koalium/centidocs/Q.C/برون سپاری 4110006.docx

پروژه: 4110006 آیتم: محصول: دمپر

ردیف | شرح مواد / محصول خروجی | ابعاد | تعداد | وزن | توضیحات
1 | ورق CK45 | 12*250*250 mm | 1 | 6 Kg
2
3

ردیف | شرح سفارش | مشخصات | شماره نقشه یا سند مرجع | مواد/محصول مرجع | تعداد | وزن
1 | تعیین Grade و کوانتومتری | | 4110006-1200*1200-01 | CK-45 | 1 | 6 Kg
2
3

صادر کننده: همایون شولی | کنترل کیفیت: حسین مهاجری | مدیریت:

29/01/1402 تاریخ : سفارش کار (بیرون سپاری) شرکت صنعتی سانتیگراد شماره سفارش : 00 شماره ویرایش:
