koalium/centidocs/mohajeri/گزارش بازرسی درپوش بیرینگ بلاک.docx

شرح کالا : | پوسته بیرینگ بلاک | شماره نقشه : | N- | شماره سفارش : | -
شماره کالا : | 000218100002 | شماره ITP : | I- | تامین کننده : | کارگاه رضایی
تعداد کل سفارش : | 6 | تعداد دریافتی : | 6 | تاریخ بازرسی : | 21/10/1401

بازرسی مواد :
ناحیه بازرسی | | | مواد در نقشه | | مواد محصول | | | شرح بازرسی (مغایرت) | | | | تعداد | تائید | مردود
درپوش بیرینگ بلاک 7218 | | | S.T 52 | | S.T 52 | | | | | | | | ☒ | ☐

بازرسی ابعاد :
ناحیه بازرسی | | | اندازه نقشه | | اندازه محصول | | | شرح بازرسی (مغایرت) | | | | تعداد | تائید | مردود
قطر 1 | | | 100mm | | 100mm | | | | | | | | ☒ | ☐
قطر 2 | | | 144mm | | 144mm | | | | | | | | ☒ | ☐
قطر 3 | | | 228mm | | 228mm | | | | | | | | ☒ | ☐
قطر 4 | | | 90mm | | 90mm | | | | | | | | ☒ | ☐
قطر 5 | | | 160mm | | 160mm | | | | | | | | ☒ | ☐
ضخامت 1 | | | 43.5mm | | 43.5mm | | | | | | | | ☒ | ☐
ضخامت 2 | | | 38mm | | 38mm | | | | | | | | ☒ | ☐
ضخامت 3 | | | 12mm | | 12mm | | | | | | | | ☒ | ☐
ترخیص قطعه جهت آزمون : | | | | | | | | | | | | | ☒ | ☐

آزمون :
تجهیزات آزمون | | | | محل آزمون | | | | | شرایط آزمون

کنترل کیفیت آماری : هر محموله ورودی به خانواده های 1000 عددی تقسیم بندی و بازرسی شود.
مرحله | تعداد نمونه | | حد پذیرش خطا | | | حد تجدید | | | | تعداد خطا در آزمایش | | | تایید | مردود
1 | | | | | | | | | | | | | ☐ | ☐
2 | | | | | | | | | | | | | ☐ | ☐

نتیجه نهایی :
پذیرش | | پذیرش ارفاقی | | | | | دوباره کاری | | | | مردود
☒ | | ☐ | | | | | ☐ | | | | ☐

توضیحات :

قطعات ریخته گری شده فاقد تخلخل و زدگی می باشد.

بازرس : همایون شولی 21/10/1401 | واحد کنترل کیفیت : مهندس حسین مهاجری | واحد مدیریت :

شرکت صنعتی سانتیگراد گزارش بازرسی و آزمون شماره سند : R-000218100002 تاریخ : 21/10/1401 ویرایش : 00
