koalium/centidocs/jokar/1/Flexible Joint/برون سپاری دوخت.docx

پروژه: 10028 آیتم: AC-2 محصول: Flexible Joint

ردیف | شرح مواد / محصول خروجی | ابعاد | تعداد | وزن | توضیحات
| پارچه برزنت | - | 4 | -

ردیف | شرح سفارش | مشخصات | شماره نقشه یا سند مرجع | مواد/محصول مرجع | تعداد | وزن
| دوخت پارچه | - | - | ردیف 1 | 4

صادر کننده: | کنترل کیفیت: | مدیریت:

98/03/25 تاریخ : سفارش کار (بیرون سپاری) شرکت صنعتی سانتیگراد 10028-ST-01 شماره سفارش : 00 شماره ویرایش:
