koalium/centidocs/mohajeri/90004/WPS-PQR-WQT/pqr/VD-3607-33-97-4912UD-ME-WPS-0411-PQR.docx

ESFAHAN OIL REFINING COMPANY

DIESEL HYDROTREATMENT PROJECT (DHT)

DOCUMENT TITLE

PQR for Damper TV-970078

DOCUMENT NUMBER

VD-3607/33-97-4912UD-ME-WPS-0411
PURCHASER'S COMMENT/APPROVAL STATUS | | | | Purchaser: NARGAN
| 1. AP: Approved (Released for Manufacturing)
| 2. AN: Approved as Noted for Fabrication (Fabrication may Proceed) | | | Requisition No.: 3607/33-97-4912UD-ME-DS-4029
| 3. NF: Approved as Noted for Re-Issue (Fabrication not Proceed)
| 4. RE: Rejected | | | Item No. (Tag No.): TV-970078
| 5. NR: Not Returned
Date: XX.XX.XX Signature: | | | | Vendor Doc. No.: Cii97-90004-VD-WPS-01

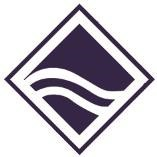
[picture p10: figure]

| | | | | | Centigrade IND.INC
A0 | 13.Jan.2019 | ISSUED FOR APPROVAL | H.Mohajeri | E.Beygi | D.Dehghani
Rev | DATE | DESCRIPTION | PREP'D | CHK'D | APP'D

TABULATION OF REVISED PAGES

Page | Rev-0 | Rev-1 | Rev-2 | Rev-3 | Rev-4 | | Page | Rev-0 | Rev-1 | Rev-2 | Rev-3 | Rev-4
1 | x | | | | | | 36
2 | x | | | | | | 37
3 | x | | | | | | 38
4 | x | | | | | | 39
5 | x | | | | | | 40
6 | x | | | | | | 41
7 | x | | | | | | 42
8 | x | | | | | | 43
9 | | | | | | | 44
10 | | | | | | | 45
11 | | | | | | | 46
12 | | | | | | | 47
13 | | | | | | | 48
14 | | | | | | | 49
15 | | | | | | | 50
16 | | | | | | | 51
17 | | | | | | | 52
18 | | | | | | | 53
19 | | | | | | | 54
20 | | | | | | | 55
21 | | | | | | | 56
22 | | | | | | | 57
23 | | | | | | | 58
24 | | | | | | | 59
25 | | | | | | | 60
26 | | | | | | | 61
27 | | | | | | | 62
28 | | | | | | | 63
29 | | | | | | | 64
30 | | | | | | | 65
31 | | | | | | | 66
32 | | | | | | | 67
33 | | | | | | | 68
34 | | | | | | | 69
35 | | | | | | | 70

Company Name: CENTIGRADE IND. INC.

Procedure Qualification Record No.: 01 Date: 05/01/2019

WPS No.: WPS-01

Welding Process(es): SMAW

Types (Manual, Automatic, Semi-Automatic): MANUAL

JOINTS

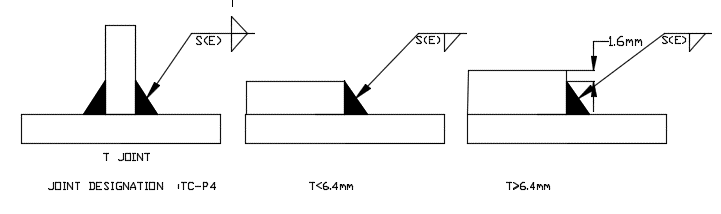
[picture p11: figure]

BASE METALS Material Spec.: Stainless Steel 304L Thickness of Test Coupon: 6 mm | POSTWELD HEAT TREATMENT Temperature: NA Time: NA
| GAS Gas(es) (Mixture) Flow Rate Shielding: NA Backing: NA
FILLER METALS SFA Specification: A5.4 AWS Classification: E310 Size of Filler Metal: 3.25 mm Weld Metal Thickness: 6mm
| ELECTRICAL CHARACTERISTICS Current: AC OR DC+ Polarity: DCEN Amps.: 90-120 Volts: 10-16
POSITION Position of Fillet: ALL Weld Progression (Uphill, Downhill): Flat
| TECHNIQUE Travel Speed: 18-20 (cm/min) String or Weave Bead STRINGER OR WEAVE Oscillation: NA Multipass or Single Pass (Per Side): Single Pass
PREHEAT Preheat Temperature 30°C Interpass Temperature NA

Test Result

Visual test Results: ok

FRACTURE Test

specimen no. | result | remark
1 | ok | See attached file

MACROtch TEST

specimen no. | result | remark
1 | ok | See attached file

DIESEL HYDROTREATMENT PROJECT (DHT) DOCUMENT TITLE: PQR for Damper TV-970078 Contract No.: 1032/GC-GN/CON-EP09-00 POI: FA DOCUMENT NUMBER: VD-3607/33-97-4912UD-ME-WPS-0411 Rev. No.: A0

DIESEL HYDROTREATMENT PROJECT (DHT) DOCUMENT TITLE: PQR for Damper TV-970078 Contract No.: 1032/GC-GN/CON-EP09-00 POI: FA DOCUMENT NUMBER: 3607/33-97-4912UD-ME-WPS-0411 Rev. No.: A0
