koalium/centidocs/jokar/مدیریت محترم عامل.docx

مدیریت محترم عامل

جناب آقای مهندس گرامی

با توجه به جلسه تشکیل شده مورخ 28/4/1402 وحضور حضرتعالی و آقایان علی جوکار و علیرضا صفری از واحد نقشه کشی موارد ذیل جهت اقدام خدمتان ارسال میگردد:

1-آموزش نرم افزار لیتیو جهت محاسبه طول گسترده و استفاده از این نرم افزار در واحد مهندسی و نقشه کشی

2- تغیرات در مدلهای مونتاژی(ازبیت) توسط شخصی که مدل اولیه را ایجاد کرده به دلیل تسلط بر استراتژی طراحی اولیه

3- استفاده از نرم افزار اتودسک اینونتور در طراحی محصولات و پروژه های شرکت به دلیل امکانات بسیار بالای آن

با تشکر
