koalium/centidocs/Manouchehri/آبکاری 17182.docx

پروژه: 17182 آیتم: AC-10101 محصول: Fan Ring & Plenum

ردیف | شرح مواد / محصول خروجی | ابعاد | تعداد | وزن | توضیحات
1 | 3M1,3M2 | - | 96 | 2626
2 | 3L.3R | - | 40 | 2141
3 | 2L.2R | - | 128 | 2758
4 | 1L.1R | - | 128 | 7044
5 | 1M | - | 64 | 3524
6 | FR 1 | - | 25 | 2875
7 | FR 2 | - | 25 | 3437

ردیف | شرح سفارش | مشخصات | شماره نقشه یا سند مرجع | مواد/محصول مرجع | تعداد | وزن
1 | آبکاری گالوانیزه گرم | - | - | ردیف 1 تا 7 | 506 | 24405

صادر کننده: علیرضا جوکار | کنترل کیفیت: حسین مهاجری | مدیریت:

1400/03/16 تاریخ : سفارش کار (بیرون سپاری) شرکت صنعتی سانتیگراد 17182-CO-01 شماره سفارش : 00 شماره ویرایش:
