koalium/centidocs/Manouchehri/فرش ساوین.docx

به نام خدا

مدیریت محترم عامل – جناب مهندس گرامی

با درود

احتراما به استحضار می رساند پیرو نامه مورخه 27/02/1403 شرکت محترم ساوین در رابطه با ایراد در عملکرد برخی از محصولات شرکت سانتیگراد ، بر همین اساس اقدامات صورت گرفته به شرح ذیل به خدمتتان ایفاد می گردد.

1-در رابطه با فیلتر دیسک و عبور الیاف از آن ، تسمه هوابند جدید تامین شد و متعاقبا ارسال می گردد.

2-در رابطه با ایراد فن فایبر، مقرر گردید فن جایگزین ارسال گردد .

3-در رابطه با کامپکتور پلی استر نظریه کارشناس شرکت فوق مورد تایید نمی باشد ، و دلیل جریان موتوراسکرو کامپکتور به خاطر عبور نکردن الیاف پنبه از قسمت نمدی دیسک و همچنین چرخش پنبه به همراه دیسک که این امر موجب اخذ بیشتر جریان موتور می گردد. و در ضمن در طراحی کامپکتور از تسمه های برنزی استفاده گردیده است که در صورت درگیری اسکرو کامپکتور با تسمه برنزی به دلیل عدم رسانایی الکتریکی تولید جرقه صورت نگیرد و در نتیجه برخورد درگیری اسکرو کامپکتور با تسمه های برنزی کاملا از نظر فنی درست می باشد ، چون زمانی که تحت فشار بار قرار می گیرد طبیعی است که به تسمه های برنزی برخورد نماید .

ولیکن طبق هماهنگی با مدیریت محترم فروش یک عدد کامپکتور جایگزین کامپکتور فوق می گردد.

4-در رابطه با فن حلزونی ، طبق گزارش کرشناس فنی شرکت سانتیگراد الکتروموتور فن حلزونی باز شده و بر روی روتور آن جای ضربه های چکش مشاهده گردیده است و در ضمن لرزش فن مربوط به خرابی بلبرینگ بوده که طبق هماهنگی یک عدد فن با الکترو موتور جدید چایگزین گردید.

با سپاس

منوچهری – واحد کنترل کیفیت

01/03/1403
