koalium/centidocs/SAFARI/02.03.09/برون سپاری ستون 61041.docx

پروژه: 9245041 آیتم: - محصول: Column

ردیف | شرح مواد / محصول خروجی | ابعاد | تعداد | وزن | توضیحات
1 | تسمه آهن | 5x451x4670 | 212 | 17525
2 | ورق استیل | 5x588x4670 | 106 | 11424

ردیف | شرح سفارش | مشخصات | شماره نقشه یا سند مرجع | مواد/محصول مرجع | تعداد | وزن
1 | خم کاری | - | As Per DWG No.: 9245041-Bending-01 | ردیف 1,2 | 318 | 28949

صادر کننده: علیرضا جوکار | کنترل کیفیت: حسین مهاجری | مدیریت:

02.03.09 تاریخ : سفارش کار (بیرون سپاری) شرکت صنعتی سانتیگراد 9245041-CO-02 شماره سفارش : 00 شماره ویرایش:
