koalium/centidocs/SAFARI/Title Block - Ruby Stone/Title Block (Ruby Stone) -Word-94-4-14.docx

DOCUMENT TITLE

IN-HOUSE REVISIONS | | | | | | | DOCUMENT REVISIONS
B | | | | | | | B
A | | | | | | | A
0 | First Issue | | | | | | 0 | First Issue
REV. | DESCRIPTION | DESG | DRAWN. | CHK | APP. | DATE | REV. | DESCRIPTION | DESG | DRAWN | CHKD | APP. | Date

Page No. | DOCUMENT REVISIONS | | | | | | | | Remarks | Page No. | IN-HOUSE REVISIONS | | | | | | | | Remarks
| 0 | A | B | C | D | E | F | G | | | 0 | A | B | C | D | E | F | G
1 | | | | | | | | | | 1
2 | | | | | | | | | | 2
3 | | | | | | | | | | 3
4 | | | | | | | | | | 4
5 | | | | | | | | | | 5
6 | | | | | | | | | | 6
7 | | | | | | | | | | 7
8 | | | | | | | | | | 8
9 | | | | | | | | | | 9
10 | | | | | | | | | | 10
11 | | | | | | | | | | 11
12 | | | | | | | | | | 12
13 | | | | | | | | | | 13
14 | | | | | | | | | | 14
15 | | | | | | | | | | 15
16 | | | | | | | | | | 16
17 | | | | | | | | | | 17
18 | | | | | | | | | | 18
19 | | | | | | | | | | 19
20 | | | | | | | | | | 20
21 | | | | | | | | | | 21
22 | | | | | | | | | | 22
23 | | | | | | | | | | 23
24 | | | | | | | | | | 24
25 | | | | | | | | | | 25
26 | | | | | | | | | | 26
27 | | | | | | | | | | 27
28 | | | | | | | | | | 28
29 | | | | | | | | | | 29
30 | | | | | | | | | | 30

CONTENT

MAPNA GROUP (Public Stock) SUB-CONTRACTOR'S LOGO SUB-CONTRACTOR'S Doc. No Doc. No. : MD2/I3- Rev: File No. : Design Stage: MAPNA'S DWG No. : Contract No. : Page 3 of 3 THIS DOCUMENT IS A PROPERTY OF MAPNA GROUP AND MUST NOT BE COPIED NOR TRANSFERREDTO A THIRD PARTY WITHOUT PRIOR AUTHORIZATIIN

RUMAILA 3000 MW COMBINED CYCLE POWER PLANT MAPNA GROUP
