koalium/centidocs/mohajeri/NCR/8003-TML03-27.docx

اعلامیه مغایرت NCR

شماره : COM/8003/27

تاریخ : 97/12/11

مترو تهران خط 3

شرکت صنعتی سانتیگراد

مرحله بازرسی : | [ ] مواد | [ ] ساخت و تکمیل | | نصب[x] | پروژه : | ایرواشر | | محل بازرسی : | | | نظریه نهایی :
نظریه بازرس : | [ ] مردود | [ ] مرجوع | | [ ] دوباره کاری | محصول : | حوضچه | | [ ] انبار [x] ایستگاه [ ] سایت [ ] پیمانکار | | | [ ] | مردود
سند مرجع : [ ] | MR: | | | | زیر محصول: | چراغ روشنایی | | توزیع نسخ : | | | [ ] | اسقاط
سند مرجع : [ ] | نقشه : | | | | قطعه : | | | [x] کیفیت [x] طراحی [x] تولید | | | [ ] | مرجوع
سند مرجع : [ ] | رویه : | | | | فرایند : | نصب | | [x] انبار [x] تدارکات [x] فروش | | | [ ] | دوباره کاری
استاندارد : | | | | | تأمین کننده: : | سانتیگراد | | [ ] اقدام اصلاحی شماره | | | [ ] | پذیرش ارفاقی
شرح مغایرت | | | نظریه واحد اجرایی | | | | نظریه طراحی و مهندسی | | | تعیین تکلیف
اصلاح نوردهی ضعیف چراغ های روشنایی و استفاده از چراغ های ضد آب.
امضاء و تاریخ | | | امضاء و تاریخ | | | | امضاء و تاریخ | | | امضاء و تاریخ
