koalium/centidocs/mohajeri/NCR/8003-TML03-28.docx

اعلامیه مغایرت NCR

شماره : COM/8003/28

تاریخ : 97/12/11

مترو تهران خط 3

شرکت صنعتی سانتیگراد

مرحله بازرسی : | [ ] مواد | [ ] ساخت و تکمیل | | نصب[x] | پروژه : | ایرواشر | | محل بازرسی : | | | نظریه نهایی :
نظریه بازرس : | [ ] مردود | [ ] مرجوع | | [ ] دوباره کاری | محصول : | دریچه بازدید | | [ ] انبار [x] ایستگاه [ ] سایت [ ] پیمانکار | | | [ ] | مردود
سند مرجع : [ ] | MR: | | | | زیر محصول: | پیچ | | توزیع نسخ : | | | [ ] | اسقاط
سند مرجع : [ ] | نقشه : | | | | قطعه : | | | [x] کیفیت [x] طراحی [x] تولید | | | [ ] | مرجوع
سند مرجع : [ ] | رویه : | | | | فرایند : | نصب | | [x] انبار [x] تدارکات [x] فروش | | | [ ] | دوباره کاری
استاندارد : | | | | | تأمین کننده: : | شرکت سانتیگراد | | [ ] اقدام اصلاحی شماره | | | [ ] | پذیرش ارفاقی
شرح مغایرت | | | نظریه واحد اجرایی | | | | نظریه طراحی و مهندسی | | | تعیین تکلیف
پیچ هایی که بر روی لاستیک هوابند استفاده میشوند دچار زنگ زدگی شده اند.
امضاء و تاریخ | | | امضاء و تاریخ | | | | امضاء و تاریخ | | | امضاء و تاریخ
