koalium/centidocs/mohajeri/NCR/اعلامیه مغایرت NCR-COM-8003-14.docx

اعلامیه مغایرت NCR

شماره : COM/8003/14

تاریخ : 97/10/17

مترو تهران خط 3 – ایستگاه راه آهن

شرکت صنعتی سانتیگراد

| مرحله بازرسی : | [ ] مواد | [ ] ساخت و تکمیل | | نصب[x] | پروژه : | فیلتر استاتیک آب | | محل بازرسی : | | نظریه نهایی :
| نظریه بازرس : | [ ] مردود | [ ] مرجوع | | [ ] دوباره کاری | محصول : | فیلتر استاتیک آب | | [ ] انبار [ ] ایستگاه [x] سایت [ ] پیمانکار | | [ ] | مردود
| سند مرجع : [ ] | MR: | | | | زیر محصول: | | | توزیع نسخ : | | [ ] | اسقاط
| سند مرجع : [ ] | نقشه : | | | | قطعه : | | | [x] کیفیت [x] طراحی [x] تولید | | [ ] | مرجوع
| سند مرجع : [x] | رویه : | | | | فرایند : | نصب | | [x] انبار [x] تدارکات [x] فروش | | [ ] | دوباره کاری
| استاندارد : | | | | | تأمین کننده: : | سانتیگراد | | [ ] اقدام اصلاحی شماره | | [ ] | پذیرش ارفاقی
شرح مغایرت | | | | نظریه واحد اجرایی | | | | نظریه طراحی و مهندسی | | تعیین تکلیف
سایز دهانه فیلتر استاتیک در سایت با فیلتر استاتیک ساخته شده در شرکت مغایرت دارد. سایز فیلتر ساخته شده 900 میلیمتر می باشد در صورتی که سایز دهانه فیلتر در سایت 1 تا 5 سانتیمتر کوچکتر می باشد. موضع VE3 : سایز دهانه سه موضع به این سایز ها باید تغییر کند: 875-890-890-850-875-855 موضع VE4: سایز دهانه سه موضع به این سایز ها باید تغییر کند: 875-880-885-870-870-895 موضع VE5: سایز دهانه سه موضع به این سایز ها باید تغییر کند: 860-880-880-860-870-850
امضاء و تاریخ | | | | امضاء و تاریخ | | | | امضاء و تاریخ | | امضاء و تاریخ
