koalium/centidocs/mohajeri/NCR/اعلامیه مغایرت NCR-COM-8003-15.docx

اعلامیه مغایرت NCR

شماره : COM/8003/15

تاریخ : 97/10/17

مترو تهران خط 3 – ایستگاه راه آهن

شرکت صنعتی سانتیگراد

| مرحله بازرسی : | [ ] مواد | [ ] ساخت و تکمیل | | نصب[x] | پروژه : | قاب المیناتور | | محل بازرسی : | | نظریه نهایی :
| نظریه بازرس : | [ ] مردود | [ ] مرجوع | | [ ] دوباره کاری | محصول : | قاب المیناتور | | [ ] انبار [ ] ایستگاه [x] سایت [ ] پیمانکار | | [ ] | مردود
| سند مرجع : [ ] | MR: | | | | زیر محصول: | | | توزیع نسخ : | | [ ] | اسقاط
| سند مرجع : [ ] | نقشه : | | | | قطعه : | | | [x] کیفیت [x] طراحی [x] تولید | | [ ] | مرجوع
| سند مرجع : [x] | رویه : | | | | فرایند : | نصب | | [x] انبار [x] تدارکات [x] فروش | | [ ] | دوباره کاری
| استاندارد : | | | | | تأمین کننده: : | سانتیگراد | | [ ] اقدام اصلاحی شماره | | [ ] | پذیرش ارفاقی
شرح مغایرت | | | | نظریه واحد اجرایی | | | | نظریه طراحی و مهندسی | | تعیین تکلیف
فاصله سکوهای مربوط به قاب المیناتور با قاب المیناتور ساخته شده مغایرت دارد. موضع VE3: نیاز به تغییر دادن قاب در شرکت می باشد.(فاصله سکو های المیناتور از سمت حوضچه و از سمت راست به چپ به ترتیب 240-680-690-700-600-700-700-700 میلیمتر می باشد.) موضع: VE4: نیاز به تغییر دادن قاب در شرکت می باشد.(فاصله سکو های المیناتور از سمت حوضچه و از سمت راست به چپ به ترتیب 520-700-690-700-595-645-685-680 میلیمتر می باشد.) موضع VE5: مشکلی ندارد.
امضاء و تاریخ | | | | امضاء و تاریخ | | | | امضاء و تاریخ | | امضاء و تاریخ
