koalium/centidocs/mohajeri/NCR/اعلامیه مغایرت NCR-COM-8003-16.docx

اعلامیه مغایرت NCR

شماره : COM/8003/16

تاریخ : 97/10/17

مترو تهران خط 3 – ایستگاه راه آهن

شرکت صنعتی سانتیگراد

| مرحله بازرسی : | [ ] مواد | [ ] ساخت و تکمیل | | نصب[x] | پروژه : | ساختمان ایستگاه | | محل بازرسی : | | نظریه نهایی :
| نظریه بازرس : | [ ] مردود | [ ] مرجوع | | [ ] دوباره کاری | محصول : | حوضچه | | [ ] انبار [ ] ایستگاه [x] سایت [ ] پیمانکار | | [ ] | مردود
| سند مرجع : [ ] | MR: | | | | زیر محصول: | کف پوش | | توزیع نسخ : | | [ ] | اسقاط
| سند مرجع : [ ] | نقشه : | | | | قطعه : | | | [x] کیفیت [x] طراحی [x] تولید | | [ ] | مرجوع
| سند مرجع : [x] | رویه : | | | | فرایند : | نصب | | [x] انبار [x] تدارکات [x] فروش | | [ ] | دوباره کاری
| استاندارد : | | | | | تأمین کننده: : | کارفرما | | [ ] اقدام اصلاحی شماره | | [ ] | پذیرش ارفاقی
شرح مغایرت | | | | نظریه واحد اجرایی | | | | نظریه طراحی و مهندسی | | تعیین تکلیف
حوضچه مربوط به موضع VE4 در قسمت پایین بر روی کف پوش عایق کاری شده است ( هماهنگی با کارفرما صورت گیرد جهت اطمینان از نصب قطعات. آیا پس از عایق کاری بر روی کف پوش، مجدد نیاز به اجرای کف پوش می باشد؟ )
امضاء و تاریخ | | | | امضاء و تاریخ | | | | امضاء و تاریخ | | امضاء و تاریخ
