koalium/centidocs/mohajeri/NCR/اعلامیه مغایرت NCR-COM-8003-18.docx

اعلامیه مغایرت NCR

شماره : COM/8003/18

تاریخ : 97/10/17

مترو تهران خط 3 – ایستگاه راه آهن

شرکت صنعتی سانتیگراد

مرحله بازرسی : | [ ] مواد | [ ] ساخت و تکمیل | | نصب[x] | پروژه : | کلکتور | | محل بازرسی : | | | نظریه نهایی :
نظریه بازرس : | [ ] مردود | [ ] مرجوع | | [ ] دوباره کاری | محصول : | کلکتور | | [ ] انبار [ ] ایستگاه [x] سایت [ ] پیمانکار | | | [ ] | مردود
سند مرجع : [ ] | MR: | | | | زیر محصول: | | | توزیع نسخ : | | | [ ] | اسقاط
سند مرجع : [ ] | نقشه : | | | | قطعه : | | | [x] کیفیت [x] طراحی [x] تولید | | | [ ] | مرجوع
سند مرجع : [x] | رویه : | | | | فرایند : | نصب | | [x] انبار [x] تدارکات [x] فروش | | | [ ] | دوباره کاری
استاندارد : | | | | | تأمین کننده: : | سانتیگراد | | [ ] اقدام اصلاحی شماره | | | [ ] | پذیرش ارفاقی
شرح مغایرت | | | نظریه واحد اجرایی | | | | نظریه طراحی و مهندسی | | | تعیین تکلیف
طول کلکتور های ساخته شده جهت نصب بر روی سکوها، 1520 میلیمتر می باشد در صورتی که بعلت اینکه سکوها با تعداد 4 عدد ساخته شده اند امکان نصب کلکتور ها وجود ندارد . نیاز است یا طراحی سکو عوض شود یا کلکتور ها تعویض شوند.
امضاء و تاریخ | | | امضاء و تاریخ | | | | امضاء و تاریخ | | | امضاء و تاریخ
