koalium/centidocs/mohajeri/NCR/اعلامیه مغایرت NCR-COM-8003-19.docx

اعلامیه مغایرت NCR

شماره : COM/8003/19

تاریخ : 97/10/17

مترو تهران خط 3 – ایستگاه فاطمی

شرکت صنعتی سانتیگراد

مرحله بازرسی : | [ ] مواد | [ ] ساخت و تکمیل | | نصب[x] | پروژه : | فیلتر استاتیک آب | | محل بازرسی : | | | نظریه نهایی :
نظریه بازرس : | [ ] مردود | [ ] مرجوع | | [ ] دوباره کاری | محصول : | فیلتر استاتیک آب | | [ ] انبار [ ] ایستگاه [x] سایت [ ] پیمانکار | | | [ ] | مردود
سند مرجع : [ ] | MR: | | | | زیر محصول: | | | توزیع نسخ : | | | [ ] | اسقاط
سند مرجع : [ ] | نقشه : | | | | قطعه : | | | [x] کیفیت [x] طراحی [x] تولید | | | [ ] | مرجوع
سند مرجع : [x] | رویه : | | | | فرایند : | نصب | | [x] انبار [x] تدارکات [x] فروش | | | [ ] | دوباره کاری
استاندارد : | | | | | تأمین کننده: : | سانتیگراد | | [ ] اقدام اصلاحی شماره | | | [ ] | پذیرش ارفاقی
شرح مغایرت | | | نظریه واحد اجرایی | | | | نظریه طراحی و مهندسی | | | تعیین تکلیف
سایز دهانه فیلتر استاتیک در سایت با فیلتر استاتیک ساخته شده در شرکت مغایرت دارد. سایز فیلتر ساخته شده 900 میلیمتر می باشد در صورتی که سایز دهانه فیلتر در سایت 1 تا 7 سانتیمتر کوچکتر می باشد. موضع VE3 : سایز دهانه سه موضع به این سایز ها باید تغییر کند: 870-890-890-880-870-900 موضع VE4: سایز دهانه سه موضع به این سایز ها باید تغییر کند: 910-880-885-900-880-900 موضع VE5: سایز دهانه سه موضع به این سایز ها باید تغییر کند: 830-890-850-870-875-865
امضاء و تاریخ | | | امضاء و تاریخ | | | | امضاء و تاریخ | | | امضاء و تاریخ
