koalium/centidocs/mohajeri/NCR/اعلامیه مغایرت NCR-COM-8003-20.docx

اعلامیه مغایرت NCR

شماره : COM/8003/20

تاریخ : 97/10/17

مترو تهران خط 3 – ایستگاه فاطمی

شرکت صنعتی سانتیگراد

مرحله بازرسی : | [ ] مواد | [ ] ساخت و تکمیل | | نصب[x] | پروژه : | ساپورت صفحه نردبان | | محل بازرسی : | | | نظریه نهایی :
نظریه بازرس : | [ ] مردود | [ ] مرجوع | | [ ] دوباره کاری | محصول : | | | [ ] انبار [ ] ایستگاه [x] سایت [ ] پیمانکار | | | [ ] | مردود
سند مرجع : [ ] | MR: | | | | زیر محصول: | | | توزیع نسخ : | | | [ ] | اسقاط
سند مرجع : [ ] | نقشه : | | | | قطعه : | | | [x] کیفیت [x] طراحی [x] تولید | | | [ ] | مرجوع
سند مرجع : [x] | رویه : | | | | فرایند : | نصب | | [x] انبار [x] تدارکات [x] فروش | | | [ ] | دوباره کاری
استاندارد : | | | | | تأمین کننده: : | کارفرما | | [ ] اقدام اصلاحی شماره | | | [ ] | پذیرش ارفاقی
شرح مغایرت | | | نظریه واحد اجرایی | | | | نظریه طراحی و مهندسی | | | تعیین تکلیف
در موضع VE3 ساپورت مربوط به صفحه نردبان در جلوی شبکه ایربافل قرار گرفته است در صورتی که می بایست در پشت شبکه ایربافل قرار گیرد.
امضاء و تاریخ | | | امضاء و تاریخ | | | | امضاء و تاریخ | | | امضاء و تاریخ
