koalium/centidocs/mohajeri/NCR/اعلامیه مغایرت NCR-COM-8003-29.docx

اعلامیه مغایرت NCR

مترو تهران خط 3

شماره : COM/8003/29

تاریخ : 98/03/01

شرکت صنعتی سانتیگراد

| مرحله بازرسی : | [ ] مواد | [ ] ساخت و تکمیل | | نصب[x] | پروژه : | ایرواشر | | محل بازرسی : | | نظریه نهایی :
| نظریه بازرس : | [ ] مردود | [ ] مرجوع | | [ ] دوباره کاری | محصول : | الیمیناتور | | [ ] انبار [x] ایستگاه [ ] سایت [ ] پیمانکار | | [ ] | مردود
| سند مرجع : [ ] | MR: | | | | زیر محصول: | لوله تخلیه | | توزیع نسخ : | | [ ] | اسقاط
| سند مرجع : [ ] | نقشه : | | | | قطعه : | | | [x] کیفیت [x] طراحی [x] تولید | | [ ] | مرجوع
| سند مرجع : [ ] | رویه : | | | | فرایند : | نصب | | [x] انبار [x] تدارکات [x] فروش | | [ ] | دوباره کاری
| استاندارد : | | | | | تأمین کننده: : | سانتیگراد | | [ ] اقدام اصلاحی شماره | | [ ] | پذیرش ارفاقی
شرح مغایرت | | | | نظریه واحد اجرایی | | | | نظریه طراحی و مهندسی | | تعیین تکلیف
اضافه کردن یک عدد لوله تخلیه در ناودانی الیمیناتور در ایستگاه های زیر: - ایستگاه آزادگان- هواساز VE3 و VE4 - ایستگاه نعمت آباد-هواساز VE3 و VE5 - ایستگاه عبدل آباد-هواساز VE4 - ایستگاه جوادیه-هواساز VE3 - ایستگاه زمزم-هواساز VE3 - ایستگاه شریعتی-هواسازهای VE3 و VE4 و VE5
امضاء و تاریخ | | | | امضاء و تاریخ | | | | امضاء و تاریخ | | امضاء و تاریخ
