koalium/centidocs/mohajeri/NCR/اعلامیه مغایرت NCR-COM-8003-30.docx

اعلامیه مغایرت NCR

مترو تهران خط 3

شماره : COM/8003/30

تاریخ : 98/03/01

شرکت صنعتی سانتیگراد

| مرحله بازرسی : | [ ] مواد | [ ] ساخت و تکمیل | | نصب[x] | پروژه : | ایرواشر | | محل بازرسی : | | نظریه نهایی :
| نظریه بازرس : | [ ] مردود | [ ] مرجوع | | [ ] دوباره کاری | محصول : | الیمیناتور | | [ ] انبار [x] ایستگاه [ ] سایت [ ] پیمانکار | | [ ] | مردود
| سند مرجع : [ ] | MR: | | | | زیر محصول: | ناودانی الیمیناتور | | توزیع نسخ : | | [ ] | اسقاط
| سند مرجع : [ ] | نقشه : | | | | قطعه : | | | [x] کیفیت [x] طراحی [x] تولید | | [ ] | مرجوع
| سند مرجع : [ ] | رویه : | | | | فرایند : | نصب | | [x] انبار [x] تدارکات [x] فروش | | [ ] | دوباره کاری
| استاندارد : | | | | | تأمین کننده: : | سانتیگراد | | [ ] اقدام اصلاحی شماره | | [ ] | پذیرش ارفاقی
شرح مغایرت | | | | نظریه واحد اجرایی | | | | نظریه طراحی و مهندسی | | تعیین تکلیف
- ایستگاه زین الدین نصب دو عدد ناودانی جهت آبریزش آب الیمیناتور ها در مواضع VE3 و VE4 و VE5 - ایستگاه جوادیه اضافه نمودن ناودانی الیمیناتور در مواضع VE4 و VE5 - ایستگاه عبدل اباد فیکس نمودن لوله ناودانی الیمیناتور در موضع VE4
امضاء و تاریخ | | | | امضاء و تاریخ | | | | امضاء و تاریخ | | امضاء و تاریخ
