koalium/centidocs/mohajeri/NCR/اعلامیه مغایرت NCR-COM-8003-31.docx

اعلامیه مغایرت NCR

مترو تهران خط 3

شماره : COM/8003/31

تاریخ : 98/03/01

شرکت صنعتی سانتیگراد

| مرحله بازرسی : | [ ] مواد | [ ] ساخت و تکمیل | | نصب[x] | پروژه : | ایرواشر | | محل بازرسی : | | نظریه نهایی :
| نظریه بازرس : | [ ] مردود | [ ] مرجوع | | [ ] دوباره کاری | محصول : | دریچه بازدید | | [ ] انبار [x] ایستگاه [ ] سایت [ ] پیمانکار | | [ ] | مردود
| سند مرجع : [ ] | MR: | | | | زیر محصول: | لاستیک هوابند | | توزیع نسخ : | | [ ] | اسقاط
| سند مرجع : [ ] | نقشه : | | | | قطعه : | | | [x] کیفیت [x] طراحی [x] تولید | | [ ] | مرجوع
| سند مرجع : [ ] | رویه : | | | | فرایند : | نصب | | [x] انبار [x] تدارکات [x] فروش | | [ ] | دوباره کاری
| استاندارد : | | | | | تأمین کننده: : | سانتیگراد | | [ ] اقدام اصلاحی شماره | | [ ] | پذیرش ارفاقی
شرح مغایرت | | | | نظریه واحد اجرایی | | | | نظریه طراحی و مهندسی | | تعیین تکلیف
تعویض لاستیک هوابند قاب در بازدید حوضچه ایرواشر در ایستگاه های زیر : - ایستگاه آزادگان-هواساز VE3 - ایستگاه نعمت آباد-هواسازهای VE3 و VE5 - ایستگاه زمزم-هواساز VE5 ............................................................................................ آب بند نمودن دور دریچه بازدید حوضچه ایرواشر در ایستگاه زمزم-هواسازهای VE5 و VE3
امضاء و تاریخ | | | | امضاء و تاریخ | | | | امضاء و تاریخ | | امضاء و تاریخ
