koalium/centidocs/mohajeri/NCR/اعلامیه مغایرت NCR-COM-8003-32.docx

اعلامیه مغایرت NCR

مترو تهران خط 3

شماره : COM/8003/32

تاریخ : 98/03/01

شرکت صنعتی سانتیگراد

| مرحله بازرسی : | [ ] مواد | [ ] ساخت و تکمیل | | نصب[x] | پروژه : | ایرواشر | | محل بازرسی : | | نظریه نهایی :
| نظریه بازرس : | [ ] مردود | [ ] مرجوع | | [ ] دوباره کاری | محصول : | دریچه بازدید | | [ ] انبار [x] ایستگاه [ ] سایت [ ] پیمانکار | | [ ] | مردود
| سند مرجع : [ ] | MR: | | | | زیر محصول: | دستگیره | | توزیع نسخ : | | [ ] | اسقاط
| سند مرجع : [ ] | نقشه : | | | | قطعه : | | | [x] کیفیت [x] طراحی [x] تولید | | [ ] | مرجوع
| سند مرجع : [ ] | رویه : | | | | فرایند : | نصب | | [x] انبار [x] تدارکات [x] فروش | | [ ] | دوباره کاری
| استاندارد : | | | | | تأمین کننده: : | سانتیگراد | | [ ] اقدام اصلاحی شماره | | [ ] | پذیرش ارفاقی
شرح مغایرت | | | | نظریه واحد اجرایی | | | | نظریه طراحی و مهندسی | | تعیین تکلیف
در ایستگاه های زیر دستگیره در بازدید حوضچه ایرواشر دچار زنگ زدگی شده است: - ایستگاه عبدل آباد-هواسازهای VE4 و VE5 - ایستگاه شریعتی-هواساز VE3و VE4 و VE5 - ایستگاه جوادیه-هواساز VE4 ............................................................................................ زنگ زدگی در بازدید ایرواشر در ایستگاه زمزم هواساز VE5 و VE3
امضاء و تاریخ | | | | امضاء و تاریخ | | | | امضاء و تاریخ | | امضاء و تاریخ
