koalium/centidocs/mohajeri/NCR/اعلامیه مغایرت NCR-COM-8003-33.docx

اعلامیه مغایرت NCR

مترو تهران خط 3 – ایستگاه عبدل آباد

شماره : COM/8003/33

تاریخ : 98/03/01

شرکت صنعتی سانتیگراد

| مرحله بازرسی : | [ ] مواد | [ ] ساخت و تکمیل | | نصب[x] | پروژه : | ایرواشر | | محل بازرسی : | | نظریه نهایی :
| نظریه بازرس : | [ ] مردود | [ ] مرجوع | | [ ] دوباره کاری | محصول : | الیمیناتور | | [ ] انبار [x] ایستگاه [ ] سایت [ ] پیمانکار | | [ ] | مردود
| سند مرجع : [ ] | MR: | | | | زیر محصول: | الیمیناتور | | توزیع نسخ : | | [ ] | اسقاط
| سند مرجع : [ ] | نقشه : | | | | قطعه : | | | [x] کیفیت [x] طراحی [x] تولید | | [ ] | مرجوع
| سند مرجع : [ ] | رویه : | | | | فرایند : | نصب | | [x] انبار [x] تدارکات [x] فروش | | [ ] | دوباره کاری
| استاندارد : | | | | | تأمین کننده: : | سانتیگراد | | [ ] اقدام اصلاحی شماره | | [ ] | پذیرش ارفاقی
شرح مغایرت | | | | نظریه واحد اجرایی | | | | نظریه طراحی و مهندسی | | تعیین تکلیف
در هواساز VE5 ارتفاع الیمیناتور نصب شده بیشتر از تعداد مورد نیاز می باشد(ست زیرین باکت، پن درگیر است) علاوه بر این الیمیناتور نشتی دارد. در هواساز VE4 الیمیناتورهای لاین وسط(بالای ناودانی) دچار تغییرات ظاهری شده اند.
امضاء و تاریخ | | | | امضاء و تاریخ | | | | امضاء و تاریخ | | امضاء و تاریخ
