koalium/centidocs/Q.C/Mashi/NCR/PRC 17182-01 بیرینگ بلاک.docx

| شرکت صنعتی سانتیگراد | اعلامیه مغایرت NCR | شماره : | PRC/17182/01
| | | تاریخ : | 1400/09/14

مرحله بازرسی : | | مواد | | ✓ | ساخت و تکمیل | | نصب | پروژه : | 17182 | | محل بازرسی : | | | | | | | | | | | | نظریه نهایی :
نظریه بازرس : | | مردود | | | مرجوع | | دوباره کاری | محصول : | بیرینگ بلاک | | | انبار | | | ایستگاه | | | | سایت | | پیمانکار | | | مردود
سند مرجع : | MR: | | | | | | | زیر محصول: | پوسته | | توزیع نسخ : | | | | | | | | | | | | | اسقاط
سند مرجع : | نقشه : | | | | | | | قطعه : | | | ✓ | کیفیت | | | | | | طراحی | | ✓ | تولید | | | مرجوع
سند مرجع : | رویه : | | | | | | | فرایند : | | | ✓ | انبار | | | | ✓ | | تدارکات | | | فروش | | | دوباره کاری
استاندارد : | | | | | | | | تأمین کننده: | | | اقدام اصلاحی : | | | | | | | | | | | | | پذیرش ارفاقی

شرح مغایرت | نظریه واحد اجرایی | نظریه طراحی و مهندسی | تعیین تکلیف
از تعداد 10 عدد پوسته بیرینگ بلاک مورد تیاز برای پروژه فوق، پنج عدد از آنها پس از خشن تراشی دارای مک و حفره بودند.
امضاء و تاریخ مهاجری 1400/09/14 | امضاء و تاریخ | امضاء و تاریخ | امضاء و تاریخ
