koalium/centidocs/Q.C/Mashi/NCR/PRD 81003-03 در تهویه.docx

| شرکت صنعتی سانتیگراد | اعلامیه مغایرت NCR | شماره : | PRD/81003/03
| | | تاریخ : | 1400/09/14

مرحله بازرسی : | | مواد | | ✓ | ساخت و تکمیل | | نصب | پروژه : | 81003 | | محل بازرسی : | | | | | | | | | | | | نظریه نهایی :
نظریه بازرس : | | مردود | | | مرجوع | | دوباره کاری | محصول : | در تهویه | | ✓ | انبار | | | ایستگاه | | | | سایت | | پیمانکار | | | مردود
سند مرجع : | MR: | | | | | | | زیر محصول: | در | | توزیع نسخ : | | | | | | | | | | | | | اسقاط
سند مرجع : | نقشه : | | | | | | | قطعه : | | | ✓ | کیفیت | | | | ✓ | | طراحی | | ✓ | تولید | | | مرجوع
سند مرجع : | رویه : | | | | | | | فرایند : | | | ✓ | انبار | | | | | | تدارکات | | | فروش | | | دوباره کاری
استاندارد : | | | | | | | | تأمین کننده: | | | اقدام اصلاحی : | | | | | | | | | | | | | پذیرش ارفاقی

شرح مغایرت | نظریه واحد اجرایی | نظریه طراحی و مهندسی | تعیین تکلیف
دو عدد در تهویه پروژه 81003 پس از ساخت و در حین تمیزکاری دچار لکه گردیده است (پلنگی شده است).
امضاء و تاریخ مهاجری 1400/09/14 | امضاء و تاریخ | امضاء و تاریخ | امضاء و تاریخ
