koalium/centidocs/mohajeri/90004/WPS-PQR-WQT/VD-3607-33-97-4912UD-ME-WPS-0411-A1.docx

ESFAHAN OIL REFINING COMPANY

DIESEL HYDROTREATMENT PROJECT (DHT)

DOCUMENT TITLE

WPS for Damper TV-970078

DOCUMENT NUMBER

VD-3607/33-97-4912UD-ME-WPS-0411
PURCHASER'S COMMENT/APPROVAL STATUS | | | | Purchaser: NARGAN
| 1. AP: Approved (Released for Manufacturing)
| 2. AN: Approved as Noted for Fabrication (Fabrication may Proceed) | | | Requisition No.: 3607/33-97-4912UD-ME-DS-4029
| 3. NF: Approved as Noted for Re-Issue (Fabrication not Proceed)
| 4. RE: Rejected | | | Item No. (Tag No.): TV-970078
| 5. NR: Not Returned
Date: XX.XX.XX Signature: | | | | Vendor Doc. No.: Cii97-90004-VD-WPS-01


| | | | | | Centigrade IND.INC
A1 | 12.sep.2018 | ISSUED FOR APPROVAL | E.Beygi | D.Dehghani | D.Dehghani
A0 | 30.DEC.2018 | ISSUED FOR APPROVAL | E.Beygi | D.Dehghani | D.Dehghani
Rev | DATE | DESCRIPTION | PREP'D | CHK'D | APP'D

TABULATION OF REVISED PAGES

Page | Rev-0 | Rev-1 | Rev-2 | Rev-3 | Rev-4 | | Page | Rev-0 | Rev-1 | Rev-2 | Rev-3 | Rev-4
1 | x | x | | | | | 36
2 | x | x | | | | | 37
3 | x | x | | | | | 38
4 | x | x | | | | | 39
5 | | | | | | | 40
6 | | | | | | | 41
7 | | | | | | | 42
8 | | | | | | | 43
9 | | | | | | | 44
10 | | | | | | | 45
11 | | | | | | | 46
12 | | | | | | | 47
13 | | | | | | | 48
14 | | | | | | | 49
15 | | | | | | | 50
16 | | | | | | | 51
17 | | | | | | | 52
18 | | | | | | | 53
19 | | | | | | | 54
20 | | | | | | | 55
21 | | | | | | | 56
22 | | | | | | | 57
23 | | | | | | | 58
24 | | | | | | | 59
25 | | | | | | | 60
26 | | | | | | | 61
27 | | | | | | | 62
28 | | | | | | | 63
29 | | | | | | | 64
30 | | | | | | | 65
31 | | | | | | | 66
32 | | | | | | | 67
33 | | | | | | | 68
34 | | | | | | | 69
35 | | | | | | | 70

DIESEL HYDROTREATMENT PROJECT (DHT) DOCUMENT TITLE: WPS for Damper TV-970078 Contract No.: 1032/GC-GN/CON-EP09-00 POI: FA DOCUMENT NUMBER: VD-3607/33-97-4912UD-ME-WPS-0411 Rev. No.: A1

DIESEL HYDROTREATMENT PROJECT (DHT) DOCUMENT TITLE: WPS for Damper TV-970078 Contract No.: 1032/GC-GN/CON-EP09-00 POI: FA DOCUMENT NUMBER: 3607/33-97-4912UD-ME-WPS-0411 Rev. No.: A1
