koalium/centidocs/mohajeri/Backup-Mahajeri-1402-07-11/AAC/17177/Packing List/P.L 17177-001.docx

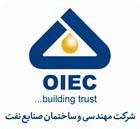
[picture p12: figure]

| NGL 3100 Project | (Vendor’s Logo)
| Packing List

Packing List

Shipper/Exporter | | No. & date of invoice: 2020/09/27
| | Remarks :
For account & risk of Messer’s
Notify party
Port of loading | Final destination
Carrier | Sailing on or about
Marks and numbers of PKGS 2 | Description of Goods Louver&Actuating Box | Quantity | Net weight 925 | Gross weight 930 | Measurement

OIEC

L/C NO. -----------------

NGL 3100 Project

DEHLORAN CHESMEH KHOSH

LOADING PORT………..….….….….…:

DISCHARGING PORT……….…..….…:

FINAL DESTINATION…………..….…:

P/O NO…………………………….…...:

DESCRIPTION OF CARGO…….…….:

PACKAGE NO…………………….…...:

GROSS WEIGHT………......……….....:

DIMENSION………………….….……:

M MADE IN…………………………...:

BRUSSEL’S CUSTOMS TARIFF NO....:

BENEFICIARY NAME……………......:

NGL 3100 Project – Dehloran Cheshmeh Khosh

Signed by:

(VENDOR’S COMPANY NAME MENTIONED IN PURCHASE ORDER)

| NGL 3100 Project | (Vendor’s Logo)
| Packing List

## PACKING LIST (Detailed Item List) Page No. 2 of 2

No. of PKGS | Description of Goods | Quantity | Net- weight (KGs) | Gross- weight (KGs) | Size (Cm × Cm ×Cm) | Vendor Name
1 | LOUVER | 2 | 895 | 895 | 432*217*40
| ACTUATING BOX | 1
| LIFTING | 8
2 | BOLT M16*50 | 8
| BOLT M16*40 | 8 | 30 | 35 | 50*30*20
| NUT M16 | 8
| SPRING WASHER A16 | 16
| FLAT WASHER 16*30 | 16

This document is the property of OIEC. It is confidential and all rights reserved. Neither the whole nor part of this document may be disclosed to any third party, reproduced, stored in any retrieval system or transmitted in any form or by any means without the prior written consent of OIEC. Contr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
