koalium/centidocs/elec/plc/سایر/New folder/Screenshot_۲۰۲۴۰۹۲۸-۰۷۱۵۰۶_Snapp.jpg

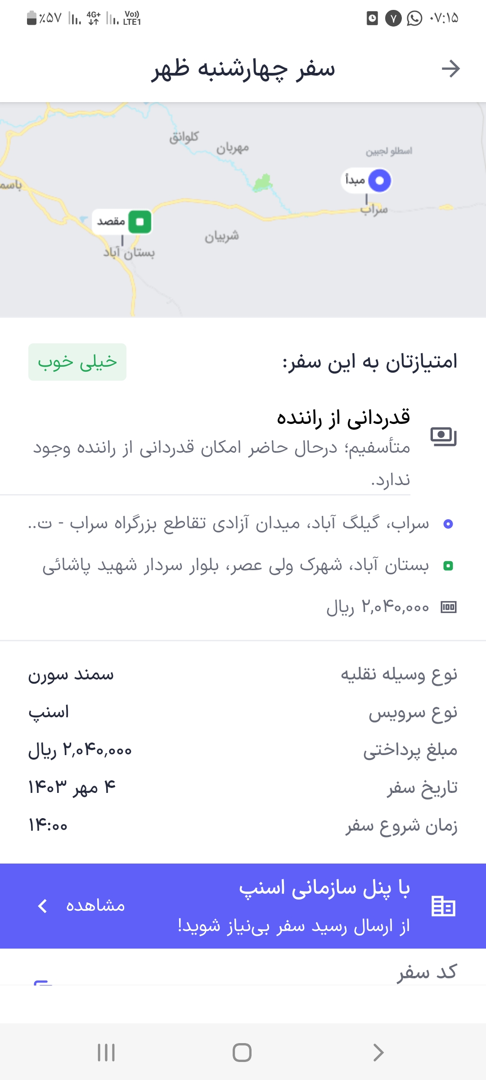
elec/plc/سایر/New folder/Screenshot_۲۰۲۴۰۹۲۸-۰۷۱۵۰۶_Snapp.jpg
