koalium/centidocs/elec/plc/سایر/New folder/Screenshot_۲۰۲۴۰۹۲۸-۰۷۱۵۳۹_Snapp.jpg

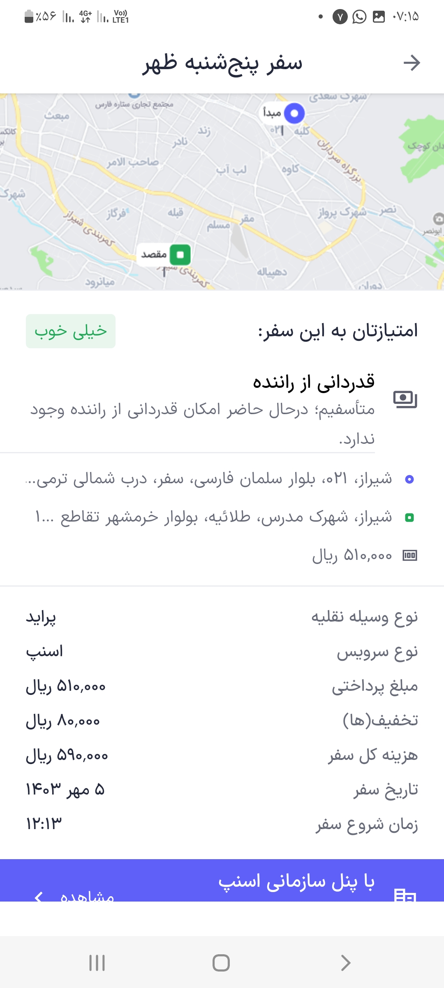
elec/plc/سایر/New folder/Screenshot_۲۰۲۴۰۹۲۸-۰۷۱۵۳۹_Snapp.jpg
