koalium/centidocs/elec/plc/سایر/New folder/Screenshot_۲۰۲۴۰۹۲۸-۰۷۱۶۰۵_Snapp.jpg

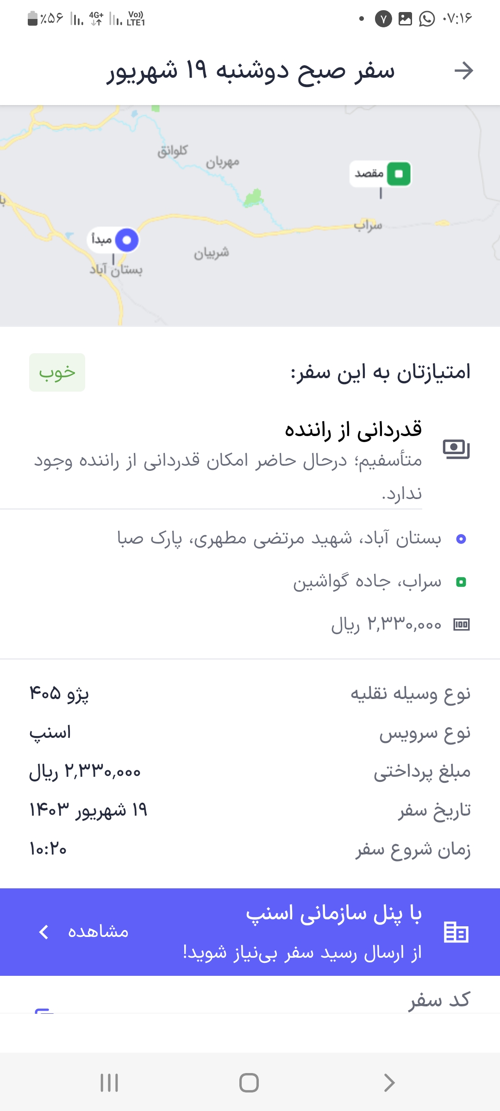
elec/plc/سایر/New folder/Screenshot_۲۰۲۴۰۹۲۸-۰۷۱۶۰۵_Snapp.jpg
