koalium/centidocs/elec/plc/سایر/New folder/Screenshot_۲۰۲۴۰۹۲۸-۰۷۱۶۲۴_Snapp.jpg

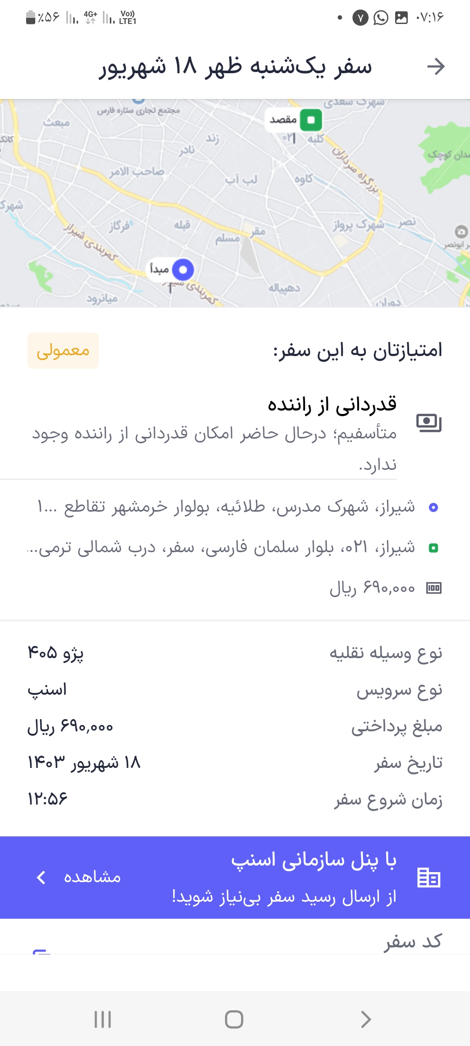
elec/plc/سایر/New folder/Screenshot_۲۰۲۴۰۹۲۸-۰۷۱۶۲۴_Snapp.jpg
