koalium/centidocs/jokar/0/لوگو خلیج فارس 2.png

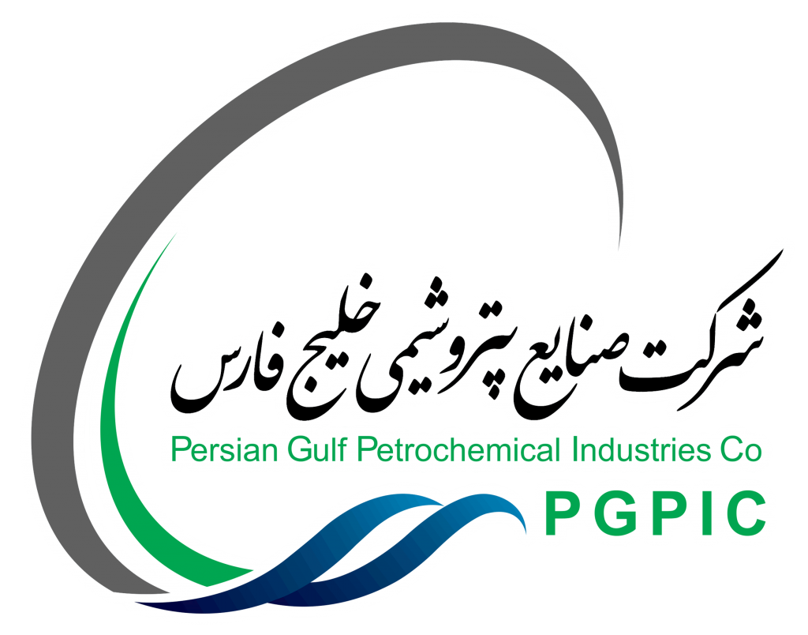
jokar/0/لوگو خلیج فارس 2.png
