koalium/centidocs/jokar/0/لوگو پیدک 2.jpg

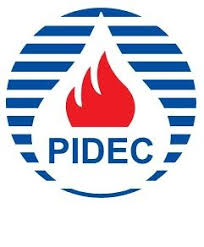
jokar/0/لوگو پیدک 2.jpg
