koalium/centidocs/jokar/0/لوگو پیدک.png

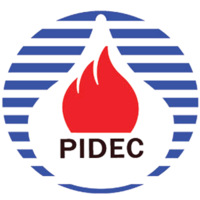
jokar/0/لوگو پیدک.png
