koalium/centidocs/jokar/Capture.PNG

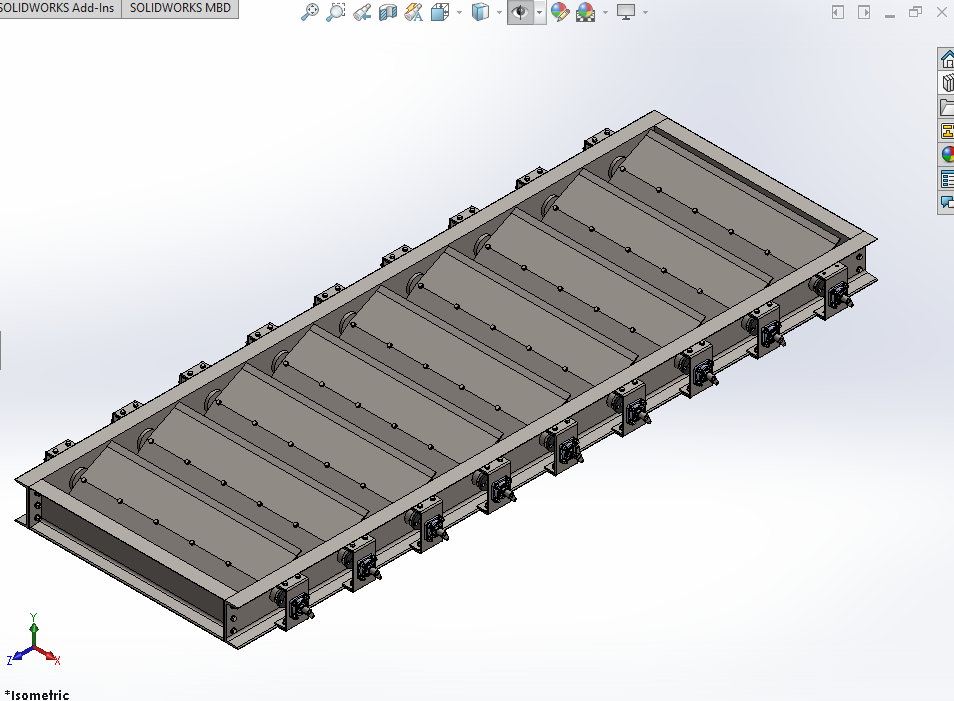
jokar/Capture.PNG
