koalium/centidocs/jokar/Untitled.jpg

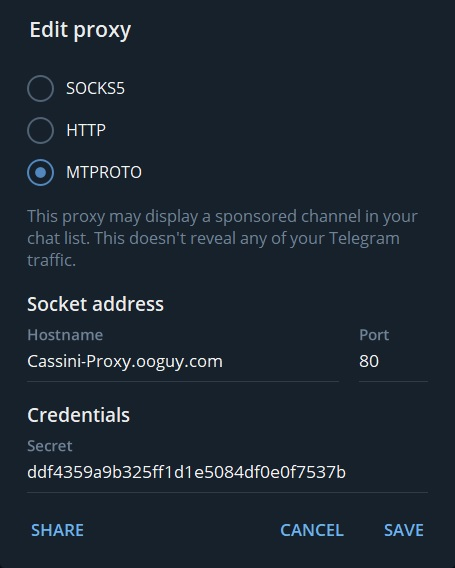
jokar/Untitled.jpg
