koalium/centidocs/jokar/بست کیسه داست کلکتور/۲۰۲۱۰۱۱۹_۱۴۰۸۰۵.jpg

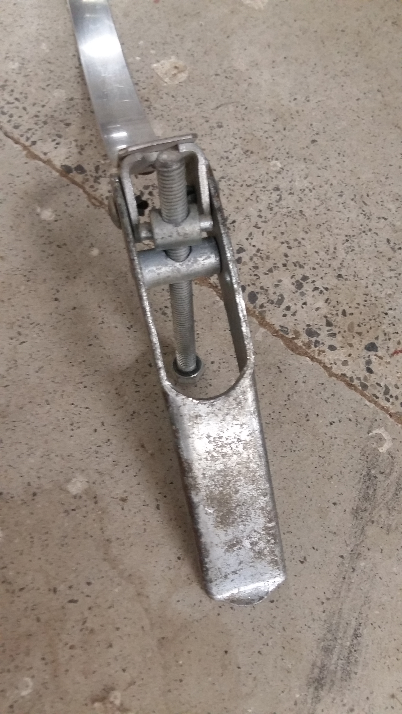
jokar/بست کیسه داست کلکتور/۲۰۲۱۰۱۱۹_۱۴۰۸۰۵.jpg
