koalium/centidocs/jokar/بست کیسه داست کلکتور/۲۰۲۱۰۱۱۹_۱۴۰۸۱۳.jpg

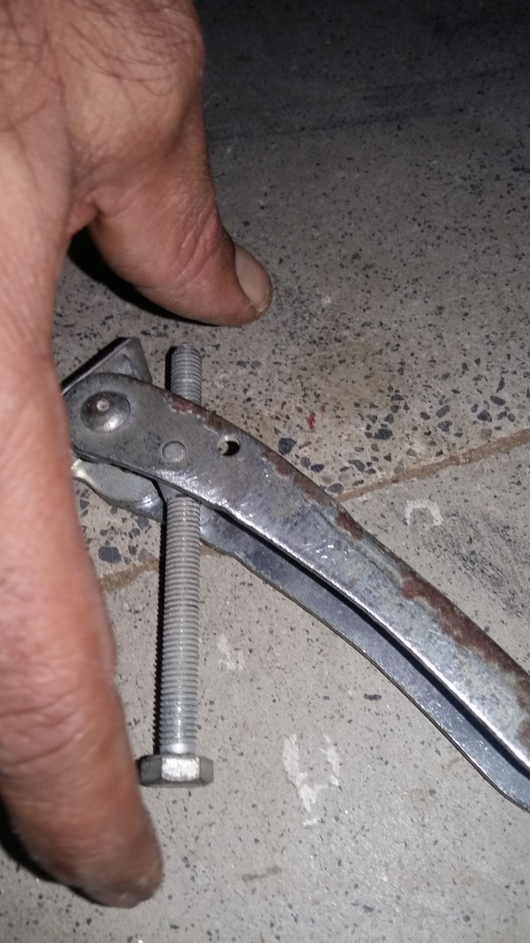
jokar/بست کیسه داست کلکتور/۲۰۲۱۰۱۱۹_۱۴۰۸۱۳.jpg
