koalium/centidocs/jokar/بست کیسه داست کلکتور/۲۰۲۱۰۱۱۹_۱۴۰۸۲۰.jpg

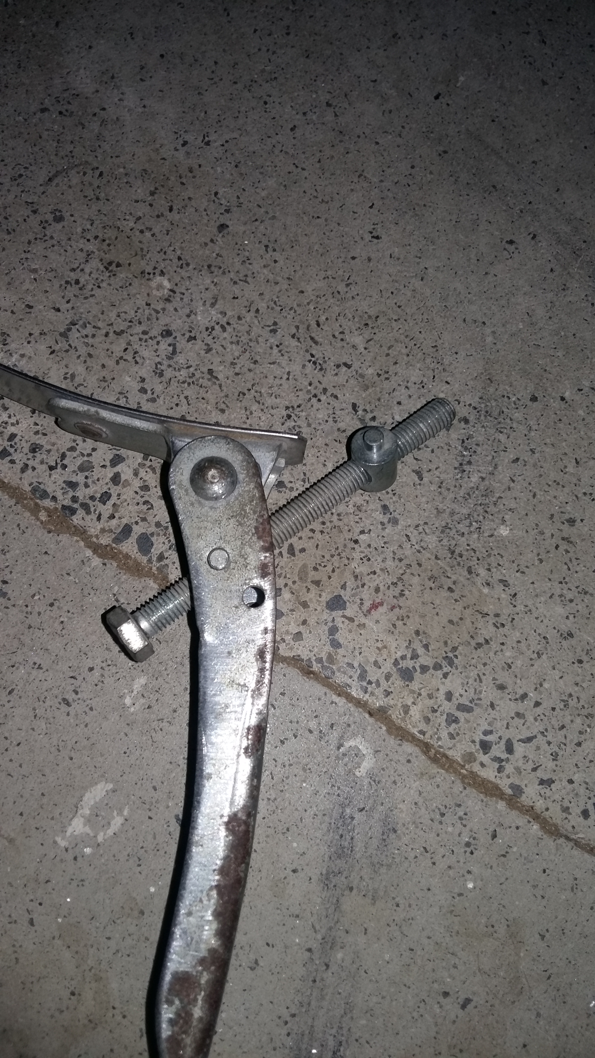
jokar/بست کیسه داست کلکتور/۲۰۲۱۰۱۱۹_۱۴۰۸۲۰.jpg
