koalium/centidocs/jokar/بست کیسه داست کلکتور/۲۰۲۱۰۱۱۹_۱۴۰۸۳۳.jpg

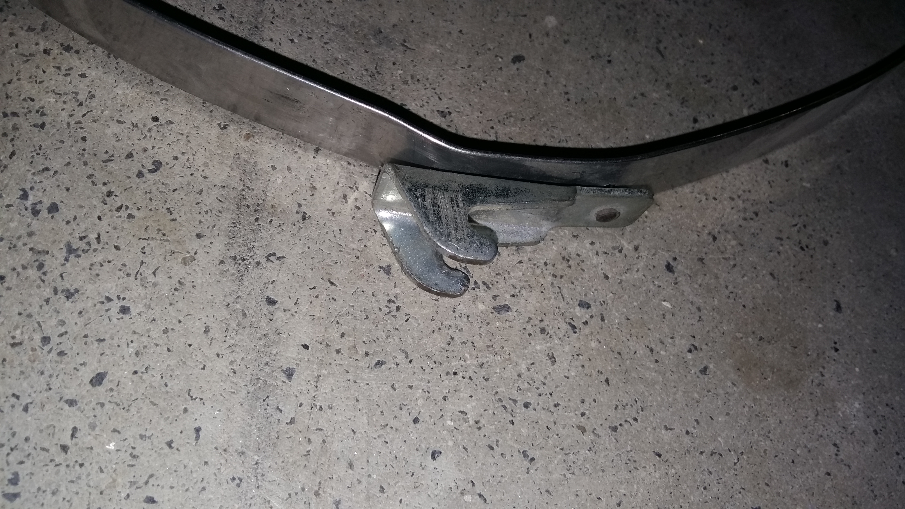
jokar/بست کیسه داست کلکتور/۲۰۲۱۰۱۱۹_۱۴۰۸۳۳.jpg
