koalium/centidocs/jokar/بست کیسه داست کلکتور/۲۰۲۱۰۱۱۹_۱۴۰۸۴۳.jpg

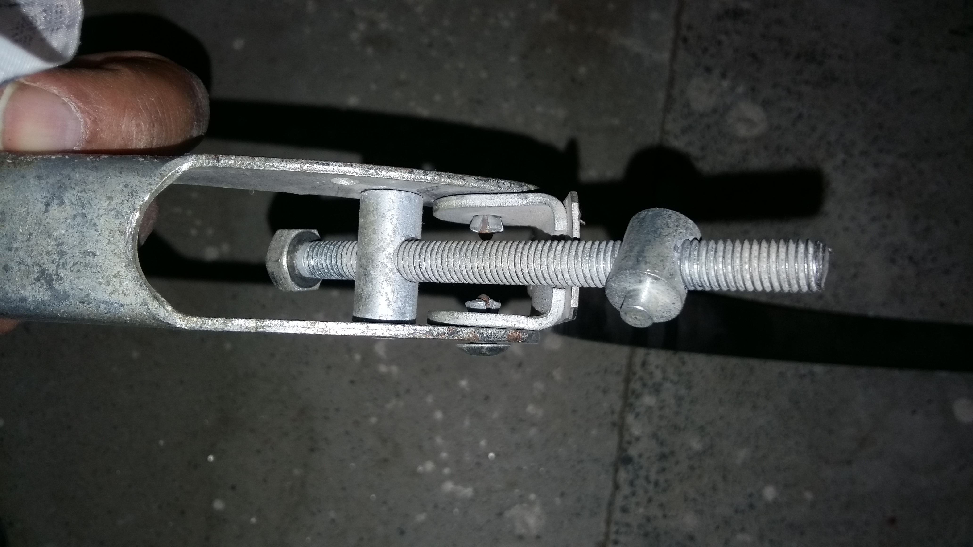
jokar/بست کیسه داست کلکتور/۲۰۲۱۰۱۱۹_۱۴۰۸۴۳.jpg
