koalium/centidocs/jokar/مسلم بهروز 2.jpg

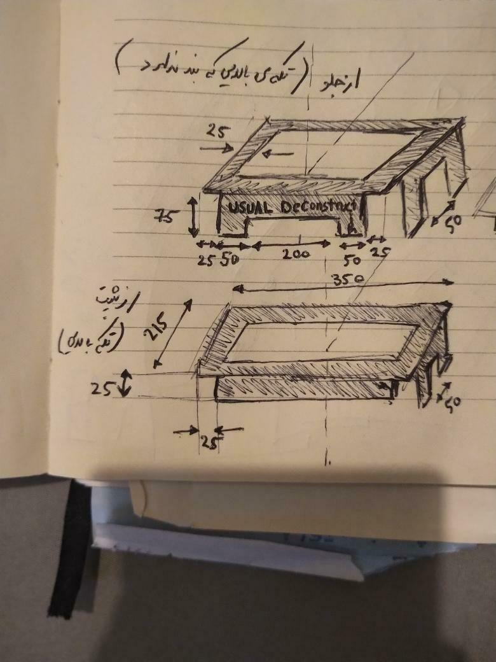
jokar/مسلم بهروز 2.jpg
