koalium/centidocs/jokar/مسلم بهروز.jpg

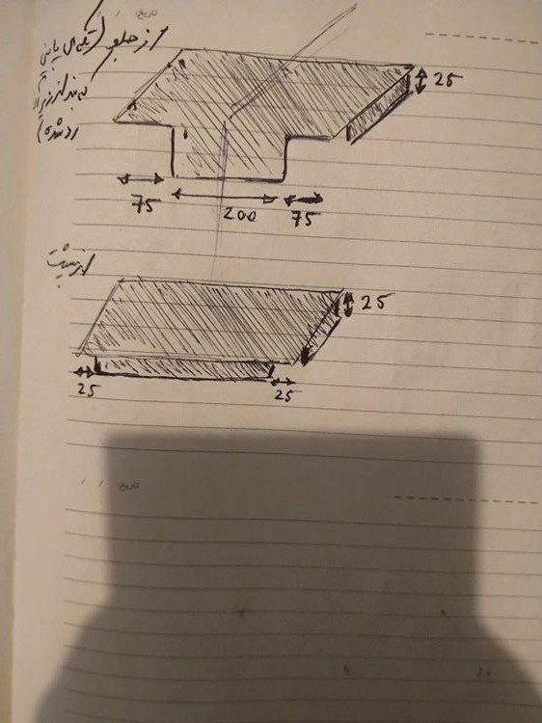
jokar/مسلم بهروز.jpg
