koalium/centidocs/mohajeri/0/Screenshot_20230905-201939_Snapp.jpg

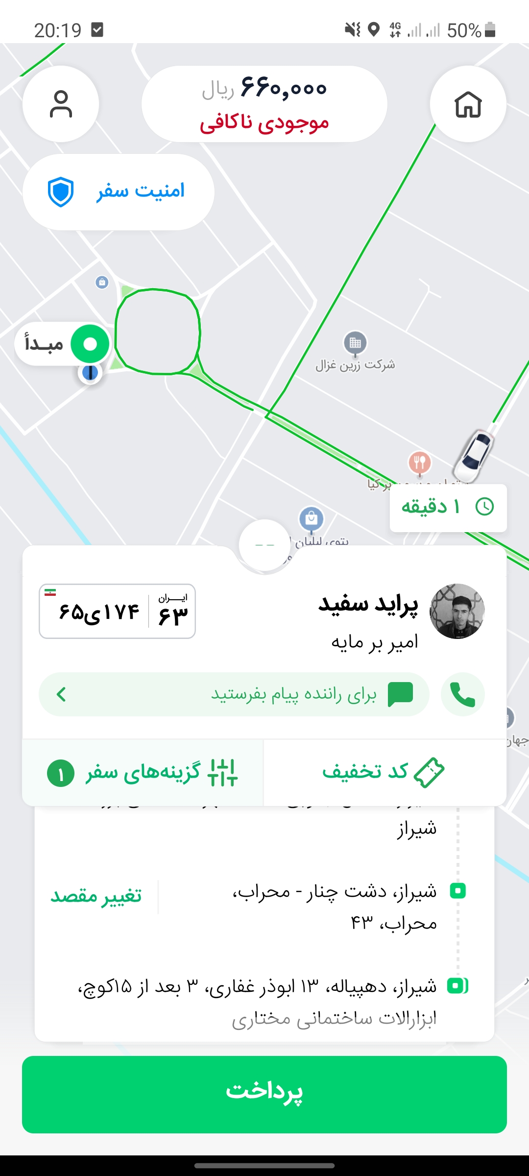
mohajeri/0/Screenshot_20230905-201939_Snapp.jpg
