koalium/centidocs/mohajeri/aban/IMG_20221023_155554.jpg

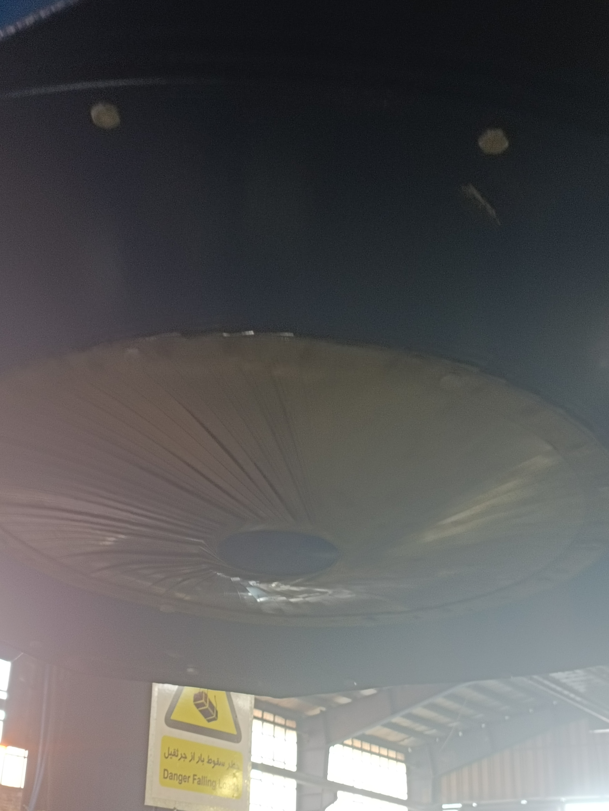
mohajeri/aban/IMG_20221023_155554.jpg
