koalium/centidocs/mohajeri/aban/IMG_20221023_155556.jpg

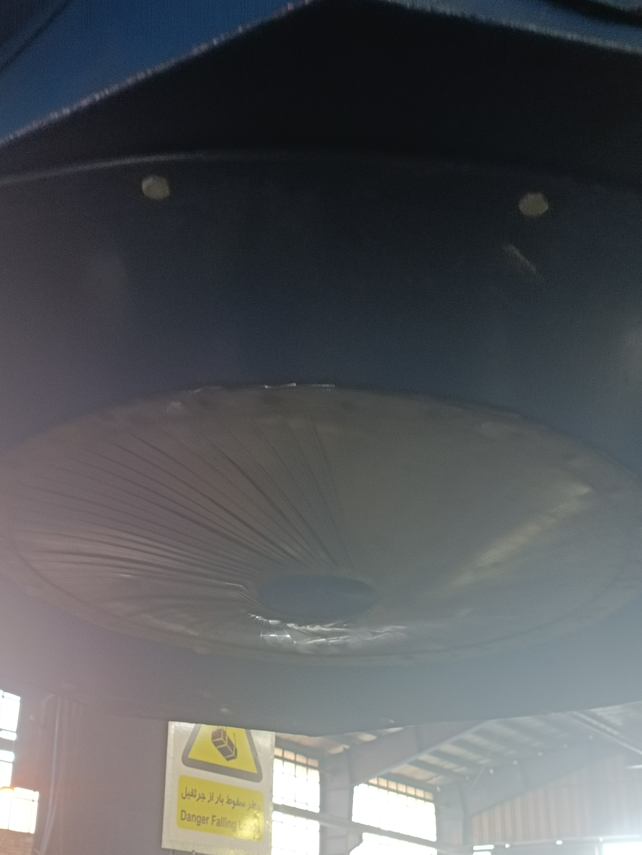
mohajeri/aban/IMG_20221023_155556.jpg
