koalium/centidocs/mohajeri/aban/IMG_20221024_134044.jpg

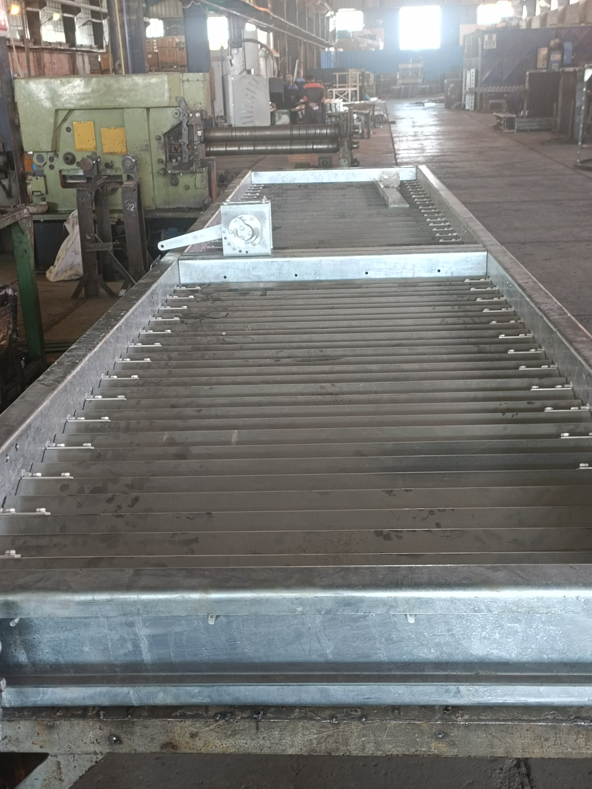
mohajeri/aban/IMG_20221024_134044.jpg
