koalium/centidocs/mohajeri/aban/IMG_20221024_134050.jpg

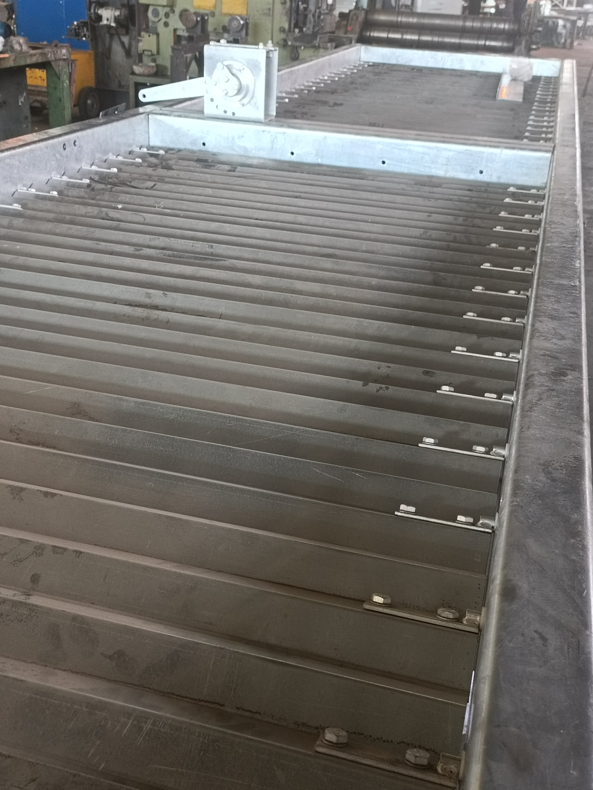
mohajeri/aban/IMG_20221024_134050.jpg
