koalium/centidocs/mohajeri/aban/IMG_20221024_134220.jpg

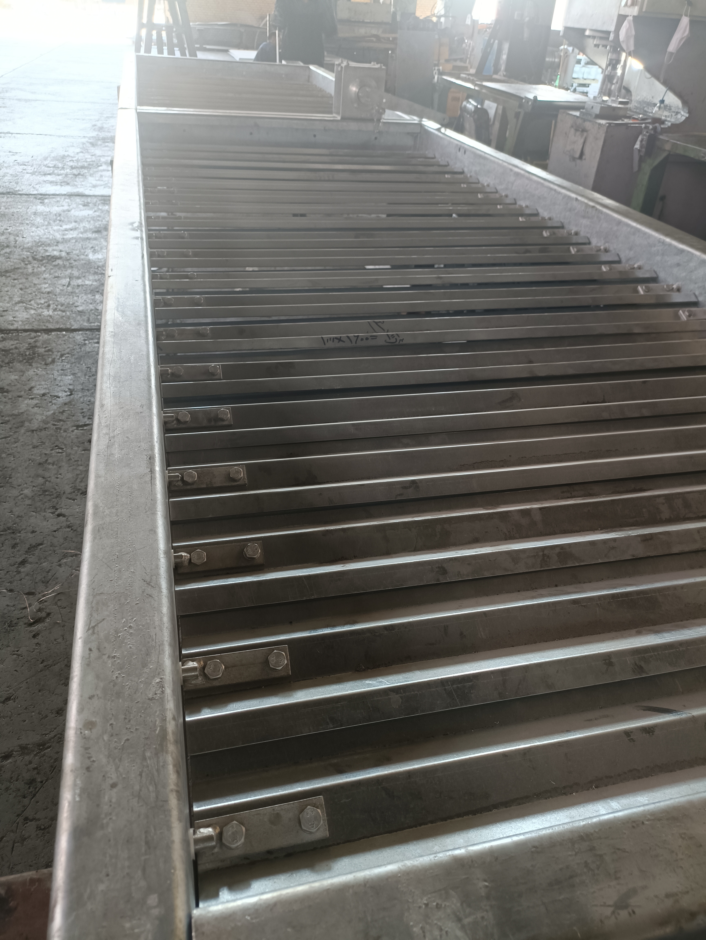
mohajeri/aban/IMG_20221024_134220.jpg
