koalium/centidocs/mohajeri/aban/IMG_20221024_134302.jpg

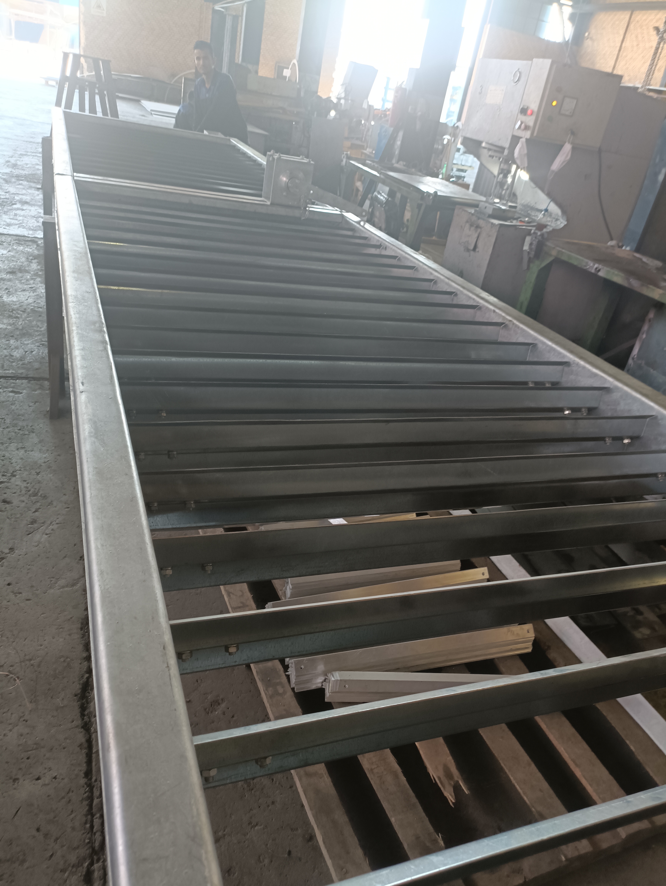
mohajeri/aban/IMG_20221024_134302.jpg
