koalium/centidocs/mohajeri/aban/IMG_20221024_134313.jpg

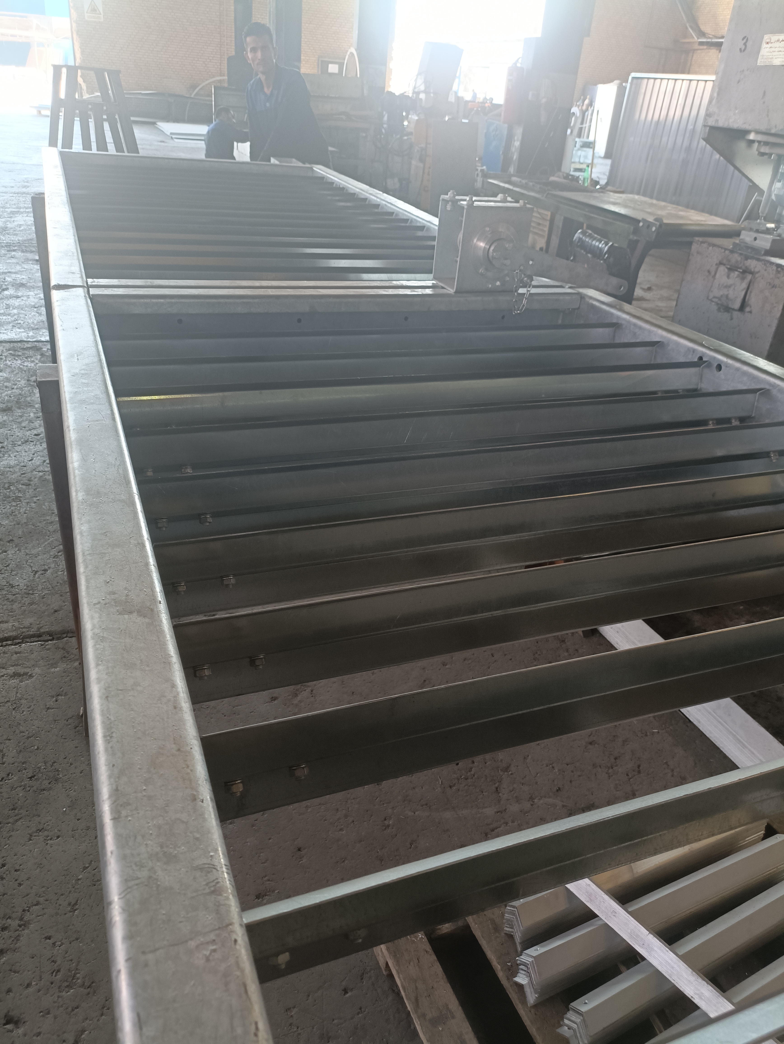
mohajeri/aban/IMG_20221024_134313.jpg
