koalium/centidocs/mohajeri/aban/IMG_20221024_134403.jpg

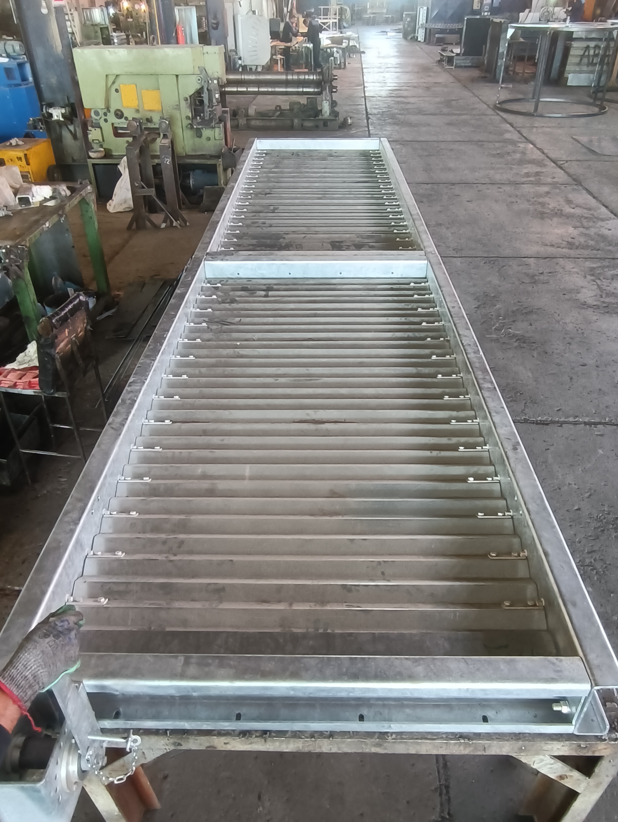
mohajeri/aban/IMG_20221024_134403.jpg
