koalium/centidocs/mohajeri/aban/IMG_20221024_134409.jpg

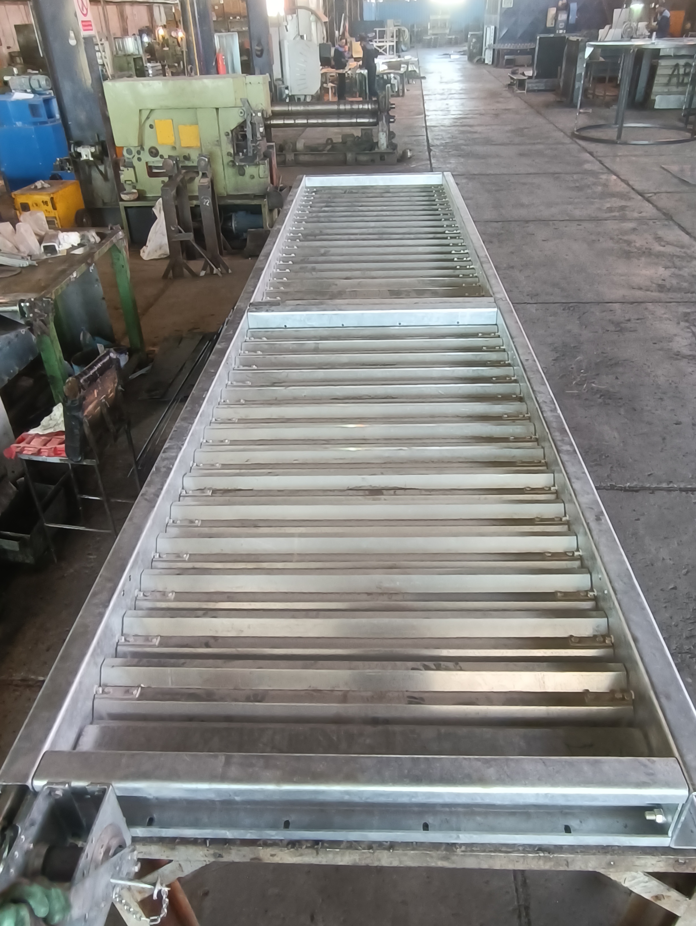
mohajeri/aban/IMG_20221024_134409.jpg
