koalium/centidocs/mohajeri/aban/IMG_20221024_134419.jpg

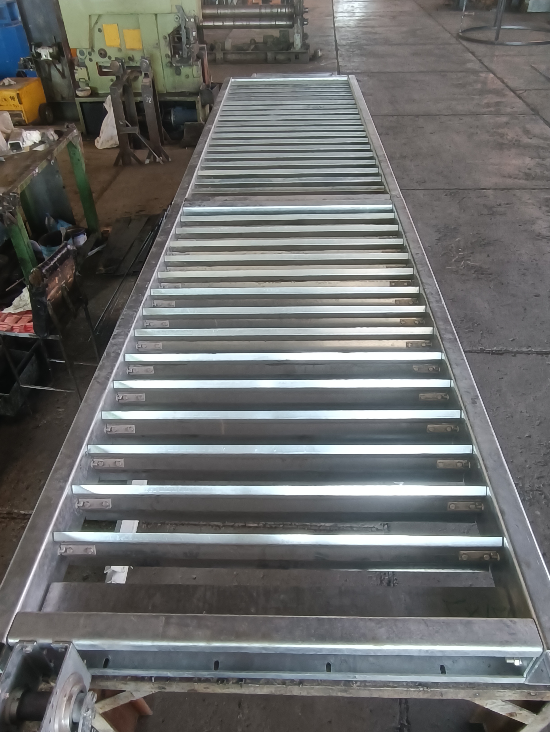
mohajeri/aban/IMG_20221024_134419.jpg
