koalium/centidocs/mohajeri/aban/IMG_20221024_134503.jpg

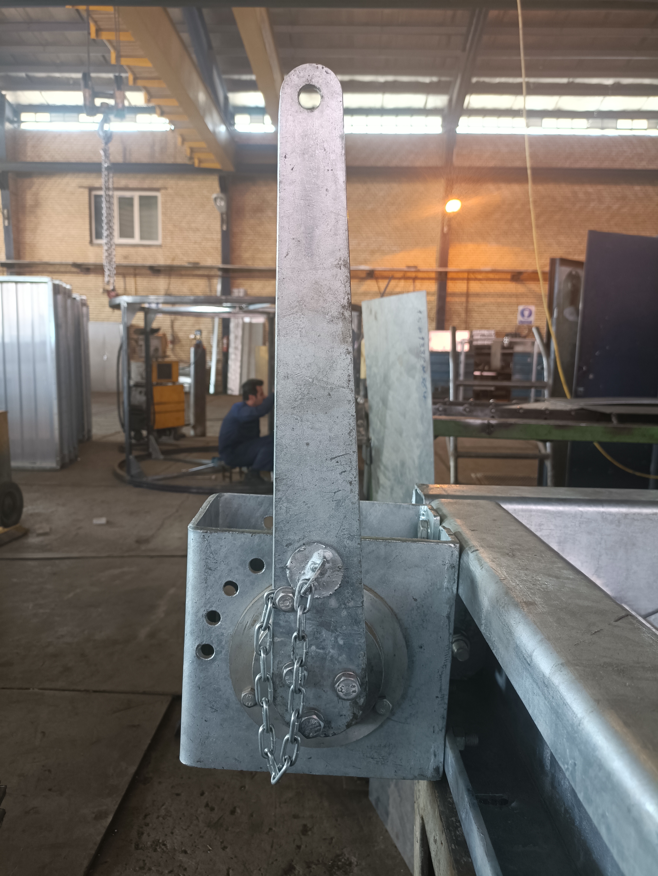
mohajeri/aban/IMG_20221024_134503.jpg
