koalium/centidocs/mohajeri/aban/IMG_20221024_134603.jpg

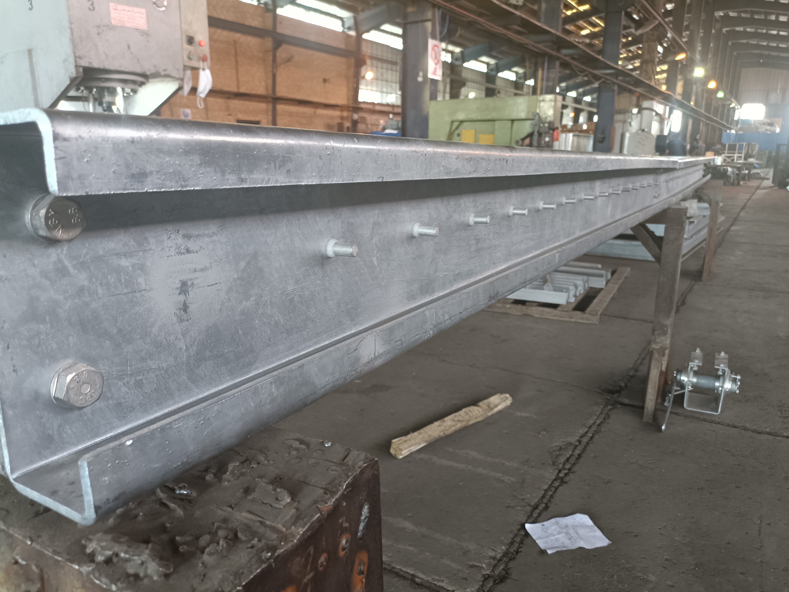
mohajeri/aban/IMG_20221024_134603.jpg
