koalium/centidocs/mohajeri/aban/IMG_20221024_134617.jpg

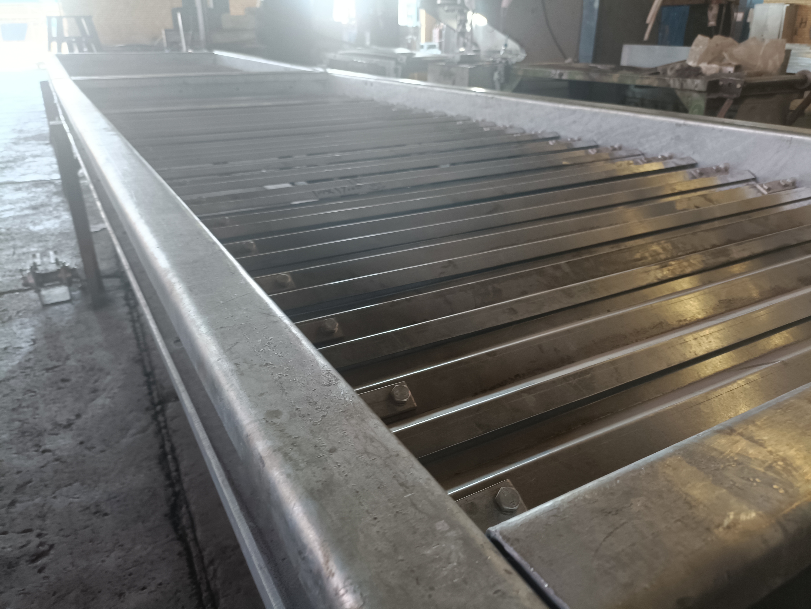
mohajeri/aban/IMG_20221024_134617.jpg
