koalium/centidocs/mohajeri/aban/IMG_20221024_134659.jpg

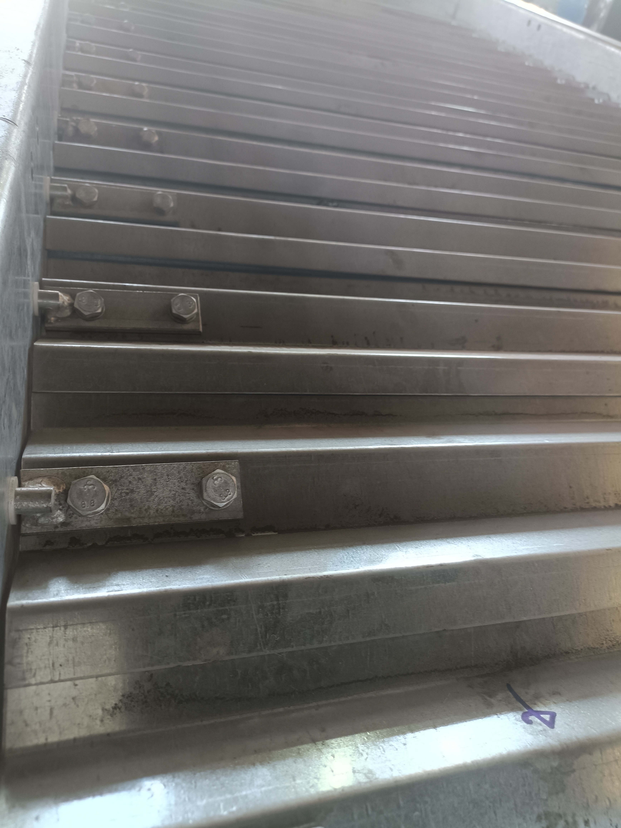
mohajeri/aban/IMG_20221024_134659.jpg
