koalium/centidocs/mohajeri/aban/IMG_20221024_134705.jpg

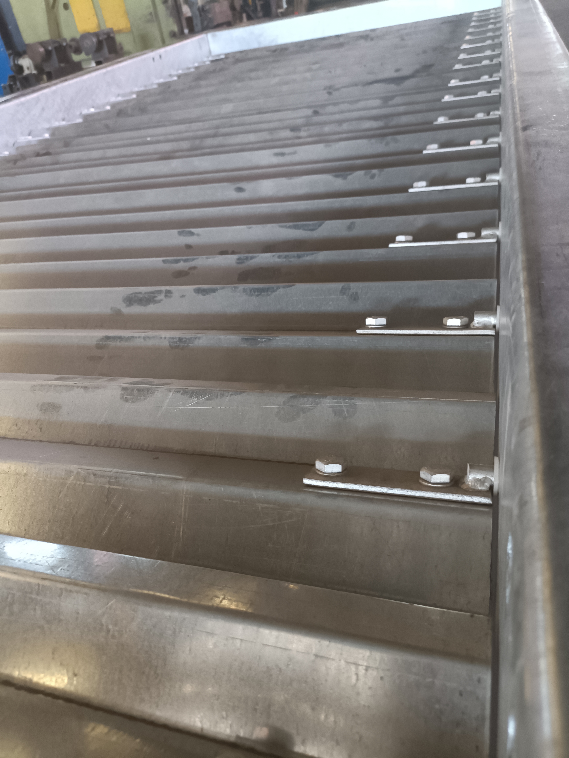
mohajeri/aban/IMG_20221024_134705.jpg
