koalium/centidocs/mohajeri/aban/IMG_20221025_094950.jpg

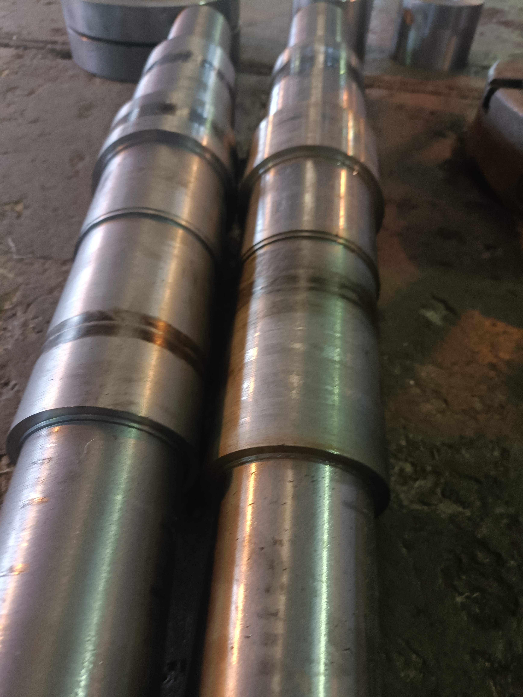
mohajeri/aban/IMG_20221025_094950.jpg
