koalium/centidocs/mohajeri/Backup-Mahajeri-1402-07-11/AAC/17182/17182/IMG_20230104_103411.jpg

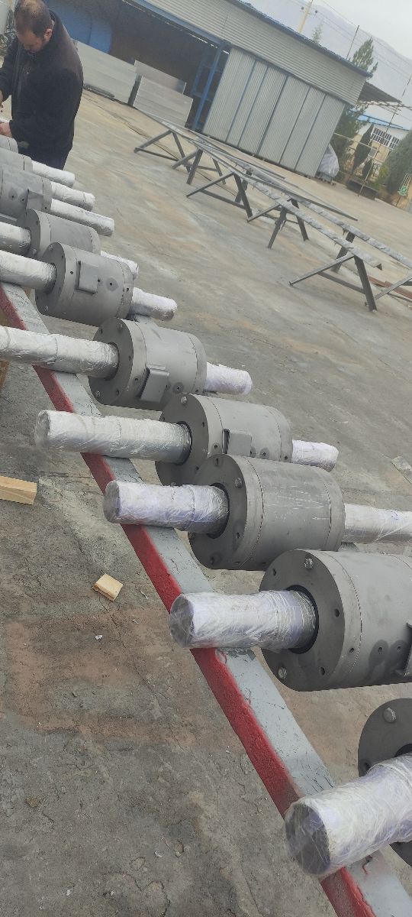
mohajeri/Backup-Mahajeri-1402-07-11/AAC/17182/17182/IMG_20230104_103411.jpg
