koalium/centidocs/mohajeri/Backup-Mahajeri-1402-07-11/AAC/17182/17182/New folder/IMG_20230107_085210.jpg

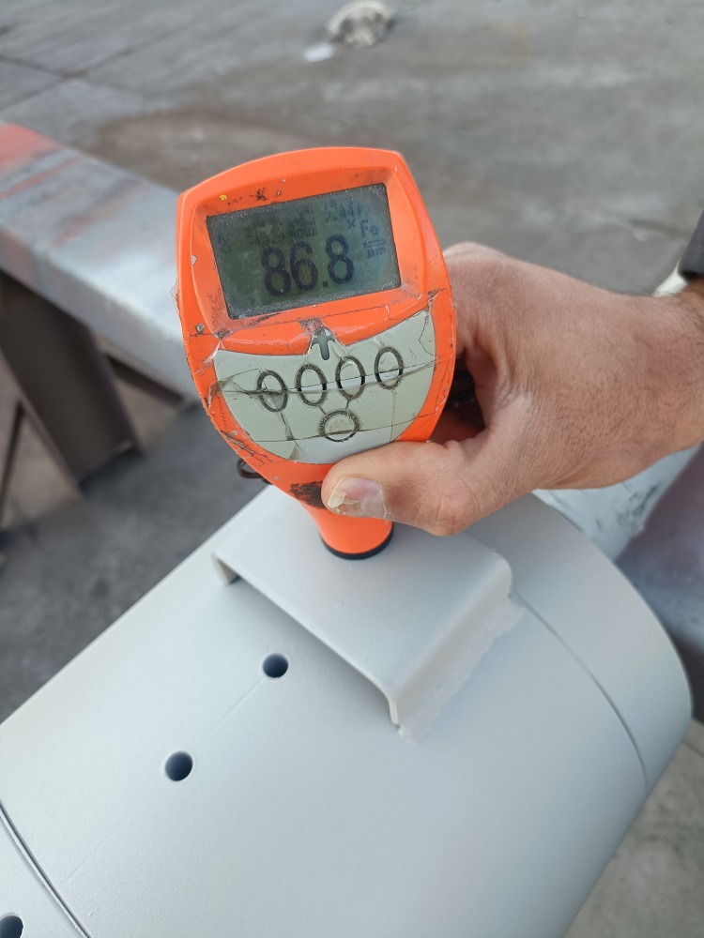
mohajeri/Backup-Mahajeri-1402-07-11/AAC/17182/17182/New folder/IMG_20230107_085210.jpg
