koalium/centidocs/mohajeri/Backup-Mahajeri-1402-07-11/AAC/17182/IMG_20230104_092424.jpg

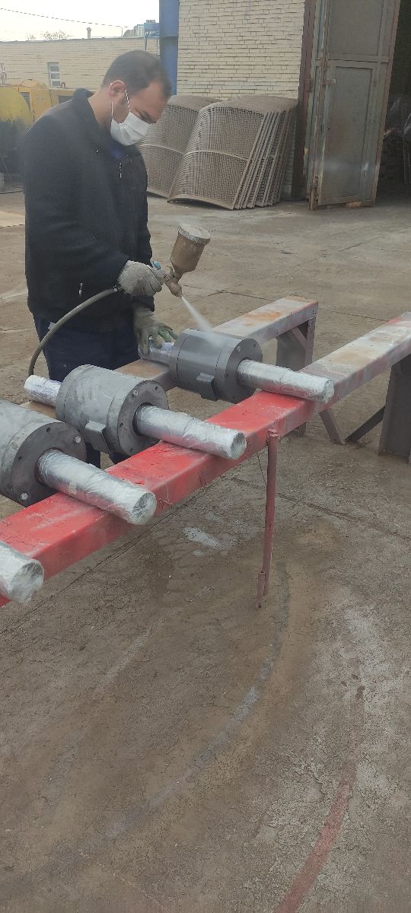
mohajeri/Backup-Mahajeri-1402-07-11/AAC/17182/IMG_20230104_092424.jpg
