koalium/centidocs/mohajeri/Backup-Mahajeri-1402-07-11/AAC/17182/IMG_20230109_092008.jpg

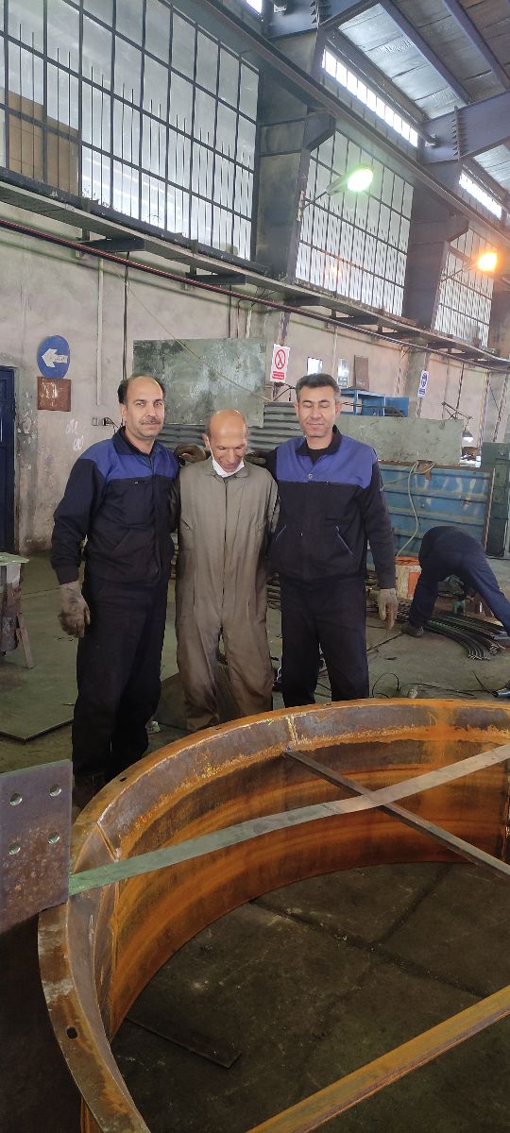
mohajeri/Backup-Mahajeri-1402-07-11/AAC/17182/IMG_20230109_092008.jpg
