koalium/centidocs/mohajeri/Backup-Mahajeri-1402-07-11/AAC/17182/WhatsApp Image 2021-05-15 at 07.24.08.jpeg

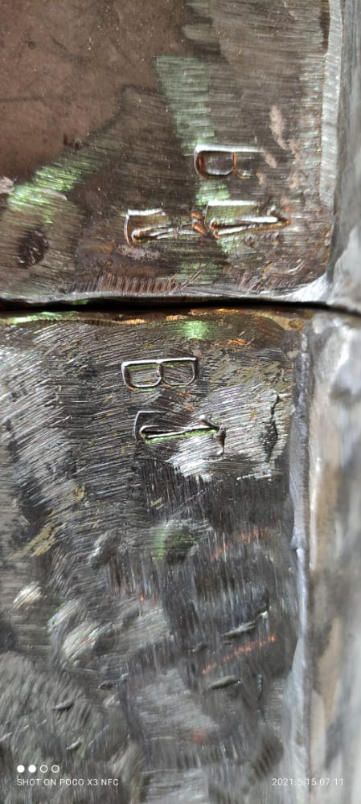
mohajeri/Backup-Mahajeri-1402-07-11/AAC/17182/WhatsApp Image 2021-05-15 at 07.24.08.jpeg
