koalium/centidocs/mohajeri/Backup-Mahajeri-1402-07-11/AAC/17187/230 ST52 (1).jpg

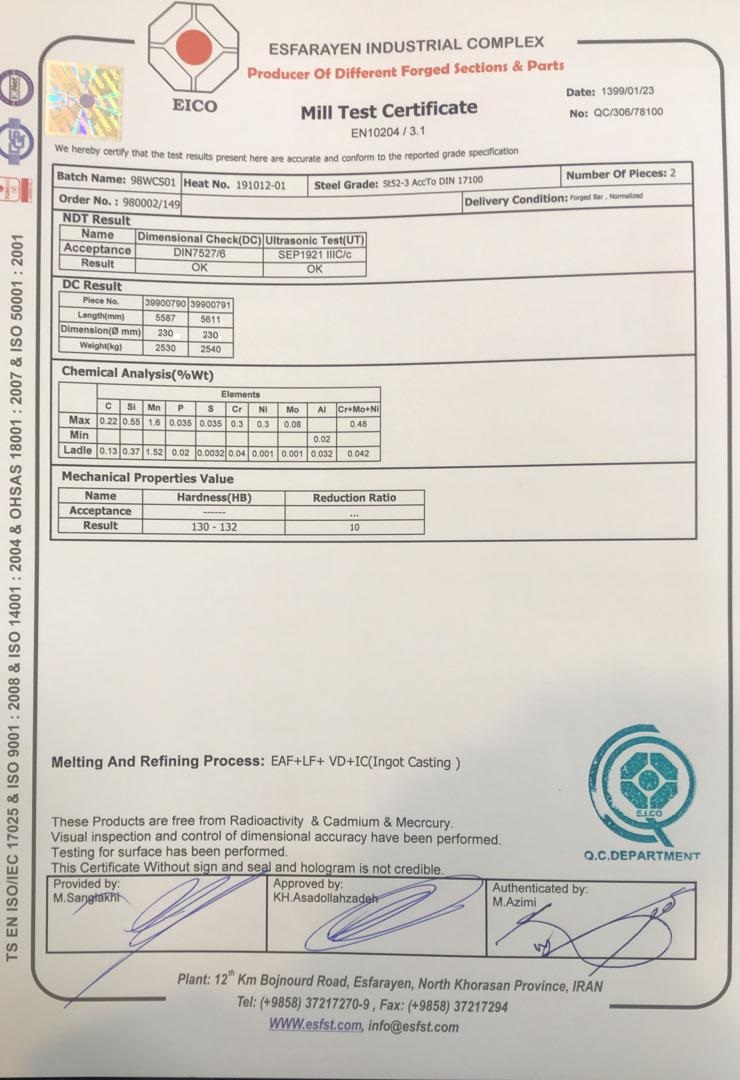
mohajeri/Backup-Mahajeri-1402-07-11/AAC/17187/230 ST52 (1).jpg
