koalium/centidocs/mohajeri/Backup-Mahajeri-1402-07-11/AAC/17187/WhatsApp Image 2021-07-06 at 14.13.20 (2).jpeg

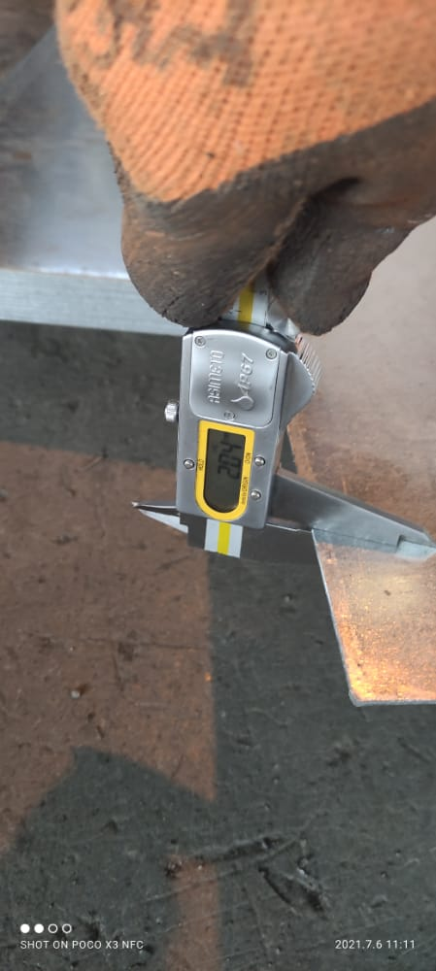
mohajeri/Backup-Mahajeri-1402-07-11/AAC/17187/WhatsApp Image 2021-07-06 at 14.13.20 (2).jpeg
