koalium/centidocs/mohajeri/Backup-Mahajeri-1402-07-11/AAC/17189/94a4668e-b55f-4ccf-bd32-b52b2475beb5.jpg

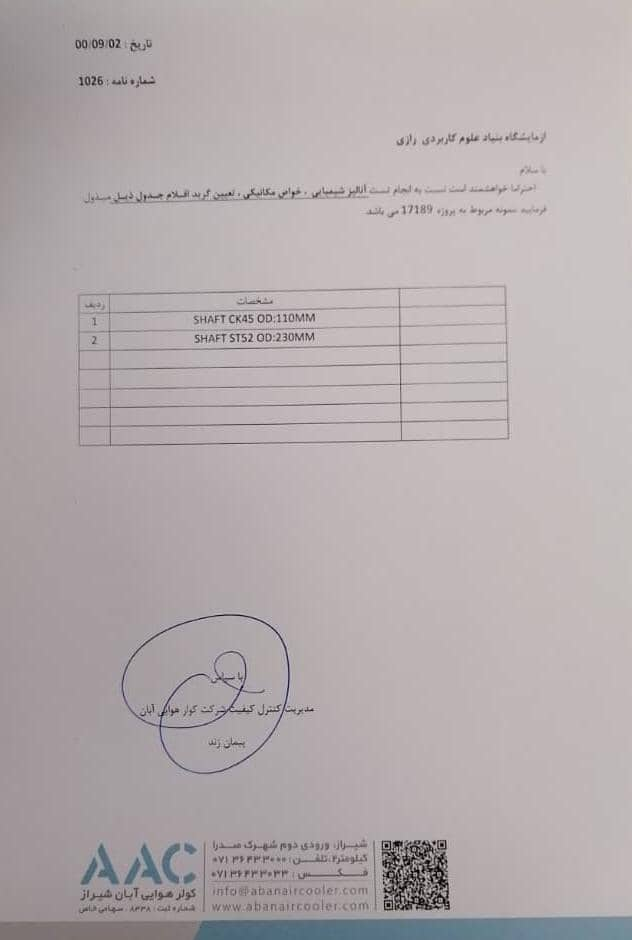
mohajeri/Backup-Mahajeri-1402-07-11/AAC/17189/94a4668e-b55f-4ccf-bd32-b52b2475beb5.jpg
