koalium/centidocs/mohajeri/Backup-Mahajeri-1402-07-11/b1402-07-11/FileSize-and-info1(AAC).jpg

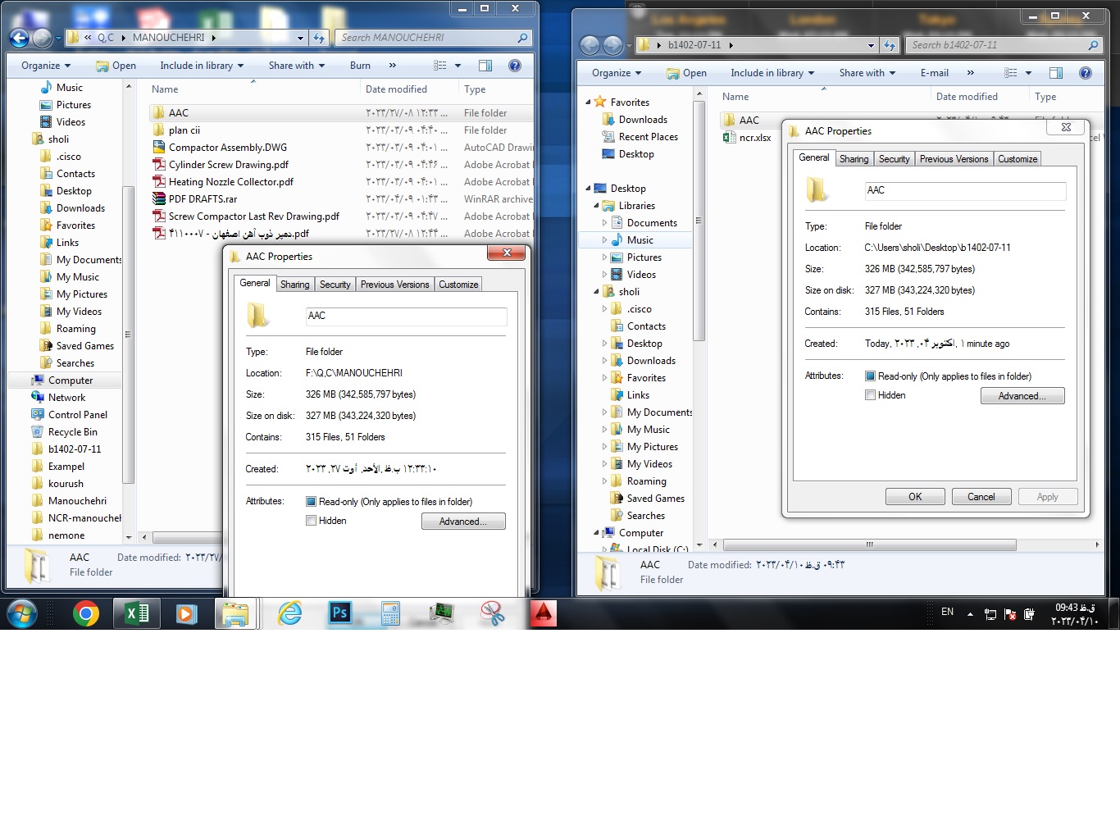
mohajeri/Backup-Mahajeri-1402-07-11/b1402-07-11/FileSize-and-info1(AAC).jpg
