koalium/centidocs/mohajeri/Backup-Mahajeri-1402-07-11/Filesize-And-info1(AAC).jpg

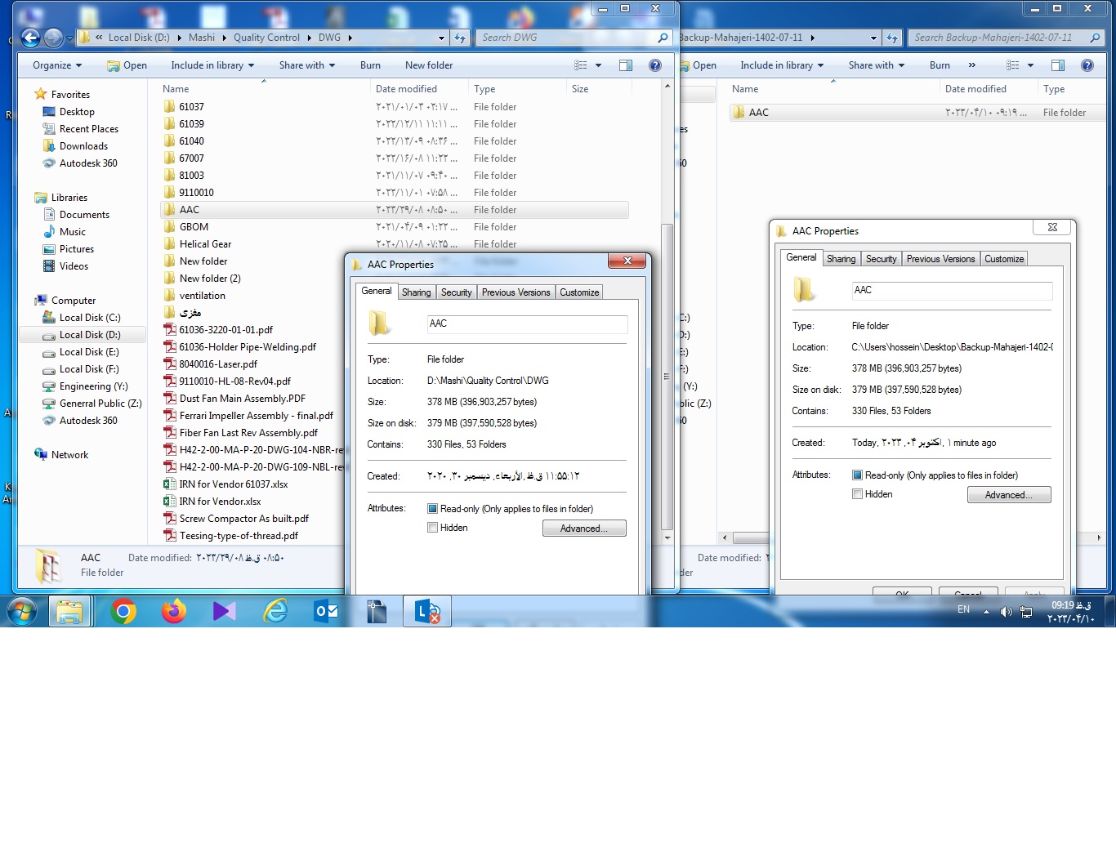
mohajeri/Backup-Mahajeri-1402-07-11/Filesize-And-info1(AAC).jpg
