koalium/centidocs/mohajeri/Backup-Mahajeri-1402-07-11/Filesize-And-info2(HVAC).jpg

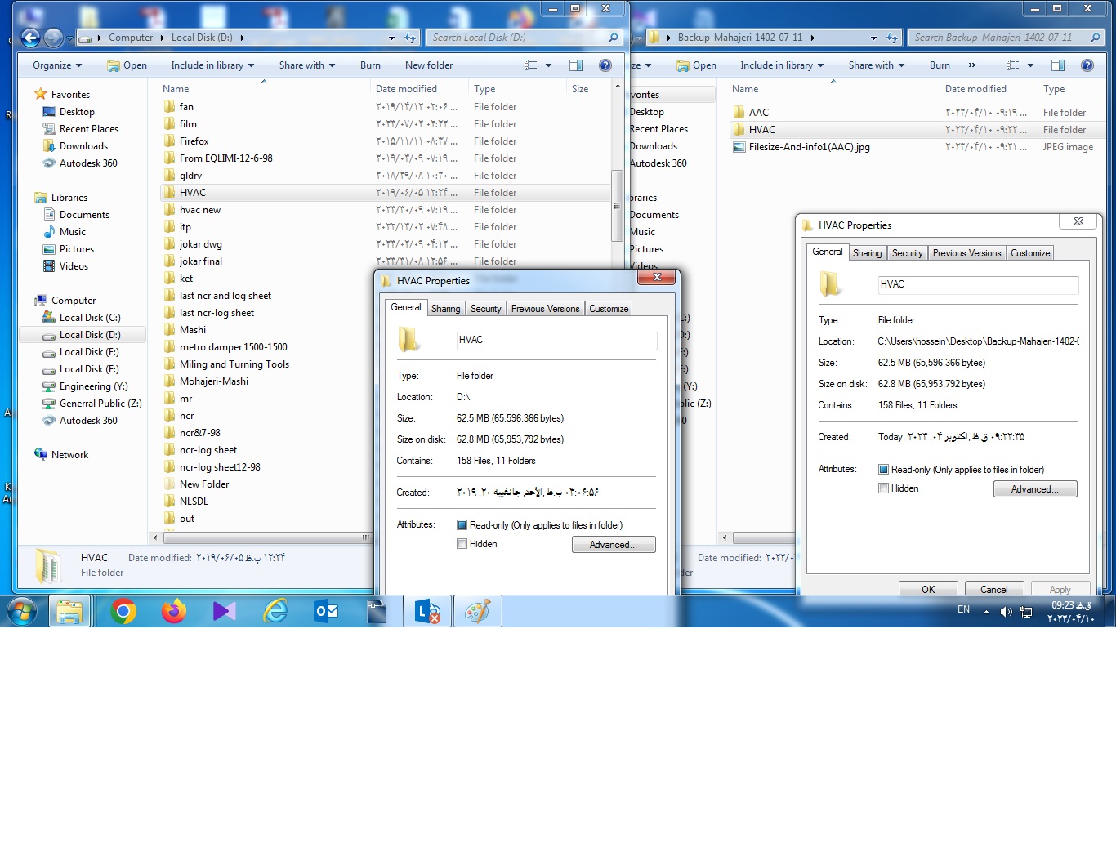
mohajeri/Backup-Mahajeri-1402-07-11/Filesize-And-info2(HVAC).jpg
