koalium/centidocs/mohajeri/Backup-Mahajeri-1402-07-11/Filesize-And-info3(hvac new).jpg

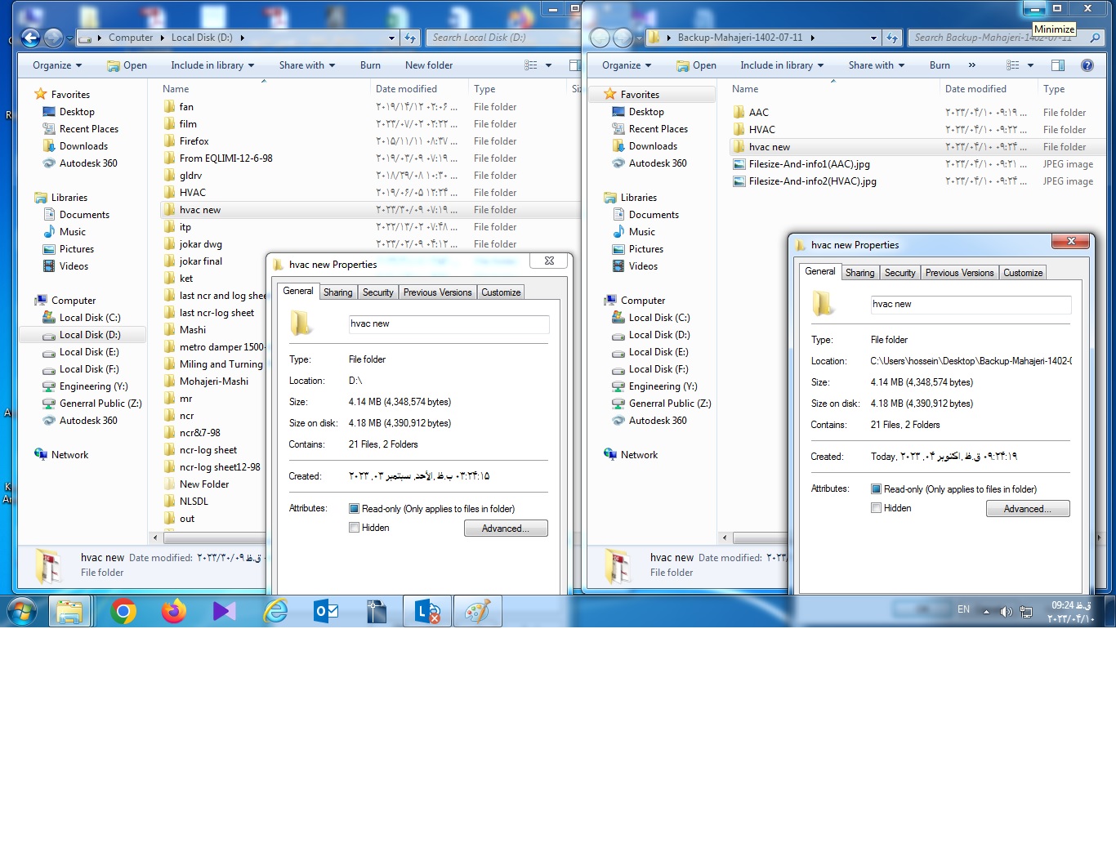
mohajeri/Backup-Mahajeri-1402-07-11/Filesize-And-info3(hvac new).jpg
