koalium/centidocs/mohajeri/drive shaft/DSC01038.JPG

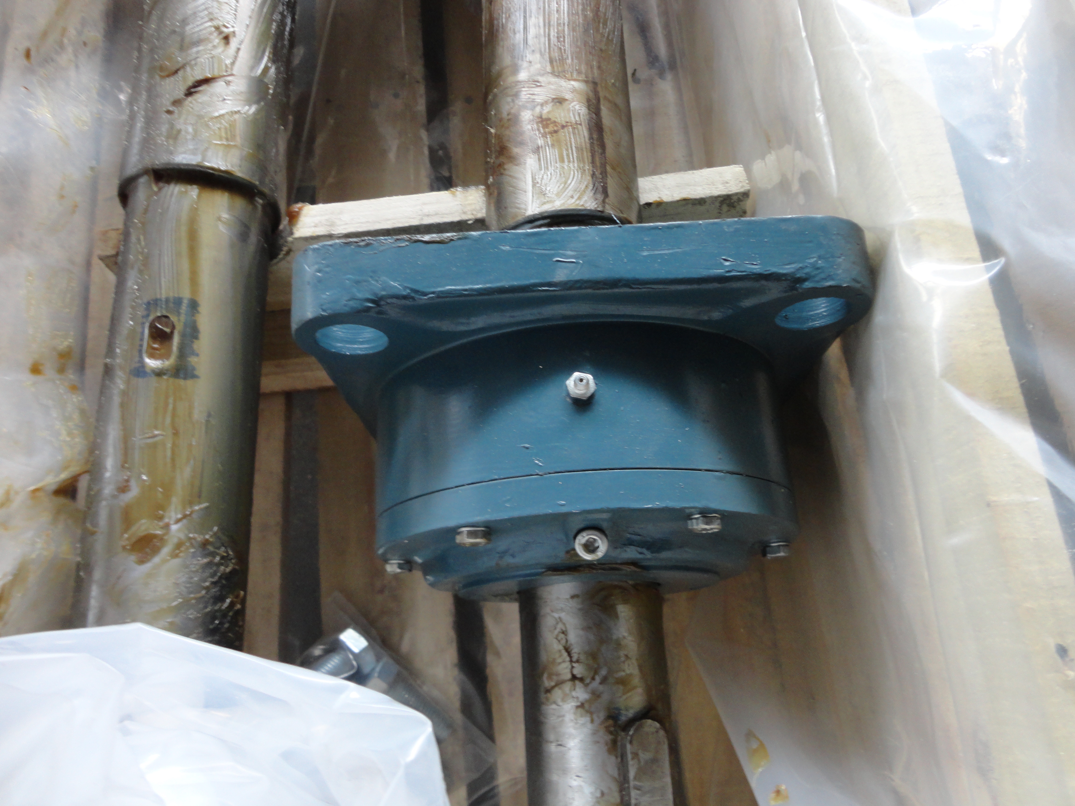
mohajeri/drive shaft/DSC01038.JPG
