koalium/centidocs/mohajeri/لوگو.JPG

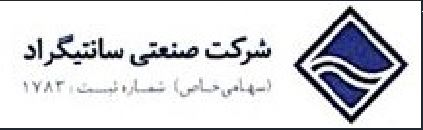
mohajeri/لوگو.JPG
