koalium/centidocs/Q.C/IMG-20230425-WA0030.jpg

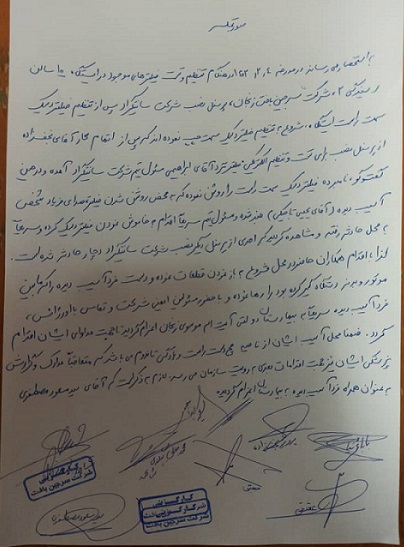
Q.C/IMG-20230425-WA0030.jpg
