koalium/centidocs/Q.C/IMG-20230425-WA0031.jpg

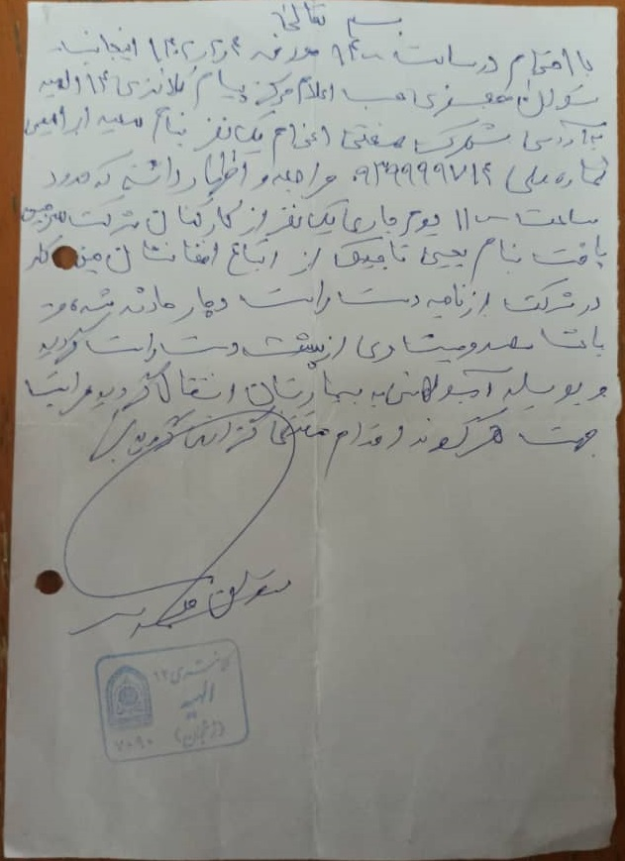
Q.C/IMG-20230425-WA0031.jpg
