koalium/centidocs/Q.C/Mashi/17152/CCI02152021.jpg

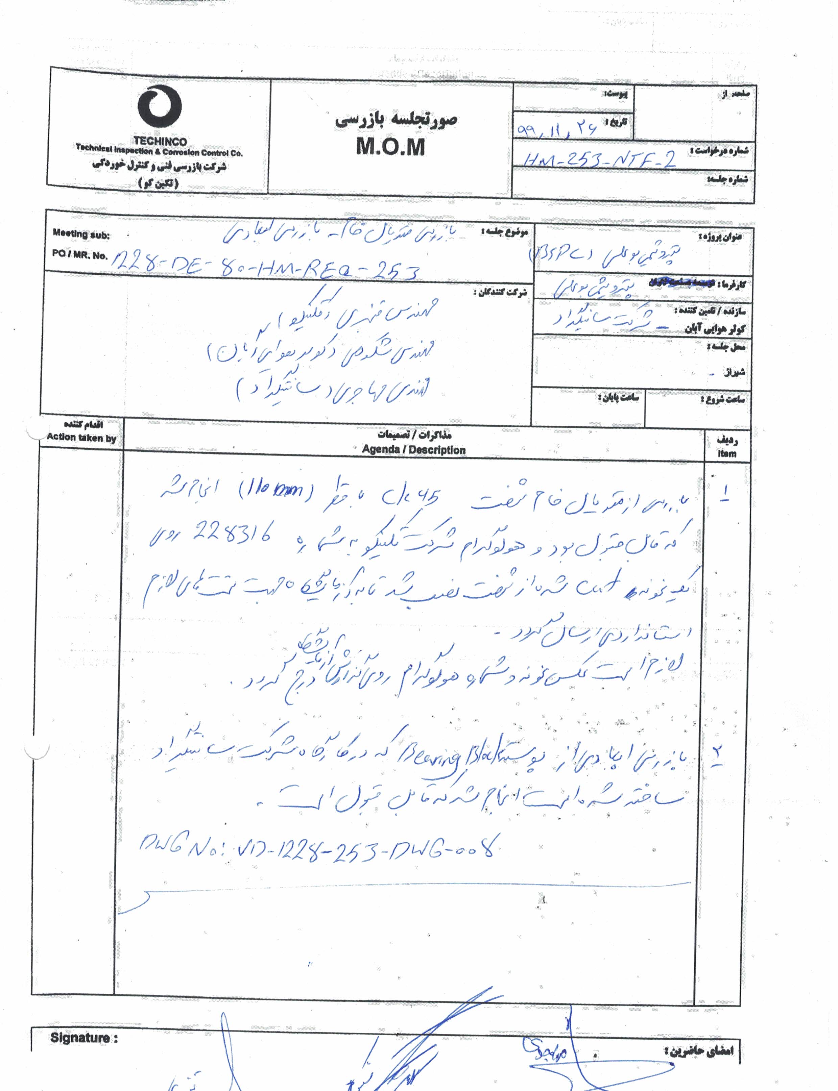
Q.C/Mashi/17152/CCI02152021.jpg
