koalium/centidocs/Q.C/Mashi/CCI11082020_0008.jpg

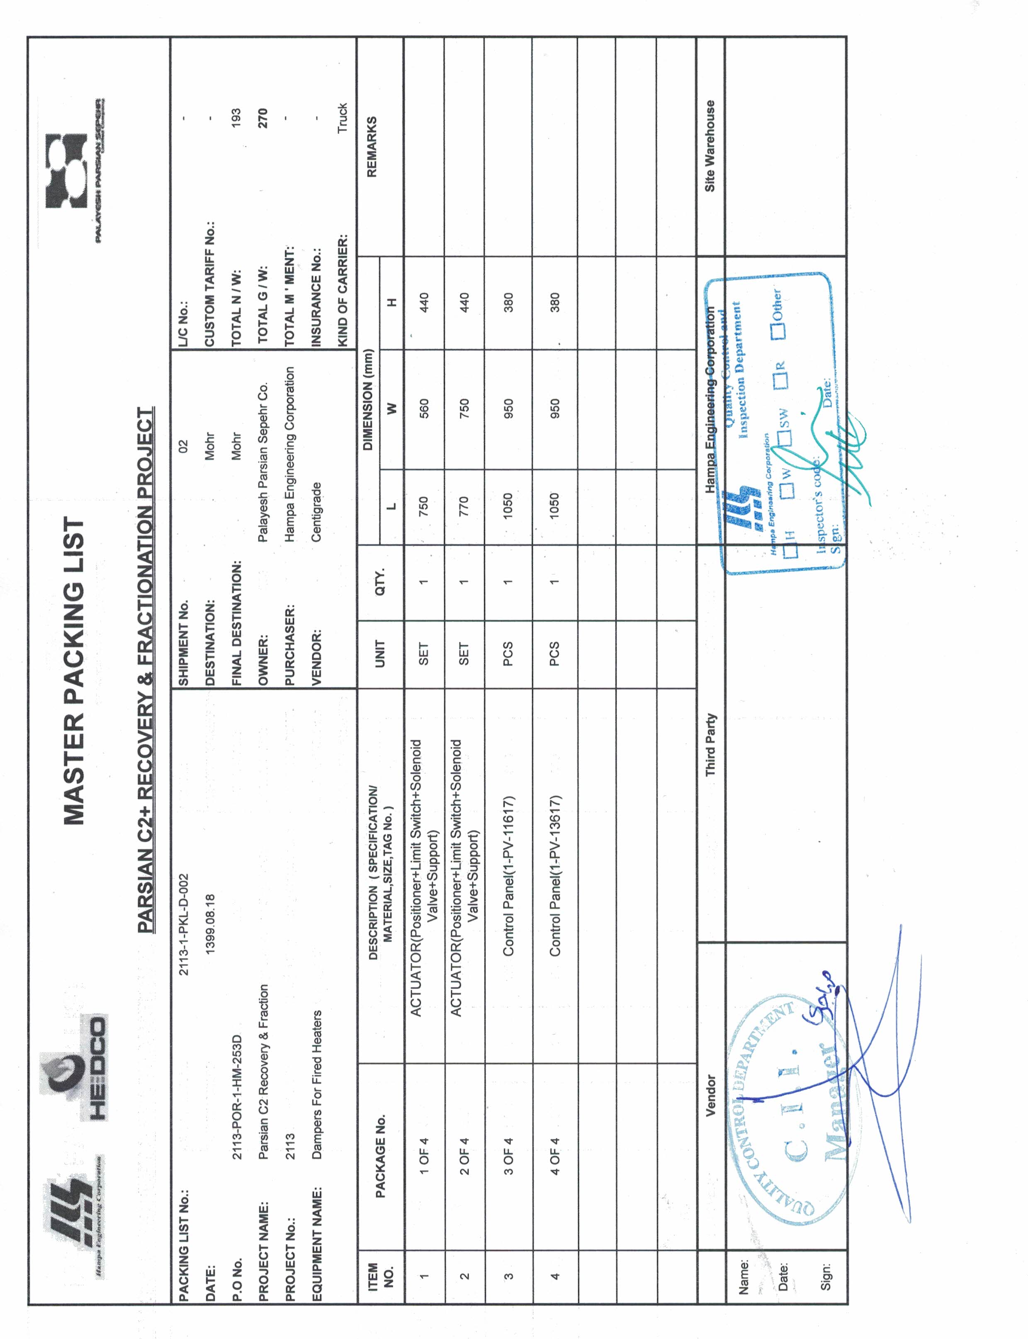
Q.C/Mashi/CCI11082020_0008.jpg
