koalium/centidocs/Q.C/Mashi/LS/CCI12272020.jpg

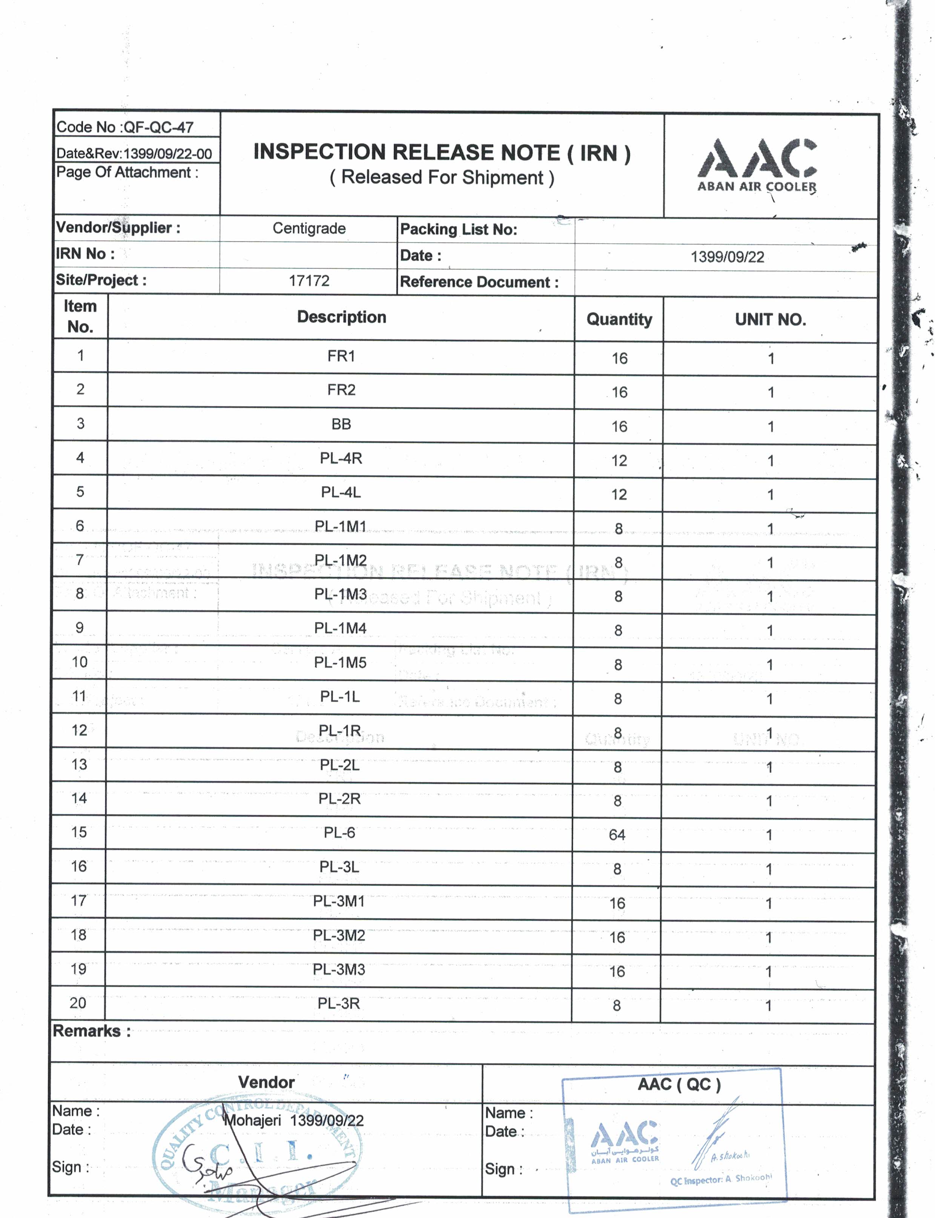
Q.C/Mashi/LS/CCI12272020.jpg
