koalium/centidocs/Q.C/Mashi/LS/CCI12272020_0001.jpg

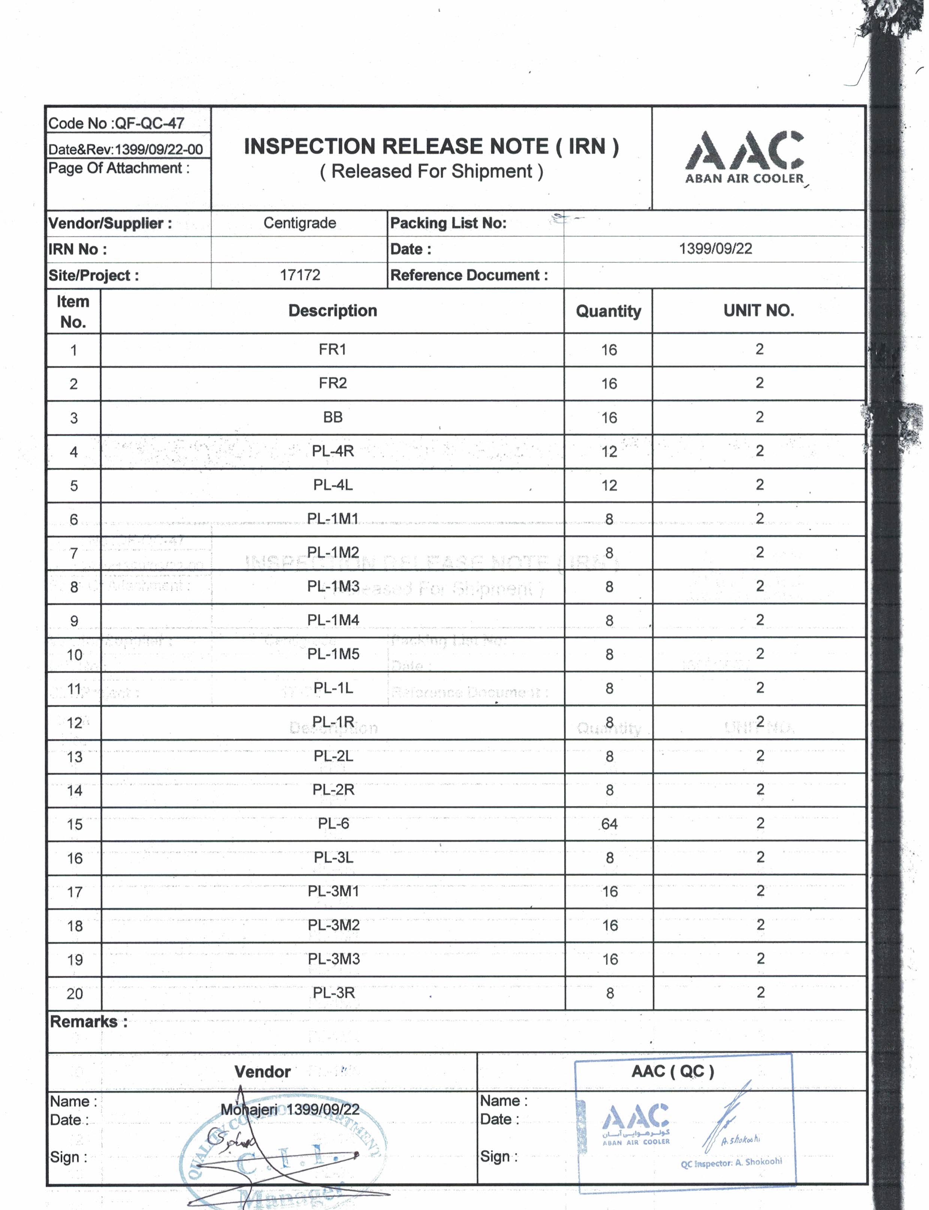
Q.C/Mashi/LS/CCI12272020_0001.jpg
