koalium/centidocs/Q.C/Mashi/m/CCI11082020.jpg

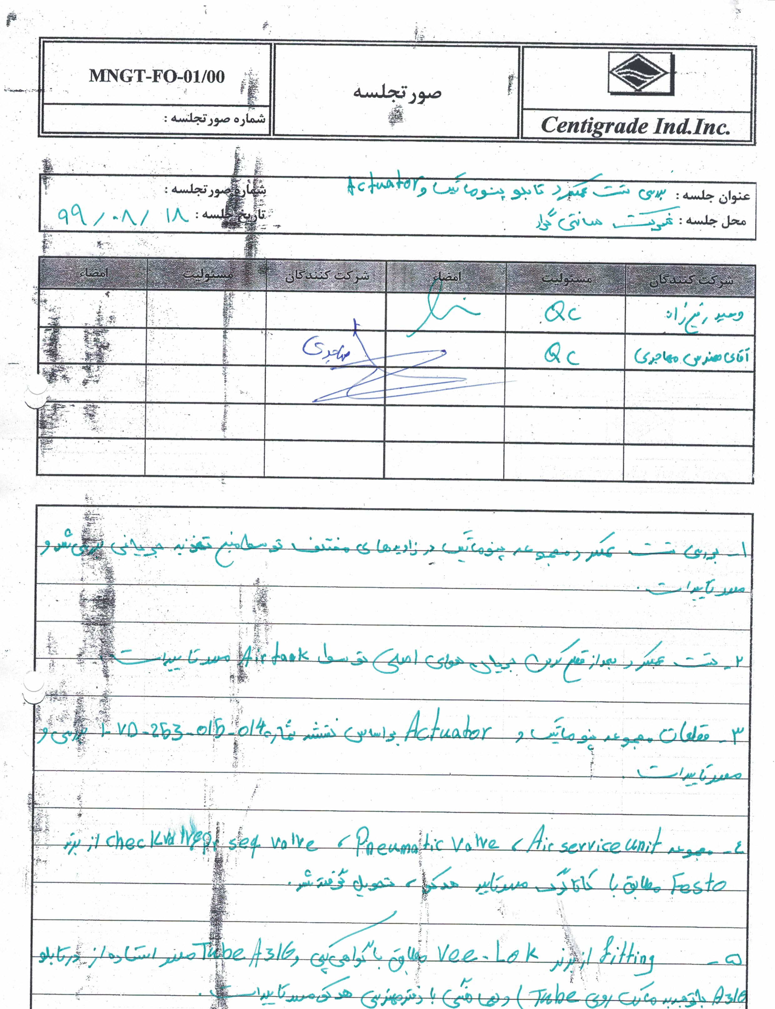
Q.C/Mashi/m/CCI11082020.jpg
