koalium/centidocs/Q.C/Mashi/m/CCI11082020_0001.jpg

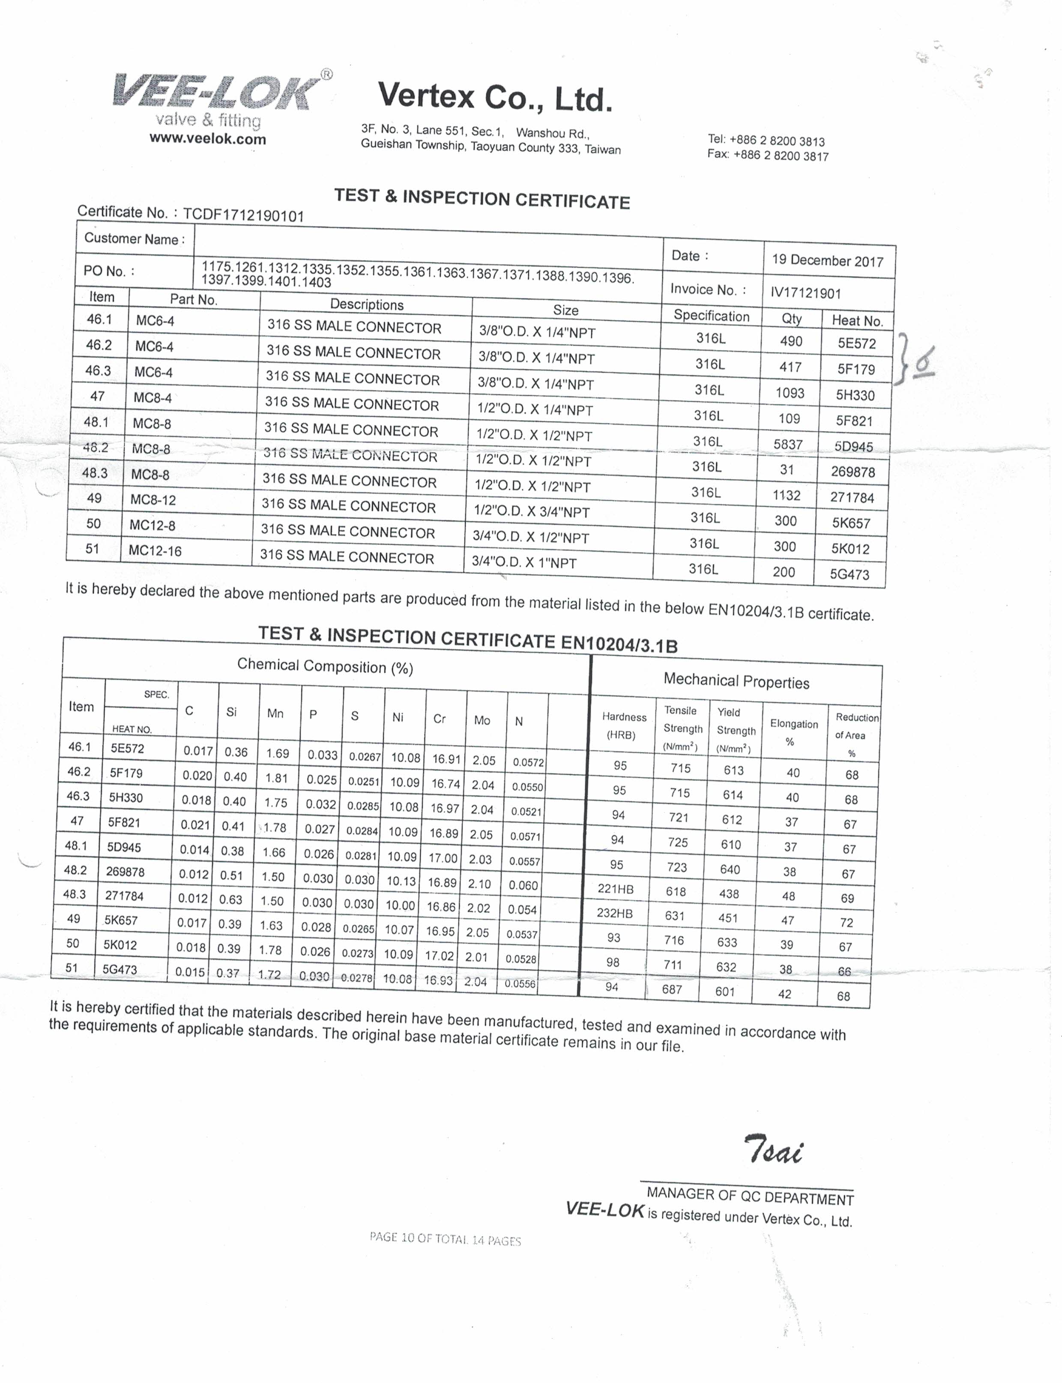
Q.C/Mashi/m/CCI11082020_0001.jpg
