koalium/centidocs/Q.C/Mashi/m/CCI11082020_0002.jpg

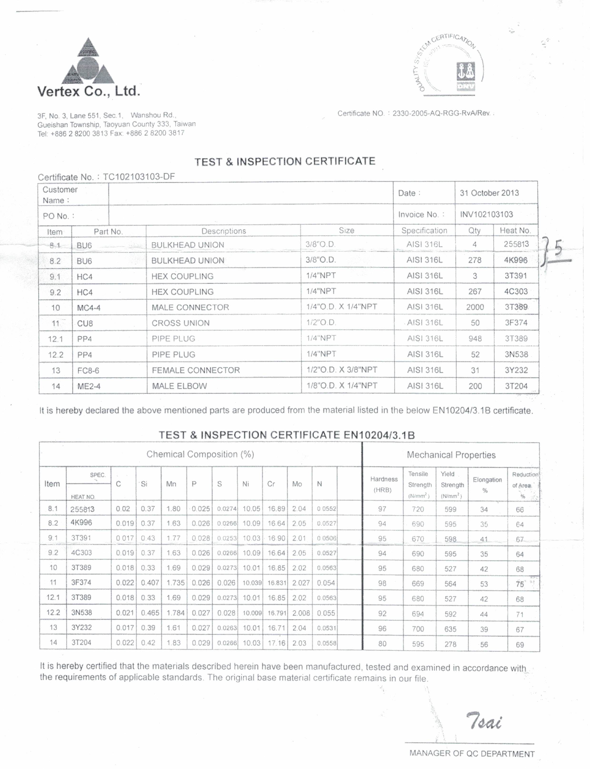
Q.C/Mashi/m/CCI11082020_0002.jpg
