koalium/centidocs/Q.C/Mashi/m/CCI11082020_0003.jpg

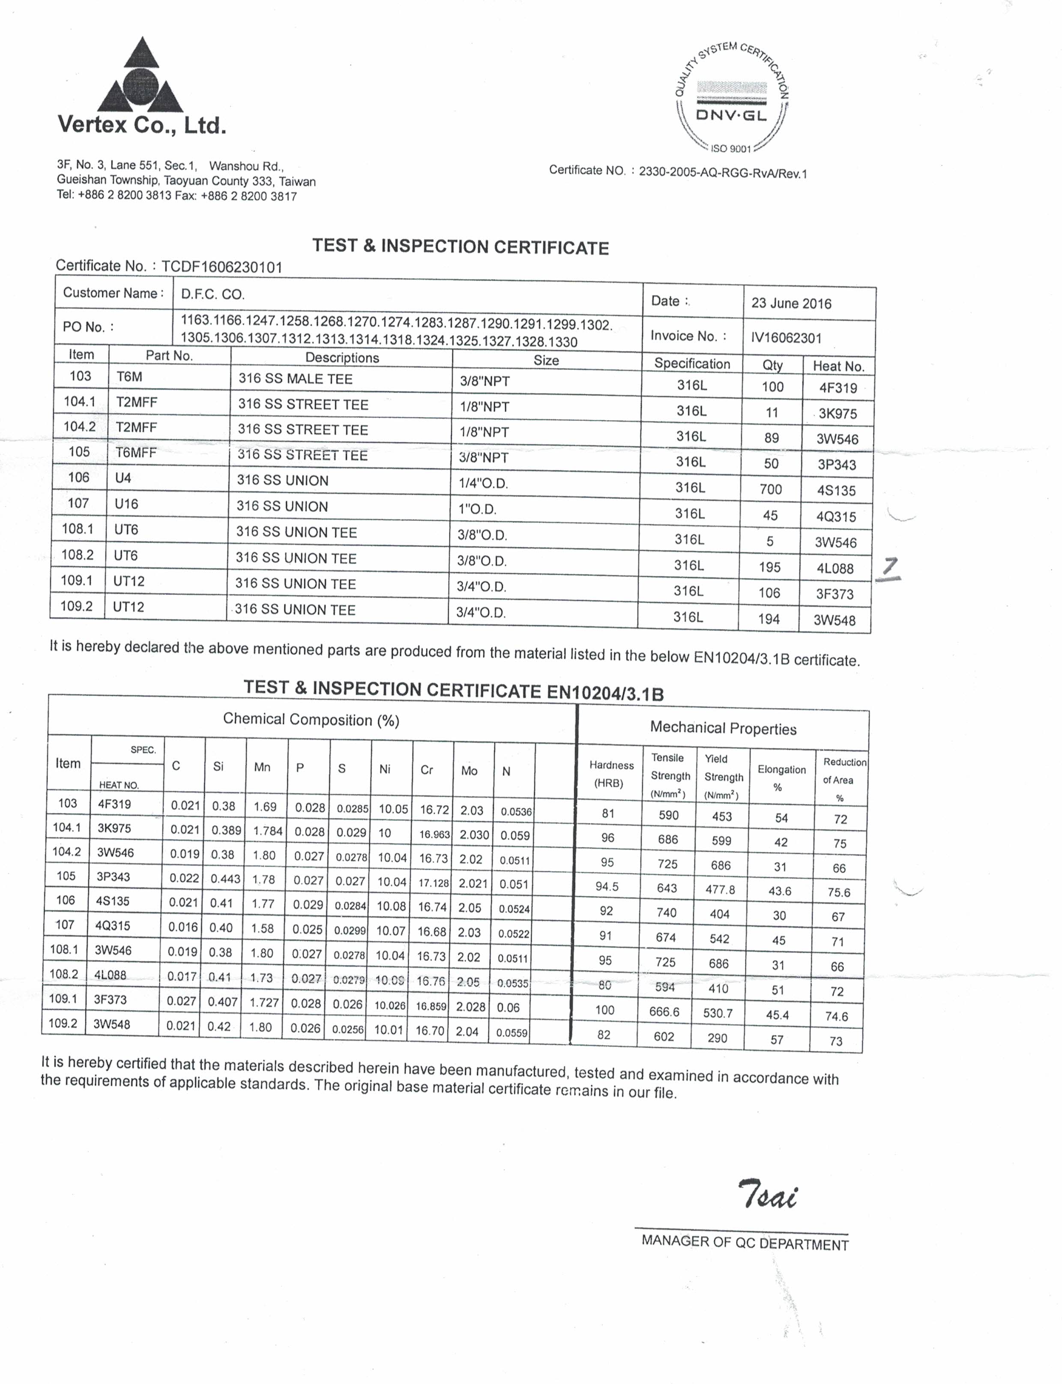
Q.C/Mashi/m/CCI11082020_0003.jpg
