koalium/centidocs/Q.C/Mashi/m/CCI11082020_0004.jpg

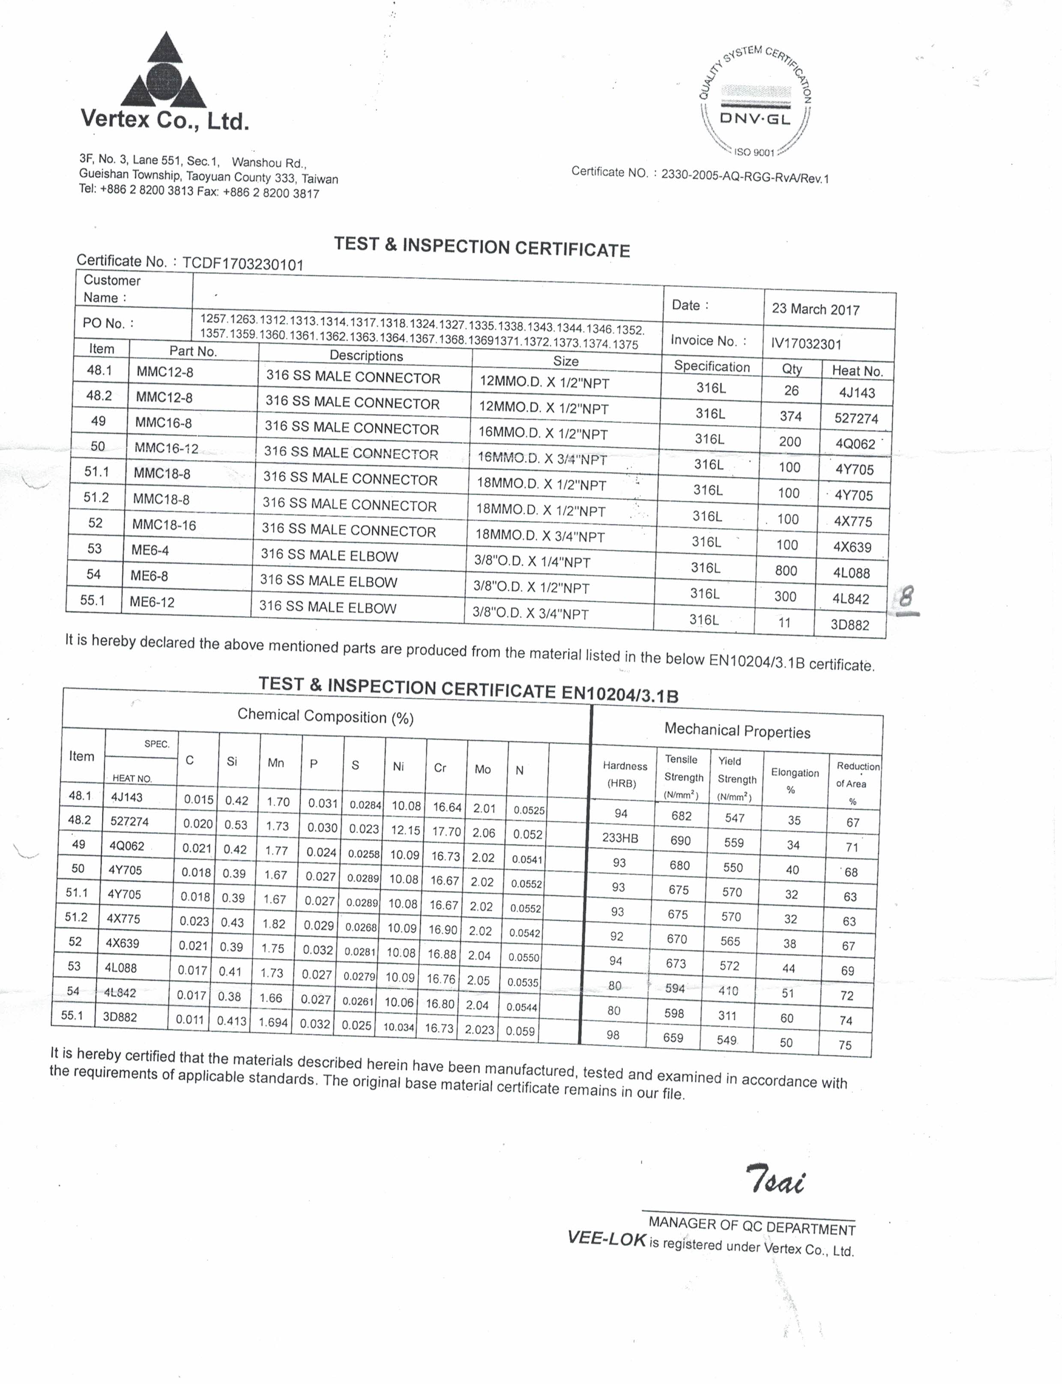
Q.C/Mashi/m/CCI11082020_0004.jpg
