koalium/centidocs/Q.C/Mashi/m/CCI11082020_0005.jpg

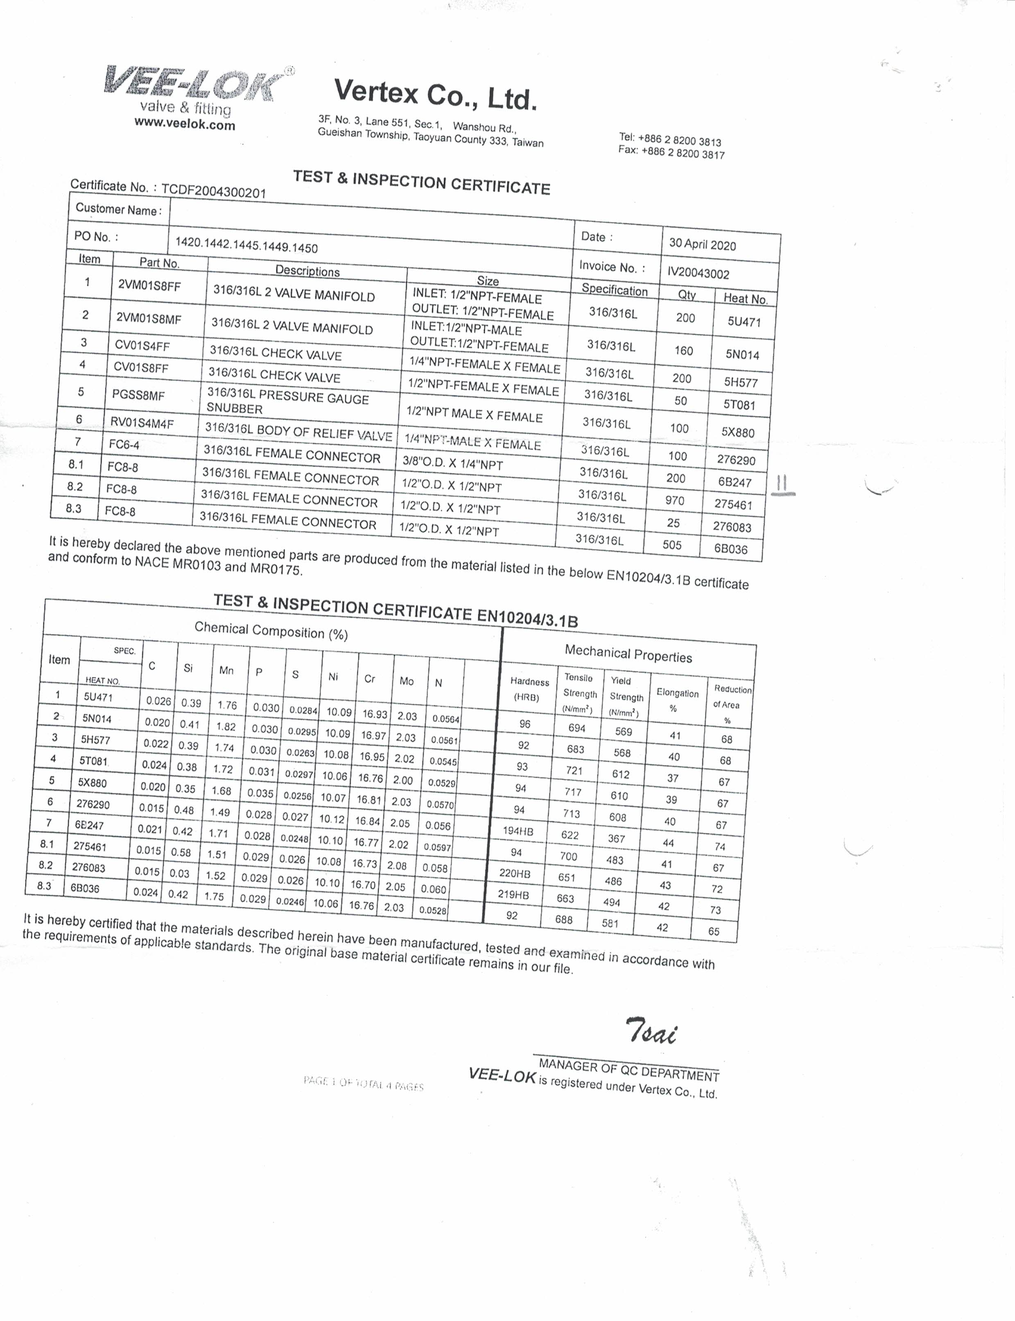
Q.C/Mashi/m/CCI11082020_0005.jpg
