koalium/centidocs/Q.C/Mashi/m/CCI11082020_0006.jpg

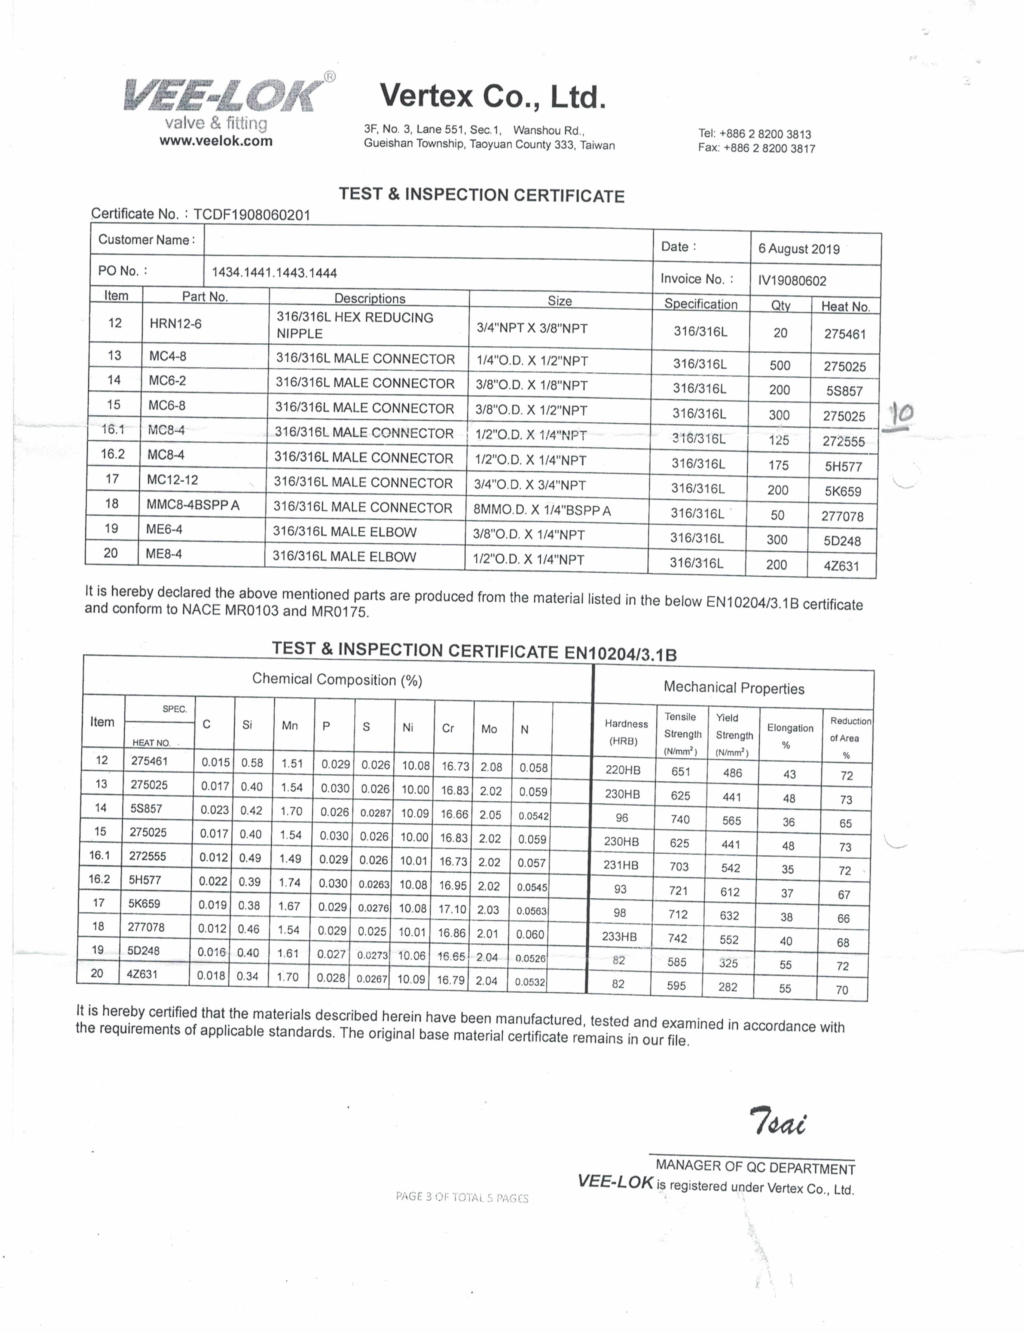
Q.C/Mashi/m/CCI11082020_0006.jpg
