koalium/centidocs/Q.C/Mashi/m/CCI11082020_0007.jpg

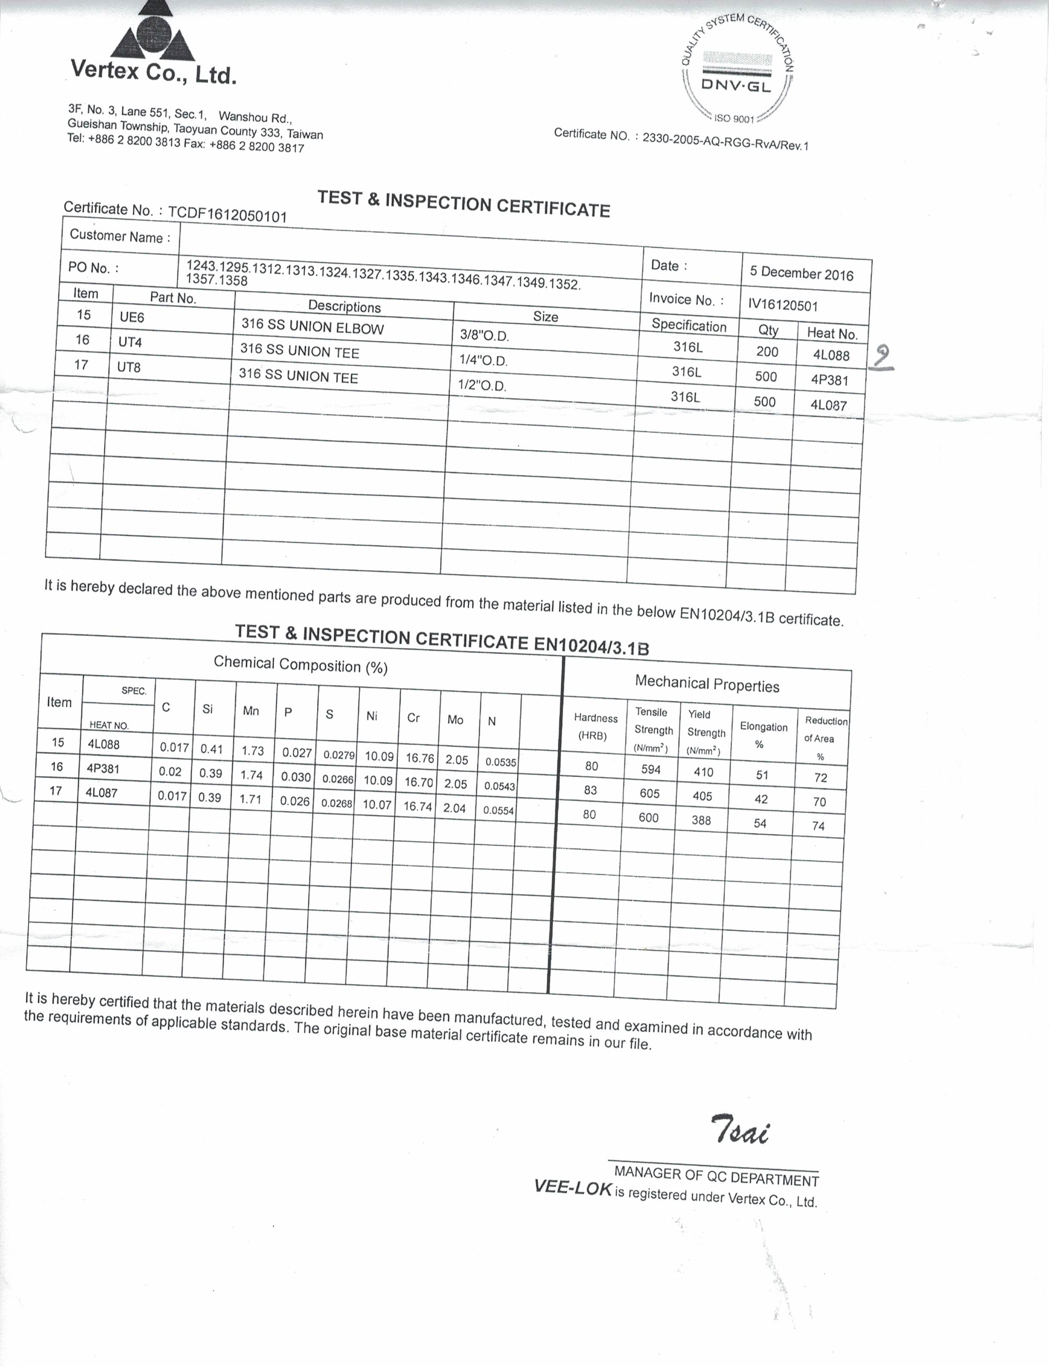
Q.C/Mashi/m/CCI11082020_0007.jpg
