koalium/centidocs/Q.C/فرم_گزارش_حادثه_به_اداره_کار_وبیمه.jpg

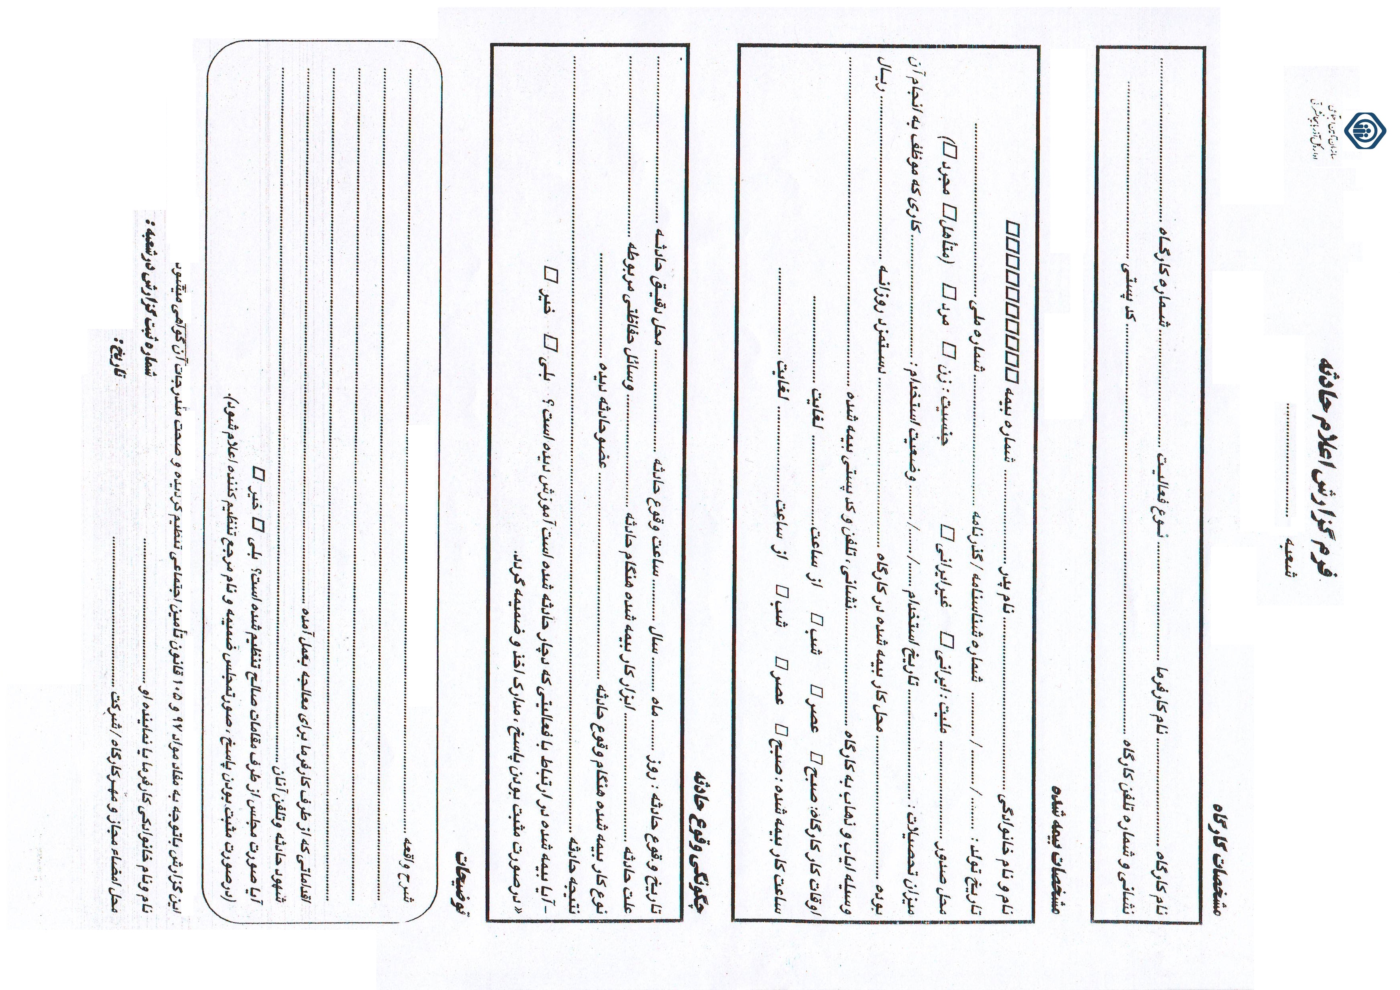
Q.C/فرم_گزارش_حادثه_به_اداره_کار_وبیمه.jpg
