koalium/centidocs/Rezaei/0/IMG_20200301_163507.jpg

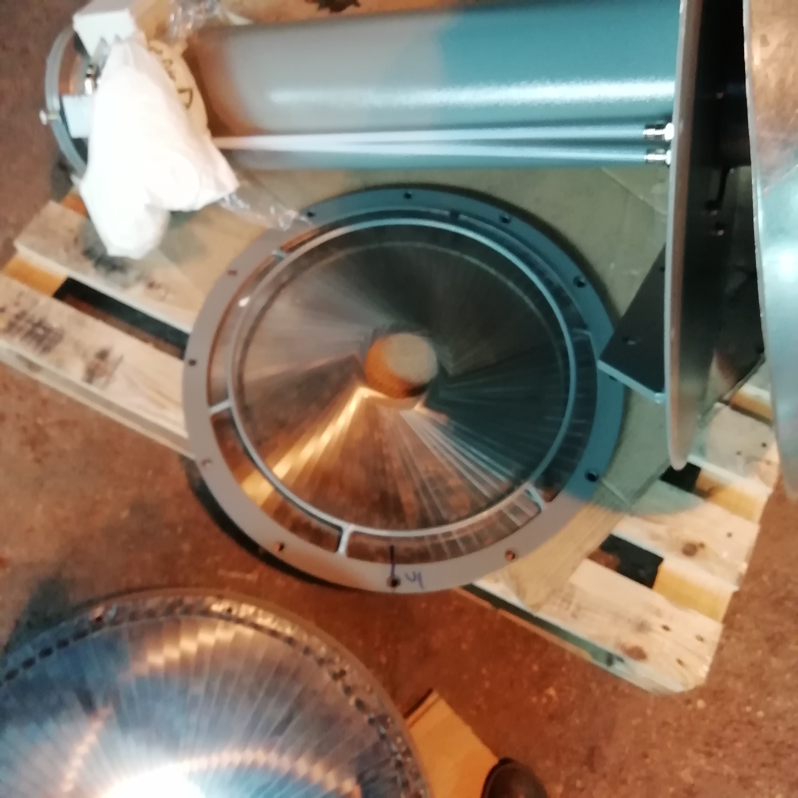
Rezaei/0/IMG_20200301_163507.jpg
