koalium/centidocs/Rezaei/0/IMG_20200301_163510.jpg

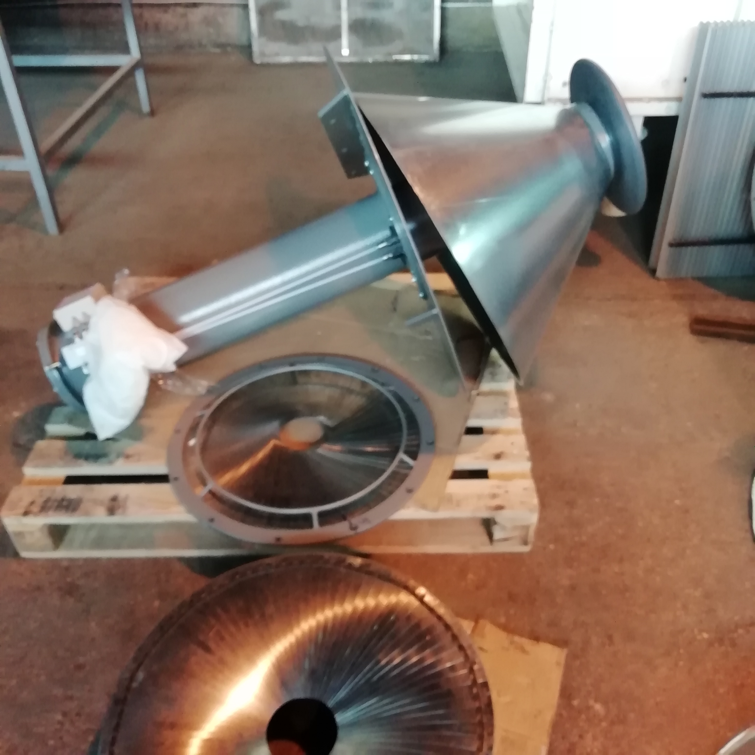
Rezaei/0/IMG_20200301_163510.jpg
