koalium/centidocs/Rezaei/0/IMG_20200302_103154.jpg

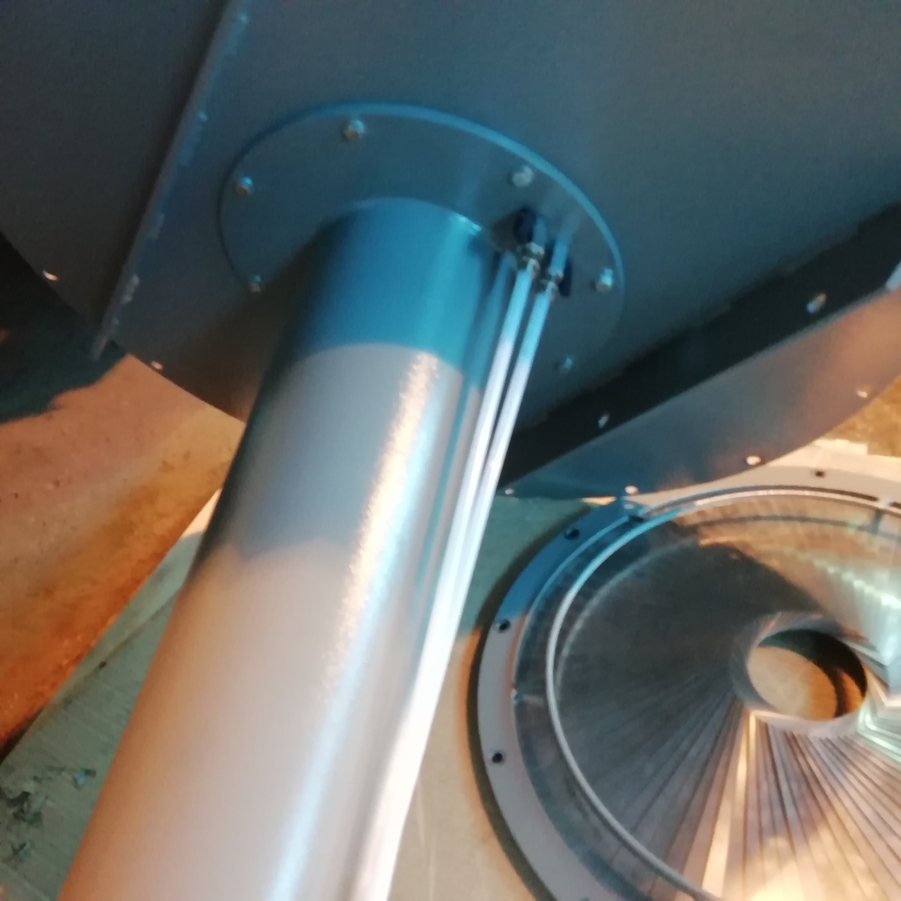
Rezaei/0/IMG_20200302_103154.jpg
