koalium/centidocs/Q.C/Mashi/Copy of Louver BOM.xlsx

No. | Part | Desc. | Size | Material | Qty.
1A | Louver Frame | Pl | 6x392x6160 | St 37 | 2
1B | Louver Frame | Pl | 6x392x6160 | St 37 | 2
1C | Louver Frame | Pl | 6x392x5554 | St 37 | 2
1D | Louver Frame | Pl | 6x392x5554 | St 37 | 2
1E | Louver Frame | Pl | 6x392x1645 | St 37 | 4
1F | Louver Frame | Pl | 6x392x1645 | St 37 | 2
1G | Louver Frame | Pl | 6x392x1645 | St 37 | 2
2 | Lifting | Pl | 15x120x170 | St 37 | 16
3 | Blade | Pl | 2x200x1639 | HDG | 134
4a | Free Lever Shaft | Rb | Ø12x50 | St 37 | 134
4B | Free Lever Plate | FL | 5x30x102 | St 37 | 134
5 | Arm | Pl | 6x85x25 | St 37 | 134
6 | Pin | Rb | Ø14x27 | St 37 | 134 | قطعه پیش ساخته
7F | Angle | Ag | L50x5x50x5670 | St 37 | 2
7S | Angle | Ag | L50x5x50x5947 | St 37 | 2
8 | Handle | Pl | 6x70x455 | St 37 | 2
9 | Pin | Rb | Ø20x34 | St 37 | 2
10 | Transmiter | Pl | 8x60x102 | St 37 | 2
11 | Shaft | Rb | Ø60xL230 | St 37 | 2 | 2Polish
12 | Plate | Pl | 6x68x188 | St 37 | 16
13 | Cap | - | قطعه پیش ساخته | Al | 4
14 | Bush | Rb | Ø90xL38 | Teflon | 4
15 | Holder | Rb | قطعه پیش ساخته | Al | 4
16 | Actuator Box | Pl | 6x200x538 | St 37 | 2
17 | Plate | Pl | 6x200x50 | St 37 | 4
18a | Lever Threaded Bar | میل پیچ | M12xL70 | St 37 | 134
18b | Lever Plate | Fl | 5x30x102 | St 37 | 134
19 | Rod | Rb | Ø8xL105 | St 37 | 2
20 | Plate | Pl | 6x50x120 | St 37 | 2
21 | Chain |  |  | St 37 | 2
22 | Air seal | Pl | 3x146x1649 | HDG | 2
23 | Bush | Rb | قطعه پیش ساخته | Teflon | 268
