koalium/centidocs/jokar/Savin 1/BOM & MTO/Savin-AC 1-BOM&MTO-Rev00.xlsx

Sheet: Pumping
Bill of Material (B.O.M.) |  |  |  |  |  |  |  |  |  |  | Centigrade Ind. Inc.
Order NO.: - |  |  | Product: Pumping |  |  | Sub. Product : |  |  | Station: AC-1
Sheet : 1 of 1 |  |  | Doc No.:Savin-AC1-BOM-11 |  |  | Client :ساوین تاب |  |  | Rev.:00
محصول |  | زیر محصول |  |  |  |  |  |  |  | قطعه
کد محصول | تعداد در سفارش | کد زیر محصول | شرح | تعداد در محصول | تعداد در سفارش | کد مجموعه | شرح | تعداد در زیر محصول | تعداد در سفارش | شمارنده | شرح | مشخصات | تعداد در زیر محصول | تعداد در محصول | تعداد در سفارش
- | 1 | - | سیستم آبرسانی | 1 | 1 |  | سیستم آبرسانی | 1 | 1 | 1 | الکترو موتور | 37Kw-1500rpm | 1 | 1 | 1
 |  |  |  |  |  |  |  |  |  | 2 | پمپ | EN 150-315 | 1 | 1 | 1
 |  |  |  |  |  |  |  |  |  | 3 | شاسی | مطابق الکترو پمپ | 1 | 1 | 1
 |  |  |  |  |  |  |  |  |  | 4 | کوپلینگ | مطابق الکترو پمپ | 1 | 1 | 1
 |  |  |  |  |  |  |  |  |  | 5 | P&ID | مطابق الکترو پمپ | 1 | 1 | 1

Sheet: Pumping MTO
 |  |  |  |  |  | Specification (mm)
Pos. | Part Name | Qty (Pcs) | Material | Description | Thk. / Diameter | W | L | Qty | Gross Qty. | Unit | Net Weight (Kg) | Scrap | Remarks
1 | الکترو موتور | 1 | - | الکترو موتور | 37 Kw, 1500 rpm, 3ph, 380 V, IP 54 |  |  | 1 | 1 | Pcs | - | -
2 | پمپ | 1 | - | پمپ گریز از مرکز | EN 150-315 |  |  | 1 | 1 | Pcs
3 | کوپلینگ | 1 | - | DC: 140 | - | - | - | 1 | 1 | Pcs | - | -
4 | شاسی | 1 | آهن معمولی | UPN
5
6
7
8
9
10
11
12
13
14
15
16
17
18
19
20
21
22
23
24
25
26
27
28
29

Sheet: Inspection Door
Bill of Material (B.O.M.) |  |  |  |  |  |  |  |  |  |  | Centigrade Ind. Inc.
Order NO.: |  |  | Product: Inspection Door |  |  | Sub. Product : |  |  | Station: AC-1
Sheet : 1 of 1 |  |  | Doc No.:Savin-AC1-BOM-10 |  |  | Client :ساوین تاب |  |  | Rev.:00
محصول |  | زیر محصول |  |  |  |  |  |  |  | قطعه
کد محصول | تعداد در سفارش | کد زیر محصول | شرح | تعداد در محصول | تعداد در سفارش | کد مجموعه | شرح | تعداد در زیر محصول | تعداد در سفارش | شمارنده | شرح | مشخصات | تعداد در زیر محصول | تعداد در محصول | تعداد در سفارش
- | 2 | - | دریچه بازدید | 1 | 1 |  | دریچه بازدید | 1 | 1 | 1 | صفحه بزرگ درب | 1.2x831x831 | 1 | 1 | 1
 |  |  |  |  |  |  |  |  |  | 2 | صفحه کوچک درب | 1.2x791x791 | 1 | 1 | 1
 |  |  |  |  |  |  |  |  |  | 3 | ناودانی تقویتی 1 | 1.5x136x708 | 1 | 1 | 1
 |  |  |  |  |  |  |  |  |  | 4 | صفحه لولا 1 | 5x50x140 | 2 | 2 | 2
 |  |  |  |  |  |  |  |  |  | 5 | صفحه لولا 2 | 5x50x90 | 2 | 2 | 2
 |  |  |  |  |  |  |  |  |  | 6 | بوش دستگیره | 3/4"x51 | 1 | 1 | 1
 |  |  |  |  |  |  |  |  |  | 7 | دستگیره 1 | قطعه نیم ساخته | 1 | 1 | 1
 |  |  |  |  |  |  |  |  |  | 8 | دستگیره 2 | قطعه نیم ساخته | 1 | 1 | 1
 |  |  |  |  |  |  |  |  |  | 9 | قوطی عرضی قاب | 2.9x40x40x800 | 2 | 2 | 2
 |  |  |  |  |  |  |  |  |  | 10 | قوطی طولی قاب | 2.9x40x40x2100 | 2 | 2 | 2
 |  |  |  |  |  |  |  |  |  | 11 | لولا نری | Ø12x110 | 2 | 2 | 2
 |  |  |  |  |  |  |  |  |  | 12 | لولا مادگی | 16x22x60 | 2 | 2 | 2
 |  |  |  |  |  |  |  |  |  | 13 | پیچ شش گوش | M8x70 | 6 | 6 | 6
 |  |  |  |  |  |  |  |  |  | 14 | مهره شش گوش | M8 | 6 | 6 | 6
 |  |  |  |  |  |  |  |  |  | 15 | پیچ سر آلن | M6x40 | 1 | 1 | 1
 |  |  |  |  |  |  |  |  |  | 16 | لاستیک اسفنجی | L=3500 | 1 | 1 | 1

Sheet: I.D. MTO
 |  |  |  |  |  | Specification (mm)
Pos. | Part Name | Qty (Pcs) | Material | Description | Thk. / Diameter | W | L | Qty | Gross Qty. | Unit | Net Weight (Kg) | Scrap | Remarks
1
2
3
4
5
6
7
8
9
10
11
12
13
14
15
16
17
18
19
20
21
22
23
24
25
26
27
28
29

Sheet: Ventilation Door
Bill of Material (B.O.M.) |  |  |  |  |  |  |  |  |  |  | Centigrade Ind. Inc.
Order NO.: |  |  | Product: Ventilation Door |  |  | Sub. Product : |  |  | Station: AC-1
Sheet : 1 of 2 |  |  | Doc No.:Savin-AC1-BOM-09 |  |  | Client :ساوین تاب |  |  | Rev.:00
محصول |  | زیر محصول |  |  |  |  |  |  |  | قطعه
کد محصول | تعداد در سفارش | کد زیر محصول | شرح | تعداد در محصول | تعداد در سفارش | کد مجموعه | شرح | تعداد در زیر محصول | تعداد در سفارش | شمارنده | شرح | مشخصات | تعداد در زیر محصول | تعداد در محصول | تعداد در سفارش
- | 7 | - | درب تهویه | 1 | 7 |  | درب تهویه | 1 | 7 | 1 | صفحه بزرگ درب | 1.2x831x2131 | 1 | 1 | 7
 |  |  |  |  |  |  |  |  |  | 2 | صفحه کوچک درب | 1.2x791x2091 | 1 | 1 | 7
 |  |  |  |  |  |  |  |  |  | 3 | ناودانی تقویتی 1 | 1.5x136x708 | 1 | 1 | 7
 |  |  |  |  |  |  |  |  |  | 4 | ناودانی تقویتی 2 | 1.5x136x708 | 2 | 2 | 14
 |  |  |  |  |  |  |  |  |  | 5 | صفحه لولا 1 | 5x50x140 | 3 | 3 | 21
 |  |  |  |  |  |  |  |  |  | 6 | صفحه لولا 2 | 5x50x90 | 3 | 3 | 21
 |  |  |  |  |  |  |  |  |  | 7 | بوش دستگیره | 1"x51 | 1 | 1 | 7
 |  |  |  |  |  |  |  |  |  | 8 | دستگیره 1 | قطعه نیم ساخته | 1 | 1 | 7
 |  |  |  |  |  |  |  |  |  | 9 | دستگیره 2 | قطعه نیم ساخته | 1 | 1 | 7
 |  |  |  |  |  |  |  |  |  | 10 | قوطی عرضی قاب | 40x40x800 | 2 | 2 | 14
 |  |  |  |  |  |  |  |  |  | 11 | قوطی طولی قاب | 40x40x2100 | 2 | 2 | 14
 |  |  |  |  |  |  |  |  |  | 12 | سیخک | 3x68x80 | 4 | 4 | 28
 |  |  |  |  |  |  |  |  |  | 13 | لولا نری | Ø12x110 | 3 | 3 | 21
 |  |  |  |  |  |  |  |  |  | 14 | لولا مادگی | 16x22x60 | 3 | 3 | 21
 |  |  |  |  |  |  |  |  |  | 15 | پیچ شش گوش | M8x70 | 9 | 9 | 63
 |  |  |  |  |  |  |  |  |  | 16 | مهره شش گوش | M8 | 9 | 9 | 63
 |  |  |  |  |  |  |  |  |  | 17 | پیچ سر آلن | M6x40 | 1 | 1 | 7
Bill of Material (B.O.M.) |  |  |  |  |  |  |  |  |  |  | Centigrade Ind. Inc.
Order NO.: 10076 |  |  | Product: Ventilation Door |  |  | Sub. Product : |  |  | Station: AC-7
Sheet : 2 of 2 |  |  | Doc No.:10076-BOM-09 |  |  | Client :ساوین تاب |  |  | Rev.:00
محصول |  | زیر محصول |  |  |  |  |  |  |  | قطعه
کد محصول | تعداد در سفارش | کد زیر محصول | شرح | تعداد در محصول | تعداد در سفارش | کد مجموعه | شرح | تعداد در زیر محصول | تعداد در سفارش | شمارنده | شرح | مشخصات | تعداد در زیر محصول | تعداد در محصول | تعداد در سفارش
- | 7 | - | درب تهویه | 1 | 7 |  |  |  |  | 1 | طلق بازدید | 3x500x200 | 2 | 2 | 14
 |  |  |  |  |  |  |  |  |  | 2 | لاستیک درز گیر طلق | L=1050 | 2 | 2 | 14
 |  |  |  |  |  |  |  |  |  | 3 | مغزی درزگیر طلق | L=1050 | 2 | 2 | 14
 |  |  |  |  |  |  |  |  |  | 4 | لاستیک اسفنجی | L=5600 | 1 | 1 | 7

Sheet: V.D. MTO
 |  |  |  |  |  | Specification (mm)
Pos. | Part Name | Qty (Pcs) | Material | Description | Thk. / Diameter | W | L | Qty | Gross Qty. | Unit | Net Weight (Kg) | Scrap | Remarks
1
2
3
4
5
6
7
8
9
10
11
12
13
14
15
16
17
18
19
20
21
22
23
24
25
26
27
28
29

Sheet: EX & FE & RE Damper
Bill of Material (B.O.M.) |  |  |  |  |  |  |  |  |  |  | Centigrade Ind. Inc.
Order NO.: |  |  | Product: Damper |  |  | Sub. Product : |  |  | Station: AC-1
Sheet : 1 of 2 |  |  | Doc No.:Savin-AC1-BOM-07 |  |  | Client :ساوین تاب |  |  | Rev.:00
محصول |  | زیر محصول |  |  |  |  |  |  |  | قطعه
کد محصول | تعداد در سفارش | کد زیر محصول | شرح | تعداد در محصول | تعداد در سفارش | کد مجموعه | شرح | تعداد در زیر محصول | تعداد در سفارش | شمارنده | شرح | مشخصات | تعداد در زیر محصول | تعداد در محصول | تعداد در سفارش
- | 6 | - | دمپر | 1 | 4 |  | دمپر | 1 | 6 | 1 | قاب عرضی | 1.5x370x2200 | 2 | 2 | 12
 |  |  |  |  |  |  |  |  |  | 2 | قاب طولی | 1.5x370x2800 | 2 | 2 | 12
 |  |  |  |  |  |  |  |  |  | 3 | ستون میانی | 1.5x260x2800 | 1 | 1 | 6
 |  |  |  |  |  |  |  |  |  | 4 | ایرسیل | 1.5x98x1100 | 2 | 2 | 12
 |  |  |  |  |  |  |  |  |  | 5 | بازو | 2x36x2700 | 2 | 2 | 12
 |  |  |  |  |  |  |  |  |  | 6 | نبشی اتصال قاب | 1.5x40x220 | 4 | 4 | 24
 |  |  |  |  |  |  |  |  |  | 7 | نبشی اتصال ستون میانی | 2x3x67 | 4 | 4 | 24
 |  |  |  |  |  |  |  |  |  | 8 | تیغه دمپر | 1100 | 36 | 36 | 216
 |  |  |  |  |  |  |  |  |  | 9 | بادامک | -- | 18 | 18 | 108
 |  |  |  |  |  |  |  |  |  | 10 | واسطه چهار گوش | -- | 36 | 36 | 216
 |  |  |  |  |  |  |  |  |  | 11 | فشنگی | -- | 54 | 54 | 324
 |  |  |  |  |  |  |  |  |  | 12 | نوار دمپر | 2800 | 4 | 4 | 24
 |  |  |  |  |  |  |  |  |  | 13 | گوشک | -- | 8 | 8 | 48
 |  |  |  |  |  |  |  |  |  | 14 | پیچ آلن مخروطی | M10x15 | 18 | 18 | 108
 |  |  |  |  |  |  |  |  |  | 15 | واشر تخت | A12 OD30 | 18 | 18 | 108
 |  |  |  |  |  |  |  |  |  | 16 | مهره چهار گوش | M10 | 18 | 18 | 108
 |  |  |  |  |  |  |  |  |  | 17 | بوش تفلون | -- | 54 | 54 | 324
 |  |  |  |  |  |  |  |  |  | 18 | اشپیل | 2.6x30 | 18 | 18 | 108
 |  |  |  |  |  |  |  |  |  | 19 | پیچ شش گوش | M10x15 | 40 | 40 | 240
 |  |  |  |  |  |  |  |  |  | 20 | مهره شش گوش | M10 | 40 | 40 | 240
 |  |  |  |  |  |  |  |  |  | 21 | نبشی اتصال به دیوار | 40x40x50 | 4 | 4 | 24
 |  |  |  |  |  |  |  |  |  | 22 | دمپر موتور | 32 N.m. | 6 | 6 | 36
Bill of Material (B.O.M.) |  |  |  |  |  |  |  |  |  |  | Centigrade Ind. Inc.
Order NO.: 10076 |  |  | Product: Damper |  |  | Sub. Product : |  |  | Station: AC-7
Sheet : 2 of 2 |  |  | Doc No.:10076-BOM-07 |  |  | Client :ساوین تاب |  |  | Rev.:01
محصول |  | زیر محصول |  |  |  |  |  |  |  | قطعه
کد محصول | تعداد در سفارش | کد زیر محصول | شرح | تعداد در محصول | تعداد در سفارش | کد مجموعه | شرح | تعداد در زیر محصول | تعداد در سفارش | شمارنده | شرح | مشخصات | تعداد در زیر محصول | تعداد در محصول | تعداد در سفارش
-- | 4 | -- | دمپر | 1 | 4 |  | توری دمپر | 1 | 4 | 22 | نبشی عرض قاب | 3x80x2200 | 2 | 2 | 8
 |  |  |  |  |  |  |  |  |  | 23 | نبشی طولی قاب | 3x80x2800 | 3 | 3 | 12
 |  |  |  |  |  |  |  |  |  | 24 | تسمه عرضی | 2x40x2200 | 2 | 2 | 8
 |  |  |  |  |  |  |  |  |  | 25 | تسمه طولی | 2x40x2800 | 3 | 3 | 12
 |  |  |  |  |  |  |  |  |  | 26 | توری | 2800x2200 | 1 | 1 | 4

Sheet: Damper MTO
 |  |  |  |  |  | Specification (mm)
Pos. | Part Name | Qty (Pcs) | Material | Description | Thk. / Dia | W | L | Qty | Gross Qty. | Unit | Net Weight (Kg) | Scrap | Remarks
1 | قاب عرضی و ایرسیل | 20 | H.D.G | ورق | 1.5 | 1250 | 2200 | 4 | 129.525 | kg
2 | قاب طولی و ایرسیل | 16 | H.D.G | ورق | 1.5 | 1250 | 2800 | 4 | 164.85 | kg
3 | ستون میانی و نبشی اتصال قاب | 30 | H.D.G | ورق | 1.5 | 1000 | 2800 | 2 | 65.94 | kg
4 | بازو و نبشی اتصال ستون میانی | 36 | H.D.G | ورق | 2 | 1000 | 2700 | 1 | 42.39 | kg
5 | تیغه دمپر | 216 | Al | قطعه پیش ساخته | - | - | 1100 | 216 | 286 | kg
6 | بادامک | 108 | Polyamide | قطعه پیش ساخته | - | - | - | 108 | 108 | Pcs
7 | بوش | 324 | ABS | قطعه پیش ساخته | - | - | - | 324 | 324 | Pcs
8 | واسطه چهارگوش | 216 | Polyamide | قطعه پیش ساخته | - | - | - | 216 | 216 | Pcs
9 | فشنگی | 324 | Polystyrene | قطعه پیش ساخته | - | - | - | 324 | 324 | Pcs
10 | نوار دمپر | 24 | P.E | مواد خام | - | - | 2800 | 24 | 11 | kg
11 | گوشک | 48 | H.D.G | قطعه پیش ساخته | - | - | - | 48 | 48 | Pcs
12 | پیچ آلن مخروطی | 108 | گالوانیزه سرد | پیچ آلن مخروطی | M | 10 | 15 | 108 | 108 | Pcs
13 | واشر تخت | 108 | گالوانیزه سرد | واشر تخت | A | 12 | OD:30 | 108 | 108 | Pcs
14 | مهره چهار گوش | 108 | گالوانیزه سرد | مهره چهار گوش | M | 10 | 20*20 | 108 | 108 | Pcs
15 | اشپیل | 108 | گالوانیزه سرد | اشپیل | 2.6 | - | 30 | 108 | 108 | Pcs
16 | پیچ شش گوش | 240 | گالوانیزه سرد | پیچ شش گوش | M | 10 | 15 | 240 | 240 | Pcs
17 | مهره شش گوش | 240 | گالوانیزه سرد | مهره شش گوش | M | 10 | - | 240 | 240 | Pcs
18 | نبشی اتصال به دیوار | 24 | آهن معمولی | نبشی | 4 | 40*40 | 1500 | 1 | 3.63 | kg
19 | دمپر موتور | 6 | - | دمپر موتور | 32 N.m |  | - | 6 | 6 | Pcs

Sheet: Coil
Bill of Material (B.O.M.) |  |  |  |  |  |  |  |  |  |  | Centigrade Ind. Inc.
Order NO.: |  |  | Product: Air Washer |  |  | Sub. Product : Coil |  |  | Station: AC-1
Sheet : 1 of 1 |  |  | Doc No.:Savin-AC1-BOM-05 |  |  | Client :ساوین تاب |  |  | Rev.:00
محصول |  | زیر محصول |  |  |  |  |  |  |  | قطعه
کد محصول | تعداد در سفارش | کد زیر محصول | شرح | تعداد در محصول | تعداد در سفارش | کد مجموعه | شرح | تعداد در زیر محصول | تعداد در سفارش | شمارنده | شرح | مشخصات | تعداد در زیر محصول | تعداد در محصول | تعداد در سفارش
- | 4 | - |  |  |  |  | کویل | 1 | 4 | 1 | نبشی قاب عرضی | 4x95x2352 | 4 | 4 | 16
 |  |  |  |  |  |  |  |  |  | 2 | ناودانی قاب طولی | 4x305x1408 | 2 | 2 | 8
 |  |  |  |  |  |  |  |  |  | 3 | تیوب شیت | 6x'155x2352 | 2 | 2 | 8
 |  |  |  |  |  |  |  |  |  | 4 | تیوب | 1/2" x 1450 | 124 | 124 | 496
 |  |  |  |  |  |  |  |  |  | 5 | کلکتور | 4x150x2332 | 2 | 2 | 8
 |  |  |  |  |  |  |  |  |  | 6 | درپوش کلکتور | 4x70x142 | 4 | 4 | 16
 |  |  |  |  |  |  |  |  |  | 8 | فلنج گلویی جوشی | 1" | 2 | 2 | 8
 |  |  |  |  |  |  |  |  |  | 9 | لوله کلکتور | 1" L=100 | 2 | 2 | 8
 |  |  |  |  |  |  |  |  |  | 10 | زانو کلکتور | 1" | 2 | 2 | 8
 |  |  |  |  |  |  |  |  |  | 11 | صفحه بادگیر | 2x45x500 | 2 | 2 | 8
 |  |  |  |  |  |  |  |  |  | 12 | تسمه بادگیر | 2x150x506 | 1 | 1 | 4
 |  |  |  |  |  |  |  |  |  | 13 | نبشی اتصال | 50x50x80 | 4 | 4 | 16

Sheet: Coil MTO
 |  |  |  |  |  | Specification (mm)
Pos. | Part Name | Qty (Pcs) | Material | Description | Thk. / Diameter | W | L | Qty | Gross Qty. | Unit | Net Weight (Kg) | Scrap | Remarks
1 | قاب عرضی و کلکتور | 24 | St 37 | Plate | 4 | 1250 | 2360 | 3 | 277.89 | kg
2 | قاب طولی | 8 | St 37 | Plate | 4 | 1000 | 1408 | 2 | 88.4224 | kg
3 | تیوب شیت | 8 | St 37 | Plate | 6 | 1500 | 2360 | 1 | 166.734 | kg
4 | بادگیر | 12 | HDG | Plate | 2 | 1000 | 550 | 1 | 8.635 | kg
5 | تیوب | 496 |  | لوله گازی درزدار | 1/2 " | Sch 10 | 6000 | 124 | 744 | kg
6 | فلنج | 8 |  | فلنج گلویی جوشی | 1" | PN 16 | - | 8 | 8 | Pcs
7 | زانو | 8 |  | زانو جوشی | 1" | PN 16 | 90 ° | 8 | 8 | Pcs
8 | لوله | 8 |  | لوله بدون درز | 1" | Sch 10 | 800 | 1 |  | kg
9 | نبشی اتصال | 16 | آهن معمولی | نبشی | 5 | 50*50 | 1360 | 1 | 5.1 | kg

Sheet: Static Water Filter
Bill of Material (B.O.M.) |  |  |  |  |  |  |  |  |  |  | Centigrade Ind. Inc.
Order NO.: |  |  | Product: Air Washer |  |  | Sub. Product : Static Water Filter |  |  | Station: AC-1
Sheet : 1 of 1 |  |  | Doc No.:Savin-AC1-BOM-04 |  |  | Client :ساوین تاب |  |  | Rev.:00
محصول |  | زیر محصول |  |  |  |  |  |  |  | قطعه
کد محصول | تعداد در سفارش | کد زیر محصول | شرح | تعداد در محصول | تعداد در سفارش | کد مجموعه | شرح | تعداد در زیر محصول | تعداد در سفارش | شمارنده | شرح | مشخصات | تعداد در زیر محصول | تعداد در محصول | تعداد در سفارش
- | 1 | - | فیلتر استاتیک | 1 | 1 |  | ریل فیلتر | 2 | 2 | 1 | صفحه ریل | 2x170x600 | 2 | 2 | 2
 |  |  |  |  |  |  |  |  |  | 2 | نبشی ریل | 1.5x27x600 | 8 | 8 | 8
 |  |  |  |  |  |  | قاب فیلتر | 2 | 2 | 3 | نبشی عرضی داخل | 1.5x'40x900 | 4 | 4 | 4
 |  |  |  |  |  |  |  |  |  | 4 | نبشی طولی داخل | 1.5x40x600 | 4 | 4 | 4
 |  |  |  |  |  |  |  |  |  | 5 | نبشی عرضی بیرون | 2x'43x900 | 4 | 4 | 4
 |  |  |  |  |  |  |  |  |  | 6 | نبشی طولی بیرون | 2x'43x600 | 4 | 4 | 4
 |  |  |  |  |  |  |  |  |  | 7 | توری | 600x600 | 2 | 2 | 2
 |  |  |  |  |  |  |  |  |  | 8 | دستگیره | Ø 8x230 | 2 | 2 | 2
 |  |  |  |  |  |  | اتصالات | 1 | 2 | 9 | پیچ دوسو | M5x50 | 6 | 6 | 6
 |  |  |  |  |  |  |  |  |  | 10 | رولپلاگ | 5x50 | 6 | 6 | 6

Sheet: SWF MTO
 |  |  |  |  |  | Specification (mm)
Pos. | Part Name | Qty (Pcs) | Material | Description | Thk. / Diameter | W | L | Qty | Gross Qty. | Unit | Net Weight (Kg) | Scrap | Remarks
1
2
3
4
5
6
7
8
9
10
11
12
13
14
15
16
17
18
19
20
21
22
23
24
25
26
27
28
29

Sheet: Nozzle Bank
Bill of Material (B.O.M.) |  |  |  |  |  |  |  |  |  |  | Centigrade Ind. Inc.
Order NO.: |  |  | Product: Air Washer |  |  | Sub. Product : Nozzle Bank |  |  | Station: AC-1
Sheet : 1 of 1 |  |  | Doc No.:Savin-AC1-BOM-03 |  |  | Client :ساوین تاب |  |  | Rev.:00
محصول |  | زیر محصول |  |  |  |  |  |  |  | قطعه
کد محصول | تعداد در سفارش | کد زیر محصول | شرح | تعداد در محصول | تعداد در سفارش | کد مجموعه | شرح | تعداد در زیر محصول | تعداد در سفارش | شمارنده | شرح | مشخصات | تعداد در زیر محصول | تعداد در محصول | تعداد در سفارش
- | 1 | - | نازل بانک | 1 | 1 |  | کلکتور | 4 | 4 | 1 | لوله کلکتور | Ø90x2432 | 4 | 4 | 4
 |  |  |  |  |  |  |  |  |  | 2 | درپوش کلکتور | -- | 8 | 8 | 8
 |  |  |  |  |  |  |  |  |  | 3 | فلنج جوشی کلکتور | -- | 4 | 4 | 4
 |  |  |  |  |  |  |  |  |  | 4 | فلنج فلزی | -- | 4 | 4 | 4
 |  |  |  |  |  |  |  |  |  | 5 | فنجانی کلکتور | -- | 32 | 32 | 32
 |  |  |  |  |  |  |  |  |  | 6 | درپوش فنجانی | -- | 32 | 32 | 32
 |  |  |  |  |  |  |  |  |  | 7 | بوش تفلون رایزر | -- | 32 | 32 | 32
 |  |  |  |  |  |  |  |  |  | 8 | اورینگ فنجانی | -- | 32 | 32 | 32
 |  |  |  |  |  |  | رایزر | 36 | 36 | 9 | لوله رایزر | Ø40x5000 | 32 | 32 | 32
 |  |  |  |  |  |  |  |  |  | 10 | درپوش رایزر | -- | 32 | 32 | 32
 |  |  |  |  |  |  |  |  |  | 11 | بدنه افشانک | -- | 2048 | 2048 | 2048
 |  |  |  |  |  |  |  |  |  | 12 | سری افشانک | -- | 2048 | 2048 | 2048
 |  |  |  |  |  |  |  |  |  | 13 | واشر آب بند | -- | 2048 | 2048 | 2048
 |  |  |  |  |  |  |  |  |  | 14 | بست استیل | -- | 2112 | 2112 | 2112
 |  |  |  |  |  |  |  |  |  | 15 | ناودانی افشانک | 1.5x88x5600 | 4 | 4 | 4
 |  |  |  |  |  |  |  |  |  | 16 | بست شکلاتی | -- | 64 | 64 | 64
 |  |  |  |  |  |  |  |  |  | 17 | نبشی رایزر | 5x50x500 | 4 | 4 | 4
 |  |  |  |  |  |  | اتصالات | 1 | 1 | 18 | پیچ شش گوش | M6x30 | 72 | 72 | 72
 |  |  |  |  |  |  |  |  |  | 19 | مهره شش گوش | M6 | 72 | 72 | 72

Sheet: Nozzle Bank MTO
 |  |  |  |  |  | Specification (mm)
Pos. | Part Name | Qty (Pcs) | Material | Description | Thk. / Diameter | W | L | Qty | Gross Qty. | Unit | Net Weight (Kg) | Scrap | Remarks
1
2
3
4
5
6
7
8
9
10
11
12
13
14
15
16
17
18
19
20
21
22
23
24
25
26
27
28
29

Sheet: Air Baffle
Bill of Material (B.O.M.) |  |  |  |  |  |  |  |  |  |  | Centigrade Ind. Inc.
Order NO.: |  |  | Product: Air Washer |  |  | Sub. Product : Air Baffle |  |  | Station: AC-1
Sheet : 1 of 1 |  |  | Doc No.:Savin-AC1-BOM-02 |  |  | Client :ساوین تاب |  |  | Rev.:00
محصول |  | زیر محصول |  |  |  |  |  |  |  | قطعه
کد محصول | تعداد در سفارش | کد زیر محصول | شرح | تعداد در محصول | تعداد در سفارش | کد مجموعه | شرح | تعداد در زیر محصول | تعداد در سفارش | شمارنده | شرح | مشخصات | تعداد در زیر محصول | تعداد در محصول | تعداد در سفارش
- | 1 | - | ایربافل | 1 | 1 |  |  |  |  | 1 | ناودانی عرضی | 1.5x88x5400 | 4 | 4 | 4
 |  |  |  |  |  |  |  |  |  | 2 | ناودانی طولی | 1.5x84x5100 | 12 | 12 | 12
 |  |  |  |  |  |  | اتصالات 1 | 1 | 1 | 3 | پیچ دوسو | M5x50 | 30 | 30 | 30
 |  |  |  |  |  |  |  |  |  | 4 | رولپلاک | 5x50 | 30 | 30 | 30
 |  |  |  |  |  |  |  |  |  | 5 | شبکه ایربافل | 300x600 | 155 | 155 | 155
 |  |  |  |  |  |  |  |  |  | 6 | چفت | -- | 266 | 266 | 266
 |  |  |  |  |  |  |  |  |  | 7 | بست | -- | 266 | 266 | 266
 |  |  |  |  |  |  | اتصالات 2 | 1 | 1 | 8 | پیچ شش گوش | M6x40 | 266 | 266 | 266
 |  |  |  |  |  |  |  |  |  | 9 | مهره | M6 | 266 | 266 | 266
 |  |  |  |  |  |  | دریچه بازدید | 1 | 1 | 10 | ناودانی عرضی داخل | 1.5x40x900 | 2 | 2 | 2
 |  |  |  |  |  |  |  |  |  | 11 | ناودانی طولی داخل | 1.5x40x600 | 2 | 2 | 2
 |  |  |  |  |  |  |  |  |  | 12 | ناودانی عرضی بیرون | 1.5x40x900 | 2 | 2 | 2
 |  |  |  |  |  |  |  |  |  | 13 | ناودانی طولی بیرون | 1.5x40x600 | 2 | 2 | 2

Sheet: Airbaffle MTO
 |  |  |  |  |  | Specification (mm)
Pos. | Part Name | Qty (Pcs) | Material | Description | Thk. / Diameter | W | L | Qty | Gross Qty. | Unit | Net Weight (Kg) | Scrap | Remarks
1
2
3
4
5
6
7
8
9
10
11
12
13
14
15
16
17
18
19
20
21
22
23
24
25
26
27
28
29

Sheet: Eliminator
Bill of Material (B.O.M.) |  |  |  |  |  |  |  |  |  |  | Centigrade Ind. Inc.
Order NO.: |  |  | Product: Air Washer |  |  | Sub. Product : Eliminator |  |  | Station: AC-1
Sheet : 1 of 2 |  |  | Doc No.:Savin-AC1-BOM-01 |  |  | Client :ساوین تاب |  |  | Rev.:00
محصول |  | زیر محصول |  |  |  |  |  |  |  | قطعه
کد محصول | تعداد در سفارش | کد زیر محصول | شرح | تعداد در محصول | تعداد در سفارش | کد مجموعه | شرح | تعداد در زیر محصول | تعداد در سفارش | شمارنده | شرح | مشخصات | تعداد در زیر محصول | تعداد در محصول | تعداد در سفارش
- | 1 | - | الیمیناتور | 1 | 1 |  | پایه الیمیناتور | 1 | 1 | 1 | نبشی عرضی پایین 1 | 1.5x97x1592 | 6 | 6 | 6
 |  |  |  |  |  |  |  |  |  | 2 | نبشی عرضی پایین 2 | 1.5x97x1824 | 12 | 12 | 12
 |  |  |  |  |  |  |  |  |  | 3 | پایه | 1.5x250x275 | 7 | 7 | 7
 |  |  |  |  |  |  |  |  |  | 4 | پیچ شش گوش | M8x25 | 24 | 24 | 24
 |  |  |  |  |  |  |  |  |  | 5 | مهره شش گوش | M8 | 24 | 24 | 24
 |  |  |  |  |  |  | نردبان | 4 | 4 | 6 | نبشی نردبانی | 1.5x97x2597 | 8 | 8 | 8
 |  |  |  |  |  |  |  |  |  | 7 | رابط نردبانی | 1.5x77x270 | 24 | 24 | 24
 |  |  |  |  |  |  |  |  |  | 8 | نبشی عرضی بالا 1 | 1.5x137x1592 | 2 | 2 | 2
 |  |  |  |  |  |  |  |  |  | 9 | نبشی عرضی بالا 2 | 1.5x137x1824 | 4 | 4 | 4
 |  |  |  |  |  |  |  |  |  | 10 | درزگیر | 1.5x97x2523 | 8 | 8 | 8
 |  |  |  |  |  |  |  |  |  | 11 | ستون میانی | 1.5x240x2523 | 8 | 8 | 8
 |  |  |  |  |  |  |  |  |  | 12 | سینی 1 | 1.5x995x1592 | 1 | 1 | 1
 |  |  |  |  |  |  | سینی | 1 | 1 | 13 | سینی 2 | 1.5x995x1824 | 2 | 2 | 2
 |  |  |  |  |  |  |  |  |  | 14 | رابط سینی | 1.5x988x160 | 2 | 2 | 2
 |  |  |  |  |  |  |  |  |  | 15 | پیچ شش گوش | M6x10 | 35 | 35 | 35
 |  |  |  |  |  |  |  |  |  | 16 | مهره شش گوش | M6 | 35 | 35 | 35
 |  |  |  |  |  |  |  |  |  | 17 | فلنج تخلیه | -- | 2 | 2 | 2
 |  |  |  |  |  |  |  |  |  | 18 | نبشی اتصال نبشی عرضی پایین به ستون | 2.5x75x60 | 4 | 4 | 4
 |  |  |  |  |  |  |  |  |  | 19 | نبش اتصال ستون به سینی | 2.5x75x80 | 8 | 8 | 8
 |  |  |  |  |  |  |  |  |  | 20 | ناودانی اتصال سقفی | 2x80x295 | 2 | 2 | 2
Bill of Material (B.O.M.) |  |  |  |  |  |  |  |  |  |  | Centigrade Ind. Inc.
Order NO.: |  |  | Product: Air Washer |  |  | Sub. Product : Eliminator |  |  | Station: AC-1
Sheet : 2 of 2 |  |  | Doc No.Savin-AC1-BOM-01 |  |  | Client :ساوین تاب |  |  | Rev.:00
محصول |  | زیر محصول |  |  |  |  |  |  |  | قطعه
کد محصول | تعداد در سفارش | کد زیر محصول | شرح | تعداد در محصول | تعداد در سفارش | کد مجموعه | شرح | تعداد در زیر محصول | تعداد در سفارش | شمارنده | شرح | مشخصات | تعداد در زیر محصول | تعداد در محصول | تعداد در سفارش
- | 1 | - | الیمیناتور | 1 | 1 |  | اتصالات | 1 | 1 | 21 | پیچ شش گوش | M8x25 | 64 | 64 | 64
 |  |  |  |  |  |  |  |  |  | 22 | مهره شش گوش | M8 | 64 | 64 | 64
 |  |  |  |  |  |  |  |  |  | 23 | پیچ شش گوش | M6x15 | 20 | 20 | 20
 |  |  |  |  |  |  |  |  |  | 24 | پیچ شش گوش | M6x10 | 35 | 35 | 35
 |  |  |  |  |  |  |  |  |  | 25 | مهره شش گوش | M6 | 55 | 55 | 55
 |  |  |  |  |  |  |  |  |  | 26 | پیچ دو سو | M5x50 | 30 | 30 | 30
 |  |  |  |  |  |  |  |  |  | 27 | رولپلاگ | 5x50 | 30 | 30 | 30
 |  |  |  |  |  |  |  |  |  | 28 | تیغه الیمیناتور | 2496 | 484 | 484 | 484
 |  |  |  |  |  |  |  |  |  | 29 | مهره برنجی | -- | 544 | 544 | 544
 |  |  |  |  |  |  |  |  |  | 30 | مهره شش گوش | M5 | 544 | 544 | 544
 |  |  |  |  |  |  |  |  |  | 31 | میله الیمیناتور | 304 | 544 | 544 | 544
 |  |  |  |  |  |  |  |  |  | 32 | فاصله میانی | -- | 7191 | 7191 | 7191
 |  |  |  |  |  |  |  |  |  | 33 | فاصله آخر | -- | 588 | 588 | 588

Sheet: Eliminator MTO
 |  |  |  |  |  | Specification (mm)
Pos. | Part Name | Qty (Pcs) | Material | Description | Thk. / Diameter | W | L | Qty | Gross Qty. | Unit | Net Weight (Kg) | Scrap | Remarks
1
2
3
4
5
6
7
8
9
10
11
12
13
14
15
16
17
18
19
20
21
22
23
24
25
26
27
28
29

Sheet: Instrument
Bill of Material (B.O.M.) |  |  |  |  |  |  |  |  |  |  | Centigrade Ind. Inc.
Order NO.: |  |  | Product: Air Washer |  |  | Sub. Product : Eliminator |  |  | Station: AC-1
Sheet : 1 of 2 |  |  | Doc No.:Savin-AC1-BOM-01 |  |  | Client :ساوین تاب |  |  | Rev.:00
محصول |  | زیر محصول |  |  |  |  |  |  |  | قطعه
کد محصول | تعداد در سفارش | کد زیر محصول | شرح | تعداد در محصول | تعداد در سفارش | کد مجموعه | شرح | تعداد در زیر محصول | تعداد در سفارش | شمارنده | شرح | مشخصات | تعداد در زیر محصول | تعداد در محصول | تعداد در سفارش
 |  |  |  |  |  |  |  |  |  | 1 | Micro Switch | فشنگی | 4
 |  |  |  |  |  |  |  |  |  | 2 | Temperature Sensor | دما 10- الی 100 درجه | 1
 |  |  |  |  |  |  |  |  |  | 3 | Humidity Sensor | 4-20 mA 24 VDC, دقت 1 درصد | 1
 |  |  |  |  |  |  |  |  |  | 4 | Steam Valve | 2way Steam Valve 2" Valve Linkage- | 1

Sheet: Instrument MTO
 |  |  |  |  |  | Specification (mm)
Pos. | Part Name | Qty (Pcs) | Material | Description | Thk. / Diameter | W | L | Qty | Gross Qty. | Unit | Net Weight (Kg) | Scrap | Remarks
1 | Micro Switch | 4 | - | فشنگی |  |  |  | 4 | 4 | Pcs
2 | Temperature Sensor | 1 | - | دما 10- الی 100 درجه |  |  |  | 1 | 1 | Pcs
3 | Humidity Sensor | 1 | - | 4-20 mA 24 VDC, دقت 1 درصد |  |  |  | 1 | 1 | Pcs
4 | Steam Valve | 1 | - | 2way Steam Valve 2" Valve Linkage- |  |  |  | 1 | 1 | Pcs
5
6
7
8
9
10
11
12
13
14
15
16
17
18
19
20
21
22
23
24
25
26
27
28
29
