koalium/centidocs/jokar/Savin 1/BOM & MTO/Savin-AC1-MTO 02(Pumping-Damper-SWF-Instruments)-Rev 00.xlsx

Sheet: Pumping MTO
 |  |  |  |  |  | Specification (mm)
Pos. | Part Name | Qty (Pcs) | Material | Description | Thk. / Diameter | W | L | Qty | Gross Qty. | Unit | Net Weight (Kg) | Scrap | Remarks
1 | الکترو موتور | 1 | - | الکترو موتور | 37Kw | 1450 rpm | 3Ph | 1 | 1 | Pcs | - | - | پایه دار
2 | پمپ | 1 | - | پمپ گریز از مرکز | EN150-315 | - | - | 1 | 1 | Pcs
3 | کوپلینگ | 1 | - | کوپلینگ | 140 | - | - | 1 | 1 | Pcs | - | -
4 | شاسی | 1 | آهن معمولی | UPN | 160 | - | 6000 | 1 | 113 | Kg | - | -

Sheet: Damper MTO
 |  |  |  |  |  | Specification (mm)
Pos. | Part Name | Qty (Pcs) | Material | Description | Thk. / Dia | W | L | Qty | Gross Qty. | Unit | Net Weight (Kg) | Scrap | Remarks
1 | قاب عرضی و ایرسیل | 20 | H.D.G | ورق | 1.5 | 1250 | 2200 | 4 | 129.525 | kg | 115 | 12.63043478%
2 | قاب طولی و ایرسیل | 16 | H.D.G | ورق | 1.5 | 1250 | 2800 | 4 | 164.85 | kg | 147 | 12.14285714%
3 | ستون میانی و نبشی اتصال قاب | 30 | H.D.G | ورق | 1.5 | 1000 | 2800 | 2 | 65.94 | kg | 51 | 29.29411765%
4 | بازو و نبشی اتصال ستون میانی | 36 | H.D.G | ورق | 2 | 1000 | 2700 | 1 | 42.39 | kg | 38 | 11.55263158%
5 | تیغه دمپر | 216 | Aluminium | قطعه پیش ساخته | - | - | 1100 | 216 | 286 | kg | - | -
6 | بادامک | 108 | Polyamide | قطعه پیش ساخته | - | - | - | 108 | 108 | Pcs | - | -
7 | بوش | 324 | ABS | قطعه پیش ساخته | - | - | - | 324 | 324 | Pcs | - | -
8 | واسطه چهارگوش | 216 | Polyamide | قطعه پیش ساخته | - | - | - | 216 | 216 | Pcs | - | -
9 | فشنگی | 216 | Polystyrene | قطعه پیش ساخته | - | - | - | 216 | 216 | Pcs | - | -
10 | نوار دمپر | 24 | P.E | مواد خام | - | - | 2800 | 24 | 11 | kg | - | -
11 | گوشک | 48 | H.D.G | قطعه پیش ساخته | - | - | - | 48 | 48 | Pcs | - | -
12 | پیچ آلن مخروطی | 108 | گالوانیزه سرد | پیچ آلن مخروطی | M | 10 | 15 | 108 | 108 | Pcs | - | -
13 | واشر تخت | 108 | گالوانیزه سرد | واشر تخت | A | 12 | OD:30 | 108 | 108 | Pcs | - | -
14 | مهره چهار گوش | 108 | گالوانیزه سرد | مهره چهار گوش | M | 10 | 20*20 | 108 | 108 | Pcs | - | -
15 | اشپیل | 108 | گالوانیزه سرد | اشپیل | 2.6 | - | 30 | 108 | 108 | Pcs | - | -
16 | پیچ شش گوش | 192 | گالوانیزه سرد | پیچ شش گوش | M | 10 | 15 | 192 | 192 | Pcs | - | -
17 | مهره شش گوش | 192 | گالوانیزه سرد | مهره شش گوش | M | 10 | - | 192 | 192 | Pcs | - | -
18 | نبشی اتصال به دیوار | 24 | آهن معمولی | نبشی | 4 | 40*40 | 1500 | 1 | 3.63 | kg | - | -
19 | دمپر موتور | 6 | - | دمپر موتور | 32 N.m |  | - | 6 | 6 | Pcs | - | -

Sheet: SWF MTO
 |  |  |  |  |  | Specification (mm)
Pos. | Part Name | Qty (Pcs) | Material | Description | Thk. / Diameter | W | L | Qty | Gross Qty. | Unit | Net Weight (Kg) | Scrap | Remarks
1 | پد ریل و قاب بیرونی | 20 | استیل نگیر | Plate | 2 | 1000 | 2000 | 1 | 31.4 | Kg | 14 | 124.2857143%
2 | ریل و قاب داخلی | 16 | استیل نگیر | Plate | 1.5 | 1000 | 2000 | 1 | 23.55 | Kg | 11 | 114.0909091%
3 | دستگیره | 4 | استیل نگیر | Round Bar | Ø8 | - | 1000 | 1 | 0.5 | Kg | 0.5 | 0%
4 | توری | 4 | استیل نگیر | توری بافته شده | 2.3x2.3 Ø0.5 | 1000 | 2500 | 1 | 2.5 | متر | 2.5 | 0%

Sheet: Instrument MTO
 |  |  |  |  |  | Specification (mm)
Pos. | Part Name | Qty (Pcs) | Material | Description | Thk. / Diameter | W | L | Qty | Gross Qty. | Unit | Net Weight (Kg) | Scrap | Remarks
1 | Micro Switch | 4 | - | فشنگی | - | - | - | 4 | 4 | Pcs
2 | Temperature Sensor | 1 | - | دما 10- الی 100 درجه | - | - | - | 1 | 1 | Pcs
3 | Humidity Sensor | 1 | - | 4-20 mA 24 VDC, دقت 1 درصد | - | - | - | 1 | 1 | Pcs
4 | Steam Valve | 1 | - | 2way Steam Valve 2" Valve Linkage- | - | - | - | 1 | 1 | Pcs
