koalium/centidocs/jokar/Savin 1/BOM & MTO/Savin-AC1-MTO 03 (Hatch-Fan Case)-Rev 00.xlsx

Sheet: Hatch
 |  |  |  |  |  | Specification (mm)
Pos. | Part Name | Qty (Pcs) | Material | Description | Thk. / Diameter | W | L | Qty | Gross Qty. | Unit | Net Weight (Kg) | Scrap | Remarks
1 | قاب چهارچوب | 4 | آهن معمولی | پروفیل چهارچوبی | - | - | L=6000 | 1 | - | Kg | - | -
2 | قاب در | 4 | آهن معمولی | پروفیل دری | - | - | L=6000 | 1 | - | Kg | - | -
3 | پد در | 1 | St-37 | Plate | 1.5 | 1000 | 700 | 1 | 8.2425 | Kg | 5 | 64.85%
4 | لولا | 2 | آهن معمولی | قطعه پیش ساخته | Ø10 | - | - | 2 | - | Pcs | - | -
5 | دستگیره | 1 | آهن معمولی | کشابه میله ای | Ø8 | - | - | 1 | - | Pcs | - | -

Sheet: Fan Case MTO
 |  |  |  |  |  | Specification (mm)
Pos. | Part Name | Qty (Pcs) | Material | Description | Thk. / Diameter | W | L | Qty | Gross Qty. | Unit | Net Weight (Kg) | Scrap | Remarks
1 | مخروطی | 20 | St-37 | Plate | 2.5 | 1250 | 4100 | 1 | 100.578125 | Kg | 82 | 22.65625%
2 | رینگ و سیخک | 4 | St-37 | Plate | 3 | 1000 | 5050 | 2 | 237.855 | Kg | 198 | 20.12878788%
3 | فلنج | 16 | St-37 | Plate | 4 | 1250 | 1400 | 1 | 54.95 | Kg | 32 | 71.71875%
4 | قطعات اتصال | 16 | St-37 | Plate | 8 | 1500 | 320 | 1 | 30.144 | Kg | 26 | 15.93846154%
5 | پایه و صفحه | 12 | St-37 | Plate | 10 | 1500 | 3600 | 1 | 423.9 | Kg | 361 | 17.42382271%
6 | پیچ | 108 | گالوانیزه سرد | پیچ شش گوش | M | 16 | 40 | 108 | 108 | Pcs | - | -
7 | مهره | 108 | گالوانیزه سرد | مهره شش گوش | M | 16 | - | 108 | 108 | Pcs | - | -
8 | رنگ | 1 | - | آلکیدی نقره ای | - | - | - | - | 6 | Kg | - | -
9 | تینر | 1 | - | - | - | - | - | - | 6 | Lit | - | -
