koalium/centidocs/jokar/Savin 1/BOM & MTO/Savin-AC1-MTO 04 (ARF-VC)-Rev 00.xlsx

Sheet: Rotary
 |  |  |  |  |  | Specification (mm)
Pos. | Part Name | Qty (Pcs) | Material | Description | Thk. / Dia | W | L | Qty | Gross Qty. | Unit | Net Weight (Kg) | Scrap | Remarks
1 | ورق پانچی | 60 | روغنی | Plate | 1.5 | 1000 | 1620 | 60 | 1144.53 | Kg
2 | ناودانی بدنه | 60 | St37 | Plate | 4 | 1250 | 5850 | 2 | 459.225 | Kg
3 | نبشی بدنه | 60 | St37 | Plate | 4 | 1250 | 3200 | 2 | 251.2 | Kg
4 | ناودانی بازو، نگهدارنده پولی فلزی | 30 | St37 | Plate | 4 | 1250 | 3600 | 1 | 141.3 | Kg
5 | صفحه مثلثی، نگهدارنده میل پیچ، اتصال پولی به میل پیچ، نگهدارنده پولی، صفحه تقویتی پایه ثابت | 52 | St37 | Plate | 8 | 1500 | 2800 | 1 | 263.76 | Kg | - | -
6 | صفحه شفت، صفحه زیر پایه ثابت و متحرک | 20 | St37 | Plate | 10 | 1500 | 1800 | 1 | 211.95 | Kg | - | -
7 | صفحه زیر یاتاقان | 2 | St37 | Plate | 20 | 1500 | 350 | 1 | 82.425 | Kg
8 | ناودانی پایه ثابت، صغحه اتصال قوطی تقویتی، درپوش قوطی تقویتی، ورق اتصال سر نبشی | 4 | St37 | Plate | 4 | 1000 | 1600 | 1 | 50.24 | Kg
9 | صفحه زیر الکترو موتور، ساپورت نگهدارنده صفحه موتور | 4 | St37 | Plate | 3 | 1000 | 550 | 1 | 12.9525 | Kg
10 | سینی | 8 | H.D.G | Plate | 2 | 1000 | 2000 | 4 | 125.6 | Kg
11 | ناودانی تقویتی، صفحه زیر نوار خاردار، تسمه کلیدی | 90 | H.D.G | Plate | 2 | 1000 | 2000 | 6 | 188.4 | Kg
12 | سینی انتهایی | 1 | H.D.G | Plate | 1.5 | 1250 | 2500 | 4 | 147.1875 | Kg
13 | شفت سمت ثابت و متحرک | 4 | Ck 45 | R.B. | 65 | - | 1200 | 1 | 31 | Kg | - | -
14 | شفت الکتروگیربکس | 2 | آهن معمولی | R.B. | 35 | - | 350 | 1 | 2.64 | Kg
15 | پولی فلزی تسمه سبز | 2 | St37 | UPN 40 |  |  | 6000 | 2 | 59 | Kg
16 | نبشی تقویتی میانی، نبشی قاب جلو روتاری، نبشی هرزگرد | 20 | آهن معمولی | Angle | 4 | 40*40 | 6000 | 8 | 90 | Kg
17 | قوطی طولی | 8 | St37 | R.P. | 3 | 70*70 | 6000 | 2 | 76 | Kg
18 | لوله تقویتی ناودانی بازو | 80 | St37 | Pipe | 22 | - | 6000 | 1 | 6 | Kg |  |  | لوله گازی
19 | تسمه نوار خاردار | 30 | H.D.G | قطعه پیش ساخته |  |  | 1700 | 30 | 30 | Pcs
20 | تسمه نوار عرضی | 12 | H.D.G | تسمه بسته بندی | 1.5 | 30 | 8270 | 12 | 35.05653 | Kg
21 | یست تسمه عرضی | 12 | H.D.G | قطعه پیش ساخته | - | - | - | 12 | 12 | Pcs
22 | فیلتر اسفنجی | 30 | PPI 45 | Filter | - | - | - | 30 | 30 | Pcs
23 | پولی | 2 | P.T.F.E | R.B. | 65 | - | 200 | 1 | 1.46 | Kg
24 | لاستیک هوابند | 2 | Rubber | - | 3 | 150 | 8270 | 2 | 2 | Pcs
25 | یاتاقان بلبیرینگ پایه دار 60 | 4 | - | UCP 212 | - | - | - | 4 | 4 | Pcs
26 | پولی چدنی | 2 | Cast Iron | - | - | - | - | 2 | 2 | Pcs
27 | تسمه سبز روتاری | 2 | Rubber | - | - | - | - | 2 | 2 | Pcs
28 | الکترو گیربکس روتاری هوا | 2 | - | الکترو گیربکس | 0.37 kw | 1400rpm | AC | 2 | 2 | Pcs
29 | میل پیچ متری | 2 | آهن معمولی | Screw | 14 | - | 310 | 2 | 2 | Pcs
30 | بیرینگ پولی سفت کن | 4 | - | Bearing | 6201z | - | - | 4 | 4 | Pcs
31 | پیچ پولی | 2 | گالوانیزه سرد | Bolt | M | 12 | 100 | 2 | 2 | Pcs
32 | مهره پولی | 4 | گالوانیزه سرد | Nut | M | 12 | - | 4 | 4 | Pcs
33 | واشر تخت پولی | 4 | گالوانیزه سرد | Washer | A | 12*40 | - | 4 | 4 | Pcs
34 | پیچ اتصال قوطی تقویتی | 4 | گالوانیزه سرد | Bolt | M | 14 | 90 | 4 | 4 | Pcs
35 | پیچ صفحه شفت | 80 | گالوانیزه سرد | Bolt | M | 14 | 140 | 80 | 80 | Pcs
36 | مهره اتصال قوطی تقویتی، مهره صفحه شفت، مهره سر میل پیچ | 88 | گالوانیزه سرد | Nut | M | 14 | - | 88 | 88 | Pcs
37 | واشر تخت قوطی تقویتی | 8 | گالوانیزه سرد | Washer | A | 14 | - | 8 | 8 | Pcs
38 | واشر فنری قوطی تقویتی، واشر فنری صفحه شفت | 84 | گالوانیزه سرد | S.Washer | A | 14 | - | 84 | 84 | Pcs
39 | پیچ تسمه نوار عرضی | 12 | گالوانیزه سرد | Bolt | M | 6 | 10 | 12 | 12 | Pcs
40 | مهره تسمه نوار عرضی | 12 | گالوانیزه سرد | Nut | M | 6 | - | 12 | 12 | Pcs
41 | پیچ اتصال صفحه مثلثی 2، پیچ صفحه میانی، پیچ نبشی تقویت میانی | 160 | گالوانیزه سرد | Bolt | M | 10 | 30 | 160 | 160 | Pcs
42 | پیچ اتصال تکه ها | 180 | گالوانیزه سرد | Bolt | M | 10 | 20 | 180 | 180 | Pcs
43 | مهره نبشی تقویت میانی، مهره اتصال تکه ها، مهره اتصال صفحه مثلثی 2 | 280 | گالوانیزه سرد | Nut | M | 10 | - | 280 | 280 | Pcs
44 | واشر اتصال تکه ها | 180 | گالوانیزه سرد | Washer | A | 10 |  | 180 | 180 | Pcs
45 | پیچ اتصال کپه ها، اتصال سینی به ناودانی بازو، اتصال صفحه الکترو گیربکس، سر الکترو گیربکس، اتصال سینی، اتصال نبشی | 488 | گالوانیزه سرد | Bolt | M | 8 | 20 | 488 | 488 | Pcs
46 | پیچ اتصال صفحه مثلثی 1، پیچ اتصال الکتروگیر بکس | 88 | گالوانیزه سرد | Bolt | M | 8 | 30 | 88 | 88 | Pcs
47 | مهره اتصال سینی، اتصال نبشی، اتصال صفحه الکتروگیربکس، اتصال الکتروگیربکس، اتصال سینی به ناودانی بازو، اتصال صفحه مثلثی 1، اتصال کپه ها | 574 | گالوانیزه سرد | Nut | M | 8 | - | 574 | 574 | Pcs
48 | واشر فنری اتصال کپه ها، سر الکترو گیربکس، صفحه الکترو گیربکس | 260 | گالوانیزه سرد | S. Washer | A | 8 |  | 260 | 260 | Pcs
49 | واشر استپ سر الکترو گیربکس | 4 | گالوانیزه سرد | Washer | A | 8*40 | - | 4 | 4 | Pcs
50 | واشر تخت صفحه الکترو گیربکس | 8 | گالوانیزه سرد | Washer | A | 8 | - | 8 | 8 | Pcs
51 | پیچ | 8 | گالوانیزه سرد | Slotted Countersunk Screw | M | 8 | 60 | 8 | 8 | Pcs
52 | پیچ ورشو نوار خاردار | 210 | گالوانیزه سرد | Bolt | M | 1/4" | 30 | 210 | 210 | Pcs
53 | پیچ یاتاقان | 8 | گالوانیزه سرد | Bolt | M | 18 | 70 | 8 | 8 | Pcs
54 | مهره | 8 | گالوانیزه سرد | Nut | M | 18 | - | 8 | 8 | Pcs
55 | واشر تخت | 4 | گالوانیزه سرد | Washer | A | 18 | - | 8 | 8 | Pcs
56 | واشر فنری | 4 | گالوانیزه سرد | S.Washer | A | 18 | - | 8 | 8 | Pcs
57 | پیچ رولپلاگ | 12 | گالوانیزه سرد | Bolt | M | 8 | 80 | 12 | 12 | Pcs
58 | رولپلاگ | 8 | - | Rawplug |  | 10 | 80 | 8 | 8 | Pcs
59 | اشپیل مهره میل پیچ | 2 | گالوانیزه سرد | اشپیل | 3 | - | 30 | 2 | 2 | Pcs
60 | خار شفت الکتروگیربکس | 4 | - | - | 6 | 6 | 100 | 4 | 4 | Pcs
61 | رولپلاگ | 12 | - | Rawplug | - | 10 | 80 | 12 | 12 | Pcs
62 | پیچ ورشو اتصال نبشی تقویتی به سینی | 92 | گالوانیزه سرد | Bolt |  | 1/4" | 10 | 92 | 92 | Pcs
63 | مهره چهارگوش اتصال نبشی به سینی | 92 | گالوانیزه سرد | Nut |  | 1/4" |  | 92 | 92 | Pcs

Sheet: Vacuum Cleaner
 |  |  |  |  |  | Specification (mm)
Pos. | Part Name | Qty (Pcs) | Material | Description | Thk. / Diameter | W | L | Qty | Gross Qty. | Unit | Net Weight (Kg) | Scrap | Remarks
1 | ریل حرکت واگن | 6 | ترانس | میلگرد | 12 | - | 6000 | 4 | 21.3 | kg | 18.2 | 17.07093187
2 | شفت گیربکس جاروب | 2 | دوپالیشه | میلگرد | 35 | - | 1250 | 1 | 9.4 | kg | 6.1 | 54.76152344
3 | بوش سر پره فن | 4 | آلومینیوم | میلگرد | 60 | - | 600 | 1 | 4.6 | kg | 3.2 | 44.6875
4 | نبشی تقویتی / قاب بدنه جاروب | 6 | آهن معمولی | نبشی | 3 | 30x30 | 6000 | 4 | 33.9 | kg | 31.5 | 7.657142857
5 | صفحه زیر پایه | 2 | St-37 | ورق | 5 | 1500 | 500 | 1 | 29.4 | kg | 20.1 | 46.45522388
6 | درب جاروب | 2 | H.D.G | ورق | 1.5 | 1000 | 2000 | 3 | 70.8 | kg | 65.0 | 16.2962963
7 | قطعات داست کالکتور | 2 | H.D.G | ورق | 2 | 1000 | 1800 | 4 | 113.0 | kg | 93.0 | 21.5483871
8 | صفحه بدنه جاروب وفن حلزونی | 6 | H.D.G | ورق | 2 | 1000 | 2000 | 8 | 439.6 | kg | 380.0 | 15.68421053
9 | لوله ی پایه نگهدارنده | 2 | آهن معمولی | لوله | 1" | Sch 10 | 6000 | 2 | 30.0 | kg | 26.5 | 13.20754717
10 | قیفی فن حلزونی | 4 | آلومینیوم | قطعه پیش ساخته | - | - | - | 4 | 4 | Pcs
11 | پره فن چپ گرد | 2 | آلومینیوم | قطعه نیم ساخته | - | - | - | 2 | 2 | Pcs
12 | پره فن راست گرد | 2 | آلومینیوم | قطعه نیم ساخته | - | - | - | 2 | 2 | Pcs
13 | چرخدنده خورشیدی ثابت / متحرک | 6 | آهن معمولی | چرخدنده | Ø80 | - | - | 6 | 6 | Pcs
14 | زنجیر40 | 2 | - | زنجیر | Size40 | - | 3000 | 2 | 2 | Pcs
15 | بست لوله خرطومی | 12 | H.D.G | بست | Ø110 |  |  | 12 | 12 | Pcs
16 | بست کیسه داست کالکتور | 12 | H.D.G | بست | - | - | - | 12 | 12 | Pcs
17 | موتور فن حلزونی | 4 | - | الکترو موتور | 2.2kw | 3000rpm | AC | 4 | 4 | Pcs
18 | الکتروگیربکس جاروب | 2 | - | الکتروگیربکس جاروب | 0.09kw | 1400rpm | AC | 2 | 2 | Pcs
19 | کیسه یک سر باز | 4 | پارچه پلی استر | قطعه پیش ساخته | Ø350 |  |  | 4 | 4 | Pcs
20 | کیسه دو سر باز | 4 | پارچه پلی استر | قطعه پیش ساخته | Ø350 |  |  | 4 | 4 | Pcs
21 | چرخ واگن/خورشیدی | 28 | - | Deep Groove Ball Bearing | 6000 zz |  |  | 28 | 28 | Pcs
22 | بدنه نازل مکش | 1 | P.V.C | لوله | 110 | - | 6000 | 1 | 6 | m
23 | لوله خرطومی | 6 | P.V.C | قطعه پیش ساخته | Ø110 | - | 3000 | 6 | 6 | Pcs
24 | اتصالات | 48 | گالوانیزه سرد | Bolt | 0.25 | - | 10 | 48 | 48 | Pcs
25 | اتصالات | 48 | گالوانیزه سرد | Nut | 0.25 |  |  | 48 | 48 | Pcs
26 | اتصالات | 264 | گالوانیزه سرد | Bolt | M | 8 | 20 | 264 | 264 | Pcs
27 | اتصالات | 264 | گالوانیزه سرد | Nut | M | 8 |  | 264 | 264 | Pcs
28 | اتصالات | 36 | گالوانیزه سرد | Washer | A | 8 | 20 | 36 | 36 | Pcs
29 | اتصالات | 72 | گالوانیزه سرد | Washer | A | 8 | 30 | 72 | 72 | Pcs
30 | پیچ رولپلاگ | 96 | گالوانیزه سرد | Bolt | M | 8 | 80 | 96 | 96 | Pcs
31 | رولپلاگ | 96 | - | Rawplug |  | 8 | 80 | 96 | 96 | Pcs
