koalium/centidocs/Rezaei/90005/90005-damper valve/BOM from solid-rev01.xlsx

PART LIST FOR "ONE UNIT"
Item NO. | Part name | Description | Material | Weight | QTY. | T.Weight
1 | Damper ring |  | A516-Gr 70 | 165.5 | 1 | 165.5
2 | Frame flange |  | A516-Gr 70 | 71.1 | 2 | 142.2
3 | Airseal-H |  | AISI 304 | 10.8 | 2 | 21.6
4 | Airseal-V |  | AISI 304 | 4.2 | 2 | 8.4
5 | Frame Stiffener |  | A516-Gr 70 |  | 34 | 0
6 | Frame Stiffener-2 |  | A516-Gr 70 |  | 2 | 0
7 | Frame-pipe |  | AISI 304 | 10.7 | 1 | 10.7
8 | Refractory cement |  | Refractory cement | 130.5 | 1 | 130.5
9 | Bearing-flange1 |  | ASTM A36 Steel | 3 | 4 | 12
10 | Bearing-seat-plate |  | ASTM A36 Steel | 5.6 | 4 | 22.4
8 | Bearing(ucf210) |  |  |  | 4 | 0
12 | Bearing base plate Bolting (M14 x 50) |  | Dacromet |  | 16 | 0
13 | Bearing S.P. bolting (M16 x40) |  | Dacromet |  | 16 | 0
14 | Gland-flange F |  | ASTM A36 Steel | 3.85 | 4 | 15.4
15 | Gland-flange-M |  | Cast Carbon Steel | 2.05 | 4 | 8.2
16 | gland-packing |  | A-Glass Fiber | 0.4 | 4 | 1.6
17 | Gland Pcking Bolting (M12x60) |  | Dacromet |  | 8 | 0
18 | Mirrorbearing-flange1 |  | ASTM A36 Steel | 3 | 4 | 12
19 | Blade-up plate |  | AISI 304 | 22.3 | 2 | 44.6
20 | Blade-bottum plate |  | AISI 304 | 26.6 | 2 | 53.2
21 | Blade-pipe |  | AISI 304 | 11.4 | 2 | 22.8
22 | Blade-reinforce1 |  | AISI 304 | 1.2 | 8 | 9.6
23 | Blade-reinforce2 |  | AISI 304 | 1.5 | 8 | 12
24 | Blade pipe bolting (M20 x 90) |  | AISI 304 |  | 8 | 0
25 | Blade shaft-1 |  | AISI 304 | 11.8 | 2 | 23.6
26 | Blade shaft-2 |  | AISI 304 | 12.6 | 1 | 12.6
27 | Rotating Arm-R |  | ASTM A36 Steel | 1.24 | 1 | 1.24
28 | Shaft-arm Bolt(S. head cap-M10 x 16) |  | Dacromet |  | 2 | 0
29 | Driven shaft key |  | ASTM A36 Steel | 0.05 | 2 | 0.1
30 | Blade Seal-bottum plate |  | AISI 304 | 0.7 | 4 | 2.8
31 | Blade Seal plate |  | AISI 304 | 0.4 | 2 | 0.8
32 | Blade Seal-bottum plate-2 |  | AISI 304 | 0.6 | 4 | 2.4
33 | Blade Seal plate-2 |  | AISI 304 | 0.3 | 2 | 0.6
34 | Blade Seal-bottum plate-3 |  | AISI 304 | 0.1 | 8 | 0.8
51 | Blade Seal plate-3 |  | AISI 304 | 0 | 4 | 0
36 | Blade seal plate bolting (M6 x25) |  | AISI 304 |  | 60 | 0
37 | Blade shaft-3 |  | AISI 304 | 15.4 | 1 | 15.4
38 | Rotating arm-L |  | ASTM A36 Steel | 1.24 | 1 | 1.24
39 | Driver Shaft key |  | ASTM A36 Steel | 0.08 | 1 | 0.08
40 | Linear Actuator |  |  |  | 1 | 0
41 | Swivel flange |  |  |  | 1 | 0
42 | Rod Clevis |  |  |  | 1 | 0
43 | Arm-actuator |  | ASTM A36 Steel | 3.35 | 1 | 3.35
35 | Actuator-support |  | ASTM A36 Steel | 25.4 | 1 | 25.4
45 | Base flange |  | AISI 304 | 1.7 | 1 | 1.7
46 | Base flange-arm |  | AISI 304 | 0.6 | 2 | 1.2
47 | Adjustable rod |  | ASTM A106 | 0.64 | 1 | 0.64
48 | Fix nut-LH |  | ASTM A36 |  | 1 | 0
49 | Fix nut-RH |  | ASTM A36 |  | 1 | 0
50 | Adjusting nut-RH |  | Dacromet |  | 1 | 0
51 | Adjusting nut-LH |  | Dacromet |  | 1 | 0
52 | Fork lever LH |  | ASTM A36 | 0.9 | 1 | 0.9
53 | Fork lever RH |  | ASTM A36 | 0.9 | 1 | 0.9
54 | Fork lever Bolting-S (M16 x 70) |  | Dacromet |  | 2 | 0
