koalium/centidocs/Rezaei/90005/90005-damper valve/BOM from solid.xlsx

PART LIST FOR "ONE UNIT"
Item NO. | Part name | Description | Material | Weight | QTY. | T.Weight
1 | Damper ring |  | AISI 304 | 79.8 | 1 | 79.8
2 | Frame flange |  | AISI 304 | 49.5 | 2 | 99
3 | Airseal-H |  | AISI 304 | 10.9 | 2 | 21.8
4 | Airseal-V |  | AISI 304 | 4.2 | 2 | 8.4
5 | Refractory cement |  | Refractory cement | 130.5 | 1 | 130.5
6 | Bearing-flange1 |  | AISI 304 | 3.3 | 4 | 13.2
7 | Bearing-seat-plate |  | AISI 304 | 5.7 | 4 | 22.8
8 | Bearing(ucf210) |  |  |  | 4 | 0
9 | Gland-flange F |  | ASTM A36 Steel | 4.23 | 4 | 16.92
10 | Gland-flange-M |  | Cast Carbon Steel | 2.05 | 4 | 8.2
11 | gland-packing |  | A-Glass Fiber | 0.4 | 4 | 1.6
12 | Gland Pcking Bolting (M12x60) |  | Dacromet |  | 8 | 0
13 | Mirrorbearing-flange1 |  | AISI 304 | 3.3 | 4 | 13.2
14 | Bearing base plate Bolting (M14 x 50) |  | AISI 304 |  | 16 | 0
15 | Bearing S.P. bolting (M16 x40) |  | AISI 304 |  | 16 | 0
16 | Frame-pipe |  | AISI 304 | 10.9 | 1 | 10.9
17 | Blade-up plate |  | AISI 304 | 22.3 | 2 | 44.6
18 | Blade-bottum plate |  | AISI 304 | 26.6 | 2 | 53.2
19 | Blade-pipe |  | AISI 304 | 11.4 | 2 | 22.8
20 | Blade-reinforce1 |  | AISI 304 | 1.2 | 8 | 9.6
21 | Blade-reinforce2 |  | AISI 304 | 1.5 | 8 | 12
22 | Blade pipe bolting (M20 x 90) |  | AISI 304 |  | 8 | 0
23 | Blade shaft-1 |  | AISI 304 | 11.8 | 2 | 23.6
24 | Blade shaft-2 |  | AISI 304 | 12.6 | 1 | 12.6
25 | Rotating Arm-R |  | ASTM A36 Steel | 1.24 | 1 | 1.24
26 | Shaft-arm Bolt(S. head cap-M10 x 16) |  | Dacromet |  | 2 | 0
27 | Driven shaft key |  | ASTM A36 Steel | 0.05 | 2 | 0.1
28 | Blade shaft-3 |  | AISI 304 | 15.4 | 1 | 15.4
29 | Rotating arm-L |  | ASTM A36 Steel | 1.24 | 1 | 1.24
30 | Driver Shaft key |  | ASTM A36 Steel | 0.08 | 1 | 0.08
31 | Linear Actuator |  |  |  | 1 | 0
32 | Swivel flange |  |  |  | 1 | 0
33 | Rod Clevis |  |  |  | 1 | 0
34 | Arm-actuator |  | ASTM A36 Steel | 3.35 | 1 | 3.35
35 | Actuator-support |  | AISI 304 | 25.9 | 1 | 25.9
36 | Base flange |  | AISI 304 | 1.7 | 1 | 1.7
37 | Base flange-arm |  | AISI 304 | 0.6 | 2 | 1.2
38 | Adjustable rod |  | ASTM A106 | 0.64 | 1 | 0.64
39 | Fix nut-LH |  | ASTM A36 |  | 1 | 0
40 | Fix nut-RH |  | ASTM A36 |  | 1 | 0
41 | Adjusting nut-RH |  | Dacromet |  | 1 | 0
42 | Adjusting nut-LH |  | Dacromet |  | 1 | 0
43 | Fork lever LH |  | ASTM A36 | 0.9 | 1 | 0.9
44 | Fork lever RH |  | ASTM A36 | 0.9 | 1 | 0.9
45 | Fork lever Bolting-S (M16 x 70) |  | Dacromet |  | 2 | 0
46 | Blade Seal-bottum plate |  | AISI 304 | 0.7 | 4 | 2.8
47 | Blade Seal plate |  | AISI 304 | 0.4 | 2 | 0.8
48 | Blade Seal-bottum plate-2 |  | AISI 304 | 0.6 | 4 | 2.4
49 | Blade Seal plate-2 |  | AISI 304 | 0.3 | 2 | 0.6
50 | Blade Seal-bottum plate-3 |  | AISI 304 | 0.1 | 8 | 0.8
51 | Blade Seal plate-3 |  | AISI 304 | 0 | 4 | 0
52 | Blade seal plate bolting (M6 x25) |  | AISI 304 |  | 60 | 0
