koalium/centidocs/Q.C/Mashi/00.07.01/9210 BB7218 BOM-MTO.xlsx

SP Pos | زیر محصول Sub Product | تعداد زیر محصول در محصول SPQ | Asm Pos | مجموعه Sub. Asmbl | تعداد مجموعه در زیر محصول ASQ | Pos | Part Code | Part | Material | Standard | Mat Spec | کد انبار مواد MATWHC | تعداد قطعه در مجموعهPQAS | تعداد قطعه در زیر محصول PQSP | تعداد قطعه در محصول PQP | مقدار ناخالص مواد در یک قطعه MATQU | واحد شمارش مواد MATU | مقدار ناخاص مواد در یک واحد محصول MATQT
01 | Housing | 1 | 00 | 0 | 1 | 01 | 010001 | Housing | Cast Steel | St-52 | 7218x175mm | 219000001 | 1 | 1 | 1 | 39.6 | Kg | 39.6
01 | Housing | 1 | 00 | 0 | 1 | 02 | 010002 | Upper Cap | Cast Iron | GG-25 | 18 | 218100002 | 1 | 1 | 1 | 12.6 | Kg | 12.6
01 | Housing | 1 | 00 | 0 | 1 | 03 | 010003 | Lower Cap | Cast Iron | GG-25 | 18 | 218100002 | 1 | 1 | 1 | 12.6 | Kg | 12.6
01 | Housing | 1 | 00 | 0 | 1 | 04 | 010004 | Name Plate | Plate | SS 304 | 3x80x50 | 180300100 | 1 | 1 | 1 | 0.08 | Kg | 0.08
01 | Housing | 1 | 00 | 0 | 1 | 05 | 010005 | Cap 'Bolt | Hex Bolt Dacromet | 8.8 | M10x80 | 11011080 | 8 | 8 | 8 | 1 | Pcs | 8
01 | Housing | 1 | 00 | 0 | 1 | 06 | 010006 | Cap Bolt | Hex Bolt Dacromet | 8.8 | M10x70 | 11011070 | 4 | 4 | 4 | 1 | Pcs | 4
01 | Housing | 1 | 00 | 0 | 1 | 07 | 010007 | Cap 'Nut | Hex Nut Dacromet | 8 | M10 | 12010010 | 12 | 12 | 12 | 1 | Pcs | 12
01 | Housing | 1 | 00 | 0 | 1 | 08 | 010008 | Cap Washer | Spring Dacromet | F | A10 | 12111010 | 12 | 12 | 12 | 1 | Pcs | 12
01 | Housing | 1 | 00 | 0 | 1 | 09 | 010009 | Sealing | Packing | Rubber | 10x90x110 | 220690110 | 1 | 1 | 1 | 1 | Pcs | 1
01 | Housing | 1 | 00 | 0 | 1 | 10 | 010010 | Sealing | Packing | Rubber | 10x85x100 | 220685100 | 1 | 1 | 1 | 1 | Pcs | 1
01 | Housing | 1 | 00 | 0 | 1 | 11 | 010011 | Grease | Alvania | - | G2 | 68500011 | 1 | 1 | 1 | 0.85 | Kg | 0.85
01 | Housing | 1 | 00 | 0 | 1 | 12 | 010012 | Backing Ring | Plate | St-37 | 20x170x170 | 132000150 | 2 | 2 | 2 | 5.15 | Kg | 10.3
01 | Housing | 1 | 00 | 0 | 1 | 13 | 010013 | Sealing | Victory | - | 0.5xØ228 | 200900225 | 2 | 2 | 2 | 1 | Pcs | 2
01 | Housing | 1 | 00 | 0 | 1 | 14 | 010014 | Sealing | Linear | Bronze | 0.1xØ100 | 200900090 | 1 | 1 | 1 | 1 | Pcs | 1
01 | Housing | 1 | 00 | 0 | 1 | 15 | 010015 | Name Plate | Engraving | Out Sourcing | - | 200900003 | 1 | 1 | 1 | 1 | Pcs | 1
02 | Shaft | 1 | 00 | 0 | 1 | 01 | 020001 | Shaft | Round Bar | Ck-45 | Ø110x635 | 257100110 | 1 | 1 | 1 | 47.3 | Kg | 47.3
02 | Shaft | 1 | 00 | 0 | 1 | 02 | 020002 | Bolt | Hex Bolt Dacromet | 8.8 | M20x40 | 11012040 | 2 | 2 | 2 | 1 | Pcs | 2
02 | Shaft | 1 | 00 | 0 | 1 | 03 | 020003 | Washer | Spring Dacromet | F | A20 | 12111020 | 2 | 2 | 2 | 1 | Pcs | 2
02 | Shaft | 1 | 00 | 0 | 1 | 04 | 020004 | Stop Washer | Plate | St-37 | 4x90x90 | 130400100 | 1 | 1 | 1 | 0.31 | Kg | 0.31
02 | Shaft | 1 | 00 | 0 | 1 | 05 | 020005 | Key | Parallel Key | St-52 | 12x20x120 | 980030110 | 2 | 2 | 2 | 1 | Pcs | 2
03 | Rotary | 1 | 00 | 0 | 1 | 01 | 030001 | Bearing | Bearing | - | NU 7218 | 200400218 | 1 | 1 | 1 | 1 | Pcs | 1
03 | Rotary | 1 | 00 | 0 | 1 | 02 | 030002 | Bearing | Bearing | BEDBP | 7218 | 200107218 | 2 | 2 | 2 | 1 | Pcs | 2
03 | Rotary | 1 | 00 | 0 | 1 | 03 | 030003 | Lock Washer | Lock Washer | SS 304 | MB-18 | 200300018 | 1 | 1 | 1 | 1 | Pcs | 1
03 | Rotary | 1 | 00 | 0 | 1 | 04 | 030004 | Ring | Retaining Ring | External | 86x2.5 | 133100085 | 1 | 1 | 1 | 1 | Pcs | 1
03 | Rotary | 1 | 00 | 0 | 1 | 05 | 030005 | Lock Nut | Plate | St-37 | 20x140x140 | 132000150 | 1 | 1 | 1 | 3.92 | Kg | 3.92
04 | Packing | 1 | 00 | 0 | 1 | 01 | 040001 | Packing | Lumber | Wood | 25x100x4000 | 320104000 | 1 | 1 | 1 | 1 | Pcs | 1
04 | Packing | 1 | 00 | 0 | 1 | 02 | 040002 | Packing | Slab | Wood | 60x60x2000 | 330104000 | 1 | 1 | 1 | 1 | Pcs | 1
05 | Paint | 1 | 00 | 0 | 1 | 01 | 050001 | Primer | Zinc Rich Epoxy | - | - | 683900001 | 1 | 1 | 1 | 1 | Kg | 1
05 | Paint | 1 | 00 | 0 | 1 | 02 | 050002 | Intermediate | Epoxy Polyamide | - | - | 683900043 | 1 | 1 | 1 | 0.75 | Kg | 0.75
05 | Paint | 1 | 00 | 0 | 1 | 03 | 050003 | Finish | Polyurethane | - | - | 683900020 | 1 | 1 | 1 | 0.5 | Kg | 0.5
05 | Paint | 1 | 00 | 0 | 1 | 04 | 050004 | Thinner | Epoxy | - | - | 683900008 | 1 | 1 | 1 | 1.5 | Liter | 1.5
05 | Paint | 1 | 00 | 0 | 1 | 05 | 050005 | Thinner | Polyurethane | - | - | 683900005 | 1 | 1 | 1 | 1 | Liter | 1
