koalium/centidocs/Q.C/Shooli/Pricing/CiiFog Format BOM-MTO.xlsx

Pos. | Station | Width | Height | Depth | Air V m/sec | Flow m3/h | CiiFog | Qty./ Station
1 | VE1 |  |  |  |  | 60 | 8040 | 1
2 | SE1 |  |  |  |  | 70 | 8040 | 1
3 | VE2 |  |  |  |  | 65 | 8040 | 1
4 | SE2 |  |  |  |  | 73 | 8040 | 1
5 | VE3 |  |  |  |  | 60 | 8040 | 1
6 | SE3 |  |  |  |  | 70 | 8040 | 1
7 | VE4 |  |  |  |  | 65 | 8040 | 1
8 | SE4 |  |  |  |  | 73 | 8040 | 1
9 | VE5 |  |  |  |  | 60 | 8040 | 1
10 | SE5 |  |  |  |  | 70 | 8040 | 1
11 | VE6 |  |  |  |  | 65 | 8040 | 1
12 | SE6 |  |  |  |  | 73 | 8040 | 1
13 | VE7 |  |  |  |  | 60 | 8040 | 1
14 | SE7 |  |  |  |  | 70 | 8040 | 1
15 | VE8 |  |  |  |  | 65 | 8040 | 1
16 | SE8 |  |  |  |  | 73 | 8040 | 1
17 | VE9 |  |  |  |  | 73 | 8040 | 1
18 | SE9 |  |  |  |  | 73 | 8040 | 1
19 | VE10 |  |  |  |  | 65 | 8040 | 1
20 | SE10 |  |  |  |  | 73 | 8040 | 1
 |  |  |  |  |  |  |  | 20
 | Summary
 | Type | Flow m3/h | Qty.
 | 8040 | 60 | 4
 | 8040 | 65 | 5
 | 8040 | 70 | 4
 | 8040 | 73 | 7
 | Total |  | 20
 | CiiFOG | Type | 60
 | Product | Product Per Order | Sub Product | S.product/ Product | S.product/ Order | S.product/ Code | Remarks
 | 8040 | 4 | Manifold | 2 | 8 | 804001 | SS 304
 | 8040 | 4 | Nozzle Bank | 4 | 16 | 804002 | 4 lit/min
 | 8040 | 4 | Pump Unit | 1 | 4 | 804003 | 70 bar
 | 8040 | 4 | Air Baffle | 1 | 4 | 804004 | Turbo SS
 | 8040 | 4 | Eliminator | 1 | 4 | 804005 | Stainless
 | 8040 | 4 | Ladder | 1 | 4 | 804006 | Aluminum
 | 8040 | 4 | Door | 2 | 8 | 804007 | Stainless
 | 8040 | 4 | Control Unit | 1 | 4 | 804008 | 63A
 | CiiFOG | Type | 65
 | Product | Product Per Order | Sub Product | S.product/ Product | S.product/ Order | S.product/ Code | Remarks
 | 8040 | 5 | Manifold | 2 | 10 | 804001 | SS 304
 | 8040 | 5 | Nozzle Bank | 4 | 20 | 804002 | 4 lit/min
 | 8040 | 5 | Pump Unit | 1 | 5 | 804003 | 80 bar
 | 8040 | 5 | Air Baffle | 1 | 5 | 804004 | Baffle SS
 | 8040 | 5 | Eliminator | 1 | 5 | 804005 | ABS
 | 8040 | 5 | Ladder | 1 | 5 | 804006 | Aluminum
 | 8040 | 5 | Door | 2 | 10 | 804007 | HDG
 | 8040 | 5 | Control Unit | 1 | 5 | 804008 | 63A
 | CiiFOG | Type | 70
 | Product | Product Per Order | Sub Product | S.product/ Product | S.product/ Order | S.product/ Code | Remarks
 | 8040 | 4 | Manifold | 3 | 12 | 804001 | SS 304
 | 8040 | 4 | Nozzle Bank | 6 | 24 | 804002 | 6 lit/min
 | 8040 | 4 | Pump Unit | 2 | 8 | 804003 | 80 bar
 | 8040 | 4 | Air Baffle | 1 | 4 | 804004 | Turbulator
 | 8040 | 4 | Eliminator | 1 | 4 | 804005 | Stainless
 | 8040 | 4 | Ladder | 1 | 4 | 804006 | Aluminum
 | 8040 | 4 | Door | 2 | 8 | 804007 | Stainless
 | 8040 | 4 | Control Unit | 1 | 4 | 804008 | 63A
 | CiiFOG | Type | 73
 | Product | Product Per Order | Sub Product | S.product/ Product | S.product/ Order | S.product/ Code | Remarks
 | 8040 | 7 | Manifold | 3 | 21 | 804001 | SS 304
 | 8040 | 7 | Nozzle Bank | 6 | 42 | 804002 | 6 lit/min
 | 8040 | 7 | Pump Unit | 1 | 7 | 804003 | 80 bar
 | 8040 | 7 | Air Baffle | 1 | 7 | 804004 | Turbulator
 | 8040 | 7 | Eliminator | 1 | 7 | 804005 | Stainless
 | 8040 | 7 | Ladder | 1 | 7 | 804006 | Aluminum
 | 8040 | 7 | Door | 2 | 14 | 804007 | Stainless
 | 8040 | 7 | Control Unit | 1 | 7 | 804008 | 63A
