koalium/centidocs/Q.C/Shooli/Pricing/Scope of Order Template.xlsx

Pos. | Station | Width | Height | Depth | Air V m/sec | Flow m3/h | CiiFog | Qty./ Station
1 |  | 4400 | 4200 | 5000 | 2.71 | 180000 | 8040 | 12
2 |  | 4400 | 4200 | 5500 | 4.87 | 324000 | 8040 | 6
Summary
Type | Flow m3/h | Qty.
8040 | 50 | 12
8040 | 90 | 6
Total |  | 18
CiiFOG | Type | 50
Product | Product Per Order | Sub Product | S.product/ Product | S.product/ Order | S.product/ Code | Remarks
8040 | 12 | Manifold | 2 | 24 | 804001 | SS 316
8040 | 12 | Nozzle Bank | 2 | 24 | 804002 | 0.105 lit/min
8040 | 12 | Pump Unit | 2 | 24 | 804003 | 70 bar
8040 | 12 | Air Baffle | 1 | 12 | 804004 | BaffleABS
8040 | 12 | Eliminator | 1 | 12 | 804005 | ABS
8040 | 12 | Ladder | 1 | 12 | 804006 | Aluminum
8040 | 12 | Door | 1 | 12 | 804007 | SS 316
8040 | 12 | Control Unit | 1 | 12 | 804008 | 32A
CiiFOG | Type | 90
Product | Product Per Order | Sub Product | S.product/ Product | S.product/ Order | S.product/ Code | Remarks
8040 | 6 | Manifold | 2 | 12 | 804001 | SS 316
8040 | 6 | Nozzle Bank | 2 | 12 | 804002 | 0.105 lit/min
8040 | 6 | Pump Unit | 2 | 12 | 804003 | 70 bar
8040 | 6 | Air Baffle | 1 | 6 | 804004 | BaffleABS
8040 | 6 | Eliminator | 1 | 6 | 804005 | ABS
8040 | 6 | Ladder | 1 | 6 | 804006 | Aluminum
8040 | 6 | Door | 1 | 6 | 804007 | SS 316
8040 | 6 | Control Unit | 1 | 6 | 804008 | 32A
