koalium/centidocs/Rezaei/17153/Doc/BOM/BOM-400-102-202.xlsx

Bill of Material (B.O.M.) |  |  |  |  |  |  |  | Centigrade Ind. Inc.
Order NO.17153-400-102-202 |  | Product : Fan Ring & Plenum |  |  | Client : Aban Air Cooler
Contract NO.: |  | Contract Date : |  |  | Delivery Date :
محصول |  | زیر محصول |  |  |  | قطعه
کد محصول | تعداد در سفارش | کد زیر محصول | شرح | تعداد در محصول | تعداد در سفارش | پیش کد محصول | شمارنده | شرح | تعداد در زیر محصول | تعداد در محصول | تعداد در سفارش
--- | --- | --- | Plenum | 1 | 4 | --- | 1 | 1L | 2 | 2 | 8
--- | --- | --- | --- | --- | --- | --- | 2 | 1R | 2 | 2 | 8
--- | --- | --- | --- | --- | --- | --- | 3 | 2L | 2 | 2 | 8
--- | --- | --- | --- | --- | --- | --- | 4 | 2R | 2 | 2 | 8
--- | --- | --- | --- | --- | --- | --- | 5 | 3L | 2 | 2 | 8
--- | --- | --- | --- | --- | --- | --- | 6 | 3R | 2 | 2 | 8
--- | --- | --- | --- | --- | --- | --- | 7 | 3M | 2 | 2 | 8
--- | --- | --- | Fan Ring | 1 | 4 | --- | 1 | Ring Sector | 4 | 4 | 16
--- | --- | --- | --- | --- | --- | --- | 2 | Cone | 8 | 8 | 32
--- | --- | --- | --- | --- | --- | --- | 3 | Side Flange | 8 | 8 | 32
--- | --- | --- | --- | --- | --- | --- | 4 | Support Motor | 4 | 4 | 16
--- | --- | --- | --- | --- | --- | --- | 5 | Upper Flange | 8 | 8 | 32
