koalium/centidocs/jokar/Savin BOM For Edit/10122-AC1-BOM.xlsx

Sheet: Building
محصول |  |  |  | زیرمحصول |  |  | مجموعه |  |  |  |  | قطعه |  |  |  |  |  | فرآیند
کد محصول | تعداد در سفارش | کد زیر محصول | شرح | تعداد در محصول | تعداد در سفارش | کد مجموعه | شرح | تعداد در زیر محصول | تعداد در سفارش | شمارنده | شرح | مشخصات | تعداد در زیر محصول | تعداد در محصول | تعداد در سفارش | مقدار خالص | واحد | نفر ساعت
 | 1 |  | سرریز | 1 | 1 |  |  |  |  | 1 | لوله | - | 1 | 1 | 1
 |  |  |  |  |  |  |  |  |  | 2 | سری | - | 1 | 1 | 1
 |  |  |  |  |  |  |  |  |  | 3 | لاستیک سرریز | - | 1 | 1 | 1
 |  |  |  |  |  |  |  |  |  | 4 | پیچ شش گوش |  | 2 | 2 | 2
 |  |  |  |  |  |  |  |  |  | 5 | مهره |  | 6 | 6 | 6

Sheet: Instrument
محصول |  |  |  | زیرمحصول |  |  | مجموعه |  |  |  |  | قطعه |  |  |  |  |  | فرآیند
کد محصول | تعداد در سفارش | کد زیر محصول | شرح | تعداد در محصول | تعداد در سفارش | کد مجموعه | شرح | تعداد در زیر محصول | تعداد در سفارش | شمارنده | شرح | مشخصات | تعداد در زیر محصول | تعداد در محصول | تعداد در سفارش | مقدار خالص | واحد | نفر ساعت
 |  |  | ابزار دقیق |  |  |  |  |  |  | 1 | شیر بخار برقی | 2way- 2" Valve Linkage- | 1 | 1 | 1 | 1 | Pcs
 |  |  |  |  |  |  |  |  |  | 2 | سنسور دما | - | 2 | 2 | 2 | 2 | Pcs
 |  |  |  |  |  |  |  |  |  | 3 | سنسور رطوبت | - | 2 | 2 | 2 | 2 | Pcs
 |  |  |  |  |  |  |  |  |  | 4 | میکرو سوییچ | فشنگی | 4 | 4 | 4 | 4 | Pcs

Sheet: Pumping
محصول |  |  |  | زیرمحصول |  |  | مجموعه |  |  |  |  | قطعه |  |  |  |  |  | فرآیند
کد محصول | تعداد در سفارش | کد زیر محصول | شرح | تعداد در محصول | تعداد در سفارش | کد مجموعه | شرح | تعداد در زیر محصول | تعداد در سفارش | شمارنده | شرح | مشخصات | تعداد در زیر محصول | تعداد در محصول | تعداد در سفارش | مقدار خالص | واحد | نفر ساعت
 |  |  | سیستم آبرسانی |  |  |  | الکترو پمپ | 1 | 1 | 1 | الکترو موتور 3 فاز | 37Kw-1500rpm | 1 | 1 | 1 | 1 | Pcs
 |  |  |  |  |  |  |  |  |  | 2 | پمپ | EN 150-315 | 1 | 1 | 1 | 1 | Pcs
 |  |  |  |  |  |  |  |  |  | 3 | شاسی | مطابق الکترو پمپ | 1 | 1 | 1 | 1 | Pcs
 |  |  |  |  |  |  |  |  |  | 4 | کوپلینگ | 140 | 1 | 1 | 1 | 1 | Pcs

Sheet: Damper
محصول |  |  |  | زیرمحصول |  |  | مجموعه |  |  |  |  | قطعه |  |  |  |  |  | فرآیند
کد محصول | تعداد در سفارش | کد زیر محصول | شرح | تعداد در محصول | تعداد در سفارش | کد مجموعه | شرح | تعداد در زیر محصول | تعداد در سفارش | شمارنده | شرح | مشخصات | تعداد در زیر محصول | تعداد در محصول | تعداد در سفارش | مقدار خالص | واحد | نفر ساعت
 |  |  |  |  |  |  | Damper (Exhaust, Fresh, Return) | 1 | 9 | 1 | قاب عرضی | 1.5x370x1520 | 2 | 2 |  |  | Kg
 |  |  |  |  |  |  |  |  |  | 2 | قاب طولی | 1.5x370x1832 | 2 | 2 |  |  | Kg
 |  |  |  |  |  |  |  |  |  | 3 | بازو | 2x70x1750 | 2 | 2 |  |  | Kg
 |  |  |  |  |  |  |  |  |  | 4 | نبشی اتصال قاب | 1.5x40x220 | 4 | 4 |  |  | Kg
 |  |  |  |  |  |  |  |  |  | 5 | تیغه دمپر | 1520 | 12 | 12 |  |  | Kg
 |  |  |  |  |  |  |  |  |  | 6 | بادامک | -- | 12 | 12 |  |  | Pcs
 |  |  |  |  |  |  |  |  |  | 7 | واسطه چهار گوش | -- | 12 | 12 |  |  | Pcs
 |  |  |  |  |  |  |  |  |  | 8 | فشنگی | -- | 12 | 12 |  |  | Pcs
 |  |  |  |  |  |  |  |  |  | 9 | نوار دمپر | 1832 | 2 | 2 |  |  | Kg
 |  |  |  |  |  |  |  |  |  | 10 | گوشک | -- | 8 | 8 |  |  | Pcs
 |  |  |  |  |  |  |  |  |  | 11 | پیچ آلن مخروطی | M10x15 | 12 | 12 |  |  | Pcs
 |  |  |  |  |  |  |  |  |  | 13 | واشر تخت | A12 OD30 | 12 | 12 |  |  | Pcs
 |  |  |  |  |  |  |  |  |  | 14 | مهره چهار گوش | M10 | 12 | 12 |  |  | Kg
 |  |  |  |  |  |  |  |  |  | 15 | بوش تفلون | -- | 24 | 24 |  |  | Pcs
 |  |  |  |  |  |  |  |  |  | 16 | اشپیل | 2.6x30 | 12 | 12 |  |  | Pcs
 |  |  |  |  |  |  |  |  |  | 17 | پیچ شش گوش | M10x15 | 32 | 32 |  |  | Pcs
 |  |  |  |  |  |  |  |  |  | 18 | مهره شش گوش | M10 | 32 | 32 |  |  | Pcs
 |  |  |  |  |  |  |  |  |  | 19 | نبشی اتصال به دیوار | 40x40x50 | 4 | 4 |  |  | Kg
 |  |  |  |  |  |  |  |  |  | 20 | دمپر موتور | 32 N.m. | 1 | 1 |  |  | Pcs
محصول |  |  |  | زیرمحصول |  |  | مجموعه |  |  |  |  | قطعه |  |  |  |  |  | فرآیند
کد محصول | تعداد در سفارش | کد زیر محصول | شرح | تعداد در محصول | تعداد در سفارش | کد مجموعه | شرح | تعداد در زیر محصول | تعداد در سفارش | شمارنده | شرح | مشخصات | تعداد در زیر محصول | تعداد در محصول | تعداد در سفارش | مقدار خالص | واحد | نفر ساعت
 |  |  |  |  |  |  | Damper (Exhaust, Fresh, Return) | 1 | 9 | 1 | قاب عرضی | 1.5x370x1520 | 2 | 2 |  |  | Kg
 |  |  |  |  |  |  |  |  |  | 2 | قاب طولی | 1.5x370x1832 | 2 | 2 |  |  | Kg
 |  |  |  |  |  |  |  |  |  | 3 | بازو | 2x70x1750 | 2 | 2 |  |  | Kg
 |  |  |  |  |  |  |  |  |  | 4 | نبشی اتصال قاب | 1.5x40x220 | 4 | 4 |  |  | Kg
 |  |  |  |  |  |  |  |  |  | 5 | تیغه دمپر | 1520 | 12 | 12 |  |  | Kg
 |  |  |  |  |  |  |  |  |  | 6 | بادامک | -- | 12 | 12 |  |  | Pcs
 |  |  |  |  |  |  |  |  |  | 7 | واسطه چهار گوش | -- | 12 | 12 |  |  | Pcs
 |  |  |  |  |  |  |  |  |  | 8 | فشنگی | -- | 12 | 12 |  |  | Pcs
 |  |  |  |  |  |  |  |  |  | 9 | نوار دمپر | 1832 | 2 | 2 |  |  | Kg
 |  |  |  |  |  |  |  |  |  | 10 | گوشک | -- | 8 | 8 |  |  | Pcs
 |  |  |  |  |  |  |  |  |  | 11 | پیچ آلن مخروطی | M10x15 | 12 | 12 |  |  | Pcs
 |  |  |  |  |  |  |  |  |  | 13 | واشر تخت | A12 OD30 | 12 | 12 |  |  | Pcs
 |  |  |  |  |  |  |  |  |  | 14 | مهره چهار گوش | M10 | 12 | 12 |  |  | Kg
 |  |  |  |  |  |  |  |  |  | 15 | بوش تفلون | -- | 24 | 24 |  |  | Pcs
 |  |  |  |  |  |  |  |  |  | 16 | اشپیل | 2.6x30 | 12 | 12 |  |  | Pcs
 |  |  |  |  |  |  |  |  |  | 17 | پیچ شش گوش | M10x15 | 32 | 32 |  |  | Pcs
 |  |  |  |  |  |  |  |  |  | 18 | مهره شش گوش | M10 | 32 | 32 |  |  | Pcs
 |  |  |  |  |  |  |  |  |  | 19 | نبشی اتصال به دیوار | 40x40x50 | 4 | 4 |  |  | Kg
محصول |  |  |  | زیرمحصول |  |  | مجموعه |  |  |  |  | قطعه |  |  |  |  |  | فرآیند
کد محصول | تعداد در سفارش | کد زیر محصول | شرح | تعداد در محصول | تعداد در سفارش | کد مجموعه | شرح | تعداد در زیر محصول | تعداد در سفارش | شمارنده | شرح | مشخصات | تعداد در زیر محصول | تعداد در محصول | تعداد در سفارش | مقدار خالص | واحد | نفر ساعت
 |  |  | دمپر |  |  |  | Damper (Filter Plant 1) | 1 | 2 | 1 | قاب عرضی | 1.5x370x1520 | 2 | 2
 |  |  |  |  |  |  |  |  |  | 2 | قاب طولی | 1.5x370x1832 | 2 | 2
 |  |  |  |  |  |  |  |  |  | 3 | بازو | 2x70x1750 | 2 | 2
 |  |  |  |  |  |  |  |  |  | 4 | نبشی اتصال قاب | 1.5x40x220 | 4 | 4
 |  |  |  |  |  |  |  |  |  | 5 | تیغه دمپر | 1520 | 12 | 12
 |  |  |  |  |  |  |  |  |  | 6 | بادامک | -- | 12 | 12
 |  |  |  |  |  |  |  |  |  | 7 | واسطه چهار گوش | -- | 12 | 12
 |  |  |  |  |  |  |  |  |  | 8 | فشنگی | -- | 12 | 12
 |  |  |  |  |  |  |  |  |  | 9 | نوار دمپر | 1832 | 2 | 2
 |  |  |  |  |  |  |  |  |  | 10 | گوشک | -- | 8 | 8
 |  |  |  |  |  |  |  |  |  | 11 | پیچ آلن مخروطی | M10x15 | 12 | 12
 |  |  |  |  |  |  |  |  |  | 13 | واشر تخت | A12 OD30 | 12 | 12
 |  |  |  |  |  |  |  |  |  | 14 | مهره چهار گوش | M10 | 12 | 12
 |  |  |  |  |  |  |  |  |  | 15 | بوش تفلون | -- | 24 | 24
 |  |  |  |  |  |  |  |  |  | 16 | اشپیل | 2.6x30 | 12 | 12
 |  |  |  |  |  |  |  |  |  | 17 | پیچ شش گوش | M10x15 | 32 | 32
 |  |  |  |  |  |  |  |  |  | 18 | مهره شش گوش | M10 | 32 | 32
 |  |  |  |  |  |  |  |  |  | 19 | نبشی اتصال به دیوار | 40x40x50 | 4 | 4
محصول |  |  |  | زیرمحصول |  |  | مجموعه |  |  |  |  | قطعه |  |  |  |  |  | فرآیند
کد محصول | تعداد در سفارش | کد زیر محصول | شرح | تعداد در محصول | تعداد در سفارش | کد مجموعه | شرح | تعداد در زیر محصول | تعداد در سفارش | شمارنده | شرح | مشخصات | تعداد در زیر محصول | تعداد در محصول | تعداد در سفارش | مقدار خالص | واحد | نفر ساعت
 | 1 |  | دمپر |  |  |  | Damper (Filter Plant 2) | 1 | 1 | 1 | قاب عرضی | 1.5x370x1520 | 2 | 2
 |  |  |  |  |  |  |  |  |  | 2 | قاب طولی | 1.5x370x1832 | 2 | 2
 |  |  |  |  |  |  |  |  |  | 3 | بازو | 2x70x1750 | 2 | 2
 |  |  |  |  |  |  |  |  |  | 4 | نبشی اتصال قاب | 1.5x40x220 | 4 | 4
 |  |  |  |  |  |  |  |  |  | 5 | تیغه دمپر | 1520 | 12 | 12
 |  |  |  |  |  |  |  |  |  | 6 | بادامک | -- | 12 | 12
 |  |  |  |  |  |  |  |  |  | 7 | واسطه چهار گوش | -- | 12 | 12
 |  |  |  |  |  |  |  |  |  | 8 | فشنگی | -- | 12 | 12
 |  |  |  |  |  |  |  |  |  | 9 | نوار دمپر | 1832 | 2 | 2
 |  |  |  |  |  |  |  |  |  | 10 | گوشک | -- | 8 | 8
 |  |  |  |  |  |  |  |  |  | 11 | پیچ آلن مخروطی | M10x15 | 12 | 12
 |  |  |  |  |  |  |  |  |  | 13 | واشر تخت | A12 OD30 | 12 | 12
 |  |  |  |  |  |  |  |  |  | 14 | مهره چهار گوش | M10 | 12 | 12
 |  |  |  |  |  |  |  |  |  | 15 | بوش تفلون | -- | 24 | 24
 |  |  |  |  |  |  |  |  |  | 16 | اشپیل | 2.6x30 | 12 | 12
 |  |  |  |  |  |  |  |  |  | 17 | پیچ شش گوش | M10x15 | 32 | 32
 |  |  |  |  |  |  |  |  |  | 18 | مهره شش گوش | M10 | 32 | 32
 |  |  |  |  |  |  |  |  |  | 19 | نبشی اتصال به دیوار | 40x40x50 | 4 | 4
محصول |  |  |  | زیرمحصول |  |  | مجموعه |  |  |  |  | قطعه |  |  |  |  |  | فرآیند
کد محصول | تعداد در سفارش | کد زیر محصول | شرح | تعداد در محصول | تعداد در سفارش | کد مجموعه | شرح | تعداد در زیر محصول | تعداد در سفارش | شمارنده | شرح | مشخصات | تعداد در زیر محصول | تعداد در محصول | تعداد در سفارش | مقدار خالص | واحد | نفر ساعت
 |  |  |  |  |  |  | توری دمپر | 1 | 6 | 1 | نبشی عرض قاب | 3x80x1520 | 2 | 2 | 12 |  | Kg
 |  |  |  |  |  |  |  |  |  | 2 | نبشی طولی قاب | 3x80x3952 | 3 | 3 | 18 |  | Kg
 |  |  |  |  |  |  |  |  |  | 3 | تسمه عرضی | 2x40x1520 | 2 | 2 | 12 |  | Kg
 |  |  |  |  |  |  |  |  |  | 4 | تسمه طولی | 2x40x3952 | 3 | 3 | 18 |  | Kg
 |  |  |  |  |  |  |  |  |  | 5 | توری | 2800x2200 | 1 | 1 | 6 |  | Pcs

Sheet: Static Water Filter
محصول |  |  |  | زیرمحصول |  |  | مجموعه |  |  |  |  | قطعه |  |  |  |  |  | فرآیند
کد محصول | تعداد در سفارش | کد زیر محصول | شرح | تعداد در محصول | تعداد در سفارش | کد مجموعه | شرح | تعداد در زیر محصول | تعداد در سفارش | شمارنده | شرح | مشخصات | تعداد در زیر محصول | تعداد در محصول | تعداد در سفارش | مقدار خالص | واحد | نفر ساعت
 |  |  | فیلتر استاتیک آب |  |  |  | ریل فیلتر | 2 | 2 | 1 | صفحه ریل | 2x170x600 |  |  |  |  | Kg
 |  |  |  |  |  |  |  |  |  | 2 | نبشی ریل | 1.5x27x600 |  |  |  |  | Kg
 |  |  |  |  |  |  | قاب فیلتر | 2 | 2 | 3 | نبشی عرضی داخل | 1.5x'40x700 |  |  |  |  | Kg
 |  |  |  |  |  |  |  |  |  | 4 | نبشی طولی داخل | 1.5x40x600 |  |  |  |  | Kg
 |  |  |  |  |  |  |  |  |  | 5 | نبشی عرضی بیرون | 2x'43x700 |  |  |  |  | Kg
 |  |  |  |  |  |  |  |  |  | 6 | تسمه تقویتی بیرون |  |  |  |  |  | Kg
 |  |  |  |  |  |  |  |  |  | 7 | تسمه تقویتی داخل |  |  |  |  |  | Kg
 |  |  |  |  |  |  |  |  |  | 8 | نبشی طولی بیرون | 2x'43x600 |  |  |  |  | Kg
 |  |  |  |  |  |  |  |  |  | 9 | توری | 600x600 |  |  |  |  | Pcs
 |  |  |  |  |  |  |  |  |  | 10 | دستگیره | Ø8x230 |  |  |  |  | Pcs
 |  |  |  |  |  |  | اتصالات | 1 | 1 | 11 | پیچ دوسو | M5x50 |  |  |  |  | Pcs
 |  |  |  |  |  |  |  |  |  | 12 | رولپلاگ | 6x40 |  |  |  |  | Pcs

Sheet: Inspection Door
محصول |  |  |  | زیرمحصول |  |  | مجموعه |  |  |  |  | قطعه |  |  |  |  |  | فرآیند
کد محصول | تعداد در سفارش | کد زیر محصول | شرح | تعداد در محصول | تعداد در سفارش | کد مجموعه | شرح | تعداد در زیر محصول | تعداد در سفارش | شمارنده | شرح | مشخصات | تعداد در زیر محصول | تعداد در محصول | تعداد در سفارش | مقدار خالص | واحد | نفر ساعت
 |  |  | دریچه بازدید |  |  |  | دریچه بازدید | 1 | 1 | 1 | صفحه بزرگ درب | 1.2x831x831 | 1 | 1 | 1 |  | Kg
 |  |  |  |  |  |  |  |  |  | 2 | صفحه کوچک درب | 1.2x791x791 | 1 | 1 | 1 |  | Kg
 |  |  |  |  |  |  |  |  |  | 3 | ناودانی تقویتی 1 | 1.5x136x708 | 1 | 1 | 1 |  | Kg
 |  |  |  |  |  |  |  |  |  | 4 | قاب عرضی | 2.9x40x40x800 | 2 | 2 | 2 |  | Kg
 |  |  |  |  |  |  |  |  |  | 5 | قاب طولی | 2.9x40x40x2100 | 2 | 2 | 2 |  | Kg
 |  |  |  |  |  |  |  |  |  | 6 | دستگیره 1 | قطعه نیم ساخته | 1 | 1 | 1
 |  |  |  |  |  |  |  |  |  | 7 | دستگیره 2 | قطعه نیم ساخته | 1 | 1 | 1 |  | Pcs
 |  |  |  |  |  |  |  |  |  | 8 | بوش دستگیره | 3/4"x51 | 1 | 1 | 1 |  | Kg
 |  |  |  |  |  |  |  |  |  | 9 | لولا نری | Ø12x110 | 2 | 2 | 2 |  | Kg
 |  |  |  |  |  |  |  |  |  | 10 | لولا مادگی | 16x22x60 | 2 | 2 | 2 |  | Kg
 |  |  |  |  |  |  |  |  |  | 11 | صفحه لولا 1 | 5x50x140 | 2 | 2 | 2 |  | Kg
 |  |  |  |  |  |  |  |  |  | 12 | صفحه لولا 2 | 5x50x90 | 2 | 2 | 2 |  | Kg
 |  |  |  |  |  |  |  |  |  | 13 | پیچ شش گوش | M8x70 |  |  |  |  | Pcs
 |  |  |  |  |  |  |  |  |  | 14 | مهره شش گوش | M8 |  |  |  |  | Pcs
 |  |  |  |  |  |  |  |  |  | 15 | واشر فنری | A8 |  |  |  |  | Pcs
 |  |  |  |  |  |  |  |  |  | 16 | واشر تخت | A8 |  |  |  |  | Pcs
 |  |  |  |  |  |  |  |  |  | 17 | پیچ سر آلن | M6x40 |  |  |  |  | Pcs
 |  |  |  |  |  |  |  |  |  | 18 | فوم | 45x800x800 | 1 | 1 | 1 |  | Pcs
 |  |  |  |  |  |  |  |  |  | 19 | لاستیک اسفنجی | L=3500 | 1 | 1 | 1 |  | Pcs
 |  |  |  |  |  |  |  |  |  | 20 | طلق دریچه بازدید
 |  |  |  |  |  |  |  |  |  | 21 | ریل طلق

Sheet: Ventilation Door
محصول |  |  |  | زیرمحصول |  |  | مجموعه |  |  |  |  | قطعه |  |  |  |  |  | فرآیند
کد محصول | تعداد در سفارش | کد زیر محصول | شرح | تعداد در محصول | تعداد در سفارش | کد مجموعه | شرح | تعداد در زیر محصول | تعداد در سفارش | شمارنده | شرح | مشخصات | تعداد در زیر محصول | تعداد در محصول | تعداد در سفارش | مقدار خالص | واحد | نفر ساعت
 |  |  | در تهویه |  |  |  | در تهویه | 1 | 8 | 1 | صفحه بزرگ درب | 1.2x831x2131 | 1 | 1 | 8 |  | Kg
 |  |  |  |  |  |  |  |  |  | 2 | صفحه کوچک درب | 1.2x791x2091 | 1 | 1 | 8 |  | Kg
 |  |  |  |  |  |  |  |  |  |  | ناودانی تقویتی 1 | 1.5x136x708 | 1 | 1 | 8 |  | Kg
 |  |  |  |  |  |  |  |  |  | 3 | ناودانی تقویتی 2 | 1.5x136x708 | 2 | 2 | 16 |  | Kg
 |  |  |  |  |  |  |  |  |  | 4 | قوطی عرضی قاب | 40x40x800 | 2 | 2 | 16 |  | Kg
 |  |  |  |  |  |  |  |  |  | 5 | قوطی طولی قاب | 40x40x2100 | 2 | 2 | 16 |  | Kg
 |  |  |  |  |  |  |  |  |  |  | دستگیره 1 | قطعه نیم ساخته | 1 | 1 | 8 |  | Pcs
 |  |  |  |  |  |  |  |  |  | 6 | دستگیره 2 | قطعه نیم ساخته | 1 | 1 | 8 |  | Pcs
 |  |  |  |  |  |  |  |  |  | 7 | بوش دستگیره | 3/4" L=55 | 1 | 1 | 8 |  | Kg
 |  |  |  |  |  |  |  |  |  | 8 | لولا نری | Ø12x110 | 3 | 3 | 24 |  | Kg
 |  |  |  |  |  |  |  |  |  | 9 | لولا مادگی | 16x22x60 | 3 | 3 | 24 |  | Kg
 |  |  |  |  |  |  |  |  |  | 10 | صفحه لولا 1 | 5x50x140 | 3 | 3 | 24 |  | Kg
 |  |  |  |  |  |  |  |  |  | 11 | صفحه لولا 2 | 5x50x90 | 3 | 3 | 24 |  | Kg
 |  |  |  |  |  |  |  |  |  | 12 | پیچ شش گوش | M8x70 | 9 | 9 | 72 |  | Pcs
 |  |  |  |  |  |  |  |  |  | 13 | مهره شش گوش | M8 | 9 | 9 | 72 |  | Pcs
 |  |  |  |  |  |  |  |  |  | 14 | واشر فنری | A8 | 9 | 9 | 72 |  | Pcs
 |  |  |  |  |  |  |  |  |  | 15 | واشر تخت | A8 | 18 | 18 | 144 |  | Pcs
 |  |  |  |  |  |  |  |  |  | 16 | پیچ سر آلن | M6x40 | 1 | 1 | 8 |  | Pcs
 |  |  |  |  |  |  |  |  |  | 17 | سیخک | 2.9x40x40x150 | 4 | 4 | 28 |  | Pcs
محصول |  |  |  | زیرمحصول |  |  | مجموعه |  |  |  |  | قطعه |  |  |  |  |  | فرآیند
کد محصول | تعداد در سفارش | کد زیر محصول | شرح | تعداد در محصول | تعداد در سفارش | کد مجموعه | شرح | تعداد در زیر محصول | تعداد در سفارش | شمارنده | شرح | مشخصات | تعداد در زیر محصول | تعداد در محصول | تعداد در سفارش | مقدار خالص | واحد | نفر ساعت
 |  |  |  |  |  |  |  |  |  | 18 | فوم | 40x800x2100 | 1 | 1 | 8 |  | Pcs
 |  |  |  |  |  |  |  |  |  | 19 | طلق بازدید | 3x500x200 | 2 | 2 | 16 |  | Pcs
 |  |  |  |  |  |  |  |  |  | 20 | لاستیک درز گیر طلق | L=1050 | 2 | 2 | 16 |  | Pcs
 |  |  |  |  |  |  |  |  |  | 21 | مغزی درزگیر طلق | L=1050 | 2 | 2 | 16 |  | Pcs
 |  |  |  |  |  |  |  |  |  | 22 | لاستیک اسفنجی | 5x30x6000 | 1 | 1 | 8 |  | Pcs

Sheet: Coil
محصول |  |  |  | زیرمحصول |  |  | مجموعه |  |  |  |  | قطعه |  |  |  |  |  | فرآیند
کد محصول | تعداد در سفارش | کد زیر محصول | شرح | تعداد در محصول | تعداد در سفارش | کد مجموعه | شرح | تعداد در زیر محصول | تعداد در سفارش | شمارنده | شرح | مشخصات | تعداد در زیر محصول | تعداد در محصول | تعداد در سفارش | مقدار خالص | واحد | نفر ساعت
 |  |  | کویل |  |  |  | کویل حرارتی | 1 | 4 | 1 | نبشی قاب عرضی | 4x95x1672 | 4 | 4 | 24 |  | Kg
 |  |  |  |  |  |  |  |  |  | 2 | ناودانی قاب طولی | 4x305x1900 | 2 | 2 | 12 |  | Kg
 |  |  |  |  |  |  |  |  |  | 3 | تیوب شیت | 6x'155x1672 | 2 | 2 | 12 |  | Kg
 |  |  |  |  |  |  |  |  |  | 4 | تیوب | 1/2" x 1450 | 87 | 87 | 522 |  | Kg
 |  |  |  |  |  |  |  |  |  | 5 | کلکتور | 4x150x1672 | 2 | 2 | 12 |  | Kg
 |  |  |  |  |  |  |  |  |  | 6 | درپوش کلکتور | 4x70x142 | 4 | 4 | 24 |  | Kg
 |  |  |  |  |  |  |  |  |  | 7 | فلنج گلویی جوشی | 1" | 2 | 2 | 12 |  | Pcs
 |  |  |  |  |  |  |  |  |  | 8 | لوله کلکتور | 1" L=100 | 2 | 2 | 12 |  | Kg
 |  |  |  |  |  |  |  |  |  | 9 | زانو کلکتور | 1" | 2 | 2 | 12 |  | Pcs
 |  |  |  |  |  |  |  |  |  | 10 | صفحه بادگیر | 2x45x500 | 2 | 2 | 12 |  | Kg
 |  |  |  |  |  |  |  |  |  | 11 | تسمه بادگیر | 2x150x506 | 1 | 1 | 6 |  | Kg
 |  |  |  |  |  |  |  |  |  | 12 | نبشی اتصال | 50x50x80 | 8 | 8 | 32 |  | Kg

Sheet: Nozzle Bank
محصول |  |  |  | زیرمحصول |  |  | مجموعه |  |  |  |  | قطعه |  |  |  |  |  | فرآیند
کد محصول | تعداد در سفارش | کد زیر محصول | شرح | تعداد در محصول | تعداد در سفارش | کد مجموعه | شرح | تعداد در زیر محصول | تعداد در سفارش | شمارنده | شرح | مشخصات | تعداد در زیر محصول | تعداد در محصول | تعداد در سفارش | مقدار خالص | واحد | نفر ساعت
 |  |  | نازل بانک |  |  |  | کلکتور | 4 | 4 | 1 | لوله کلکتور | Ø90x2736 | 4 | 4 | 4 |  | Pcs | -
 |  |  |  |  |  |  |  |  |  | 2 | درپوش کلکتور | - | 8 | 8 | 8 |  | Pcs | -
 |  |  |  |  |  |  |  |  |  | 3 | فلنج جوشی کلکتور | - | 4 | 4 | 4 |  | Pcs | -
 |  |  |  |  |  |  |  |  |  | 4 | فلنج فلزی | - | 4 | 4 | 4 |  | Kg | -
 |  |  |  |  |  |  |  |  |  | 5 | فنجانی کلکتور | - | 36 | 36 | 36 |  | Pcs | -
 |  |  |  |  |  |  |  |  |  | 6 | درپوش فنجانی | - | 36 | 36 | 36 |  | Pcs | -
 |  |  |  |  |  |  |  |  |  | 7 | بوش رایزر | - | 36 | 36 | 36 |  | Pcs | -
 |  |  |  |  |  |  |  |  |  | 8 | اورینگ فنجانی | - | 36 | 36 | 36 |  | Pcs | -
 |  |  |  |  |  |  | رایزر | 36 | 36 | 9 | لوله رایزر | Ø40x4846 | 36 | 36 | 36 |  | Pcs | -
 |  |  |  |  |  |  |  |  |  | 10 | درپوش رایزر | - | 36 | 36 | 36 |  | Pcs | -
 |  |  |  |  |  |  |  |  |  | 11 | بدنه افشانک | - |  |  |  |  | Pcs | -
 |  |  |  |  |  |  |  |  |  | 12 | سری افشانک | - |  |  |  |  | Pcs | -
 |  |  |  |  |  |  |  |  |  | 13 | واشر آب بند | - |  |  |  |  | Pcs | -
 |  |  |  |  |  |  |  |  |  | 14 | بست استیل | - |  |  |  |  | Pcs | -
 |  |  |  |  |  |  |  |  |  | 15 | ناودانی افشانک | - |  |  |  |  | Kg | -
 |  |  |  |  |  |  |  |  |  | 16 | بست شکلاتی | - |  |  |  |  | Pcs | -
 |  |  |  |  |  |  |  |  |  | 17 | نبشی رایزر | 5x50x500 |  |  |  |  | Kg | -
 |  |  |  |  |  |  |  |  |  | 18 | پیچ شش گوش | M6x30 |  |  |  |  | Pcs | -
 |  |  |  |  |  |  |  |  |  | 19 | مهره شش گوش | M6 |  |  |  |  | Pcs | -

Sheet: Air baffle
محصول |  |  |  | زیرمحصول |  |  | مجموعه |  |  |  |  | قطعه |  |  |  |  |  | فرآیند
کد محصول | تعداد در سفارش | کد زیر محصول | شرح | تعداد در محصول | تعداد در سفارش | کد مجموعه | شرح | تعداد در زیر محصول | تعداد در سفارش | شمارنده | شرح | مشخصات | تعداد در زیر محصول | تعداد در محصول | تعداد در سفارش | مقدار خالص | واحد | نفر ساعت
 |  |  | ایربافل |  |  |  |  |  |  | 1 | ناودانی عرضی | 1.5x88x5950 | 2 | 2 | 2 |  | Kg | -
 |  |  |  |  |  |  |  |  |  | 2 | ناودانی طولی | 1.5x84x5045 | 14 | 14 | 14 |  | Kg | -
 |  |  |  |  |  |  |  |  |  | 3 | پیچ دوسو | M5x50 | 30 | 30 | 30 |  | Pcs | -
 |  |  |  |  |  |  |  |  |  | 4 | رولپلاک | 6x40 | 30 | 30 | 30 |  | Pcs | -
 |  |  |  |  |  |  |  |  |  | 5 | شبکه ایربافل | 300x600 | 170 | 170 | 170 |  | Pcs | -
 |  |  |  |  |  |  |  |  |  | 6 | چفت | -- | 170 | 170 | 170 |  | Pcs | -
 |  |  |  |  |  |  |  |  |  | 7 | بست | -- | 170 | 170 | 170 |  | Pcs | -
 |  |  |  |  |  |  |  |  |  | 8 | پیچ شش گوش | M6x40 | 170 | 170 | 170 |  | Pcs | -
 |  |  |  |  |  |  |  |  |  | 9 | مهره | M6 | 170 | 170 | 170 |  | Pcs | -
 |  |  |  |  |  |  |  |  |  | 10 | ناودانی عرضی داخل | 1.5x40x900 | 2 | 2 | 2 |  | Kg | -
 |  |  |  |  |  |  |  |  |  | 11 | ناودانی طولی داخل | 1.5x40x600 | 2 | 2 | 2 |  | Kg | -
 |  |  |  |  |  |  |  |  |  | 12 | ناودانی عرضی بیرون | 1.5x40x900 | 2 | 2 | 2 |  | Kg | -
 |  |  |  |  |  |  |  |  |  | 13 | ناودانی طولی بیرون | 1.5x40x600 | 2 | 2 | 2 |  | Kg | -

Sheet: Eliminator
محصول |  |  |  | زیرمحصول |  |  | مجموعه |  |  |  |  | قطعه |  |  |  |  |  | فرآیند
کد محصول | تعداد در سفارش | کد زیر محصول | شرح | تعداد در محصول | تعداد در سفارش | کد مجموعه | شرح | تعداد در زیر محصول | تعداد در سفارش | شمارنده | شرح | مشخصات | تعداد در زیر محصول | تعداد در محصول | تعداد در سفارش | مقدار خالص | واحد | نفر ساعت
 |  |  | Eliminator |  |  |  | پایه الیمیناتور | 1 | 1 | 1 | نبشی عرضی پایین 1 | 1.5x97x1534 | 6 | 6 | 6 |  | Kg | -
 |  |  |  |  |  |  |  |  |  | 2 | نبشی عرضی پایین 2 | 1.5x97x2128 | 12 | 12 | 12 |  | Kg | -
 |  |  |  |  |  |  |  |  |  | 3 | پایه | 1.5x250x275 | 7 | 7 | 7 |  | Kg | -
 |  |  |  |  |  |  |  |  |  | 4 | پیچ شش گوش | M8x25 | 24 | 24 | 24 |  | Pcs | -
 |  |  |  |  |  |  |  |  |  | 5 | مهره شش گوش | M8 | 24 | 24 | 24 |  | Pcs | -
 |  |  |  |  |  |  | نردبانی | 4 | 4 | 6 | نبشی نردبانی | 1.5x97x2647 | 8 | 8 | 8 |  | Kg | -
 |  |  |  |  |  |  |  |  |  | 7 | رابط نردبانی | 1.5x77x270 | 30 | 30 | 30 |  | Kg | -
 |  |  |  |  |  |  |  |  |  | 8 | نبشی عرضی بالا 1 | 1.5x137x1534 | 2 | 2 | 2 |  | Kg | -
 |  |  |  |  |  |  |  |  |  | 9 | نبشی عرضی بالا 2 | 1.5x137x2128 | 4 | 4 | 4 |  | Kg | -
 |  |  |  |  |  |  |  |  |  | 10 | درزگیر | 1.5x97x2573 | 8 | 8 | 8 |  | Kg | -
 |  |  |  |  |  |  |  |  |  | 11 | ستون میانی | 1.5x240x2573 | 8 | 8 | 8 |  | Kg | -
 |  |  |  |  |  |  |  |  |  | 12 | سینی 1 | 1.5x995x1534 | 1 | 1 | 1 |  | Kg | -
 |  |  |  |  |  |  | سینی | 1 | 1 | 13 | سینی 2 | 1.5x995x2128 | 2 | 2 | 2 |  | Kg | -
 |  |  |  |  |  |  |  |  |  | 14 | رابط سینی | 1.5x988x160 | 2 | 2 | 2 |  | Kg | -
 |  |  |  |  |  |  |  |  |  | 15 | پیچ شش گوش | M6x10 | 35 | 35 | 35 |  | Pcs | -
 |  |  |  |  |  |  |  |  |  | 16 | مهره شش گوش | M6 | 35 | 35 | 35 |  | Pcs | -
 |  |  |  |  |  |  |  |  |  | 17 | فلنج تخلیه | -- | 2 | 2 | 2 |  | Pcs | -
محصول |  |  |  | زیرمحصول |  |  | مجموعه |  |  |  |  | قطعه |  |  |  |  |  | فرآیند
کد محصول | تعداد در سفارش | کد زیر محصول | شرح | تعداد در محصول | تعداد در سفارش | کد مجموعه | شرح | تعداد در زیر محصول | تعداد در سفارش | شمارنده | شرح | مشخصات | تعداد در زیر محصول | تعداد در محصول | تعداد در سفارش | مقدار خالص | واحد | نفر ساعت
 |  |  | Eliminator |  |  |  |  |  |  | 1 | نبشی اتصال نبشی عرضی پایین به ستون | 2.5x75x60 | 4 | 4 | 4 |  | Kg | -
 |  |  |  |  |  |  |  |  |  | 2 | نبش اتصال ستون به سینی | 2.5x75x80 | 8 | 8 | 8 |  | Kg | -
 |  |  |  |  |  |  |  |  |  | 3 | ناودانی اتصال سقفی | 2x80x295 | 2 | 2 | 2 |  | Kg | -
 |  |  |  |  |  |  | اتصالات | 1 | 1 | 4 | پیچ شش گوش | M8x25 | 64 | 64 | 64 |  | Pcs | -
 |  |  |  |  |  |  |  |  |  | 5 | مهره شش گوش | M8 | 64 | 64 | 64 |  | Pcs | -
 |  |  |  |  |  |  |  |  |  | 6 | پیچ شش گوش | M6x15 | 20 | 20 | 20 |  | Pcs | -
 |  |  |  |  |  |  |  |  |  | 7 | پیچ شش گوش | M6x10 | 35 | 35 | 35 |  | Pcs | -
 |  |  |  |  |  |  |  |  |  | 8 | مهره شش گوش | M6 | 55 | 55 | 55 |  | Pcs | -
 |  |  |  |  |  |  |  |  |  | 9 | پیچ دو سو | M5x50 | 30 | 30 | 30 |  | Pcs | -
 |  |  |  |  |  |  |  |  |  | 10 | رولپلاگ | 5x50 | 30 | 30 | 30 |  | Pcs | -
 |  |  |  |  |  |  |  |  |  | 11 | تیغه الیمیناتور | 2546 | 540 | 540 | 540 |  | Pcs | -
 |  |  |  |  |  |  |  |  |  | 12 | مهره برنجی | -- | 608 | 608 | 608 |  | Pcs | -
 |  |  |  |  |  |  |  |  |  | 13 | مهره شش گوش | M5 | 608 | 608 | 608 |  | Pcs | -
 |  |  |  |  |  |  |  |  |  | 14 | میله الیمیناتور | 304 | 608 | 608 | 608 |  | Pcs | -
 |  |  |  |  |  |  |  |  |  | 15 | فاصله میانی | -- | 8096 | 8096 | 8096 |  | Pcs | -
 |  |  |  |  |  |  |  |  |  | 16 | فاصله آخر | -- | 640 | 640 | 640 |  | Pcs | -

Sheet: Fan Case 1400
محصول |  |  |  | زیرمحصول |  |  | مجموعه |  |  |  |  | قطعه |  |  |  |  |  | فرآیند
کد محصول | تعداد در سفارش | کد زیر محصول | شرح | تعداد در محصول | تعداد در سفارش | کد مجموعه | شرح | تعداد در زیر محصول | تعداد در سفارش | شمارنده | شرح | مشخصات | تعداد در زیر محصول | تعداد در محصول | تعداد در سفارش | مقدار خالص | واحد | نفر ساعت
 |  |  | فن محوری |  |  |  | Fan Case 1400 (رفت) | 1 | 3 | 1 | رینگ | 3x365x4415 | 1 | 1 | 3 |  | KG
 |  |  |  |  |  |  |  |  |  | 2 | مخروطی | 2.5x1250x275 | 4 | 4 | 12 |  | KG
 |  |  |  |  |  |  |  |  |  | 3 | فلنج | 4x1250x350 | 4 | 4 | 12 |  | KG
 |  |  |  |  |  |  |  |  |  | 4 | سیخک | 3x150x150 | 2 | 2 | 6 |  | KG
 |  |  |  |  |  |  |  |  |  | 5 | قطعه اتصال پایه | 8x150x150 | 4 | 4 | 12 |  | KG
 |  |  |  |  |  |  |  |  |  | 6 | پایه | 8x500x716 | 2 | 2 | 6 |  | KG
 |  |  |  |  |  |  |  |  |  | 7 | صفحه | 8x500x640 | 1 | 1 | 3 |  | KG
 |  |  |  |  |  |  |  |  |  | 8 | پیچ | M16x40 | 27 | 27 | 81 |  | PCS
 |  |  |  |  |  |  |  |  |  | 9 | مهره | M16 | 27 | 27 | 81 |  | PCS
 |  |  |  |  |  |  |  |  |  | 10 | الکترو موتور | 22Kw-1000rpm | 1 | 1 | 3 |  | PCS
 |  |  |  |  |  |  |  |  |  | 11 | پیچ الکتروموتور |  |  |  |  |  | PCS
محصول |  |  |  | زیرمحصول |  |  | مجموعه |  |  |  |  | قطعه |  |  |  |  |  | فرآیند
کد محصول | تعداد در سفارش | کد زیر محصول | شرح | تعداد در محصول | تعداد در سفارش | کد مجموعه | شرح | تعداد در زیر محصول | تعداد در سفارش | شمارنده | شرح | مشخصات | تعداد در زیر محصول | تعداد در محصول | تعداد در سفارش | مقدار خالص | واحد | نفر ساعت
 |  |  | فن محوری |  |  |  | Fan Case 1400 (برگشت) | 1 | 3 | 1 | رینگ | 3x365x4415 | 1 | 1 | 3 |  | KG
 |  |  |  |  |  |  |  |  |  | 2 | مخروطی | 2.5x1250x275 | 4 | 4 | 12 |  | KG
 |  |  |  |  |  |  |  |  |  | 3 | فلنج | 4x1250x350 | 4 | 4 | 12 |  | KG
 |  |  |  |  |  |  |  |  |  | 4 | سیخک | 3x150x150 | 2 | 2 | 6 |  | KG
 |  |  |  |  |  |  |  |  |  | 5 | قطعه اتصال پایه | 8x150x150 | 4 | 4 | 12 |  | KG
 |  |  |  |  |  |  |  |  |  | 6 | پایه | 8x500x716 | 2 | 2 | 6 |  | KG
 |  |  |  |  |  |  |  |  |  | 7 | صفحه | 8x500x640 | 1 | 1 | 3 |  | KG
 |  |  |  |  |  |  |  |  |  | 8 | پیچ | M16x40 | 27 | 27 | 81 |  | PCS
 |  |  |  |  |  |  |  |  |  | 9 | مهره | M16 | 27 | 27 | 81 |  | PCS
 |  |  |  |  |  |  |  |  |  | 10 | الکترو موتور | 30Kw-1000rpm | 1 | 1 | 3 |  | PCS
 |  |  |  |  |  |  |  |  |  | 11 | پیچ الکتروموتور |  |  |  |  |  | PCS
