koalium/centidocs/jokar/Savin 1/BOM & MTO/Savin-AC1-MTO 01(VD-Coil-Airwasher)-Rev 00.xlsx

Sheet: V.D.& I.D. MTO
 |  |  |  |  |  | Specification (mm)
Pos. | Part Name | Qty (Pcs) | Material | Description | Thk. / Diameter | W | L | Qty | Gross Qty. | Unit | Net Weight (Kg) | Scrap | Remarks
1 | پد بزرگ و کوچک | 16 | H.D.G | Plate | 1.2 | 1000 | 2200 | 8 | 165.792 | Kg | 127 | 30.54488189%
2 | ناودانی تقویت | 22 | H.D.G | Plate | 1.5 | 1000 | 1500 | 1 | 17.6625 | Kg | 17 | 3.897058824%
3 | تسمه لولا | 46 | St-37 | Plate | 5 | 1000 | 300 | 1 | 11.775 | Kg | 10 | 17.75%
4 | لولا | 23 | St-37 | Sq.Bar | 20 | 15 | 3000 | 1 | 7.065 | Kg | 3 | 135.5%
5 | لولا | 23 | آهن معمولی | Round Bar | Ø15 | - | 3000 | 1 | 4 | Kg | 3 | 33.33333333%
6 | دستگیره درب تهویه | 8 | Aluminium | قطعه نیم ساخته | - | - | - | 8 | 8 | Pcs | - | -
7 | طلق | 16 | - | طلق شییه ای | 3 | 1250 | 1830 | 1 | 1 | Pcs | - | -
8 | لاستیک درزگیر | 14 | لاستیک | قطعه پیش ساخته | - | - | 15m | 1 | 15 | متر | 15 | 0%
9 | مغزی درزگیر | 14 | لاستیک | قطعه پیش ساخته | - | - | 15m | 1 | 15 | متر | 15 | 0%
10 | فوم | 8 | فوم | قطعه پیش ساخته | 40 | 1000 | 2000 | 8 | 8 | Pcs | - | -
11 | پلی فوم | 8 | پلی فوم | قطعه پیش ساخته | 10 | 1000 | 2000 | 1 | 1 | Pcs | - | -
12 | بوش دستگیره | 8 | A-53 | لوله درزدار | 3/4" | SCH40 | 1000 | 1 | 1.7 | Kg | 0.8 | 112.5%
13 | پیچ | 69 | گالوانیزه سرد | پیچ شش گوش | M | 8 | 70 | 69 | 69 | Pcs | - | -
14 | مهره | 69 | گالوانیزه سرد | مهره شش گوش | M | 8 | - | 69 | 69 | Pcs | - | -
15 | پیچ | 8 | گالوانیزه سرد | پیچ سر آلن | M | 6 | 70 | 8 | 8 | Pcs | - | -
16 | چهارچوب | 7 | آهن معمولی | قوطی | 2.9 | 40*40 | 6000 | 8 | 160 | Kg | - | -
17 | فرآیند آبکاری | 1 | گالوانیزه گرم | - | - | - | - | 140 | 150 | Kg | - | -

Sheet: Coil MTO
 |  |  |  |  |  | Specification (mm)
Pos. | Part Name | Qty (Pcs) | Material | Description | Thk. / Diameter | W | L | Qty | Gross Qty. | Unit | Net Weight (Kg) | Scrap | Remarks
1 | قاب طولی و عرضی | 24 | St-37 | Plate | 4 | 1500 | 5250 | 1 | 247.275 | Kg | 221 | 11.88914027%
2 | کلکتور و بادگیر | 8 | St-37 | Plate | 4 | 1250 | 2400 | 1 | 94.2 | Kg | 80 | 17.75%
3 | تیوب شیت | 8 | St-37 | Plate | 6 | 1250 | 2400 | 1 | 141.3 | Kg | 133 | 6.240601504%
4 | تیوب | 500 | A-53 | Pipe | 1/2" | SCH10 | 6000 | 125 | 750 | Kg | 702 | 6.837606838%
5 | فلنج | 8 | آهن معمولی | فلنج گلویی جوشی | 1" | - | - | 8 | 8 | Pcs | - | -
6 | لوله ورودی و خروجی | 8 | A-53 | لوله بدون درز | 1" | SCH10 | 1000 | 1 | 2 | Kg | 1.6 | 25%
7 | زانو | 8 | آهن معمولی | زانو جوشی | 1" | - | - | 8 | 8 | Pcs | - | -

Sheet: Nozzle Bank MTO
 |  |  |  |  |  | Specification (mm)
Pos. | Part Name | Qty (Pcs) | Material | Description | Thk. / Diameter | W | L | Qty | Gross Qty. | Unit | Net Weight (Kg) | Scrap | Remarks
1 | لوله کلکتور | 4 | P.E. | لوله | 3" | Thk=8 | 2432 | 4 | 4 | Pcs | - | -
2 | لوله رایزر | 32 | P.V.C | لوله | 1 1/4" | Thk=3 | 5000 | 32 | 32 | Pcs | - | -
3 | درپوش کلکتور | 8 | P.E. | قطعه پیش ساخته | Ø110 | - | - | 8 | 8 | Pcs | - | -
4 | درپوش رایزر | 32 | P.P. | قطعه پیش ساخته | - | - | - | 32 | 32 | Pcs | - | -
5 | فنجانی کلکتور | 32 | P.E. | قطعه پیش ساخته | Ø110 | - | - | 32 | 32 | Pcs | - | -
6 | درپوش فنجانی | 32 | P.E. | قطعه پیش ساخته | - | - | - | 32 | 32 | Pcs | - | -
7 | فلنج جوشی کلکتور | 4 | P.E. | قطعه پیش ساخته | Ø110 | - | - | 4 | 4 | Pcs | - | -
8 | فلنج فلزی کلکتور | 4 | St-37 | Plate | 10 | 1500 | 250 | 1 | 29.4375 | Kg | 12 | 145.3125%
9 | بدنه افشانک | 2048 | پلی کربنات | قطعه پیش ساخته | - | - | - | 2048 | 2048 | Pcs | - | -
10 | سری افشانک | 2048 | P.P/S.S | قطعه پیش ساخته | - | - | - | 2048 | 2048 | Pcs | - | -
11 | بست استیل | 2144 | استیل نگیر | قطعه پیش ساخته | - | - | - | 2144 | 2144 | Pcs | - | -
12 | واشر افشانک | 2048 | لاستیک | قطعه پیش ساخته | - | - | - | 2048 | 2048 | Pcs | - | -
13 | نبشی نگهدارنده | 6 | آهن معمولی | نبشی | 5 | 50 | 6000 | 1 | 23 | Kg | 11 | 109.0909091%
14 | بوش رایزر | 32 | P.E. | میلگرد | 55 | - | 2000 | 1 | 4.7 | Kg | - | -
15 | اورینگ فنجانی | 32 | لاستیک | قطعه پیش ساخته | - | - | - | 32 | 32 | Pcs | - | -
16 | بست شکلاتی | 96 | پلاستیک | قطعه پیش ساخته | - | - | - | 96 | 96 | Pcs | - | -
17 | پیچ | 96 | گالوانیزه سرد | پیچ شش گوش | M | 6 | 30 | 96 | 96 | Pcs | - | -
18 | مهره | 96 | گالوانیزه سرد | مهره شش گوش | M | 6 | - | 96 | 96 | Pcs | - | -

Sheet: Eliminator & Air Bafffle MTO
 |  |  |  |  |  | Specification (mm)
Pos. | Part Name | Qty (Pcs) | Material | Description | Thk. / Diameter | W | L | Qty | Gross Qty. | Unit | Net Weight (Kg) | Scrap | Remarks
1 | قطعات قاب الیمیناتور و ایربافل ناودانی نگهدارنده رایزر | 91 | H.D.G | Plate | 1.5 | 1000 | 2000 | 10 | 235.5 | Kg | 217 | 8.525345622%
2 | قطعات قاب الیمیناتور و ایربافل | 23 | H.D.G | Plate | 1.5 | 1000 | 2600 | 4 | 122.46 | Kg | 115 | 6.486956522%
3 | چفت | 226 | پلی استایرن | قطعه پیش ساخته | - | - | - | 266 | 266 | Pcs | - | -
4 | بست | 226 | پلی استایرن | قطعه پیش ساخته | - | - | - | 266 | 266 | Pcs | - | -
5 | شبکه ایربافل | 155 | A.B.S | قطعه پیش ساخته | - | - | - | 155 | 155 | Pcs | - | -
6 | فاصله آخر | 588 | پلی استایرن | قطعه پیش ساخته | - | - | - | 588 | 588 | Pcs | - | -
7 | فاصله میانی | 7197 | پلی استایرن | قطعه پیش ساخته | - | - | - | 7197 | 7197 | Pcs | - | -
8 | مهره برنجی | 544 | Brass | قطعه پیش ساخته | - | - | - | 544 | 544 | Pcs | - | -
9 | میله الیمیناتور | 544 | مسوار | قطعه پیش ساخته | - | - | - | 544 | 544 | Pcs | - | -
10 | تیغه الیمیناتور | 484 | A.B.S | مواد خام | - | - | 2496 | 484 | 525 | Kg | - | -
11 | پیچ | 60 | گالوانیزه سرد | پیچ دوسو | M | 5 | 50 | 60 | 60 | Pcs | - | -
12 | رولپلاگ | 60 | - | رولپلاگ | - | 6 | 40 | 60 | 60 | Pcs | - | -
13 | پیچ | 88 | گالوانیزه سرد | پیچ شش گوش | M | 8 | 25 | 88 | 88 | Pcs | - | -
14 | مهره | 88 | گالوانیزه سرد | مهره شش گوش | M | 8 | - | 88 | 88 | Pcs | - | -
15 | پیچ | 20 | گالوانیزه سرد | پیچ شش گوش | M | 6 | 15 | 20 | 20 | Pcs | - | -
16 | پیچ | 50 | گالوانیزه سرد | پیچ شش گوش | M | 6 | 10 | 50 | 50 | Pcs | - | -
17 | مهره | 336 | گالوانیزه سرد | مهره شش گوش | M | 6 | - | 336 | 336 | Pcs | - | -
18 | پیچ | 266 | گالوانیزه سرد | پیچ شش گوش | M | 6 | 40 | 266 | 266 | Pcs | - | -
19 | فلنج تخلیه | 2 | A-53 | لوله درزدار | 3" | - | 350 | 1 | 6 | Kg | 6 | 0%
