koalium/centidocs/Rezaei/10130/BOM & MTO/10130-BOM & MTO.xlsx

Sheet: Air Baffle-BOM
محصول |  |  |  | زیرمحصول |  |  | مجموعه |  |  |  |  | قطعه |  |  |  |  |  | فرآیند
کد محصول | تعداد در سفارش | کد زیر محصول | شرح | تعداد در محصول | تعداد در سفارش | کد مجموعه | شرح | تعداد در زیر محصول | تعداد در سفارش | شمارنده | شرح | مشخصات | تعداد در زیر محصول | تعداد در محصول | تعداد در سفارش | مقدار خالص | واحد | نفر ساعت
 |  |  | Air Baffle |  |  |  |  |  |  | 1 | شبکه ایربافل | 300x600 | 175 | 175 | 175 | 175 | Pcs
 |  |  |  |  |  |  |  |  |  | 2 | چفت | - | 190 | 190 | 190 | 190 | Pcs
 |  |  |  |  |  |  |  |  |  | 3 | بست | - | 190 | 190 | 190 | 190 | Pcs
 |  |  |  |  |  |  |  |  |  | 4 | پیچ شش گوش | M6x40 | 190 | 190 | 190 | 190 | Pcs
 |  |  |  |  |  |  |  |  |  | 5 | مهره شش گوش | M6 | 190 | 190 | 190 | 190 | Pcs

Sheet: Air Baffle-MTO
 |  |  |  |  |  | Specification (mm)
Pos. | Part Name | Qty (Pcs) | Material | Description | Thk. / Diameter | W | L | Qty | Gross Qty. | Unit | Net Weight (Kg) | Scrap | Remarks
1 | شبکه ایربافل | 175 | A.B.S | قطعه پیش ساخته | - | - | - | 175 | 175 | Pcs | - | - | -
2 | چفت | 190 | پلی استایرن | قطعه پیش ساخته | - | - | - | 190 | 190 | Pcs | - | - | -
3 | بست | 190 | پلی استایرن | قطعه پیش ساخته | - | - | - | 190 | 190 | Pcs | - | - | -
4 | پیچ | 190 | گالوانیزه سرد | پیچ شش گوش | M | 6 | 40 | 190 | 190 | Pcs | - | - | -
5 | مهره | 190 | گالوانیزه سرد | مهره شش گوش | M | 6 | - | 190 | 190 | Pcs | - | - | -

Sheet: Damper-BOM
محصول |  |  |  | زیرمحصول |  |  | مجموعه |  |  |  |  | قطعه |  |  |  |  |  | فرآیند
کد محصول | تعداد در سفارش | کد زیر محصول | شرح | تعداد در محصول | تعداد در سفارش | کد مجموعه | شرح | تعداد در زیر محصول | تعداد در سفارش | شمارنده | شرح | مشخصات | تعداد در زیر محصول | تعداد در محصول | تعداد در سفارش | مقدار خالص | واحد | نفر ساعت
 |  |  | Damper |  |  |  |  |  |  | 1 | قاب عرضی | 1.5x370x1500 | 2 | 2 | 24 | 157 | Kg
 |  |  |  |  |  |  |  |  |  | 2 | قاب طولی | 1.5x370x1680 | 2 | 2 | 24 | 176 | Kg
 |  |  |  |  |  |  |  |  |  | 3 | تیغه دمپر | L=1500 | 11 | 11 | 132 | 132 | Pcs
 |  |  |  |  |  |  |  |  |  | 4 | گوشک | - | 8 | 8 | 96 | 96 | Pcs
 |  |  |  |  |  |  |  |  |  | 5 | بادامک | - | 11 | 11 | 132 | 132 | Pcs
 |  |  |  |  |  |  |  |  |  | 6 | واشر تخت | A12 | 11 | 11 | 132 | 132 | Pcs
 |  |  |  |  |  |  |  |  |  | 7 | بوش | - | 22 | 22 | 264 | 264 | Pcs
 |  |  |  |  |  |  |  |  |  | 8 | واسطه 4 گوش | - | 11 | 11 | 132 | 132 | Pcs
 |  |  |  |  |  |  |  |  |  | 9 | فشنگی | - | 11 | 11 | 132 | 132 | Pcs
 |  |  |  |  |  |  |  |  |  | 10 | اشپیل | 2.6x30 | 11 | 11 | 132 | 132 | Pcs
 |  |  |  |  |  |  |  |  |  | 11 | بازو بزرگ | 2x70x1550 | 1 | 1 | 12 | 20 | Kg
 |  |  |  |  |  |  |  |  |  | 12 | بازو کوچک | 2x70x1550 | 1 | 1 | 12 | 20 | Kg
 |  |  |  |  |  |  |  |  |  | 13 | راد | 2x70x230 | 1 | 1 | 12 | 3 | Kg
 |  |  |  |  |  |  |  |  |  | 14 | نوار دمپر | L=1680 | 2 | 2 | 24 | 7 | Kg
 |  |  |  |  |  |  |  |  |  | 15 | پیچ آلن مخروطی | M10x25 | 11 | 11 | 132 | 132 | Pcs
 |  |  |  |  |  |  |  |  |  | 16 | مهره 4 گوش | M10 | 11 | 11 | 132 | 132 | Pcs
 |  |  |  |  |  |  |  |  |  | 17 | پیچ شش گوش | M10x15 | 32 | 32 | 384 | 384 | Pcs
 |  |  |  |  |  |  |  |  |  | 18 | مهره شش گوش | M10 | 32 | 32 | 384 | 384 | Pcs
 |  |  |  |  |  |  |  |  |  | 19 | نبشی اتصال قاب | 1.5x80x270 | 4 | 4 | 48 | 12 | Kg
محصول |  |  |  | زیرمحصول |  |  | مجموعه |  |  |  |  | قطعه |  |  |  |  |  | فرآیند
کد محصول | تعداد در سفارش | کد زیر محصول | شرح | تعداد در محصول | تعداد در سفارش | کد مجموعه | شرح | تعداد در زیر محصول | تعداد در سفارش | شمارنده | شرح | مشخصات | تعداد در زیر محصول | تعداد در محصول | تعداد در سفارش | مقدار خالص | واحد | نفر ساعت
 |  |  | Damper |  |  |  |  |  |  | 20 | قاب عرضی | 1.5x370x1500 | 2 | 2 | 24 | 157 | Kg
 |  |  |  |  |  |  |  |  |  | 21 | قاب طولی | 1.5x370x1730 | 2 | 2 | 24 | 181 | Kg
 |  |  |  |  |  |  |  |  |  | 22 | تیغه دمپر | L=1500 | 11 | 11 | 132 | 132 | Pcs
 |  |  |  |  |  |  |  |  |  | 23 | گوشک | - | 8 | 8 | 96 | 96 | Pcs
 |  |  |  |  |  |  |  |  |  | 24 | بادامک | - | 11 | 11 | 132 | 132 | Pcs
 |  |  |  |  |  |  |  |  |  | 25 | واشر تخت | A12 | 11 | 11 | 132 | 132 | Pcs
 |  |  |  |  |  |  |  |  |  | 26 | بوش | - | 22 | 22 | 264 | 264 | Pcs
 |  |  |  |  |  |  |  |  |  | 27 | واسطه 4 گوش | - | 11 | 11 | 132 | 132 | Pcs
 |  |  |  |  |  |  |  |  |  | 28 | فشنگی | - | 11 | 11 | 132 | 132 | Pcs
 |  |  |  |  |  |  |  |  |  | 29 | اشپیل | 2.6x30 | 11 | 11 | 132 | 132 | Pcs
 |  |  |  |  |  |  |  |  |  | 30 | بازو بزرگ | 2x70x1650 | 1 | 1 | 12 | 23 | Kg
 |  |  |  |  |  |  |  |  |  | 31 | بازو کوچک | 2x70x1650 | 1 | 1 | 12 | 23 | Kg
 |  |  |  |  |  |  |  |  |  | 32 | راد | 2x70x230 | 1 | 1 | 12 | 3 | Kg
 |  |  |  |  |  |  |  |  |  | 33 | نوار دمپر | L=1730 | 2 | 2 | 24 | 8 | Kg
 |  |  |  |  |  |  |  |  |  | 34 | پیچ آلن مخروطی | M10x25 | 11 | 11 | 132 | 132 | Pcs
 |  |  |  |  |  |  |  |  |  | 35 | مهره 4 گوش | M10 | 11 | 11 | 132 | 132 | Pcs
 |  |  |  |  |  |  |  |  |  | 36 | پیچ شش گوش | M10x15 | 32 | 32 | 384 | 384 | Pcs
 |  |  |  |  |  |  |  |  |  | 37 | مهره شش گوش | M10 | 32 | 32 | 384 | 384 | Pcs
 |  |  |  |  |  |  |  |  |  | 38 | نبشی اتصال قاب | 1.5x80x270 | 4 | 4 | 48 | 12 | Kg

Sheet: Damper-MTO
 |  |  |  |  |  | Specification (mm)
Pos. | Part Name | Qty (Pcs) | Material | Description | Thk. / Diameter | W | L | Qty | Gross Qty. | Unit | Net Weight (Kg) | Scrap | Remarks
1 | قاب عرضی | 48 | H.D.G | Plate | 1.5 | 1250 | 1520 | 16 | 357.96 | Kg | 314 | 14% | -
2 | قاب طولی | 24 | H.D.G | Plate | 1.5 | 1250 | 1700 | 8 | 200.175 | Kg | 176 | 13.73579545% | -
3 | قاب طولی | 24 | H.D.G | Plate | 1.5 | 1250 | 1750 | 8 | 206.0625 | Kg | 181 | 13.84668508% | -
4 | بازو بزرگ و کوچک | 96 | H.D.G | Plate | 2 | 1250 | 1700 | 2 | 66.725 | Kg | 63 | 5.912698413% | -
5 | بادامک | 264 | پلی آمید | قطعه پیش ساخته | - | - | - | 264 | 264 | Pcs | - | - | -
6 | واسطه 4 گوش | 264 | پلی استایرن | قطعه پیش ساخته | - | - | - | 264 | 264 | Pcs | - | - | -
6 | فشنگی | 264 | پلی آمید | قطعه پیش ساخته | - | - | - | 264 | 264 | Pcs | - | - | -
6 | بوش | 528 | A.B.S | قطعه پیش ساخته | - | - | - | 528 | 528 | Pcs | - | - | -
6 | گوشک | 192 | H.D.G | قطعه پیش ساخته | - | - | - | 192 | 192 | Pcs | - | - | -
6 | تیغه دمپر | 264 | Aluminium | قطعه پیش ساخته | - | - | 1500 | 264 | 264 | Pcs | - | - | -
6 | اشپیل | 264 | گالوانیزه سرد | اشپیل | 2.6 | 30 | - | 57 | 57 | Pcs | - | - | -
6 | نوار دمپر | 48 | P.E. | مواد خام | - | - | - | 48 | 14 | Kg | 14 | 0% | -
6 | پیچ | 264 | گالوانیزه سرد | پیچ آلن مخروطی | M | 10 | 25 | 264 | 264 | Pcs | - | - | -
6 | مهره | 264 | گالوانیزه سرد | مهره 4 گوش | M | 10 | - | 264 | 264 | Pcs | - | - | -
6 | پیچ | 768 | گالوانیزه سرد | پیچ شش گوش | M | 10 | 15 | 768 | 768 | Pcs | - | - | -
6 | مهره | 768 | گالوانیزه سرد | مهره شش گوش | M | 10 | - | 768 | 768 | Pcs | - | - | -
6 | واشر | 264 | گالوانیزه سرد | واشر تخت | A | 12 | - | 264 | 264 | Pcs | - | - | -
 | اشپیل

Sheet: Fan Case-BOM
محصول |  |  |  | زیرمحصول |  |  | مجموعه |  |  |  |  | قطعه |  |  |  |  |  | فرآیند
کد محصول | تعداد در سفارش | کد زیر محصول | شرح | تعداد در محصول | تعداد در سفارش | کد مجموعه | شرح | تعداد در زیر محصول | تعداد در سفارش | شمارنده | شرح | مشخصات | تعداد در زیر محصول | تعداد در محصول | تعداد در سفارش | مقدار خالص | واحد | نفر ساعت
 |  |  | Fan Case 1600-37-1000 |  |  |  |  |  |  | 1 | رینگ | 3x415x5045 | 1 | 1 | 4 | 197 | Kg | -
 |  |  |  |  |  |  |  |  |  | 2 | فلنج | 4x285x1206 | 4 | 4 | 16 | 33 | Kg | -
 |  |  |  |  |  |  |  |  |  | 3 | مخروطی | 2.5x1250x308 | 5 | 5 | 20 | 81 | Kg | -
 |  |  |  |  |  |  |  |  |  | 4 | پایه | 10x500x915 | 2 | 2 | 8 | 192 | Kg | -
 |  |  |  |  |  |  |  |  |  | 5 | صفحه | 10x830x500 | 1 | 1 | 4 | 130 | Kg | -
 |  |  |  |  |  |  |  |  |  | 6 | سیخک | 3x150x150 | 2 | 2 | 8 | 4 | Kg | -
 |  |  |  |  |  |  |  |  |  | 7 | ورق اتصال پایه | 10x150x150 | 4 | 4 | 16 | 23 | Kg | -
 |  |  |  |  |  |  |  |  |  | 8 | پیچ | M16x40 | 27 | 27 | 108 | 108 | Pcs | -
 |  |  |  |  |  |  |  |  |  | 9 | مهره کاسه نمددار | M16 | 27 | 27 | 108 | 108 | Pcs | -
محصول |  |  |  | زیرمحصول |  |  | مجموعه |  |  |  |  | قطعه |  |  |  |  |  | فرآیند
کد محصول | تعداد در سفارش | کد زیر محصول | شرح | تعداد در محصول | تعداد در سفارش | کد مجموعه | شرح | تعداد در زیر محصول | تعداد در سفارش | شمارنده | شرح | مشخصات | تعداد در زیر محصول | تعداد در محصول | تعداد در سفارش | مقدار خالص | واحد | نفر ساعت
 |  |  | Fan Case 1600-30-1000 |  |  |  |  |  |  | 1 | رینگ | 3x415x5045 | 1 | 1 | 4 | 197 | Kg
 |  |  |  |  |  |  |  |  |  | 2 | فلنج | 4x285x1206 | 4 | 4 | 16 | 33 | Kg
 |  |  |  |  |  |  |  |  |  | 3 | مخروطی | 2.5x1250x308 | 5 | 5 | 20 | 81 | Kg
 |  |  |  |  |  |  |  |  |  | 4 | پایه | 10x500x940 | 2 | 2 | 8 | 201 | Kg
 |  |  |  |  |  |  |  |  |  | 5 | صفحه | 10x830x500 | 1 | 1 | 4 | 130 | Kg
 |  |  |  |  |  |  |  |  |  | 6 | سیخک | 3x150x150 | 2 | 2 | 8 | 4 | Kg
 |  |  |  |  |  |  |  |  |  | 7 | ورق اتصال پایه | 10x150x150 | 4 | 4 | 16 | 23 | Kg
 |  |  |  |  |  |  |  |  |  | 8 | پیچ | M16x40 | 27 | 27 | 108 | 108 | Pcs
 |  |  |  |  |  |  |  |  |  | 9 | مهره کاسه نمددار | M16 | 27 | 27 | 108 | 108 | Pcs

Sheet: Fan Case-MTO
 |  |  |  |  |  | Specification (mm)
Pos. | Part Name | Qty (Pcs) | Material | Description | Thk. / Diameter | W | L | Qty | Gross Qty. | Unit | Net Weight (Kg) | Scrap | Remarks
1 | مخروطی | 40 | St-37 | Plate | 2.5 | 1250 | 4020 | 2 | 197.23125 | Kg | 162 | 21.74768519% | -
2 | رینگ و سیخک | 24 | St-37 | Plate | 3 | 1250 | 5050 | 3 | 445.978125 | Kg | 402 | 10.93983209% | -
3 | فلنج | 32 | St-37 | Plate | 4 | 1250 | 2750 | 1 | 107.9375 | Kg | 66 | 63.54166667% | -
4 | پایه | 16 | St-37 | Plate | 10 | 1500 | 4150 | 1 | 488.6625 | Kg | 390 | 25.29807692% | -
5 | صفحه و قطعه اتصال | 40 | St-37 | Plate | 10 | 1500 | 3050 | 1 | 359.1375 | Kg | 316 | 13.65110759%
6 | پیچ | 216 | گالوانیزه سرد | پیچ شش گوش | M | 16 | 40 | 216 | 216 | Pcs | - | - | -
7 | مهره | 216 | گالوانیزه سرد | مهره کاسه نمددار | M | 16 | - | 216 | 216 | Pcs | - | - | -

Sheet: Over Flow-BOM
محصول |  |  |  | زیرمحصول |  |  | مجموعه |  |  |  |  | قطعه |  |  |  |  |  | فرآیند
کد محصول | تعداد در سفارش | کد زیر محصول | شرح | تعداد در محصول | تعداد در سفارش | کد مجموعه | شرح | تعداد در زیر محصول | تعداد در سفارش | شمارنده | شرح | مشخصات | تعداد در زیر محصول | تعداد در محصول | تعداد در سفارش | مقدار خالص | واحد | نفر ساعت
 |  |  | Over Flow |  |  |  |  |  |  | 1 | لوله سرریز | Ø110x850 | 2 | 2 | 2 | 2 | Pcs
 |  |  |  |  |  |  |  |  |  | 2 | قیفی سرریز | - | 2 | 2 | 2 | 2 | Pcs
 |  |  |  |  |  |  |  |  |  | 3 | لاستیک سرریز | - | 2 | 2 | 2 | 2 | Pcs
 |  |  |  |  |  |  |  |  |  | 4 | پیچ شش گوش | M12x140 | 2 | 2 | 2 | 2 | Pcs
 |  |  |  |  |  |  |  |  |  | 5 | مهره شش گوش | M12 | 2 | 2 | 2 | 2 | Pcs

Sheet: OverFlow-MTO
 |  |  |  |  |  | Specification (mm)
Pos. | Part Name | Qty (Pcs) | Material | Description | Thk. / Diameter | W | L | Qty | Gross Qty. | Unit | Net Weight (Kg) | Scrap | Remarks
1 | لوله سرریز | 2 | P.V.C | لوله | Ø110 | Thk=5 | 1700 | 1 | 1 | Pcs | - | - | -
2 | قیفی سرریز | 2 | Aluminium | قطعه پیش ساخته | - | - | - | 2 | 2 | Pcs | - | - | -
3 | لاستیک سرریز | 2 | لاستیک | قطعه پیش ساخته | - | - | - | 2 | 2 | Pcs | - | - | -
4 | پیچ | 2 | گالوانیزه سرد | پیچ شش گوش | M | 12 | 140 | 2 | 2 | Pcs | - | - | -
5 | مهره | 2 | گالوانیزه سرد | مهره شش گوش | M | 12 |  | 2 | 2 | Pcs | - | - | -

Sheet: Nozzle Bank-BOM
محصول |  |  |  | زیرمحصول |  |  | مجموعه |  |  |  |  | قطعه |  |  |  |  |  | فرآیند
کد محصول | تعداد در سفارش | کد زیر محصول | شرح | تعداد در محصول | تعداد در سفارش | کد مجموعه | شرح | تعداد در زیر محصول | تعداد در سفارش | شمارنده | شرح | مشخصات | تعداد در زیر محصول | تعداد در محصول | تعداد در سفارش | مقدار خالص | واحد | نفر ساعت
 |  |  | Nozzle Bank |  |  |  | رایزر | 48 | 48 | 1 | لوله رایز | Ø40x3500 | 48 | 48 | 48 | 48 | Pcs
 |  |  |  |  |  |  |  |  |  | 2 | درپوش رایزر | - | 48 | 48 | 48 | 48 | Pcs
 |  |  |  |  |  |  |  |  |  | 3 | بدنه افشانک | - | 2230 | 2230 | 2230 | 2230 | Pcs
 |  |  |  |  |  |  |  |  |  | 4 | سری افشانک | - | 2230 | 2230 | 2230 | 2230 | Pcs
 |  |  |  |  |  |  |  |  |  | 5 | واشر افشانک | - | 2230 | 2230 | 2230 | 2230 | Pcs
 |  |  |  |  |  |  |  |  |  | 6 | بست استیل | - | 2230 | 2230 | 2230 | 2230 | Pcs

Sheet: Nozzle Bank-MTO
 |  |  |  |  |  | Specification (mm)
Pos. | Part Name | Qty (Pcs) | Material | Description | Thk. / Diameter | W | L | Qty | Gross Qty. | Unit | Net Weight (Kg) | Scrap | Remarks
1 | لوله رایزر | 48 | P.V.C | لوله | Ø40 | Thk=3 | 3500 | 48 | 48 | Pcs | - | - | -
2 | درپوش رایزر | 48 | P.V.C | قطعه پیش ساخته | - | - | - | 48 | 48 | Pcs | - | - | -
3 | بدنه افشانک | 2230 | پلی کربنات | قطعه پیش ساخته | - | - | - | 2230 | 2230 | Pcs | - | - | -
4 | سری افشانک | 2230 | پلی پروپلین | قطعه پیش ساخته | - | - | - | 2230 | 2230 | Pcs | - | - | -
5 | واشر افشانک | 2230 | لاستیک | قطعه پیش ساخته | - | - | - | 2230 | 2230 | Pcs | - | - | -
6 | بست استیل | 2230 | استیل نگیر | قطعه پیش ساخته | - | - | - | 2230 | 2230 | Pcs | - | - | -

Sheet: Eliminator-BOM
محصول |  |  |  | زیرمحصول |  |  | مجموعه |  |  |  |  | قطعه |  |  |  |  |  | فرآیند
کد محصول | تعداد در سفارش | کد زیر محصول | شرح | تعداد در محصول | تعداد در سفارش | کد مجموعه | شرح | تعداد در زیر محصول | تعداد در سفارش | شمارنده | شرح | مشخصات | تعداد در زیر محصول | تعداد در محصول | تعداد در سفارش | مقدار خالص | واحد | نفر ساعت
 |  |  | Eliminator |  |  |  |  |  |  | 1 | تیغه الیمیناتور | L=4000 | 350 | 350 | 350 | 610 | Kg
 |  |  |  |  |  |  |  |  |  | 2 | میله الیمیناتور | - | 650 | 650 | 650 | 650 | Pcs
 |  |  |  |  |  |  |  |  |  | 3 | مهره برنجی | - | 650 | 650 | 650 | 650 | Pcs
 |  |  |  |  |  |  |  |  |  | 4 | فاصله آخر | - | 754 | 754 | 754 | 754 | Pcs
 |  |  |  |  |  |  |  |  |  | 5 | فاصله میانی | - | 8528 | 8528 | 8528 | 8528 | Pcs
 |  |  |  |  |  |  |  |  |  | 6 | مهره شش گوش | M5 | 650 | 650 | 650 | 650 | Pcs

Sheet: Elimintor-MTO
 |  |  |  |  |  | Specification (mm)
Pos. | Part Name | Qty (Pcs) | Material | Description | Thk. / Diameter | W | L | Qty | Gross Qty. | Unit | Net Weight (Kg) | Scrap | Remarks
1 | تیغه الیمیناتور | 355 | A.B.S | مواد خام | - | - | 4000 | 355 | 610 | Kg | 610 | 0% | -
2 | میله الیمیناتور | 650 | مسوار | قطعه پیش ساخته | - | - | - | 650 | 650 | Pcs | - | - | -
3 | مهره | 650 | گالوانیزه سرد | مهره شش گوش | M | 5 | - | 650 | 650 | Pcs | - | - | -
4 | مهره برنجی | 650 | Brass | قطعه پیش ساخته | - | - | - | 650 | 650 | Pcs | - | - | -
5 | فاصله آخر | 754 | پلی استایرن | قطعه پیش ساخته | - | - | - | 754 | 754 | Pcs | - | - | -
6 | فاصله میانی | 8528 | پلی استایرن | قطعه پیش ساخته | - | - | - | 8528 | 8528 | Pcs | - | - | -
