koalium/centidocs/Rezaei/10141/BOM & MTO/10141-BOM & MTO.xlsx

Sheet: Damper-MTO
 |  |  |  |  |  | Specification (mm)
Pos. | Part Name | Qty (Pcs) | Material | Description | Thk. / Diameter | W | L | Qty | Gross Qty. | Unit | Net Weight (Kg) | Scrap | Remarks
1 | پروفیل قاب عرضی و طولی | 24 | H.D.G | Plate | 1.5 | 1250 | 3020 | 4 | 177.8025 | Kg | 40 | 344.50625% | -
2 | بازو بزرگ و کوچک | 12 | H.D.G | Plate | 2 | 1000 | 1500 | 1 | 23.55 | Kg | 19 | 23.94736842% | -
3 | بادامک | 57 | پلی آمید | قطعه پیش ساخته | - | - | - | 57 | 57 | Pcs | - | - | -
4 | واسطه 4 گوش | 57 | پلی استایرن | قطعه پیش ساخته | - | - | - | 57 | 57 | Pcs | - | - | -
5 | فشنگی | 57 | پلی آمید | قطعه پیش ساخته | - | - | - | 57 | 57 | Pcs | - | - | -
6 | بوش | 114 | A.B.S | قطعه پیش ساخته | - | - | - | 114 | 114 | Pcs | - | - | -
7 | گوشک | 48 | H.D.G | قطعه پیش ساخته | - | - | - | 48 | 48 | Pcs | - | - | -
8 | تیغه دمپر | 57 | Aluminium | قطعه پیش ساخته | - | - | 1500 | 57 | 57 | Pcs | - | - | -
9 | اشپیل | 57 | گالوانیزه سرد | اشپیل | 2.6 | 30 | - | 57 | 57 | Pcs | - | - | -
10 | نوار دمپر | 12 | P.E. | مواد خام | - | - | - | 12 | 3 | Kg | 3 | 0% | -
11 | پیچ | 57 | گالوانیزه سرد | پیچ آلن مخروطی | M | 10 | 25 | 57 | 57 | Pcs | - | - | -
12 | مهره | 57 | گالوانیزه سرد | مهره 4 گوش | M | 10 | - | 57 | 57 | Pcs | - | - | -
13 | پیچ | 192 | گالوانیزه سرد | پیچ شش گوش | M | 10 | 15 | 192 | 192 | Pcs | - | - | -
14 | مهره | 192 | گالوانیزه سرد | مهره شش گوش | M | 10 | - | 192 | 192 | Pcs | - | - | -
15 | واشر | 57 | گالوانیزه سرد | واشر تخت | A | 12 | - | 57 | 57 | Pcs | - | - | -
 | اشپیل

Sheet: Damper-BOM
محصول |  |  |  | زیرمحصول |  |  | مجموعه |  |  |  |  | قطعه |  |  |  |  |  | فرآیند
کد محصول | تعداد در سفارش | کد زیر محصول | شرح | تعداد در محصول | تعداد در سفارش | کد مجموعه | شرح | تعداد در زیر محصول | تعداد در سفارش | شمارنده | شرح | مشخصات | تعداد در زیر محصول | تعداد در محصول | تعداد در سفارش | مقدار خالص | واحد | نفر ساعت
 |  |  | Damper |  |  |  |  | 1 | 3 | 1 | قاب عرضی | 1.5x370x1500 | 2 | 2 | 6 | 39 | Kg
 |  |  |  |  |  |  |  |  |  | 2 | قاب طولی | 1.5x370x1528 | 2 | 2 | 6 | 40 | Kg
 |  |  |  |  |  |  |  |  |  | 3 | تیغه الیمیناتور | L=1500 | 10 | 10 | 30 | 30 | Pcs
 |  |  |  |  |  |  |  |  |  | 4 | گوشک | - | 8 | 8 | 24 | 24 | Pcs
 |  |  |  |  |  |  |  |  |  | 5 | بادامک | - | 10 | 10 | 30 | 30 | Pcs
 |  |  |  |  |  |  |  |  |  | 6 | واشر تخت | A12 | 10 | 10 | 30 | 30 | Pcs
 |  |  |  |  |  |  |  |  |  | 7 | بوش | - | 20 | 20 | 60 | 30 | Pcs
 |  |  |  |  |  |  |  |  |  | 8 | واسطه 4 گوش | - | 10 | 10 | 30 | 30 | Pcs
 |  |  |  |  |  |  |  |  |  | 9 | فشنگی | - | 10 | 10 | 30 | 30 | Pcs
 |  |  |  |  |  |  |  |  |  | 10 | اشپیل | 2.6x30 | 10 | 10 | 30 | 30 | Pcs
 |  |  |  |  |  |  |  |  |  | 11 | بازو بزرگ | 2x70x1450 | 1 | 1 | 3 | 4.5 | Kg
 |  |  |  |  |  |  |  |  |  | 12 | بازو کوچک | 2x70x1450 | 1 | 1 | 3 | 4.5 | Kg
 |  |  |  |  |  |  |  |  |  | 13 | راد | 2x70x230 | 1 | 1 | 3 | 2 | Kg
 |  |  |  |  |  |  |  |  |  | 14 | نوار دمپر | L=1528 | 2 | 2 | 6 | 2 | Kg
 |  |  |  |  |  |  |  |  |  | 15 | پیچ آلن مخروطی | M10x25 | 10 | 10 | 30 | 30 | Pcs
 |  |  |  |  |  |  |  |  |  | 16 | مهره 4 گوش | M10 | 10 | 10 | 30 | 30 | Pcs
 |  |  |  |  |  |  |  |  |  | 17 | پیچ شش گوش | M10x15 | 32 | 32 | 96 | 96 | Pcs
 |  |  |  |  |  |  |  |  |  | 18 | مهره شش گوش | M10 | 32 | 32 | 96 | 96 | Pcs
 |  |  |  |  |  |  |  |  |  | 19 | نبشی اتصال قاب | 1.5x80x270 | 4 | 4 | 12 | 1.5 | Kg
محصول |  |  |  | زیرمحصول |  |  | مجموعه |  |  |  |  | قطعه |  |  |  |  |  | فرآیند
کد محصول | تعداد در سفارش | کد زیر محصول | شرح | تعداد در محصول | تعداد در سفارش | کد مجموعه | شرح | تعداد در زیر محصول | تعداد در سفارش | شمارنده | شرح | مشخصات | تعداد در زیر محصول | تعداد در محصول | تعداد در سفارش | مقدار خالص | واحد | نفر ساعت
 |  |  | Damper |  |  |  |  |  |  | 1 | قاب عرضی | 1.5x370x1500 | 2 | 2 | 6 | 39 | Kg
 |  |  |  |  |  |  |  |  |  | 2 | قاب طولی | 1.5x370x1372 | 2 | 2 | 6 | 35 | Kg
 |  |  |  |  |  |  |  |  |  | 3 | تیغه الیمیناتور | L=1500 | 9 | 9 | 27 | 27 | Pcs
 |  |  |  |  |  |  |  |  |  | 4 | گوشک | - | 8 | 8 | 24 | 24 | Pcs
 |  |  |  |  |  |  |  |  |  | 5 | بادامک | - | 9 | 9 | 27 | 27 | Pcs
 |  |  |  |  |  |  |  |  |  | 6 | واشر تخت | A12 | 9 | 9 | 27 | 27 | Pcs
 |  |  |  |  |  |  |  |  |  | 7 | بوش | - | 18 | 18 | 54 | 54 | Pcs
 |  |  |  |  |  |  |  |  |  | 8 | واسطه 4 گوش | - | 9 | 9 | 27 | 27 | Pcs
 |  |  |  |  |  |  |  |  |  | 9 | فشنگی | - | 9 | 9 | 27 | 27 | Pcs
 |  |  |  |  |  |  |  |  |  | 10 | اشپیل | 2.6x30 | 9 | 9 | 27 | 27 | Pcs
 |  |  |  |  |  |  |  |  |  | 11 | بازو بزرگ | 2x70x1450 | 1 | 1 | 3 | 4.5 | Kg
 |  |  |  |  |  |  |  |  |  | 12 | بازو کوچک | 2x70x1450 | 1 | 1 | 3 | 4.5 | Kg
 |  |  |  |  |  |  |  |  |  | 13 | راد | 2x70x230 | 1 | 1 | 3 | 1.5 | Kg
 |  |  |  |  |  |  |  |  |  | 14 | نوار دمپر | L=1376 | 2 | 2 | 6 | 2 | Kg
 |  |  |  |  |  |  |  |  |  | 15 | پیچ آلن مخروطی | M10x25 | 9 | 9 | 27 | 27 | Pcs
 |  |  |  |  |  |  |  |  |  | 16 | مهره 4 گوش | M10 | 9 | 9 | 27 | 27 | Pcs
 |  |  |  |  |  |  |  |  |  | 17 | پیچ شش گوش | M10x15 | 32 | 32 | 96 | 96 | Pcs
 |  |  |  |  |  |  |  |  |  | 18 | مهره شش گوش | M10 | 32 | 32 | 96 | 96 | Pcs
 |  |  |  |  |  |  |  |  |  | 19 | نبشی اتصال قاب | 1.5x80x270 | 4 | 4 | 12 | 1.5 | Kg

Sheet: Fan Case-BOM
محصول |  |  |  | زیرمحصول |  |  | مجموعه |  |  |  |  | قطعه |  |  |  |  |  | فرآیند
کد محصول | تعداد در سفارش | کد زیر محصول | شرح | تعداد در محصول | تعداد در سفارش | کد مجموعه | شرح | تعداد در زیر محصول | تعداد در سفارش | شمارنده | شرح | مشخصات | تعداد در زیر محصول | تعداد در محصول | تعداد در سفارش | مقدار خالص | واحد | نفر ساعت
 |  |  | Fan Case |  |  |  |  |  |  | 1 | رینگ | 3x365x4415 | 1 | 1 | 2 | 76 | Kg
 |  |  |  |  |  |  |  |  |  | 2 | فلنج | 4x255x1060 | 4 | 4 | 8 | 14 | Kg
 |  |  |  |  |  |  |  |  |  | 3 | مخروطی | 2.5x1250x331 | 4 | 4 | 8 | 31 | Kg
 |  |  |  |  |  |  |  |  |  | 4 | پایه | 8x440x795 | 2 | 2 | 4 | 62 | Kg
 |  |  |  |  |  |  |  |  |  | 5 | صفحه | 8x710x440 | 1 | 1 | 2 | 44 | Kg
 |  |  |  |  |  |  |  |  |  | 6 | سیخک | 3x150x150 | 2 | 2 | 4 | 2 | Kg
 |  |  |  |  |  |  |  |  |  | 7 | ورق اتصال پایه | 8x150x150 | 4 | 4 | 8 | 11 | Kg
 |  |  |  |  |  |  |  |  |  | 8 | پیچ | M16x40 | 27 | 27 | 54 | 54 | Pcs
 |  |  |  |  |  |  |  |  |  | 9 | مهره کاسه نمددار | M16 | 27 | 27 | 54 | 54 | Pcs

Sheet: Fan Case-MTO
 |  |  |  |  |  | Specification (mm)
Pos. | Part Name | Qty (Pcs) | Material | Description | Thk. / Diameter | W | L | Qty | Gross Qty. | Unit | Net Weight (Kg) | Scrap | Remarks
1 | مخروطی | 8 | St-37 | Plate | 2.5 | 1250 | 1820 | 1 | 44.646875 | Kg | 31 | 44.02217742% | -
2 | رینگ و سیخک | 6 | St-37 | Plate | 3 | 1000 | 4420 | 1 | 104.091 | Kg | 78 | 33.45% | -
3 | فلنج | 8 | St-37 | Plate | 4 | 1250 | 800 | 1 | 31.4 | Kg | 14 | 124.2857143% | -
4 | پایه و صفحه | 14 | St-37 | Plate | 8 | 1500 | 1500 | 1 | 141.3 | Kg | 117 | 20.76923077% | -
5 | پیچ | 54 | گالوانیزه سرد | پیچ شش گوش | M | 16 | 40 | 54 | 54 | Pcs | - | - | -
6 | مهره | 54 | گالوانیزه سرد | مهره کاسه نمددار | M | 16 | - | 54 | 54 | Pcs | - | - | -

Sheet: Over Flow-BOM
محصول |  |  |  | زیرمحصول |  |  | مجموعه |  |  |  |  | قطعه |  |  |  |  |  | فرآیند
کد محصول | تعداد در سفارش | کد زیر محصول | شرح | تعداد در محصول | تعداد در سفارش | کد مجموعه | شرح | تعداد در زیر محصول | تعداد در سفارش | شمارنده | شرح | مشخصات | تعداد در زیر محصول | تعداد در محصول | تعداد در سفارش | مقدار خالص | واحد | نفر ساعت
 |  |  | Over Flow |  |  |  |  |  |  | 1 | لوله سرریز | Ø110x850 | 1 | 1 | 1 | 1 | Pcs
 |  |  |  |  |  |  |  |  |  | 2 | قیفی سرریز | - | 1 | 1 | 1 | 1 | Pcs
 |  |  |  |  |  |  |  |  |  | 3 | لاستیک سرریز | - | 1 | 1 | 1 | 1 | Pcs
 |  |  |  |  |  |  |  |  |  | 4 | پیچ شش گوش | M12x140 | 1 | 1 | 1 | 1 | Pcs
 |  |  |  |  |  |  |  |  |  | 5 | مهره شش گوش | M12 | 1 | 1 | 1 | 1 | Pcs

Sheet: OverFlow-MTO
 |  |  |  |  |  | Specification (mm)
Pos. | Part Name | Qty (Pcs) | Material | Description | Thk. / Diameter | W | L | Qty | Gross Qty. | Unit | Net Weight (Kg) | Scrap | Remarks
1 | لوله سرریز | 1 | P.V.C | لوله | Ø110 | Thk=5 | 850 | 1 | 1 | Pcs | - | - | -
2 | قیفی سرریز | 1 | Aluminium | قطعه پیش ساخته | - | - | - | 1 | 1 | Pcs | - | - | -
3 | لاستیک سرریز | 1 | لاستیک | قطعه پیش ساخته | - | - | - | 1 | 1 | Pcs | - | - | -
4 | پیچ | 1 | گالوانیزه سرد | پیچ شش گوش | M | 12 | 140 | 1 | 1 | Pcs | - | - | -
5 | مهره | 1 | گالوانیزه سرد | مهره شش گوش | M | 12 |  | 1 | 1 | Pcs | - | - | -

Sheet: Nozzle Bank-BOM
محصول |  |  |  | زیرمحصول |  |  | مجموعه |  |  |  |  | قطعه |  |  |  |  |  | فرآیند
کد محصول | تعداد در سفارش | کد زیر محصول | شرح | تعداد در محصول | تعداد در سفارش | کد مجموعه | شرح | تعداد در زیر محصول | تعداد در سفارش | شمارنده | شرح | مشخصات | تعداد در زیر محصول | تعداد در محصول | تعداد در سفارش | مقدار خالص | واحد | نفر ساعت
 |  |  | Nozzle Bank |  |  |  |  |  |  | 1 | لوله رایز | Ø40x3000 | 20 | 20 | 20 | 20 | Pcs
 |  |  |  |  |  |  |  |  |  | 2 | درپوش رایزر | - | 20 | 20 | 20 | 20 | Pcs
 |  |  |  |  |  |  |  |  |  | 3 | بدنه افشانک | - | 790 | 790 | 790 | 790 | Pcs
 |  |  |  |  |  |  |  |  |  | 4 | سری افشانک | - | 790 | 790 | 790 | 790 | Pcs
 |  |  |  |  |  |  |  |  |  | 5 | واشر افشانک | - | 790 | 790 | 790 | 790 | Pcs
 |  |  |  |  |  |  |  |  |  | 6 | بست استیل | - | 790 | 790 | 790 | 790 | Pcs

Sheet: Nozzle Bank-MTO
 |  |  |  |  |  | Specification (mm)
Pos. | Part Name | Qty (Pcs) | Material | Description | Thk. / Diameter | W | L | Qty | Gross Qty. | Unit | Net Weight (Kg) | Scrap | Remarks
1 | لوله رایزر | 20 | P.V.C | لوله | Ø40 | Thk=3 | 3000 | 20 | 20 | Pcs | - | - | -
2 | درپوش رایزر | 20 | P.V.C | قطعه پیش ساخته | - | - | - | 20 | 20 | Pcs | - | - | -
3 | بدنه افشانک | 790 | پلی کربنات | قطعه پیش ساخته | - | - | - | 790 | 790 | Pcs | - | - | -
4 | سری افشانک | 790 | پلی پروپلین | قطعه پیش ساخته | - | - | - | 790 | 790 | Pcs | - | - | -
5 | واشر افشانک | 790 | لاستیک | قطعه پیش ساخته | - | - | - | 790 | 790 | Pcs | - | - | -
6 | بست استیل | 790 | استیل نگیر | قطعه پیش ساخته | - | - | - | 790 | 790 | Pcs | - | - | -

Sheet: Eliminator-BOM
محصول |  |  |  | زیرمحصول |  |  | مجموعه |  |  |  |  | قطعه |  |  |  |  |  | فرآیند
کد محصول | تعداد در سفارش | کد زیر محصول | شرح | تعداد در محصول | تعداد در سفارش | کد مجموعه | شرح | تعداد در زیر محصول | تعداد در سفارش | شمارنده | شرح | مشخصات | تعداد در زیر محصول | تعداد در محصول | تعداد در سفارش | مقدار خالص | واحد | نفر ساعت
 |  |  | Eliminator |  |  |  |  |  |  | 1 | تیغه الیمیناتور | L=3000 | 140 | 140 | 140 | 182 | Kg
 |  |  |  |  |  |  |  |  |  | 2 | میله الیمیناتور | - | 200 | 200 | 200 | 200 | Pcs
 |  |  |  |  |  |  |  |  |  | 3 | مهره برنجی | - | 200 | 200 | 200 | 200 | Pcs
 |  |  |  |  |  |  |  |  |  | 4 | فاصله آخر | - | 200 | 200 | 200 | 200 | Pcs
 |  |  |  |  |  |  |  |  |  | 5 | فاصله میانی | - | 2600 | 2600 | 2600 | 2600 | Pcs
 |  |  |  |  |  |  |  |  |  | 6 | مهره شش گوش | M5 | 200 | 200 | 200 | 200 | Pcs

Sheet: Elimintor-MTO
 |  |  |  |  |  | Specification (mm)
Pos. | Part Name | Qty (Pcs) | Material | Description | Thk. / Diameter | W | L | Qty | Gross Qty. | Unit | Net Weight (Kg) | Scrap | Remarks
1 | تیغه الیمیناتور | 140 | A.B.S | مواد خام | - | - | 3000 | 140 | 182 | Kg | 182 | 0% | -
2 | میله الیمیناتور | 200 | مسوار | قطعه پیش ساخته | - | - | - | 200 | 200 | Pcs | - | - | -
3 | مهره | 200 | گالوانیزه سرد | مهره شش گوش | M | 5 | - | 200 | 200 | Pcs | - | - | -
4 | مهره برنجی | 200 | Brass | قطعه پیش ساخته | - | - | - | 200 | 200 | Pcs | - | - | -
5 | فاصله آخر | 200 | پلی استایرن | قطعه پیش ساخته | - | - | - | 200 | 200 | Pcs | - | - | -
6 | فاصله میانی | 2600 | پلی استایرن | قطعه پیش ساخته | - | - | - | 2600 | 2600 | Pcs | - | - | -
