koalium/centidocs/elec/plc/Wiring diagram/10409&146010-Simabaft/AC-3&4-Control Part list.xlsx

SIMA BAFT AC-3
NO. | QTY | PART NAME | DESCRIPTION | ORDER NO | UNIT
1 | 1 | PLC | PLC Siemens S7-1200 CPU Compact 1215C AC/DC/RLY | 6ES7 215-1BG40-0XB0 | PCS
2 | 1 | PLC MODULE | DI/DO Module Siemens S7-1200 SM 1223 DI8/DQ8x relay | 6ES7 223-1PH32-0XB0 | PCS
3 | 1 | PLC MODULE | DI Module Siemens S7-1200 SM 1221 DI16x 24VDC | 6ES7 221-1BH32-0XB0 | PCS
4 | 1 | PLC MODULE | DO Module Siemens S7-1200 SM 1221 DQ8xDC | 6ES7 222-1BF32-0XB0 | PCS
5 | 1 | PLC MODULE | AI Module Siemens S7-1200 SM 1231 AI4 | 6ES7 231-4HD32-0XB0 | PCS
6 | 1 | PLC MODULE | AO Module Siemens S7-1200 SM 1232 AQ4 | 6ES7 232-4HD32-0XB0 | PCS
7 | 1 | HMI | HMI Siemens 24VDC/Ethernet/7" | 6AV2 123-2GB03-0AX0 | PCS
SIMA BAFT AC-4
NO. | QTY | PART NAME | DESCRIPTION | ORDER NO | UNIT
1 | 1 | PLC | PLC Siemens S7-1200 CPU Compact 1215C AC/DC/RLY | 6ES7 215-1BG40-0XB0 | PCS
2 | 2 | PLC MODULE | DI/DO Module Siemens S7-1200 SM 1223 DI8/DQ8x relay | 6ES7 223-1PH32-0XB0 | PCS
3 | 1 | PLC MODULE | DI Module Siemens S7-1200 SM 1221 DI8x 24VDC | 6ES7 221-1BF32-0XB0 | PCS
4 | 1 | PLC MODULE | AI Module Siemens S7-1200 SM 1231 AI4 | 6ES7 231-4HF32-0XB0 | PCS
5 | 1 | PLC MODULE | AO Module Siemens S7-1200 SM 1232 AQ4 | 6ES7 232-4HD32-0XB0 | PCS
6 | 1 | HMI | HMI Siemens 24VDC/Ethernet/7" | 6AV2 123-2GB03-0AX0 | PCS
