koalium/centidocs/Rezaei/17153/Doc/BOM/BOM-400-108-208.xlsx

Bill of Material (B.O.M.) |  |  |  |  |  |  |  | Centigrade Ind. Inc.
Order NO.17153-400-108-208 |  | Product : Fan Ring & Plenum |  |  | Client : Aban Air Cooler
Contract NO.: |  | Contract Date : |  |  | Delivery Date :
محصول |  | زیر محصول |  |  |  | قطعه
کد محصول | تعداد در سفارش | کد زیر محصول | شرح | تعداد در محصول | تعداد در سفارش | پیش کد محصول | شمارنده | شرح | تعداد در زیر محصول | تعداد در محصول | تعداد در سفارش
--- | --- | --- | Plenum | 1 | 2 | --- | 1 | 1L | 2 | 2 | 4
--- | --- | --- | --- | --- | --- | --- | 2 | 1R | 2 | 2 | 4
--- | --- | --- | --- | --- | --- | --- | 3 | 1M | 2 | 2 | 4
--- | --- | --- | --- | --- | --- | --- | 4 | 3L | 2 | 2 | 4
--- | --- | --- | --- | --- | --- | --- | 5 | 3R | 2 | 2 | 4
--- | --- | --- | --- | --- | --- | --- | 6 | 3M | 2 | 2 | 4
--- | --- | --- | --- | --- | --- | --- | 7 | 2L | 2 | 2 | 4
--- | --- | --- | --- | --- | --- | --- | 8 | 2R | 2 | 2 | 4
--- | --- | --- | --- | --- | --- | --- | 9 | 2M1 | 2 | 2 | 4
--- | --- | --- | --- | --- | --- | --- | 10 | 2M2 | 2 | 2 | 4
--- | --- | --- | --- | --- | --- | --- | 11 | 2M3 | 2 | 2 | 4
--- | --- | --- | --- | --- | --- | --- | 12 | 4M | 4 | 4 | 8
--- | --- | --- | --- | --- | --- | --- | 13 | 4L1 | 2 | 2 | 4
--- | --- | --- | --- | --- | --- | --- | 14 | 4L2 | 2 | 2 | 4
--- | --- | --- | --- | --- | --- | --- | 15 | 4R1 | 2 | 2 | 4
--- | --- | --- | --- | --- | --- | --- | 16 | 4R2 | 2 | 2 | 4
--- | --- | --- | Fan Ring | 2 | 4 | --- | 1 | Ring Sector | 4 | 8 | 16
--- | --- | --- | --- | --- | --- | --- | 2 | Side Flange | 8 | 16 | 32
