koalium/centidocs/Q.C/Shooli/2-HVAC BOM (pcs)/Archieve/Airwasher 4500x3500 BOM & MTO.xlsx

Sheet: Eliminator
محصول |  |  |  | زیرمحصول |  |  | مجموعه |  |  |  |  | قطعه |  |  |  |  |  | فرآیند
کد محصول | تعداد در سفارش | کد زیر محصول | شرح | تعداد در محصول | تعداد در سفارش | کد مجموعه | شرح | تعداد در زیر محصول | تعداد در سفارش | شمارنده | شرح | مشخصات | تعداد در زیر محصول | تعداد در محصول | تعداد در سفارش | مقدار خالص | واحد | نفر ساعت
 |  |  |  |  |  |  |  |  |  | 1 | نبشی عرضی پایین 1 | 1.5x97x2292 | 6 | 6 | 6 | 15.71 | Kg
 |  |  |  |  |  |  |  |  |  | 2 | نبشی عرضی پایین 2 | 1.5x97x2128 | 6 | 6 | 6 | 14.58 | Kg
 |  |  |  |  |  |  |  |  |  | 3 | پایه | 1.5x250x275 | 5 | 5 | 5 | 4.05 | Kg
 |  |  |  |  |  |  |  |  |  | 4 | پیچ شش گوش | M8x25 | 24 | 24 | 24 | 24 | Pcs
 |  |  |  |  |  |  |  |  |  | 5 | مهره شش گوش | M8 | 24 | 24 | 24 | 24 | Pcs
 |  |  |  |  |  |  |  |  |  | 6 | نبشی نردبانی | 1.5x97x1797 | 8 | 8 | 8 | 16.42 | Kg
 |  |  |  |  |  |  |  |  |  | 7 | رابط نردبانی | 1.5x77x270 | 16 | 16 | 16 | 3.92 | Kg
 |  |  |  |  |  |  |  |  |  | 8 | نبشی عرضی بالا 1 | 1.5x137x2292 | 2 | 2 | 2 | 7.39 | Kg
 |  |  |  |  |  |  |  |  |  | 9 | نبشی عرضی بالا 2 | 1.5x137x2128 | 2 | 2 | 2 | 6.87 | Kg
 |  |  |  |  |  |  |  |  |  | 10 | درزگیر | 1.5x97x1723 | 8 | 8 | 8 | 15.74 | Kg
 |  |  |  |  |  |  |  |  |  | 11 | ستون میانی | 1.5x240x1723 | 4 | 4 | 4 | 19.48 | Kg
 |  |  |  |  |  |  |  |  |  | 12 | سینی 1 | 1.5x995x2292 | 1 | 1 | 1 | 26.85 | Kg
 |  |  |  |  |  |  |  |  |  | 13 | سینی 2 | 1.5x995x2128 | 1 | 1 | 1 | 24.93 | Kg
 |  |  |  |  |  |  |  |  |  | 14 | رابط سینی | 1.5x988x160 | 1 | 1 | 1 | 1.86 | Kg
 |  |  |  |  |  |  |  |  |  | 15 | پیچ شش گوش | M6x10 | 35 | 35 | 35 | 35 | Pcs
 |  |  |  |  |  |  |  |  |  | 16 | مهره شش گوش | M6 | 35 | 35 | 35 | 35 | Pcs
 |  |  |  |  |  |  |  |  |  | 17 | فلنج تخلیه | 3" | 1 | 1 | 1 | 1 | Pcs
محصول |  |  |  | زیرمحصول |  |  | مجموعه |  |  |  |  | قطعه |  |  |  |  |  | فرآیند
کد محصول | تعداد در سفارش | کد زیر محصول | شرح | تعداد در محصول | تعداد در سفارش | کد مجموعه | شرح | تعداد در زیر محصول | تعداد در سفارش | شمارنده | شرح | مشخصات | تعداد در زیر محصول | تعداد در محصول | تعداد در سفارش | مقدار خالص | واحد | نفر ساعت
 |  |  |  |  |  |  |  |  |  | 18 | نبشی اتصال نبشی عرضی پایین به ستون | 2.5x75x60 | 2 | 2 | 2 | 0.18 | Kg
 |  |  |  |  |  |  |  |  |  | 19 | نبشی اتصال ستون به سینی | 2.5x75x80 | 4 | 4 | 4 | 0.47 | Kg
 |  |  |  |  |  |  |  |  |  | 20 | ناودانی اتصال سقفی | 2x80x295 | 1 | 1 | 1 | 0.37 | Kg
 |  |  |  |  |  |  |  |  |  | 21 | پیچ شش گوش | M8x25 | 64 | 64 | 64 | 64 | Pcs
 |  |  |  |  |  |  |  |  |  | 22 | مهره شش گوش | M8 | 64 | 64 | 64 | 64 | Pcs
 |  |  |  |  |  |  |  |  |  | 23 | پیچ شش گوش | M6x15 | 20 | 20 | 20 | 20 | Pcs
 |  |  |  |  |  |  |  |  |  | 24 | پیچ شش گوش | M6x10 | 35 | 35 | 35 | 35 | Pcs
 |  |  |  |  |  |  |  |  |  | 25 | مهره شش گوش | M6 | 55 | 55 | 55 | 55 | Pcs
 |  |  |  |  |  |  |  |  |  | 26 | پیچ دو سو | M5x50 | 30 | 30 | 30 | 30 | Pcs
 |  |  |  |  |  |  |  |  |  | 27 | رولپلاگ | 6x40 | 30 | 30 | 30 | 30 | Pcs
 |  |  |  |  |  |  |  |  |  | 28 | تیغه الیمیناتور | L=1696 | 408 | 408 | 408 | 301 | Kg
 |  |  |  |  |  |  |  |  |  | 29 | مهره برنجی | - | 348 | 348 | 348 | 348 | Pcs
 |  |  |  |  |  |  |  |  |  | 30 | مهره شش گوش | M5 | 348 | 348 | 348 | 348 | Pcs
 |  |  |  |  |  |  |  |  |  | 31 | میله الیمیناتور | L=304 | 348 | 348 | 348 | 348 | Pcs
 |  |  |  |  |  |  |  |  |  | 32 | فاصله میانی | - | 4547 | 4547 | 4547 | 4547 | Pcs
 |  |  |  |  |  |  |  |  |  | 33 | فاصله آخر | - | 348 | 348 | 348 | 348 | Pcs

Sheet: Air Baffle
محصول |  |  |  | زیرمحصول |  |  | مجموعه |  |  |  |  | قطعه |  |  |  |  |  | فرآیند
کد محصول | تعداد در سفارش | کد زیر محصول | شرح | تعداد در محصول | تعداد در سفارش | کد مجموعه | شرح | تعداد در زیر محصول | تعداد در سفارش | شمارنده | شرح | مشخصات | تعداد در زیر محصول | تعداد در محصول | تعداد در سفارش | مقدار خالص | واحد | نفر ساعت
 |  |  |  |  |  |  |  |  |  | 1 | ناودانی عرضی | 1.5x88x4495 | 2
 |  |  |  |  |  |  |  |  |  | 2 | ناودانی طولی | 1.5x84x3495 | 10
 |  |  |  |  |  |  |  |  |  | 3 | پیچ دوسو | M5x50 | 30
 |  |  |  |  |  |  |  |  |  | 4 | رولپلاک | 5x50
 |  |  |  |  |  |  |  |  |  | 5 | شبکه ایربافل | 300x600
 |  |  |  |  |  |  |  |  |  | 6 | چفت | --
 |  |  |  |  |  |  |  |  |  | 7 | بست | --
 |  |  |  |  |  |  |  |  |  | 8 | پیچ شش گوش | M6x40
 |  |  |  |  |  |  |  |  |  | 9 | مهره | M6
 |  |  |  |  |  |  |  |  |  | 10 | ناودانی عرضی داخل | 1.5x88x900
 |  |  |  |  |  |  |  |  |  | 11 | ناودانی طولی داخل | 1.5x88x600
 |  |  |  |  |  |  |  |  |  | 12 | ناودانی عرضی بیرون | 1.5x88x900
 |  |  |  |  |  |  |  |  |  | 13 | ناودانی طولی بیرون | 1.5x88x600

Sheet: Nozzle Bank
محصول |  |  |  | زیرمحصول |  |  | مجموعه |  |  |  |  | قطعه |  |  |  |  |  | فرآیند
کد محصول | تعداد در سفارش | کد زیر محصول | شرح | تعداد در محصول | تعداد در سفارش | کد مجموعه | شرح | تعداد در زیر محصول | تعداد در سفارش | شمارنده | شرح | مشخصات | تعداد در زیر محصول | تعداد در محصول | تعداد در سفارش | مقدار خالص | واحد | نفر ساعت
 |  |  |  |  |  |  |  |  |  | 1 | لوله کلکتور | Ø90x3952
 |  |  |  |  |  |  |  |  |  | 2 | درپوش کلکتور | -
 |  |  |  |  |  |  |  |  |  | 3 | فلنج جوشی کلکتور | -
 |  |  |  |  |  |  |  |  |  | 4 | فلنج فلزی | 8x210x210
 |  |  |  |  |  |  |  |  |  | 5 | فنجانی جوشی کلکتور | -
 |  |  |  |  |  |  |  |  |  | 6 | درپوش فنجانی | -
 |  |  |  |  |  |  |  |  |  | 7 | بوش تفلون رایزر
 |  |  |  |  |  |  |  |  |  | 8 | اورینگ فنجانی
 |  |  |  |  |  |  |  |  |  | 9 | لوله رایزر | Ø40x4900
 |  |  |  |  |  |  |  |  |  | 10 | درپوش رایزر | -
 |  |  |  |  |  |  |  |  |  | 11 | بدنه افشانک | -
 |  |  |  |  |  |  |  |  |  | 12 | سری افشانک | -
 |  |  |  |  |  |  |  |  |  | 13 | واشر آب بند | -
 |  |  |  |  |  |  |  |  |  | 14 | بست استیل | -
 |  |  |  |  |  |  |  |  |  | 15 | ناودانی افشانک | 1.5x88x4000
 |  |  |  |  |  |  |  |  |  | 16 | بست شکلاتی | -
 |  |  |  |  |  |  |  |  |  | 17 | نبشی رایزر | 5x50x500
 |  |  |  |  |  |  |  |  |  | 18 | پیچ شش گوش | M6x30
 |  |  |  |  |  |  |  |  |  | 19 | مهره شش گوش | M6

Sheet: M.T.O.
 |  |  |  |  |  | Specification (mm)
Pos. | Part Name | Qty (Pcs) | Material | Description | Thk. / Diameter | W | L | Qty | Gross Qty. | Unit | Net Weight (Kg) | Scrap | Remarks
1
2
3
4
5
6
7
