koalium/centidocs/Q.C/Shooli/2-HVAC BOM (pcs)/Archieve/Coil 1520x2432 BOM & MTO.xlsx

Sheet: B.O.M.
محصول |  |  |  | زیرمحصول |  |  | مجموعه |  |  |  |  | قطعه |  |  |  |  |  | فرآیند
کد محصول | تعداد در سفارش | کد زیر محصول | شرح | تعداد در محصول | تعداد در سفارش | کد مجموعه | شرح | تعداد در زیر محصول | تعداد در سفارش | شمارنده | شرح | مشخصات | تعداد در زیر محصول | تعداد در محصول | تعداد در سفارش | مقدار خالص | واحد | نفر ساعت
 | 1 |  |  |  |  |  | کویل سه ردیفه W 1520 H 2432 |  | 1 | 1 | نبشی قاب عرضی | 4x95x1672 | 4 | 4 | 4 | 19.95 | Kg
 |  |  |  |  |  |  |  |  |  | 2 | ناودانی قاب طولی | 4x355x2440 | 2 | 2 | 2 | 54.4 | Kg
 |  |  |  |  |  |  |  |  |  | 3 | تیوب شیت | 6x205x1672 | 2 | 2 | 2 | 27 | Kg
 |  |  |  |  |  |  |  |  |  | 4 | کلکتور | 4x205x1652 | 2 | 2 | 2 | 21.27 | Kg
 |  |  |  |  |  |  |  |  |  | 5 | درپوش کلکتور | 4x70x142 | 4 | 4 | 4 | 1.25 | Kg
 |  |  |  |  |  |  |  |  |  | 6 | تیوب | 1/2" L=2482 | 129 | 129 | 129 | 378 | Kg
 |  |  |  |  |  |  |  |  |  | 7 | زانو جوشی | 1 1/4" | 2 | 2 | 2 | 2 | Pcs
 |  |  |  |  |  |  |  |  |  | 8 | فلنج گلویی جوشی | 1 1/4" | 2 | 2 | 2 | 2 | Pcs
 |  |  |  |  |  |  |  |  |  | 9 | لوله کلکتور | 1 1/4" L=100 | 2 | 2 | 2 | 0.54 | Kg
 |  |  |  |  |  |  |  |  |  | 10 | نبشی اتصال به دیوار | 50x50x80 | 8 | 8 | 8 | 2.4 | Kg

Sheet: M.T.O.
 |  |  |  |  |  | Specification (mm)
Pos. | Part Name | Qty (Pcs) | Material | Description | Thk. / Diameter | W | L | Qty | Gross Qty. | Unit | Net Weight (Kg) | Scrap | Remarks
1
2
3
4
5
6
7
