koalium/centidocs/Q.C/Shooli/2-HVAC BOM (pcs)/Archieve/Damper 1824x2432 BOM & MTO.xlsx

Sheet: B.O.M.
محصول |  |  |  | زیرمحصول |  |  | مجموعه |  |  |  |  | قطعه |  |  |  |  |  | فرآیند
کد محصول | تعداد در سفارش | کد زیر محصول | شرح | تعداد در محصول | تعداد در سفارش | کد مجموعه | شرح | تعداد در زیر محصول | تعداد در سفارش | شمارنده | شرح | مشخصات | تعداد در زیر محصول | تعداد در محصول | تعداد در سفارش | مقدار خالص | واحد | نفر ساعت
 | 1 |  |  |  |  |  | دمپر 2432*1824 | 1 | 1 | 1 | قاب عرضی | 1.5x370x1824 | 2 | 2 | 2 | 15.9 | Kg
 |  |  |  |  |  |  |  |  |  | 2 | قاب طولی | 1.5x370x2432 | 2 | 2 | 2 | 21.2 | Kg
 |  |  |  |  |  |  |  |  |  | 3 | ستون میانی | 1.5x260x2432 | 1 | 1 | 1 | 7.45 | Kg
 |  |  |  |  |  |  |  |  |  | 4 | تیغه دمپر | L=912 | 32 | 32 | 32 | 35 | Kg
 |  |  |  |  |  |  |  |  |  | 5 | بادامک | - | 16 | 16 | 16 | 16 | Pcs
 |  |  |  |  |  |  |  |  |  | 6 | واسطه چهار گوش | - | 32 | 16 | 16 | 16 | Pcs
 |  |  |  |  |  |  |  |  |  | 7 | فشنگی | - | 32 | 16 | 16 | 16 | Pcs
 |  |  |  |  |  |  |  |  |  | 8 | بوش تفلون | - | 48 | 32 | 32 | 32 | Pcs
 |  |  |  |  |  |  |  |  |  | 9 | واشر تخت | A12 | 16 | 16 | 16 | 16 | Pcs
 |  |  |  |  |  |  |  |  |  | 10 | اشپیل | 2.6x30 | 16 | 16 | 16 | 16 | Pcs
 |  |  |  |  |  |  |  |  |  | 11 | پیچ آلن مخروطی | M10x15 | 16 | 16 | 16 | 16 | Pcs
 |  |  |  |  |  |  |  |  |  | 12 | مهره چهار گوش | M10 | 16 | 16 | 16 | 16 | Pcs
 |  |  |  |  |  |  |  |  |  | 13 | گوشک | - | 8 | 8 | 8 | 8 | Pcs
 |  |  |  |  |  |  |  |  |  | 14 | نوار دمپر | L=2432 | 4 | 4 | 4 | 1.6 | Kg
 |  |  |  |  |  |  |  |  |  | 15 | بازو | 2x97x2332 | 2 | 2 | 2 | 7.1 | Kg
 |  |  |  |  |  |  |  |  |  | 17 | لینک | 3x30x490 | 1 | 1 | 1 | 0.35 | Kg
 |  |  |  |  |  |  |  |  |  | 18 | پیچ شش گوش | M10x15 | 40 | 40 | 40 | 40 | Pcs
 |  |  |  |  |  |  |  |  |  | 19 | مهره شش گوش | M10 | 40 | 40 | 40 | 40 | Pcs
 |  |  |  |  |  |  |  |  |  | 20 | نبشی اتصال ستون میانی | 2x30x67 | 4 | 4 | 4 | 0.13 | Pcs
 |  |  |  |  |  |  |  |  |  | 21 | نبشی اتصال قاب | 1.5x40x220 | 4 | 4 | 4 | 0.41 | Pcs
 |  |  |  |  |  |  |  |  |  | 22 | نبشی اتصال به دیوار | 40x40x50 | 4 | 4 | 4 | 0.48 | Pcs

Sheet: M.T.O.
 |  |  |  |  |  | Specification (mm)
Pos. | Part Name | Qty (Pcs) | Material | Description | Thk. / Diameter | W | L | Qty | Gross Qty. | Unit | Net Weight (Kg) | Scrap | Remarks
1
2
3
4
5
6
7
