koalium/centidocs/Q.C/Shooli/2-HVAC BOM (pcs)/Archieve/Damper 1824x2736 BOM & MTO.xlsx

Sheet: B.O.M.
محصول |  |  |  | زیرمحصول |  |  | مجموعه |  |  |  |  | قطعه |  |  |  |  |  | فرآیند
کد محصول | تعداد در سفارش | کد زیر محصول | شرح | تعداد در محصول | تعداد در سفارش | کد مجموعه | شرح | تعداد در زیر محصول | تعداد در سفارش | شمارنده | شرح | مشخصات | تعداد در زیر محصول | تعداد در محصول | تعداد در سفارش | مقدار خالص | واحد | نفر ساعت
 | 1 |  |  |  |  |  | دمپر 2736*1824 | 1 | 1 | 1 | قاب عرضی | 1.5x370x1824 | 2 | 2 | 2 | 15.9 | Kg
 |  |  |  |  |  |  |  |  |  | 2 | قاب طولی | 1.5x370x2736 | 2 | 2 | 2 | 23.84 | Kg
 |  |  |  |  |  |  |  |  |  | 3 | ستون میانی | 1.5x260x2736 | 1 | 1 | 1 | 8.38 | Kg
 |  |  |  |  |  |  |  |  |  | 4 | تیغه دمپر | L=912 | 36 | 36 | 36 | 39.4 | Kg
 |  |  |  |  |  |  |  |  |  | 5 | بادامک | - | 18 | 18 | 18 | 18 | Pcs
 |  |  |  |  |  |  |  |  |  | 6 | واسطه چهار گوش | - | 36 | 36 | 36 | 36 | Pcs
 |  |  |  |  |  |  |  |  |  | 7 | فشنگی | - | 36 | 36 | 36 | 36 | Pcs
 |  |  |  |  |  |  |  |  |  | 8 | بوش تفلون | - | 54 | 54 | 54 | 54 | Pcs
 |  |  |  |  |  |  |  |  |  | 9 | واشر تخت | A12 | 18 | 18 | 18 | 18 | Pcs
 |  |  |  |  |  |  |  |  |  | 10 | اشپیل | 2.6x30 | 18 | 18 | 18 | 18 | Pcs
 |  |  |  |  |  |  |  |  |  | 11 | پیچ آلن مخروطی | M10x15 | 18 | 18 | 18 | 18 | Pcs
 |  |  |  |  |  |  |  |  |  | 12 | مهره چهار گوش | M10 | 18 | 18 | 18 | 18 | Pcs
 |  |  |  |  |  |  |  |  |  | 13 | نوار دمپر | L=2736 | 4 | 4 | 4 | 1.75 | Kg
 |  |  |  |  |  |  |  |  |  | 14 | گوشک | - | 8 | 8 | 8 | 8 | Pcs
 |  |  |  |  |  |  |  |  |  | 15 | بازو | 2x97x2636 | 2 | 2 | 2 | 8.03 | Kg
 |  |  |  |  |  |  |  |  |  | 17 | لینک | 3x30x490 | 1 | 1 | 1 | 0.35 | Kg
 |  |  |  |  |  |  |  |  |  | 18 | پیچ شش گوش | M10x15 | 40 | 40 | 40 | 40 | Pcs
 |  |  |  |  |  |  |  |  |  | 19 | مهره شش گوش | M10 | 40 | 40 | 40 | 40 | Pcs
 |  |  |  |  |  |  |  |  |  | 20 | نبشی اتصال ستون میانی | 2x30x67 | 4 | 4 | 4 | 0.13 | Pcs
 |  |  |  |  |  |  |  |  |  | 21 | نبشی اتصال قاب | 1.5x40x220 | 4 | 4 | 4 | 0.41 | Pcs
 |  |  |  |  |  |  |  |  |  | 22 | نبشی اتصال به دیوار | 40x40x50 | 4 | 4 | 4 | 0.48 | Pcs

Sheet: M.T.O.
 |  |  |  |  |  | Specification (mm)
Pos. | Part Name | Qty (Pcs) | Material | Description | Thk. / Diameter | W | L | Qty | Gross Qty. | Unit | Net Weight (Kg) | Scrap | Remarks
1
2
3
4
5
6
7
