koalium/centidocs/jokar/0/New folder/14000101/Round Bar Chain/Rounbar Chain Assembly.SLDASM

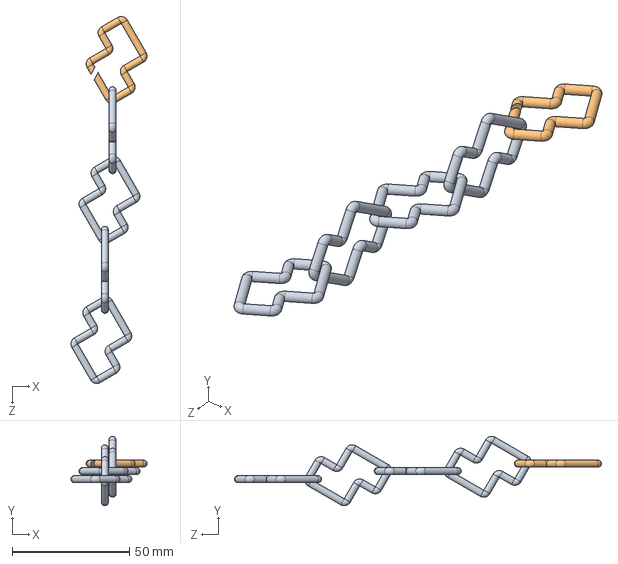
[picture p130: CAD file, 2025-05-18]
jokar/0/New folder/14000101/Round Bar Chain/Rounbar Chain Assembly.SLDASM
32.5 x 29.6 x 156.3 mm
R.B Chain x 4
R.B Chain Cutted
