koalium/centidocs/jokar/0/New folder/14000101/Twist Lock/Twist Lock Assembly.SLDASM

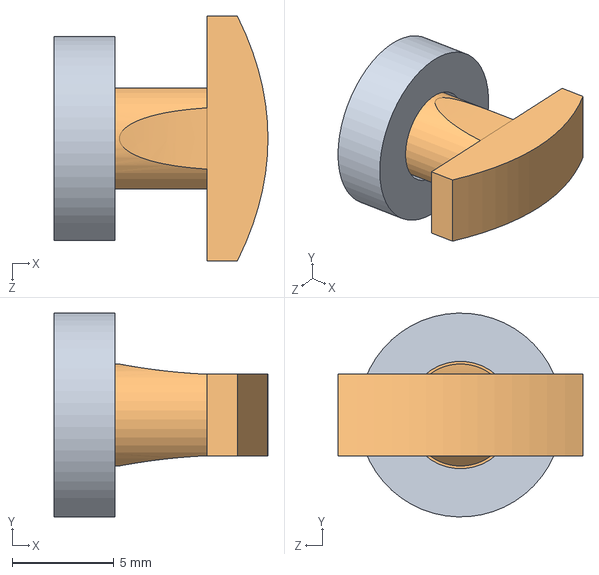
[picture p131: CAD file, 2025-05-18]
jokar/0/New folder/14000101/Twist Lock/Twist Lock Assembly.SLDASM
10.5 x 10.00 x 12.0 mm
Base
Handle
