koalium/centidocs/jokar/Air Filter Rotary 2500/DustCollector/Ass Dustcollector 2.SLDASM

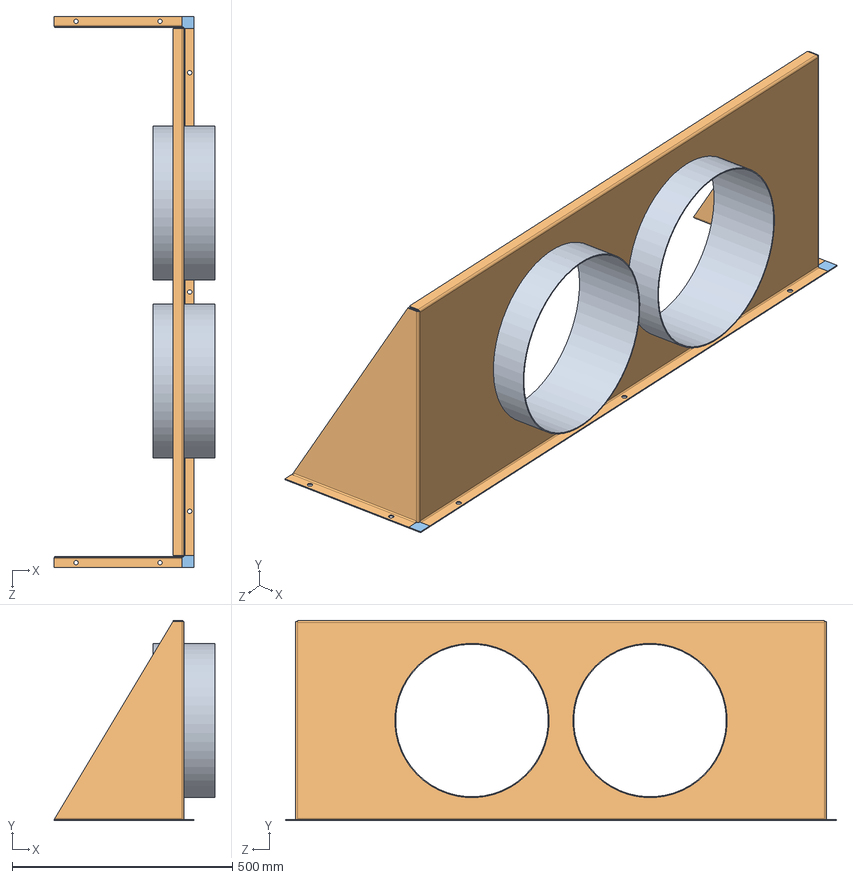
[picture p132: CAD file, 2025-05-18]
jokar/Air Filter Rotary 2500/DustCollector/Ass Dustcollector 2.SLDASM
365.0 x 454.0 x 1250.0 mm
استوانه قاب کیسه جارو x 2
صفحه قاب کیسه جاروب1
نبشی مربعی صفحه قاب x 2
