koalium/centidocs/jokar/Air Filter Rotary 2500/درام/plate punch/ass/ass punch card.SLDASM

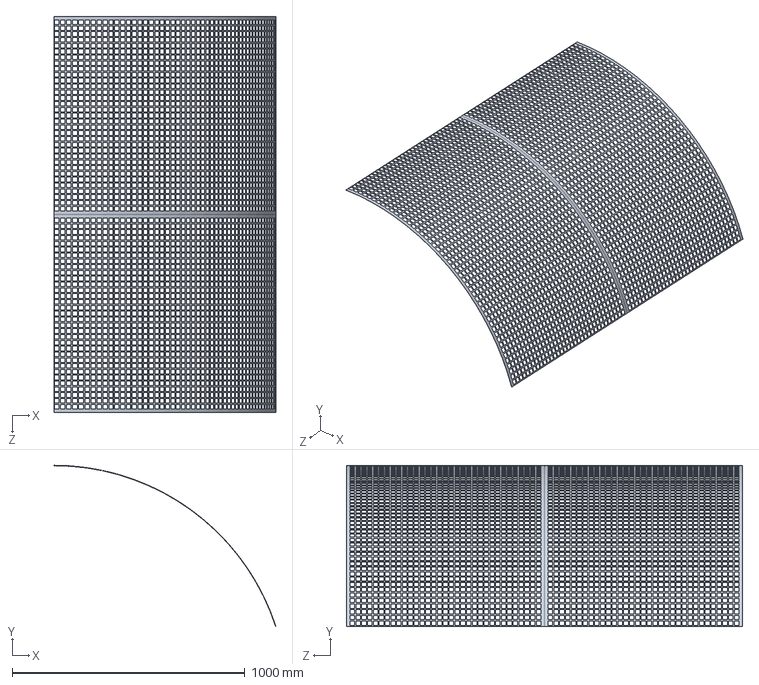
[picture p134: CAD file, 2025-05-18]
jokar/Air Filter Rotary 2500/درام/plate punch/ass/ass punch card.SLDASM
952.5 x 692.5 x 1700.0 mm
punch card x 2
