koalium/centidocs/jokar/Air Filter Rotary 2500/درام/Upn/ass/Assem upn up.SLDASM

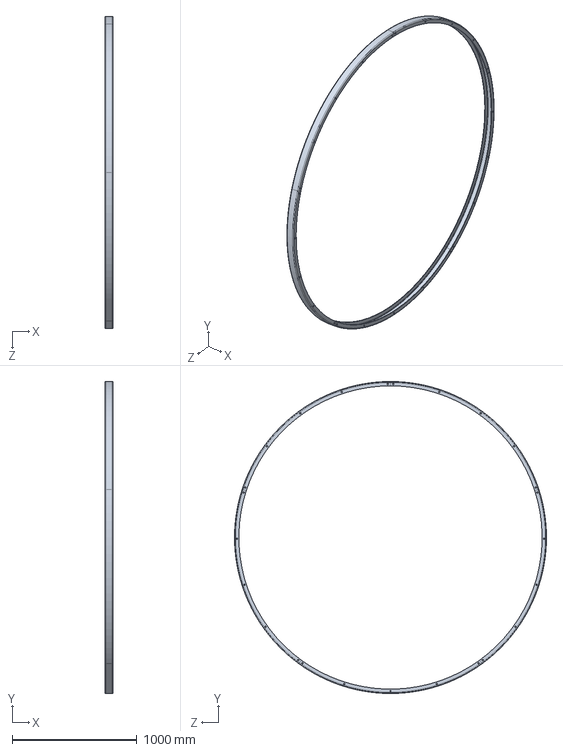
[picture p135: CAD file, 2025-05-18]
jokar/Air Filter Rotary 2500/درام/Upn/ass/Assem upn up.SLDASM
67.0 x 2500.0 x 2500.0 mm
Upn 72 drg 2 x 5
