koalium/centidocs/jokar/Air Filter Rotary 2500/درام/Upn/upn tasme.SLDPRT

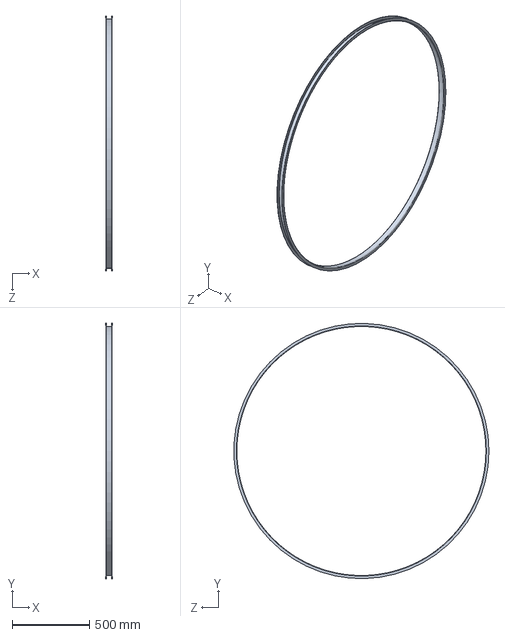
[picture p136: CAD file, 2025-05-18]
jokar/Air Filter Rotary 2500/درام/Upn/upn tasme.SLDPRT
40.0 x 1649.3 x 1648.6 mm
