koalium/centidocs/jokar/Air Filter Rotary 2500/فن حلزونی/Plasma1.dxf

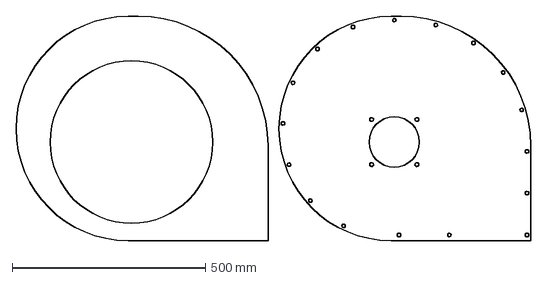
[picture p137: CAD file, 2025-05-18]
jokar/Air Filter Rotary 2500/فن حلزونی/Plasma1.dxf
1330.4 x 580.1 mm
