koalium/centidocs/jokar/Air Filter Rotary 2500/پایه ثابت/پایه ثابت.SLDASM

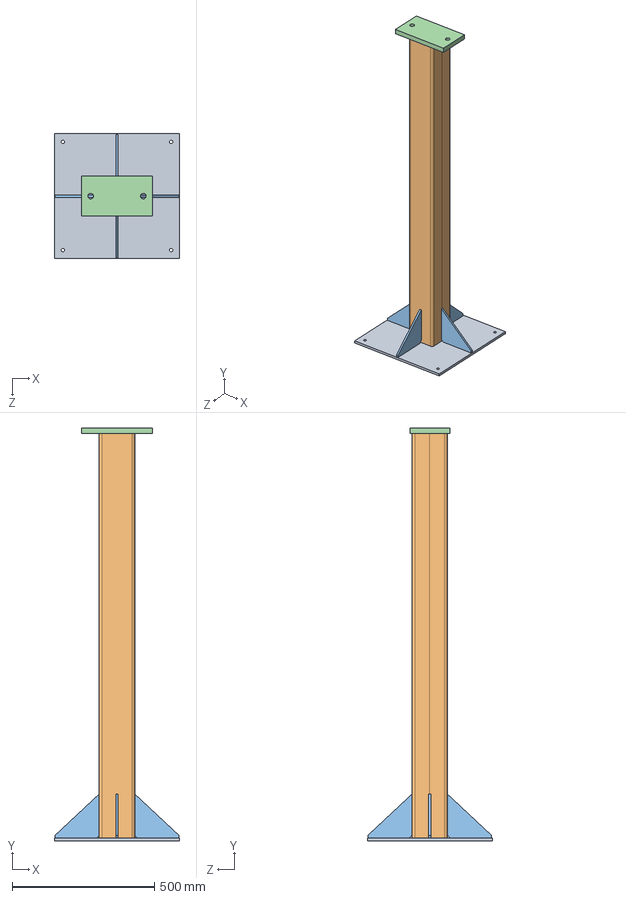
[picture p138: CAD file, 2025-05-18]
jokar/Air Filter Rotary 2500/پایه ثابت/پایه ثابت.SLDASM
440.0 x 1450.0 x 440.0 mm
صفحه زیر پایه
ناودانی پایه x 2
تقویتی پایه x 4
صفحه زیر یاتاقان
