koalium/centidocs/Q.C/Mashi/17164/E-211/SideFlange/Plasma.dxf

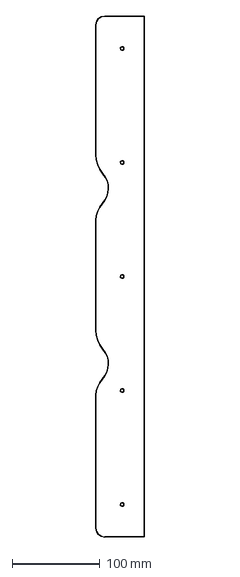
[picture p139: CAD file, 2025-05-18]
Q.C/Mashi/17164/E-211/SideFlange/Plasma.dxf
55.0 x 594.0 mm
