koalium/centidocs/Q.C/Mashi/Model/20M Left/4670 Right/Column 4670 Right Assembly.SLDASM

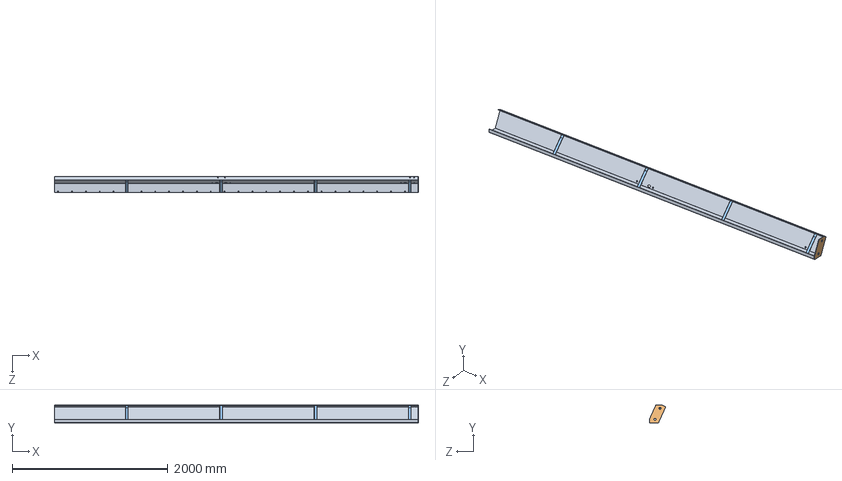
[picture p140: CAD file, 2025-05-18]
Q.C/Mashi/Model/20M Left/4670 Right/Column 4670 Right Assembly.SLDASM
4670.0 x 225.5 x 209.3 mm
Column 4670 Right
Bottom Plate I
Stiffening Angle Right x 4
