koalium/centidocs/Q.C/Mashi/Model/20M Left/5340/Column 5340.SLDASM

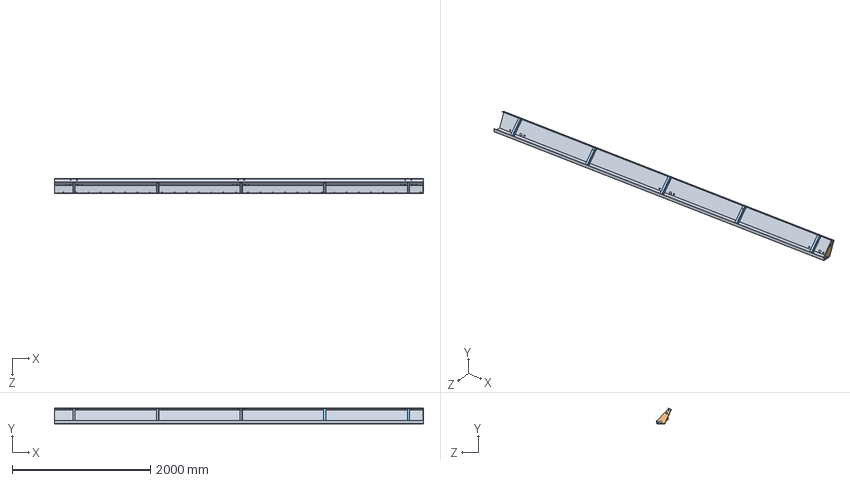
[picture p141: CAD file, 2025-05-18]
Q.C/Mashi/Model/20M Left/5340/Column 5340.SLDASM
5340.0 x 225.5 x 210.1 mm
Column 5340
Flange Plate I
Stiffeniing Angle For Thk 4 x 5
Block
