koalium/centidocs/Q.C/Mashi/Model/20M Left/Column 20 M Left Main Assembly.SLDASM

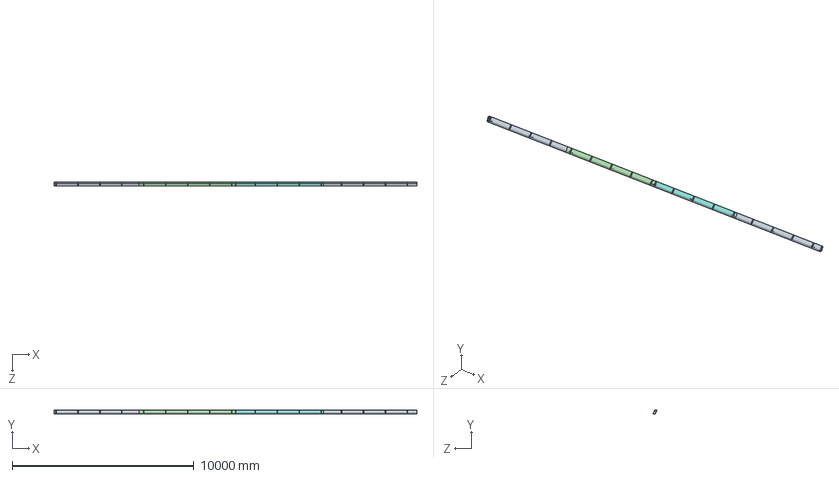
[picture p142: CAD file, 2025-05-18]
Q.C/Mashi/Model/20M Left/Column 20 M Left Main Assembly.SLDASM
20000.0 x 225.5 x 215.1 mm
Column 4670
Bottom Plate I
Stiffening Angle x 4
Column 5340
Flange Plate I x 2
Stiffeniing Angle For Thk 4 x 13
Block x 3
Column 4840
Column 5150
Cover Plate
Stiffening Plate
