koalium/centidocs/Q.C/Mashi/Model/20M Middle/4840/Column 4840 Assembly.SLDASM

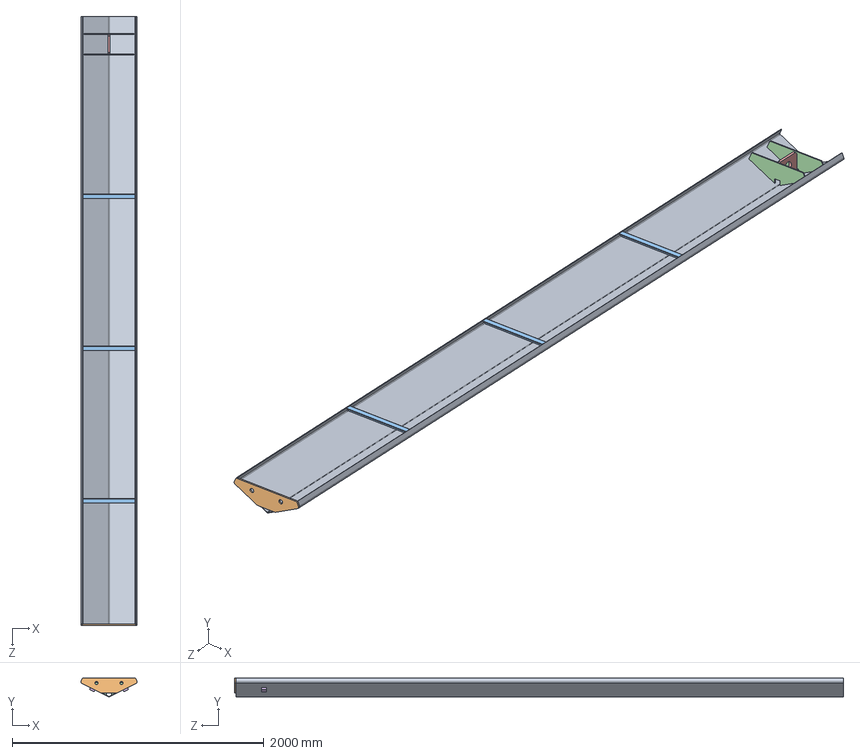
[picture p143: CAD file, 2025-05-18]
Q.C/Mashi/Model/20M Middle/4840/Column 4840 Assembly.SLDASM
448.3 x 149.9 x 4840.0 mm
Column 4840
Flange Plate 2
Stiffening Angle Thk=4 x 3
Stiffening Plate Thk=4 x 2
Lift Eye
Block x 2
