koalium/centidocs/Q.C/Mashi/Model/20M Middle/5340/Column 5340 Assembly.SLDASM

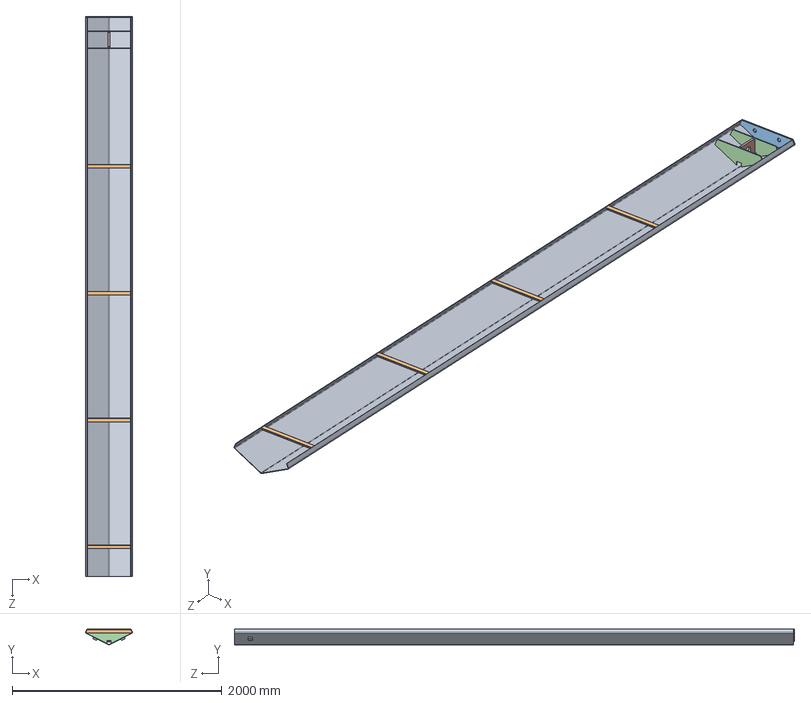
[picture p144: CAD file, 2025-05-18]
Q.C/Mashi/Model/20M Middle/5340/Column 5340 Assembly.SLDASM
448.3 x 149.9 x 5340.0 mm
Column 5340
Stiffening Angle Thk=4 x 4
Flange Plate 2
Stiffening Plate Thk=4 x 2
Lift Eye
Block x 2
