koalium/centidocs/Q.C/Mashi/Model/20M Middle/Column 20M Middle Main Assembly.SLDASM

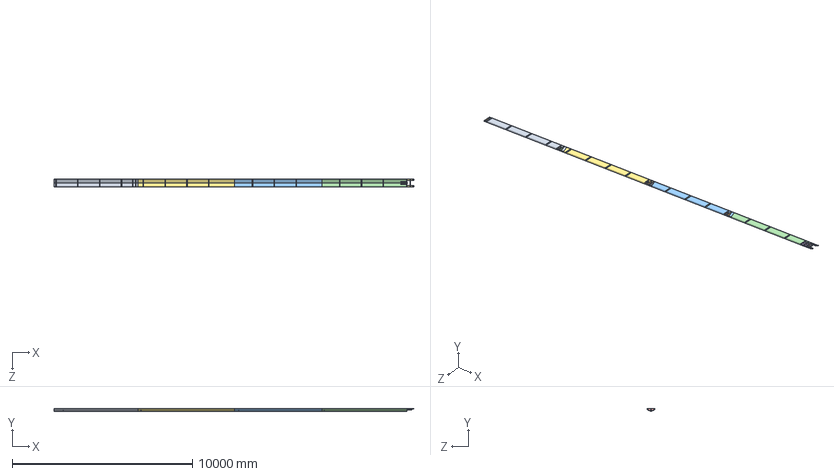
[picture p145: CAD file, 2025-05-18]
Q.C/Mashi/Model/20M Middle/Column 20M Middle Main Assembly.SLDASM
19960.0 x 152.8 x 448.3 mm
Column 4670
Bottom Plate
Stiffening Angle x 4
Stiffening Plate x 2
Lift Eye x 3
Block x 8
Column 5340
Stiffening Angle Thk=4 x 10
Flange Plate 2 x 2
Stiffening Plate Thk=4 x 4
Column 4840
Column 5110
Cover Plate x 3
Rib I x 4
Support Flat x 2
Base Plate
Rib II x 2
Tube For Pin Holding
