koalium/centidocs/Rezaei/17153/Doc/Plasma/E-400-108-208/Side Flange/Plasma.dxf

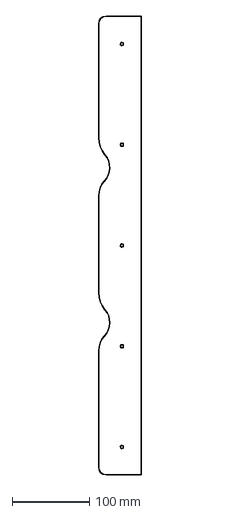
[picture p146: CAD file, 2025-05-18]
Rezaei/17153/Doc/Plasma/E-400-108-208/Side Flange/Plasma.dxf
55.0 x 592.0 mm
