koalium/centidocs/Rezaei/17153/Doc/Plasma/E-460/1l1 . 1l2/Plasma.dxf

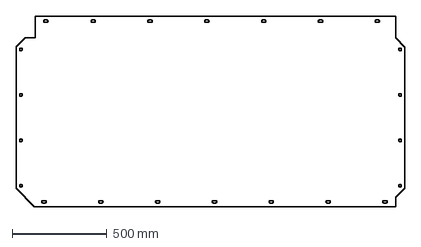
[picture p147: CAD file, 2025-05-18]
Rezaei/17153/Doc/Plasma/E-460/1l1 . 1l2/Plasma.dxf
2052.0 x 1004.0 mm
