koalium/centidocs/Rezaei/17153/Doc/Plasma/E-460/1M1 1M2/Plasma.dxf

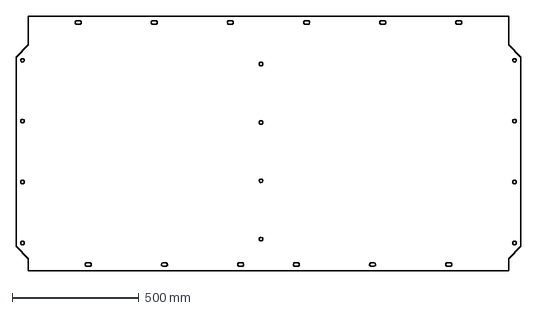
[picture p148: CAD file, 2025-05-18]
Rezaei/17153/Doc/Plasma/E-460/1M1 1M2/Plasma.dxf
1990.0 x 1004.0 mm
