koalium/centidocs/Rezaei/Disk filter/Assem-door.SLDASM

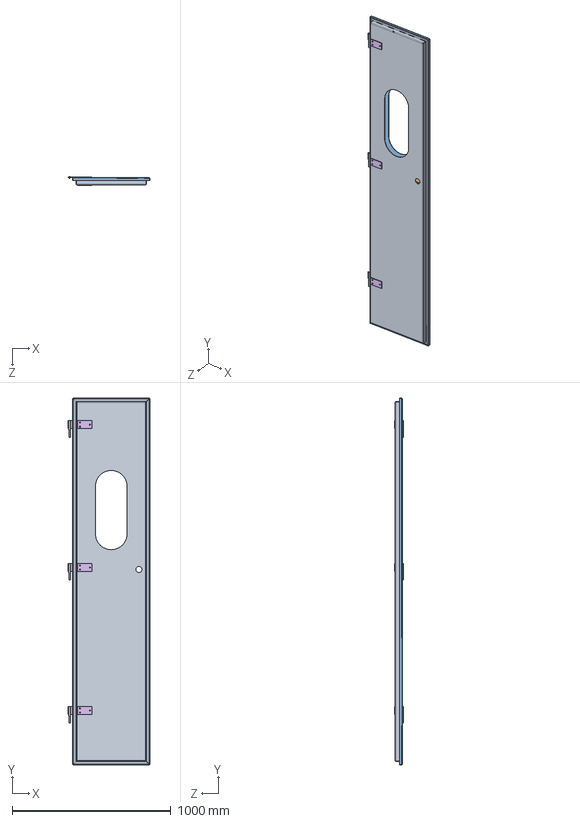
[picture p149: CAD file, 2025-05-18]
Rezaei/Disk filter/Assem-door.SLDASM
516.5 x 2312.0 x 57.0 mm
Door-plate1
door-reinforce x 3
door plate2
hinge-female2 x 3
hinge-male x 3
hinge-plate x 3
