koalium/centidocs/Rezaei/مدل نهايي چرخدنده متحرک/مدل نهایی چرخدنده متحرک.SLDASM

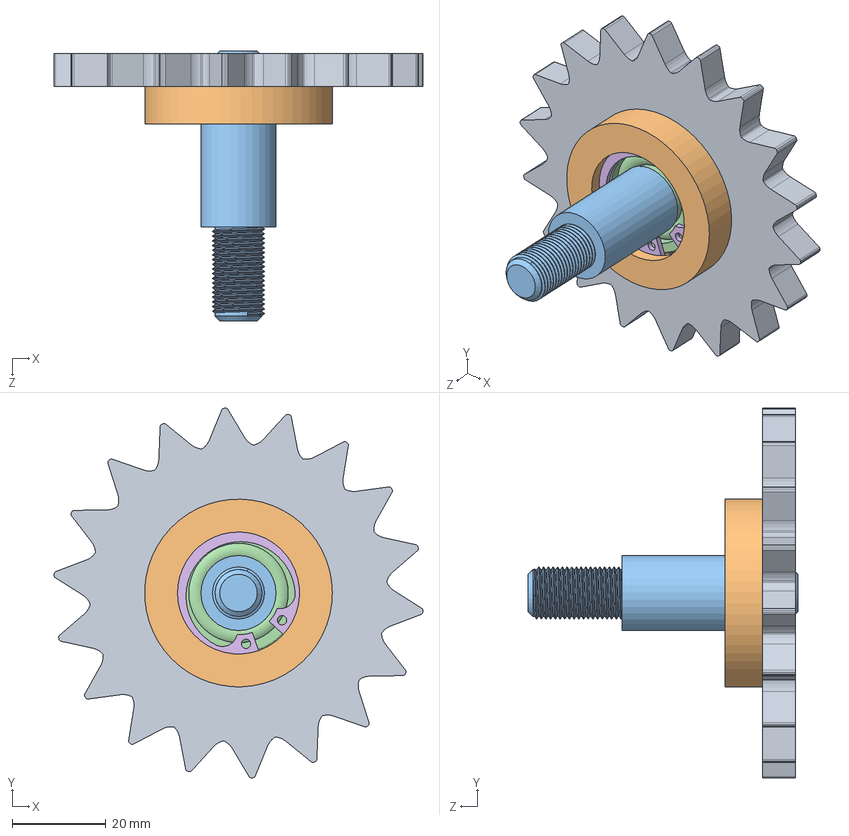
[picture p150: CAD file, 2025-05-18]
Rezaei/مدل نهايي چرخدنده متحرک/مدل نهایی چرخدنده متحرک.SLDASM
78.6 x 78.8 x 57.5 mm
چرخدنده
واشر
شفت
radial ball bearing_68_skf
circlip for shafts normal_din
circlip for bores normal_din
