koalium/centidocs/SAFARI/2300x1000/Assem Gear/Gear Assem.SLDASM

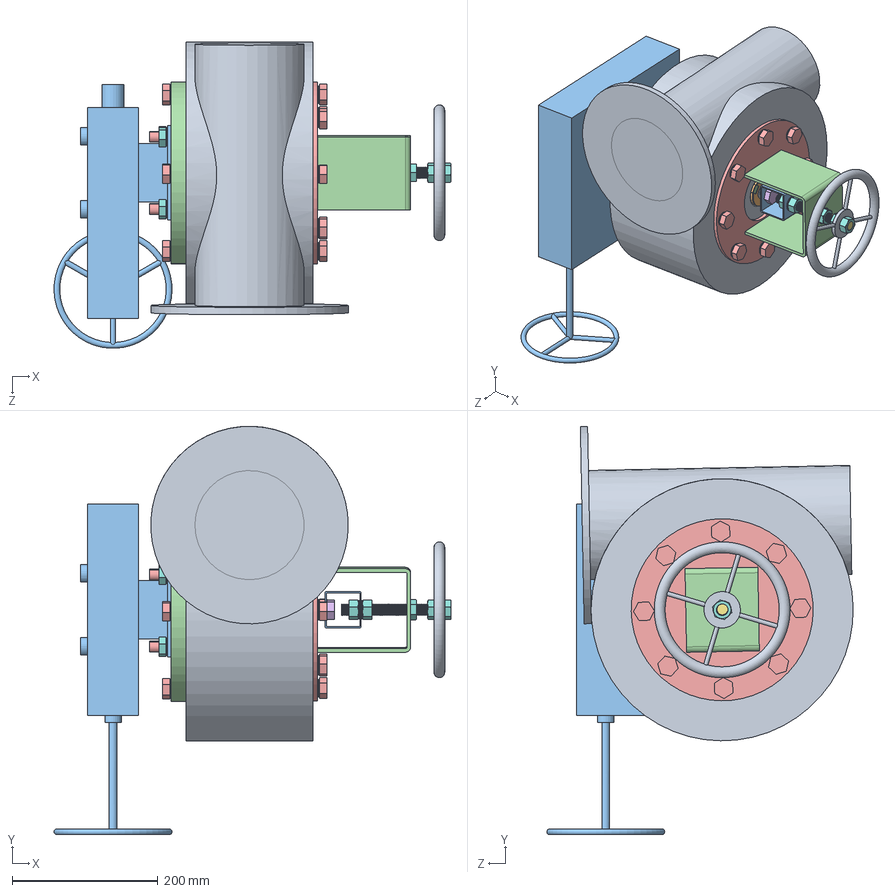
[picture p151: CAD file, 2025-05-18]
SAFARI/2300x1000/Assem Gear/Gear Assem.SLDASM
545.4 x 561.1 x 420.9 mm
Shakerin MVF86-150P-2600 N.m
G.B-handwheel shaft
Handwheel part
Coonection plate
Bolt M14x40 x 16
Spring washer M10 x 4
Washer M10 x 4
Nut M14 x 4
Spring washer M14 x 13
Washer M14 x 12
Inner box
Outer box
lock connection plate
Bolt M14x60
Threaded rod M16
Nut M16 x 5
steer wheel
Spring washer M16 x 2
Washer M16 x 2
Stud holder M14
