koalium/centidocs/jokar/0/New folder/14000101/Assem1.SLDASM

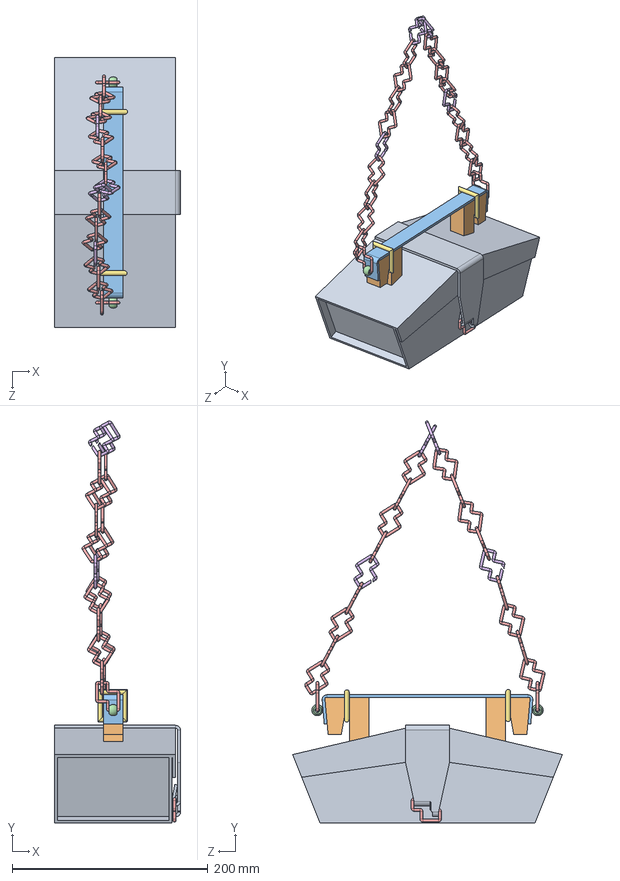
[picture p152: CAD file, 2025-05-18]
jokar/0/New folder/14000101/Assem1.SLDASM
129.0 x 411.2 x 276.0 mm
Bag
Support x 2
Strap
EyeBolt x 2
R.B Chain x 19
R.B Chain Cutted x 4
Ring x 2
