koalium/centidocs/jokar/Air Filter Rotary 2500/درام/L Angle/Ass angle.SLDASM

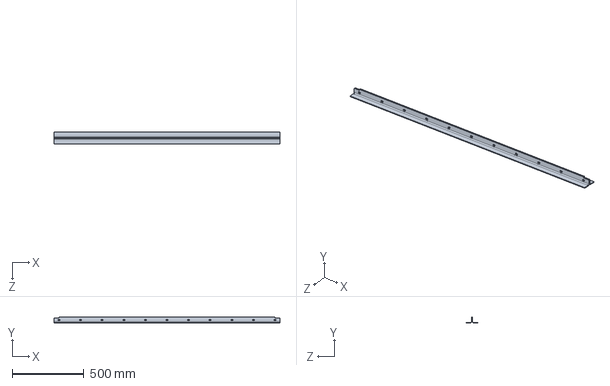
[picture p153: CAD file, 2025-05-18]
jokar/Air Filter Rotary 2500/درام/L Angle/Ass angle.SLDASM
1570.0 x 40.0 x 80.0 mm
L Angle 40x40 x 2
