koalium/centidocs/jokar/Air Filter Rotary 2500/درام/middle.SLDASM

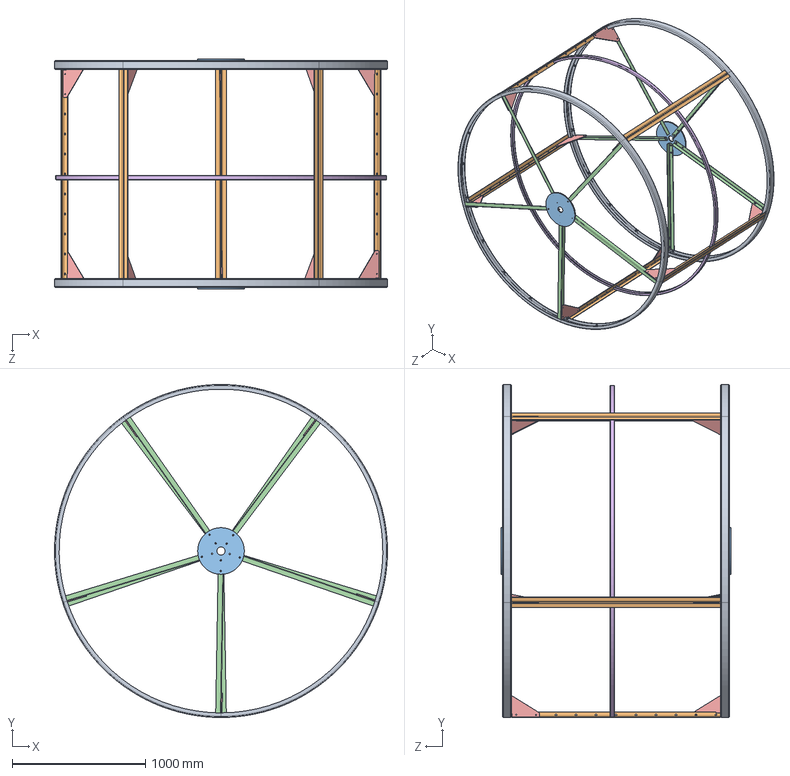
[picture p154: CAD file, 2025-05-18]
jokar/Air Filter Rotary 2500/درام/middle.SLDASM
2500.0 x 2500.0 x 1724.0 mm
Upn 72 drg 2 x 10
L Angle 40x40 x 10
plate main x 2
nabshi taghviati 40x40x1165 x 10
plate lchky x 10
upn 2mm glv x 5
