koalium/centidocs/jokar/Air Filter Rotary 2500/درام/Upn/ass/ass upn tasme.SLDASM

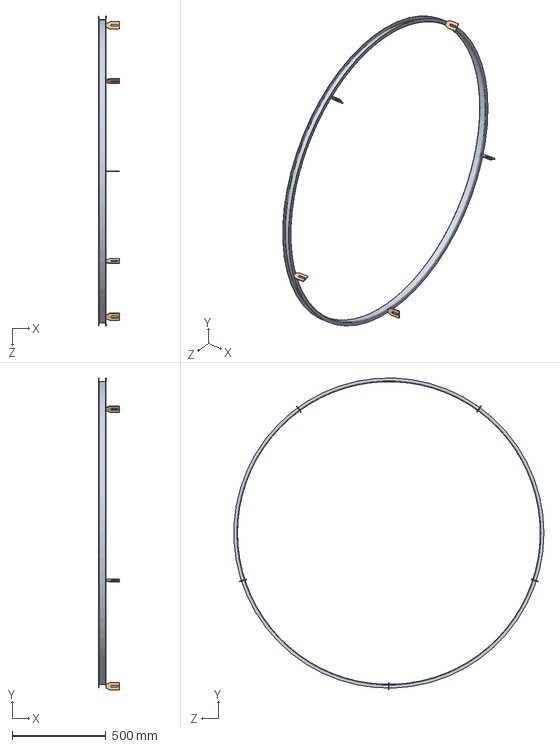
[picture p155: CAD file, 2025-05-18]
jokar/Air Filter Rotary 2500/درام/Upn/ass/ass upn tasme.SLDASM
110.0 x 1659.6 x 1648.6 mm
upn tasme
plate upn tasme x 5
