koalium/centidocs/jokar/Air Filter Rotary 2500/درام/Upn/upn main.SLDPRT

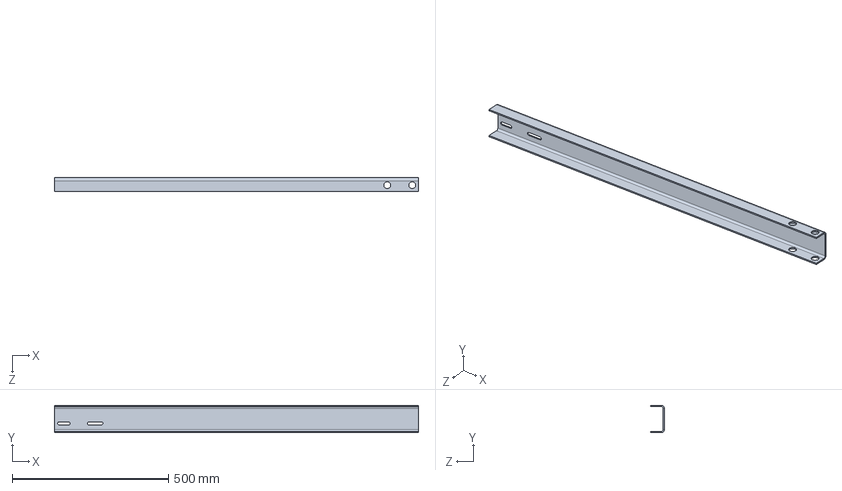
[picture p156: CAD file, 2025-05-18]
jokar/Air Filter Rotary 2500/درام/Upn/upn main.SLDPRT
1165.0 x 88.0 x 44.0 mm
