koalium/centidocs/Q.C/Mashi/00.04.08/total testing model/Assem solenoid valve.SLDASM

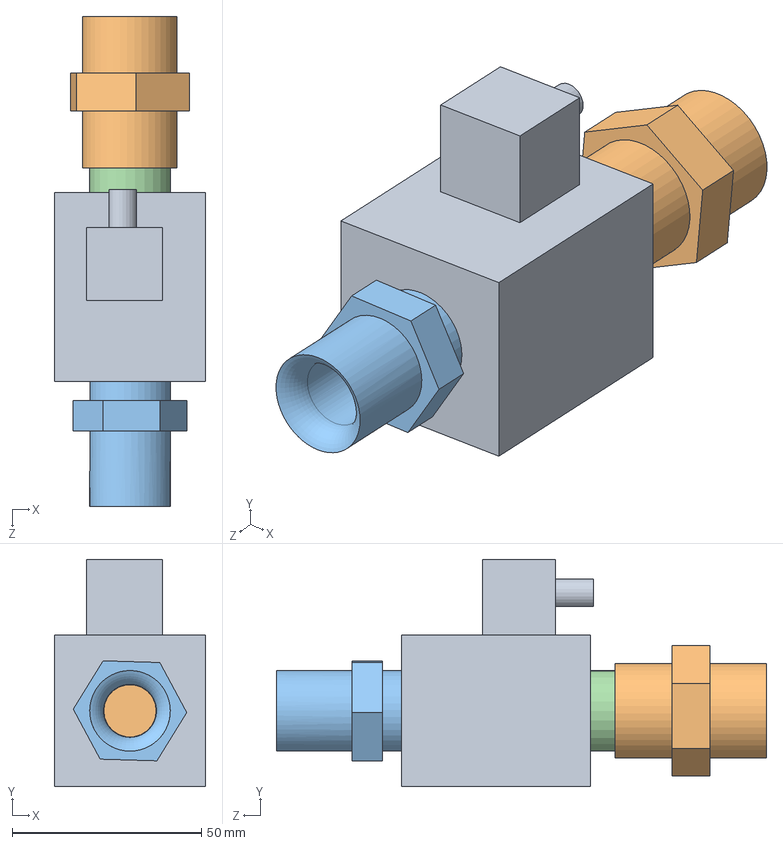
[picture p157: CAD file, 2025-05-18]
Q.C/Mashi/00.04.08/total testing model/Assem solenoid valve.SLDASM
40.0 x 60.0 x 129.5 mm
solenoid valve0.5
universal-joint-0.5-sch.40
Hex nipple-0.5-conical
weld nipple-0.5
