koalium/centidocs/Q.C/Mashi/17164/E-211/Ladder/Plasma.dxf

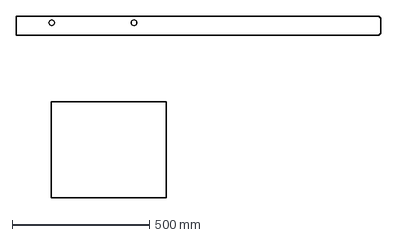
[picture p158: CAD file, 2025-05-18]
Q.C/Mashi/17164/E-211/Ladder/Plasma.dxf
1330.0 x 662.2 mm
