koalium/centidocs/jokar/0/HVAC/3000/Frame 3000/Frame 3000.SLDASM

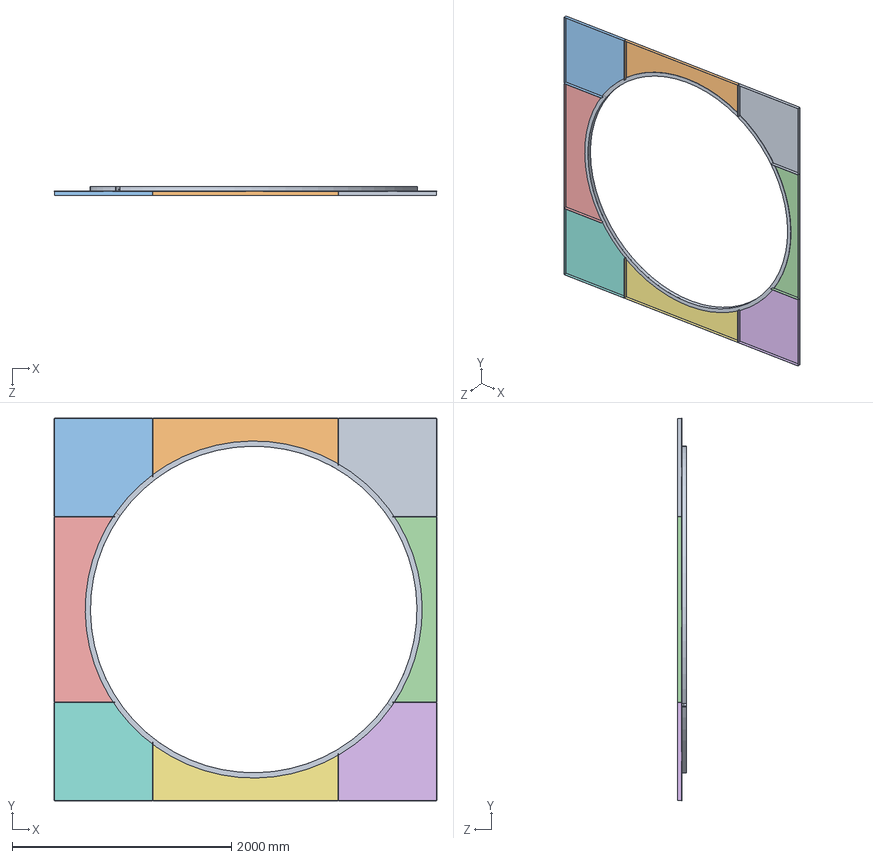
[picture p159: CAD file, 2025-05-18]
jokar/0/HVAC/3000/Frame 3000/Frame 3000.SLDASM
3496.0 x 3496.0 x 81.3 mm
Angle40-3000 x 2
