koalium/centidocs/jokar/1/Damper 6400/Blade Assembly 3.SLDASM

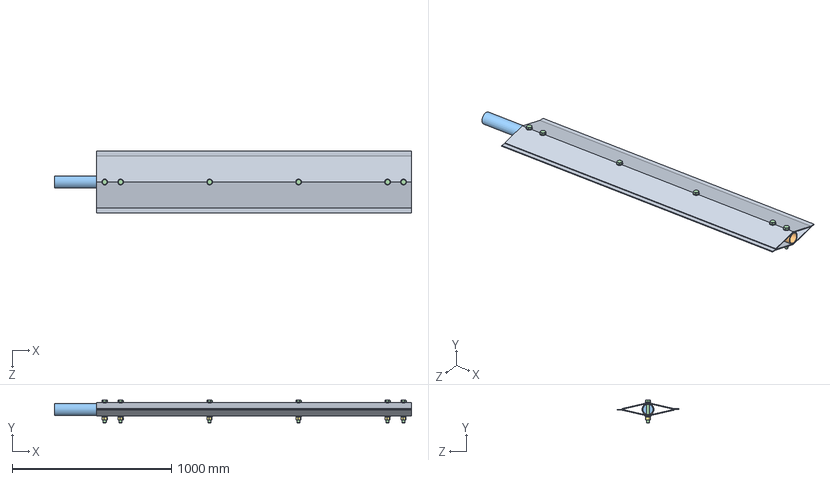
[picture p160: CAD file, 2025-05-18]
jokar/1/Damper 6400/Blade Assembly 3.SLDASM
2240.0 x 142.5 x 386.0 mm
Blade x 2
Blade Pipe
End Shaft
ssasa x 6
plain washer grade c_din x 12
wqeqweqw x 6
ppppo x 6
