koalium/centidocs/jokar/Air Filter Rotary 2500/درام/plate/plate main.SLDPRT

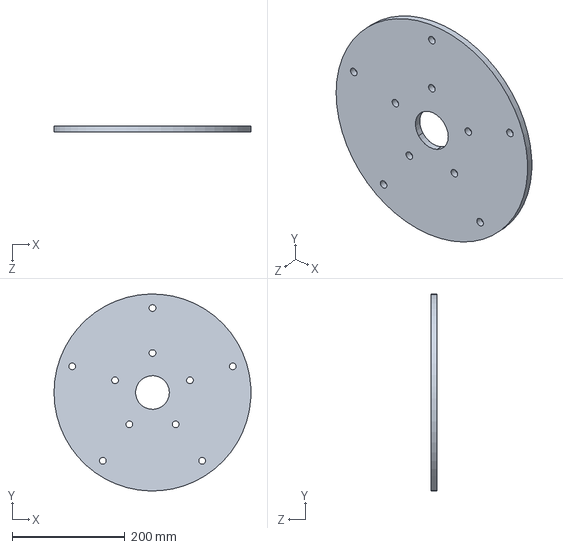
[picture p161: CAD file, 2025-05-18]
jokar/Air Filter Rotary 2500/درام/plate/plate main.SLDPRT
350.0 x 349.8 x 10.0 mm
