koalium/centidocs/jokar/Air Filter Rotary 2500/درام/Total Box.SLDASM

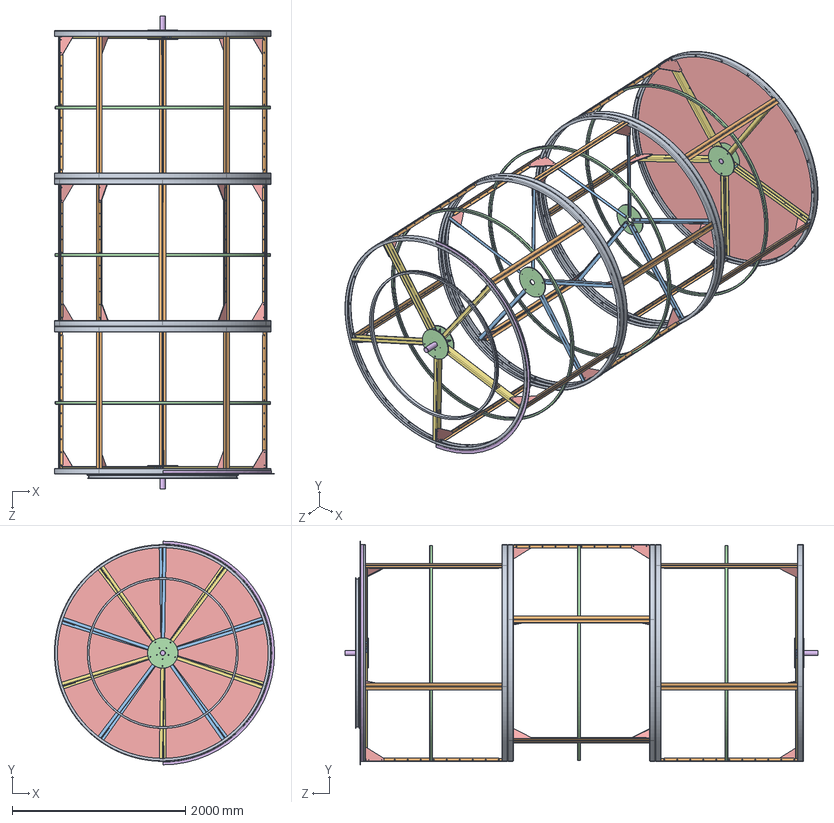
[picture p162: CAD file, 2025-05-18]
jokar/Air Filter Rotary 2500/درام/Total Box.SLDASM
2540.0 x 2580.0 x 5456.0 mm
Upn 72 drg 2 x 30
L Angle 40x40 x 30
تقویتی صفحه x 10
plate main x 6
plate lchky x 20
shafte 60 x 2
upn main 2 x 10
Pipe(OD=22) x 20
Upn360
نبشی اتصال x 5
nabshi taghviati 40x40x1165 x 10
upn 2mm glv x 15
Plate upper box glv x 5
nabshi sini
