koalium/centidocs/jokar/Air Filter Rotary 2500/پایه متحرک/مجموعه پولی تسمه سبز.SLDASM

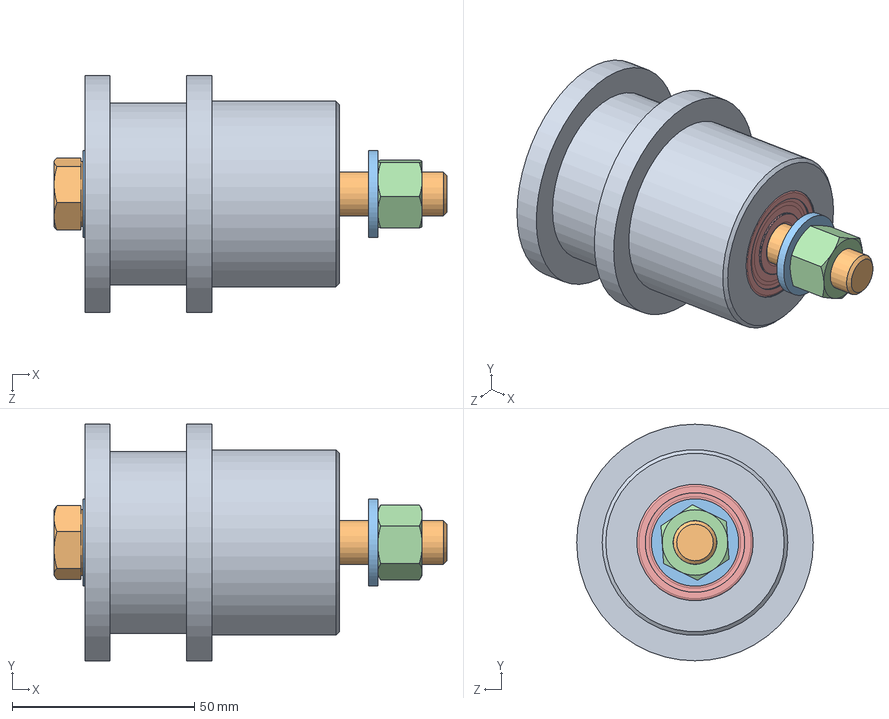
[picture p163: CAD file, 2025-05-18]
jokar/Air Filter Rotary 2500/پایه متحرک/مجموعه پولی تسمه سبز.SLDASM
108.0 x 65.0 x 65.0 mm
پولی تسمه سبز
hex screw gradec_din
plain washer grade c_din x 2
hex nut gradec_din
6201-Z x 2
