koalium/centidocs/jokar/ZH/9920007-Silencer-FINAL model 23 DECEMBER 2023 DRAWINGS/Assem-Body.SLDASM

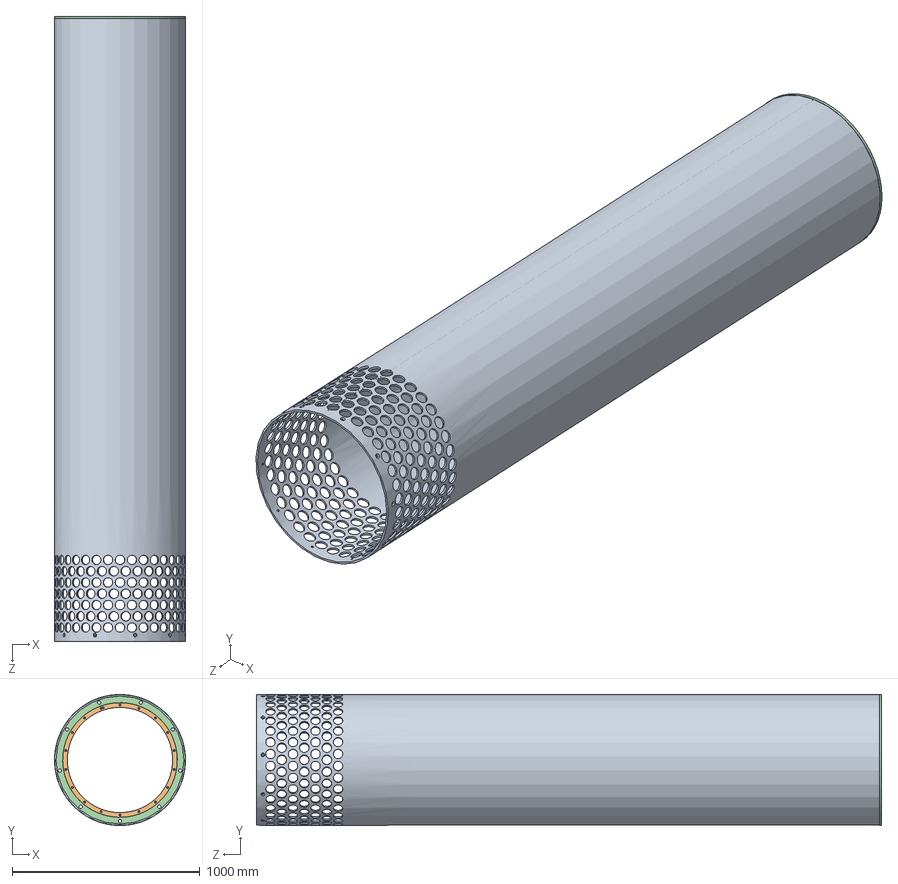
[picture p164: CAD file, 2025-05-18]
jokar/ZH/9920007-Silencer-FINAL model 23 DECEMBER 2023 DRAWINGS/Assem-Body.SLDASM
697.0 x 697.0 x 3327.0 mm
Body-Tube
Body- flange-2
hex bolt gradeab_din x 20
Body- flange-1
