koalium/centidocs/jokar/جعفر/9920007-Silencer-FINAL model 4 NOV 2023 - WITH DRAWINGS/Assem-Nozzle-Absorber1.SLDASM

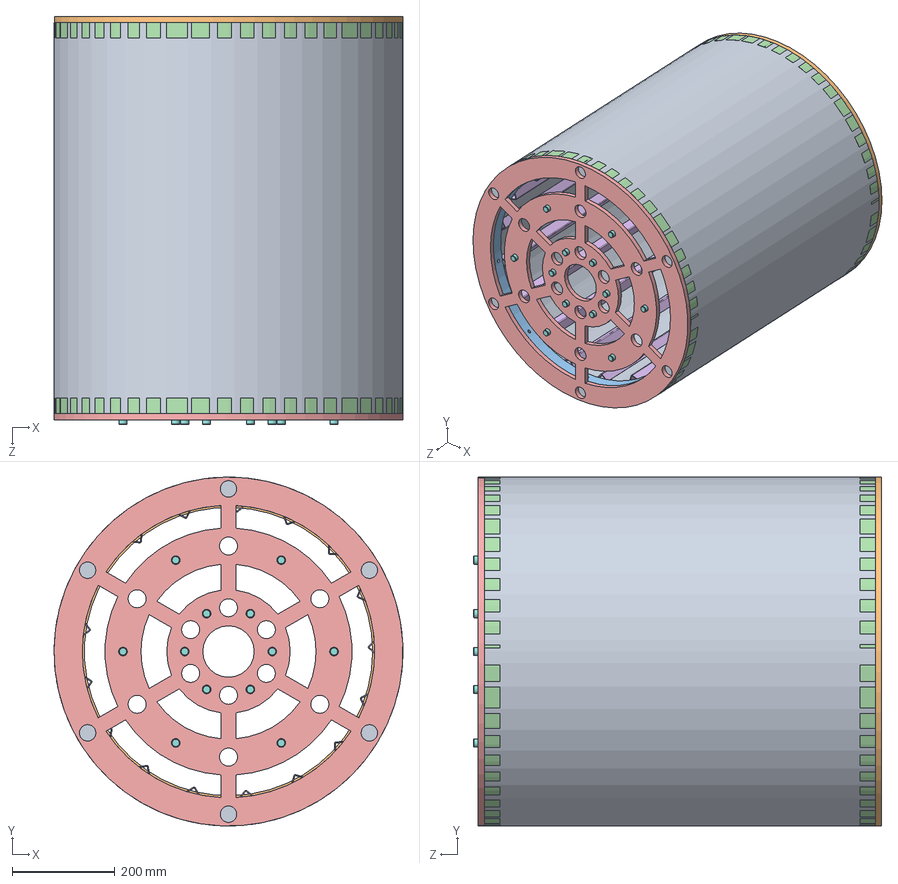
[picture p165: CAD file, 2025-05-18]
jokar/جعفر/9920007-Silencer-FINAL model 4 NOV 2023 - WITH DRAWINGS/Assem-Nozzle-Absorber1.SLDASM
678.0 x 677.9 x 793.5 mm
Nozzle-Perf. Plate 1-1
Nozzle-Perf. Flange 1-1
Nozzle-Perf. flange 1-2 x 2
Nozzle-Perf. flange 2-3-2 x 2
Middle-Perf. Flange 1-3
Nozzle-Perf. Sheet 1-1 x 17
flat washer narrow_am x 12
formed hex screw_am x 12
Acoustic absorber 1-2
