koalium/centidocs/Q.C/Mashi/Model/20M Left/5150 Right/Column 5150 Assembly Right.SLDASM

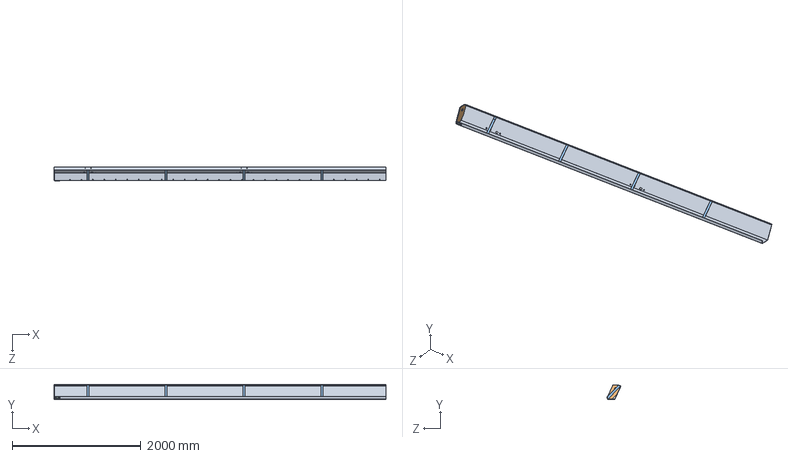
[picture p167: CAD file, 2025-05-18]
Q.C/Mashi/Model/20M Left/5150 Right/Column 5150 Assembly Right.SLDASM
5150.0 x 225.5 x 215.1 mm
Column 5150 Right
Cover Plate
Stiffeniing Angle For Thk 4 Right x 4
Stiffening Plate
