koalium/centidocs/Rezaei/8112007/Drawing/Blade Assembly 665.SLDASM

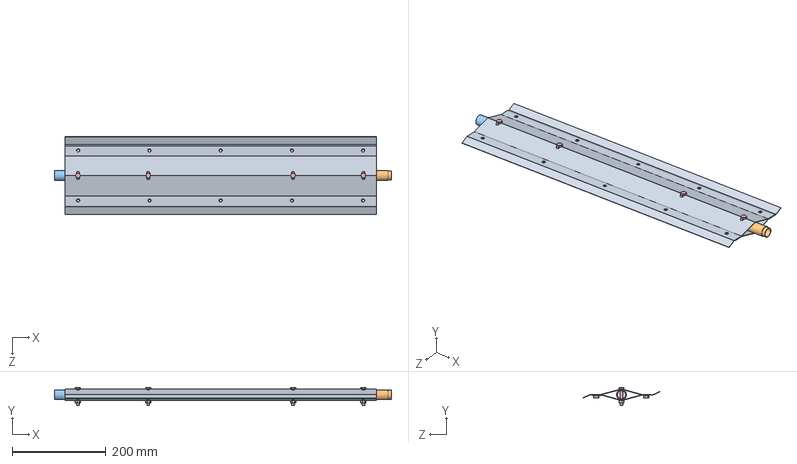
[picture p168: CAD file, 2025-05-18]
Rezaei/8112007/Drawing/Blade Assembly 665.SLDASM
719.0 x 39.0 x 165.9 mm
Blade 665 x 2
Axis Pipe
Axis Pipe End
hex nut gradec_din x 14
hhhhh x 4
