koalium/centidocs/Rezaei/Disk filter/New Tray/Tray Assembly.SLDASM

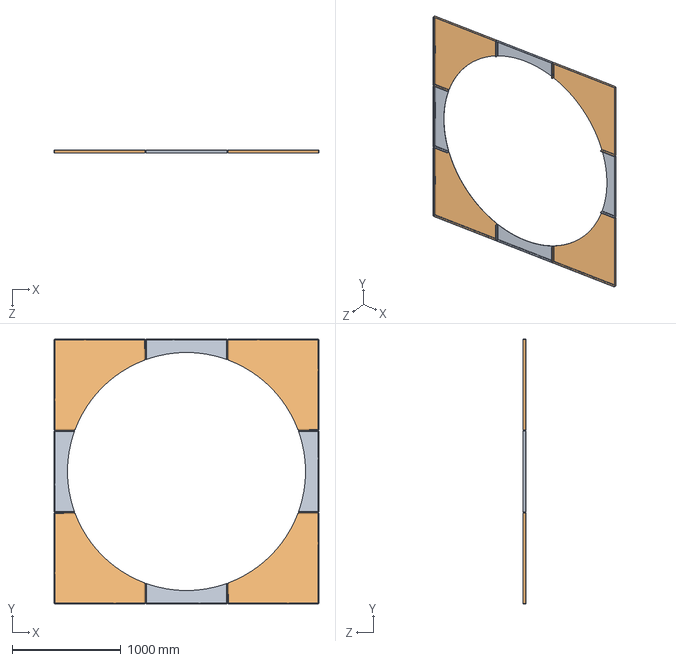
[picture p169: CAD file, 2025-05-18]
Rezaei/Disk filter/New Tray/Tray Assembly.SLDASM
2432.0 x 2432.0 x 30.0 mm
1M x 4
1L 1R x 4
