koalium/centidocs/jokar/0/HVAC/3000/Driven Stand 3000/Driven Stand3000.SLDASM

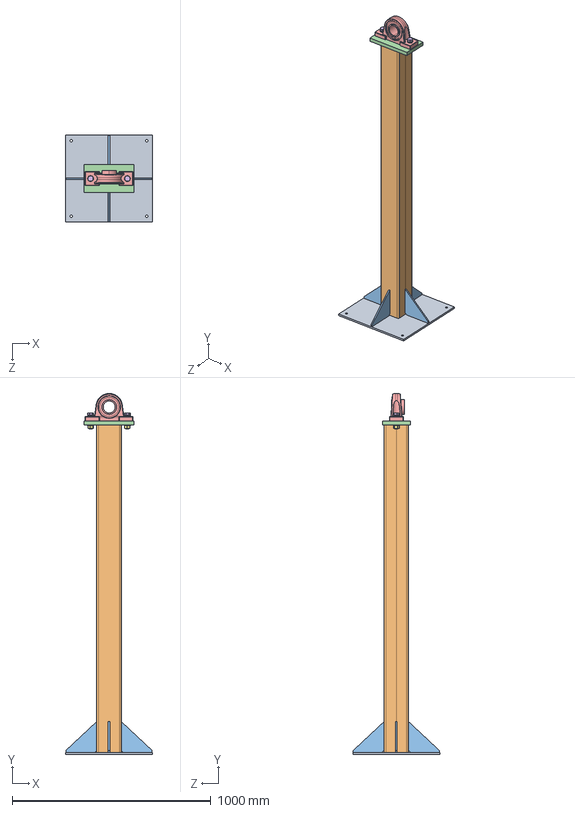
[picture p170: CAD file, 2025-05-18]
jokar/0/HVAC/3000/Driven Stand 3000/Driven Stand3000.SLDASM
440.0 x 1815.7 x 440.0 mm
Stand Base Plate
Stand Post x 2
Stand Post Stiffener x 4
Stand Bearing Plate
Stand Bearing
Stand Bearing Bolt x 2
Stand Bearing Nut x 2
Stand Bearing Flat Washer x 2
Stand Bearing Spring Washer x 2
