koalium/centidocs/jokar/1/Damper 3540/Damper 3540 Main Assembly.SLDASM

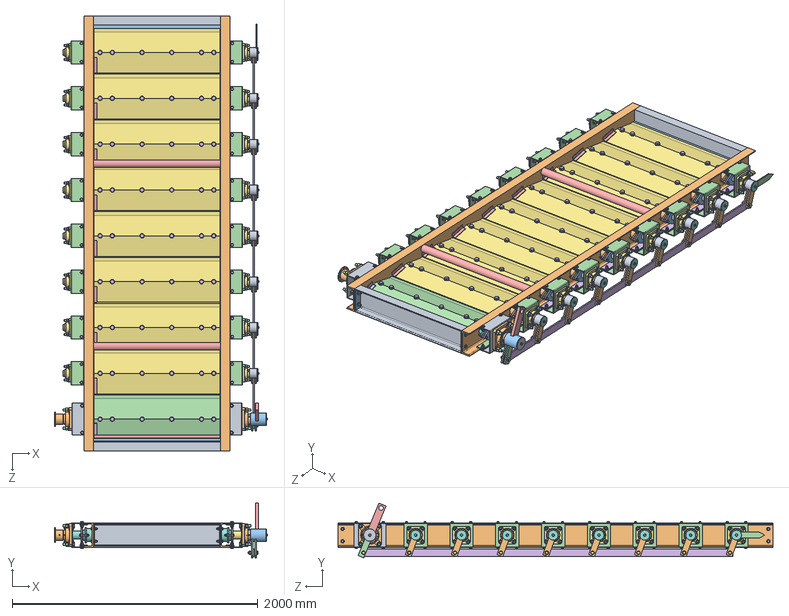
[picture p171: CAD file, 2025-05-18]
jokar/1/Damper 3540/Damper 3540 Main Assembly.SLDASM
1735.7 x 445.8 x 3540.0 mm
Vertical UPN x 2
Horizontal UPN x 2
Connecting Plate x 4
plain washer grade c_din x 502
curved spring lock washer_din x 260
s x 170
hex nut gradec_din x 249
Gland Female Big x 2
Gland Male Big x 2
Gland Female x 16
Gland Male x 16
Support Bearibf x 16
Clamp 2 x 32
Support Clamp x 32
ucf210 x 16
hex bolt gradec_din x 72
Support Bearing 2 x 2
ucf213 x 2
Clamp 3 x 4
Support Clamp 2 x 4
Stop Angle 2 x 16
Stop Angle 4 x 2
Blade x 16
Blade Pipe x 8
Link Side Shaft x 8
Shaft x 8
parallel_din x 8
Blade 2
Blade 1
Blade Pipe 2
Link Side Shaft First
Shaft 2
Link Bush x 8
Link Flat Bar x 16
Link Bush First
Link Flat Bar First x 2
Main Link Flat Baar
Rod
hex bolt gradeb_din x 18
Stop Washer x 8
Stop Washer First
Coupling Flange
Stop Angle 1 x 2
Flasher
Stiffener Pipe x 2
