koalium/centidocs/jokar/1/Damper 6400/Blade Assembly 2.SLDASM

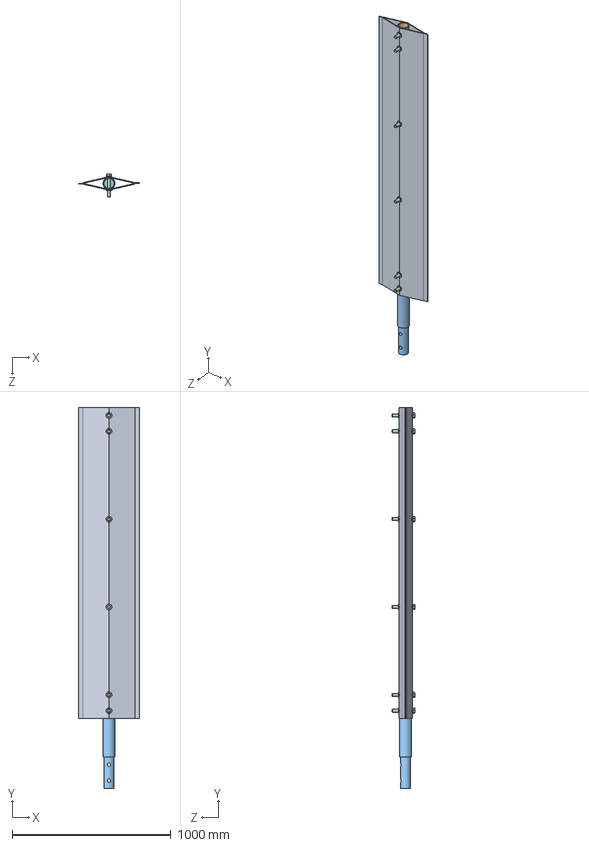
[picture p172: CAD file, 2025-05-18]
jokar/1/Damper 6400/Blade Assembly 2.SLDASM
386.0 x 2400.0 x 142.5 mm
Blade 2 x 2
Blade Pipe 2
Middle Shaft
ss x 6
plain washer grade c_din x 12
