koalium/centidocs/jokar/Air Filter Rotary 2500/درام/End.SLDASM

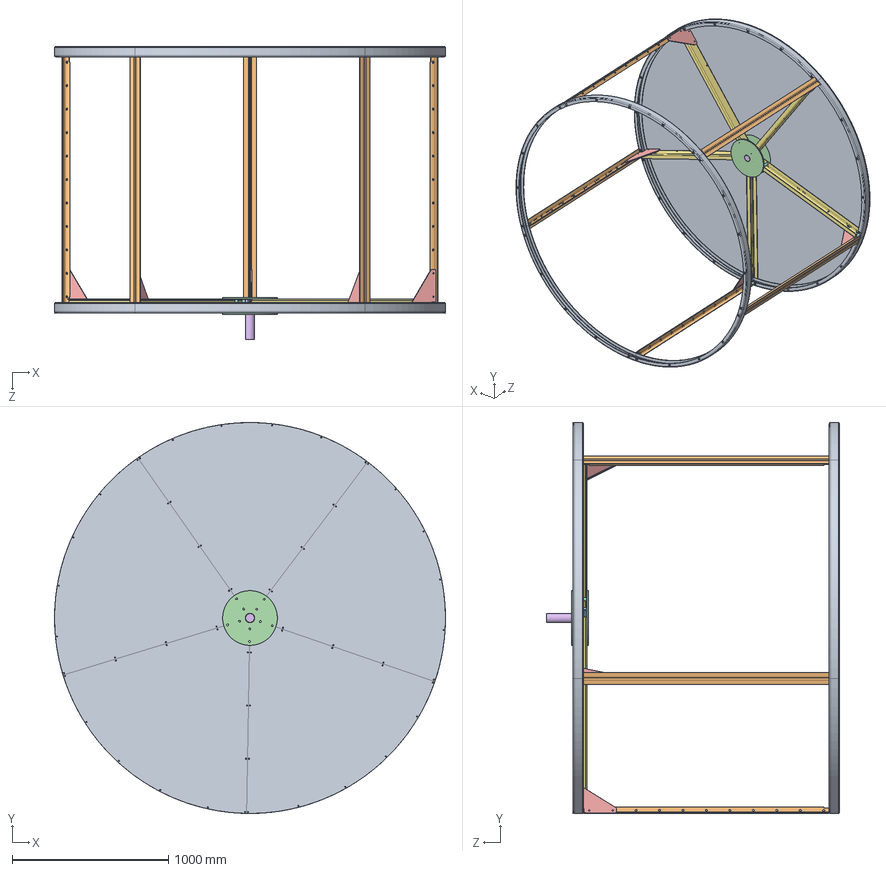
[picture p173: CAD file, 2025-05-18]
jokar/Air Filter Rotary 2500/درام/End.SLDASM
2500.0 x 2500.0 x 1876.0 mm
Upn 72 drg 2 x 10
L Angle 40x40 x 10
تقویتی صفحه x 5
plate main x 2
plate lchky x 5
shafte 60
upn main 2 x 5
Pipe(OD=22) x 10
Plate upper box glv x 5
