koalium/centidocs/jokar/Air Filter Rotary 2500/درام/plate/plate upn tasme.SLDPRT

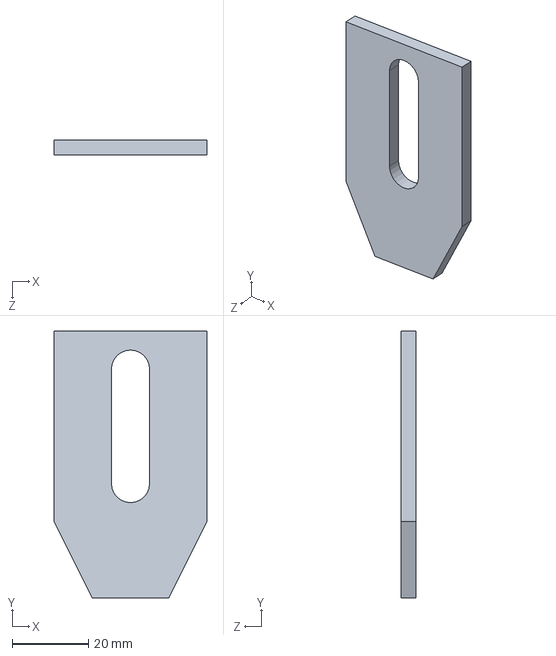
[picture p174: CAD file, 2025-05-18]
jokar/Air Filter Rotary 2500/درام/plate/plate upn tasme.SLDPRT
40.0 x 70.0 x 4.00 mm
