koalium/centidocs/jokar/Air Filter Rotary 2500/درام/Upn/upn main 2.SLDPRT

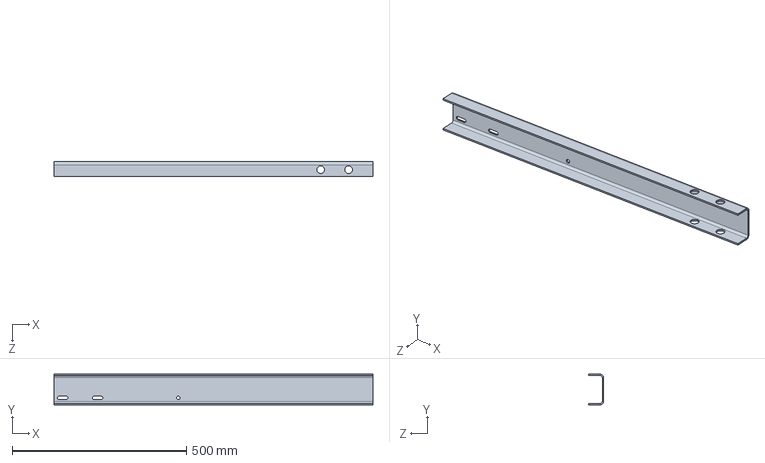
[picture p175: CAD file, 2025-05-18]
jokar/Air Filter Rotary 2500/درام/Upn/upn main 2.SLDPRT
915.0 x 88.0 x 44.0 mm
