koalium/centidocs/Manouchehri/شیپوری و فن محوری/Bell Ring/1600/Shepoury.SLDASM

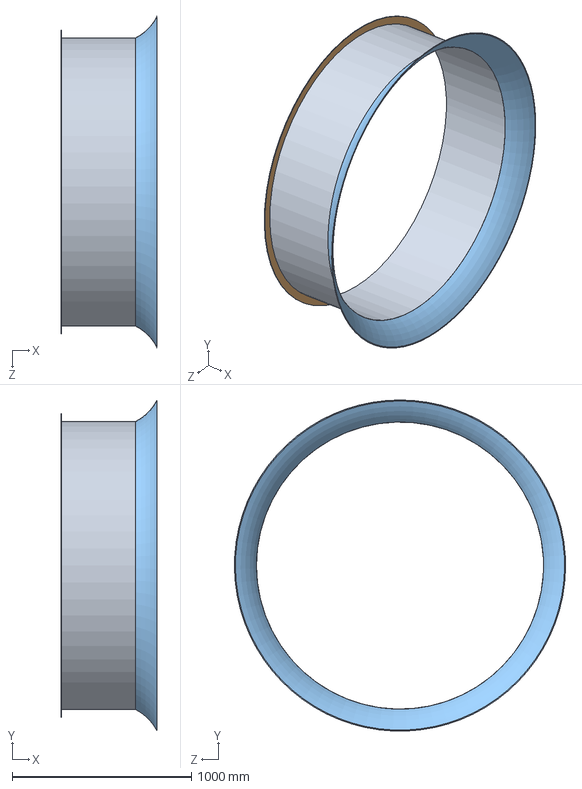
[picture p176: CAD file, 2025-05-18]
Manouchehri/شیپوری و فن محوری/Bell Ring/1600/Shepoury.SLDASM
535.0 x 1845.2 x 1845.6 mm
Flange
