koalium/centidocs/mohajeri/8125006-Amirkabir/Damper 1000x550/Blade Assembly left.SLDASM

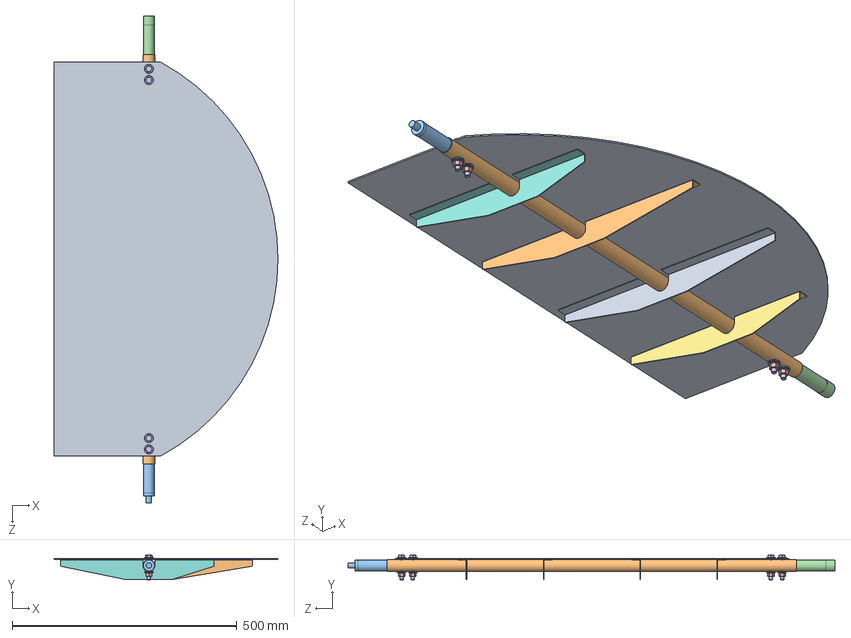
[picture p177: CAD file, 2025-05-18]
mohajeri/8125006-Amirkabir/Damper 1000x550/Blade Assembly left.SLDASM
498.0 x 55.3 x 1082.3 mm
Blade 1016
Axial Pipe
plain washer grade c_din x 8
curved spring lock washer_din x 4
hex nut gradec_din x 4
hex bolt gradeb_din x 4
Stiffener 1 R 1016
Stiffener 1 L 1016
Stiffener 2 L 1016
Stiffener 2 R 1016
Shaft 1 (1016)
Shaft 3 (1016)
