koalium/centidocs/Q.C/Mashi/00.04.08/total testing model/Main column-L.SLDPRT

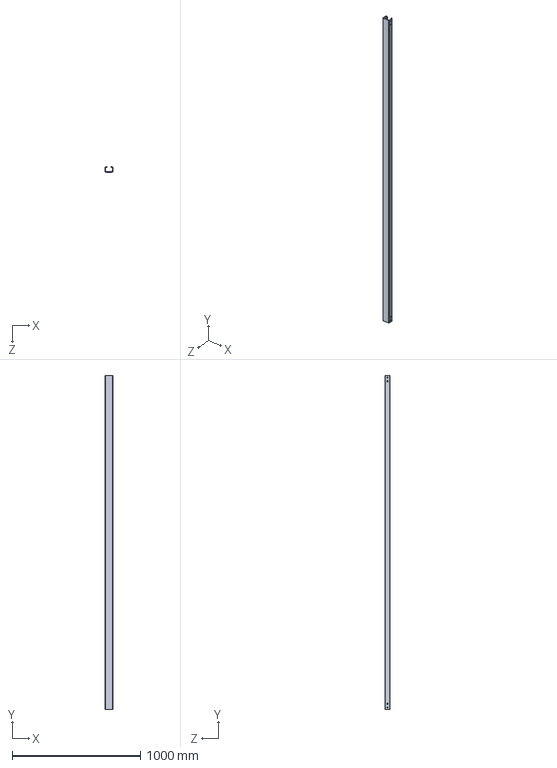
[picture p178: CAD file, 2025-05-18]
Q.C/Mashi/00.04.08/total testing model/Main column-L.SLDPRT
60.0 x 2600.0 x 40.0 mm
