koalium/centidocs/Q.C/Mashi/Model/20M Left/4840 Right/Column 4840 Assembly Right.SLDASM

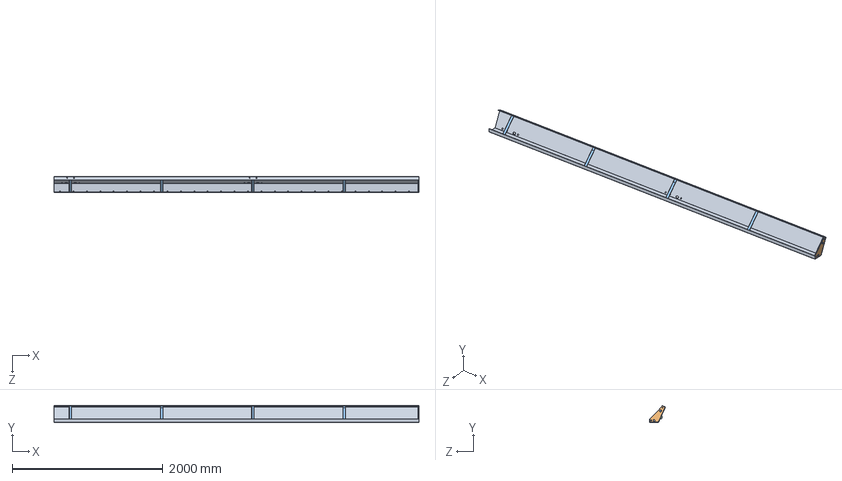
[picture p179: CAD file, 2025-05-18]
Q.C/Mashi/Model/20M Left/4840 Right/Column 4840 Assembly Right.SLDASM
4840.0 x 225.5 x 210.1 mm
Column 4840 Right
Flange Plate I
Stiffeniing Angle For Thk 4 Right x 4
Block
