koalium/centidocs/Q.C/Mashi/Parts/Link Assembly.SLDASM

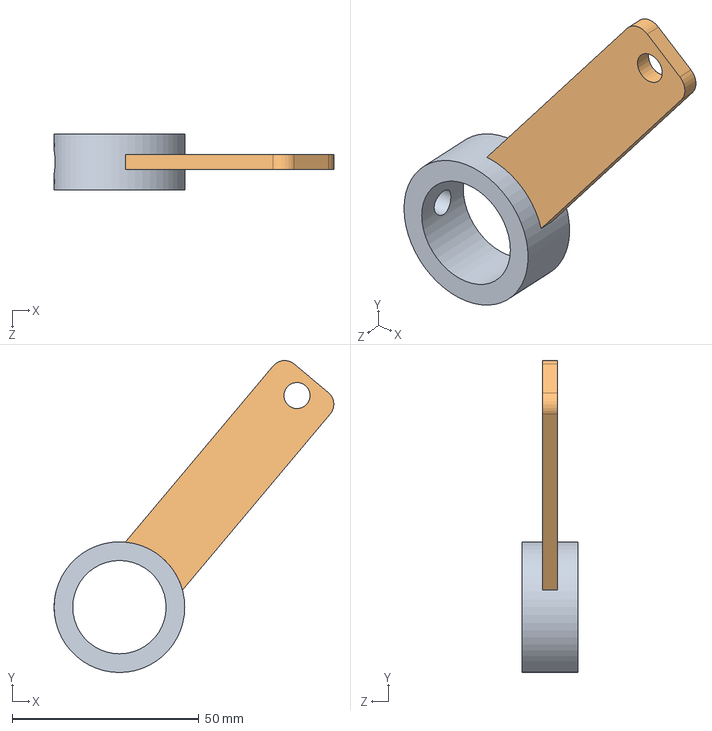
[picture p180: CAD file, 2025-05-18]
Q.C/Mashi/Parts/Link Assembly.SLDASM
74.9 x 83.6 x 15.0 mm
Bush 3
Flat Bar 2
