koalium/centidocs/SAFARI/1900x1300 Final Rec/Assem flange.SLDASM

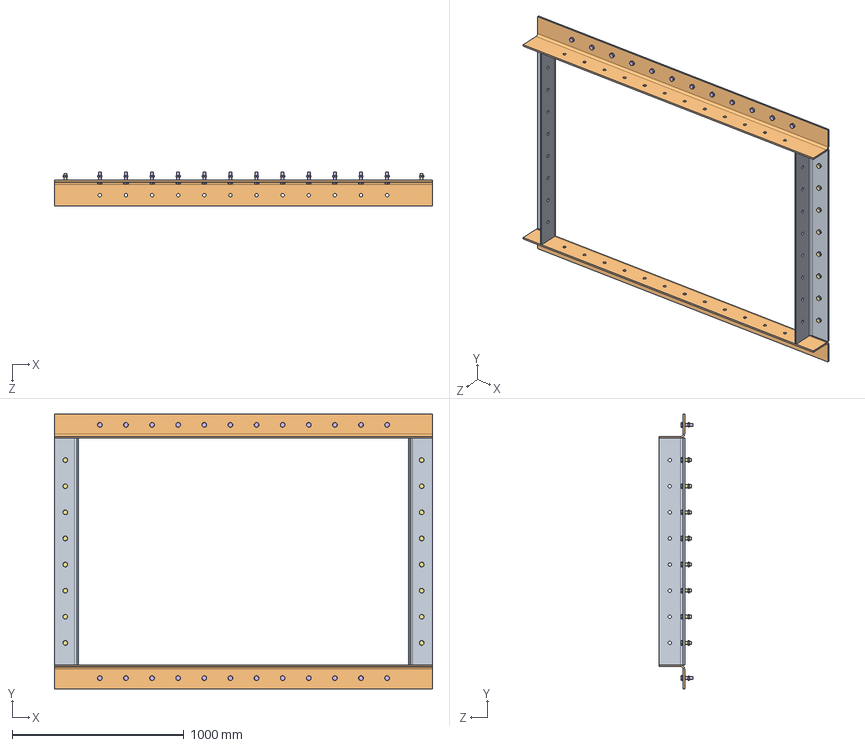
[picture p181: CAD file, 2025-05-18]
SAFARI/1900x1300 Final Rec/Assem flange.SLDASM
2200.0 x 1600.0 x 198.0 mm
Flange-V x 2
Flange-H x 2
Nut M18 x 40
Spring washer M18 x 40
Washer M18 x 80
Bolt M18x60-2 x 24
Bolt M18x50 x 16
