koalium/centidocs/SAFARI/Damper 1200x1200/Assem-regulator1.SLDASM

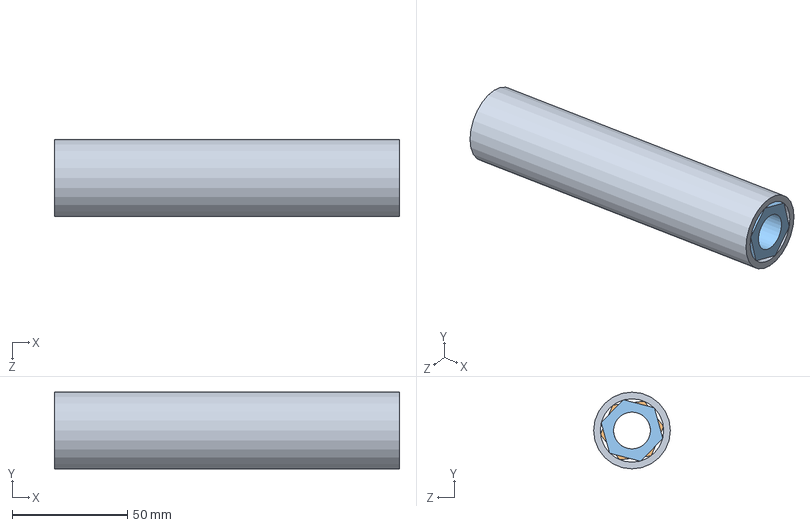
[picture p182: CAD file, 2025-05-18]
SAFARI/Damper 1200x1200/Assem-regulator1.SLDASM
150.0 x 33.4 x 33.4 mm
lever-regulator
Nut M16-right-hand
Nut M16-Left-hand
