koalium/centidocs/jokar/جعفر/9920007-Silencer-FINAL model 4 NOV 2023 - WITH DRAWINGS/Assem-Nozzle.SLDASM

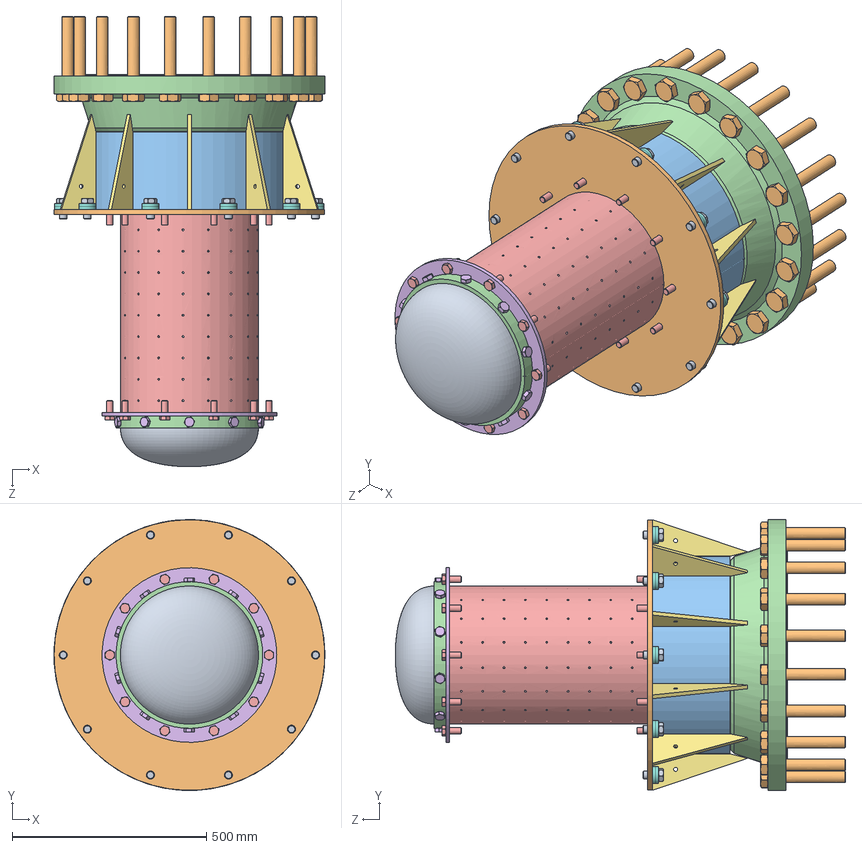
[picture p183: CAD file, 2025-05-18]
jokar/جعفر/9920007-Silencer-FINAL model 4 NOV 2023 - WITH DRAWINGS/Assem-Nozzle.SLDASM
698.0 x 698.2 x 1160.0 mm
Nozzle-End Cap
Nozzle-Middle- flange
Gasket
Flange
Nozzle-Tube
Nozzle-end- flange
Nozzle-Rib x 10
plain washer 7349 heavy_din x 20
hex bolt gradeab_din_l25 x 10
high strength hex head bolt_din x 20
Nozzle-Spacer
Nozzle-Cap-Ring
hex bolt gradeab_din40 x 20
hex bolt gradeab_din2 x 10
