koalium/centidocs/mohajeri/damper isfahan/4110006-1900x1300-Rev08/Assem-gland flange.SLDASM

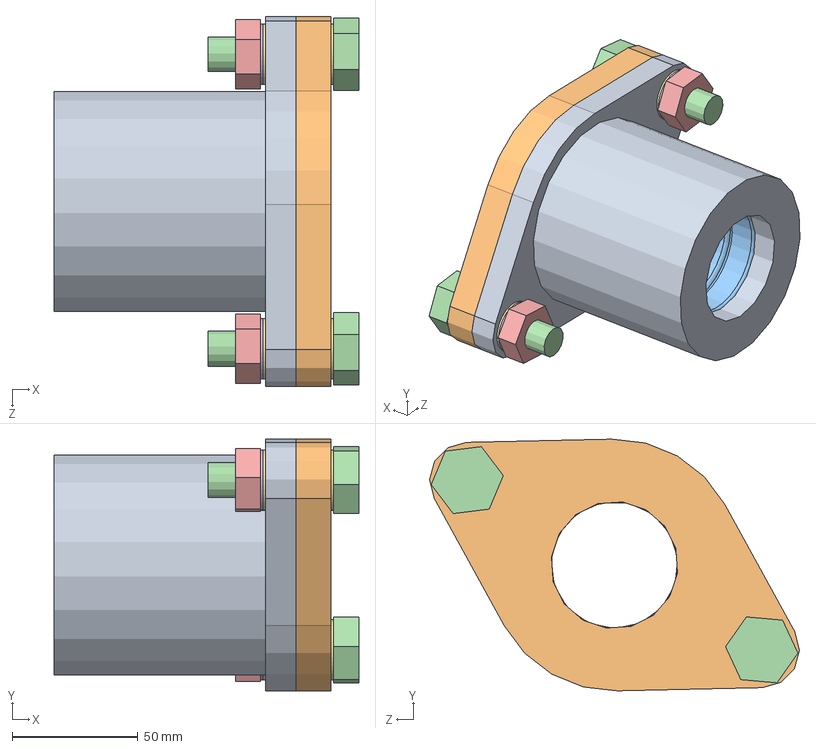
[picture p184: CAD file, 2025-05-18]
mohajeri/damper isfahan/4110006-1900x1300-Rev08/Assem-gland flange.SLDASM
121.0 x 100.0 x 147.0 mm
gland1-flang1
gland1-flang2
gland-packing1
Bolt M14x50 x 2
Nut M14 x 2
Spring washer A14 x 2
Plane washer A14 x 4
