koalium/centidocs/Q.C/Mashi/Model/20M Middle/4670/Column 4670 Assembly.SLDASM

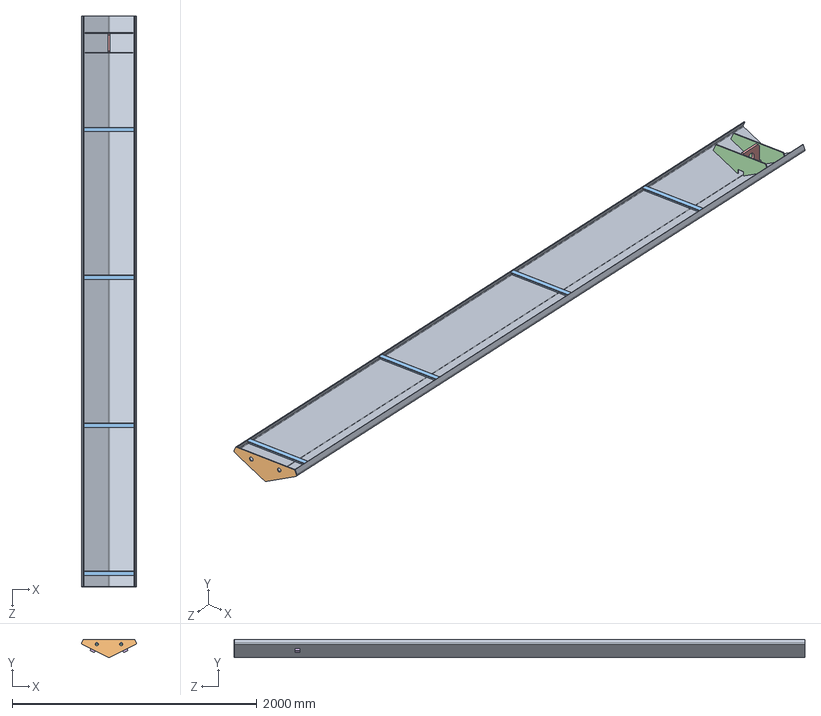
[picture p185: CAD file, 2025-05-18]
Q.C/Mashi/Model/20M Middle/4670/Column 4670 Assembly.SLDASM
448.3 x 149.9 x 4670.0 mm
Column 4670
Bottom Plate
Stiffening Angle x 4
Stiffening Plate x 2
Lift Eye
Block x 2
