koalium/centidocs/Q.C/Mashi/Model/20M Middle/5110/Column 5110 Assembly.SLDASM

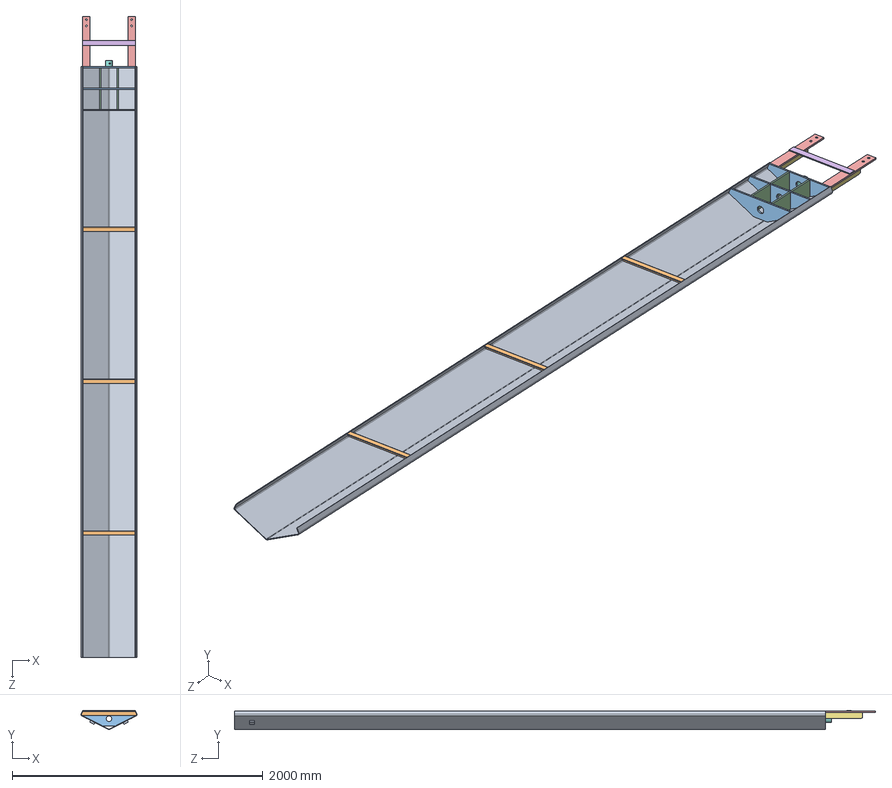
[picture p186: CAD file, 2025-05-18]
Q.C/Mashi/Model/20M Middle/5110/Column 5110 Assembly.SLDASM
448.3 x 152.8 x 5110.0 mm
Column 5110
Stiffening Angle Thk=4 x 3
Cover Plate x 3
Rib I x 4
Support Flat x 2
Base Plate
Rib II x 2
Tube For Pin Holding
Block x 2
