koalium/centidocs/jokar/0/HVAC/3000/Driver Stand 3000/پایه متحرک.SLDASM

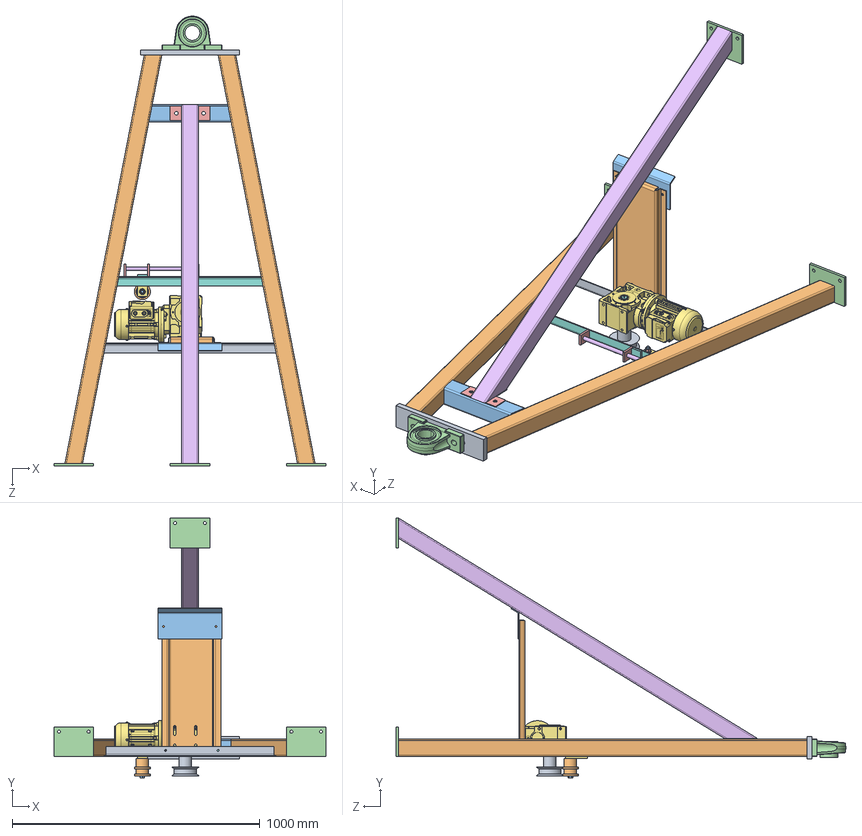
[picture p187: CAD file, 2025-05-18]
jokar/0/HVAC/3000/Driver Stand 3000/پایه متحرک.SLDASM
1098.5 x 1049.0 x 1816.3 mm
صفحه زیر یاتاقان
قوطی طولی سمت الکترو موتور x 2
قوطی عرضی سمت الکتروموتور
ورق زیر پایه x 3
تسمه زیر پایه میانی
قوطی پایه سمت الکترو موتور
صفحه زیر درپوش ناودانی
نبشی میانی پایه فیلتر
نبشی پایه پایینی
صفحه زیر الکترو موتور
صفحه نگهدارنده زیر صفحه الکترو موتور
AST_Bearings_UCP212
تسمه نگهدارنده پیچ پایه x 3
پیچ تنظیم پولی
ورق زیر نبشی
تسمه اتصال پایه
پولی چدنی
پولی تسمه سبز
hex screw gradec_din
plain washer grade c_din x 2
hex nut gradec_din
6201-Z x 2
Standard motor
شفت موتور روتاری
