koalium/centidocs/jokar/1/Damper 6400/Stop Angle Main.SLDPRT

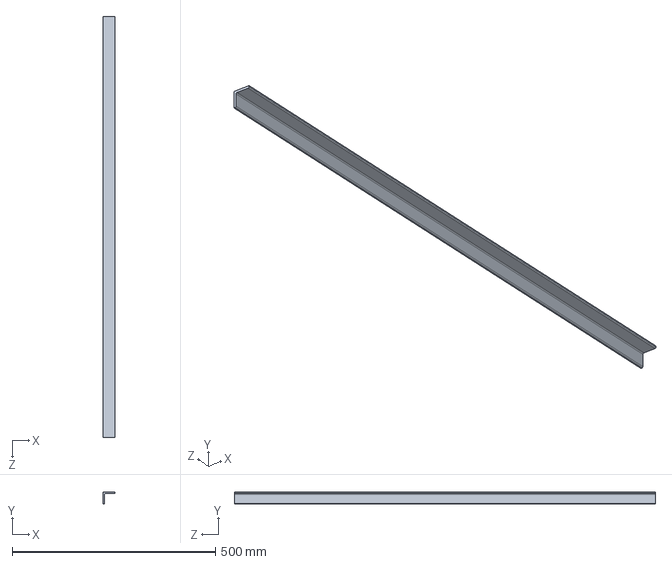
[picture p188: CAD file, 2025-05-18]
jokar/1/Damper 6400/Stop Angle Main.SLDPRT
30.0 x 30.0 x 1036.0 mm
