koalium/centidocs/jokar/2/Damper 6400/Link Assemly.SLDASM

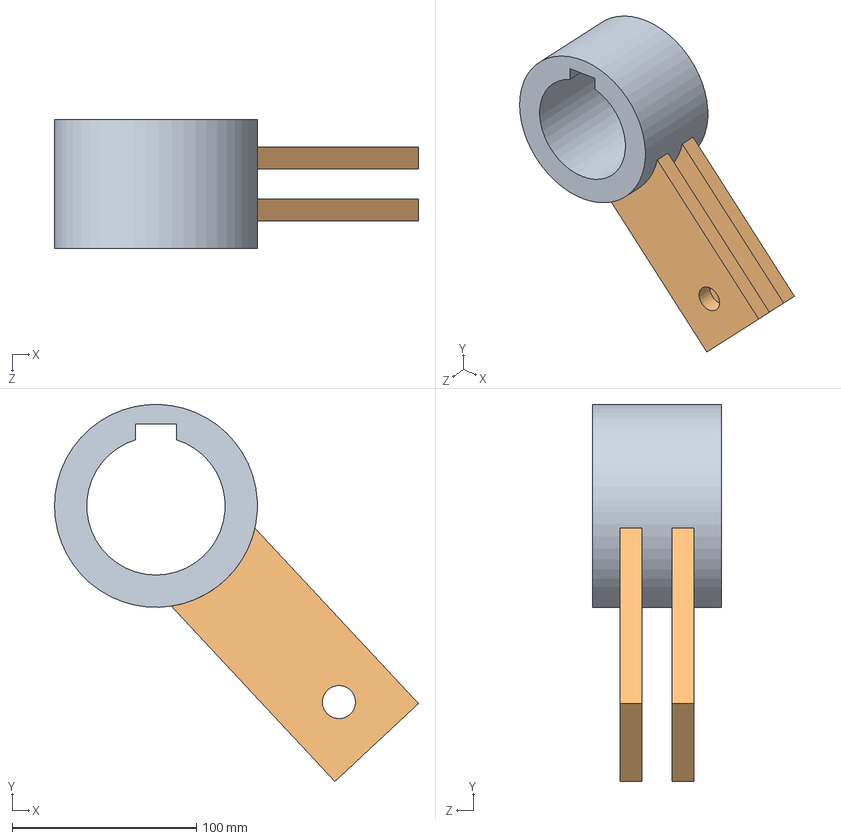
[picture p189: CAD file, 2025-05-18]
jokar/2/Damper 6400/Link Assemly.SLDASM
197.3 x 204.4 x 70.0 mm
Link
Link Flat Bar x 2
