koalium/centidocs/Rezaei/11/Disk filter/Assem-Door frame1.SLDASM

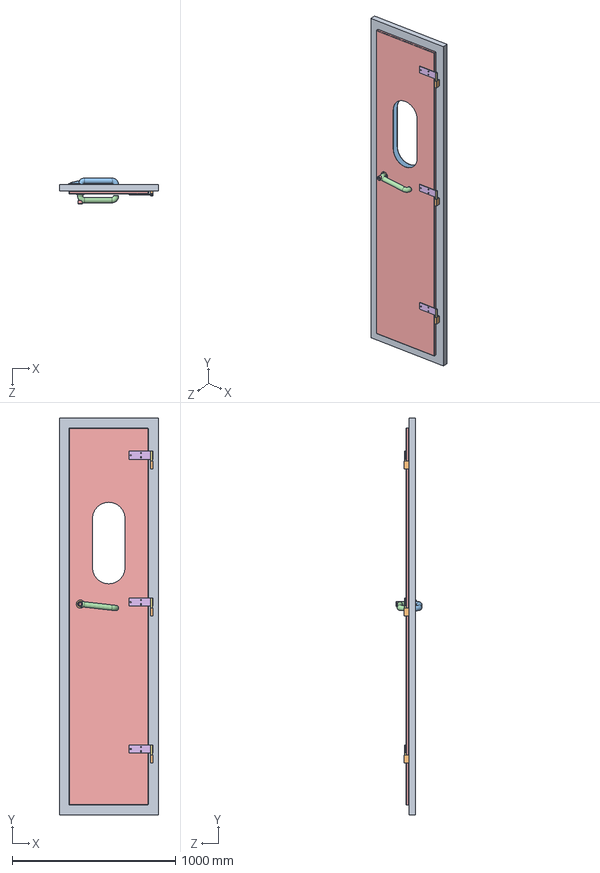
[picture p191: CAD file, 2025-05-18]
Rezaei/11/Disk filter/Assem-Door frame1.SLDASM
608.0 x 2432.0 x 158.5 mm
Door-frame
hinge-female x 3
Door-plate1
door-reinforce x 3
door plate2
hinge-female2 x 3
hinge-male x 3
hinge-plate x 3
pipe
Bush x 2
Handle 2
Handle 1
socket head cap screw 4762_din
