koalium/centidocs/mohajeri/8125006-Amirkabir/Damper 750/Main Assembly.SLDASM

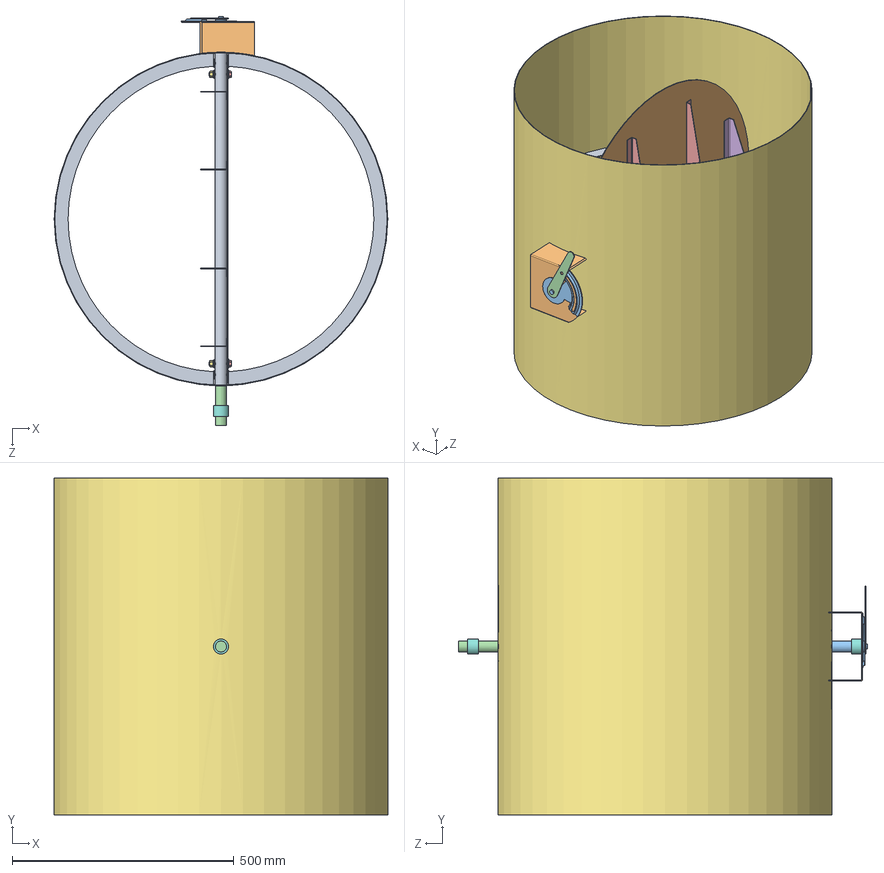
[picture p192: CAD file, 2025-05-18]
mohajeri/8125006-Amirkabir/Damper 750/Main Assembly.SLDASM
753.0 x 760.0 x 923.0 mm
Pipe
Blade760
Shaft 1
Shaft 2
Stiffener580 R x 2
Stiffener330 L x 2
Bush2 x 2
Air seal x 2
Adjustment Plate 1016
Handle 1
Handle 2
hex bolt gradeb_din x 4
plain washer 6902 type abc_din x 8
hex nut gradec_din x 4
spring lock washer 2_din x 4
