koalium/centidocs/mohajeri/damper isfahan/4110006-2300x1000-Rev00/Lever1-Righthand.SLDASM

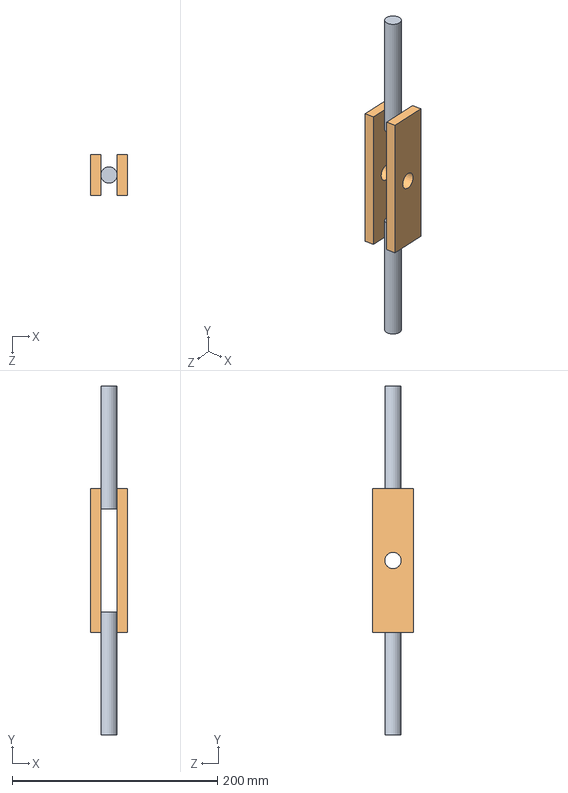
[picture p193: CAD file, 2025-05-18]
mohajeri/damper isfahan/4110006-2300x1000-Rev00/Lever1-Righthand.SLDASM
36.0 x 340.0 x 40.0 mm
Lever Rod1-righthanded-t1 x 2
Lever plate1-righthanded x 2
