koalium/centidocs/Rezaei/17153/Model/Type 1/FR ASSEm.SLDASM

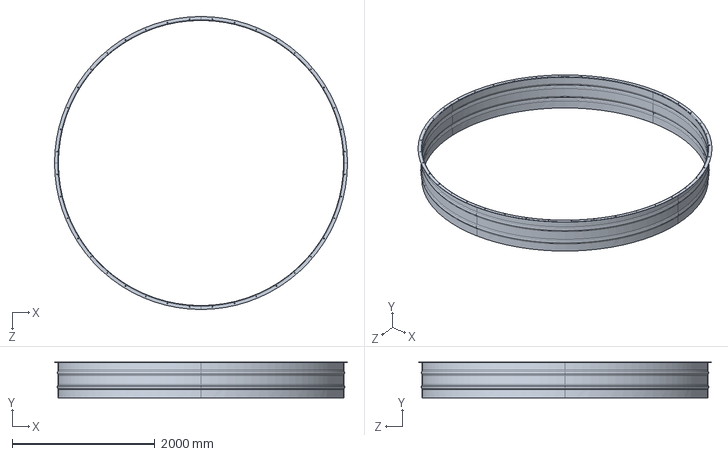
[picture p194: CAD file, 2025-05-18]
Rezaei/17153/Model/Type 1/FR ASSEm.SLDASM
4100.0 x 500.0 x 4100.0 mm
FR x 4
