koalium/centidocs/SAFARI/2300x1000/01/Assem connection box.SLDASM

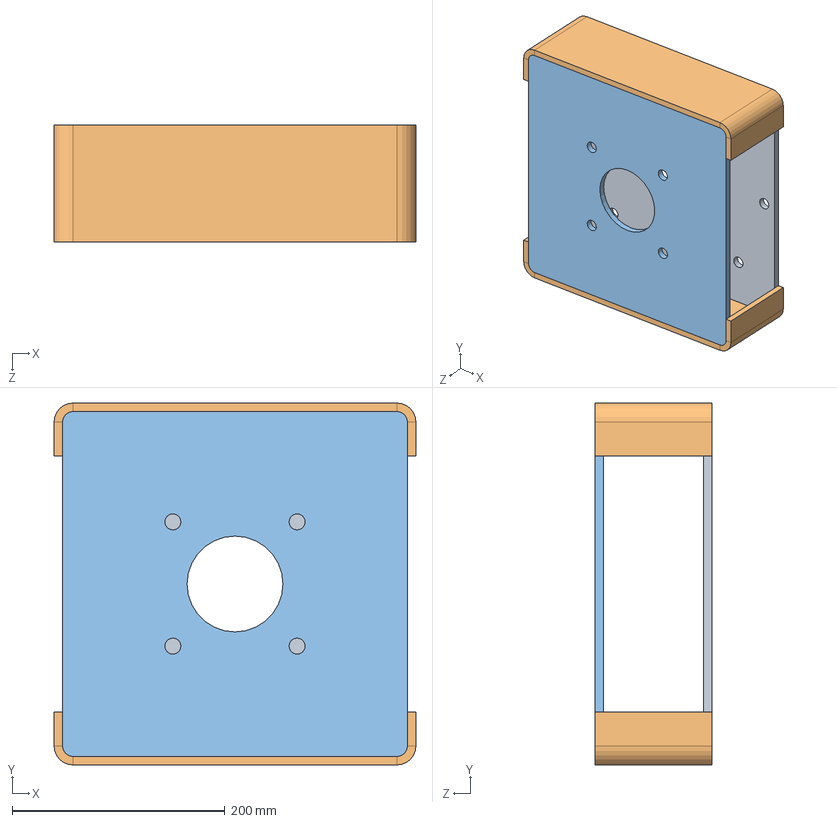
[picture p195: CAD file, 2025-05-18]
SAFARI/2300x1000/01/Assem connection box.SLDASM
340.0 x 340.0 x 110.0 mm
Connection-1
Connection-2 x 2
Connection-3
