koalium/centidocs/jokar/1/Damper 3540/Link First.SLDASM

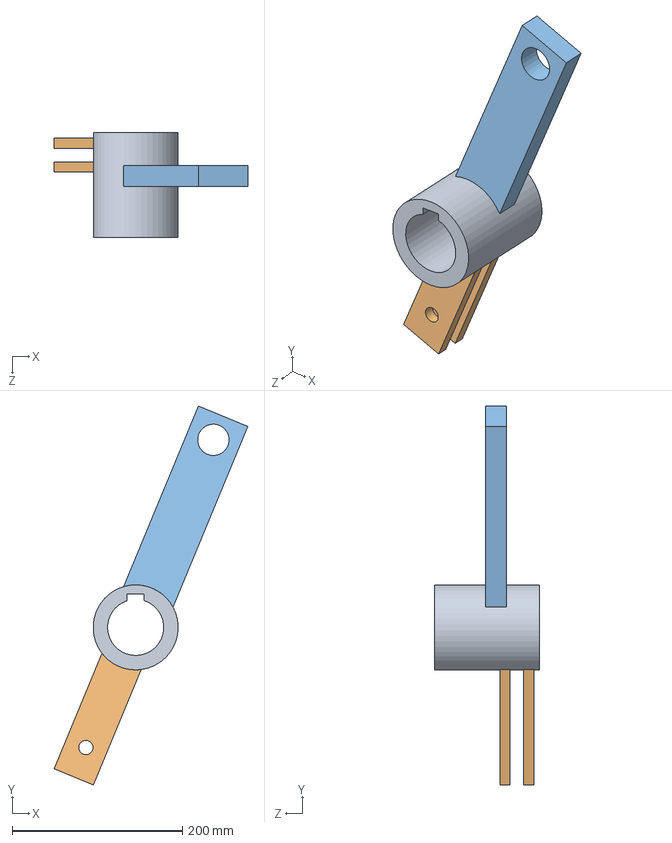
[picture p196: CAD file, 2025-05-18]
jokar/1/Damper 3540/Link First.SLDASM
227.9 x 445.8 x 123.8 mm
Link Bush First
Link Flat Bar First x 2
Main Link Flat Baar
