koalium/centidocs/jokar/Damper 3540/Damper Frame Assembly.SLDASM

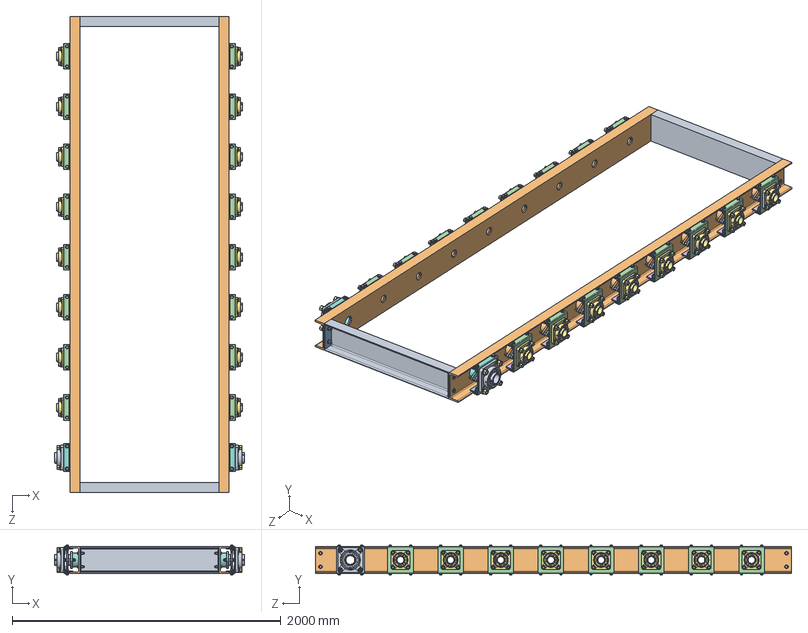
[picture p197: CAD file, 2025-05-18]
jokar/Damper 3540/Damper Frame Assembly.SLDASM
1415.4 x 220.0 x 3540.0 mm
Vertical UPN x 2
Horizontal UPN x 2
Connecting Plate x 4
plain washer grade c_din x 376
curved spring lock washer_din x 188
hex bolt gradeb_din x 117
hex nut gradec_din x 186
Gland Female Big x 2
Gland Male Big x 2
Gland Female x 16
Gland Male x 16
Support Bearibf x 16
Clamp 2 x 32
Support Clamp x 32
ucf210 x 16
Support Bearing 2 x 2
ucf213 x 2
Clamp 3 x 4
Support Clamp 2 x 4
