koalium/centidocs/Manouchehri/شیپوری و فن محوری/04(Cone (Sheypour))/Bell Ring 1600-30-1000/1600-30-1000.SLDASM

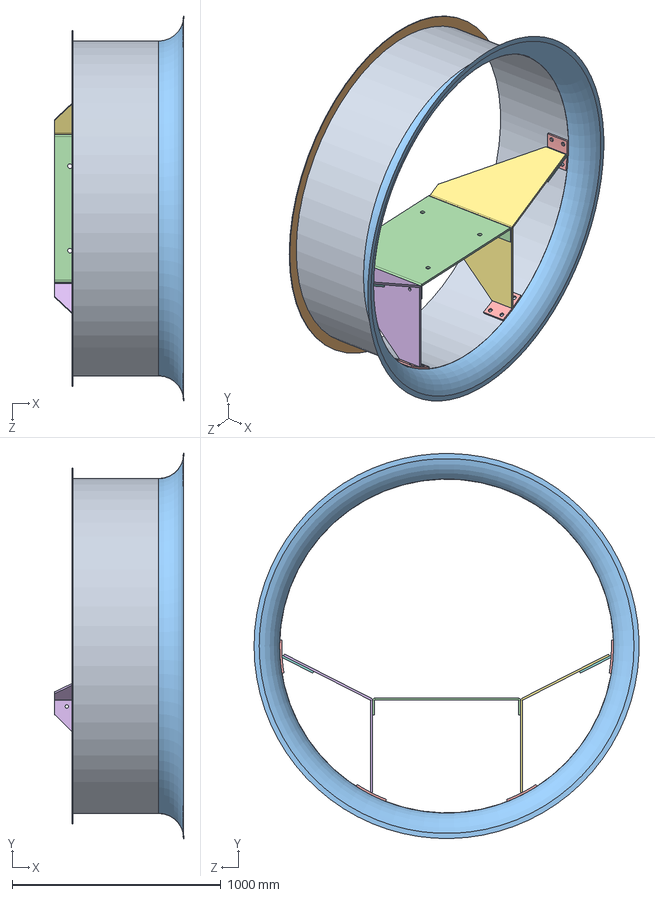
[picture p198: CAD file, 2025-05-18]
Manouchehri/شیپوری و فن محوری/04(Cone (Sheypour))/Bell Ring 1600-30-1000/1600-30-1000.SLDASM
620.0 x 1845.6 x 1845.2 mm
Casing
Flange
Base Plate
Clamp 1 x 4
Saddle
Saddle 3
Clamp 2 x 2
