koalium/centidocs/mohajeri/8125006-Amirkabir/Damper 750/Impeller.SLDASM

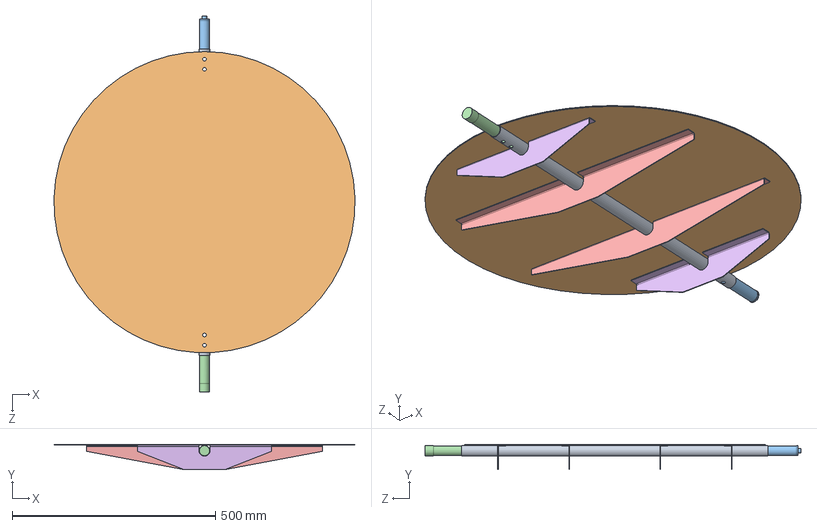
[picture p199: CAD file, 2025-05-18]
mohajeri/8125006-Amirkabir/Damper 750/Impeller.SLDASM
739.7 x 62.0 x 923.0 mm
Pipe
Blade760
Shaft 1
Shaft 2
Stiffener580 R x 2
Stiffener330 L x 2
