koalium/centidocs/mohajeri/8125006-Amirkabir/Damper 850x450/Blade 865 Right Assem.SLDASM

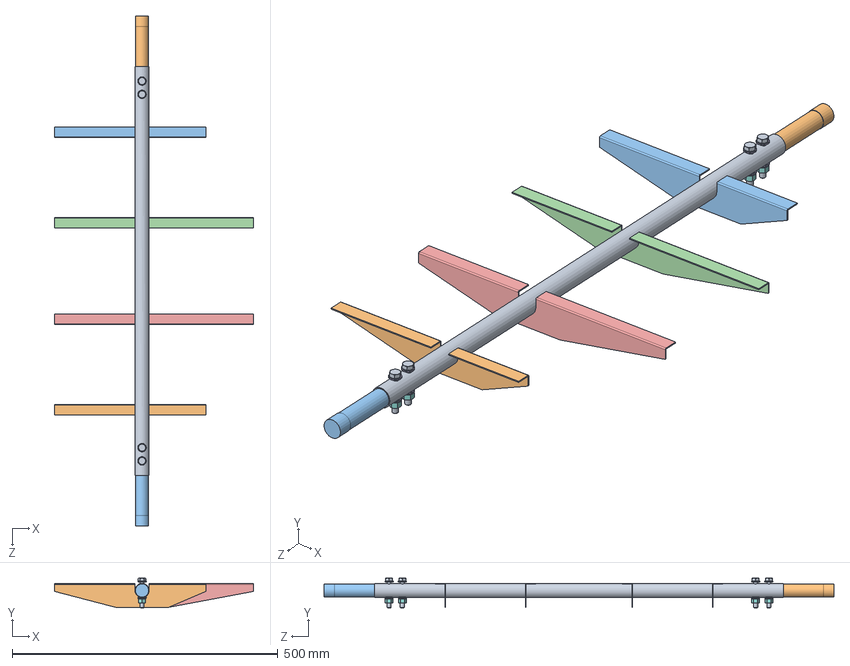
[picture p200: CAD file, 2025-05-18]
mohajeri/8125006-Amirkabir/Damper 850x450/Blade 865 Right Assem.SLDASM
375.0 x 55.7 x 960.0 mm
Axial Pipe 865
Stiffener 2 R 865
Stiffener 2 L 865
Stiffener 1 R 865
Stiffener 1 L 865
plain washer grade c_din x 8
curved spring lock washer_din x 4
hex nut gradec_din x 4
hex bolt gradec_din x 4
Shaft 2 (865)
Shaft 3 (865)
