koalium/centidocs/mohajeri/damper isfahan/4110006-2300x1000-Rev00/Assem total-t1.SLDASM

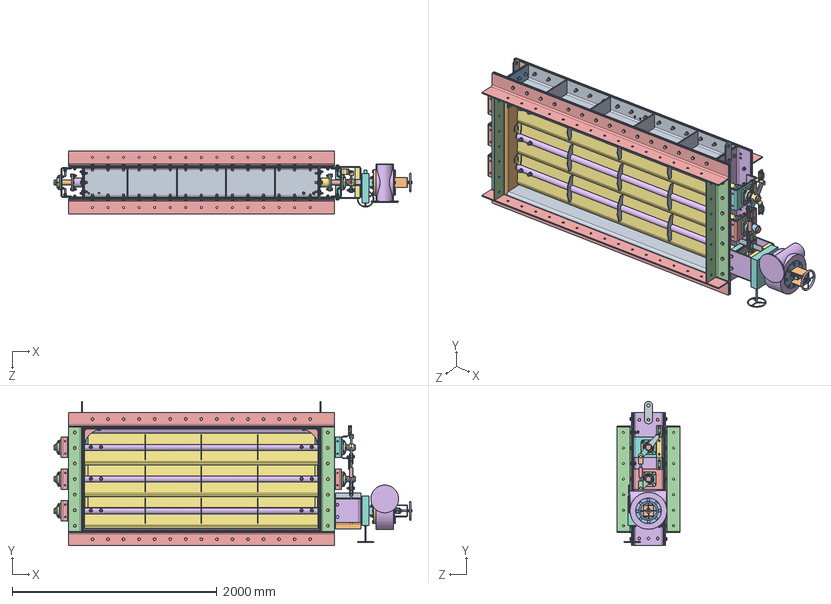
[picture p201: CAD file, 2025-05-18]
mohajeri/damper isfahan/4110006-2300x1000-Rev00/Assem total-t1.SLDASM
3499.0 x 1410.0 x 616.0 mm
Frame H x 2
Frame V
Connection plate x 4
gland1-flang1 x 3
gland1-flang2 x 3
gland-packing1 x 3
Bolt M14x50 x 53
Nut M14 x 57
Spring washer M14 x 57
Washer M14 x 120
Bearing support x 5
Frame seal x 2
Frame L-seal-1 x 8
Frame L-seal-2 x 4
Frame H stiffener x 8
Bolt M18x50 x 40
Nut M18 x 103
Spring washer M18 x 102
Washer M18 x 205
MirrorFrame V
Mirrorgland1-flang1 x 3
Mirrorgland1-flang2 x 3
Mirrorgland-packing1 x 3
MirrorBolt M14x50 x 6
MirrorNut M14 x 6
MirrorSpring washer M14 x 6
MirrorWasher M14 x 12
Bearing support-2 x 13
Micro switch base
Bearing support-3
Bolt M8x30 x 2
Nut M8 x 2
Spring washer M8 x 2
Washer M8 x 4
Nut M16-2 x 12
Spring washer M16 x 12
Washer M16 x 32
Bolt M16x40 x 16
Lifitng lug x 2
Bolt M18x60-2 x 62
Stiffener Pl-1-t1 x 4
Stiffener Pl-2-t1 x 4
Stiffener Pl-3-t1 x 8
Handwheel base-t1
Handwheel stiffener1 x 2
Handwheel stiffener2 x 2
Handwheel base support-t1
MirrorHandwheel base support-t1
ME-8111 x 2
Flange-V x 4
Flange-H x 4
Blade pipe-t1 x 3
Blade plate-t1 x 6
Blade shaft-3-t1
Blade stiffener-t1 x 21
Blade shaft-2-t1 x 3
bolt M20x100 x 12
spring Washer M20 x 12
Washer M20 x 24
Nut m20 x 12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
