koalium/centidocs/Q.C/Mashi/لرزه گير/Assem2.SLDASM

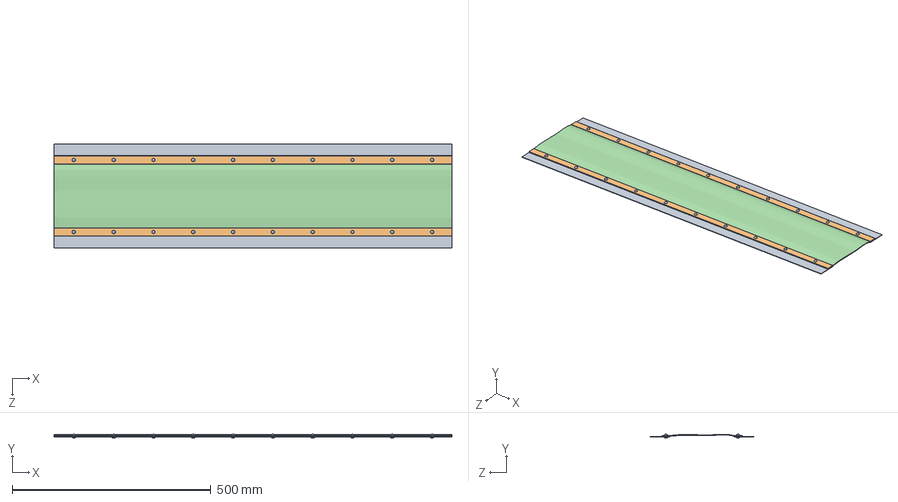
[picture p202: CAD file, 2025-05-18]
Q.C/Mashi/لرزه گير/Assem2.SLDASM
1000.0 x 9.50 x 261.0 mm
Base Plate 1 x 2
Strap x 2
rivet 02_din x 20
Ls1
