koalium/centidocs/SAFARI/2300x1000/Assem total.SLDASM

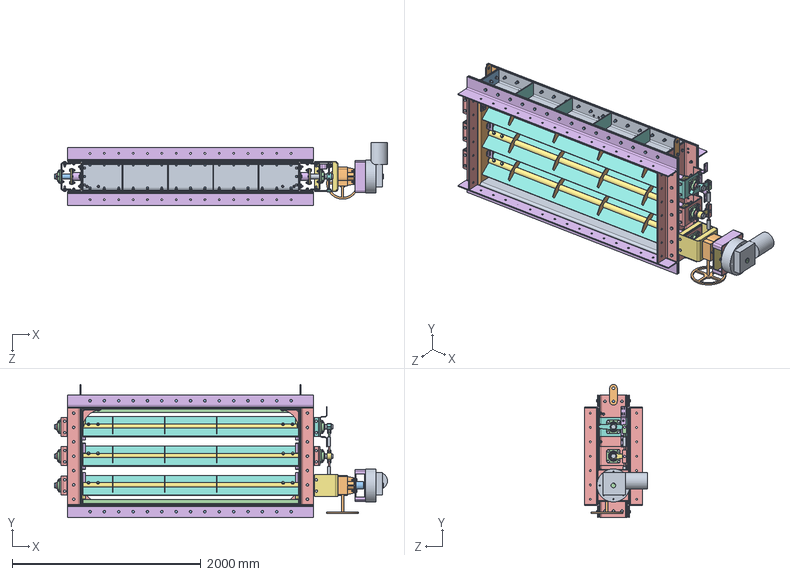
[picture p203: CAD file, 2025-05-18]
SAFARI/2300x1000/Assem total.SLDASM
3524.3 x 1409.9 x 669.5 mm
Frame H x 2
Frame V
Connection plate x 4
gland1-flang1 x 3
gland1-flang2 x 3
gland-packing1 x 3
Bolt M14x50 x 58
Nut M14 x 61
Spring washer M14 x 61
Washer M14 x 128
Bearing support x 5
Frame L-seal-1 x 8
Frame L-seal-2 x 4
Frame H stiffener x 8
Bolt M18x50 x 40
Nut M18 x 103
Spring washer M18 x 102
Washer M18 x 205
MirrorFrame V
Mirrorgland1-flang1 x 3
Mirrorgland1-flang2 x 3
Mirrorgland-packing1 x 3
MirrorBolt M14x50 x 6
MirrorNut M14 x 6
MirrorSpring washer M14 x 6
MirrorWasher M14 x 12
Bearing support-2 x 13
Micro switch base
Handwheel base
Bearing support-3
Bolt M8x30 x 2
Nut M8 x 2
Spring washer M8 x 2
Washer M8 x 4
corner-frame x 4
Bolt M16x40 x 20
Nut M16-2 x 16
Spring washer M16 x 20
Washer M16 x 36
Lifitng lug x 2
Bolt M18x60-2 x 62
Flange-V x 4
Flange-H x 4
Blade pipe x 3
Blade plate x 6
Blade shaft x 2
Blade stiffener x 21
Blade shaft-2 x 3
bolt M20x100 x 12
spring Washer M20 x 12
Washer M20 x 24
Nut m20 x 12
Blade shaft-3
lever-regulator x 2
Nut M16-right-hand x 2
Nut M16-Left-hand x 2
lever1-left handed x 2
lever1-right handed
Bolt M14x60 x 3
arm2-blade11 x 2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
