koalium/centidocs/SAFARI/Damper 1200x1200/Assem driver.SLDASM

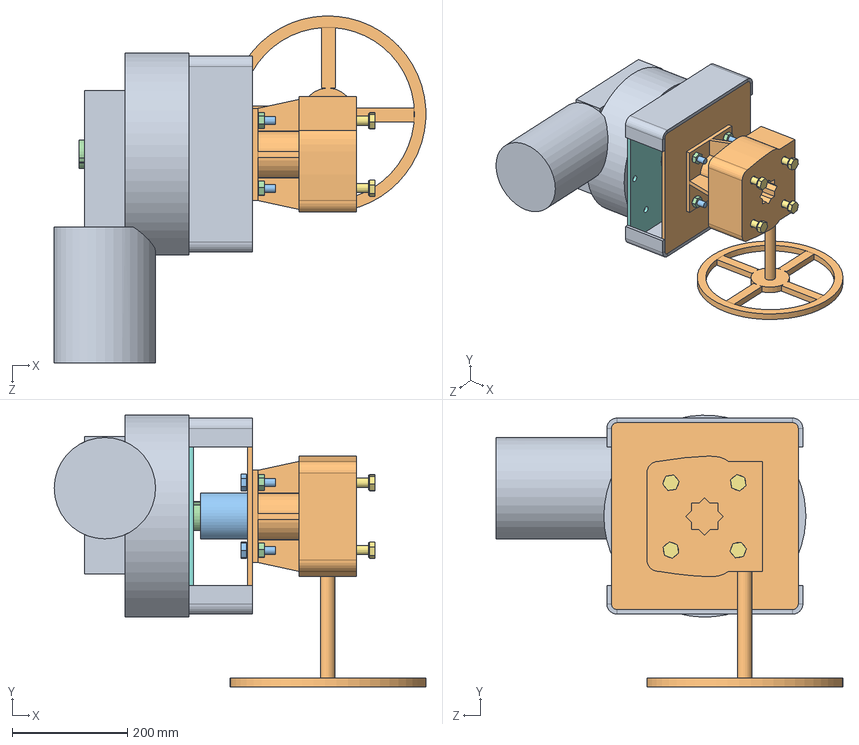
[picture p204: CAD file, 2025-05-18]
SAFARI/Damper 1200x1200/Assem driver.SLDASM
644.0 x 470.8 x 601.4 mm
Shakerin 150FC-2600 N.m
Pneumatic clutch handwheel
Coupling
G.B-handwheel shaft
Spring washer M16 x 4
Washer M16 x 4
Bolt M16x40 x 4
Connection-1
Connection-2 x 2
Connection-3
Bolt M14x50 x 4
Nut M14 x 4
Spring washer M14 x 4
Washer M14 x 8
