koalium/centidocs/jokar/0/HVAC/3000/Drum 3000/Drum3000-5100.SLDASM

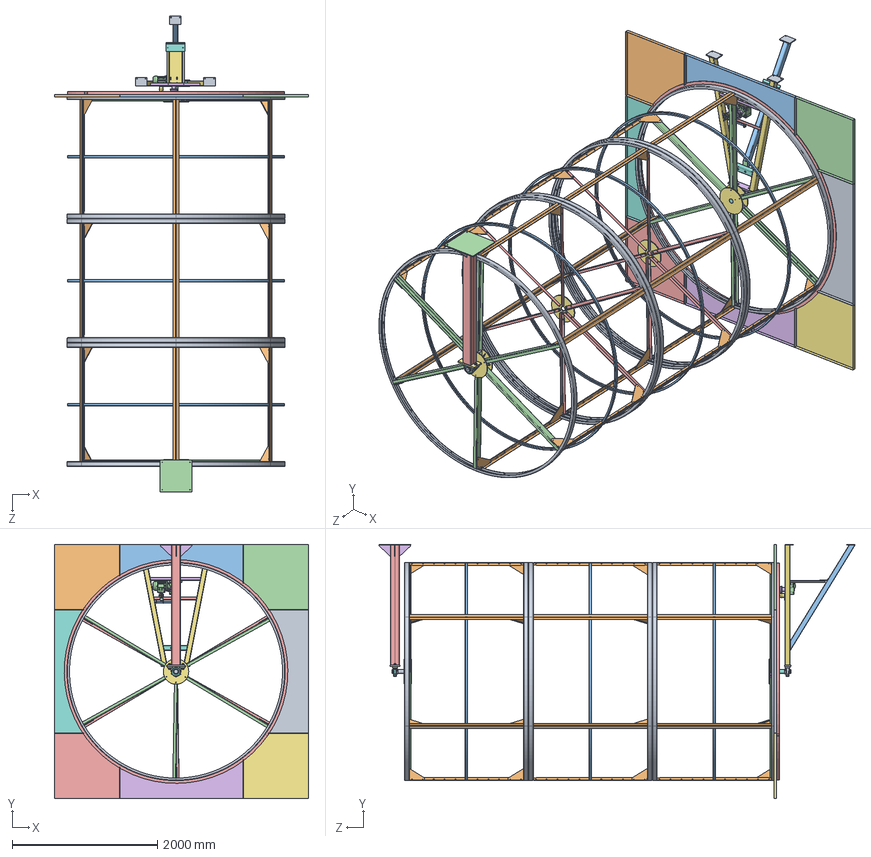
[picture p205: CAD file, 2025-05-18]
jokar/0/HVAC/3000/Drum 3000/Drum3000-5100.SLDASM
3496.0 x 3496.4 x 6547.2 mm
Upn 72 drg 2 x 36
L Angle 40x40 x 36
upn 2mm glv x 18
upn main 2 x 12
nabshi taghviati 40x40x1165 x 12
Pipe(OD=22) x 24
plate main x 6
shafte 60-300
shafte 60
plate lchky x 24
تقویتی صفحه x 12
Stand Base Plate
Stand Post x 2
Stand Post Stiffener x 4
Stand Bearing Plate
Stand Bearing
Stand Bearing Bolt x 2
Stand Bearing Nut x 2
Stand Bearing Flat Washer x 2
Stand Bearing Spring Washer x 2
Angle40-3000 x 2
صفحه زیر یاتاقان
قوطی طولی سمت الکترو موتور x 2
قوطی عرضی سمت الکتروموتور
ورق زیر پایه x 3
تسمه زیر پایه میانی
قوطی پایه سمت الکترو موتور
صفحه زیر درپوش ناودانی
نبشی میانی پایه فیلتر
نبشی پایه پایینی
صفحه زیر الکترو موتور
صفحه نگهدارنده زیر صفحه الکترو موتور
AST_Bearings_UCP212
تسمه نگهدارنده پیچ پایه x 3
پیچ تنظیم پولی
ورق زیر نبشی
تسمه اتصال پایه
پولی چدنی
پولی تسمه سبز
hex screw gradec_din
plain washer grade c_din x 2
hex nut gradec_din
6201-Z x 2
Standard motor
شفت موتور روتاری
