koalium/centidocs/jokar/1/Damper 3540/Main Link Flat Baar.SLDPRT

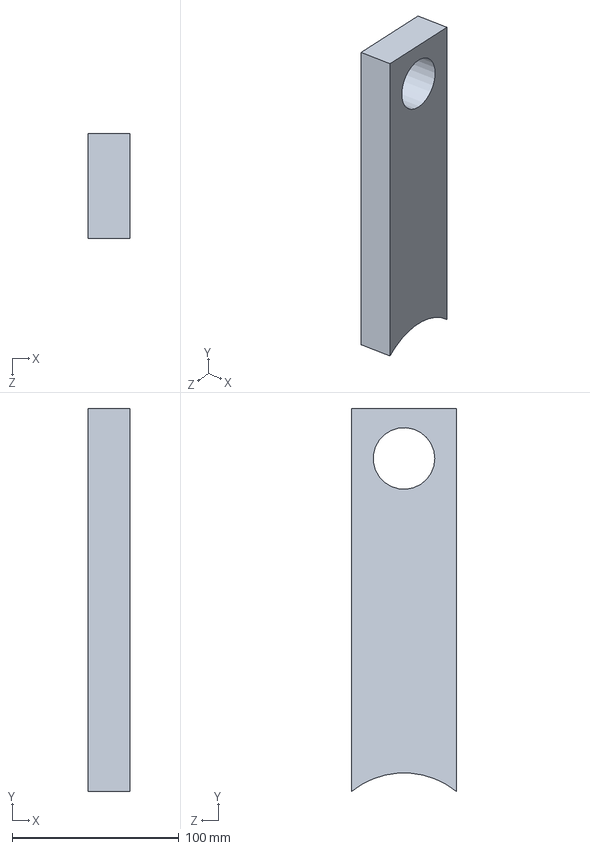
[picture p206: CAD file, 2025-05-18]
jokar/1/Damper 3540/Main Link Flat Baar.SLDPRT
25.0 x 230.0 x 63.0 mm
