koalium/centidocs/jokar/2/Damper 6400/Blade Assembly.SLDASM

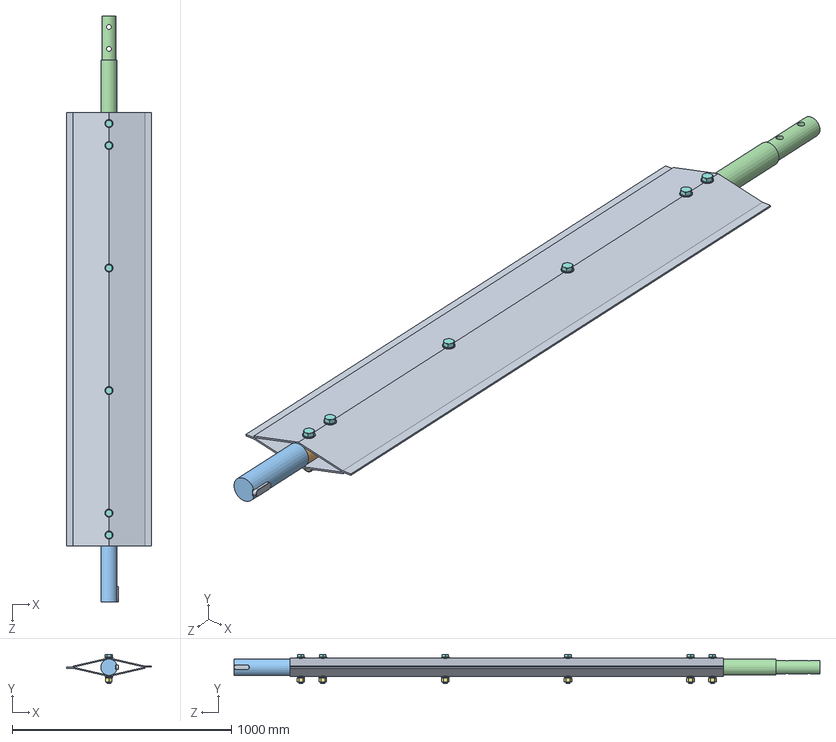
[picture p207: CAD file, 2025-05-18]
jokar/2/Damper 6400/Blade Assembly.SLDASM
386.0 x 132.5 x 2670.0 mm
Blade x 2
Blade Pipe
Link Side Shaft
Middle Shaft
plain washer grade c_din x 12
curved spring lock washer_din x 6
hex nut gradec_din x 6
hex bolt gradeb_din x 6
