koalium/centidocs/jokar/Air Filter Rotary 2500/سینی روتاری/Assem1.SLDASM

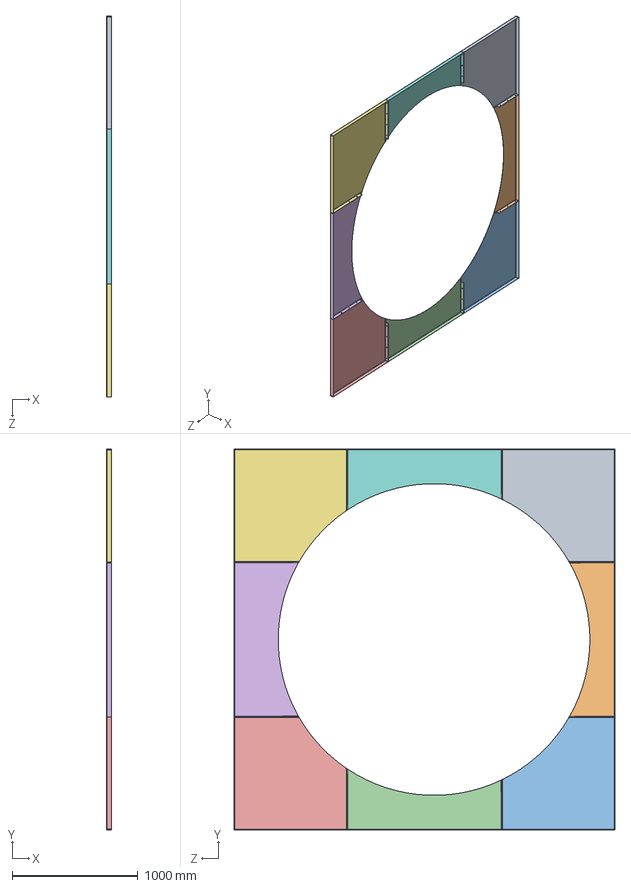
[picture p208: CAD file, 2025-05-18]
jokar/Air Filter Rotary 2500/سینی روتاری/Assem1.SLDASM
40.0 x 3032.0 x 3032.0 mm
NO1
NO2
NO3
NO4
NO5
NO6
NO7
NO8
