koalium/centidocs/Q.C/Mashi/00.04.08/total testing model/Assem-Pipes-right-1.SLDASM

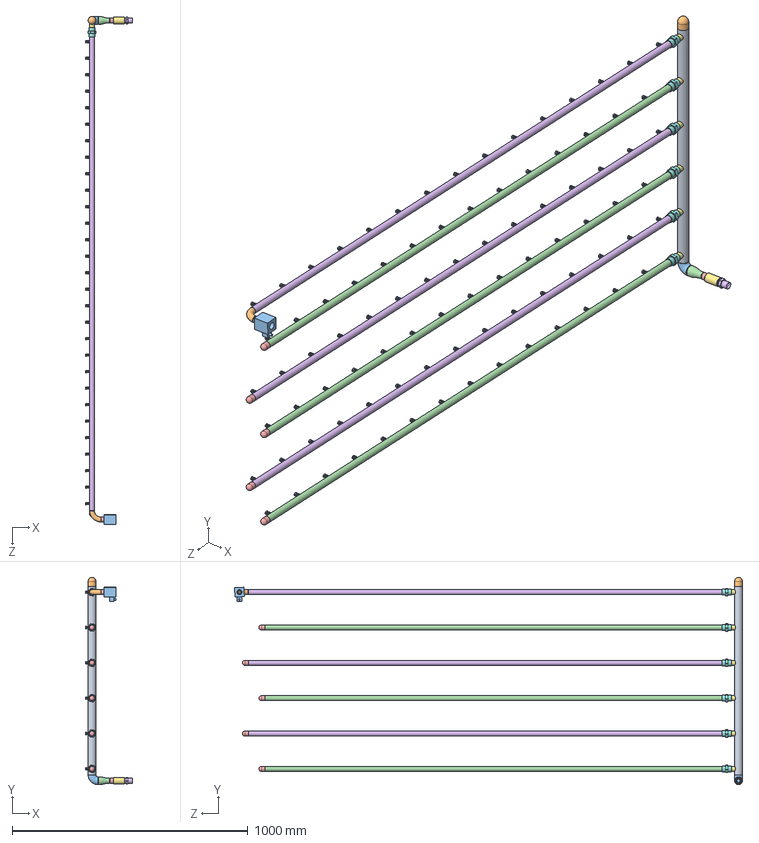
[picture p209: CAD file, 2025-05-18]
Q.C/Mashi/00.04.08/total testing model/Assem-Pipes-right-1.SLDASM
199.1 x 880.1 x 2155.8 mm
Collector Pipe-1-sch40
Collector end cap
90deg Sr inch elbow
reducer-0.5
weld nipple-0.5 x 2
Riser Pipe-right-1 x 3
Nipple-0.5-sch40 x 6
universal-joint-0.5-sch.40 x 6
Nozzle-0.3-lechler-2MN x 87
90deg lr metric elbow-0.5
solenoid valve0.5
Riser Pipe-right-2 x 3
end cap 0.5 x 5
Hex nipple-0.5-conical
threaded coupling-0.5
