koalium/centidocs/Q.C/Mashi/Beygi-03/Assem motor support.SLDASM

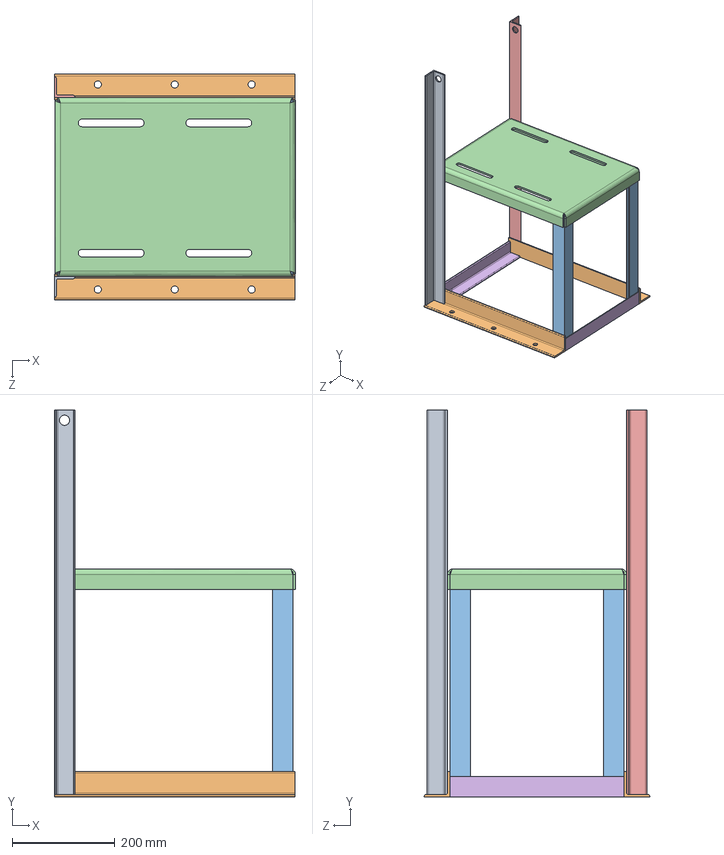
[picture p210: CAD file, 2025-05-18]
Q.C/Mashi/Beygi-03/Assem motor support.SLDASM
471.0 x 755.0 x 440.0 mm
V-support
H-support x 2
V-support2 x 2
motor support
V-support-12
V-support3 x 2
