koalium/centidocs/Rezaei/11/Disk filter/Assem-panels-sec1.SLDASM

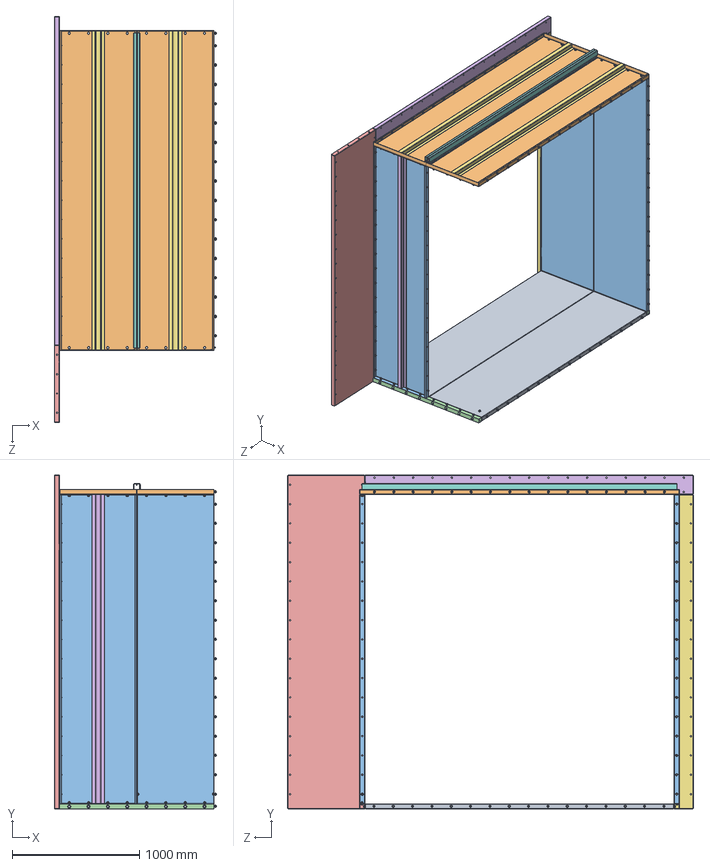
[picture p211: CAD file, 2025-05-18]
Rezaei/11/Disk filter/Assem-panels-sec1.SLDASM
1274.0 x 2624.0 x 3192.0 mm
panel-bottom1 x 2
panel-top1 x 2
panel-side1 x 3
panel-Bottom-reinforce x 6
panel-side1-reinforce x 3
panel-top1-reinforce x 2
panel-top1-stif x 2
Bolt1 M10x20 x 194
Nut1 M10 x 194
Bolt2
washer-2
panel-side1 - flanges
panel-seal1
panel-seal2
