koalium/centidocs/Rezaei/17153/Model/Type 1/Assem1.SLDASM

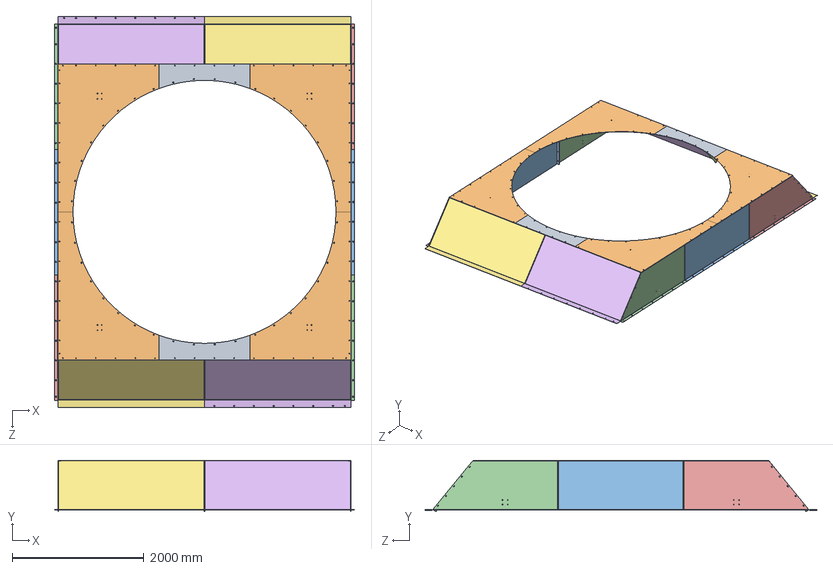
[picture p212: CAD file, 2025-05-18]
Rezaei/17153/Model/Type 1/Assem1.SLDASM
4560.0 x 781.5 x 5933.5 mm
3M x 2
3L.3R x 4
1M x 2
1L.1R x 2
2L.2R 2 x 2
2L.2R x 2
2L.2R 3 x 2
