koalium/centidocs/Rezaei/Disk filter/New Ring/Driver Disk Assembly.SLDASM

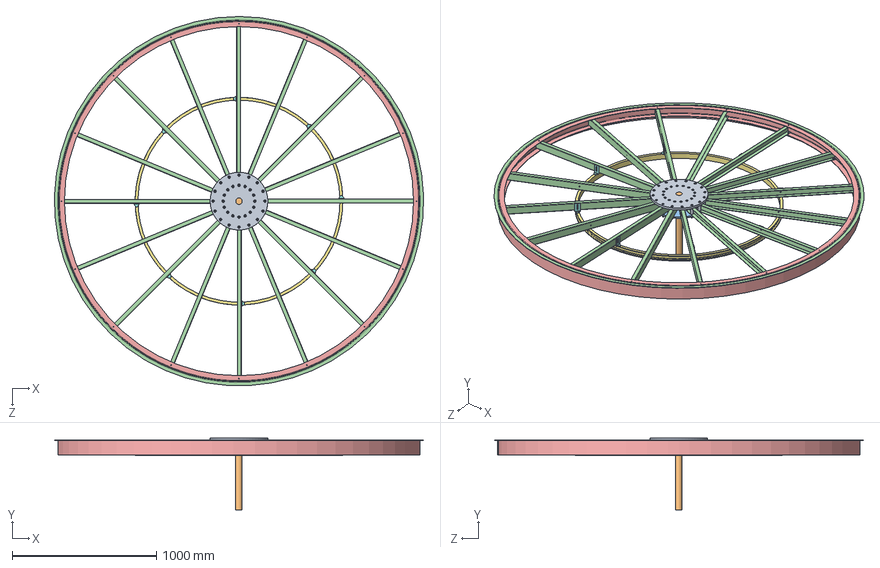
[picture p213: CAD file, 2025-05-18]
Rezaei/Disk filter/New Ring/Driver Disk Assembly.SLDASM
2558.9 x 498.0 x 2557.8 mm
Center Disk Thk=16
Axis Shaft
Center Disk Thk=10
UPN Arm x 16
UPN Ring
Spacer x 4
UPN Pulley
Pulley Clamp x 8
Spacer Bush x 32
socket head cap screw fine_din x 32
hex flange nut_din x 32
Stopper Angle
Sealing Rubber
