koalium/centidocs/jokar/0/HVAC/3000/Vacuum Cleaner 5100-3000/6000-2Z.SLDASM

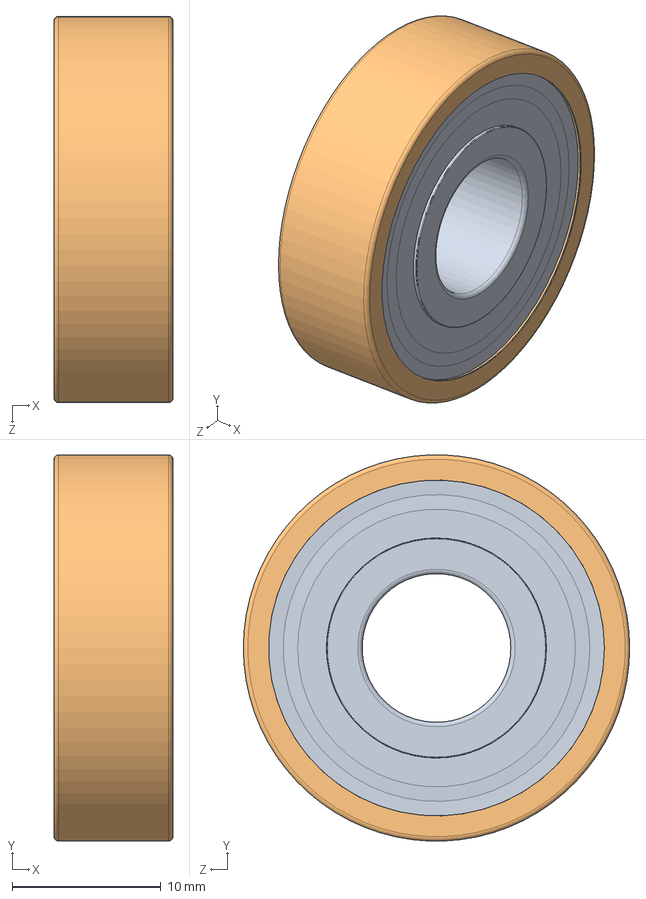
[picture p215: CAD file, 2025-05-18]
jokar/0/HVAC/3000/Vacuum Cleaner 5100-3000/6000-2Z.SLDASM
8.00 x 26.0 x 26.0 mm
_6000-2Z_PART1
_6000-2Z_PART2
_6000-2Z_PART3 x 7
