koalium/centidocs/jokar/1/Damper 6400/Stop Angle Main 1.SLDPRT

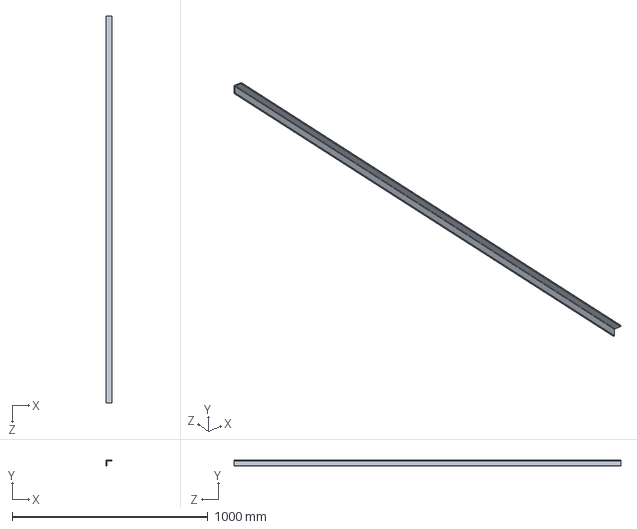
[picture p216: CAD file, 2025-05-18]
jokar/1/Damper 6400/Stop Angle Main 1.SLDPRT
30.0 x 30.0 x 1975.0 mm
