koalium/centidocs/jokar/2/Damper 6400/Blade 2 Assembly.SLDASM

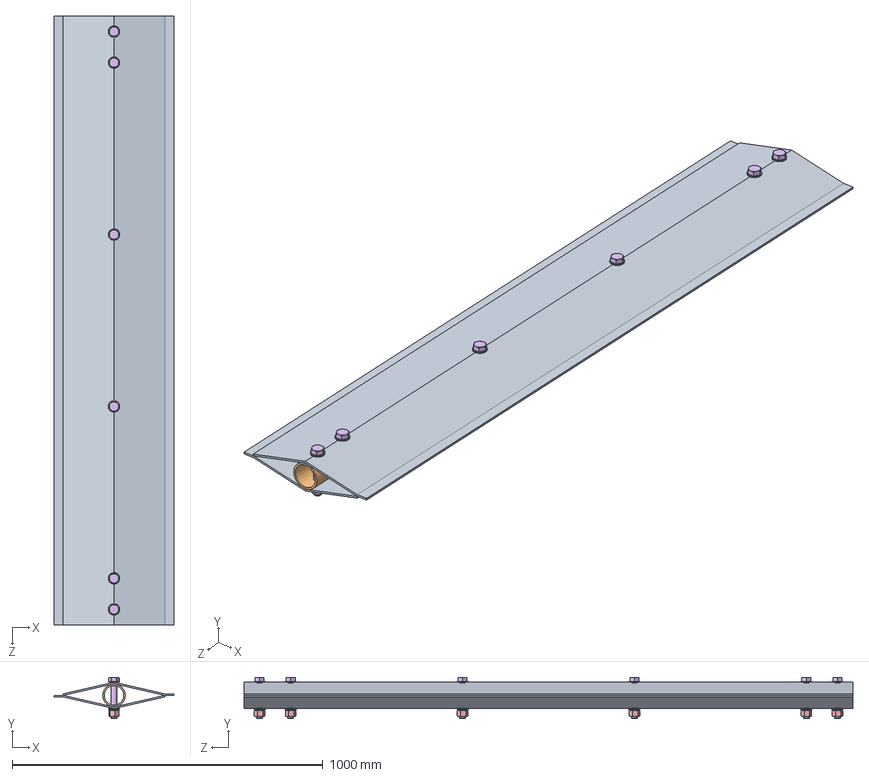
[picture p217: CAD file, 2025-05-18]
jokar/2/Damper 6400/Blade 2 Assembly.SLDASM
386.0 x 132.5 x 1960.0 mm
Blade 2 x 2
Blade Pipe 2
plain washer grade c_din x 12
curved spring lock washer_din x 6
hex nut gradec_din x 6
hex bolt gradeb_din x 6
