koalium/centidocs/Q.C/Mashi/00.04.08/total testing model/Assem-Pipes-right-2.SLDASM

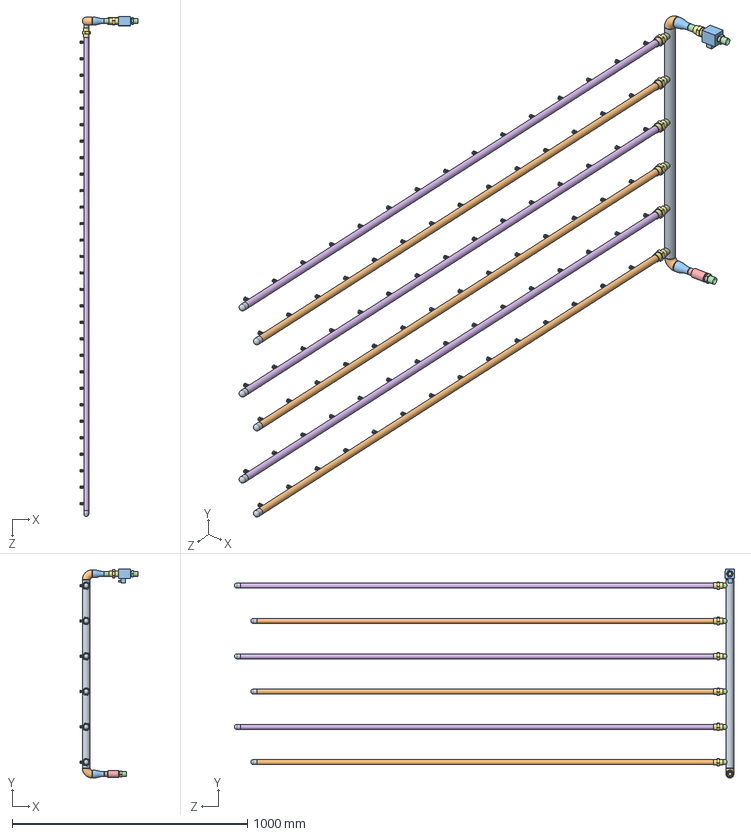
[picture p218: CAD file, 2025-05-18]
Q.C/Mashi/00.04.08/total testing model/Assem-Pipes-right-2.SLDASM
248.4 x 887.8 x 2125.7 mm
Collector Pipe-1-sch40
90deg Sr inch elbow x 2
reducer-0.5 x 2
Nipple-0.5-sch40 x 7
weld nipple-0.5 x 2
Riser Pipe-right-1 x 3
universal-joint-0.5-sch.40 x 7
Nozzle-0.3-lechler-2MN x 87
end cap 0.5 x 6
Riser Pipe-right-2 x 3
solenoid valve0.5
Hex nipple-0.5-conical x 2
threaded coupling-0.5
