koalium/centidocs/Q.C/Mashi/Beygi-03/Assem total.SLDASM

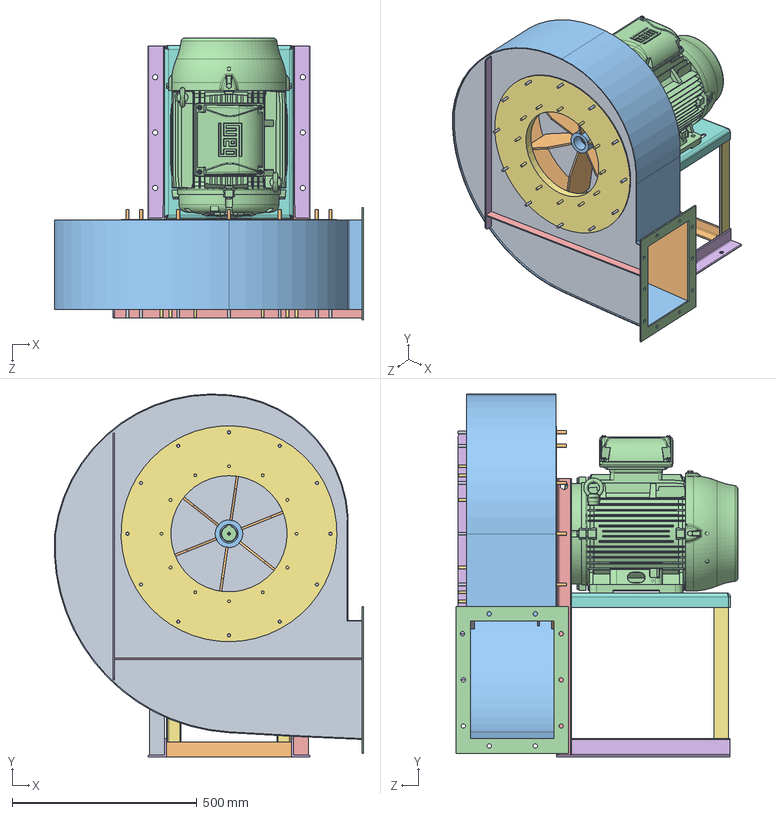
[picture p219: CAD file, 2025-05-18]
Q.C/Mashi/Beygi-03/Assem total.SLDASM
838.4 x 983.7 x 764.3 mm
casing-2
casing-2-2
casing-2-1
Discharge flange
Body stiff-1
Body stiff-2
front case
Back case
blade disk
blade x 6
mid bush
11kW-3000rpm
V-support
H-support x 2
V-support2 x 2
motor support
V-support-12
V-support3 x 2
shaft seal
