koalium/centidocs/mohajeri/8125006-Amirkabir/Damper 750/Body.SLDASM

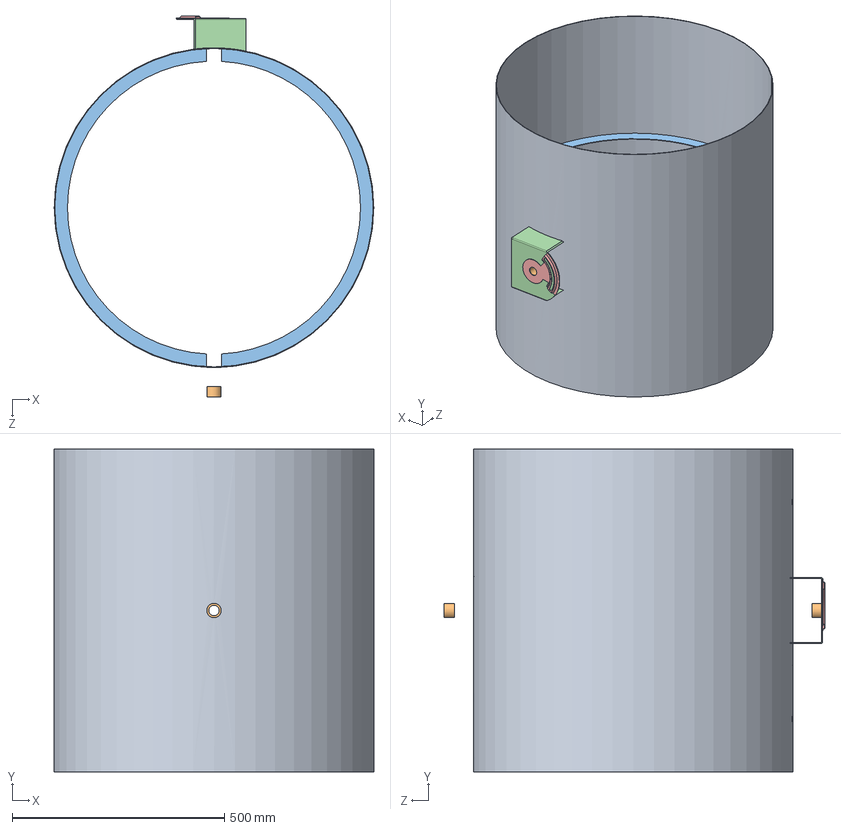
[picture p220: CAD file, 2025-05-18]
mohajeri/8125006-Amirkabir/Damper 750/Body.SLDASM
753.0 x 760.0 x 897.4 mm
Bush2 x 2
Air seal x 2
Adjustment Plate 1016
Handle 1
