koalium/centidocs/mohajeri/8125006-Amirkabir/Damper 850x450/Casing 865 Assem.SLDASM

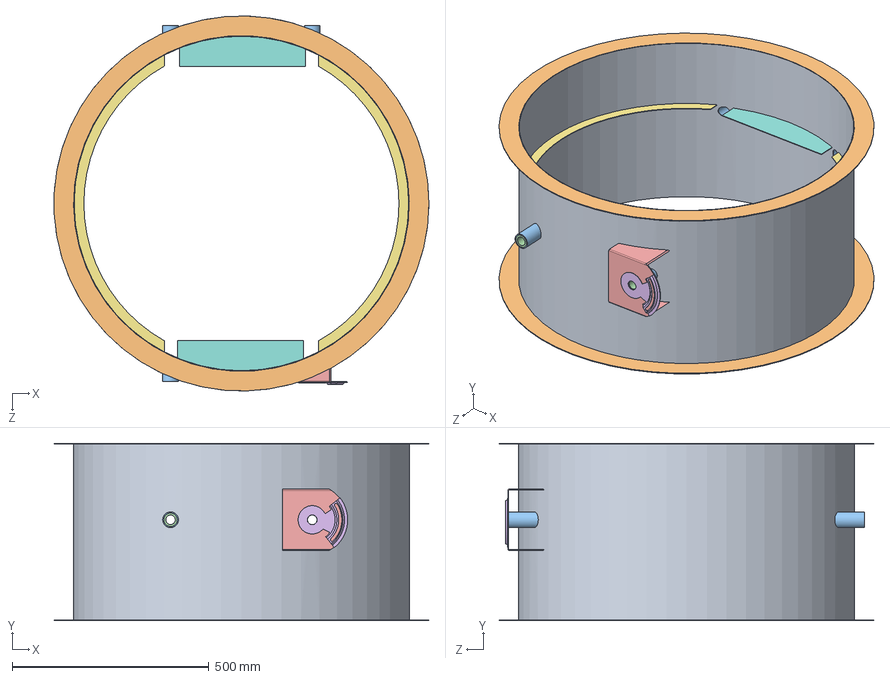
[picture p221: CAD file, 2025-05-18]
mohajeri/8125006-Amirkabir/Damper 850x450/Casing 865 Assem.SLDASM
952.6 x 450.0 x 952.8 mm
Casing 865
Flange x 2
Bush 865 x 4
Bronze Bush x 4
Adjustment Plate 865
Handle 1
Air Seal 1 x 2
Air Seal 2 x 2
