koalium/centidocs/Q.C/Mashi/Beygi-03/Assem blade.SLDASM

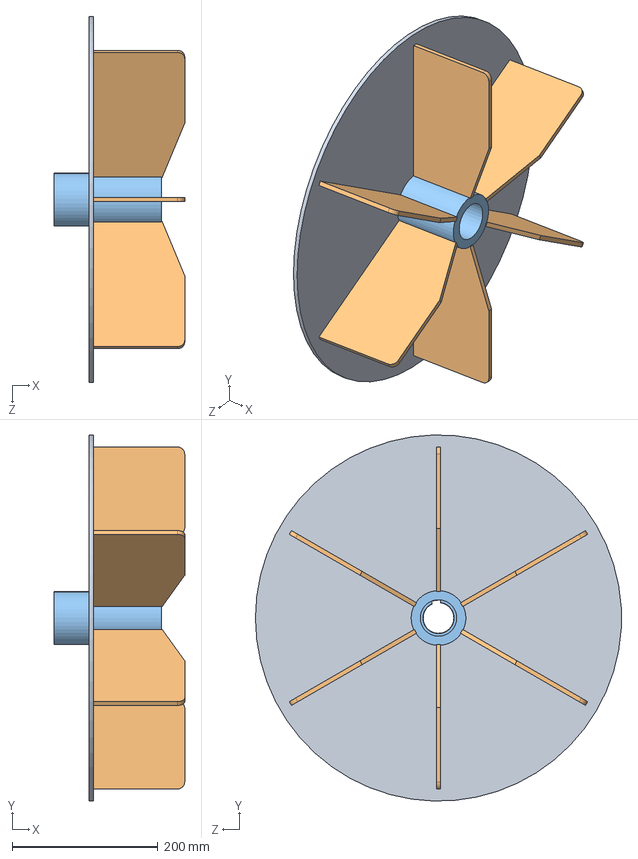
[picture p222: CAD file, 2025-05-18]
Q.C/Mashi/Beygi-03/Assem blade.SLDASM
179.0 x 501.8 x 502.0 mm
blade disk
blade x 6
mid bush
