koalium/centidocs/Rezaei/11/Disk filter/Assem-rec-bar.SLDASM

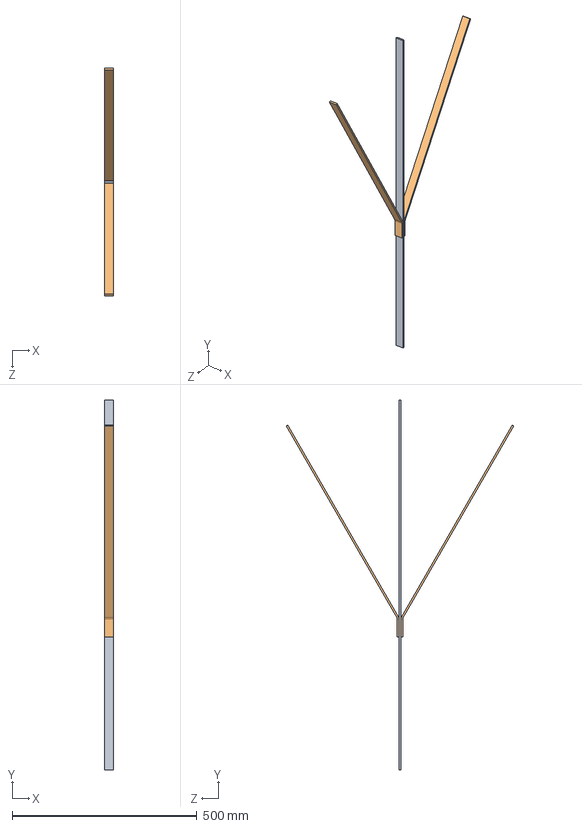
[picture p223: CAD file, 2025-05-18]
Rezaei/11/Disk filter/Assem-rec-bar.SLDASM
25.0 x 1000.0 x 615.0 mm
rect-bar-mesh1
rect-bar-mesh2 x 2
