koalium/centidocs/SAFARI/2300x1000/Assem blade-2.SLDASM

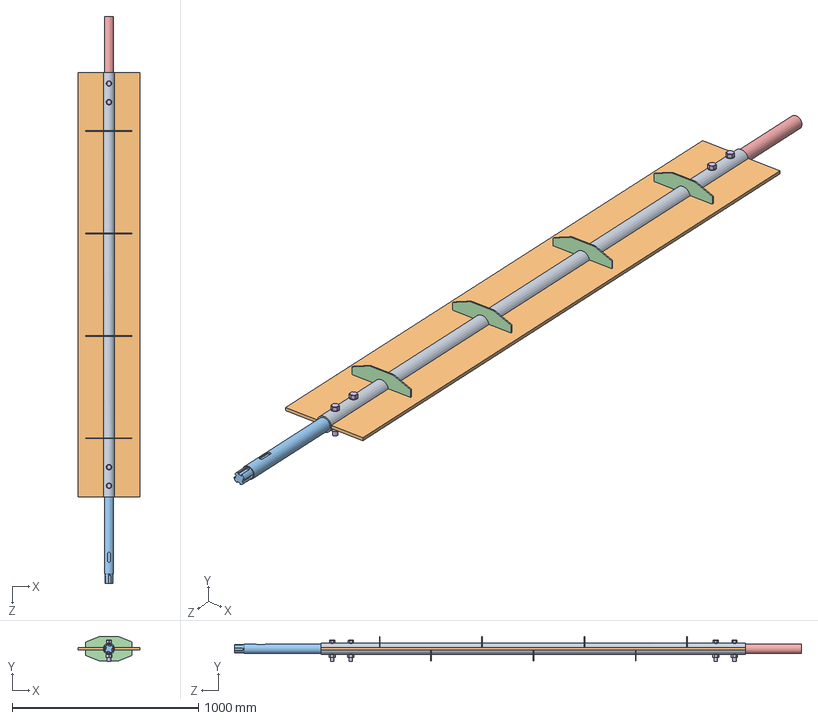
[picture p224: CAD file, 2025-05-18]
SAFARI/2300x1000/Assem blade-2.SLDASM
330.3 x 134.9 x 3045.0 mm
Blade pipe
Blade plate x 2
Blade shaft-3
Blade stiffener x 7
Blade shaft-2
bolt M20x100 x 4
spring Washer M20 x 4
Washer M20 x 8
Nut m20 x 4
