koalium/centidocs/jokar/0/HVAC/3000/Vacuum Cleaner 5100-3000/Angle mix.SLDASM

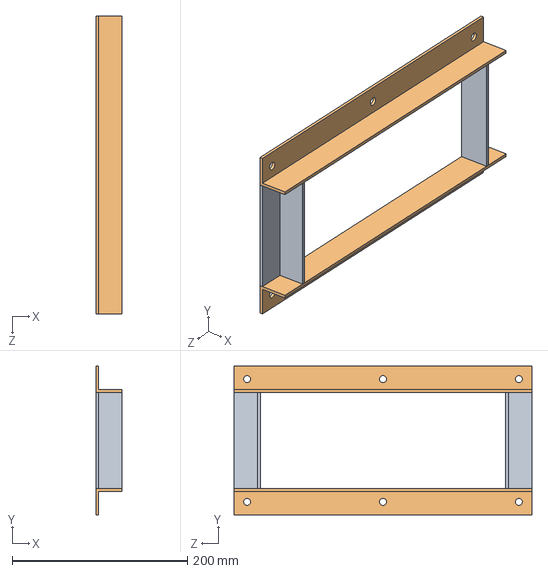
[picture p225: CAD file, 2025-05-18]
jokar/0/HVAC/3000/Vacuum Cleaner 5100-3000/Angle mix.SLDASM
30.0 x 170.0 x 340.0 mm
Angle30x30-2 x 2
Angle30x30 x 2
