koalium/centidocs/mohajeri/damper isfahan/4110006-2300x1000-Rev00/Assem driver-t1.SLDASM

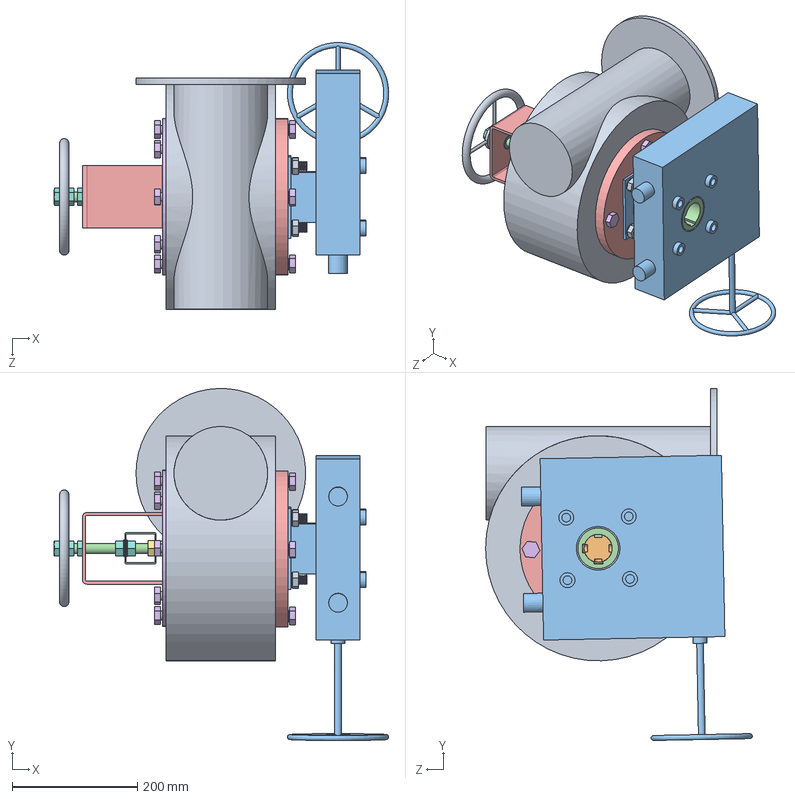
[picture p226: CAD file, 2025-05-18]
mohajeri/damper isfahan/4110006-2300x1000-Rev00/Assem driver-t1.SLDASM
535.1 x 563.0 x 426.7 mm
Shakerin MVF86-150P-2600 N.m-t1
G.B-handwheel shaft-t1
Handwheel part-t1
Coupling2-t1
Coonection plate-t1
Bolt M14x40-t1 x 16
Spring washer M10-t1 x 4
Washer M10-t1 x 4
Nut M14-t1 x 5
Spring washer M14-t1 x 7
Washer M14-t1 x 4
Inner box-t1
Outer box-t1
lock connection plate-t1
Bolt M14x60-t1
Nut M16-t1 x 5
steer wheel-t1
Spring washer M16-t1 x 2
Washer M16-t1 x 2
Threaded rod M16-t1
