koalium/centidocs/Q.C/Mashi/Aluminum Damper/Shaft.SLDASM

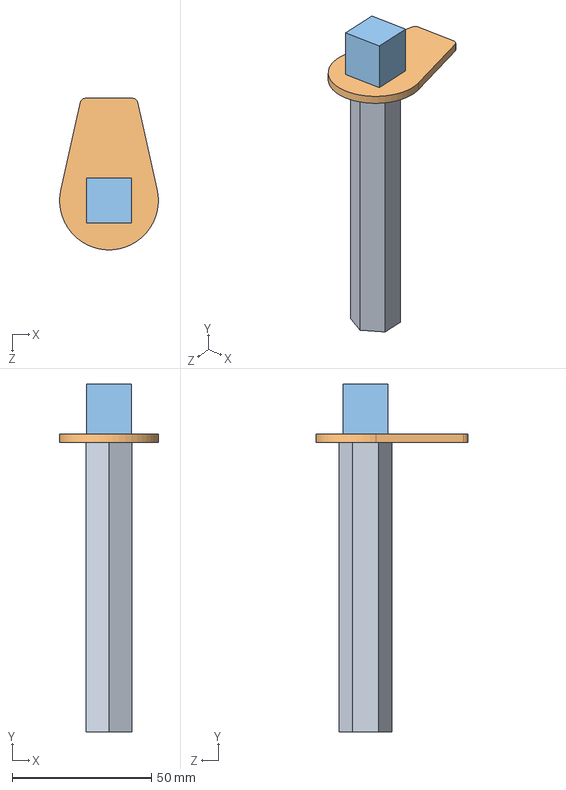
[picture p227: CAD file, 2025-05-18]
Q.C/Mashi/Aluminum Damper/Shaft.SLDASM
35.5 x 125.0 x 54.5 mm
Shaft 6g
Shaft Cam
Shaft 4g
