koalium/centidocs/Rezaei/0/Fiber Fan/Main Assembly.SLDASM

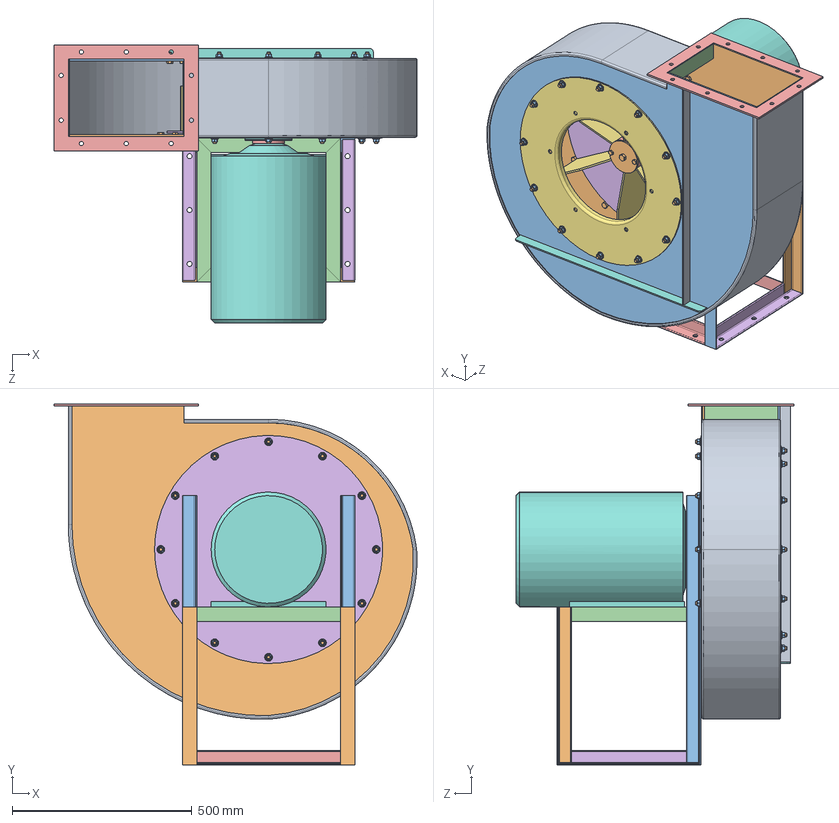
[picture p228: CAD file, 2025-05-18]
Rezaei/0/Fiber Fan/Main Assembly.SLDASM
1010.8 x 1005.0 x 775.0 mm
Sweeped Frame
صفحه پشت
صفحه ورودی فن
دربند فریم
فلنج خروجی هوا
صفحه انتهایی
فلنج ورودی غبار
تسمه تقویت 1
تسمه تقویت2
نبشی تقویت 5 x 2
نبشی تقویت 1 x 2
نبشی ساپورت 4 x 4
نبشی فلنج کف 2 x 2
نبشی فلنج کف 1 x 2
نبشی سوراخکاری x 2
Sealing Disk
Sealing Cap
p[[op[op x 27
hex flange nut_din x 24
socket countersunk head screw_din x 3
توپی
صفحه ایمپلر
ایمپلر x 6
موتور
parallel_din
Stop Washer
