koalium/centidocs/Rezaei/8112007/Drawing/Damper Main Assembly.SLDASM

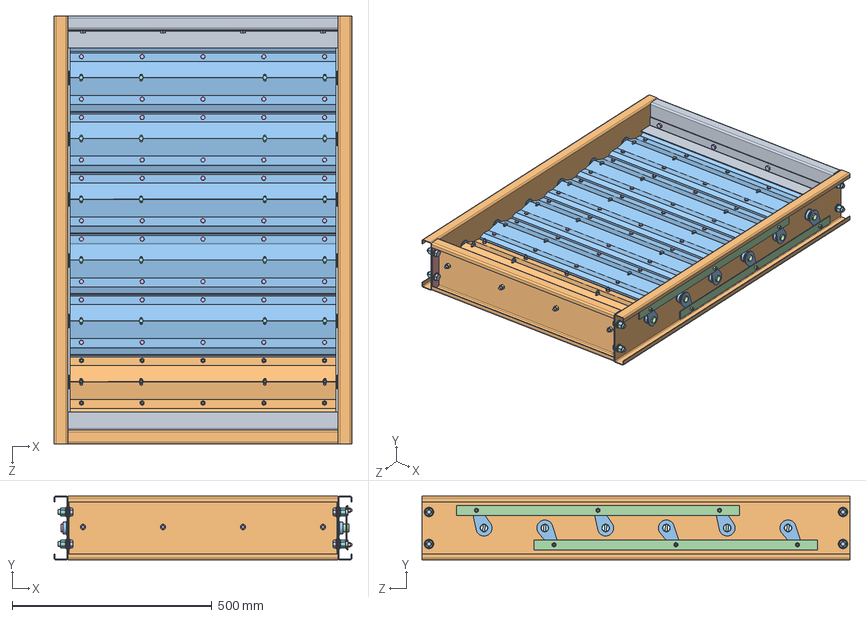
[picture p229: CAD file, 2025-05-18]
Rezaei/8112007/Drawing/Damper Main Assembly.SLDASM
745.0 x 160.0 x 1070.0 mm
Horizontal
Vertical Frame x 2
Bush Damper x 12
circlip for shafts normal_din x 12
End Plate x 4
plain washer grade c_din x 16
curved spring lock washer_din x 8
ff x 8
x x 8
Horizontal Left
Blade 665 x 11
Axis Pipe x 6
Axis Pipe End x 6
sssssss x 68
hex nut gradec_din x 98
hhhhh x 24
Air Seal h x 2
Blade 665 Left
Badamak x 6
Rod x 2
M6x15 x 6
