koalium/centidocs/jokar/0/HVAC/3000/Drum 3000/upn main 2.SLDPRT

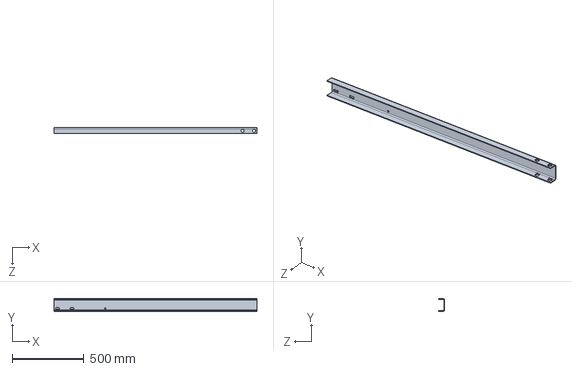
[picture p230: CAD file, 2025-05-18]
jokar/0/HVAC/3000/Drum 3000/upn main 2.SLDPRT
1415.0 x 88.0 x 44.0 mm
