koalium/centidocs/mohajeri/damper isfahan/4110006-1900x1300-Rev08/arm2-blade2.SLDASM

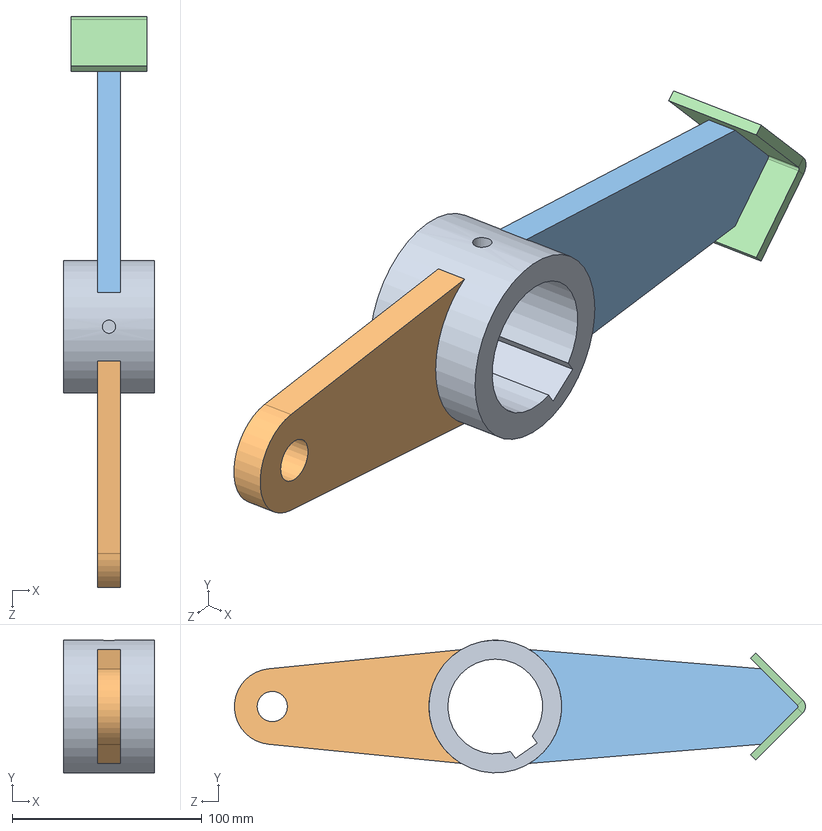
[picture p231: CAD file, 2025-05-18]
mohajeri/damper isfahan/4110006-1900x1300-Rev08/arm2-blade2.SLDASM
48.0 x 70.0 x 301.1 mm
arm2-blade-2
Stiffener1
Stiffener2
Plate
