koalium/centidocs/mohajeri/damper isfahan/4110006-2300x1000-Rev00/Assem total Handwheel-t1.SLDASM

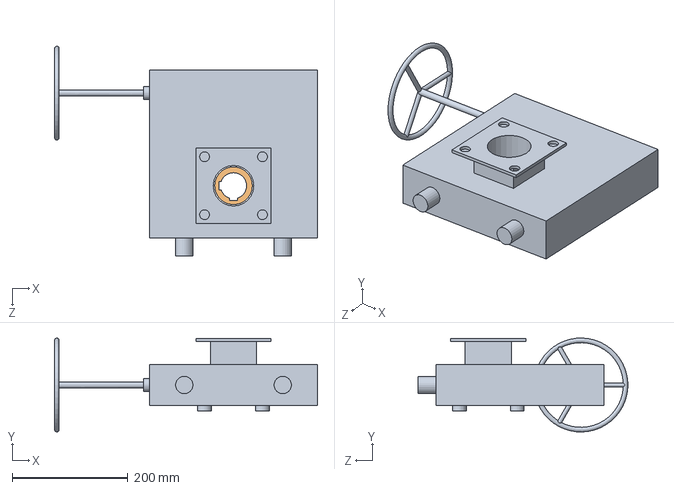
[picture p232: CAD file, 2025-05-18]
mohajeri/damper isfahan/4110006-2300x1000-Rev00/Assem total Handwheel-t1.SLDASM
454.0 x 162.1 x 361.9 mm
Handwheel part-t1
Coupling2-t1
