koalium/centidocs/Q.C/Mashi/00.04.08/total testing model/Assem-Pipes-right-3.SLDASM

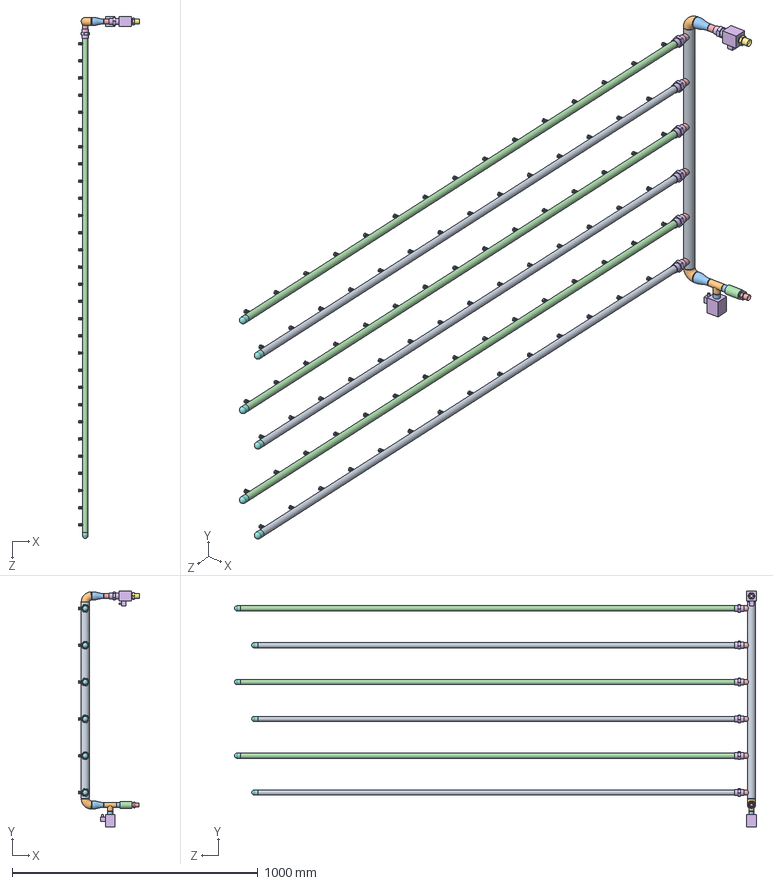
[picture p233: CAD file, 2025-05-18]
Q.C/Mashi/00.04.08/total testing model/Assem-Pipes-right-3.SLDASM
248.4 x 961.0 x 2125.7 mm
Collector Pipe-1-sch40
90deg Sr inch elbow x 2
reducer-0.5 x 2
Riser Pipe-right-1 x 3
Nipple-0.5-sch40 x 7
universal-joint-0.5-sch.40 x 7
Nozzle-0.3-lechler-2MN x 87
end cap 0.5 x 6
Riser Pipe-right-2 x 3
Straight tee-0.5
weld nipple-0.5 x 3
threaded reducer-0.5-0.375
Hex nipple-0.375-conical
solenoid valve0.5 x 2
Hex nipple-0.5-conical
