koalium/centidocs/Q.C/Mashi/Aluminum Damper/Damper Cam.SLDASM

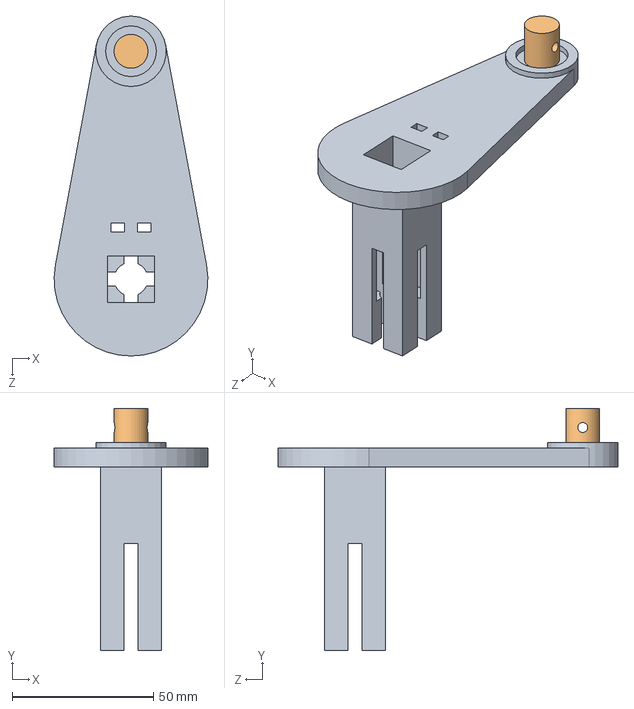
[picture p234: CAD file, 2025-05-18]
Q.C/Mashi/Aluminum Damper/Damper Cam.SLDASM
54.5 x 85.8 x 120.5 mm
Cam
Cam pin
