koalium/centidocs/SAFARI/2300x1000/01/Assem driver.SLDASM

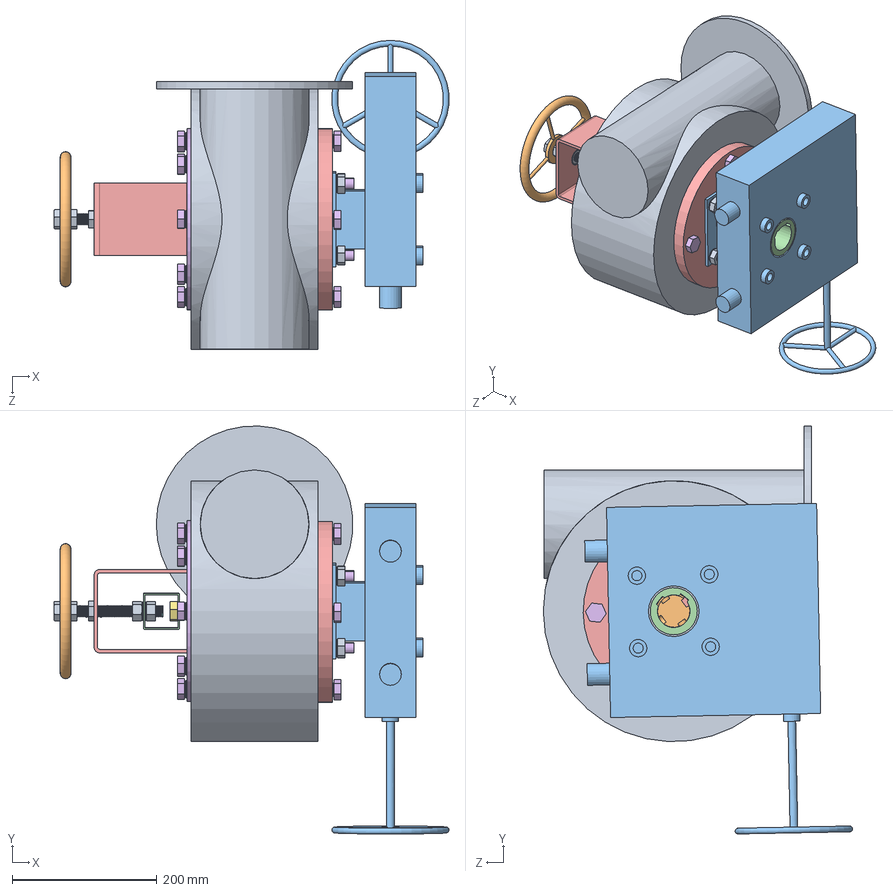
[picture p235: CAD file, 2025-05-18]
SAFARI/2300x1000/01/Assem driver.SLDASM
545.1 x 563.0 x 426.9 mm
Shakerin MVF86-150P-2600 N.m
G.B-handwheel shaft
Handwheel part
Coupling-2
Coonection plate
Bolt M14x40 x 16
Spring washer M10 x 4
Washer M10 x 4
Nut M14 x 4
Spring washer M14 x 13
Washer M14 x 12
Inner box
Outer box
lock connection plate
Bolt M14x60
Threaded rod M16
Nut M16 x 5
steer wheel
Spring washer M16 x 2
Washer M16 x 2
Stud holder M14
