koalium/centidocs/jokar/Damper 3540/Assem1.SLDASM

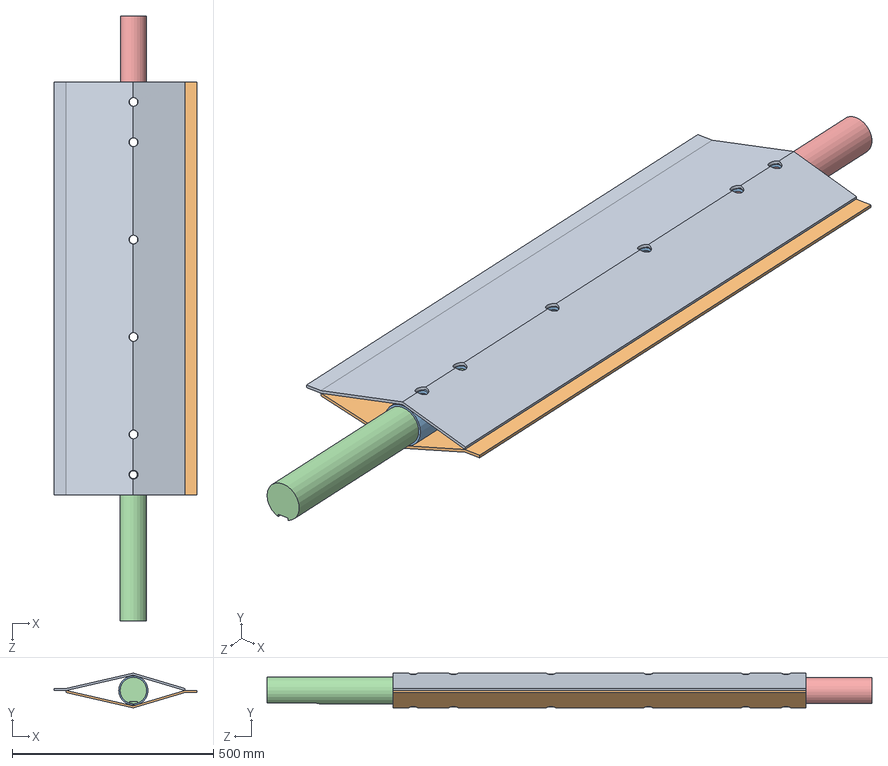
[picture p236: CAD file, 2025-05-18]
jokar/Damper 3540/Assem1.SLDASM
354.5 x 86.5 x 1503.0 mm
Blade 2
Blade 1
Blade Pipe 2
Link Side Shaft First
Shaft 2
