koalium/centidocs/mohajeri/8125006-Amirkabir/Damper 1000x550/Casing Assembly.SLDASM

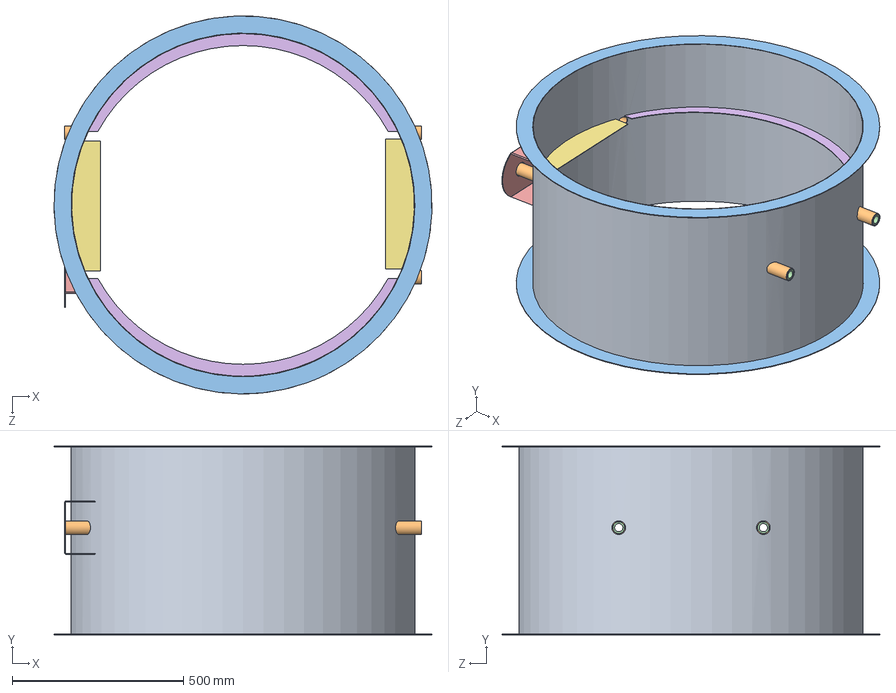
[picture p237: CAD file, 2025-05-18]
mohajeri/8125006-Amirkabir/Damper 1000x550/Casing Assembly.SLDASM
1102.9 x 550.0 x 1102.5 mm
Casing
Bush 1016 x 4
Casing Flange x 2
Bronze Bush x 4
Adjustment Plate 1016
Air Seal 1 x 2
Air Seal 2 x 2
