koalium/centidocs/SAFARI/Damper 1200x1200/Assem blade.SLDASM

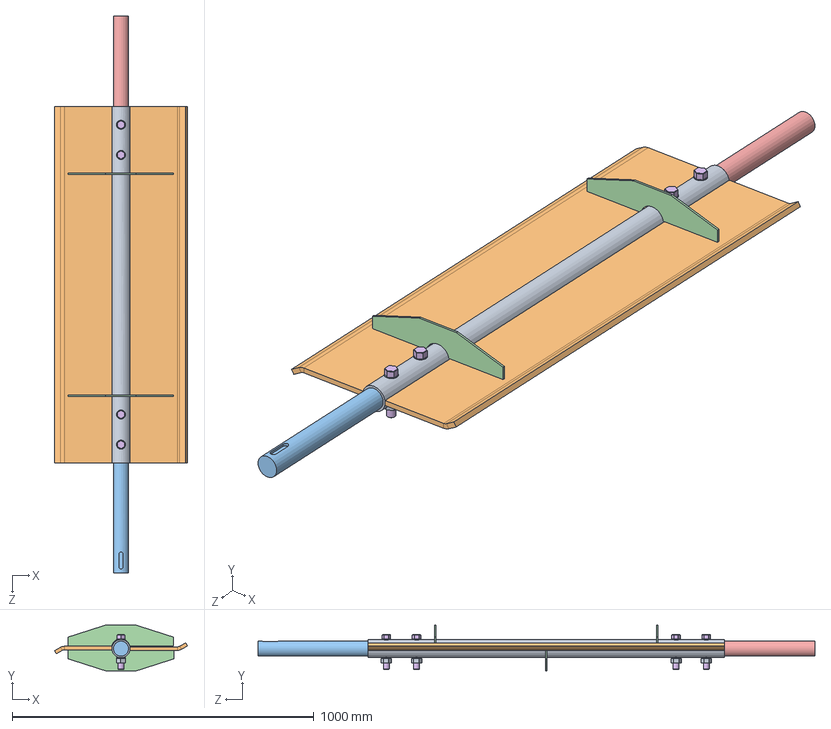
[picture p239: CAD file, 2025-05-18]
SAFARI/Damper 1200x1200/Assem blade.SLDASM
440.7 x 152.0 x 1845.0 mm
Blade pipe
Blade plate x 2
Blade shaft
Blade stiffener x 3
Blade shaft-2
bolt M20x100 x 4
spring Washer M20 x 4
Washer M20 x 8
Nut m20 x 4
