koalium/centidocs/Rezaei/11/Disk filter/Assem-housing.SLDASM

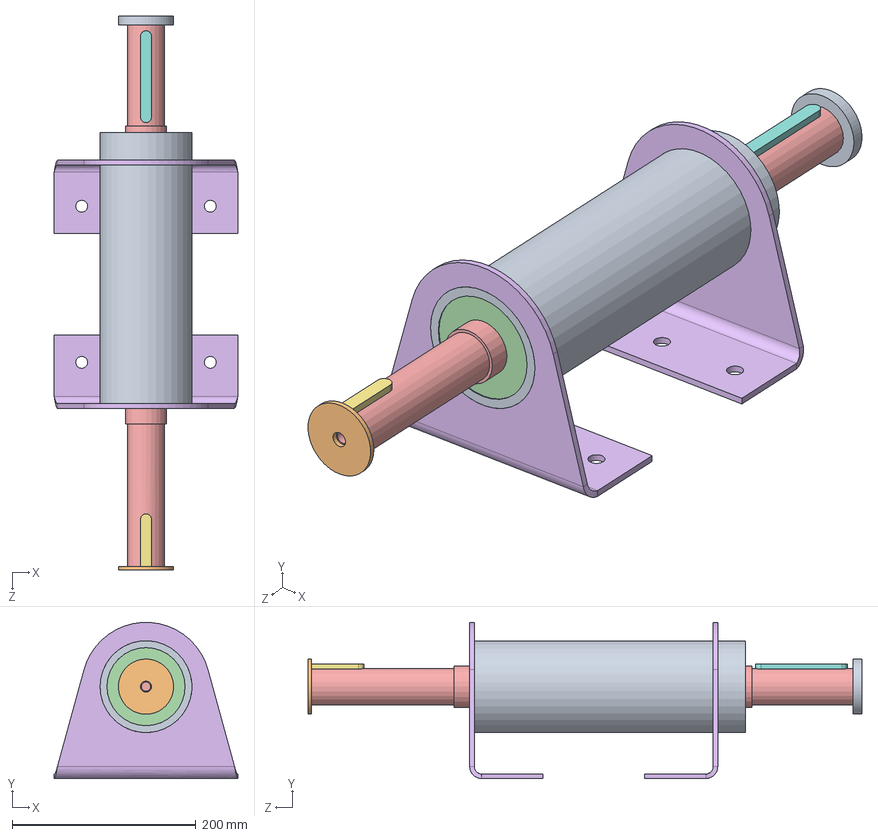
[picture p240: CAD file, 2025-05-18]
Rezaei/11/Disk filter/Assem-housing.SLDASM
200.0 x 169.8 x 603.0 mm
disk-housing
bearing_6209_2rs x 2
circlip 85 x 2
oil seal x 2
shaft-disk filter
housing-mount x 2
Key
Key-2
Washer stop
Washer stop-2
