koalium/centidocs/Rezaei/90005/90005-damper valve/Assem-frame-bearing.SLDASM

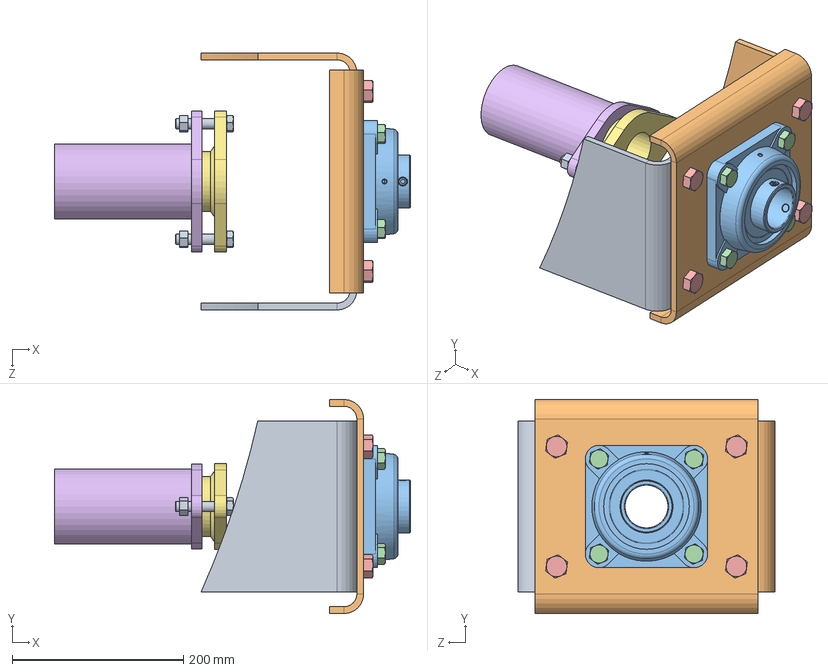
[picture p241: CAD file, 2025-05-18]
Rezaei/90005/90005-damper valve/Assem-frame-bearing.SLDASM
415.6 x 250.0 x 300.0 mm
Bearing-flange1
Bearing-seat-plate
Bearing(ucf210)
Bearing base plate Bolting (M14 x 50) x 4
Bearing S.P. bolting (M16 x40) x 4
Gland-flange F
Gland-flange-M
gland-packing
Gland Pcking Bolting (M12x60) x 2
Mirrorbearing-flange1
