koalium/centidocs/SAFARI/2300x1000/UCF210.SLDASM

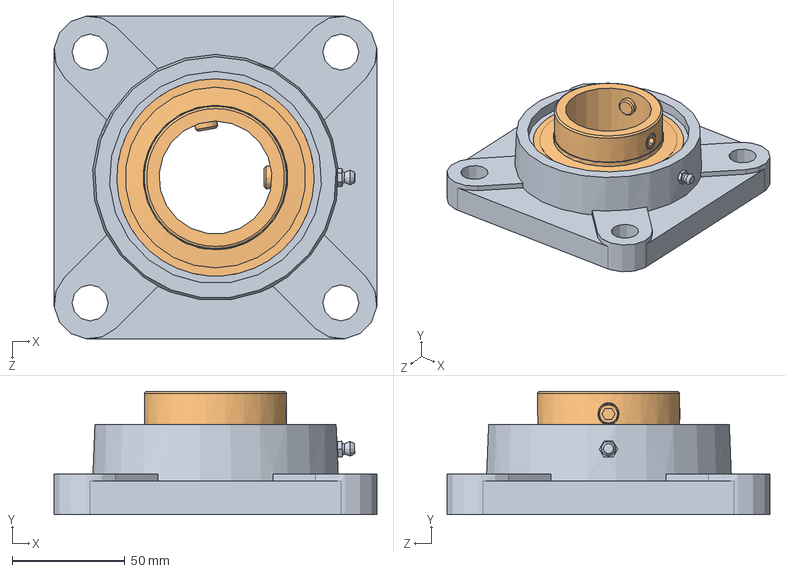
[picture p242: CAD file, 2025-05-18]
SAFARI/2300x1000/UCF210.SLDASM
143.0 x 54.6 x 143.0 mm
