koalium/centidocs/Q.C/Mashi/00.04.08/rev01/Assem filter frame.SLDASM

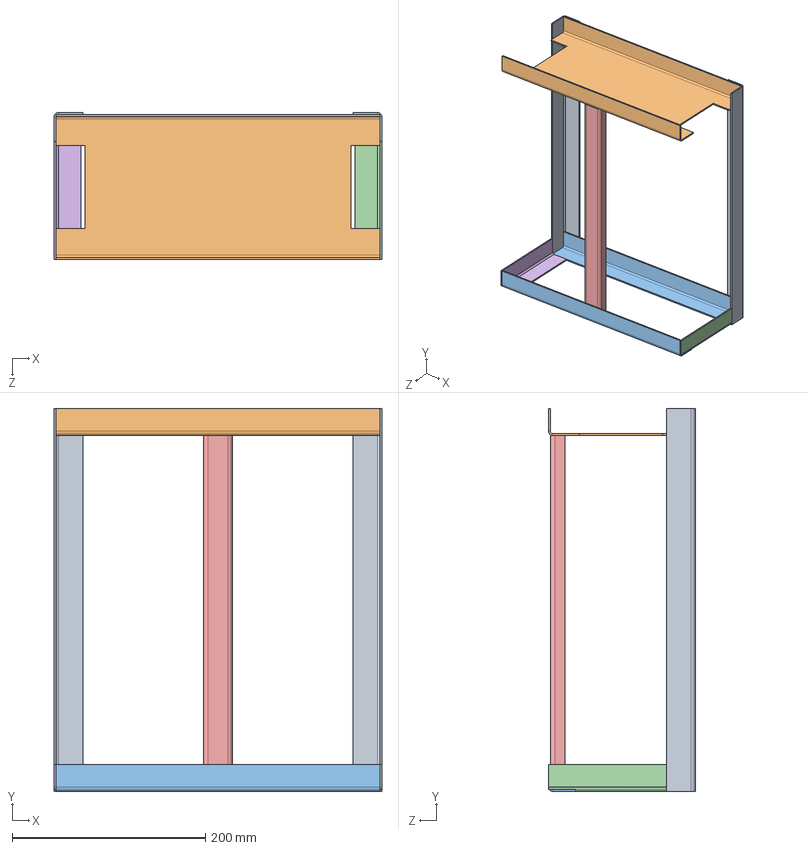
[picture p243: CAD file, 2025-05-18]
Q.C/Mashi/00.04.08/rev01/Assem filter frame.SLDASM
339.0 x 396.0 x 152.0 mm
filter frame-V x 2
filter frame-H Plate
filter frame-H-B x 2
filter frame-stiffner
filter frame-U
filter frame-stiffner-2
