koalium/centidocs/Q.C/Mashi/Aluminum Damper/Damper.SLDASM

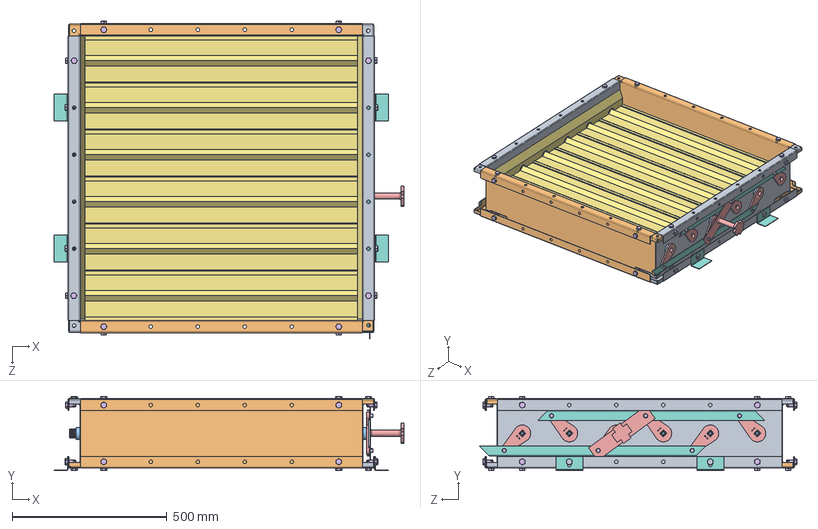
[picture p244: CAD file, 2025-05-18]
Q.C/Mashi/Aluminum Damper/Damper.SLDASM
1131.8 x 240.5 x 1026.8 mm
Frame x 2
Frame2 x 2
Bush x 12
واسط x 6
Cam x 6
Cam pin x 6
Blade x 6
Linkage x 2
گوشک x 4
گوشک - Copy x 4
Bolt x 6
square nut thin grade b_din x 6
Link
hex screw gradeab_din x 32
نوار x 2
نبشی اتصال x 4
hex screw gradec_din x 4
