koalium/centidocs/Rezaei/11/Disk filter/Assem-suction chanel.SLDASM

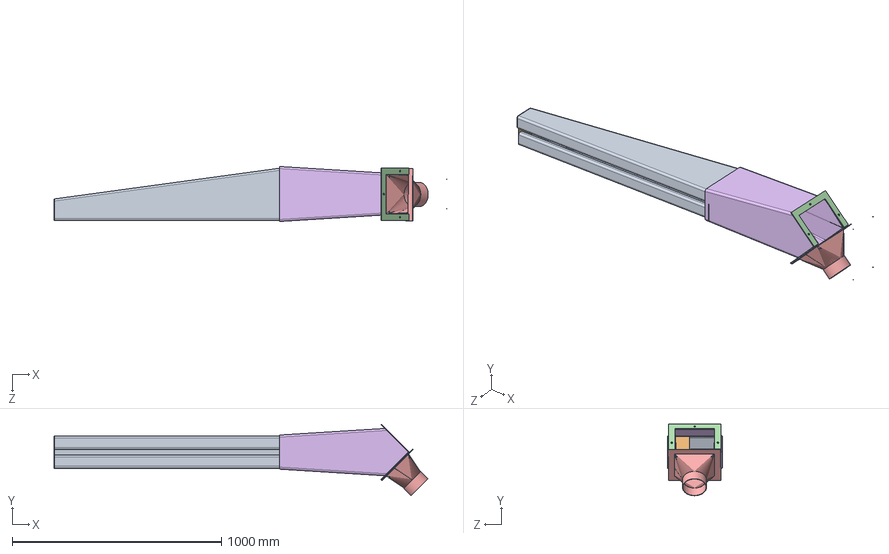
[picture p245: CAD file, 2025-05-18]
Rezaei/11/Disk filter/Assem-suction chanel.SLDASM
1876.5 x 341.7 x 263.0 mm
vent1
Vent end plate
Vent seal plate
Vent flange x 2
Vent flange-up-2
vent2-2
