koalium/centidocs/Rezaei/8112007/Drawing/Blade Assembly.SLDASM

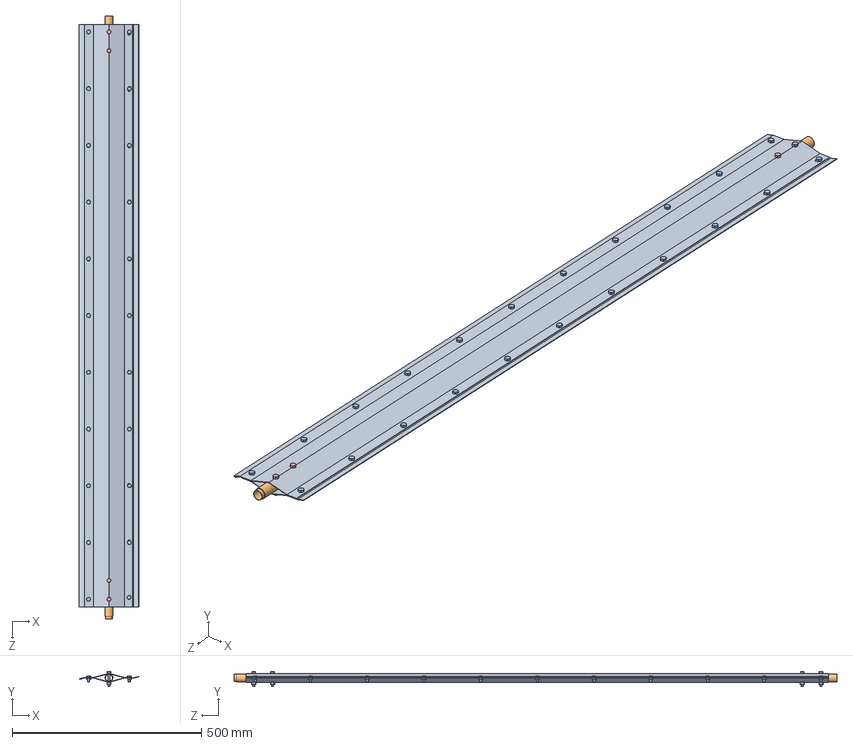
[picture p246: CAD file, 2025-05-18]
Rezaei/8112007/Drawing/Blade Assembly.SLDASM
157.6 x 39.4 x 1594.0 mm
Blade x 2
Pipe
hex screw gradeab_din x 22
hex thin nut gradeb_din x 22
hex screw gradec_dins x 4
hex nut gradec_din x 4
P Silicone
