koalium/centidocs/Rezaei/Disk filter/assem-rotary ring.SLDASM

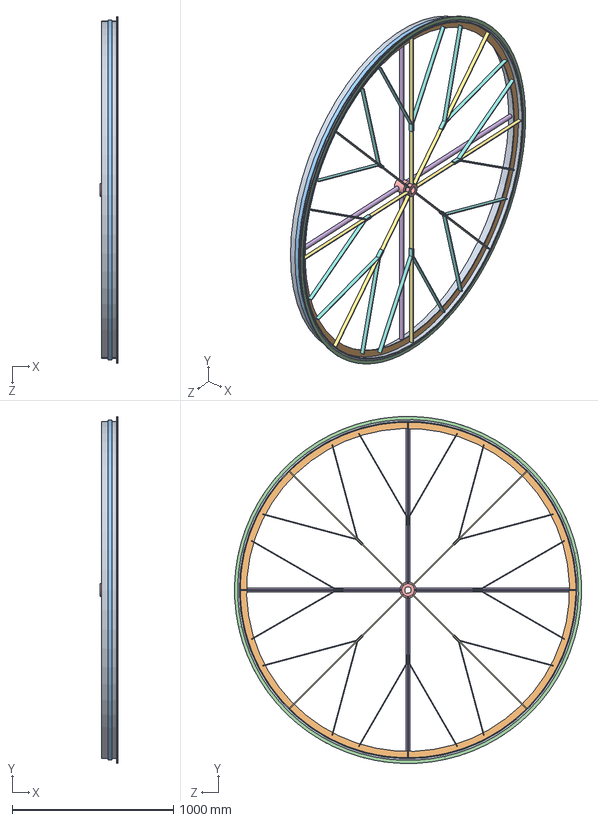
[picture p247: CAD file, 2025-05-18]
Rezaei/Disk filter/assem-rotary ring.SLDASM
110.0 x 2153.3 x 2153.4 mm
rotary ring
rotary rib
rotary ring-seal
rotary ring-filter clamp x 4
disk bushing
pipe 3-4 disk x 4
rect-bar-mesh1 x 8
rect-bar-mesh2 x 16
filter flange
