koalium/centidocs/jokar/Air Filter Rotary 2500/DustCollector/Ass Box.SLDASM

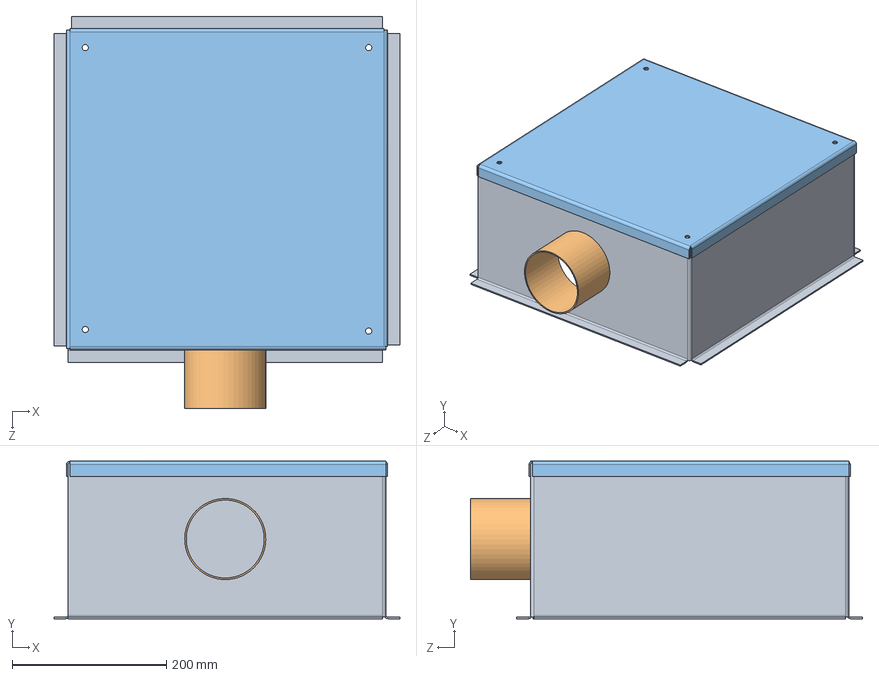
[picture p248: CAD file, 2025-05-18]
jokar/Air Filter Rotary 2500/DustCollector/Ass Box.SLDASM
448.0 x 204.0 x 508.0 mm
قاب محیطی کیسه جارو
استوانه جمع آورنده ضایعات
صفحه قاب زیر کیسه جارو
