koalium/centidocs/jokar/ZH/9920007-Silencer-FINAL model 23 DECEMBER 2023 DRAWINGS/Assem-Front-Supports.SLDASM

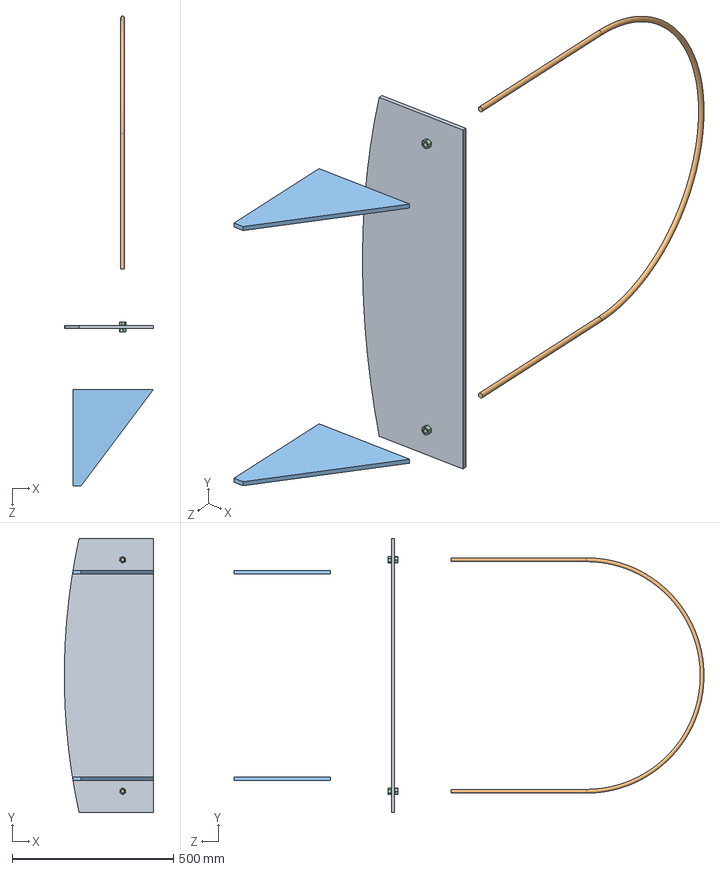
[picture p249: CAD file, 2025-05-18]
jokar/ZH/9920007-Silencer-FINAL model 23 DECEMBER 2023 DRAWINGS/Assem-Front-Supports.SLDASM
276.7 x 850.0 x 1457.4 mm
Silencer support plate
U-bolt
Silencer rib plate x 2
hex nut style 1 gradeab_din x 4
