koalium/centidocs/mohajeri/8125006-Amirkabir/Damper 1000x550/Main Assembly.SLDASM

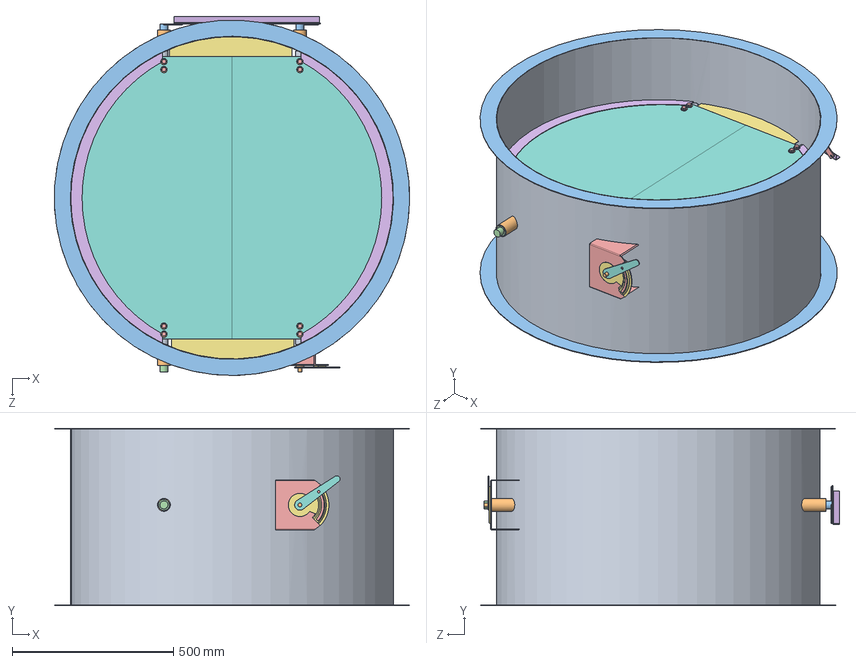
[picture p250: CAD file, 2025-05-18]
mohajeri/8125006-Amirkabir/Damper 1000x550/Main Assembly.SLDASM
1102.5 x 550.0 x 1114.1 mm
Casing
Bush 1016 x 4
Casing Flange x 2
Bronze Bush x 4
Adjustment Plate 1016
Air Seal 1 x 2
Air Seal 2 x 2
Blade 1016 x 2
Axial Pipe x 2
plain washer grade c_din x 16
curved spring lock washer_din x 8
hex nut gradec_din x 8
hex bolt gradeb_din x 8
Stiffener 1 R 1016 x 2
Stiffener 1 L 1016 x 2
Stiffener 2 L 1016 x 2
Stiffener 2 R 1016 x 2
Shaft 1 (1016)
Shaft 3 (1016) x 2
Shaft 2 (1016)
Flat Bar 1016 x 2
Rod 1016
Handle 1
Handle 2
