koalium/centidocs/Q.C/Mashi/00.04.08/total testing model/Assem E. B. Tray.SLDASM

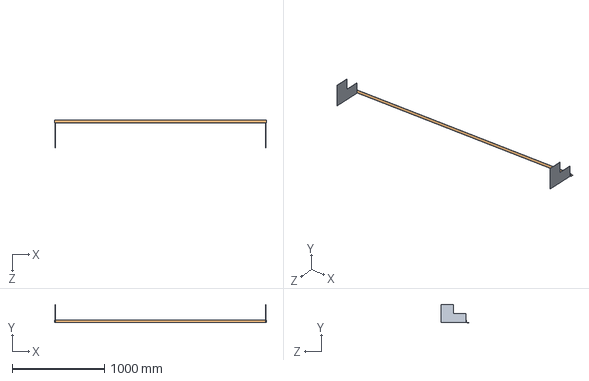
[picture p251: CAD file, 2025-05-18]
Q.C/Mashi/00.04.08/total testing model/Assem E. B. Tray.SLDASM
2300.0 x 200.0 x 303.0 mm
Eliminator-tray-plate x 2
Eliminator-tray-Seal
