koalium/centidocs/Rezaei/90005/90005-damper valve/Actuator-total.SLDASM

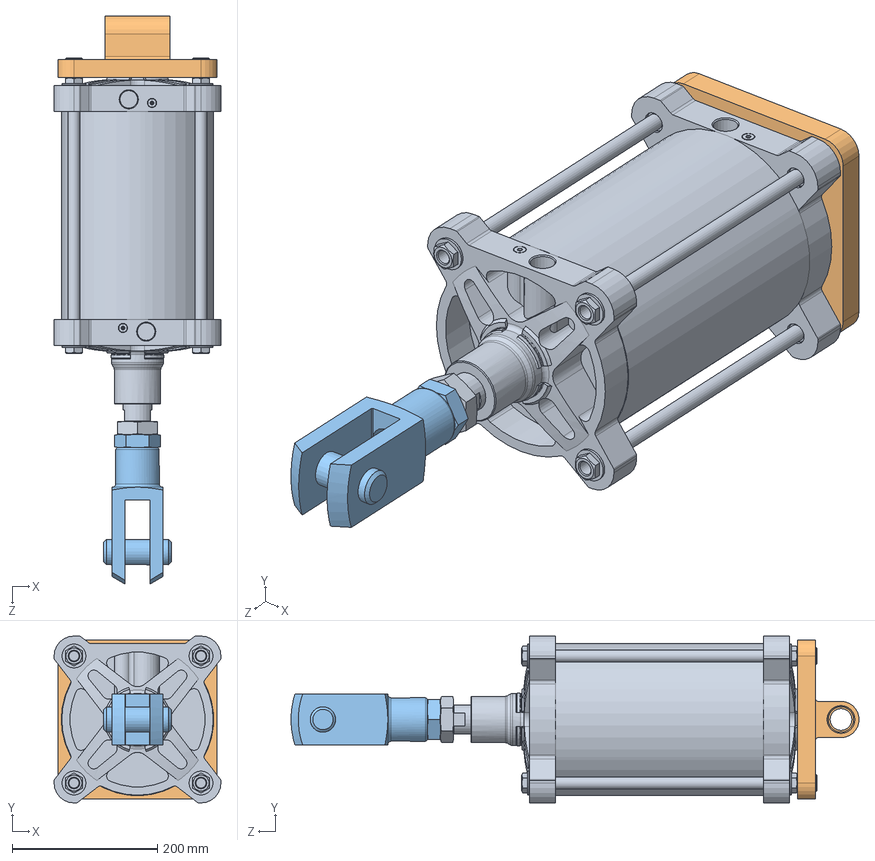
[picture p252: CAD file, 2025-05-18]
Rezaei/90005/90005-damper valve/Actuator-total.SLDASM
230.0 x 230.0 x 782.5 mm
Linear Actuator
Swivel flange
Rod Clevis
