koalium/centidocs/jokar/1/Damper 3540/Damper Frame Assembly.SLDASM

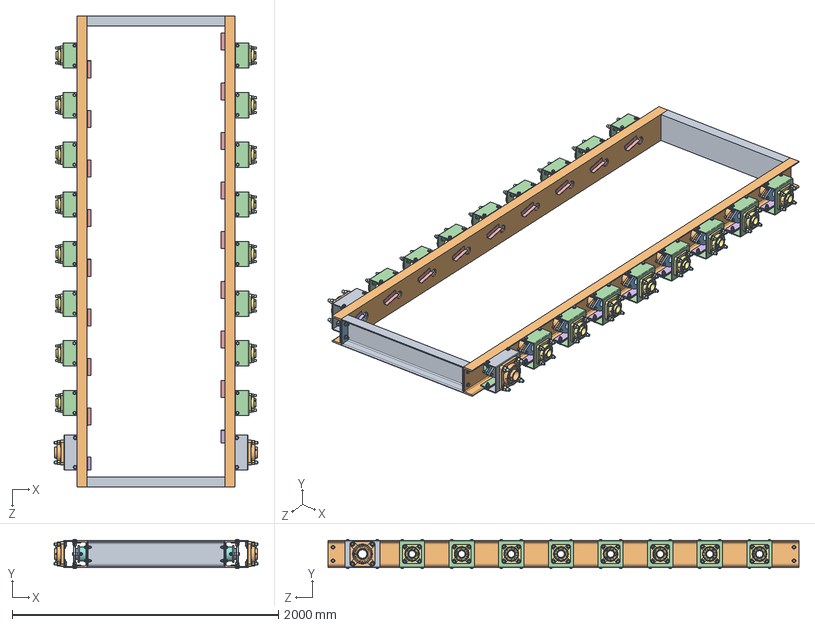
[picture p253: CAD file, 2025-05-18]
jokar/1/Damper 3540/Damper Frame Assembly.SLDASM
1530.0 x 220.0 x 3540.0 mm
Vertical UPN x 2
Horizontal UPN x 2
Connecting Plate x 4
plain washer grade c_din x 376
curved spring lock washer_din x 188
s x 116
hex nut gradec_din x 186
Gland Female Big x 2
Gland Male Big x 2
Gland Female x 16
Gland Male x 16
Support Bearibf x 16
Clamp 2 x 32
Support Clamp x 32
ucf210 x 16
hex bolt gradec_din x 72
Support Bearing 2 x 2
ucf213 x 2
Clamp 3 x 4
Support Clamp 2 x 4
Stop Angle 2 x 16
Stop Angle 4 x 2
