koalium/centidocs/jokar/1/Damper 6400/Blade Assembly 1.SLDASM

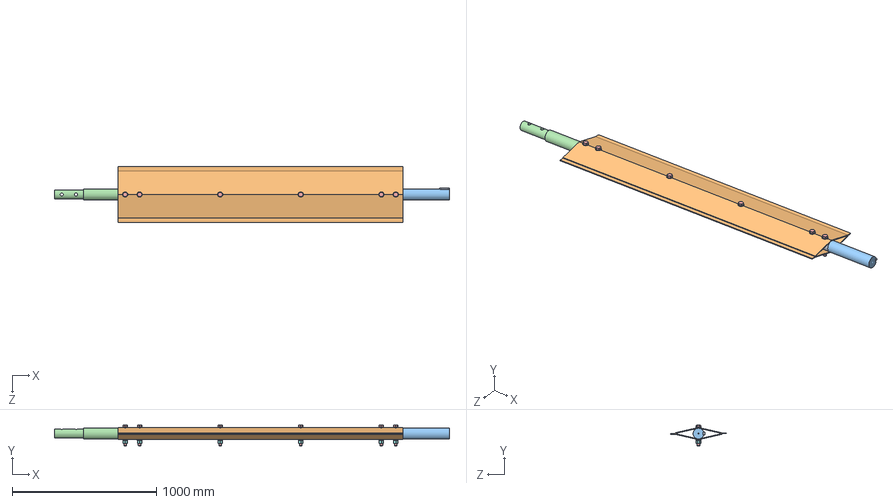
[picture p254: CAD file, 2025-05-18]
jokar/1/Damper 6400/Blade Assembly 1.SLDASM
2737.5 x 142.5 x 386.0 mm
Blade Pipe
Blade x 2
Link Side Shaft
Middle Shaft
ss x 6
plain washer grade c_din x 12
wqeqweqw x 6
ppppo x 6
parallel_din
