koalium/centidocs/Q.C/Mashi/00.04.08/rev01/Assem Pump unit- Right shaft-2.SLDASM

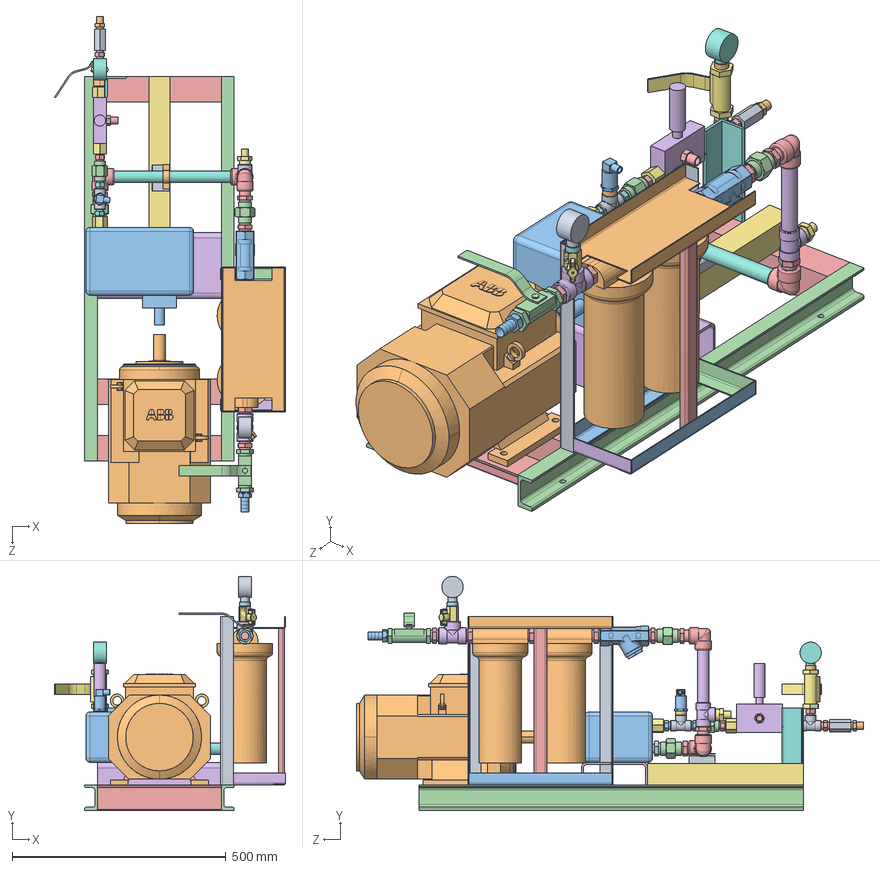
[picture p255: CAD file, 2025-05-18]
Q.C/Mashi/00.04.08/rev01/Assem Pump unit- Right shaft-2.SLDASM
540.6 x 548.2 x 1186.3 mm
filter frame-V x 2
filter frame-H Plate
filter frame-H-B x 2
filter frame-stiffner
filter frame-U
filter frame-stiffner-2
Adapter- 0.375 G- NPT x 3
Hex nipple-0.375-2 x 2
threaded tee-0.75 inch x 2
Reducer-Male Female-0.25-0.375 x 2
Pressure Transmiter
threaded union-0.375
Hex nipple-0.375 inch x 5
Pressure relief valve-0.375
ball-valve-0.375 inch
Pressure Gauge-0.375
Non Return valve-0.375
Hex nipple-0.375-conical
Hose nipple-0.75 inch
ball-valve-0.75
Hex nipple-0.75 inch x 8
Threaded tee-0.75-inch x 2
valve_93411-1_2-0.75
Reducer-Male Female-0.25-0.75
Pressure Gauge-0.25-10 Bar
filter-0.75 inch x 2
chek valve-0.75 inch
threaded union-0.75 inch x 2
threaded elbow-0.75 x 3
pipe 0.75 inch-03
Hex nipple-reducer-0.375-0.75 inch
pipe 0.75 inch-01-right
Nipple- Reducer-0.5-0.75 inch
4 kw-1500rpm
Pump-TAM
U-60 x 2
L 6x60-2 x 3
L Support
L 5x50-1
L 5x50-3
U Holder
pipe holder x 2
