koalium/centidocs/Rezaei/11/Disk filter/Assem handle.SLDASM

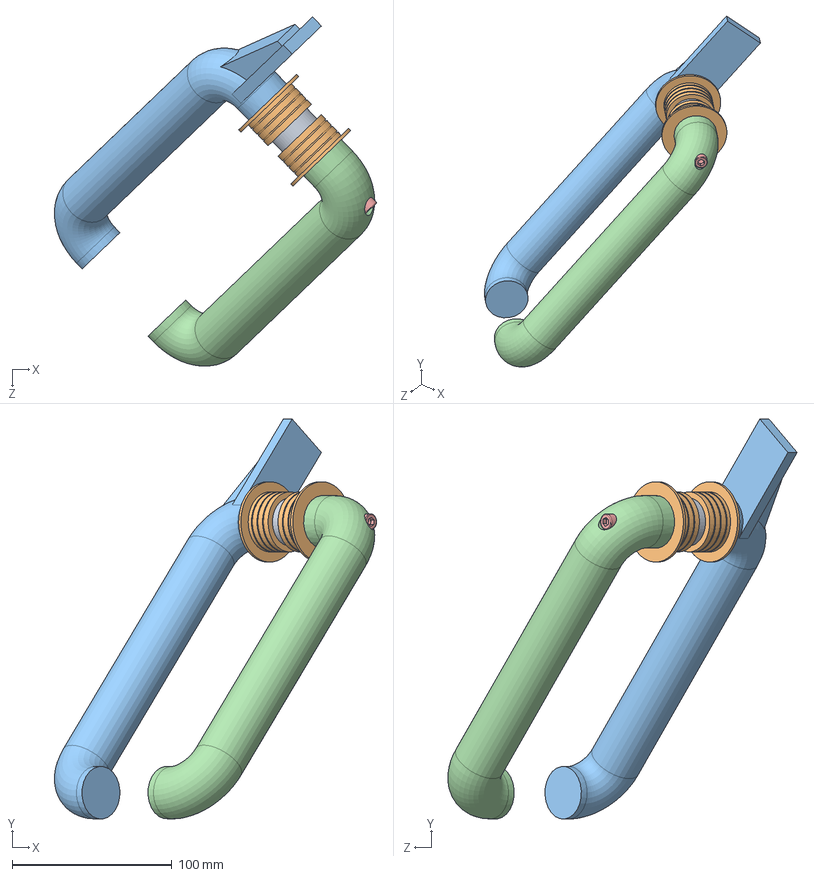
[picture p256: CAD file, 2025-05-18]
Rezaei/11/Disk filter/Assem handle.SLDASM
201.9 x 250.7 x 218.9 mm
pipe
Bush x 2
Handle 2
Handle 1
socket head cap screw 4762_din
