koalium/centidocs/mohajeri/damper isfahan/4110006-1900x1300-Rev08/Lever1-Left handed.SLDASM

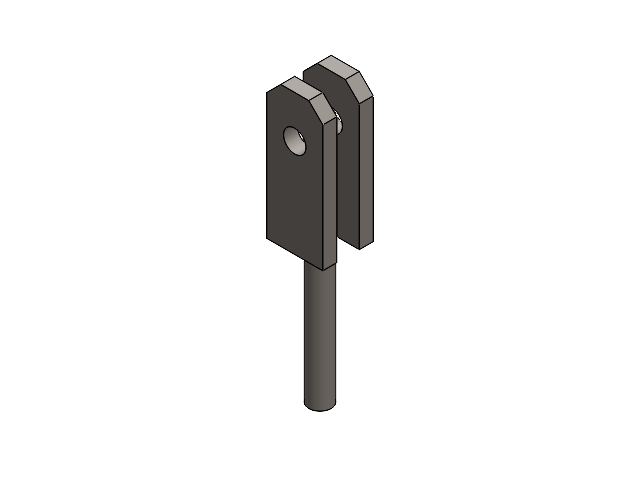
[picture p257: CAD file, 2025-05-18]
mohajeri/damper isfahan/4110006-1900x1300-Rev08/Lever1-Left handed.SLDASM
Lever rod-1
Lever-Plate1 x 2
