koalium/centidocs/(list of files, cad)

Other CAD files:
mohajeri/Backup-Mahajeri-1402-07-11/hvac new/Compactor Assembly.DWG
Q.C/Mashi/Laser-Plasma/Laser-Plasma.dwg
Q.C/Mashi/Model/20M Left/5340 Right/Column 5340 Assembly.SLDASM
Q.C/Mashi/Model/20M Left/Column 20 M Right Main Assembly.SLDASM
jokar/0/HVAC/3000/Drum 3000/Head.SLDASM
Q.C/Mashi/Model/20M Left/5150/Column 5150 Assembly.SLDASM
jokar/1/Flexible Joint/Flexible 10028/Flex Total.dwg
Q.C/Mashi/Model/20M Left/4670/Column 4670 Assembly.SLDASM
Q.C/Mashi/Model/20M Left/4840/Column 4840 Asssembly.SLDASM
jokar/0/HVAC/3000/Drum 3000/middle.SLDASM
jokar/جعفر/9920007-Silencer-FINAL model 4 NOV 2023 - WITH DRAWINGS/Assem-Body.SLDASM
SAFARI/1900x1300 Final Rec/Assem-gland flange.SLDASM
jokar/0/HVAC/3000/Drum 3000/End.SLDASM
jokar/2/Damper 6400/Blade 4 Assembly.SLDASM
jokar/0/HVAC/3000/Drum 3000/plate main.SLDPRT
SAFARI/1900x1300 Final Rec/Assem connection box.SLDASM
jokar/0/HVAC/3000/Driver Stand 3000/مجموعه پولی تسمه سبز.SLDASM
jokar/1/Damper 6400/Link Assemly.SLDASM
SAFARI/2300x1000/01/Gear Assem.SLDASM
SAFARI/2300x1000/Assem-regulator1.SLDASM
mohajeri/damper isfahan/4110006-1900x1300-Rev08/MirrorAssem-gland flange.SLDASM
Manouchehri/030010000 Eliminator/030010000-Eliminator Assembly.dwg
Manouchehri/030010000 Eliminator/030010100 Base/030010101-Base Frame 01.dwg
Manouchehri/030010000 Eliminator/030010100 Base/030010102-Base Frame 02.dwg
Manouchehri/030010000 Eliminator/030010100 Base/030010103-Base profile.dwg
Manouchehri/030010000 Eliminator/030010100 Base/N-030030301.dwg
Manouchehri/030010000 Eliminator/030010200 Frame/030010401-Upper H Frame 01.dwg
Manouchehri/030010000 Eliminator/030010200 Frame/030010402-Upper H Frame 02.dwg
Manouchehri/030010000 Eliminator/030010200 Frame/030010403-Air Seal.dwg
Manouchehri/030010000 Eliminator/030010200 Frame/030010404-Column.dwg
Manouchehri/030010000 Eliminator/030010200 Frame/030010405-Base Column Connector.dwg
Manouchehri/030010000 Eliminator/030010200 Frame/030010406-Gutter Column Connector.dwg
Manouchehri/030010000 Eliminator/030010200 Frame/030010407-Hanger.dwg
Manouchehri/030010000 Eliminator/030010300 Gutter/030010301-Gutter 01.dwg
Manouchehri/030010000 Eliminator/030010300 Gutter/030010302-Gutter 02.dwg
Manouchehri/030010000 Eliminator/030010300 Gutter/030010303-Gutter Linkage.dwg
Manouchehri/030010000 Eliminator/030010300 Gutter/030010306-Gutter Drain Flange.dwg
Manouchehri/030010000 Eliminator/030010300 Gutter/030010309-Gutter Cap.dwg
Manouchehri/030010000 Eliminator/030010400 E Boundle/951200018-E boundle Spacer .dwg
Manouchehri/030010000 Eliminator/030010400 E Boundle/951200018-E boundle Spacer.dwg
Manouchehri/030010000 Eliminator/030010400 E Boundle/951200019-E Boundle Lock Nut.dwg
Manouchehri/030010000 Eliminator/030010400 E Boundle/951200020-E Boundle End Spacer.dwg
Manouchehri/030010000 Eliminator/030010400 E Boundle/951200304-E Boundle Tie Rod.dwg
Manouchehri/030010000 Eliminator/030010400 E Boundle/N-030010501.dwg
Manouchehri/030010000 Eliminator/030010500 V Frame/030010201-V Frame.dwg
Manouchehri/030010000 Eliminator/030010500 V Frame/030010202-V Frame Connector .dwg
Manouchehri/CII Legend.dwg
Manouchehri/Eynak.dwg
Manouchehri/Flange 4inch CL150/Drawing1.dxf
Manouchehri/Name Plate.dwg
Manouchehri/hood - Balooch/Hood.dxf
Manouchehri/دمپر/N-9501000B2.dwg
Manouchehri/دمپر/N-9501000B4.dwg
Manouchehri/شیپوری و فن محوری/04(Cone (Sheypour))/01(Support & Saddle)/01(Size).dwg
Manouchehri/شیپوری و فن محوری/04(Cone (Sheypour))/01(Support & Saddle)/پایه و صفحه.dwg
Manouchehri/شیپوری و فن محوری/04(Cone (Sheypour))/Bell Ring 1600-30-1000/1600-30-1000.SLDDRW
Manouchehri/شیپوری و فن محوری/04(Cone (Sheypour))/Bell Ring 1600-30-1000/1600-37-1000.DWG
Manouchehri/شیپوری و فن محوری/04(Cone (Sheypour))/Bell Ring 1600-30-1000/Base Plate.SLDPRT
Manouchehri/شیپوری و فن محوری/04(Cone (Sheypour))/Bell Ring 1600-30-1000/Casing.SLDPRT
Manouchehri/شیپوری و فن محوری/04(Cone (Sheypour))/Bell Ring 1600-30-1000/Clamp 1.SLDPRT
Manouchehri/شیپوری و فن محوری/04(Cone (Sheypour))/Bell Ring 1600-30-1000/Clamp 2.SLDPRT
Manouchehri/شیپوری و فن محوری/04(Cone (Sheypour))/Bell Ring 1600-30-1000/Cone.SLDPRT
Manouchehri/شیپوری و فن محوری/04(Cone (Sheypour))/Bell Ring 1600-30-1000/Flange.SLDPRT
Manouchehri/شیپوری و فن محوری/04(Cone (Sheypour))/Bell Ring 1600-30-1000/Saddle 2.SLDPRT
Manouchehri/شیپوری و فن محوری/04(Cone (Sheypour))/Bell Ring 1600-30-1000/Saddle 3.SLDPRT
Manouchehri/شیپوری و فن محوری/04(Cone (Sheypour))/Bell Ring 1600-30-1000/Saddle.SLDPRT
Manouchehri/شیپوری و فن محوری/04(Cone (Sheypour))/Bell Ring 1600-37-1000/1600-37-1000.DWG
Manouchehri/شیپوری و فن محوری/04(Cone (Sheypour))/Bell Ring 1600-37-1000/1600-37-1000.SLDDRW
Manouchehri/شیپوری و فن محوری/04(Cone (Sheypour))/Bell Ring 1600-37-1000/Saddle.SLDPRT
Manouchehri/شیپوری و فن محوری/04(Cone (Sheypour))/Bell Ring 1600-37-1000/Saddle2.SLDPRT
Manouchehri/شیپوری و فن محوری/04(Cone (Sheypour))/Shep.dwg
Manouchehri/شیپوری و فن محوری/04(Cone (Sheypour))/توپي فن/توپی.DWG
Manouchehri/شیپوری و فن محوری/04(Cone (Sheypour))/توپي فن/توپی.SLDDRW
Manouchehri/شیپوری و فن محوری/04(Cone (Sheypour))/توپي فن/توپی.SLDPRT
Manouchehri/شیپوری و فن محوری/1400.DWG
Manouchehri/شیپوری و فن محوری/1600-45-1000 Motogen 2013.dwg
Manouchehri/شیپوری و فن محوری/1600-45-1000 Motogen.dwg
Manouchehri/شیپوری و فن محوری/Bell Ring/1600/Body.SLDPRT
Manouchehri/شیپوری و فن محوری/Bell Ring/1600/Cone.SLDPRT
Manouchehri/شیپوری و فن محوری/Bell Ring/1600/Flange.SLDPRT
Manouchehri/شیپوری و فن محوری/Bell Ring/Plasma/1400/Cone/Drawing1.dxf
Manouchehri/شیپوری و فن محوری/Bell Ring/Plasma/1400/Flange/Drawing1.dxf
Manouchehri/شیپوری و فن محوری/Bell Ring/Plasma/1400/Flange/Plasma.dxf
Manouchehri/شیپوری و فن محوری/Safhe 1400 Long.dwg
Manouchehri/شیپوری و فن محوری/Shep.dwg
Manouchehri/شیپوری و فن محوری/شیپوری (2).dwg
Manouchehri/شیپوری و فن محوری/شیپوری2013.dwg
Manouchehri/شیپوری و فن محوری/پایه و صفحه شیپوری .dwg
Manouchehri/فیلتر استاتیک آب.dxf
Q.C/Manouchehri/پلان/CII Site Plan (Rev 01).dwg
Q.C/Mashi/00.04.08/1600x1600.dwg
Q.C/Mashi/00.04.08/rev01/4 kw-1500rpm.SLDPRT
Q.C/Mashi/00.04.08/rev01/Adapter- 0.375 G- NPT.SLDPRT
Q.C/Mashi/00.04.08/rev01/Assem Pump unit- Right shaft-2.SLDDRW
Q.C/Mashi/00.04.08/rev01/Assem filter piping-1.SLDASM
Q.C/Mashi/00.04.08/rev01/Assem total chassis.SLDASM
Q.C/Mashi/00.04.08/rev01/Assem total chassis.SLDDRW
Q.C/Mashi/00.04.08/rev01/Assem total pump.SLDASM
Q.C/Mashi/00.04.08/rev01/Hex nipple-0.375 inch.SLDPRT
Q.C/Mashi/00.04.08/rev01/Hex nipple-0.375-2.SLDPRT
Q.C/Mashi/00.04.08/rev01/Hex nipple-0.375-conical.SLDPRT
Q.C/Mashi/00.04.08/rev01/Hex nipple-0.75 inch.SLDPRT
Q.C/Mashi/00.04.08/rev01/Hex nipple-reducer-0.375-0.75 inch.SLDPRT
Q.C/Mashi/00.04.08/rev01/Hose nipple-0.75 inch.SLDPRT
Q.C/Mashi/00.04.08/rev01/L 5x50-1.SLDPRT
Q.C/Mashi/00.04.08/rev01/L 5x50-3.SLDPRT
Q.C/Mashi/00.04.08/rev01/L 6x60-2.SLDPRT
Q.C/Mashi/00.04.08/rev01/L Support.SLDPRT
Q.C/Mashi/00.04.08/rev01/Nipple- Reducer-0.5-0.75 inch.SLDPRT
Q.C/Mashi/00.04.08/rev01/Non Return valve-0.375.SLDPRT
Q.C/Mashi/00.04.08/rev01/Pressure Gauge-0.25-10 Bar.SLDPRT
Q.C/Mashi/00.04.08/rev01/Pressure Gauge-0.375.SLDPRT
Q.C/Mashi/00.04.08/rev01/Pressure Transmiter.SLDPRT
Q.C/Mashi/00.04.08/rev01/Pressure relief valve-0.375.SLDPRT
Q.C/Mashi/00.04.08/rev01/Pump-TAM.SLDPRT
Q.C/Mashi/00.04.08/rev01/Reducer-Male Female-0.25-0.375.SLDPRT
Q.C/Mashi/00.04.08/rev01/Reducer-Male Female-0.25-0.75.SLDPRT
Q.C/Mashi/00.04.08/rev01/Threaded tee-0.75-inch.SLDPRT
Q.C/Mashi/00.04.08/rev01/U Holder.SLDPRT
Q.C/Mashi/00.04.08/rev01/U-60.SLDPRT
Q.C/Mashi/00.04.08/rev01/assem pump-motor Right.SLDASM
Q.C/Mashi/00.04.08/rev01/ball-valve-0.375 inch.SLDPRT
Q.C/Mashi/00.04.08/rev01/ball-valve-0.75.SLDPRT
Q.C/Mashi/00.04.08/rev01/chek valve-0.75 inch.SLDPRT
Q.C/Mashi/00.04.08/rev01/filter frame-H Plate.SLDPRT
Q.C/Mashi/00.04.08/rev01/filter frame-H-B.SLDPRT
Q.C/Mashi/00.04.08/rev01/filter frame-U.SLDPRT
Q.C/Mashi/00.04.08/rev01/filter frame-V.SLDPRT
Q.C/Mashi/00.04.08/rev01/filter frame-stiffner-2.SLDPRT
Q.C/Mashi/00.04.08/rev01/filter frame-stiffner.SLDPRT
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
