koalium/centidocs/jokar/11/MANUALE C200-C200MAXI - ENG.PDF

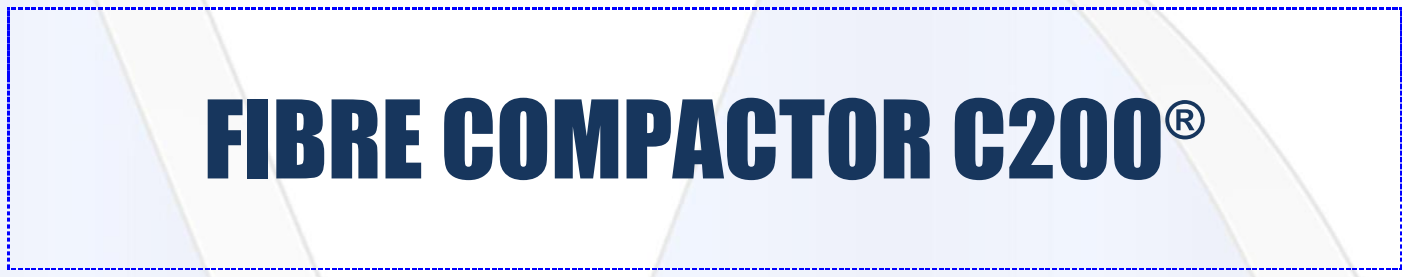
[picture p258: figure]
FIBRE COMPACTOR C200®
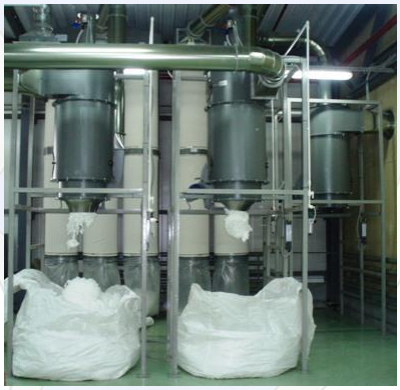
[picture p259: figure]
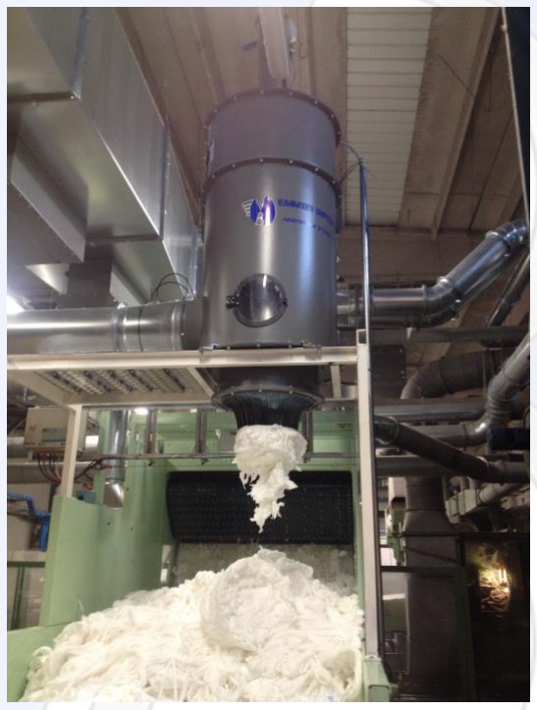
[picture p260: figure]

EMMEBI IMPIANTI s.r.l.. Via Achille Grandi, 18 - 20060 Liscate ( MI ) - ITALY Tel . +39.02.95.74.09.03 (3 lines) www.emmebi-impianti.it – contact@emmebi-impianti.it

The Fibre compactor C200®
is a machine made with functional , simple concepts and only pneumatic.

The fibre, after having been separated by the air, is exhausted by means of a simple vertical pressure applied by a pneumatic piston.
This passage is very important because with this action is avoided any damages and curling of the fibre allowing its reuse , or stocking , or directly on the press .

The Fibre compactor is supplied with an electronic control panel that allows the adjusting of the off-on working time.

## TECHNICAL DATA

| C200 | C200 MAXI
Treated Air | 4.000 m3/h | 5.500 m3/h
Max compressed air consumption at 4 bar | 3 Nmc/h | 3 Nmc/h
Max quantity discharged fibre | 80 kg/h | 150 kg/h
Average density of the pressed fibre | 30 kg/mc | 30 kg/mc
Power tension for Electronic panel | 24 V (standard) | 24 V (standard)
Joint for compressed air | For air pipe 8/10 mm | For air pipe 8/10 mm

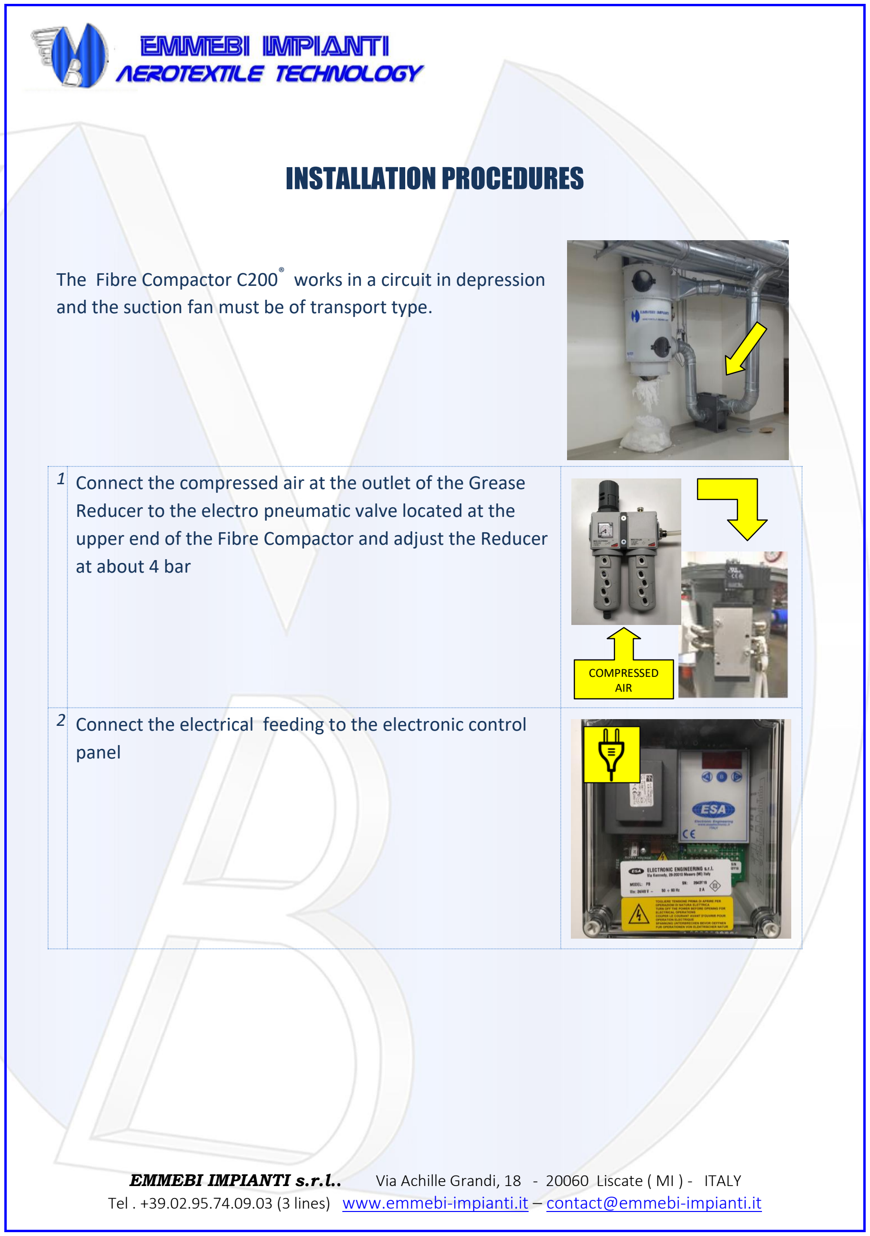
[picture p261: figure]
INSTALLATION PROCEDURES; The Fibre Compactor C200®; works in a circuit in depression

and the suction fan must be of transport type.

1 | Connect the compressed air at the outlet of the Grease Reducer to the electro pneumatic valve located at the upper end of the Fibre Compactor and adjust the Reducer at about 4 bar | COMPRESSED AIR
2 | Connect the electrical feeding to the electronic control panel

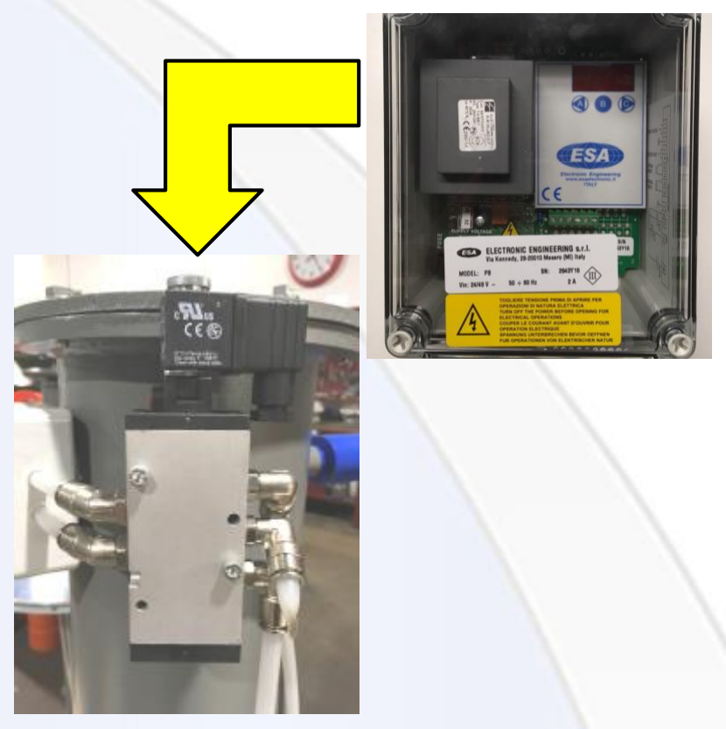
[picture p262: figure]

3 | Feed from the electronic panel the electro pneumatic valve
4 | Adjust the on-off working time in accordance with the type and quantity of discharged fibre

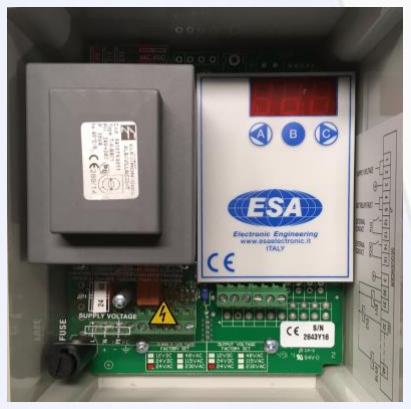
[picture p263: figure]

Note: The adjustments at item 4 should be done by our engineer.

## MAINTENANCE PROCEDURES

1 | Check periodically the lubricant oil level. Use only oil types as recommended in the hereunder table MAKER TYPES MOBIL : D.T.E. Light , D.T.E. Medium , D.T.E. Heavy , D.T.E. extra heavy SHELL : Tellus 27 , Tellus 29 , Tellus 33 , Tellus 41 ESSO : Teresso 43 , Teresso 47 , Teresso 52 , Teresso 56 AGIP : OSO 35 , OSO 45 , OSO 55 , OSO 85 FIAT : RAX 27 , RAX 40 , RAX 50 , RAX 65 | CHECK !
2 | Check periodically the correct functioning of the pneumatic piston in both the two working phases | CHECK !
3 | Check the conditions of the lamellar disks | CHECK !

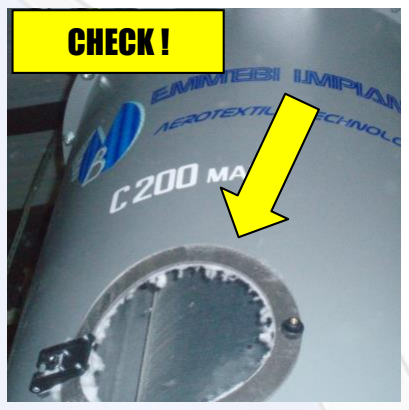
[picture p264: figure]
CHECK !

4 Check periodically and remove, if it is the case, the material surplus deposited outside the perforated cylinder

## MAINTENANCE LIST

Spare part | Frequence of intervention
Weekly | Monthly | Every 3 months | months Every 6 | Every Year | Every 2 years

Lamellar disk

Lubrificant Oil

Blue PVC filter | Clean with compressed air
Perforated cylinder | | Clean with compressed air

Pneumatic piston

Check the status of the component

Change the component (adviced)

Change the component (max time)

Grease

We advice to keep one piece or set in your storehouse

## SAFETY PROCEDURES FOR CLEANING THE C200

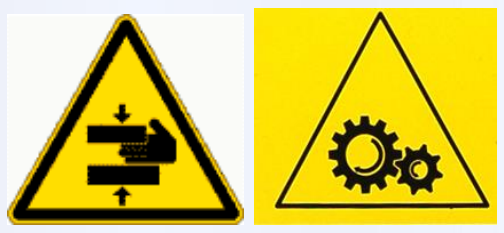
[picture p265: figure]

- CLOSE THE COMPRESSED AIR, WAIT THAT DESCENT OF THE PISTON AND THAN CLEAN THE MACHINE
- C200 IS WORKING IN DEPRESSION SO, IF NECESSARY, TURN OFF THE SUCTION FAN AND CLOSE THE REGULATION DAMPERS
- FOR THE REMOUVAL OF VERY COMPRESSED MATERIAL, REMOUVE TEH BOTTOM PART OF THE C200
- AT THE END OF MAINTENANCE , RESET THE PROPER
FUNCTIONING

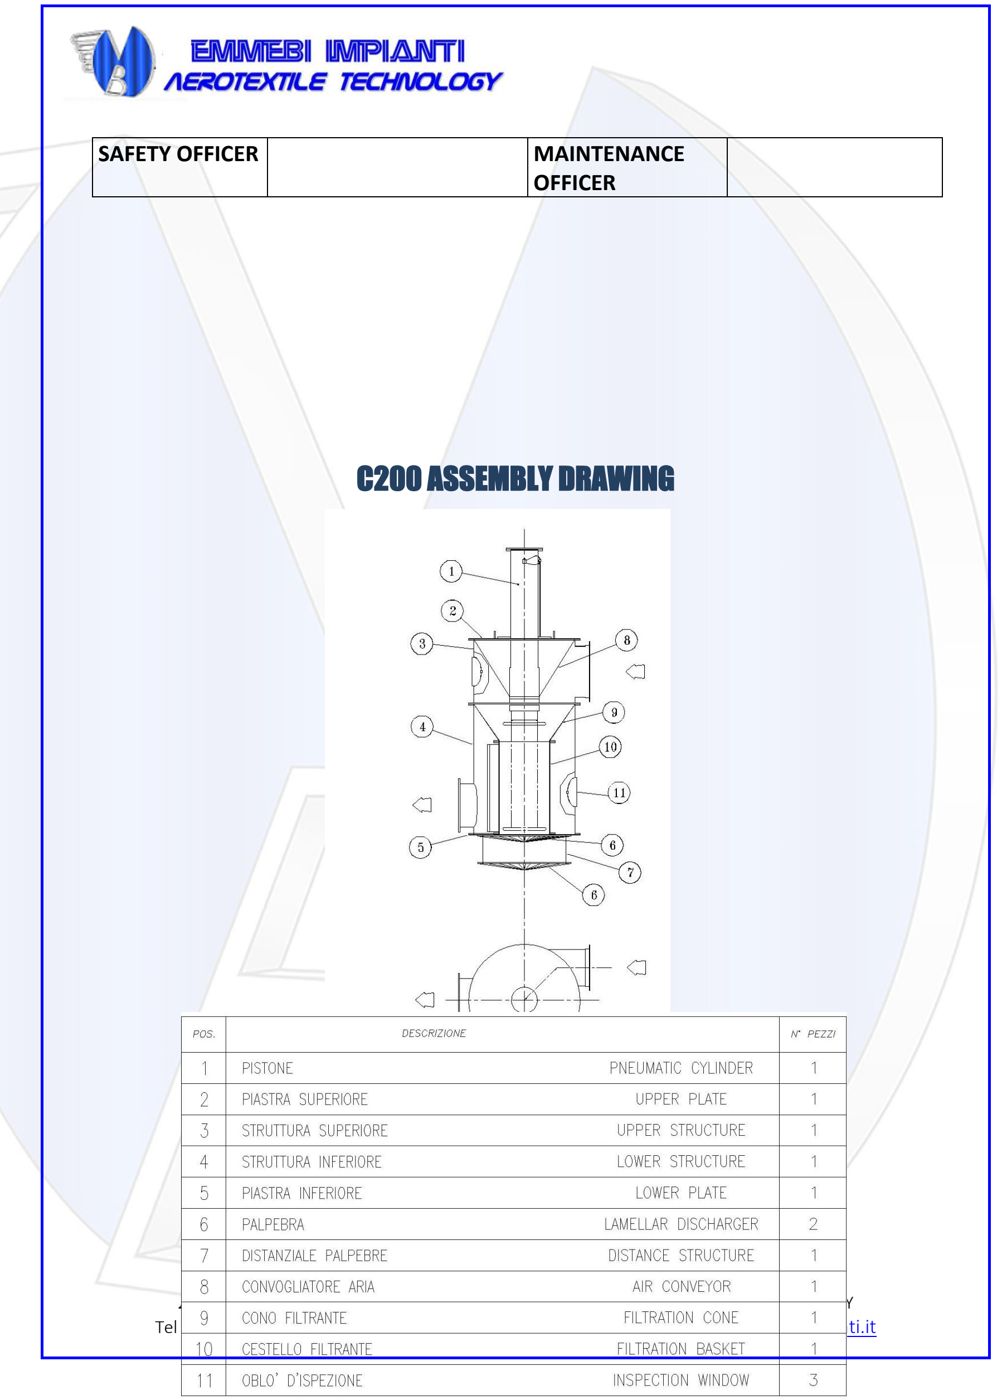
[picture p266: page 8]

## C200 ASSEMBLY DRAWING

SAFETY OFFICER | MAINTENANCE OFFICER

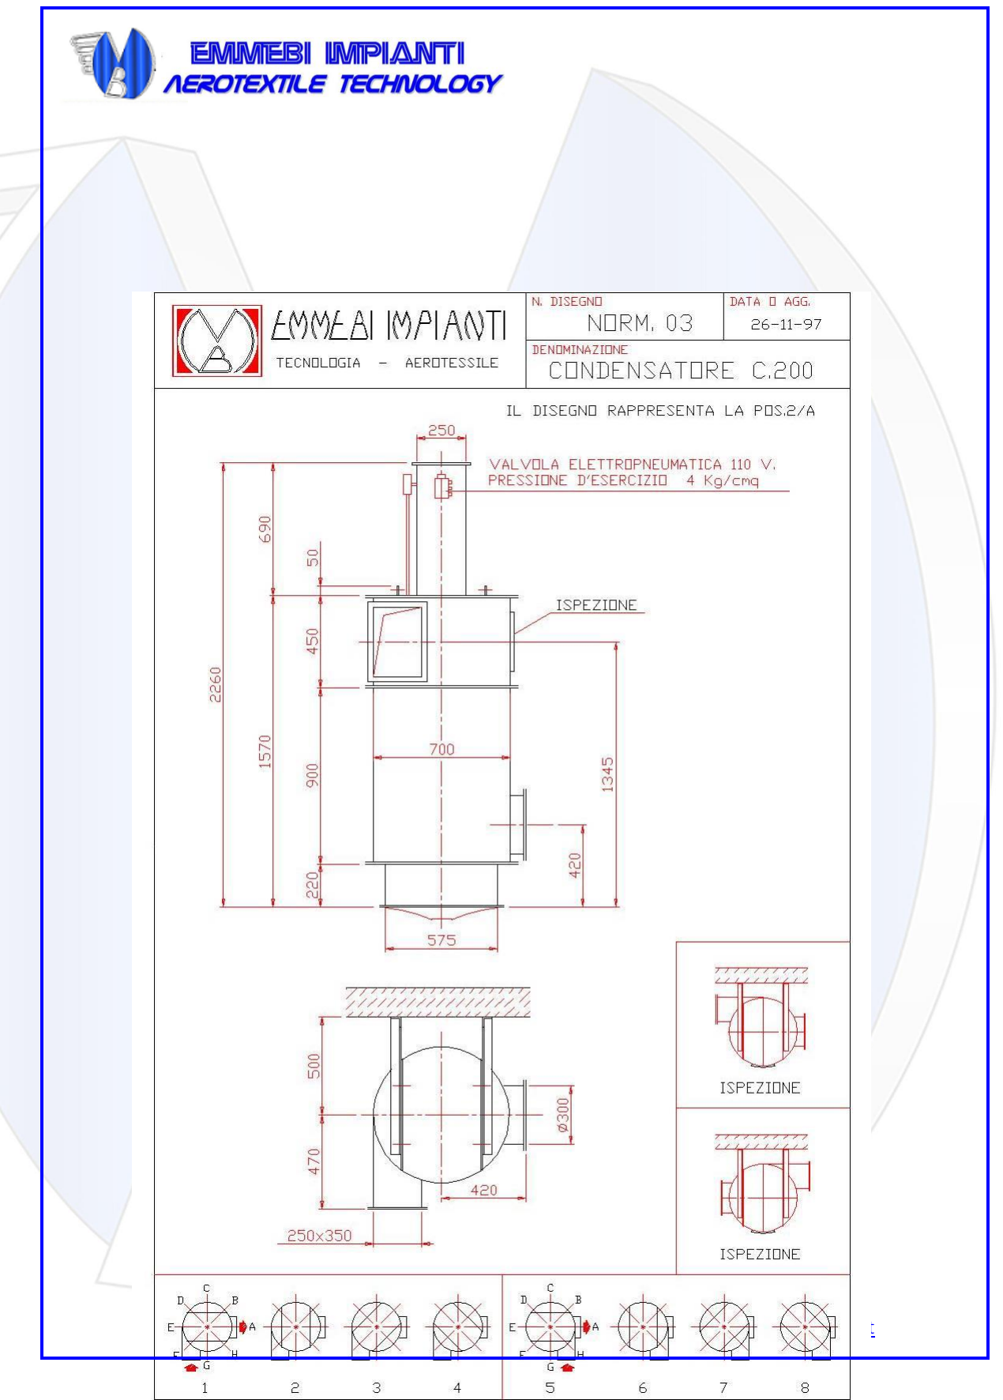
[picture p267: page 9]

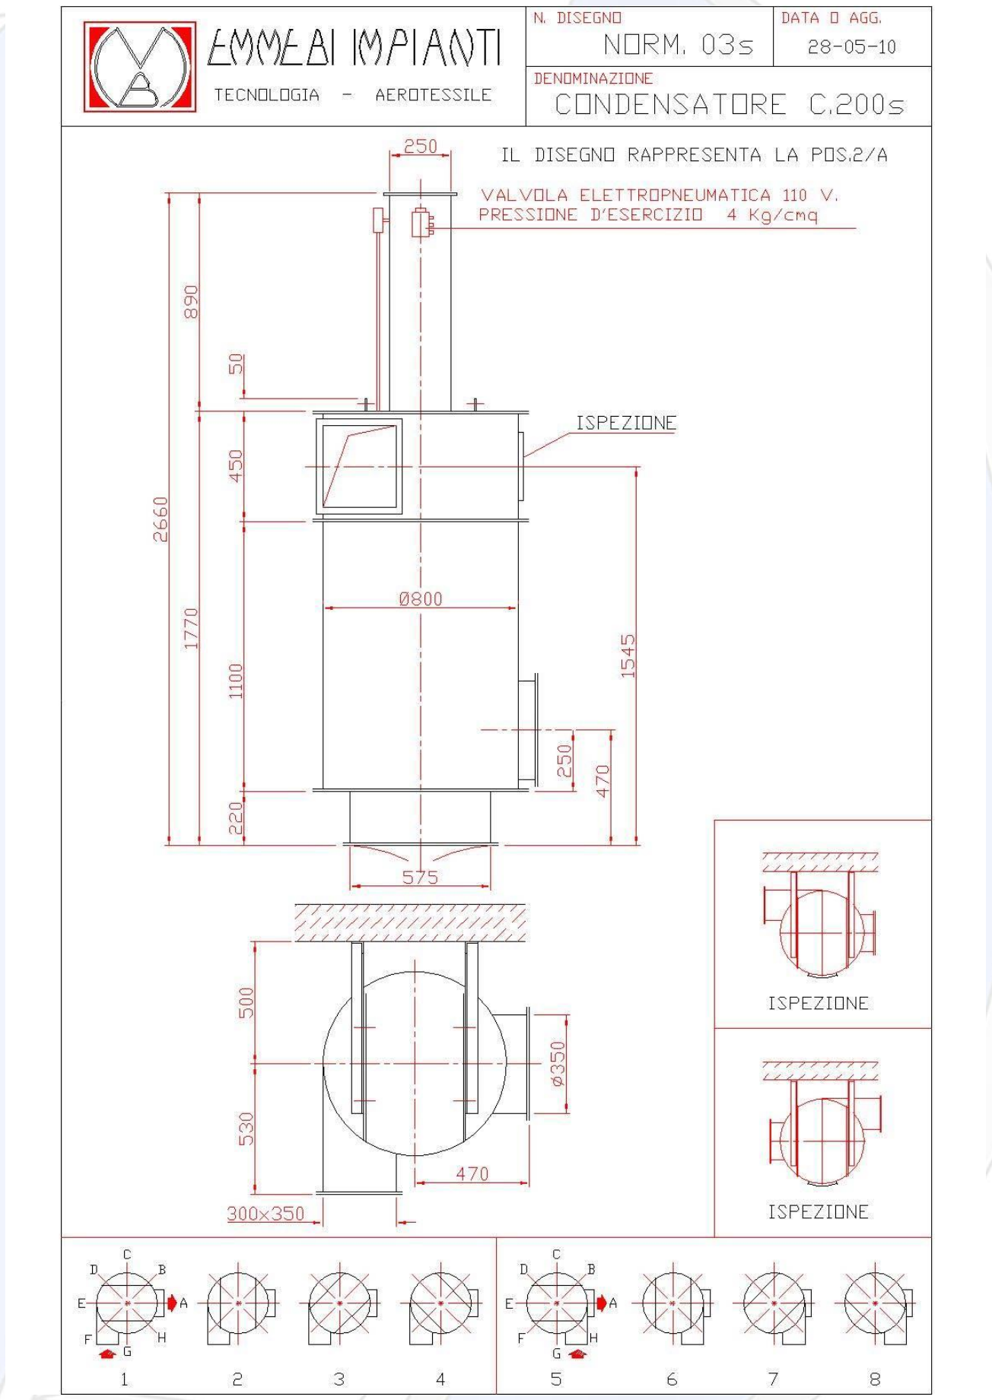
[picture p268: figure]

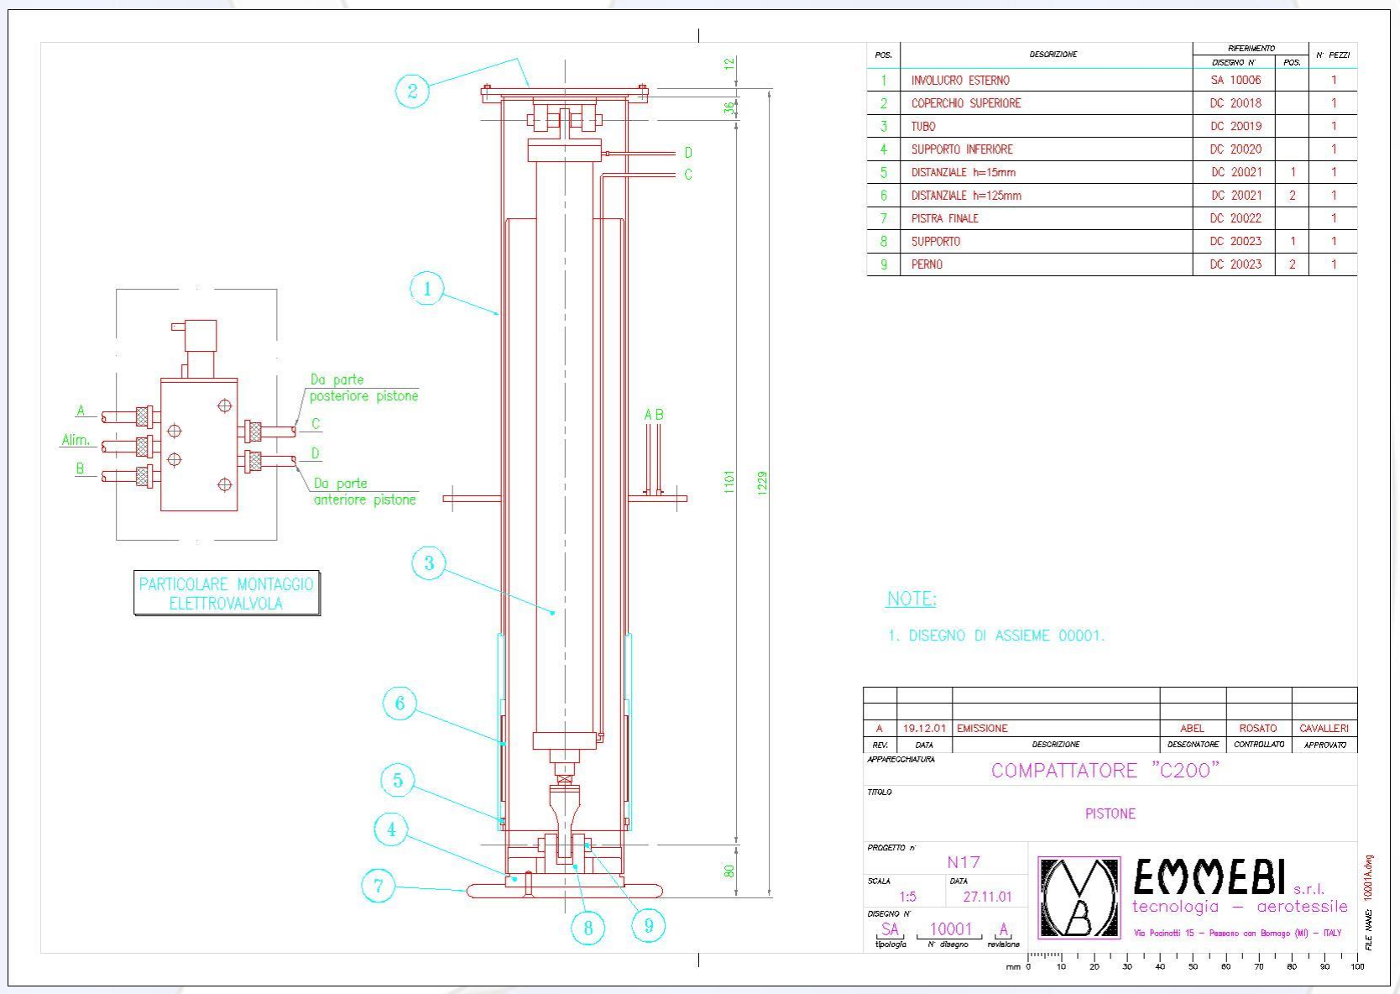
[picture p269: figure]

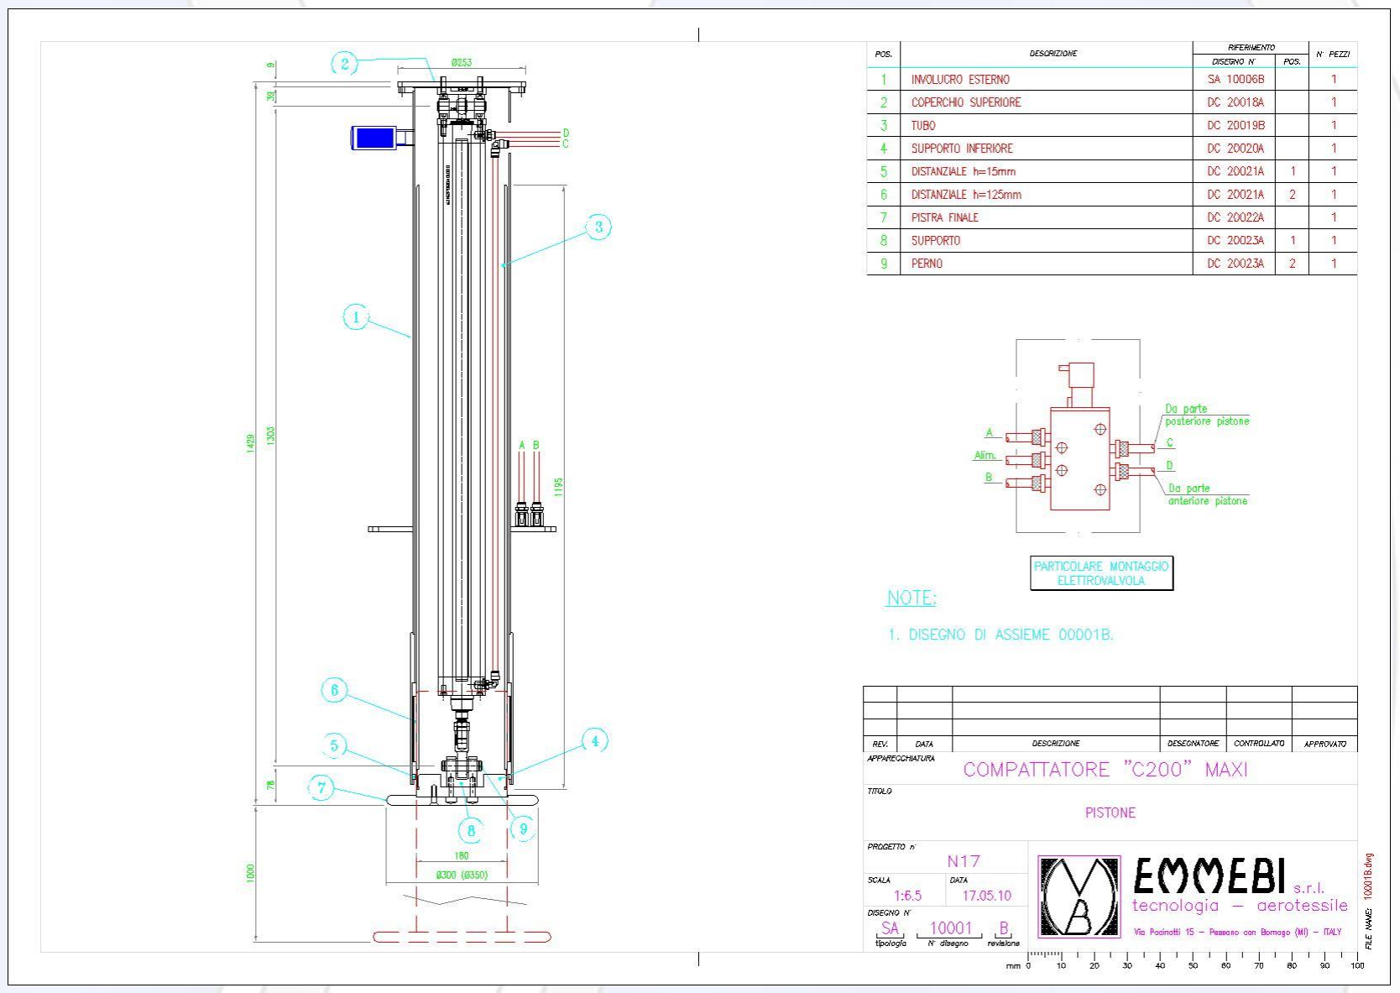
[picture p270: figure]

## SPARE PARTS LIST

pos | ITEM | C200 | C200 MAXI
1 | Pneumatic Cylinder | n.1 l. 1229mm | n.1 l. 1429mm

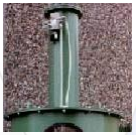
[picture p271: figure]

2 | Lamellar Discharger | n.2 Ø 645mm | n.2 Ø 645mm

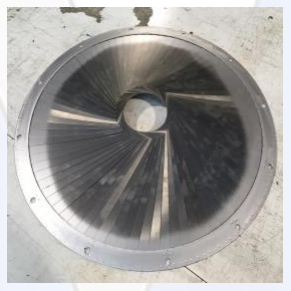
[picture p272: figure]

3 | Inspection window | n.3 Ø 300mm est | n.3 Ø 300mm est

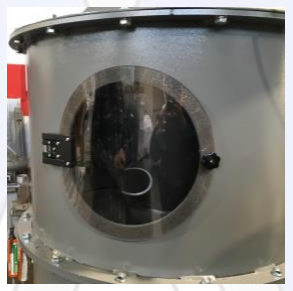
[picture p273: figure]

4 | Filtration Cone | n.1 Ø 730mm est ; Ø 370mm est l.260mm | n.1 Ø 830mm est ; Ø 475mm est l.260mm

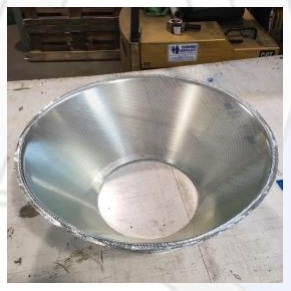
[picture p274: figure]
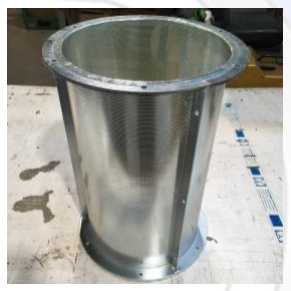
[picture p275: figure]

5 | Filtration Basket | n.1 Ø 370mm – l. 637mm | n.1 Ø 475mm – l. 839mm
