koalium/centidocs/Rezaei/99.02.01/Fan-KC-502-Assembly.PDF

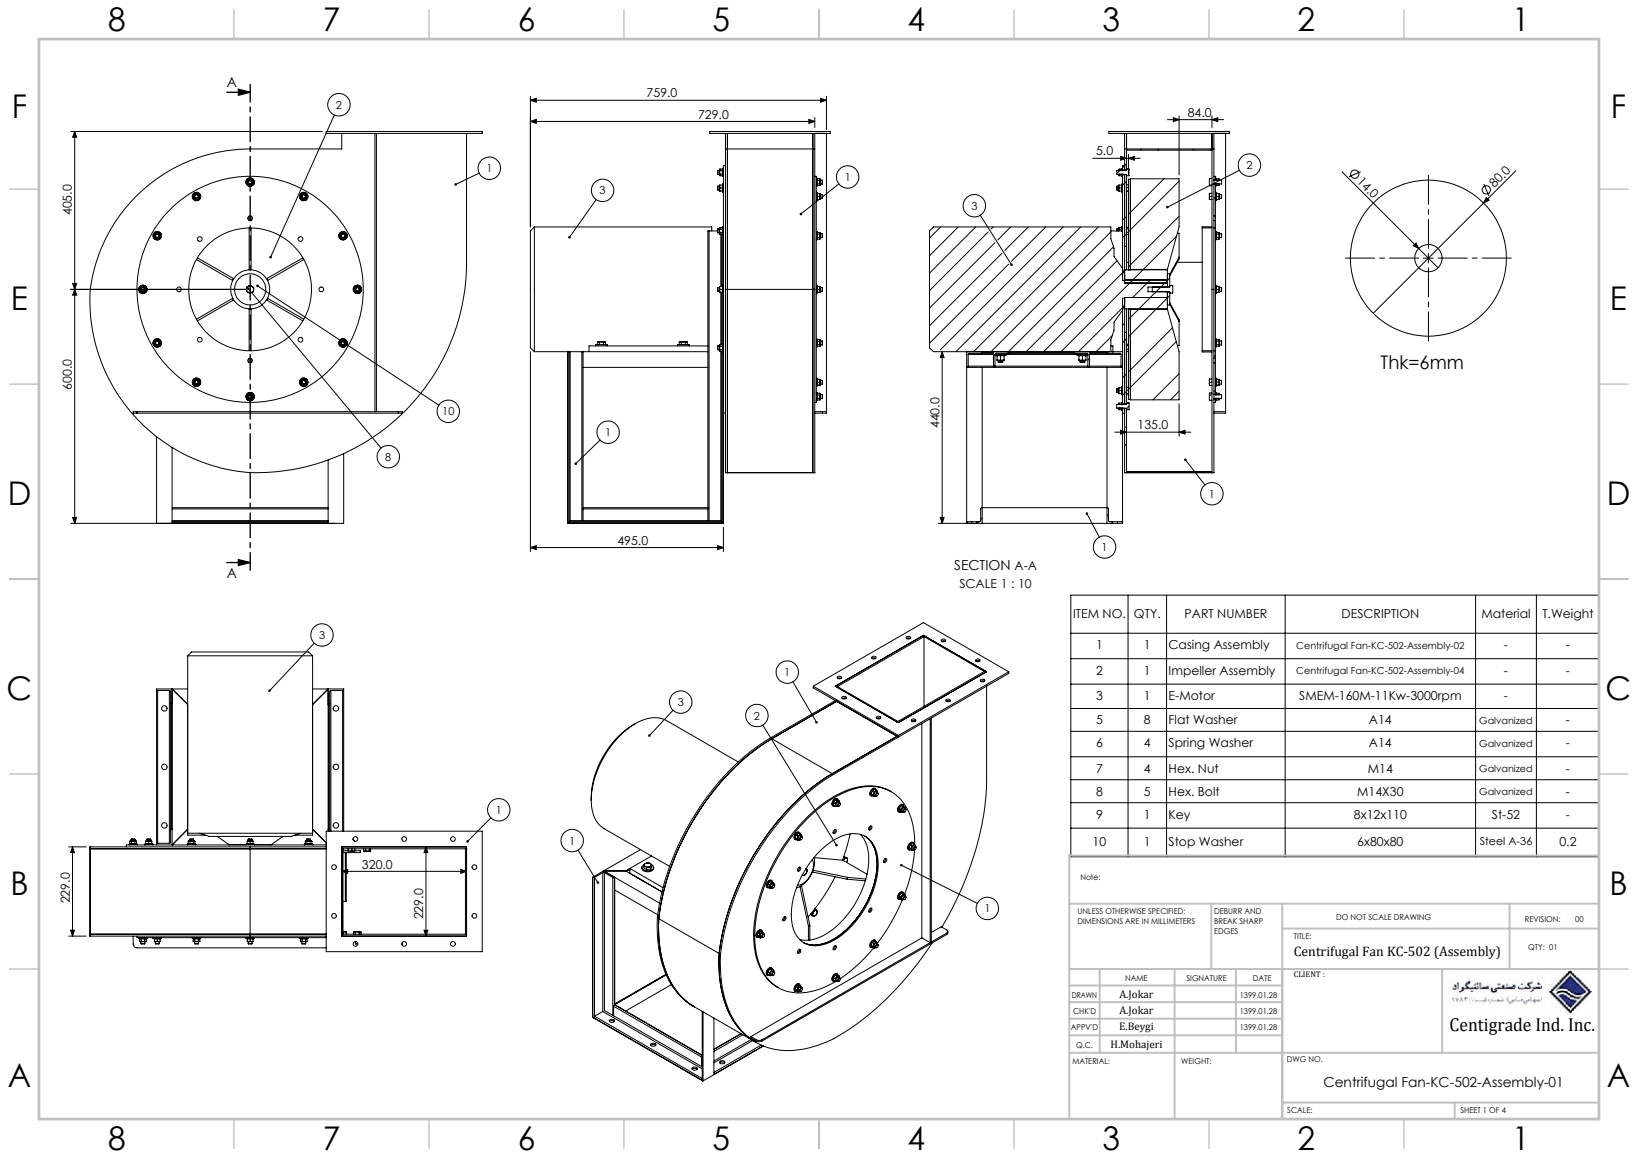
[picture p276: page 1]
SECTION A-A SCALE 1 : 10; ITEM NO.; QTY.; PART NUMBER; DESCRIPTION; Material; T.Weight 1; Casing Assembly; Centrifugal Fan-KC-502-Assembly-02; Impeller Assembly; Centrifugal Fan-KC-502-Assembly-04; E-Motor; SMEM-160M-11Kw-3000rpm; Flat Washer; Galvanized; Spring Washer; Hex. Nut; Hex. Bolt; Key; Stop Washer; Steel A-36; DEBURR AND BREAK SHARP; DO NOT SCALE DRAWING; REVISION:; Centrifugal Fan KC-502 (Assembly); QTY: 01; CLIENT :

Centigrade Ind. Inc.

UNLESS OTHERWISE SPECIFIED:
DIMENSIONS ARE IN MILLIMETERS

DRAWN | A.Jokar | 1399.01.28
CHK'D | E.Beygi | 1399.01.28

APPV'D | | 1399.01.28

MATERIAL: | WEIGHT: | DWG NO. Centrifugal Fan-KC-502-Assembly-01

SCALE: | SHEET 1 OF 4

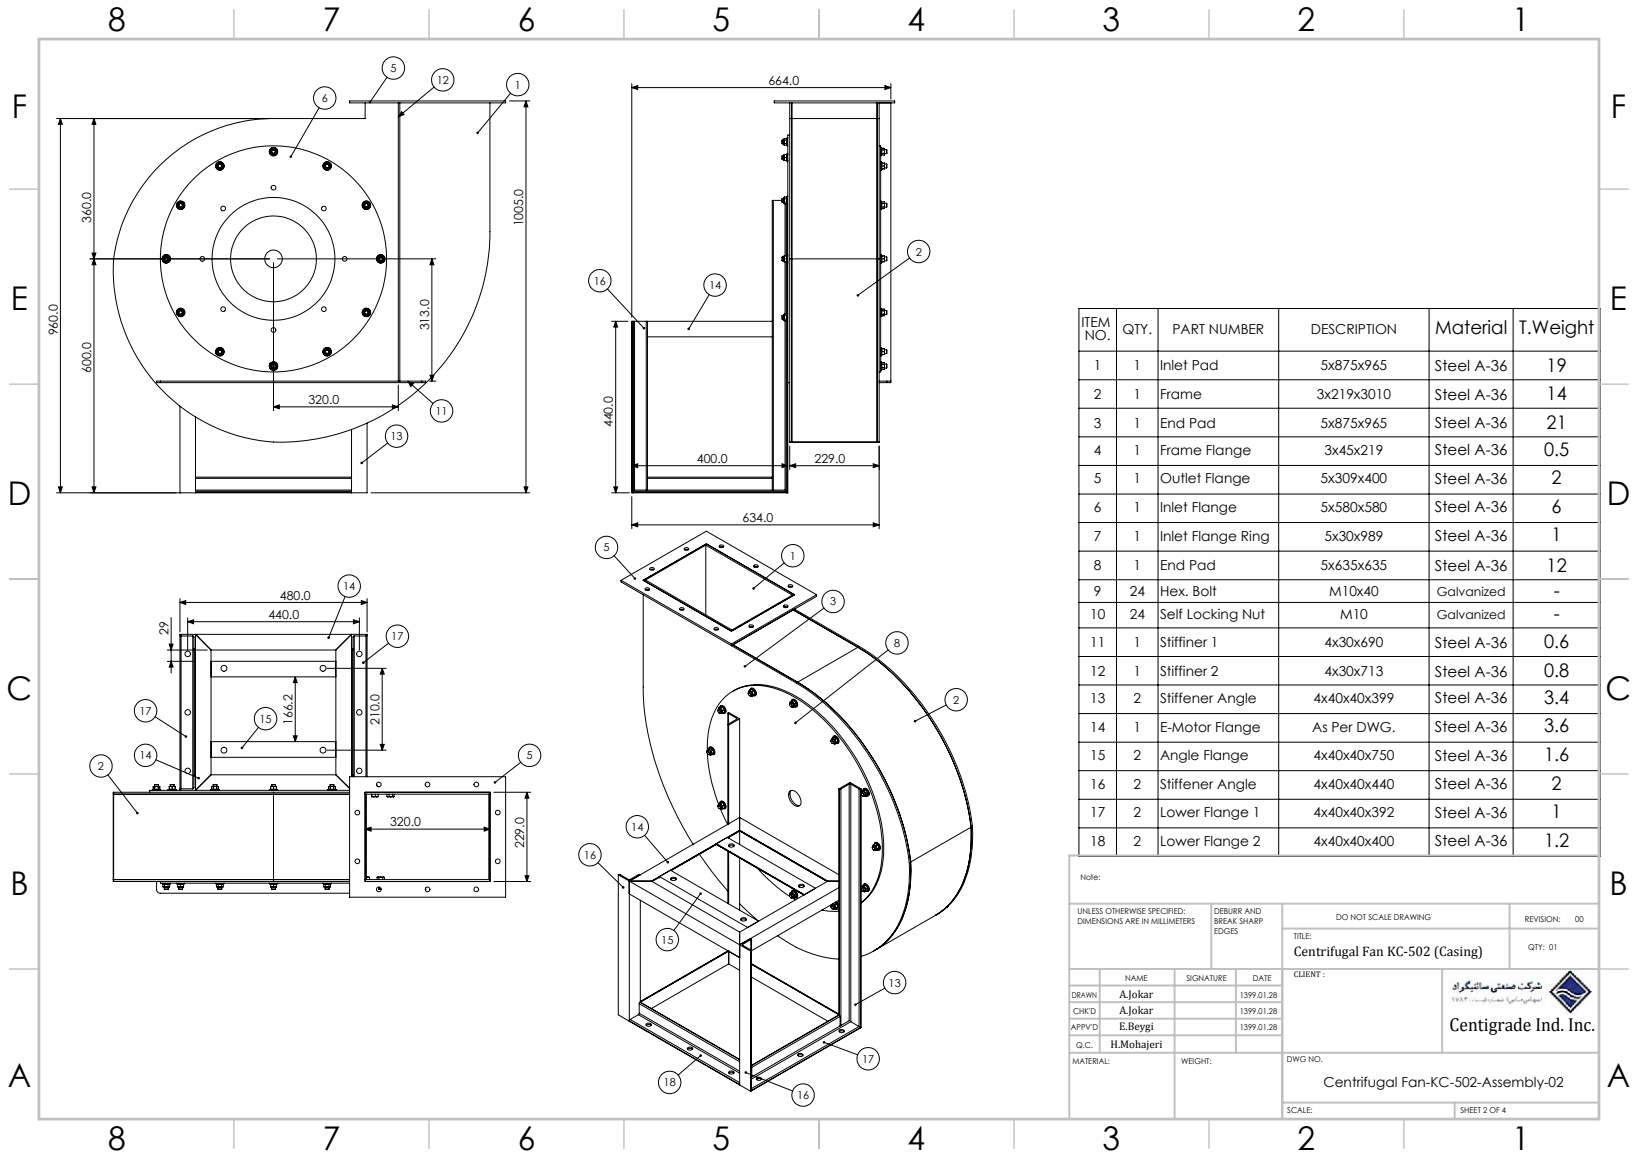
[picture p277: page 2]
QTY.; PART NUMBER; DESCRIPTION; Material; T.Weight 1; Inlet Pad; Steel A-36; Frame; End Pad; Frame Flange; Outlet Flange; Inlet Flange; Inlet Flange Ring; Hex. Bolt; Galvanized; Self Locking Nut; DEBURR AND BREAK SHARP; DO NOT SCALE DRAWING; REVISION:; QTY: 01

11 | 1 | Stiffiner 1 | 4x30x690 | Steel A-36 | 0.6
12 | 1 | Stiffiner 2 | 4x30x713 | Steel A-36 | 0.8
13 | 2 | Stiffener Angle | 4x40x40x399 | Steel A-36 | 3.4
14 | 1 | E-Motor Flange | As Per DWG. | Steel A-36 | 3.6
15 | 2 | Angle Flange | 4x40x40x750 | Steel A-36 | 1.6
16 | 2 | Stiffener Angle | 4x40x40x440 | Steel A-36 | 2
17 | 2 | Lower Flange 1 | 4x40x40x392 | Steel A-36 | 1
18 | 2 | Lower Flange 2 | 4x40x40x400 | Steel A-36 | 1.2

Centigrade Ind. Inc.

Note:
Centrifugal Fan KC-502 (Casing)
TITLE:
CLIENT :
A.Jokar

UNLESS OTHERWISE SPECIFIED:
DIMENSIONS ARE IN MILLIMETERS

DRAWN | A.Jokar | 1399.01.28
CHK'D | E.Beygi | 1399.01.28

APPV'D | | 1399.01.28

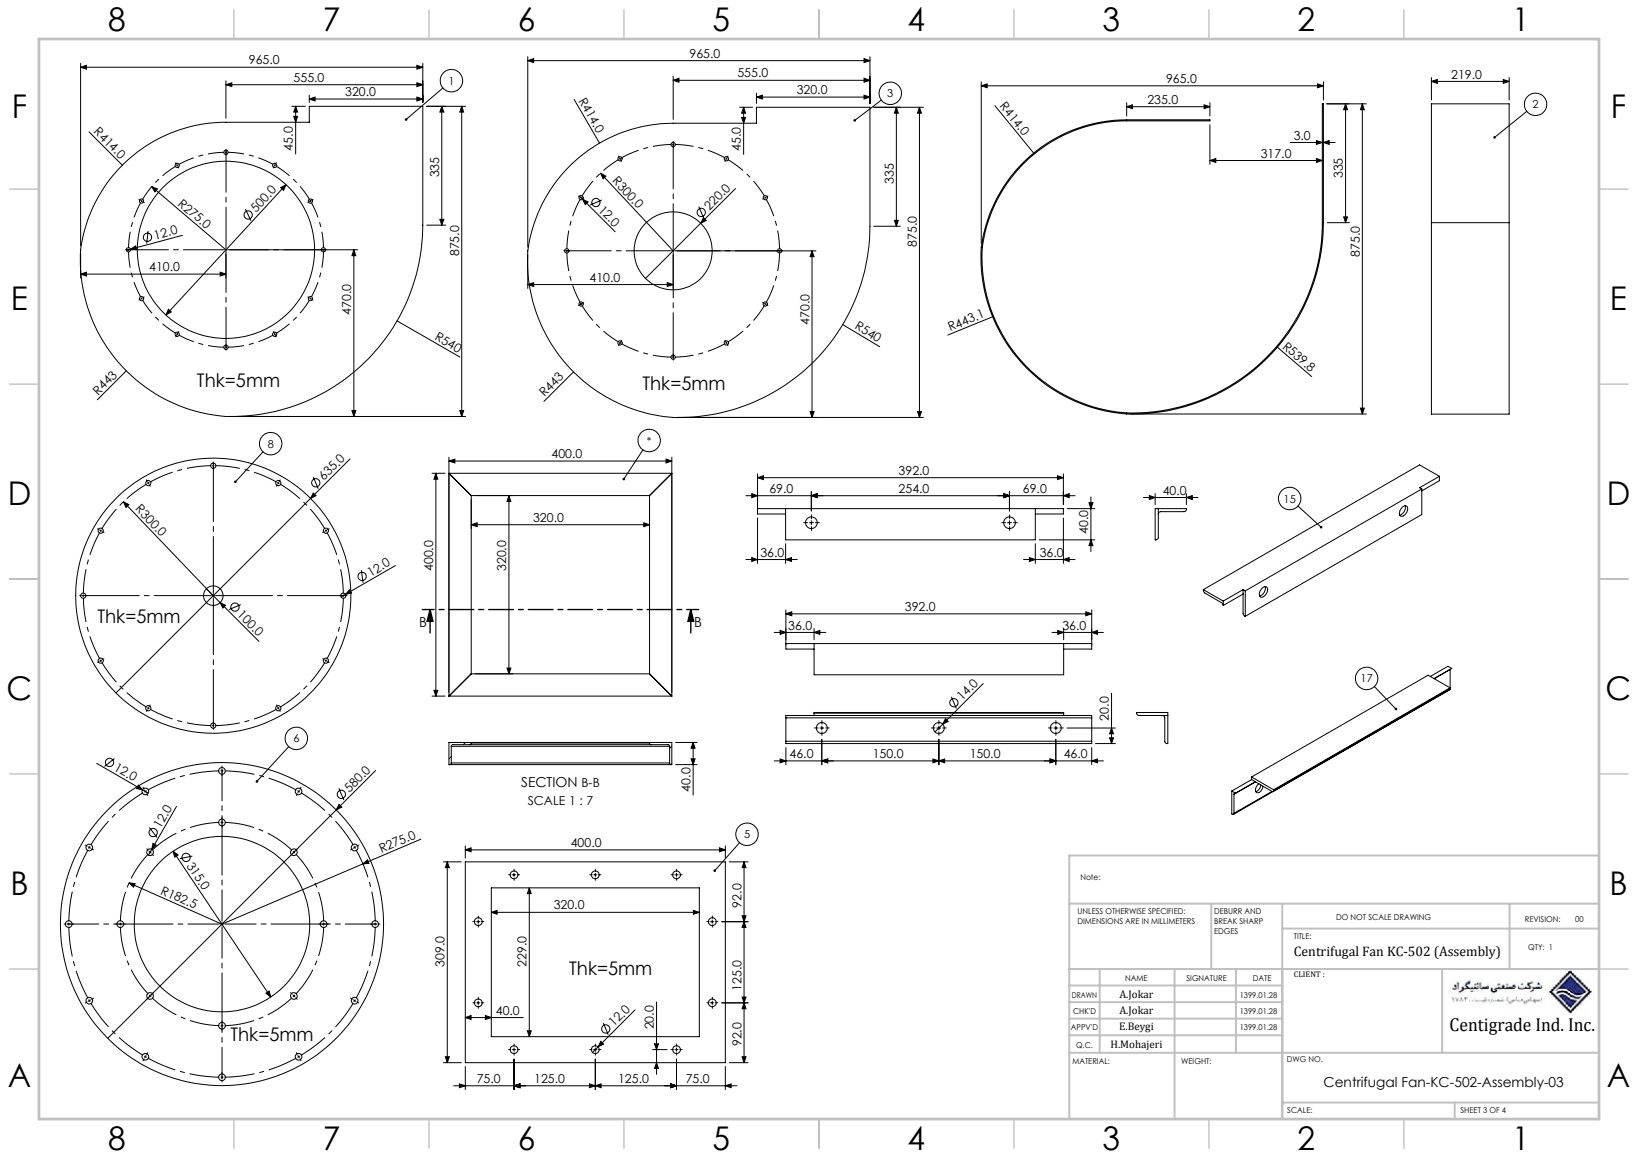
[picture p278: page 3]
SECTION B-B SCALE 1 : 7; DO NOT SCALE DRAWING; REVISION:; QTY: 1

Note:
Centrifugal Fan KC-502 (Assembly)
TITLE:
CLIENT :
A.Jokar

UNLESS OTHERWISE SPECIFIED:
DIMENSIONS ARE IN MILLIMETERS

DEBURR AND
BREAK SHARP
EDGES
Centigrade Ind. Inc.

DRAWN | A.Jokar | 1399.01.28
CHK'D | E.Beygi | 1399.01.28

APPV'D | | 1399.01.28

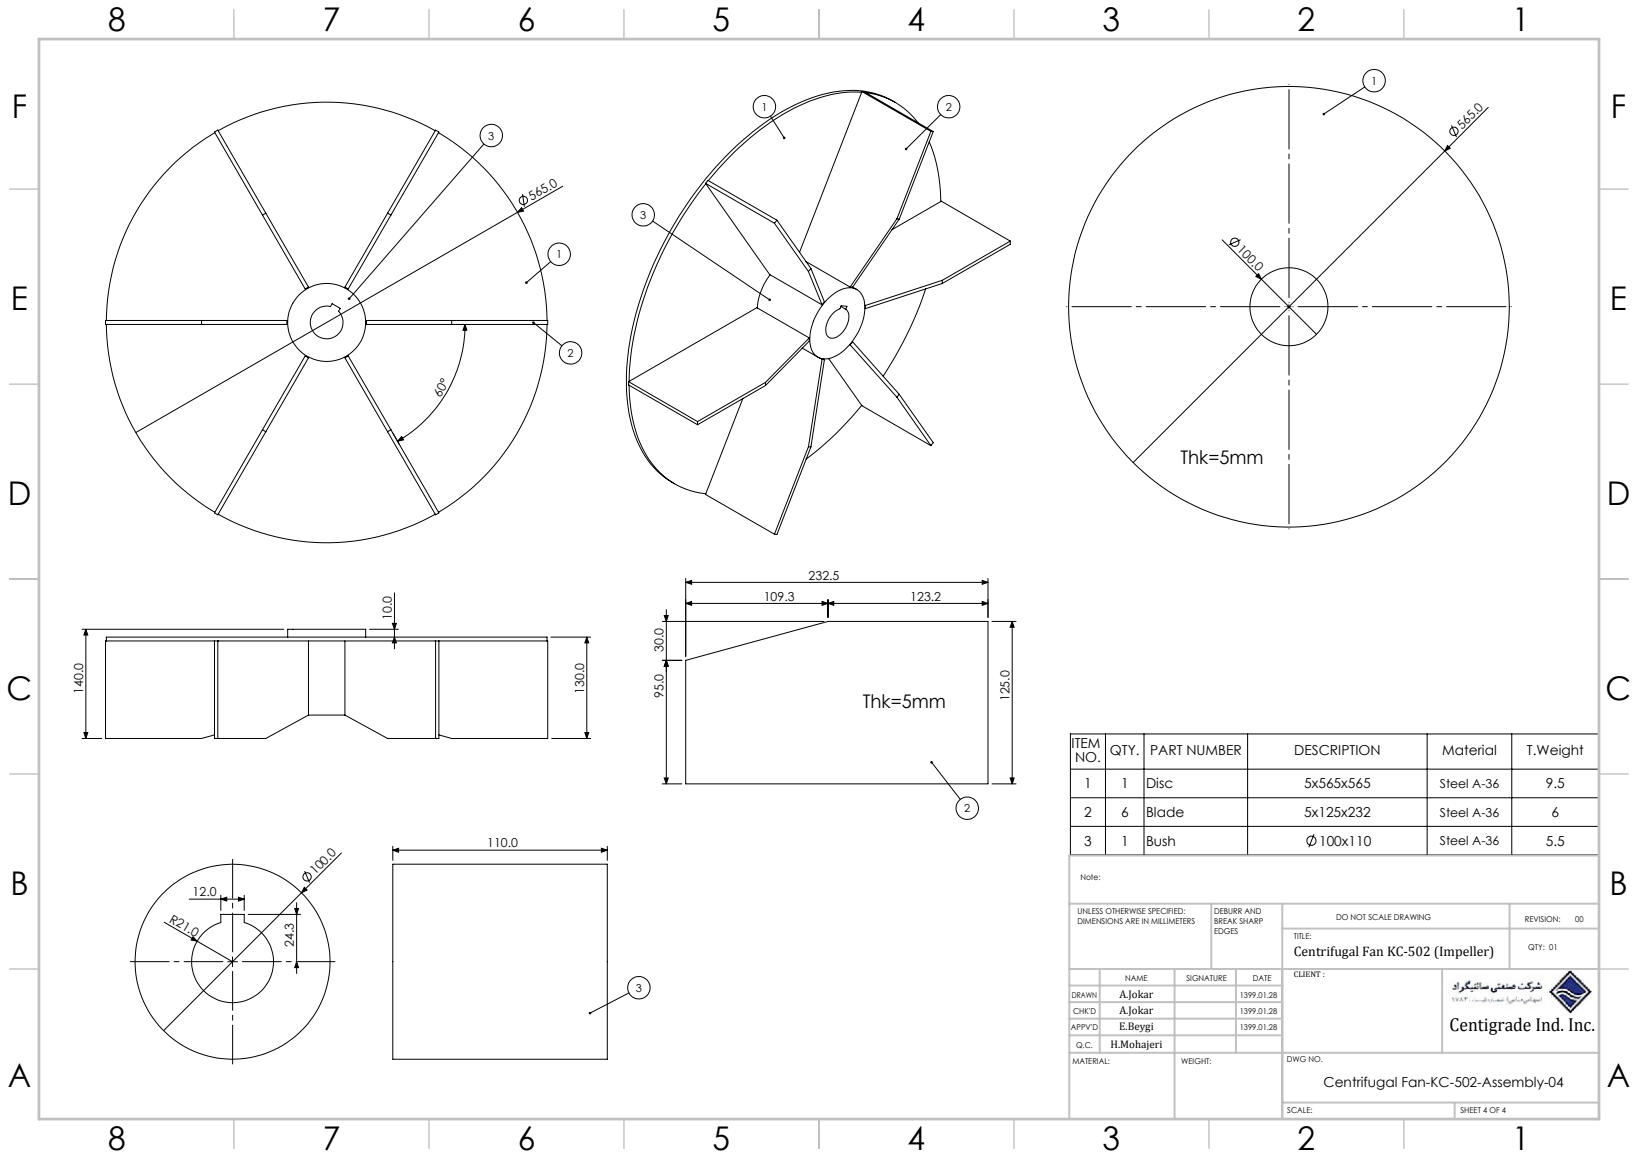
[picture p279: page 4]
DO NOT SCALE DRAWING; REVISION:; QTY: 01

ITEM NO. | QTY. | PART NUMBER | DESCRIPTION | Material | T.Weight

1 | 1 | Disc | 5x565x565 | Steel A-36 | 9.5
2 | 6 | Blade | 5x125x232 | Steel A-36 | 6
3 | 1 | Bush | 100x110 | Steel A-36 | 5.5

Note:
Centrifugal Fan KC-502 (Impeller)
TITLE:
CLIENT :
A.Jokar

UNLESS OTHERWISE SPECIFIED:
DIMENSIONS ARE IN MILLIMETERS

DEBURR AND
BREAK SHARP
EDGES
Centigrade Ind. Inc.

DRAWN | A.Jokar | 1399.01.28
CHK'D | E.Beygi | 1399.01.28

APPV'D | | 1399.01.28
