koalium/centidocs/jokar/Damper 850 pdf/Blade Assembly left.pdf

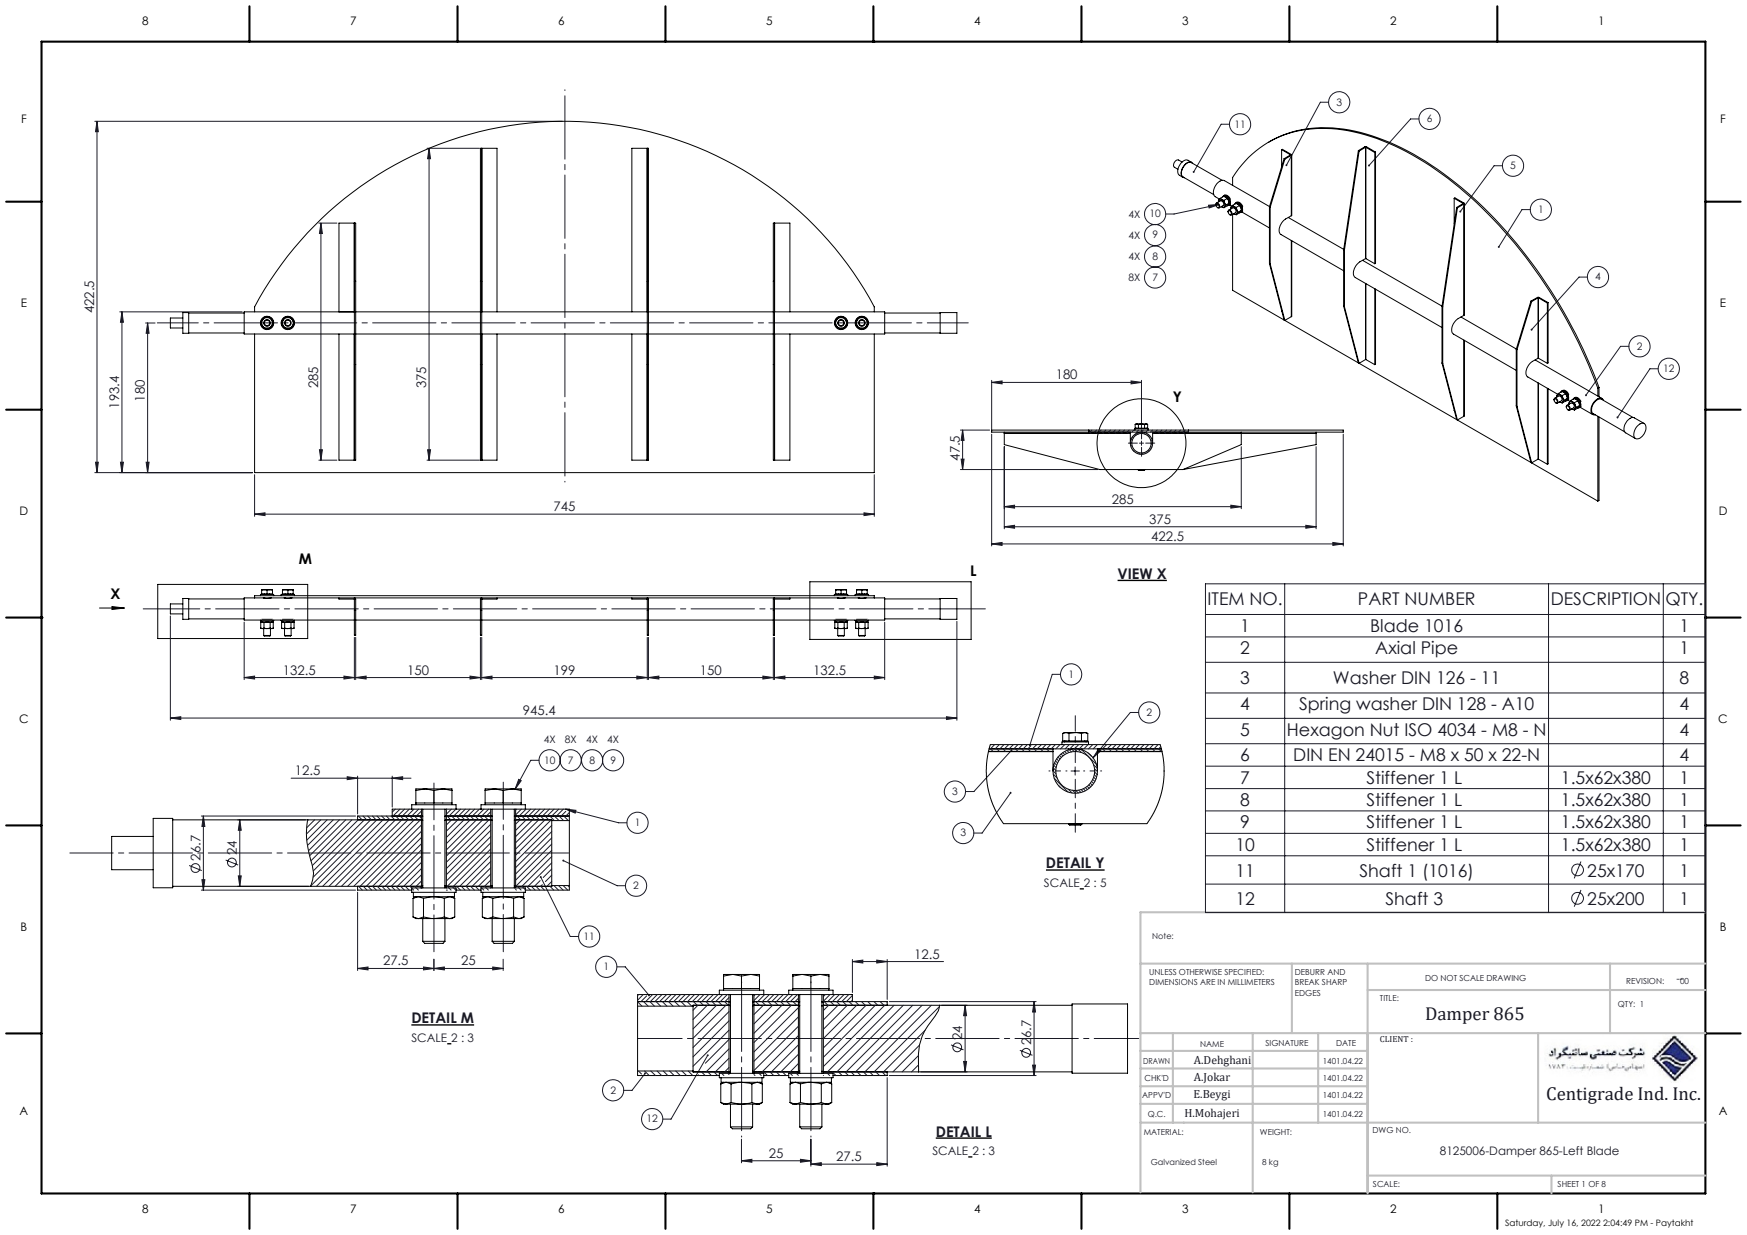
[picture p280: page 1]
DETAIL L SCALE 2 : 3; DETAIL M SCALE 2 : 3; DETAIL Y SCALE 2 : 5; Hexagon Nut ISO 4034 - M8 - N; DO NOT SCALE DRAWING; REVISION:; Damper 865; QTY: 1; CLIENT :

VIEW X

ITEM NO. | PART NUMBER | DESCRIPTION QTY.
1 | Blade 1016 | | 1
2 | Axial Pipe | | 1
3 | Washer DIN 126 - 11 | | 8
4 | Spring washer DIN 128 - A10 | | 4

6 | DIN EN 24015 - M8 x 50 x 22-N | | 4
7 | Stiffener 1 L | 1.5x62x380 | 1
8 | Stiffener 1 L | 1.5x62x380 | 1
9 | Stiffener 1 L | 1.5x62x380 | 1
10 | Stiffener 1 L | 1.5x62x380 | 1
11 | Shaft 1 (1016) | 25x170 | 1
12 | Shaft 3 | 25x200 | 1

UNLESS OTHERWISE SPECIFIED:
DIMENSIONS ARE IN MILLIMETERS

DEBURR AND
BREAK SHARP
EDGES
Centigrade Ind. Inc.

DRAWN | A.Jokar | | 1401.04.22
CHK'D | E.Beygi | | 1401.04.22

APPV'D | | | 1401.04.22

MATERIAL: Galvanized Steel | WEIGHT: 8 kg | DWG NO. 8125006-Damper 865-Left Blade

SCALE: | SHEET 1 OF 8

Saturday, July 16, 2022 2:04:49 PM - Paytakht

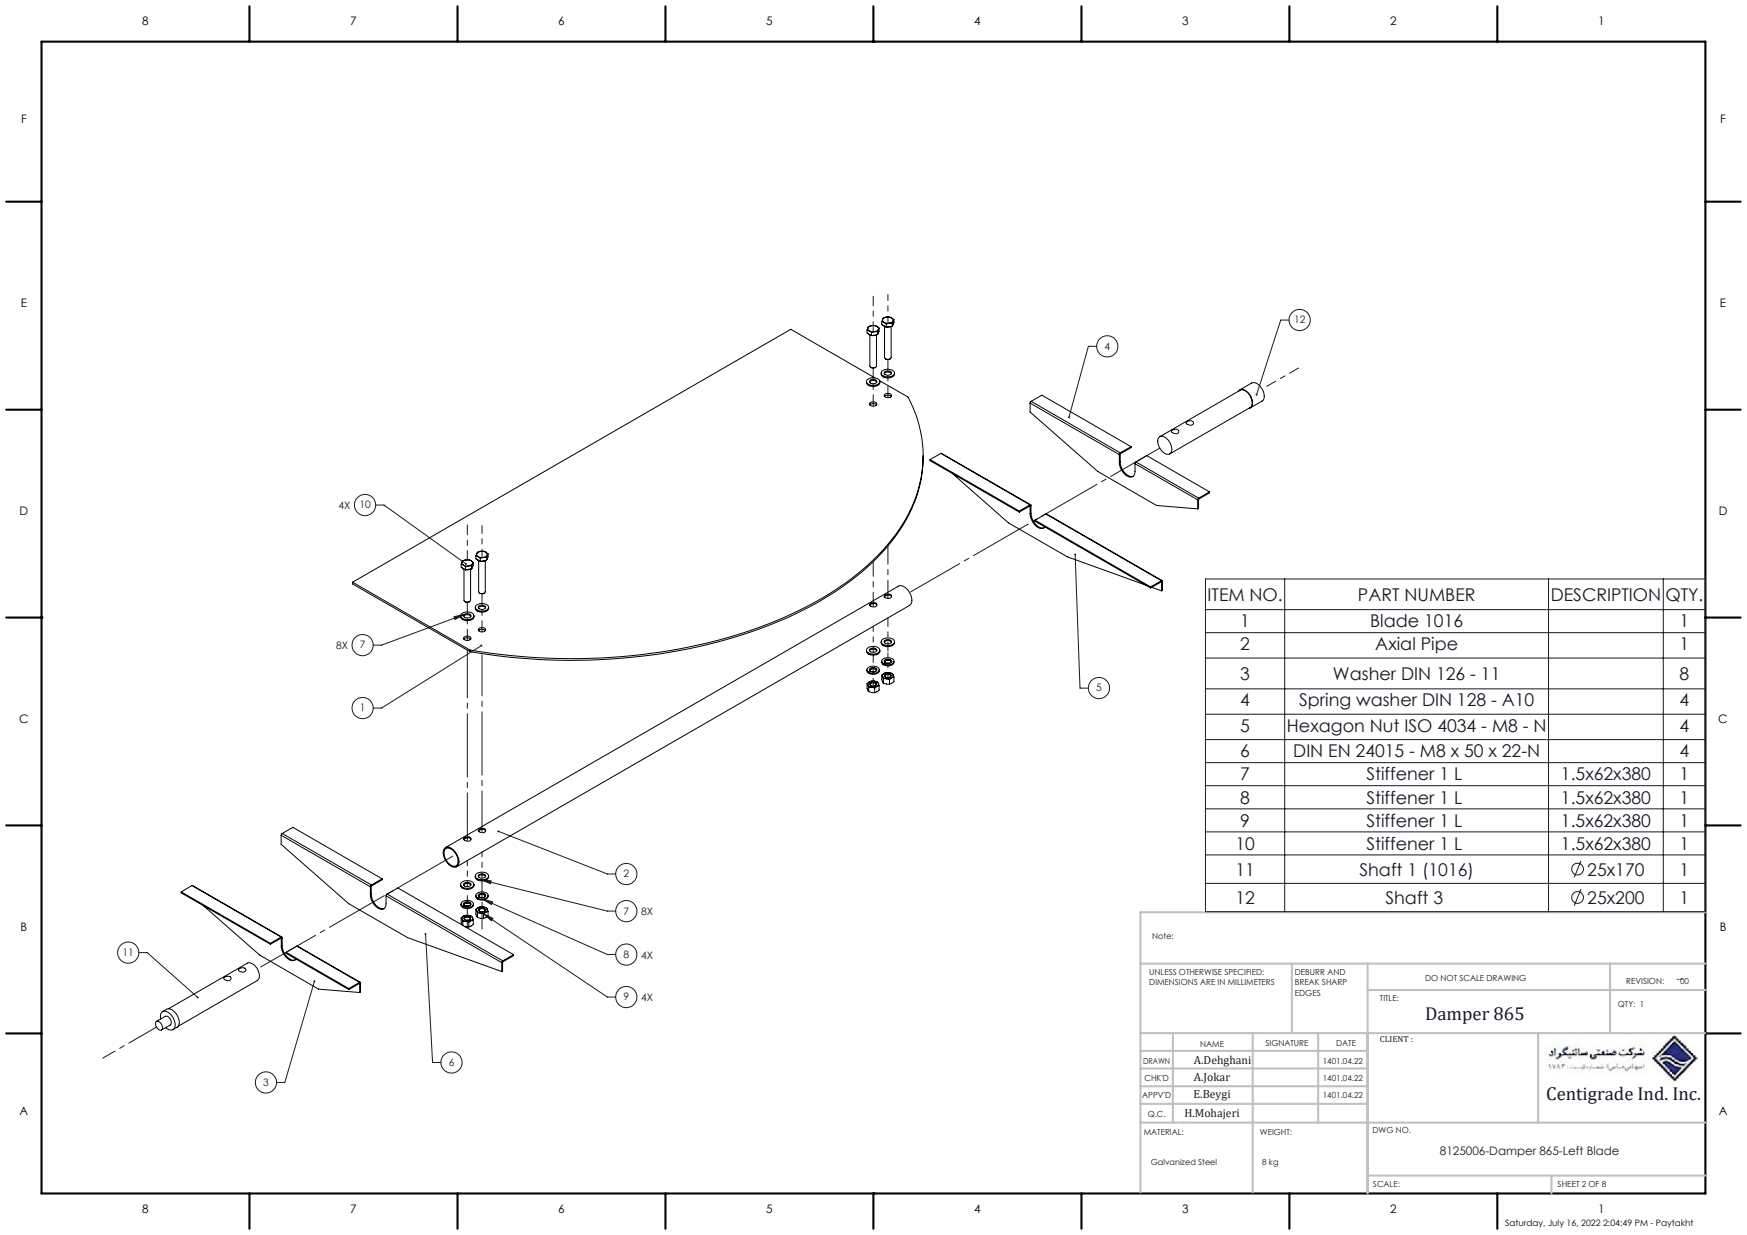
[picture p281: page 2]
DO NOT SCALE DRAWING; REVISION:; Damper 865; QTY: 1; CLIENT :; Galvanized Steel

ITEM NO. | PART NUMBER | DESCRIPTION QTY.
1 | Blade 1016 | | 1
2 | Axial Pipe | | 1
3 | Washer DIN 126 - 11 | | 8
4 | Spring washer DIN 128 - A10 | | 4
5 | Hexagon Nut ISO 4034 - M8 - N | | 4
6 | DIN EN 24015 - M8 x 50 x 22-N | | 4
7 | Stiffener 1 L | 1.5x62x380 | 1
8 | Stiffener 1 L | 1.5x62x380 | 1
9 | Stiffener 1 L | 1.5x62x380 | 1
10 | Stiffener 1 L | 1.5x62x380 | 1
11 | Shaft 1 (1016) | 25x170 | 1
12 | Shaft 3 | 25x200 | 1

UNLESS OTHERWISE SPECIFIED:
DIMENSIONS ARE IN MILLIMETERS

DEBURR AND
BREAK SHARP
EDGES
Centigrade Ind. Inc.

DRAWN | A.Jokar | 1401.04.22
CHK'D | E.Beygi | 1401.04.22

APPV'D | | 1401.04.22

8125006-Damper 865-Left Blade

Saturday, July 16, 2022 2:04:49 PM - Paytakht

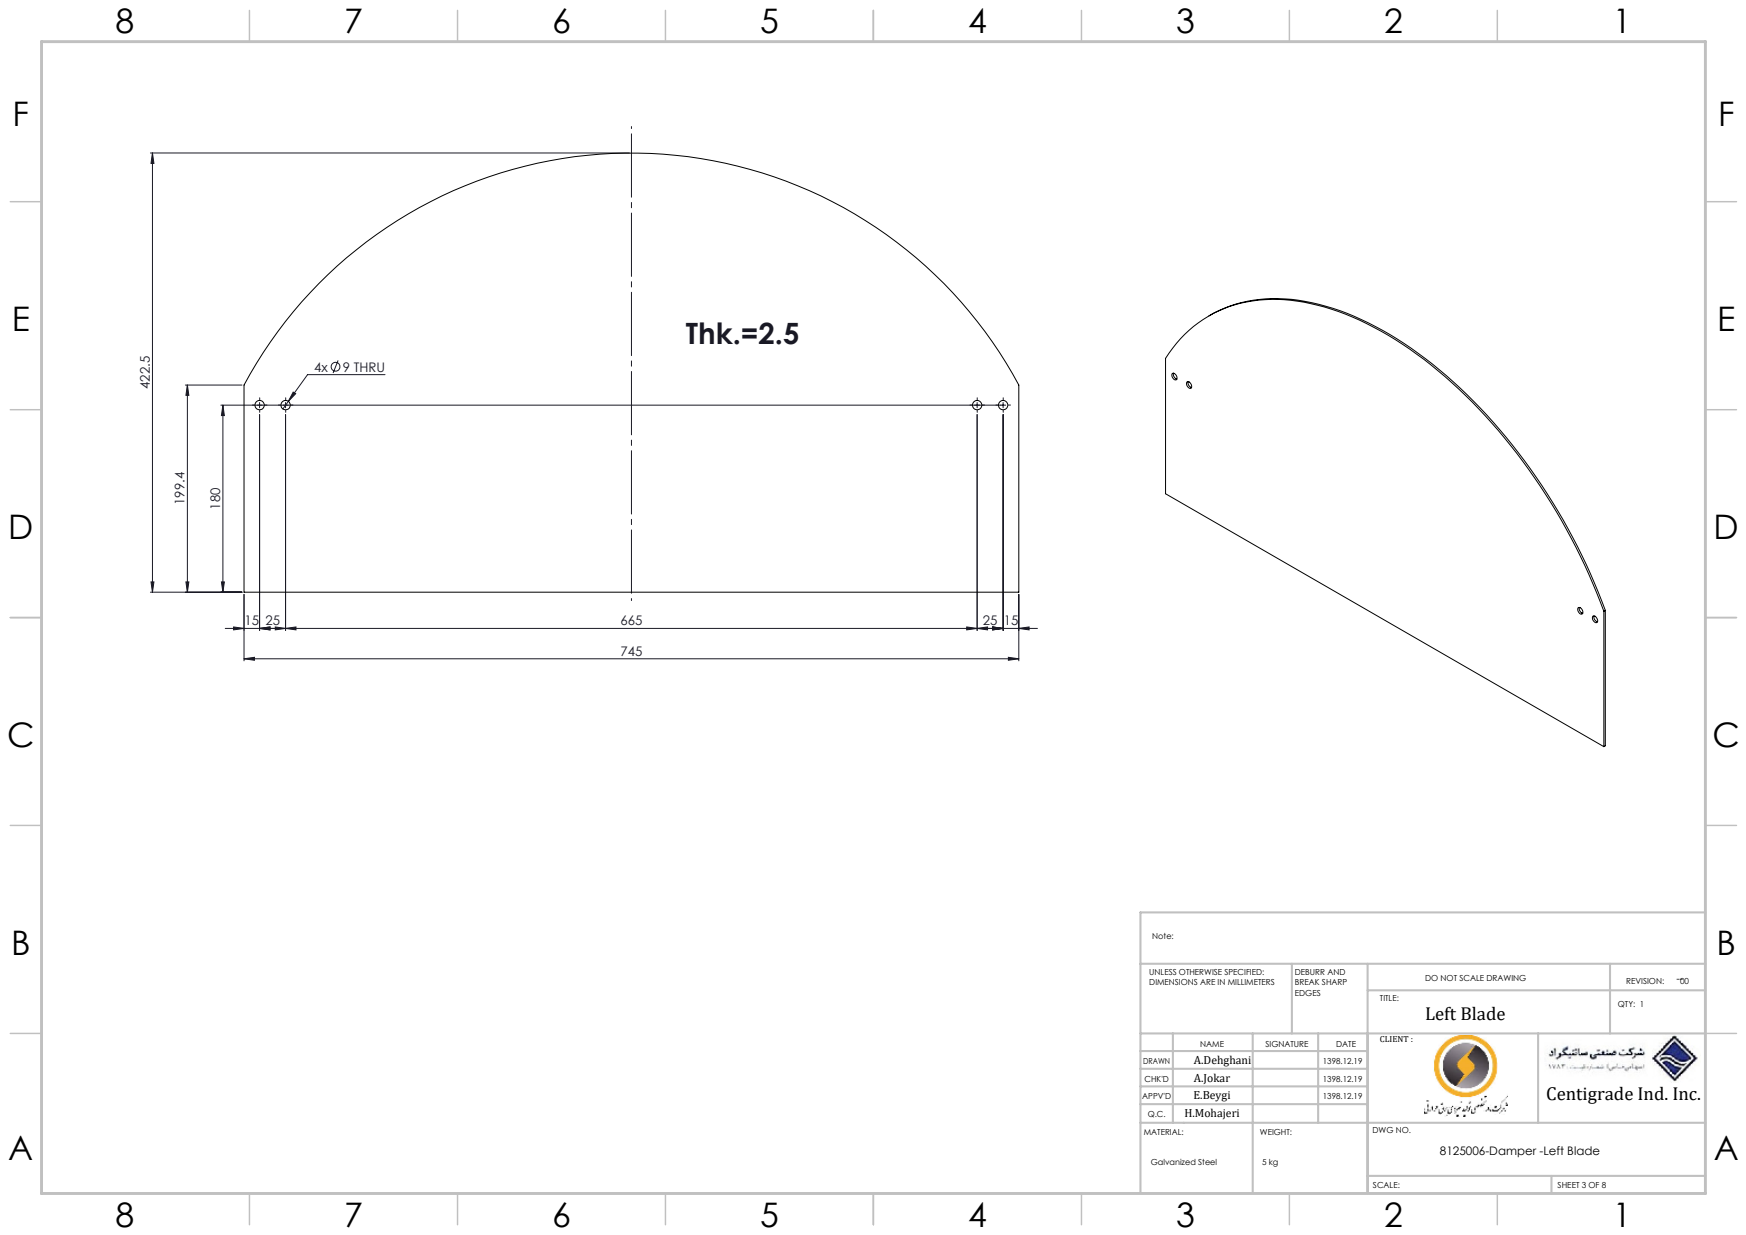
[picture p282: page 3]
4x 9 THRU; DO NOT SCALE DRAWING; REVISION:; Left Blade; QTY: 1; CLIENT :; Galvanized Steel

UNLESS OTHERWISE SPECIFIED:
DIMENSIONS ARE IN MILLIMETERS

DEBURR AND
BREAK SHARP
EDGES
Centigrade Ind. Inc.

DRAWN | A.Jokar | 1398.12.19
CHK'D | E.Beygi | 1398.12.19

APPV'D | | 1398.12.19

8125006-Damper -Left Blade

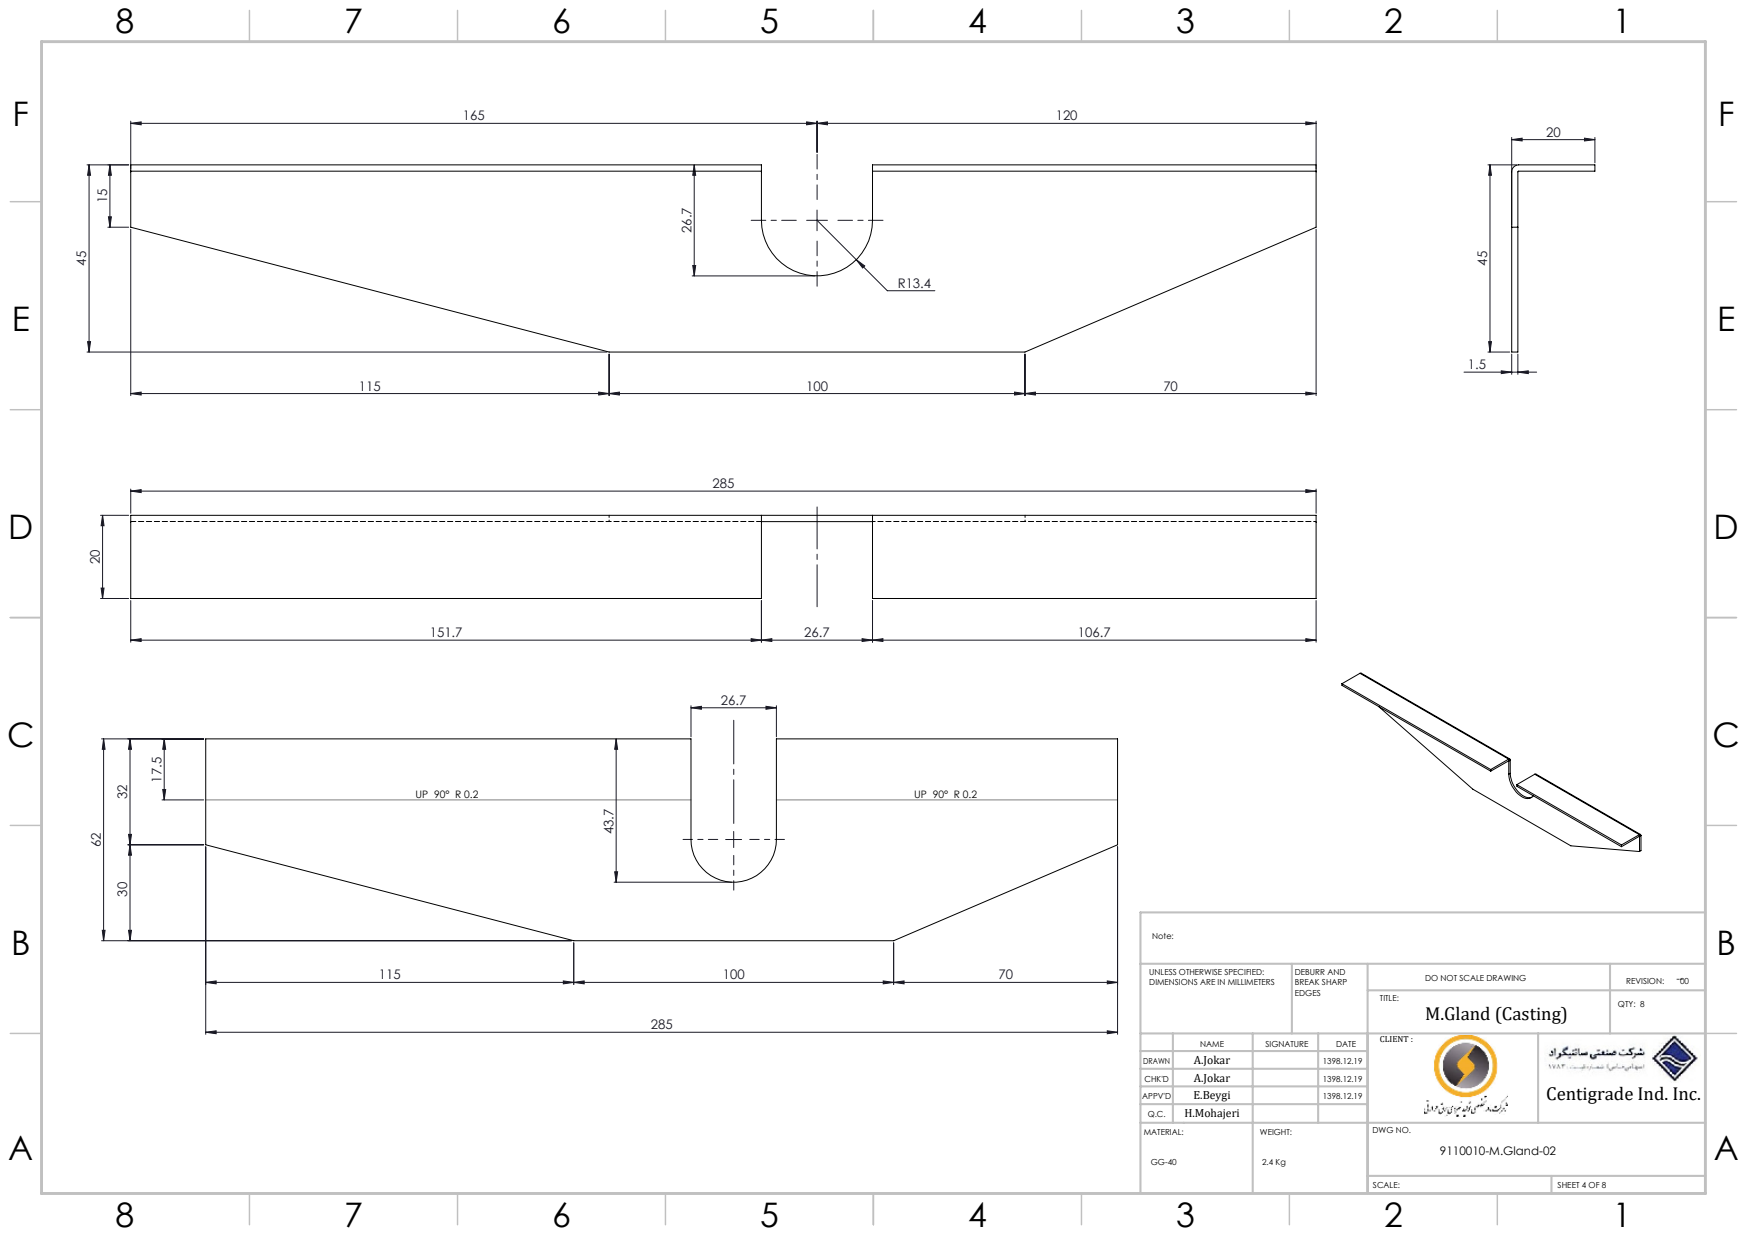
[picture p283: page 4]
DO NOT SCALE DRAWING; REVISION:; M.Gland (Casting); QTY: 8; CLIENT :

UNLESS OTHERWISE SPECIFIED:
DIMENSIONS ARE IN MILLIMETERS

DEBURR AND
BREAK SHARP
EDGES
Centigrade Ind. Inc.

DRAWN | A.Jokar | 1398.12.19
CHK'D | E.Beygi | 1398.12.19

APPV'D | | 1398.12.19

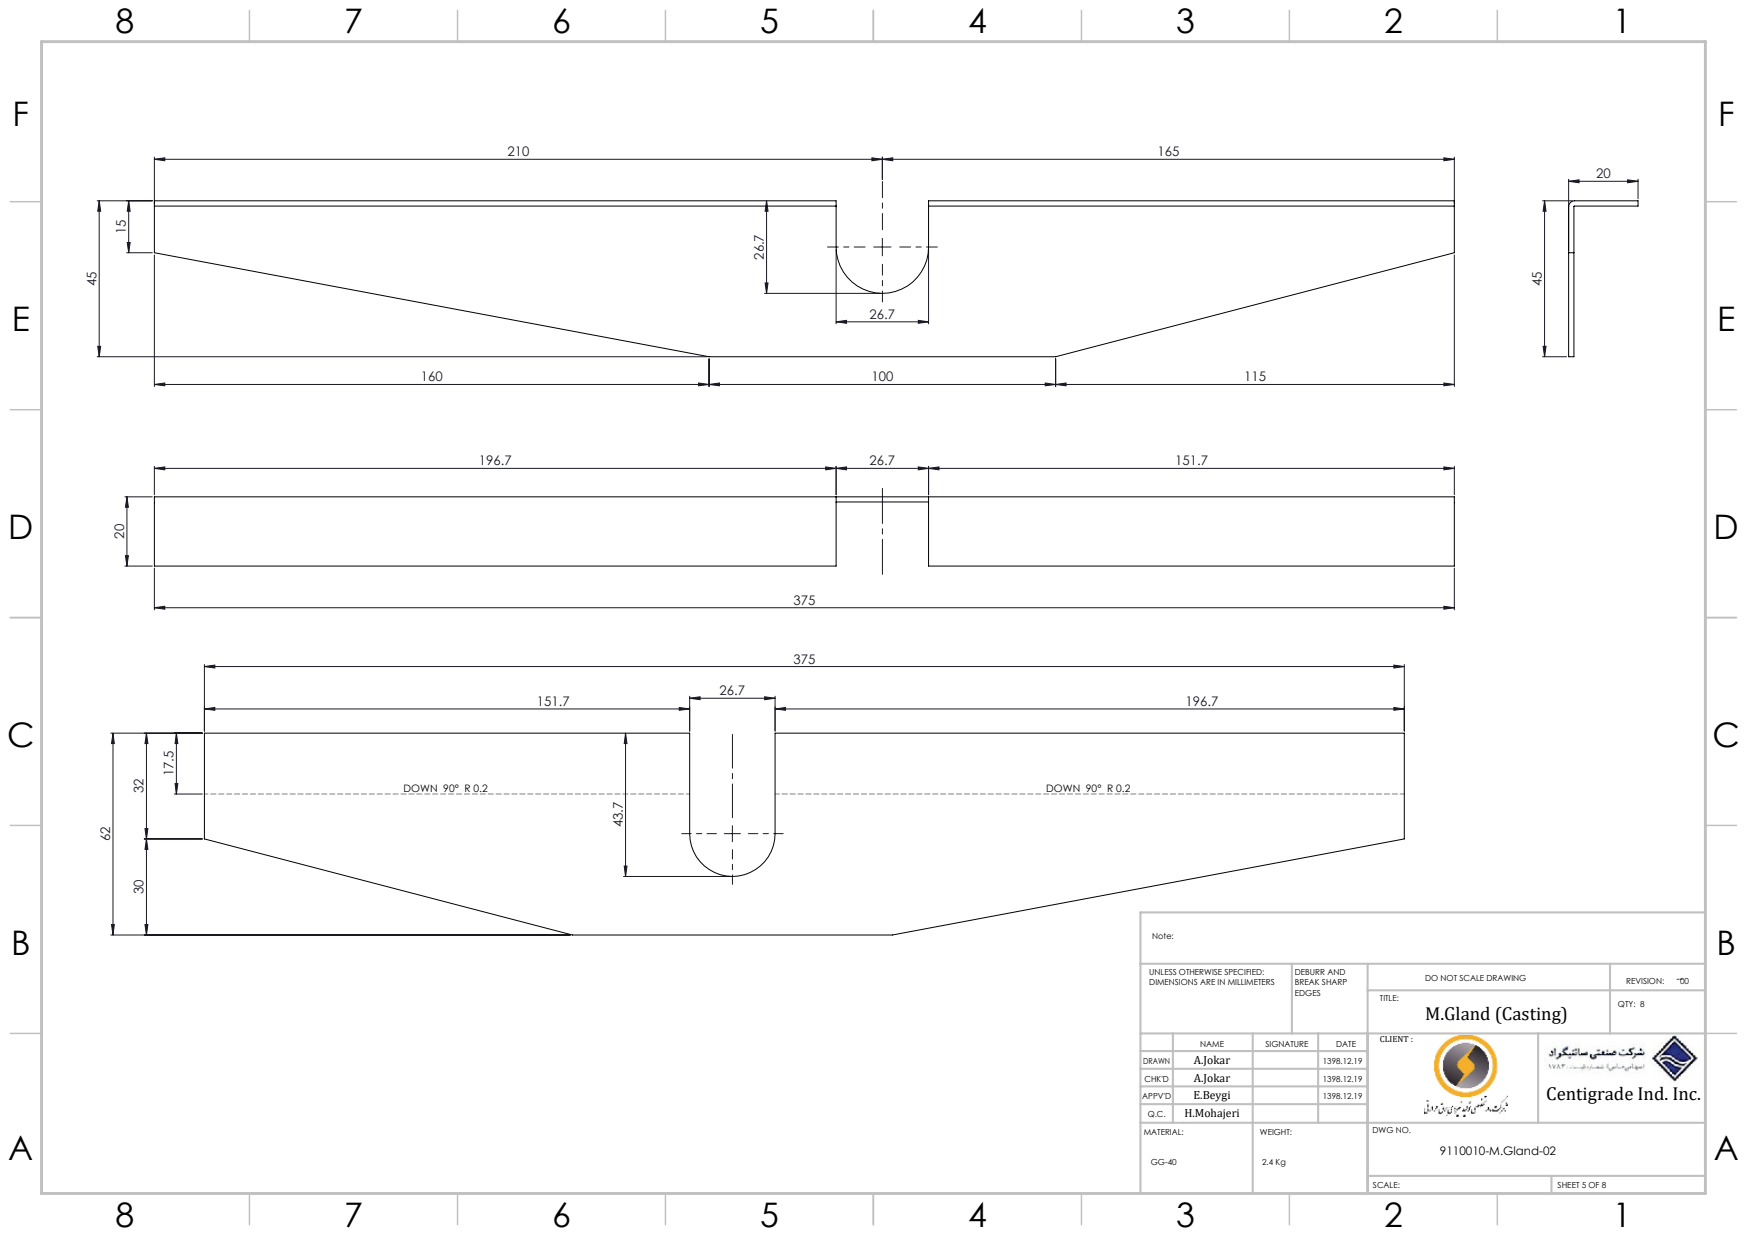
[picture p284: page 5]
DOWN 90° R 0.2; DO NOT SCALE DRAWING; REVISION:; M.Gland (Casting); QTY: 8; CLIENT :

UNLESS OTHERWISE SPECIFIED:
DIMENSIONS ARE IN MILLIMETERS

DEBURR AND
BREAK SHARP
EDGES
Centigrade Ind. Inc.

DRAWN | A.Jokar | 1398.12.19
CHK'D | E.Beygi | 1398.12.19

APPV'D | | 1398.12.19

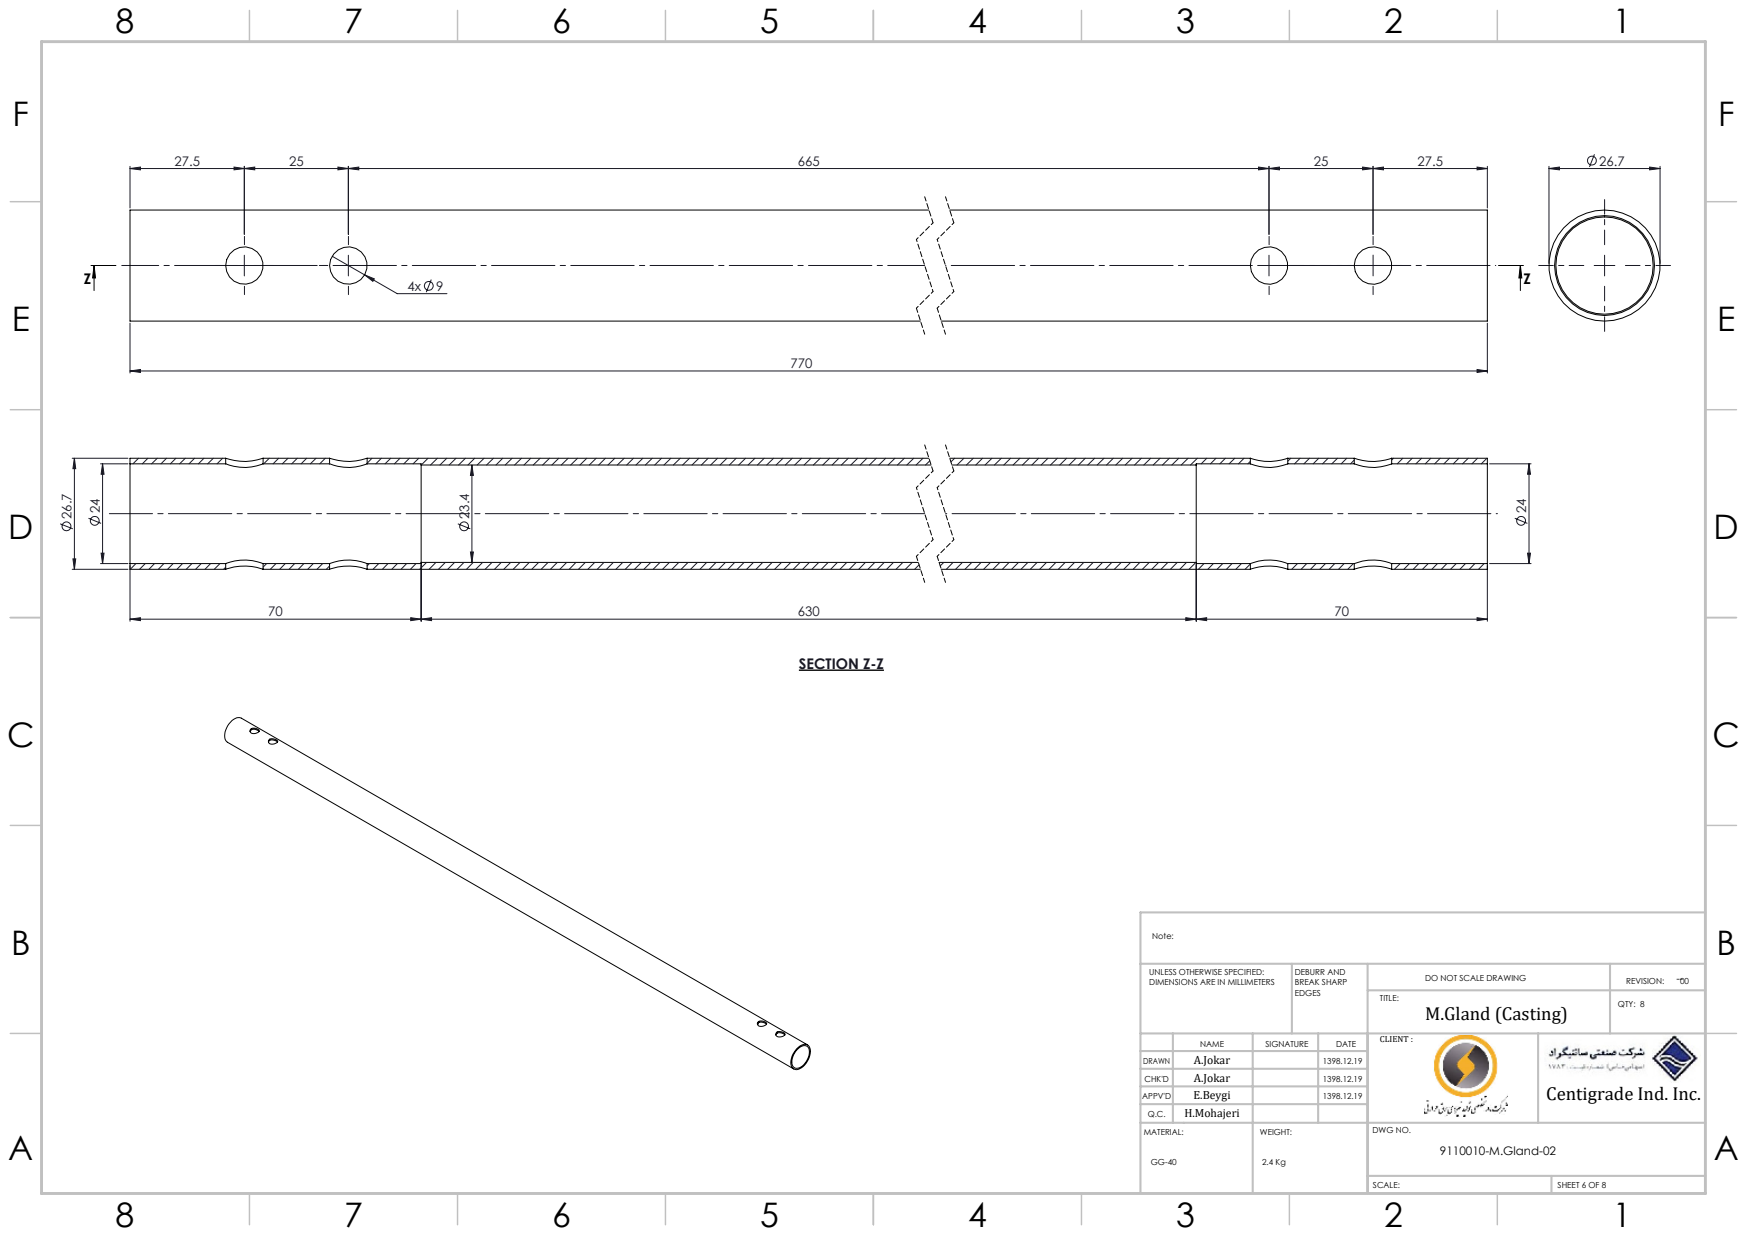
[picture p285: page 6]
SECTION Z-Z; DO NOT SCALE DRAWING; REVISION:; M.Gland (Casting); QTY: 8; CLIENT :

UNLESS OTHERWISE SPECIFIED:
DIMENSIONS ARE IN MILLIMETERS

DEBURR AND
BREAK SHARP
EDGES
Centigrade Ind. Inc.

DRAWN | A.Jokar | 1398.12.19
CHK'D | E.Beygi | 1398.12.19

APPV'D | | 1398.12.19

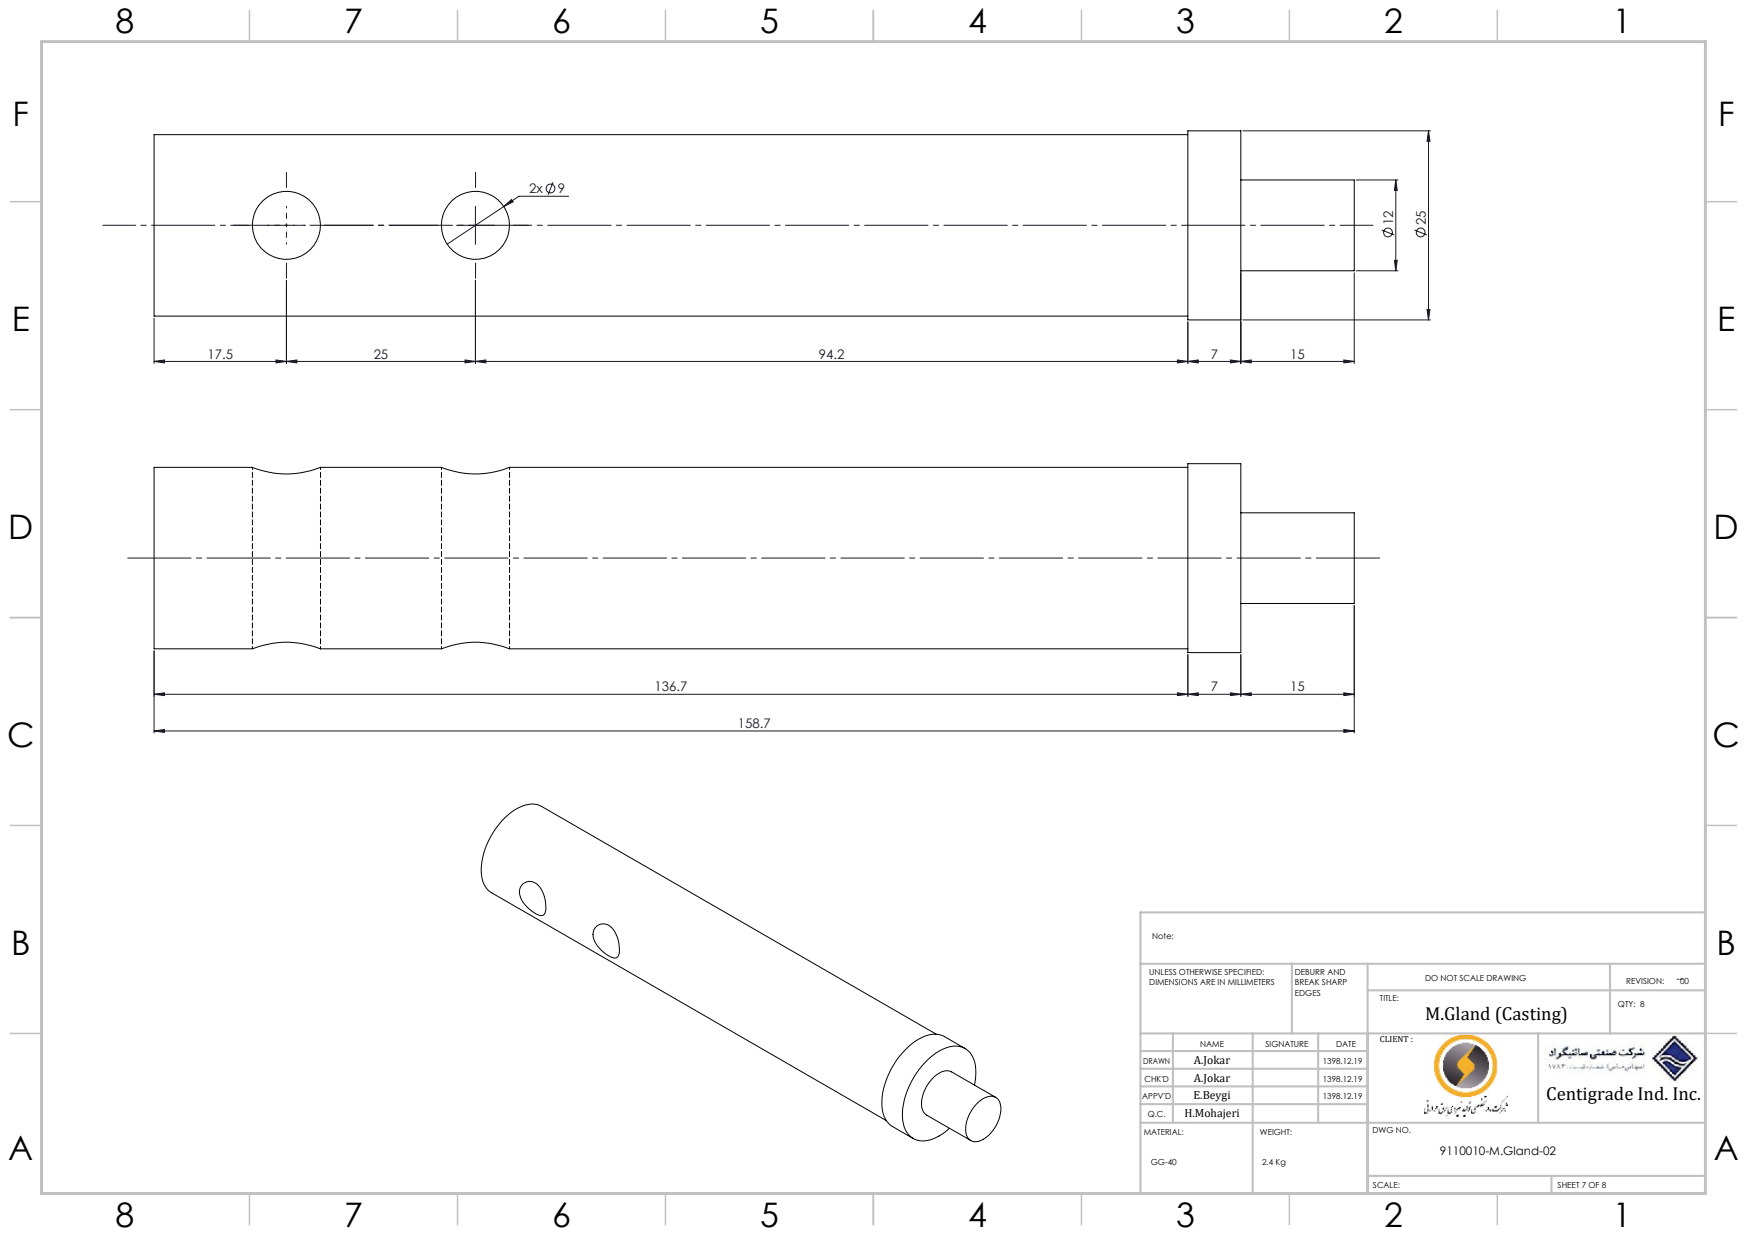
[picture p286: page 7]
DO NOT SCALE DRAWING; REVISION:; M.Gland (Casting); QTY: 8; CLIENT :

UNLESS OTHERWISE SPECIFIED:
DIMENSIONS ARE IN MILLIMETERS

DEBURR AND
BREAK SHARP
EDGES
Centigrade Ind. Inc.

DRAWN | A.Jokar | 1398.12.19
CHK'D | E.Beygi | 1398.12.19

APPV'D | | 1398.12.19

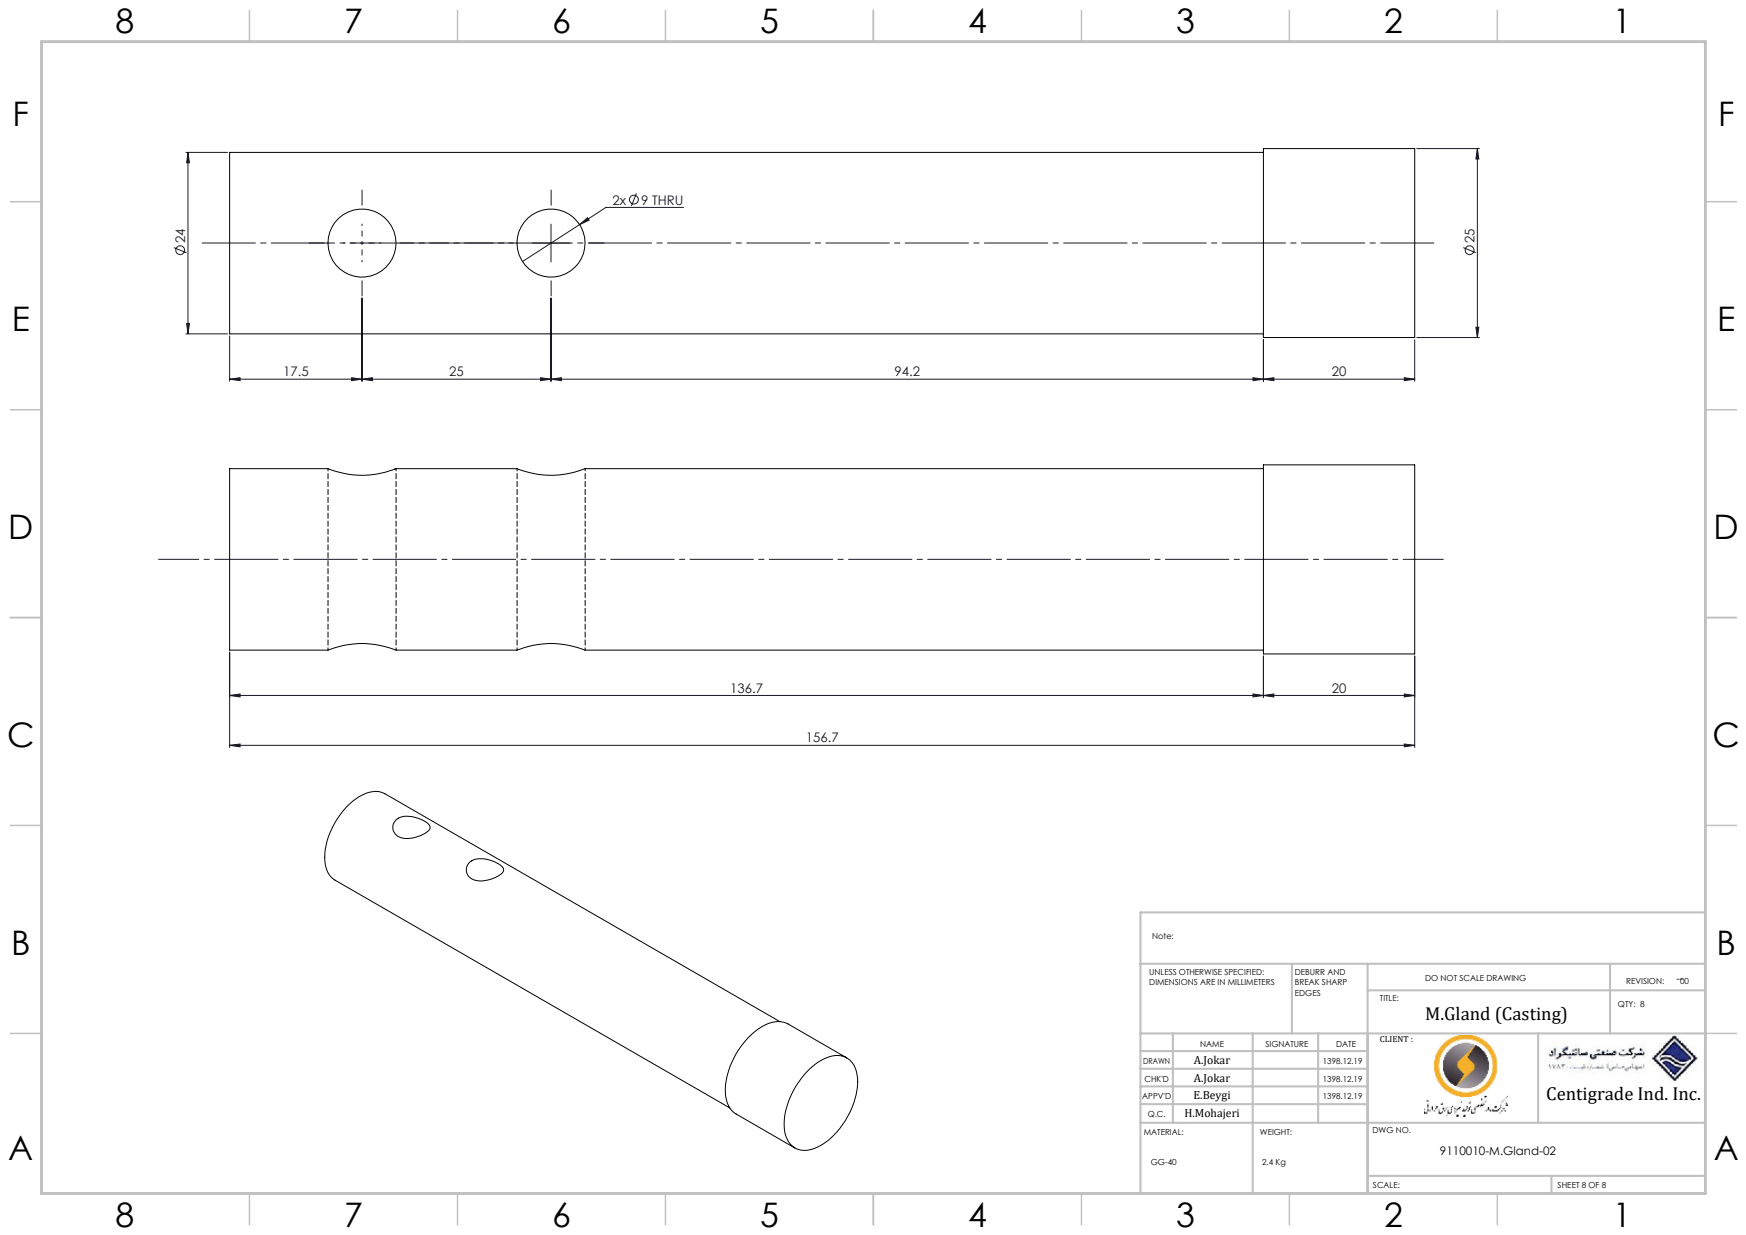
[picture p287: page 8]
2x 9 THRU; DO NOT SCALE DRAWING; REVISION:; M.Gland (Casting); QTY: 8; CLIENT :

UNLESS OTHERWISE SPECIFIED:
DIMENSIONS ARE IN MILLIMETERS

DEBURR AND
BREAK SHARP
EDGES
Centigrade Ind. Inc.

DRAWN | A.Jokar | 1398.12.19
CHK'D | E.Beygi | 1398.12.19

APPV'D | | 1398.12.19
