koalium/centidocs/elec/plc/Wiring diagram/Deralok Wiring Diagram-Rev06.pdf

1

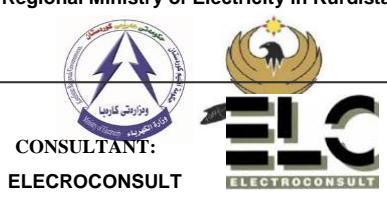
[picture p288: figure]
ELECROCONSULT; CONSULTANT:

# ELECTRICAL AND WIRING DIAGRAM

# Cii97-81003-DIA-15

Centigrade Ind.Inc.

# DERALOK Hydropower Plant Construction Project (Pkg2)

# EMPLOYER:

# Regional Ministry of Electricity in Kurdistan

# CONTRACTOR: FARAB & Boland Payeh J.V

| DLK-D-FAB-10913-MEC-C-R06 | REV.:06
Contract No.: IQ-P15 (Pkg2) | H42-2-00-MA-P-20-DWG-113 | Page 1 of 3

FAB Rev. | Employer Rev.
06 | 03/12/2022 | For Approval | S.Ebrahimi | E.Beygi | D.Dehghani
05 | 09/20/2021 | For Approval | S.Ebrahimi | E.Beygi | D.Dehghani
04 | 05/09/2021 | For Approval | S.Ebrahimi | E.Beygi | D.Dehghani
03 | 04/13/2021 | For Approval | S.Ebrahimi | E.Beygi | D.Dehghani
02 | 01/24/2021 | For Approval | S.Ebrahimi | E.Beygi | D.Dehghani
01 | 01/10/2021 | For Approval | S.Ebrahimi | E.Beygi | D.Dehghani
00 | 11/07/2020 | For Approval | S.Ebrahimi | E.Beygi | D.Dehghani
REV. | DATE | DESCRIPTION | DISIGN | CHKD | APP'D | REV. | DATE | DESCRIPTION | DISIGN | CHKD | APP'D

# ELECTRICAL AND WIRING DIAGRAM

2

# ELECTRICAL AND WIRING DIAGRAM

# Cii97-81003-DIA-15

Centigrade Ind.Inc.

# DERALOK Hydropower Plant Construction Project (Pkg2)

# EMPLOYER:

# Regional Ministry of Electricity in Kurdistan

# CONTRACTOR: FARAB & Boland Payeh J.V

| DLK-D-FAB-10913-MEC-C-R06 | REV.:06
Contract No.: IQ-P15 (Pkg2) | H42-2-00-MA-P-20-DWG-113 | Page 2 of 3
Page | REV -0 | REV -1 | REV -2 | REV -3 | REV -4 | REV -5 | REV -6 | Page | REV - | REV - | REV - | REV - | REV - | REV -
1 | X | X | X | X | X | X | | 1
2 | X | X | X | X | X | X | | 2
3 | X | X | X | X | X | X | | 3
4 | X | X | X | X | X | X | X | 4
5 | X | X | X | X | X | X | X | 5
6 | X | X | X | X | X | X | | 6
7 | X | X | X | X | X | X | | 7
8 | X | X | X | X | X | X | X | 8
9 | X | X | X | X | X | X | | 9
10 | X | X | X | X | X | X | | 10
11 | X | X | X | X | X | X | X | 11
12 | X | X | X | X | X | X | | 12
13 | | | | | | | | 13
14 | | | | | | | | 14
15 | | | | | | | | 15
16 | | | | | | | | 16
17 | | | | | | | | 17
18 | | | | | | | | 18
19 | | | | | | | | 19
20 | | | | | | | | 20
21 | | | | | | | | 21
22 | | | | | | | | 22
23 | | | | | | | | 23
24 | | | | | | | | 24
25 | | | | | | | | 25
26 | | | | | | | | 26
27 | | | | | | | | 27
28 | | | | | | | | 28
29 | | | | | | | | 29
30 | | | | | | | | 30
31 | | | | | | | | 31
32 | | | | | | | | 32
33 | | | | | | | | 33
34 | | | | | | | | 34
35 | | | | | | | | 35

# Contents

3

CONTRACTOR: FARAB & Boland Payeh J.V | DERALOK Hydropower Plant Construction Project (Pkg2) | EMPLOYER: Regional Ministry of Electricity in Kurdistan

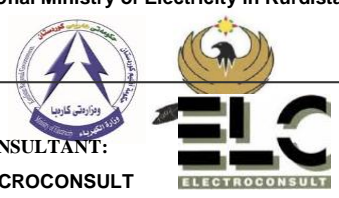
[picture p289: figure]

Centigrade Ind.Inc. | ELECTRICAL AND WIRING DIAGRAM | CONSULTANT: ELECROCONSULT
Cii97-81003-DIA-15 | DLK-D-FAB-10913-MEC-C-R06 | REV.:06
Contract No.: IQ-P15 (Pkg2) | H42-2-00-MA-P-20-DWG-113 | Page 3 of 3

# 1 Symbol Table | 4

# 2 Part List | 5

# 3 Power Circuit Diagram | 6

# 4 Cabinet Drawing & Control diagram | 7

# 5 PLC diagram Digital I/O | 8

# 6 PLC diagram Modul’s Analog I/O | 9

# 7 VFD wiring control | 10

# 8 PLC Output Relay | 11

# 9 HMI Power & modbus wiring | 12

MB

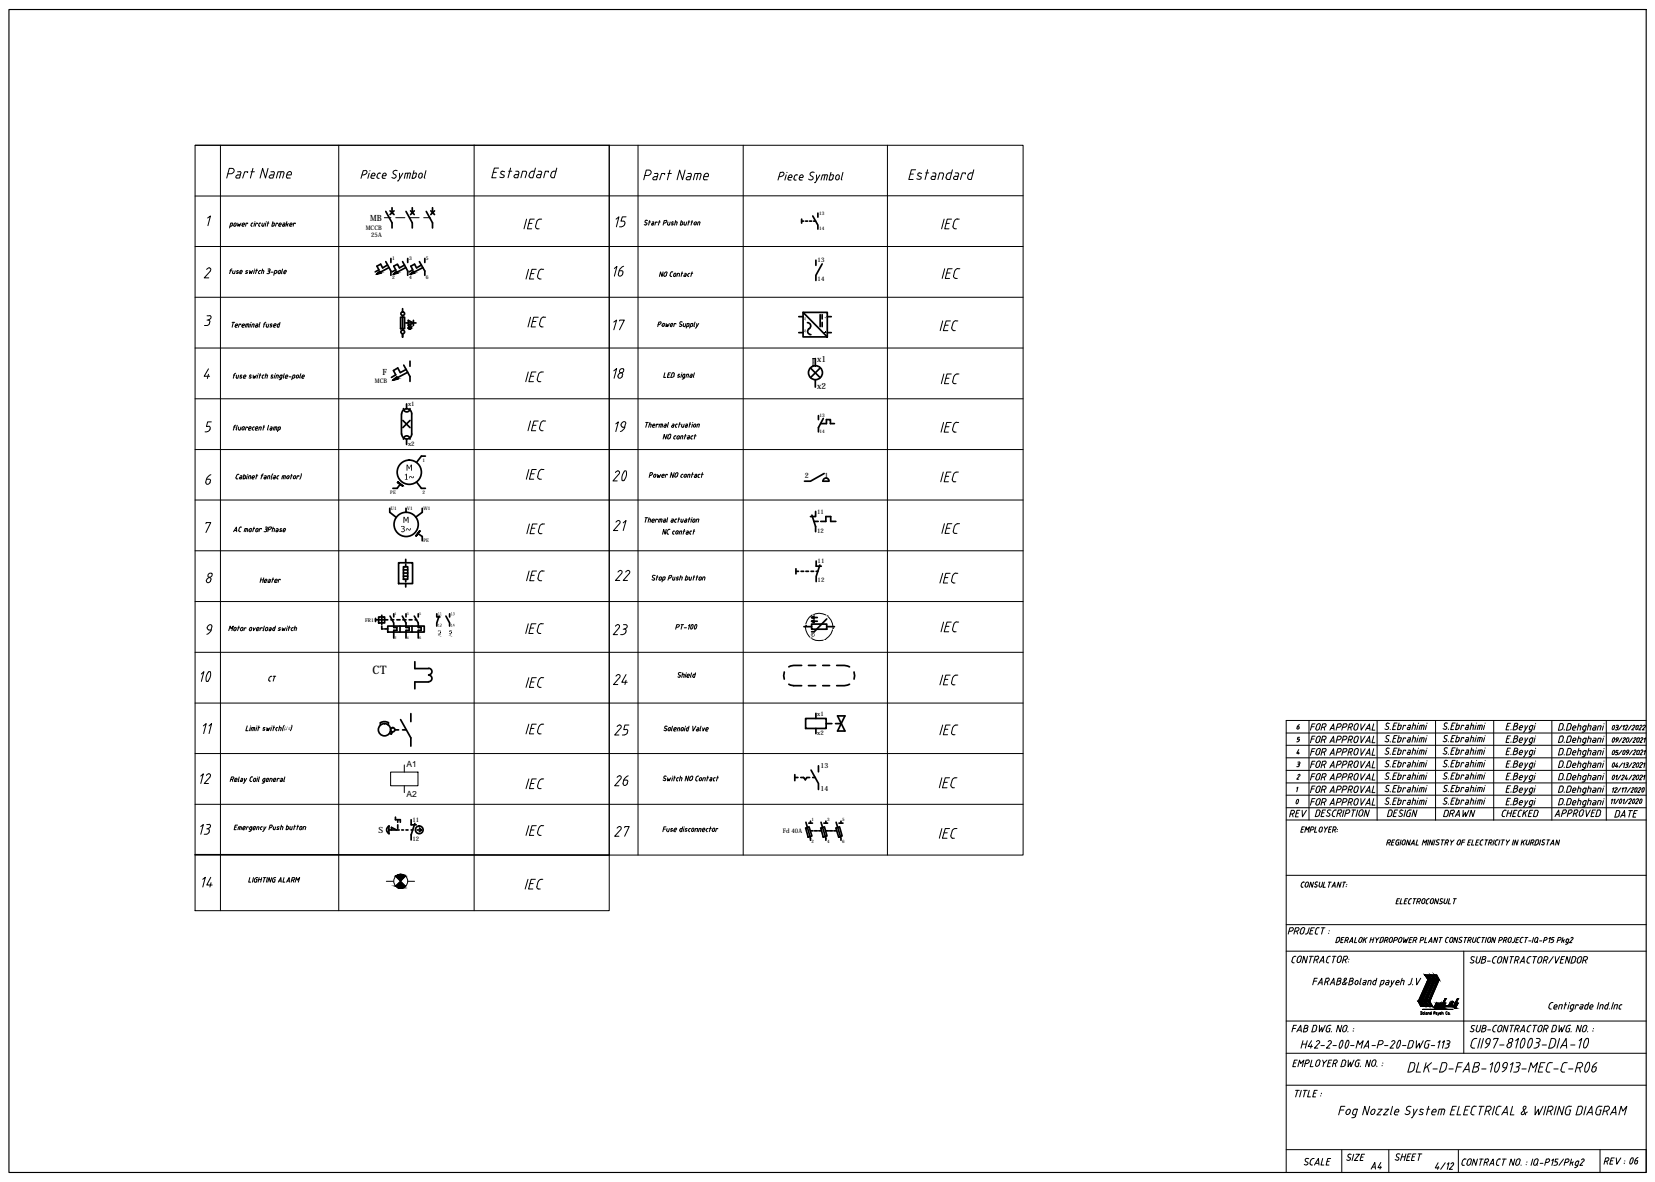
[picture p290: page 4]
56 F MCB; MCCB 25A

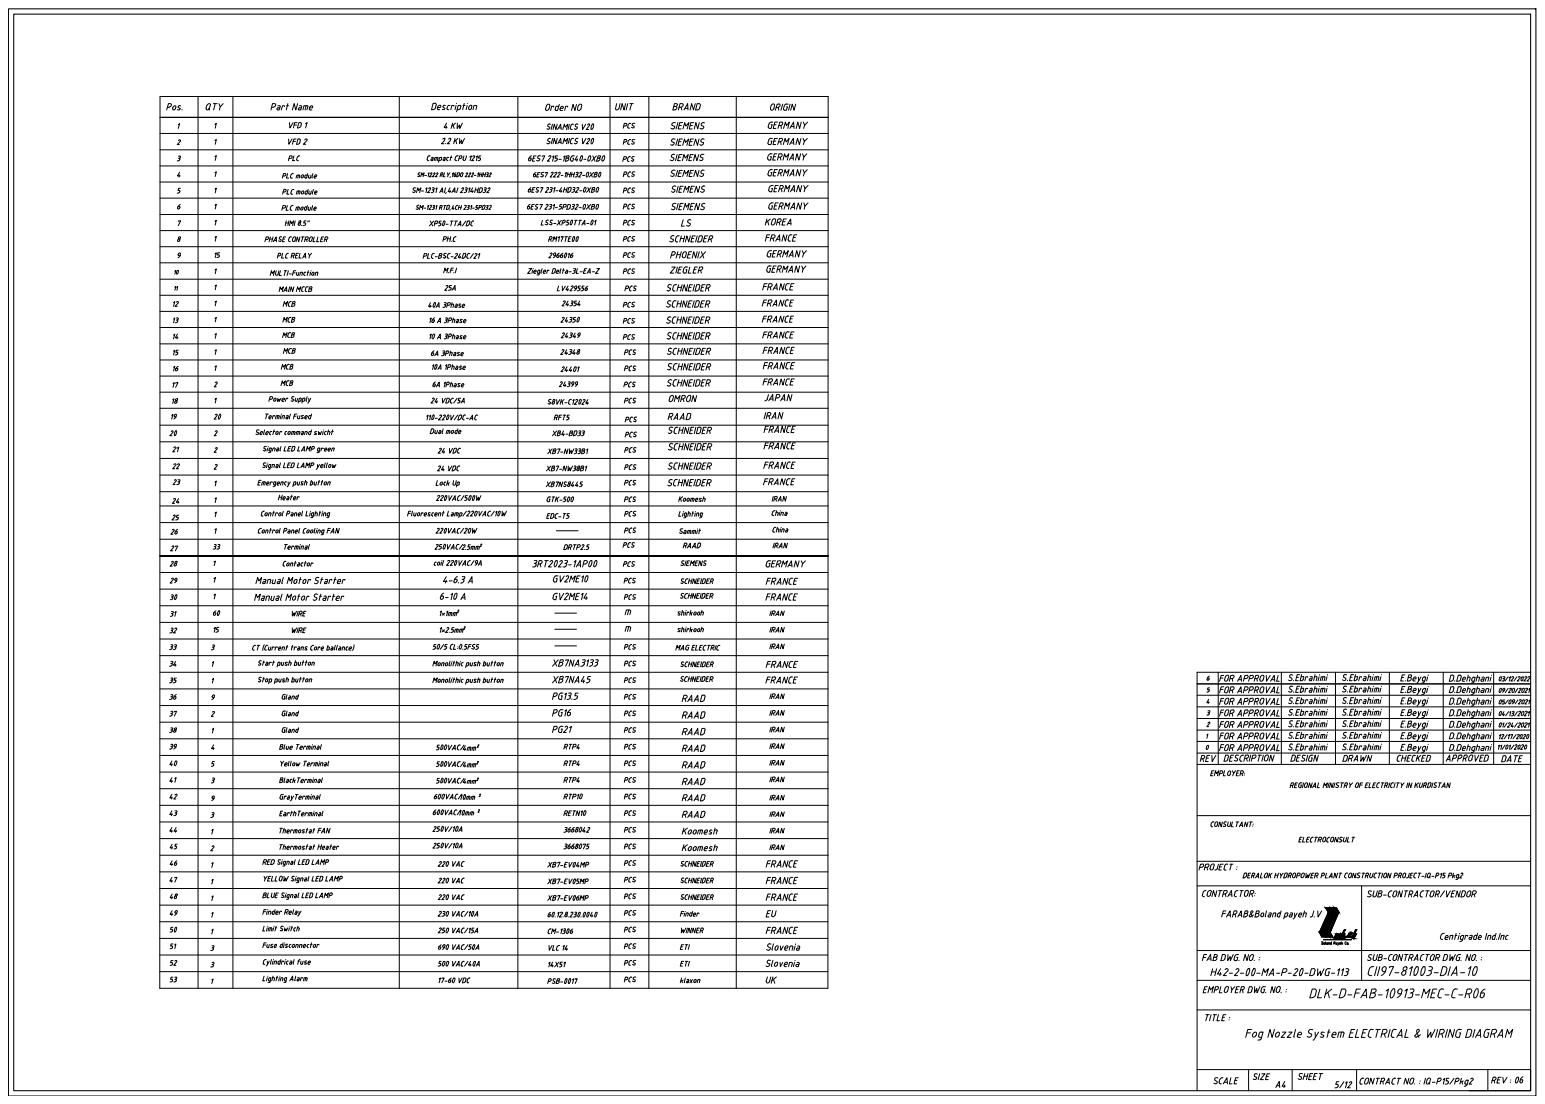
[picture p291: page 5]

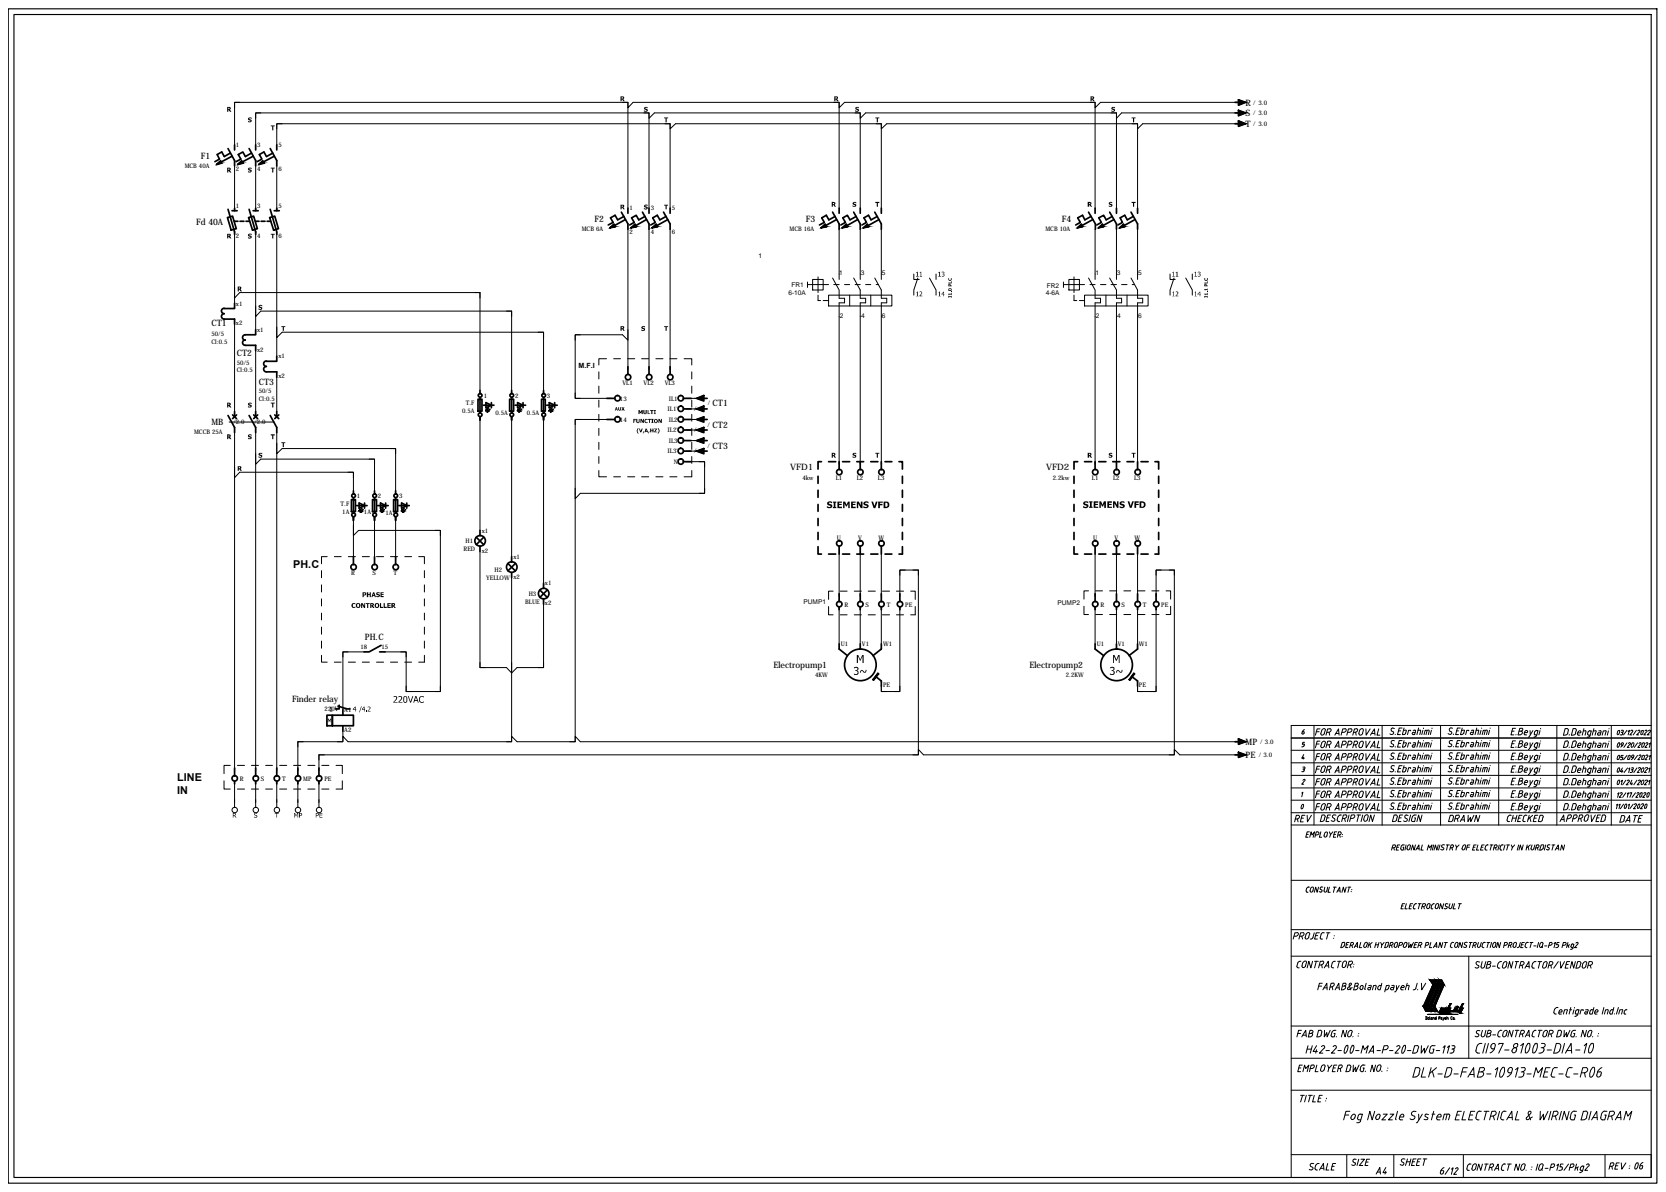
[picture p292: page 6]
x2 H3 BLUE; x2 H2 YELLOW; x2 H1 RED; VFD1; PE Electropump1; PE Electropump2; VFD2; 56 F1 MCB 40A; 56 F2 MCB 6A; MCCB 25A; Finder relay; F3 MCB 16A; F4 MCB 10A N 12; LINE IN; PUMP1; PUMP2

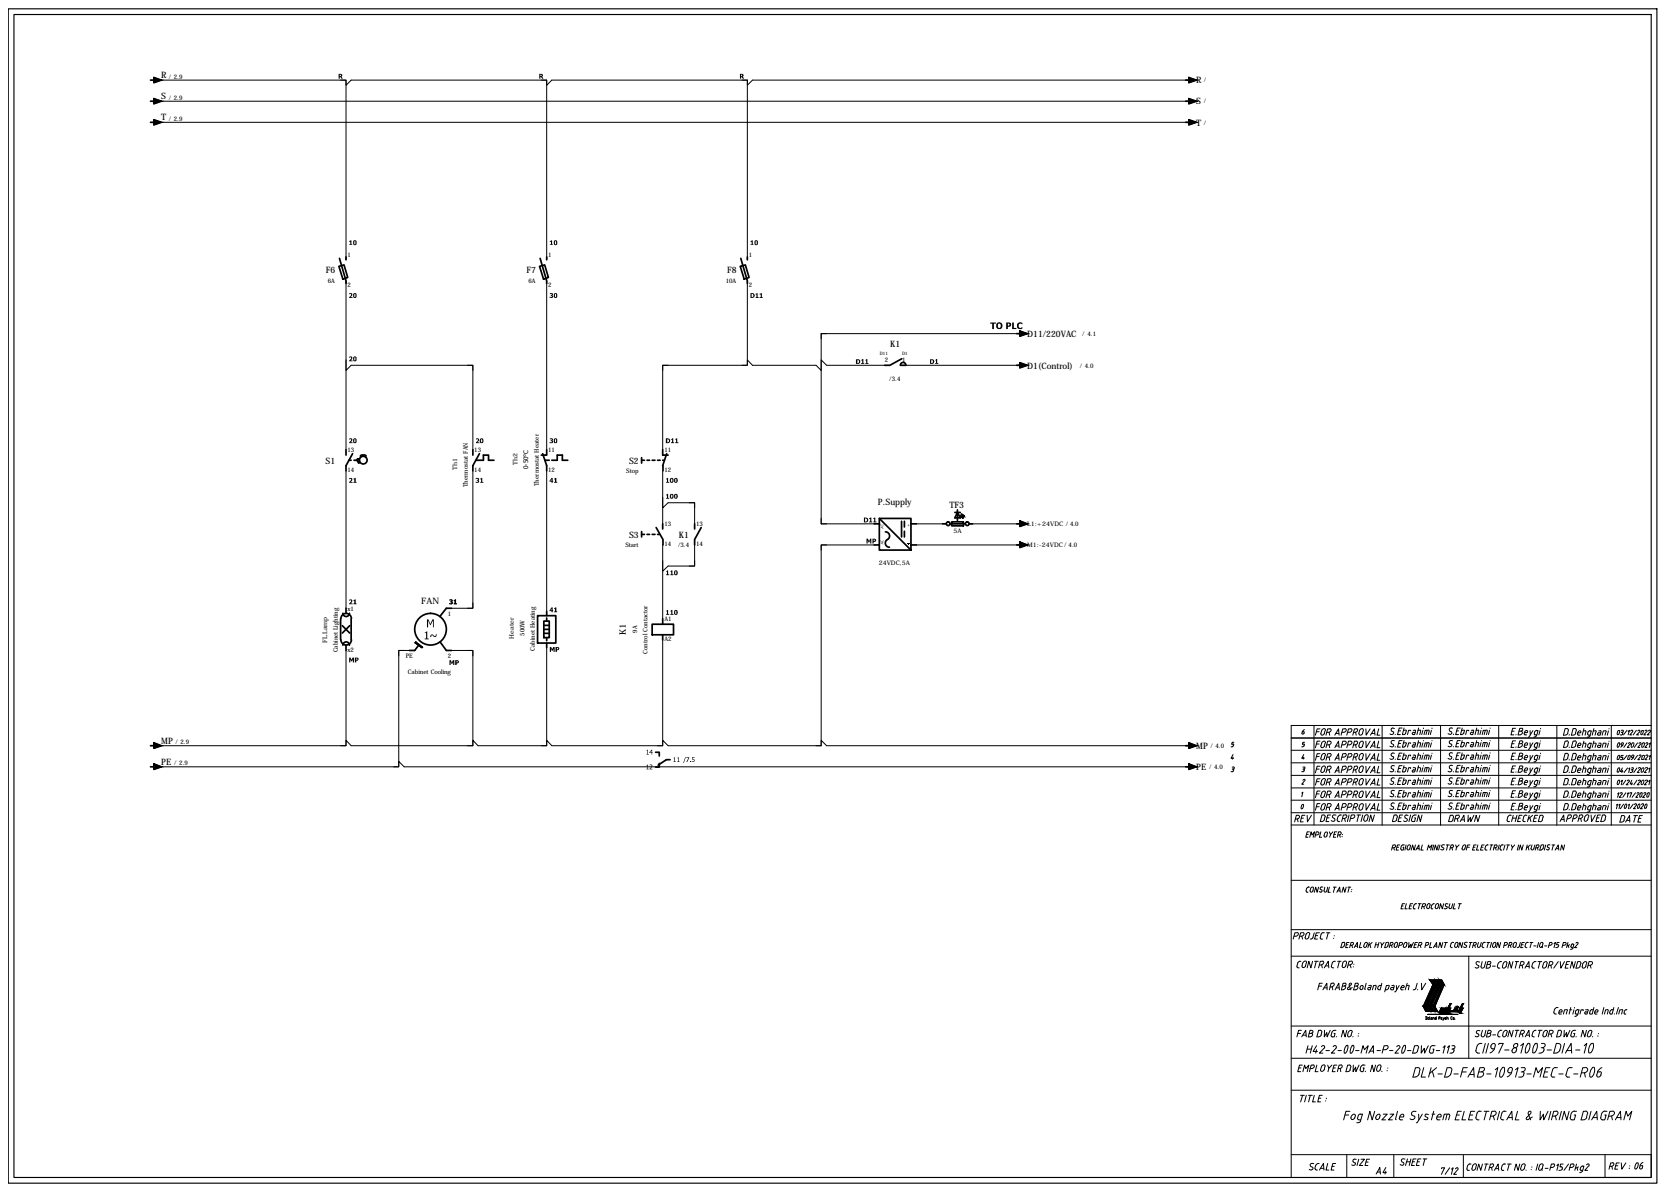
[picture p293: page 7]
FL.Lamp; Cabinet Lighting; 14 Thermostat FAN 1; FAN; Cabinet Cooling; 12 Th2 °& Thermostat Heater Heater; 500W Cabinet Heating; Stop; Start; A1A2 K19A Control Contactor; 24VDC,5A; P.Supply; M1:-24VDC / 4.0; L1:+24VDC / 4.0; D1(Control) / 4.0; D11/220VAC / 4.1

1 X12

3 X12

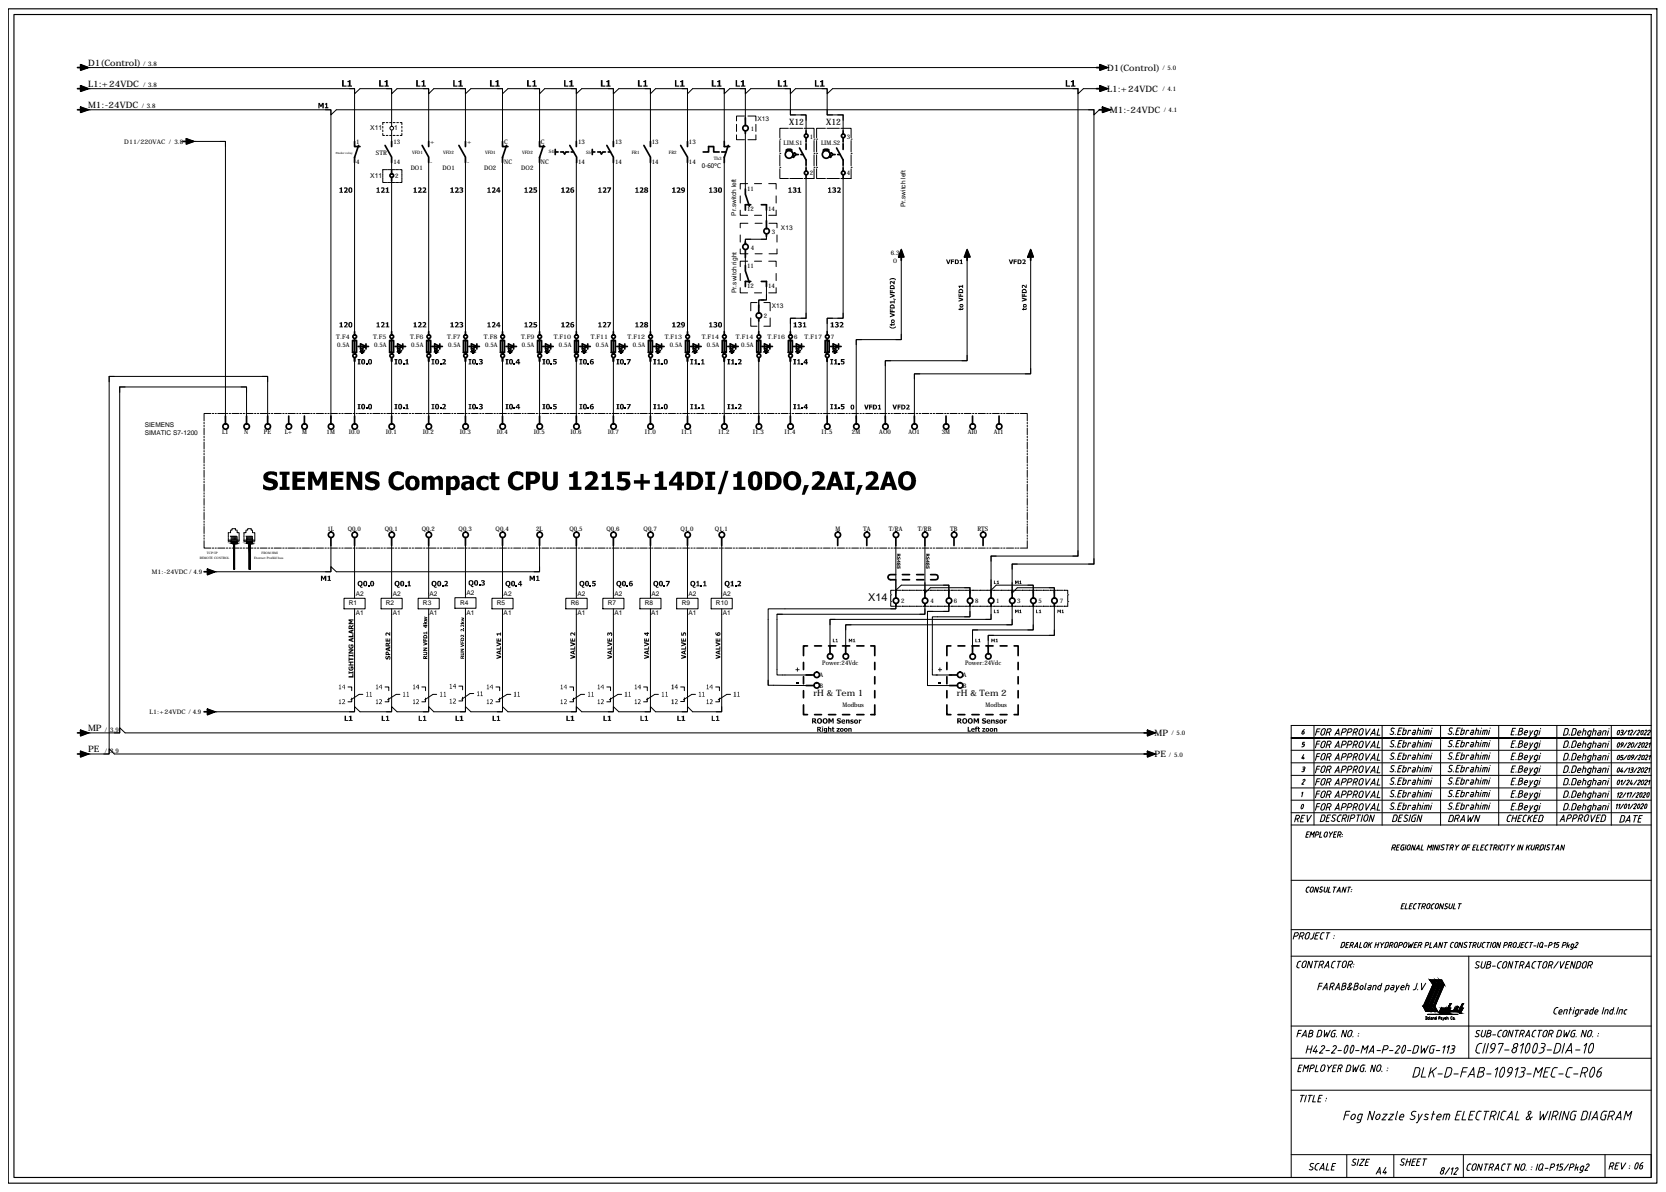
[picture p294: page 8]
14 STR; - VFD1 DO1; - VFD2 DO1; CNC; VFD1 DO2; VFD2 DO2; LIM.S1; LIM.S2; RTS; Finder relay; rH & Tem 1; Modbus; Power:24Vdc; D1(Control) / 3.8 L1:+24VDC / 3.8 M1:-24VDC / 3.8; D1(Control) / 5.0 L1:+24VDC / 4.1 M1:-24VDC / 4.1; D11/220VAC / 3.8; M1:-24VDC / 4.9; L1:+24VDC / 4.9; rH & Tem 2; SIEMENS; SIMATIC S7-1200; Pr.switch left Pr.switch left Pr.switch right

FROM HMI Eternet Profild bus TCP/IP REMOTE CONTROL

AI.2+ | AI.2- | AI.3+ | AI.3- speed Air | Transmitter
X15 | X15

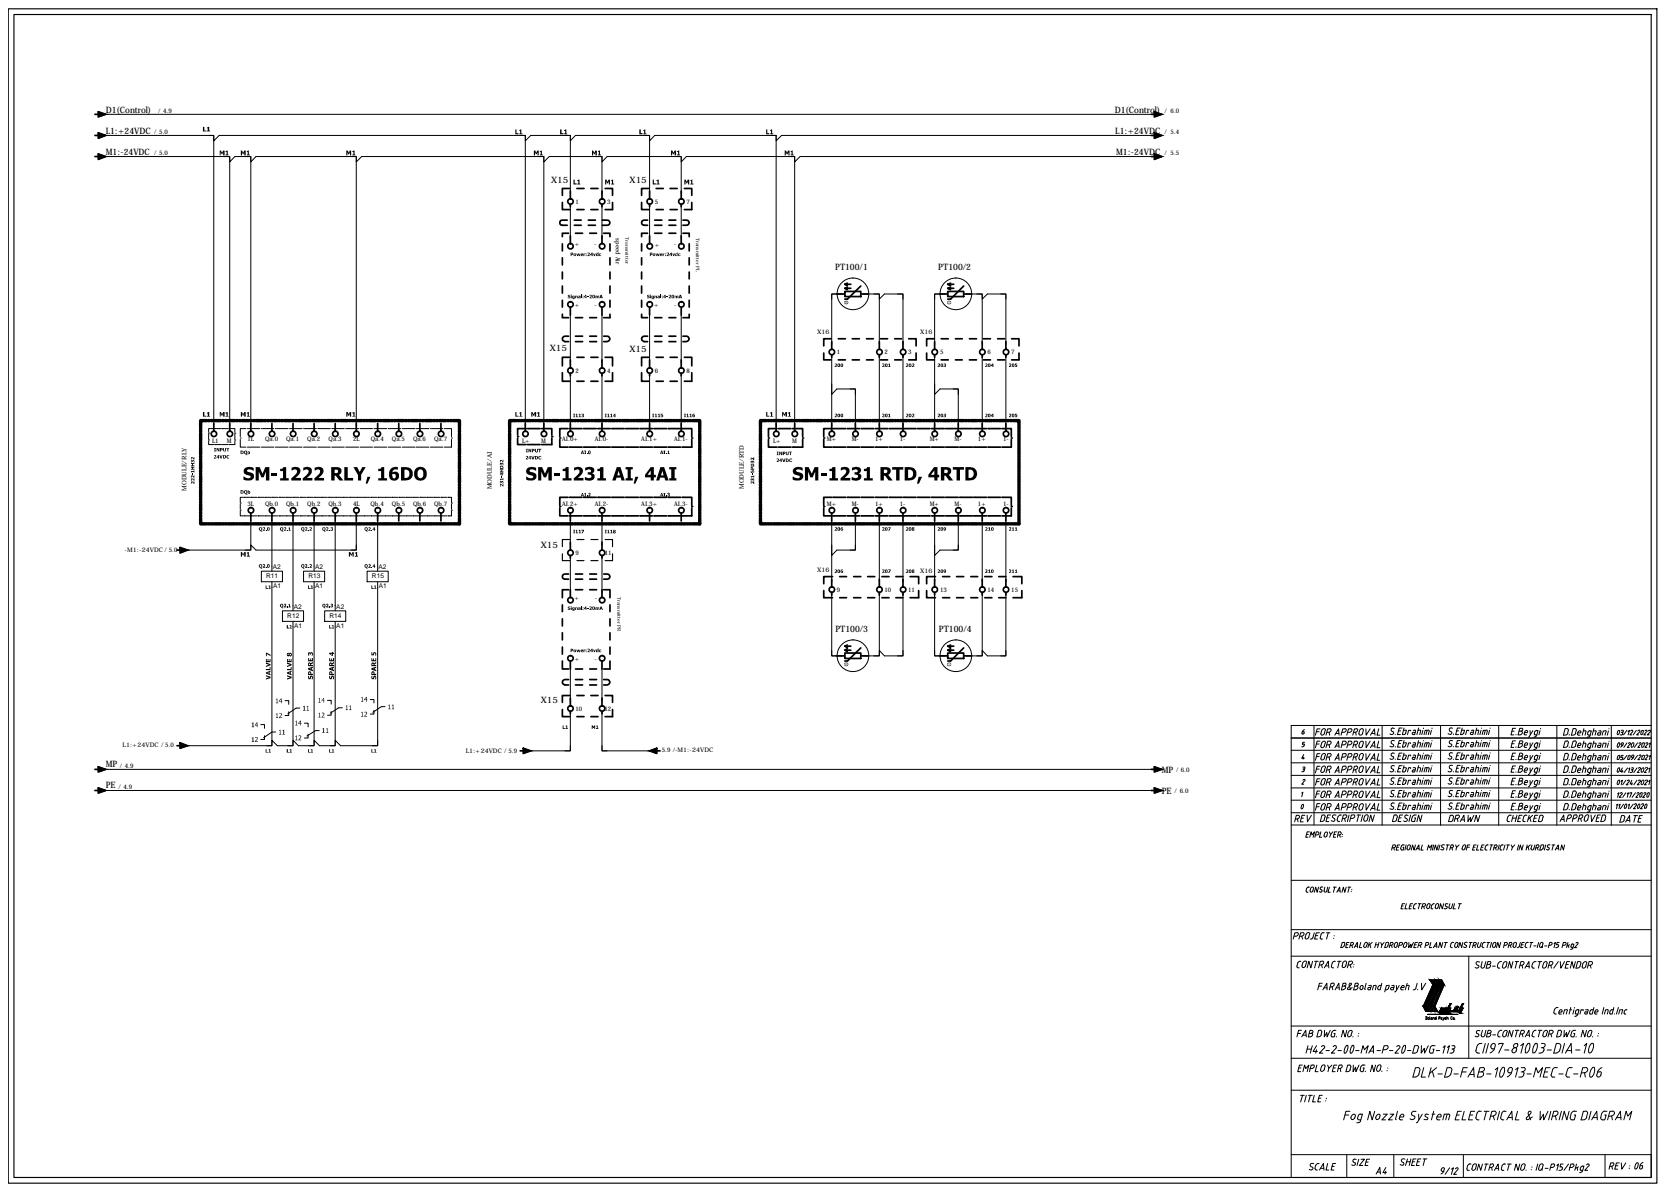
[picture p295: page 9]
MODULE/RLY; MODULE/AI; Transmitter PL; X15 Transmitter PR; MODULE/RTD; D1(Control) / 4.9; D1(Control) / 6.0 L1:+24VDC / 5.0; L1:+24VDC / 5.4 M1:-24VDC / 5.0; M1:-24VDC / 5.5; -M1:-24VDC / 5.0; L1:+24VDC / 5.0; L1:+24VDC / 5.9; 5.9 /-M1:-24VDC

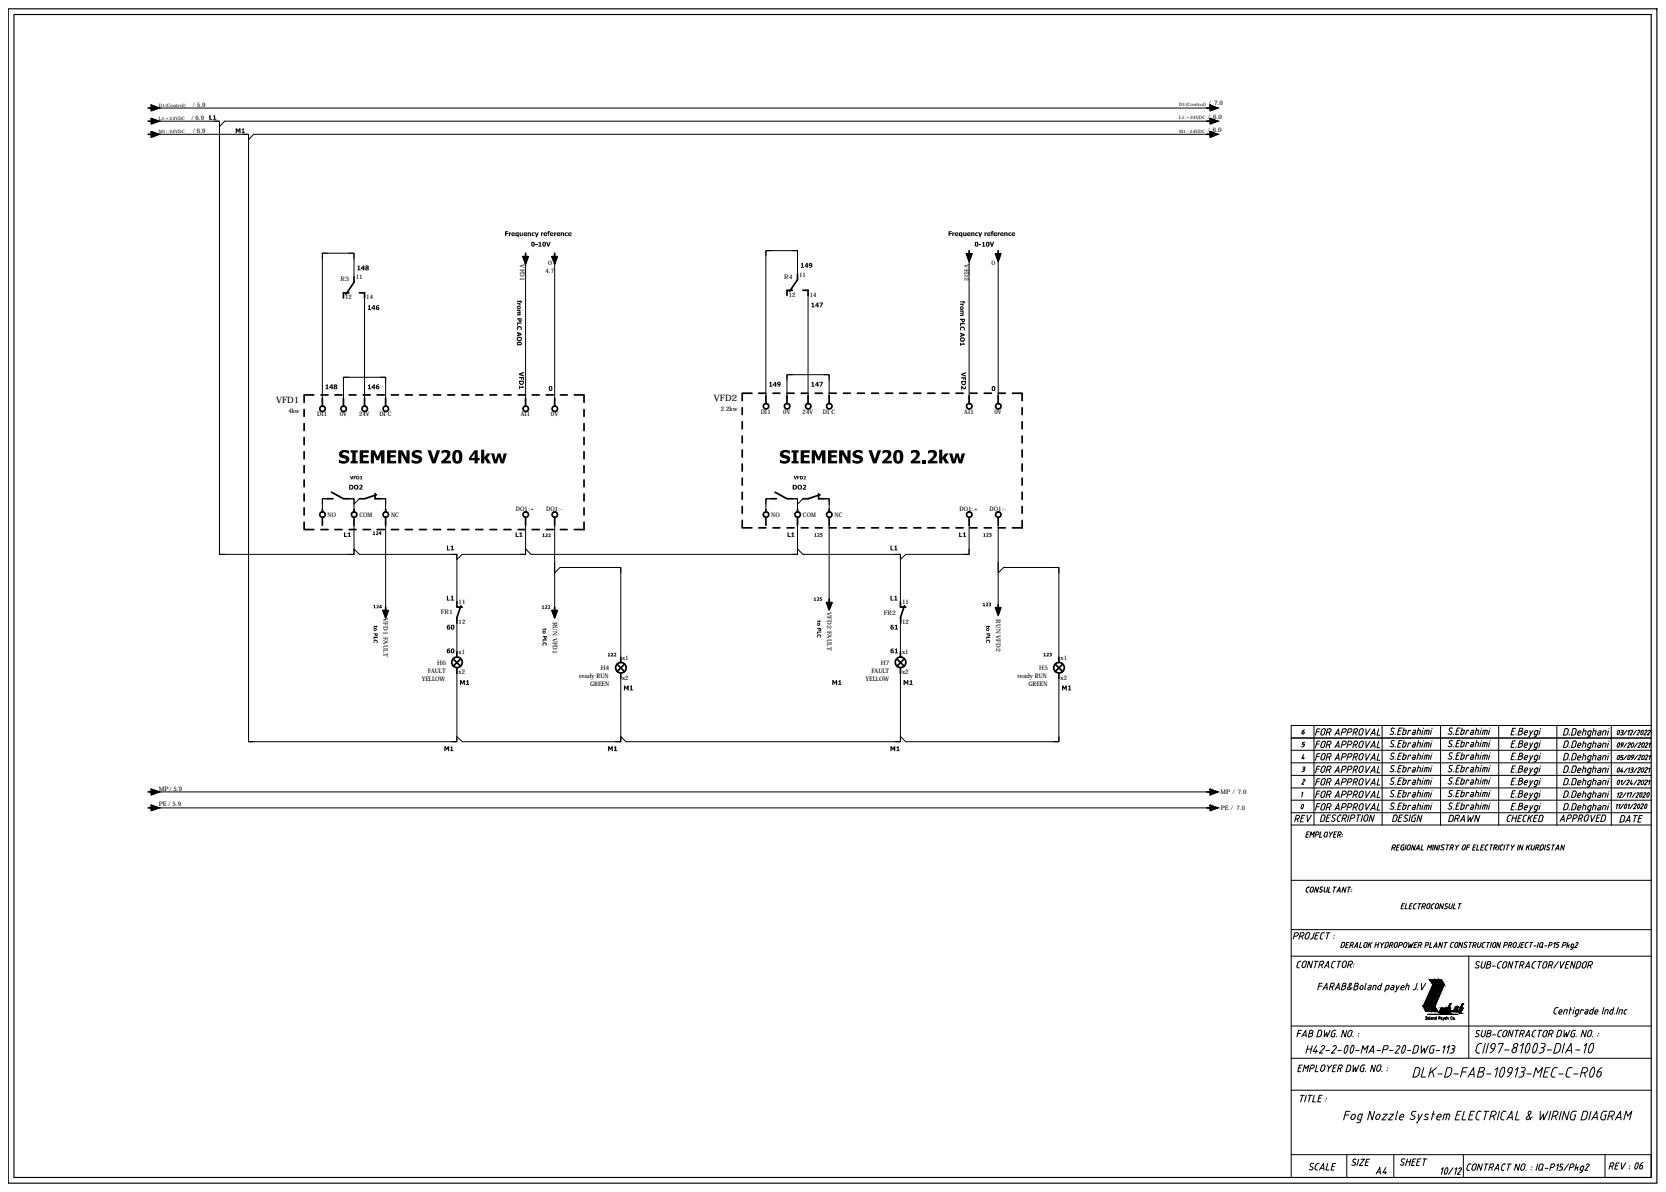
[picture p296: page 10]
VFD2; COM; x2 H4 ready RUN GREEN; x2 H5 ready RUN GREEN; x2 H6 FAULT YELLOW; x2 H7 FAULT YELLOW; D1(Control); L1:+24VDC; / 6.9 M1:-24VDC; D1(Control) / 7.0; L1:+24VDC / 6.0 M1:-24VDC / 6.0 VFD1 FAULT; MP / 7.0 PE / 7.0 VFD2 FAULT RUN VFD1; RUN VFD2; 4.7 VFD1; VFD1

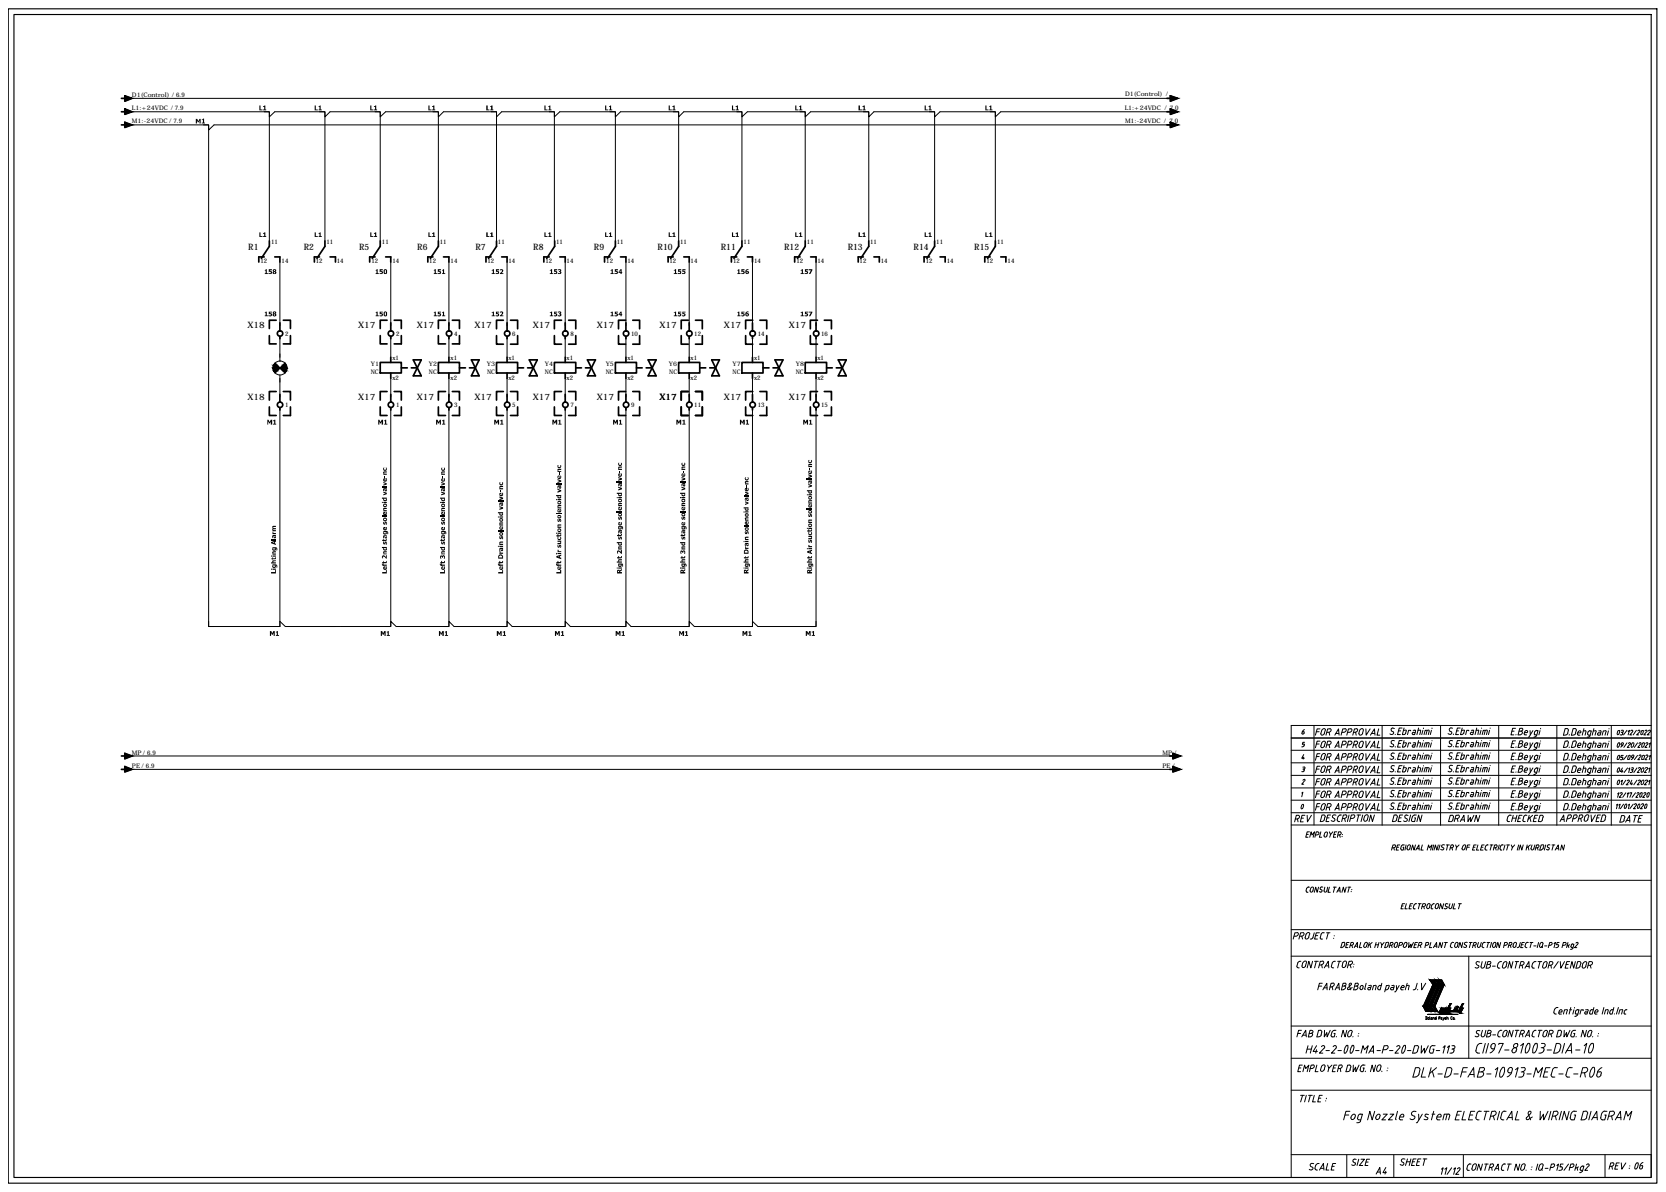
[picture p297: page 11]

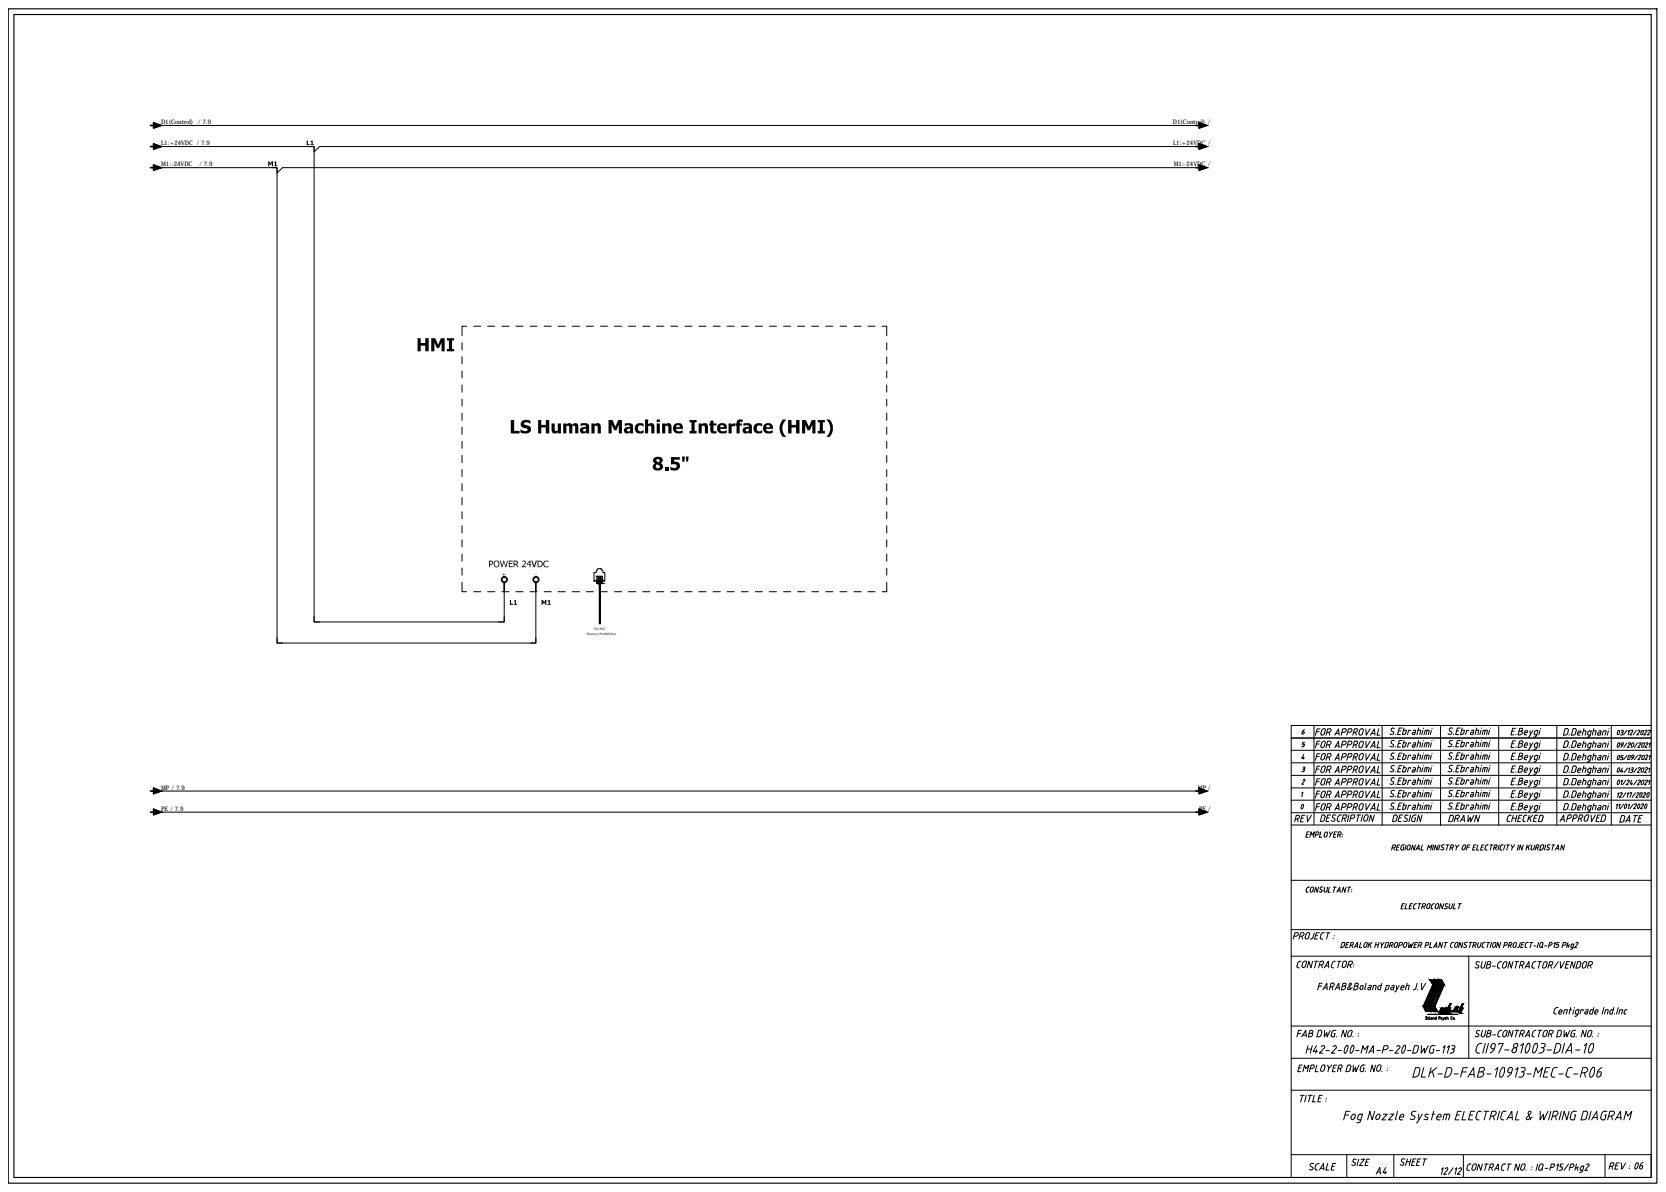
[picture p298: page 12]
D1(Control) / 7.9; L1:+24VDC / 7.9 M1:-24VDC / 7.9; D1(Control) /; L1:+24VDC / M1:-24VDC /

TO PLC
Eternet Profild bus
