koalium/centidocs/elec/plc/Wiring diagram/IO_LIST_ABAN-01-10-19.pdf

# (ABAN)

# IO LIST SYSTEM CONFIG PARAMETER SETTING

INPUT | SLOT
TEMP_OUT | I1=AI3 | 1 | 1
| I2=AI4 | 2
AC_CONTROL | I3 | 3
FDBK_DRV_SUP | I4 | 4
FDBK_DRV_RET | I5 | 5
| I6 | 6
TEMP_IN | I7=AI1 | 7
HUMID_IN | I8=AI2 | 8
FAULT_DRV_SUP | I9 | 9 | 2
FAULT_DRV_RET | I10 | 10
OUTPUT | SLOT
DRAIN_VALVE | Q1 | 1 | 1
FILLING_VALVE | Q2 | 2
DRV_SUP_RUN | Q3 | 3
DRV_RET_RUN | Q4 | 4
CIR_PUMP | Q5 | 5 | 2
WATER_HEATER_POWER | Q6 | 6
POWER_DAMPER | Q7 | 7
| Q8 | 8

SLOT 1 | SLOT 2 | SLOT 3 | SLOT 4
LOGO! 24 RCE 8 DI/4 DO | Digital module DM8 230R 4 DI/4 DO Relay | Analog output AM2 AQ EXPAN 2AQ 0-10V | Analog output AM2 AQ EXPAN 2AQ 0-10V
| | CH 0 :DRIVE SUP | CH 0 :DAMPER
| | CH 1 :DRIVE RET
