koalium/centidocs/elec/plc/Wiring diagram/IO_LIST_BEYHAGH-02-04-26.pdf

# (BEYHAGH NAKH)

# IO LIST SYSTEM CONFIG PARAMETER SETTING

INPUT | SLOT
AC_CONTROL | %I0.0 | 0 | 1
FDBK_SUPPLY_1 | %I0.1 | 1
FDBK_SUPPLY_2 | %I0.2 | 2
FDBK_RETURN_1 | %I0.3 | 3
FDBK_RETURN_2 | %I0.4 | 4
FDBK_PUMP_RUN | %I0.5 | 5
FDBK_DUST_FAN_1 | %I0.6 | 6
FDBK_DUST_FAN_2 | %I0.7 | 7
FDBK_DUST_FAN_3 | %I1.0 | 8
FDBK_DUST_FAN_4 | %I1.1 | 9
FDBK_ROTARY_1 | %I1.2 | 10
FDBK_ROTARY_2 | %I1.3 | 11
FDBK_JAROOB_1 | %I1.4 | 12
FDBK_JAROOB_2 | %I1.5 | 13
FDBK_POWER_DAMPER | %I2.0 | 14 | 2
FAULT_DRIVE | %I2.1 | 15
FAULT_FAN_SUPPLY_1 | %I2.2 | 16
FAULT_FAN_SUPPLY_2 | %I2.3 | 17
FAULT_FAN_RETURN_1 | %I2.4 | 18
FAULT_FAN_RETURN_2 | %I2.5 | 19
FAULT_DRV_MPCB | %I2.6 | 20
FAULT_DUST_FAN_1 | %I2.7 | 21
FAULT_DUST_FAN_2 | %I3.0 | 22 | 3
FAULT_DUST_FAN_3 | %I3.1 | 23
FAULT_DUST_FAN_4 | %I3.2 | 24
FAULT_ROTARY_1 | %I3.3 | 25
FAULT_ROTARY_2 | %I3.4 | 26
FAULT_JAROOB_1 | %I3.5 | 27
FAULT_JAROOB_2 | %I3.6 | 28
TERMOSTAT_ALARM | %I3.7 | 29
FIRE_ALARM | %I4.0 | 30
DOOR1 | %I4.1 | 31
DOOR2 | %I4.2 | 32
| %I4.3 | 33
| %I4.4 | 34
| %I4.5 | 35
| %I4.6 | 36
| %I4.7 | 37
OUTPUT | | | SLOT
FAN_SUPPLY_1_k1 | %Q0.0 | 0 | 1
FAN_SUPPLY_1_kB1 | %Q0.1 | 1
FAN_SUPPLY_2_K2 | %Q0.2 | 2
FAN_SUPPLY_2_kB2 | %Q0.3 | 3
FAN_RETURN_1_K3 | %Q0.4 | 4
FAN_RETURN_1_Kb3 | %Q0.5 | 5
FAN_RETURN_2_K4 | %Q0.6 | 6
FAN_RETURN_2_kB4 | %Q0.7 | 7
DRIVE_RUN | %Q1.0 | 8
PUMP_RUN | %Q1.1 | 9
DUST_FAN_1 | %Q2.0 | 10 | 3
DUST_FAN_2 | %Q2.1 | 11
DUST_FAN_3 | %Q2.2 | 12
DUST_FAN_4 | %Q2.3 | 13
ROTARY1 | %Q2.4 | 14
ROTARY2 | %Q2.5 | 15
JAROOB1 | %Q2.6 | 16
JAROOB2 | %Q2.7 | 17
DAMPER_POWER | %Q3.0 | 18
STEAM_VALVE_POWER | %Q3.1 | 19
| %Q3.2 | 20
| %Q3.3 | 21
| %Q3.4 | 22
| %Q3.5 | 23
| %Q3.6 | 24
| %Q3.7 | 25

SLOT 1 | SLOT 2 | SLOT 3 | SLOT 4
CPU 1214C AC/DC/Rly | SM 1221 DI8 x 24VDC | SM 1223 DI16/DQ16 x relay | SM 1232 AQ2

## CH 0 :STEAM VALVE CH 1 :FRESH DAMPER
