koalium/centidocs/elec/plc/Wiring diagram/IO_LIST_MAHBAD_AC6-02-09-27.pdf

# (MAHBAD MILAN AC6)

# IO LIST SYSTEM CONFIG

INPUT | SLOT
AC_CONTROL | | 0
FDBK_SUPPLY_1 | | 1
FDBK_SUPPLY_2 | | 2
FDBK_RETURN_1 | | 3
FDBK_PUMP_RUN | | 4
FDBK_DUST_FAN_1 | | 5
FDBK_DUST_FAN_2 | | 6
FDBK_ROTARY_1 | | 7
FDBK_JAROOB_1 | | 8
FDBK_POWER_DAMPER | | 9
FAULT_DRIVE | | 10
FAULT_FAN_SUPPLY_1 | | 11
FAULT_FAN_SUPPLY_2 | | 12
FAULT_FAN_RETURN_1 | | 13
FAULT_DRV_MPCB | | 14
TERMOSTAT_ALARM | | 15
FIRE_ALARM | | 16
DOOR1 | | 17
DOOR2 | | 18
| | 19
| | 20
| | 21
OUTPUT | | | SLOT
FAN_SUPPLY_1_k1 | | 0
FAN_SUPPLY_1_Kb1 | | 1
FAN_SUPPLY_2_K2 | | 2
FAN_SUPPLY_2_Kb2 | | 3
FAN_RETURN_1_K3 | | 4
FAN_RETURN_1_Kb3 | | 5
DRIVE_RUN | | 6
PUMP_RUN | | 7
DUST_FAN_1 | | 8
DUST_FAN_2 | | 9
ROTARY_1 | | 10
JAROOB_1 | | 11
DAMPER_POWER | | 12
| | 13
| | 14
| | 15
| | 16
| | 17

13

12

SLOT 1 | SLOT 2 | SLOT 3 | SLOT 4 | SLOT 5
CPU 1214C AC/DC/Rly | SM 1221 DI8 x 24VDC | SM 1222 DQ8 x 24VDC | SM 1231 AI8 | SM 1232 AQ4
| | | CH 0 :TEMP_IN1 | CH 0 :DRIVE_FRQ
| | | CH 1 :HUMID_IN1 | CH 1 :FRESH_DAMP
| | | CH 2 :TEMP_IN2 | CH 2 :AIRWASH_DAMP1
| | | CH 3 :HUMID_IN2 | CH 3 :AIRWASH_DAMP2
| | | CH 4 :TEMP_OUT
CH 5 :HUMID_OUT
CH 6 :
CH 7 :
