koalium/centidocs/elec/plc/Wiring diagram/IO_LIST_MAHESTAN-02-10-12.pdf

# (ARIYA MAHESTAN)

# IO LIST SYSTEM CONFIG PARAMETER SETTING

INPUT | SLOT
AC_CONTROL | %I0.0 | 0 | 1
FDBK_SUPPLY_1 | %I0.1 | 1
FDBK_SUPPLY_2 | %I0.2 | 2
FDBK_RETURN_1 | %I0.3 | 3
FDBK_RETURN_2 | %I0.4 | 4
FDBK_PUMP_RUN | %I0.5 | 5
FDBK_DAMPER_POWER | %I0.6 | 6
FAULT_DRIVE | %I0.7 | 7
FAULT_FAN_SUPPLY_1 | %I1.0 | 8
FAULT_FAN_SUPPLY_2 | %I1.1 | 9
FAULT_FAN_RETURN_1 | %I1.2 | 10
FAULT_FAN_RETURN_2 | %I1.3 | 11
FAULT_DRV_MPCB | %I1.4 | 12
TERMOSTAT_ALARM | %I1.5 | 13
FIRE_ALARM | %I2.0 | 14 | 2
DOOR1 | %I2.1 | 15
DOOR2 | %I2.2 | 16
| %I2.3 | 17
| %I2.4 | 18
| %I2.5 | 19
| %I2.6 | 20
| %I2.7 | 21
| %I3.0 | 22
| %I3.1 | 23
| %I3.2 | 24
| %I3.3 | 25
| %I3.4 | 26
| %I3.5 | 27
| %I3.6 | 28
| %I3.7 | 29
OUTPUT | | | SLOT
FAN_SUPPLY_1_k1 | %Q0.0 | 0 | 1
FAN_SUPPLY_1_kB1 | %Q0.1 | 1
FAN_SUPPLY_2_K2 | %Q0.2 | 2
FAN_SUPPLY_2_kB2 | %Q0.3 | 3
FAN_RETURN_1_K3 | %Q0.4 | 4
FAN_RETURN_1_kB3 | %Q0.5 | 5
FAN_RETURN_2_K4 | %Q0.6 | 6
FAN_RETURN_2_kB4 | %Q0.7 | 7
DRIVE_RUN | %Q1.0 | 8
PUMP_RUN | %Q1.1 | 9
DAMPER_POWER | %Q2.0 | 10 | 2
STEAM_VALVE_POWER | %Q2.1 | 11
| %Q2.2 | 12
| %Q2.3 | 13
| %Q2.4 | 14
| %Q2.5 | 15
| %Q2.6 | 16
| %Q2.7 | 17
| %Q3.0 | 18
| %Q3.1 | 19
| %Q3.2 | 20
| %Q3.3 | 21
| %Q3.4 | 22
| %Q3.5 | 23
| %Q3.6 | 24
| %Q3.7 | 25

SLOT 1 | SLOT 2 | SLOT 3 | SLOT 4
CPU 1214C AC/DC/Rly | SM 1223 DI16/DQ16 x relay | SM 1231 AI4 | SM 1232 AQ4
| | CH 0 :TEMP IN | CH 0 :DRIVE FREQ
| | CH 1 :HUMID IN | CH 1 :FRESH DAMPER
| | CH 2 :TEMP OUT | CH 2 :STEAM VALVE
| | CH 3 :HUMID OUT | CH 3 :

DRV-06 | Command source | 1
DRV-07 | Frequency reference source | 2
DRV-03 | Acceleration time | 15 S
DRV-04 | Deceleration time | 2 S
ADV-07 | Start Mode | 1
ADV-08 | Stop Mode | 1
ADV-12 | DC braking time at startup | 3S
OUT-32 | RELAY 2 | 14

### LS H100 PARAMETER
