koalium/centidocs/elec/plc/Wiring diagram/10193-Serjin/AC-10.pdf

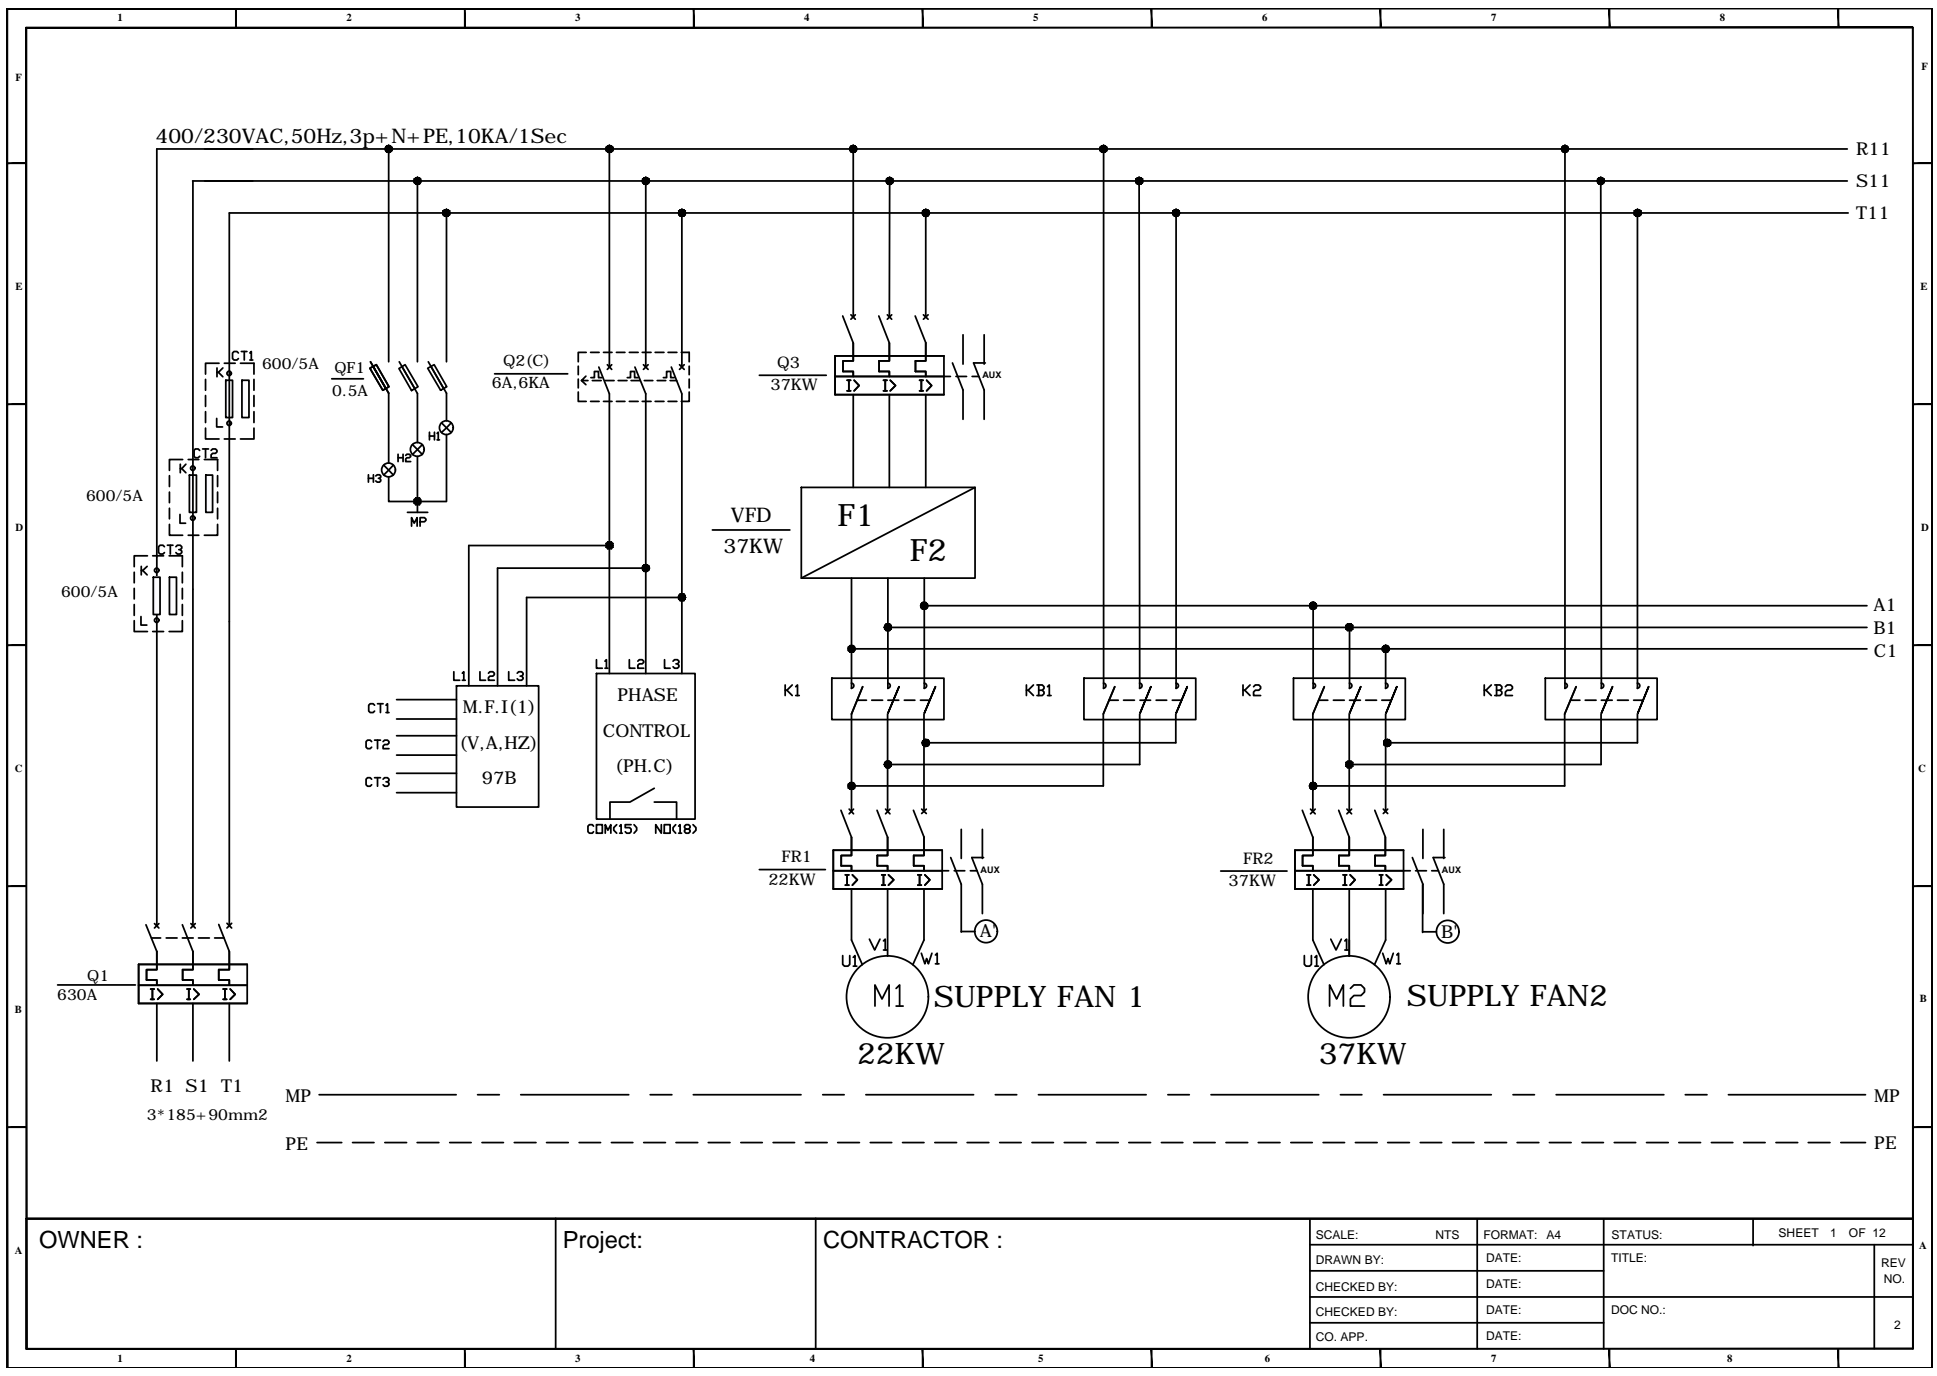
[picture p299: page 1]
FEACBD CAB; 8 OWNER :; CONTRACTOR :; REV SHEET; OF 12 TITLE: SCALE: CHECKED BY: DRAWN BY: CO. APP. CHECKED BY:; FORMAT:; STATUS:; NO. DOC NO.: NTS; 2 DATE: DATE: DATE: DATE: Project: Q1; PEMP 400/230VAC,50Hz,3p+N+PE,10KA/1Sec 3*185+90mm2; PHASE CONTROL (PH.C); AUX Q3 37KW F1 F2 VFD 37KW; A1B1C1 37KW AUX FR1 22KW; AUX FR2 37KW SUPPLY FAN 1; SUPPLY FAN2 A'

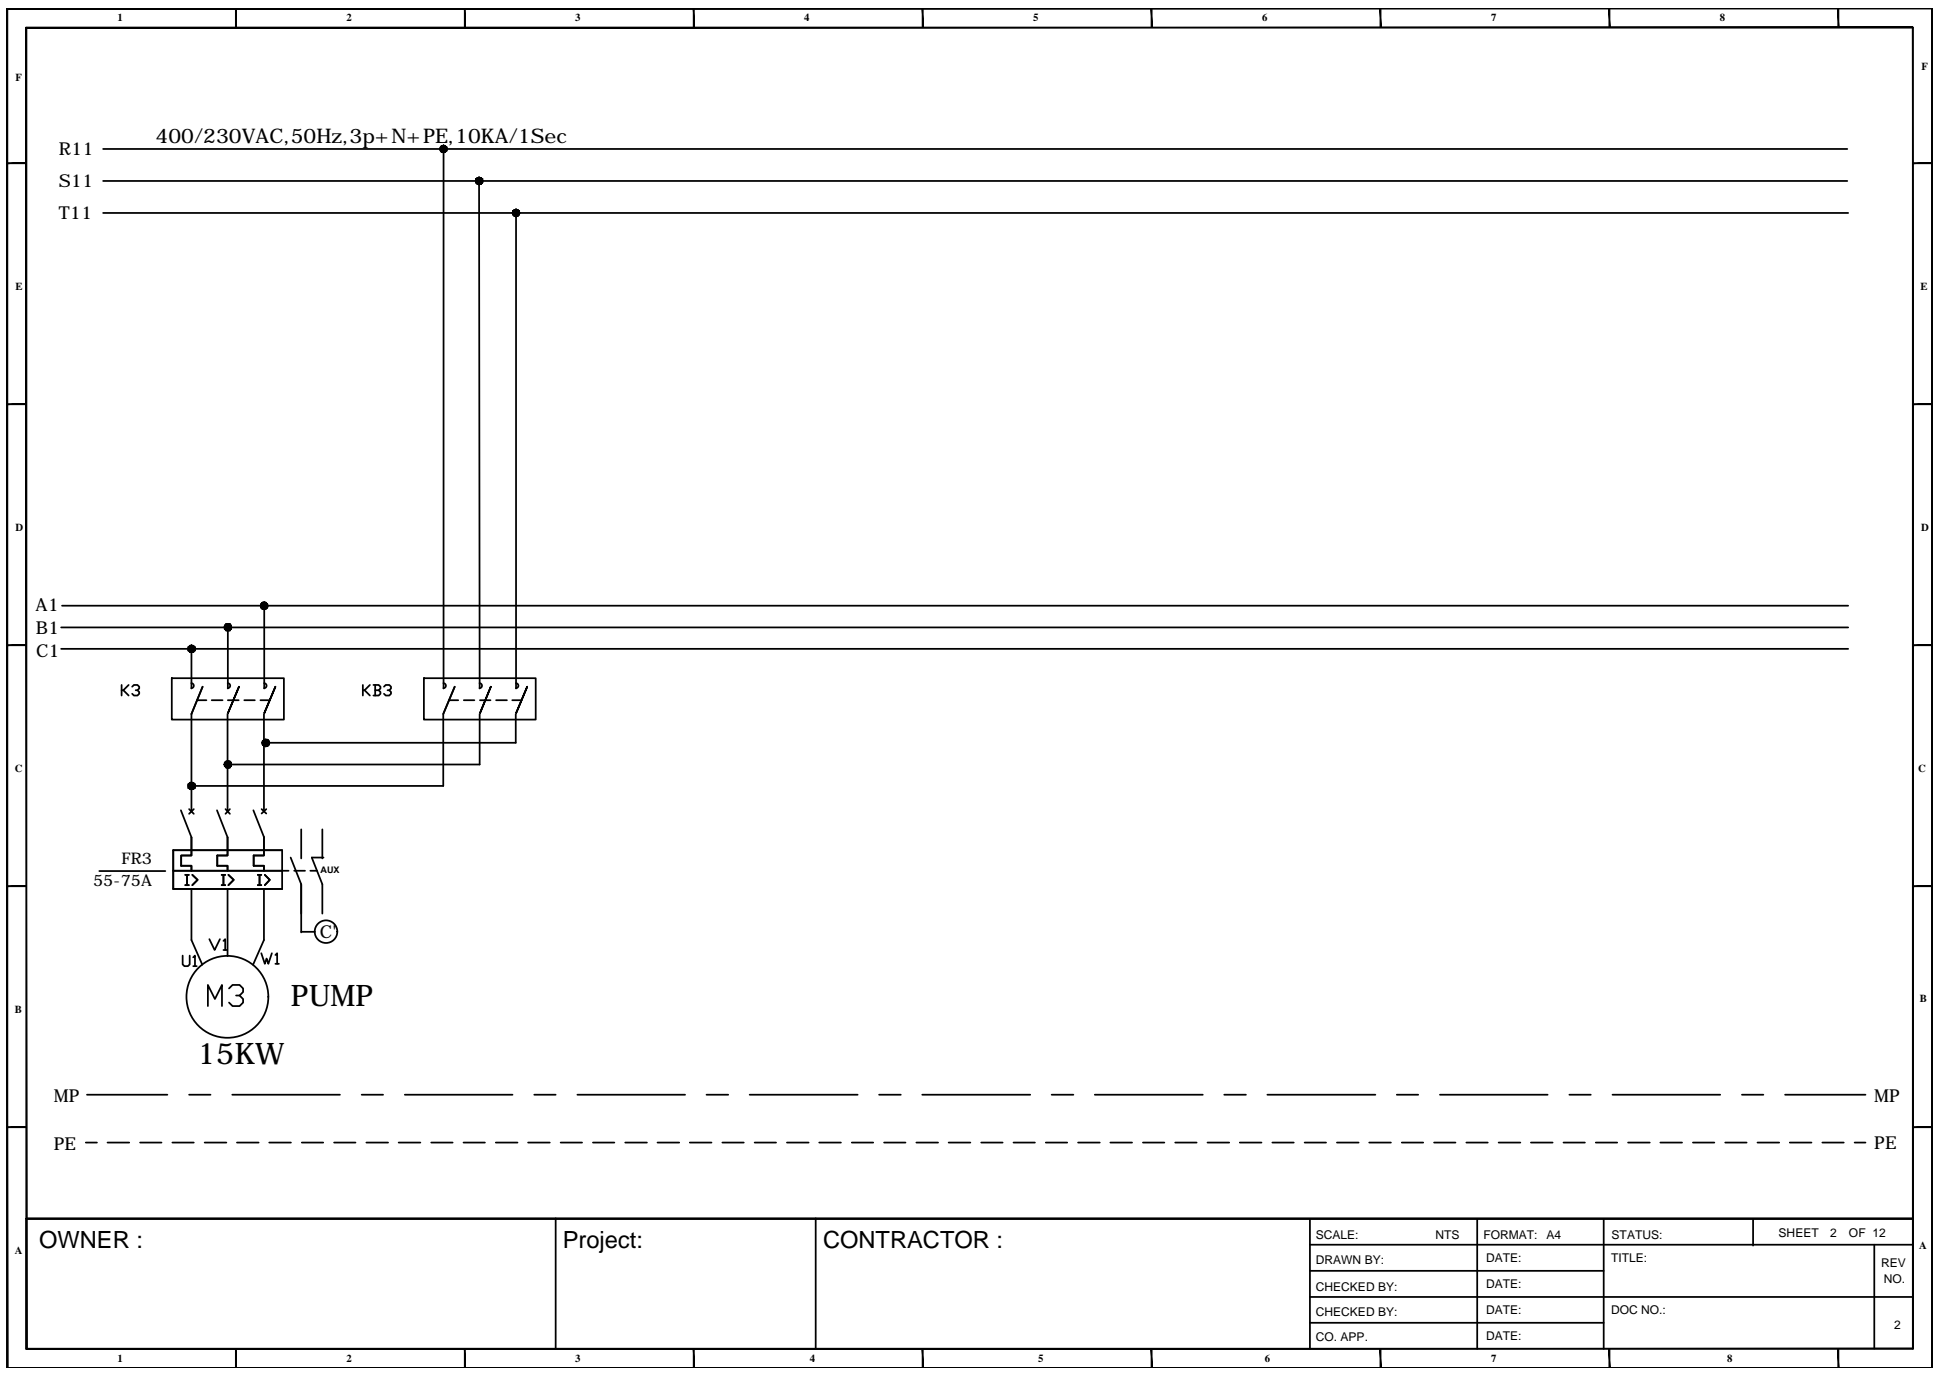
[picture p300: page 2]
FEACBD CAB; 8 OWNER :; CONTRACTOR :; REV SHEET; OF 12 TITLE: SCALE: CHECKED BY: DRAWN BY: CO. APP. CHECKED BY:; FORMAT:; STATUS:; NO. DOC NO.: NTS; 2 DATE: DATE: DATE: DATE: Project: MP PE; PEMP 400/230VAC,50Hz,3p+N+PE,10KA/1Sec 15KW AUX R11 S11 T11 A1B1C1; PUMP C'

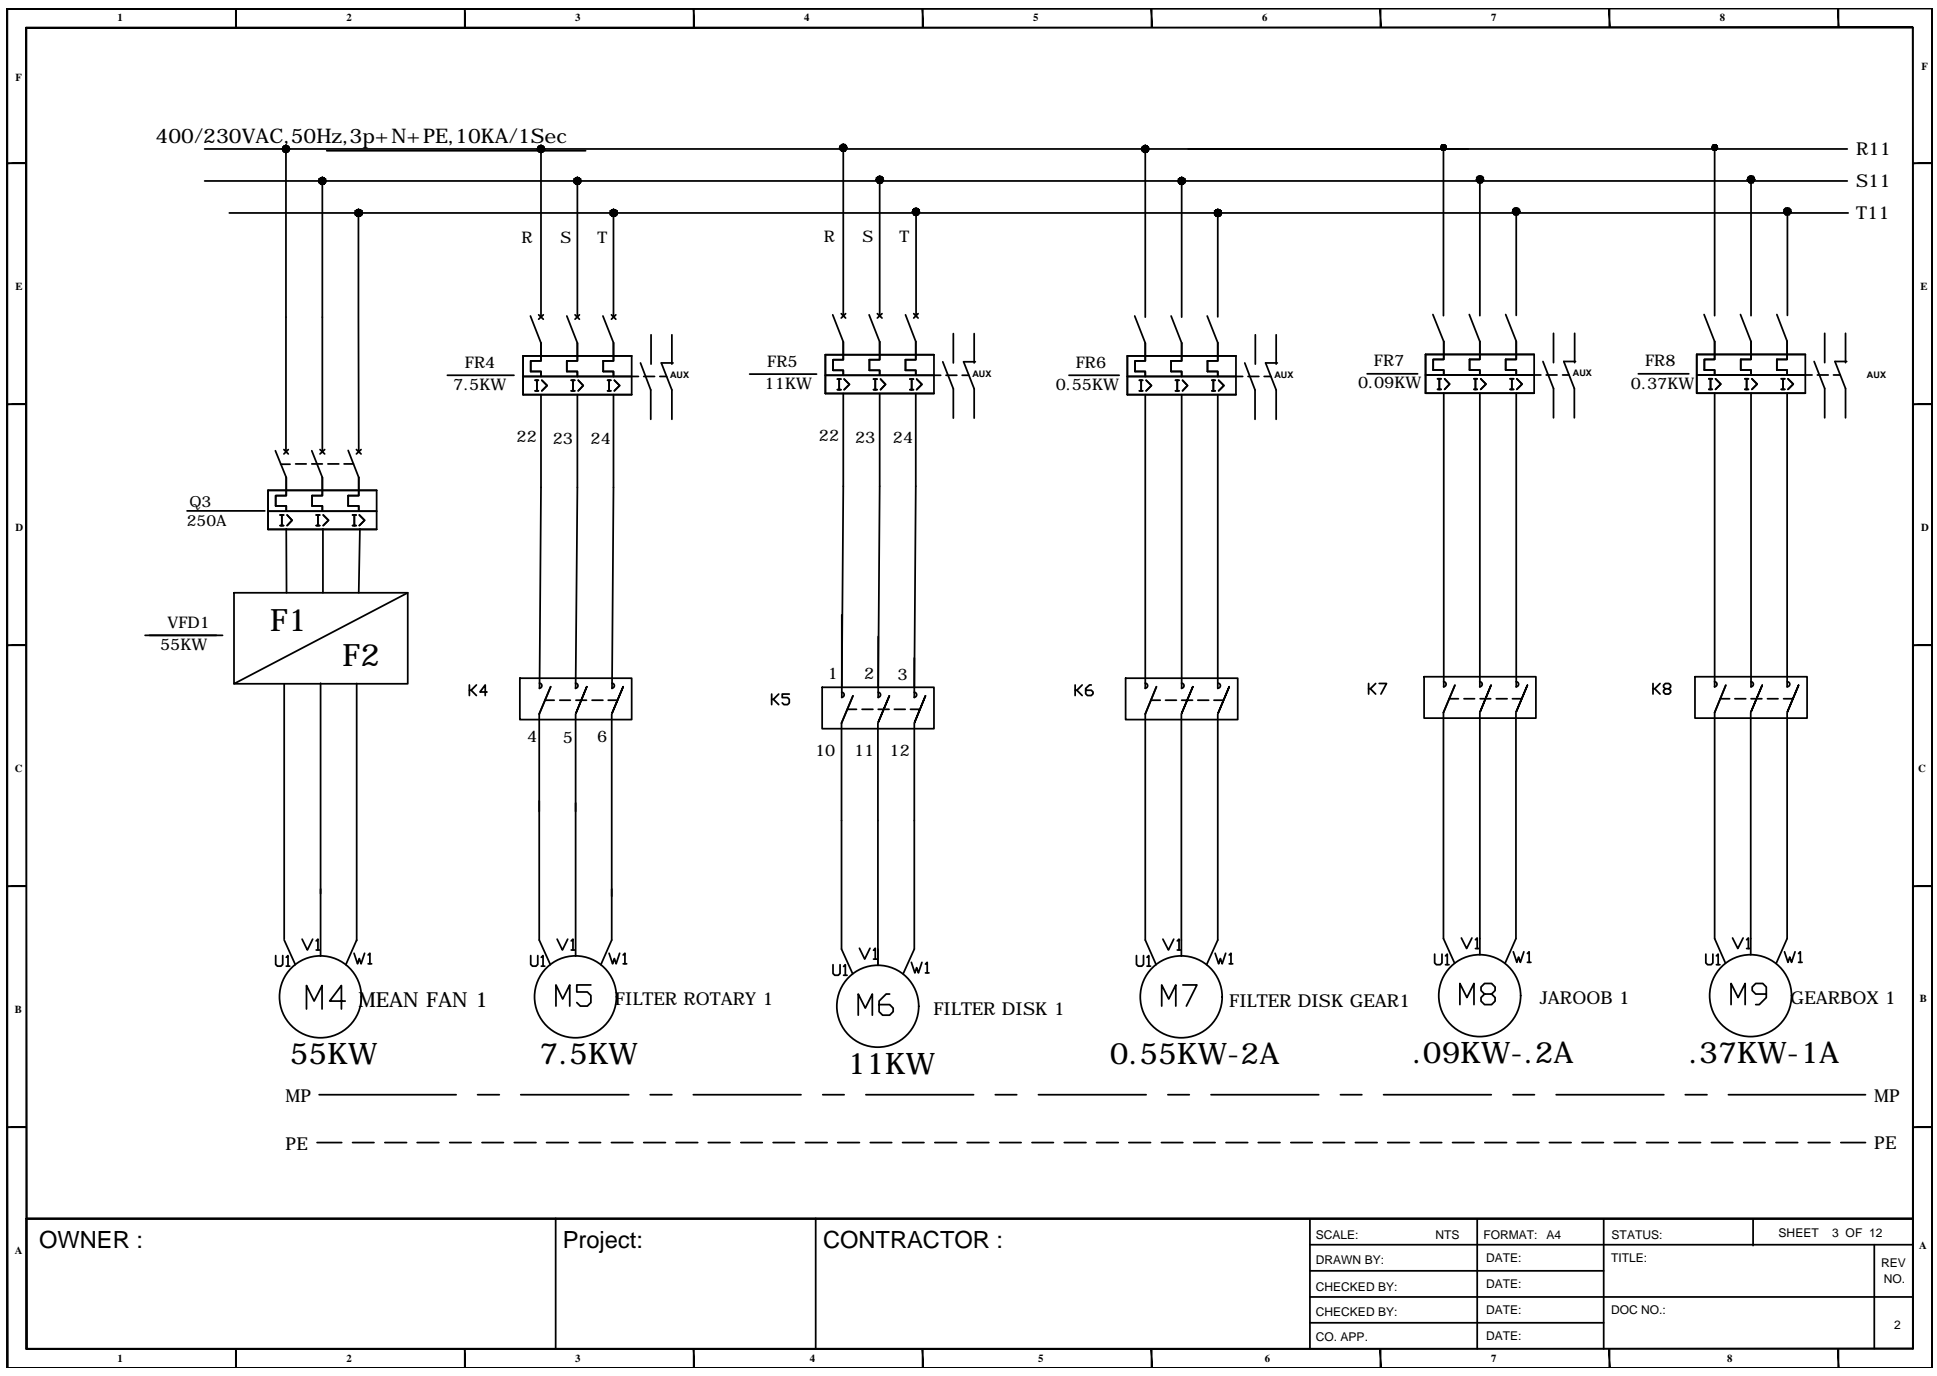
[picture p301: page 3]
FEACBD CAB; 8 OWNER :; CONTRACTOR :; REV SHEET 3 OF 12 TITLE: SCALE: CHECKED BY: DRAWN BY: CO. APP. CHECKED BY:; FORMAT:; STATUS:; NO. DOC NO.: NTS; 2 DATE: DATE: DATE: DATE: Project:; PEMP 400/230VAC,50Hz,3p+N+PE,10KA/1Sec F1 F2 55KWMEAN FAN 1 VFD1 55KWQ3 250A; AUX FR8 0.37KW.37KW-1A GEARBOX 1 AUX FR7 0.09KW.09KW-.2AJAROOB 1 AUX FR6 0.55KW0.55KW-2A AUX FR4 7.5KW; T FILTER ROTARY 1; FILTER DISK 1; FILTER DISK GEAR1 AUX FR5 11KW 22

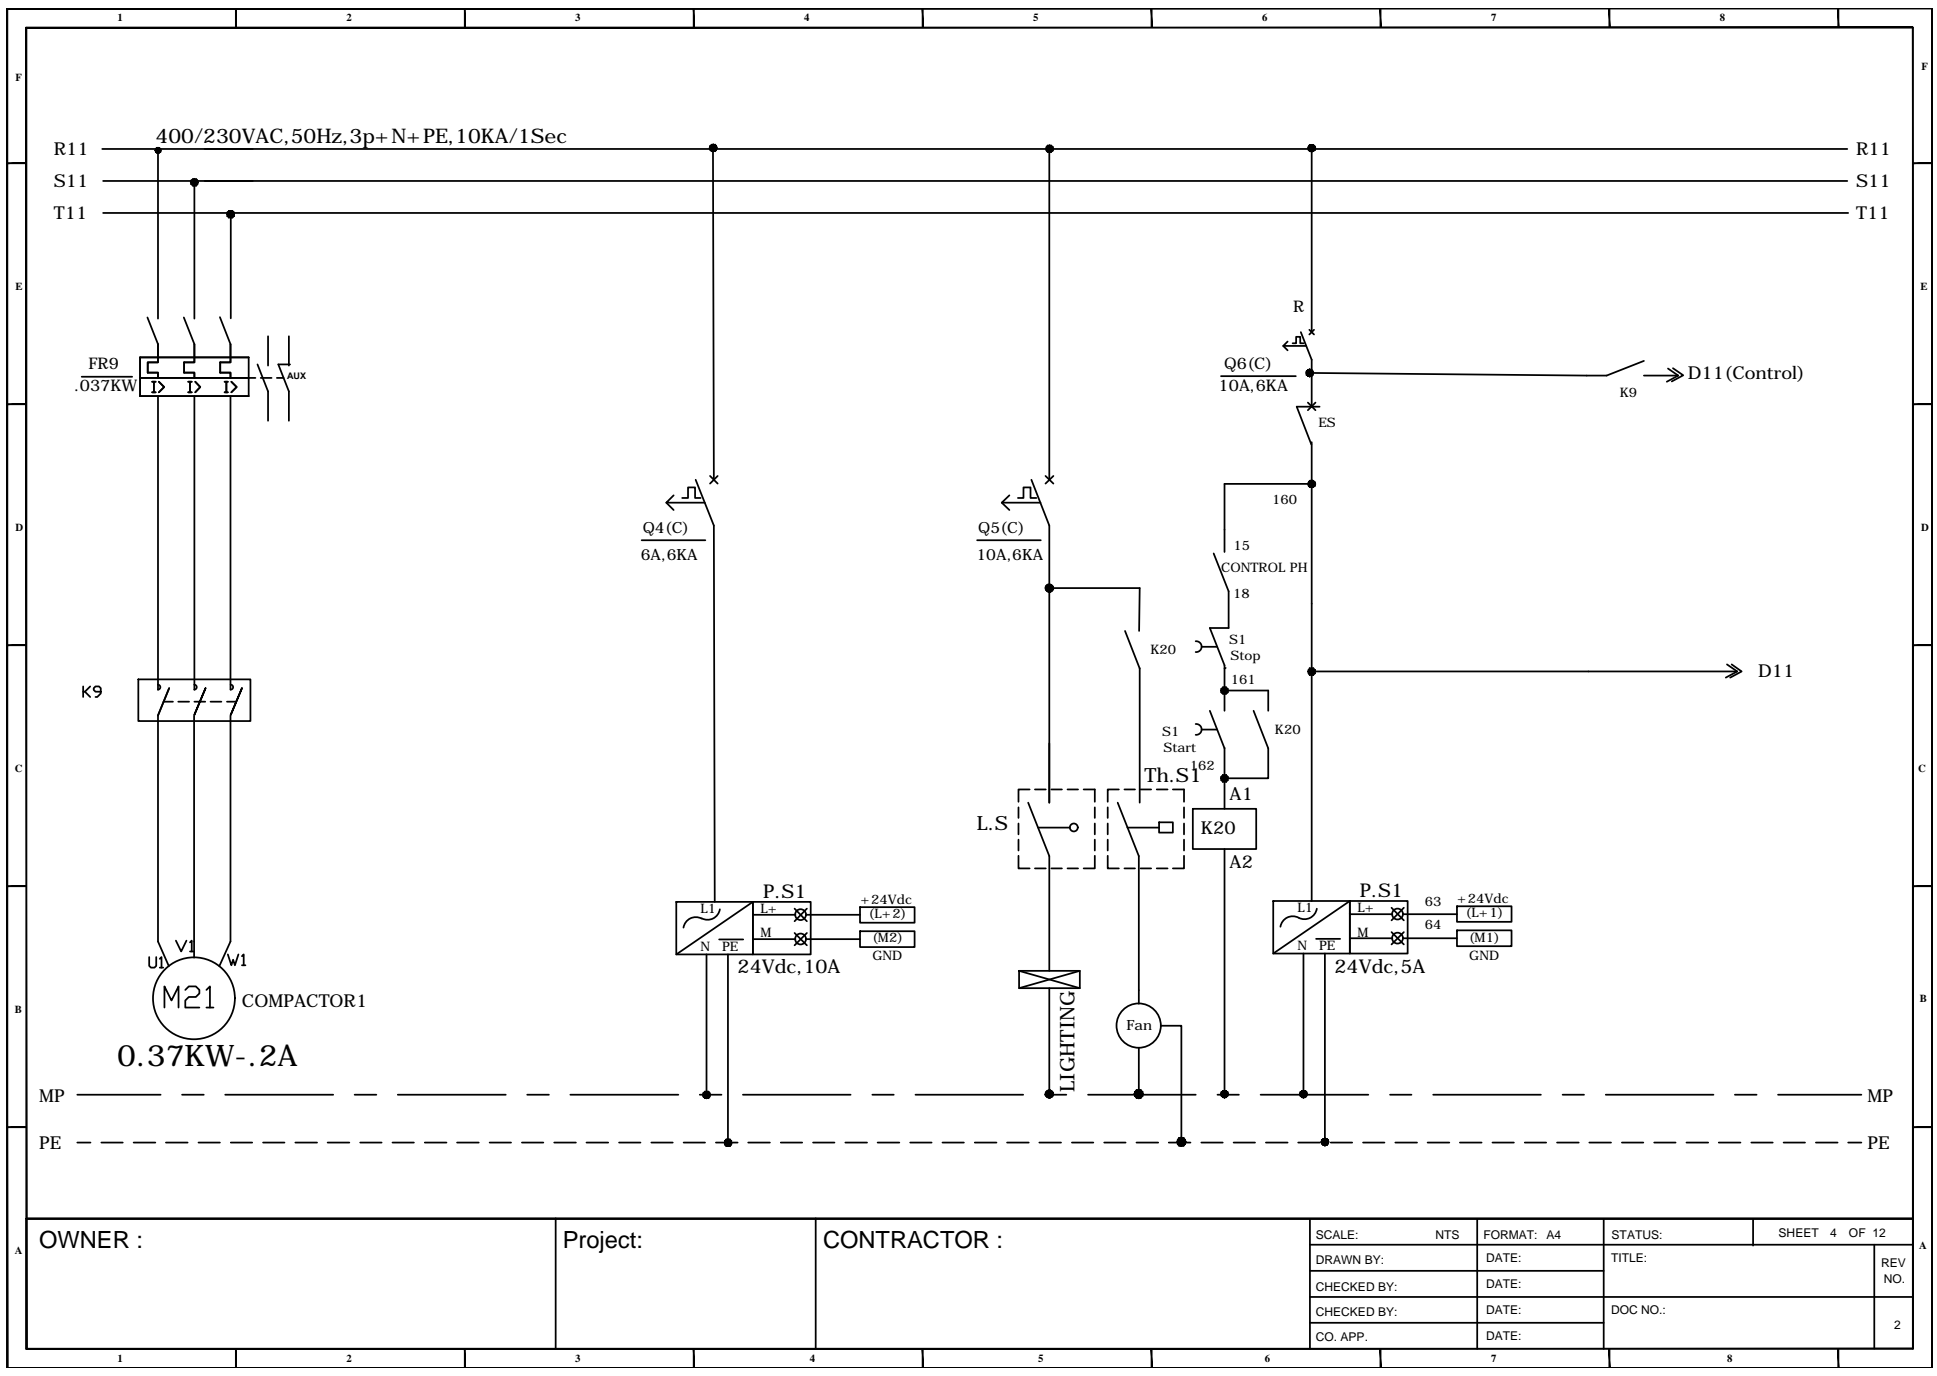
[picture p302: page 4]
FEACBD CAB; 8 OWNER :; CONTRACTOR :; REV SHEET; OF 12 TITLE: SCALE: CHECKED BY: DRAWN BY: CO. APP. CHECKED BY:; FORMAT:; STATUS:; NO. DOC NO.: NTS; 2 DATE: DATE: DATE: DATE: Project:; R11 S11 T11PEMP 400/230VAC,50Hz,3p+N+PE,10KA/1Sec R11 S11 T11 PEMP; P.S1 L+M 24Vdc,5A L1N PE Q6(C) 10A,6KA; +24Vdc GND (L+1) (M1); D11 Stop S1A1 K20A2 Start S1; D11(Control) Q5(C) 10A,6KA L.S

LIGHTING FanTh.S1 R 6364 160 161 162 P.S1 L+M 24Vdc,10A L1N PE +24Vdc GND (L+2) (M2) Q4(C) 6A,6KA ES 1518 CONTROL PH K20 AUX FR9 .037KW0.37KW-.2A COMPACTOR1

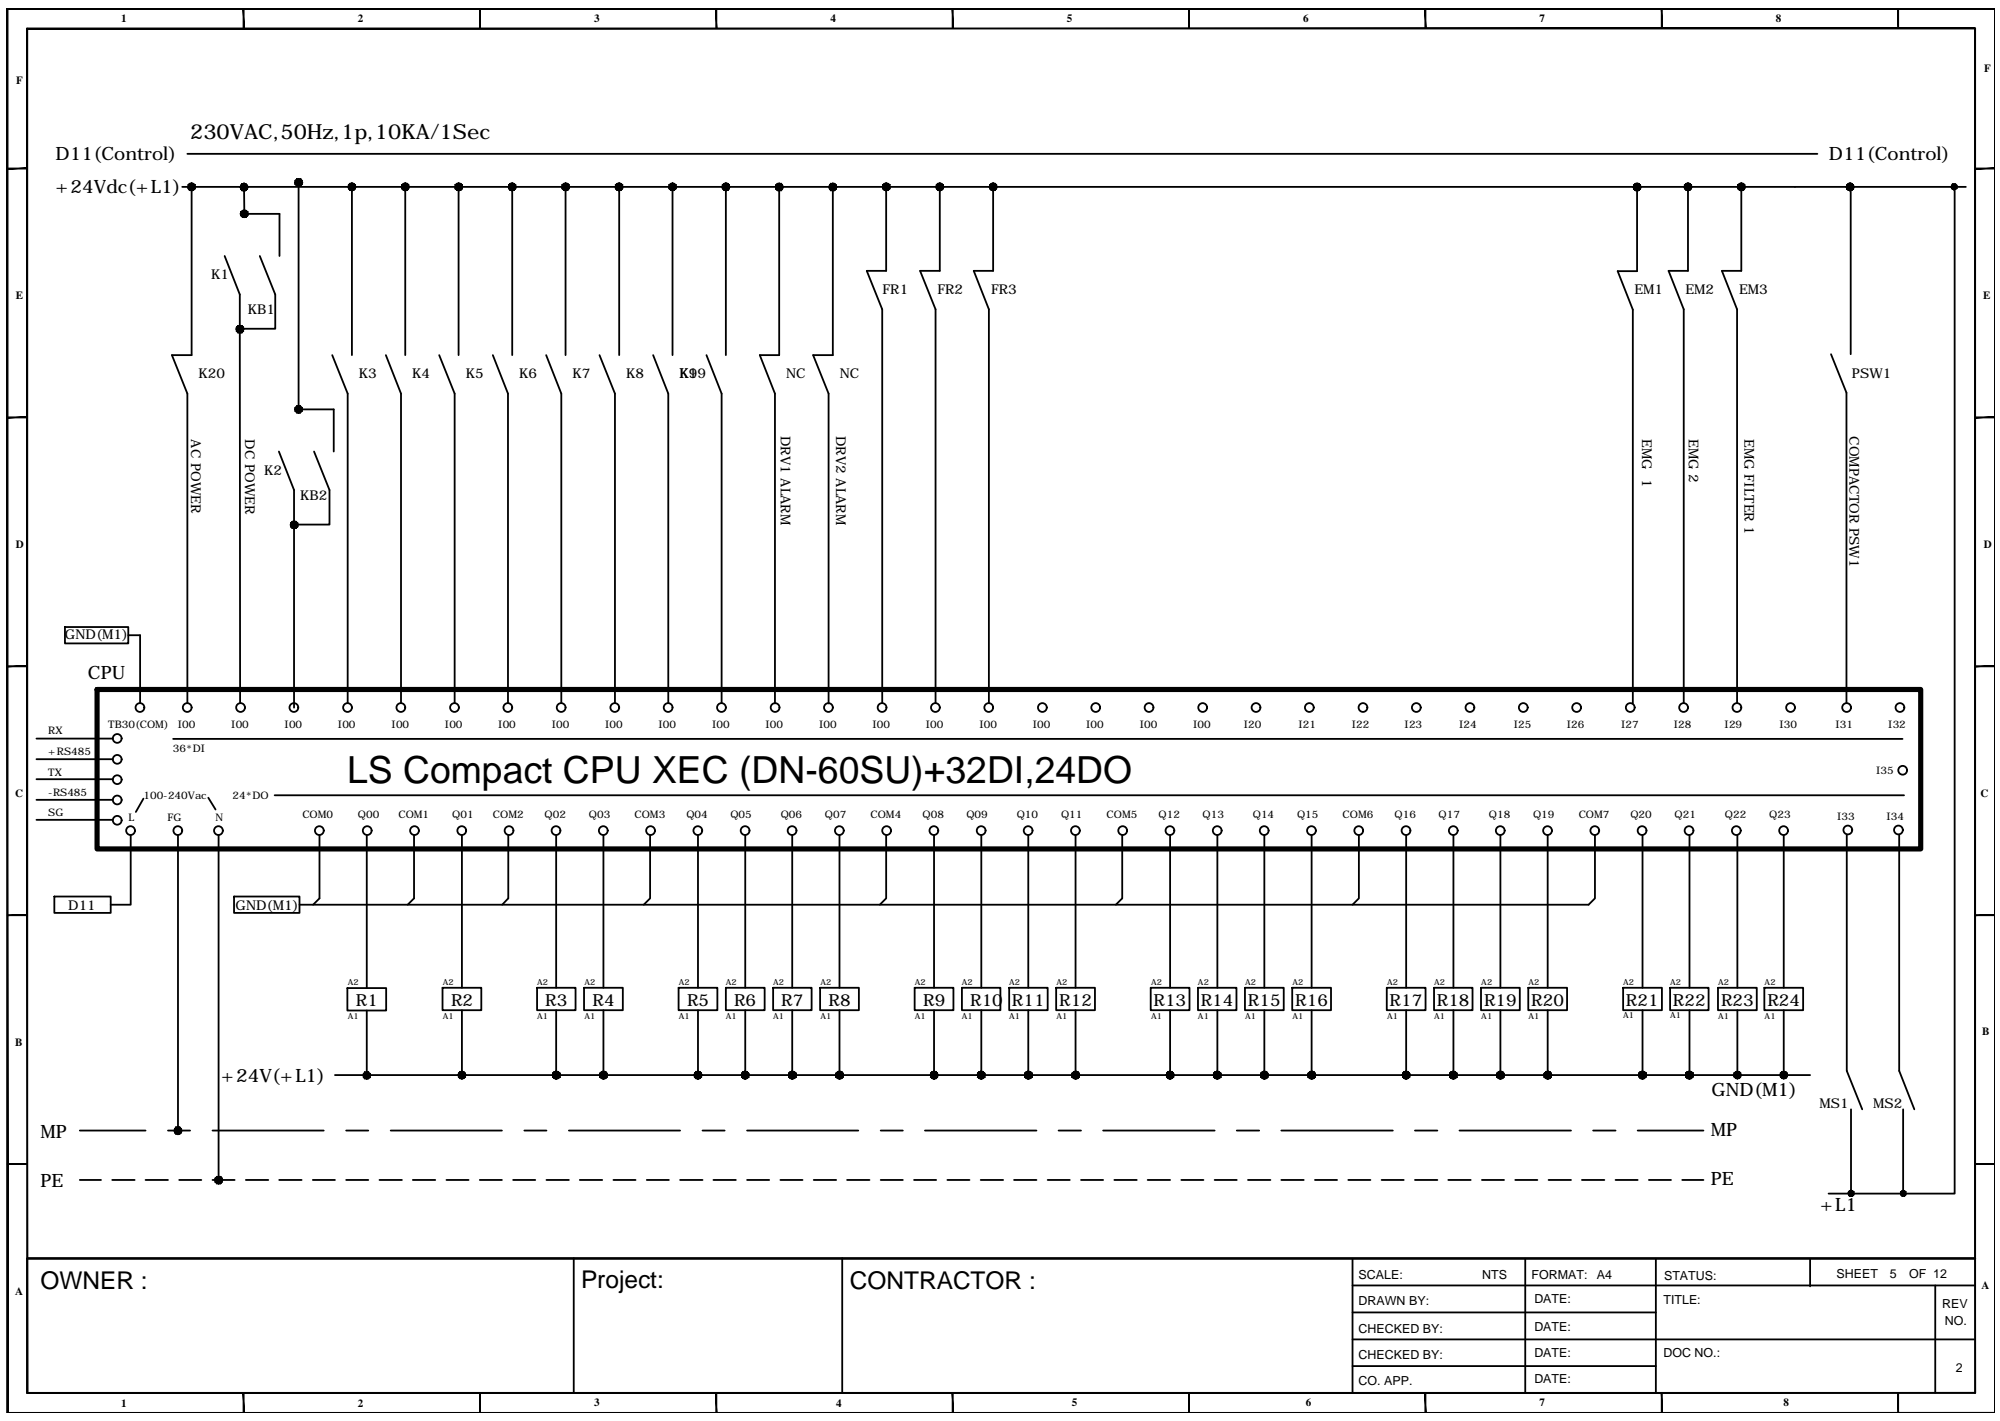
[picture p303: page 5]

DC POWER KB1 I00 I00 I00 I00 I00 I00 I00 I00 I00 I00 I00 I00 I00 I00 I00 I00 I00 I00 I00 I00 K2 KB2 K3 K4 K5 K6 K7 K8 K919 NC NC

TB30(COM) 36*DI CPU D11 GND(M1)

LS Compact CPU XEC (DN-60SU)+32DI,24DO

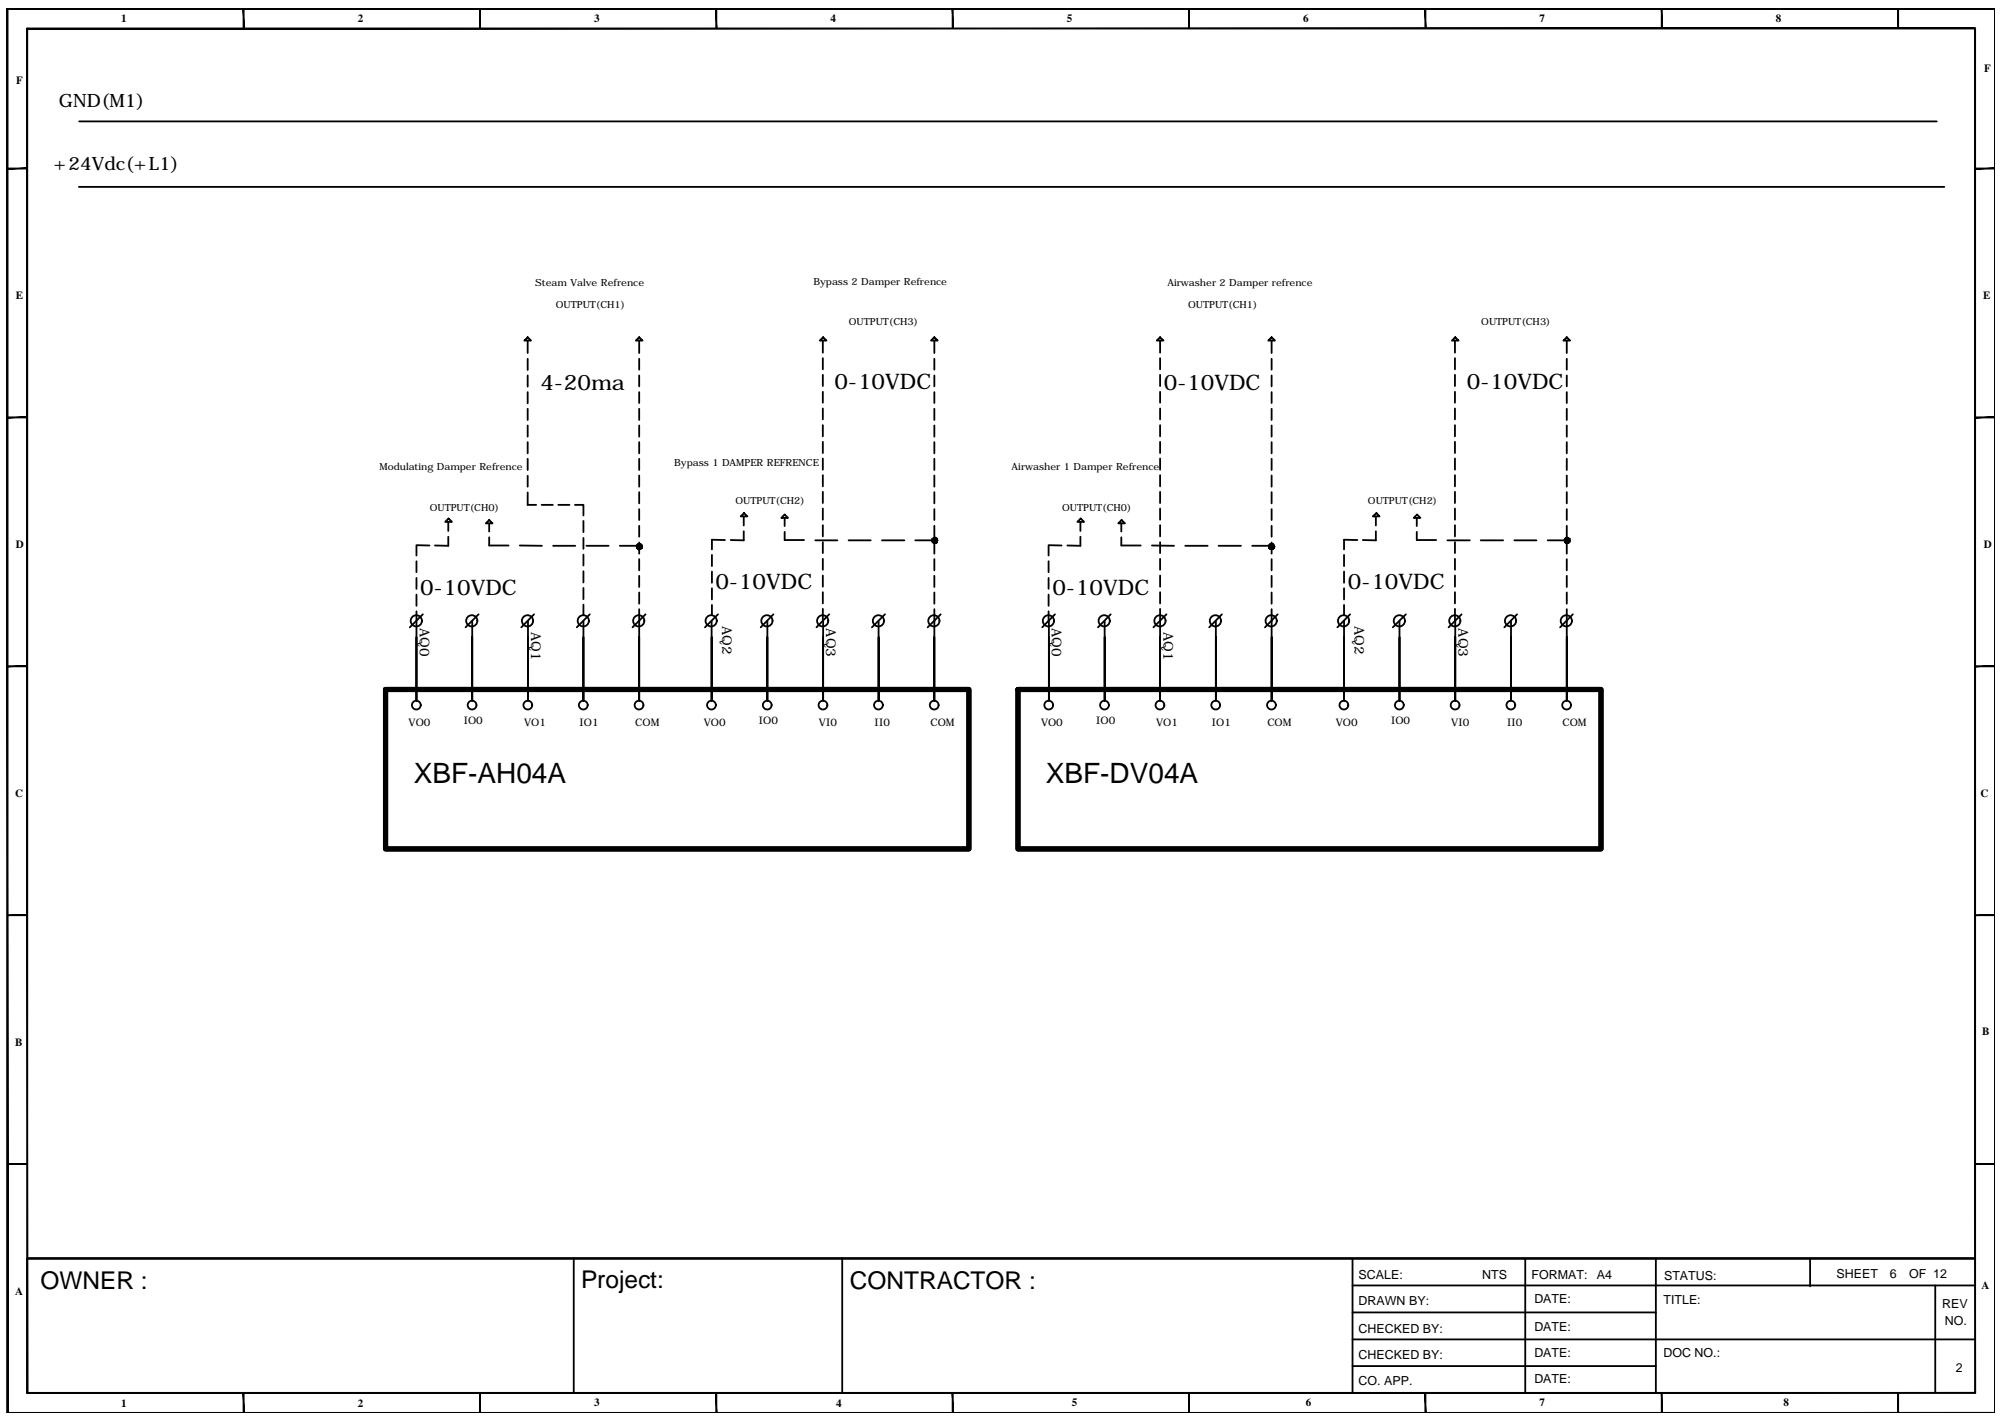
[picture p304: page 6]
FEACBD CAB; 8 OWNER :; CONTRACTOR :; REV SHEET; OF 12 TITLE: SCALE: CHECKED BY: DRAWN BY: CO. APP. CHECKED BY:; FORMAT:; STATUS:; NO. DOC NO.: NTS; 2 DATE: DATE: DATE: DATE: Project: +24Vdc(+L1) GND(M1); XBF-AH04A VO0; COM OUTPUT(CH0) 0-10VDC Modulating Damper Refrence; OUTPUT(CH1) 4-20ma Steam Valve Refrence; COM OUTPUT(CH3) 0-10VDC Bypass 1 DAMPER REFRENCE OUTPUT(CH2) 0-10VDC; Bypass 2 Damper Refrence; XBF-DV04A VO0; COM OUTPUT(CH0) 0-10VDC Airwasher 1 Damper Refrence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

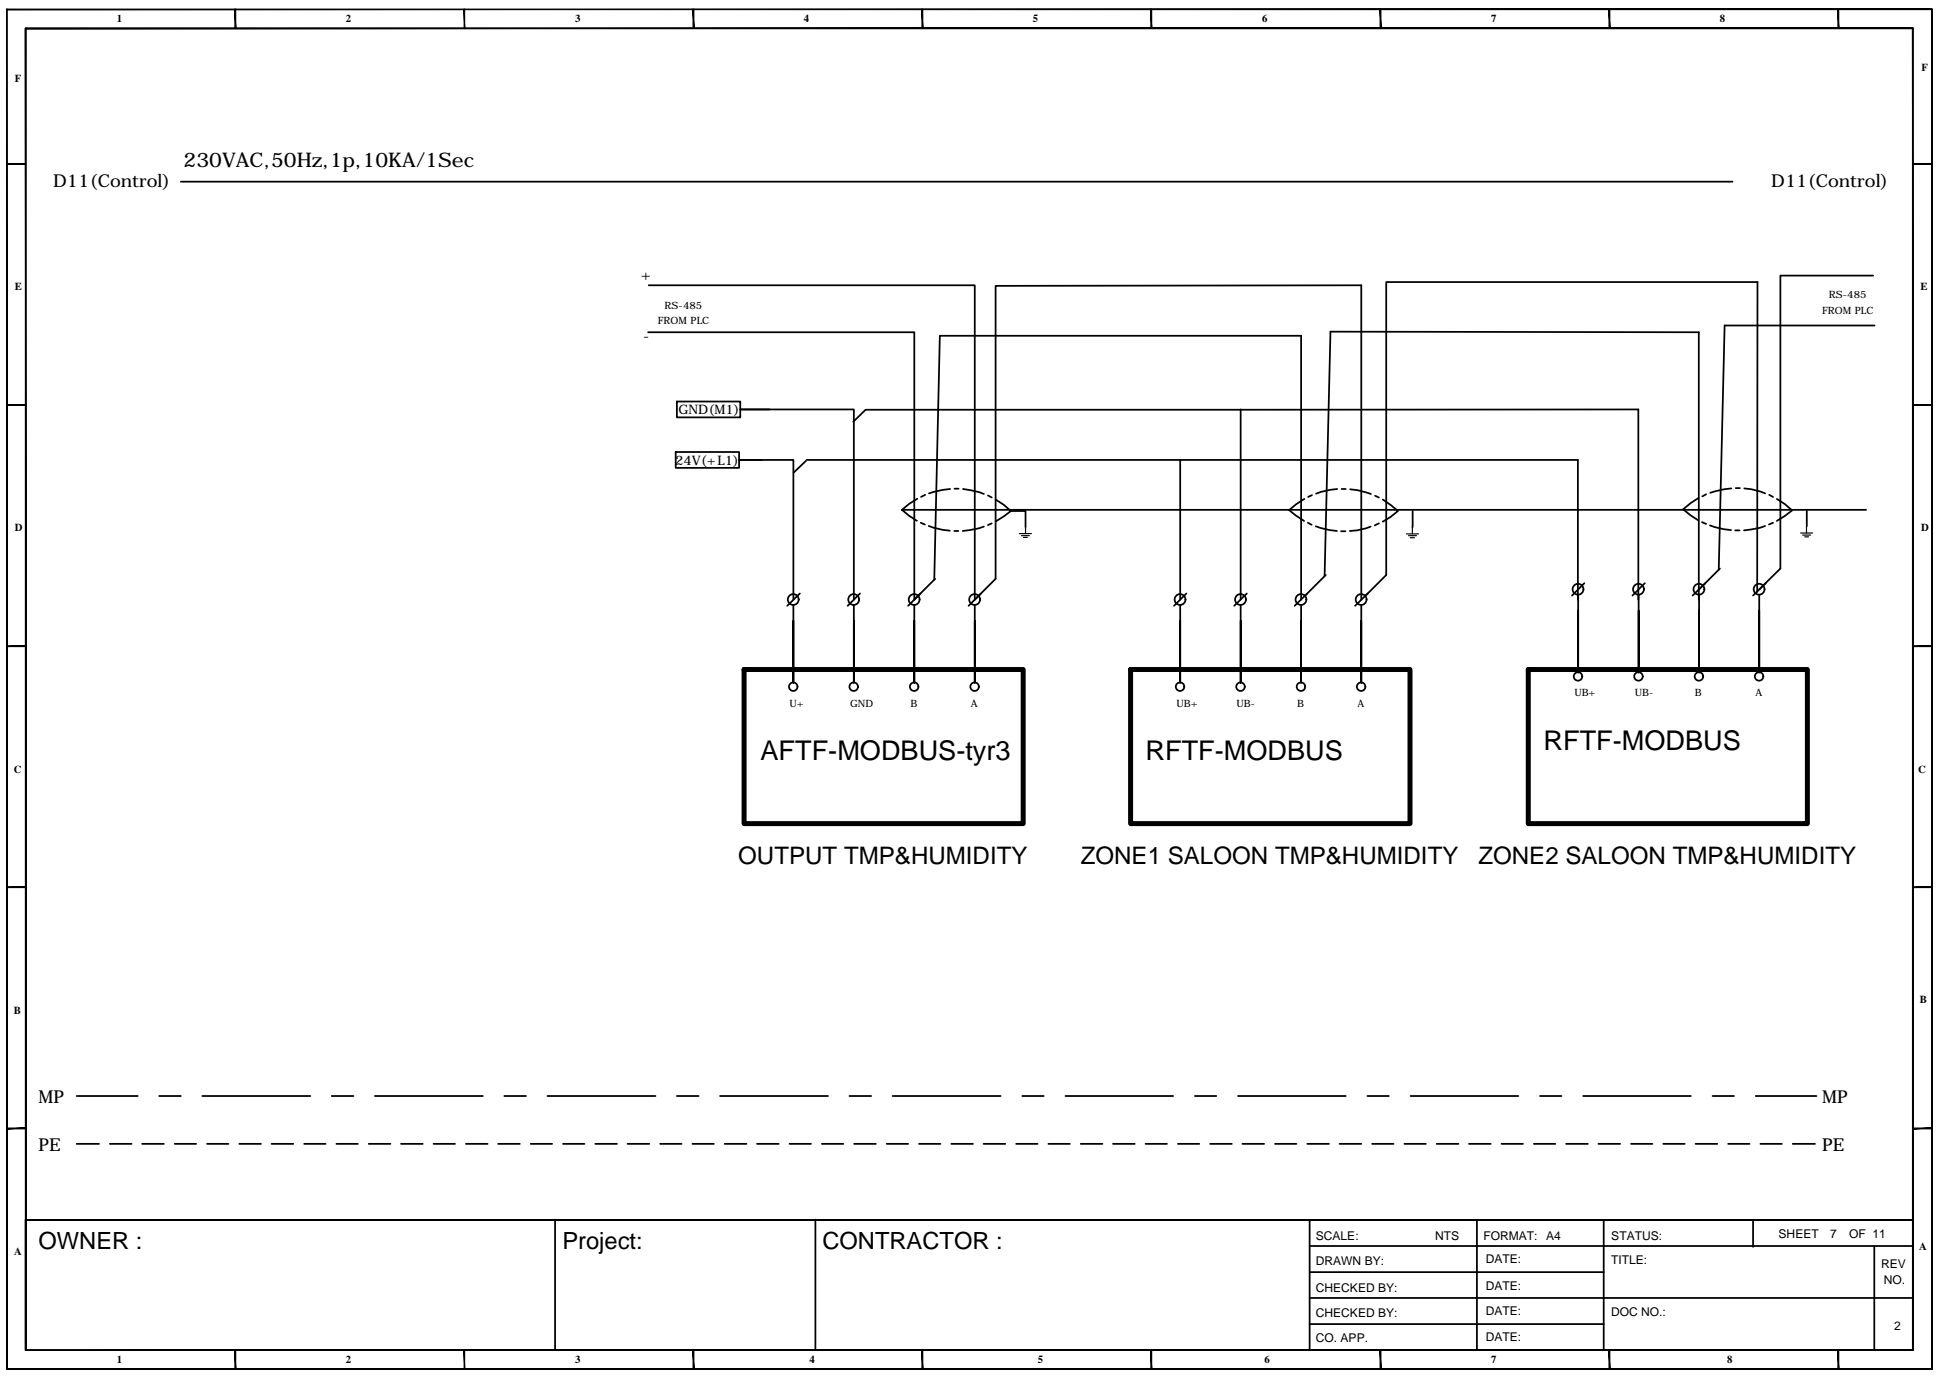
[picture p305: page 7]
FEACBD CAB; 8 OWNER :; CONTRACTOR :; REV SHEET; OF 11 TITLE: SCALE: CHECKED BY: DRAWN BY: CO. APP. CHECKED BY:; FORMAT:; STATUS:; NO. DOC NO.: NTS; 2 DATE: DATE: DATE: DATE: Project:; PEMP 230VAC,50Hz,1p,10KA/1Sec D11(Control) PEMP; D11(Control) GND(M1); AFTF-MODBUS-tyr3 24V(+L1); GND; A RS-485 FROM PLC +-; OUTPUT TMP&HUMIDITY; RFTF-MODBUS UB+; A ZONE1 SALOON TMP&HUMIDITY; A ZONE2 SALOON TMP&HUMIDITYRS-485 FROM PLC

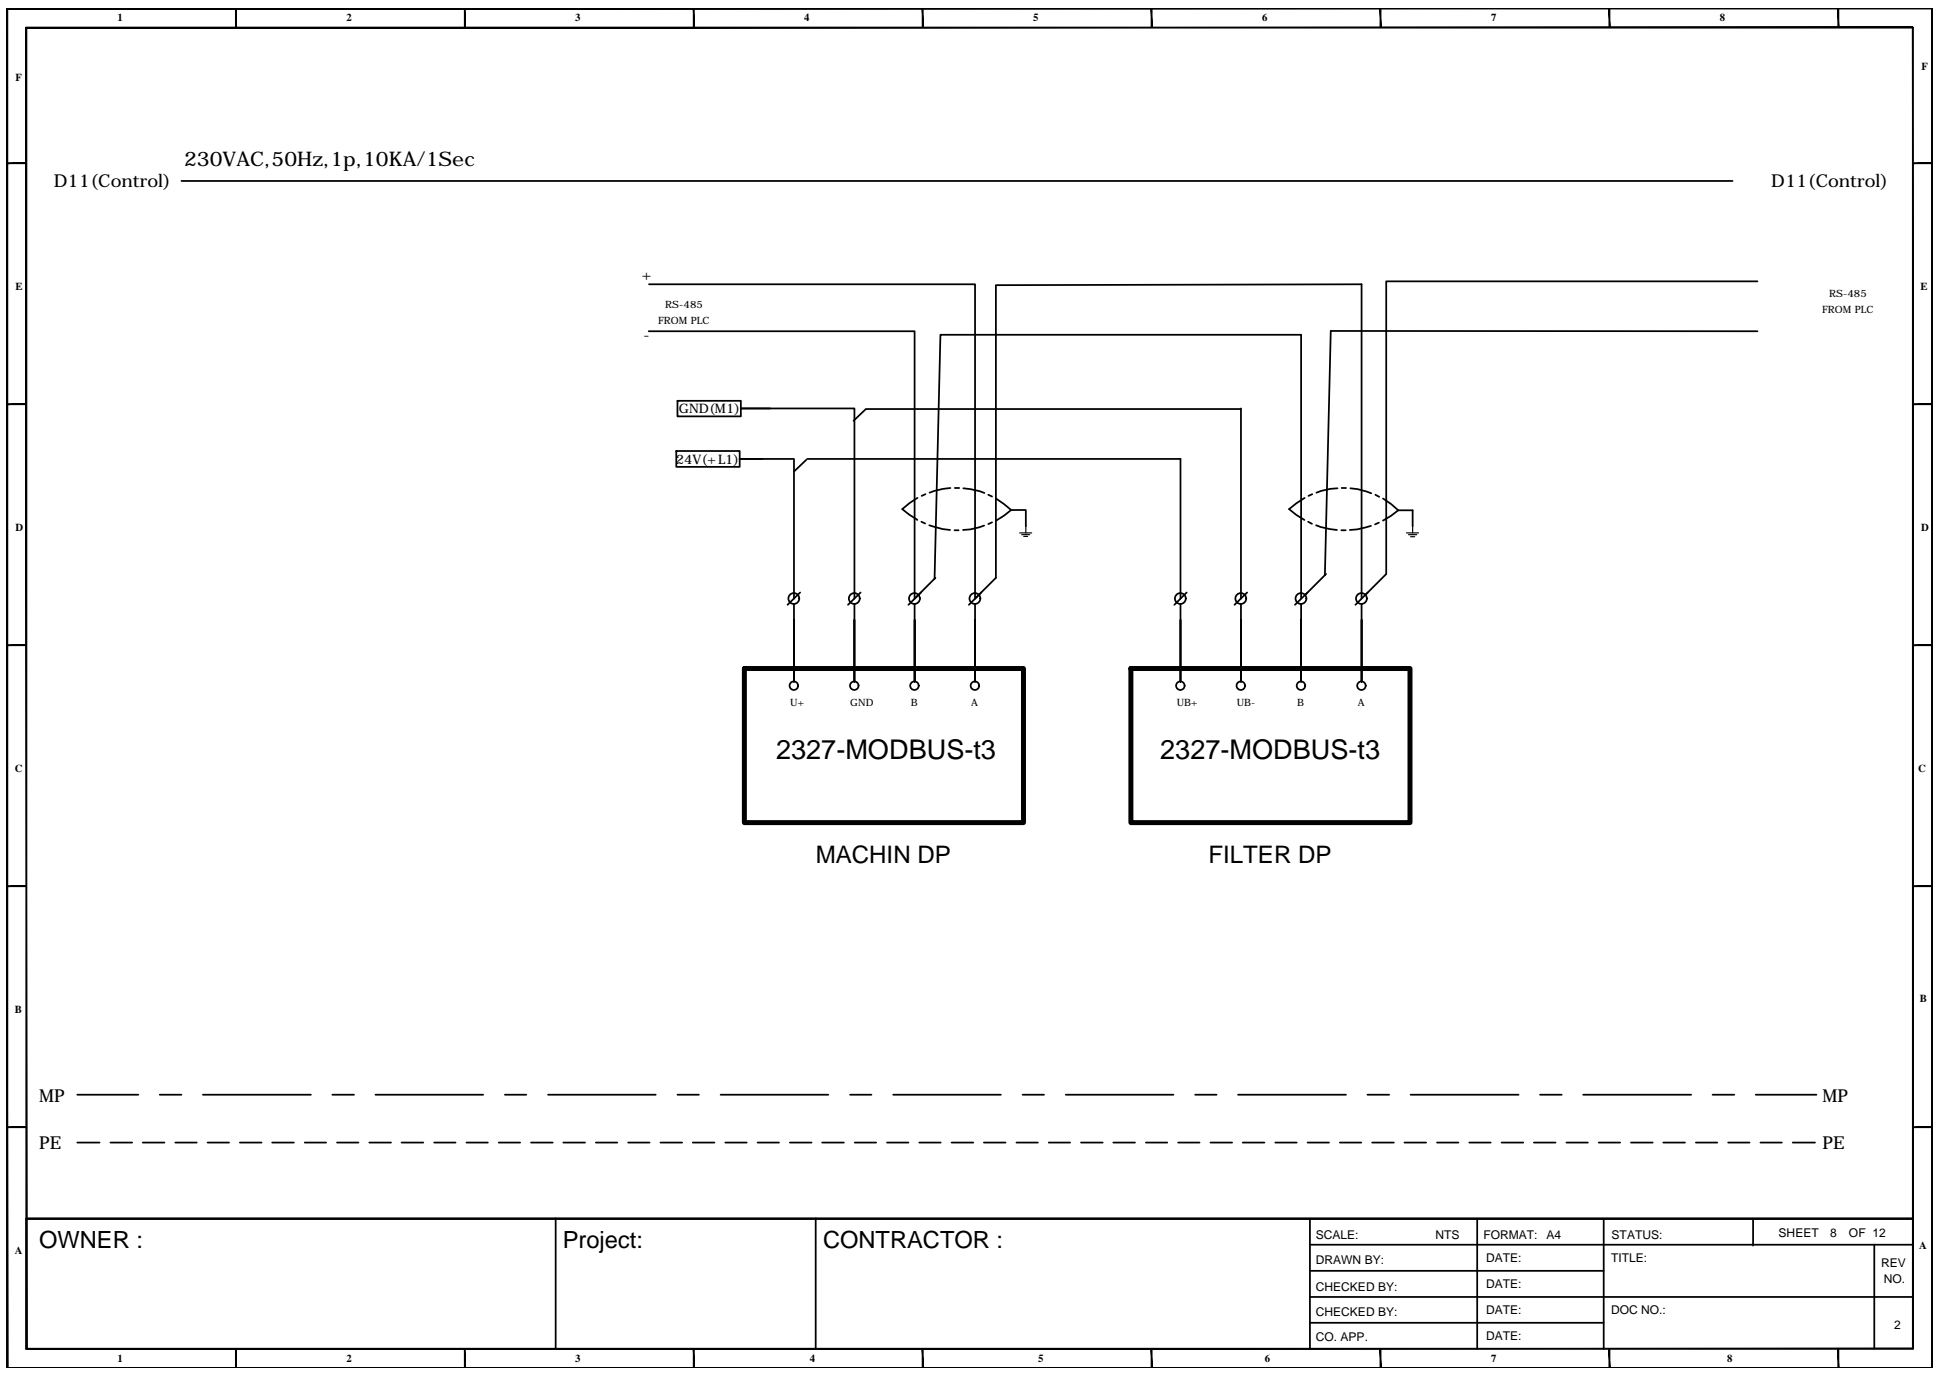
[picture p306: page 8]
FEACBD CAB; 8 OWNER :; CONTRACTOR :; REV SHEET; OF 12 TITLE: SCALE: CHECKED BY: DRAWN BY: CO. APP. CHECKED BY:; FORMAT:; STATUS:; NO. DOC NO.: NTS; 2 DATE: DATE: DATE: DATE: Project:; PEMP 230VAC,50Hz,1p,10KA/1Sec D11(Control) PEMP; D11(Control) GND(M1); 2327-MODBUS-t3 24V(+L1); GND; A RS-485 FROM PLC +-; MACHIN DP; 2327-MODBUS-t3 UB+; A FILTER DP; RS-485 FROM PLC

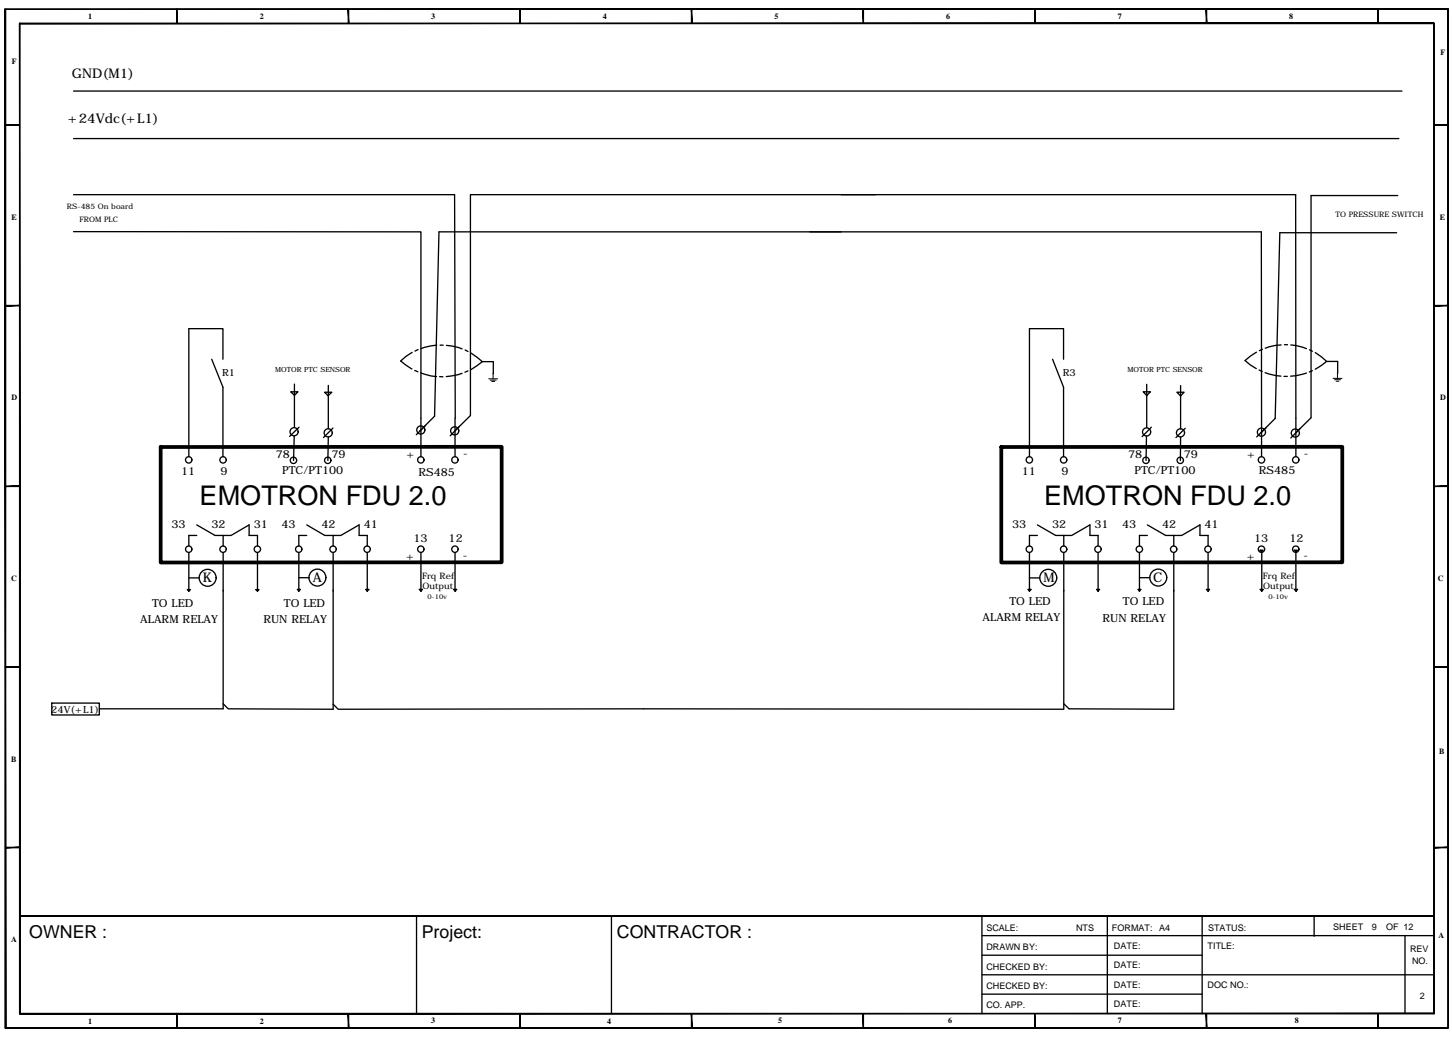
[picture p307: page 9]
FEACBD CAB; 8 OWNER :; CONTRACTOR :; REV SHEET; OF 12 TITLE: SCALE: CHECKED BY: DRAWN BY: CO. APP. CHECKED BY:; FORMAT:; STATUS:; NO. DOC NO.: NTS; 2 DATE: DATE: DATE: DATE: Project: +24Vdc(+L1) GND(M1) 24V(+L1); EMOTRON FDU 2.0 11; - TO LED; TO LED ALARM RELAY; - FROM PLC; TO PRESSURE SWITCH RS485 RUN RELAY; TO LED; RUN RELAY K; Frq Ref; C Output 0-10v; Frq Ref Output 0-10v RS-485 On board; 79 PTC/PT100 MOTOR PTC SENSOR 78; 79 PTC/PT100 MOTOR PTC SENSOR

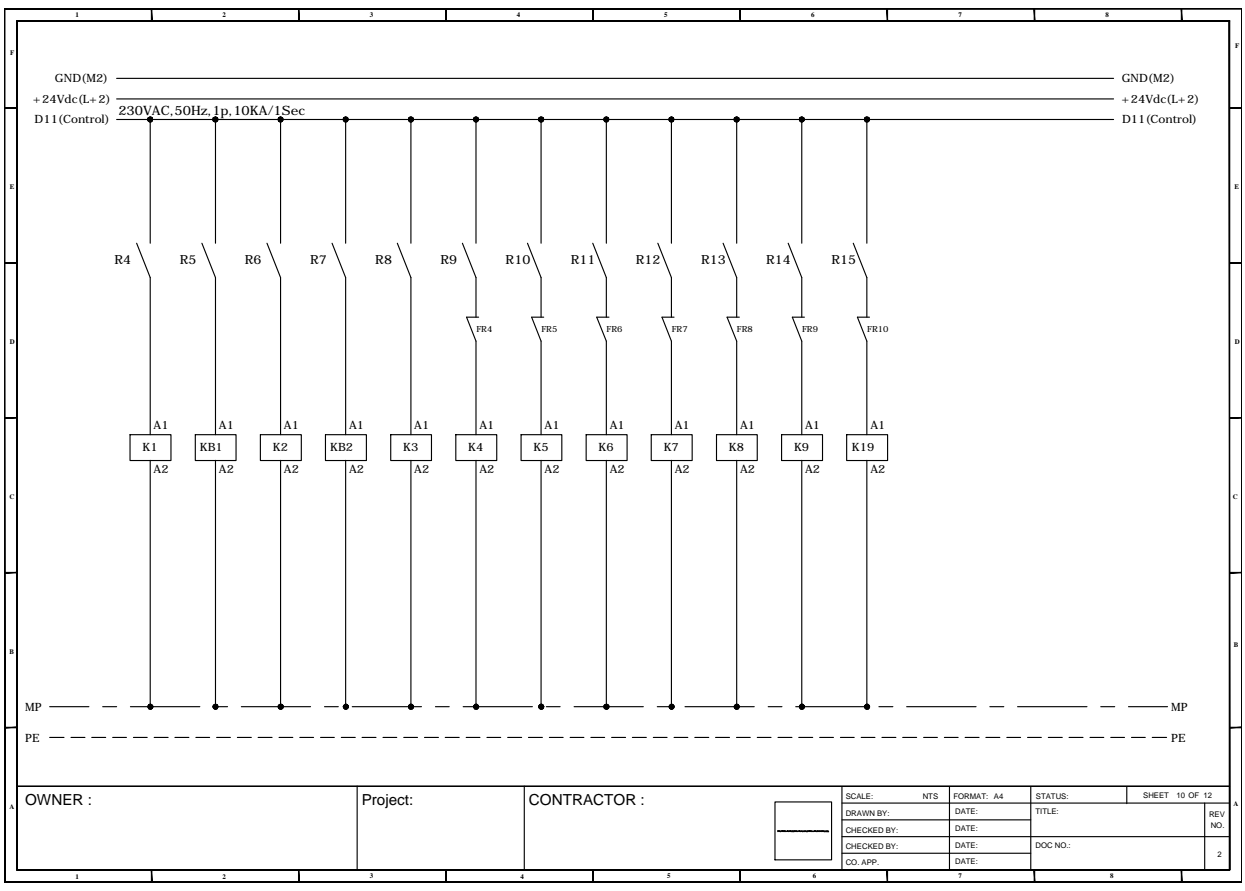
[picture p308: page 10]

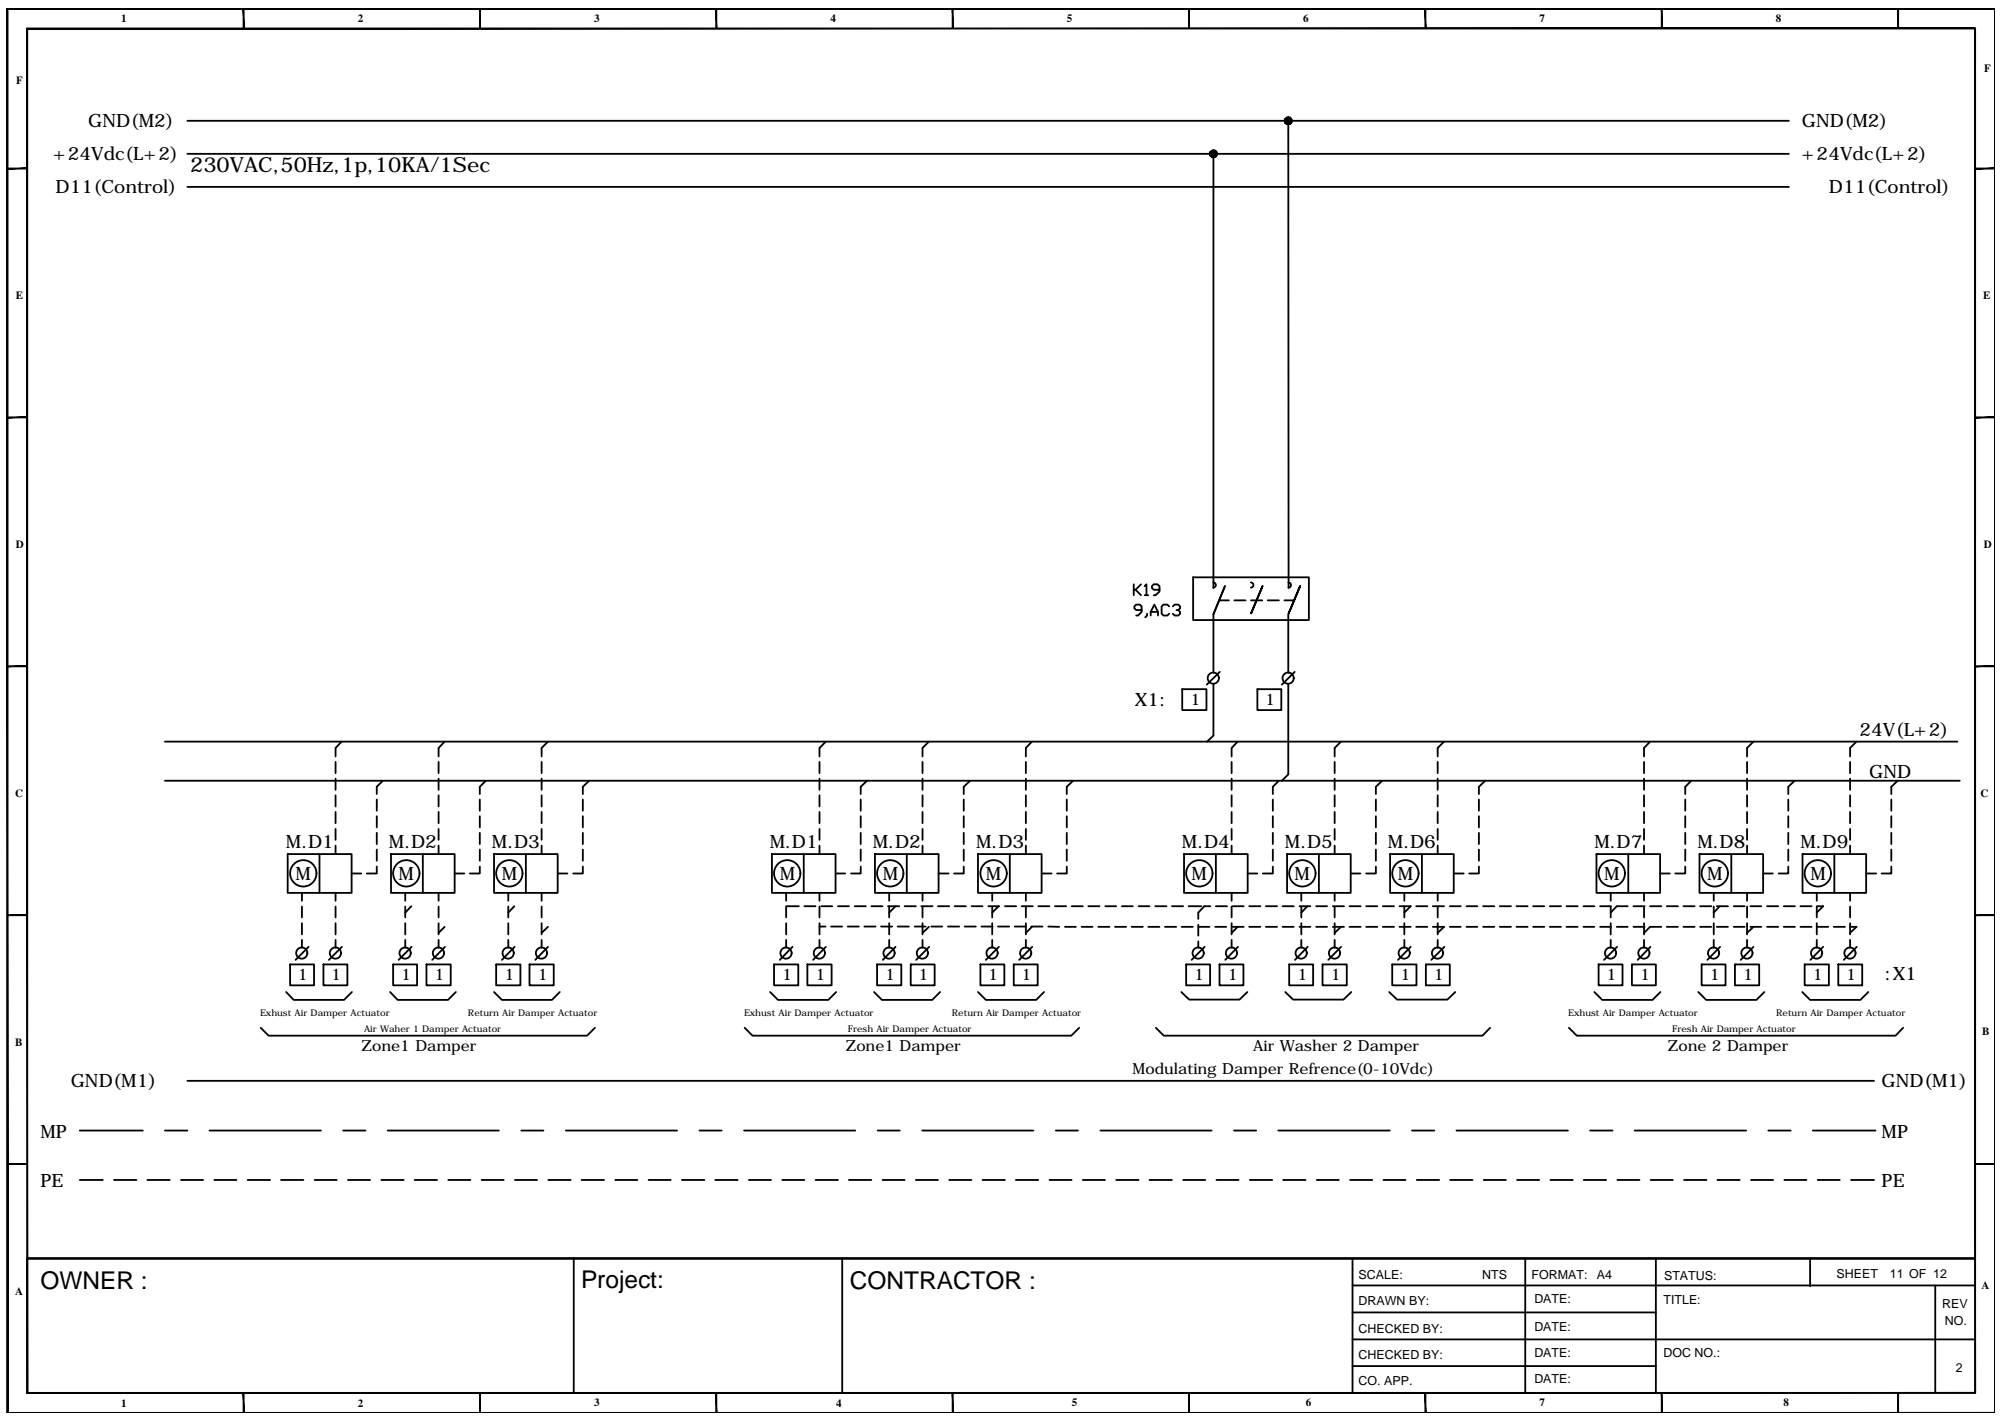
[picture p309: page 11]
FEACBD CAB; 8 OWNER :; CONTRACTOR :; REV SHEET; OF 12 TITLE: SCALE: CHECKED BY: DRAWN BY: CO. APP. CHECKED BY:; FORMAT:; STATUS:; NO. DOC NO.: NTS; 2 DATE: DATE: DATE: DATE: Project:; PEMP 230VAC,50Hz,1p,10KA/1Sec D11(Control) PEMP; GND(M1) D11(Control) GND(M1) +24Vdc(L+2) GND(M2); +24Vdc(L+2) GND(M2) X1:; 24V(L+2) GND MM.D1; Modulating Damper Refrence(0-10Vdc) 1; :X1 Zone 2 Damper Exhust Air Damper Actuator Fresh Air Damper Actuator Return Air Damper Actuator Zone1 Damper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

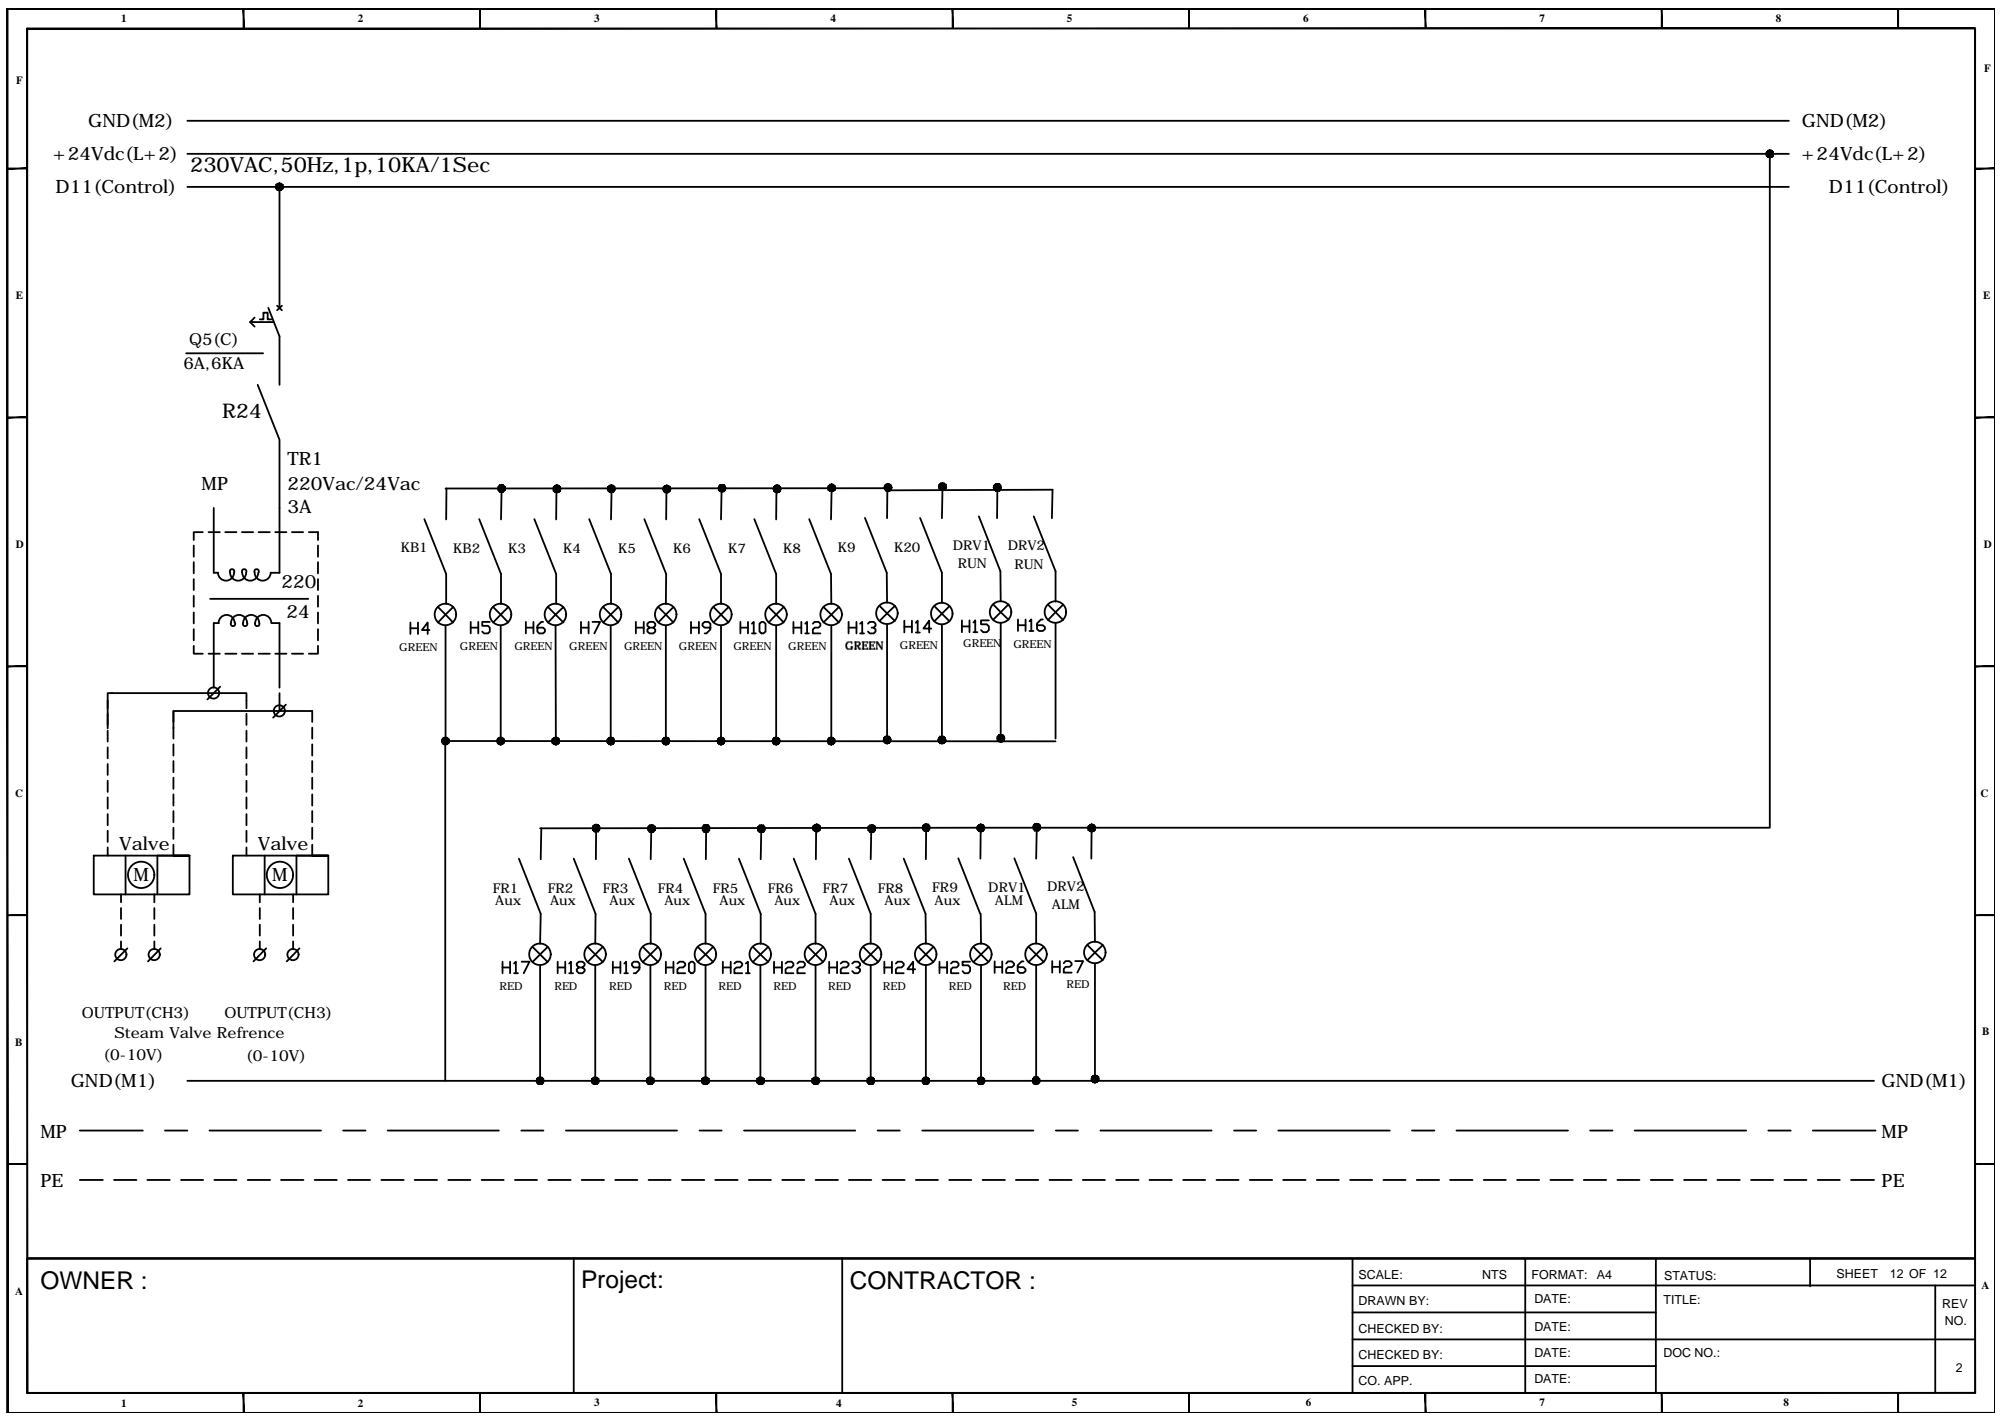
[picture p310: page 12]
FEACBD CAB; 8 OWNER :; CONTRACTOR :; REV SHEET; OF 12 TITLE: SCALE: CHECKED BY: DRAWN BY: CO. APP. CHECKED BY:; FORMAT:; STATUS:; NO. DOC NO.: NTS; 2 DATE: DATE: DATE: DATE: Project:; PEMP 230VAC,50Hz,1p,10KA/1Sec D11(Control) PEMP; GND(M1) D11(Control) GND(M1); 220Vac/24Vac 3A 220 24 MValve OUTPUT(CH3) Steam Valve Refrence (0-10V) TR1 +24Vdc(L+2) GND(M2); +24Vdc(L+2) GND(M2) R24; RED; RED FR9 Aux; DRV1 ALM FR1 Aux; FR2 Aux; FR3Aux; FR4Aux; FR5Aux; FR6Aux; FR7Aux; FR8Aux; DRV2 ALMRED GREEN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
