koalium/centidocs/elec/plc/Wiring diagram/10193-Serjin/AC-12&13.pdf

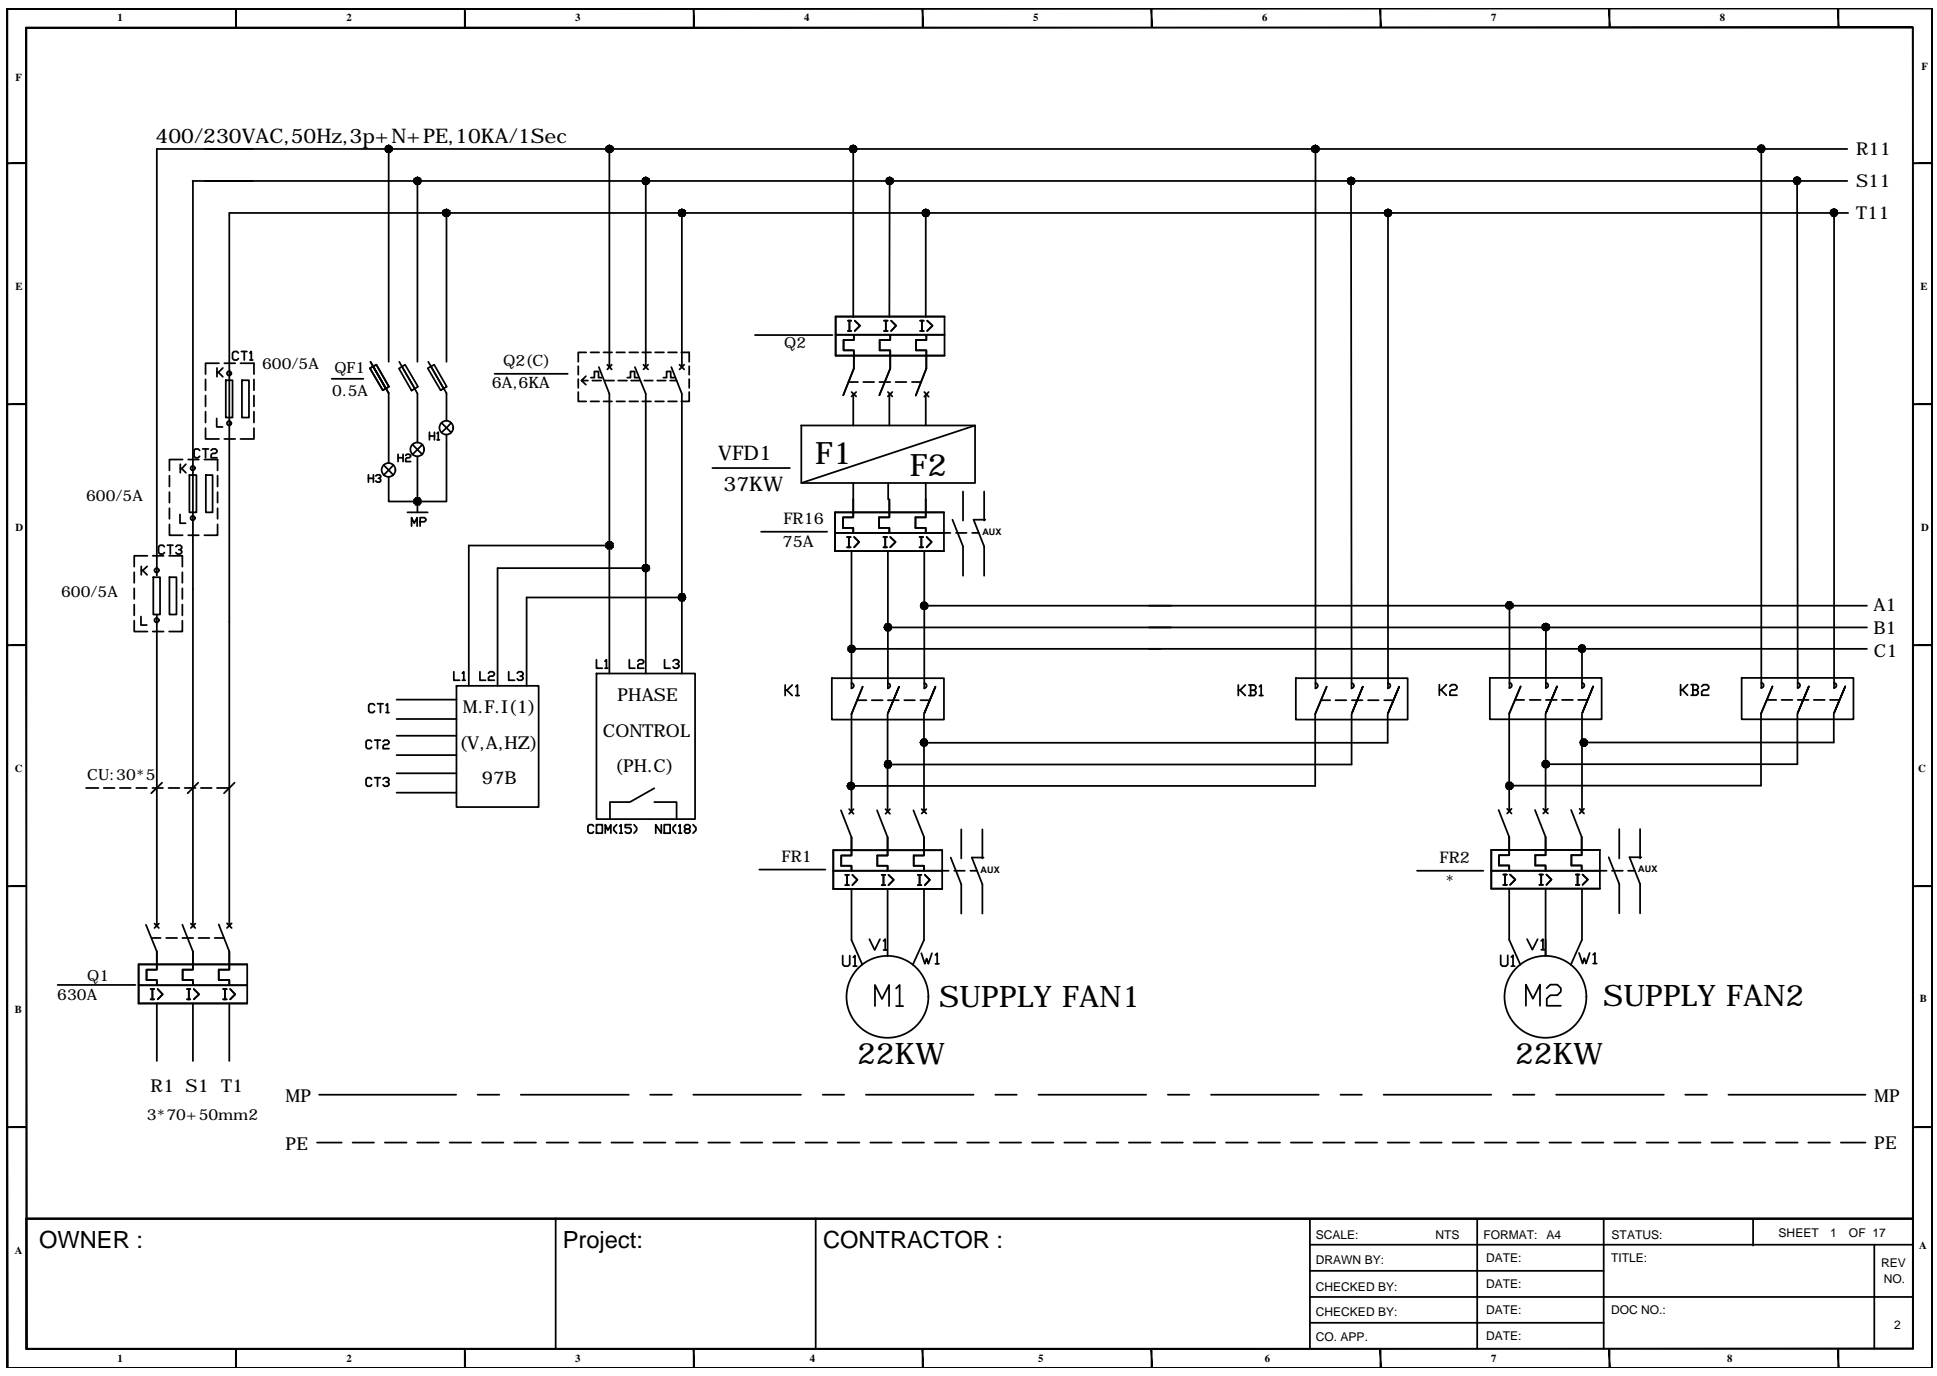
[picture p318: page 1]
FEACBD CAB; 8 OWNER :; CONTRACTOR :; REV SHEET; OF 17 TITLE: SCALE: CHECKED BY: DRAWN BY: CO. APP. CHECKED BY:; FORMAT:; STATUS:; NO. DOC NO.: NTS; 2 DATE: DATE: DATE: DATE: Project: Q1; PEMP CU:30*5400/230VAC,50Hz,3p+N+PE,10KA/1Sec 3*70+50mm2; PHASE CONTROL (PH.C) Q2(C) 6A,6KA; A1B1C1 22KW AUX FR2 *; SUPPLY FAN2 Q2 F1; F2 VFD1 37KW; 22KW AUX FR1; SUPPLY FAN1 AUX FR16 75A

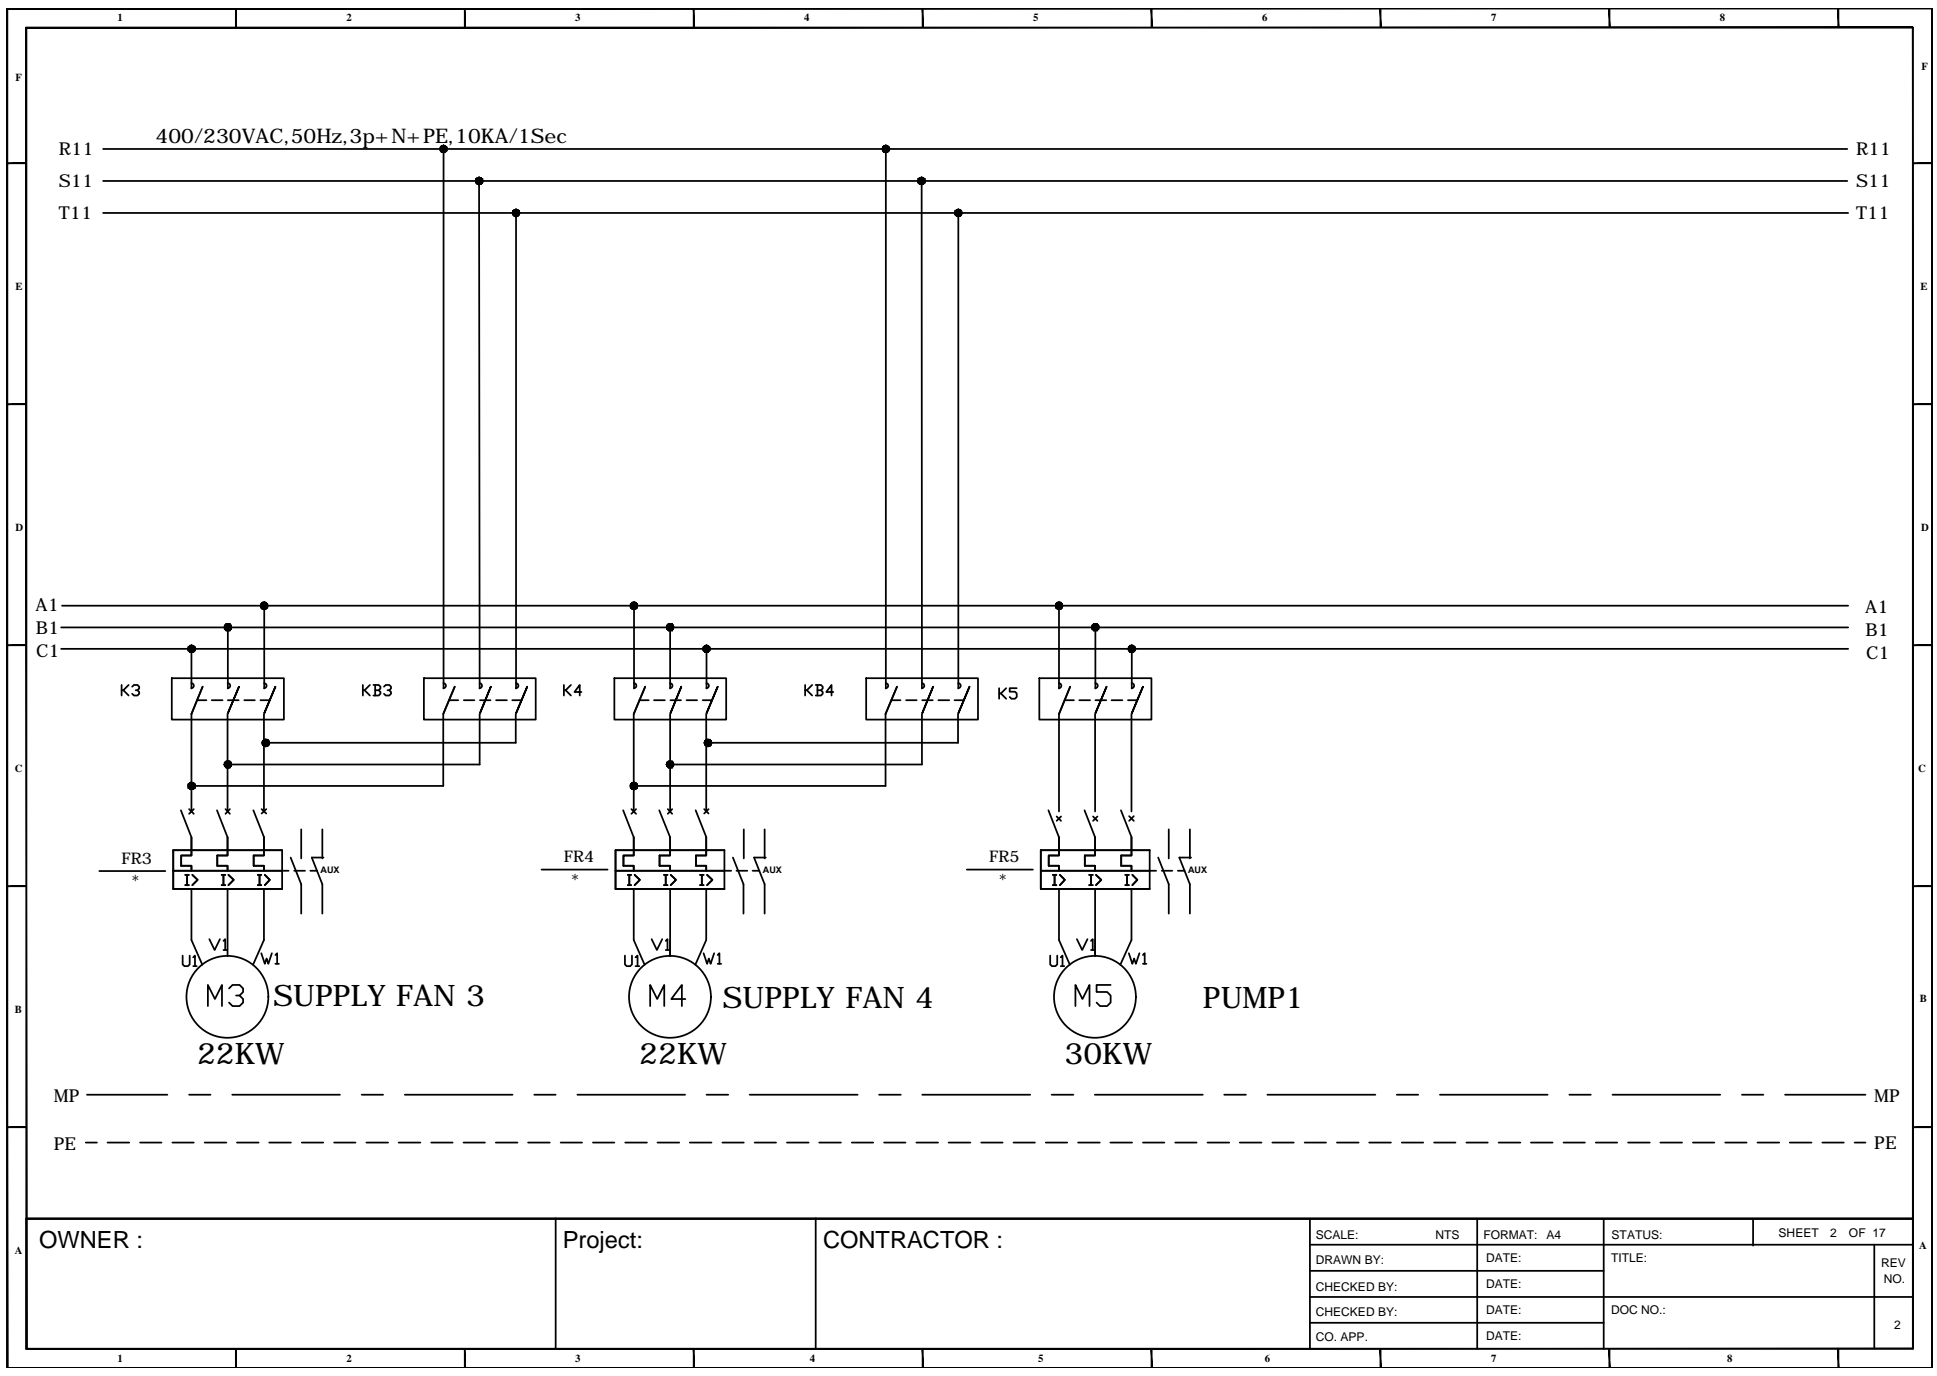
[picture p319: page 2]
FEACBD CAB; 8 OWNER :; CONTRACTOR :; REV SHEET; OF 17 TITLE: SCALE: CHECKED BY: DRAWN BY: CO. APP. CHECKED BY:; FORMAT:; STATUS:; NO. DOC NO.: NTS; 2 DATE: DATE: DATE: DATE: Project:; PEMP 400/230VAC,50Hz,3p+N+PE,10KA/1Sec 22KW; 22KW AUX; AUX R11 S11 T11 A1B1C1; FR4 * SUPPLY FAN 3; SUPPLY FAN 4; A1B1C1 30KW AUX FR5*; PUMP1

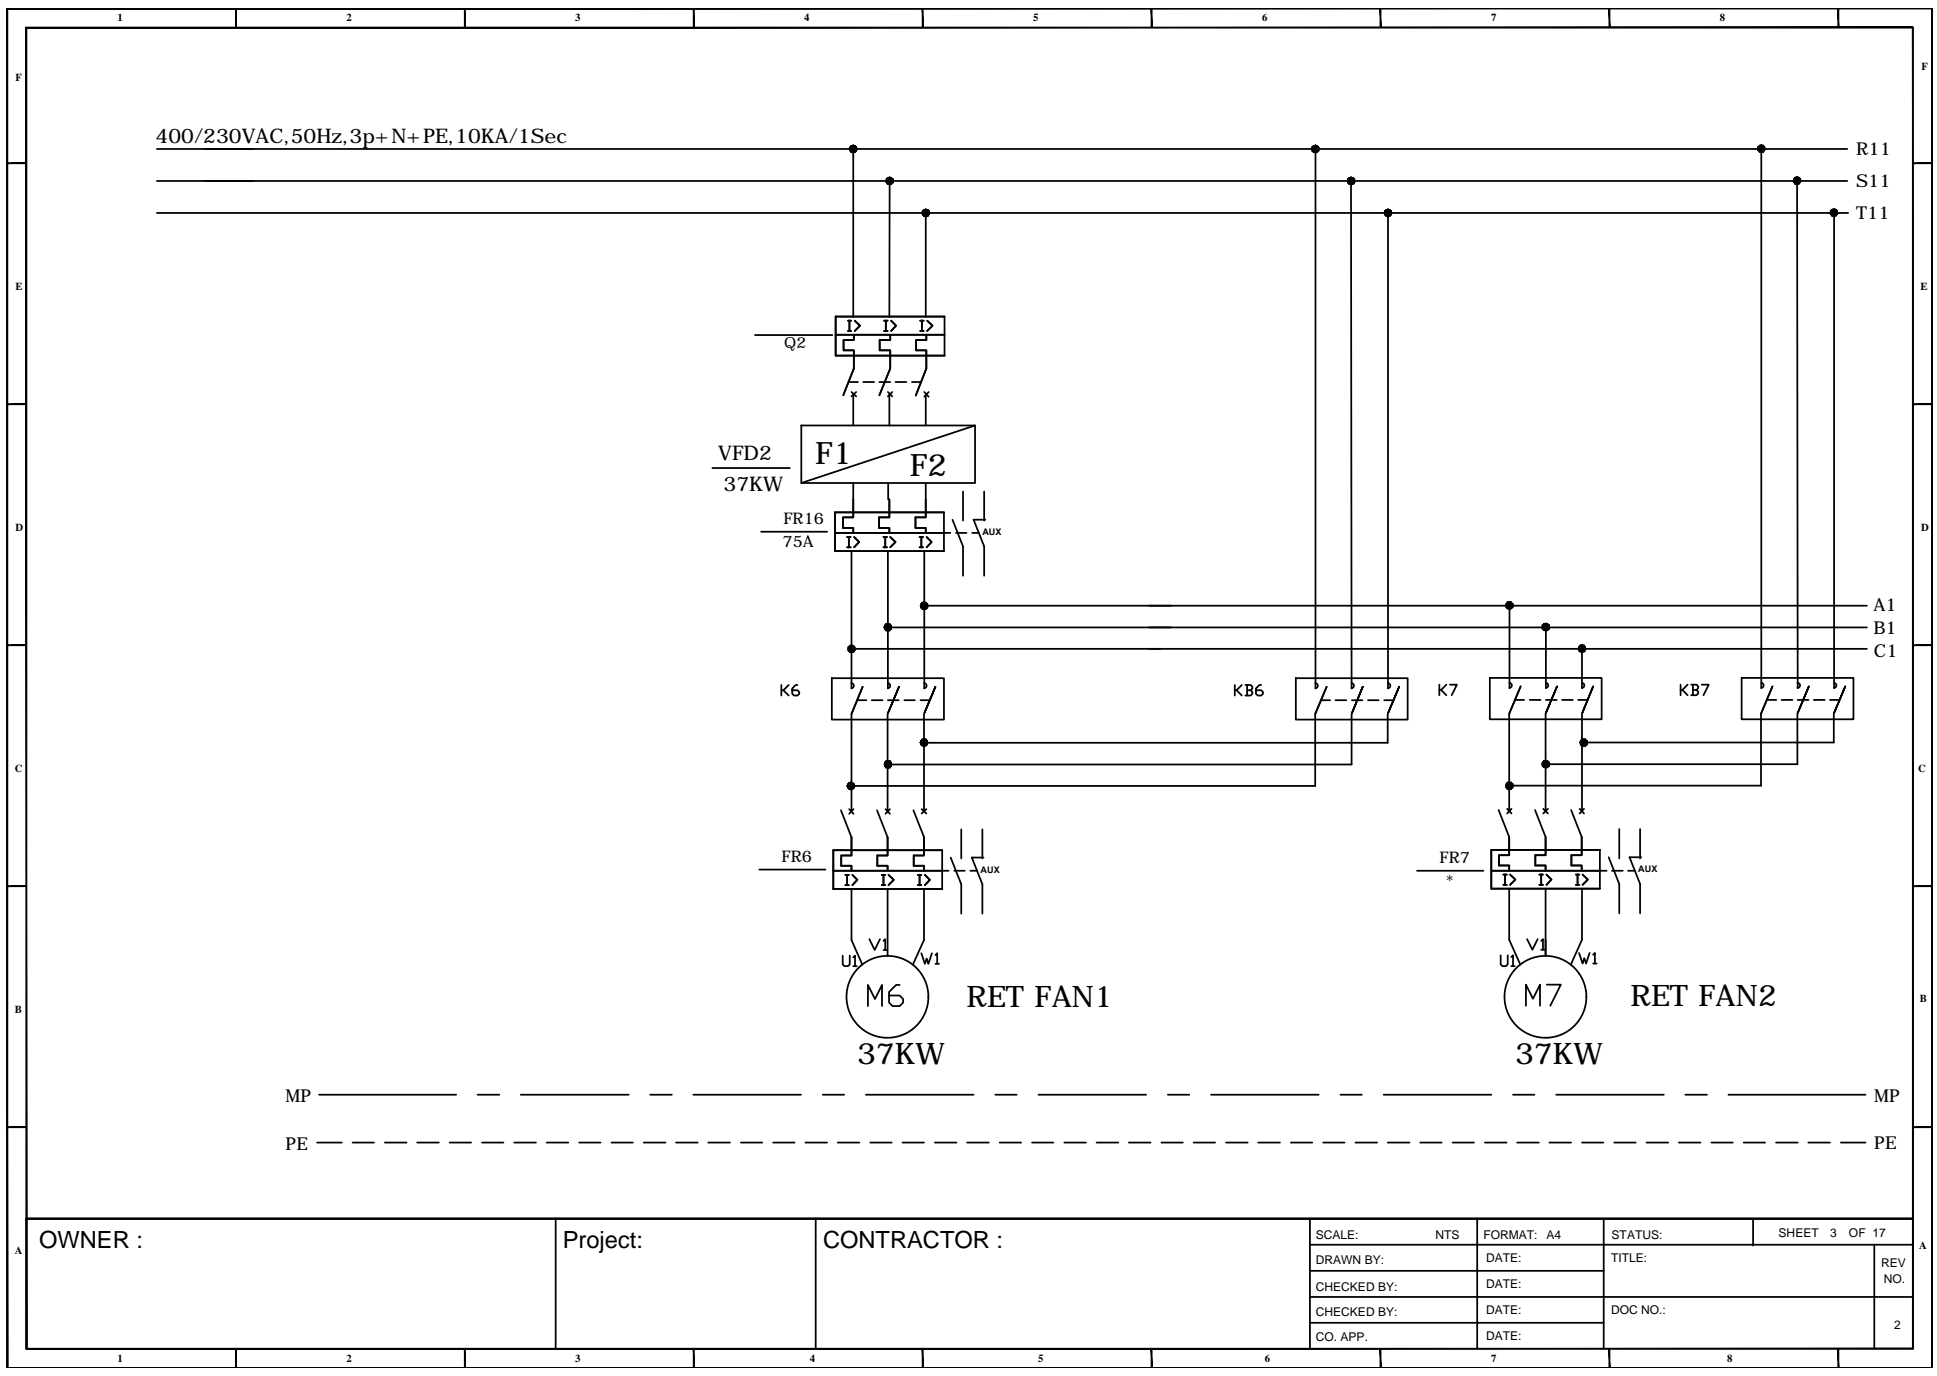
[picture p320: page 3]
FEACBD CAB; 8 OWNER :; CONTRACTOR :; REV SHEET; OF 17 TITLE: SCALE: CHECKED BY: DRAWN BY: CO. APP. CHECKED BY:; FORMAT:; STATUS:; NO. DOC NO.: NTS; 2 DATE: DATE: DATE: DATE: Project:; PEMP 400/230VAC,50Hz,3p+N+PE,10KA/1Sec; A1B1C1 37KW AUX FR7 *; RET FAN2 Q2 F1; F2 VFD2 37KW; 37KW AUX FR6; RET FAN1 AUX FR16 75A

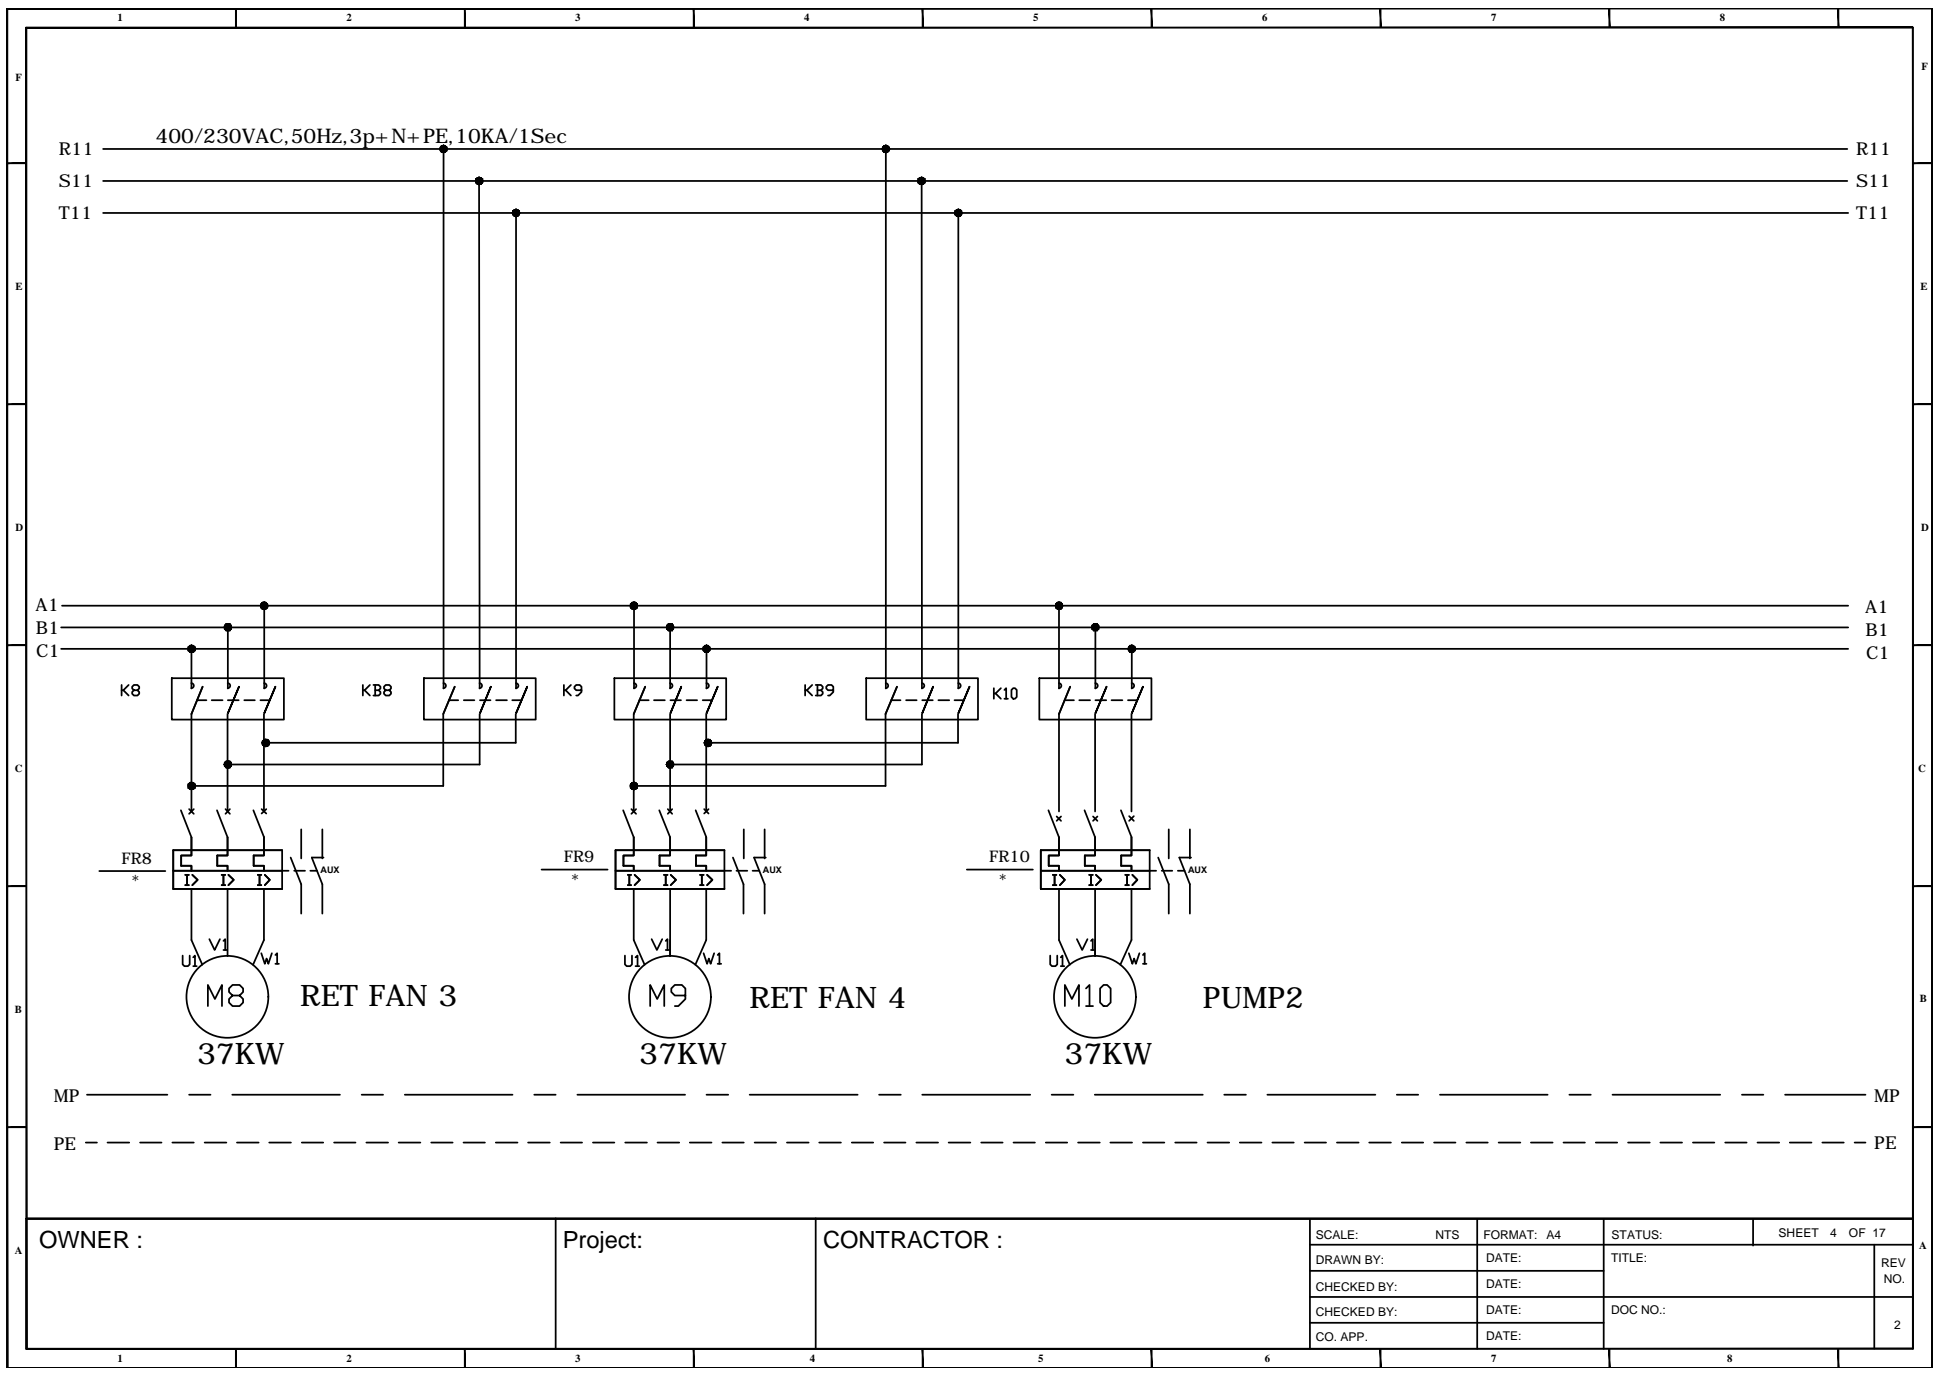
[picture p321: page 4]
FEACBD CAB; 8 OWNER :; CONTRACTOR :; REV SHEET; OF 17 TITLE: SCALE: CHECKED BY: DRAWN BY: CO. APP. CHECKED BY:; FORMAT:; STATUS:; NO. DOC NO.: NTS; 2 DATE: DATE: DATE: DATE: Project:; PEMP 400/230VAC,50Hz,3p+N+PE,10KA/1Sec 37KW; 37KW AUX; AUX R11 S11 T11 A1B1C1; FR9 * RET FAN 3; RET FAN 4; A1B1C1 37KW AUX FR10 *; PUMP2

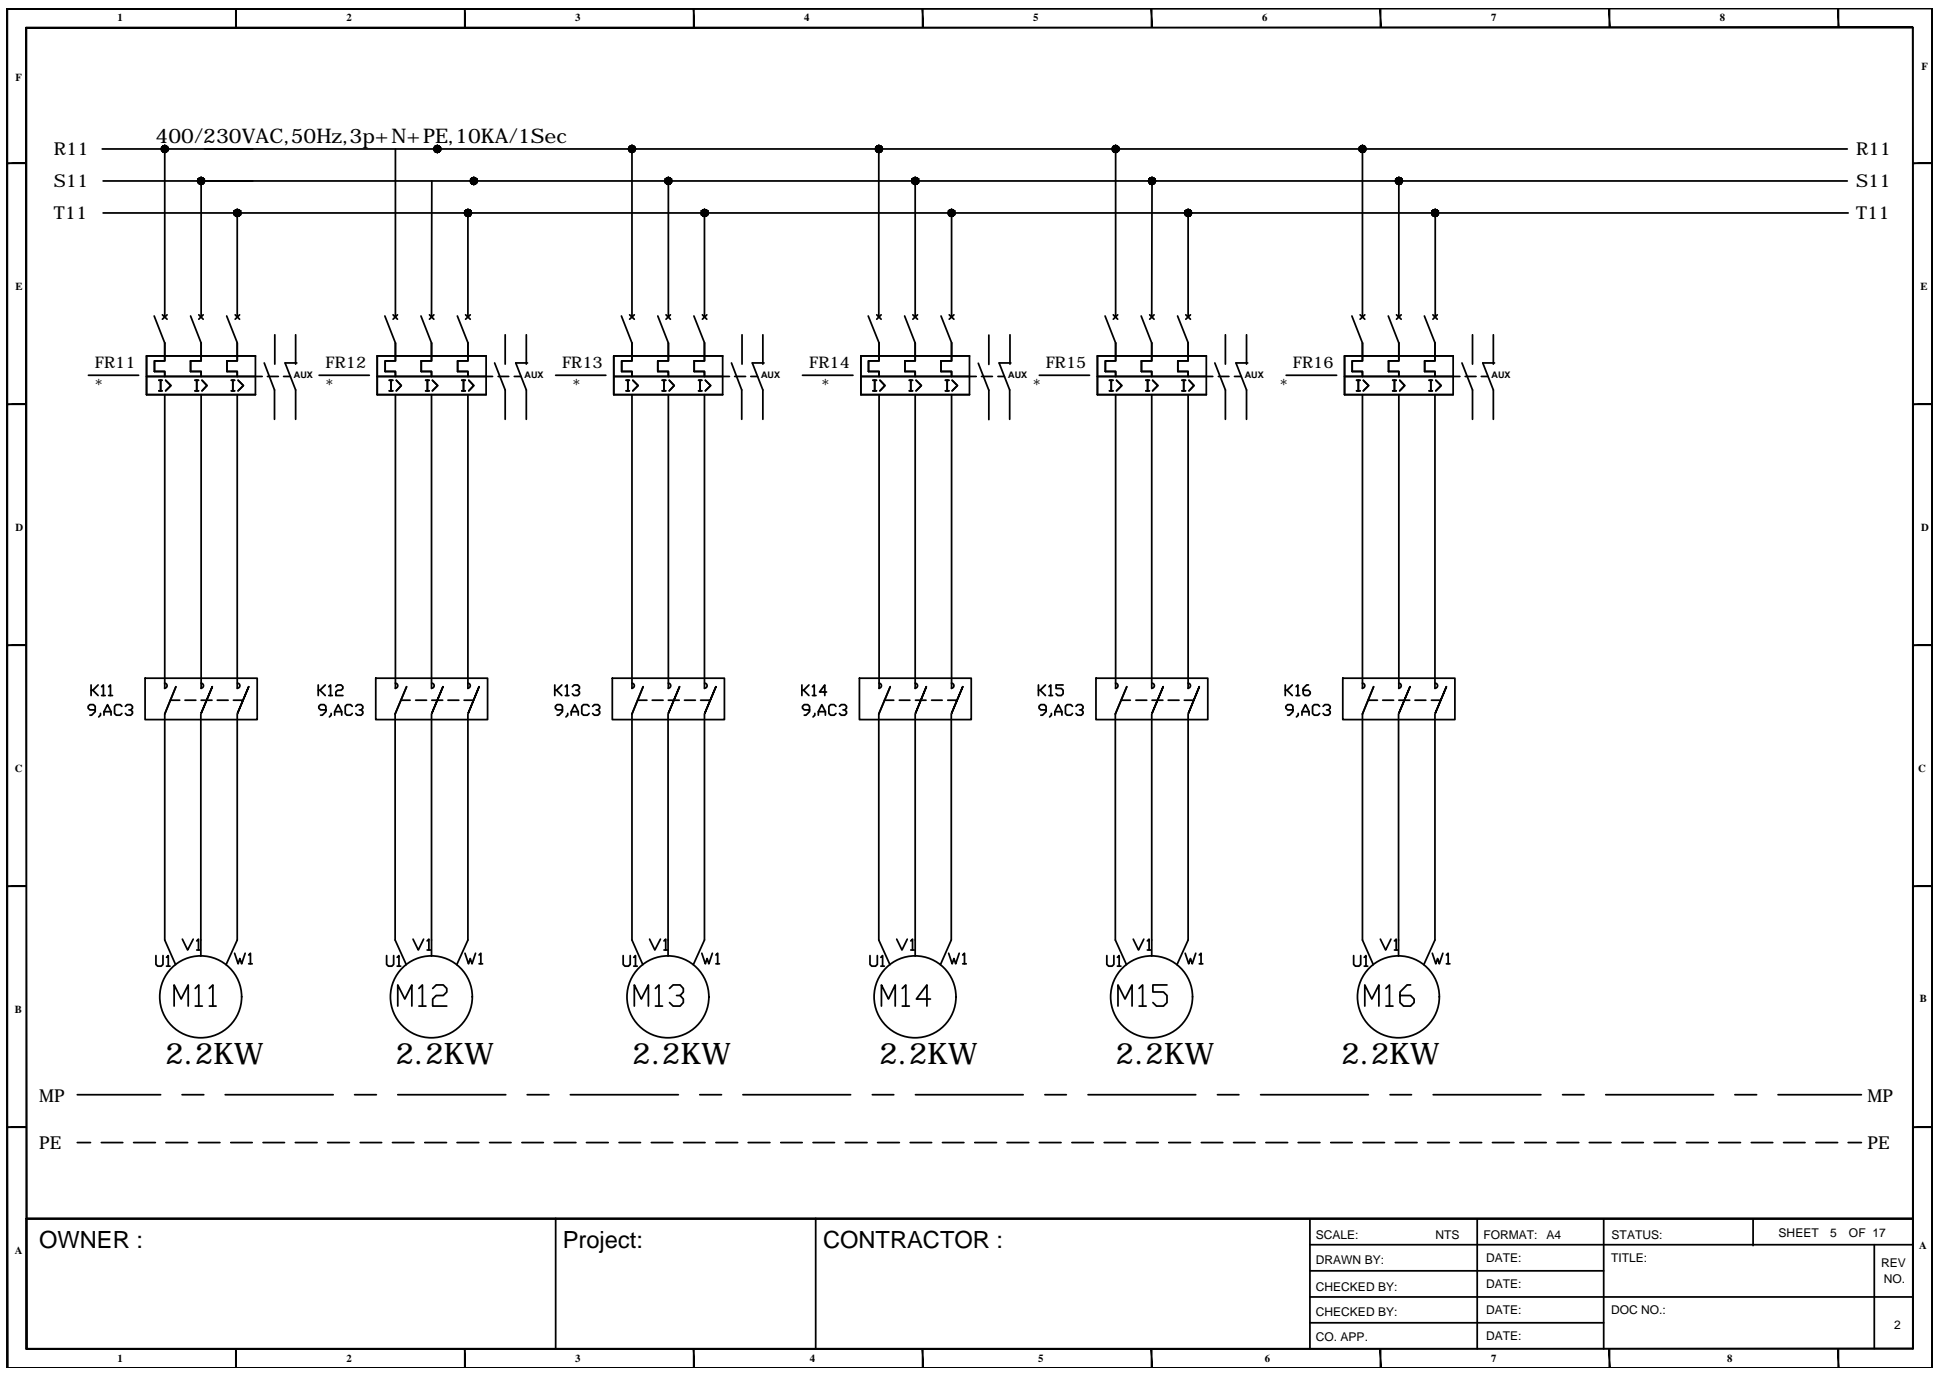
[picture p322: page 5]
FEACBD CAB; 8 OWNER :; CONTRACTOR :; REV SHEET; OF 17 TITLE: SCALE: CHECKED BY: DRAWN BY: CO. APP. CHECKED BY:; FORMAT:; STATUS:; NO. DOC NO.: NTS; 2 DATE: DATE: DATE: DATE: Project:; R11 S11 T11PEMP 400/230VAC,50Hz,3p+N+PE,10KA/1Sec R11 S11 T11; AUX FR11 *; 2.2KW PEMP; AUX FR12 *; AUX FR13; AUX FR14 *; AUX FR15 *; AUX FR16 2.2KW

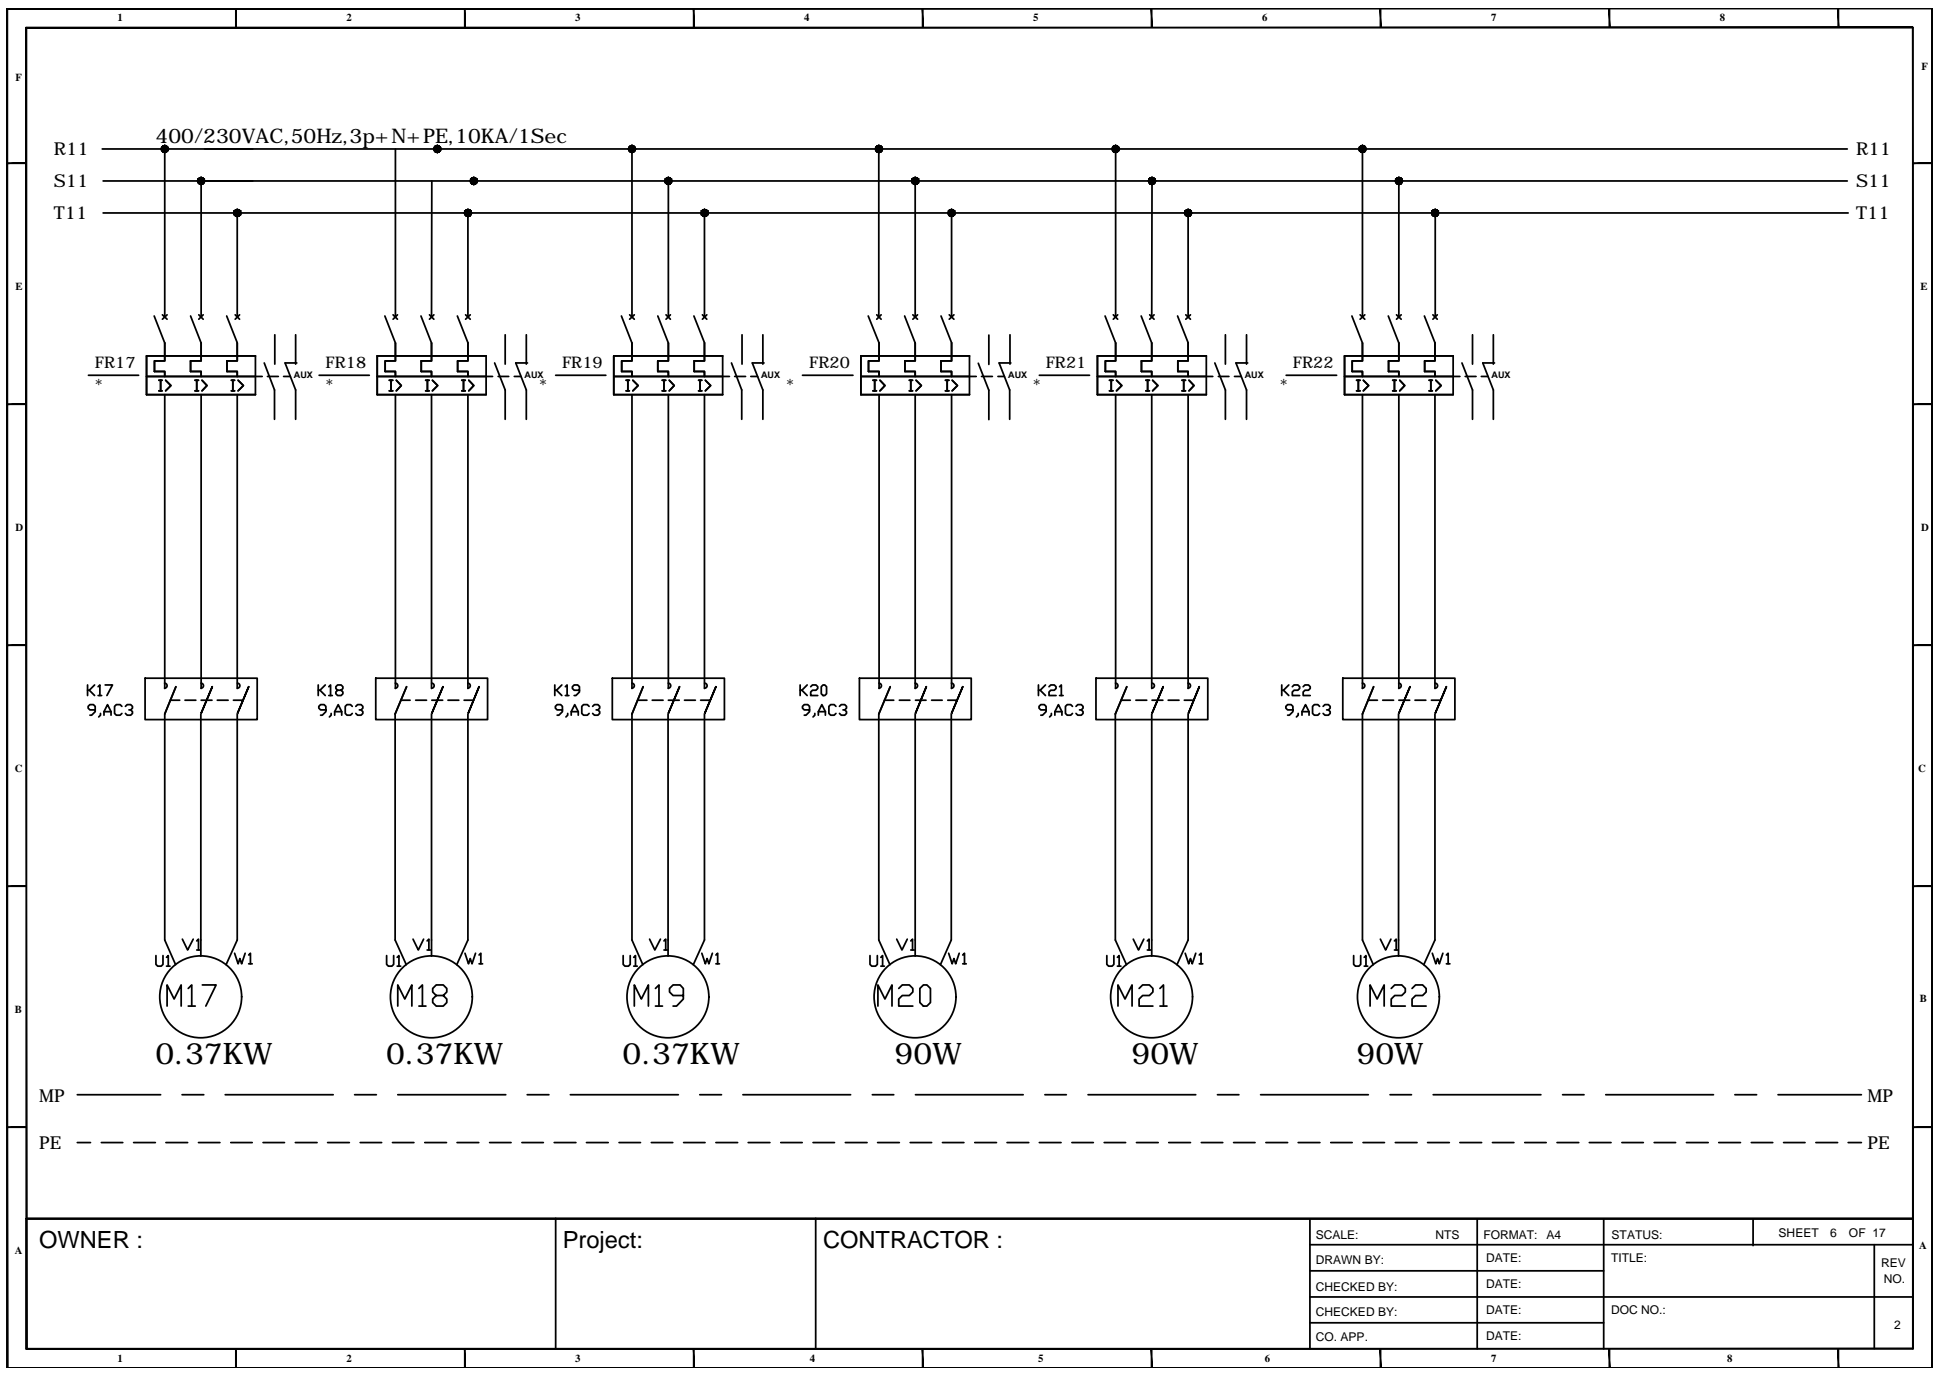
[picture p323: page 6]
FEACBD CAB; 8 OWNER :; CONTRACTOR :; REV SHEET; OF 17 TITLE: SCALE: CHECKED BY: DRAWN BY: CO. APP. CHECKED BY:; FORMAT:; STATUS:; NO. DOC NO.: NTS; 2 DATE: DATE: DATE: DATE: Project:; R11 S11 T11PEMP 400/230VAC,50Hz,3p+N+PE,10KA/1Sec R11 S11 T11; AUX FR17 *; 0.37KW PEMP; AUX FR18 *; AUX FR19; AUX FR20 *; AUX FR21 *; AUX FR22 90W

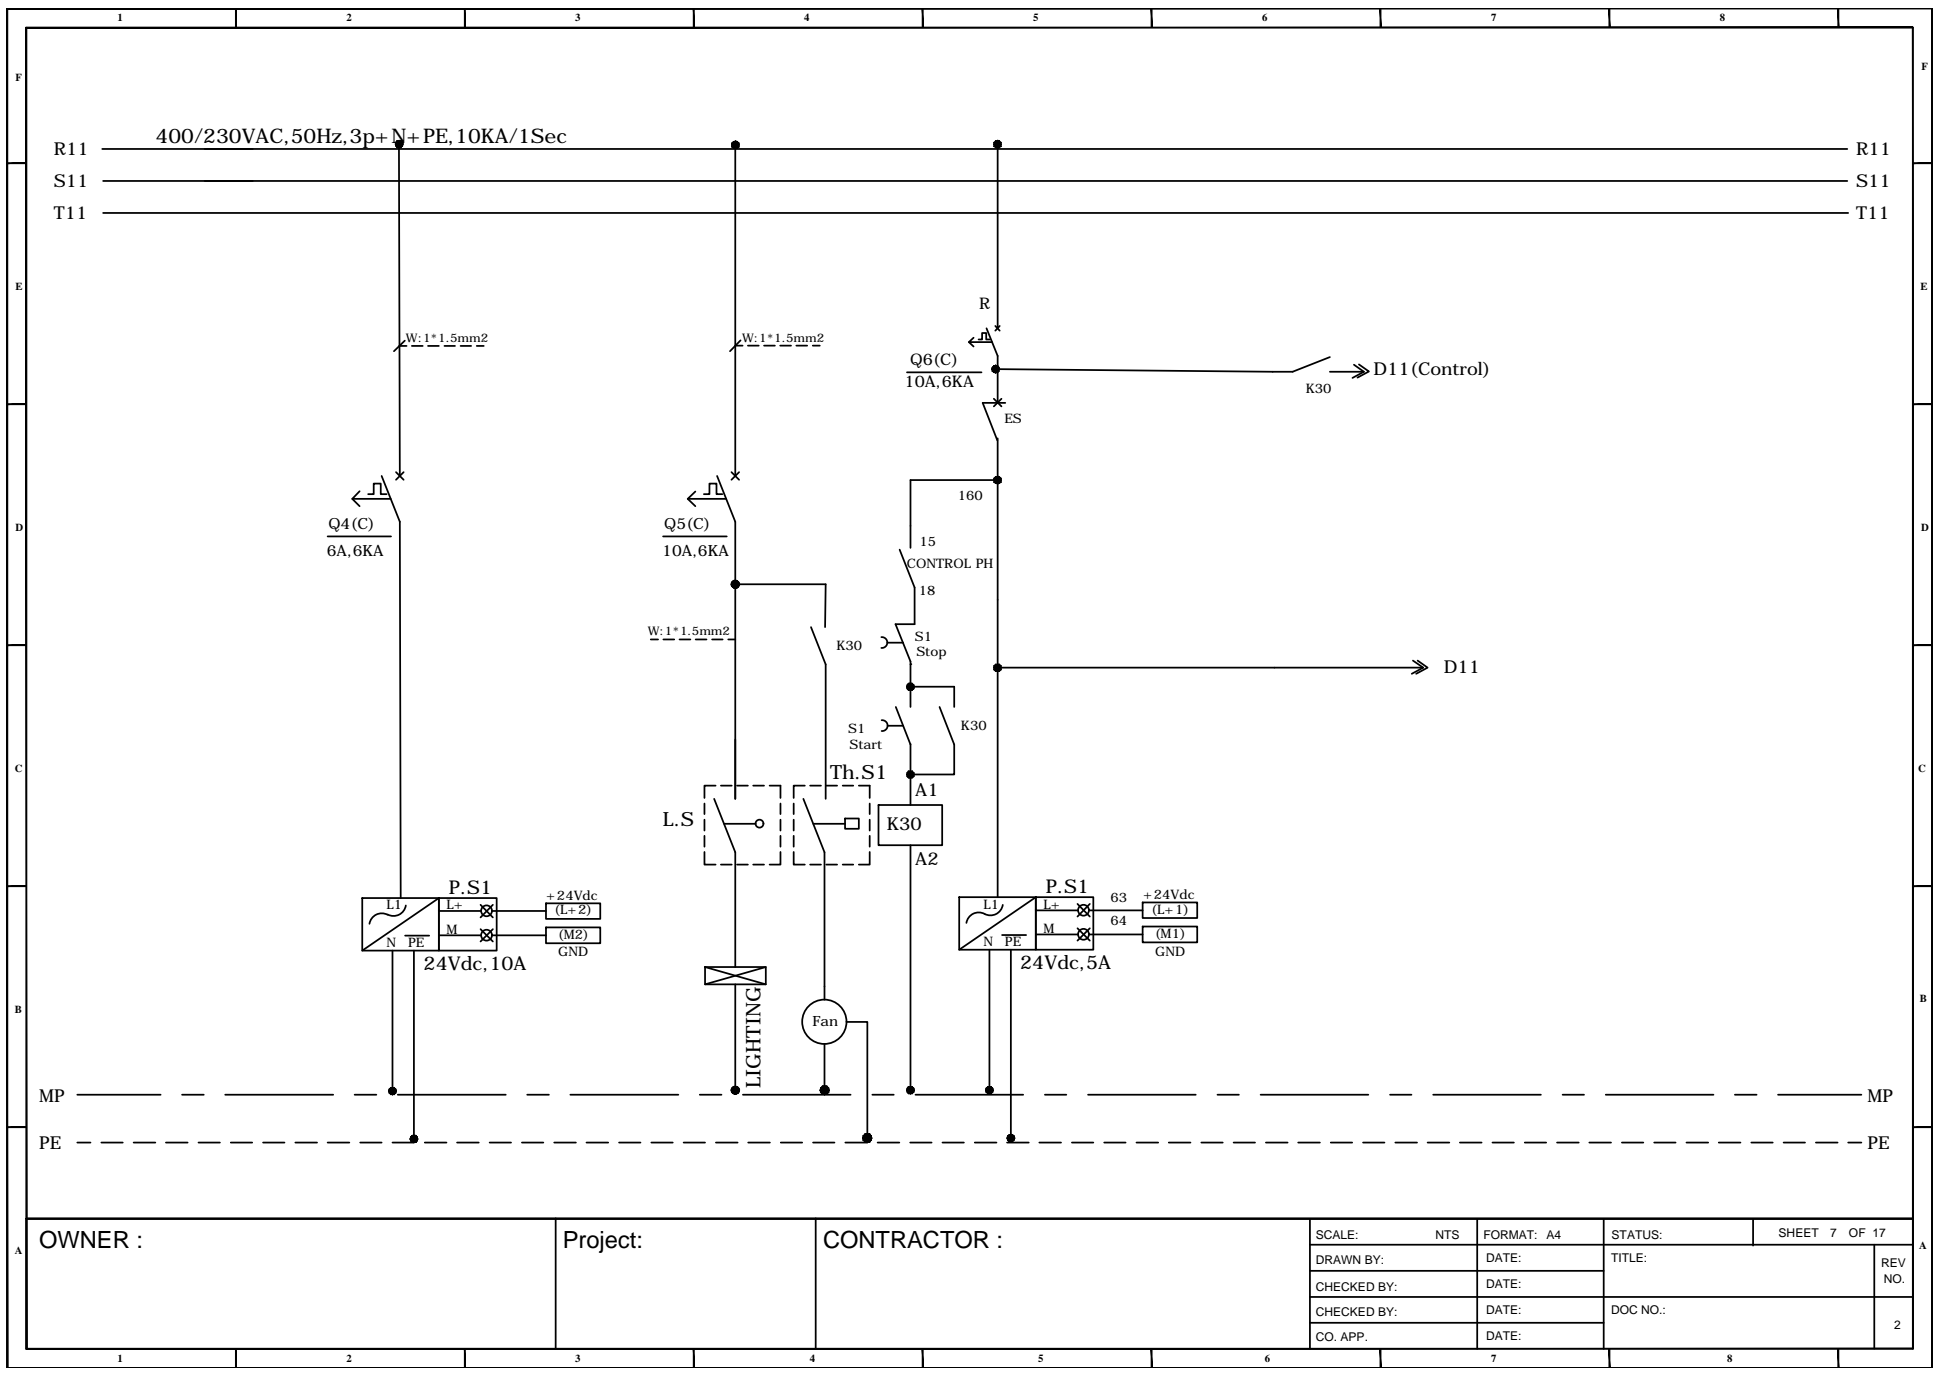
[picture p324: page 7]
FEACBD CAB; 8 OWNER :; CONTRACTOR :; REV SHEET; OF 17 TITLE: SCALE: CHECKED BY: DRAWN BY: CO. APP. CHECKED BY:; FORMAT:; STATUS:; NO. DOC NO.: NTS; 2 DATE: DATE: DATE: DATE: Project:; R11 S11 T11PEMP 400/230VAC,50Hz,3p+N+PE,10KA/1Sec R11 S11 T11 PEMP; P.S1 L+M 24Vdc,5A L1N PE Q6(C) 10A,6KA; +24Vdc GND (L+1) (M1); D11 Stop S1A1 K30A2 Start S1; D11(Control) W:1*1.5mm2

LIGHTING FanTh.S1 R 6364 160 P.S1 L+M 24Vdc,10A L1N PE +24Vdc GND (L+2) (M2) Q4(C) 6A,6KA W:1*1.5mm2 ES 1518 CONTROL PH K30

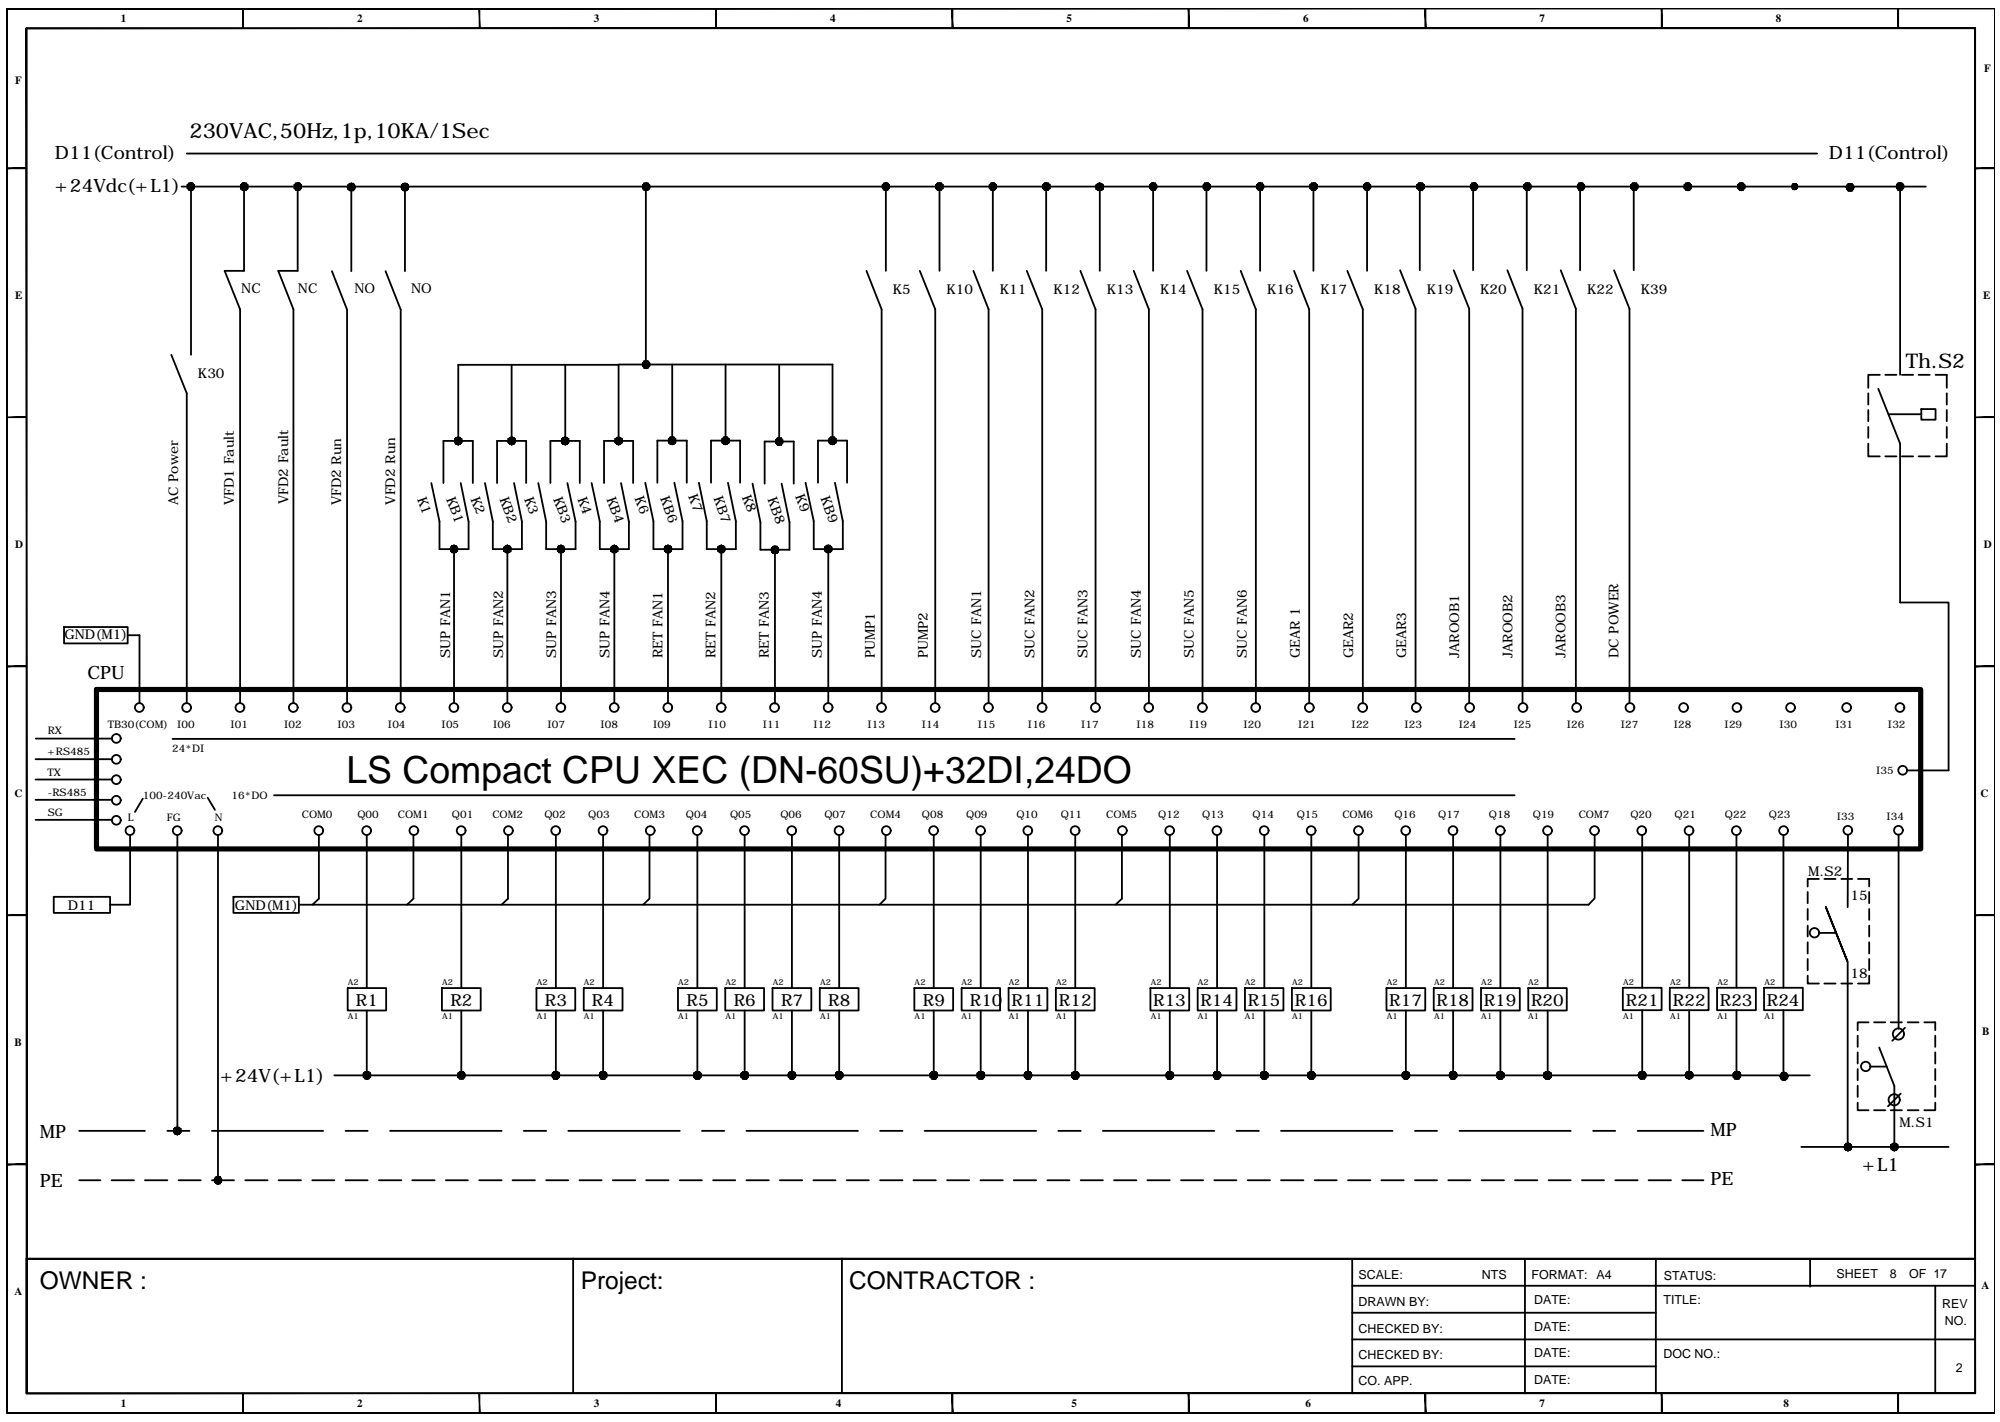
[picture p325: page 8]

JAROOB3 DC POWER NC NC NO NO

VFD2 Fault A2A1R13 A2A1R14 RX+RS485 TX-RS485 SG 16*DO COM1 COM2 COM3 Q04 Q05 Q06 Q07 COM4 Q08 Q09 Q10 Q11 COM5 Q12 Q13 Q14 Q15 I24 I25 I26 I27 I28 I29 I30 I31 I32 COM6 Q16 Q17 Q18 Q19 COM7 Q20 Q21 Q22 Q23 I33 I34 I35
TB30(COM) I00 24*DI CPU D11 GND(M1)

SUP FAN1 SUP FAN2 SUP FAN3 SUP FAN4 RET FAN1 RET FAN2 RET FAN3 SUP FAN4

PUMP2 SUC FAN1 SUC FAN2 SUC FAN3 SUC FAN4 SUC FAN5 SUC FAN6 GEAR 1 GEAR2 GEAR3

LS Compact CPU XEC (DN-60SU)+32DI,24DO

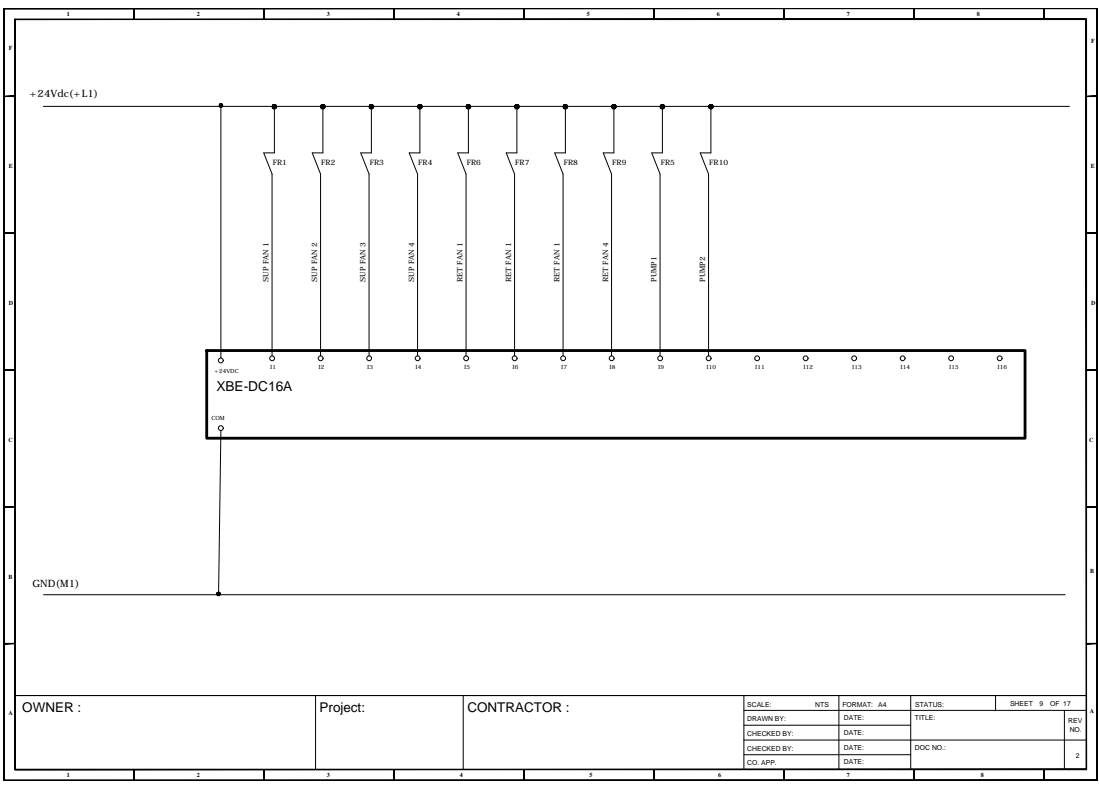
[picture p326: page 9]
FEACBD CAB; 8 OWNER :; CONTRACTOR :; REV SHEET; OF 17 TITLE: SCALE: CHECKED BY: DRAWN BY: CO. APP. CHECKED BY:; FORMAT:; STATUS:; NO. DOC NO.: NTS; 2 DATE: DATE: DATE: DATE: Project: +24Vdc(+L1) GND(M1); +24VDC COM XBE-DC16A I1; SUP FAN 1 FR1; SUP FAN 2 FR2; SUP FAN 3 FR3; SUP FAN 4 FR4; RET FAN 1 FR6; RET FAN 1 FR7; RET FAN 1 FR8; RET FAN 4 FR9; PUMP1 FR5; PUMP2 FR10

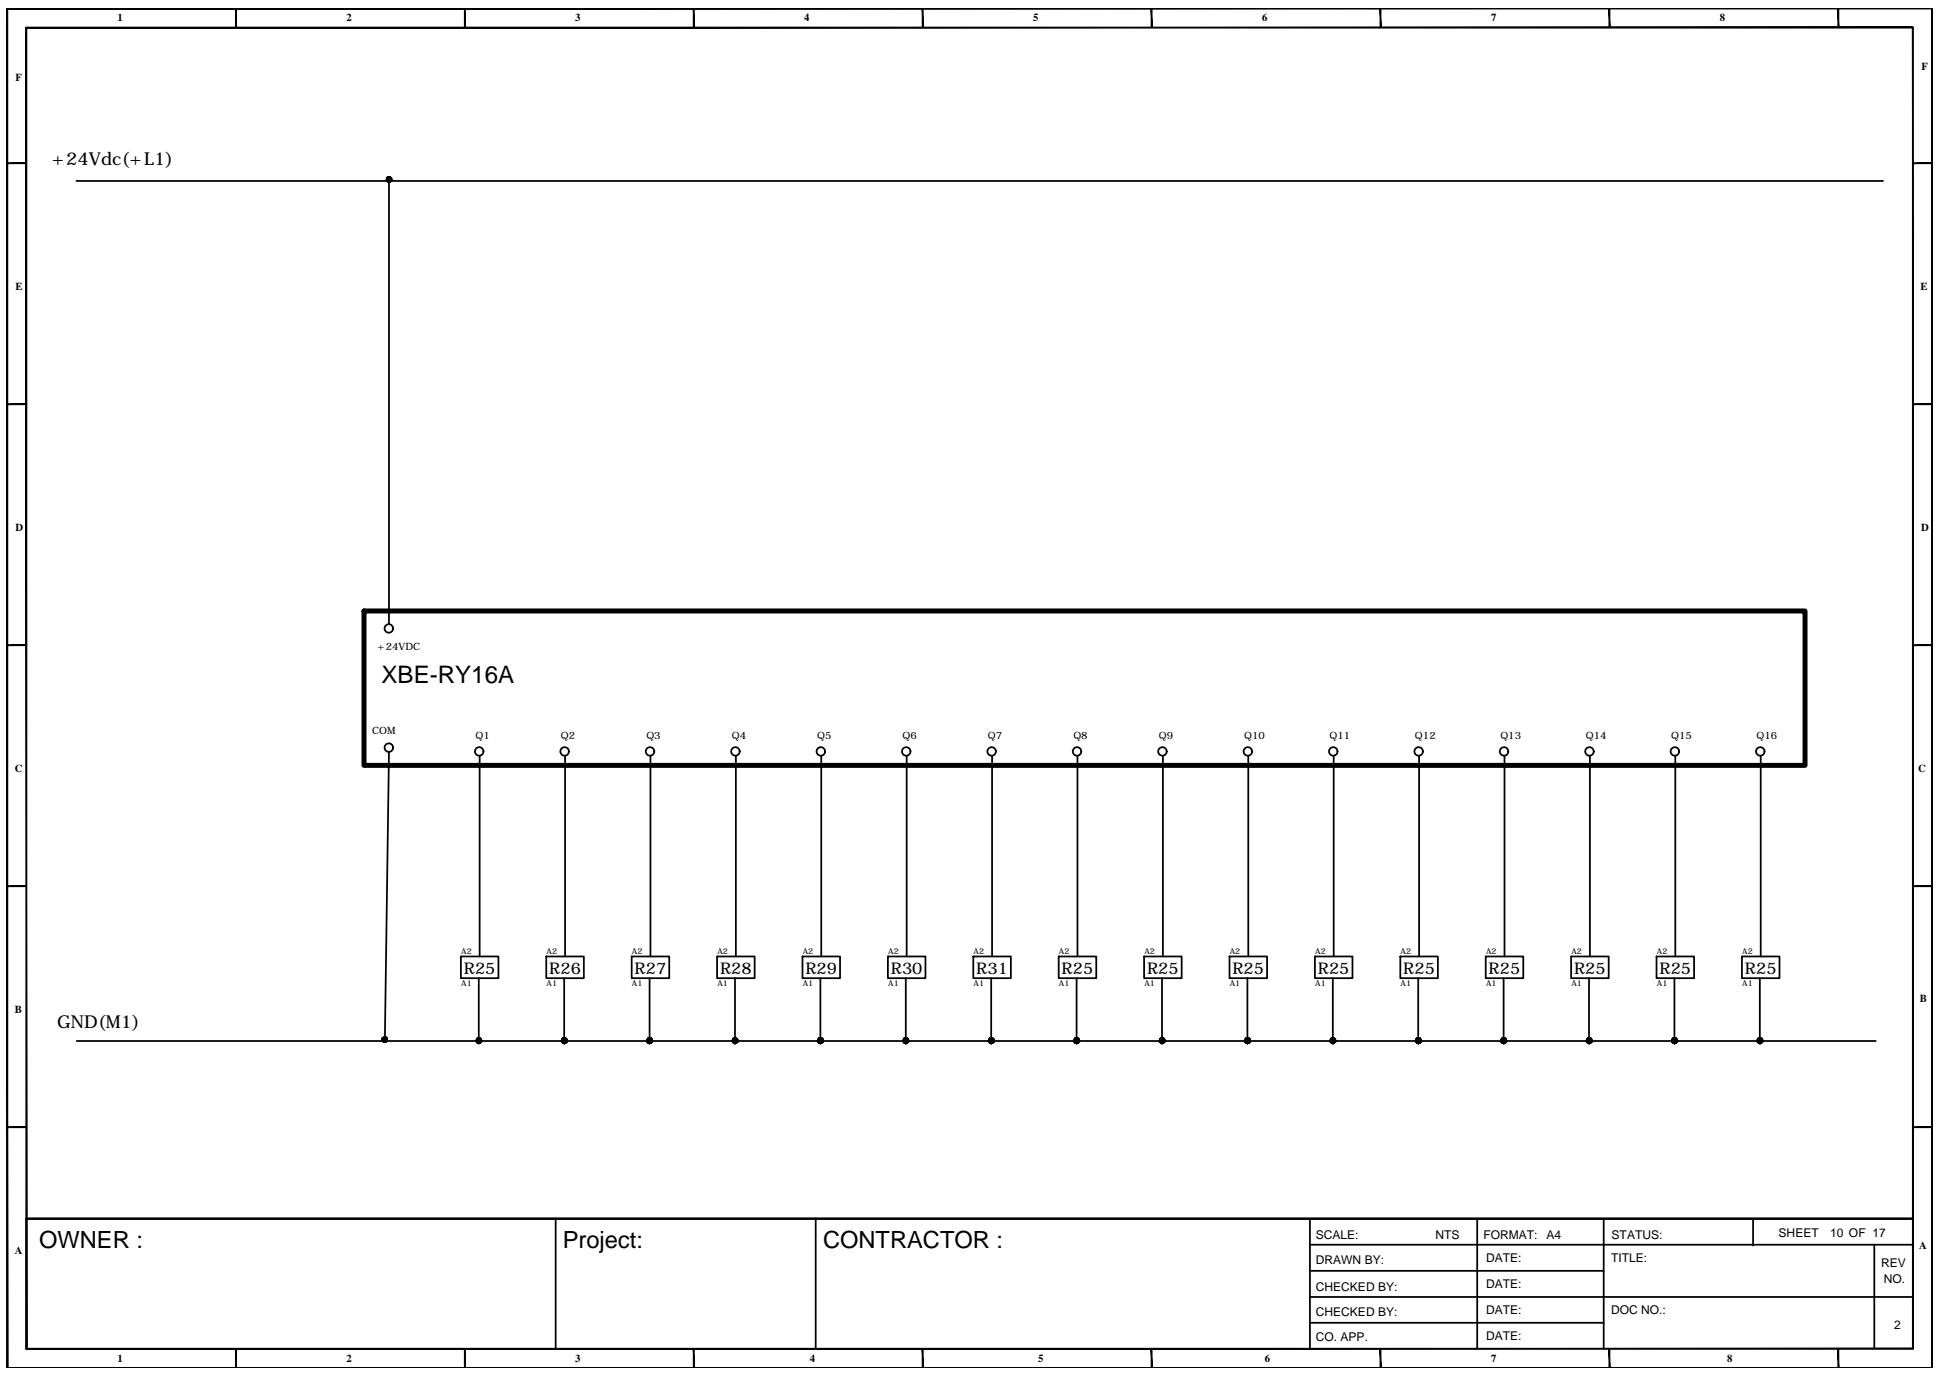
[picture p327: page 10]

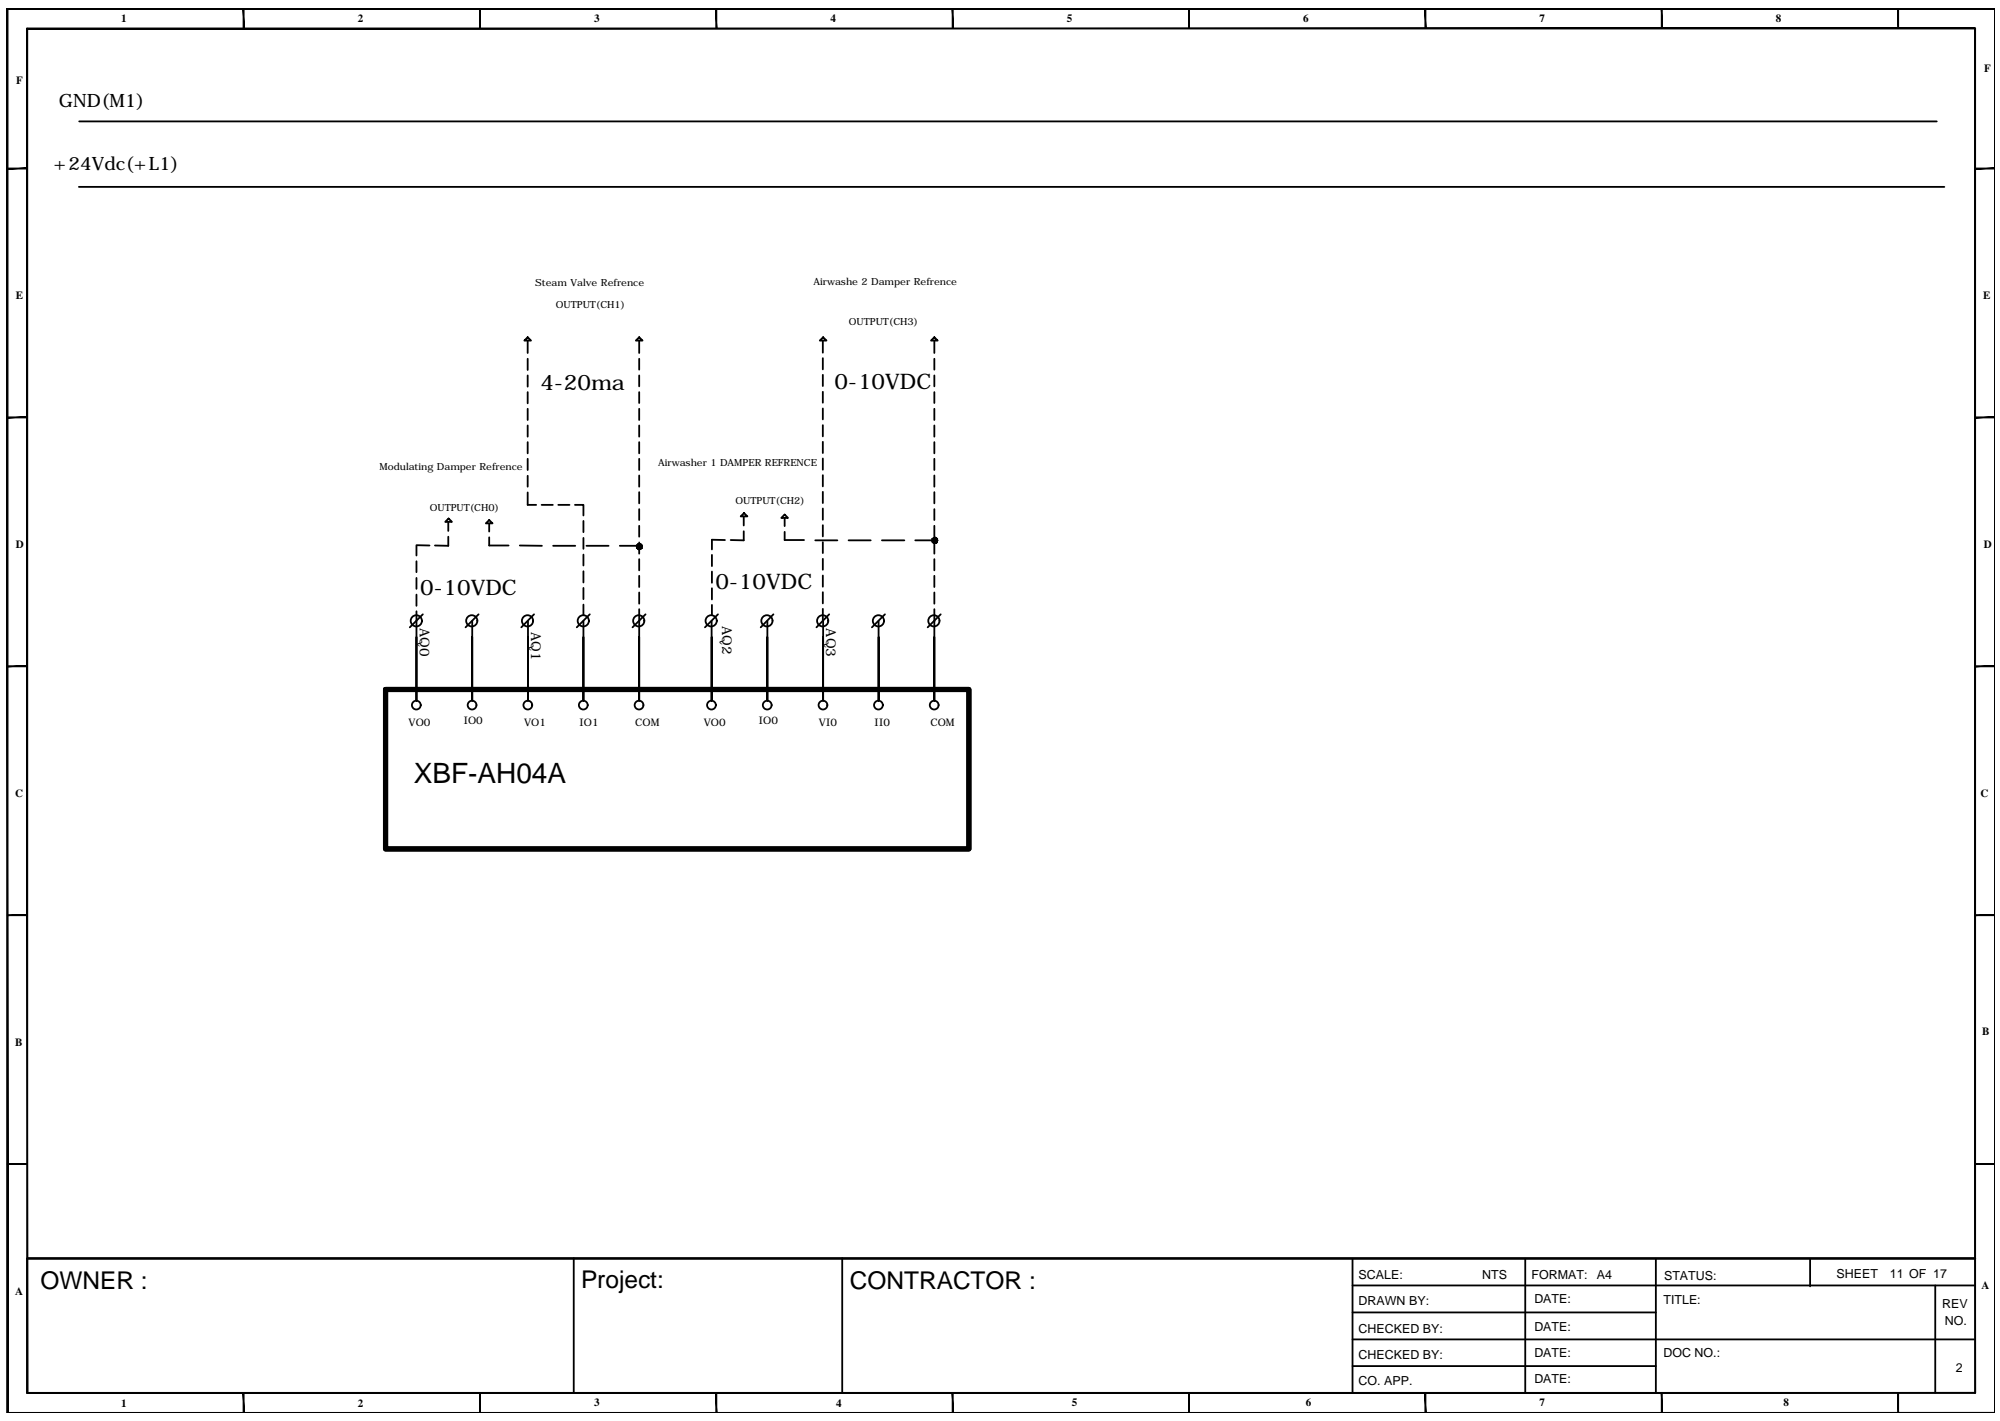
[picture p328: page 11]
FEACBD CAB; 8 OWNER :; CONTRACTOR :; REV SHEET; OF 17 TITLE: SCALE: CHECKED BY: DRAWN BY: CO. APP. CHECKED BY:; FORMAT:; STATUS:; NO. DOC NO.: NTS; 2 DATE: DATE: DATE: DATE: Project: +24Vdc(+L1) GND(M1); XBF-AH04A VO0; COM OUTPUT(CH0) 0-10VDC Modulating Damper Refrence; OUTPUT(CH1) 4-20ma Steam Valve Refrence; COM OUTPUT(CH3) 0-10VDC Airwasher 1 DAMPER REFRENCE OUTPUT(CH2) 0-10VDC

Airwashe 2 Damper Refrence

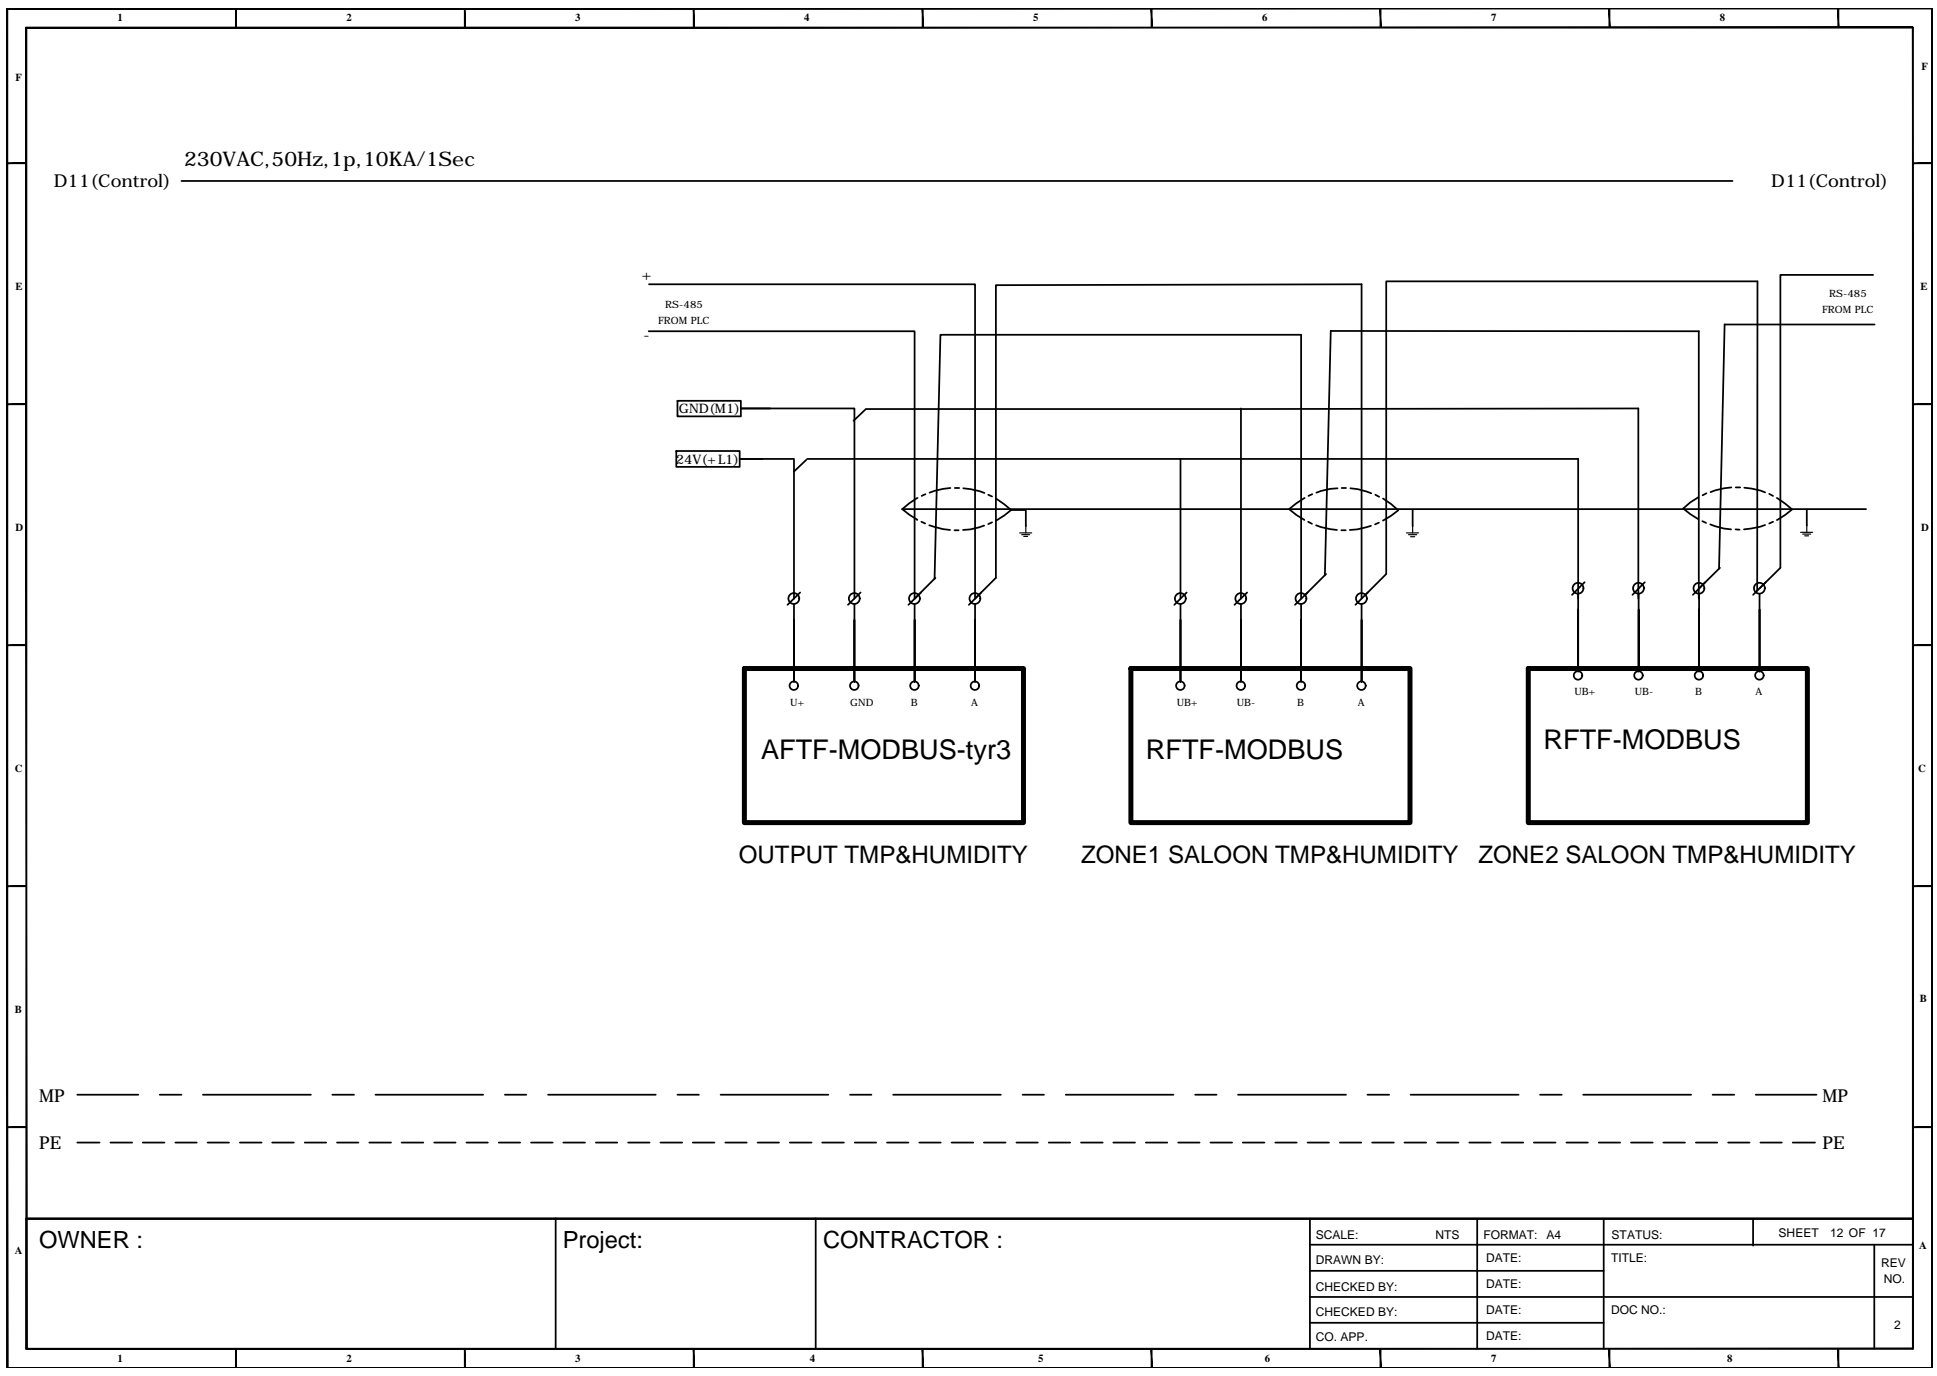
[picture p329: page 12]
FEACBD CAB; 8 OWNER :; CONTRACTOR :; REV SHEET; OF 17 TITLE: SCALE: CHECKED BY: DRAWN BY: CO. APP. CHECKED BY:; FORMAT:; STATUS:; NO. DOC NO.: NTS; 2 DATE: DATE: DATE: DATE: Project:; PEMP 230VAC,50Hz,1p,10KA/1Sec D11(Control) PEMP; D11(Control) GND(M1); AFTF-MODBUS-tyr3 24V(+L1); GND; A RS-485 FROM PLC +-; OUTPUT TMP&HUMIDITY; RFTF-MODBUS UB+; A ZONE1 SALOON TMP&HUMIDITY; A ZONE2 SALOON TMP&HUMIDITYRS-485 FROM PLC

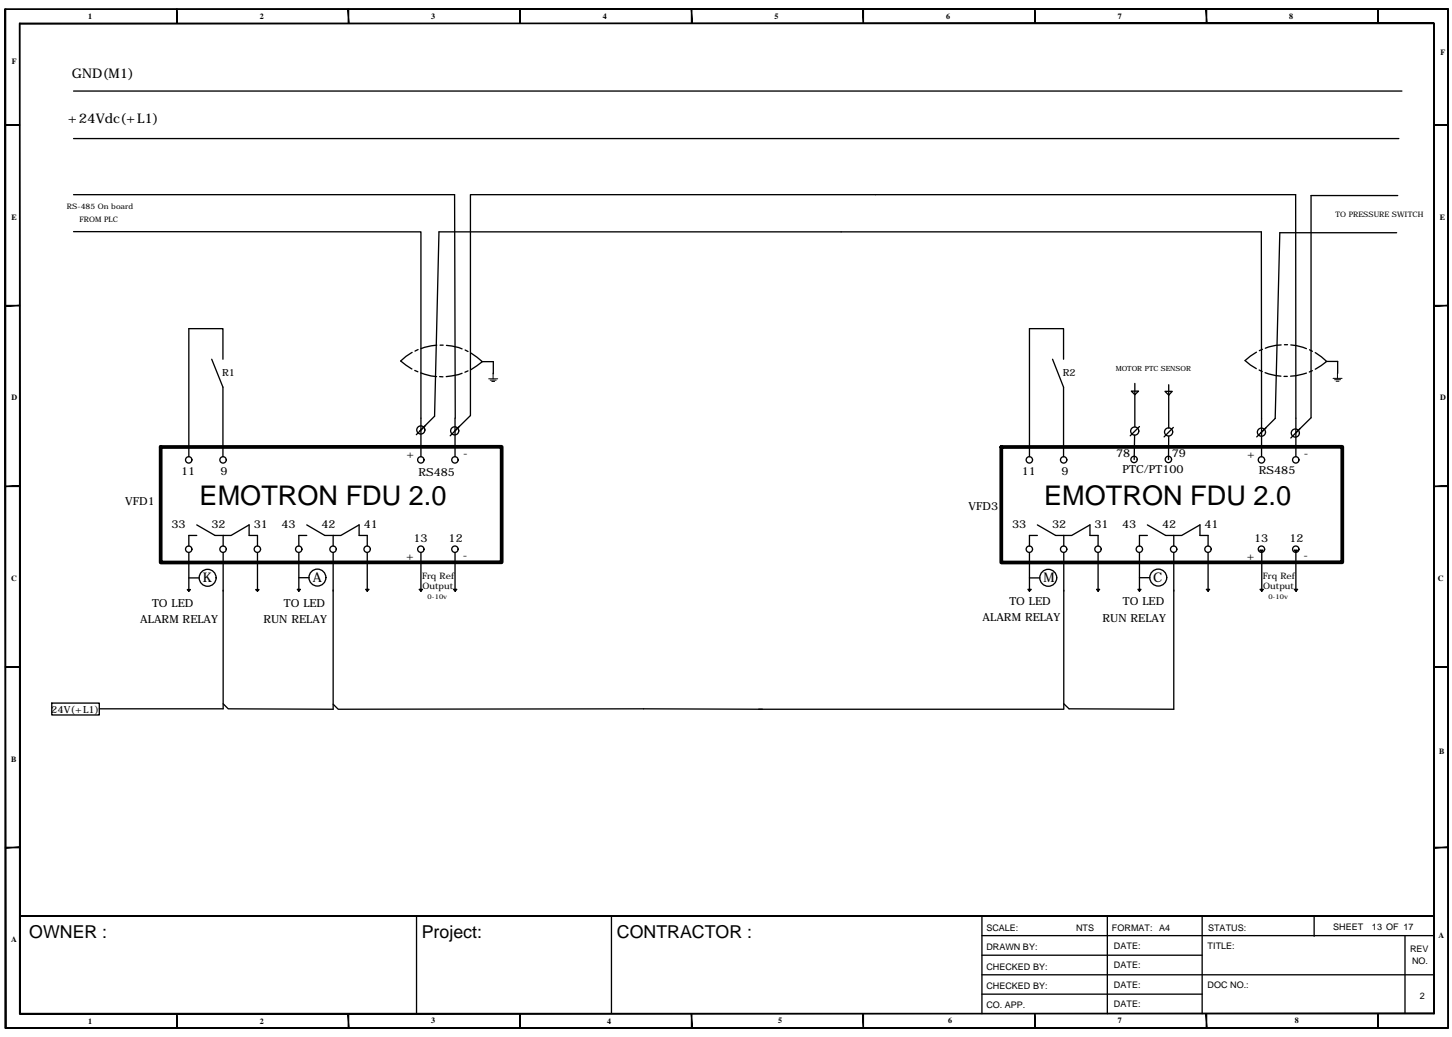
[picture p330: page 13]
FEACBD CAB; 8 OWNER :; CONTRACTOR :; REV SHEET; OF 17 TITLE: SCALE: CHECKED BY: DRAWN BY: CO. APP. CHECKED BY:; FORMAT:; STATUS:; NO. DOC NO.: NTS; 2 DATE: DATE: DATE: DATE: Project: +24Vdc(+L1) GND(M1) 24V(+L1); EMOTRON FDU 2.0 11; - TO LED; TO LED ALARM RELAY; - FROM PLC; TO PRESSURE SWITCH RS485 RUN RELAY; TO LED; RUN RELAY K; Frq Ref; C Output 0-10v; Frq Ref Output 0-10v RS-485 On boardVFD1; VFD3; 79 PTC/PT100 MOTOR PTC SENSOR

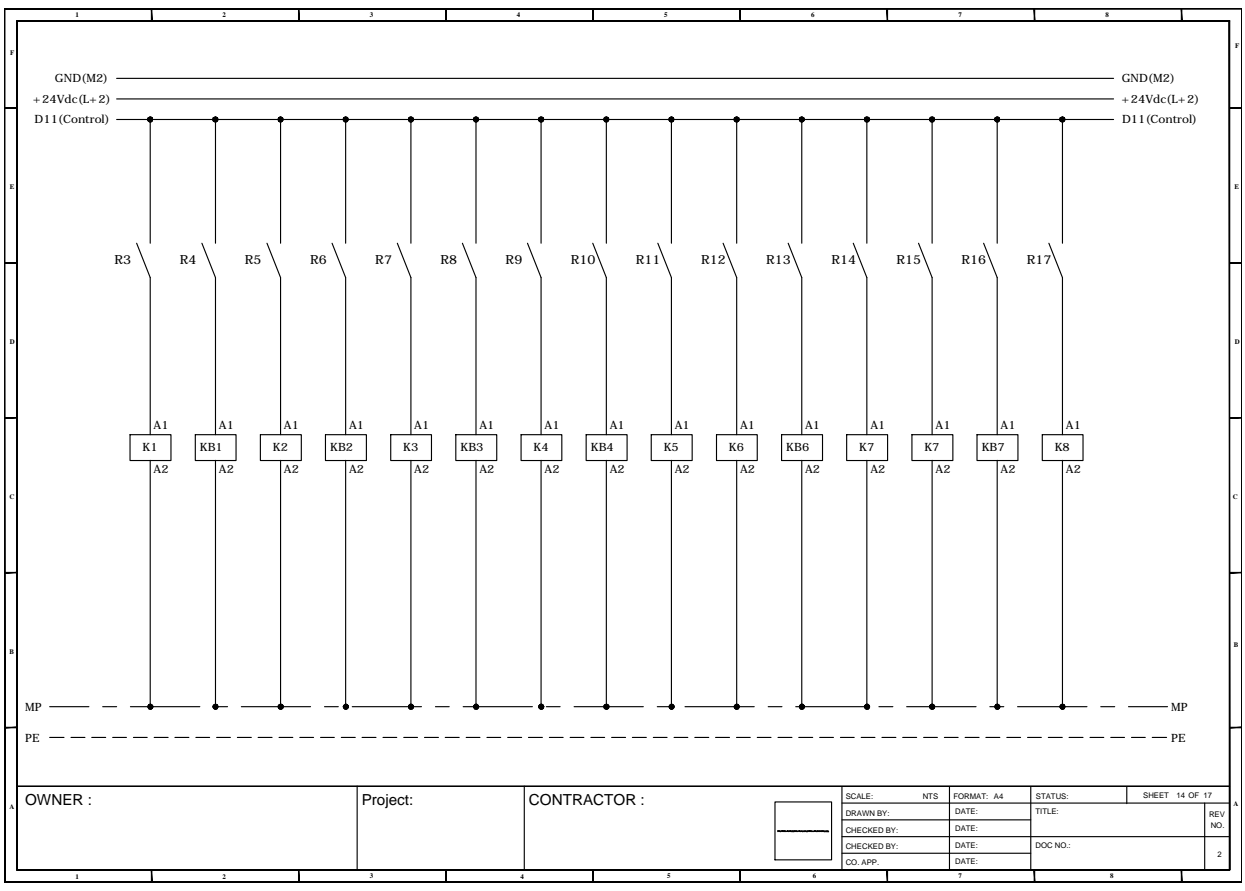
[picture p331: page 14]

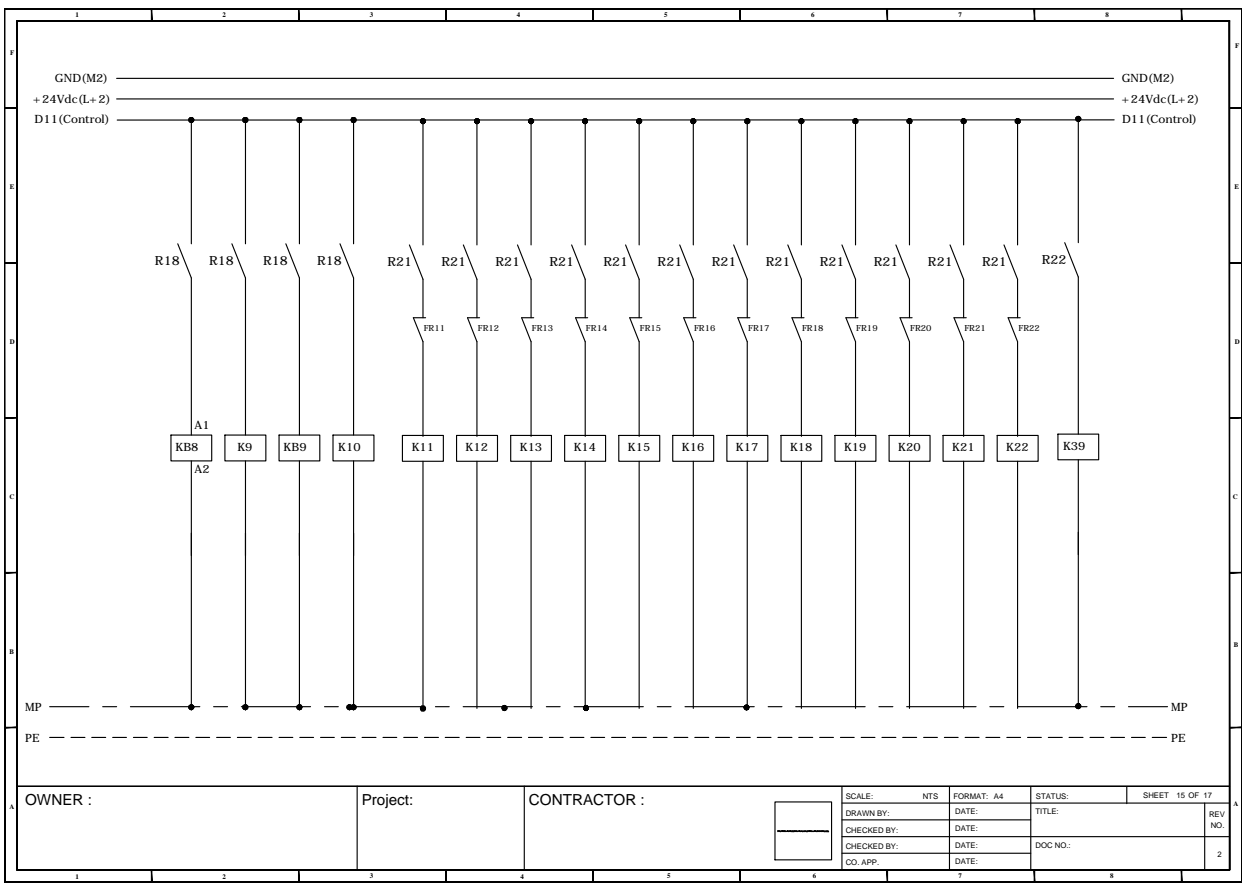
[picture p332: page 15]
FEACBD CAB; 8 OWNER :; CONTRACTOR :; REV SHEET; OF 17 TITLE: SCALE: CHECKED BY: DRAWN BY: CO. APP. CHECKED BY:; FORMAT:; STATUS:; NO. DOC NO.: NTS; 2 DATE: DATE: DATE: DATE: Project:; PEMP D11(Control) PEMP; D11(Control) +24Vdc(L+2) GND(M2); +24Vdc(L+2) GND(M2) A1A2

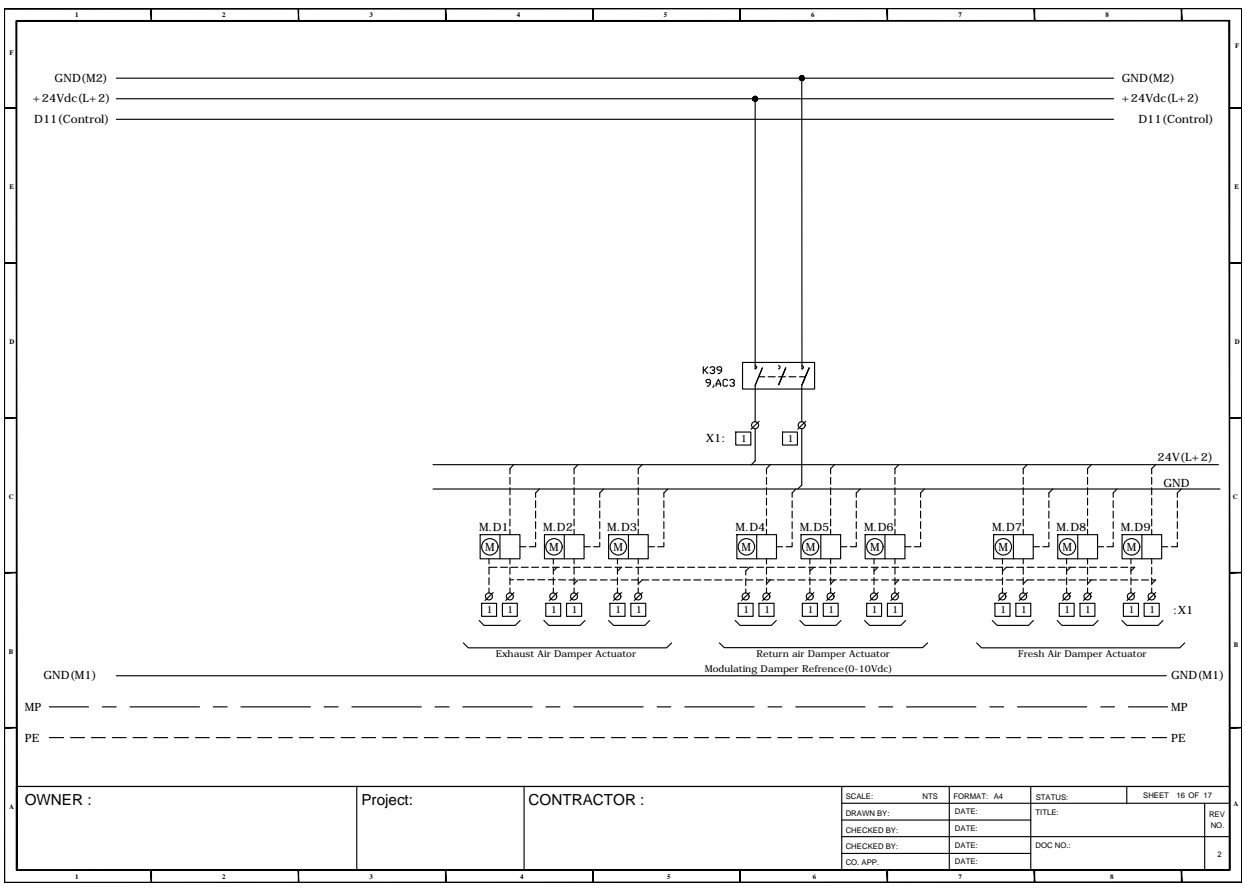
[picture p333: page 16]
FEACBD CAB; 8 OWNER :; CONTRACTOR :; REV SHEET; OF 17 TITLE: SCALE: CHECKED BY: DRAWN BY: CO. APP. CHECKED BY:; FORMAT:; STATUS:; NO. DOC NO.: NTS; 2 DATE: DATE: DATE: DATE: Project:; PEMP D11(Control) PEMP; GND(M1) D11(Control) GND(M1) +24Vdc(L+2) GND(M2); +24Vdc(L+2) GND(M2) X1:; 24V(L+2) GND MM.D1; Modulating Damper Refrence(0-10Vdc) 1; :X1 Exhaust Air Damper Actuator; Return air Damper Actuator; Fresh Air Damper Actuator

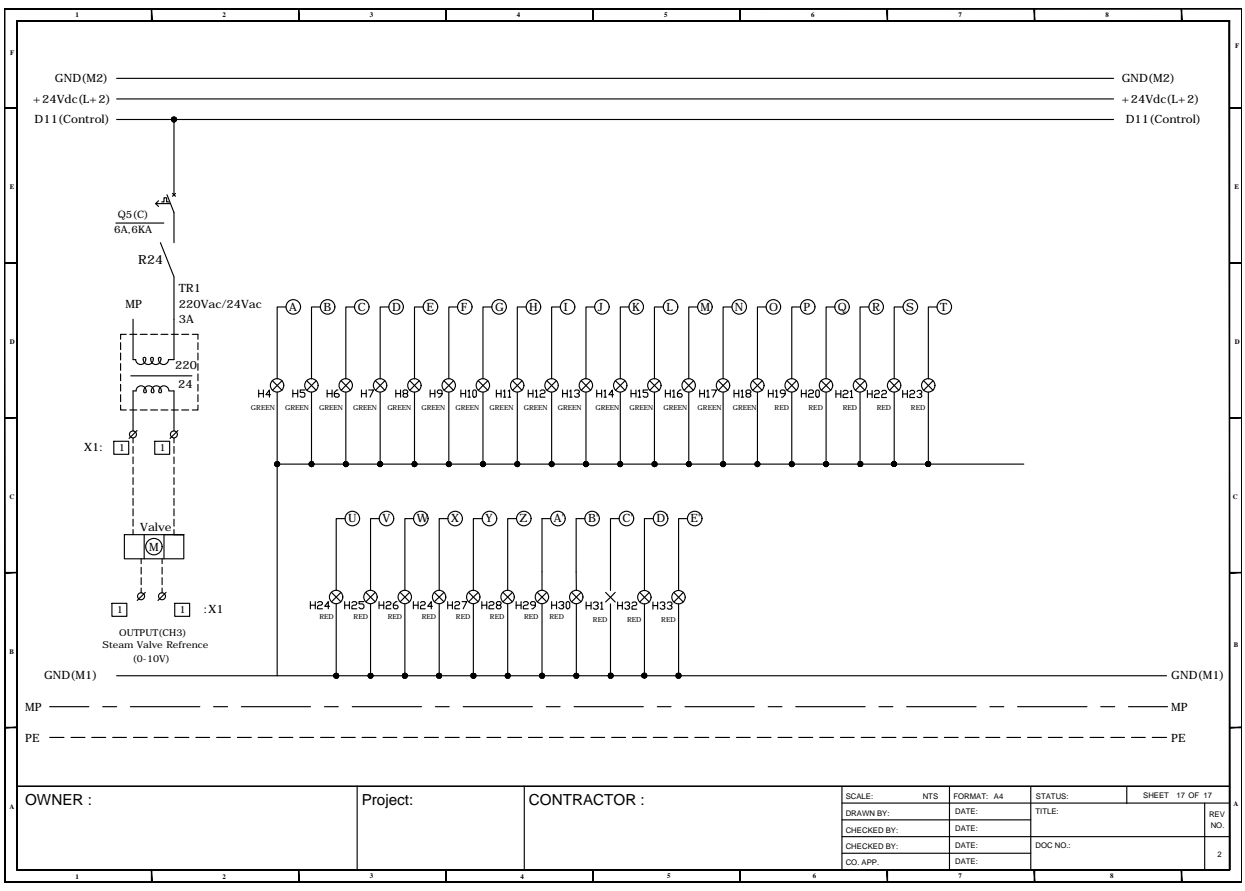
[picture p334: page 17]
FEACBD CAB; 8 OWNER :; CONTRACTOR :; REV SHEET; OF 17 TITLE: SCALE: CHECKED BY: DRAWN BY: CO. APP. CHECKED BY:; FORMAT:; STATUS:; NO. DOC NO.: NTS; 2 DATE: DATE: DATE: DATE: Project:; PEMP D11(Control) PEMP; GND(M1) D11(Control) GND(M1); 220Vac/24Vac 3A 220 24 X1:; 1 MValve 1; 1 OUTPUT(CH3) Steam Valve Refrence:X1 (0-10V); B' +24Vdc(L+2) GND(M2); +24Vdc(L+2) GND(M2) A; T GREEN; GREEN; RED; RED RED; E' RED
