koalium/centidocs/elec/plc/Wiring diagram/10193-Serjin/AC-14.pdf

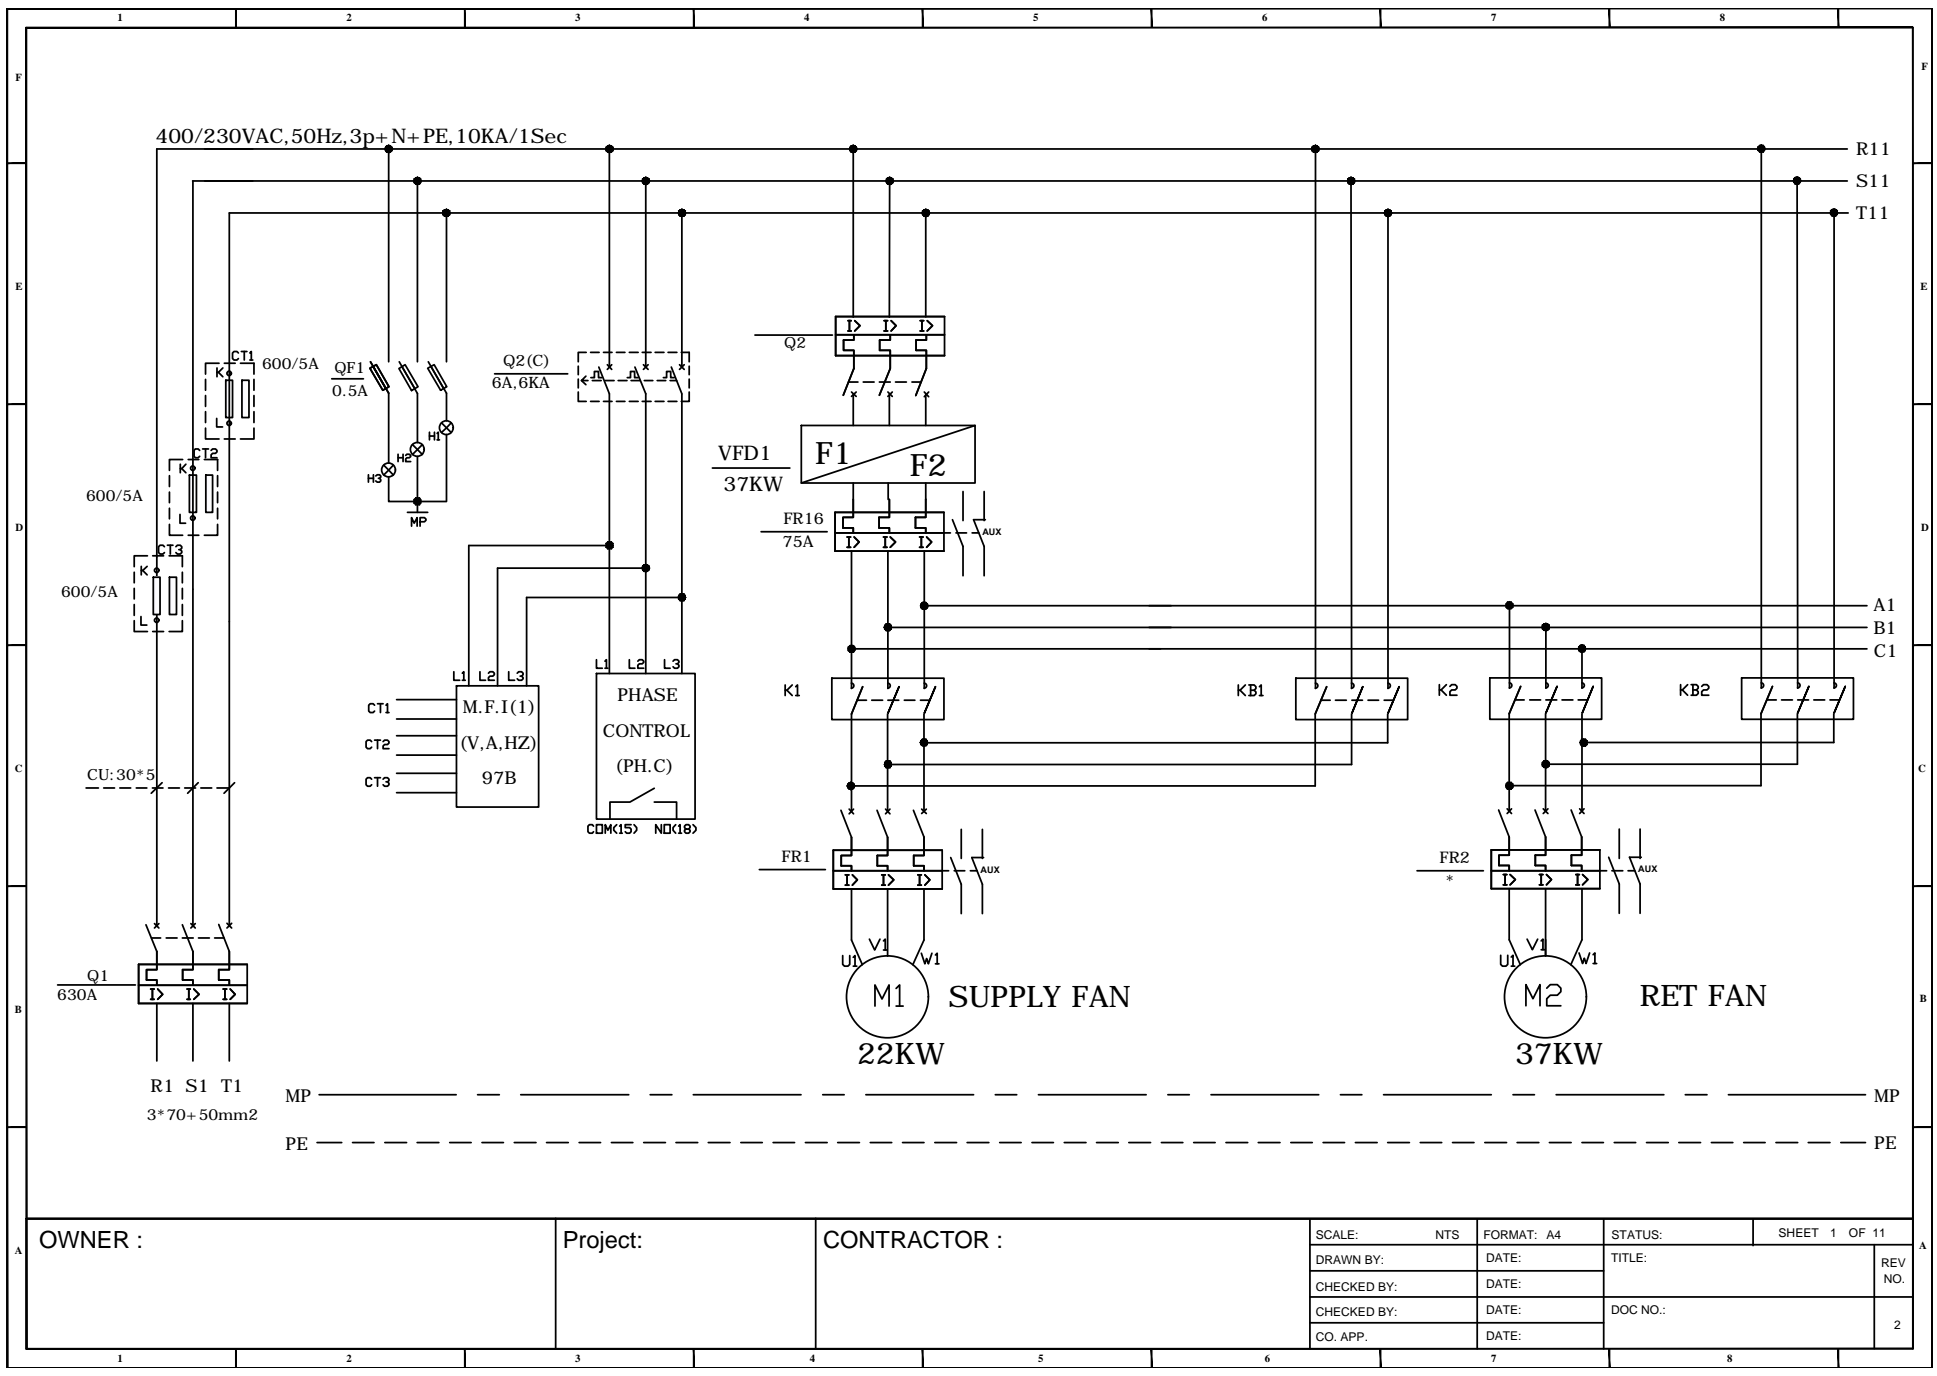
[picture p335: page 1]
FEACBD CAB; 8 OWNER :; CONTRACTOR :; REV SHEET; OF 11 TITLE: SCALE: CHECKED BY: DRAWN BY: CO. APP. CHECKED BY:; FORMAT:; STATUS:; NO. DOC NO.: NTS; 2 DATE: DATE: DATE: DATE: Project: Q1; PEMP CU:30*5400/230VAC,50Hz,3p+N+PE,10KA/1Sec 3*70+50mm2; PHASE CONTROL (PH.C) Q2(C) 6A,6KA; A1B1C1 37KW AUX FR2 *; RET FAN Q2 F1; F2 VFD1 37KW; 22KW AUX FR1; SUPPLY FAN AUX FR16 75A

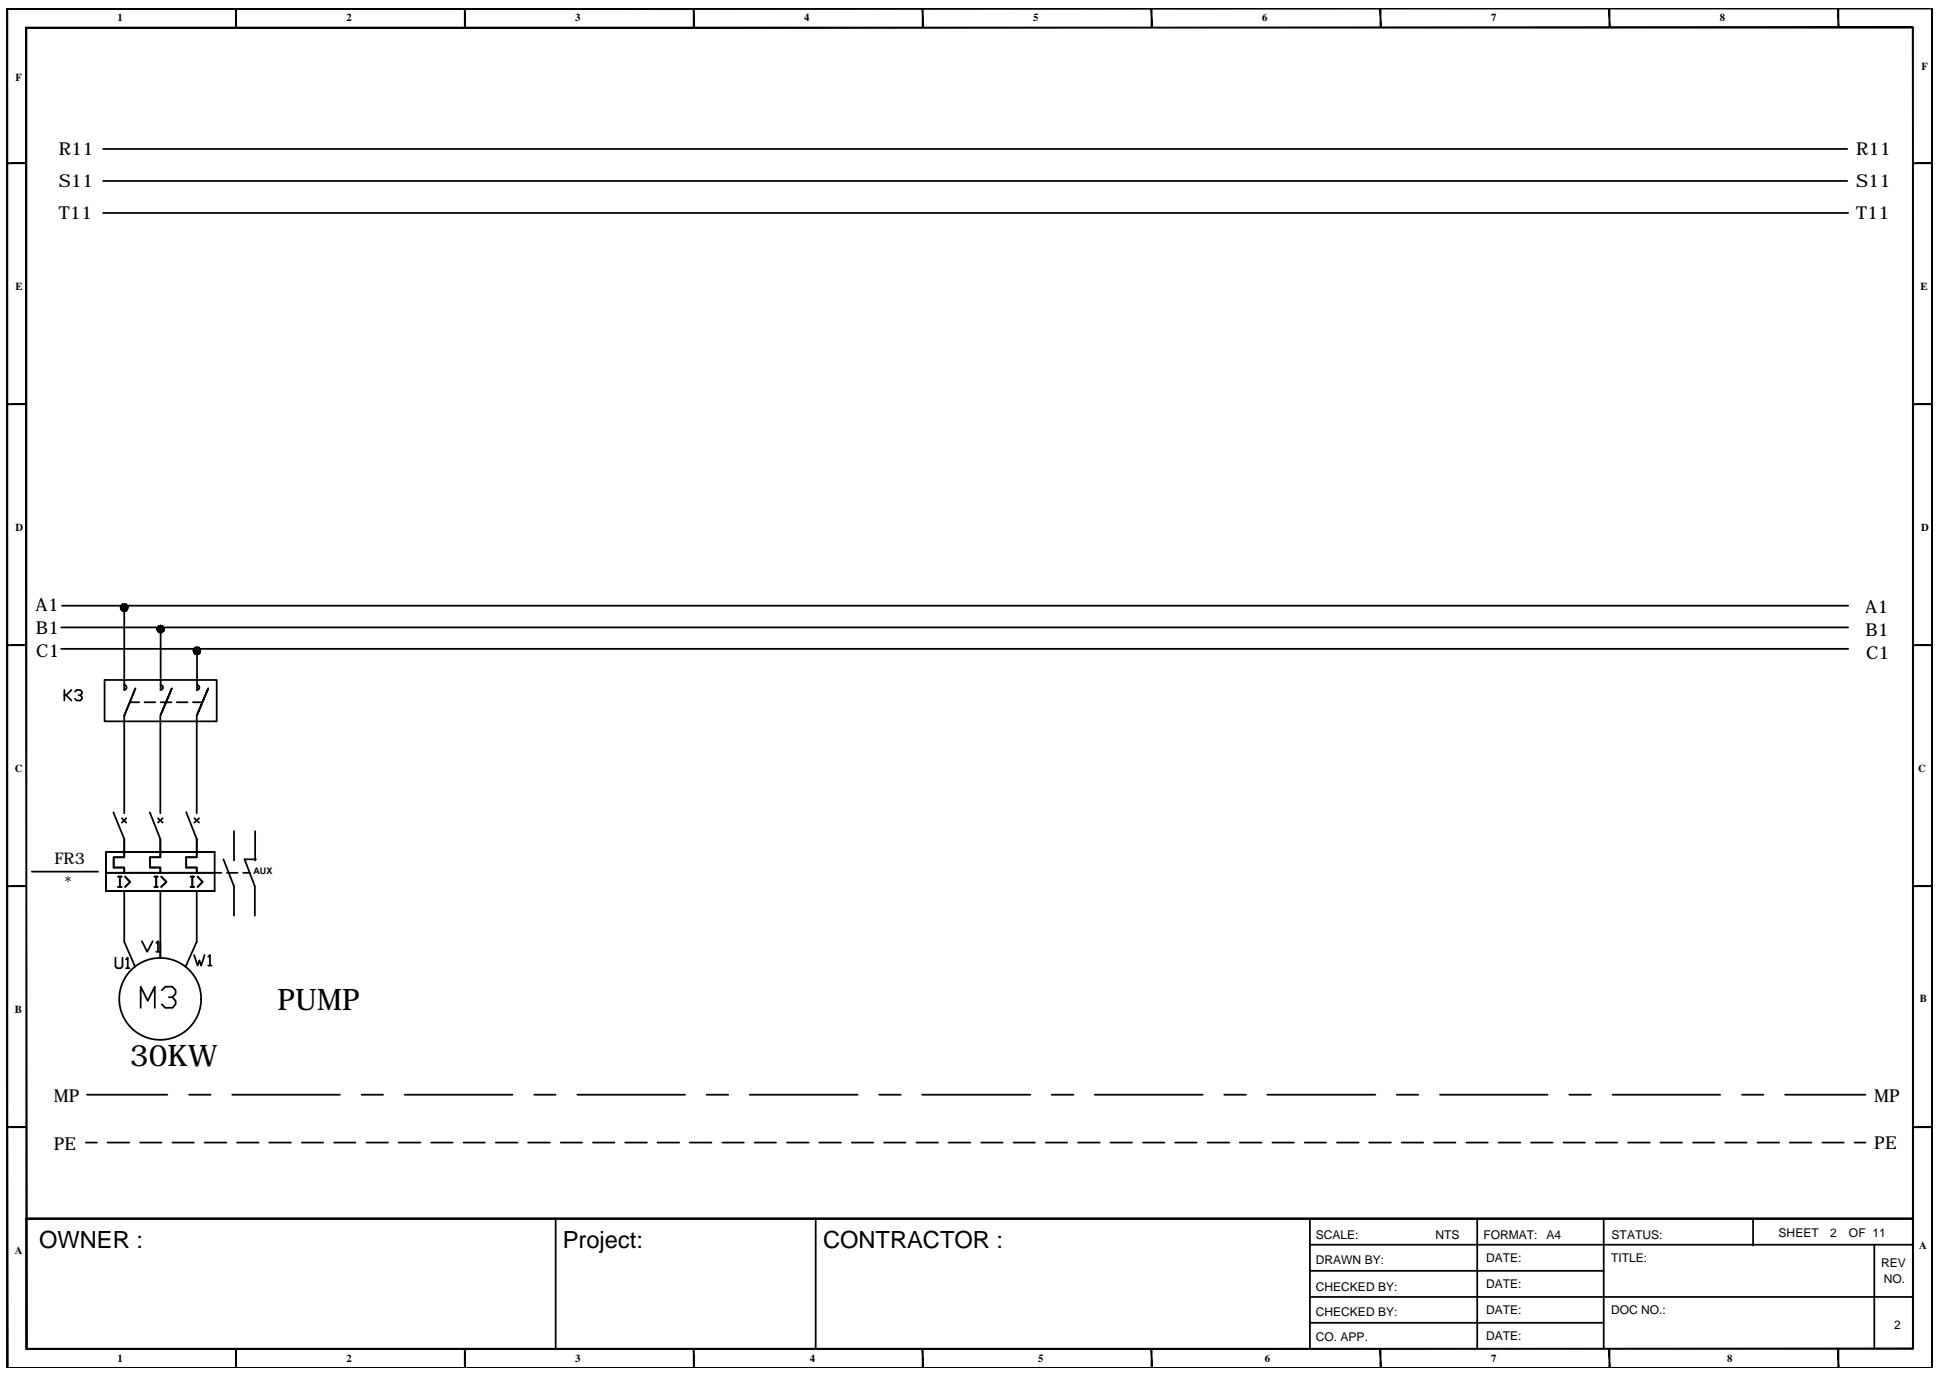
[picture p336: page 2]
FEACBD CAB; 8 OWNER :; CONTRACTOR :; REV SHEET; OF 11 TITLE: SCALE: CHECKED BY: DRAWN BY: CO. APP. CHECKED BY:; FORMAT:; STATUS:; NO. DOC NO.: NTS; 2 DATE: DATE: DATE: DATE: Project:; PEMP R11 S11 T11 A1B1C1; A1B1C1 30KW AUX FR3*; PUMP

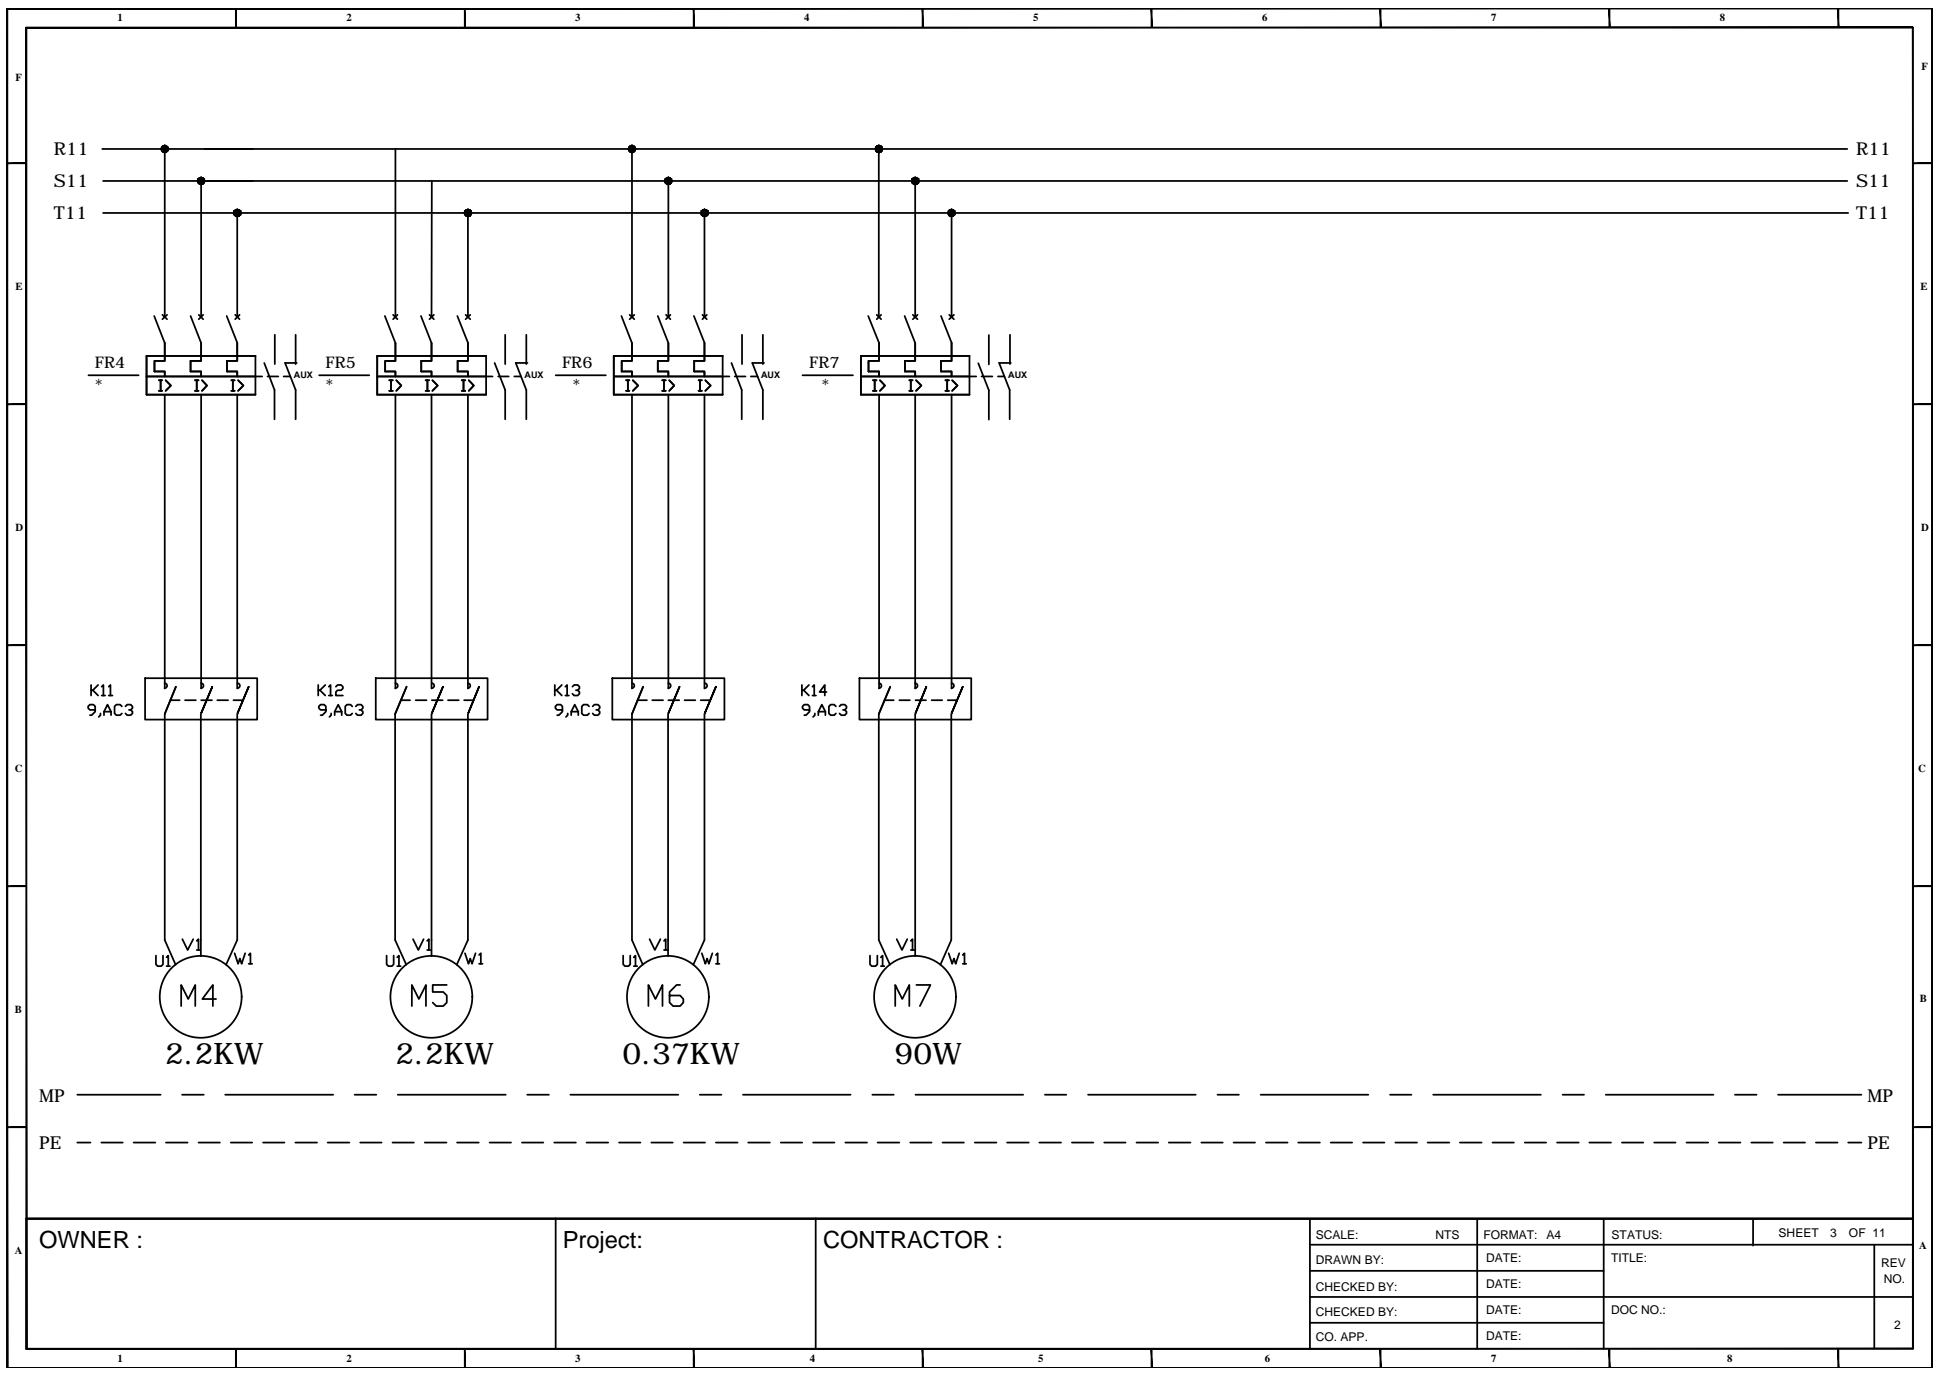
[picture p337: page 3]
FEACBD CAB; 8 OWNER :; CONTRACTOR :; REV SHEET; OF 11 TITLE: SCALE: CHECKED BY: DRAWN BY: CO. APP. CHECKED BY:; FORMAT:; STATUS:; NO. DOC NO.: NTS; 2 DATE: DATE: DATE: DATE: Project:; R11 S11 T11PEMP R11 S11 T11; AUX FR4 *; 2.2KW PEMP; AUX FR5 *; AUX FR6; AUX FR7*

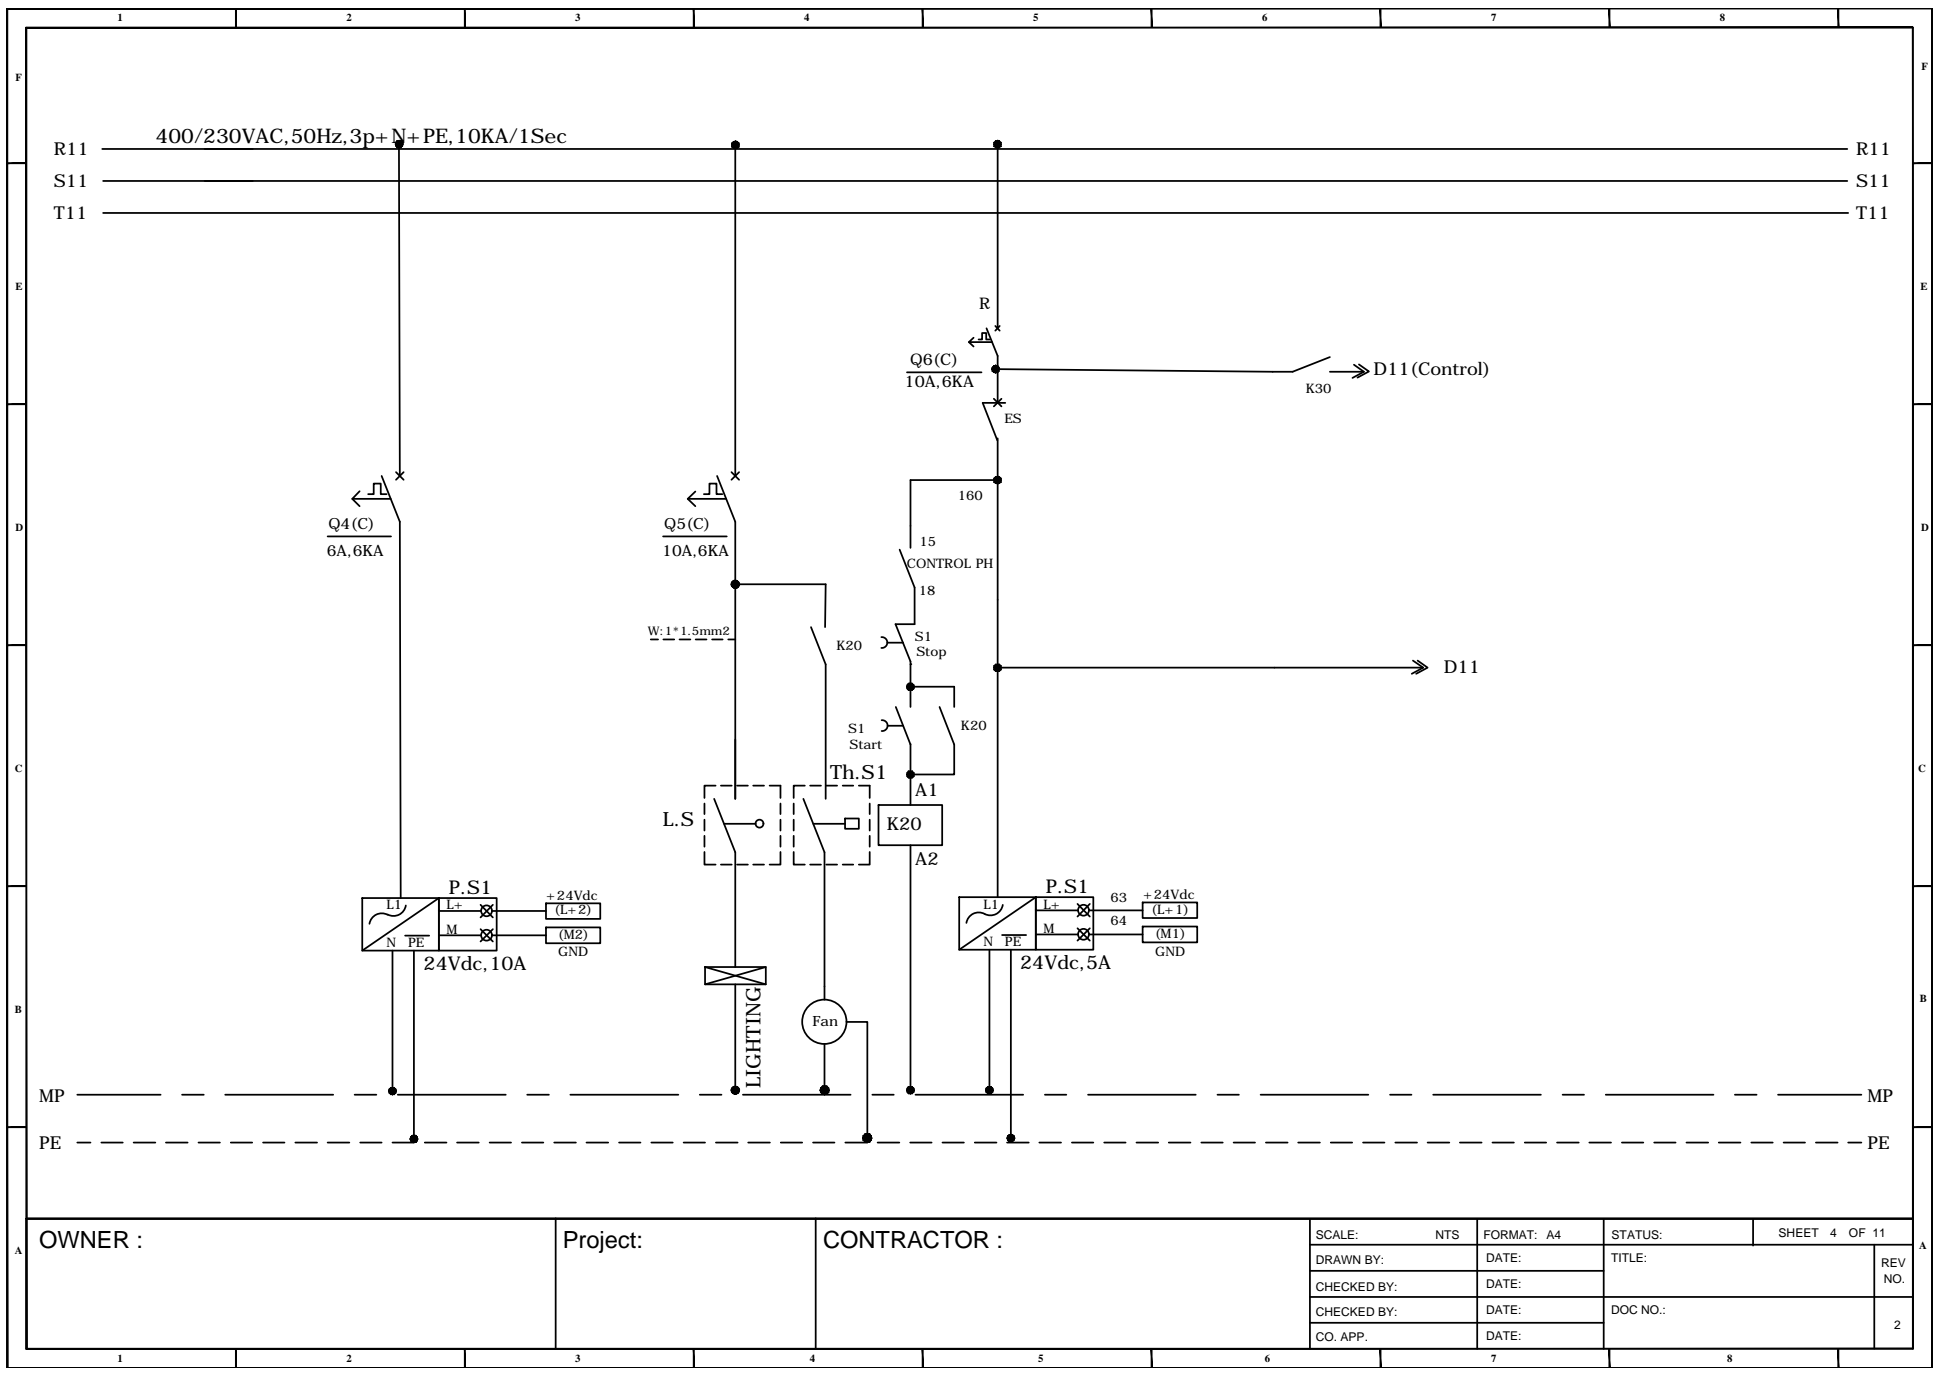
[picture p338: page 4]
FEACBD CAB; 8 OWNER :; CONTRACTOR :; REV SHEET; OF 11 TITLE: SCALE: CHECKED BY: DRAWN BY: CO. APP. CHECKED BY:; FORMAT:; STATUS:; NO. DOC NO.: NTS; 2 DATE: DATE: DATE: DATE: Project:; R11 S11 T11PEMP 400/230VAC,50Hz,3p+N+PE,10KA/1Sec R11 S11 T11 PEMP; P.S1 L+M 24Vdc,5A L1N PE Q6(C) 10A,6KA; +24Vdc GND (L+1) (M1); D11 Stop S1A1 K20A2 Start S1; D11(Control) W:1*1.5mm2 Q5(C) 10A,6KA L.S

LIGHTING FanTh.S1 R 6364 160 P.S1 L+M 24Vdc,10A L1N PE +24Vdc GND (L+2) (M2) Q4(C) 6A,6KA ES 1518 CONTROL PH K20

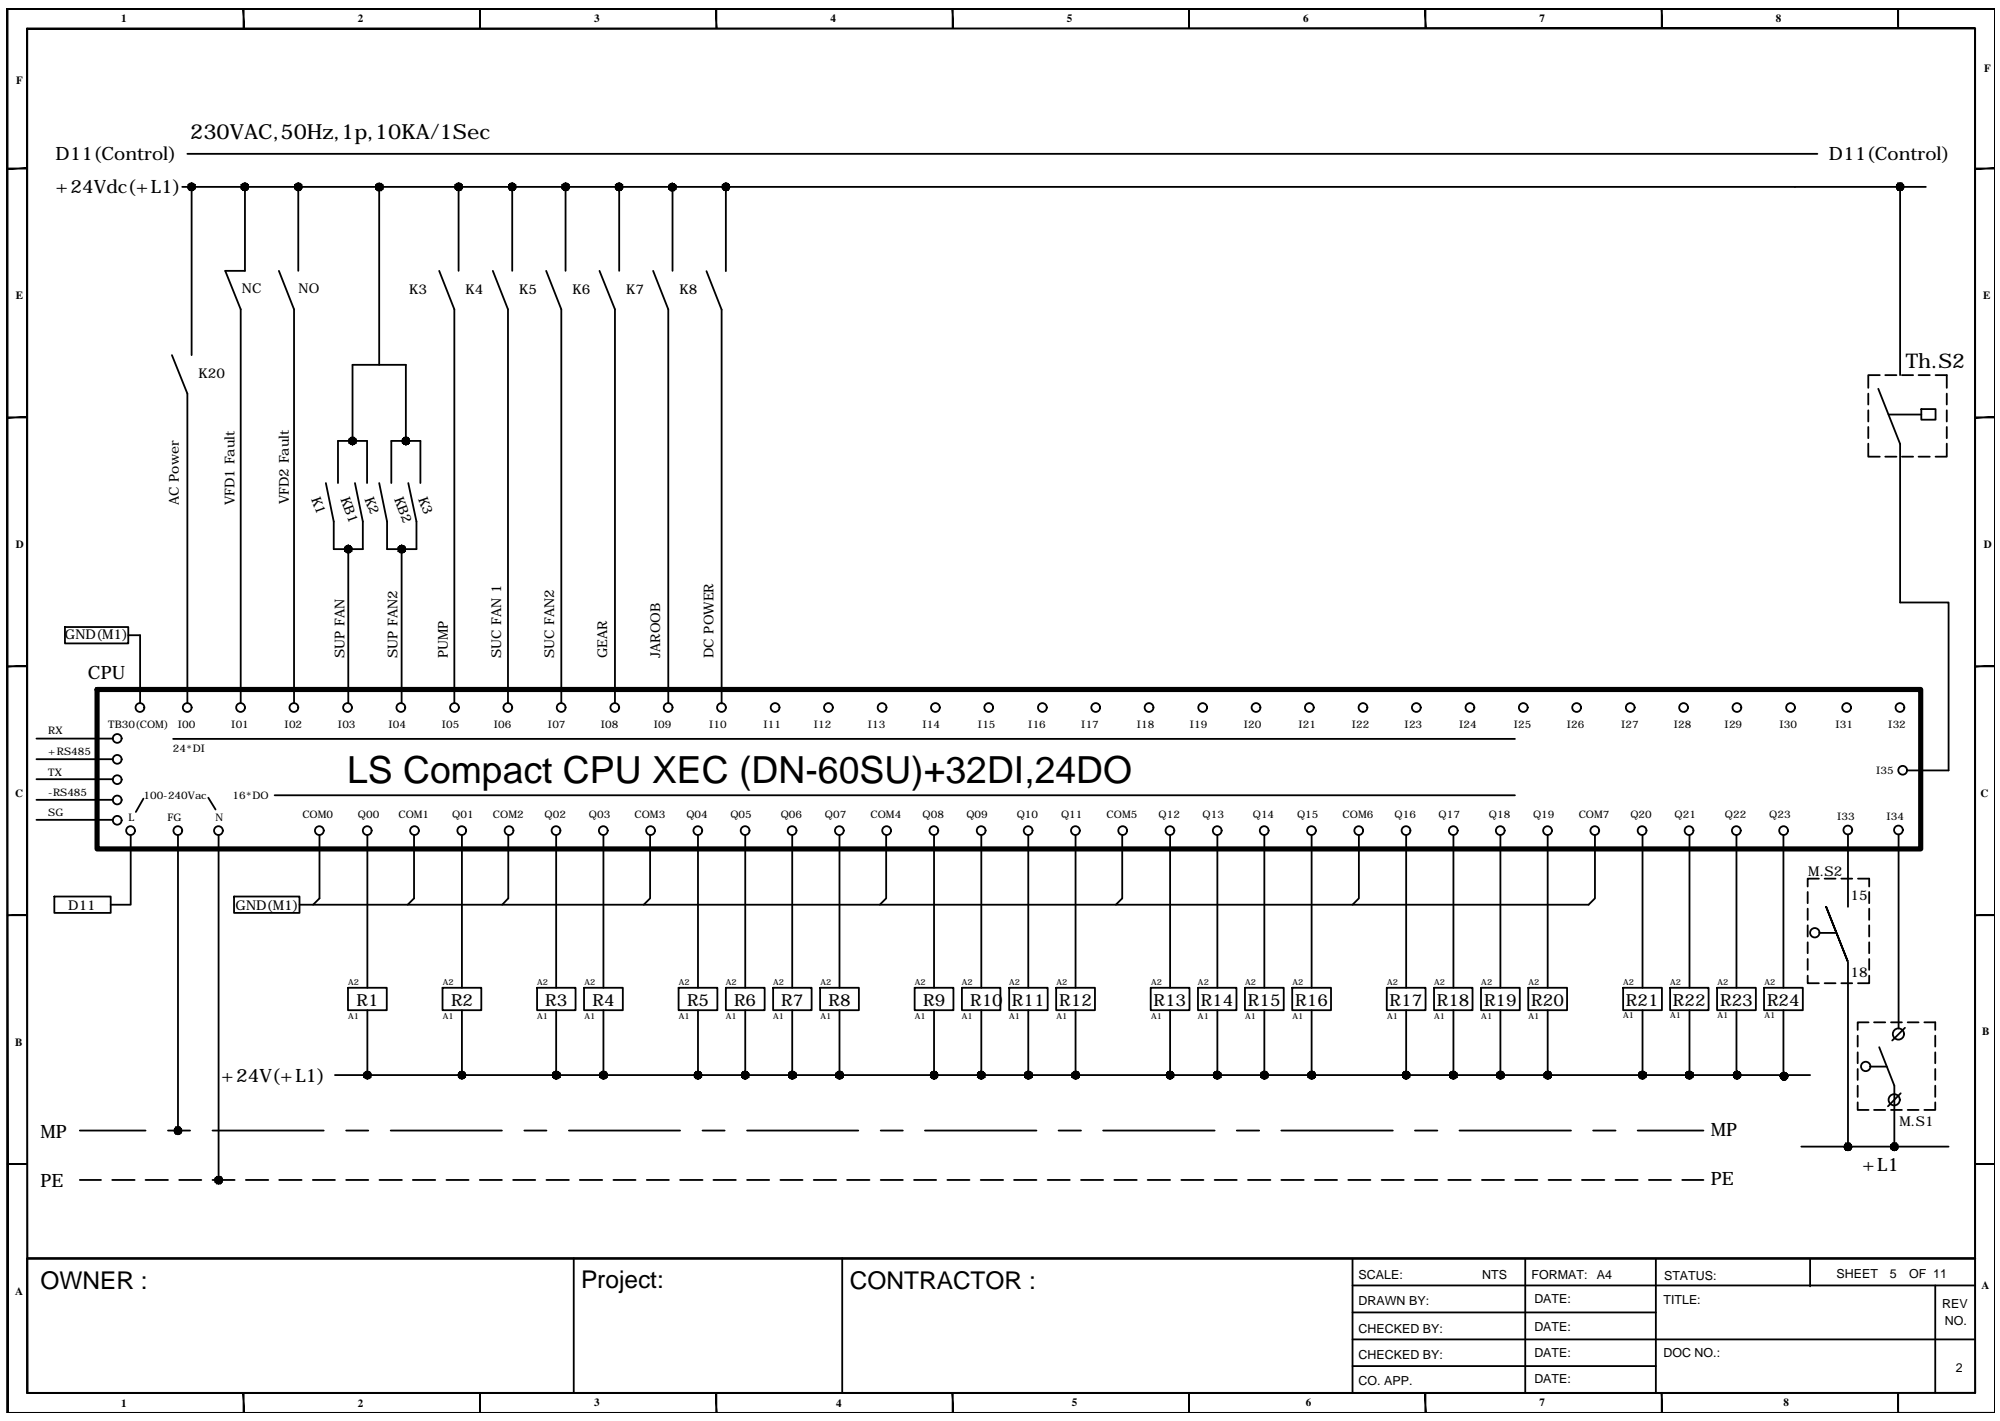
[picture p339: page 5]

JAROOB DC POWER NC NO K3

VFD2 Fault A2A1R13 A2A1R14 RX+RS485 TX-RS485 SG 16*DO COM1 COM2 COM3 Q04 Q05 Q06 Q07 COM4 Q08 Q09 Q10 Q11 COM5 Q12 Q13 Q14 Q15 I24 I25 I26 I27 I28 I29 I30 I31 I32 COM6 Q16 Q17 Q18 Q19 COM7 Q20 Q21 Q22 Q23 I33 I34 I35
TB30(COM) I00 24*DI CPU D11 GND(M1)

PUMP SUC FAN 1 SUC FAN2 GEAR

LS Compact CPU XEC (DN-60SU)+32DI,24DO

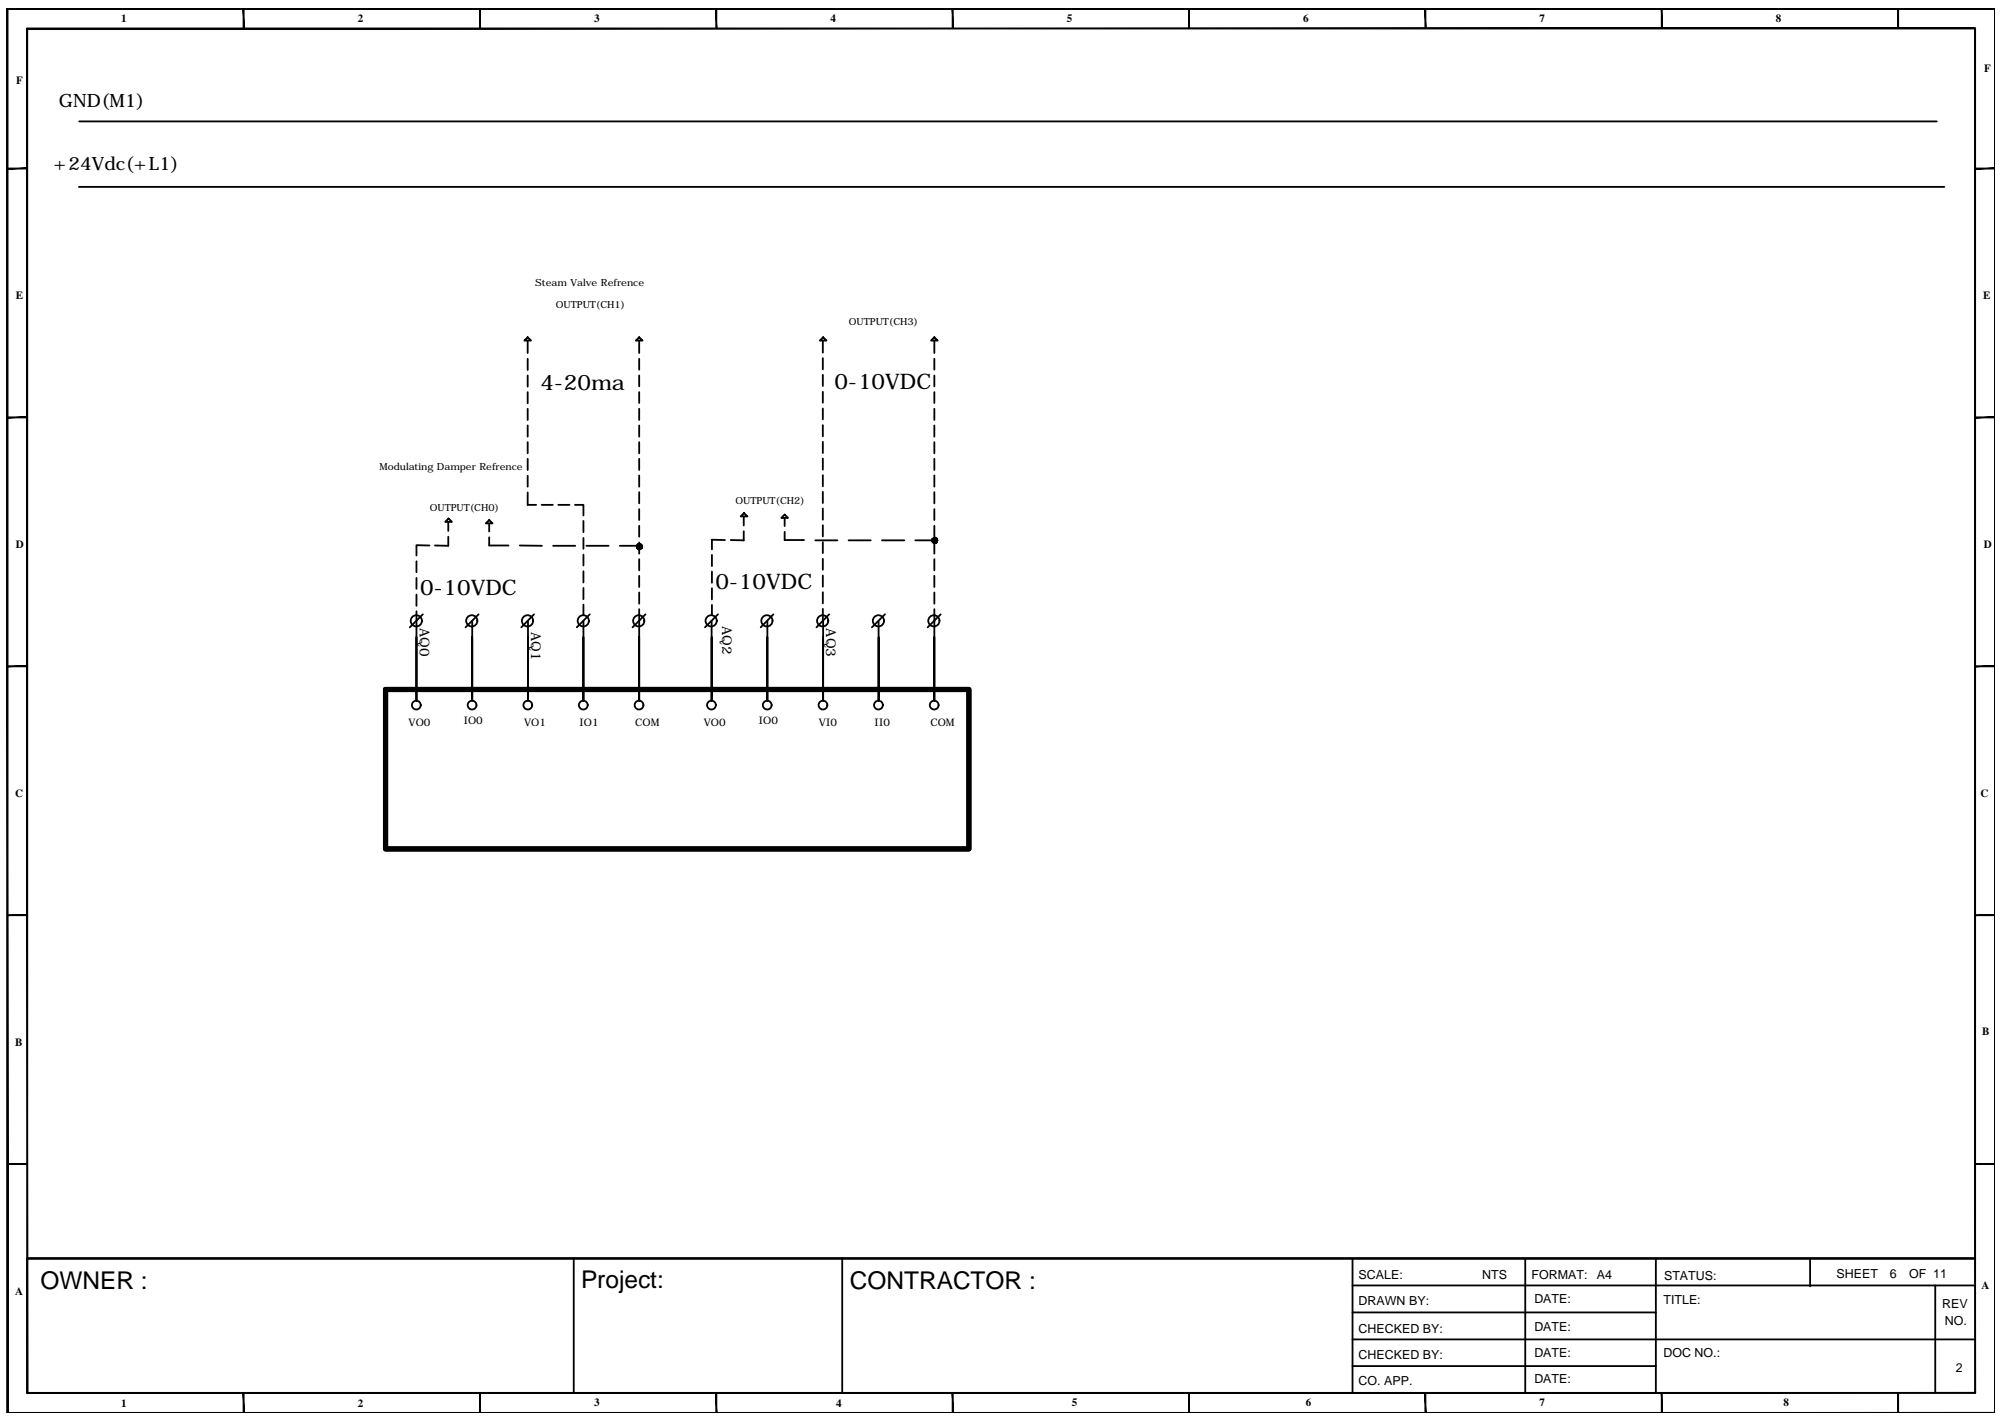
[picture p340: page 6]
FEACBD CAB; 8 OWNER :; CONTRACTOR :; REV SHEET; OF 11 TITLE: SCALE: CHECKED BY: DRAWN BY: CO. APP. CHECKED BY:; FORMAT:; STATUS:; NO. DOC NO.: NTS; 2 DATE: DATE: DATE: DATE: Project: +24Vdc(+L1) GND(M1); COM OUTPUT(CH0) 0-10VDC Modulating Damper Refrence; OUTPUT(CH1) 4-20ma Steam Valve Refrence; COM OUTPUT(CH3) 0-10VDC OUTPUT(CH2) 0-10VDC

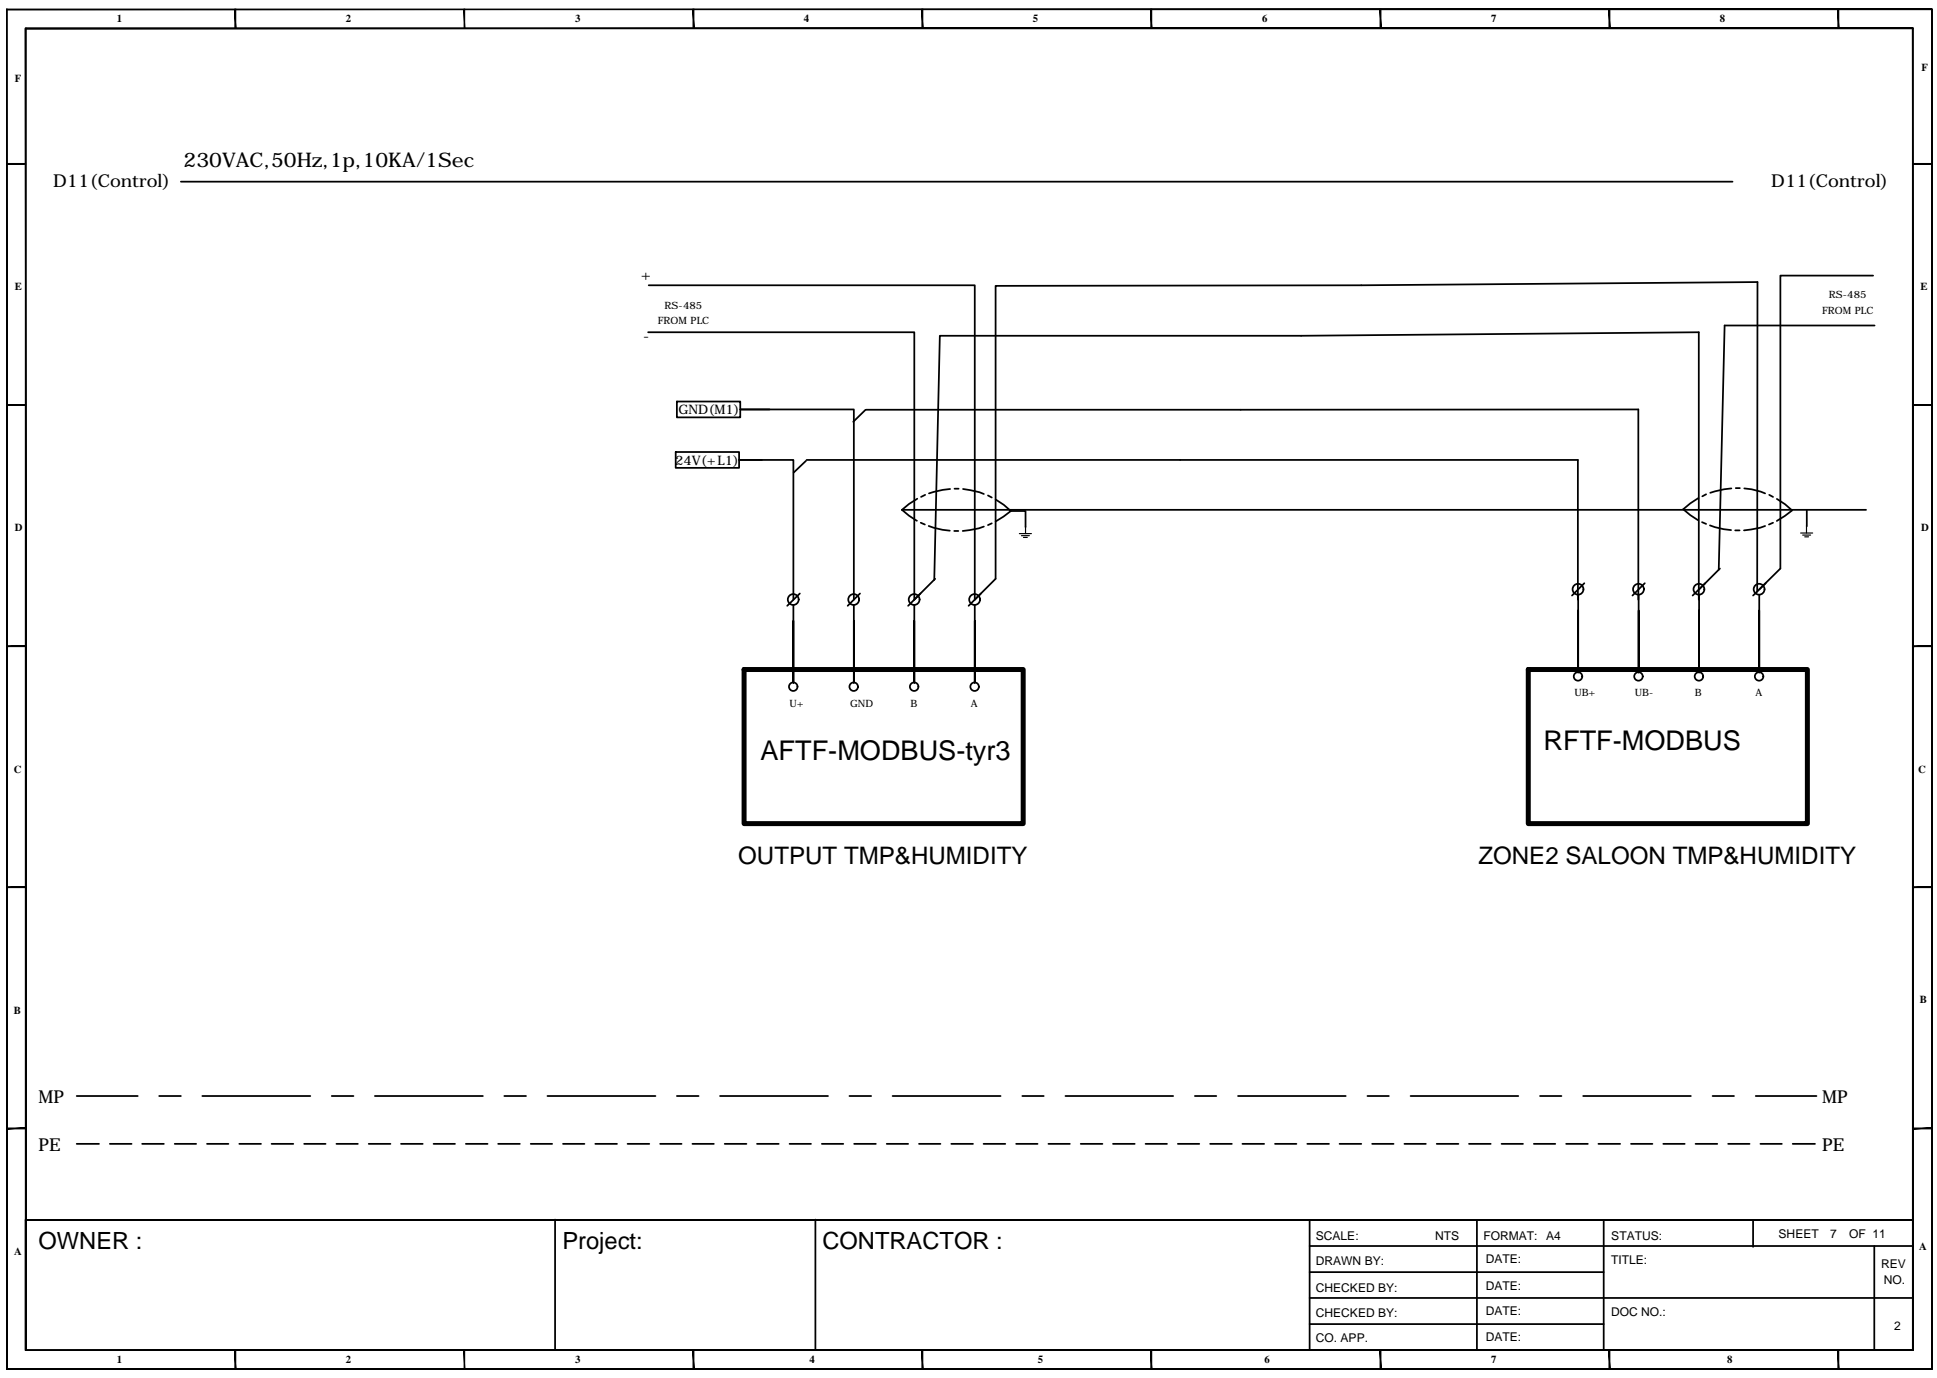
[picture p341: page 7]
FEACBD CAB; 8 OWNER :; CONTRACTOR :; REV SHEET; OF 11 TITLE: SCALE: CHECKED BY: DRAWN BY: CO. APP. CHECKED BY:; FORMAT:; STATUS:; NO. DOC NO.: NTS; 2 DATE: DATE: DATE: DATE: Project:; PEMP 230VAC,50Hz,1p,10KA/1Sec D11(Control) PEMP; D11(Control) GND(M1); AFTF-MODBUS-tyr3 24V(+L1); GND; A RS-485 FROM PLC +-; OUTPUT TMP&HUMIDITY; RFTF-MODBUS UB+; A ZONE2 SALOON TMP&HUMIDITYRS-485 FROM PLC

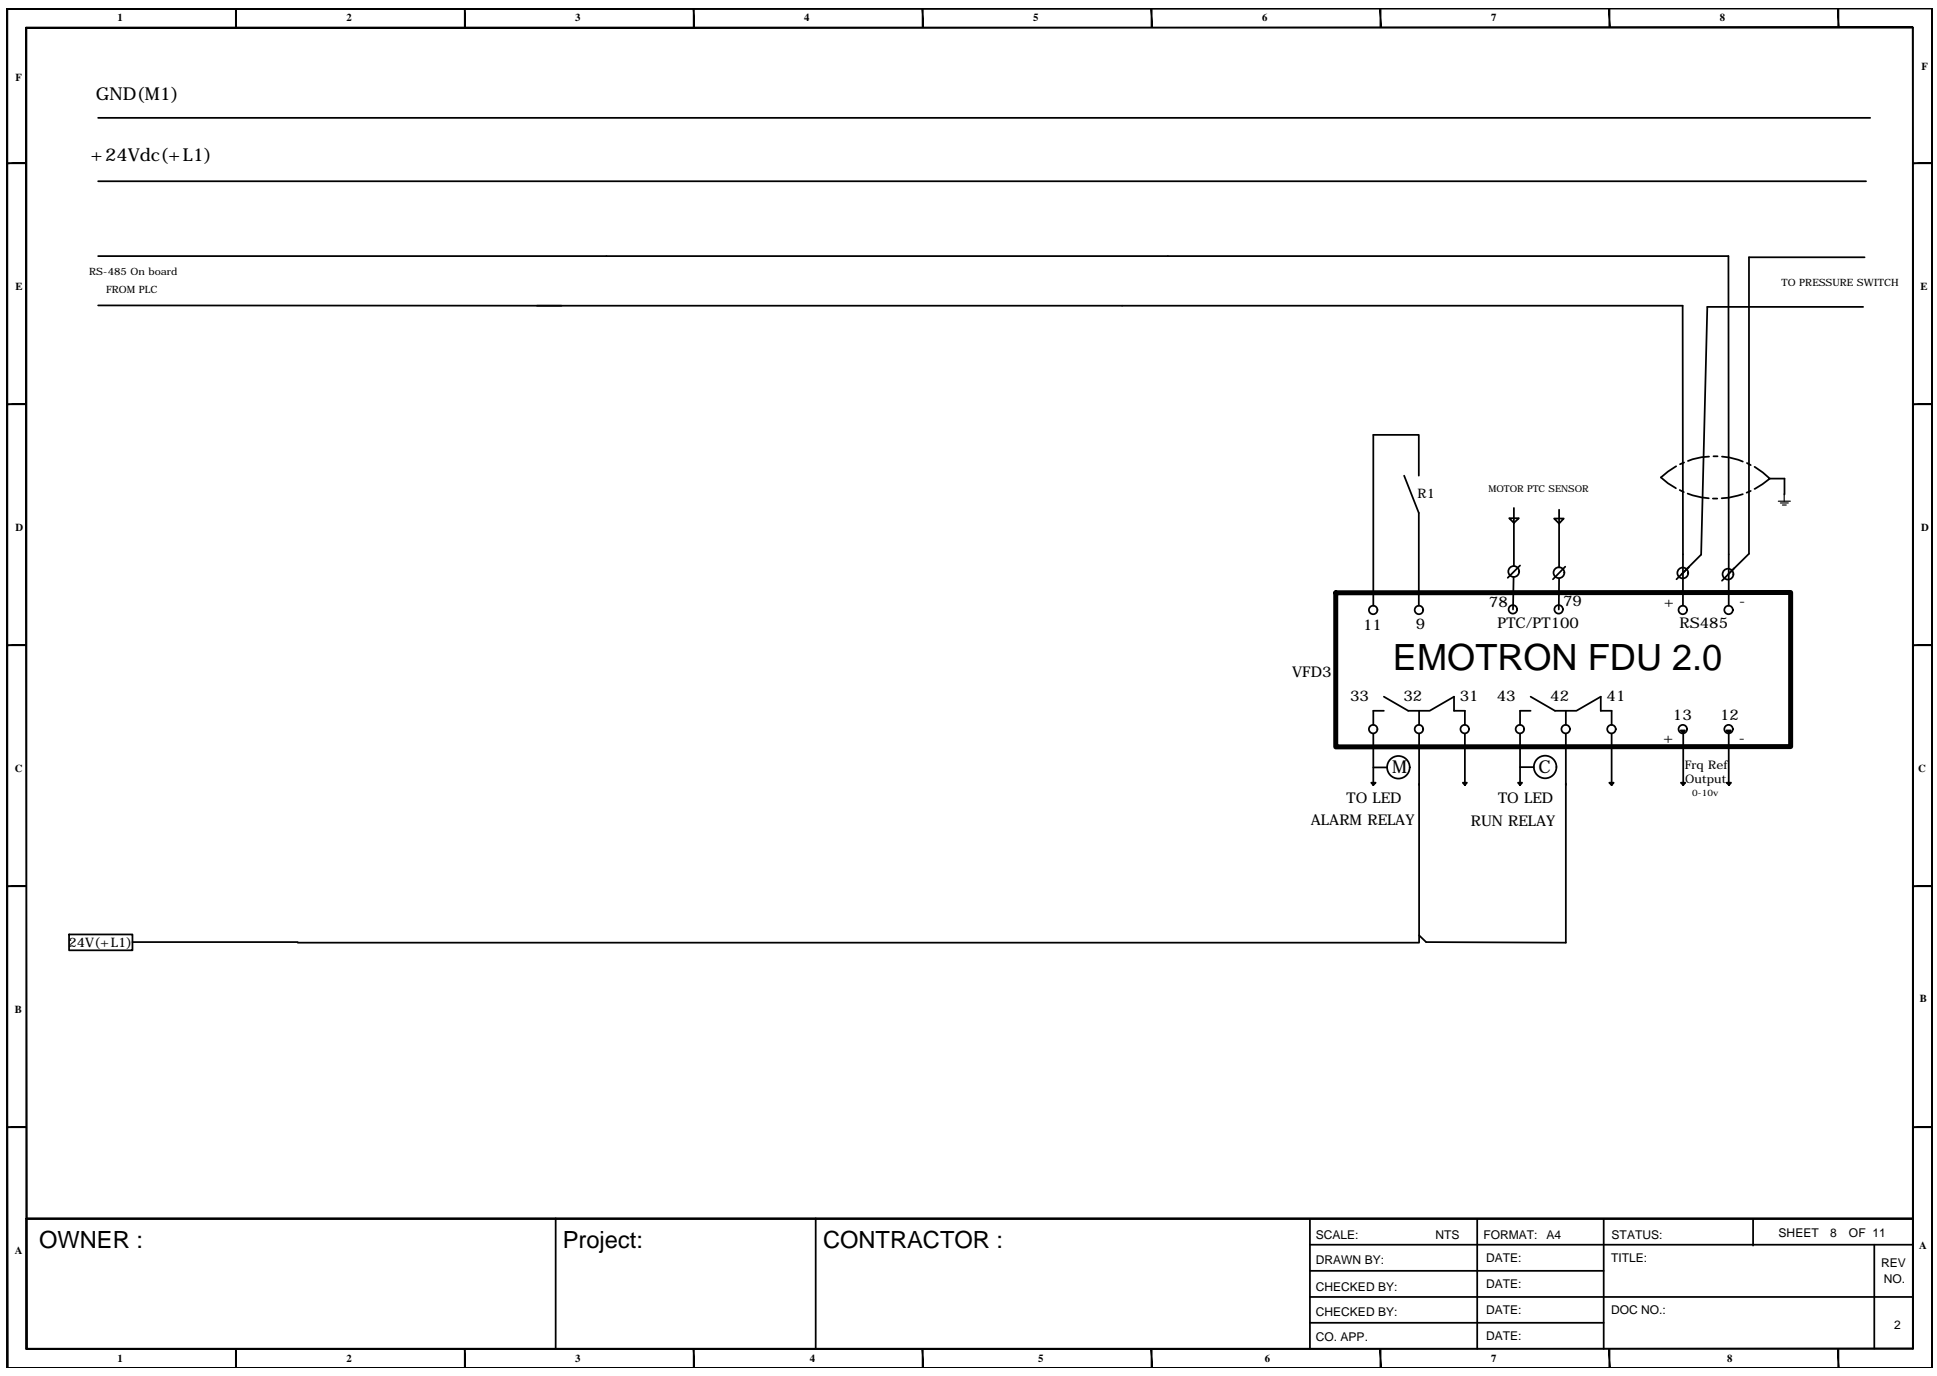
[picture p342: page 8]
FEACBD CAB; 8 OWNER :; CONTRACTOR :; REV SHEET; OF 11 TITLE: SCALE: CHECKED BY: DRAWN BY: CO. APP. CHECKED BY:; FORMAT:; STATUS:; NO. DOC NO.: NTS; 2 DATE: DATE: DATE: DATE: Project: +24Vdc(+L1) GND(M1) 24V(+L1); EMOTRON FDU 2.0 11; - FROM PLC; TO PRESSURE SWITCH RS485 TO LED; TO LED ALARM RELAY; RUN RELAY M; Frq Ref Output 0-10v RS-485 On board; VFD3; 79 PTC/PT100 MOTOR PTC SENSOR

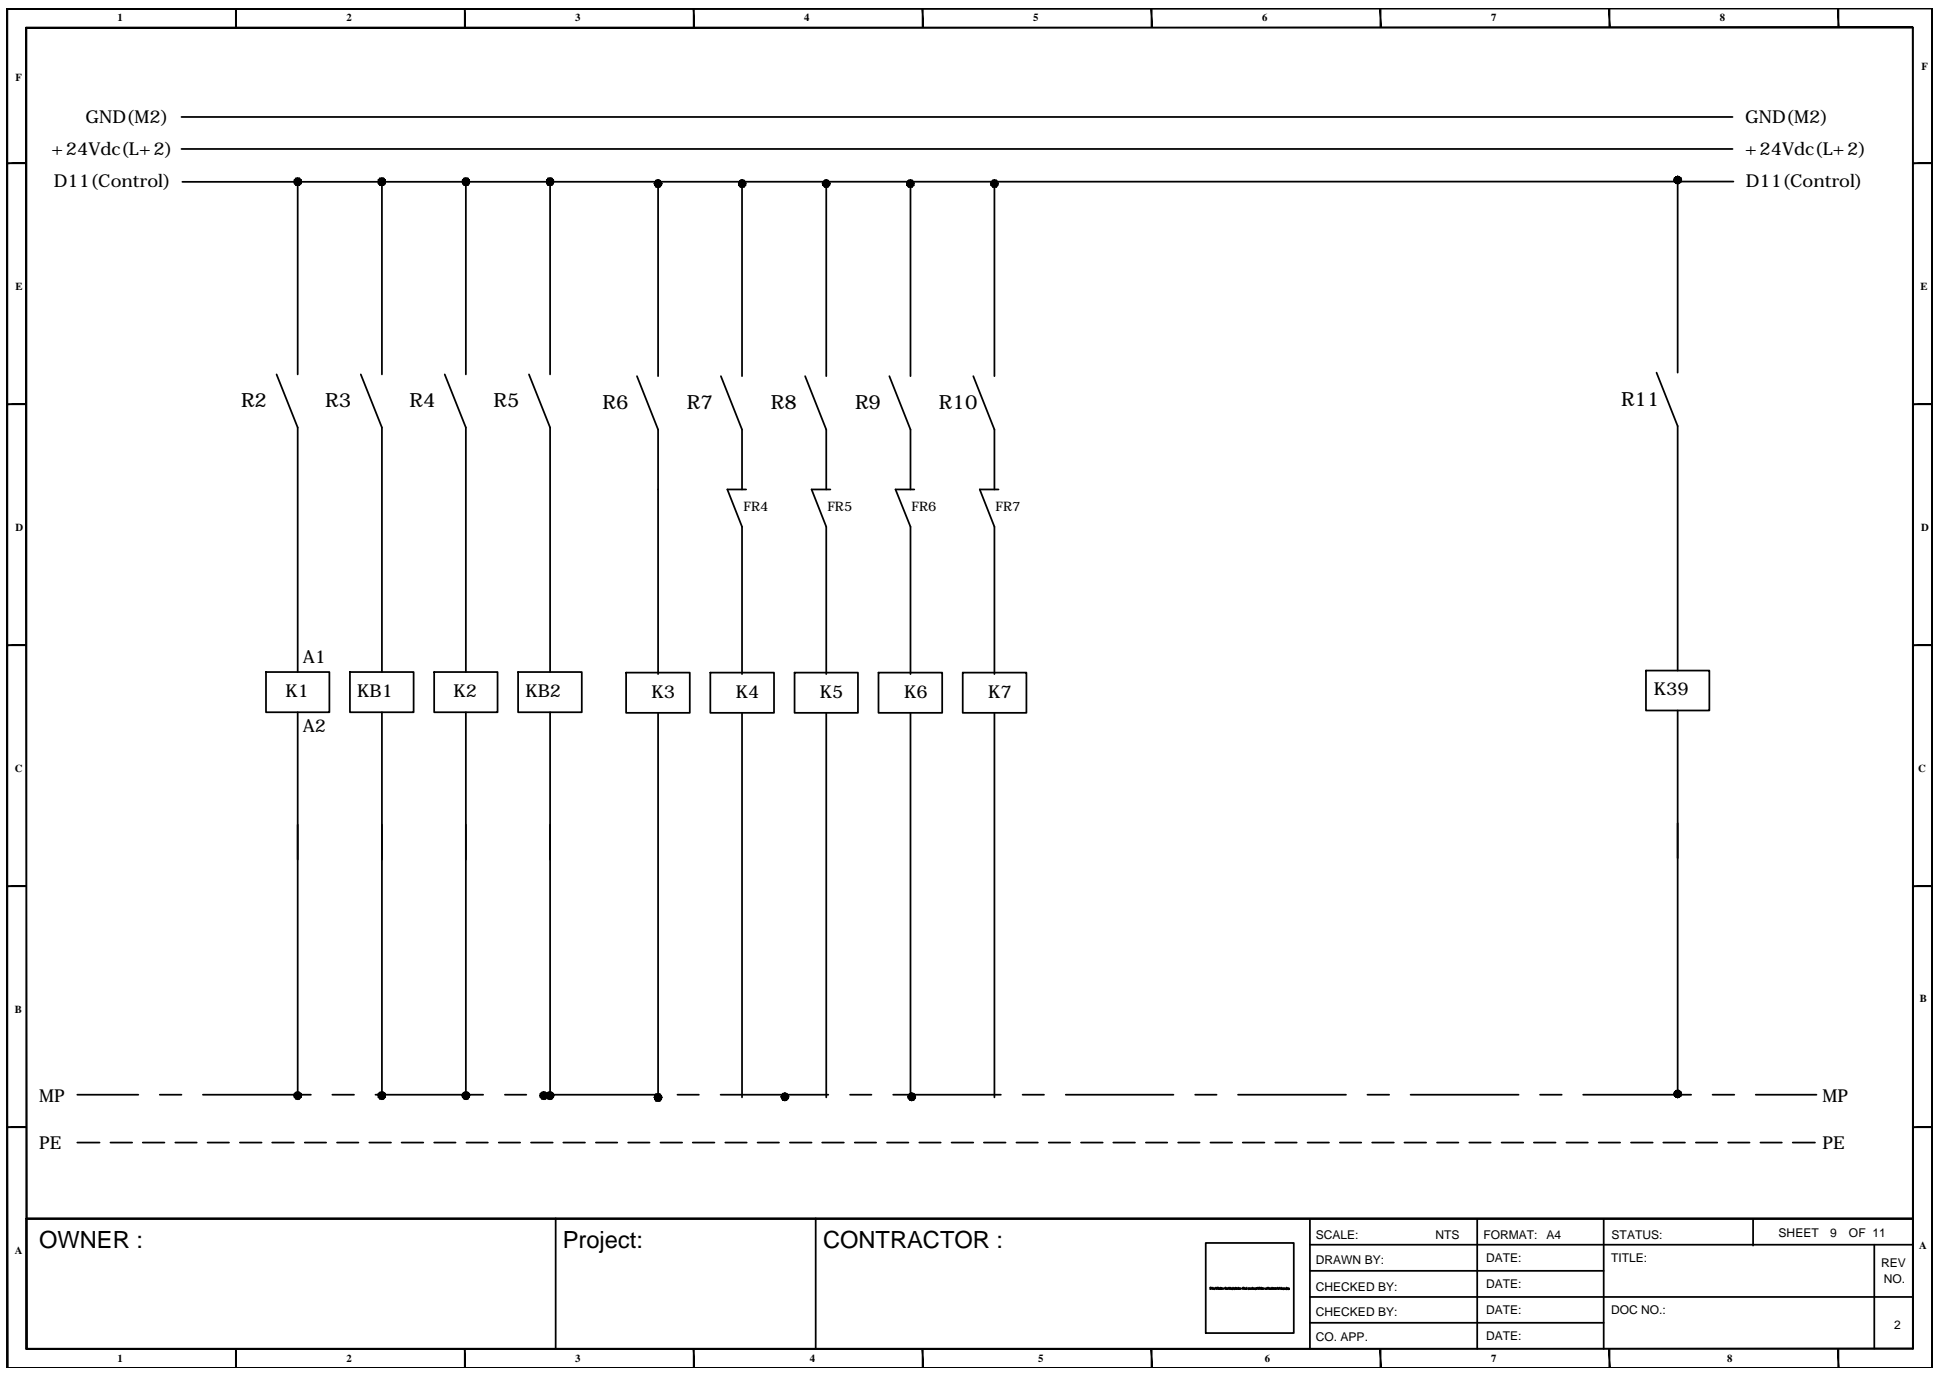
[picture p343: page 9]
FEACBD CAB; 8 OWNER :; CONTRACTOR :; REV SHEET; OF 11 TITLE: SCALE: CHECKED BY: DRAWN BY: CO. APP. CHECKED BY:; FORMAT:; STATUS:; NO. DOC NO.: NTS; 2 DATE: DATE: DATE: DATE: Project:; PEMP D11(Control) PEMP; D11(Control) +24Vdc(L+2) GND(M2); +24Vdc(L+2) GND(M2) A1A2

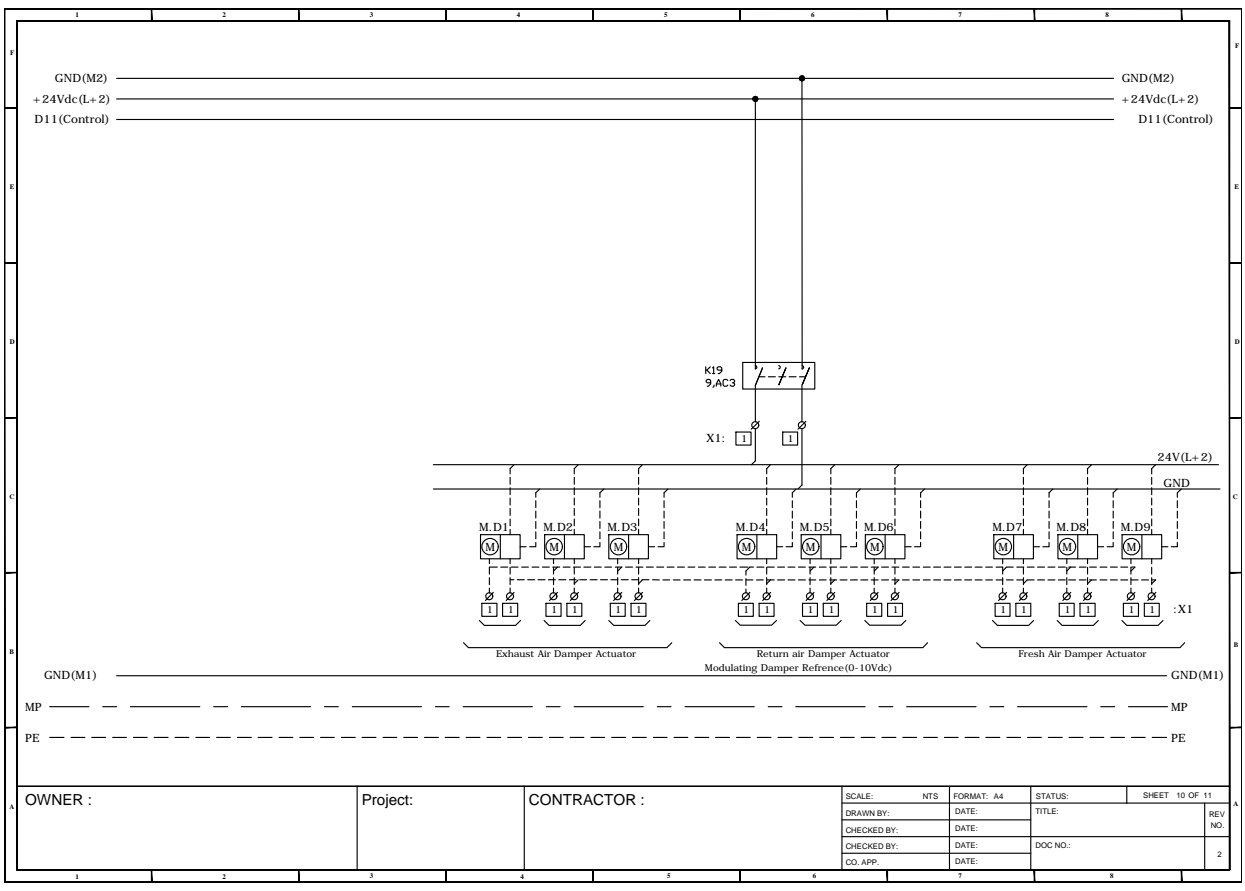
[picture p344: page 10]
FEACBD CAB; 8 OWNER :; CONTRACTOR :; REV SHEET; OF 11 TITLE: SCALE: CHECKED BY: DRAWN BY: CO. APP. CHECKED BY:; FORMAT:; STATUS:; NO. DOC NO.: NTS; 2 DATE: DATE: DATE: DATE: Project:; PEMP D11(Control) PEMP; GND(M1) D11(Control) GND(M1) +24Vdc(L+2) GND(M2); +24Vdc(L+2) GND(M2) X1:; 24V(L+2) GND MM.D1; Modulating Damper Refrence(0-10Vdc) 1; :X1 Exhaust Air Damper Actuator; Return air Damper Actuator; Fresh Air Damper Actuator

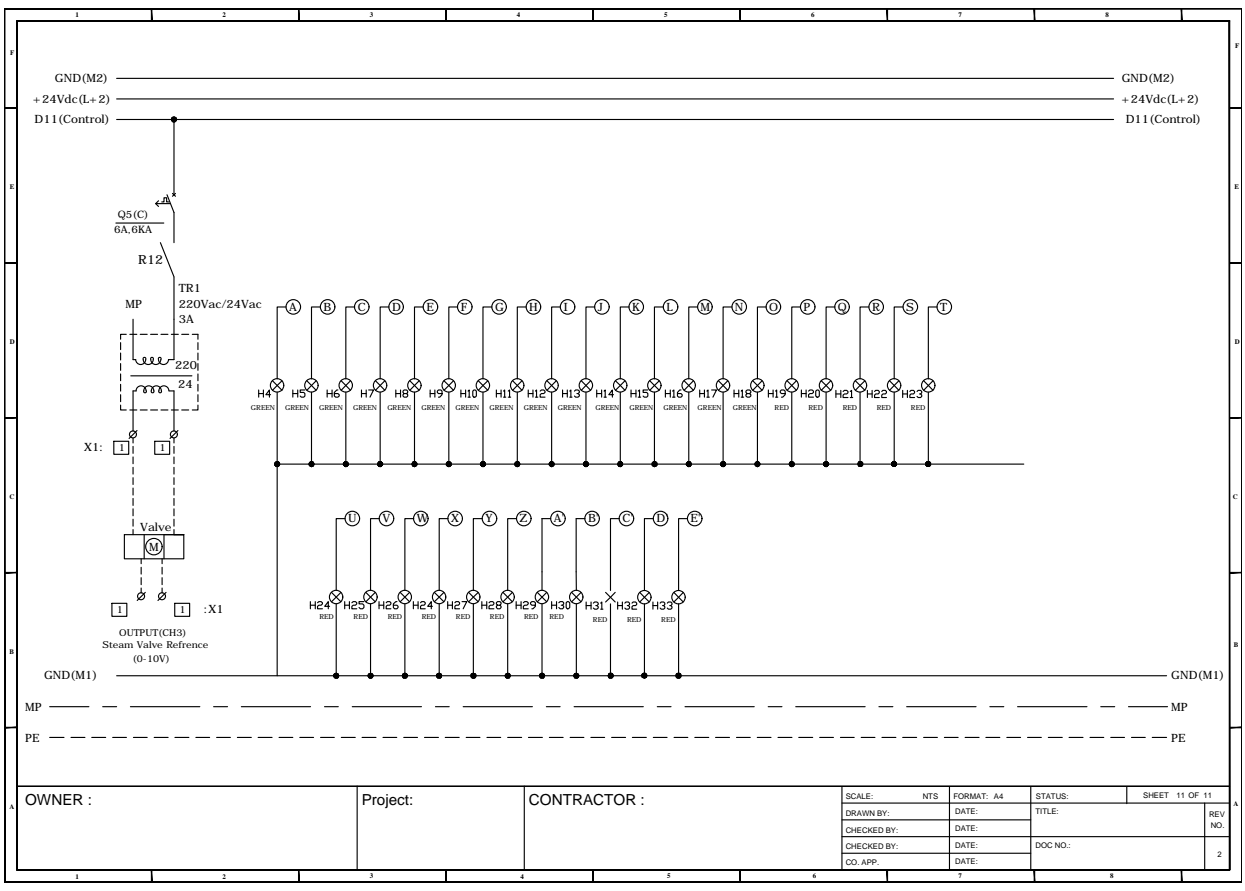
[picture p345: page 11]
FEACBD CAB; 8 OWNER :; CONTRACTOR :; REV SHEET; OF 11 TITLE: SCALE: CHECKED BY: DRAWN BY: CO. APP. CHECKED BY:; FORMAT:; STATUS:; NO. DOC NO.: NTS; 2 DATE: DATE: DATE: DATE: Project:; PEMP D11(Control) PEMP; GND(M1) D11(Control) GND(M1); 220Vac/24Vac 3A 220 24 X1:; 1 MValve 1; 1 OUTPUT(CH3) Steam Valve Refrence:X1 (0-10V); B' +24Vdc(L+2) GND(M2); +24Vdc(L+2) GND(M2) A; T GREEN; GREEN; RED; RED RED; E' RED
