koalium/centidocs/elec/plc/Wiring diagram/10221-Nikris/IO_LIST_NIKRIS_1-02-08-27.pdf

# (NIKRIS AC1-5)

# IO LIST SYSTEM CONFIG

INPUT | SLOT
AC_CONTROL | %I0.0 | 0 | 1
FDBK_SUPPLY_1 | %I0.1 | 1
FDBK_SUPPLY_2 | %I0.2 | 2
FDBK_SUPPLY_3 | %I0.3 | 3
FDBK_RETURN_1 | %I0.4 | 4
FDBK_RETURN_2 | %I0.5 | 5
FDBK_RETURN_3 | %I0.6 | 6
FDBK_PUMP_RUN | %I0.7 | 7
FDBK_DUST_FAN_1 | %I1.0 | 8
FDBK_DUST_FAN_2 | %I1.1 | 9
FDBK_DUST_FAN_3 | %I1.2 | 10
FDBK_DUST_FAN_4 | %I1.3 | 11
FDBK_ROTARY_1 | %I1.4 | 12
FDBK_JAROOB_1 | %I1.5 | 13
FDBK_ROTARY_2 | %I2.0 | 14 | 2
FDBK_JAROOB_2 | %I2.1 | 15
FDBK_POWER_DAMPER | %I2.2 | 16
FAULT_DRIVE | %I2.3 | 17
FAULT_FAN_SUPPLY_1 | %I2.4 | 18
FAULT_FAN_SUPPLY_2 | %I2.5 | 19
FAULT_FAN_SUPPLY_3 | %I2.6 | 20
FAULT_FAN_RETURN_1 | %I2.7 | 21
FAULT_FAN_RETURN_2 | %I3.0 | 22
FAULT_FAN_RETURN_3 | %I3.1 | 23
FAULT_DUST_FAN_1 | %I3.2 | 24
FAULT_DUST_FAN_2 | %I3.3 | 25
FAULT_DUST_FAN_3 | %I3.4 | 26
FAULT_DUST_FAN_4 | %I3.5 | 27
FAULT_ROTARY_1 | %I3.6 | 28
FAULT_JAROOB_1 | %I3.7 | 29
FAULT_ROTARY_2 | %I4.0 | 30 | 3
FAULT_JAROOB_2 | %I4.1 | 31
TERMOSTAT_ALARM | %I4.2 | 32
FIRE_ALARM | %I4.3 | 33
DOOR1 | %I4.4 | 34
DOOR2 | %I4.5 | 35
| %I4.6 | 36
| %I4.7 | 37
OUTPUT | | | SLOT
FAN_SUPPLY_1_k1 | %Q0.0 | 0 | 1
FAN_SUPPLY_1_kB1 | %Q0.1 | 1
FAN_SUPPLY_2_k2 | %Q0.2 | 2
FAN_SUPPLY_2_kB2 | %Q0.3 | 3
FAN_SUPPLY_3_K3 | %Q0.4 | 4
FAN_SUPPLY_3_KB3 | %Q0.5 | 5
FAN_RETURN_1_K4 | %Q0.6 | 6
FAN_RETURN_1_KB4 | %Q0.7 | 7
FAN_RETURN_2_K5 | %Q1.0 | 8
FAN_RETURN_2_KB5 | %Q1.1 | 9
FAN_RETURN_3_K6 | %Q2.0 | 10 | 2
FAN_RETURN_3_KB6 | %Q2.1 | 11
DRIVE_RUN | %Q2.2 | 12
PUMP_RUN | %Q2.3 | 13
DUST_FAN_1 | %Q2.4 | 14
DUST_FAN_2 | %Q2.5 | 15
DUST_FAN_3 | %Q2.6 | 16
DUST_FAN_4 | %Q2.7 | 17
ROTARY1 | %Q3.0 | 18
JAROOB1 | %Q3.1 | 19
ROTARY2 | %Q3.2 | 20
JAROOB2 | %Q3.3 | 21
POWER_DAMPER | %Q3.4 | 22
STEAM_VALVE_POWER | %Q3.5 | 23
| %Q3.6 | 24
| %Q3.7 | 25
| | 26 | 3
| | 27
| | 28
| | 29
| | 30
| | 31
| | 32
| | 33

SLOT 1 | SLOT 2 | SLOT 3 | SLOT 4 | SLOT 5
CPU 1215C AC/DC/Rly | SM 1223 DI16/DQ16 x relay | SM 1223 DI8/DQ8 x relay | SM 1231 AI4 | SM 1232 AQ4
| | | CH 0 :TEMP IN | CH 0 :DRIVE FREQ
| | | CH 1 :HUMID IN | CH 1 :FRESH DAMPER
| | | CH 2 :TEMP OUT | CH 2 :STEAM VALVE
| | | CH 3 :HUMID OUT | CH 3 :
