koalium/centidocs/jokar/Screw compactor Final/Screw compactor Size as built/PerformanceLog.txt

Number of Contacts: 2
Number of contact data: 1478
