koalium/centidocs/jokar/Damper 850 pdf/Damper 850 Main Assembly.pdf

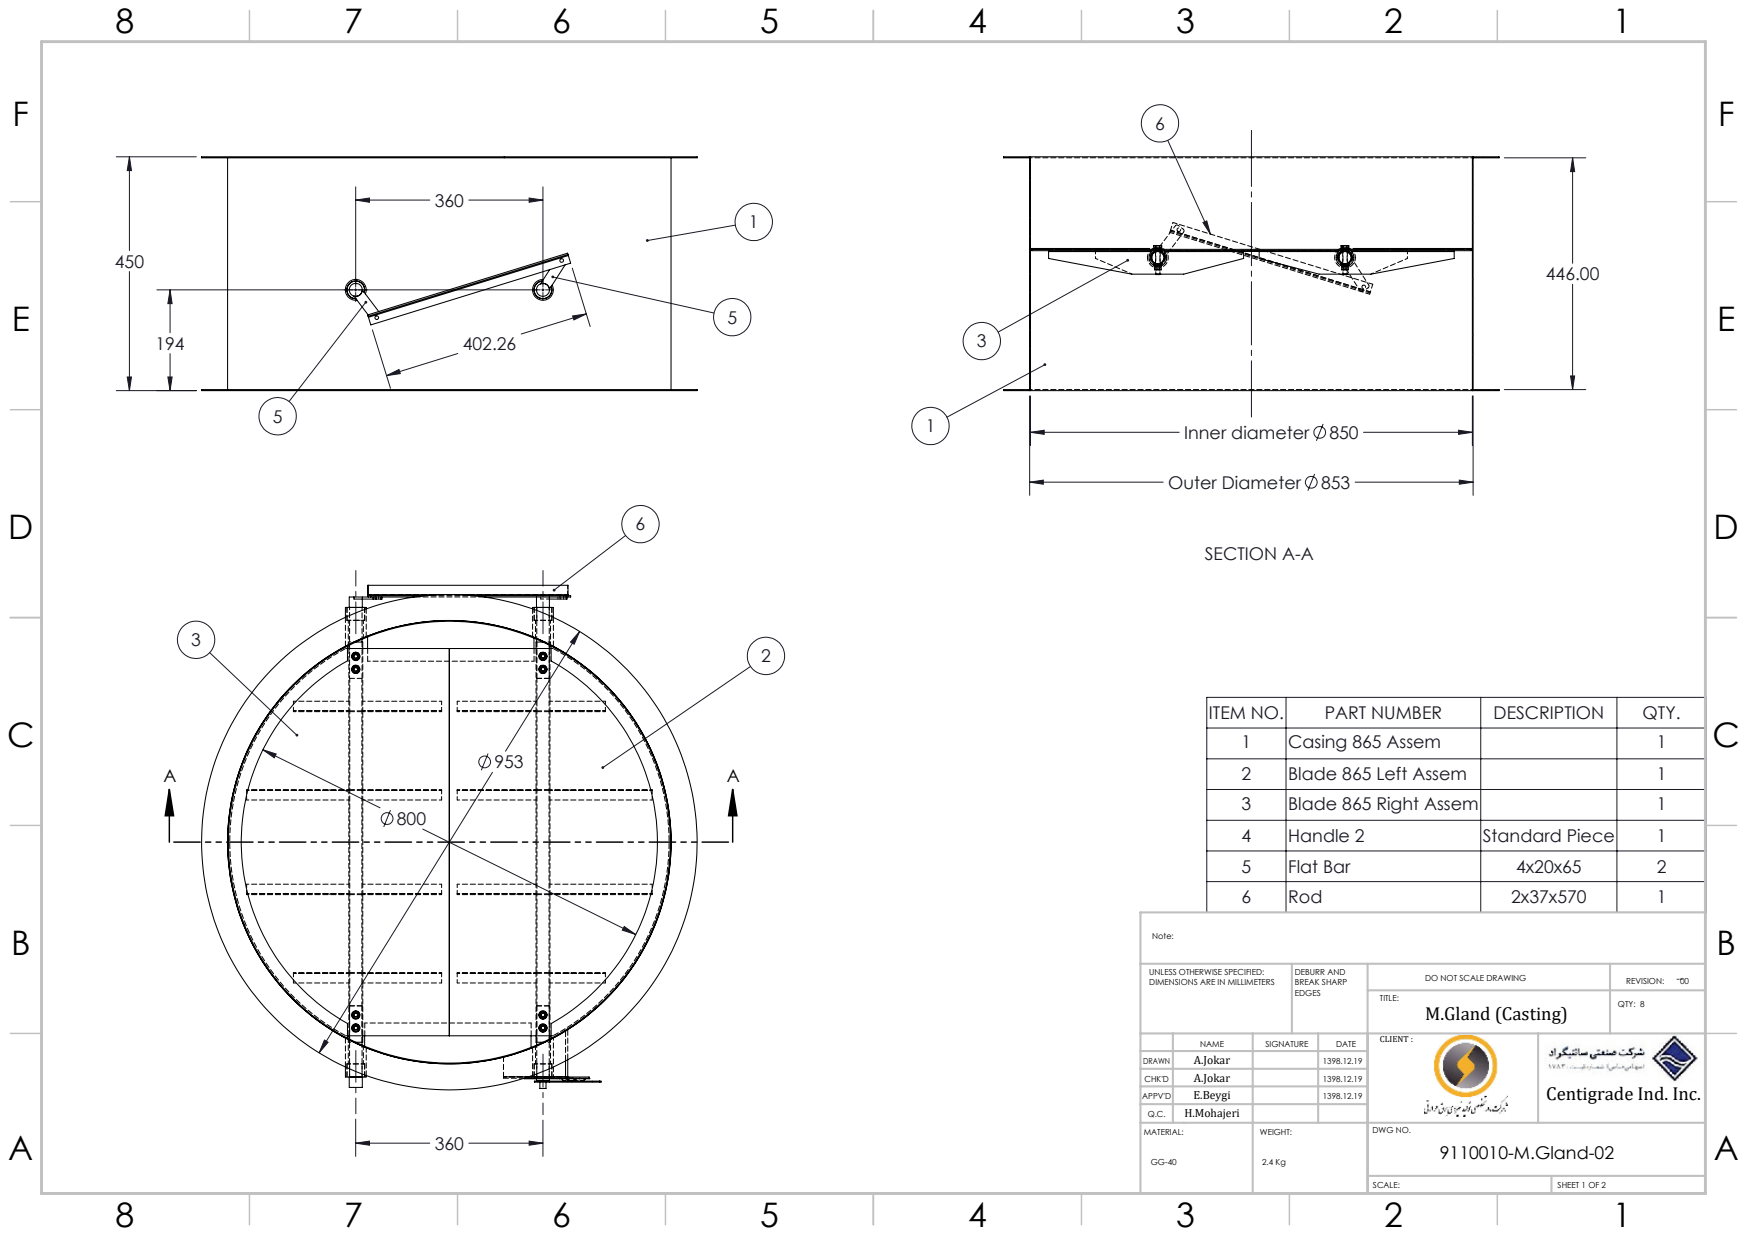
[picture p346: page 1]
Inner diameter 850; Outer Diameter 853; SECTION A-A; DO NOT SCALE DRAWING; REVISION:; M.Gland (Casting); QTY: 8; CLIENT :

ITEM NO. | PART NUMBER | DESCRIPTION | QTY.
1 | Casing 865 Assem | | 1
2 | Blade 865 Left Assem | | 1
3 | Blade 865 Right Assem | | 1
4 | Handle 2 | Standard Piece | 1
5 | Flat Bar | 4x20x65 | 2
6 | Rod | 2x37x570 | 1

UNLESS OTHERWISE SPECIFIED:
DIMENSIONS ARE IN MILLIMETERS

DEBURR AND
BREAK SHARP
EDGES
Centigrade Ind. Inc.

DRAWN | A.Jokar | 1398.12.19
CHK'D | E.Beygi | 1398.12.19

APPV'D | | 1398.12.19

MATERIAL: GG-40 | WEIGHT: 2.4 Kg | DWG NO. 9110010-M.Gland-02

SCALE: | SHEET 1 OF 2

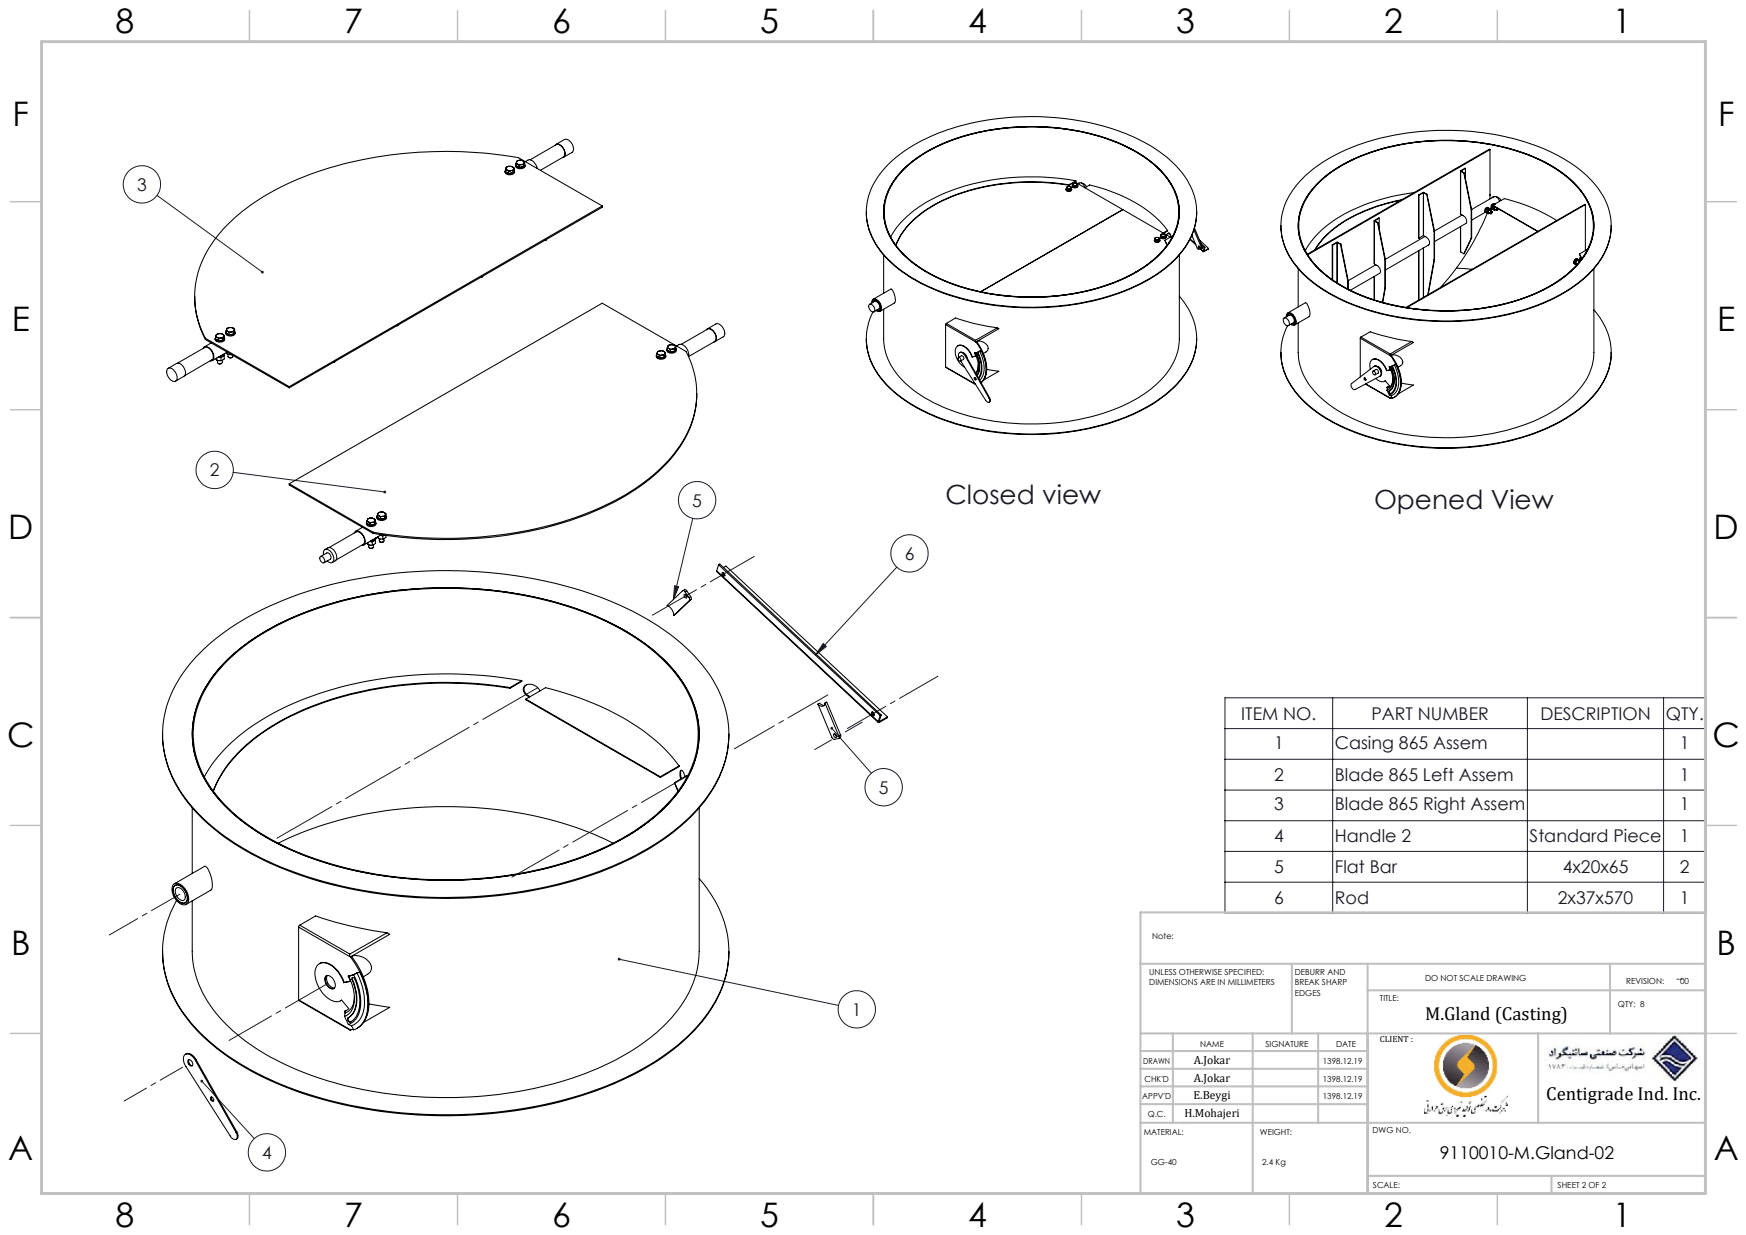
[picture p347: page 2]
Closed view; Opened View; DO NOT SCALE DRAWING; REVISION:; M.Gland (Casting); QTY: 8; CLIENT :

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

UNLESS OTHERWISE SPECIFIED:
DIMENSIONS ARE IN MILLIMETERS

DEBURR AND
BREAK SHARP
EDGES
Centigrade Ind. Inc.

DRAWN | A.Jokar | 1398.12.19
CHK'D | E.Beygi | 1398.12.19

APPV'D | | 1398.12.19

MATERIAL: GG-40 | WEIGHT: 2.4 Kg | DWG NO. 9110010-M.Gland-02

SCALE: | SHEET 2 OF 2
