koalium/centidocs/jokar/Louva Door BOM/General/Door 03.PDF

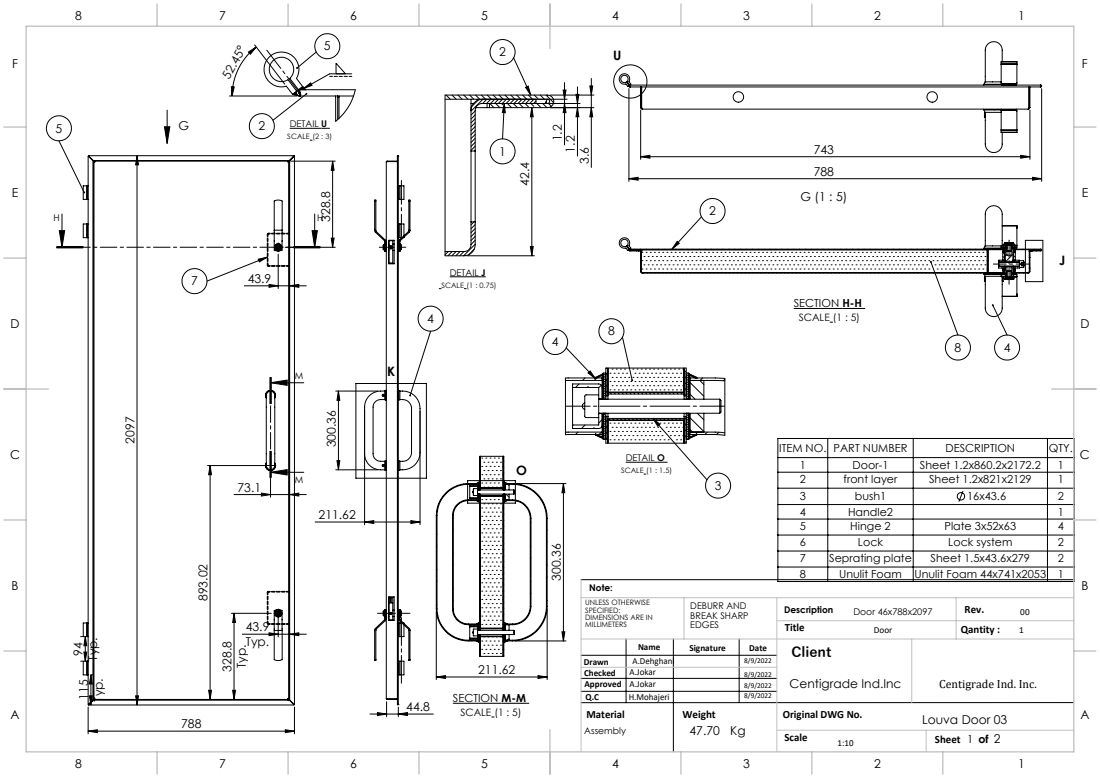
[picture p348: page 1]
SECTION H-H SCALE (1 : 5); DETAIL J SCALE (1 : 0.75); SECTION M-M SCALE (1 : 5); DETAIL O SCALE (1 : 1.5); DETAIL U SCALE (2 : 3); front layer; Sheet 1.2x821x2129

ITEM NO. | PART NUMBER | DESCRIPTION | QTY.
1 | Door-1 | Sheet 1.2x860.2x2172.2 | 1

3 | bush1 | 16x43.6 | 2
4 | Handle2 | | 1
5 | Hinge 2 | Plate 3x52x63 | 4
6 | Lock | Lock system | 2
7 | Seprating plate | Sheet 1.5x43.6x279 | 2
8 | Unulit Foam | Unulit Foam 44x741x2053 | 1

UNLESS OTHERWISE SPECIFIED: DIMENSIONS ARE IN MILLIMETERS | BREAK SHARP EDGES | Description DEBURR AND Door 46x788x2097 | Rev. 00
Name | Signature | Date | Client
Drawn | A.Dehghani | | 8/9/2022 | Centigrade Ind.Inc | Centigrade Ind. Inc.
Checked | A.Jokar | | 8/9/2022
Approved | A.Jokar | | 8/9/2022
Q.C | H.Mohajeri | | 8/9/2022
Material Assembly | | Weight 47.70 Kg | | Original DWG No. Louva Door 03
Scale 1:10 | 1 of 2 Sheet

Title Door | Qantity : 1

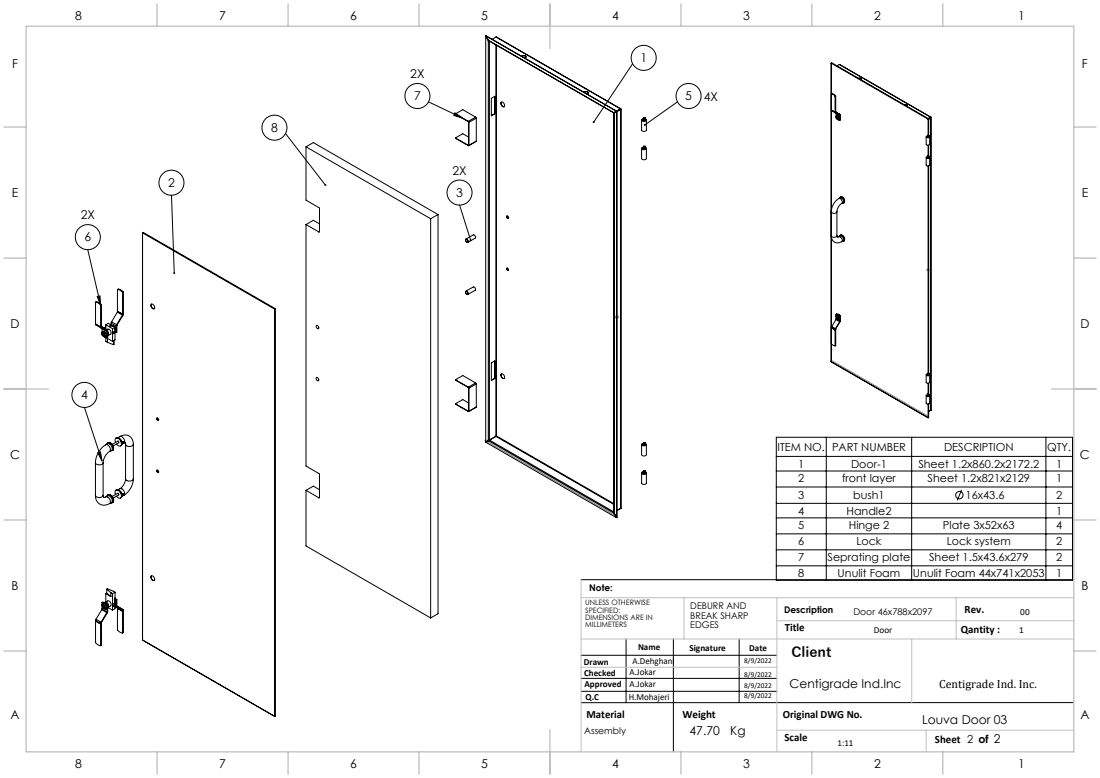
[picture p349: page 2]

ITEM NO. | PART NUMBER | DESCRIPTION | QTY.
1 | Door-1 | Sheet 1.2x860.2x2172.2 | 1
2 | front layer | Sheet 1.2x821x2129 | 1
3 | bush1 | 16x43.6 | 2
4 | Handle2 | | 1
5 | Hinge 2 | Plate 3x52x63 | 4
6 | Lock | Lock system | 2
7 | Seprating plate | Sheet 1.5x43.6x279 | 2
8 | Unulit Foam | Unulit Foam 44x741x2053 | 1

UNLESS OTHERWISE SPECIFIED: DIMENSIONS ARE IN MILLIMETERS | BREAK SHARP EDGES | Description DEBURR AND Door 46x788x2097 | Rev. 00
Name | Signature | Date | Client
Drawn | A.Dehghani | | 8/9/2022 | Centigrade Ind.Inc | Centigrade Ind. Inc.
Checked | A.Jokar | | 8/9/2022
Approved | A.Jokar | | 8/9/2022
Q.C | H.Mohajeri | | 8/9/2022
Material Assembly | | Weight 47.70 Kg | | Original DWG No. Louva Door 03
Scale 1:11 | 2 of 2 Sheet

Title Door | Qantity : 1
