koalium/centidocs/jokar/Louva Door BOM/General/Final Door Assem 01.PDF

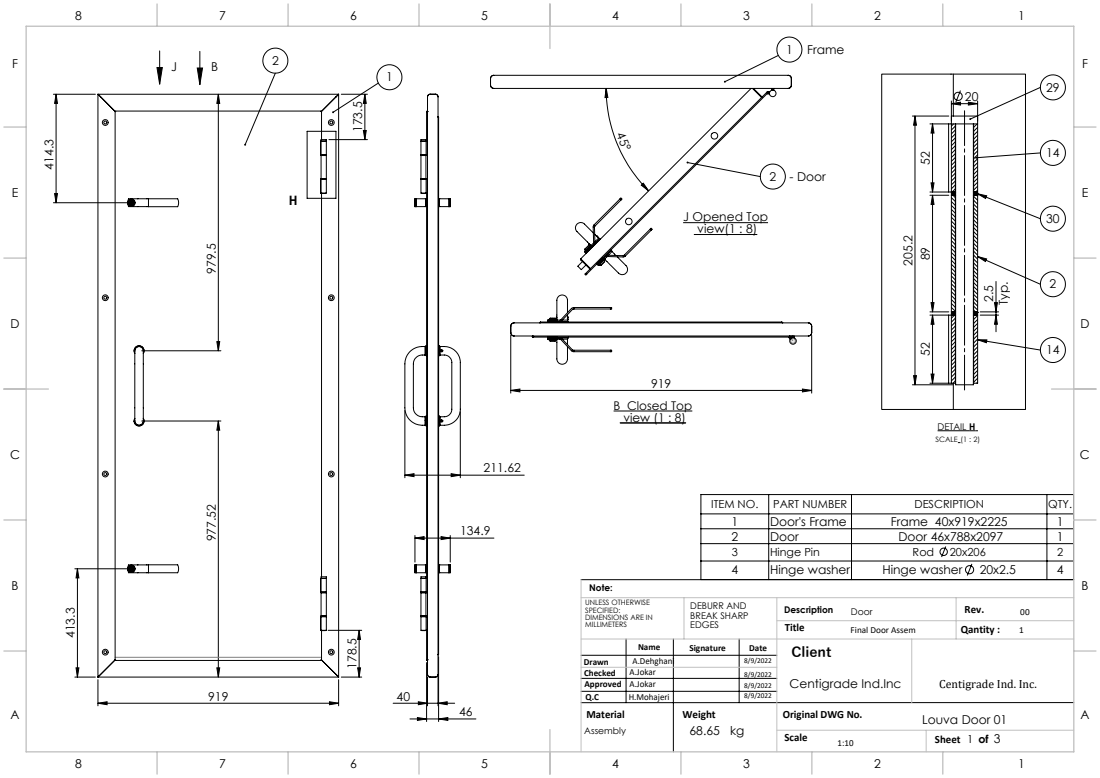
[picture p350: page 1]
SCALE (1 : 2); B Closed Top; view (1 : 8) 45°; J Opened Top view(1 : 8); 1 Frame; 2 - Door; ITEM NO.; PART NUMBER; DESCRIPTION; QTY. 1; Door's Frame; Frame 40x919x2225; Door; Door 46x788x2097; Hinge Pin; Rod 20x206; Hinge washer; Hinge washer 20x2.5

UNLESS OTHERWISE SPECIFIED: DIMENSIONS ARE IN MILLIMETERS | BREAK SHARP EDGES | Description DEBURR AND Door | Rev. 00
Name | Signature | Date | Client
Drawn | A.Dehghani | | 8/9/2022 | Centigrade Ind.Inc | Centigrade Ind. Inc.
Checked | A.Jokar | | 8/9/2022
Approved | A.Jokar | | 8/9/2022
Q.C | H.Mohajeri | | 8/9/2022
Material Assembly | | Weight 68.65 kg | | Original DWG No. Louva Door 01

Title Final Door Assem | Qantity : 1

Scale 1:10 | 1 of Sheet

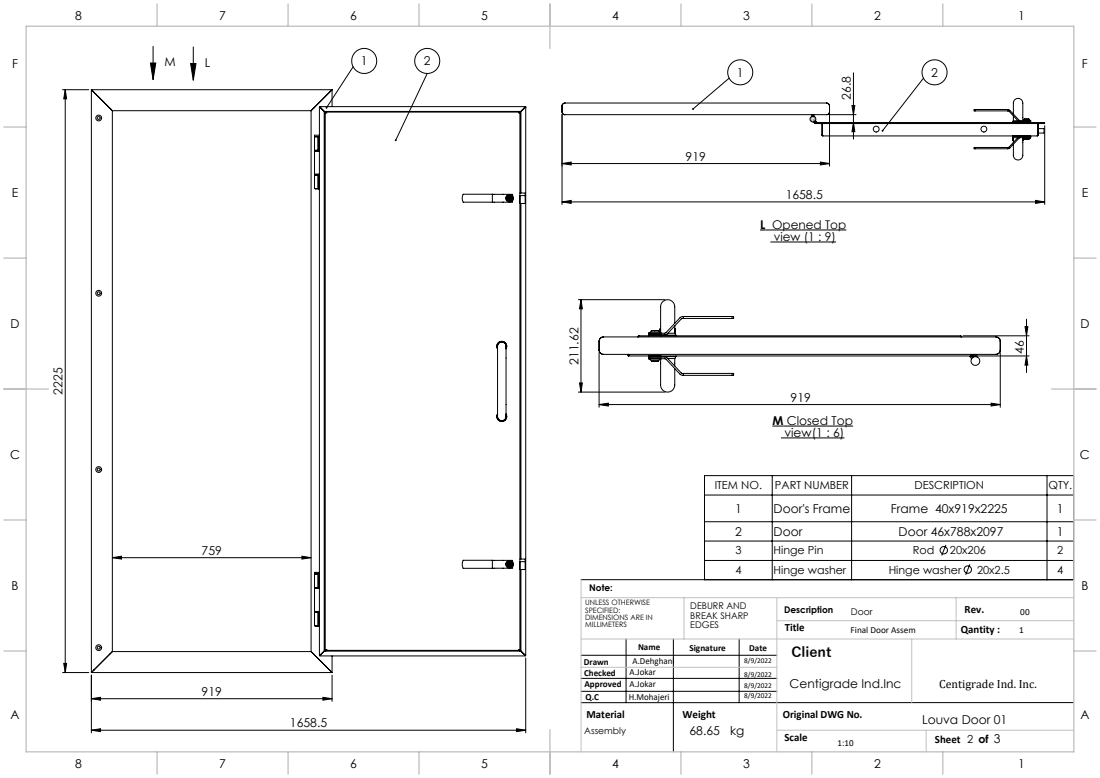
[picture p351: page 2]
L Opened Top view (1 : 9); M Closed Top view(1 : 6)

ITEM NO. | PART NUMBER | DESCRIPTION | QTY.
1 | Door's Frame | Frame 40x919x2225 | 1
2 | Door | Door 46x788x2097 | 1
3 | Hinge Pin | Rod 20x206 | 2
4 | Hinge washer | Hinge washer 20x2.5 | 4
Drawn | A.Dehghani | | 8/9/2022 | Centigrade Ind.Inc | Centigrade Ind. Inc.
Checked | A.Jokar | | 8/9/2022
Approved | A.Jokar | | 8/9/2022
Q.C | H.Mohajeri | | 8/9/2022
Material Assembly | | Weight 68.65 kg | | Original DWG No. Louva Door 01
Scale 1:10 | 2 of 3 Sheet

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

Title Final Door Assem | Qantity : 1

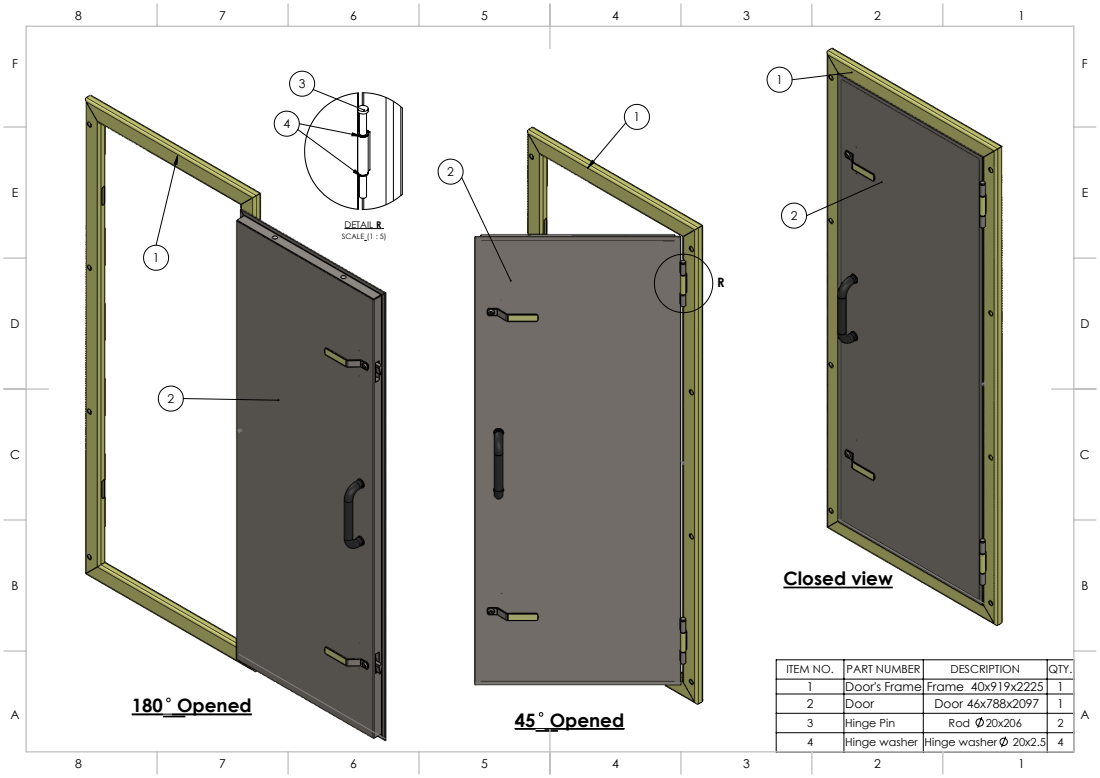
[picture p352: page 3]
Closed view; 180 Opened; 45 Opened; DETAIL R SCALE (1 : 5); Hinge Pin; Rod 20x206; Hinge washer; Hinge washer 20x2.5

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
