koalium/centidocs/jokar/Louva Door BOM/General/Frame 02-P01.PDF

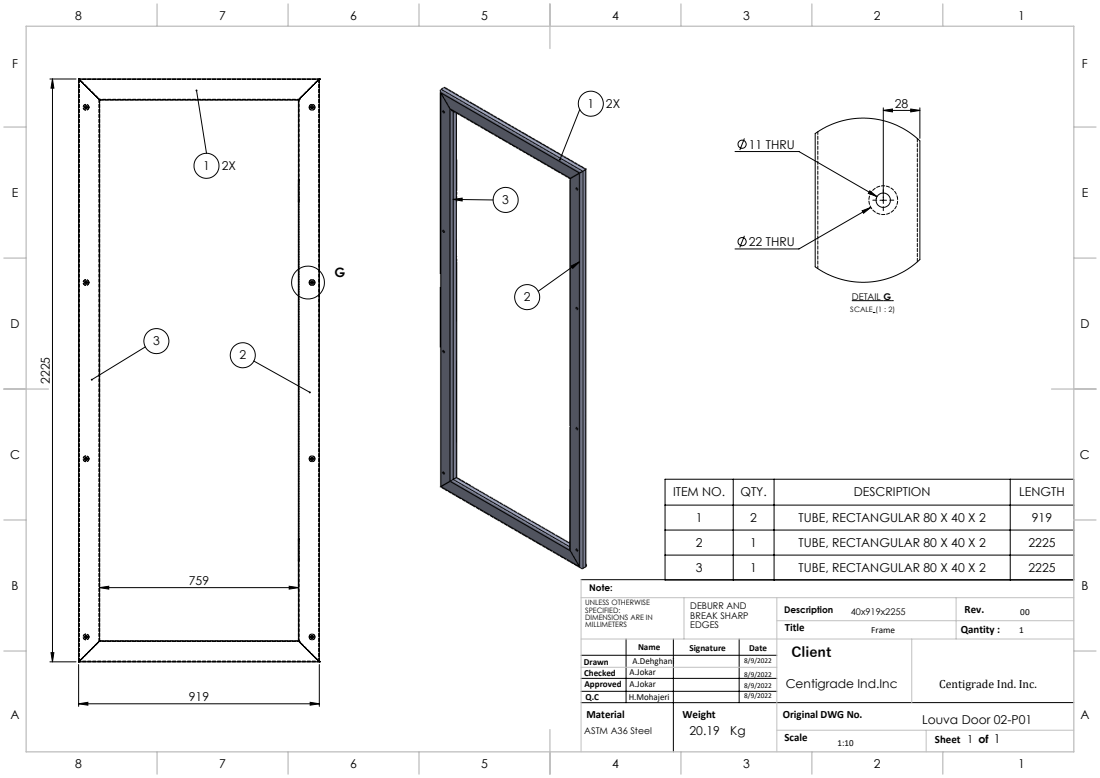
[picture p353: page 1]
22 THRU; 11 THRU; DETAIL G SCALE (1 : 2)

ITEM NO. | QTY. | DESCRIPTION | LENGTH
1 | 2 | TUBE, RECTANGULAR 80 X 40 X 2 | 919
2 | 1 | TUBE, RECTANGULAR 80 X 40 X 2 | 2225
3 | 1 | TUBE, RECTANGULAR 80 X 40 X 2 | 2225
Drawn | A.Dehghani | | 8/9/2022 | Centigrade Ind.Inc | Centigrade Ind. Inc.
Checked | A.Jokar | | 8/9/2022
Approved | A.Jokar | | 8/9/2022
Q.C | H.Mohajeri | | 8/9/2022
Material ASTM A36 Steel | | Weight 20.19 Kg | | Original DWG No. Louva Door 02-P01
Scale 1:10 | 1 of 1 Sheet

UNLESS OTHERWISE SPECIFIED: DIMENSIONS ARE IN MILLIMETERS | BREAK SHARP EDGES | Description DEBURR AND 40x919x2255 | Rev. 00
Name | Signature | Date | Client

Title Frame | Qantity : 1
