koalium/centidocs/jokar/Louva Door BOM/General/Frame Assem 02.PDF

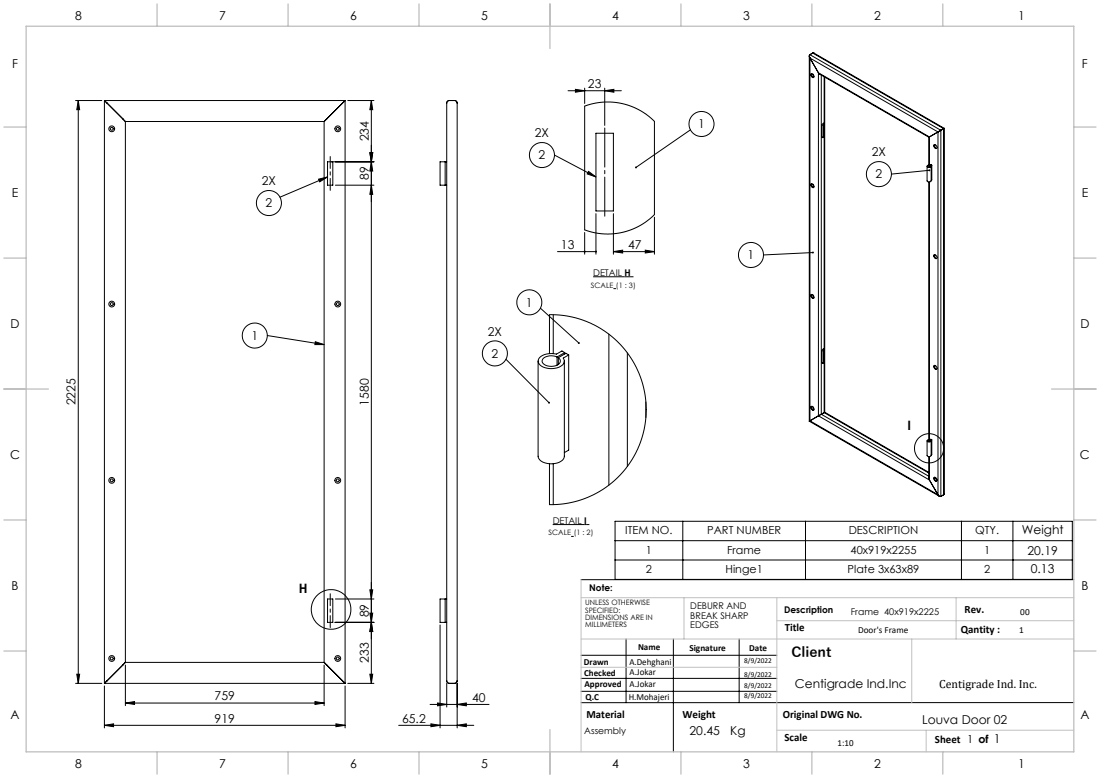
[picture p354: page 1]
DETAIL H SCALE (1 : 3); DETAIL I SCALE (1 : 2); Original DWG No.; Assembly; Louva Door 02

ITEM NO. | PART NUMBER | DESCRIPTION | QTY. | Weight
1 | Frame | 40x919x2255 | 1 | 20.19
2 | Hinge1 | Plate 3x63x89 | 2 | 0.13
Drawn | A.Dehghani | | 8/9/2022 | Centigrade Ind.Inc | Centigrade Ind. Inc.
Checked | A.Jokar | | 8/9/2022
Approved | A.Jokar | | 8/9/2022
Q.C | H.Mohajeri | | 8/9/2022

UNLESS OTHERWISE SPECIFIED: DIMENSIONS ARE IN MILLIMETERS | BREAK SHARP EDGES | Description DEBURR AND Frame 40x919x2225 | Rev. 00
Name | Signature | Date | Client

Title Door's Frame | Qantity : 1
