koalium/centidocs/jokar/Louva Door BOM/General/Frame Assem.pdf

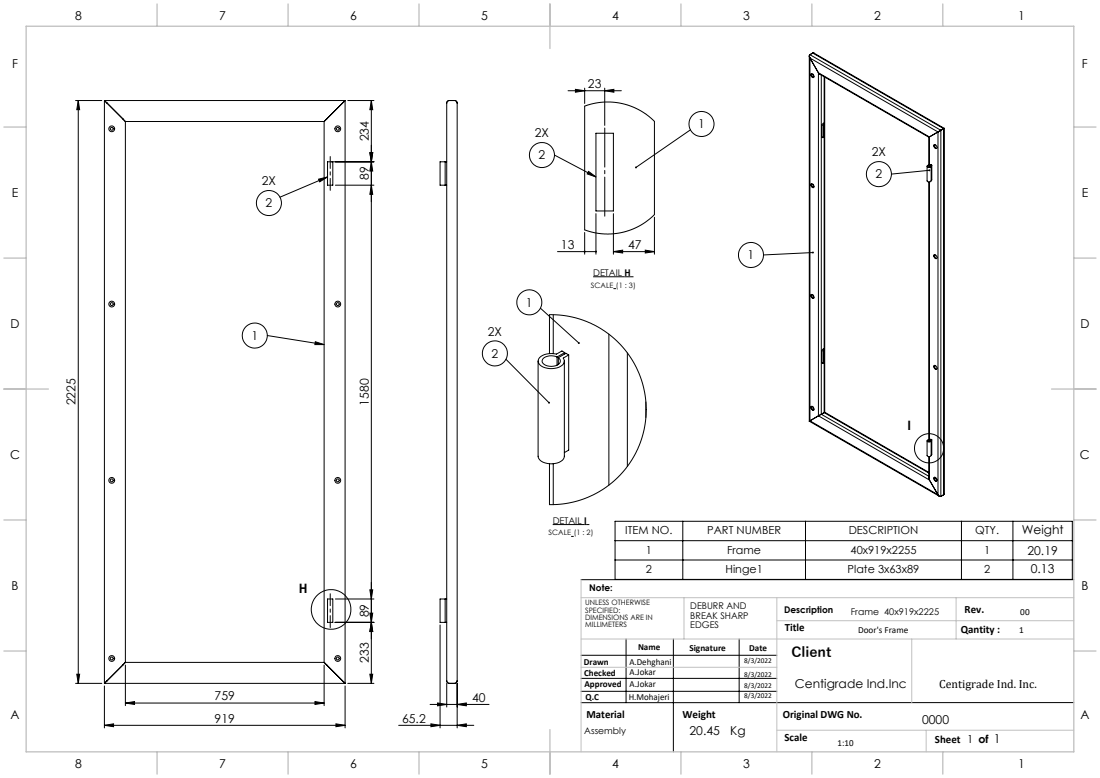
[picture p355: page 1]
DETAIL H SCALE (1 : 3); DETAIL I SCALE (1 : 2); Original DWG No.; Assembly

ITEM NO. | PART NUMBER | DESCRIPTION | QTY. | Weight
1 | Frame | 40x919x2255 | 1 | 20.19
2 | Hinge1 | Plate 3x63x89 | 2 | 0.13
Drawn | A.Dehghani | | 8/3/2022 | Centigrade Ind.Inc | Centigrade Ind. Inc.
Checked | A.Jokar | | 8/3/2022
Approved | A.Jokar | | 8/3/2022
Q.C | H.Mohajeri | | 8/3/2022

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

Title Door's Frame | Qantity : 1
