koalium/centidocs/jokar/Louva Door BOM/General/front layer 03-P02.PDF

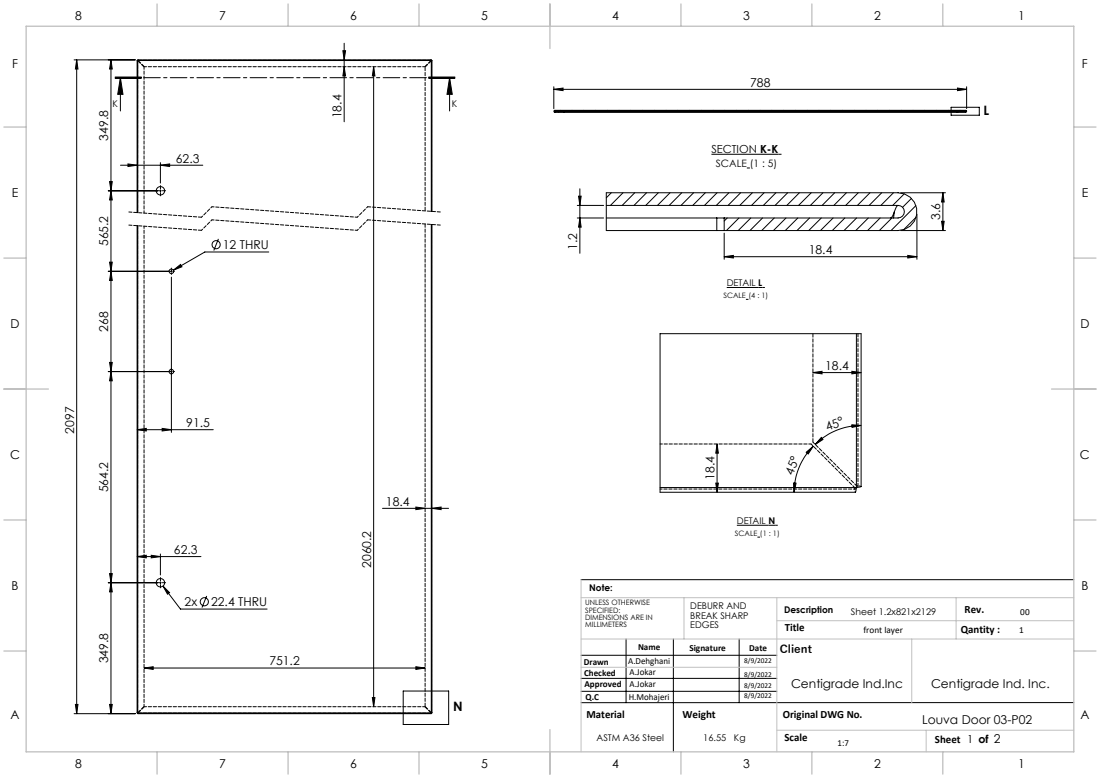
[picture p356: page 1]
12 THRU; 2x 22.4 THRU; SECTION K-K SCALE (1 : 5); SCALE (4 : 1); SCALE (1 : 1)

UNLESS OTHERWISE SPECIFIED: DIMENSIONS ARE IN MILLIMETERS | BREAK SHARP EDGES | Description DEBURR AND Sheet 1.2x821x2129 | Rev. 00

Title front layer | Qantity : 1

Name | Signature | Date | Client

Drawn | A.Dehghani | | 8/9/2022 | Centigrade Ind.Inc | Centigrade Ind. Inc.
Checked | A.Jokar | | 8/9/2022
Approved | A.Jokar | | 8/9/2022
Q.C | H.Mohajeri | | 8/9/2022
Material ASTM A36 Steel | | Weight 16.55 Kg | | Original DWG No. Louva Door 03-P02

Scale 1:7 | 1 of 2 Sheet

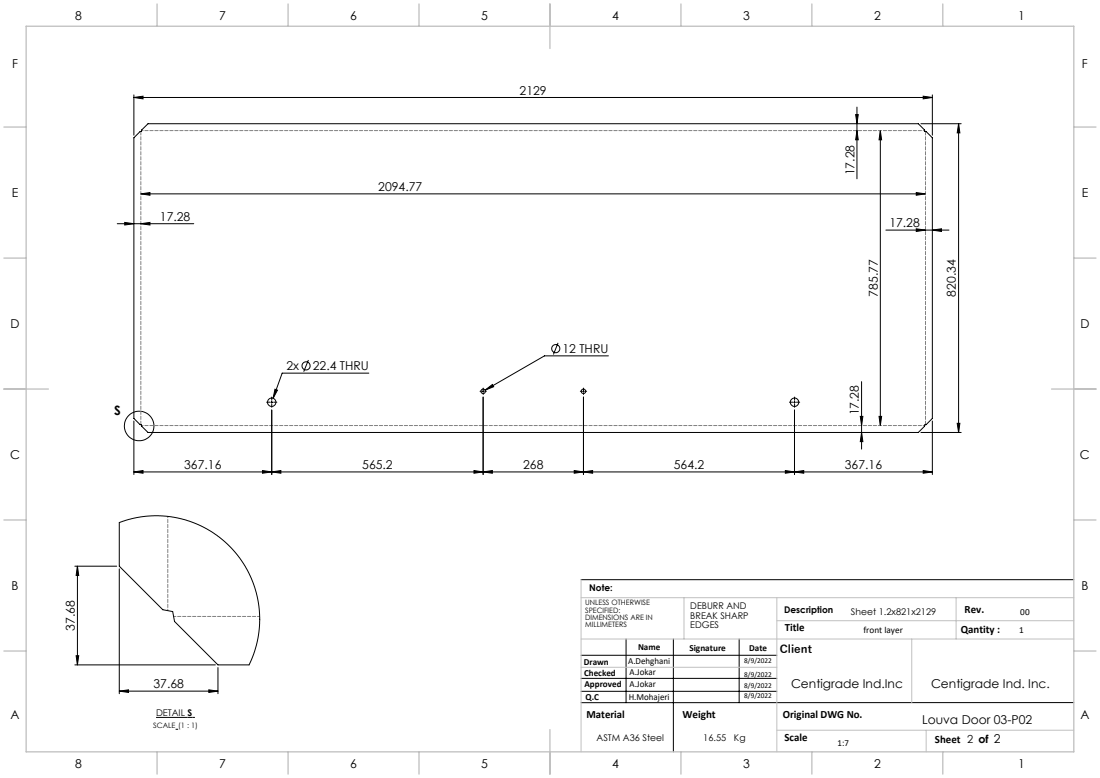
[picture p357: page 2]
DETAIL S SCALE (1 : 1)

367.16 565.2 268 564.2 367.16 17.28 17.28 17.28 12 THRU 2x 22.4 THRU | 17.28

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

Title front layer | Qantity : 1

Name | Signature | Date | Client

Drawn | A.Dehghani | | 8/9/2022 | Centigrade Ind.Inc | Centigrade Ind. Inc.
Checked | A.Jokar | | 8/9/2022
Approved | A.Jokar | | 8/9/2022
Q.C | H.Mohajeri | | 8/9/2022
Material ASTM A36 Steel | | Weight 16.55 Kg | | Original DWG No. Louva Door 03-P02
Scale 1:7 | 2 of 2 Sheet
