koalium/centidocs/jokar/Louva Door BOM/General/Hinge 02-P02.PDF

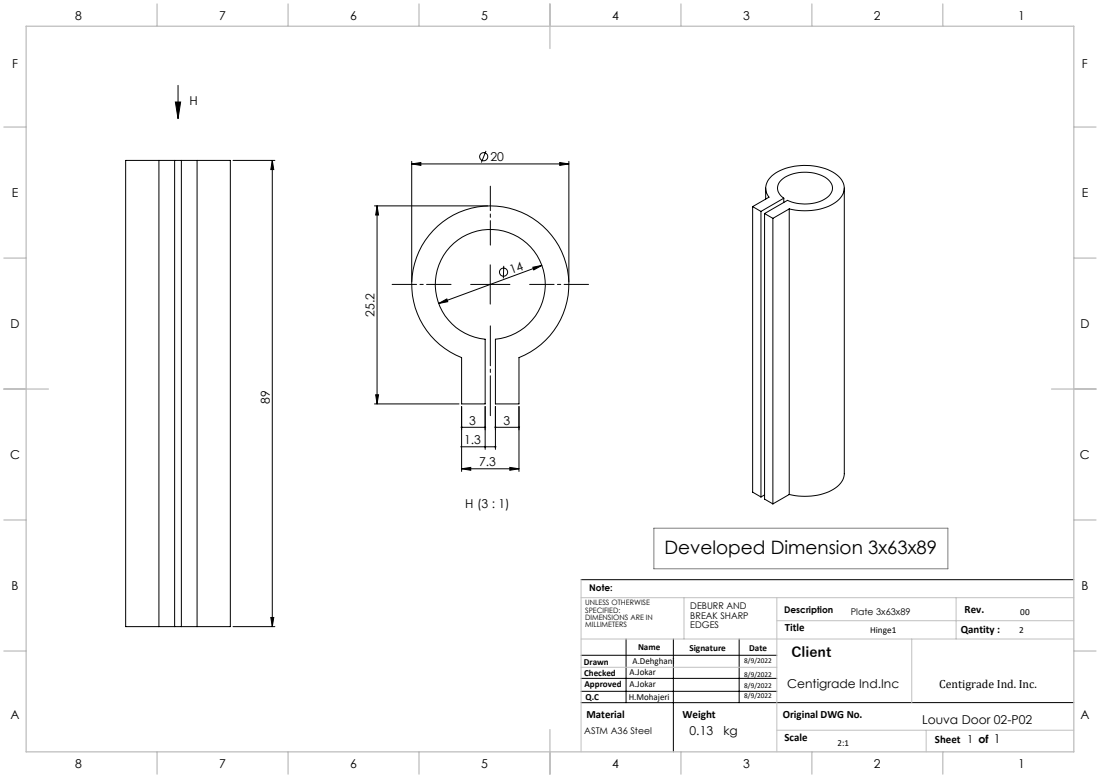
[picture p360: page 1]
Developed Dimension 3x63x89

UNLESS OTHERWISE SPECIFIED: DIMENSIONS ARE IN MILLIMETERS | BREAK SHARP EDGES | Description DEBURR AND Plate 3x63x89 | Rev. 00
Name | Signature | Date | Client
Drawn | A.Dehghani | | 8/9/2022 | Centigrade Ind.Inc | Centigrade Ind. Inc.
Checked | A.Jokar | | 8/9/2022
Approved | A.Jokar | | 8/9/2022
Q.C | H.Mohajeri | | 8/9/2022
Material ASTM A36 Steel | | Weight 0.13 kg | | Original DWG No. Louva Door 02-P02
Scale 2:1 | 1 of 1 Sheet

Title Hinge1 | Qantity : 2
