koalium/centidocs/jokar/Louva Door BOM/General/Hinge 2-03-P03.pdf

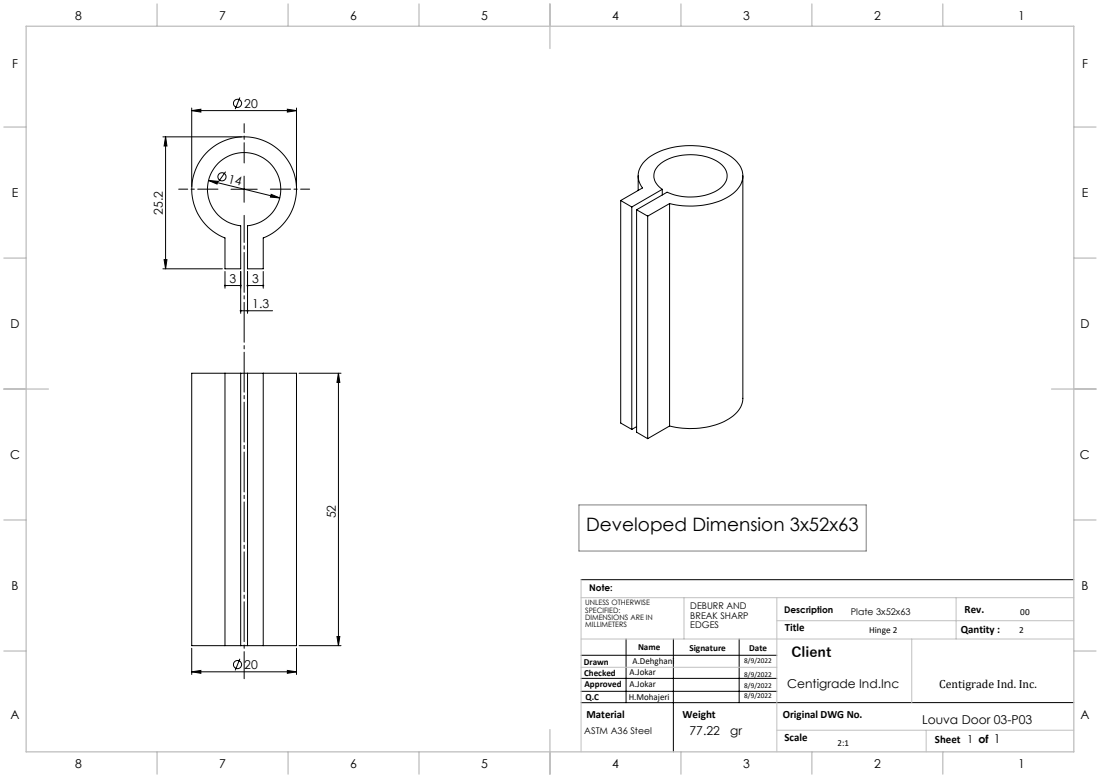
[picture p361: page 1]
Developed Dimension 3x52x63

UNLESS OTHERWISE SPECIFIED: DIMENSIONS ARE IN MILLIMETERS | BREAK SHARP EDGES | Description DEBURR AND Plate 3x52x63 | Rev. 00
Name | Signature | Date | Client
Drawn | A.Dehghani | | 8/9/2022 | Centigrade Ind.Inc | Centigrade Ind. Inc.
Checked | A.Jokar | | 8/9/2022
Approved | A.Jokar | | 8/9/2022
Q.C | H.Mohajeri | | 8/9/2022
Material ASTM A36 Steel | | Weight 77.22 gr | | Original DWG No. Louva Door 03-P03
Scale 2:1 | 1 of 1 Sheet

Title Hinge 2 | Qantity : 2
