koalium/centidocs/jokar/Louva Door BOM/General/Hinge Pin 04.PDF

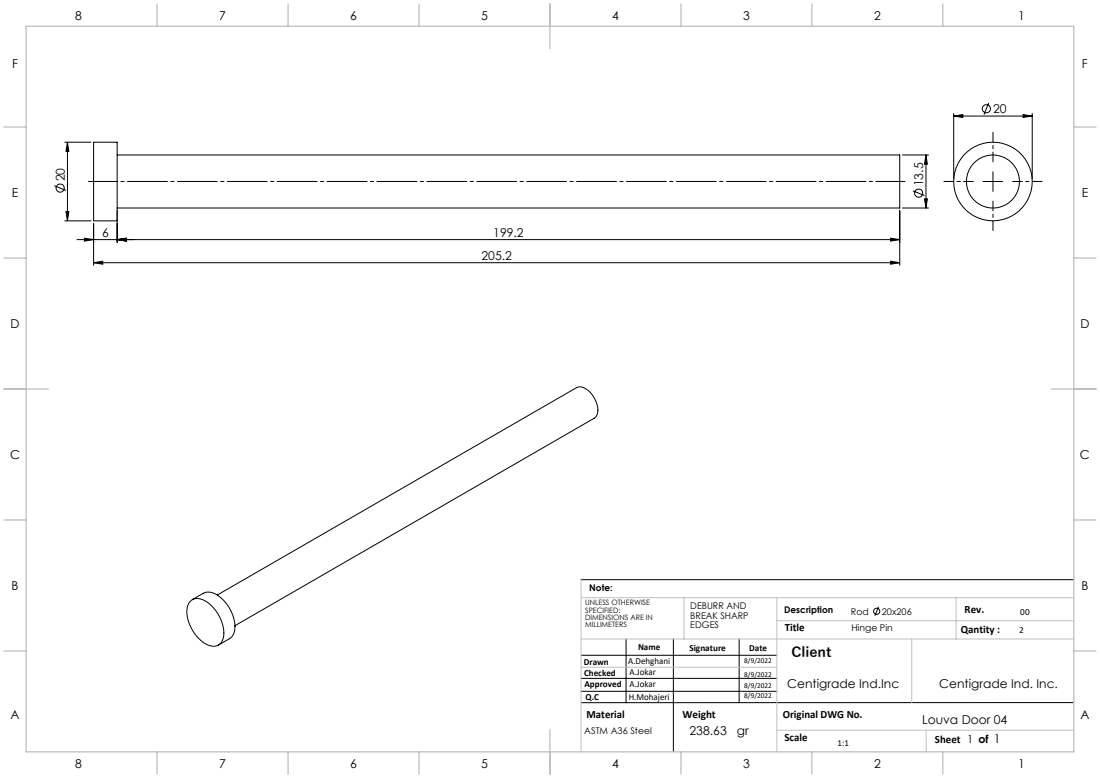
[picture p362: page 1]

UNLESS OTHERWISE SPECIFIED: DIMENSIONS ARE IN MILLIMETERS | BREAK SHARP EDGES | Description DEBURR AND Rod 20x206 | Rev. 00
Name | Signature | Date | Client

Title Hinge Pin | Qantity : 2

Drawn | A.Dehghani | | 8/9/2022 | Centigrade Ind.Inc | Centigrade Ind. Inc.
Checked | A.Jokar | | 8/9/2022
Approved | A.Jokar | | 8/9/2022
Q.C | H.Mohajeri | | 8/9/2022
Material ASTM A36 Steel | | Weight 238.63 gr | | Original DWG No. Louva Door 04
Scale 1:1 | 1 of 1 Sheet
