koalium/centidocs/jokar/Louva Door BOM/General/Hinge washer 05.pdf

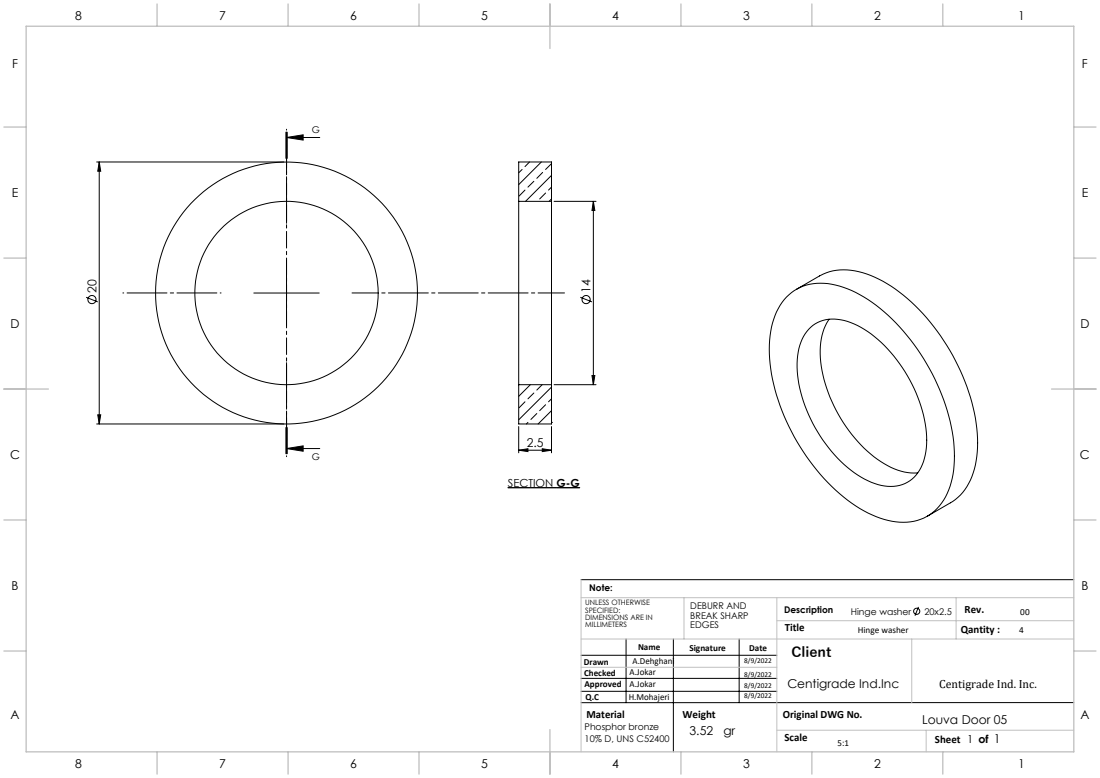
[picture p363: page 1]
SECTION G-G

UNLESS OTHERWISE SPECIFIED: DIMENSIONS ARE IN MILLIMETERS | BREAK SHARP EDGES | Description DEBURR AND Hinge washer 20x2.5 | Rev. 00
Name | Signature | Date | Client
Drawn | A.Dehghani | | 8/9/2022 | Centigrade Ind.Inc | Centigrade Ind. Inc.
Checked | A.Jokar | | 8/9/2022
Approved | A.Jokar | | 8/9/2022
Q.C | H.Mohajeri | | 8/9/2022
Material Phosphor bronze 10% D, UNS C52400 | | Weight 3.52 gr | | Original DWG No. Louva Door 05
Scale 5:1 | 1 of 1 Sheet

Title Hinge washer | Qantity : 4
