koalium/centidocs/jokar/Louva Door BOM/General/Horizontal Rectangular tube 02-P01.pdf

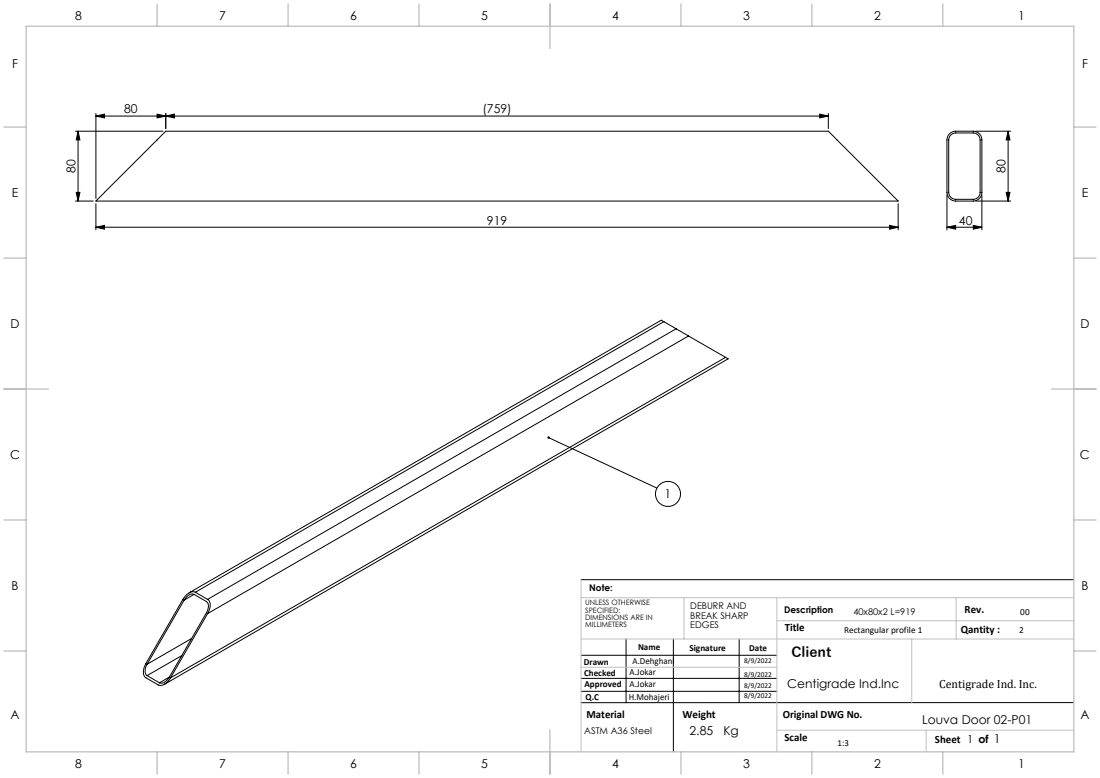
[picture p364: page 1]

UNLESS OTHERWISE SPECIFIED: DIMENSIONS ARE IN MILLIMETERS | BREAK SHARP EDGES | Description DEBURR AND 40x80x2 L=919 | Rev. 00
Name | Signature | Date | Client
Drawn | A.Dehghani | | 8/9/2022 | Centigrade Ind.Inc | Centigrade Ind. Inc.
Checked | A.Jokar | | 8/9/2022
Approved | A.Jokar | | 8/9/2022
Q.C | H.Mohajeri | | 8/9/2022
Material ASTM A36 Steel | | Weight 2.85 Kg | | Original DWG No. Louva Door 02-P01
Scale 1:3 | 1 of 1 Sheet

Title Rectangular profile 1 | Qantity : 2
