koalium/centidocs/jokar/Louva Door BOM/General/Seprating plate 03-P07.pdf

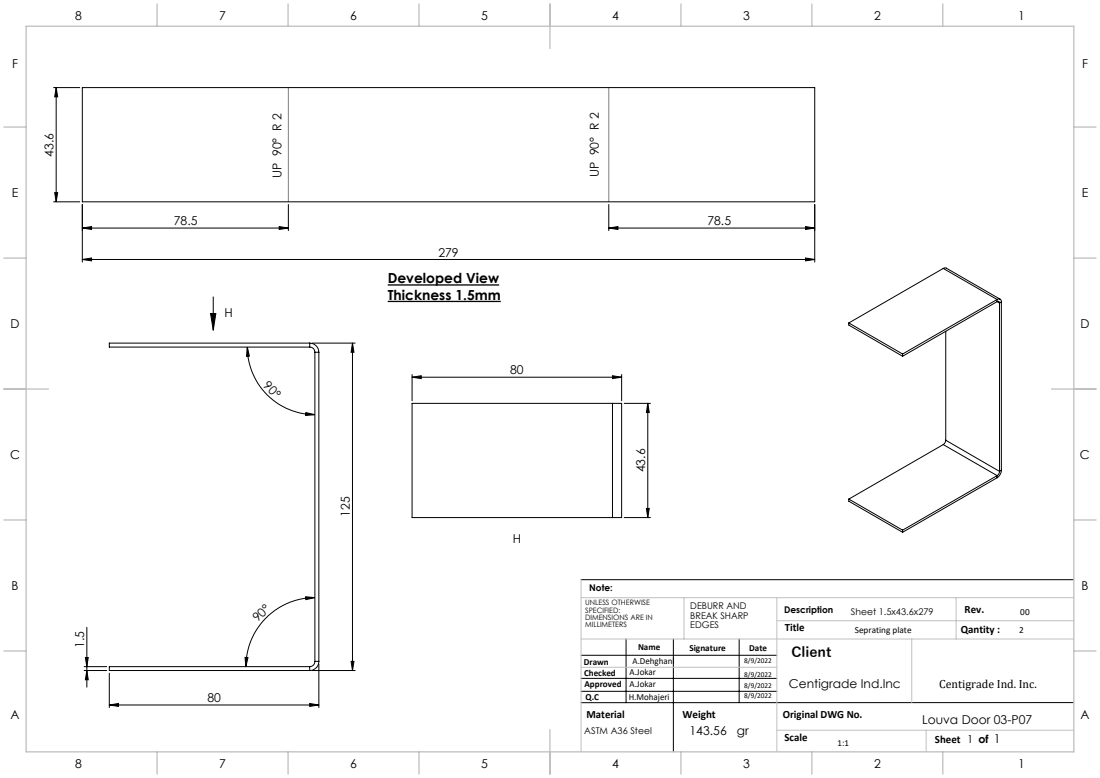
[picture p365: page 1]
Developed View Thickness 1.5mm

UNLESS OTHERWISE SPECIFIED: DIMENSIONS ARE IN MILLIMETERS | BREAK SHARP EDGES | Description DEBURR AND Sheet 1.5x43.6x279 | Rev. 00
Name | Signature | Date | Client
Drawn | A.Dehghani | | 8/9/2022 | Centigrade Ind.Inc | Centigrade Ind. Inc.
Checked | A.Jokar | | 8/9/2022
Approved | A.Jokar | | 8/9/2022
Q.C | H.Mohajeri | | 8/9/2022
Material ASTM A36 Steel | | Weight 143.56 gr | | Original DWG No. Louva Door 03-P07
Scale 1:1 | 1 of 1 Sheet

Title Seprating plate | Qantity : 2
