koalium/centidocs/jokar/Louva Door BOM/General/Single Door.pdf

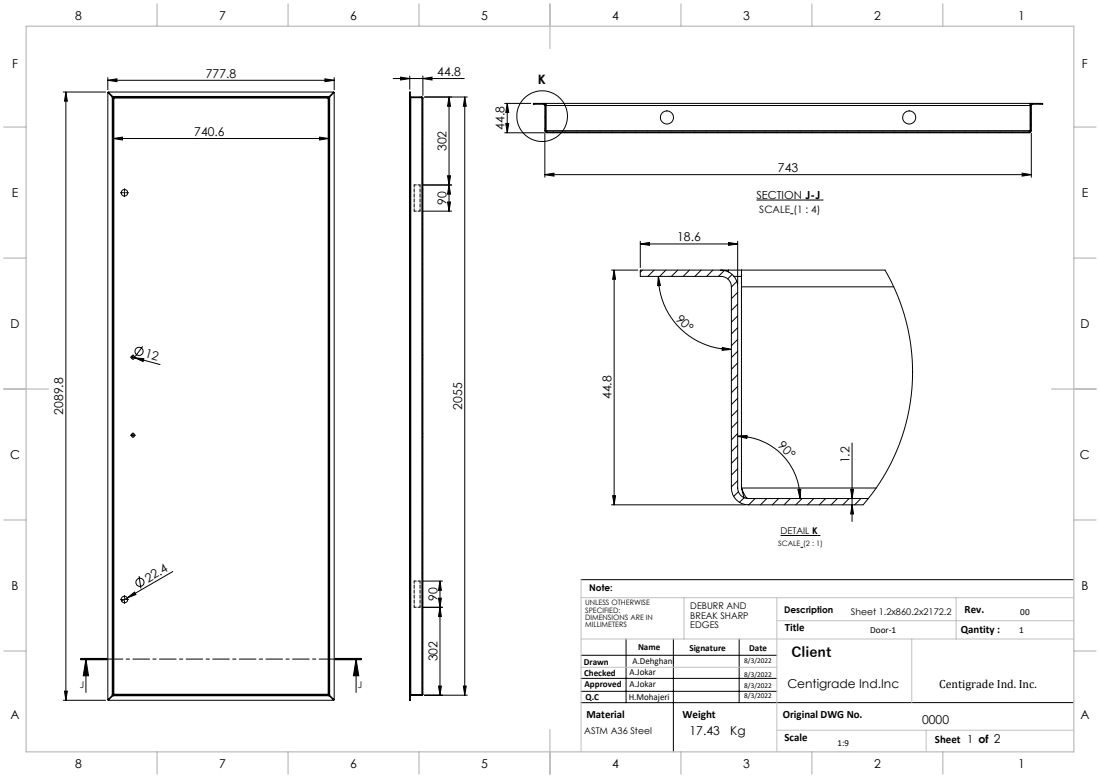
[picture p368: page 1]
SECTION J-J SCALE (1 : 4); DETAIL K SCALE (2 : 1)

UNLESS OTHERWISE SPECIFIED: DIMENSIONS ARE IN MILLIMETERS | BREAK SHARP EDGES | Description DEBURR AND Sheet 1.2x860.2x2172.2 | Rev. 00
Name | Signature | Date | Client
Drawn | A.Dehghani | | 8/3/2022 | Centigrade Ind.Inc | Centigrade Ind. Inc.
Checked | A.Jokar | | 8/3/2022
Approved | A.Jokar | | 8/3/2022
Q.C | H.Mohajeri | | 8/3/2022
Material ASTM A36 Steel | | Weight 17.43 Kg | | Original DWG No. 0000
Scale 1:9 | 1 of 2 Sheet

Title Door-1 | Qantity : 1

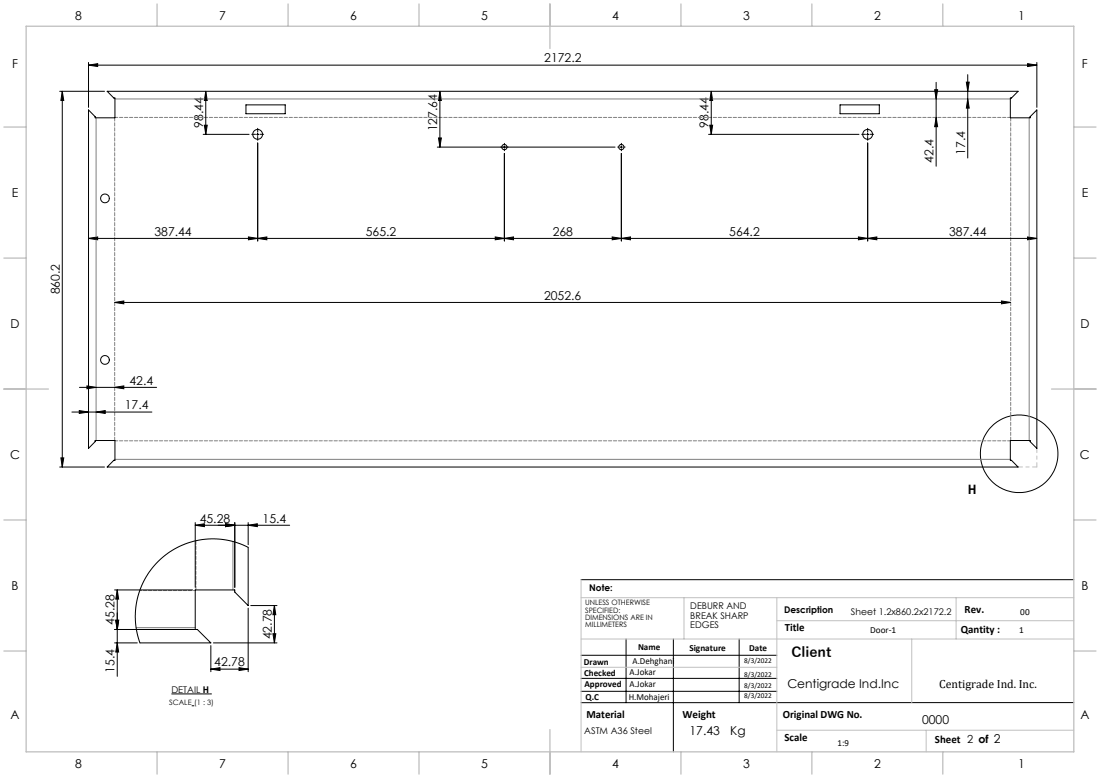
[picture p369: page 2]
DETAIL H SCALE (1 : 3)

UNLESS OTHERWISE SPECIFIED: DIMENSIONS ARE IN MILLIMETERS | BREAK SHARP EDGES | Description DEBURR AND Sheet 1.2x860.2x2172.2 | Rev. 00
Name | Signature | Date | Client
Drawn | A.Dehghani | | 8/3/2022 | Centigrade Ind.Inc | Centigrade Ind. Inc.
Checked | A.Jokar | | 8/3/2022
Approved | A.Jokar | | 8/3/2022
Q.C | H.Mohajeri | | 8/3/2022
Material ASTM A36 Steel | | Weight 17.43 Kg | | Original DWG No. 0000
Scale 1:9 | 2 of 2 Sheet

Title Door-1 | Qantity : 1
