koalium/centidocs/jokar/Louva Door BOM/General/Unulit Foam 03-P08.pdf

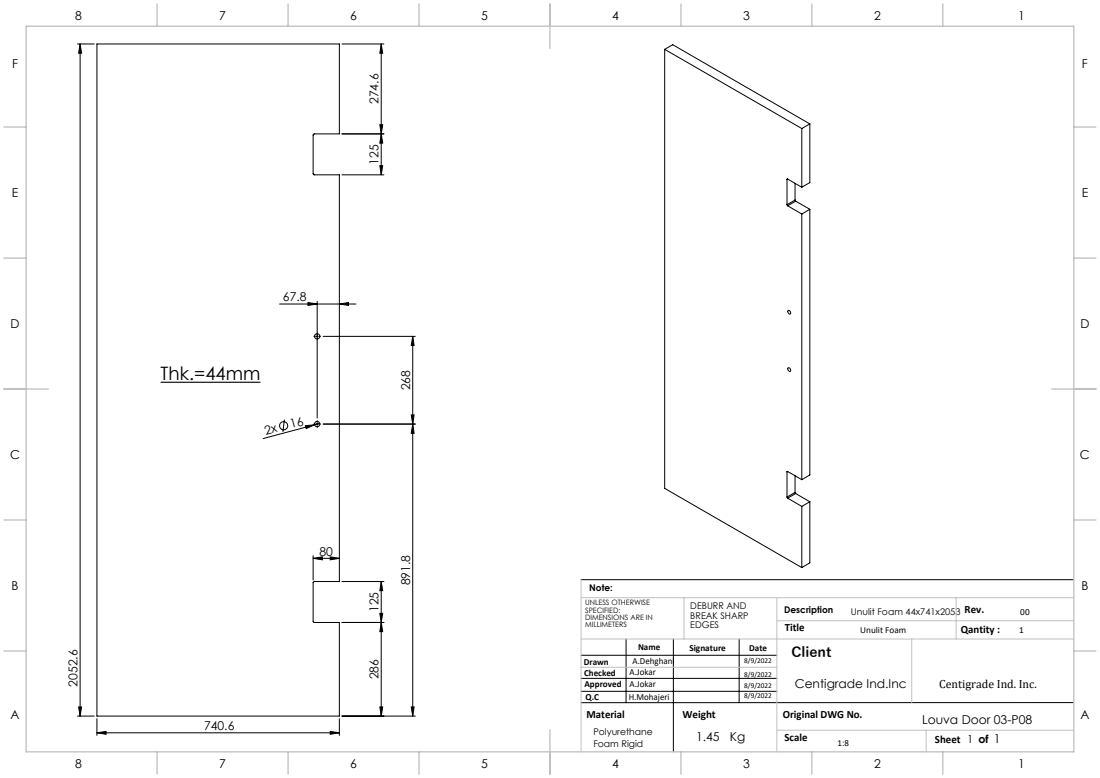
[picture p370: page 1]

UNLESS OTHERWISE SPECIFIED: DIMENSIONS ARE IN MILLIMETERS | BREAK SHARP EDGES | Description DEBURR AND Unulit Foam 44x741x2053 | Rev. 00
Name | Signature | Date | Client
Drawn | A.Dehghani | | 8/9/2022 | Centigrade Ind.Inc | Centigrade Ind. Inc.
Checked | A.Jokar | | 8/9/2022
Approved | A.Jokar | | 8/9/2022
Q.C | H.Mohajeri | | 8/9/2022
Material Polyurethane Foam Rigid | | Weight 1.45 Kg | | Original DWG No. Louva Door 03-P08
Scale 1:8 | 1 of 1 Sheet

Title Unulit Foam | Qantity : 1
