koalium/centidocs/jokar/Louva Door BOM/General/Vertical Rectangular Tube 02-P03.PDF

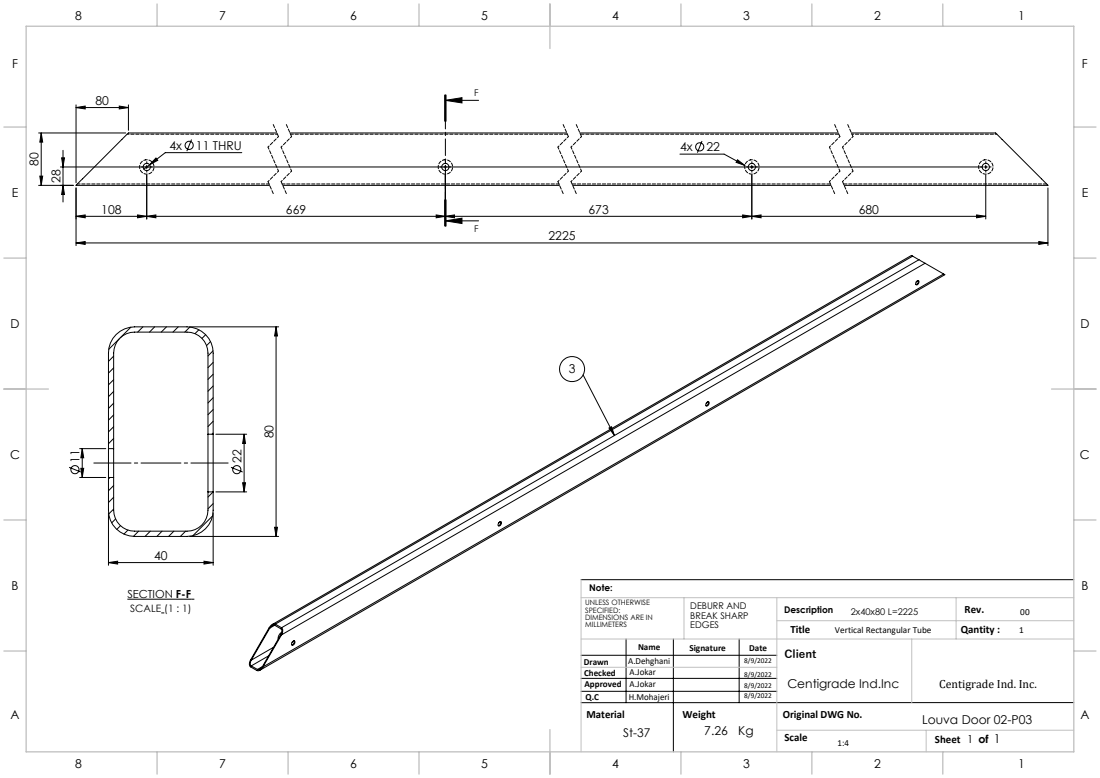
[picture p371: page 1]
4x 11 THRU; SECTION F-F SCALE (1 : 1)

UNLESS OTHERWISE SPECIFIED: DIMENSIONS ARE IN MILLIMETERS | BREAK SHARP EDGES | Description DEBURR AND 2x40x80 L=2225 | Rev. 00
Drawn | A.Dehghani | | 8/9/2022 | Centigrade Ind.Inc | Centigrade Ind. Inc.
Checked | A.Jokar | | 8/9/2022
Approved | A.Jokar | | 8/9/2022
Q.C | H.Mohajeri | | 8/9/2022
Material St-37 | | Weight 7.26 Kg | | Original DWG No. Louva Door 02-P03
Scale 1:4 | 1 of 1 Sheet

Title Vertical Rectangular Tube | Qantity : 1

Name | Signature | Date | Client
