koalium/centidocs/jokar/Louva Door BOM/General/Vertical Tube(with slot) 02-P02.PDF

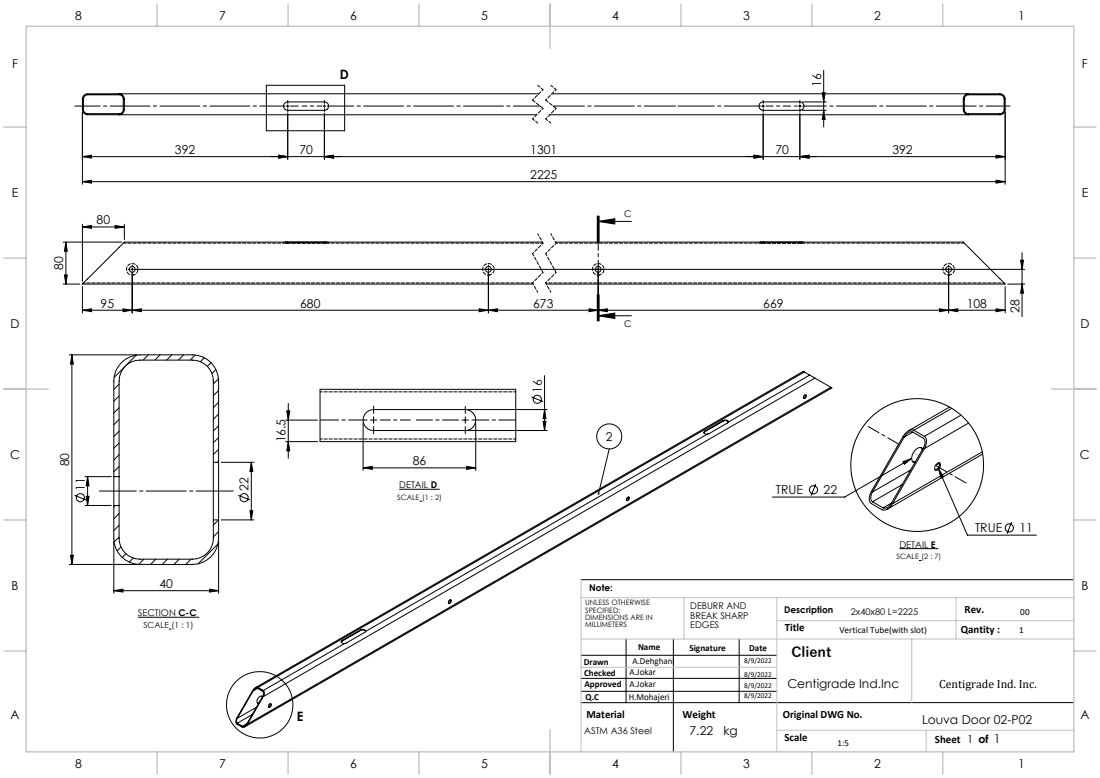
[picture p372: page 1]
SECTION C-C SCALE (1 : 1); DETAIL D SCALE (1 : 2); TRUE 11; DETAIL E SCALE (2 : 7)

UNLESS OTHERWISE SPECIFIED: DIMENSIONS ARE IN MILLIMETERS | BREAK SHARP EDGES | Description DEBURR AND 2x40x80 L=2225 | Rev. 00
Name | Signature | Date | Client
Drawn | A.Dehghani | | 8/9/2022 | Centigrade Ind.Inc | Centigrade Ind. Inc.
Checked | A.Jokar | | 8/9/2022
Approved | A.Jokar | | 8/9/2022
Q.C | H.Mohajeri | | 8/9/2022
Material ASTM A36 Steel | | Weight 7.22 kg | | Original DWG No. Louva Door 02-P02
Scale 1:5 | 1 of 1 Sheet

Title Vertical Tube(with slot) | Qantity : 1
