koalium/centidocs/jokar/Louva Door BOM/Handle/Bush Spacer 03-05-P04.pdf

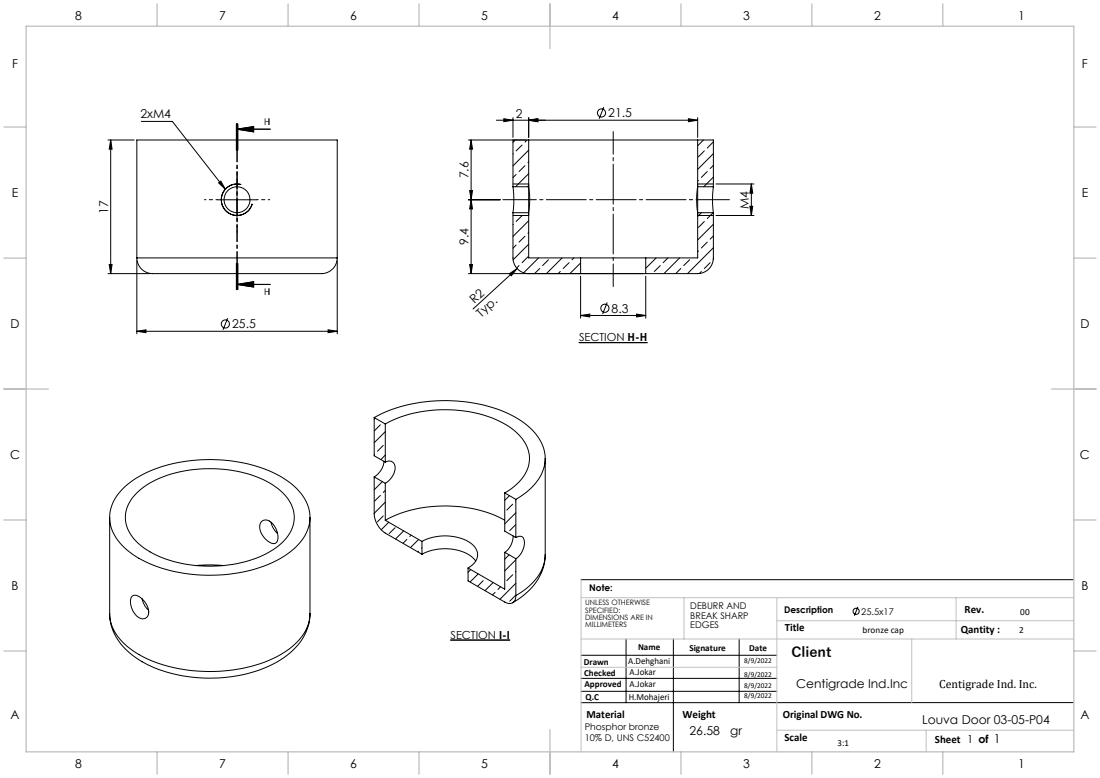
[picture p373: page 1]
SECTION H-H; SECTION I-I

UNLESS OTHERWISE SPECIFIED: DIMENSIONS ARE IN MILLIMETERS | BREAK SHARP EDGES | Description DEBURR AND 25.5x17 | Rev. 00
Name | Signature | Date | Client
Drawn | A.Dehghani | | 8/9/2022 | Centigrade Ind.Inc | Centigrade Ind. Inc.
Checked | A.Jokar | | 8/9/2022
Approved | A.Jokar | | 8/9/2022
Q.C | H.Mohajeri | | 8/9/2022
Material Phosphor bronze 10% D, UNS C52400 | | Weight 26.58 gr | | Original DWG No. Louva Door 03-05-P04
Scale 3:1 | 1 of 1 Sheet

Title bronze cap | Qantity : 2
