koalium/centidocs/jokar/Louva Door BOM/Handle/bush1-03-P04.pdf

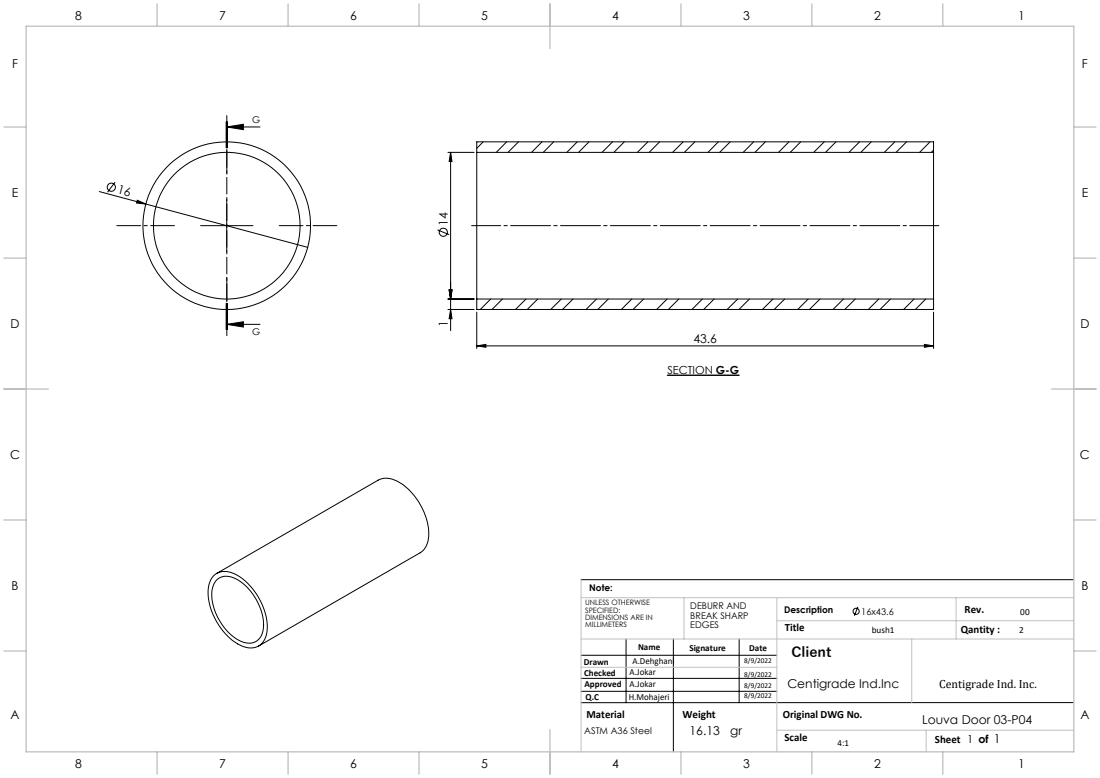
[picture p374: page 1]
SECTION G-G

UNLESS OTHERWISE SPECIFIED: DIMENSIONS ARE IN MILLIMETERS | BREAK SHARP EDGES | Description DEBURR AND 16x43.6 | Rev. 00
Name | Signature | Date | Client
Drawn | A.Dehghani | | 8/9/2022 | Centigrade Ind.Inc | Centigrade Ind. Inc.
Checked | A.Jokar | | 8/9/2022
Approved | A.Jokar | | 8/9/2022
Q.C | H.Mohajeri | | 8/9/2022
Material ASTM A36 Steel | | Weight 16.13 gr | | Original DWG No. Louva Door 03-P04
Scale 4:1 | 1 of 1 Sheet

Title bush1 | Qantity : 2
