koalium/centidocs/jokar/Louva Door BOM/Handle/Handle 03-P05-P01.PDF

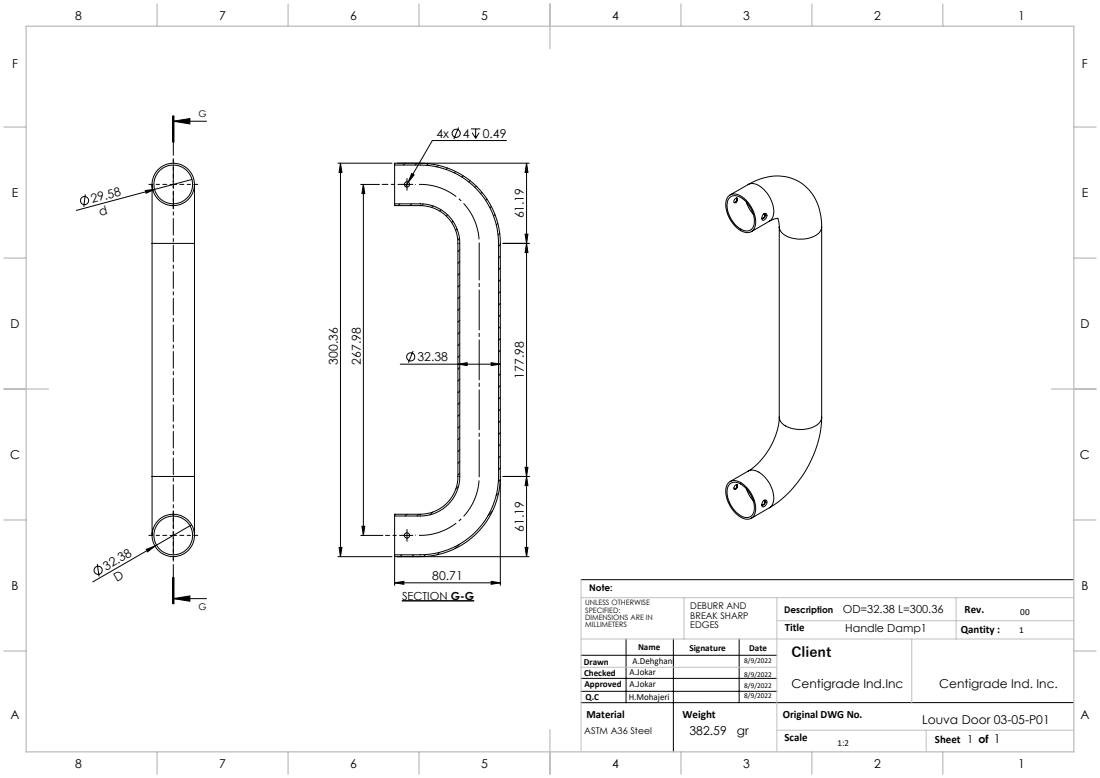
[picture p375: page 1]
SECTION G-G

Note:
UNLESS OTHERWISE
SPECIFIED:
DIMENSIONS ARE IN
MILLIMETERS

Description DEBURR AND
BREAK SHARP
EDGES

Title Handle Damp1 | Qantity : 1

Name | Signature | Date | Client

Drawn | A.Dehghani | | 8/9/2022 | Centigrade Ind.Inc | Centigrade Ind. Inc.
Checked | A.Jokar | | 8/9/2022
Approved | A.Jokar | | 8/9/2022
Q.C | H.Mohajeri | | 8/9/2022
Material ASTM A36 Steel | | Weight 382.59 gr | | Original DWG No. Louva Door 03-05-P01
Scale 1:2 | 1 of 1 Sheet
