koalium/centidocs/jokar/Louva Door BOM/Handle/Handle 03-P05-P05.pdf

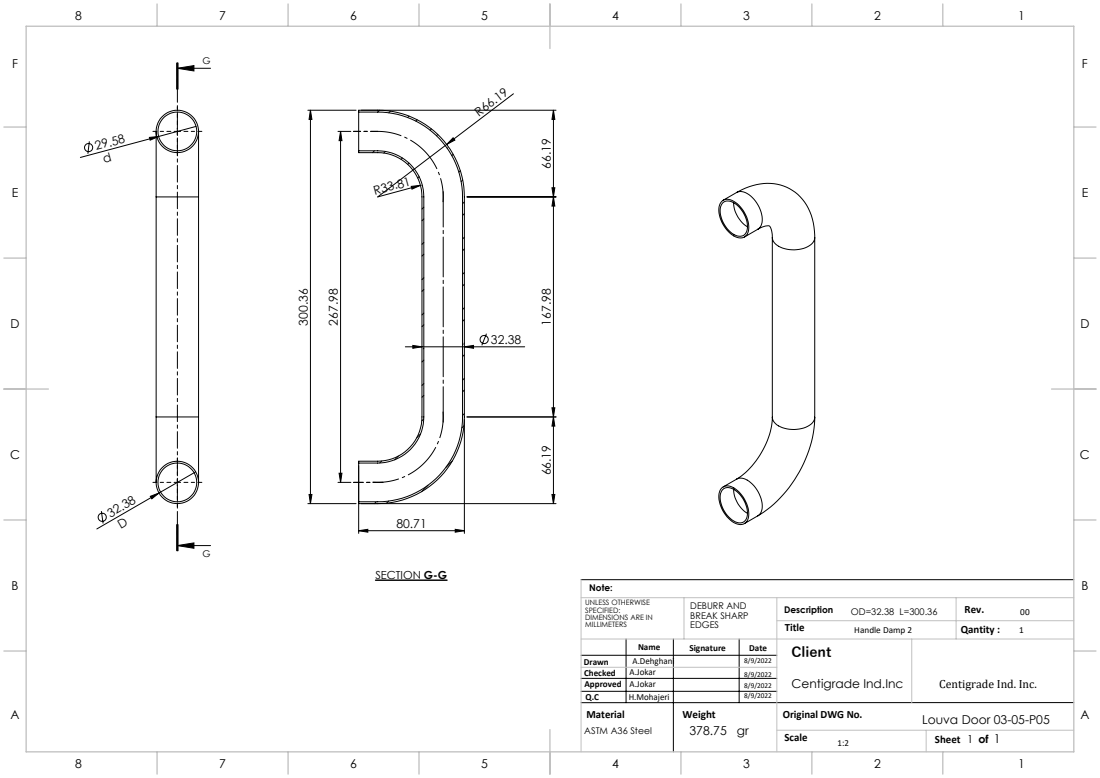
[picture p376: page 1]
SECTION G-G

UNLESS OTHERWISE SPECIFIED: DIMENSIONS ARE IN MILLIMETERS | BREAK SHARP EDGES | Description DEBURR AND OD=32.38 L=300.36 | Rev. 00
Name | Signature | Date | Client
Drawn | A.Dehghani | | 8/9/2022 | Centigrade Ind.Inc | Centigrade Ind. Inc.
Checked | A.Jokar | | 8/9/2022
Approved | A.Jokar | | 8/9/2022
Q.C | H.Mohajeri | | 8/9/2022
Material ASTM A36 Steel | | Weight 378.75 gr | | Original DWG No. Louva Door 03-05-P05
Scale 1:2 | 1 of 1 Sheet

Title Handle Damp 2 | Qantity : 1
