koalium/centidocs/jokar/Louva Door BOM/Handle/Handle cap 03-05-P02.pdf

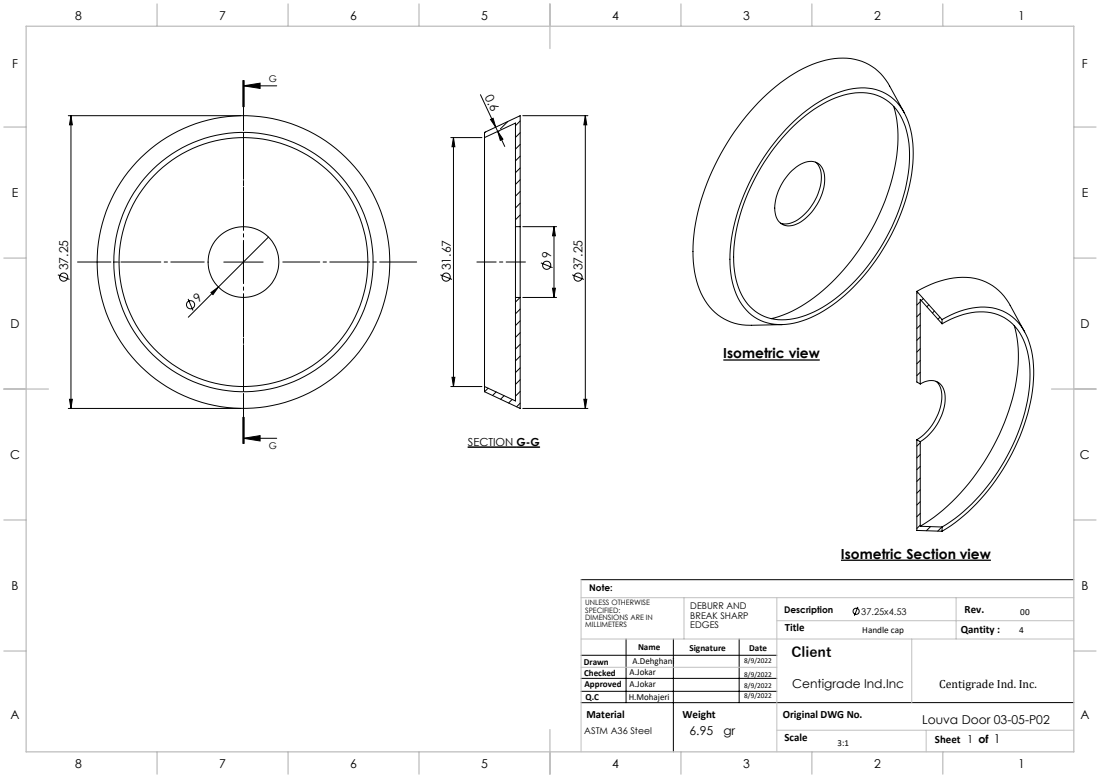
[picture p377: page 1]
SECTION G-G; Isometric view

Isometric Section view

UNLESS OTHERWISE SPECIFIED: DIMENSIONS ARE IN MILLIMETERS | BREAK SHARP EDGES | Description DEBURR AND 37.25x4.53 | Rev. 00
Name | Signature | Date | Client
Drawn | A.Dehghani | | 8/9/2022 | Centigrade Ind.Inc | Centigrade Ind. Inc.
Checked | A.Jokar | | 8/9/2022
Approved | A.Jokar | | 8/9/2022
Q.C | H.Mohajeri | | 8/9/2022
Material ASTM A36 Steel | | Weight 6.95 gr | | Original DWG No. Louva Door 03-05-P02
Scale 3:1 | 1 of 1 Sheet

Title Handle cap | Qantity : 4
