koalium/centidocs/jokar/Louva Door BOM/Handle/Handle2-03-P05.PDF

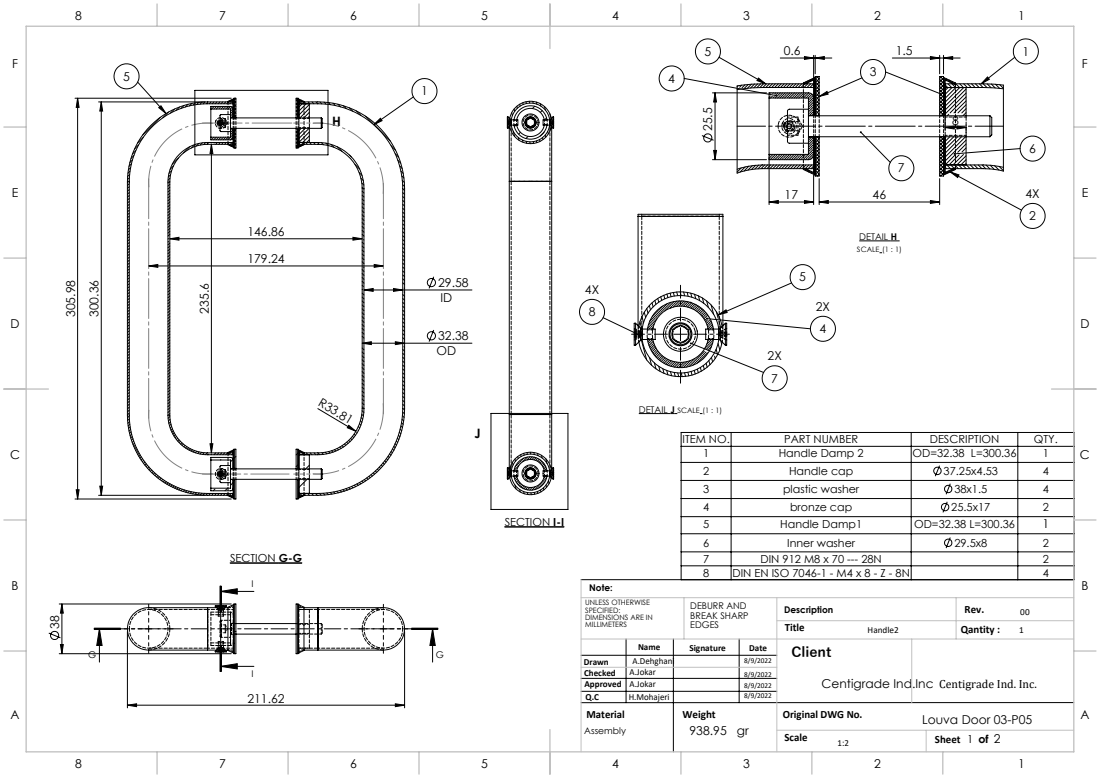
[picture p378: page 1]
SECTION G-G; DETAIL H SCALE (1 : 1); SECTION I-I; DETAIL J SCALE (1 : 1)

ITEM NO. | PART NUMBER | DESCRIPTION | QTY.
1 | Handle Damp 2 | OD=32.38 L=300.36 | 1
2 | Handle cap | 37.25x4.53 | 4
3 | plastic washer | 38x1.5 | 4
4 | bronze cap | 25.5x17 | 2
5 | Handle Damp1 | OD=32.38 L=300.36 | 1
6 | Inner washer | 29.5x8 | 2
7 | DIN 912 M8 x 70 --- 28N | | 2
8 | DIN EN ISO 7046-1 - M4 x 8 - Z - 8N | | 4
Drawn | A.Dehghani | | 8/9/2022 | Centigrade Ind.Inc | Centigrade Ind. Inc.

UNLESS OTHERWISE SPECIFIED: DIMENSIONS ARE IN MILLIMETERS | BREAK SHARP EDGES | Description DEBURR AND | Rev. 00
Name | Signature | Date | Client

Title Handle2 | Qantity : 1

Approved | A.Jokar | | 8/9/2022
Q.C | H.Mohajeri | | 8/9/2022
Material Assembly | Weight 938.95 gr | Original DWG No. Louva Door 03-P05
Scale 1:2 | 1 of 2 Sheet

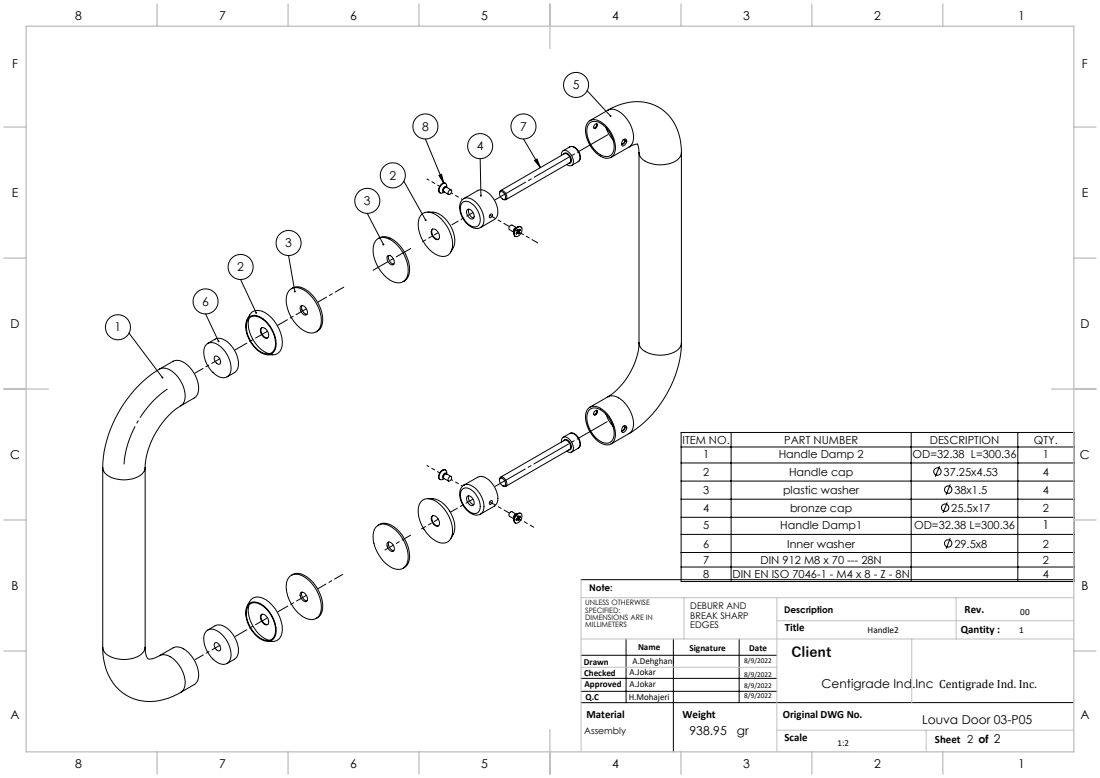
[picture p379: page 2]

ITEM NO. | PART NUMBER | DESCRIPTION | QTY.
1 | Handle Damp 2 | OD=32.38 L=300.36 | 1
2 | Handle cap | 37.25x4.53 | 4
3 | plastic washer | 38x1.5 | 4
4 | bronze cap | 25.5x17 | 2
5 | Handle Damp1 | OD=32.38 L=300.36 | 1
6 | Inner washer | 29.5x8 | 2
7 | DIN 912 M8 x 70 --- 28N | | 2
8 | DIN EN ISO 7046-1 - M4 x 8 - Z - 8N | | 4
Drawn | A.Dehghani | | 8/9/2022 | Centigrade Ind.Inc | Centigrade Ind. Inc.
Checked | A.Jokar | | 8/9/2022
Approved | A.Jokar | | 8/9/2022
Q.C | H.Mohajeri | | 8/9/2022
Material Assembly | | Weight 938.95 gr | | Original DWG No. Louva Door 03-P05
Scale 1:2 | 2 of 2 Sheet

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

Title Handle2 | Qantity : 1
