koalium/centidocs/jokar/Louva Door BOM/Handle/Inner washer 03-05-P06.pdf

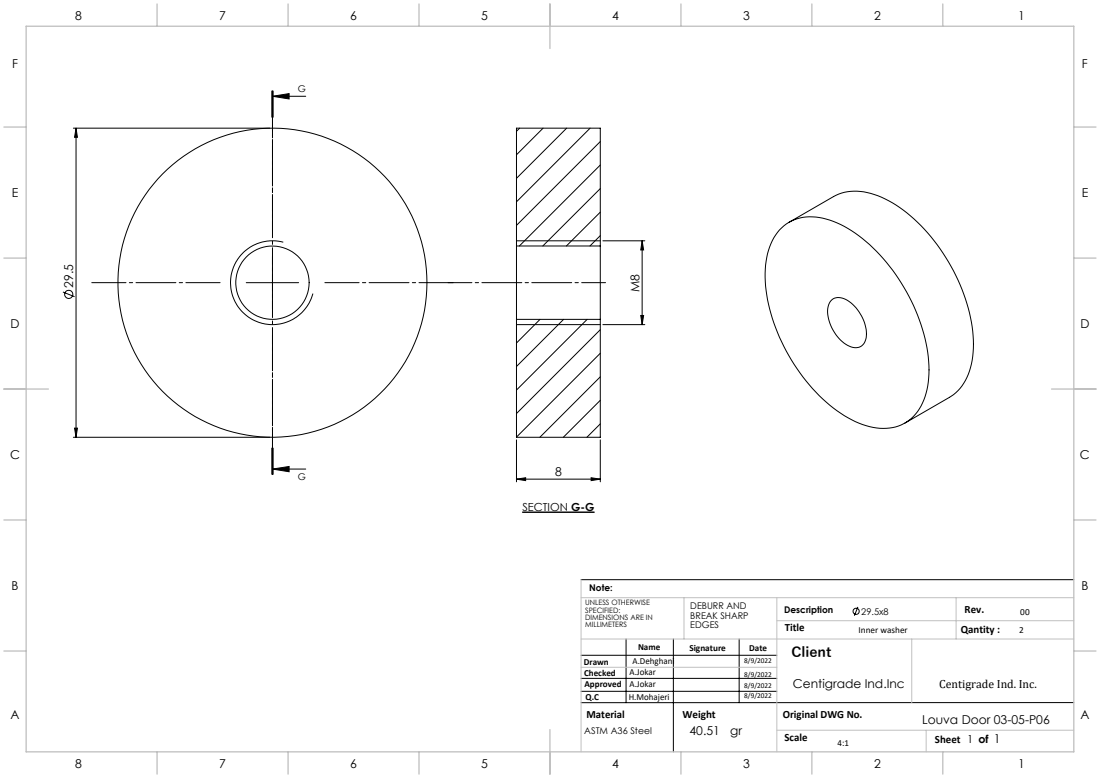
[picture p380: page 1]
SECTION G-G

UNLESS OTHERWISE SPECIFIED: DIMENSIONS ARE IN MILLIMETERS | BREAK SHARP EDGES | Description DEBURR AND 29.5x8 | Rev. 00
Name | Signature | Date | Client
Drawn | A.Dehghani | | 8/9/2022 | Centigrade Ind.Inc | Centigrade Ind. Inc.
Checked | A.Jokar | | 8/9/2022
Approved | A.Jokar | | 8/9/2022
Q.C | H.Mohajeri | | 8/9/2022
Material ASTM A36 Steel | | Weight 40.51 gr | | Original DWG No. Louva Door 03-05-P06
Scale 4:1 | 1 of 1 Sheet

Title Inner washer | Qantity : 2
