koalium/centidocs/jokar/Louva Door BOM/Handle/plastic washer 03-05-P03.pdf

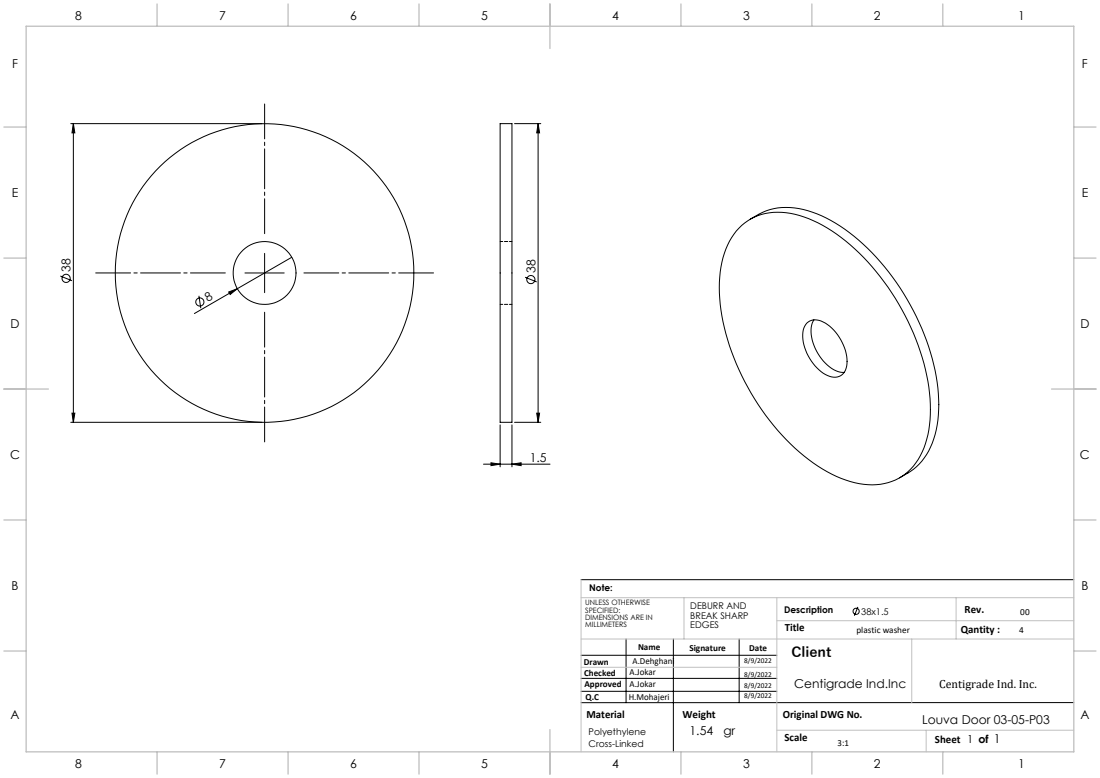
[picture p381: page 1]

UNLESS OTHERWISE SPECIFIED: DIMENSIONS ARE IN MILLIMETERS | BREAK SHARP EDGES | Description DEBURR AND 38x1.5 | Rev. 00
Name | Signature | Date | Client
Drawn | A.Dehghani | | 8/9/2022 | Centigrade Ind.Inc | Centigrade Ind. Inc.
Checked | A.Jokar | | 8/9/2022
Approved | A.Jokar | | 8/9/2022
Q.C | H.Mohajeri | | 8/9/2022
Material Polyethylene Cross-Linked | | Weight 1.54 gr | | Original DWG No. Louva Door 03-05-P03

Title plastic washer | Qantity : 4

Scale 3:1 | 1 of 1 Sheet
