koalium/centidocs/jokar/Louva Door BOM/Lock/Conical bush 03-06-P07.pdf

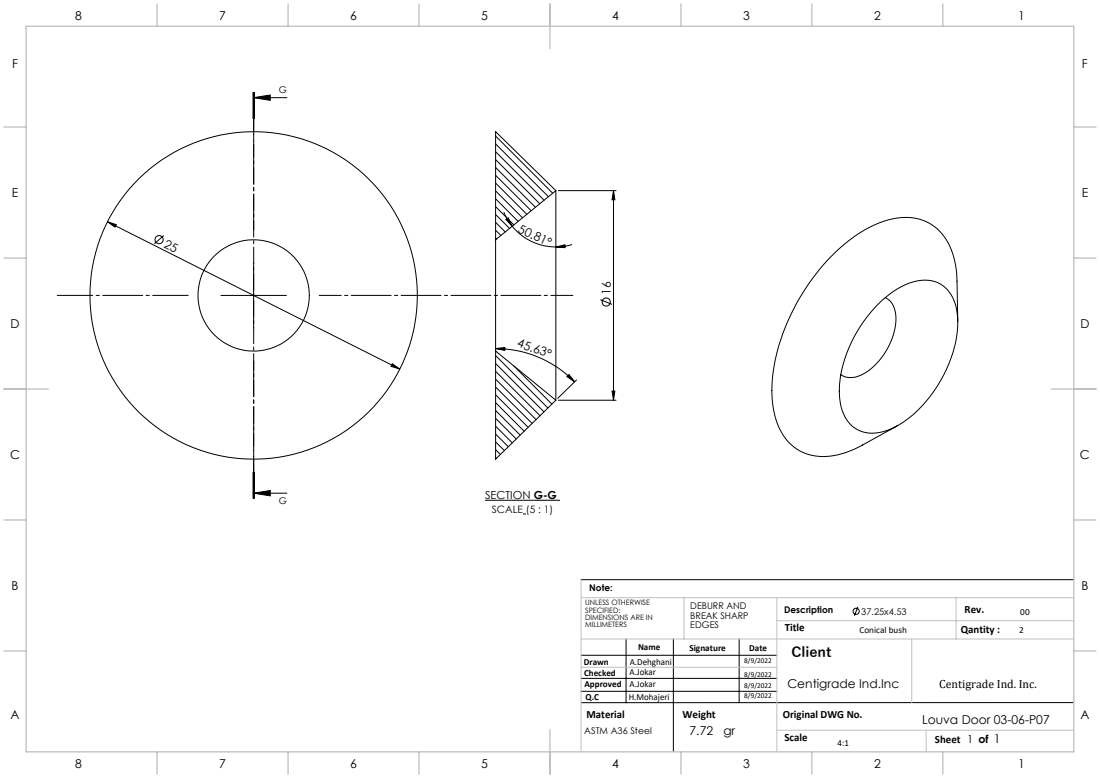
[picture p382: page 1]
SECTION G-G SCALE (5 : 1)

UNLESS OTHERWISE SPECIFIED: DIMENSIONS ARE IN MILLIMETERS | BREAK SHARP EDGES | Description DEBURR AND 37.25x4.53 | Rev. 00
Name | Signature | Date | Client
Drawn | A.Dehghani | | 8/9/2022 | Centigrade Ind.Inc | Centigrade Ind. Inc.
Checked | A.Jokar | | 8/9/2022
Approved | A.Jokar | | 8/9/2022
Q.C | H.Mohajeri | | 8/9/2022
Material ASTM A36 Steel | | Weight 7.72 gr | | Original DWG No. Louva Door 03-06-P07
Scale 4:1 | 1 of 1 Sheet

Title Conical bush | Qantity : 2
