koalium/centidocs/jokar/Louva Door BOM/Lock/Handle cover 03-06-P08.pdf

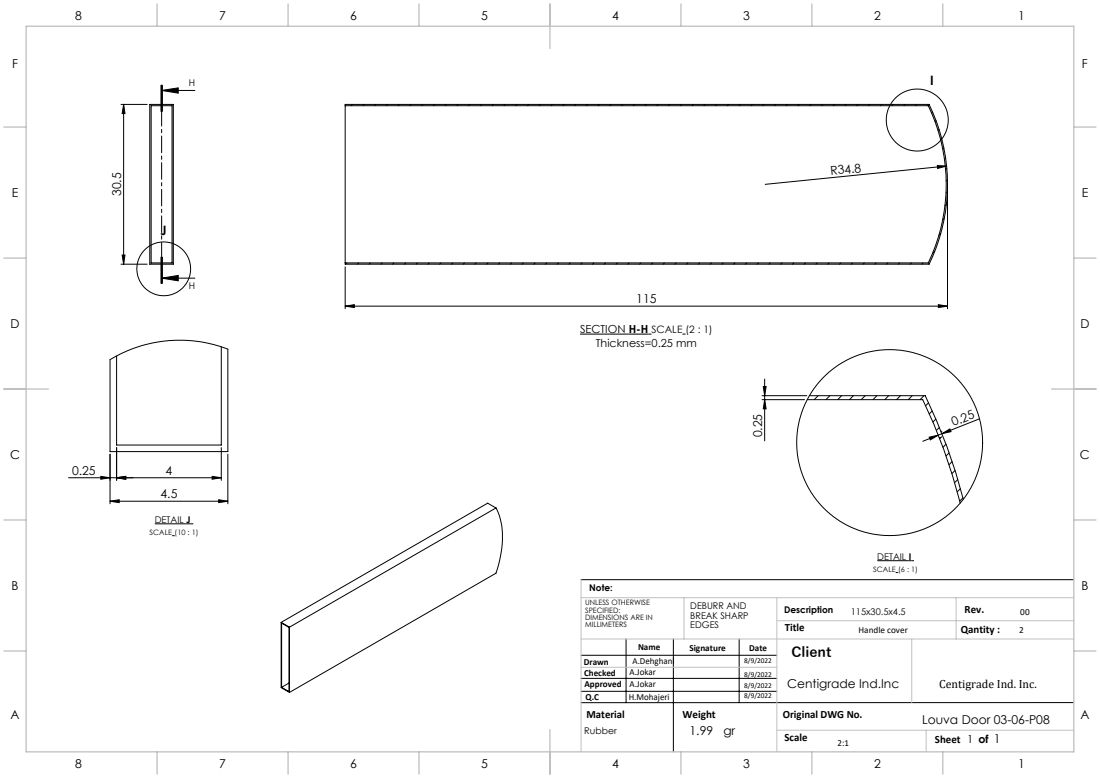
[picture p383: page 1]
SECTION H-H SCALE (2 : 1) Thickness=0.25 mm; DETAIL I SCALE (6 : 1); DETAIL J SCALE (10 : 1)

UNLESS OTHERWISE SPECIFIED: DIMENSIONS ARE IN MILLIMETERS | BREAK SHARP EDGES | Description DEBURR AND 115x30.5x4.5 | Rev. 00
Name | Signature | Date | Client
Drawn | A.Dehghani | | 8/9/2022 | Centigrade Ind.Inc | Centigrade Ind. Inc.
Checked | A.Jokar | | 8/9/2022
Approved | A.Jokar | | 8/9/2022
Q.C | H.Mohajeri | | 8/9/2022
Material Rubber | | Weight 1.99 gr | | Original DWG No. Louva Door 03-06-P08
Scale 2:1 | 1 of 1 Sheet

Title Handle cover | Qantity : 2
