koalium/centidocs/jokar/Louva Door BOM/Lock/Little short bush 03-06-P02.pdf

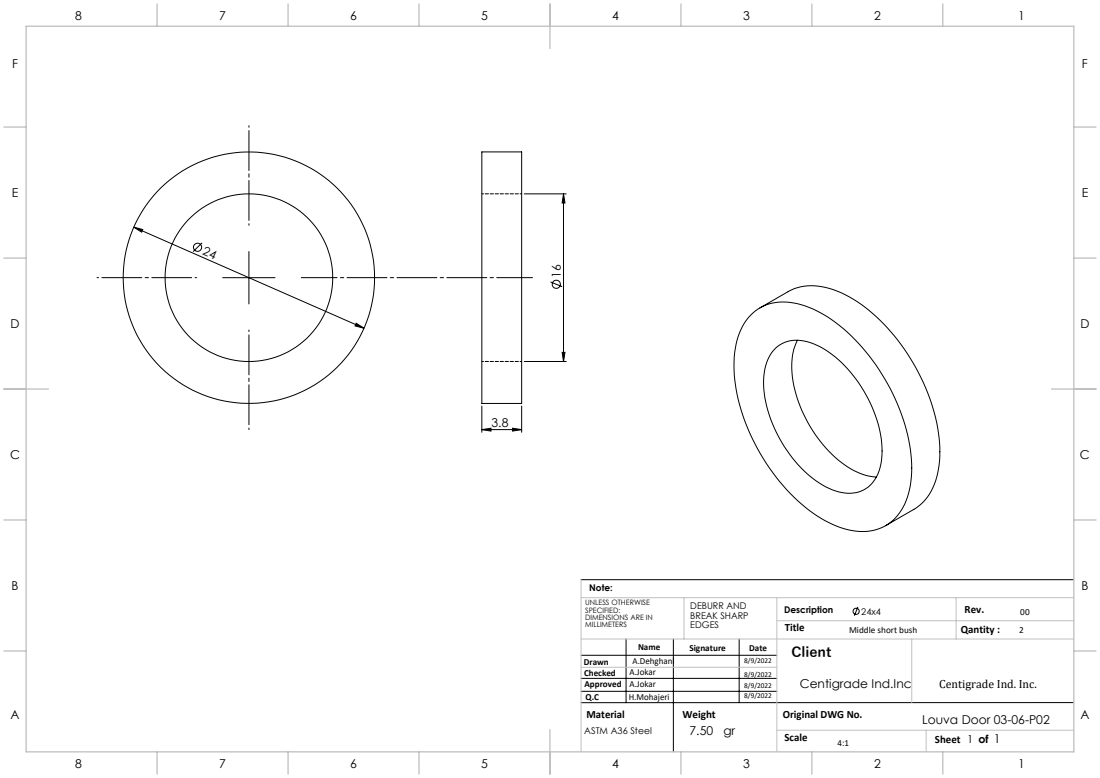
[picture p385: page 1]

UNLESS OTHERWISE SPECIFIED: DIMENSIONS ARE IN MILLIMETERS | BREAK SHARP EDGES | Description DEBURR AND 24x4 | Rev. 00
Name | Signature | Date | Client
Drawn | A.Dehghani | | 8/9/2022 | Centigrade Ind.Inc | Centigrade Ind. Inc.
Checked | A.Jokar | | 8/9/2022
Approved | A.Jokar | | 8/9/2022
Q.C | H.Mohajeri | | 8/9/2022
Material ASTM A36 Steel | | Weight 7.50 gr | | Original DWG No. Louva Door 03-06-P02
Scale 4:1 | 1 of 1 Sheet

Title Middle short bush | Qantity : 2
