koalium/centidocs/jokar/Louva Door BOM/Lock/Lock mechanism 03-P05.PDF

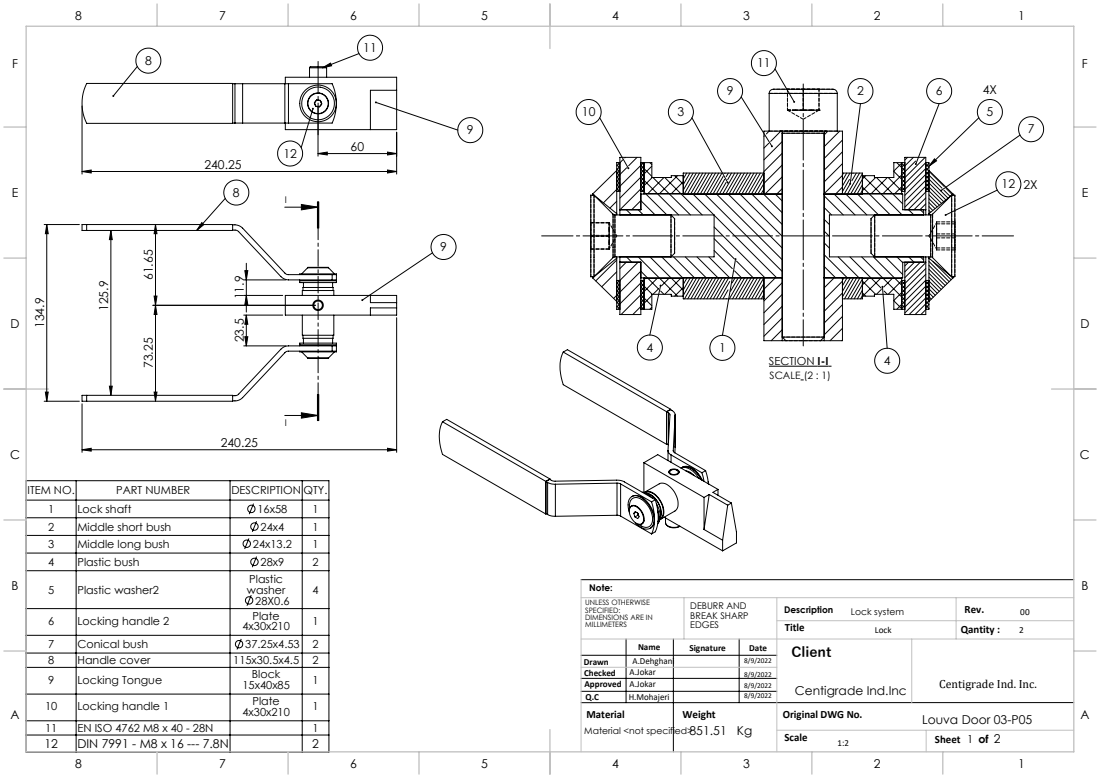
[picture p386: page 1]
SECTION I-I SCALE (2 : 1); Handle cover; Locking Tongue; Block

ITEM NO. | PART NUMBER | DESCRIPTION QTY.
1 | Lock shaft | 16x58 | 1
2 | Middle short bush | 24x4 | 1
3 | Middle long bush | 24x13.2 | 1
4 | Plastic bush | 28x9 | 2
5 | Plastic washer2 | Plastic washer 28X0.6 | 4

UNLESS OTHERWISE SPECIFIED: DIMENSIONS ARE IN MILLIMETERS | BREAK SHARP EDGES | Description DEBURR AND Lock system | Rev. 00
Name | Signature | Date | Client

6 | Locking handle 2 | Plate 4x30x210 | 1
7 | Conical bush | 37.25x4.53 | 2

Title Lock | Qantity : 2

Centigrade Ind. Inc.

Approved | A.Jokar | | 8/9/2022
Q.C | H.Mohajeri | | 8/9/2022
Material Material <not specified>851.51 Kg | Weight | Original DWG No. Louva Door 03-P05
Scale 1:2 | 1 of 2 Sheet

Centigrade Ind.Inc

10 | Locking handle 1 | Plate 4x30x210 | 1
11 | EN ISO 4762 M8 x 40 - 28N | | 1
12 | DIN 7991 - M8 x 16 --- 7.8N | | 2

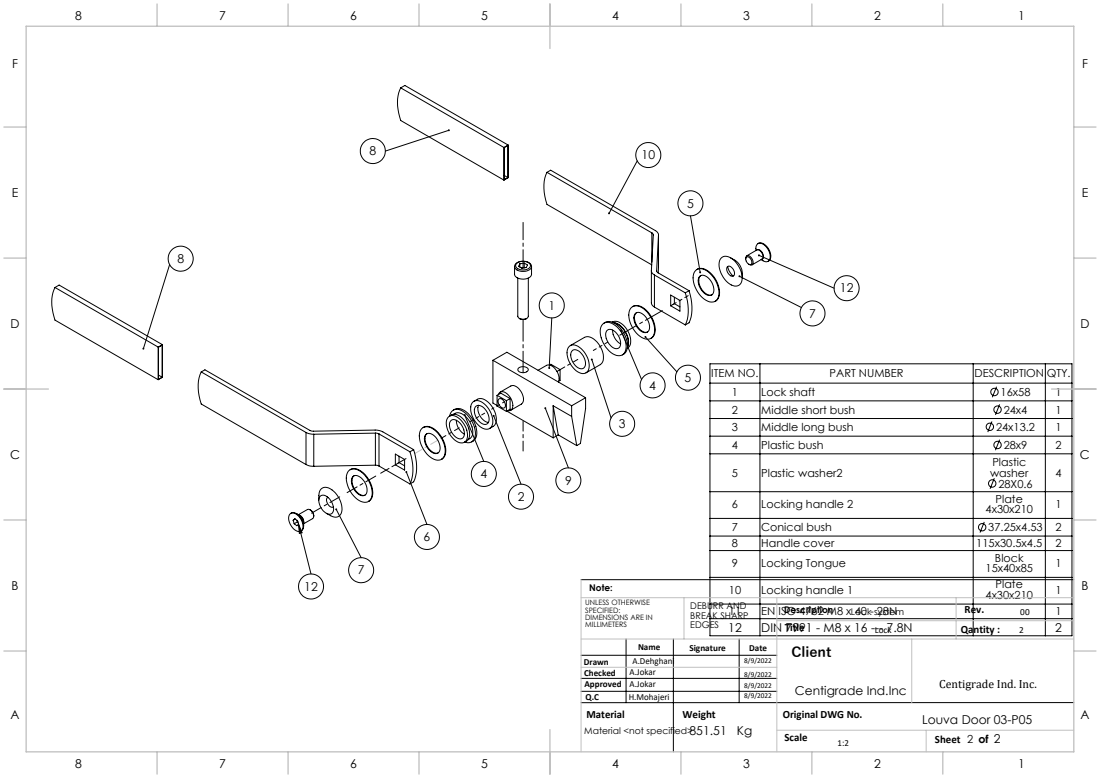
[picture p387: page 2]
EN ISO 4762 M8 x 40 - 28N; DIN 7991 - M8 x 16 --- 7.8N; BREAK SHARP; Qantity :; Lock system

ITEM NO. | Plastic bush Lock shaft Middle short bush Plastic washer2 Middle long bush PART NUMBER | DESCRIPTION QTY. 1 24x13.2 16x58 24x4 28x9 | 1 4 1 2 1 3 2 5

Plastic washer 28X0.6 | 4

6 | Locking handle 2 | Plate 4x30x210 | 1
7 | Conical bush | 37.25x4.53 | 2
8 | Handle cover | 115x30.5x4.5 | 2
9 | Locking Tongue | Block 15x40x85 | 1
Drawn | A.Dehghani | | 8/9/2022 | Centigrade Ind.Inc | Centigrade Ind. Inc.
Checked | A.Jokar | | 8/9/2022
Approved | A.Jokar | | 8/9/2022
Q.C | H.Mohajeri | | 8/9/2022
Material Material <not specified>851.51 Kg | | Weight | | Original DWG No. Louva Door 03-P05

Note: | 10 | Locking handle 1 | Plate 4x30x210 | 1

UNLESS OTHERWISE SPECIFIED: DIMENSIONS ARE IN MILLIMETERS
Name | Signature | Date | Client

Description DEBURR AND

Scale 1:2 | 2 of 2 Sheet
