koalium/centidocs/jokar/Louva Door BOM/Lock/Lock Shaft 03-06-P01.pdf

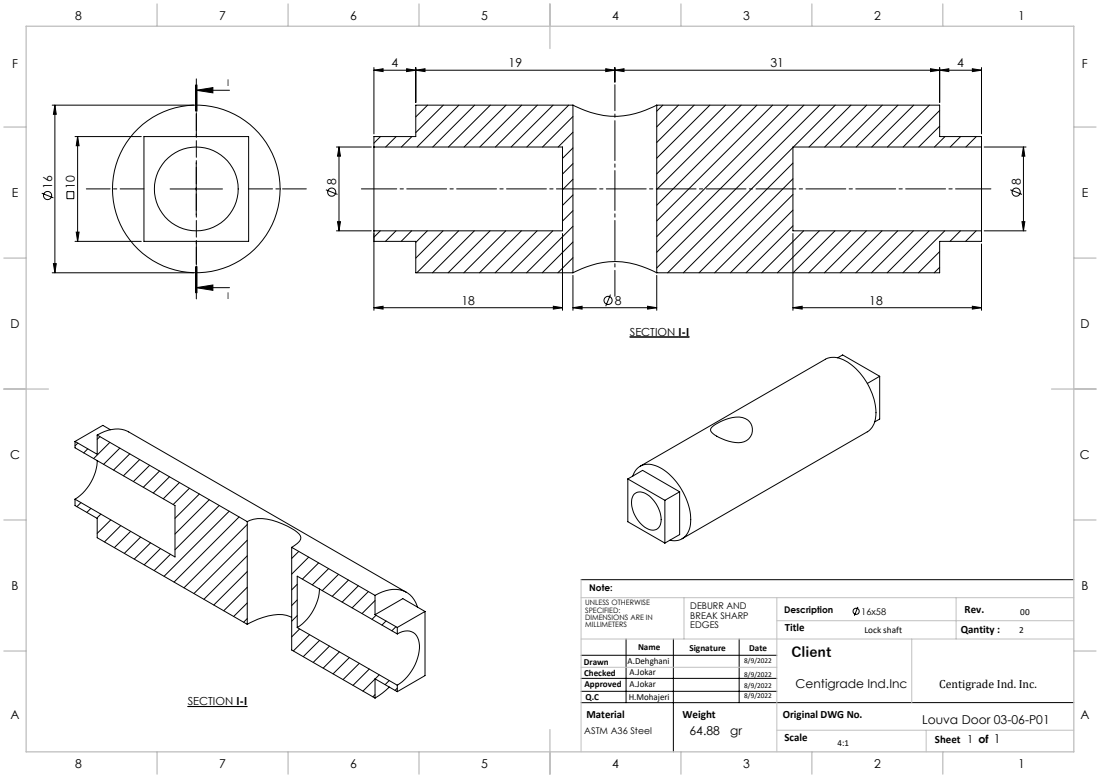
[picture p390: page 1]
SECTION I-I; Original DWG No.; ASTM A36 Steel; Louva Door 03-06-P01

Note:
UNLESS OTHERWISE SPECIFIED: DIMENSIONS ARE IN MILLIMETERS | | BREAK SHARP EDGES | Description DEBURR AND 16x58 | Rev. 00
Name | | Signature | Date | Client
Drawn | A.Dehghani | | | 8/9/2022 | Centigrade Ind.Inc | Centigrade Ind. Inc.
Checked | A.Jokar | | | 8/9/2022
Approved | A.Jokar | | | 8/9/2022
Q.C | H.Mohajeri | | | 8/9/2022

Title Lock shaft | Qantity : 2
