koalium/centidocs/jokar/Louva Door BOM/Lock/Lock tongue 03-06-P09.pdf

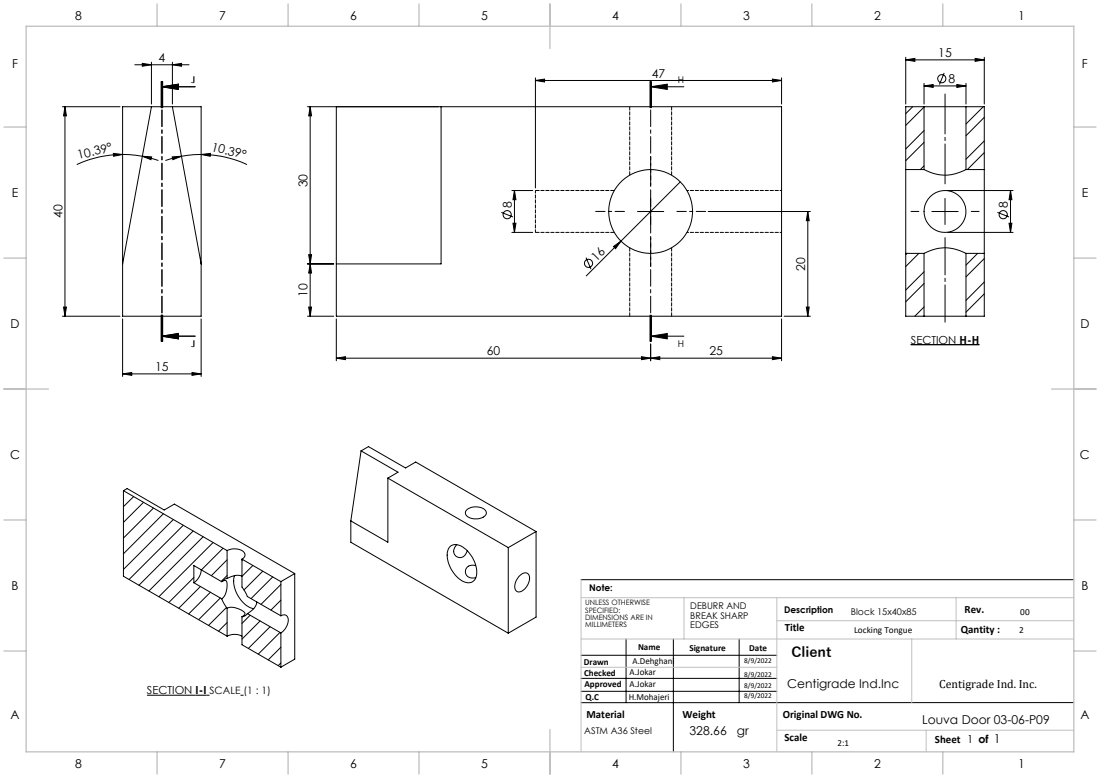
[picture p391: page 1]
SECTION H-H; SECTION I-I SCALE (1 : 1)

UNLESS OTHERWISE SPECIFIED: DIMENSIONS ARE IN MILLIMETERS | BREAK SHARP EDGES | Description DEBURR AND Block 15x40x85 | Rev. 00
Name | Signature | Date | Client
Drawn | A.Dehghani | | 8/9/2022 | Centigrade Ind.Inc | Centigrade Ind. Inc.
Checked | A.Jokar | | 8/9/2022
Approved | A.Jokar | | 8/9/2022
Q.C | H.Mohajeri | | 8/9/2022
Material ASTM A36 Steel | | Weight 328.66 gr | | Original DWG No. Louva Door 03-06-P09
Scale 2:1 | 1 of 1 Sheet

Title Locking Tongue | Qantity : 2
