koalium/centidocs/jokar/Louva Door BOM/Lock/Lockinh Handle 03-06-P06.PDF

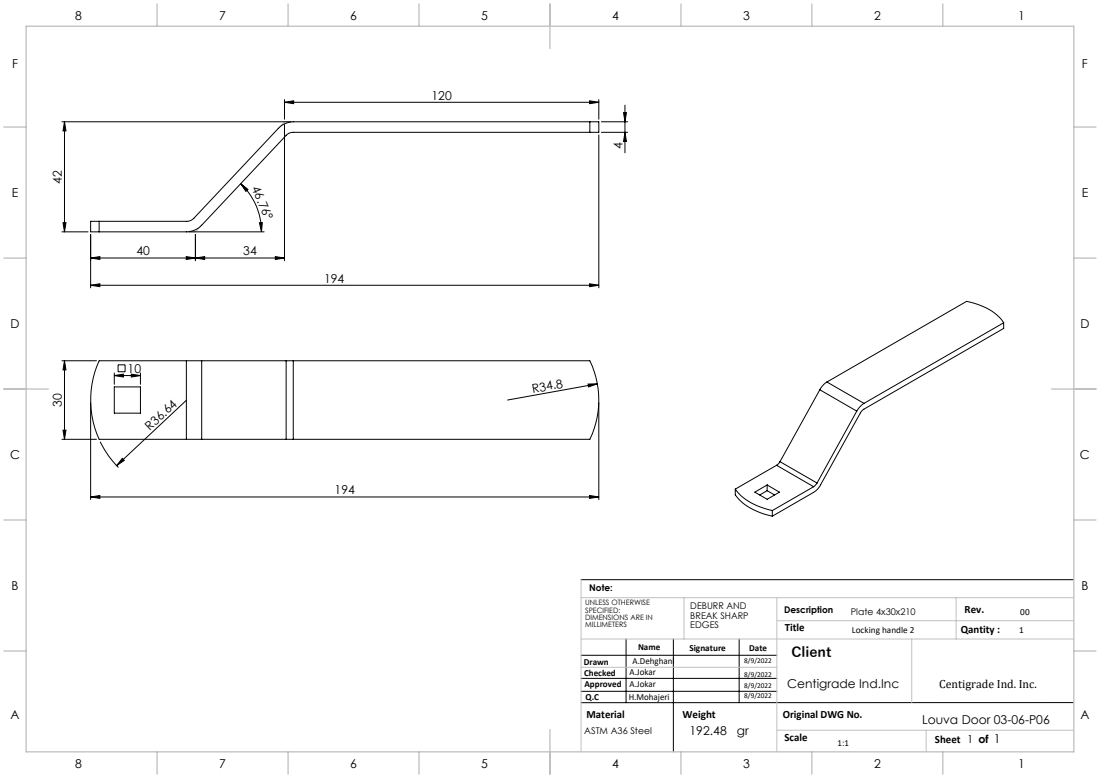
[picture p392: page 1]

UNLESS OTHERWISE SPECIFIED: DIMENSIONS ARE IN MILLIMETERS | BREAK SHARP EDGES | Description DEBURR AND Plate 4x30x210 | Rev. 00
Name | Signature | Date | Client
Drawn | A.Dehghani | | 8/9/2022 | Centigrade Ind.Inc | Centigrade Ind. Inc.
Checked | A.Jokar | | 8/9/2022
Approved | A.Jokar | | 8/9/2022
Q.C | H.Mohajeri | | 8/9/2022
Material ASTM A36 Steel | | Weight 192.48 gr | | Original DWG No. Louva Door 03-06-P06
Scale 1:1 | 1 of 1 Sheet

Title Locking handle 2 | Qantity : 1
