koalium/centidocs/jokar/Louva Door BOM/Lock/Plain washer 03-06-P05.pdf

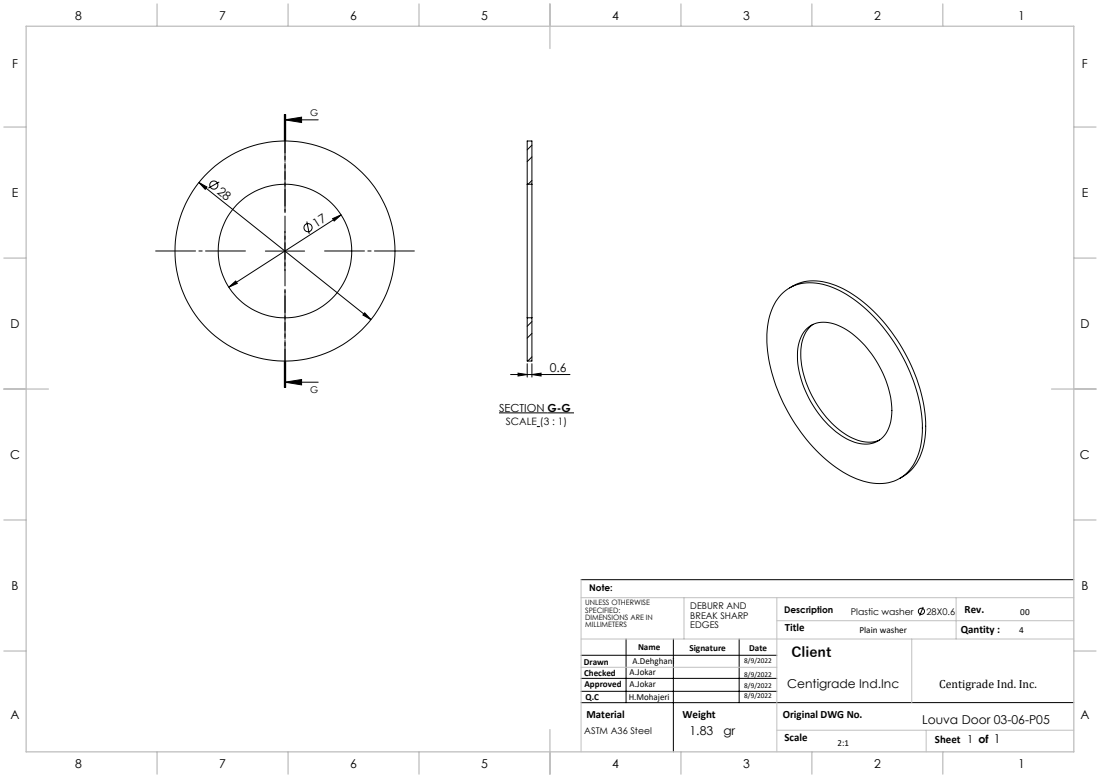
[picture p393: page 1]
SECTION G-G SCALE (3 : 1)

UNLESS OTHERWISE SPECIFIED: DIMENSIONS ARE IN MILLIMETERS | BREAK SHARP EDGES | Description DEBURR AND Plastic washer 28X0.6 | Rev. 00
Name | Signature | Date | Client
Drawn | A.Dehghani | | 8/9/2022 | Centigrade Ind.Inc | Centigrade Ind. Inc.
Checked | A.Jokar | | 8/9/2022
Approved | A.Jokar | | 8/9/2022
Q.C | H.Mohajeri | | 8/9/2022
Material ASTM A36 Steel | | Weight 1.83 gr | | Original DWG No. Louva Door 03-06-P05
Scale 2:1 | 1 of 1 Sheet

Title Plain washer | Qantity : 4
