koalium/centidocs/jokar/Louva Door BOM/Lock/Plastic bush 03-06-P04.pdf

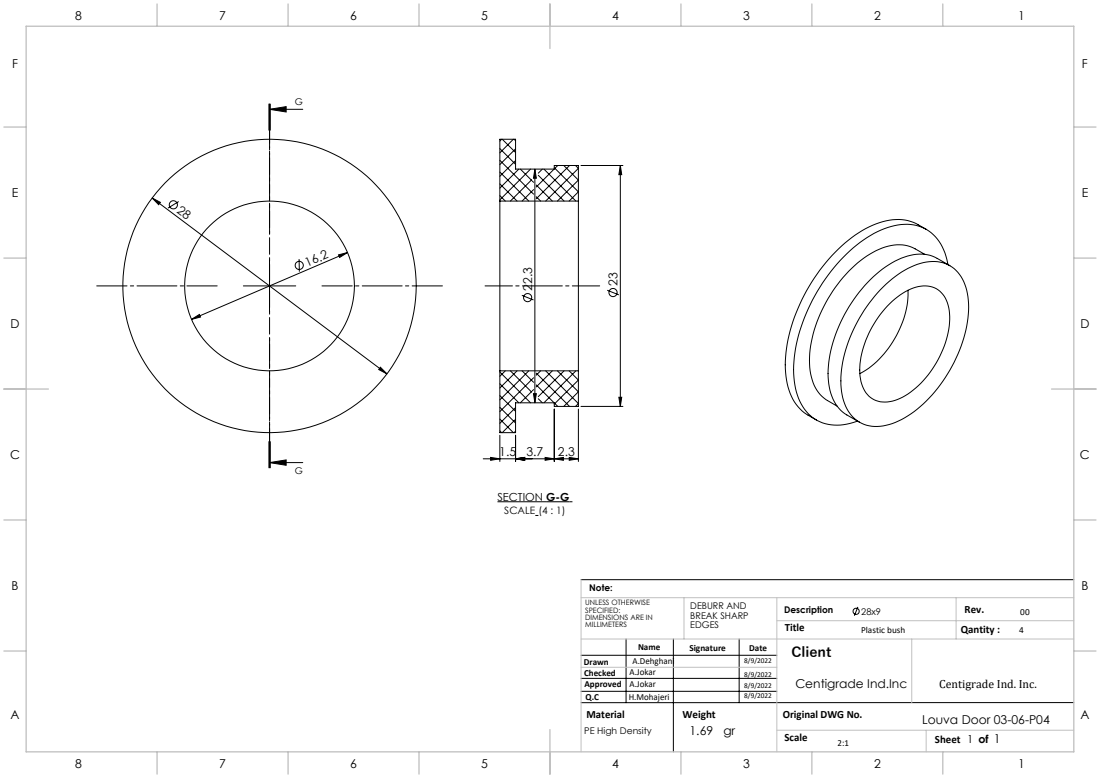
[picture p394: page 1]
SECTION G-G SCALE (4 : 1)

UNLESS OTHERWISE SPECIFIED: DIMENSIONS ARE IN MILLIMETERS | BREAK SHARP EDGES | Description DEBURR AND 28x9 | Rev. 00
Name | Signature | Date | Client
Drawn | A.Dehghani | | 8/9/2022 | Centigrade Ind.Inc | Centigrade Ind. Inc.
Checked | A.Jokar | | 8/9/2022
Approved | A.Jokar | | 8/9/2022
Q.C | H.Mohajeri | | 8/9/2022
Material PE High Density | | Weight 1.69 gr | | Original DWG No. Louva Door 03-06-P04
Scale 2:1 | 1 of 1 Sheet

Title Plastic bush | Qantity : 4
