koalium/centidocs/jokar/Screw compactor Final/Screw compactor Size as built/Shaft holder assembly.pdf

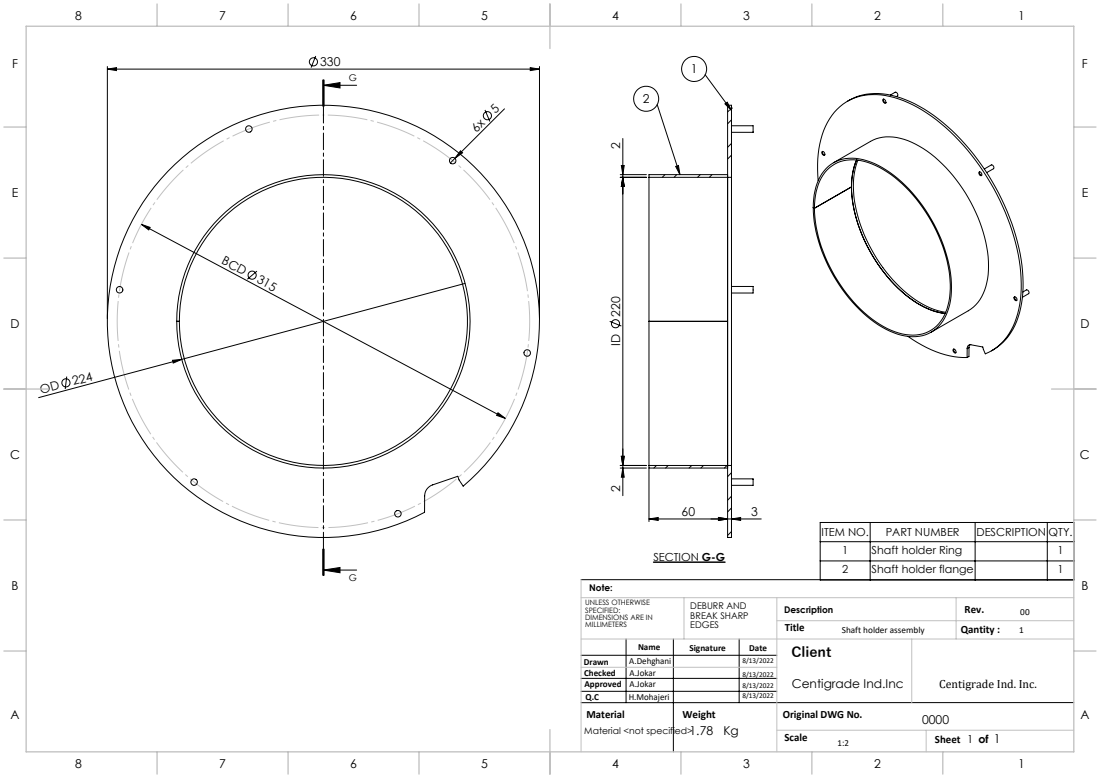
[picture p395: page 1]
BCD 315; SECTION G-G

ITEM NO. | PART NUMBER | DESCRIPTION QTY.
1 | Shaft holder Ring | | 1
2 | Shaft holder flange | | 1

UNLESS OTHERWISE SPECIFIED: DIMENSIONS ARE IN MILLIMETERS | BREAK SHARP EDGES | Description DEBURR AND | Rev. 00
Name | Signature | Date | Client
Drawn | A.Dehghani | | 8/13/2022 | Centigrade Ind.Inc | Centigrade Ind. Inc.
Checked | A.Jokar | | 8/13/2022
Approved | A.Jokar | | 8/13/2022
Q.C | H.Mohajeri | | 8/13/2022
Material Material <not specified>1.78 Kg | | Weight | | Original DWG No. 0000
Scale 1:2 | 1 of 1 Sheet

Title Shaft holder assembly | Qantity : 1
