koalium/centidocs/mohajeri/8125006-Amirkabir/Damper 750/Main Assembly.PDF

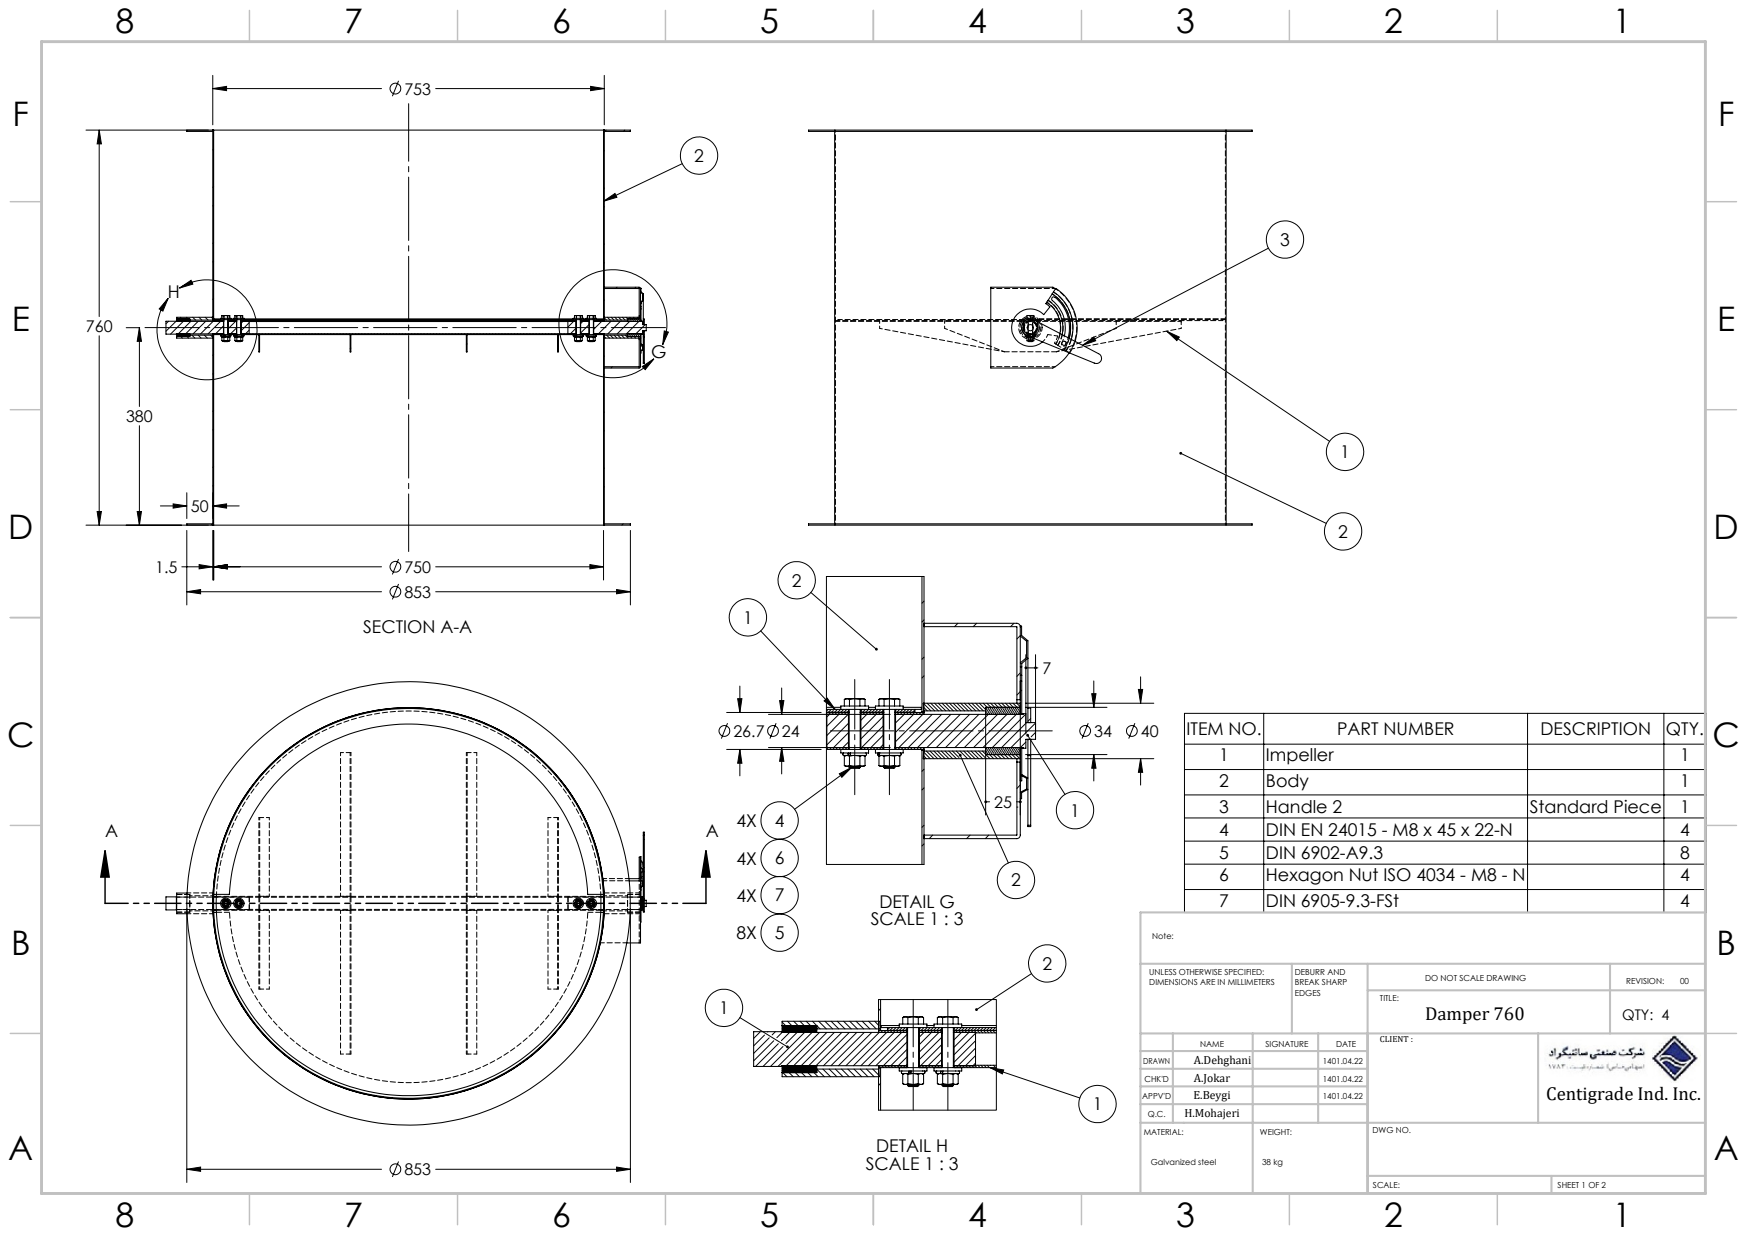
[picture p396: page 1]
SECTION A-A; DETAIL G SCALE 1 : 3; DETAIL H SCALE 1 : 3; DO NOT SCALE DRAWING; REVISION:; Damper 760; QTY: 4; CLIENT :

ITEM NO. | PART NUMBER | DESCRIPTION | QTY.
1 | Impeller | | 1
2 | Body | | 1
3 | Handle 2 | Standard Piece | 1
4 | DIN EN 24015 - M8 x 45 x 22-N | | 4
5 | DIN 6902-A9.3 | | 8
6 | Hexagon Nut ISO 4034 - M8 - N | | 4
7 | DIN 6905-9.3-FSt | | 4

UNLESS OTHERWISE SPECIFIED:
DIMENSIONS ARE IN MILLIMETERS

DEBURR AND
BREAK SHARP
EDGES
Centigrade Ind. Inc.

DRAWN | A.Jokar | 1401.04.22
CHK'D | E.Beygi | 1401.04.22

APPV'D | | 1401.04.22

MATERIAL: Galvanized steel | WEIGHT: 38 kg | DWG NO.

SCALE: | SHEET 1 OF 2

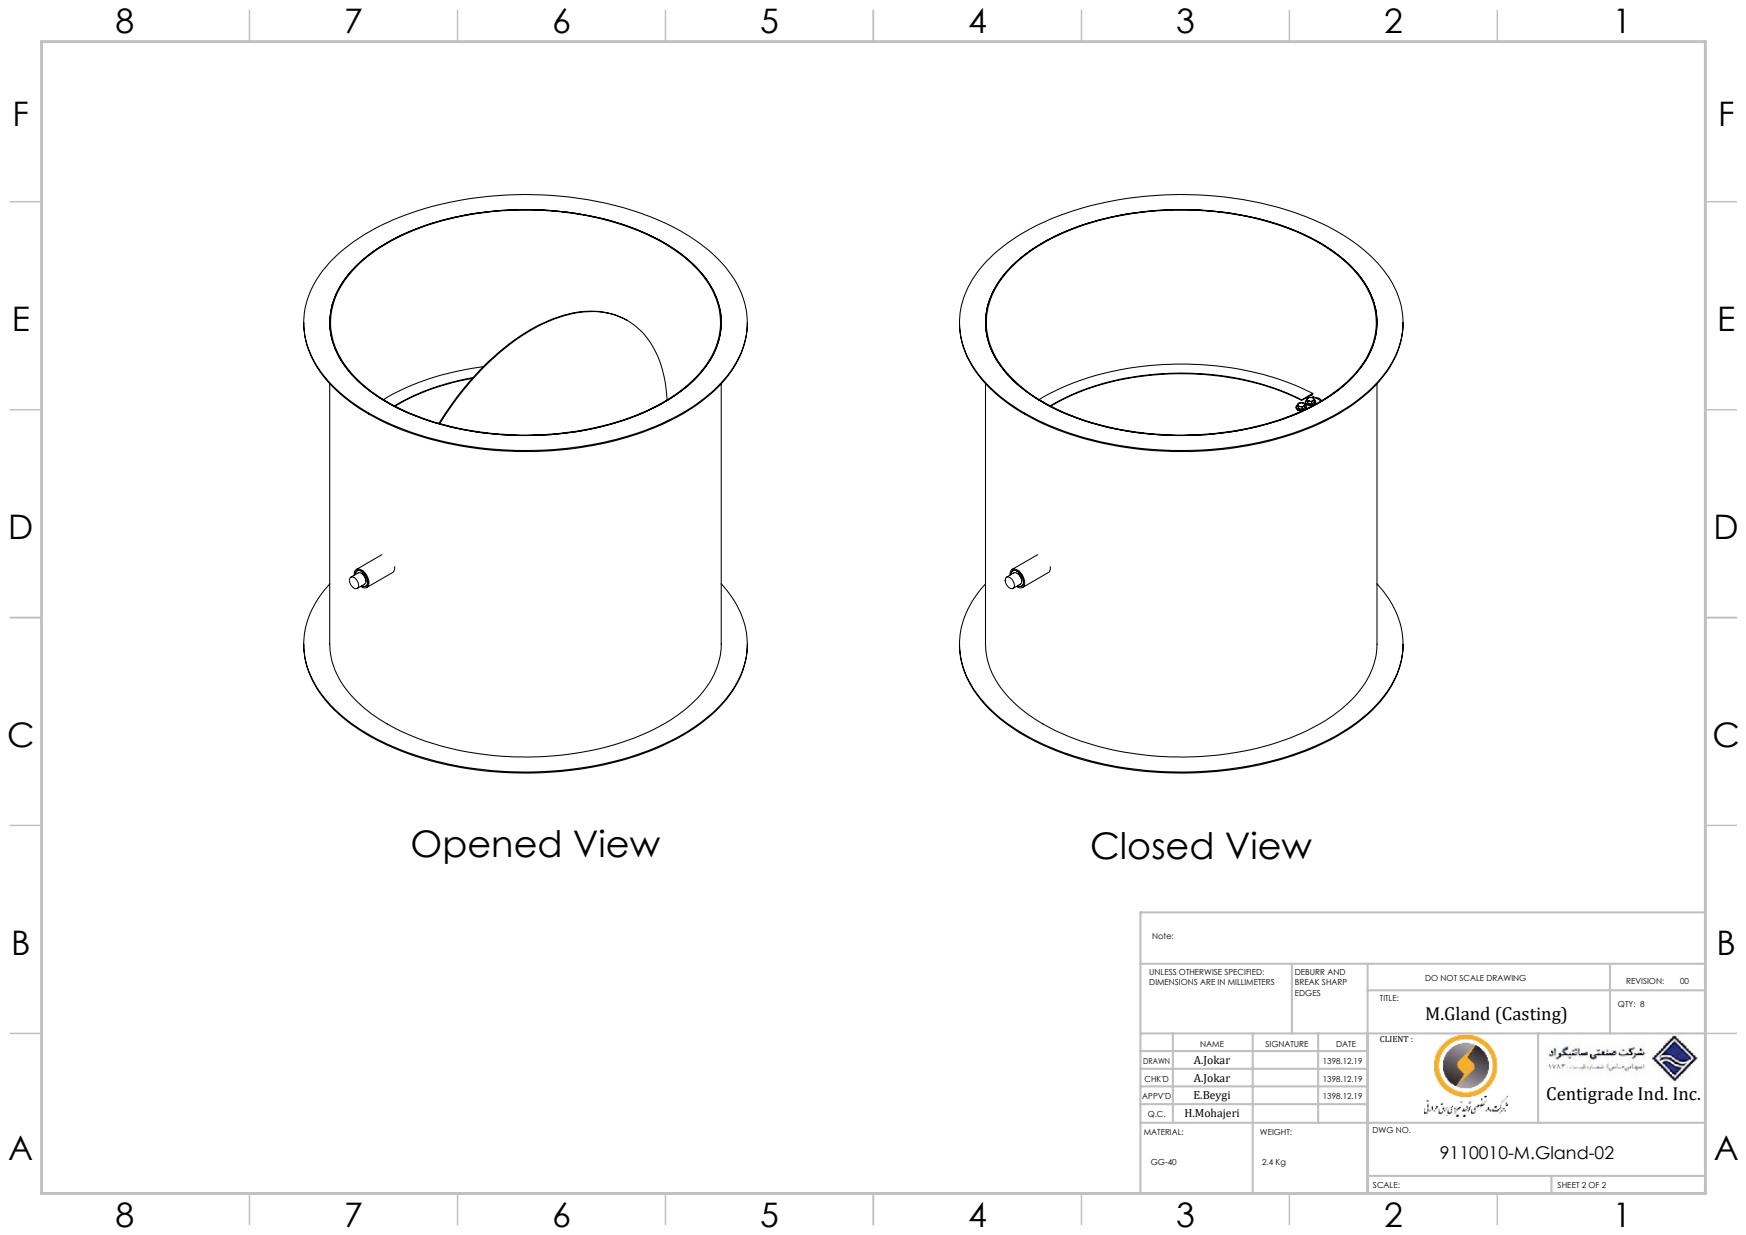
[picture p397: page 2]
Opened View; Closed View; DO NOT SCALE DRAWING; REVISION:; M.Gland (Casting); QTY: 8; CLIENT :

UNLESS OTHERWISE SPECIFIED:
DIMENSIONS ARE IN MILLIMETERS

DEBURR AND
BREAK SHARP
EDGES
Centigrade Ind. Inc.

DRAWN | A.Jokar | 1398.12.19
CHK'D | E.Beygi | 1398.12.19

APPV'D | | 1398.12.19

MATERIAL: GG-40 | WEIGHT: 2.4 Kg | DWG NO. 9110010-M.Gland-02

SCALE: | SHEET 2 OF 2
