koalium/centidocs/elec/plc/Wiring diagram/10385&146008/SAVIN Carpet AC-1&2.pdf

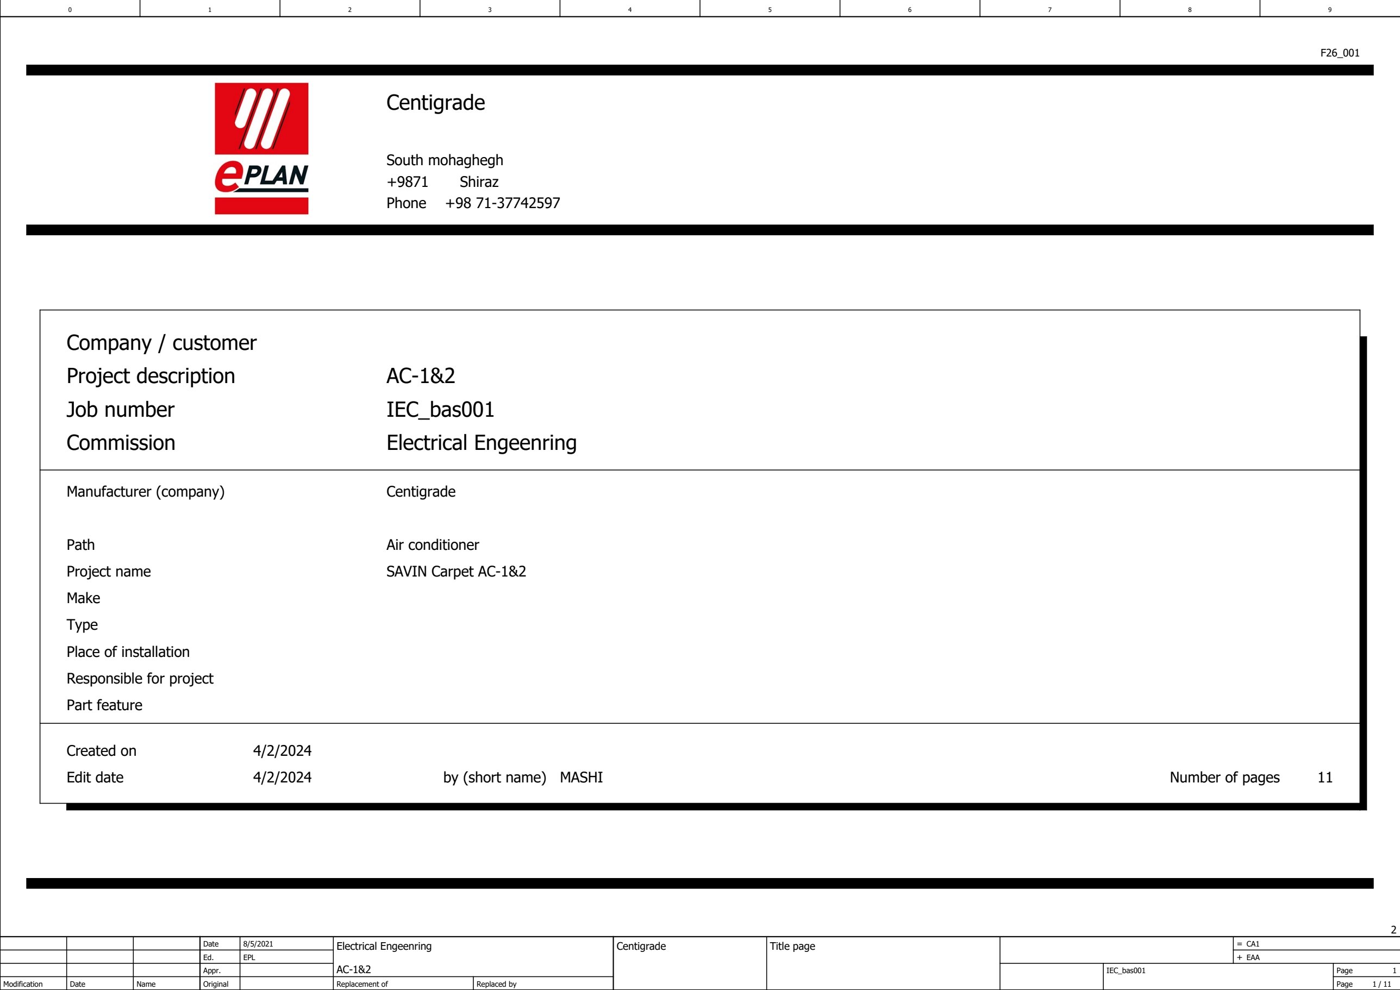
[picture p398: figure]
Page; Original; IEC_bas001; Electrical Engeenring; EPL; Date; Replaced by; EAA; Title page; Modification; Appr.; Replacement of; Centigrade; Name; Project description; Number of pages; Commission; Edit date; Created on; Job number; Air conditioner; Make; MASHI; Part feature; South mohaghegh; Path; Manufacturer (company); Project name; SAVIN Carpet AC-1&2; Responsible for project; Phone; Type; Company / customer; Place of installation; by (short name); Shiraz

F1

## MCCB

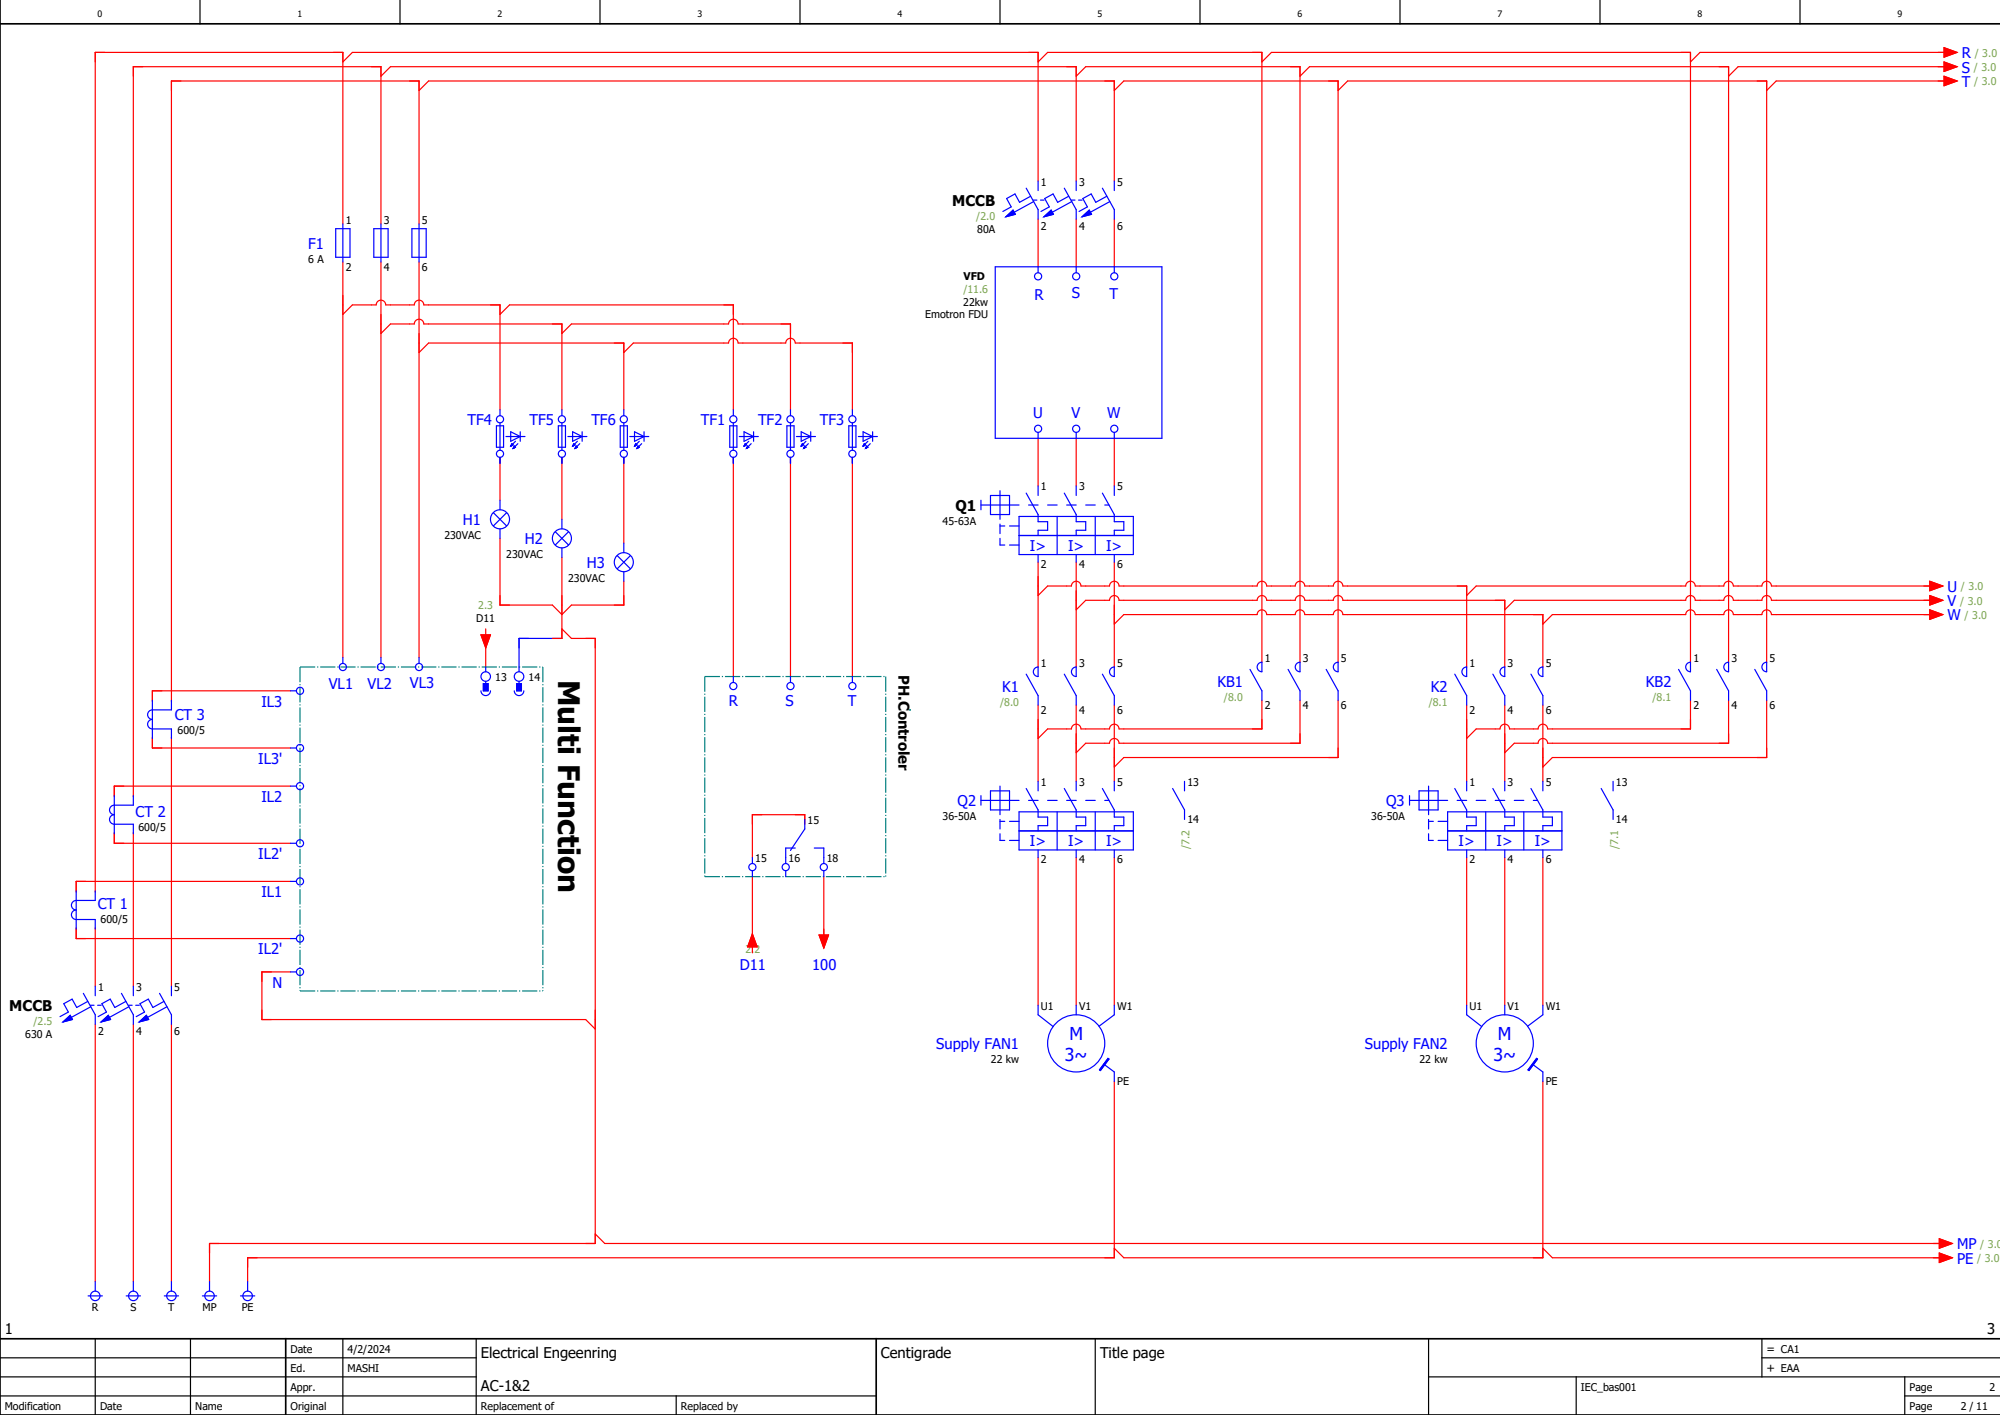
[picture p399: page 2]
MASHI; Centigrade; MCCB; Multi Function; PH.Controler; 230VAC; VFD /11.6 22kw Emotron FDU; Supply FAN1; Supply FAN2

S /

R /

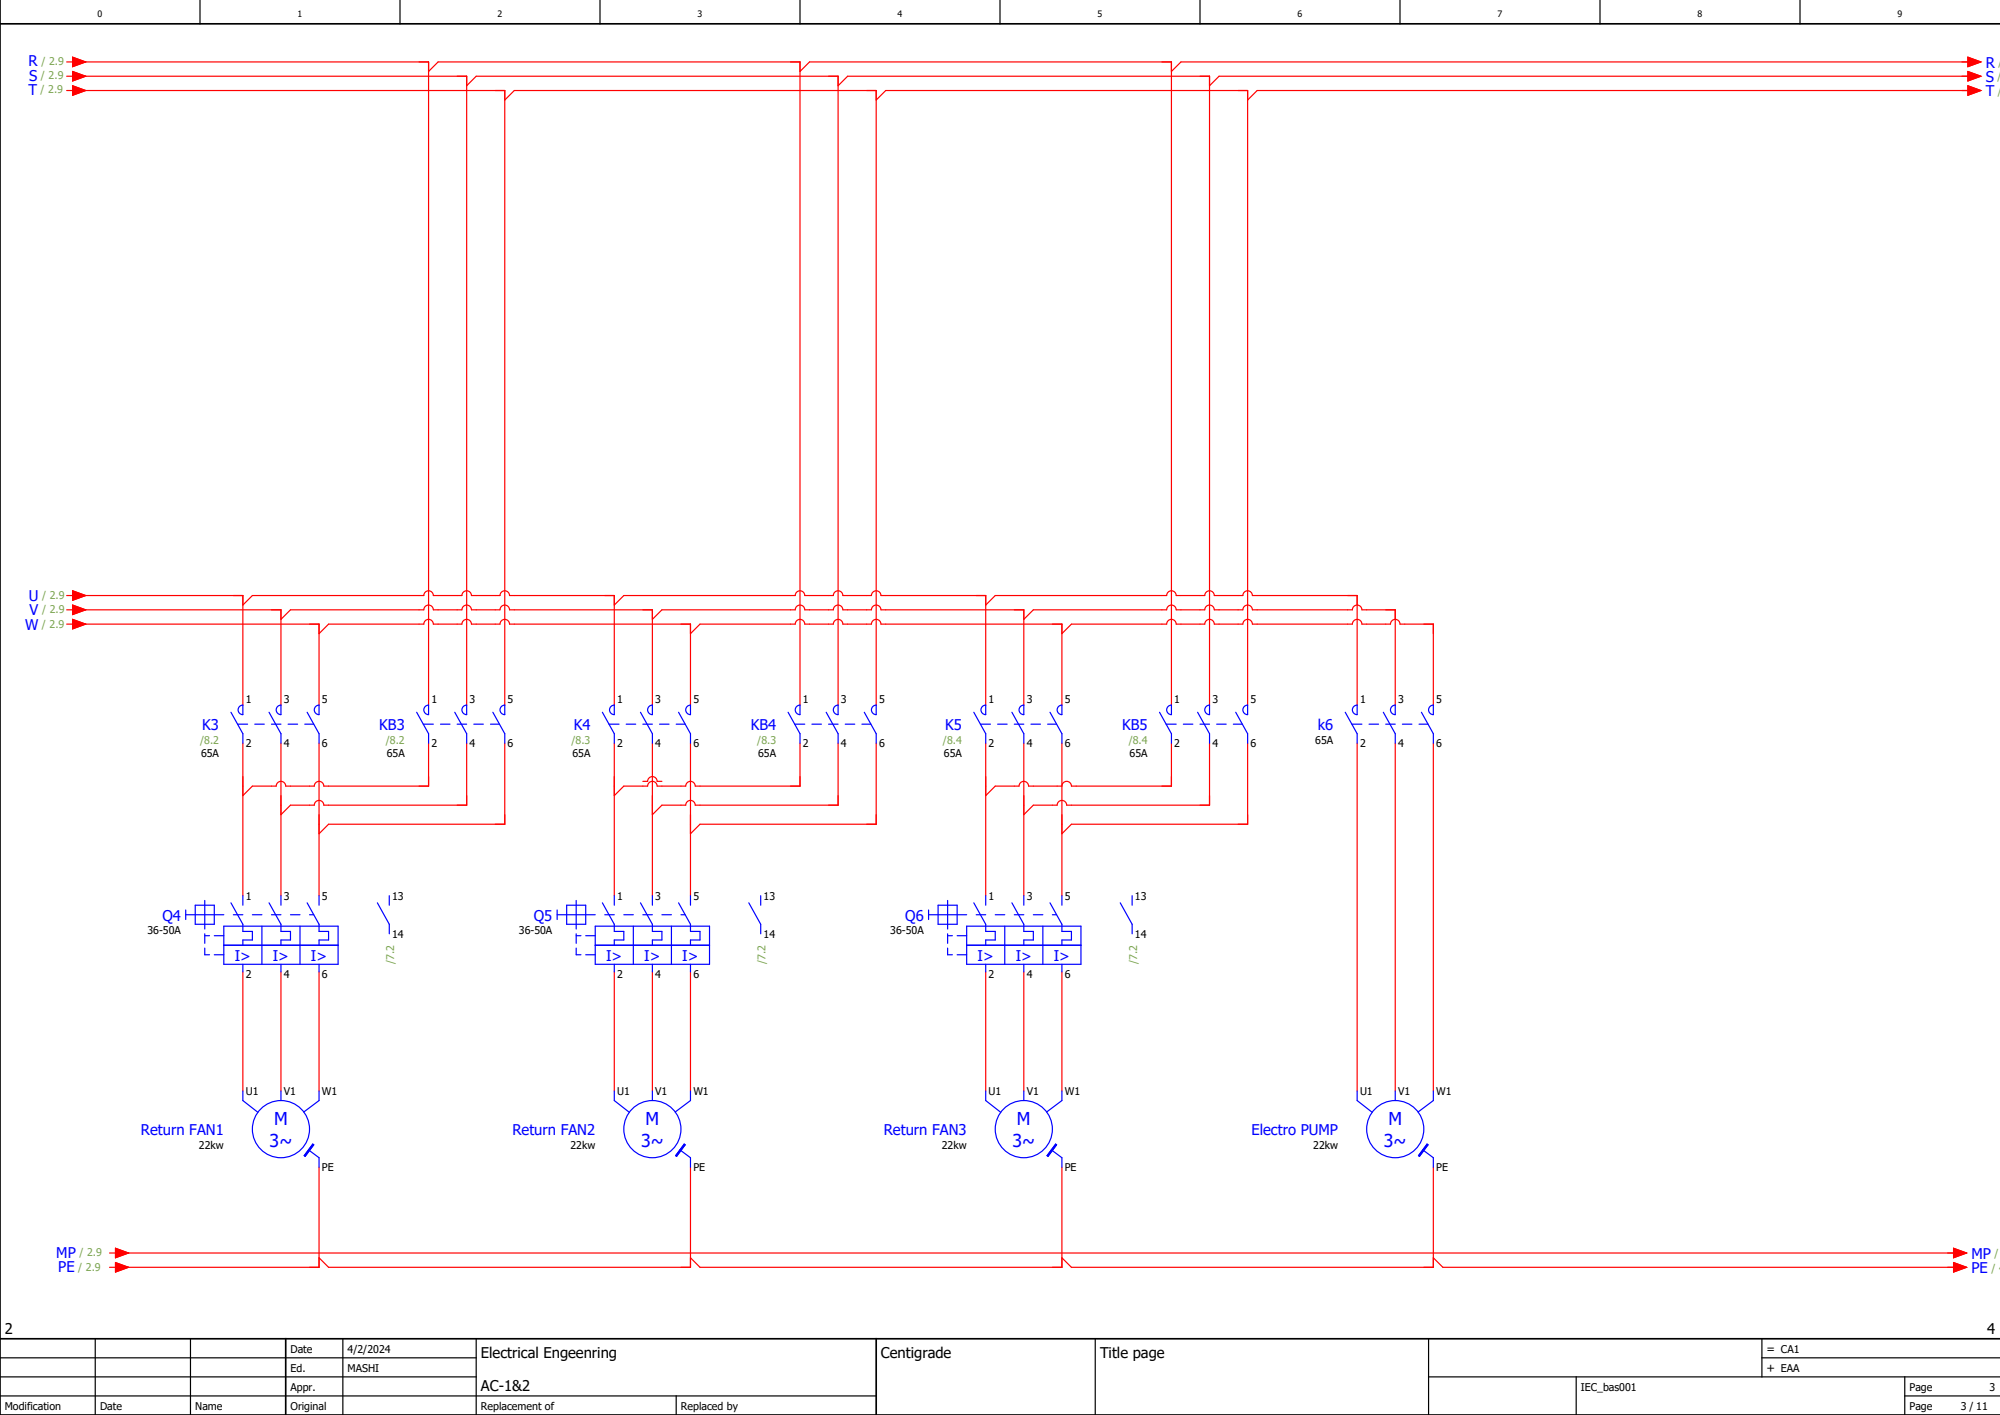
[picture p400: page 3]
Return FAN1; Return FAN2; Return FAN3; Electro PUMP

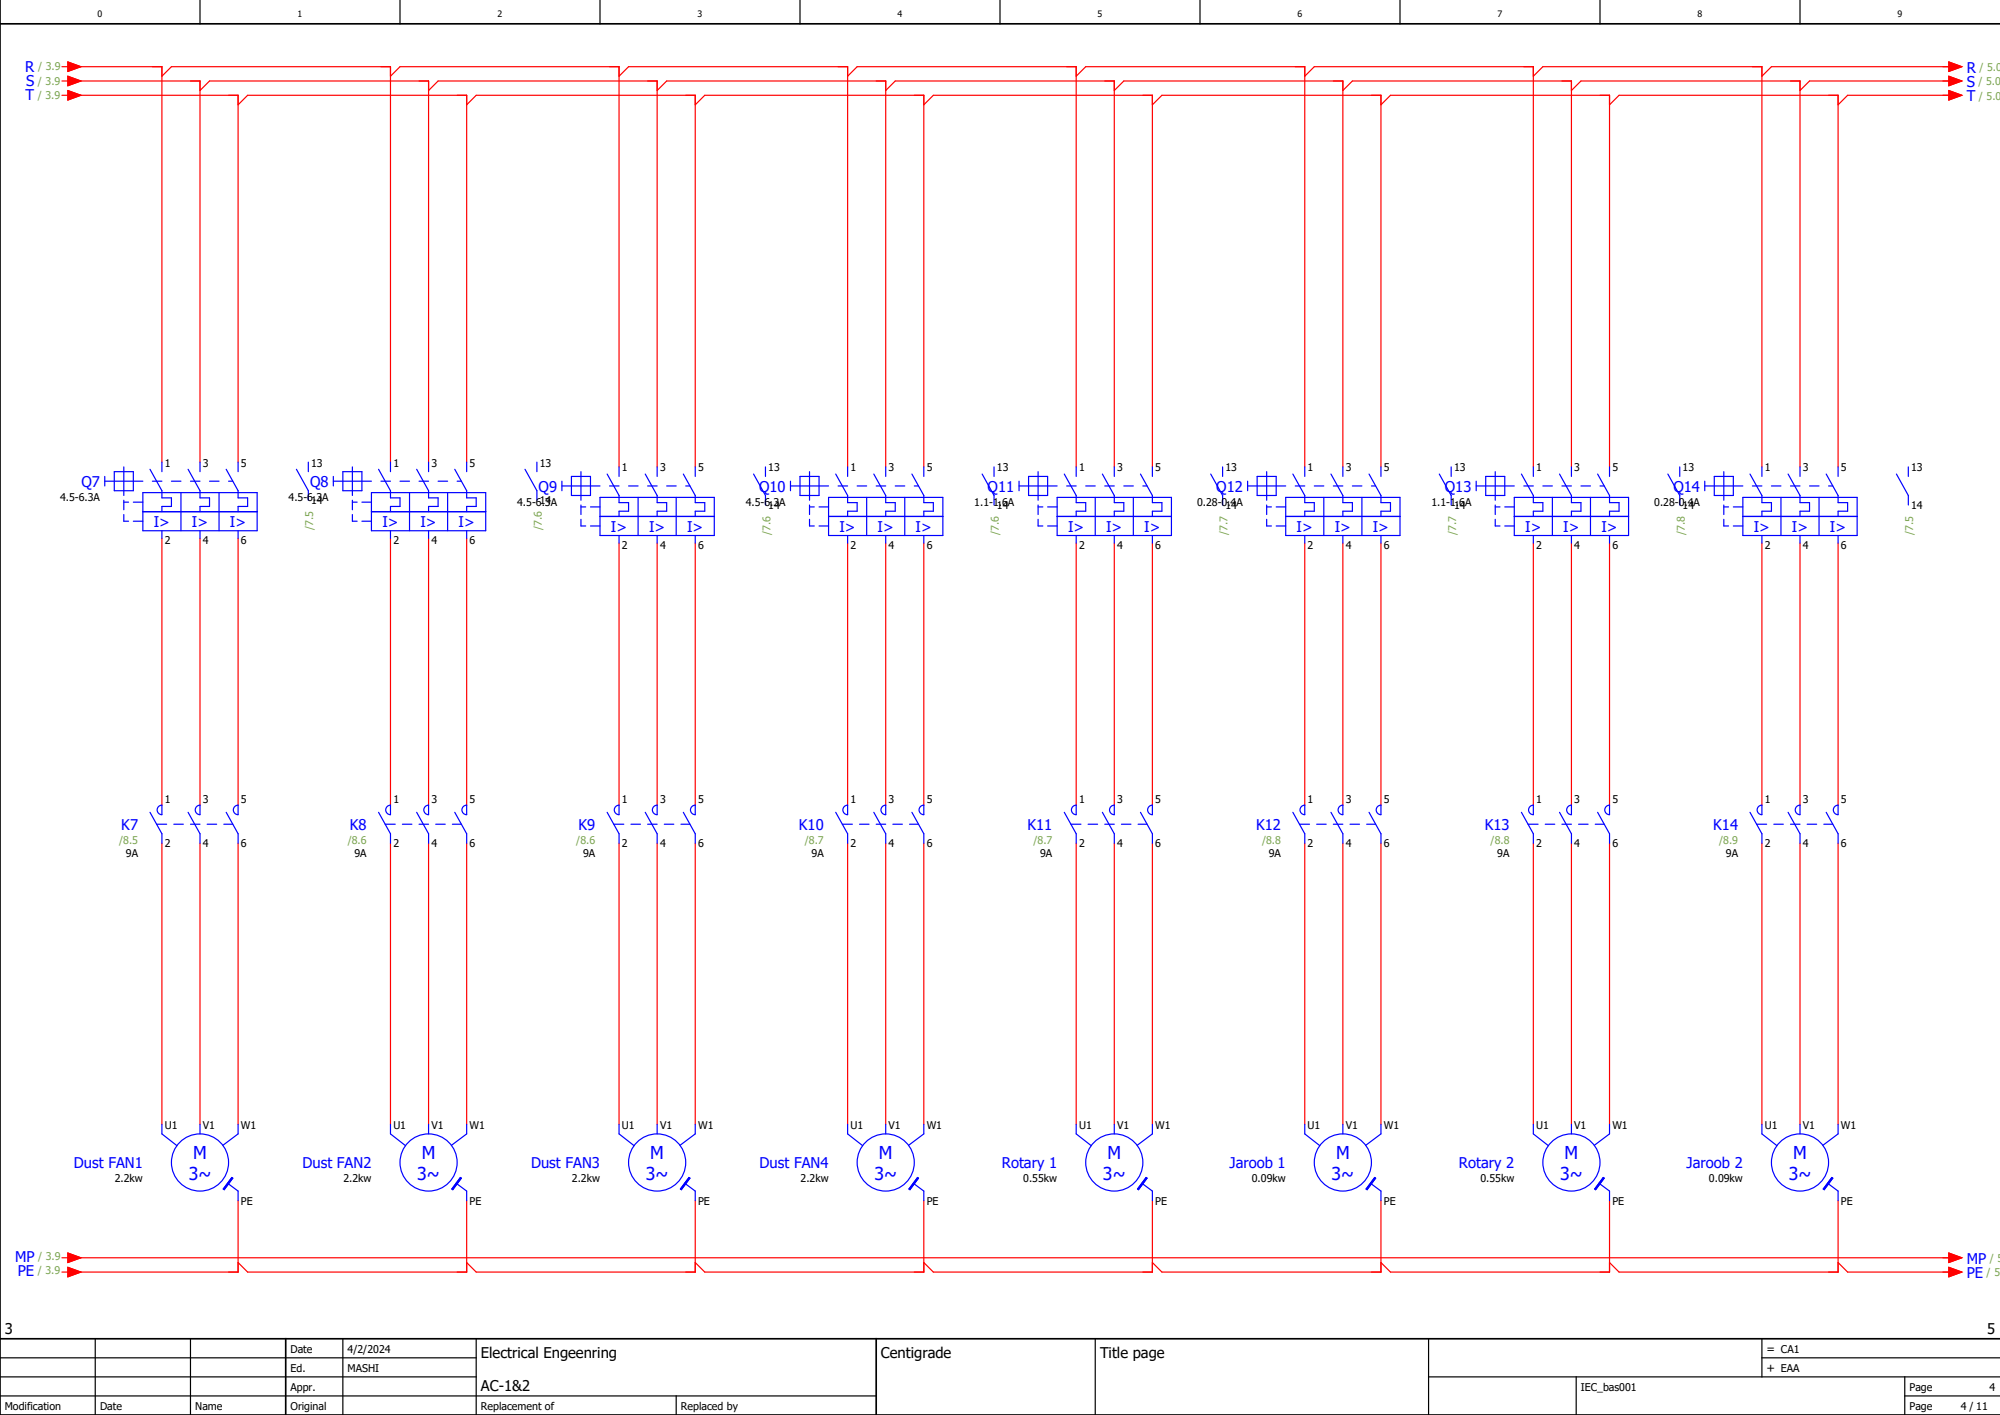
[picture p401: page 4]

F2

F3

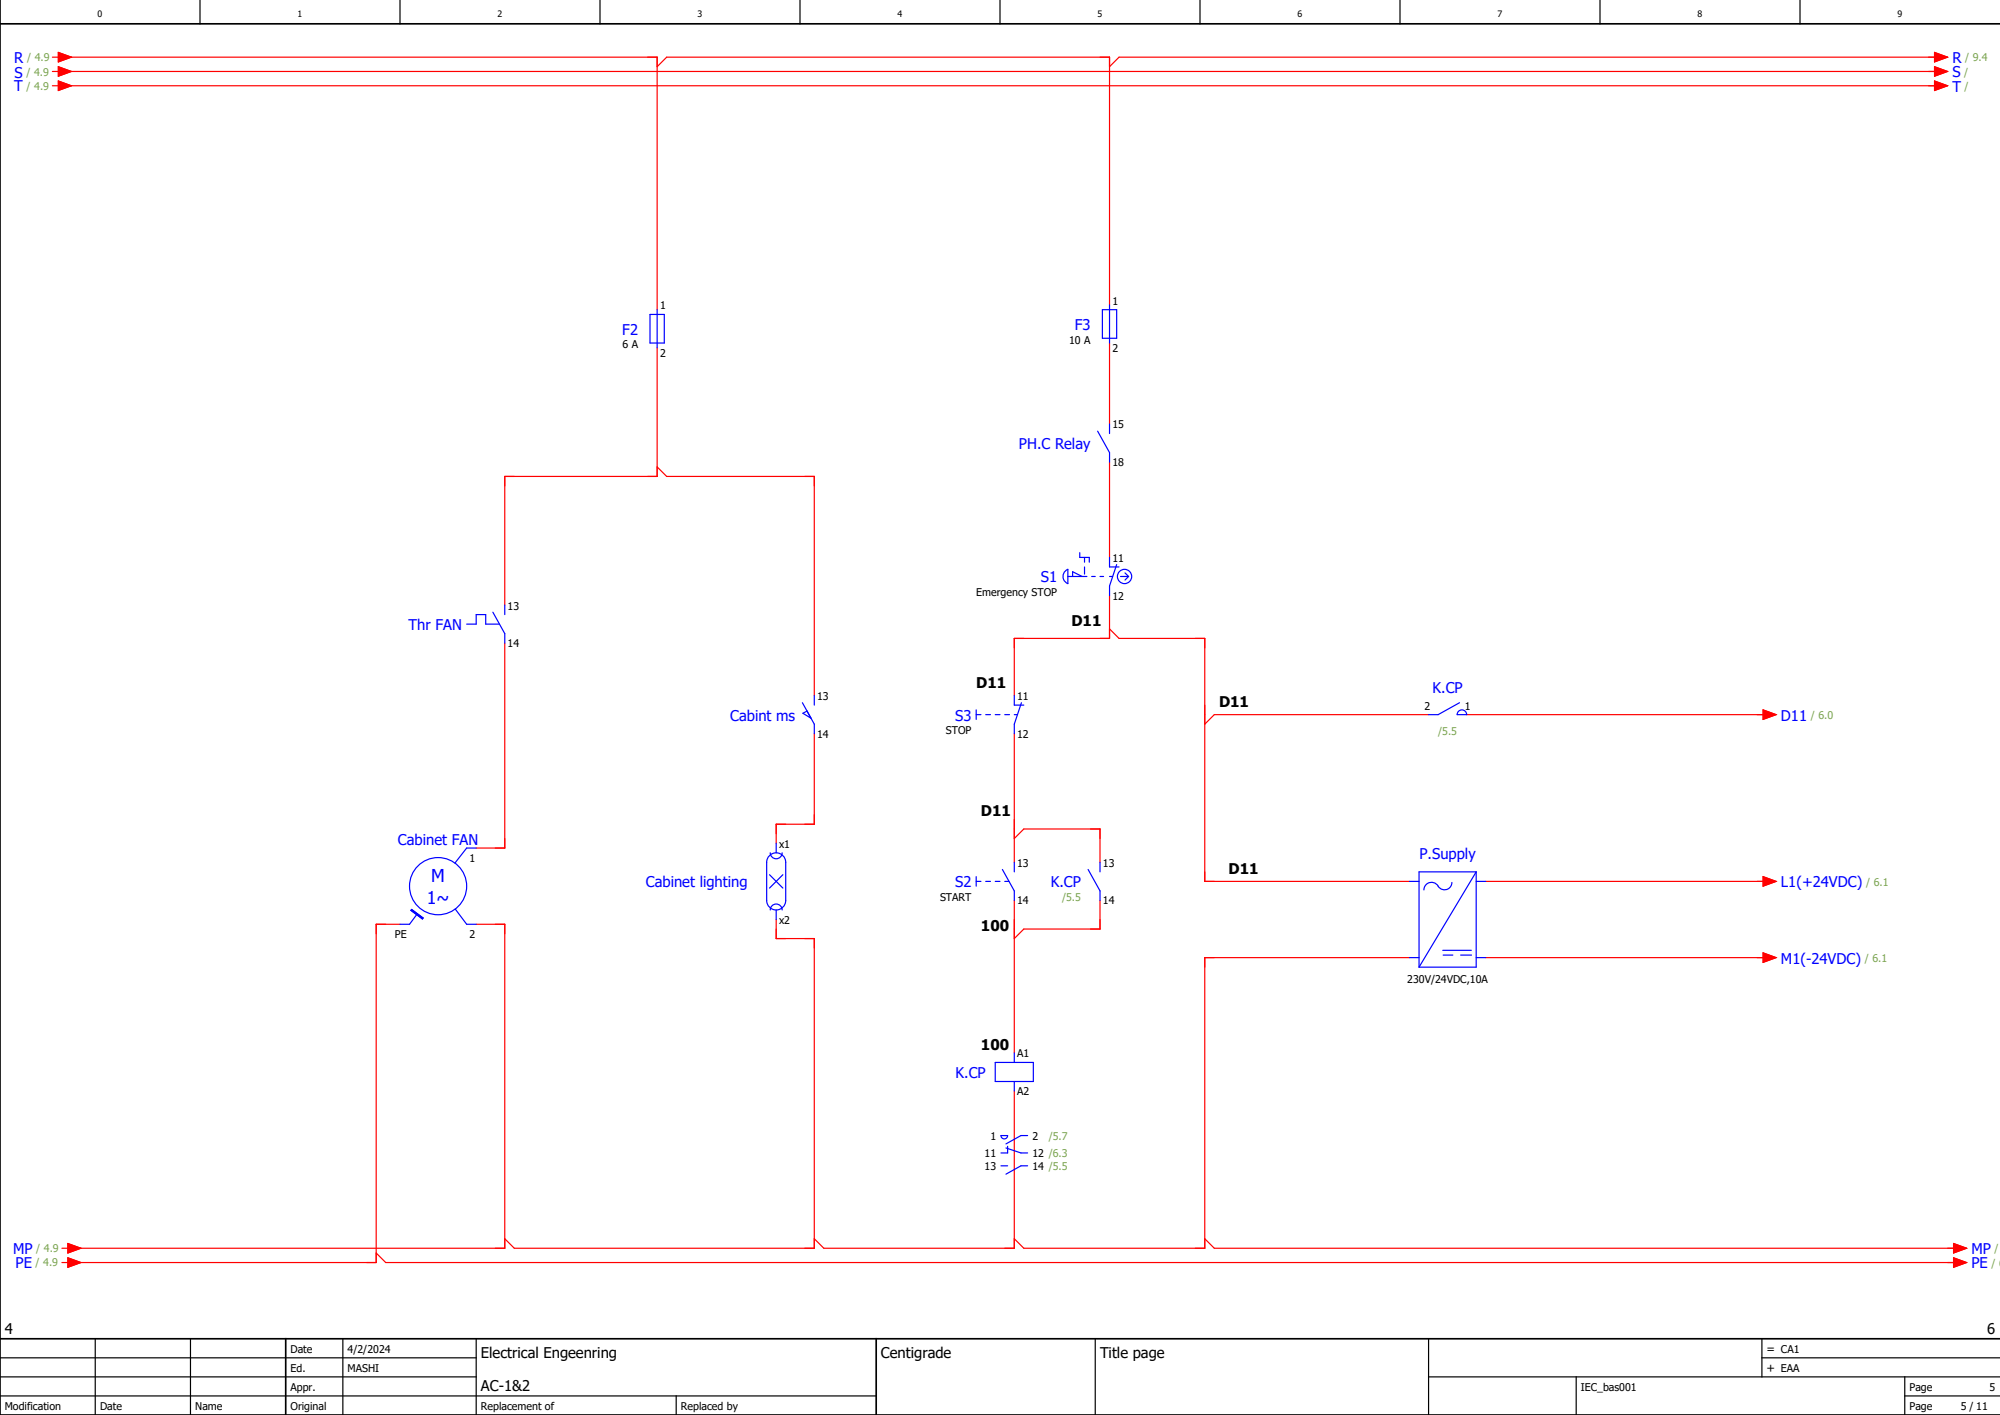
[picture p402: page 5]
Cabinet FAN; Cabinet lighting; Thr FAN; Cabint ms; Emergency STOP; PH.C Relay; START; STOP; P.Supply; 230V/24VDC,10A; L1(+24VDC) / 6.1; M1(-24VDC) / 6.1

X1 | X2 | X3 | X4 | X5 | X6 | X7 | X9 | X10 | X11 | X12 | X13 | X14 DRV⁻Fault
K7

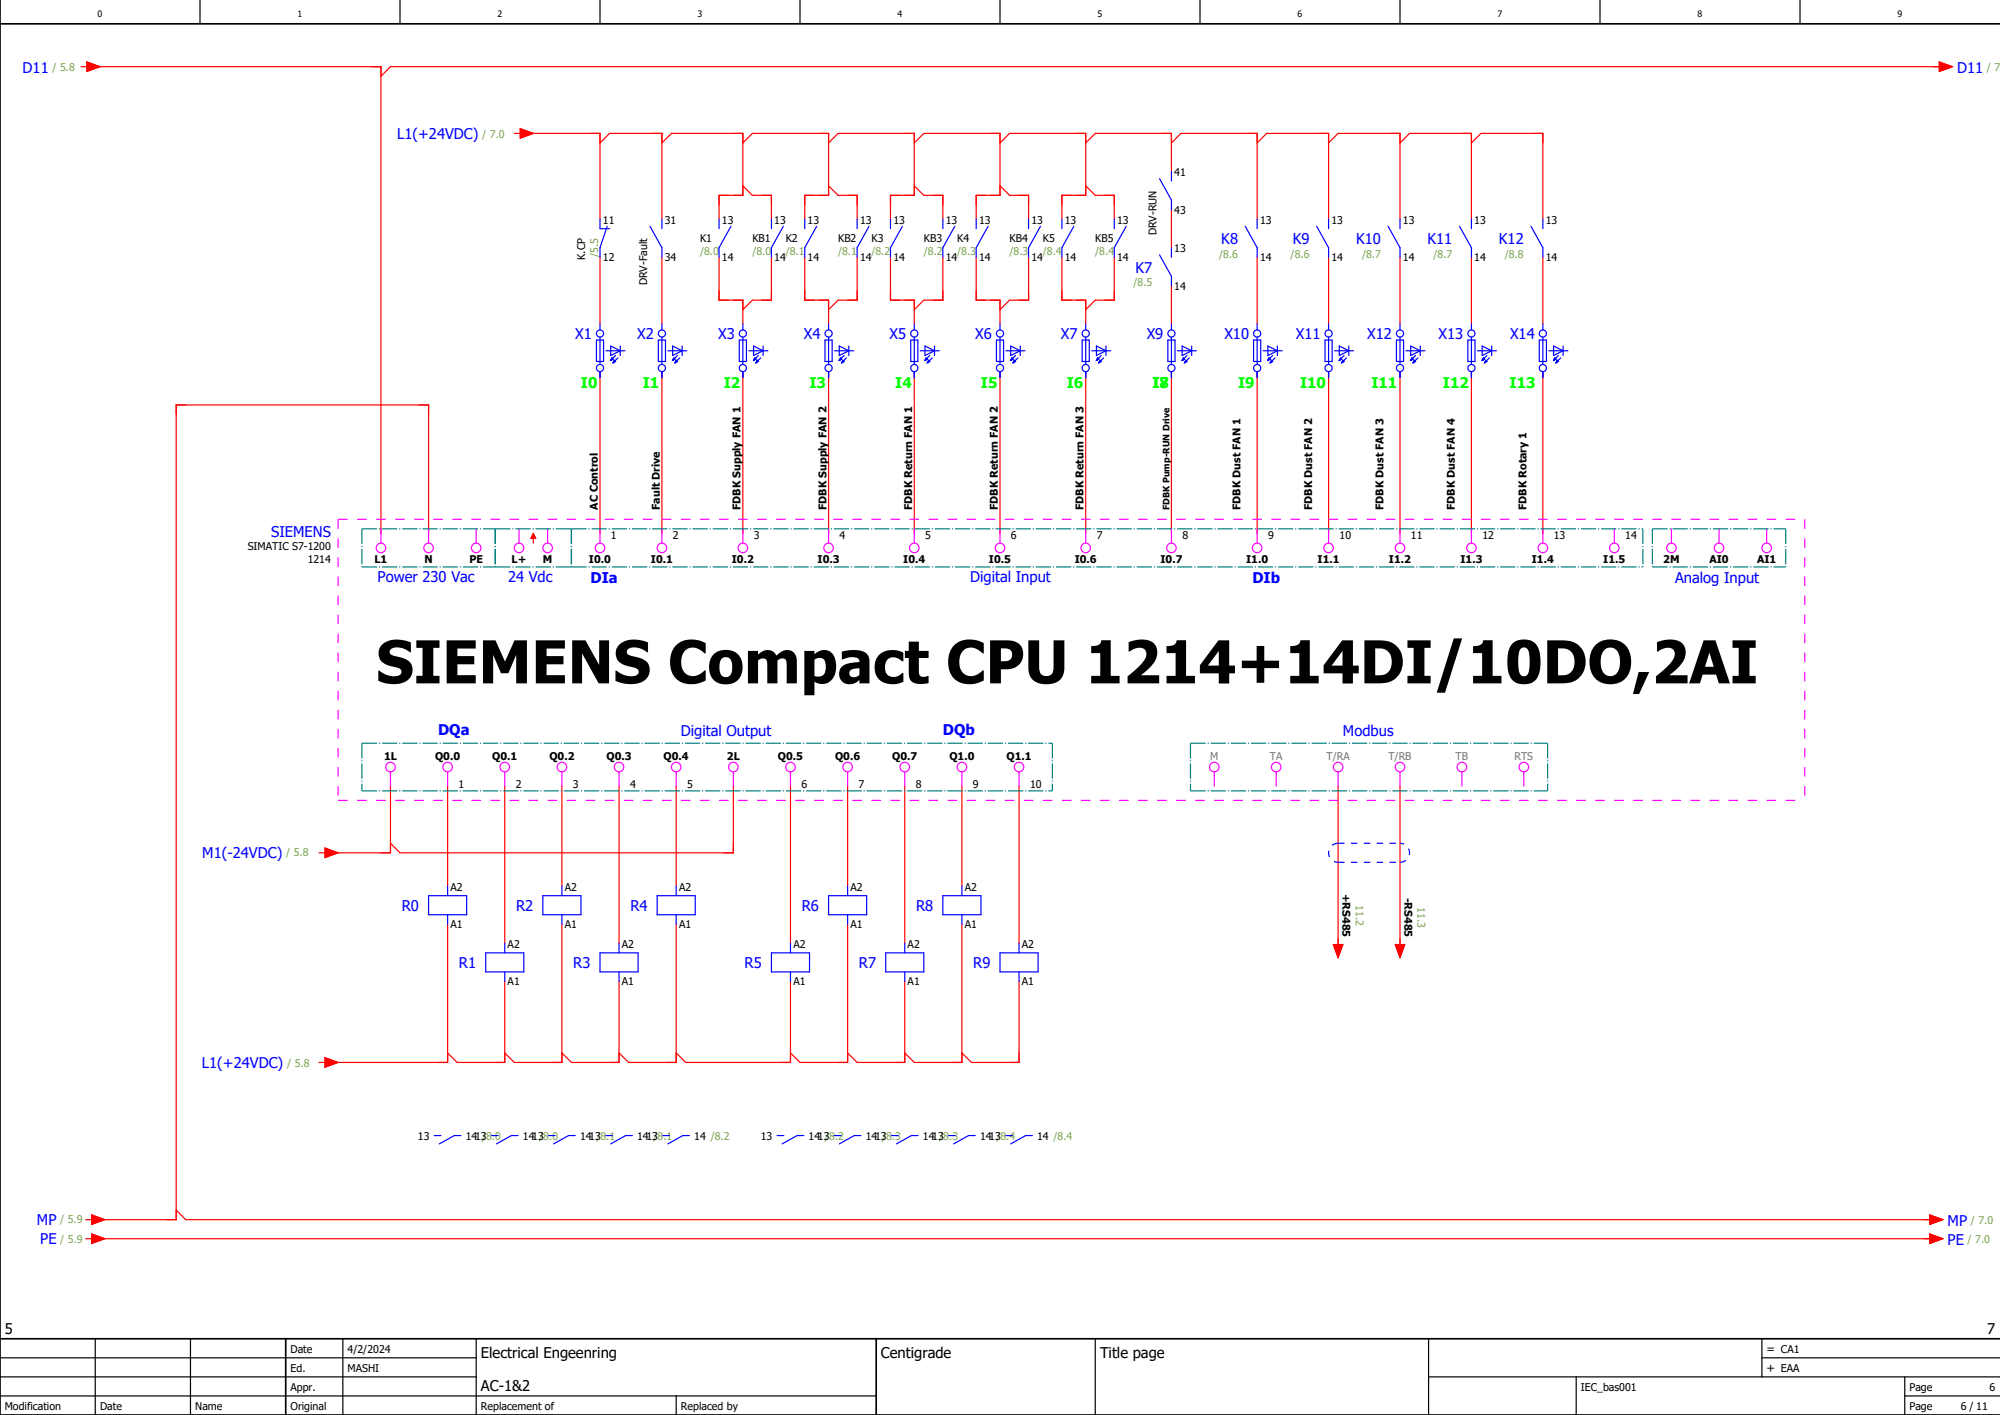
[picture p403: page 6]

FDBK Pump-RUN Drive

X31 | X32 | X33 | X34 | X35 | X36 | X37 | X38

K13

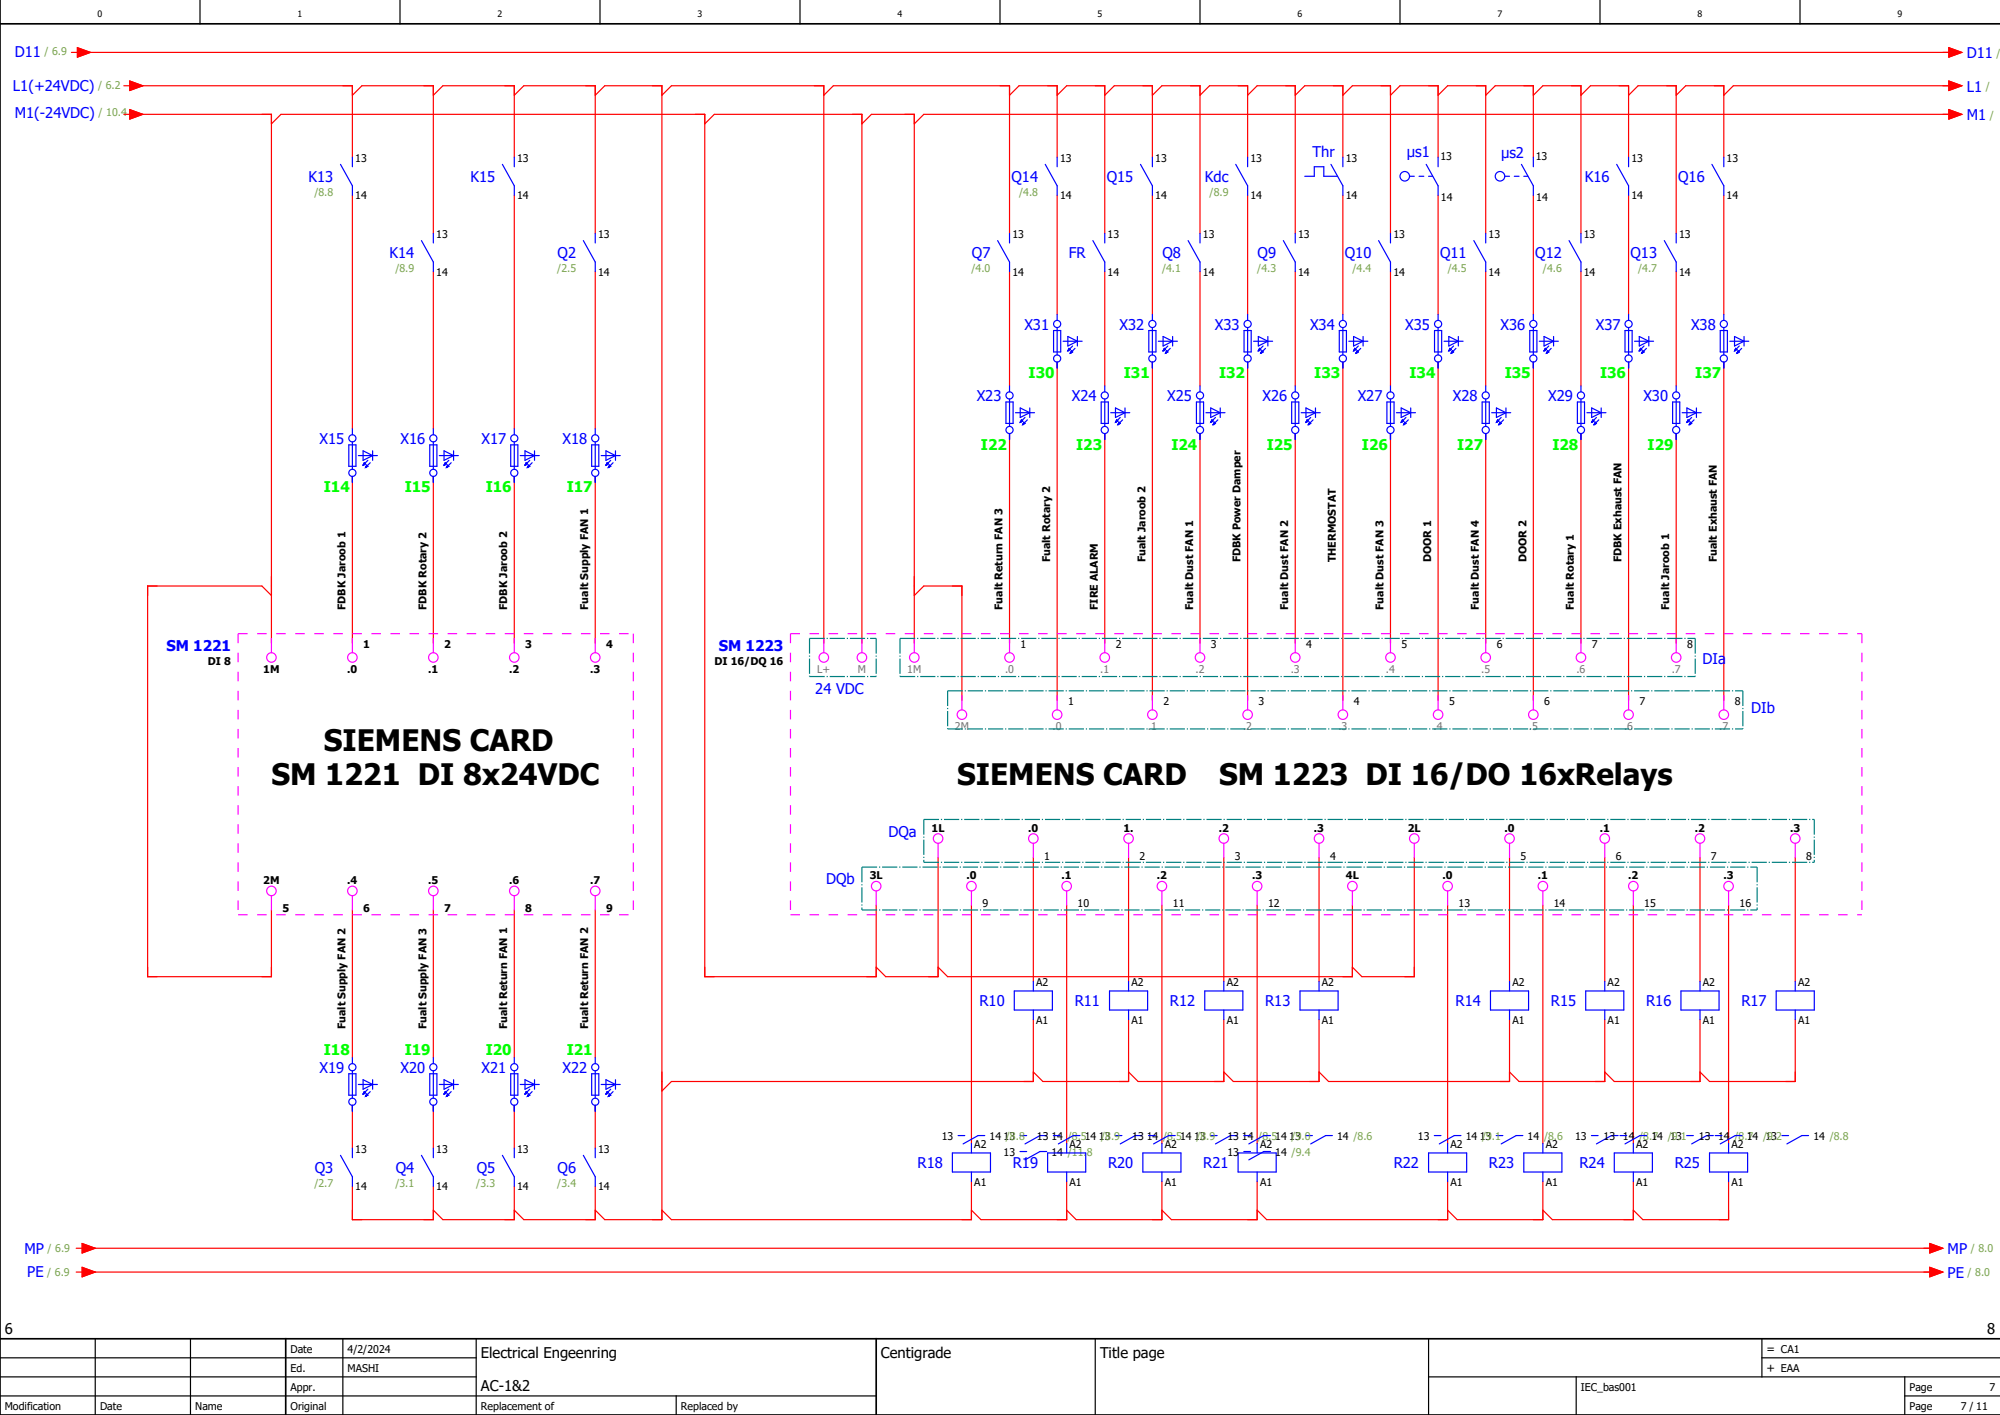
[picture p404: page 7]

R0

R1

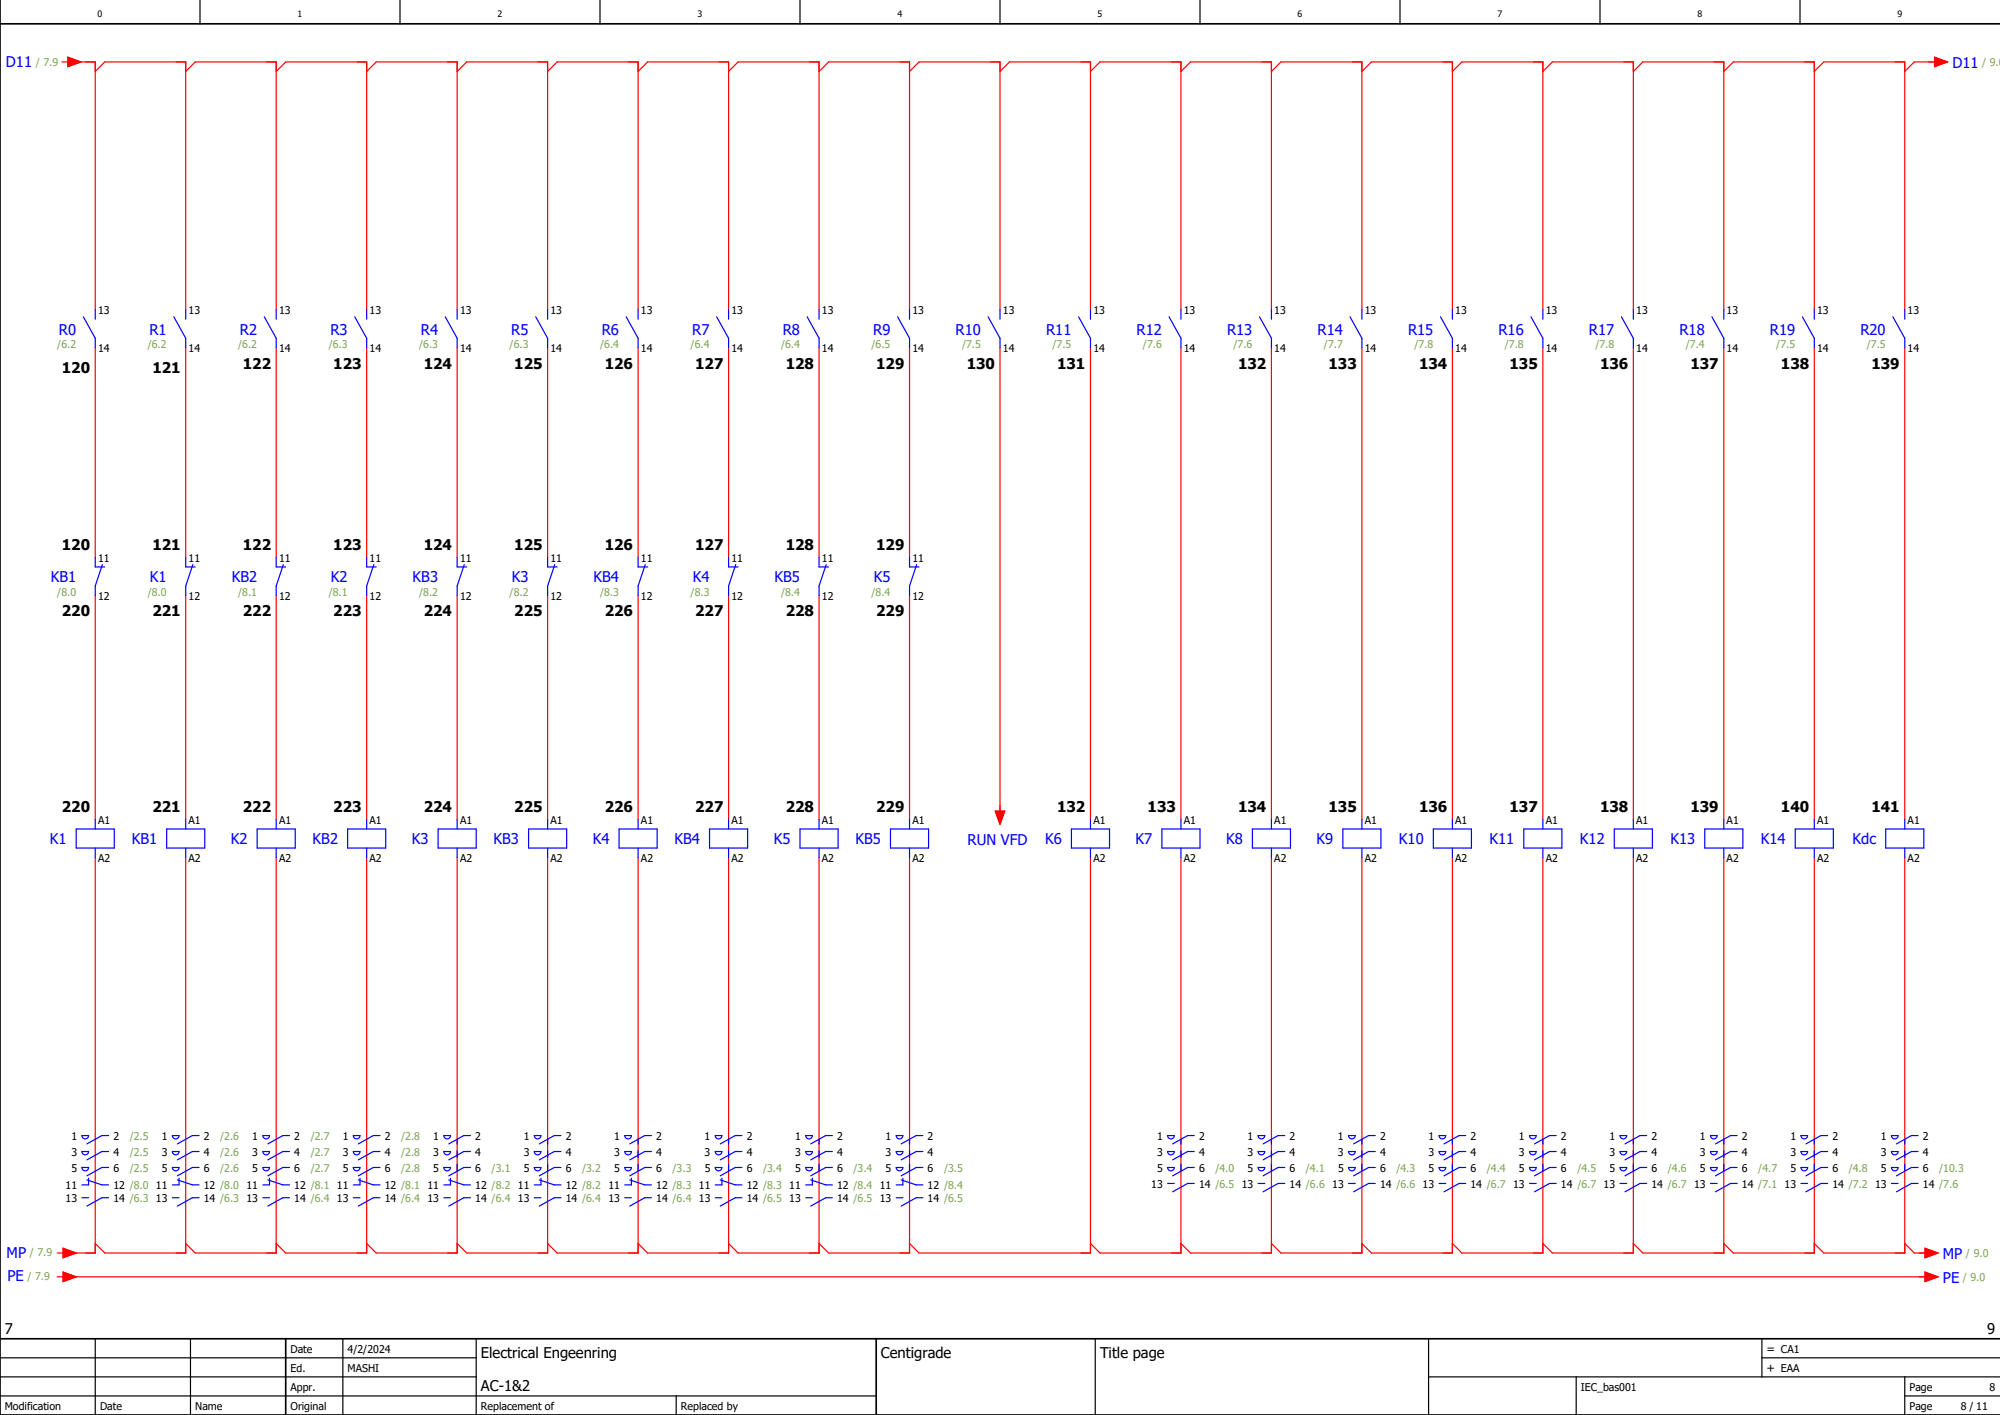
[picture p405: page 8]

D12

F4

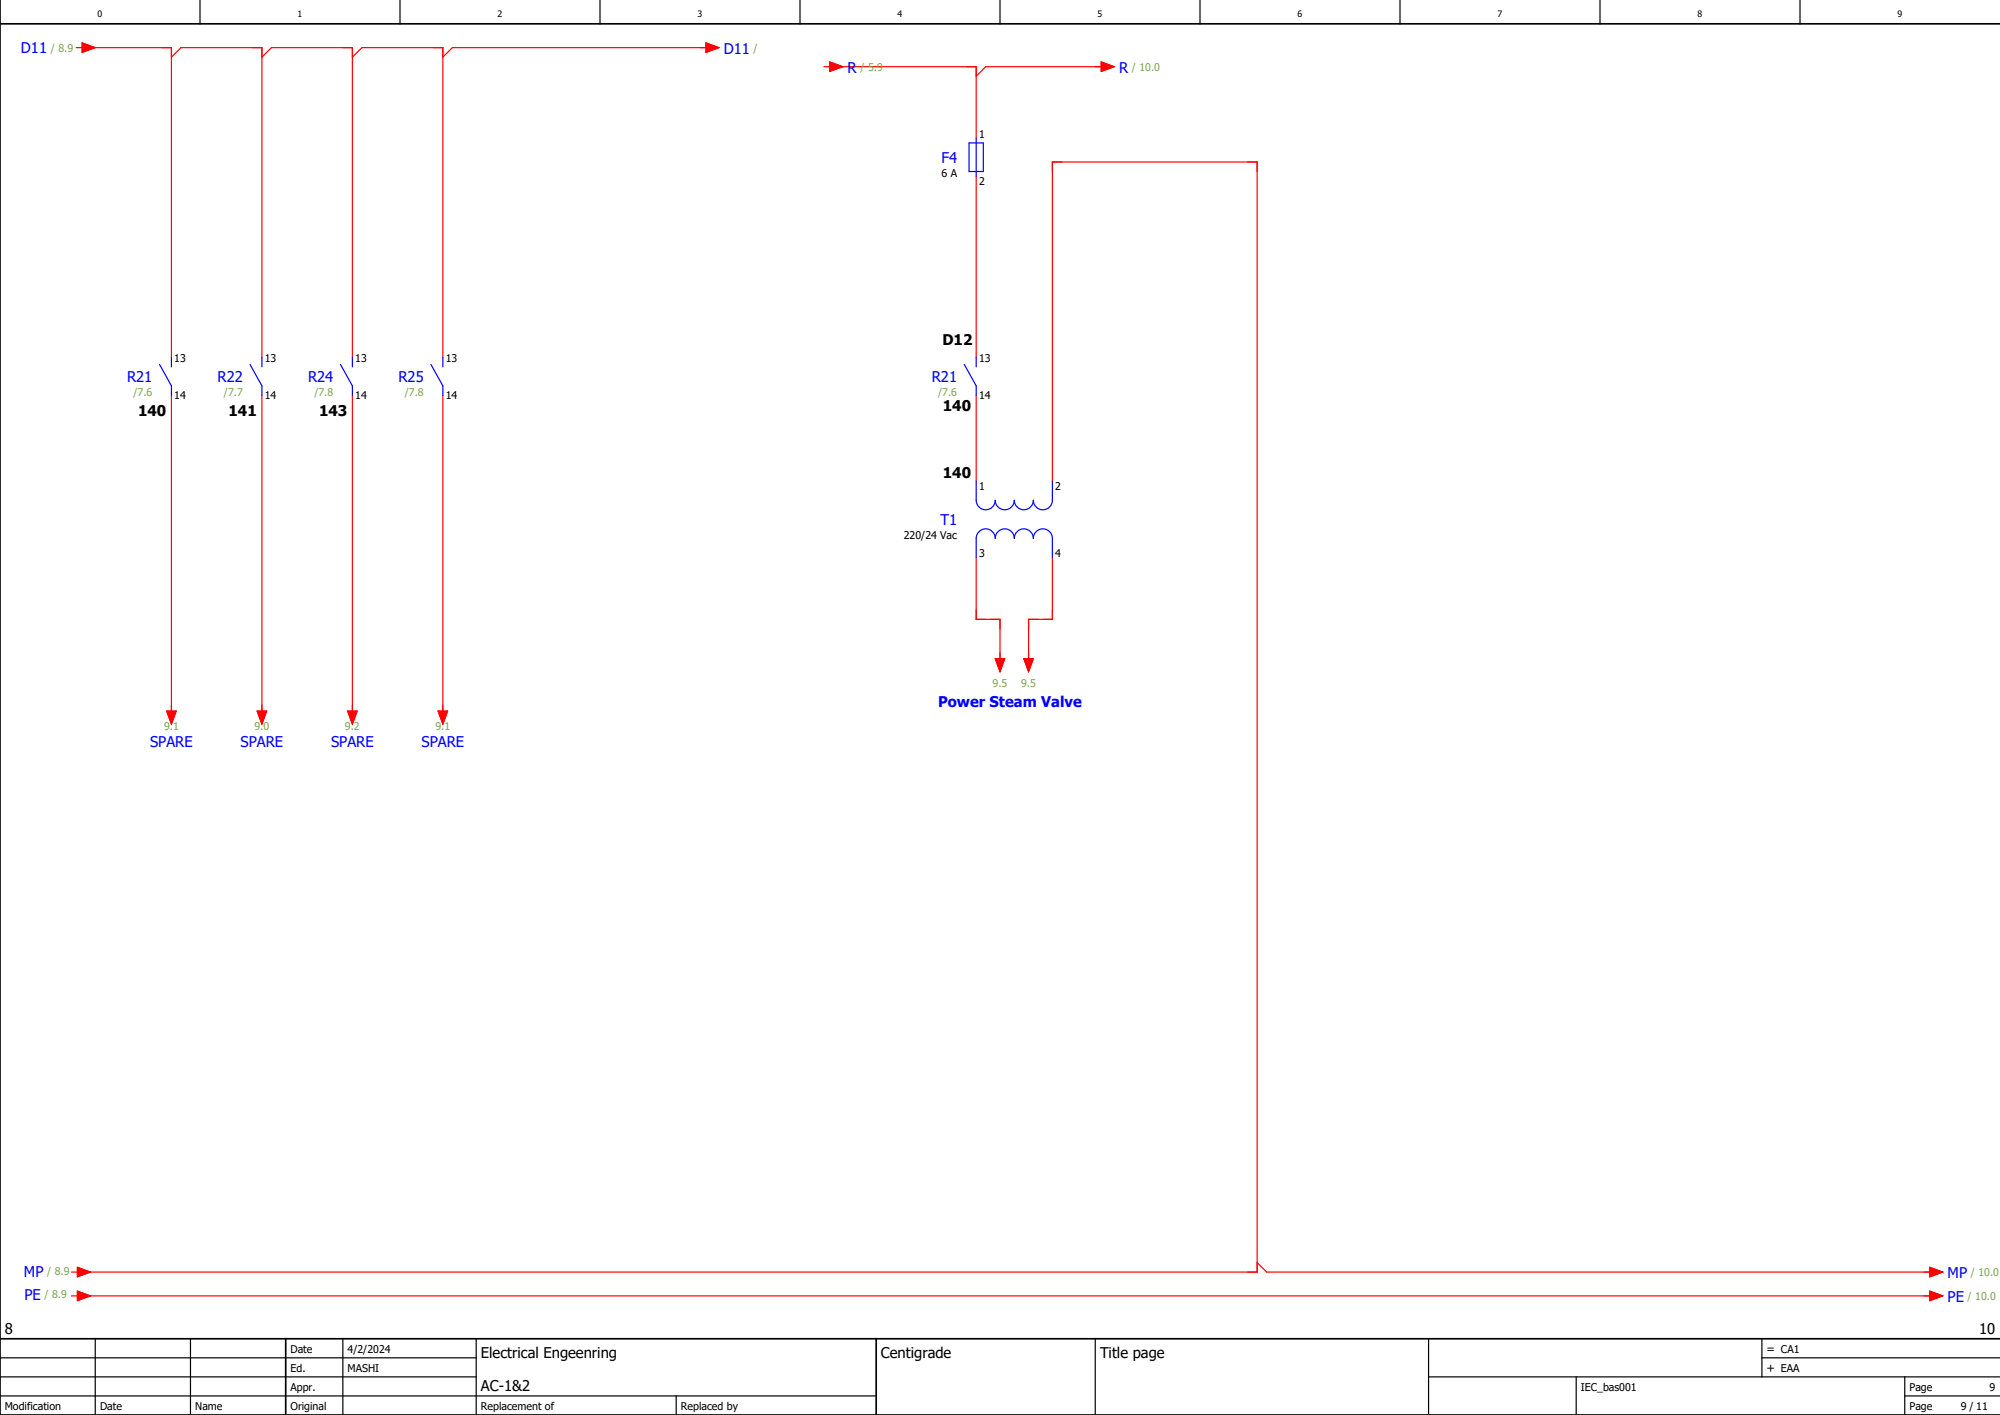
[picture p406: page 9]
220/24 Vac; SPARE

Power Steam Valve

F5

## L1(+24VDC) / 11.1

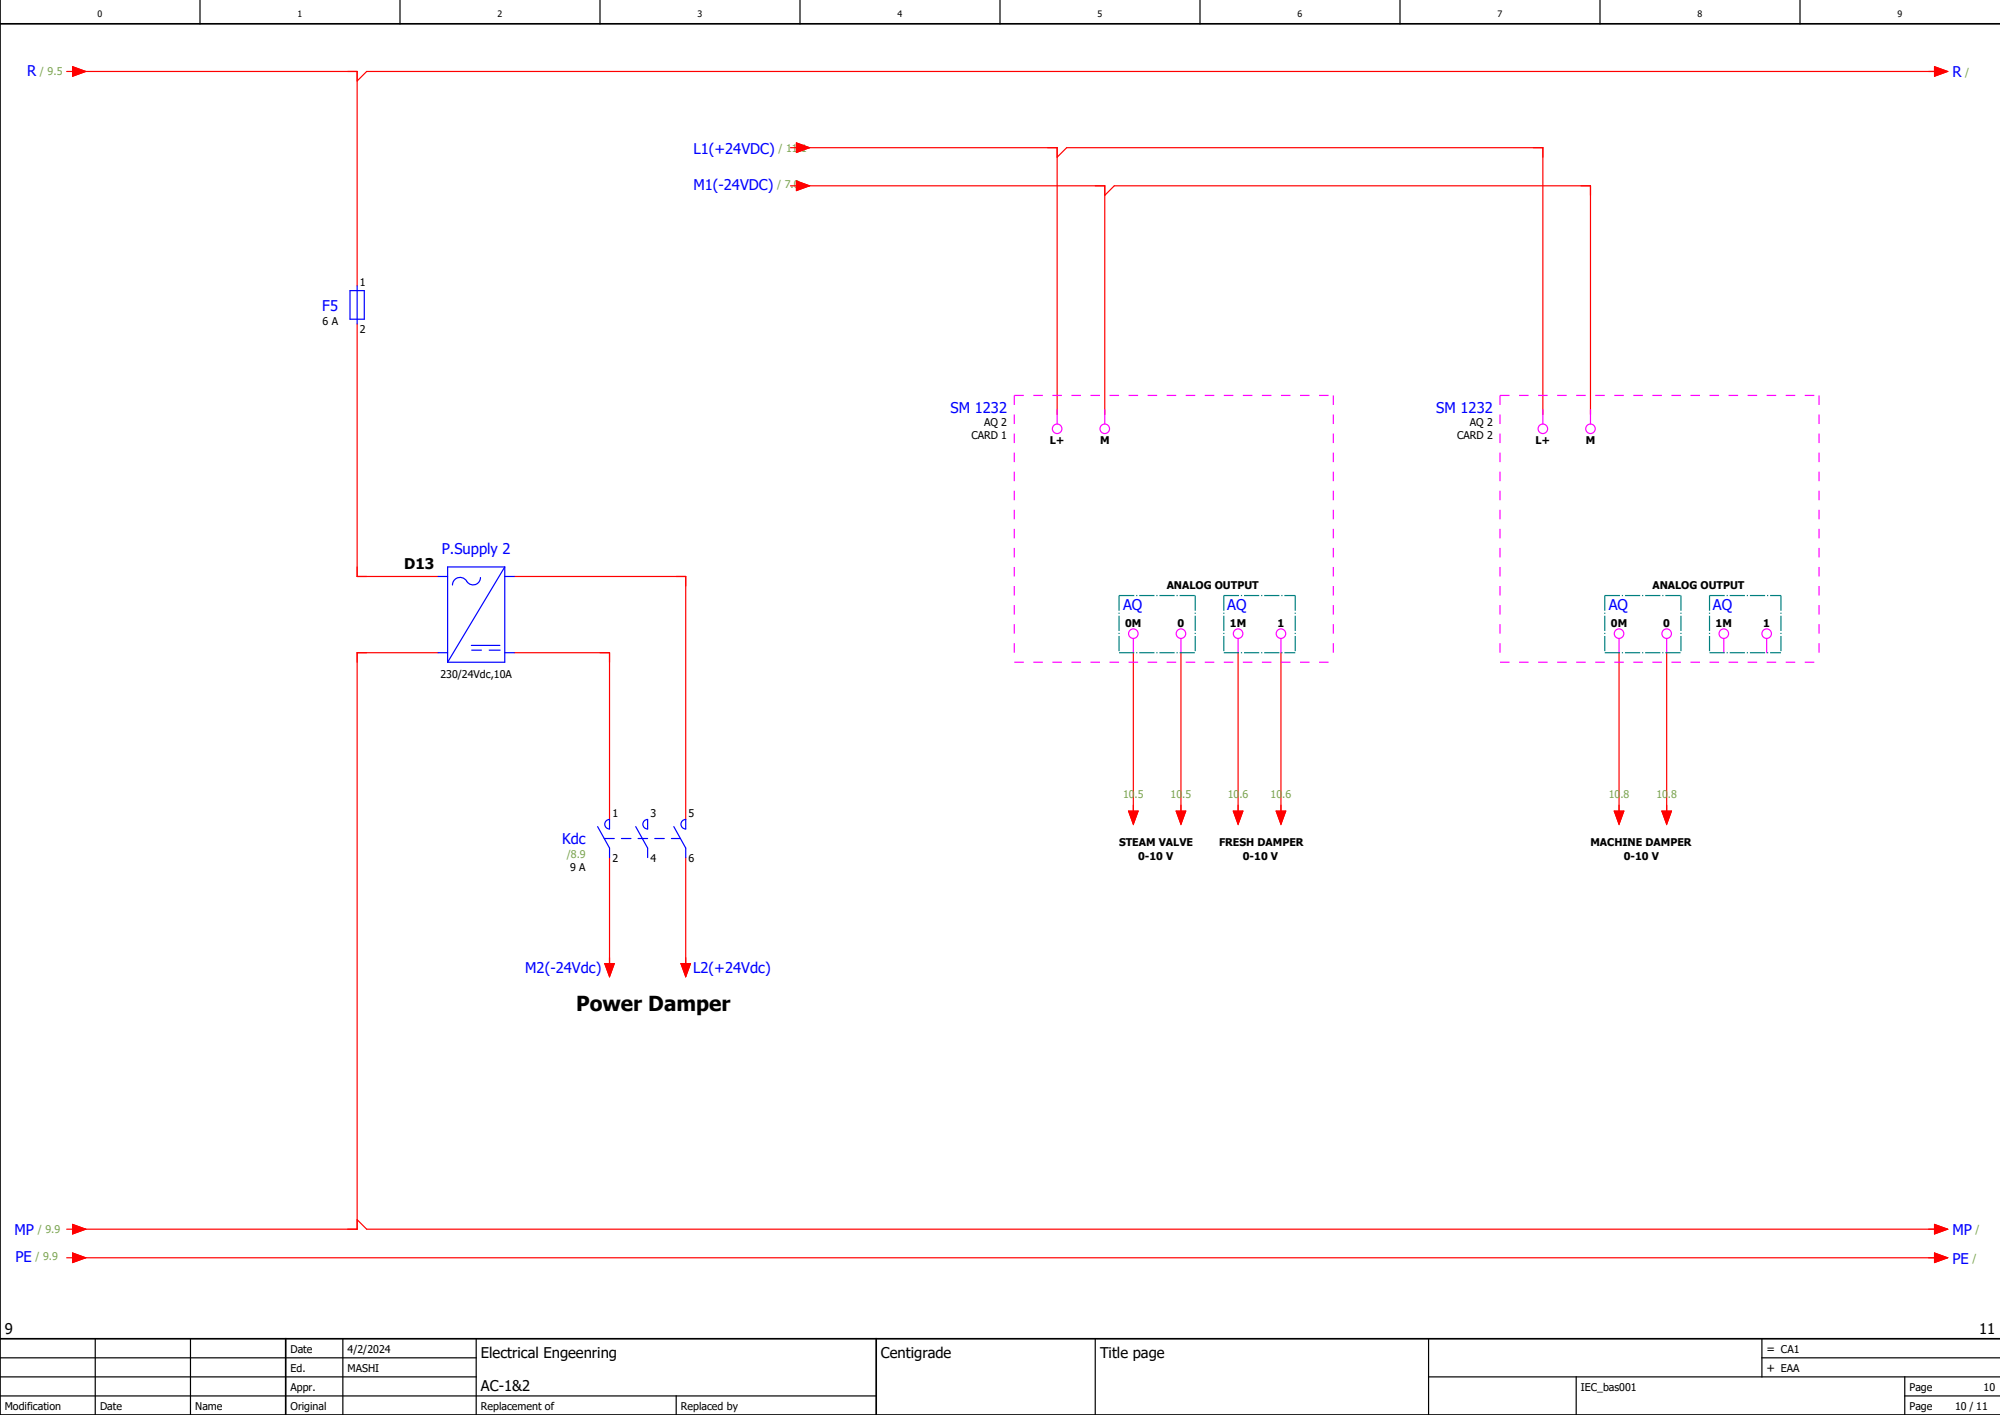
[picture p407: page 10]
Power Damper; ANALOG OUTPUT; STEAM VALVE; FRESH DAMPER; MACHINE DAMPER; P.Supply 2; 230/24Vdc,10A; Kdc; AQ 2 CARD 1; CARD 2 L+; M2(-24Vdc); L2(+24Vdc); M1(-24VDC) / 7.0

## L1(+24VDC) / 10.4

## M1(-24VDC) /

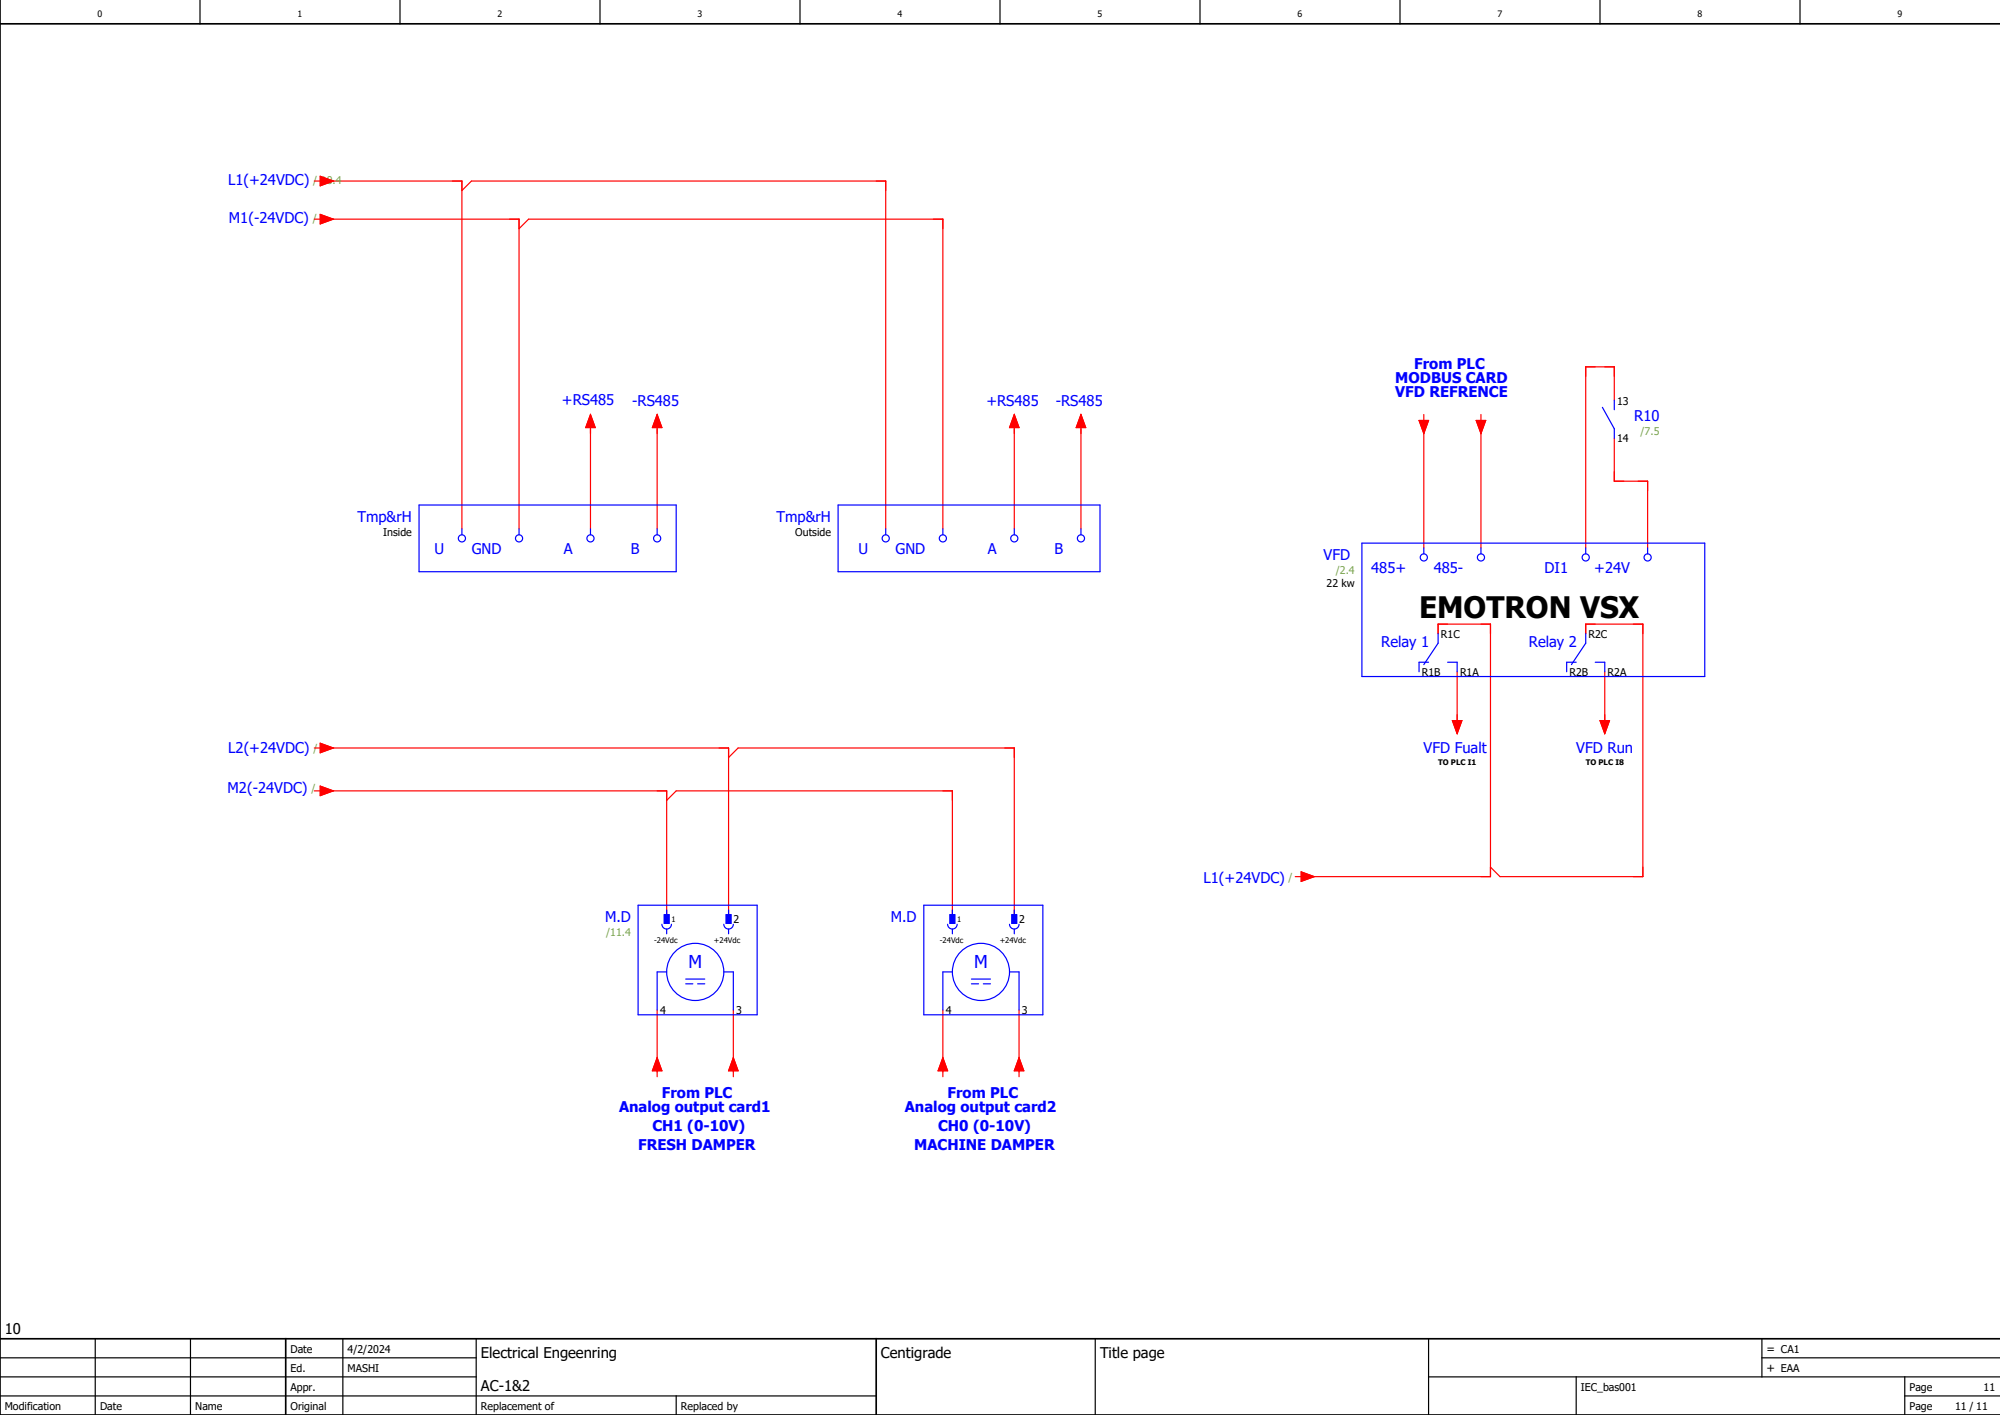
[picture p408: page 11]
From PLC Analog output card1 CH1 (0-10V) FRESH DAMPER; From PLC Analog output card2 CH0 (0-10V) MACHINE DAMPER; EMOTRON VSX; From PLC; VFD REFRENCE; TO PLC I1; TO PLC I8; MODBUS CARD; Tmp&rH; Inside; Outside; GND; -24Vdc; +24Vdc; VFD; Relay 2; Relay 1; L2(+24VDC) /; M2(-24VDC) /; L1(+24VDC) /; VFD Fualt; VFD Run
