koalium/centidocs/elec/plc/Wiring diagram/10385&146008/SAVIN Carpet-AC 3&4.pdf

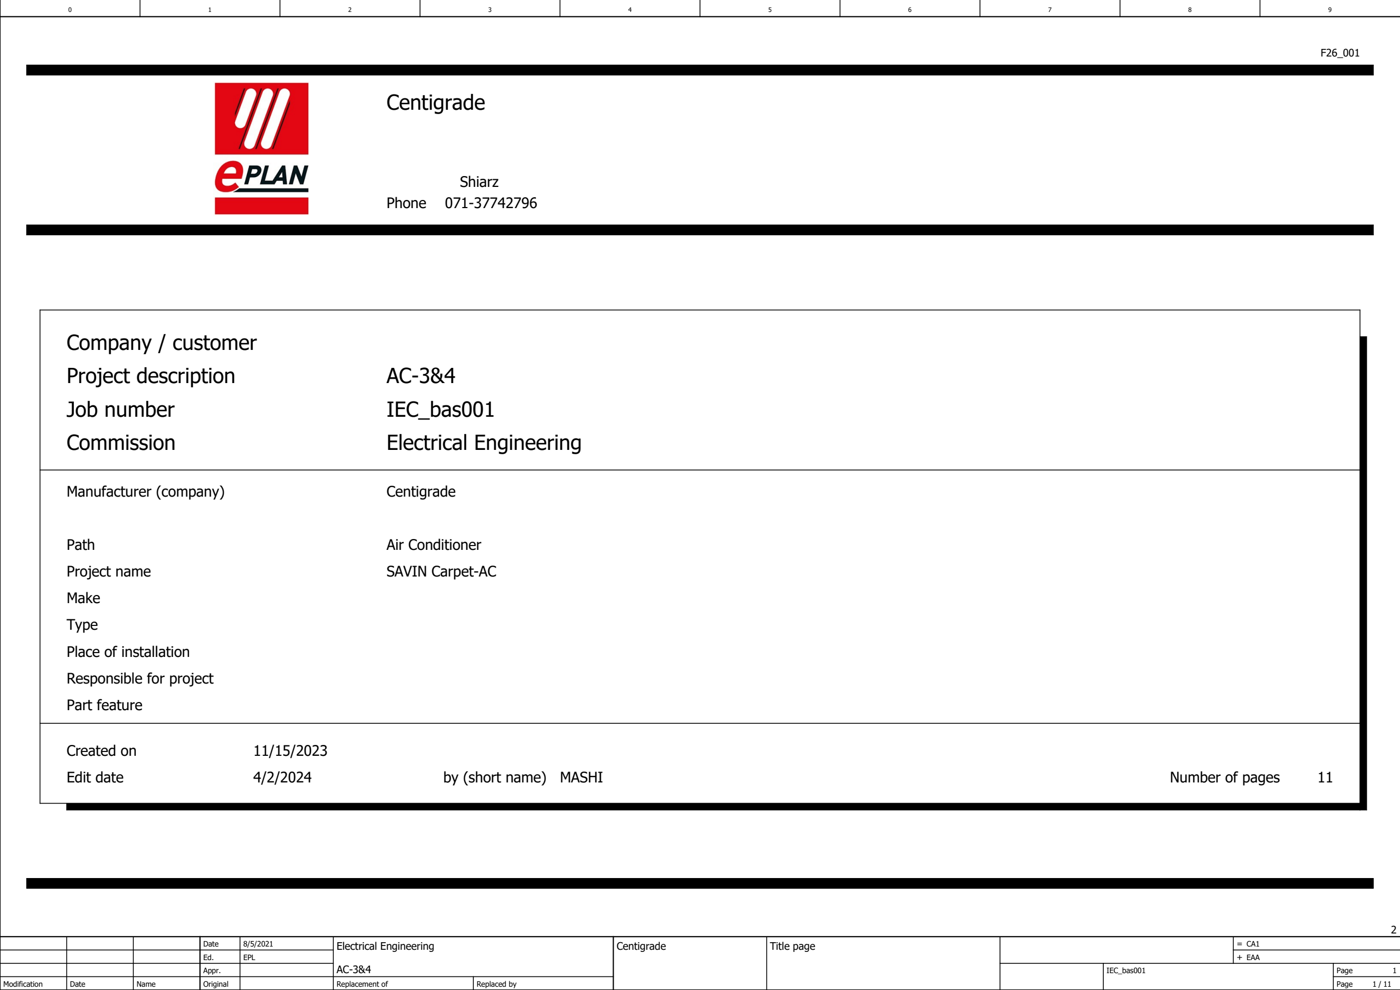
[picture p409: figure]
Page; Original; IEC_bas001; Electrical Engineering; EPL; Date; Replaced by; EAA; Title page; Modification; Appr.; Replacement of; Centigrade; Name; Project description; Number of pages; Commission; Edit date; Created on; Job number; Air Conditioner; Make; MASHI; Part feature; Path; Manufacturer (company); Project name; SAVIN Carpet-AC; Responsible for project; Phone; Type; Company / customer; Place of installation; by (short name); Shiarz

F1

## MCCB

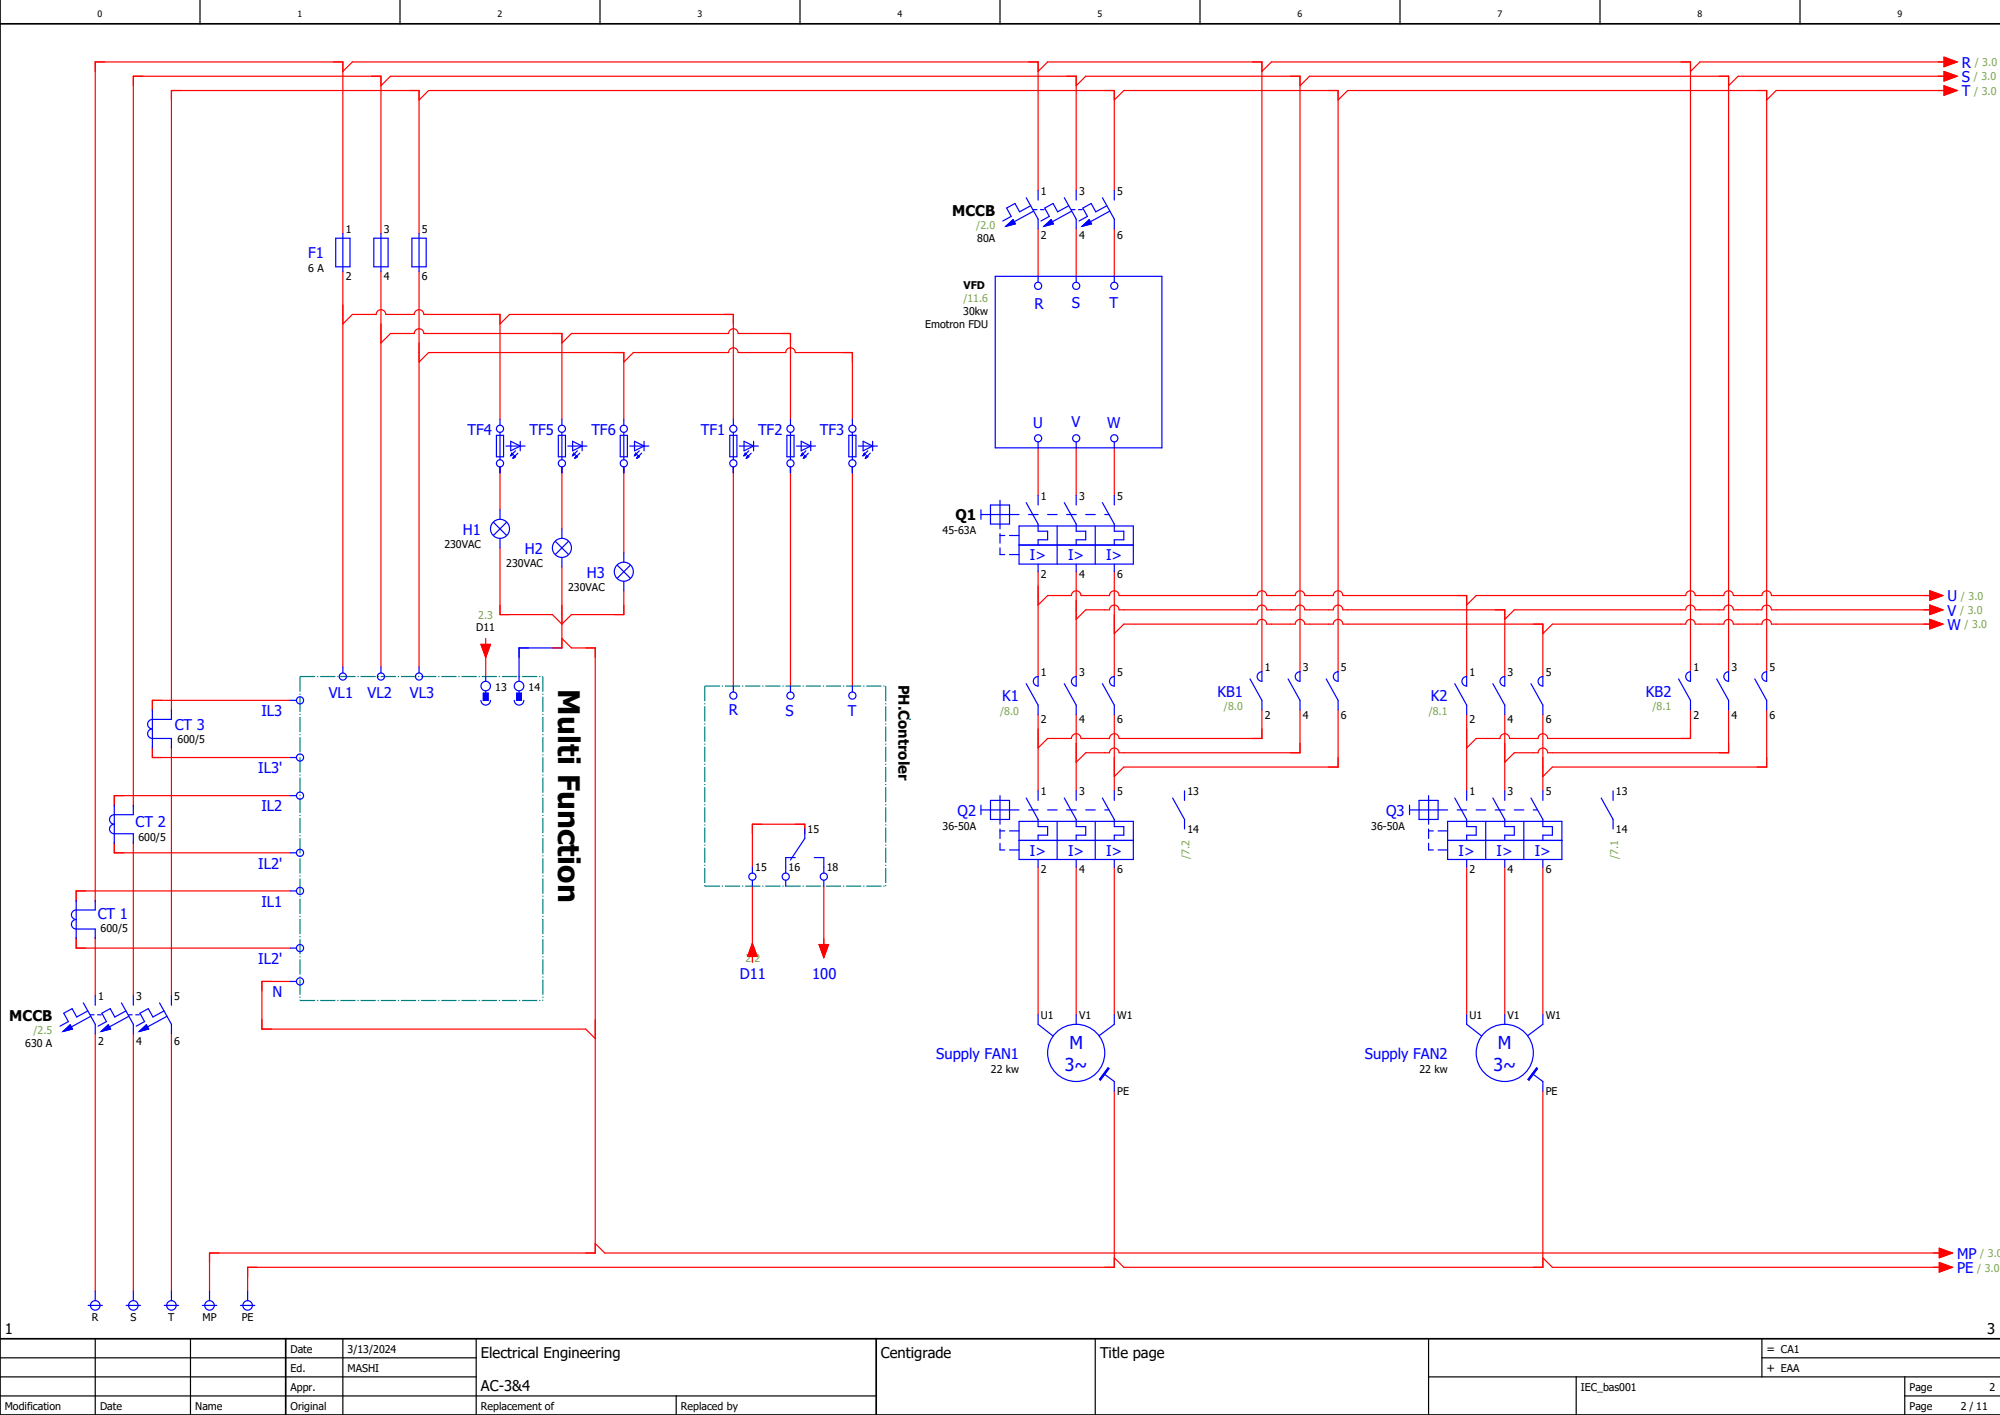
[picture p410: page 2]
MASHI; Centigrade; MCCB; Multi Function; PH.Controler; 230VAC; VFD /11.6 30kw Emotron FDU; Supply FAN1; Supply FAN2

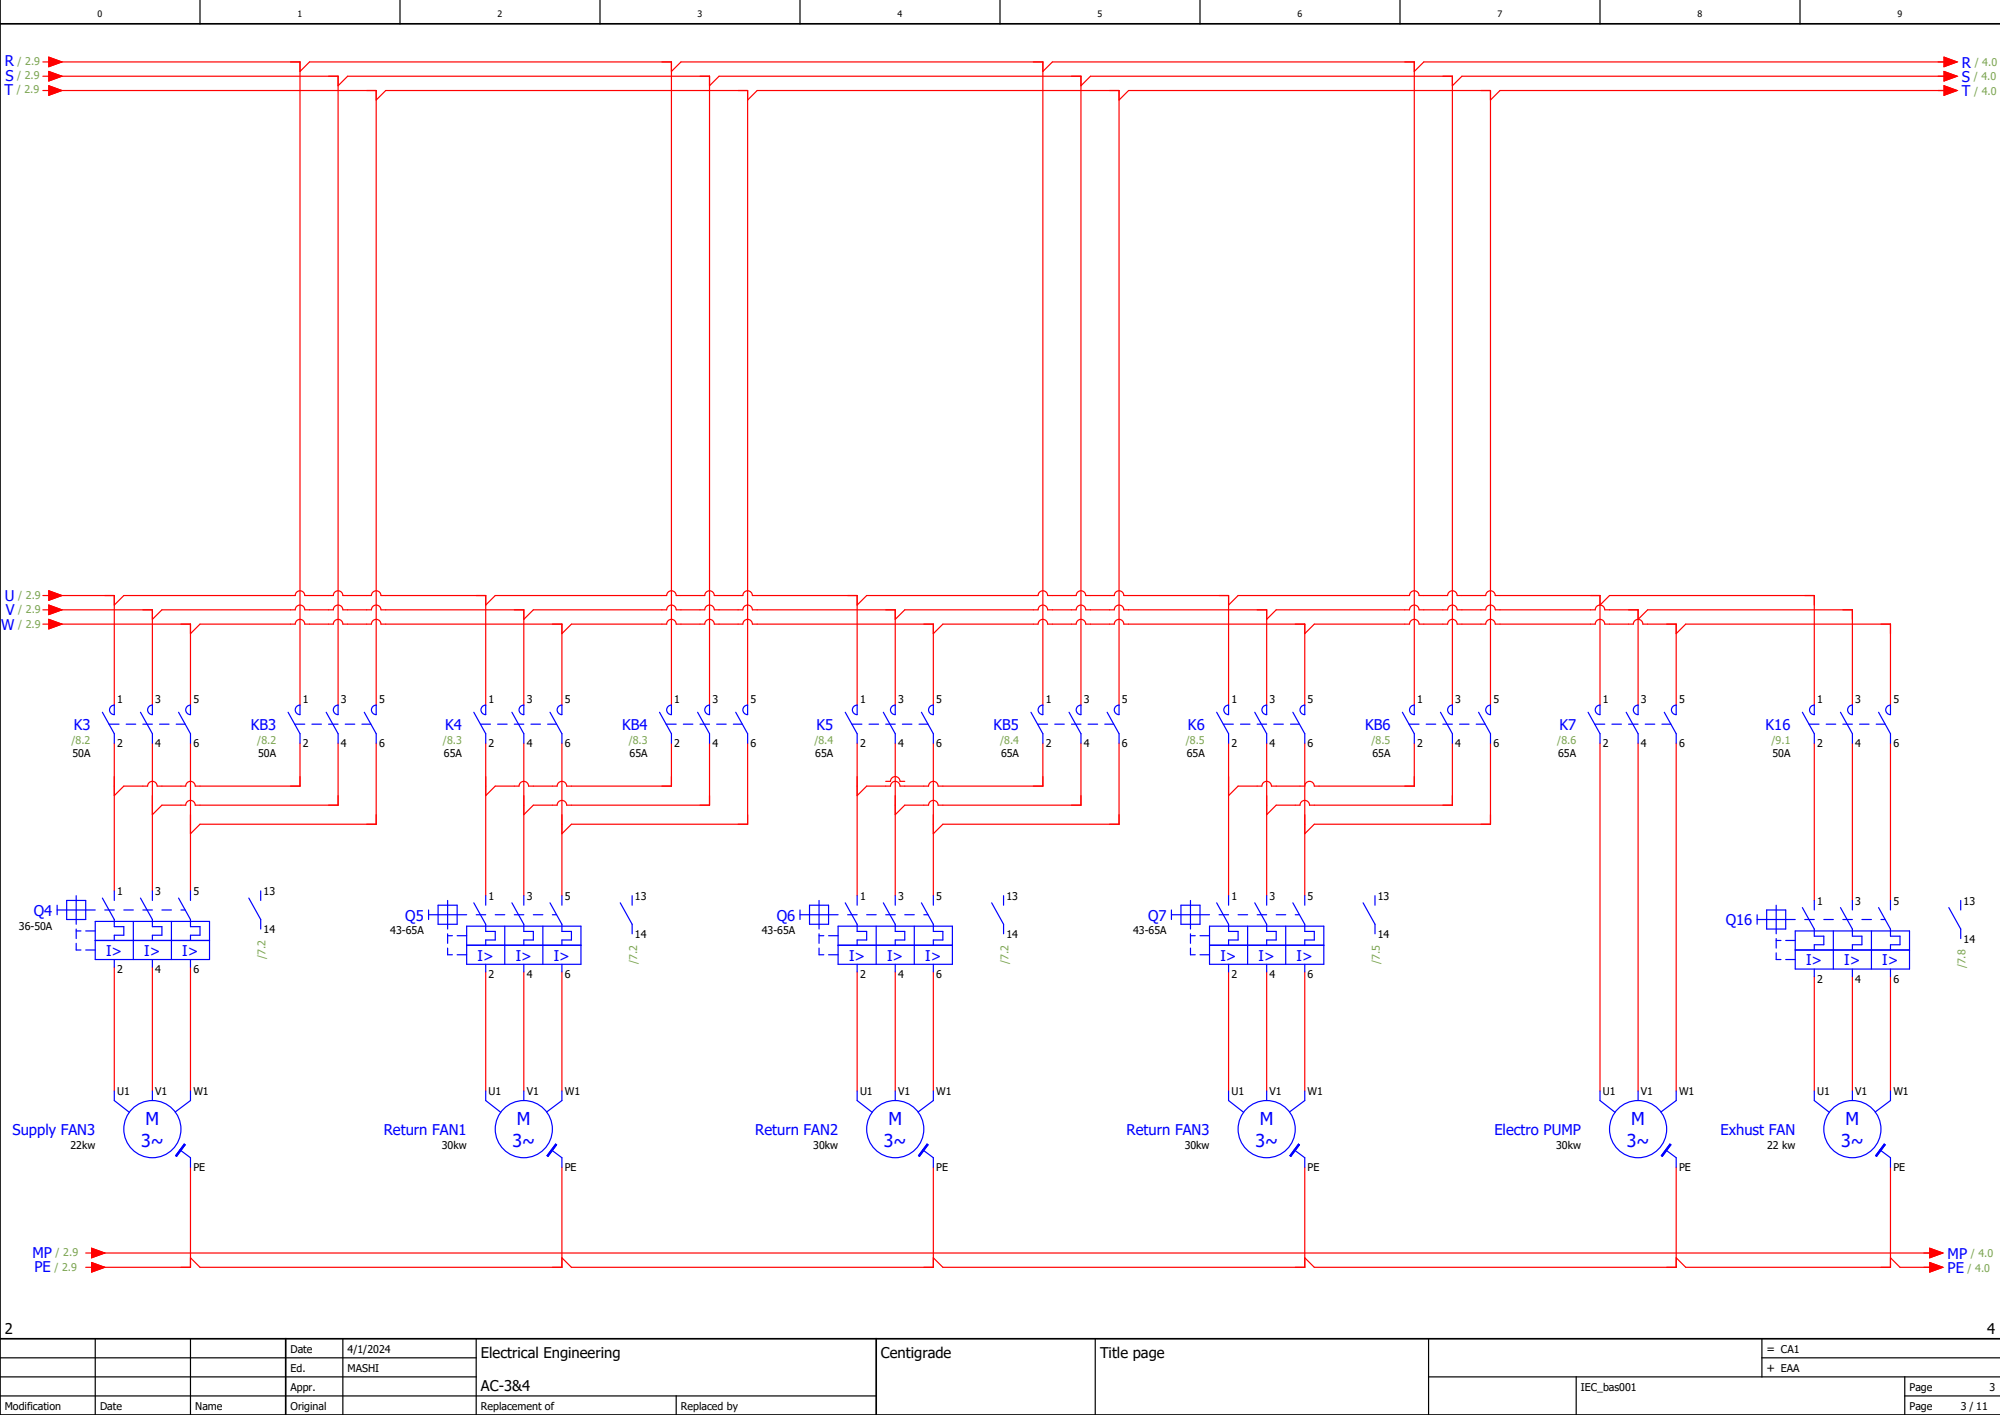
[picture p411: page 3]
Centigrade; Supply FAN3; Return FAN1; Return FAN2; Return FAN3; Electro PUMP; Exhust FAN

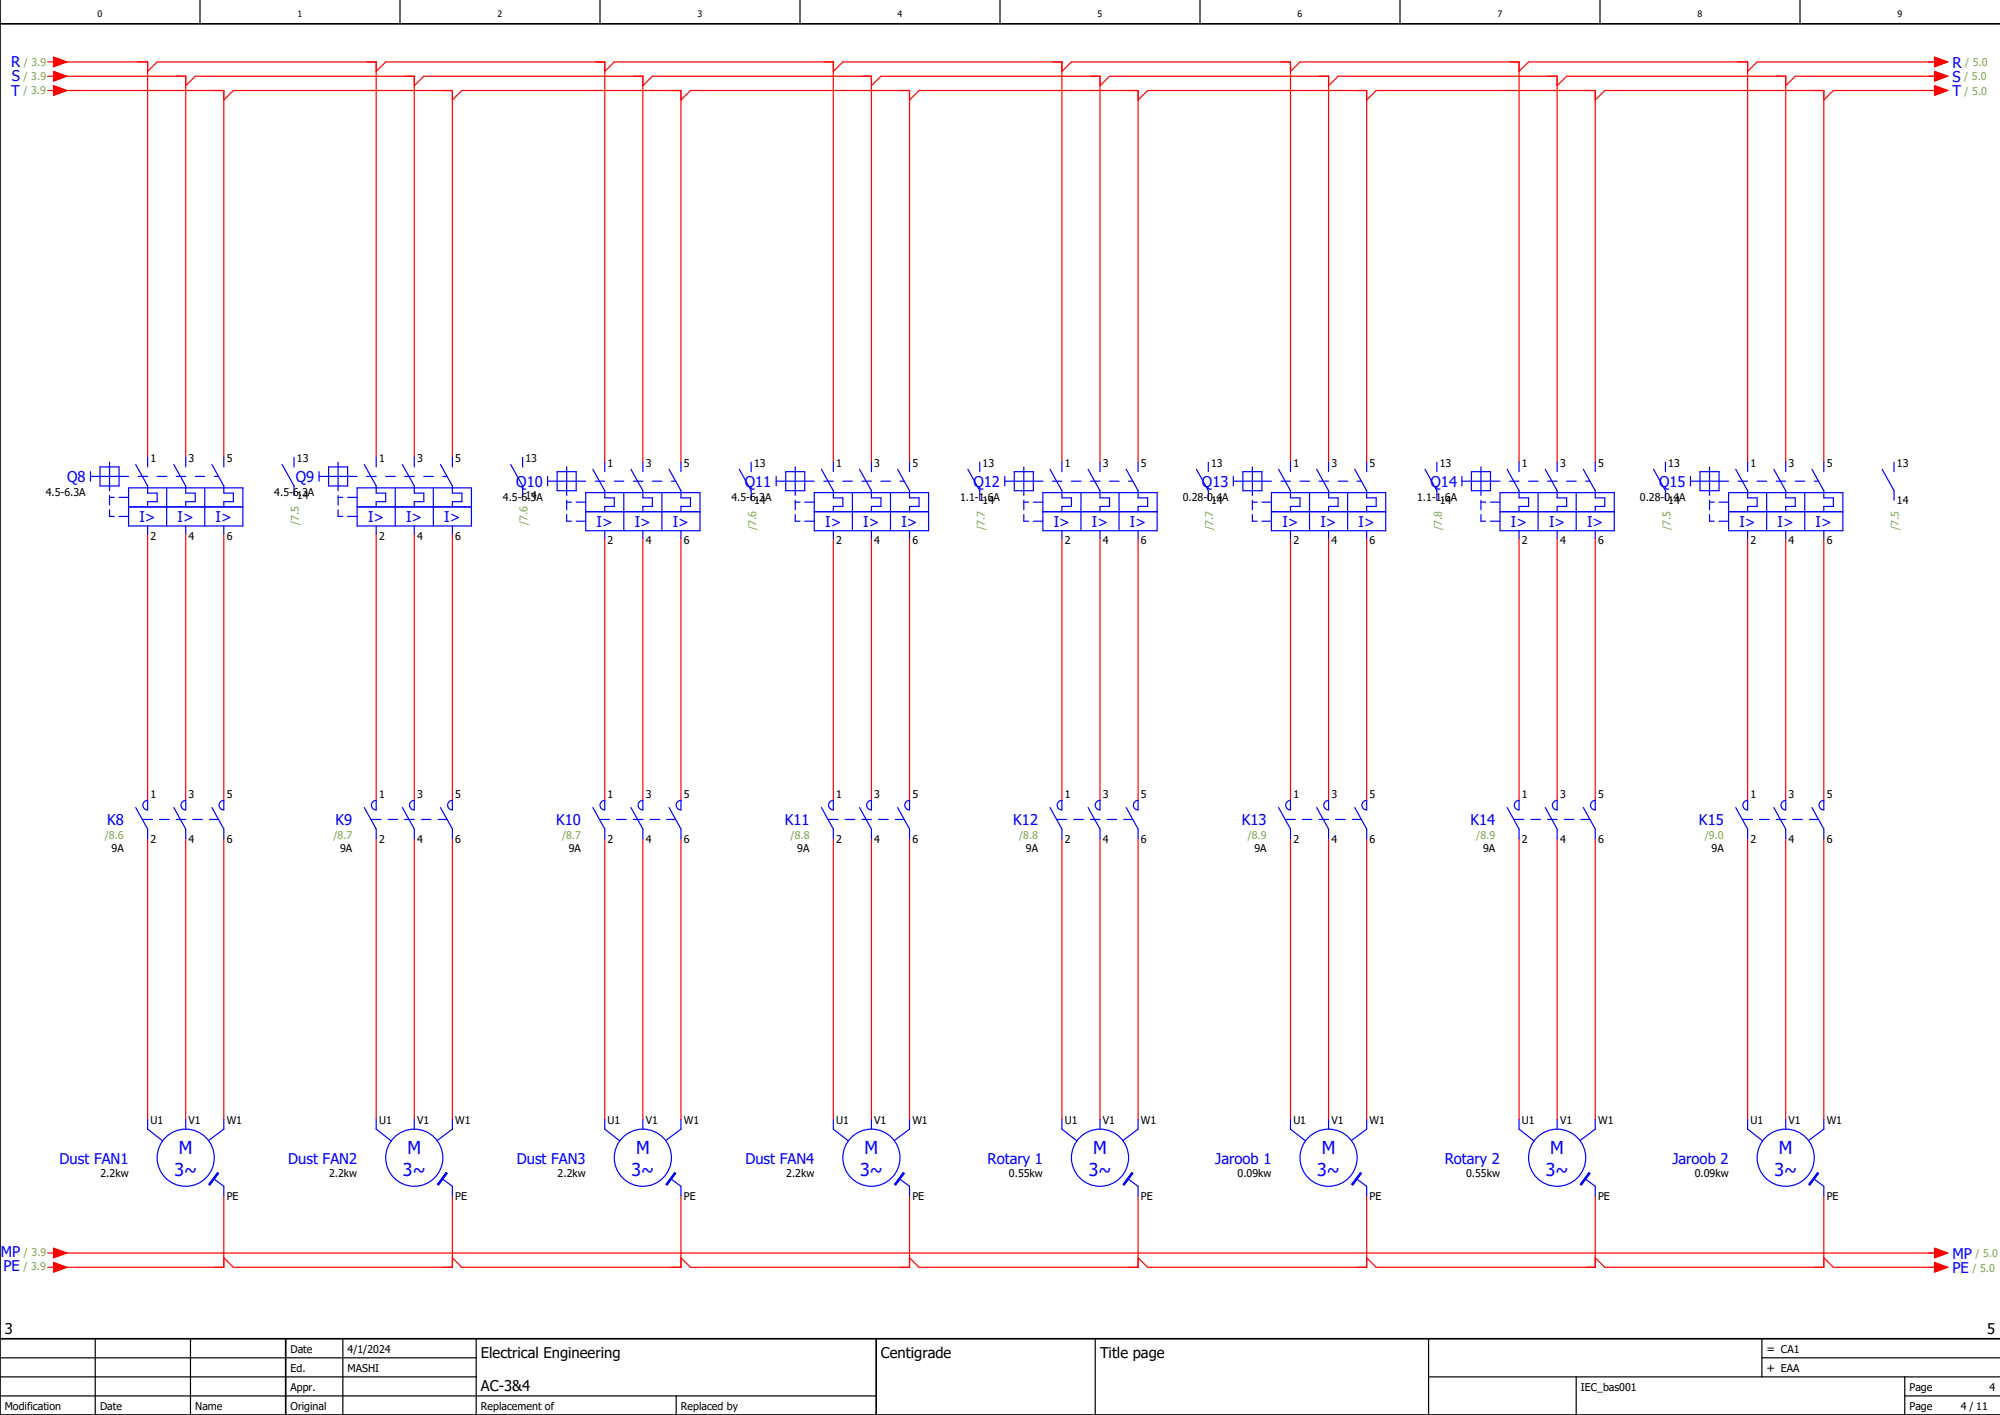
[picture p412: page 4]

F2

F3

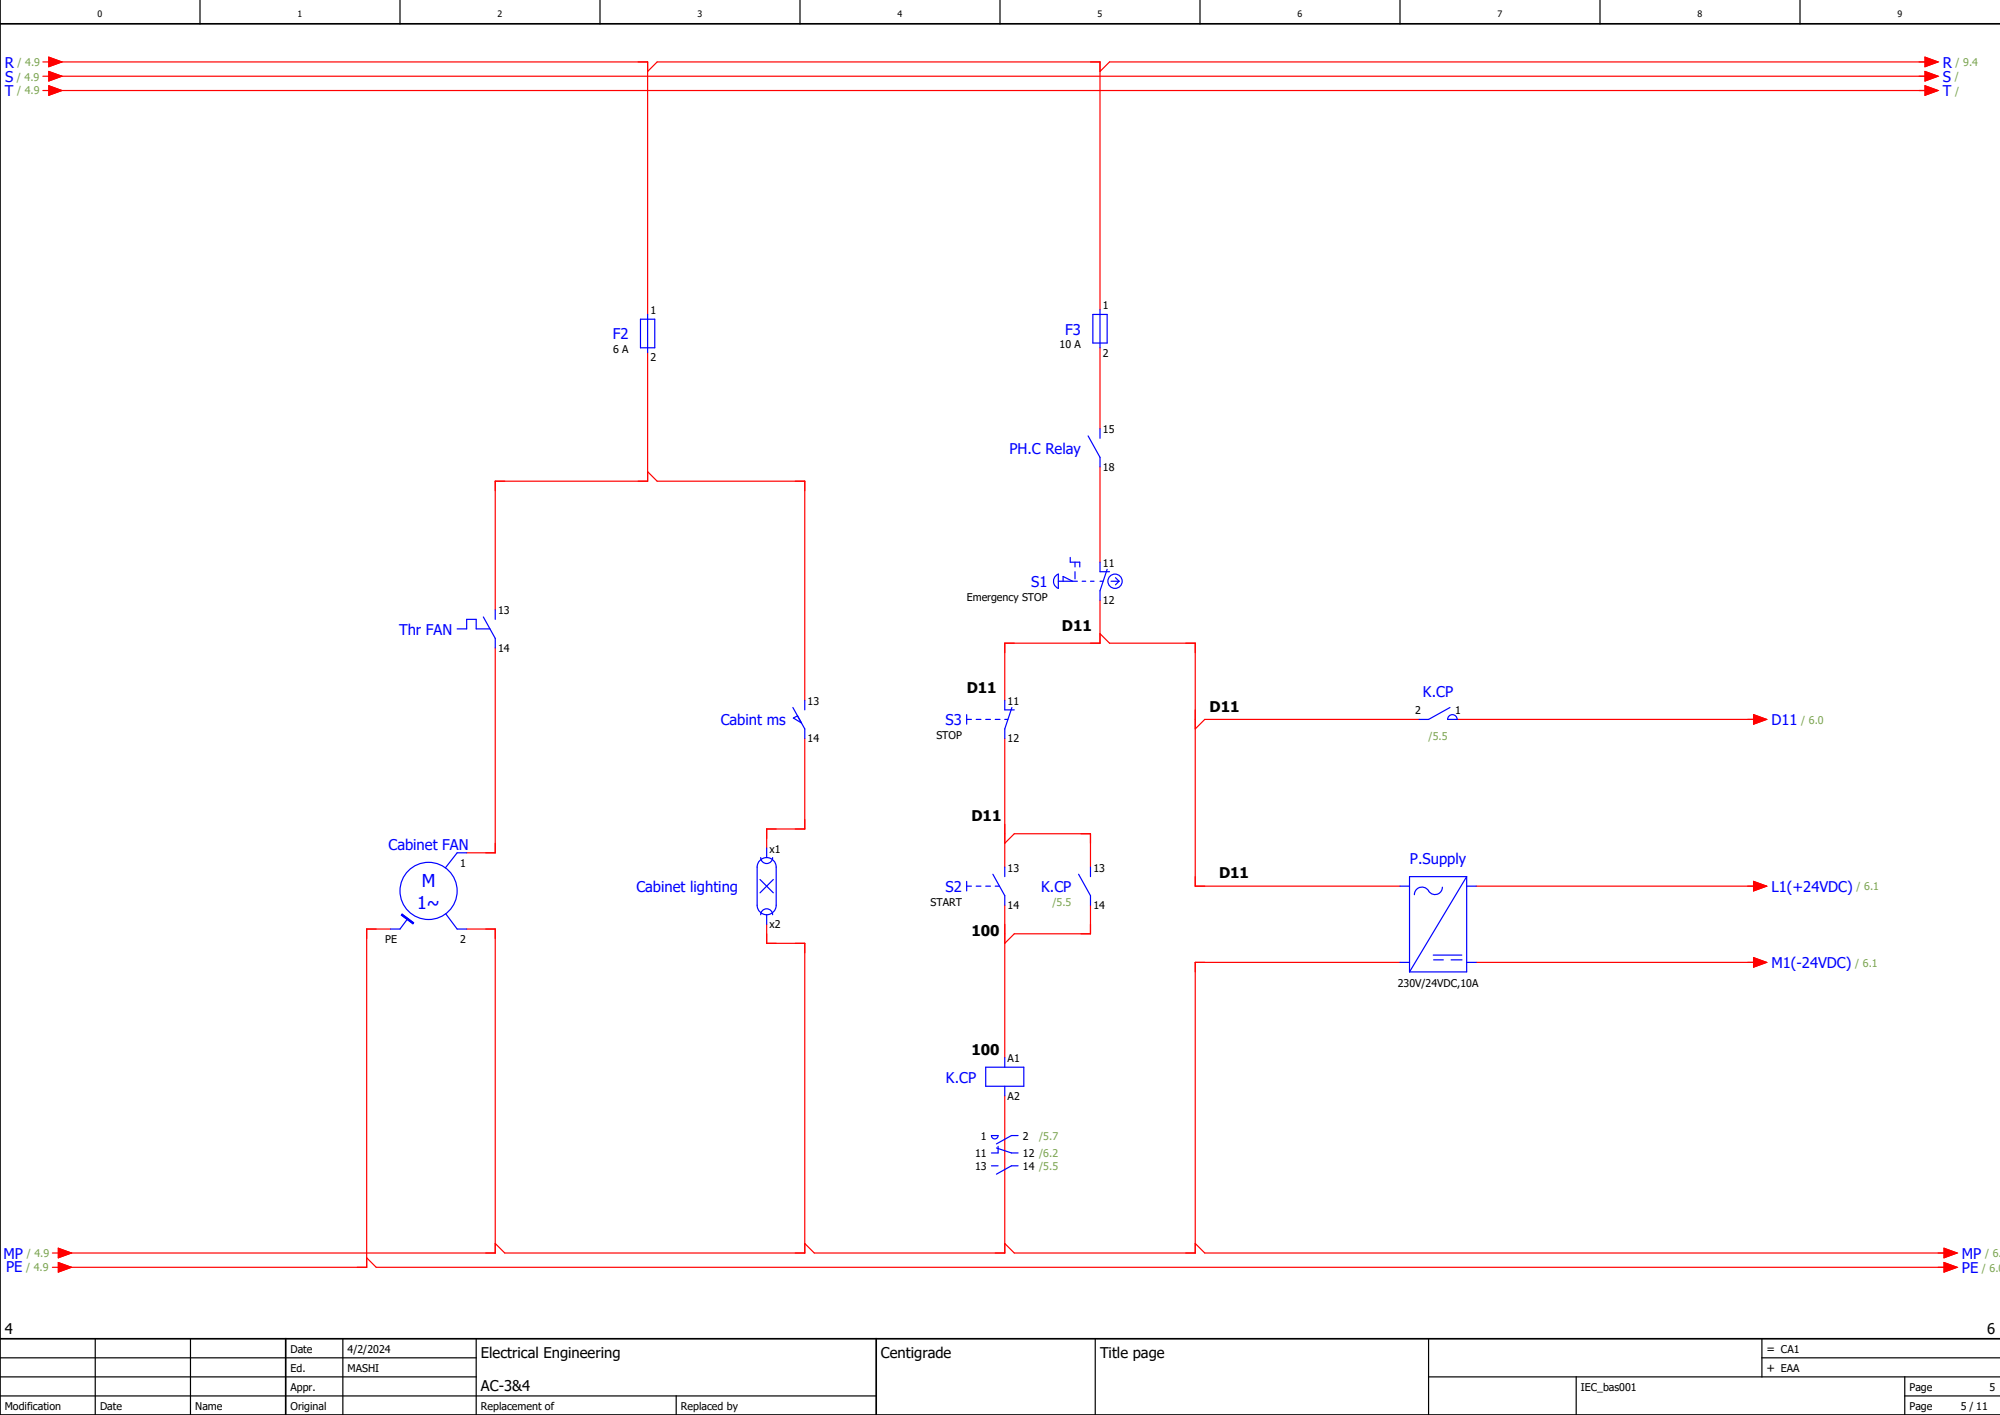
[picture p413: page 5]
Centigrade; Cabinet FAN; Cabinet lighting; Thr FAN; Cabint ms; Emergency STOP; PH.C Relay; START; STOP; P.Supply; 230V/24VDC,10A; L1(+24VDC) / 6.1; M1(-24VDC) / 6.1

X1 | X2 | X3 | X4 | X5 | X6 | X7 | X8 | X9 | X10 | X11 | X12 | X13 | X14 DRV⁻Fault
K7

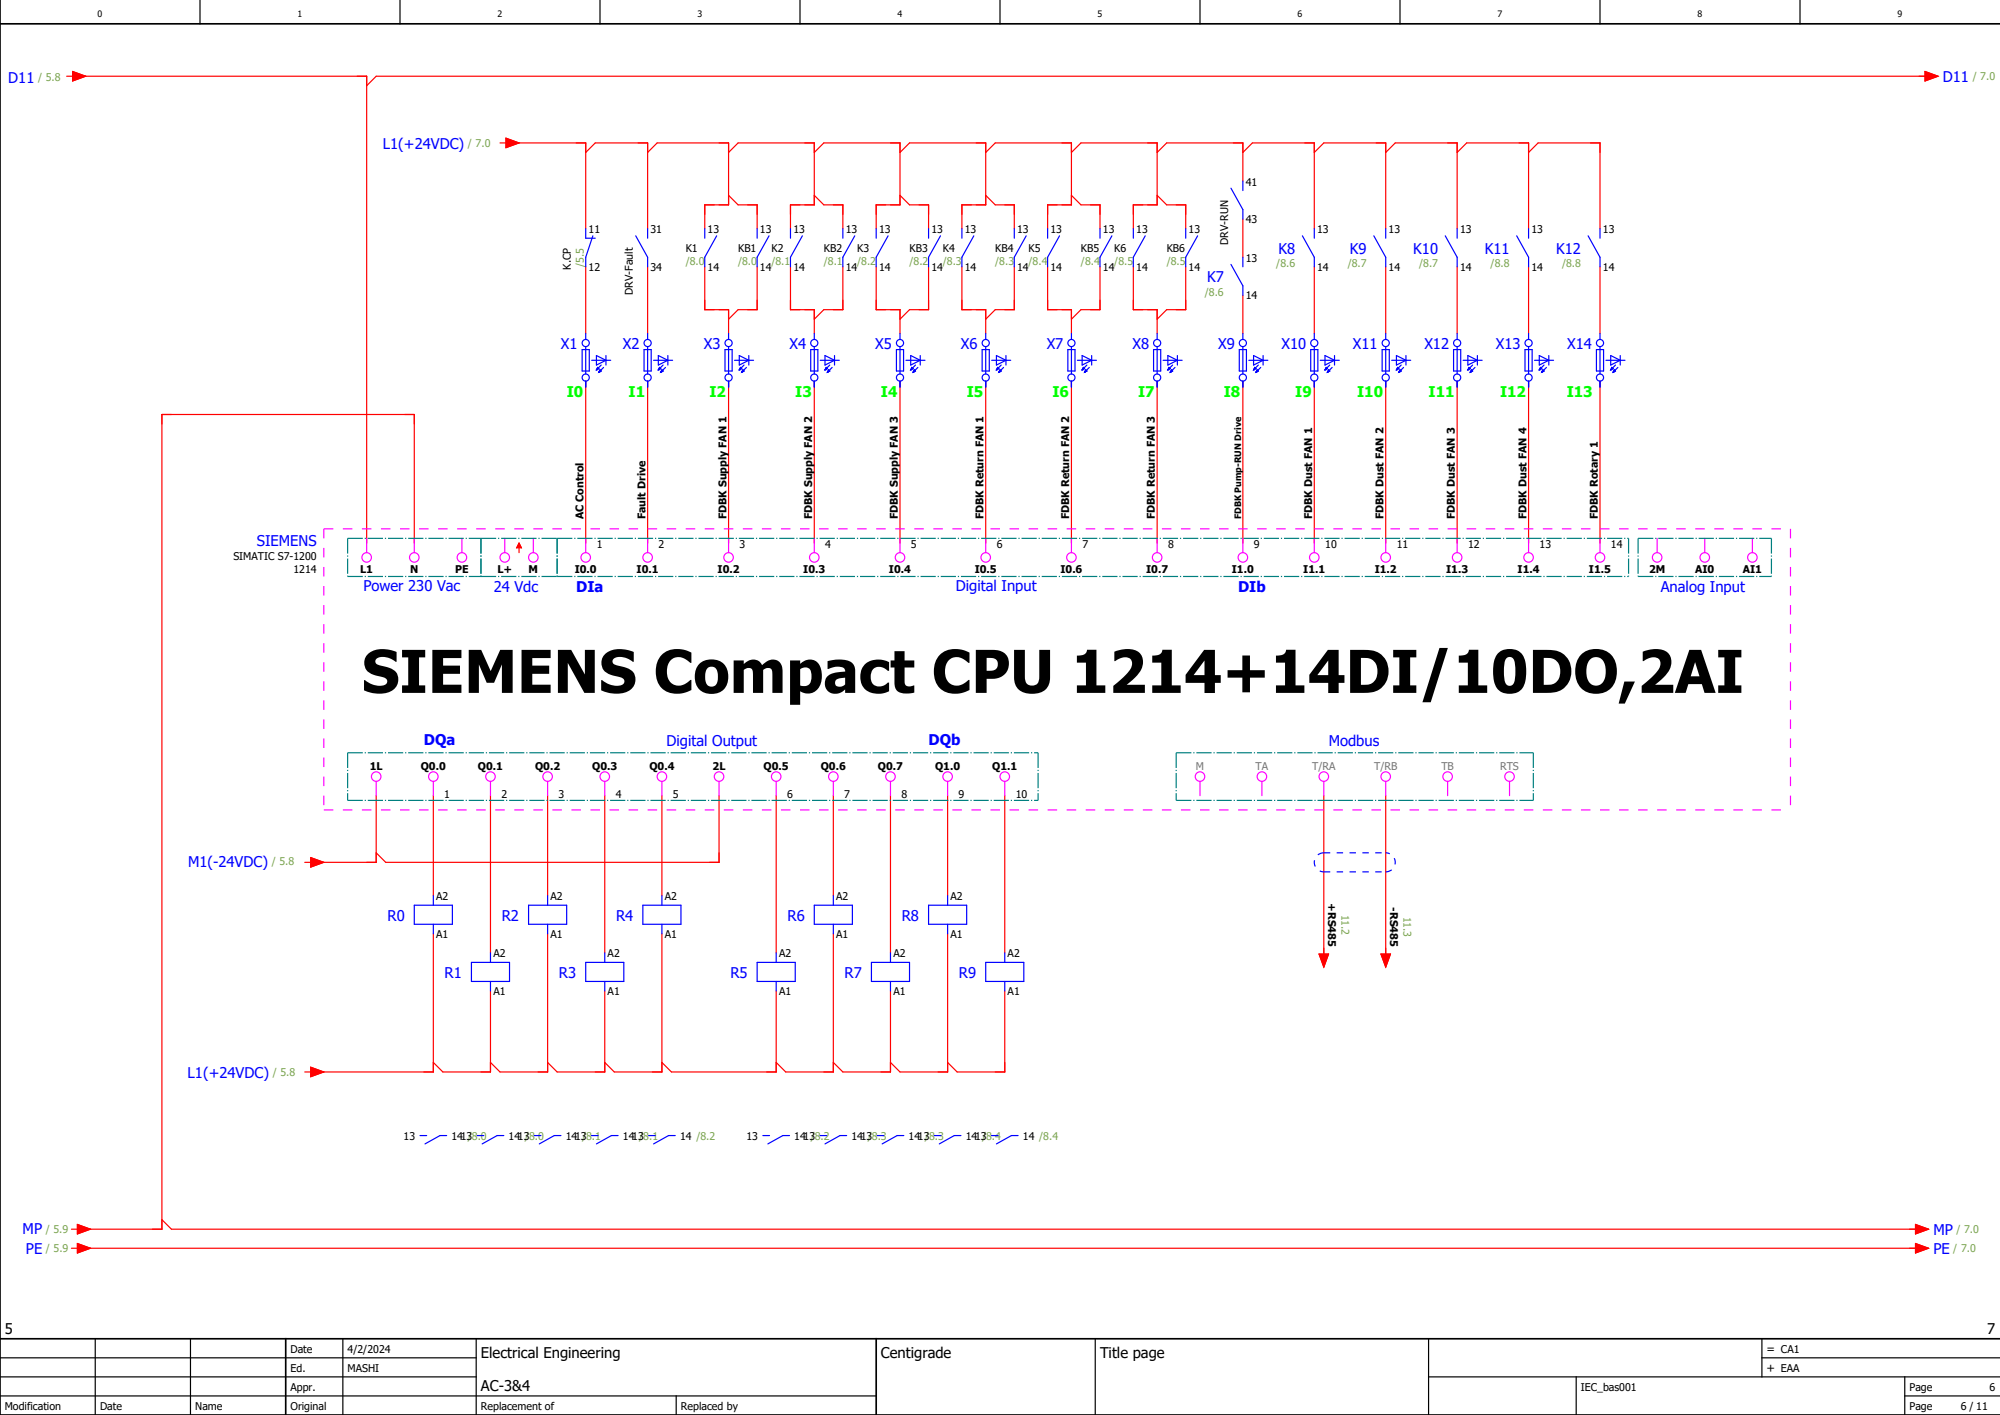
[picture p414: page 6]

FDBK Pump-RUN Drive

X31 | X32 | X33 | X34 | X35 | X36 | X37 | X38

K13

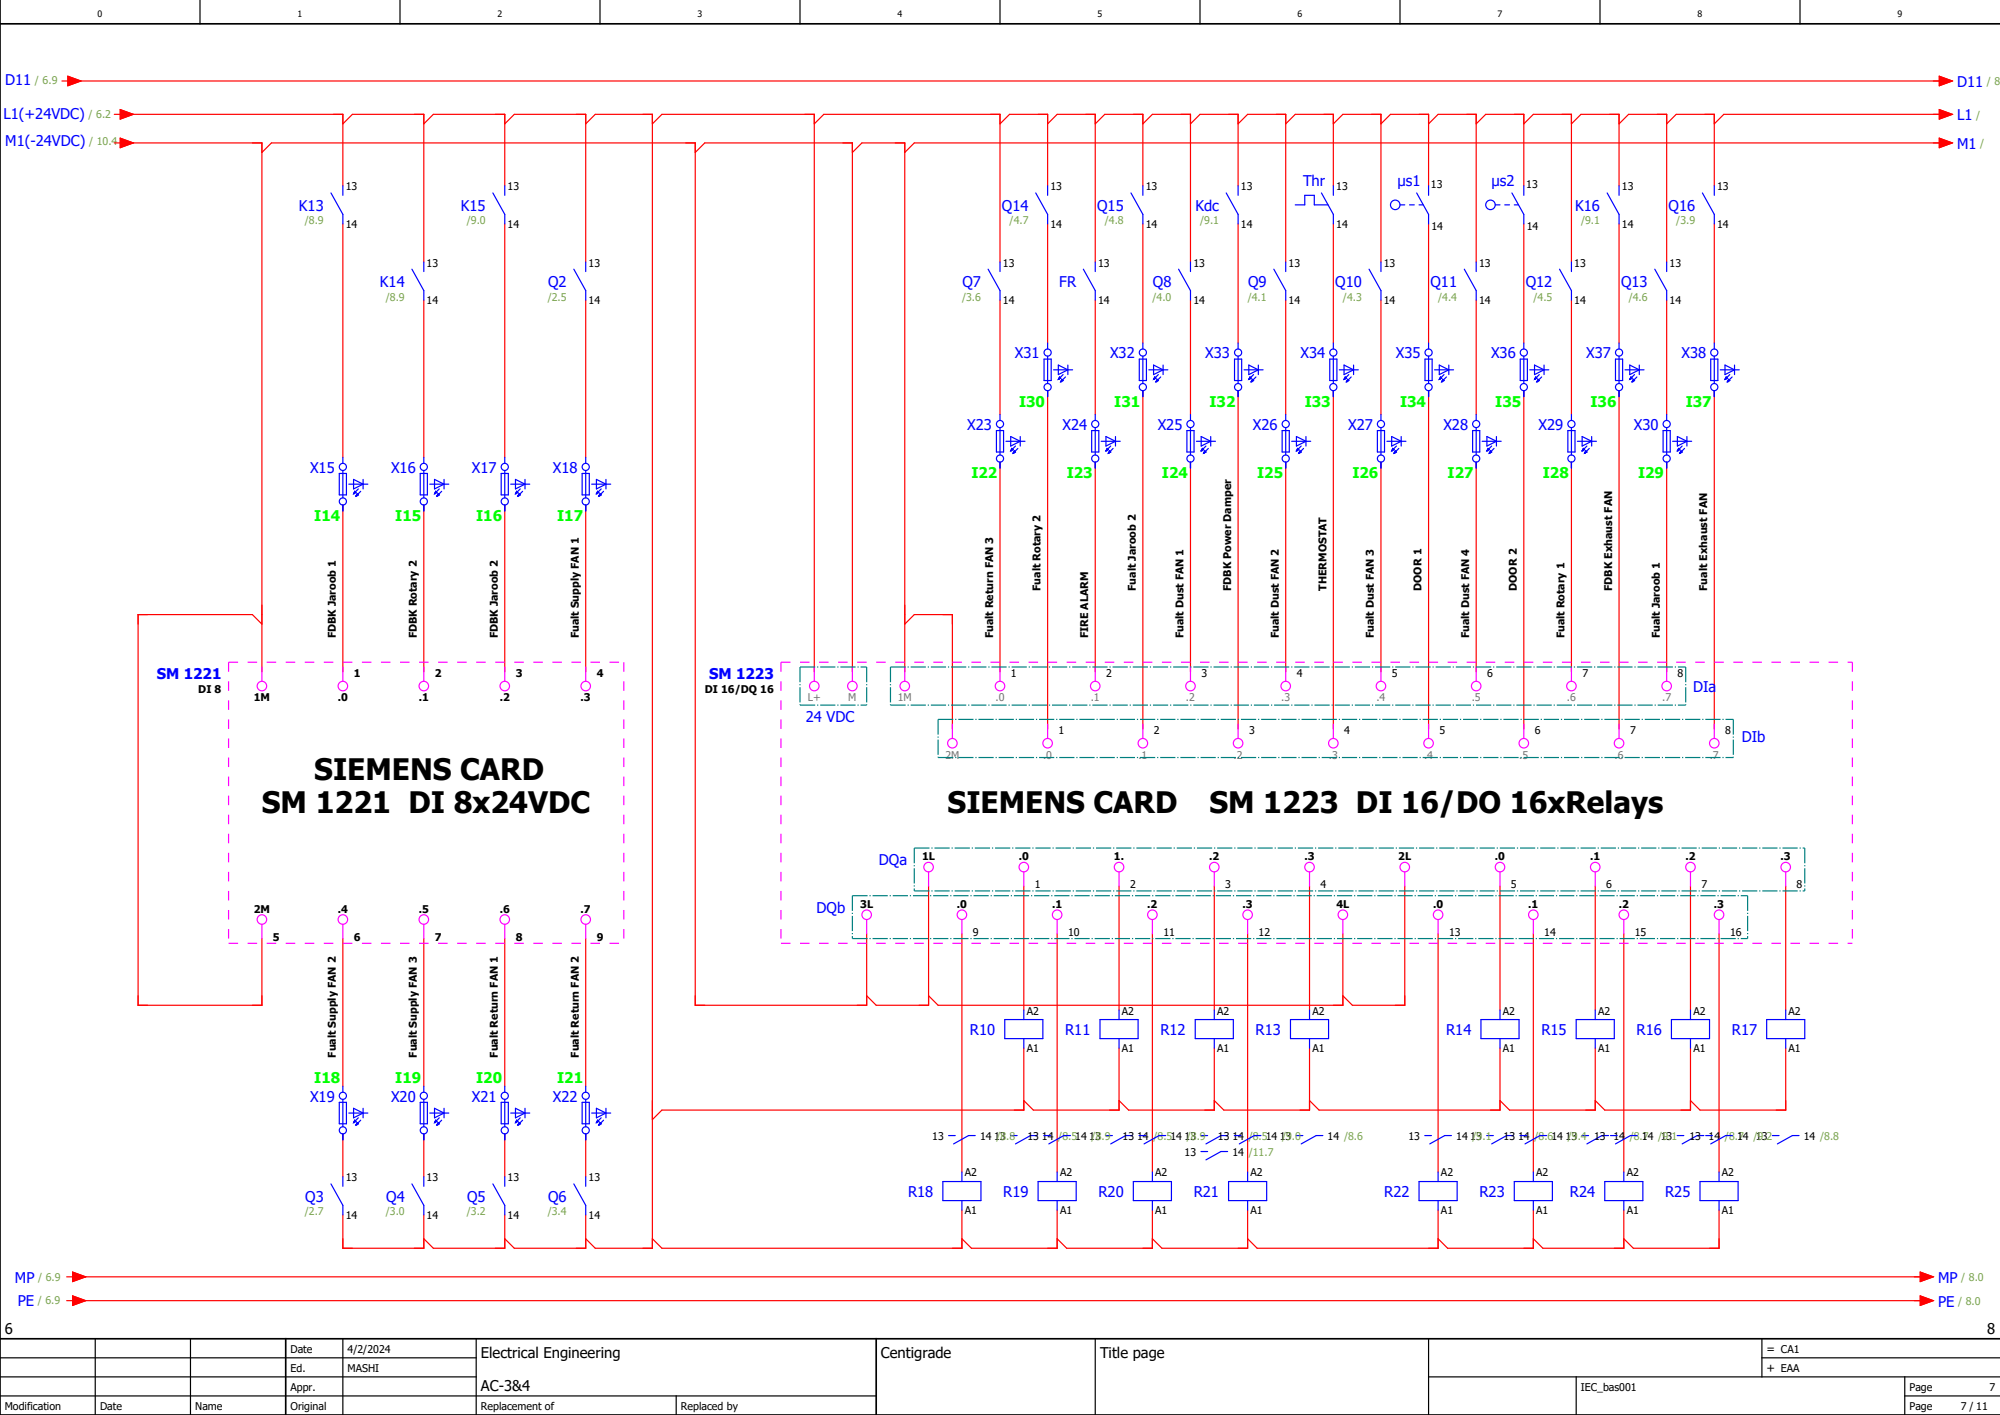
[picture p415: page 7]

R0

R1

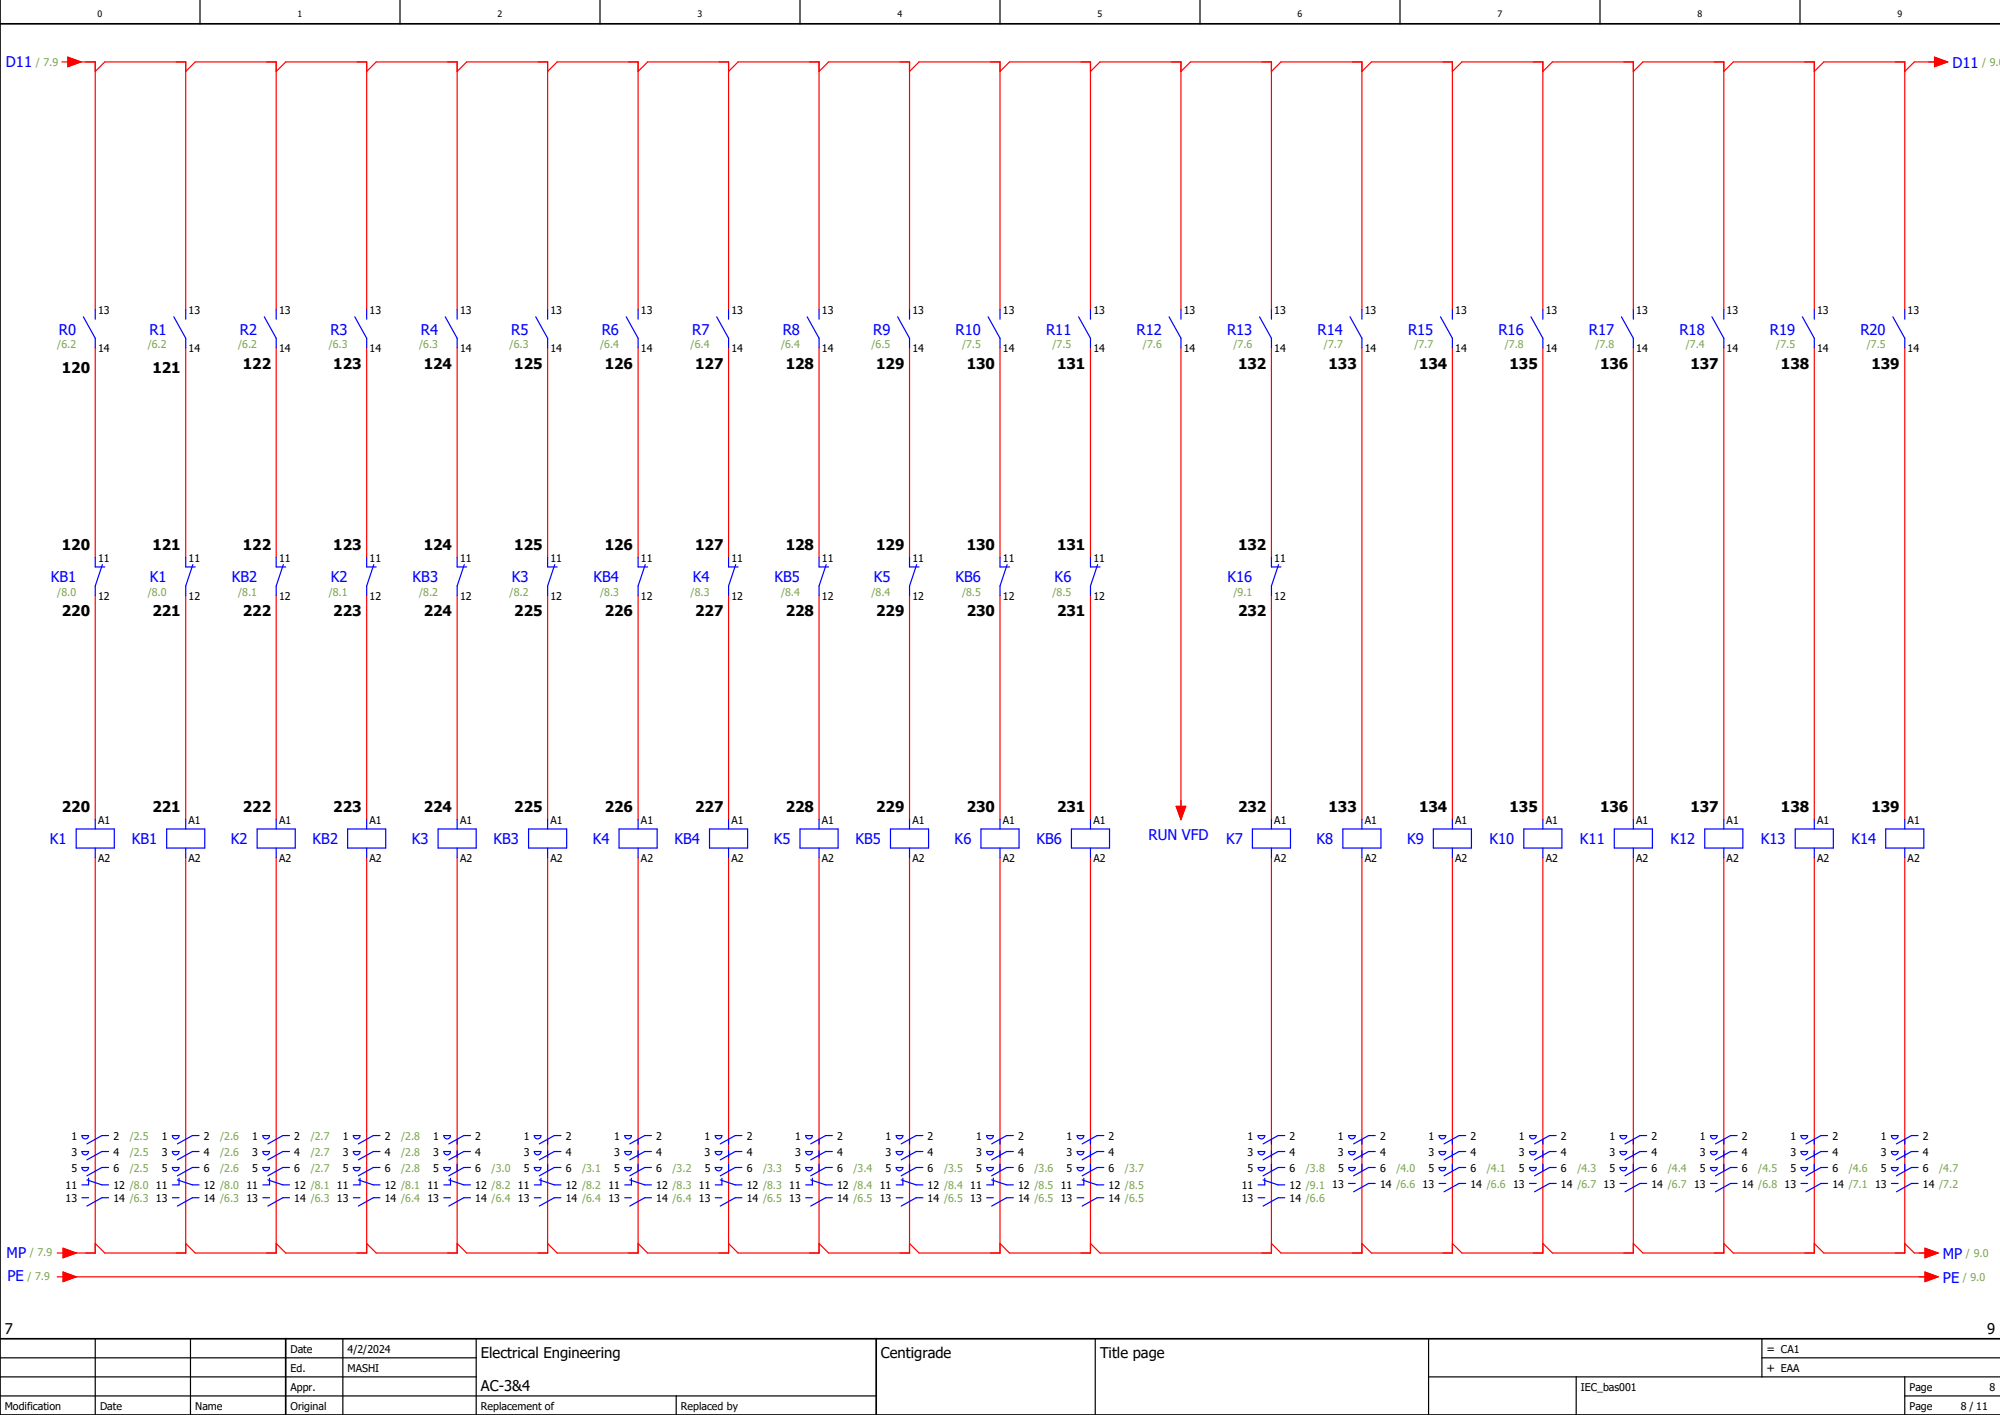
[picture p416: page 8]

D12

F4

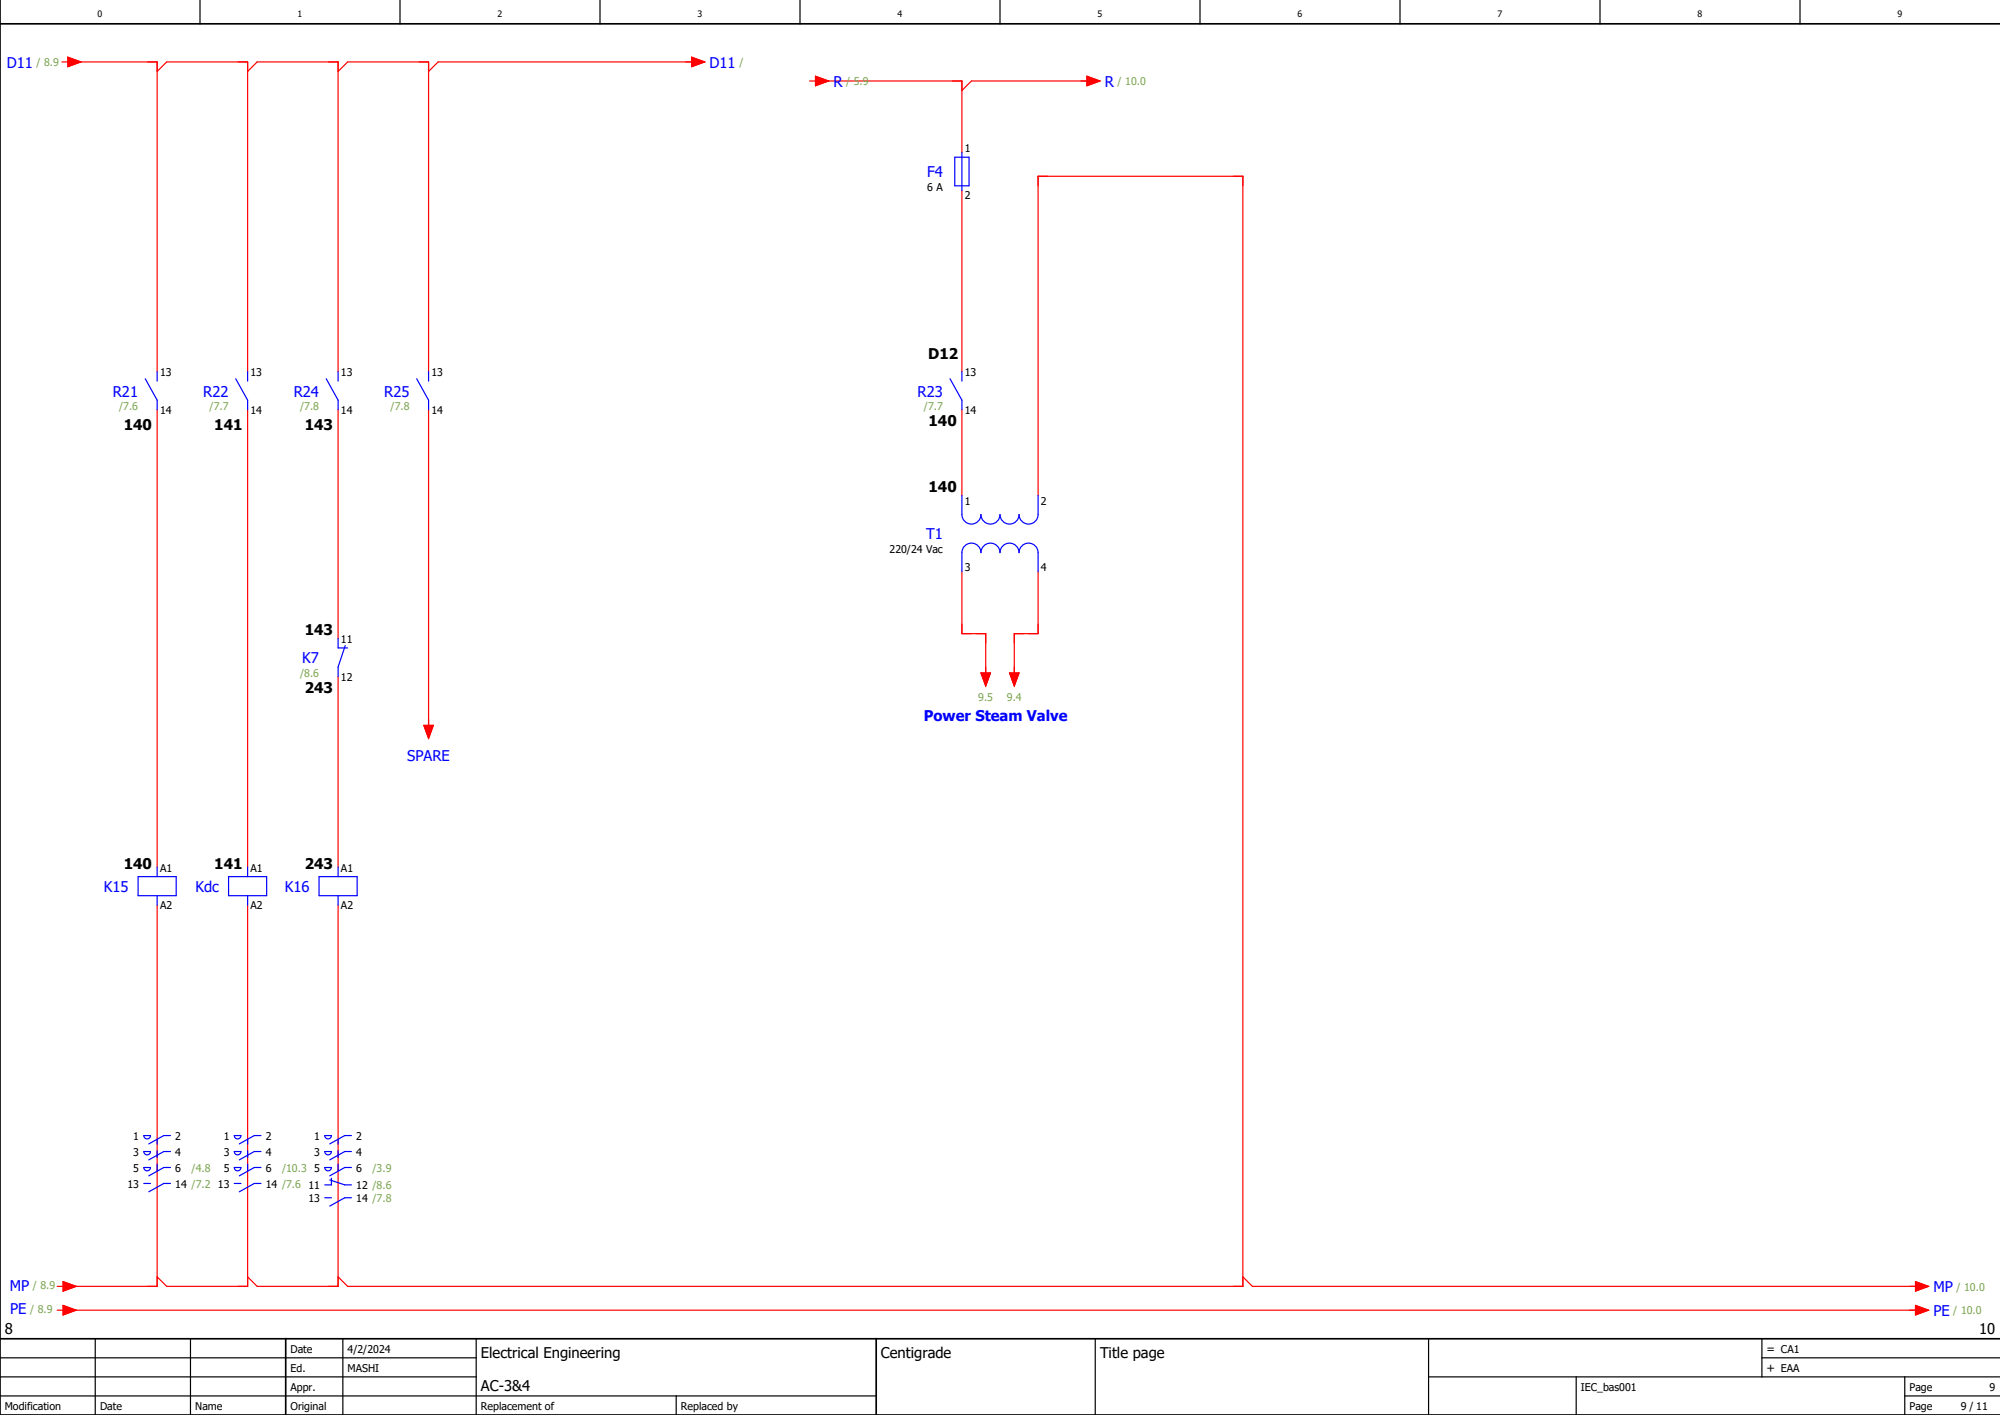
[picture p417: page 9]
Kdc; 220/24 Vac; SPARE

Power Steam Valve

F5

## L1(+24VDC) / 11.1

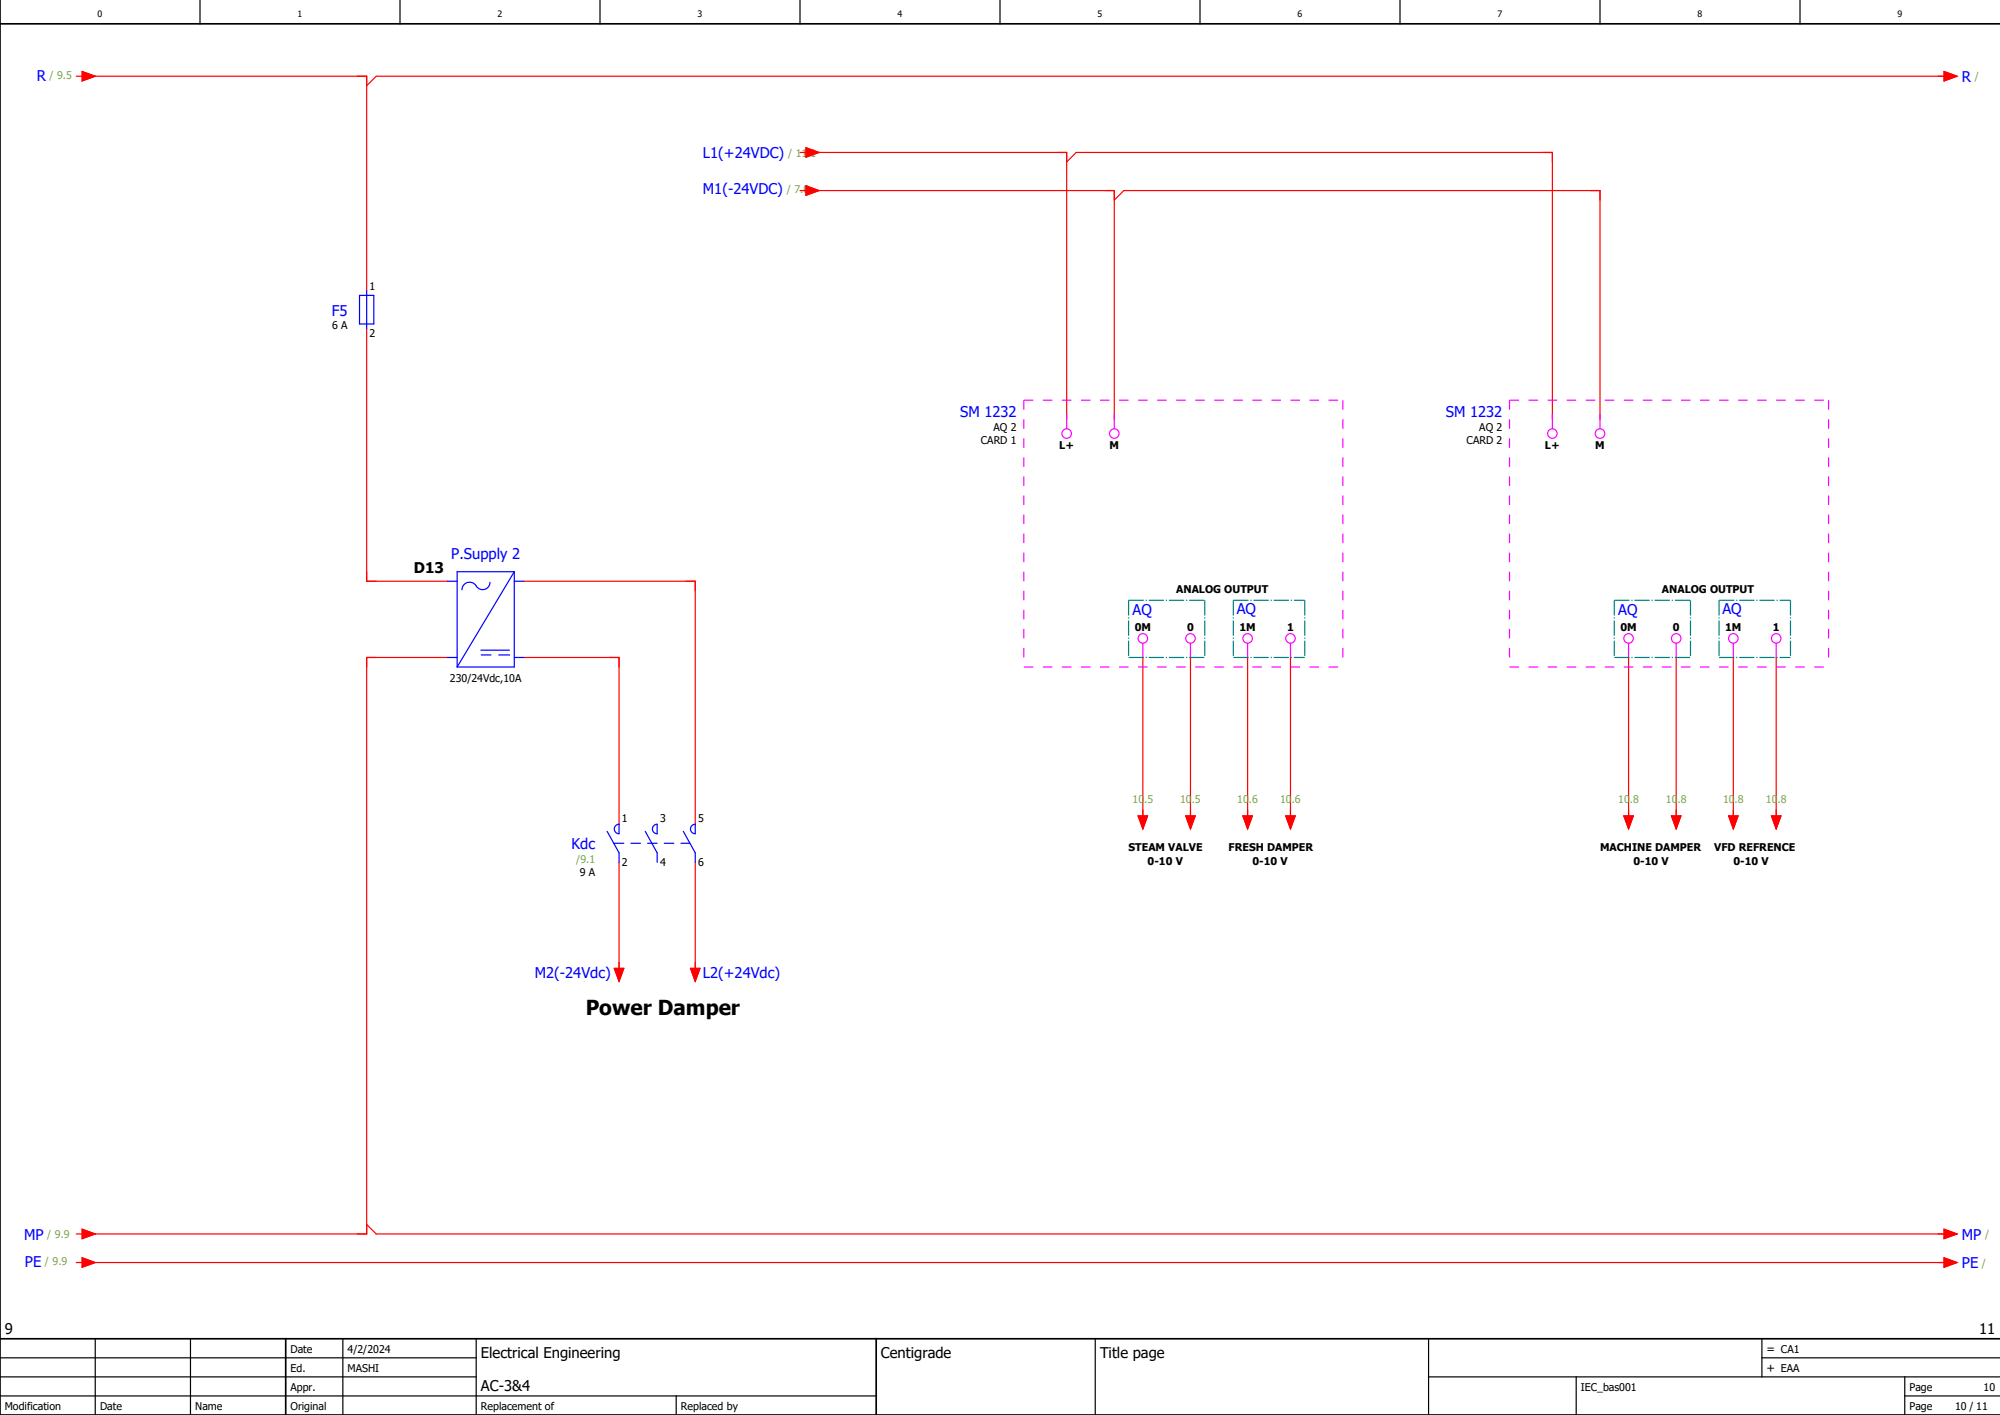
[picture p418: page 10]
Power Damper; ANALOG OUTPUT; STEAM VALVE; FRESH DAMPER; MACHINE DAMPER; VFD REFRENCE; P.Supply 2; 230/24Vdc,10A; Kdc; AQ 2 CARD 1; CARD 2 L+; M2(-24Vdc); L2(+24Vdc); M1(-24VDC) / 7.0

## From PLC Analog output card2

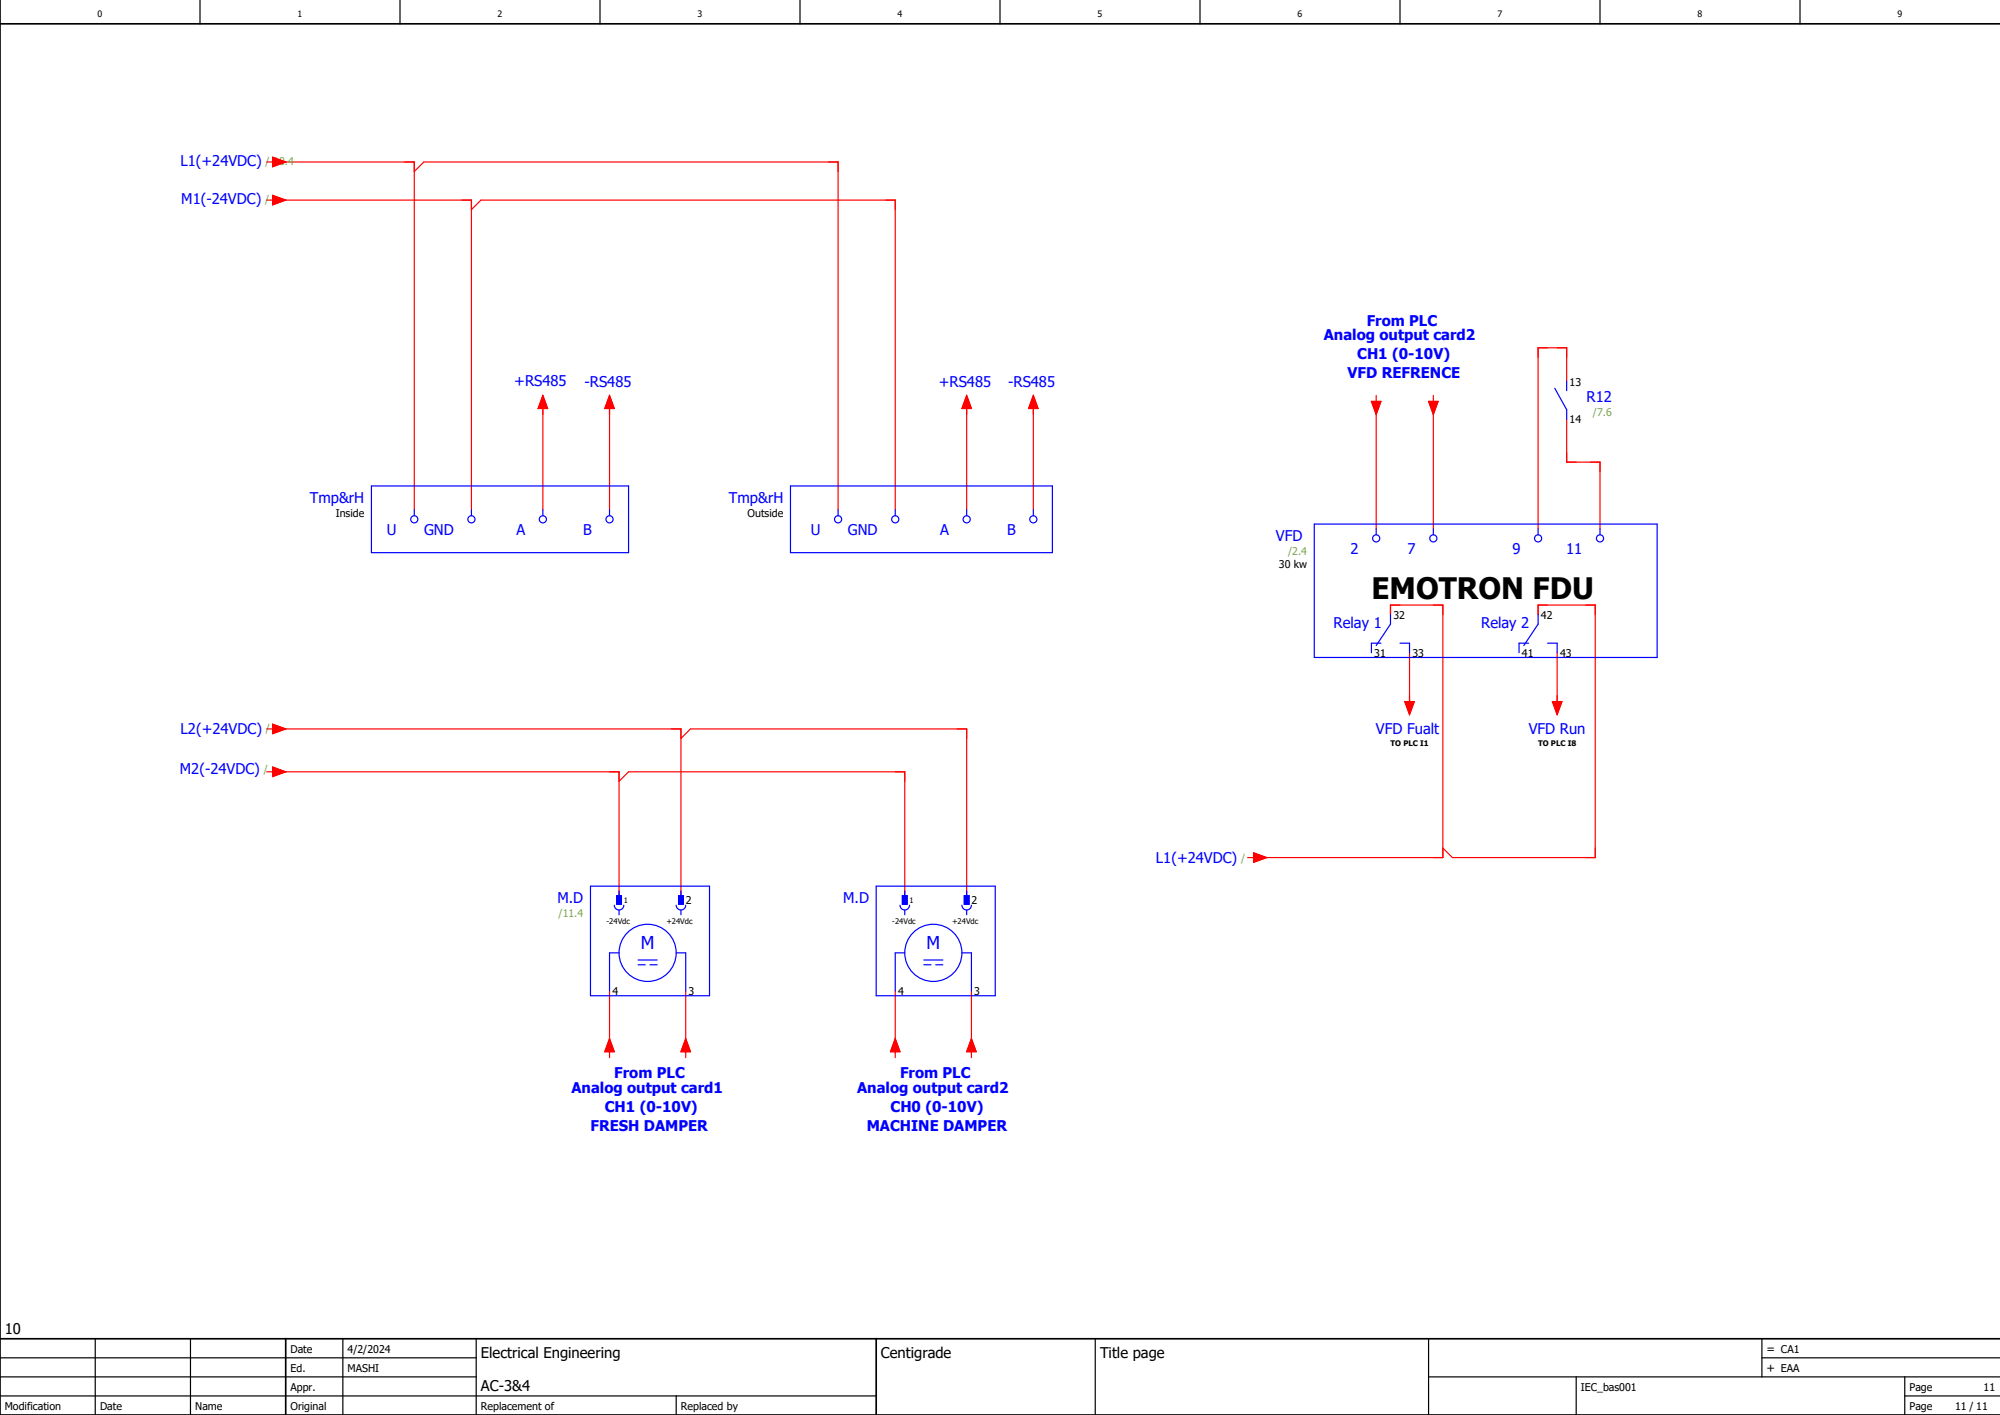
[picture p419: page 11]
From PLC Analog output card1 CH1 (0-10V) FRESH DAMPER; From PLC Analog output card2 CH0 (0-10V) MACHINE DAMPER; EMOTRON FDU; CH1 (0-10V) VFD REFRENCE; TO PLC I1; TO PLC I8; Tmp&rH; Inside; Outside; GND; -24Vdc; +24Vdc; VFD; Relay 2; Relay 1; L1(+24VDC) /; M1(-24VDC) /; L2(+24VDC) /; M2(-24VDC) /; VFD Fualt; VFD Run
