koalium/centidocs/elec/plc/Wiring diagram/10402-Razi/RAZI textile AC-1.pdf

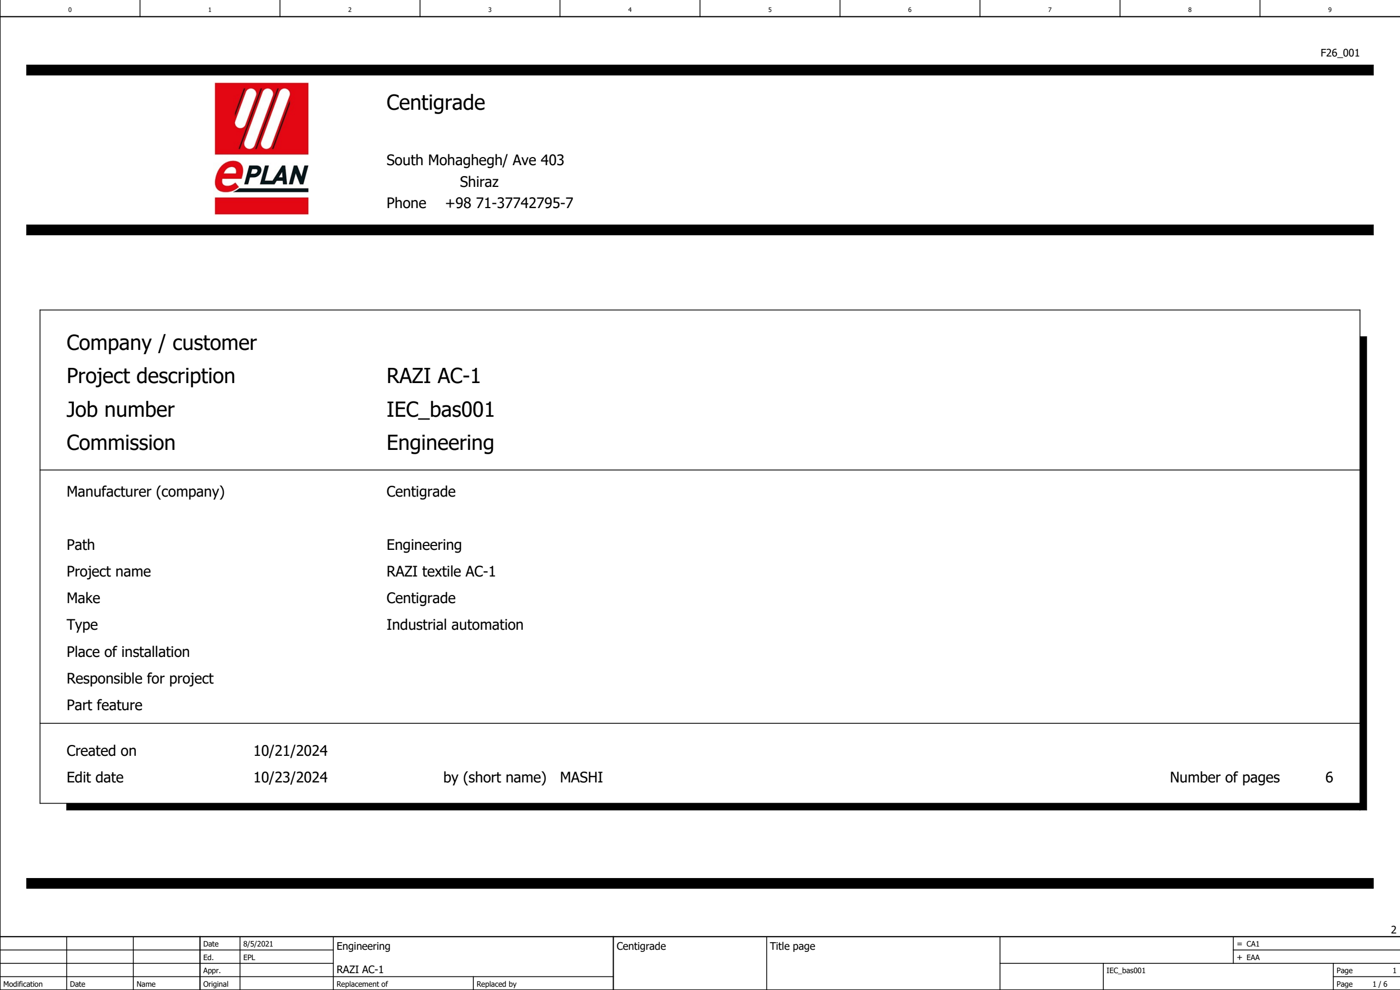
[picture p420: figure]
Page; RAZI AC-1; Original; IEC_bas001; Engineering; EPL; Date; Replaced by; EAA; Title page; Modification; Appr.; Replacement of; Centigrade; Name; Project description; Number of pages; Commission; Edit date; Created on; Job number; Make; MASHI; Part feature; South Mohaghegh/ Ave 403; Path; Industrial automation; Manufacturer (company); Project name; RAZI textile AC-1; Responsible for project; Phone; Type; Company / customer; Place of installation; by (short name); Shiraz

TF1 | TF2 | TF3

F2

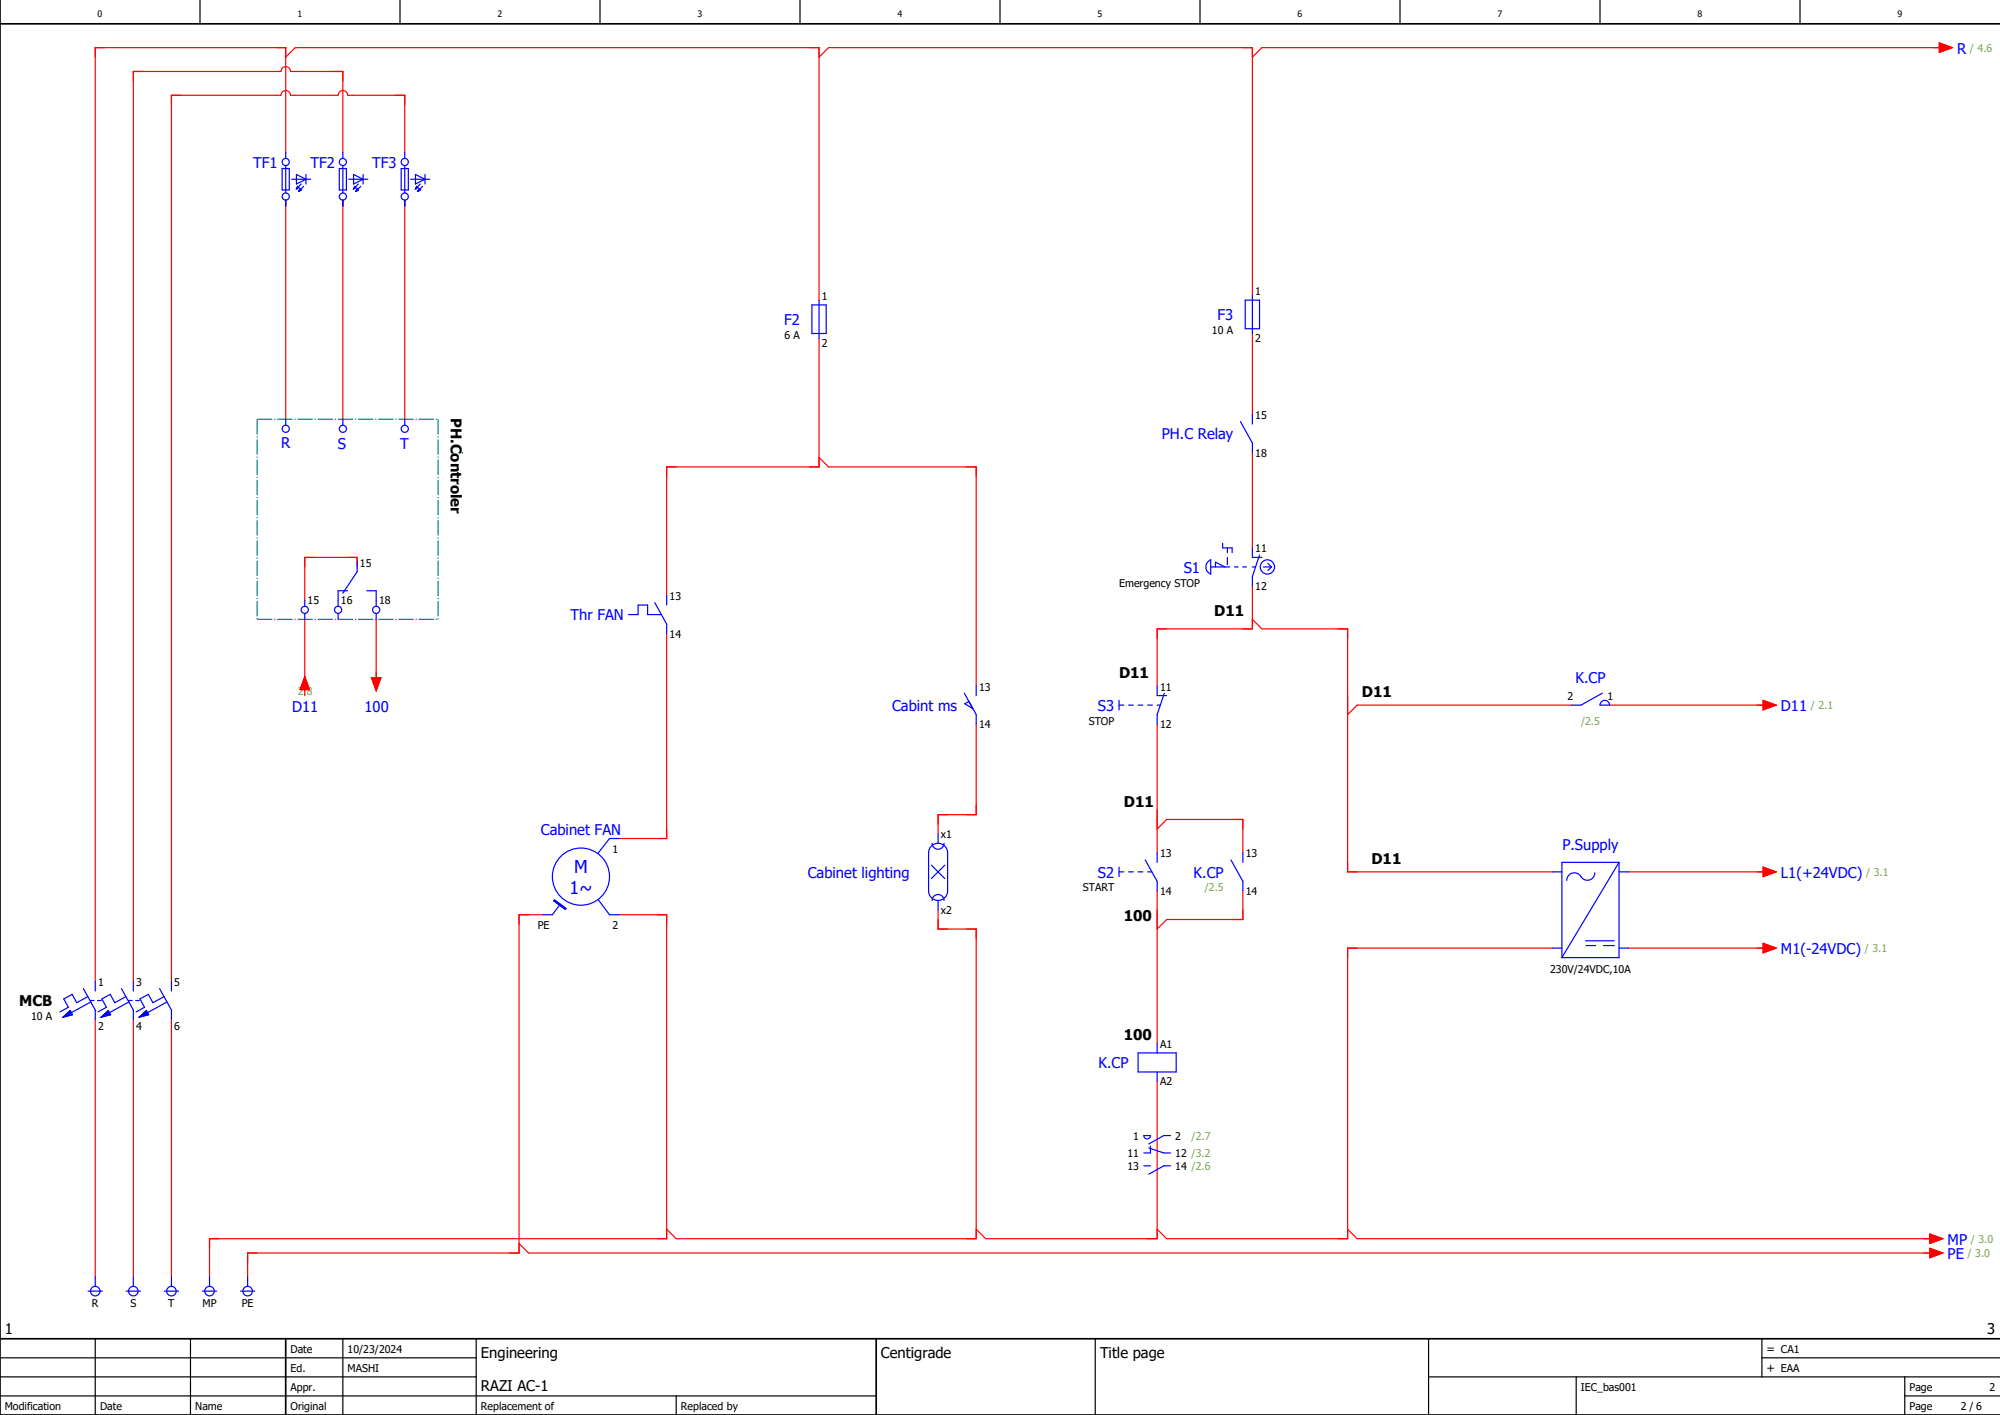
[picture p421: page 2]
MASHI; Centigrade; MCB; PH.Controler; Cabinet FAN; Cabinet lighting; Thr FAN; Cabint ms; Emergency STOP; PH.C Relay; START; STOP; P.Supply; 230V/24VDC,10A; L1(+24VDC) / 3.1; M1(-24VDC) / 3.1

X1 | X2 | X3 | X4 | X5 | X6 | X7 | X8 | X9 | X10 | X11 | X12 | X13 | X14 DRV⁻Fault

K1

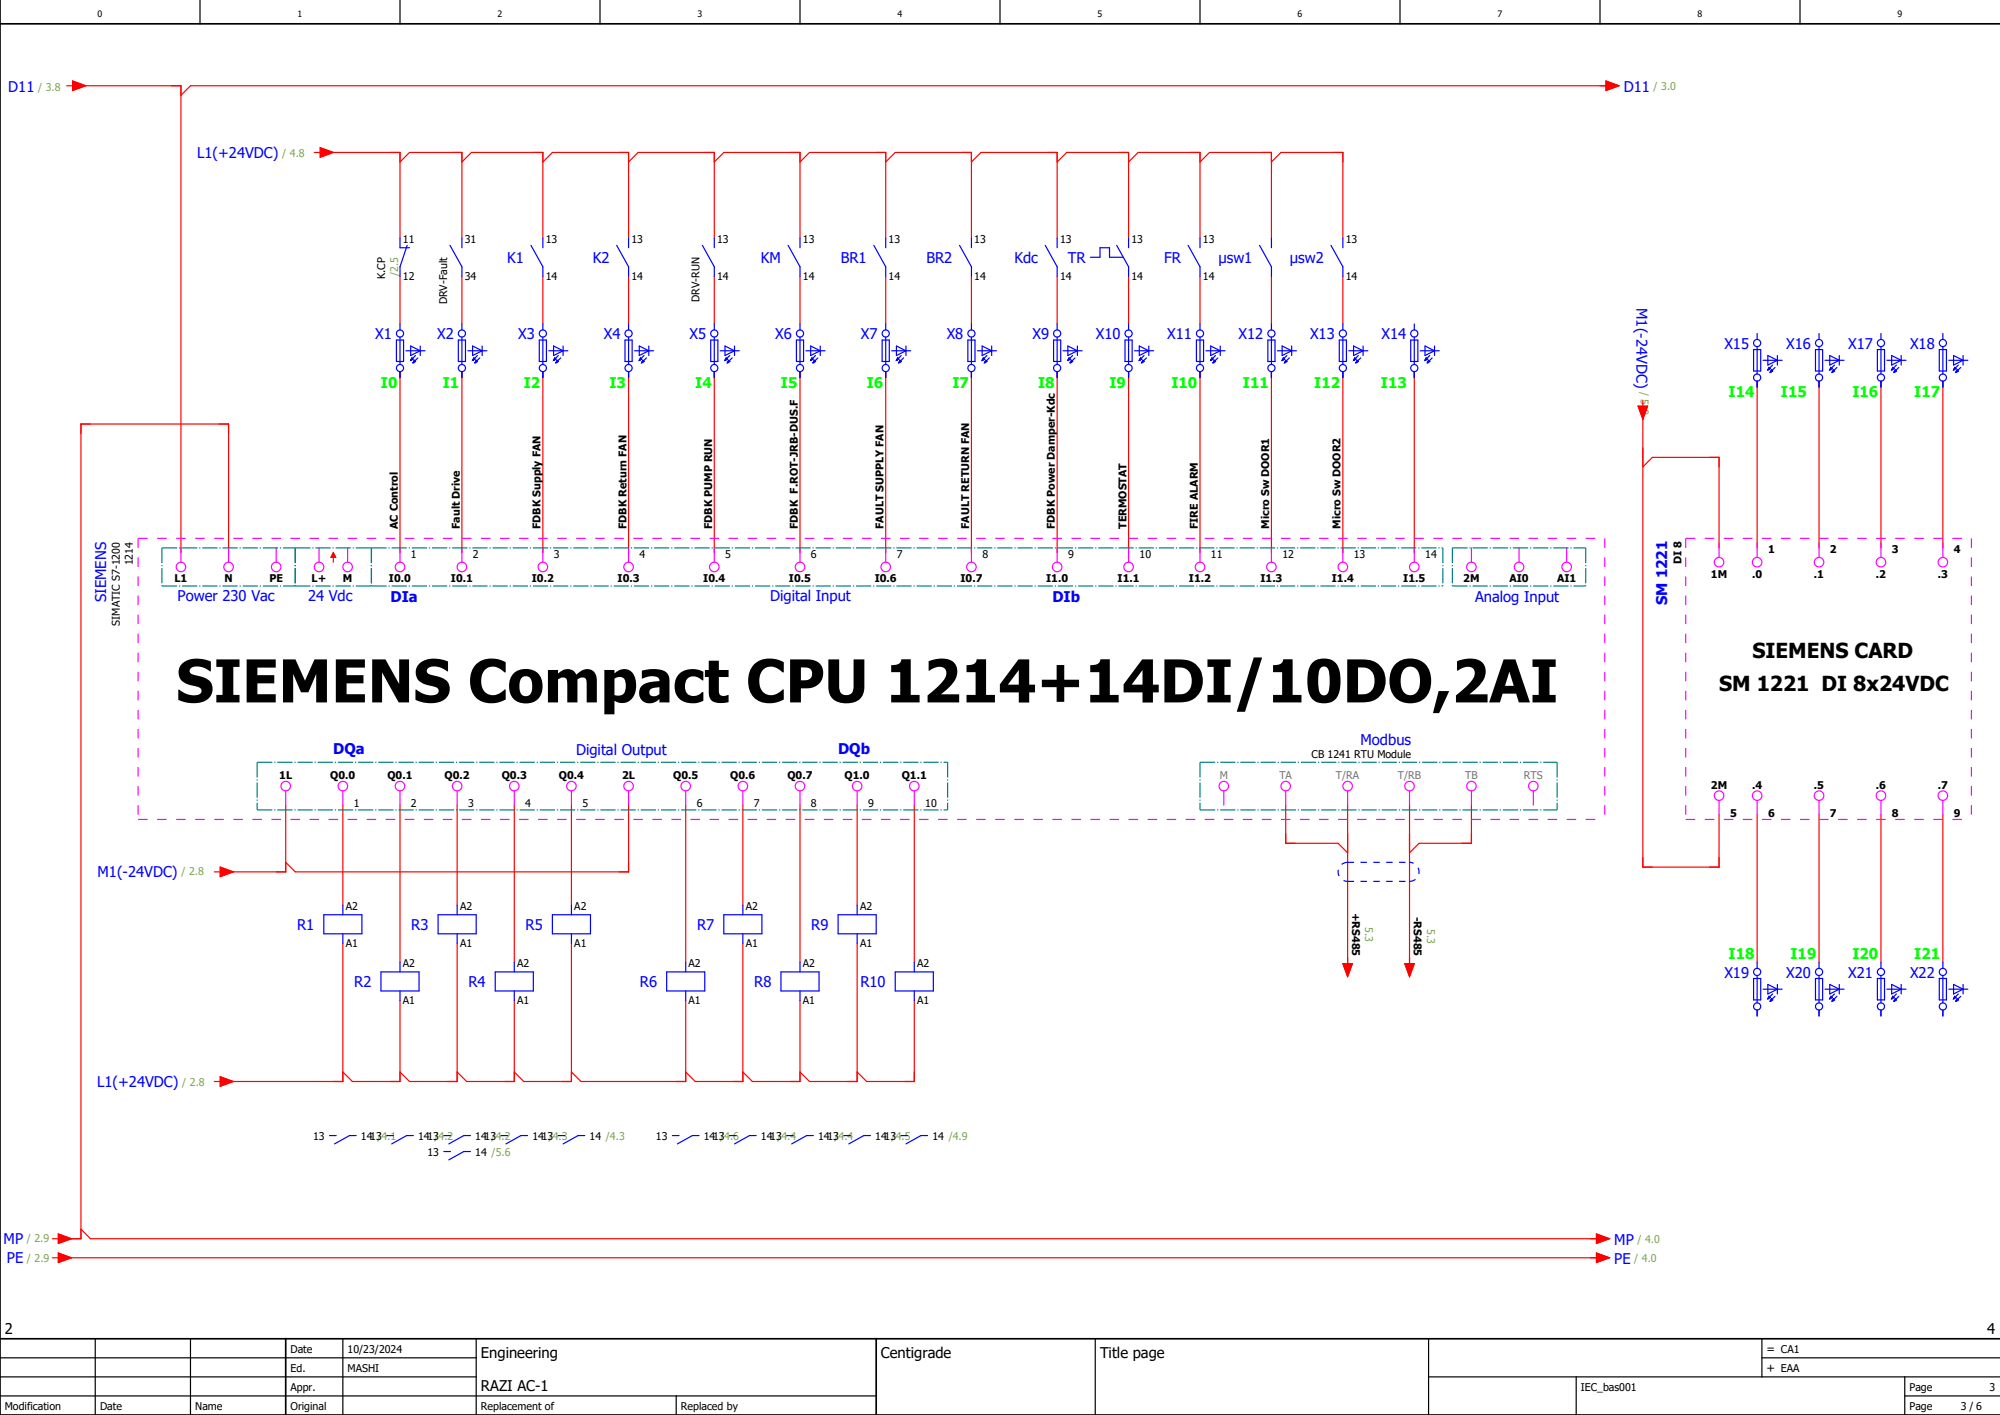
[picture p422: page 3]

FDBK Power Damper-Kdc

D12

D12

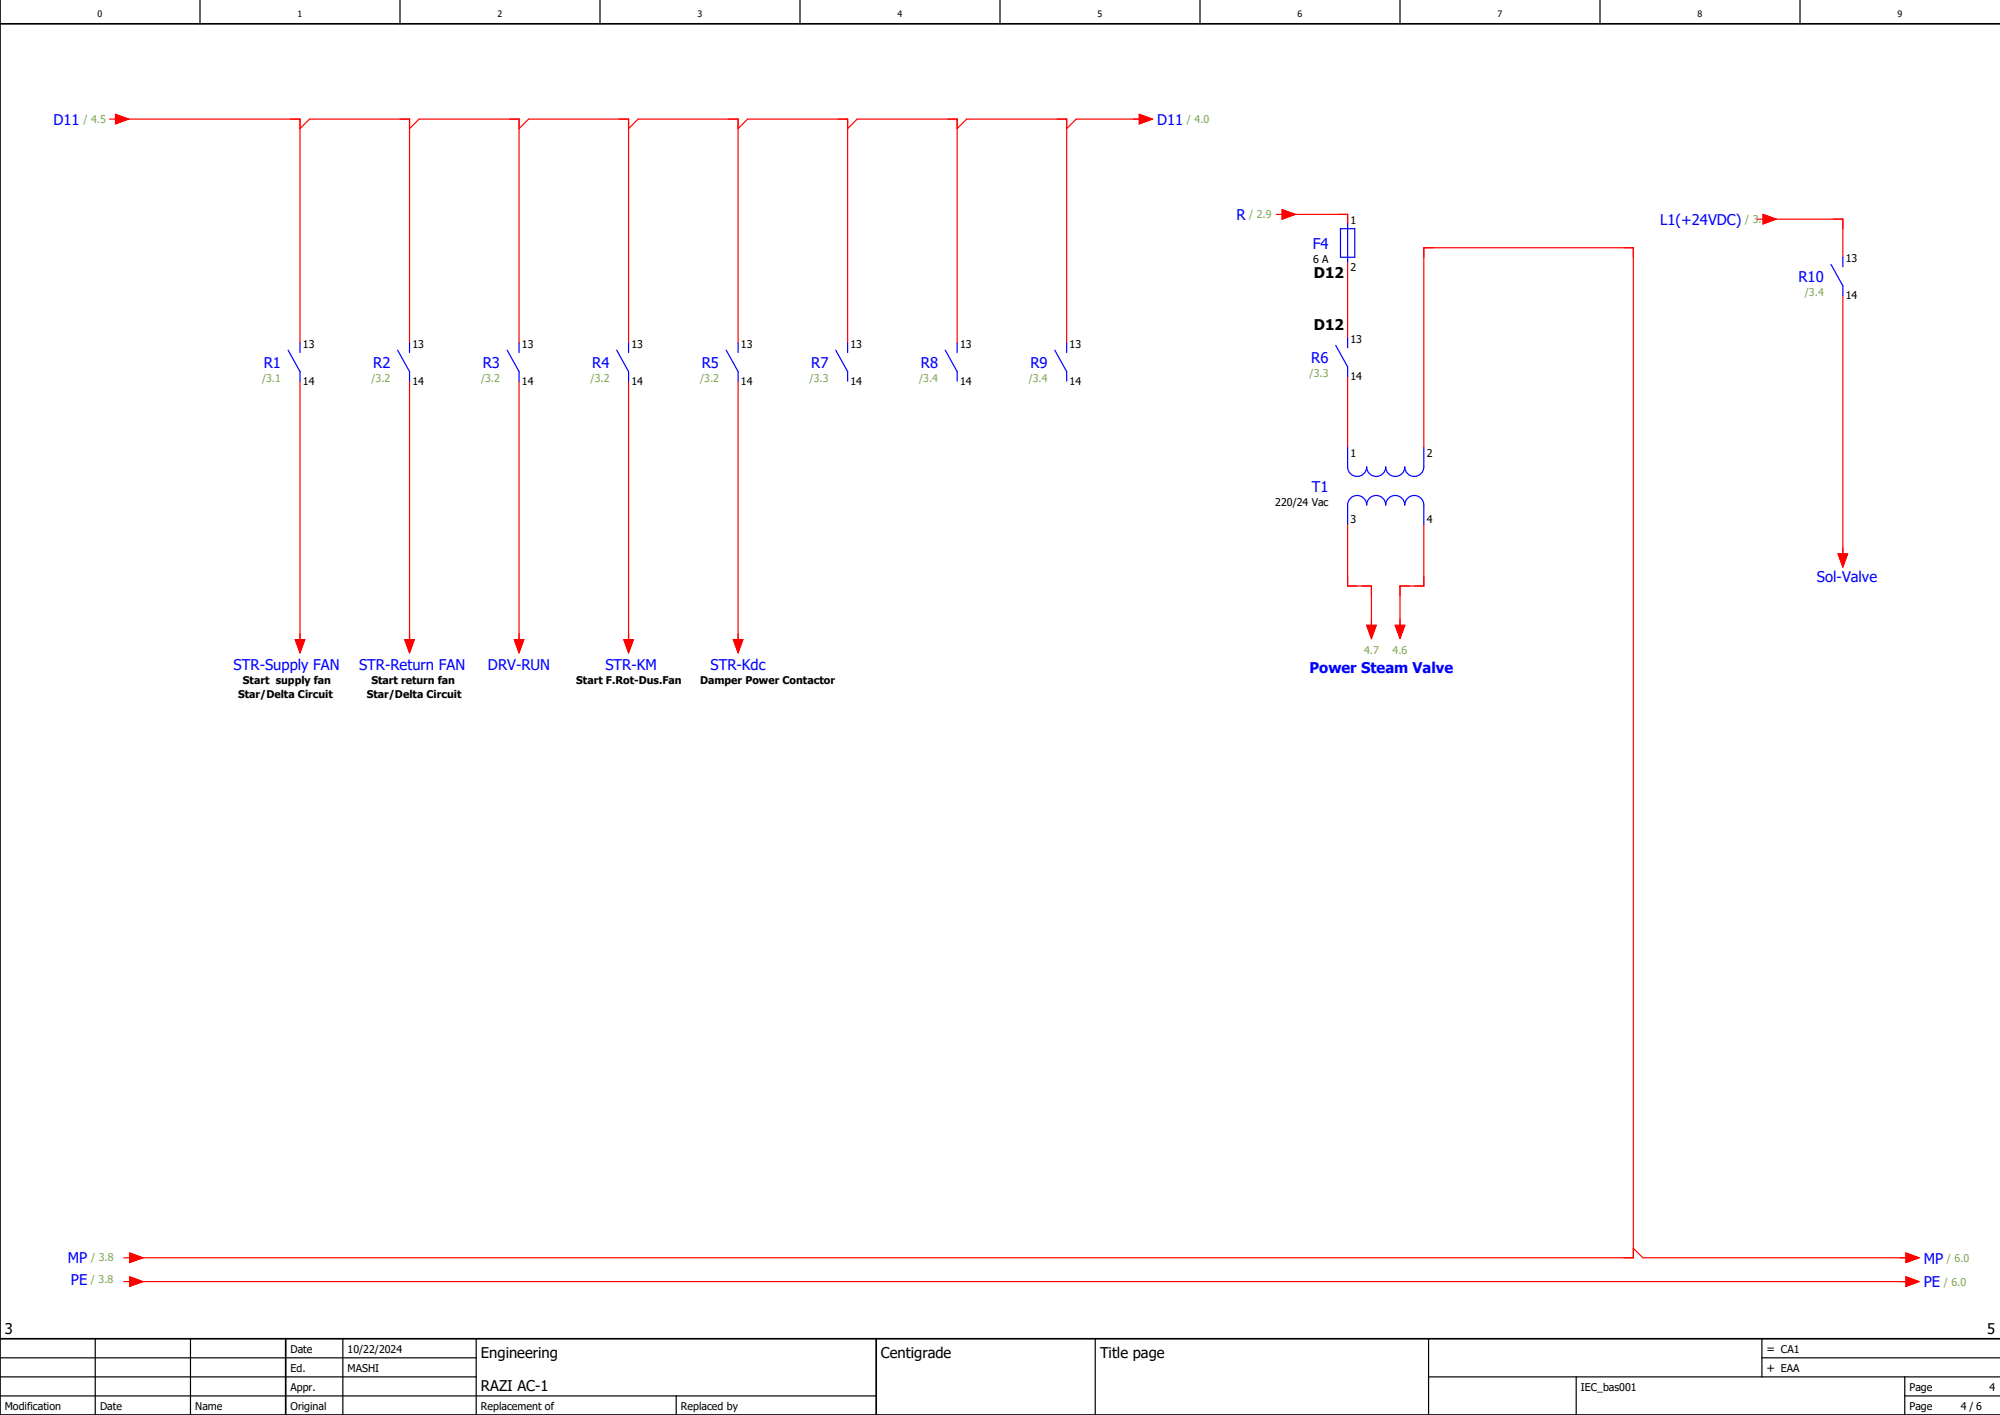
[picture p423: page 4]

# LS H100

## From PLC

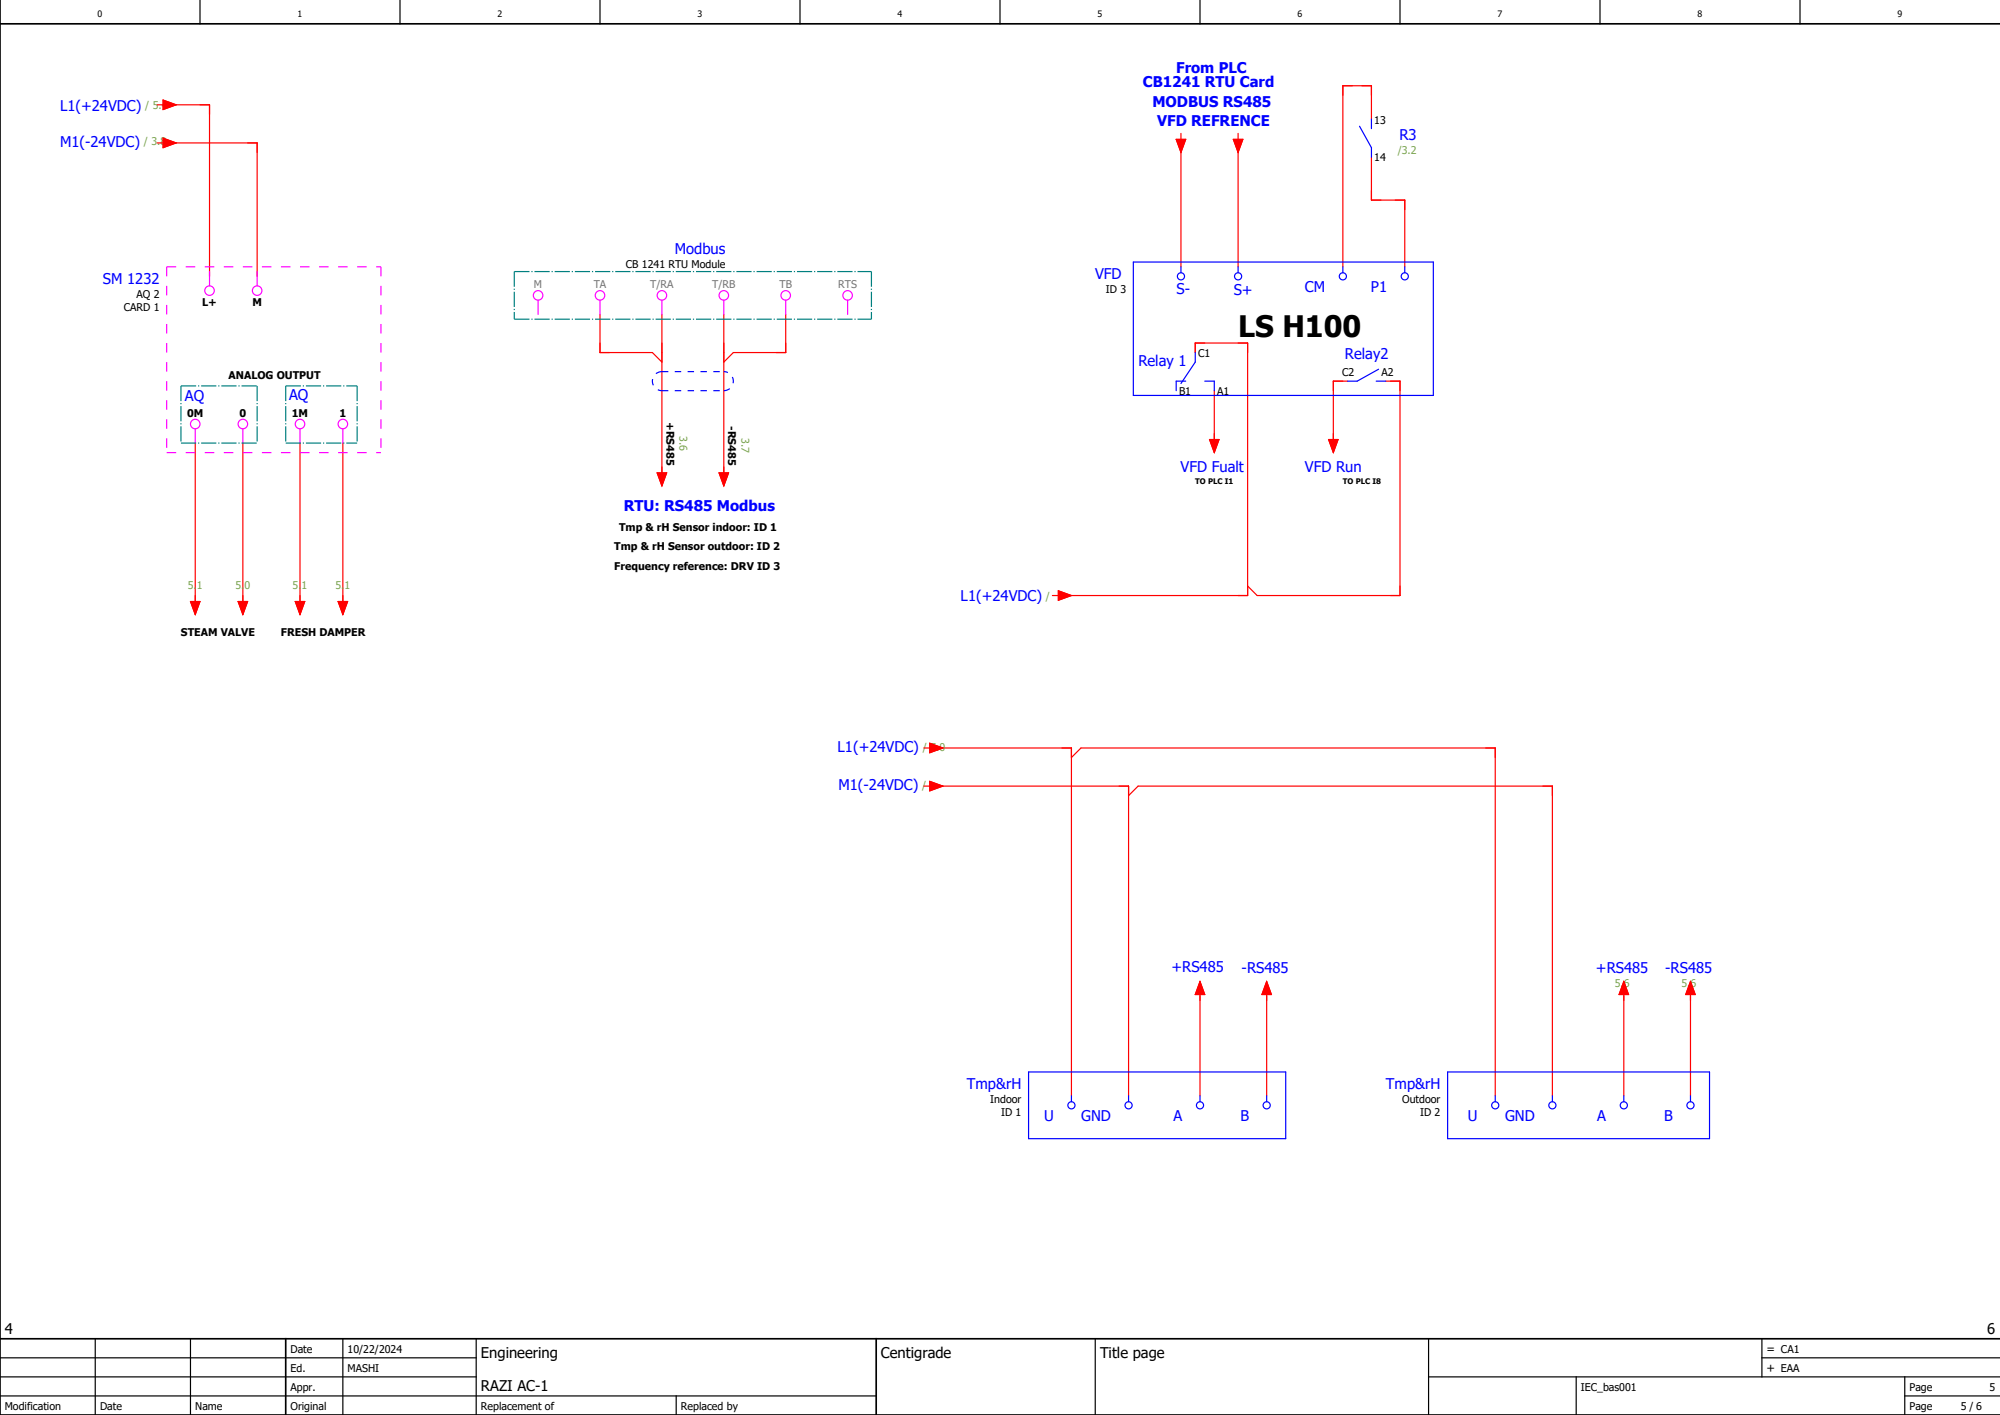
[picture p424: page 5]
ANALOG OUTPUT; STEAM VALVE; FRESH DAMPER; RTU: RS485 Modbus; CB1241 RTU Card MODBUS RS485 VFD REFRENCE; TO PLC I1; TO PLC I8; CARD 1; RTS; Modbus; Tmp&rH; Indoor ID 1; Outdoor; GND; VFD; Relay 1; Relay2; L1(+24VDC) / 5.4; M1(-24VDC) / 3.8; L1(+24VDC) /; M1(-24VDC) /; VFD Fualt; VFD Run

CB 1241 RTU Module

Tmp & rH Sensor indoor: ID 1
Tmp & rH Sensor outdoor: ID 2
Frequency reference: DRV ID 3

F5

R /

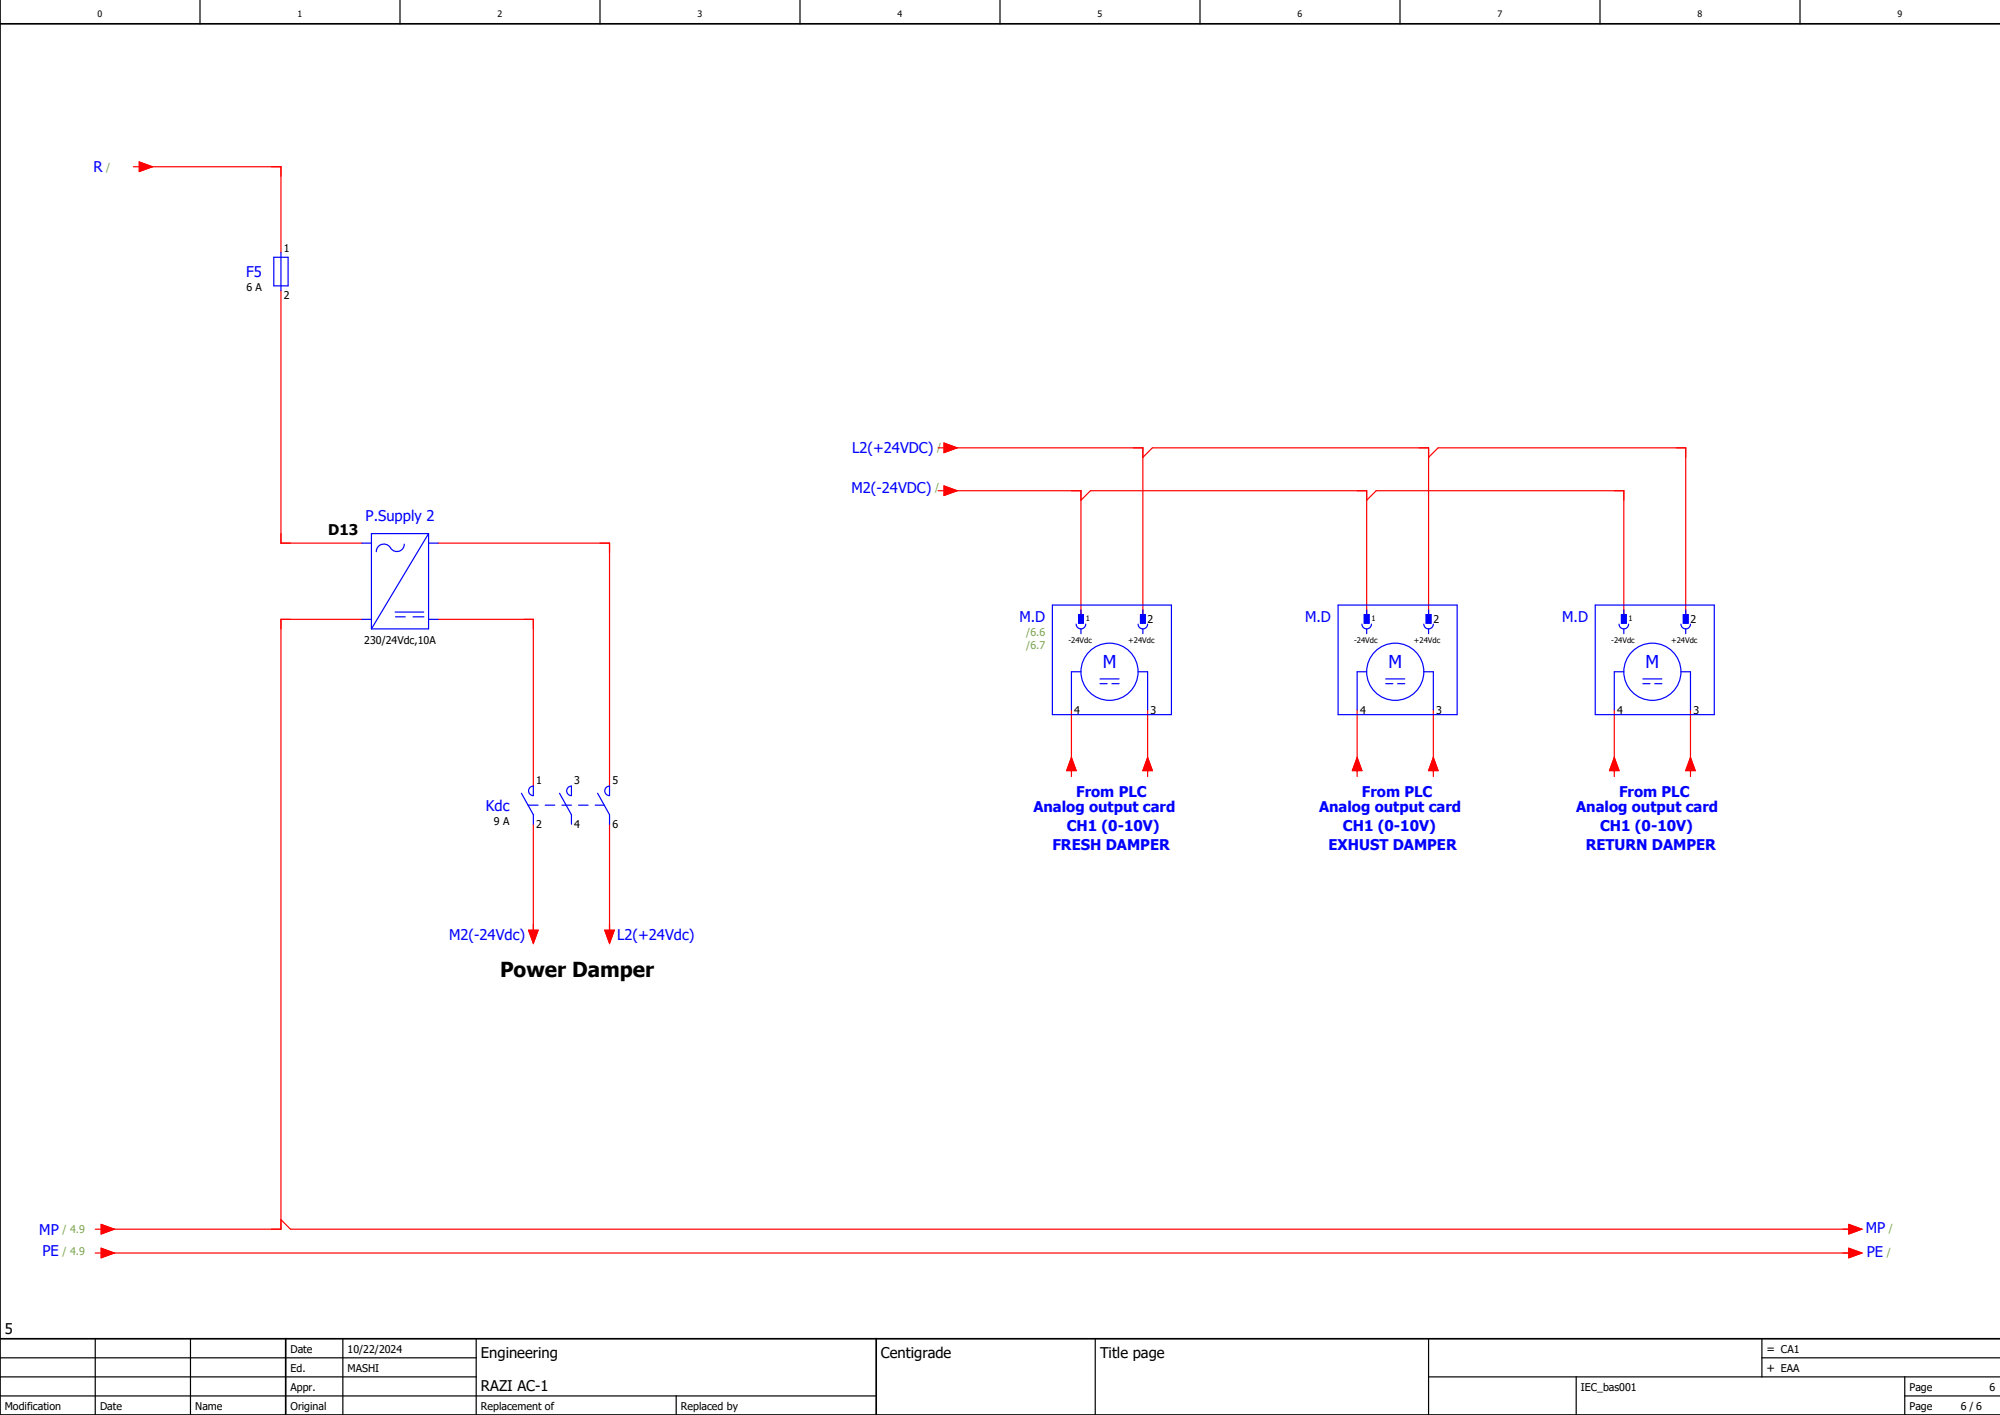
[picture p425: page 6]
Power Damper; From PLC; P.Supply 2; 230/24Vdc,10A; Kdc; -24Vdc; +24Vdc; M2(-24Vdc); L2(+24Vdc); L2(+24VDC) /; M2(-24VDC) /

Analog output card
FRESH DAMPER

EXHUST DAMPER

RETURN DAMPER
