koalium/centidocs/elec/plc/Wiring diagram/10402-Razi/RAZI textile AC-3.pdf

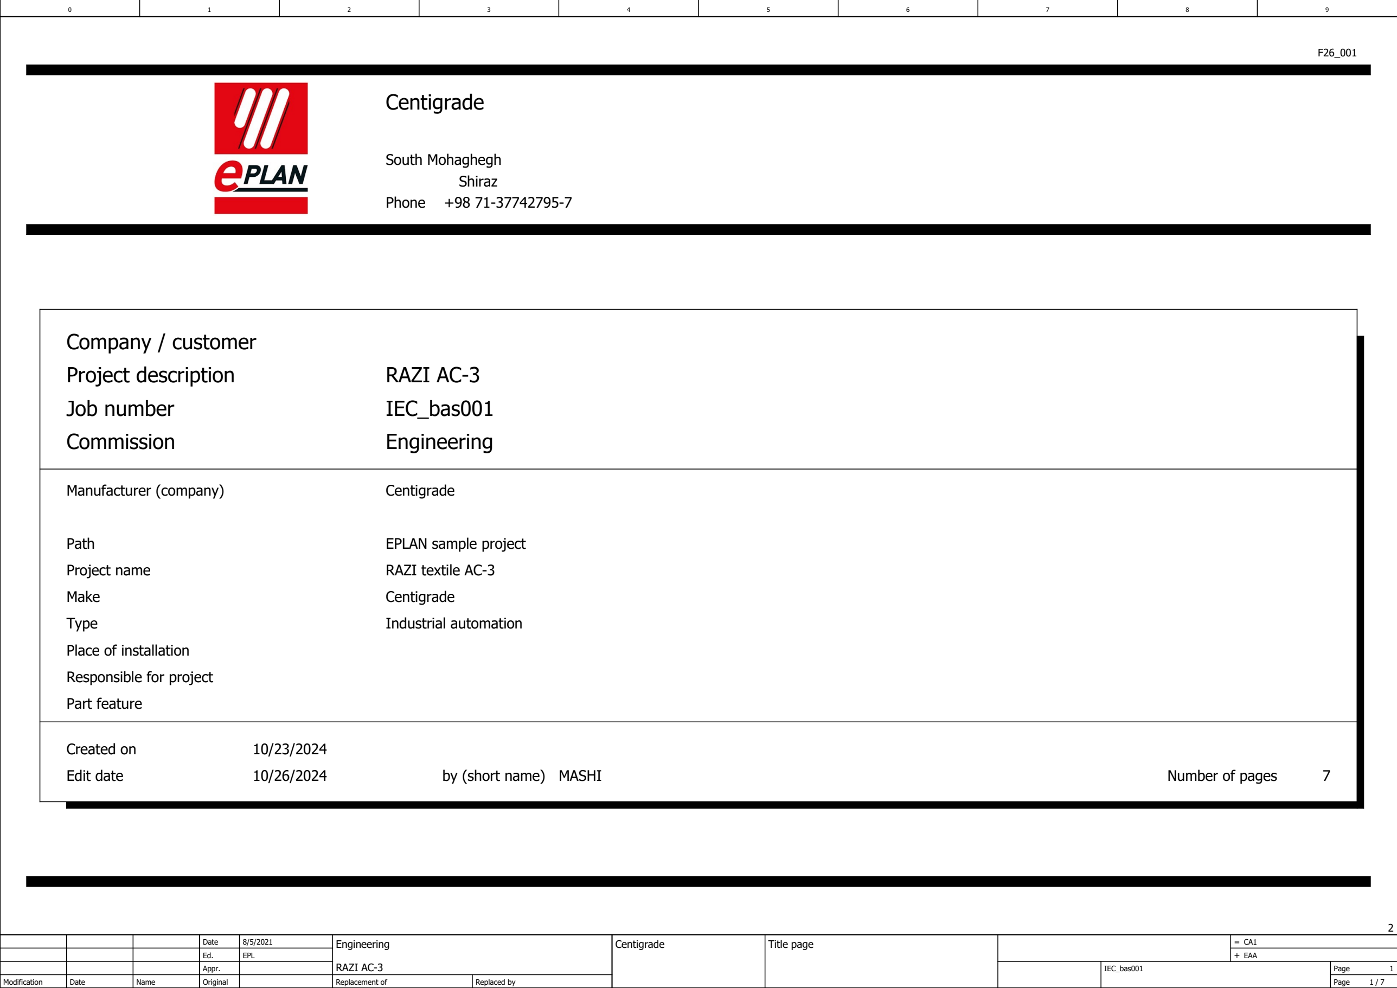
[picture p432: figure]
Page; RAZI AC-3; Original; IEC_bas001; Engineering; EPL; Date; Replaced by; EAA; Title page; Modification; Appr.; Replacement of; Centigrade; Name; Project description; Number of pages; Commission; Edit date; Created on; Job number; EPLAN sample project; Make; MASHI; Part feature; South Mohaghegh; Path; Industrial automation; Manufacturer (company); Project name; RAZI textile AC-3; Responsible for project; Phone; Type; Company / customer; Place of installation; by (short name); Shiraz

TF1 | TF2 | TF3

F2

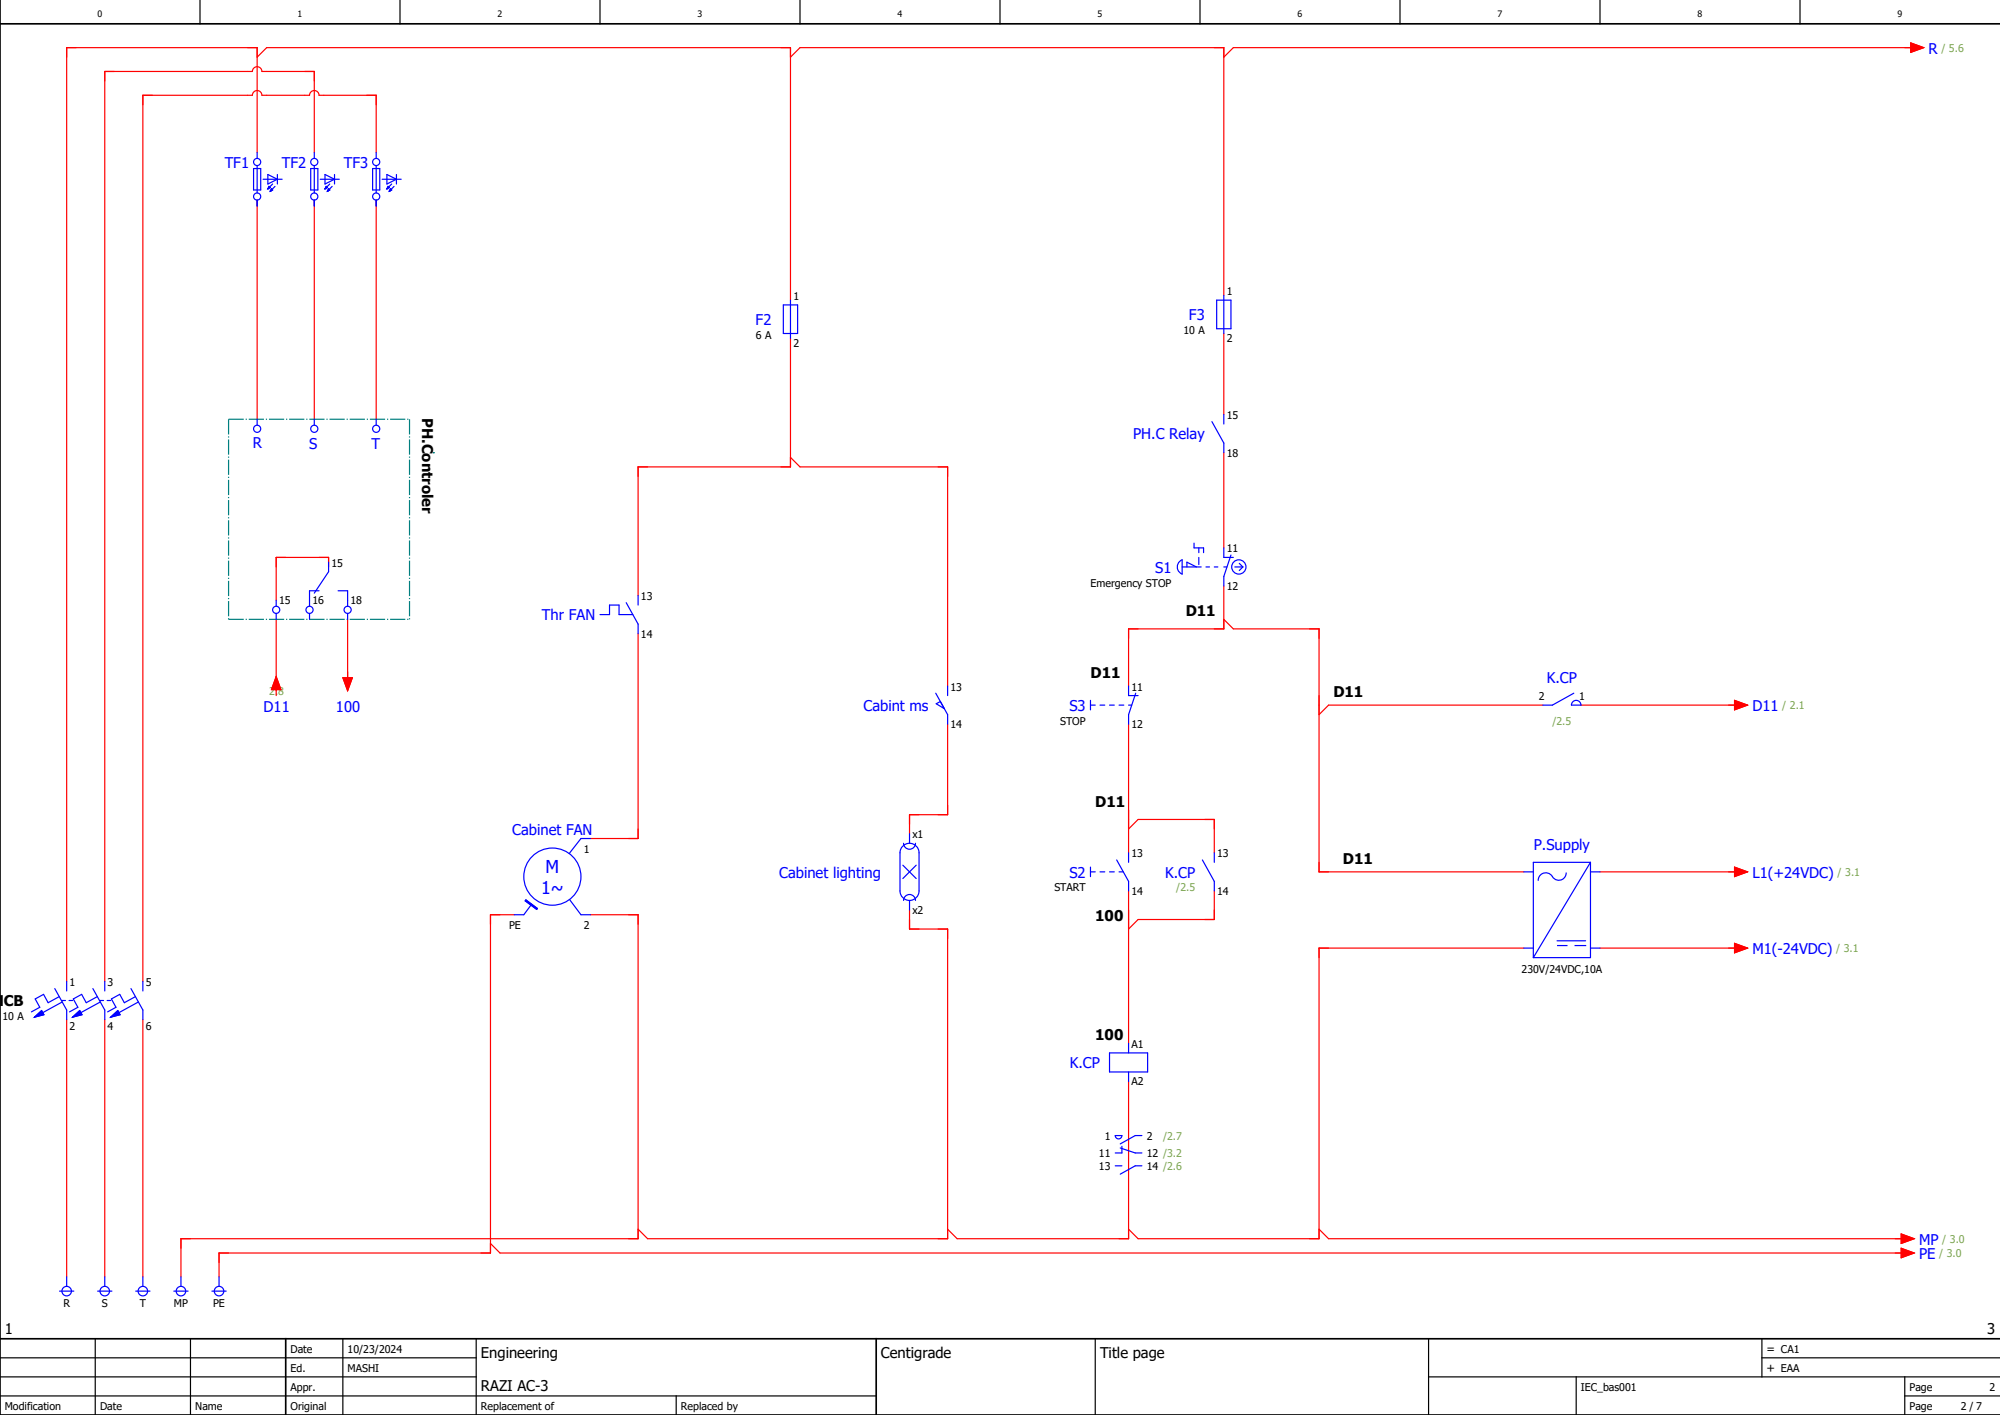
[picture p433: page 2]
MASHI; Centigrade; MCB; PH.Controler; Cabinet FAN; Cabinet lighting; Thr FAN; Cabint ms; Emergency STOP; PH.C Relay; START; STOP; P.Supply; 230V/24VDC,10A; L1(+24VDC) / 3.1; M1(-24VDC) / 3.1

X1 | X2 | X3 | X4 | X5 | X6 | X7 | X8 | X9 | X10 | X11 | X12 | X13 | X14 DRV⁻Fault1

K5

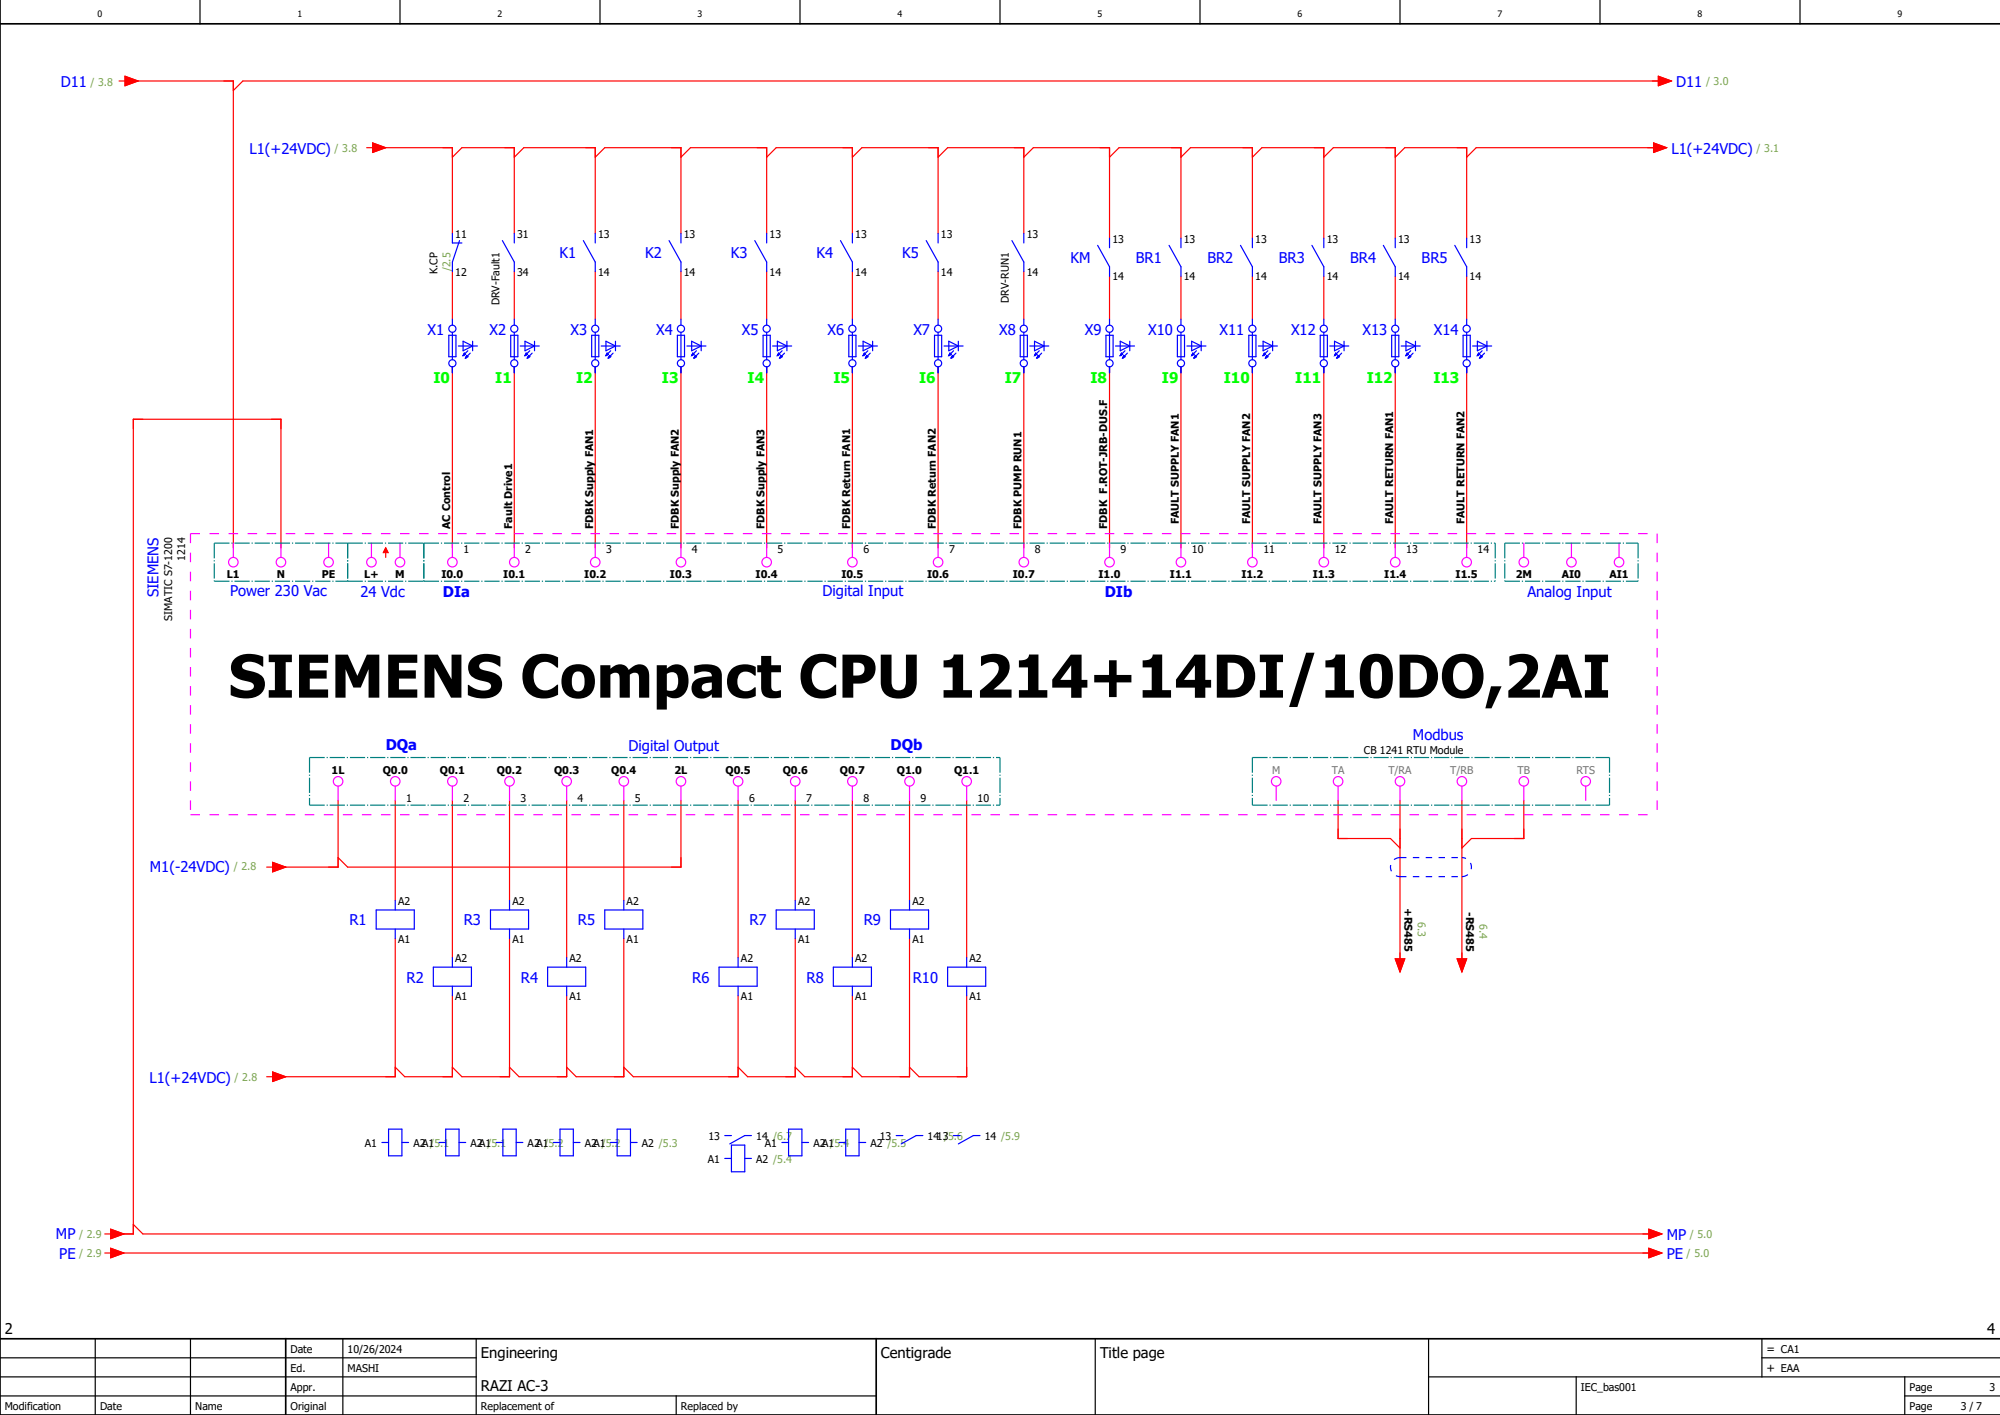
[picture p434: page 3]

TF15 | TF16 | TF17 | TF18 | TF19 | TF20 | TF21 | TF22
| | FR | µsw1

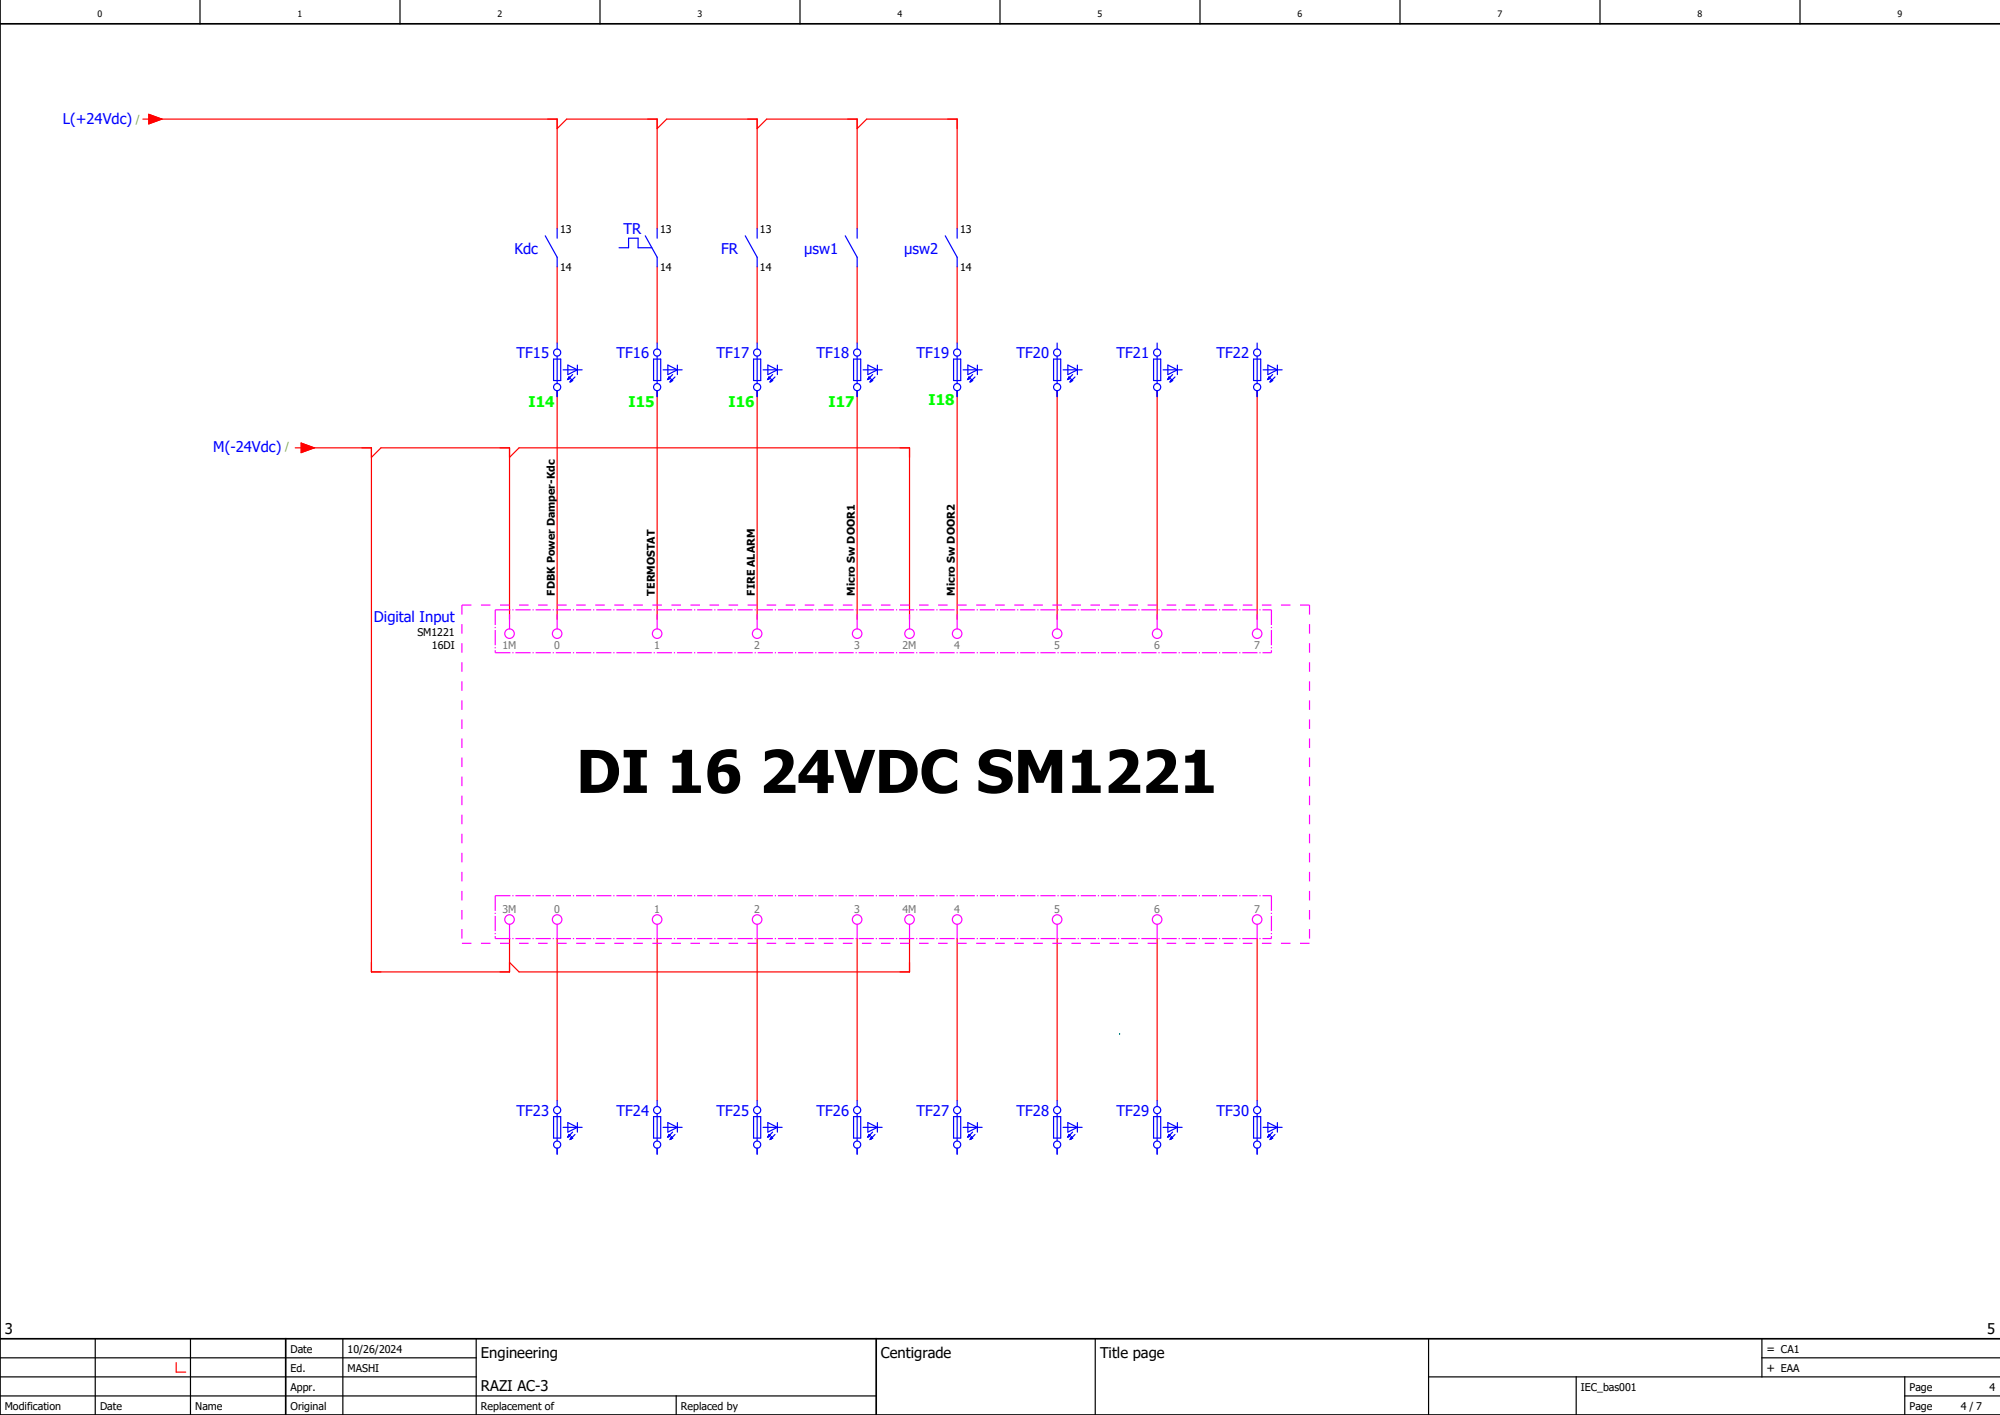
[picture p435: page 4]
DI 16 24VDC SM1221; TERMOSTAT; FIRE ALARM; Micro Sw DOOR1; Micro Sw DOOR2; Digital Input; µsw2; Kdc; M(-24Vdc) /; L(+24Vdc) /

FDBK Power Damper-Kdc

D12

D12

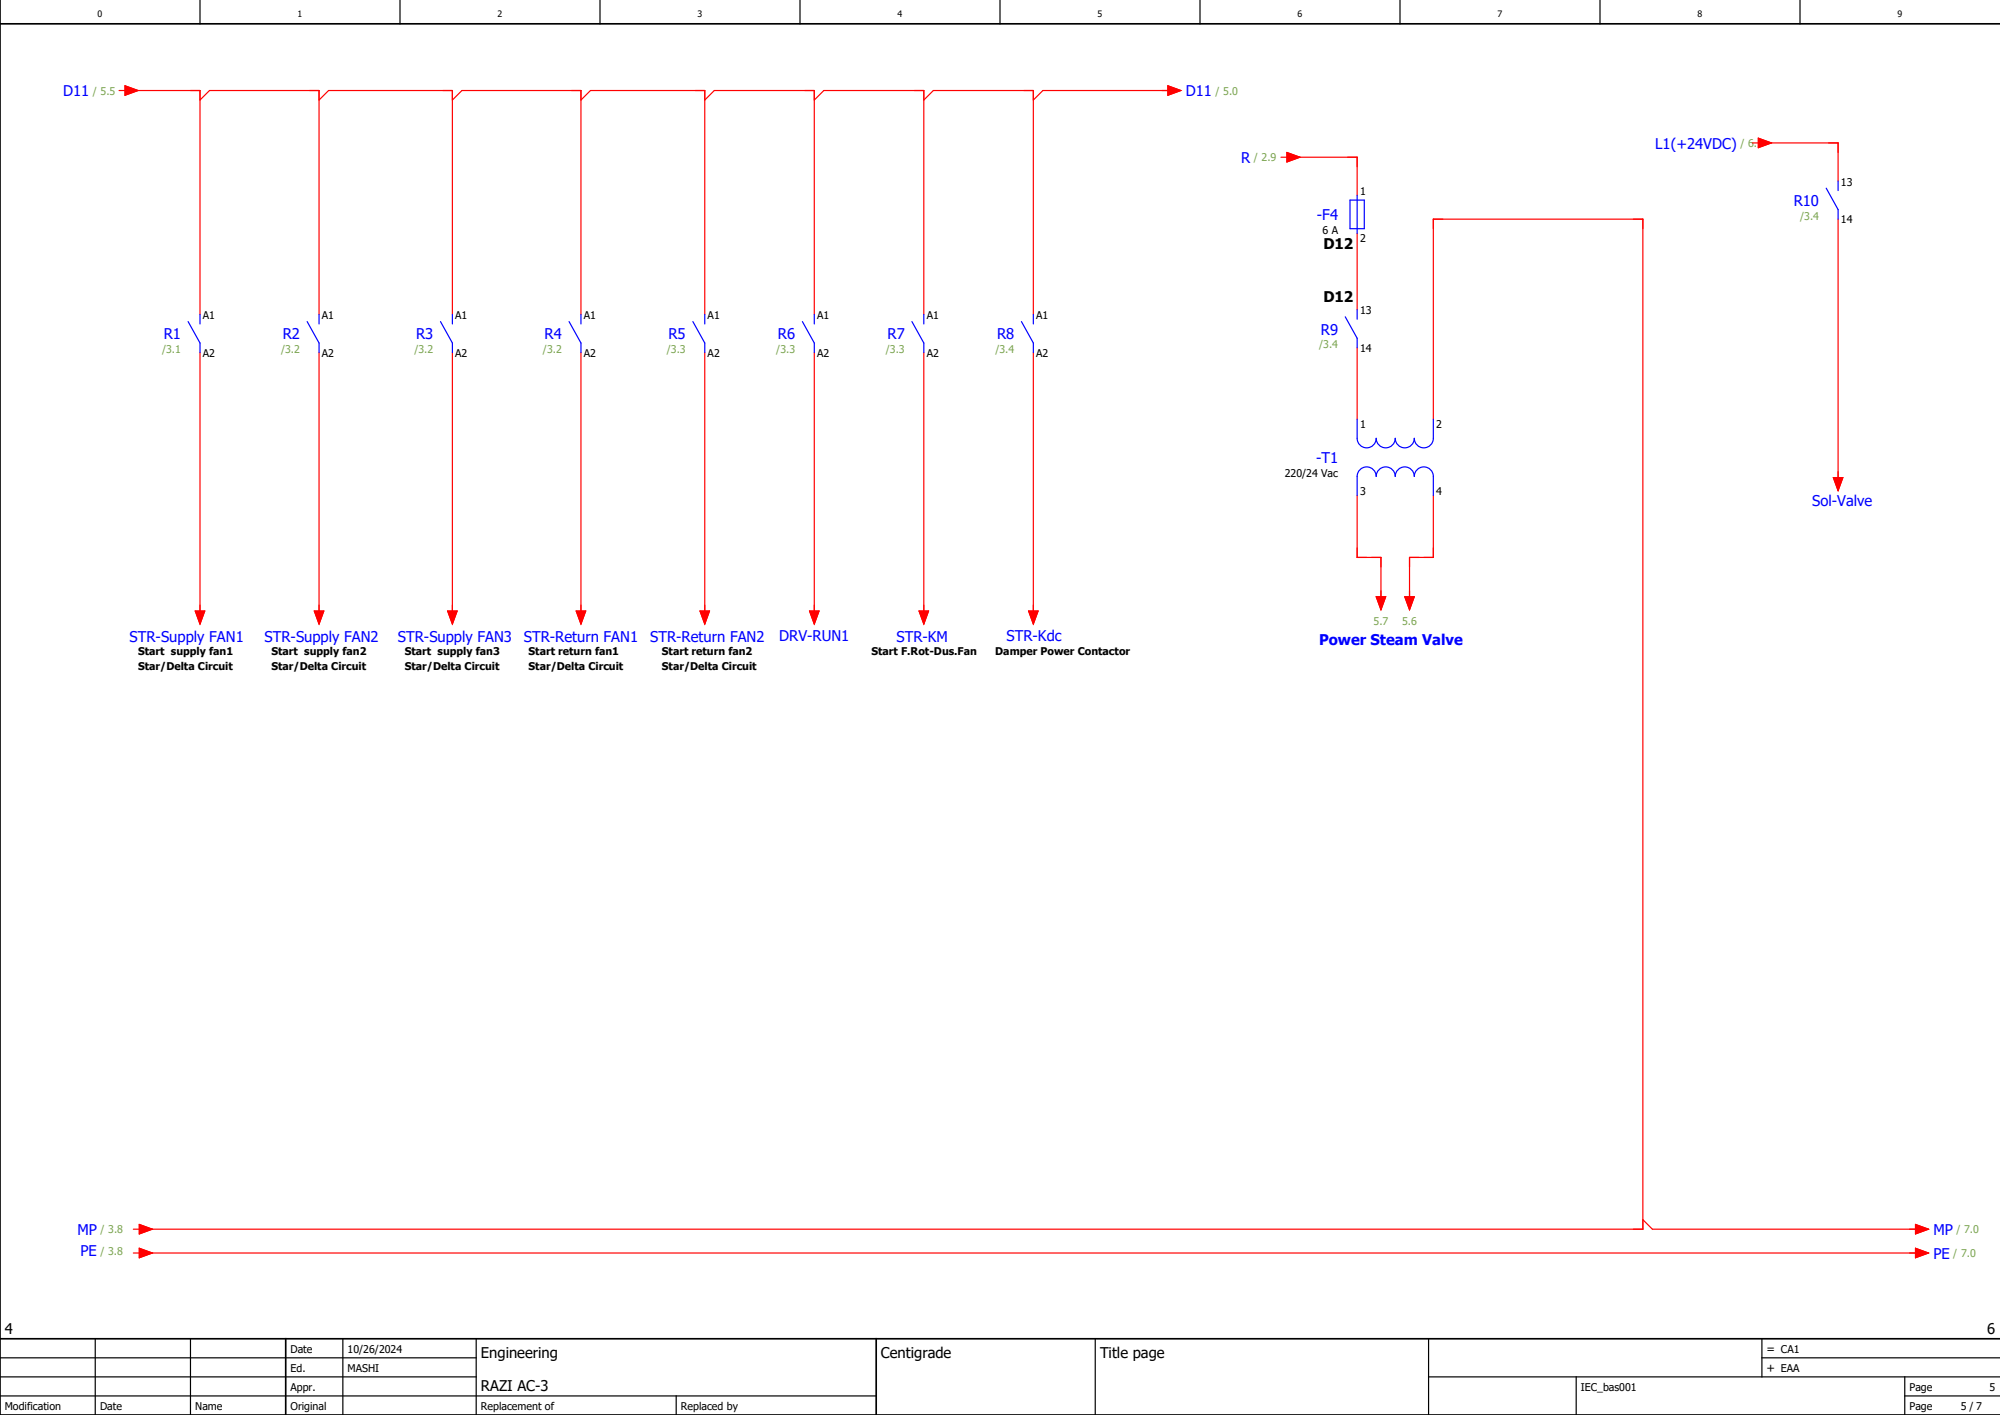
[picture p436: page 5]

# LS H100

## From PLC

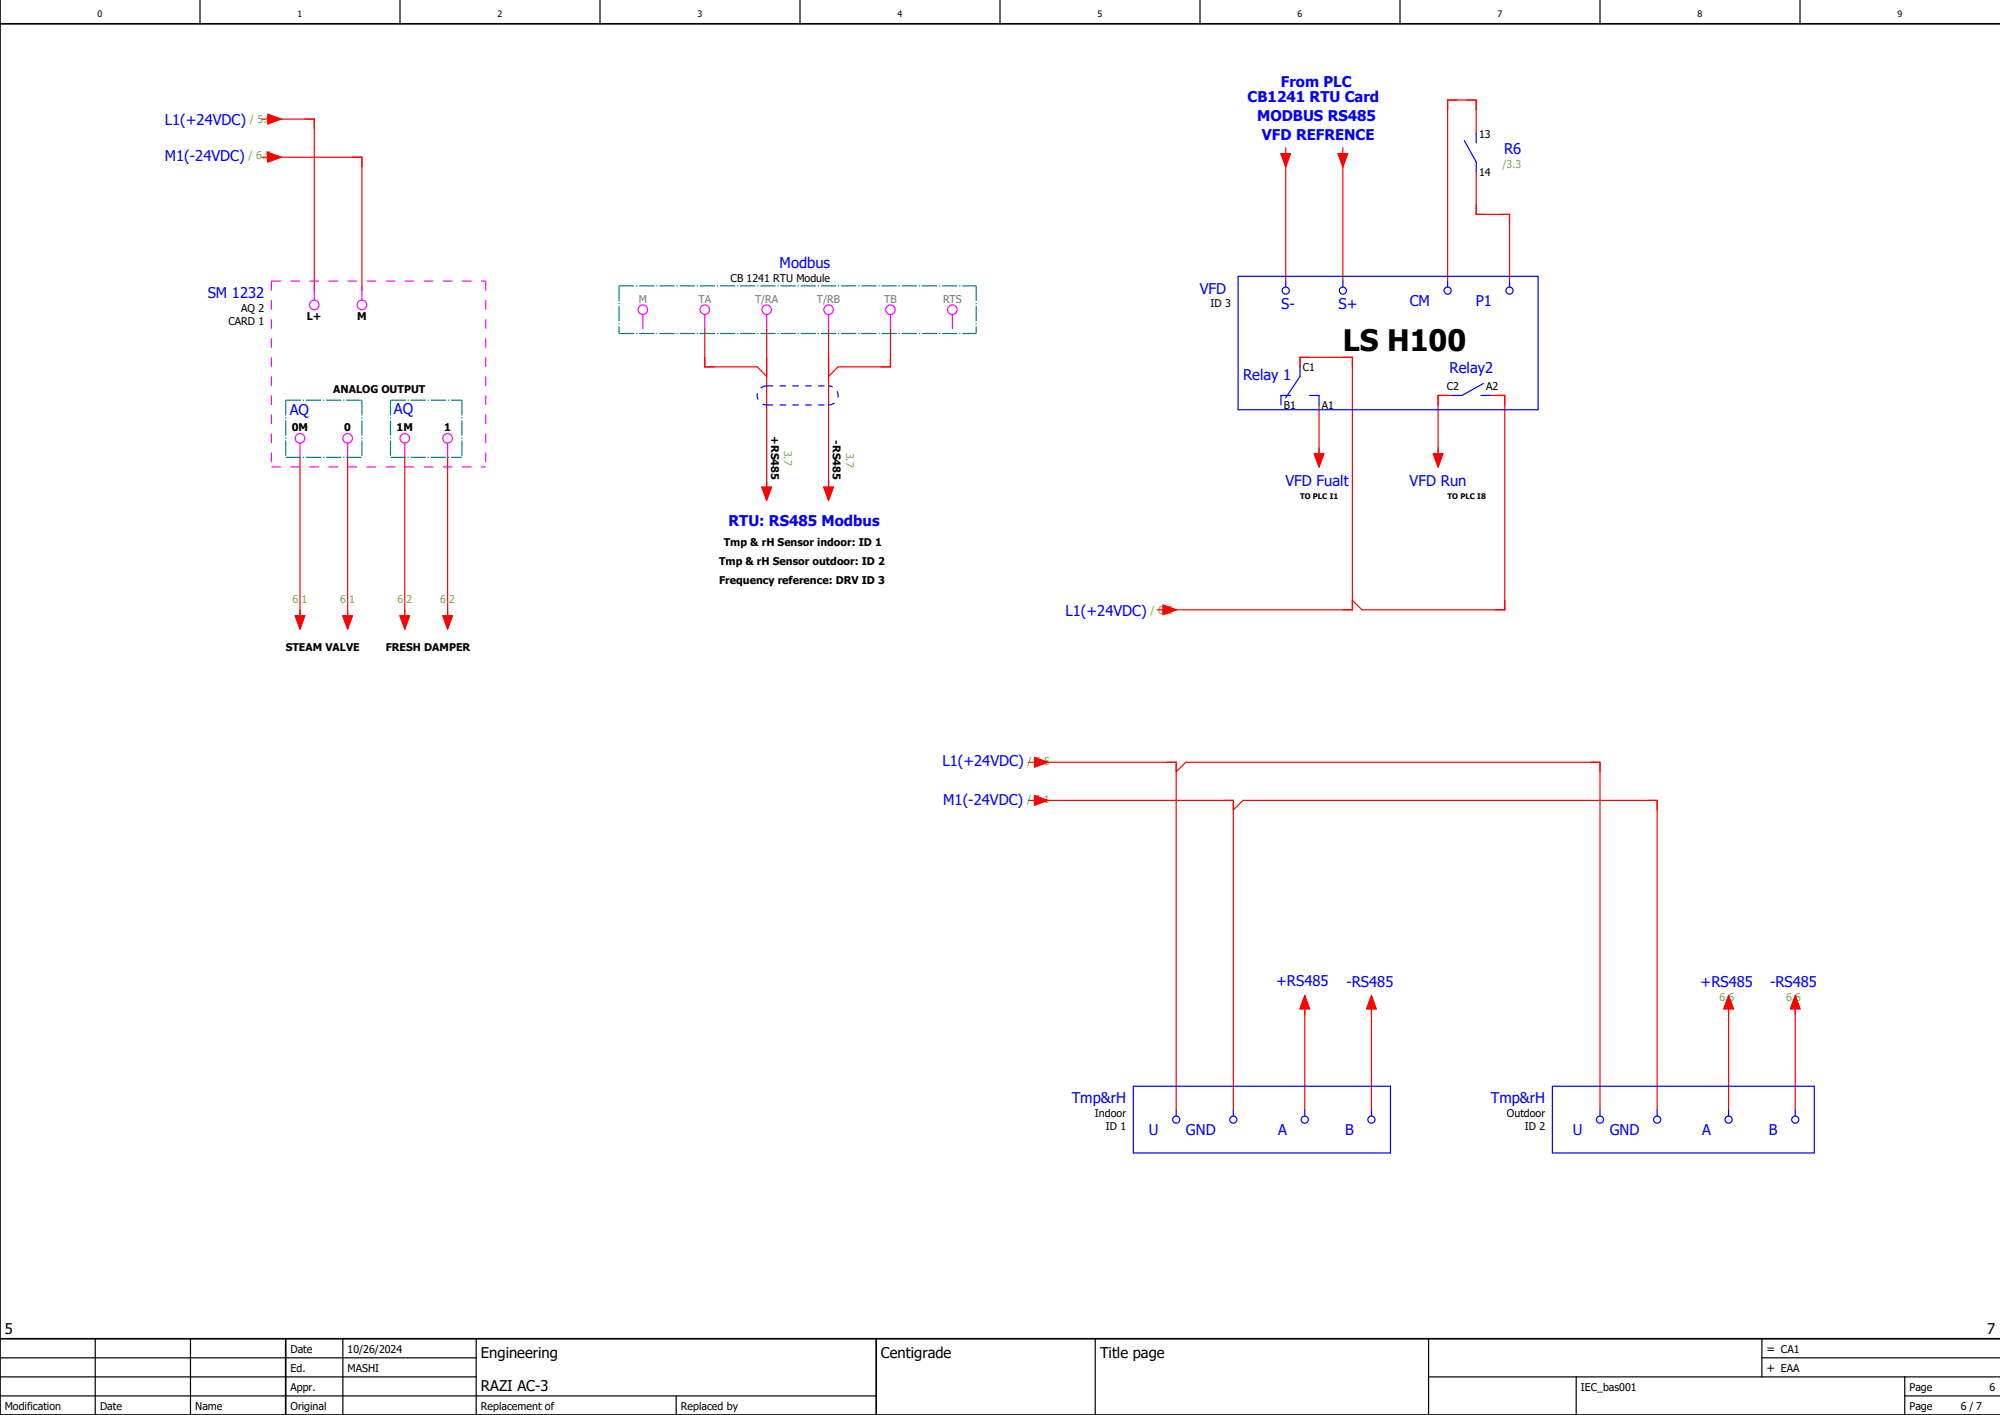
[picture p437: page 6]
ANALOG OUTPUT; STEAM VALVE; FRESH DAMPER; RTU: RS485 Modbus; CB1241 RTU Card MODBUS RS485 VFD REFRENCE; TO PLC I1; TO PLC I8; CARD 1; RTS; Modbus; Tmp&rH; Indoor ID 1; Outdoor; GND; VFD; Relay 1; Relay2; L1(+24VDC) / 5.8; M1(-24VDC) / 6.5; L1(+24VDC) /; M1(-24VDC) /; L1(+24VDC) / 6.5; VFD Fualt; VFD Run

CB 1241 RTU Module

Tmp & rH Sensor indoor: ID 1
Tmp & rH Sensor outdoor: ID 2
Frequency reference: DRV ID 3

F5

R /

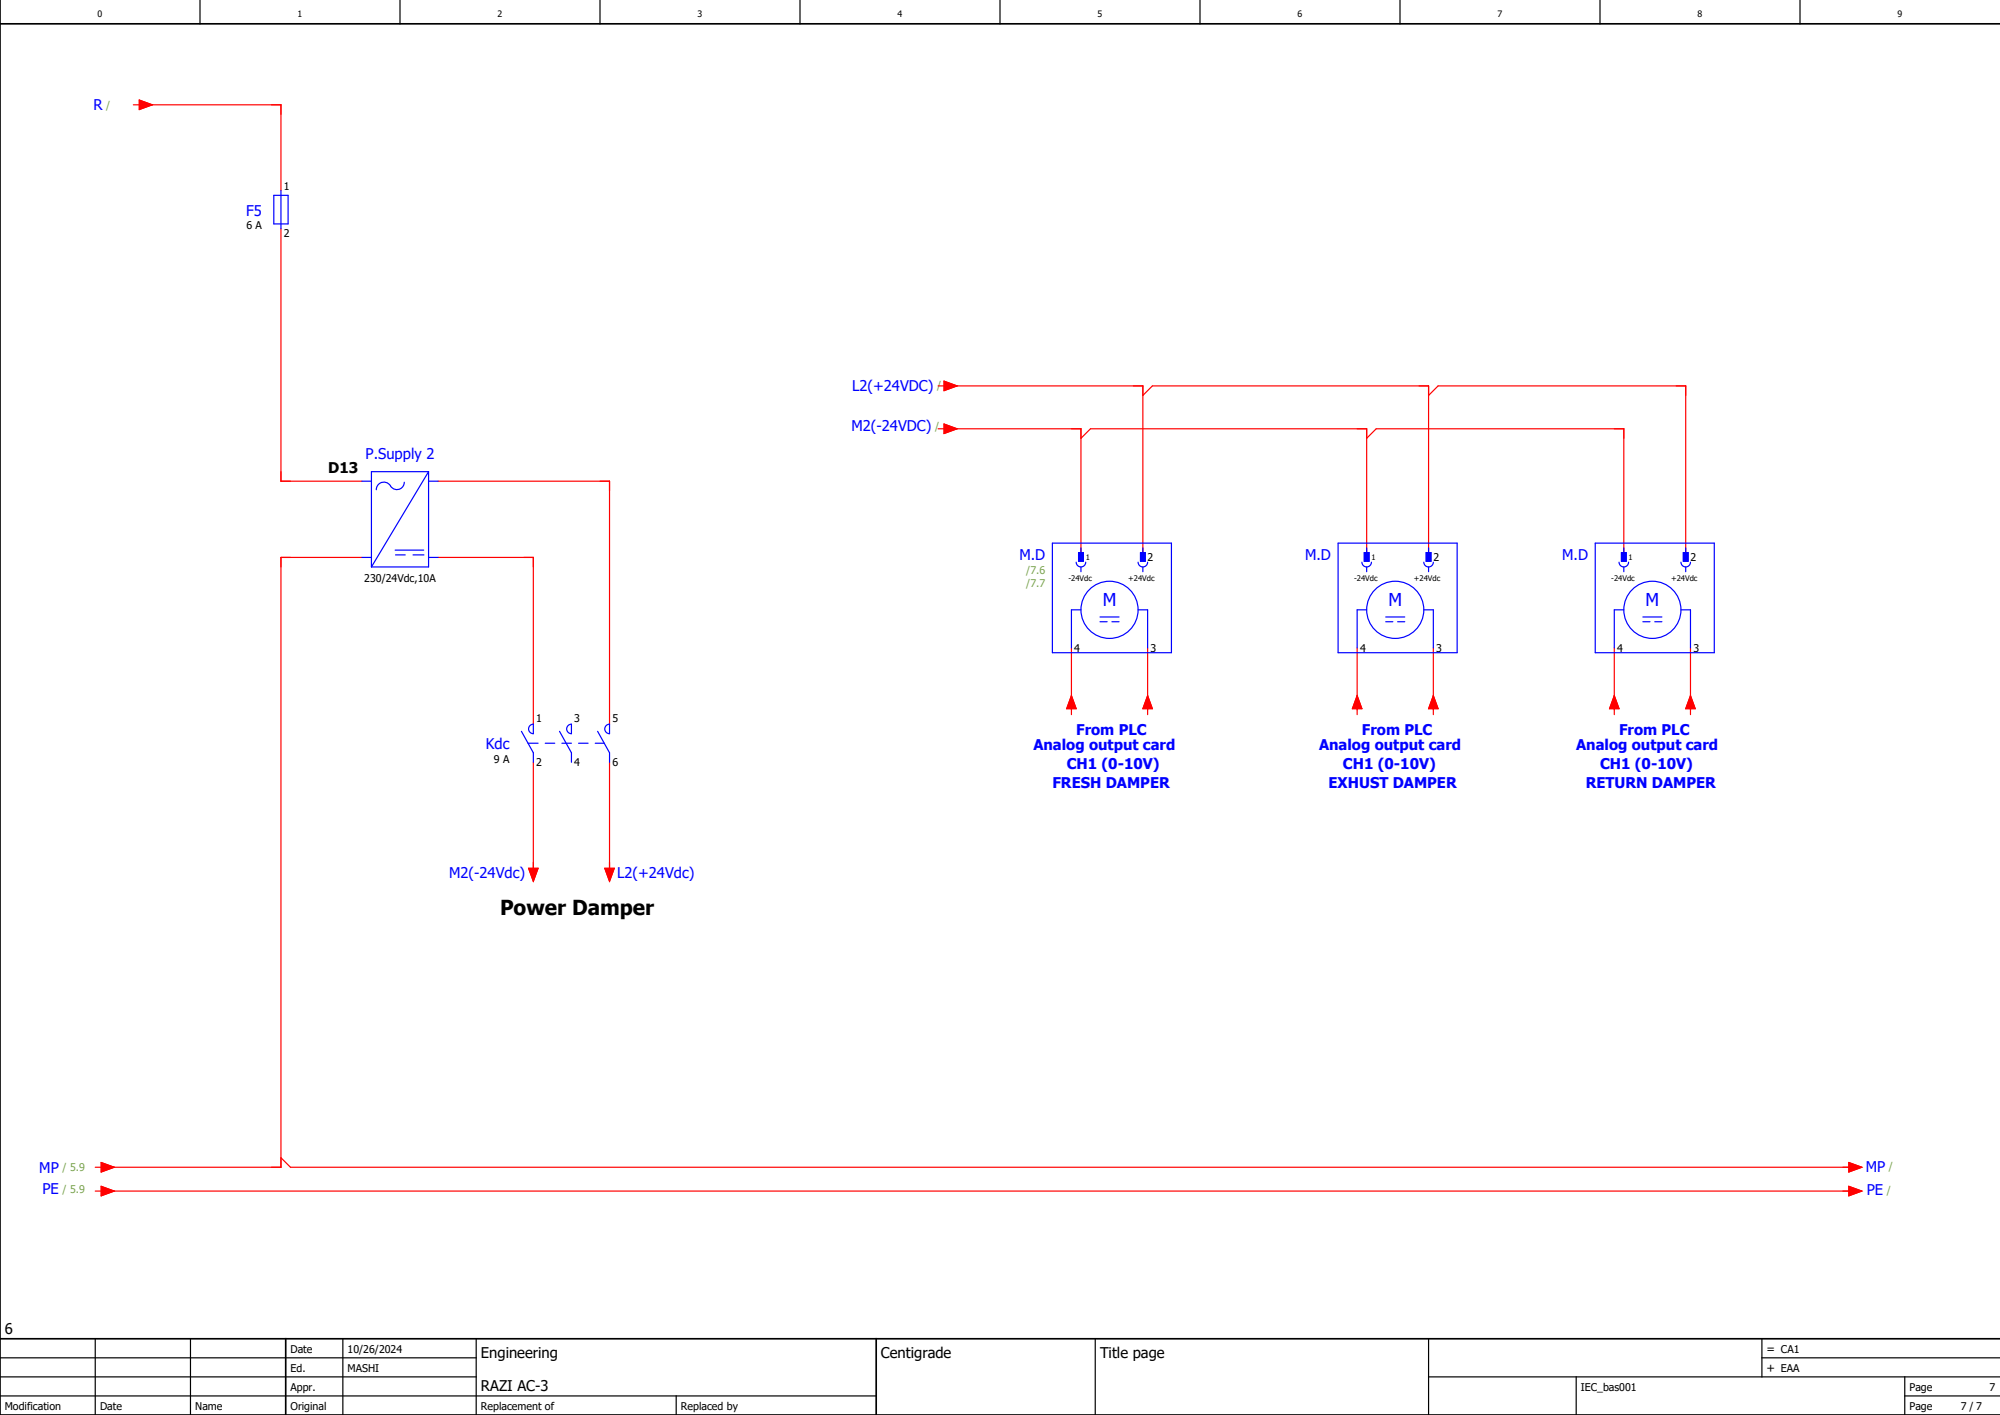
[picture p438: page 7]
Power Damper; From PLC; P.Supply 2; 230/24Vdc,10A; Kdc; -24Vdc; +24Vdc; M2(-24Vdc); L2(+24Vdc); L2(+24VDC) /; M2(-24VDC) /

Analog output card
FRESH DAMPER

EXHUST DAMPER

RETURN DAMPER
