koalium/centidocs/elec/plc/Wiring diagram/10402-Razi/RAZI textile AC-5.pdf

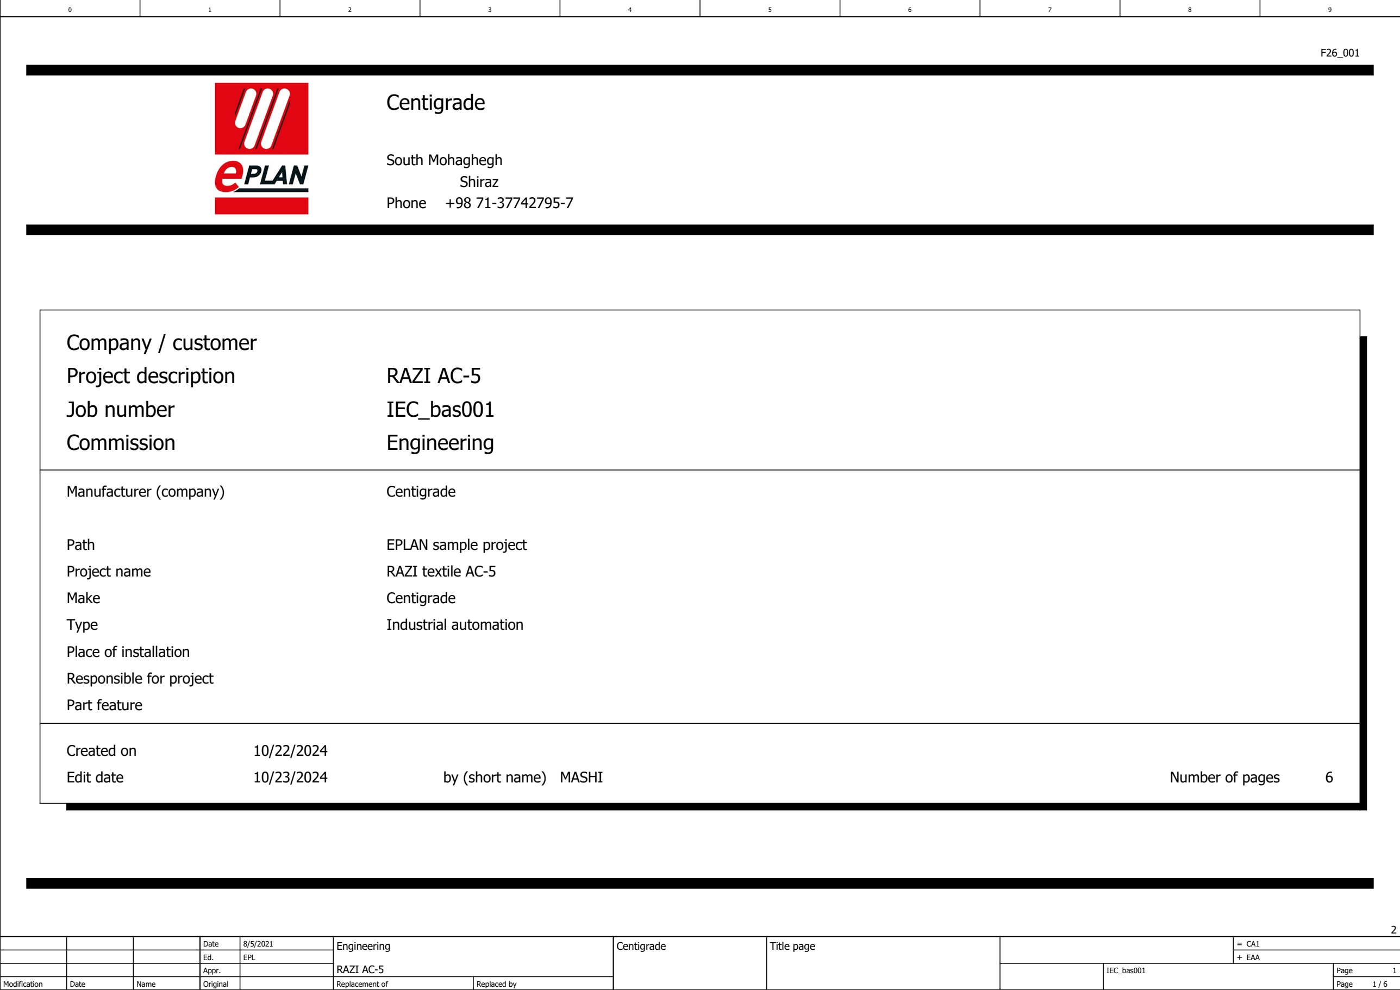
[picture p445: figure]
Page; RAZI AC-5; Original; IEC_bas001; Engineering; EPL; Date; Replaced by; EAA; Title page; Modification; Appr.; Replacement of; Centigrade; Name; Project description; Number of pages; Commission; Edit date; Created on; Job number; EPLAN sample project; Make; MASHI; Part feature; South Mohaghegh; Path; Industrial automation; Manufacturer (company); Project name; RAZI textile AC-5; Responsible for project; Phone; Type; Company / customer; Place of installation; by (short name); Shiraz

TF1 | TF2 | TF3

F2

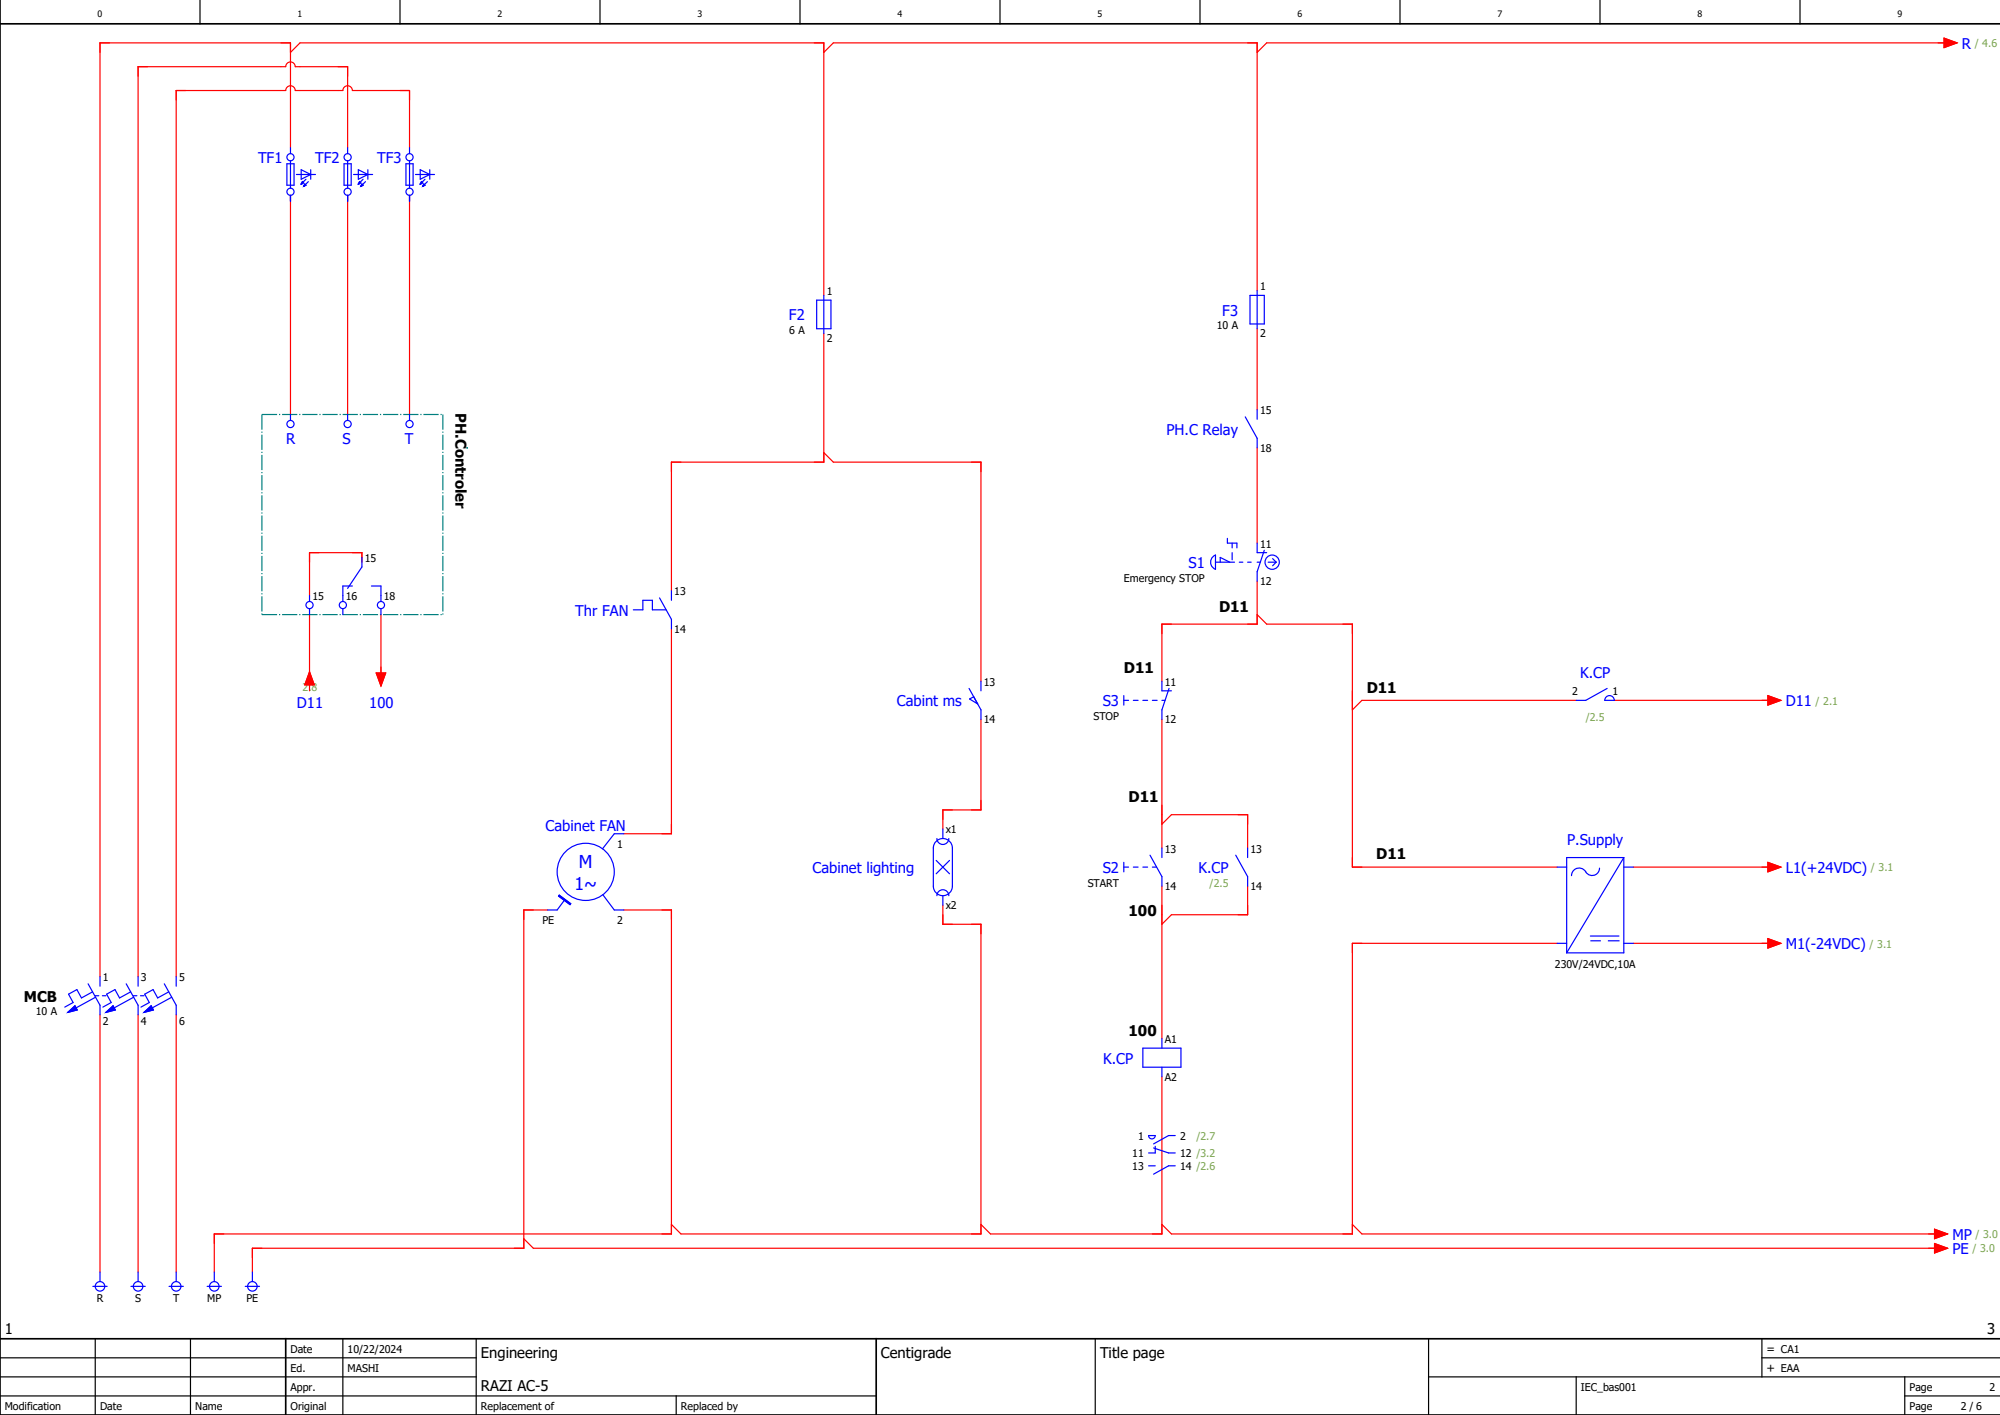
[picture p446: page 2]
MASHI; Centigrade; MCB; PH.Controler; Cabinet FAN; Cabinet lighting; Thr FAN; Cabint ms; Emergency STOP; PH.C Relay; START; STOP; P.Supply; 230V/24VDC,10A; L1(+24VDC) / 3.1; M1(-24VDC) / 3.1

I0 | I1 | I2 | I3 | I4 | I5 | I6 | I7 | I8 | I9 | I10 | I11 | I12 | I13 | I14 | I15 | I16 | I17
X1 | X2 | X3 | X4 | X5 | X6 | X7 | X8 | X9 | X10 | X11 | X12 | X13 | X14 DRV⁻Fault

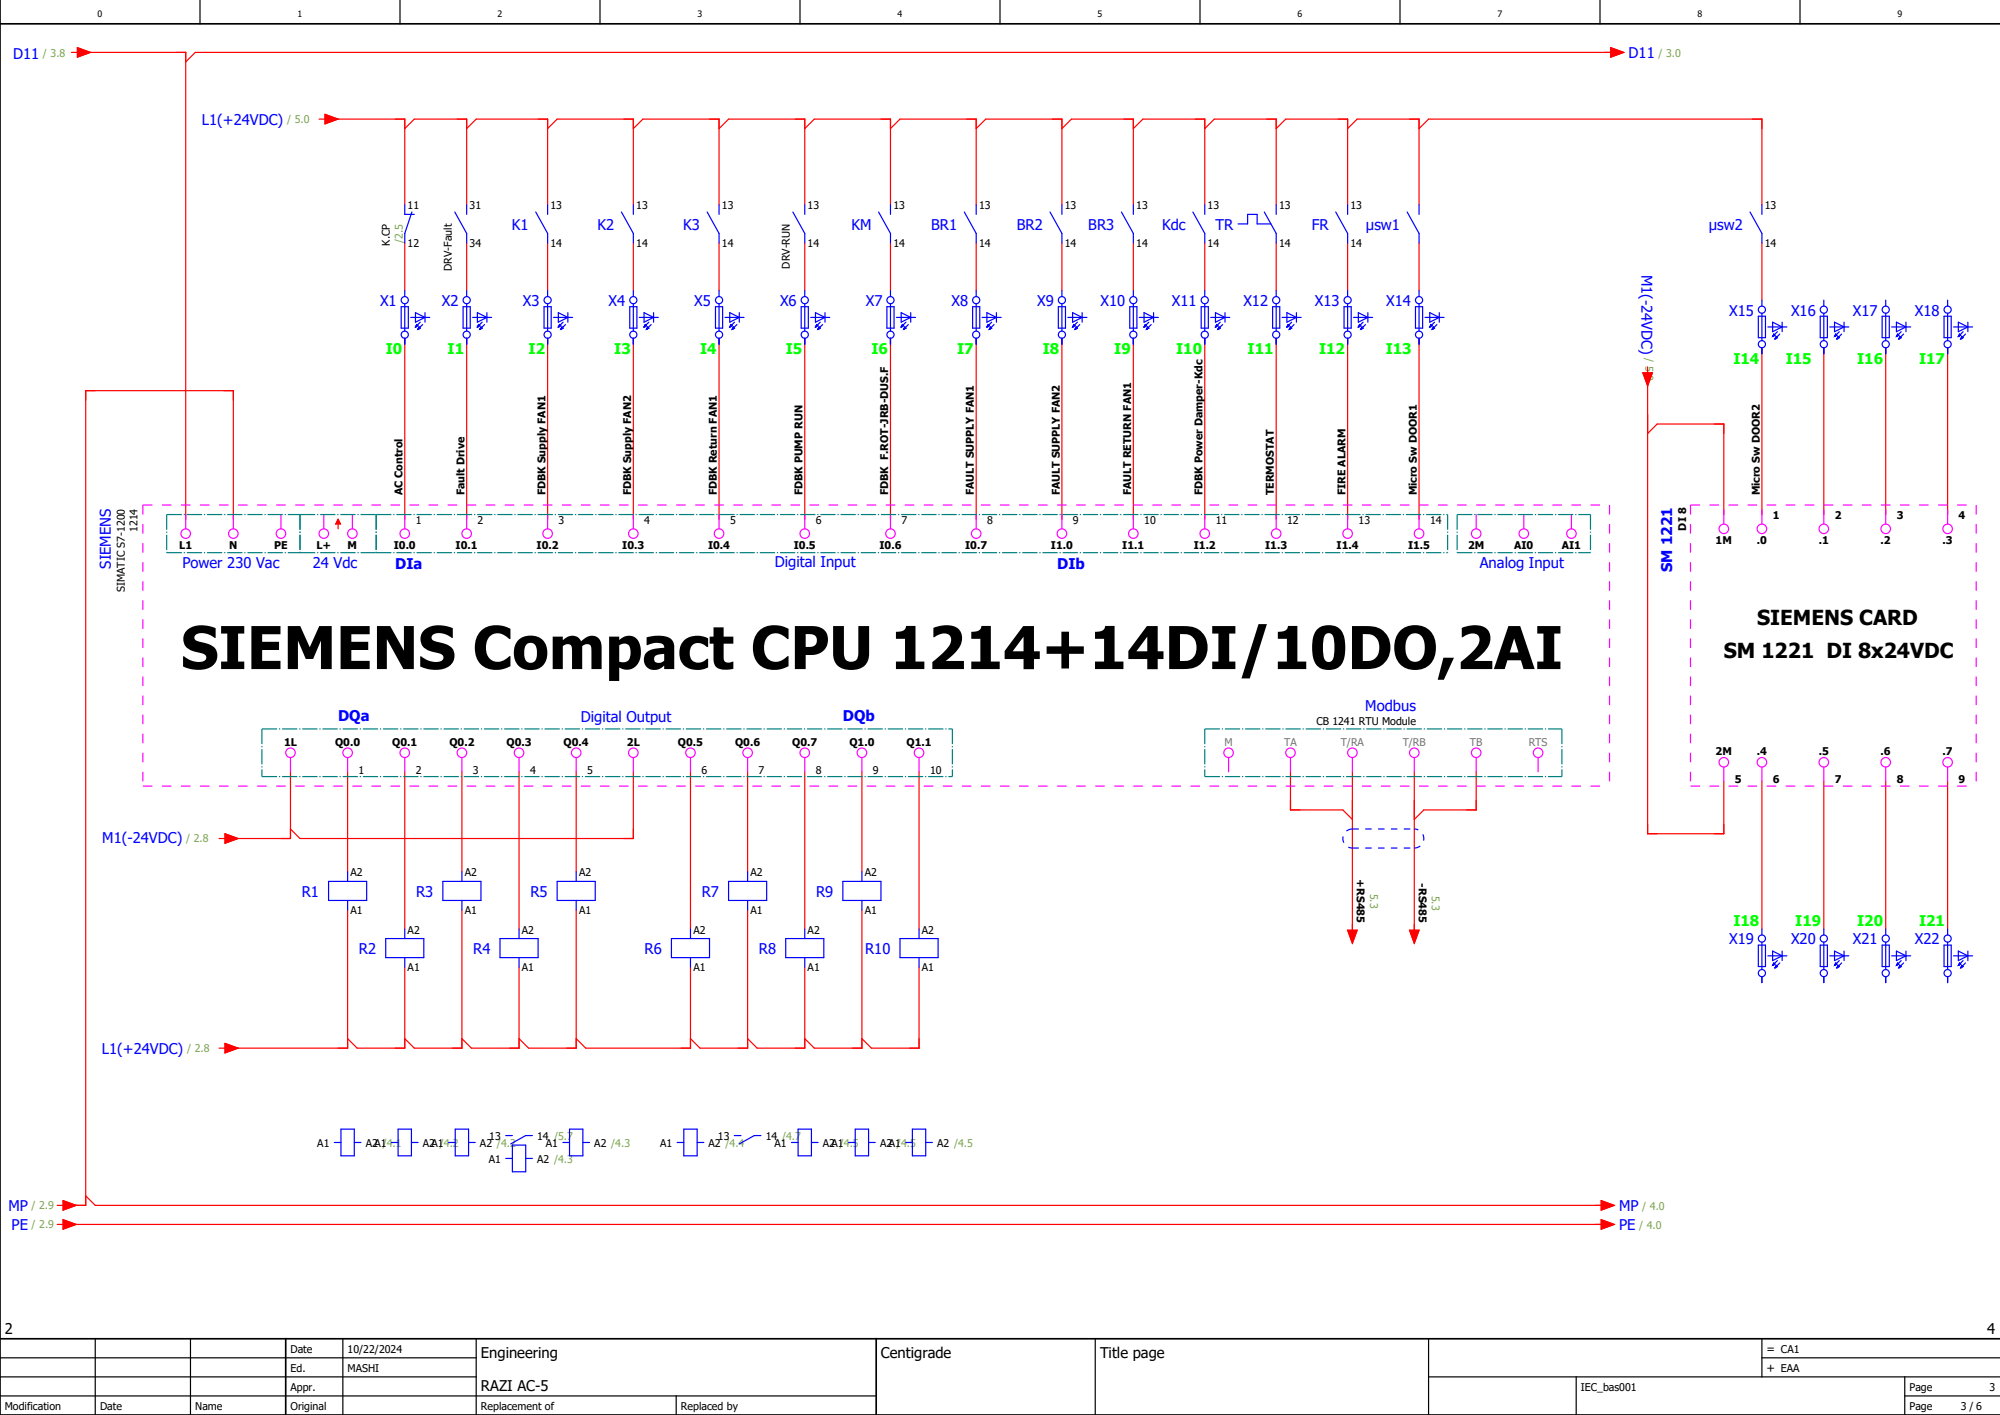
[picture p447: page 3]

FDBK F.ROT-JRB-DUS.F

FDBK Power Damper-Kdc

D12

D12

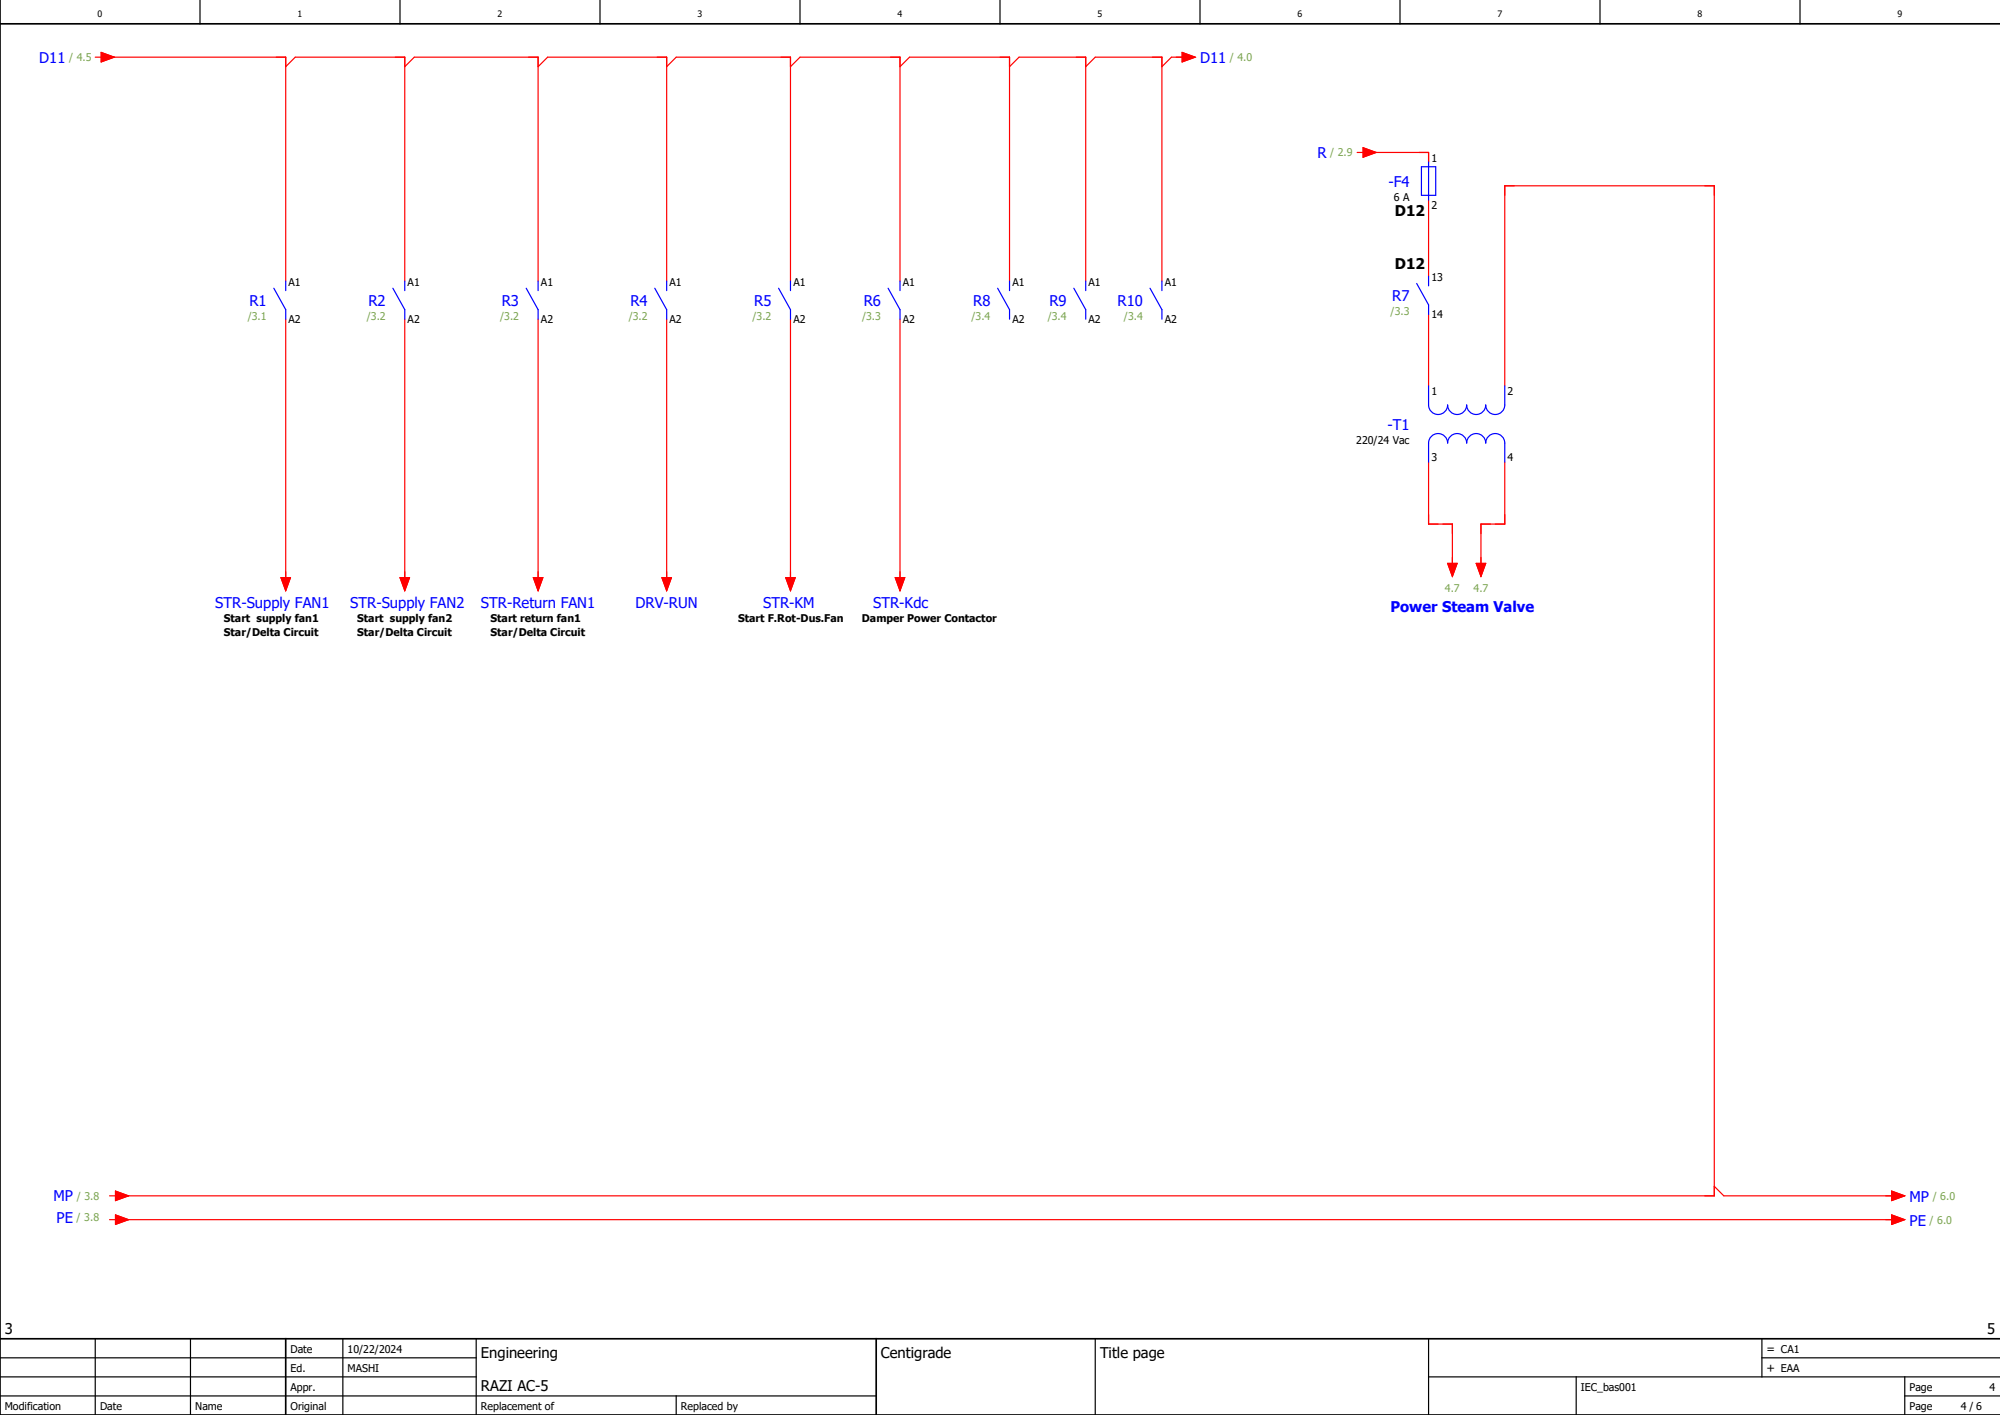
[picture p448: page 4]

# DANFOSS VLT FC 301/FC302

## From PLC

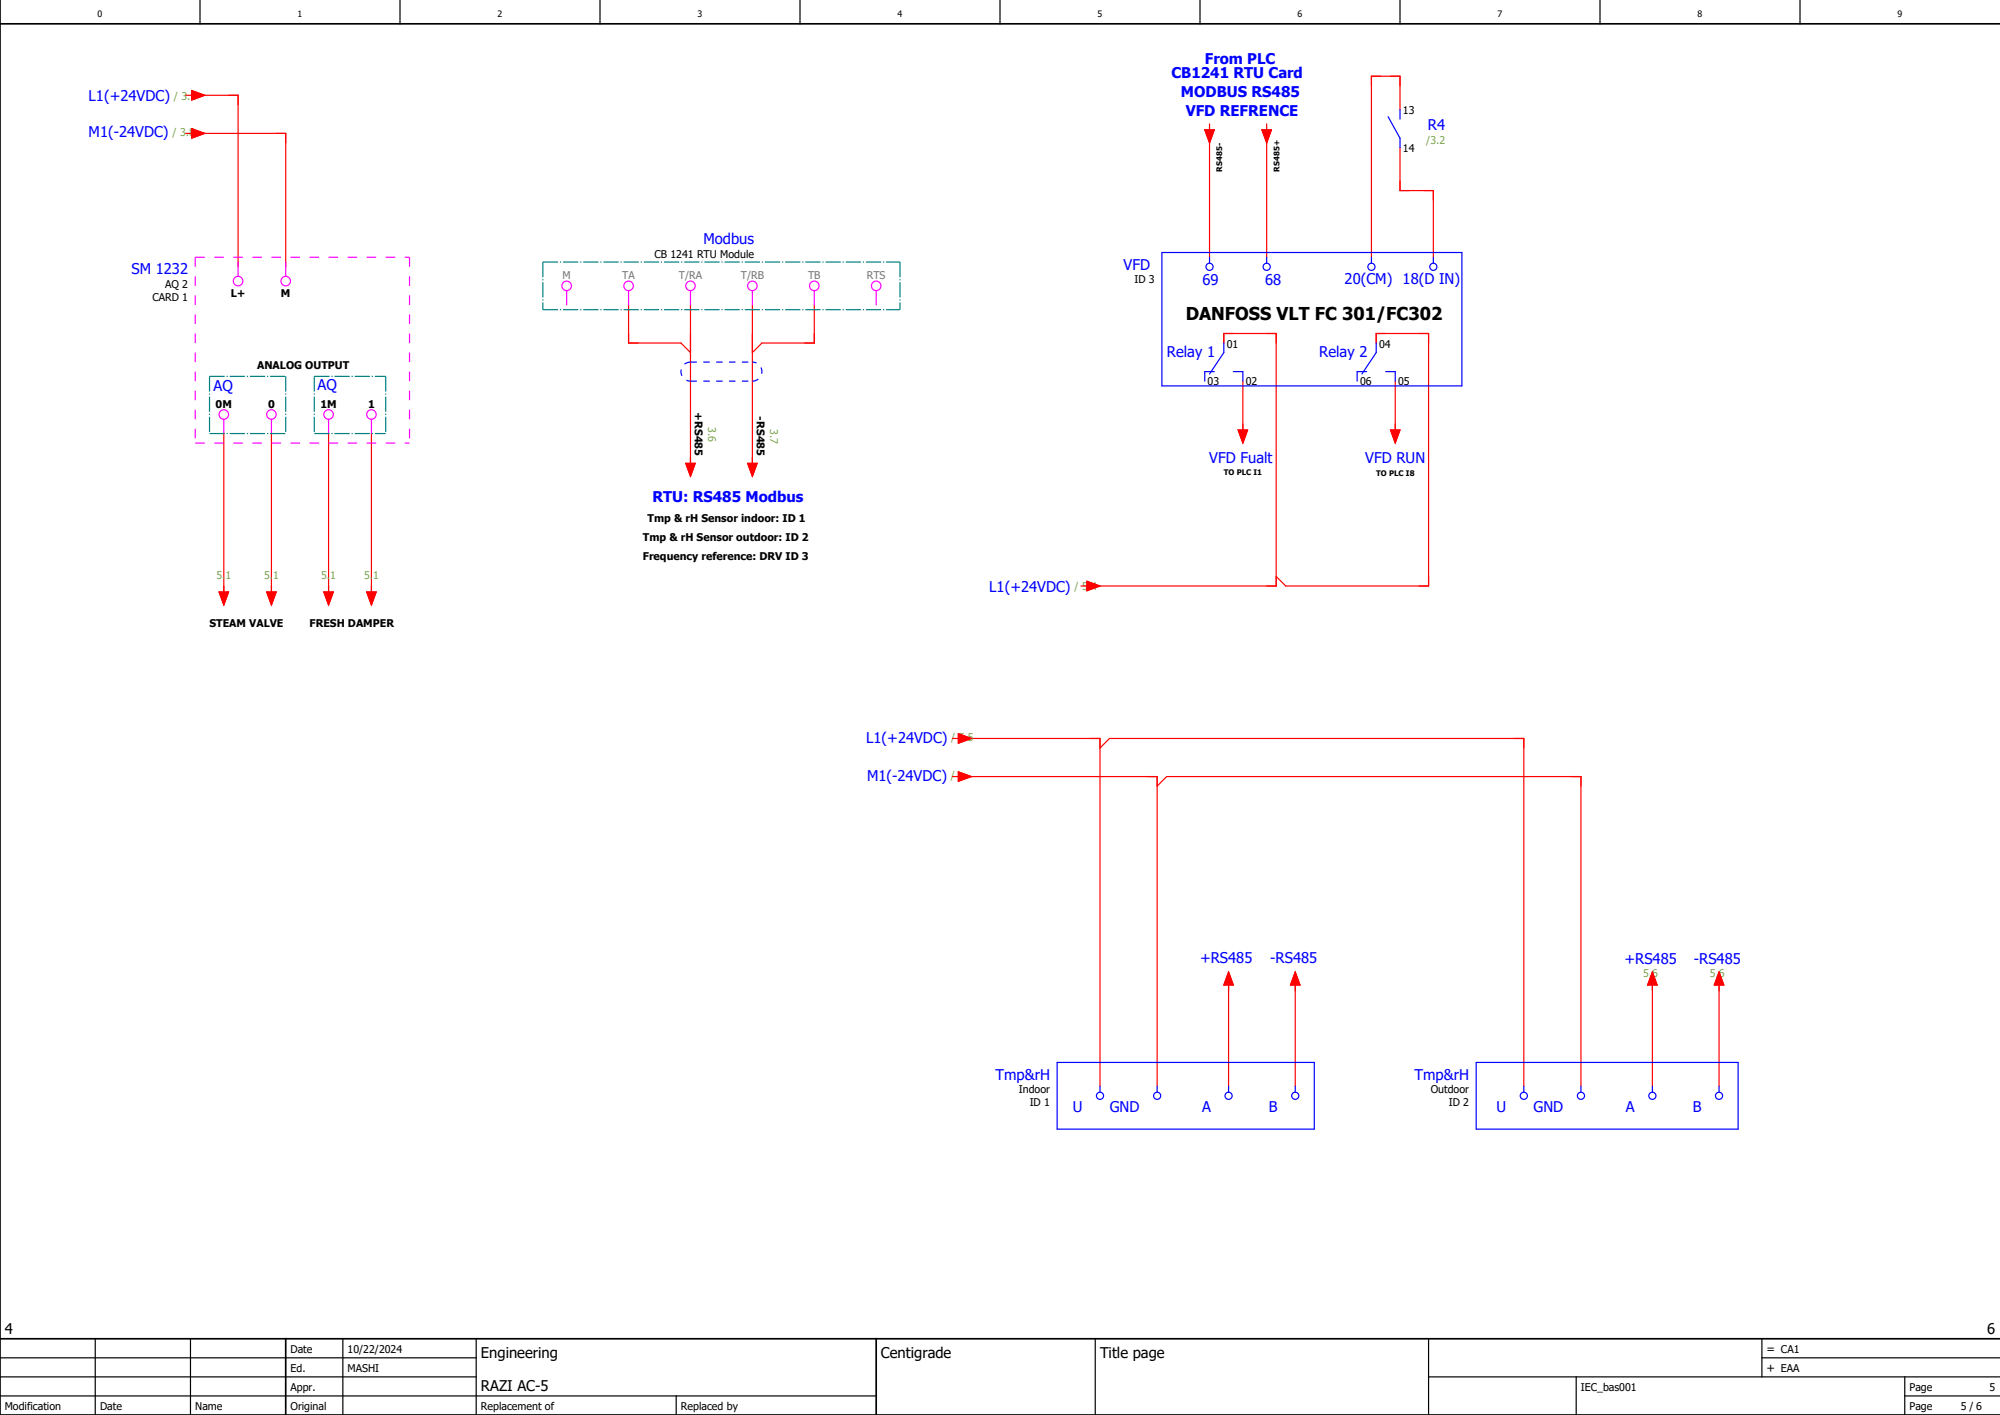
[picture p449: page 5]
ANALOG OUTPUT; STEAM VALVE; FRESH DAMPER; RTU: RS485 Modbus; CB1241 RTU Card MODBUS RS485 VFD REFRENCE; TO PLC I1; TO PLC I8; CARD 1; RTS; Modbus; Tmp&rH; Indoor ID 1; Outdoor; GND; VFD; Relay 1; Relay 2; L1(+24VDC) / 3.1; M1(-24VDC) / 3.8; L1(+24VDC) /; M1(-24VDC) /; L1(+24VDC) / 5.4; VFD Fualt; VFD RUN

CB 1241 RTU Module

Tmp & rH Sensor indoor: ID 1
Tmp & rH Sensor outdoor: ID 2
Frequency reference: DRV ID 3

F5

R /

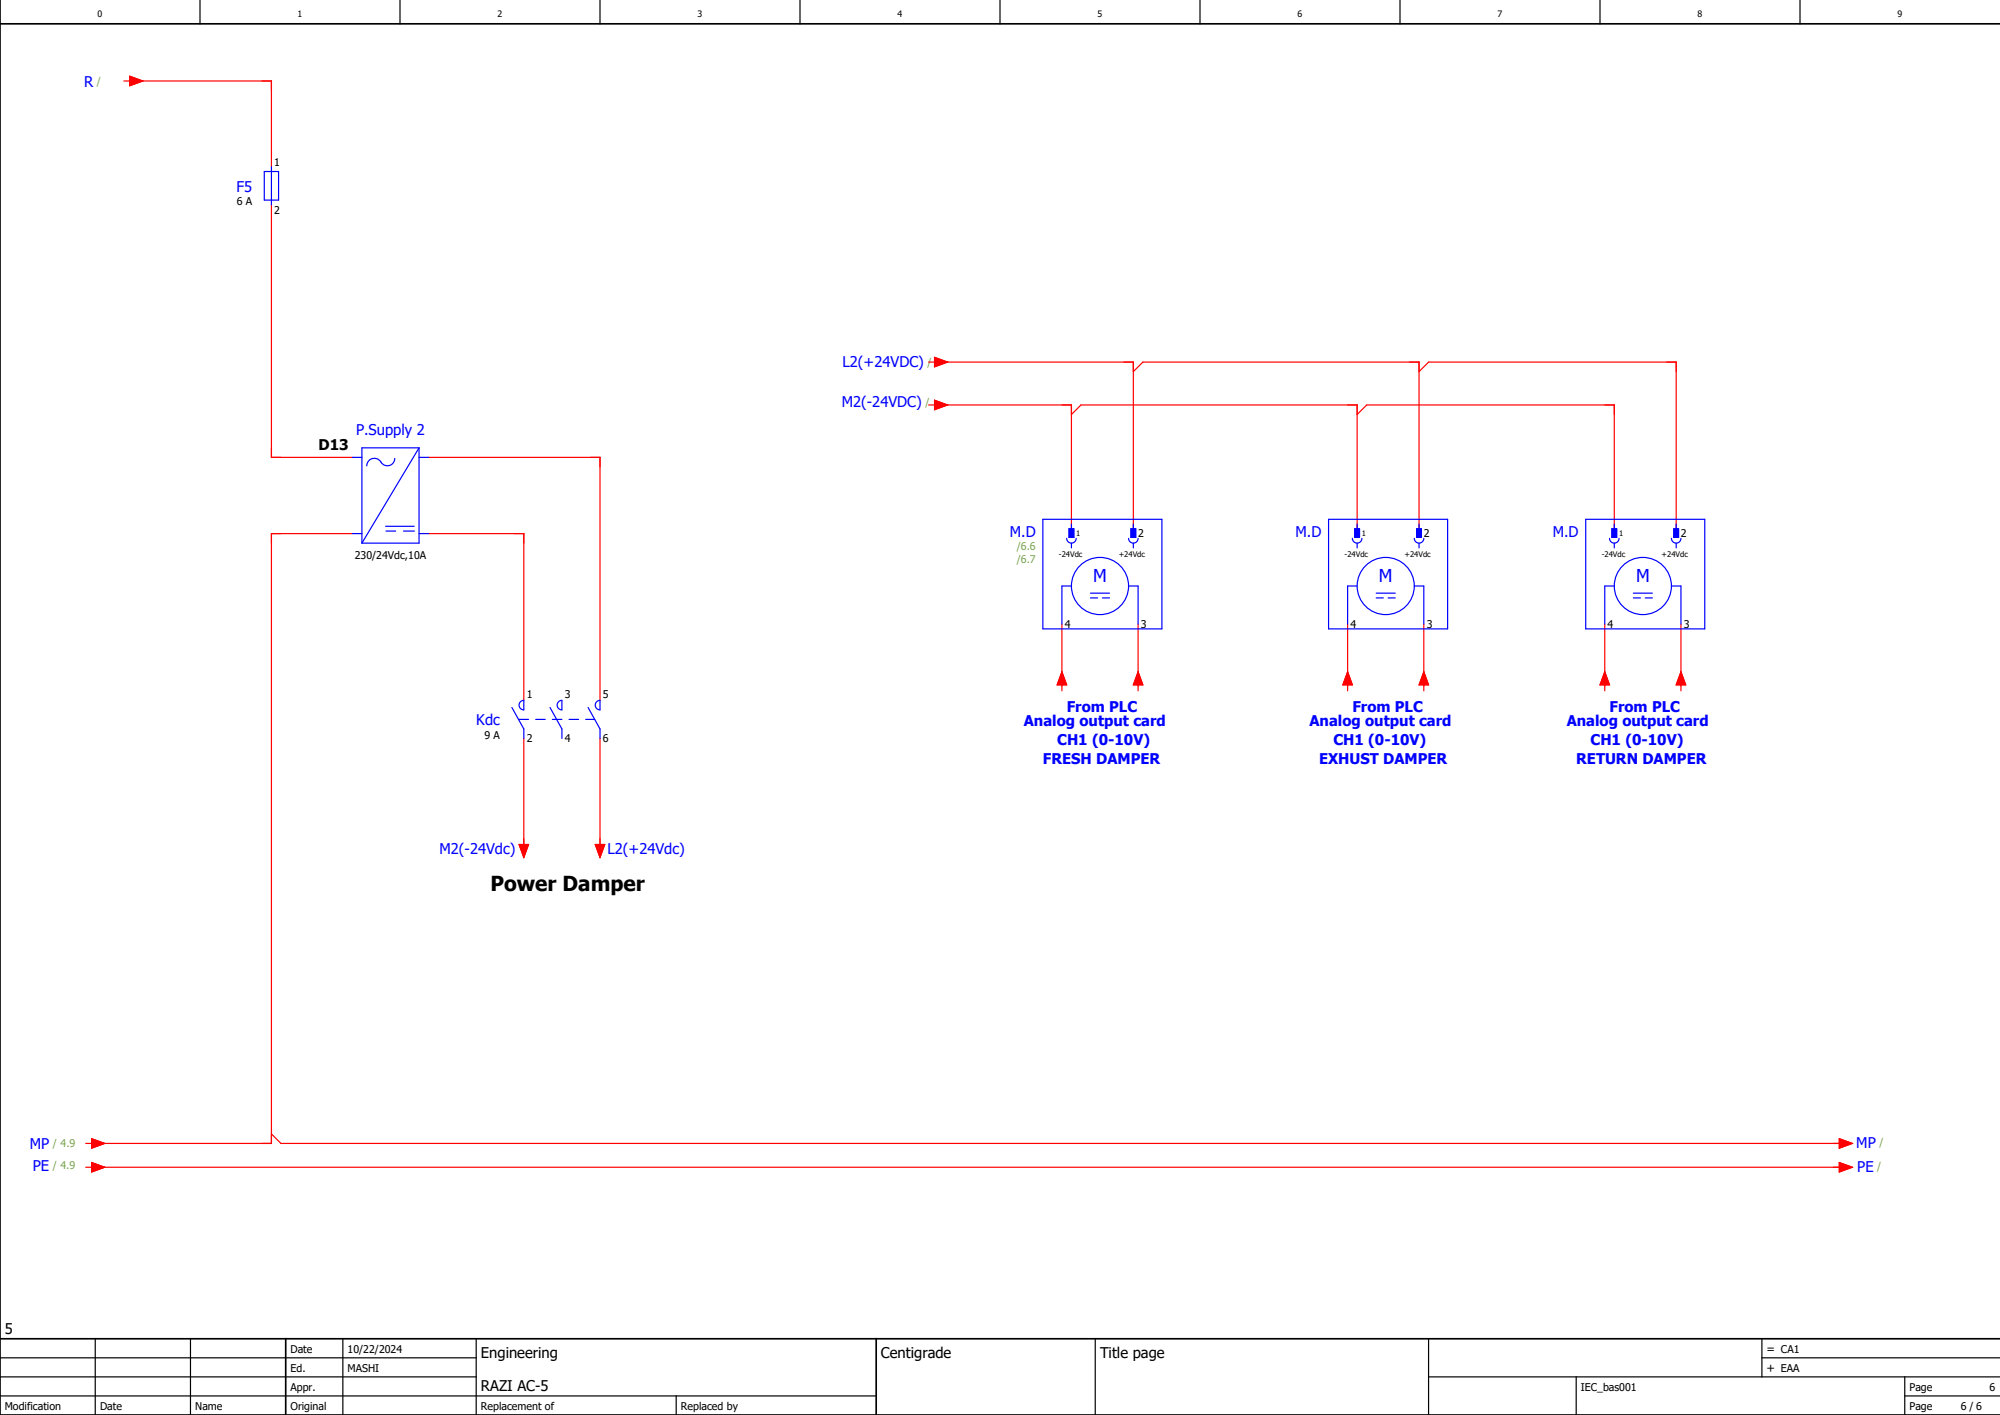
[picture p450: page 6]
Power Damper; From PLC; P.Supply 2; 230/24Vdc,10A; Kdc; -24Vdc; +24Vdc; M2(-24Vdc); L2(+24Vdc); L2(+24VDC) /; M2(-24VDC) /

Analog output card
FRESH DAMPER

EXHUST DAMPER

RETURN DAMPER
