koalium/centidocs/elec/plc/Wiring diagram/10402-Razi/RAZI textile AC-6.pdf

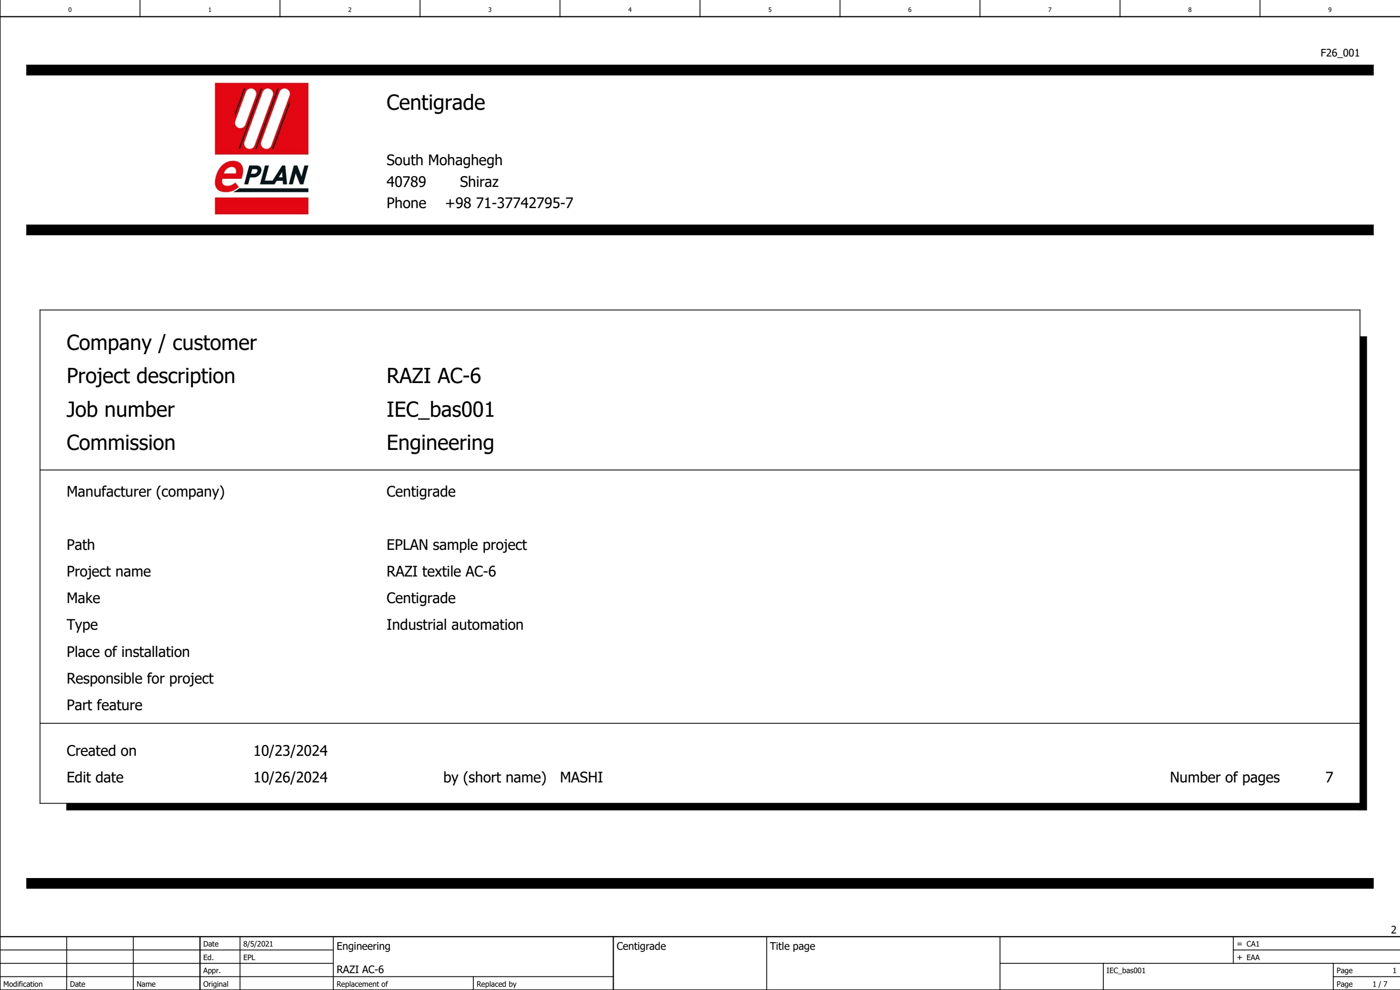
[picture p451: figure]
Page; RAZI AC-6; Original; IEC_bas001; Engineering; EPL; Date; Replaced by; EAA; Title page; Modification; Appr.; Replacement of; Centigrade; Name; Project description; Number of pages; Commission; Edit date; Created on; Job number; EPLAN sample project; Make; MASHI; Part feature; South Mohaghegh; Path; Industrial automation; Manufacturer (company); Project name; RAZI textile AC-6; Responsible for project; Phone; Type; Company / customer; Place of installation; by (short name); Shiraz

TF1 | TF2 | TF3

F2

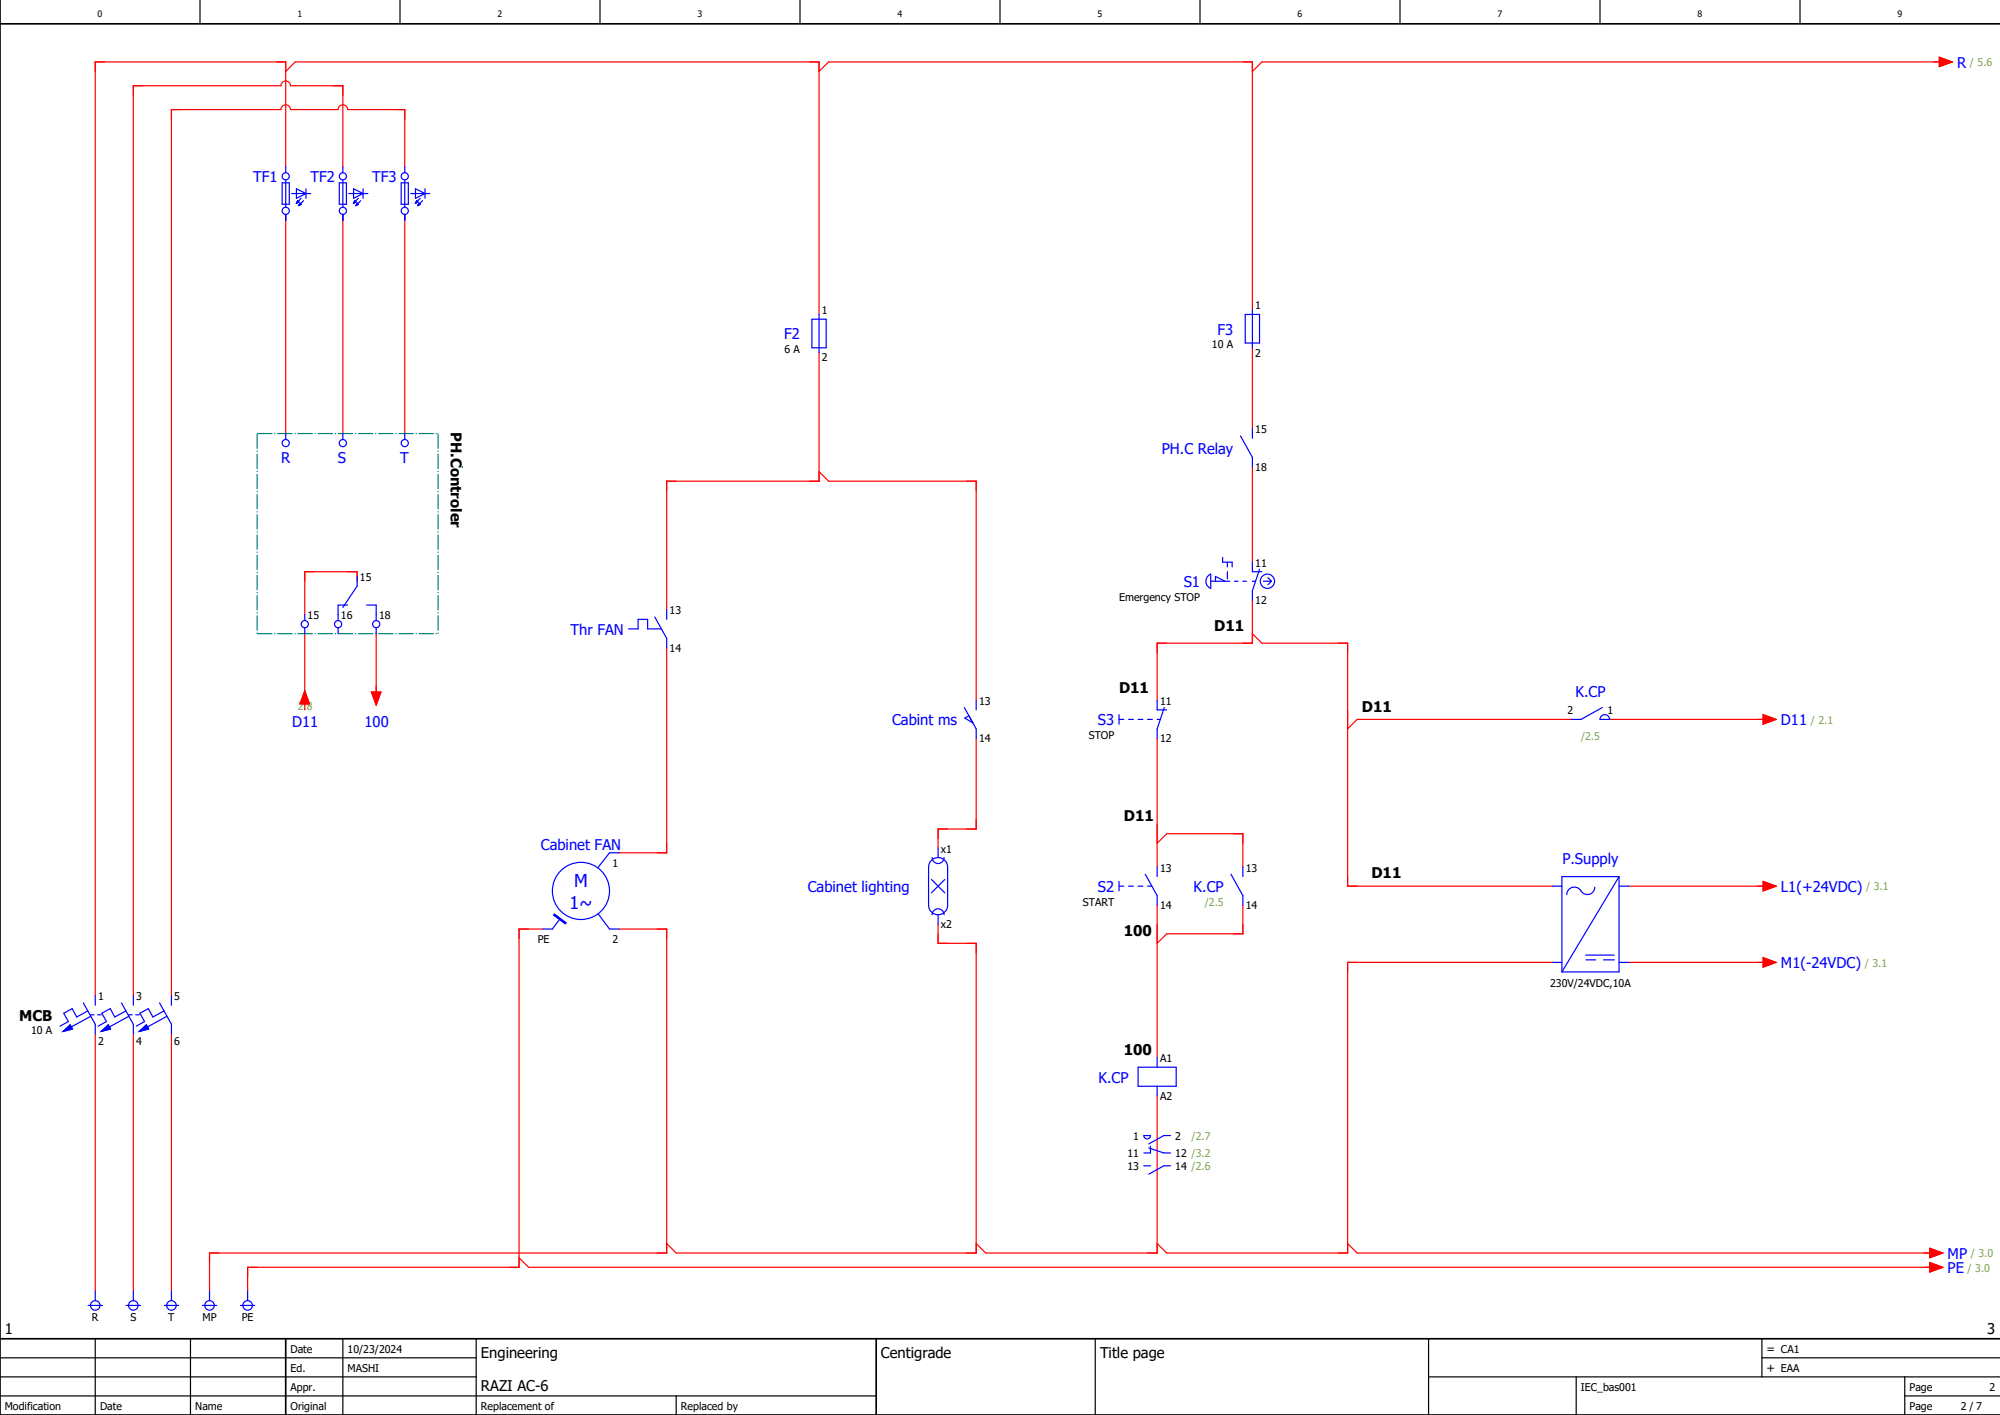
[picture p452: page 2]
MASHI; Centigrade; MCB; PH.Controler; Cabinet FAN; Cabinet lighting; Thr FAN; Cabint ms; Emergency STOP; PH.C Relay; START; STOP; P.Supply; 230V/24VDC,10A; L1(+24VDC) / 3.1; M1(-24VDC) / 3.1

X1 | X2 | X3 | X4 | X5 | X6 | X7 | X8 | X9 | X10 | X11 | X12 | X13 | X14 DRV⁻Fault1

K5

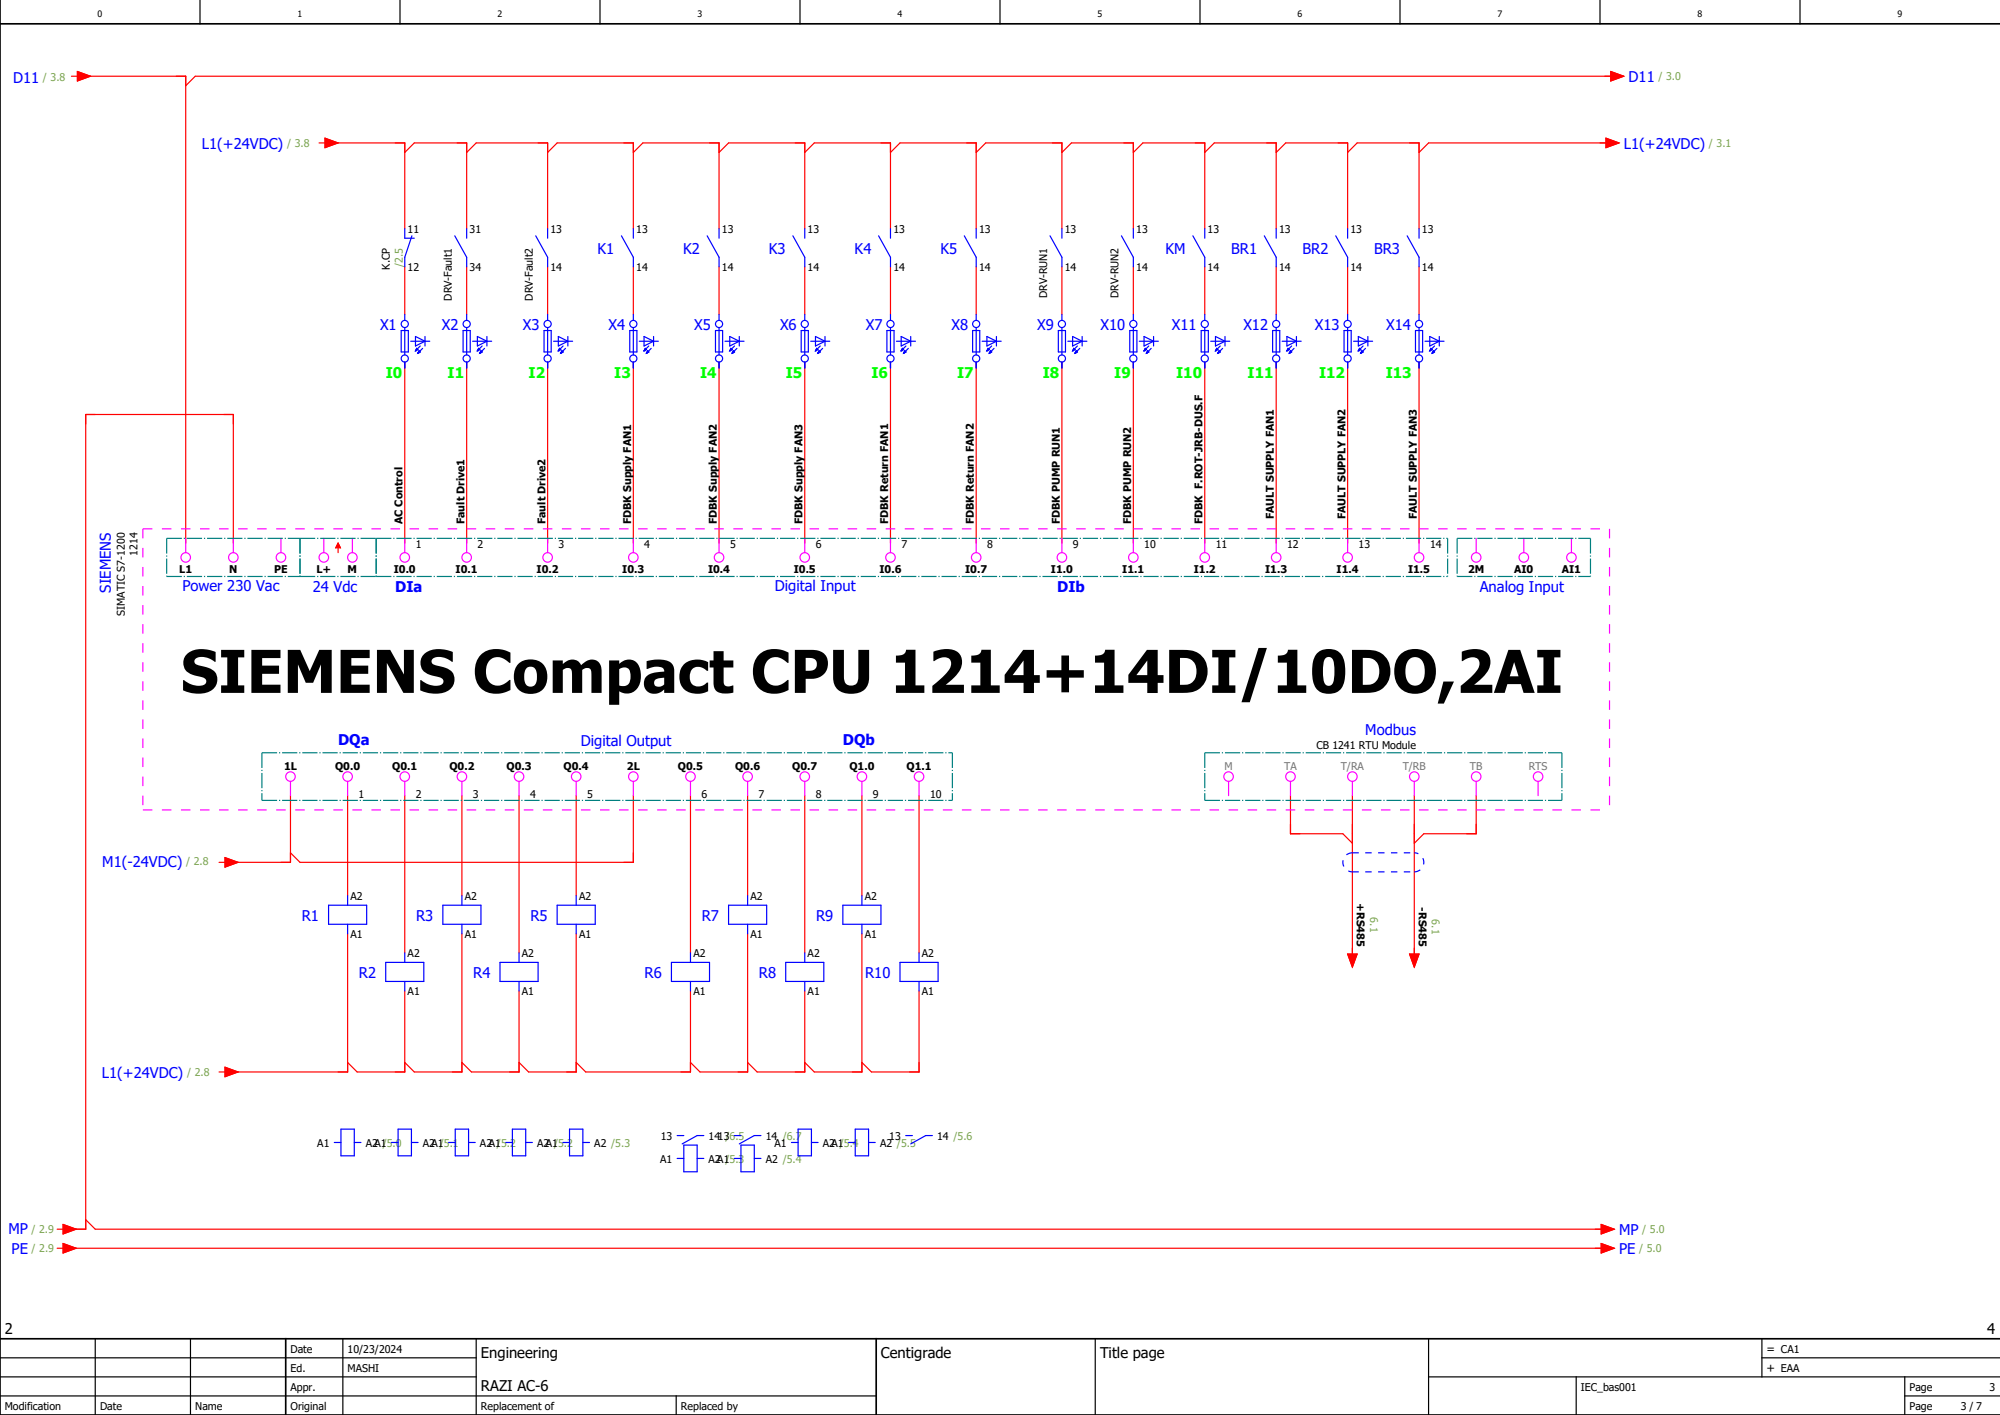
[picture p453: page 3]

X15

X17

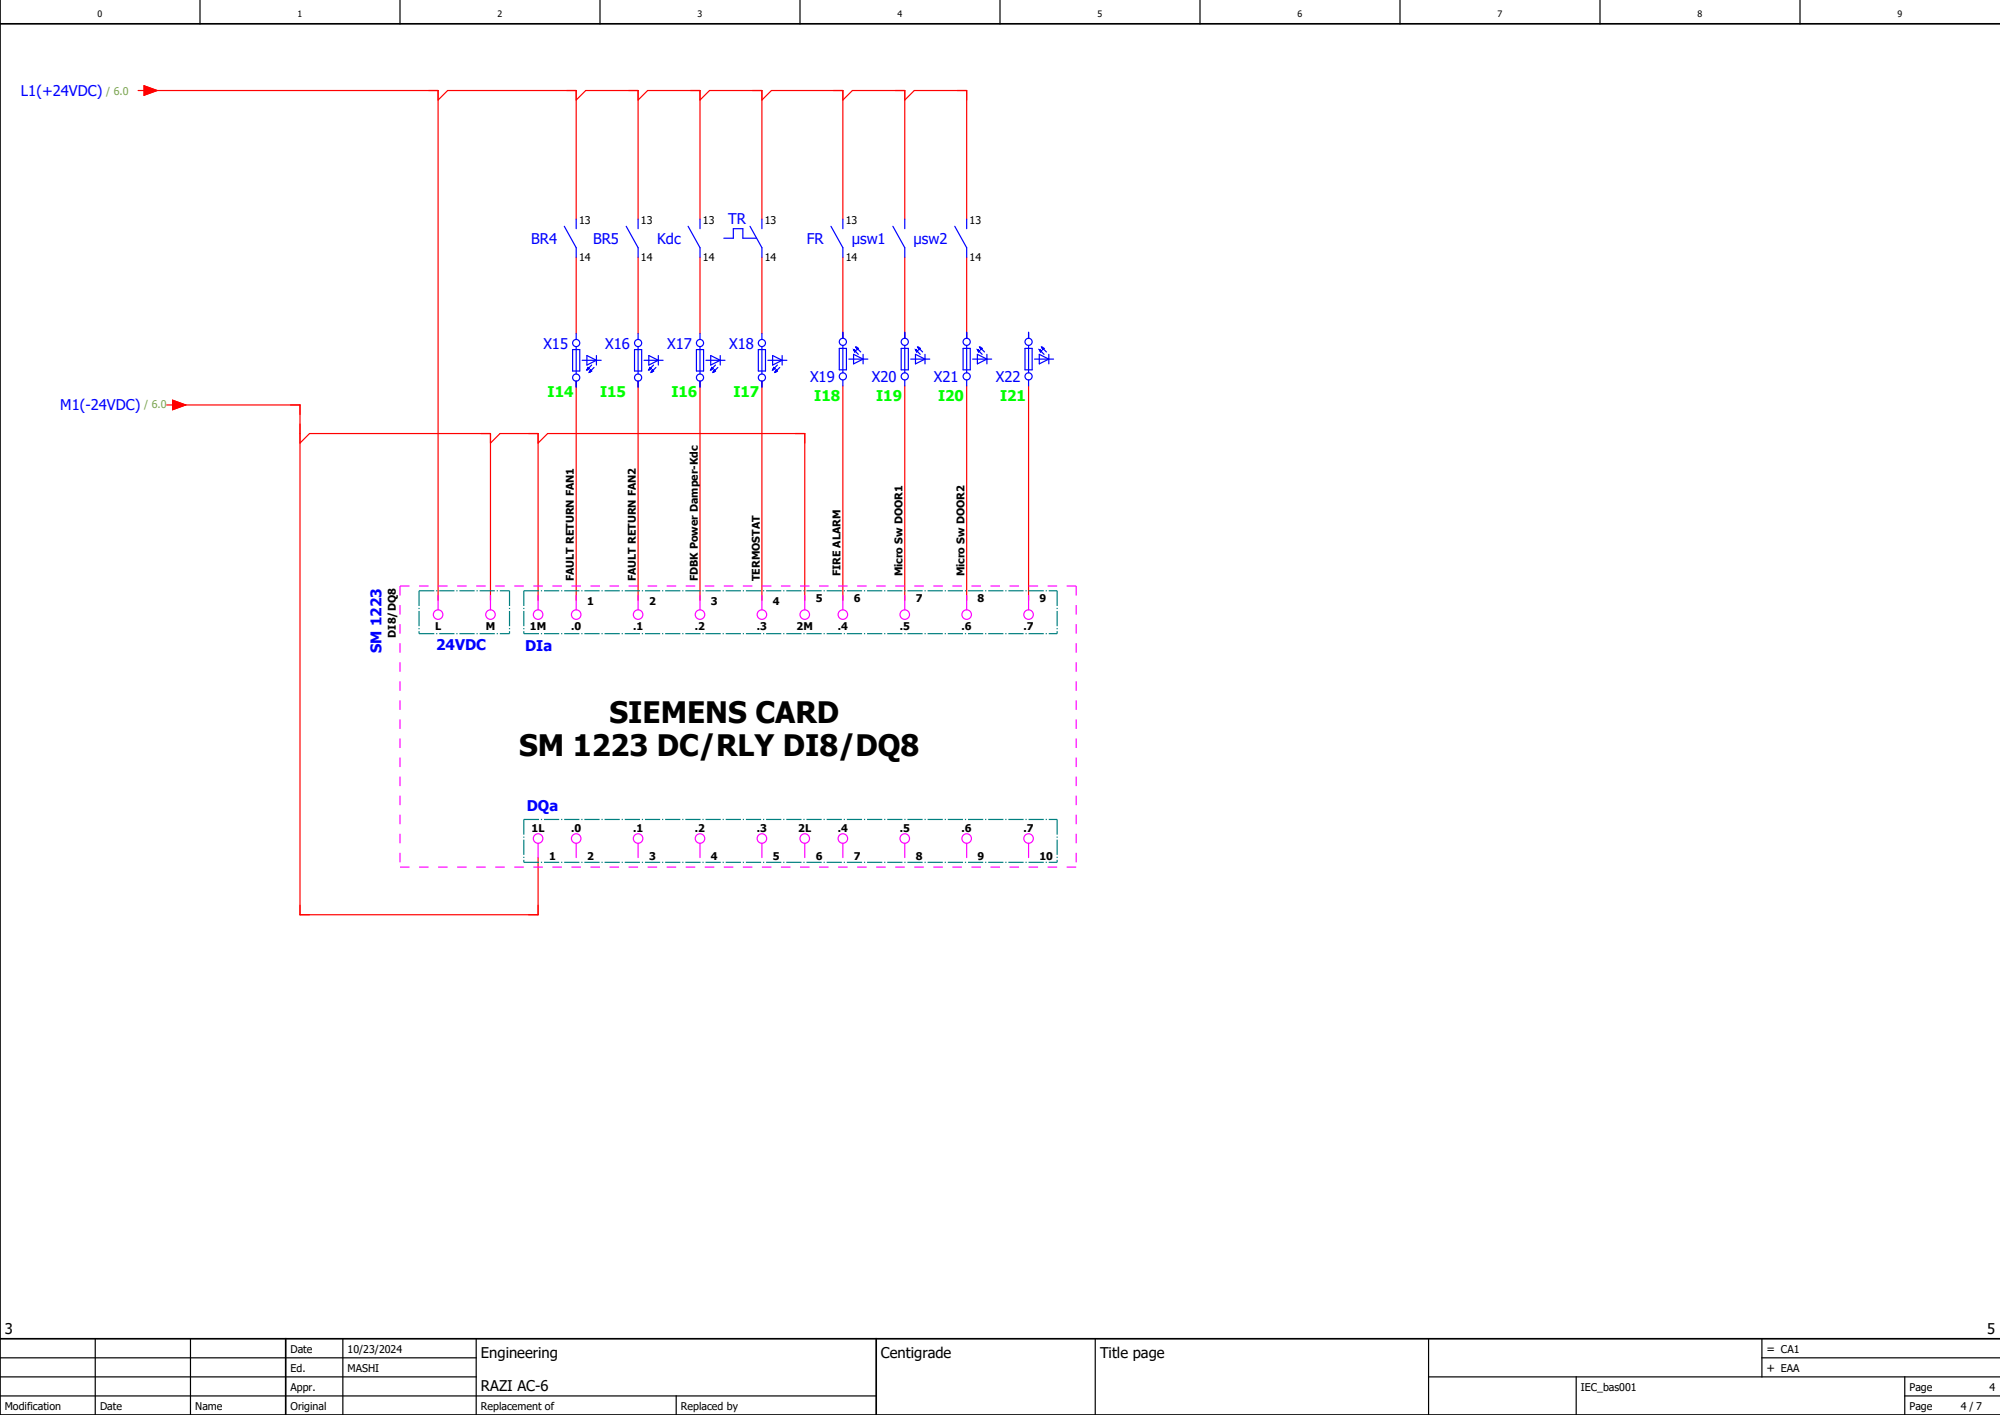
[picture p454: page 4]
Micro Sw DOOR1; Micro Sw DOOR2; FAULT RETURN FAN2; TERMOSTAT; DIa; DQa; 24VDC; µsw1; µsw2; Kdc; M1(-24VDC) / 6.0; L1(+24VDC) / 6.0

FDBK Power Damper-Kdc

FAULT RETURN FAN1
SIEMENS CARD FIRE ALARM

SM 1223 DC/RLY DI8/DQ8

D12

D12

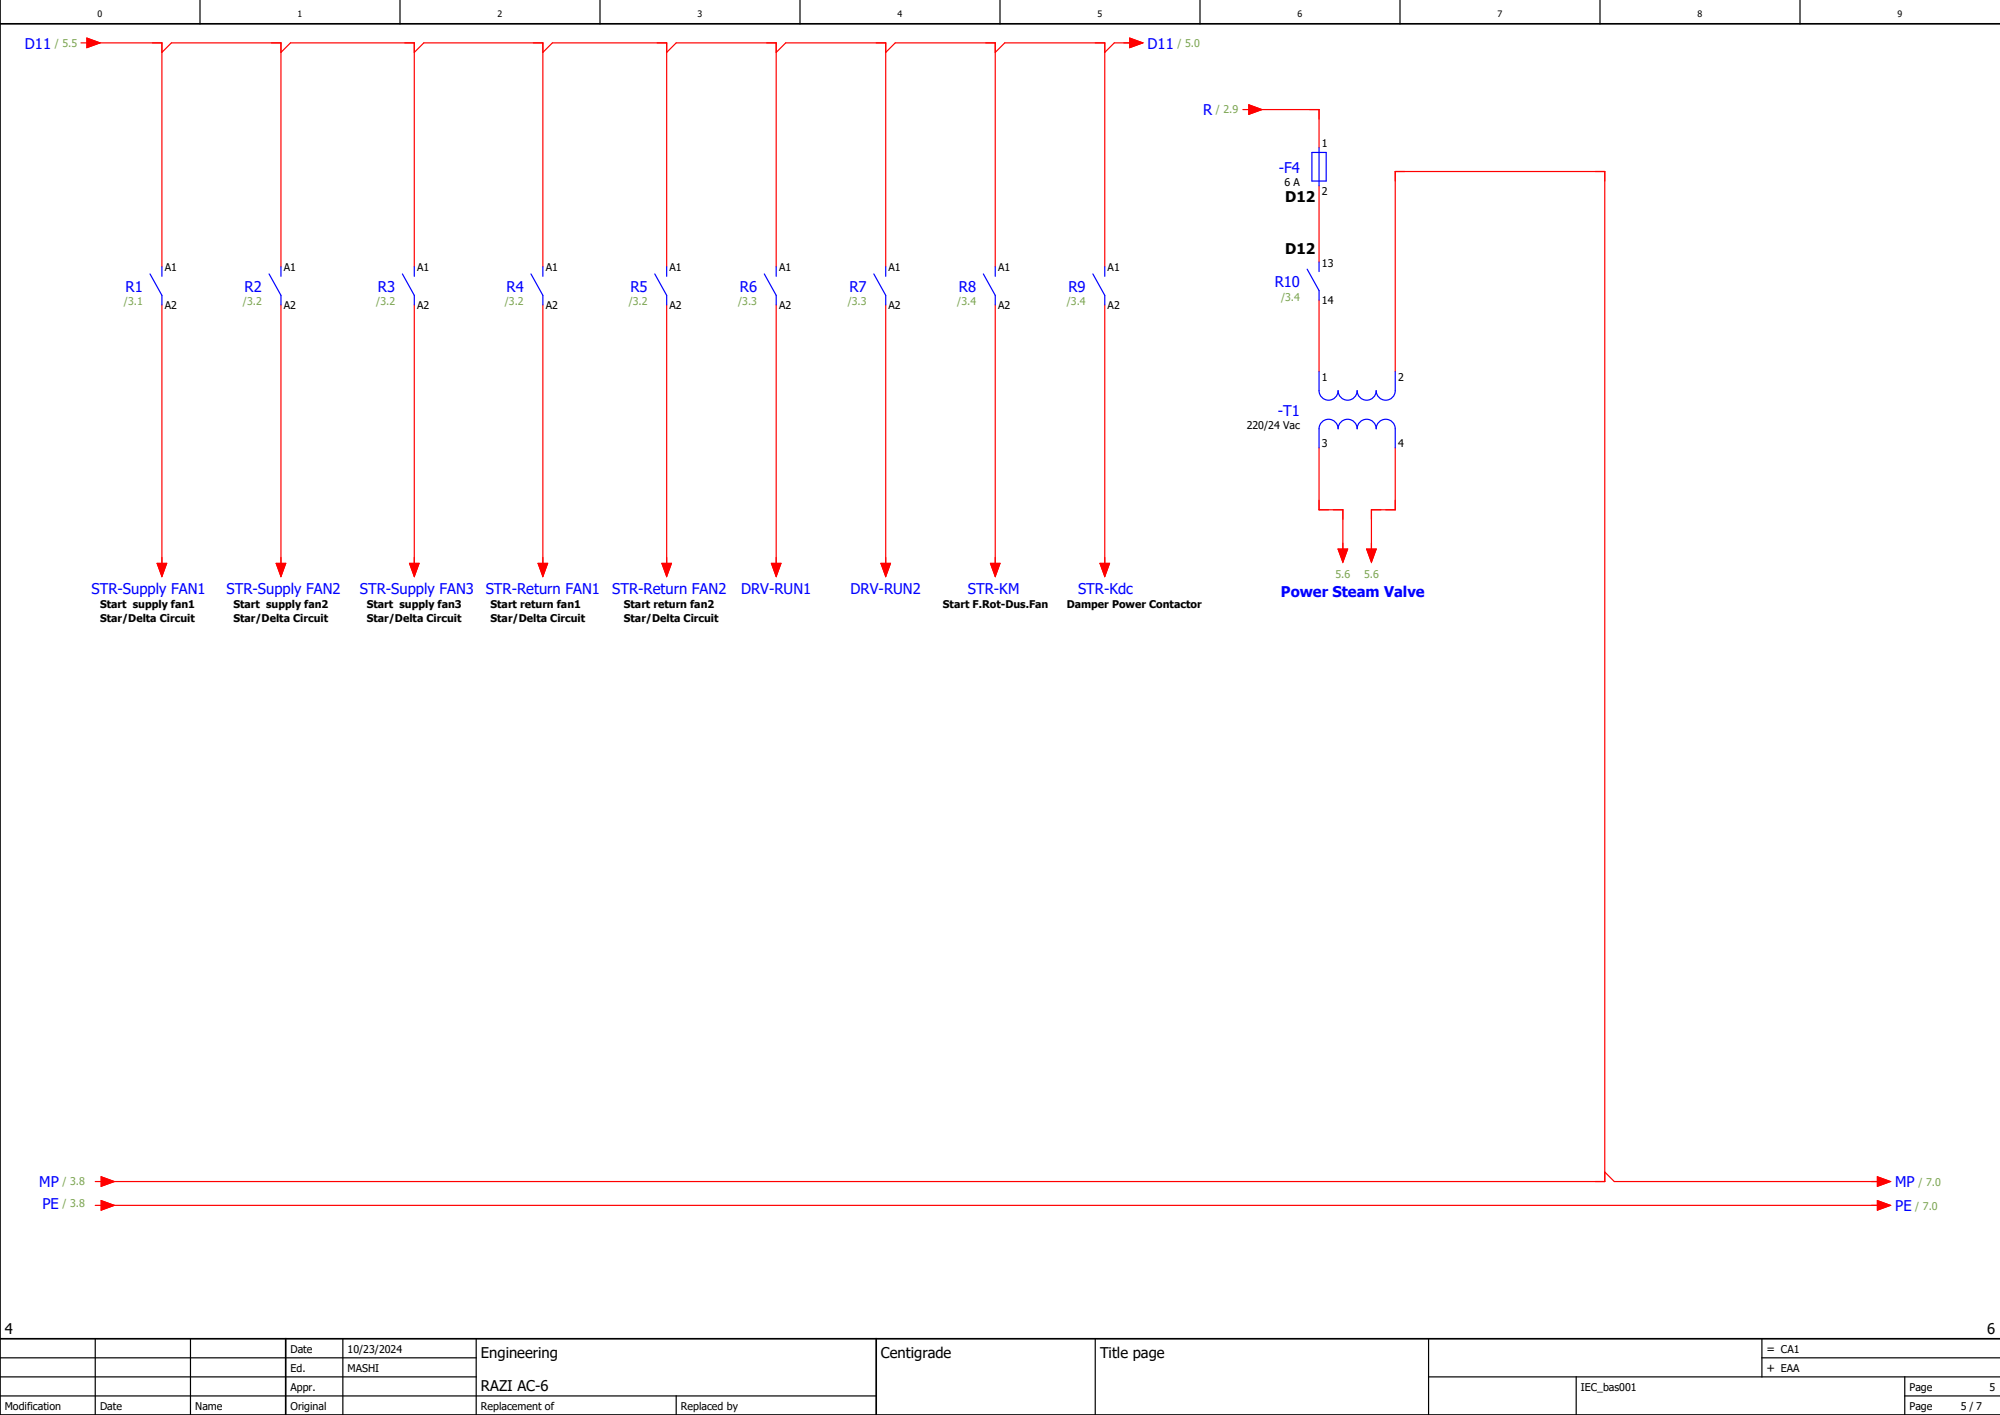
[picture p455: page 5]

## From PLC CB1241 RTU Card

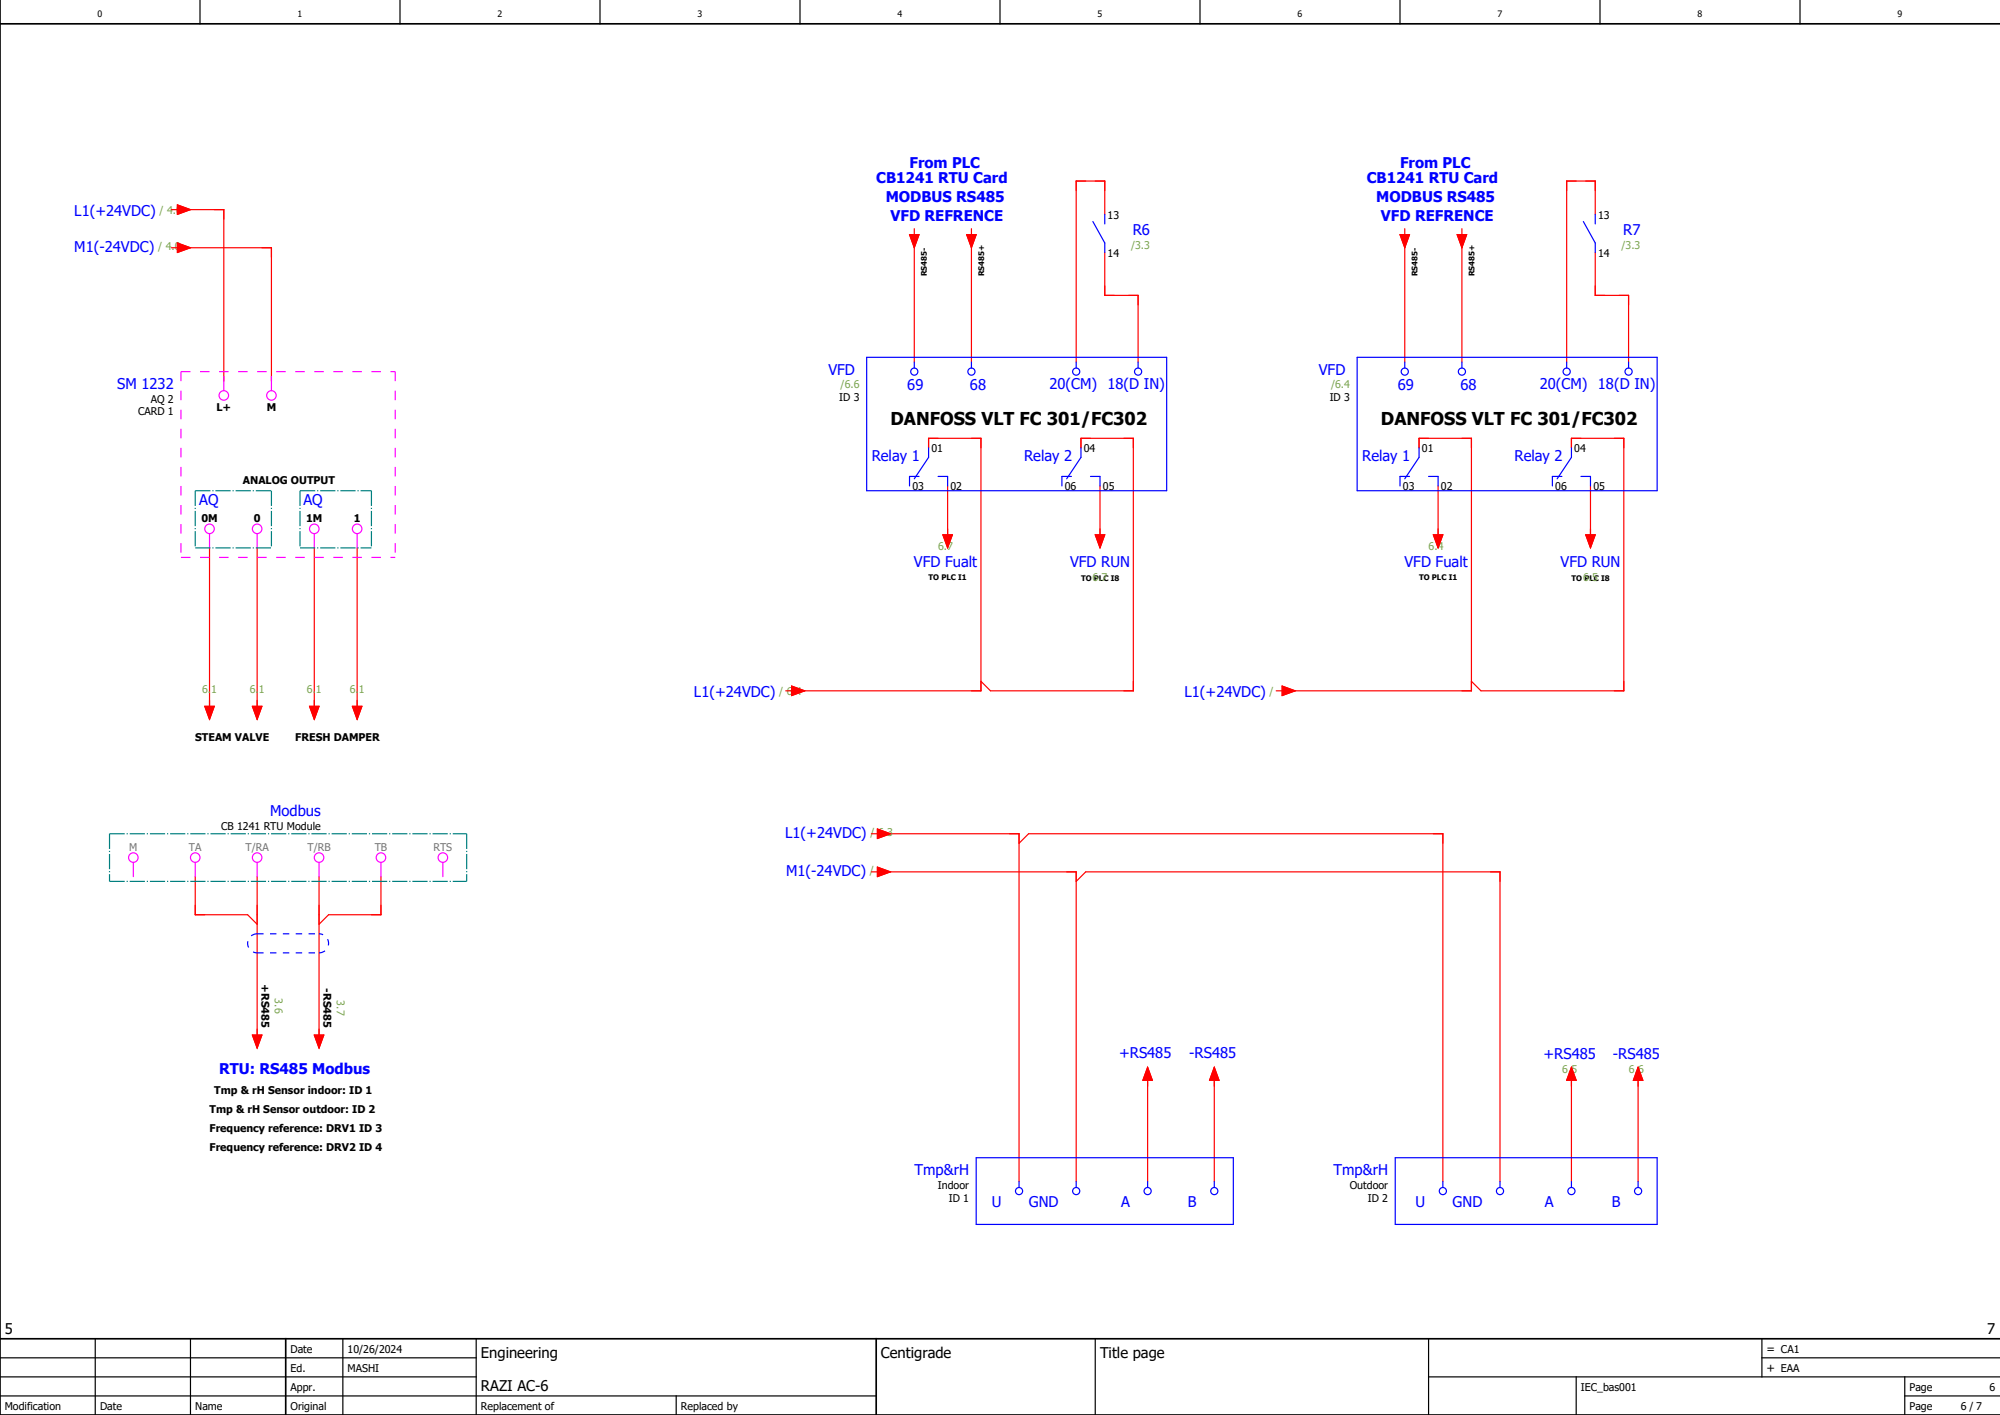
[picture p456: page 6]
Centigrade; ANALOG OUTPUT; STEAM VALVE; FRESH DAMPER; RTU: RS485 Modbus; DANFOSS VLT FC 301/FC302; MODBUS RS485 VFD REFRENCE; TO PLC I1; TO PLC I8; From PLC CB1241 RTU Card MODBUS RS485 VFD REFRENCE; CARD 1; RTS; Modbus; Tmp&rH; Indoor ID 1; Outdoor; GND; VFD; Relay 1; Relay 2; L1(+24VDC) / 4.0; M1(-24VDC) / 4.0; L1(+24VDC) /; M1(-24VDC) /; L1(+24VDC) / 6.4; VFD Fualt; VFD RUN

CB 1241 RTU Module

Tmp & rH Sensor indoor: ID 1
Tmp & rH Sensor outdoor: ID 2
Frequency reference: DRV1 ID 3
Frequency reference: DRV2 ID 4

F5

R /

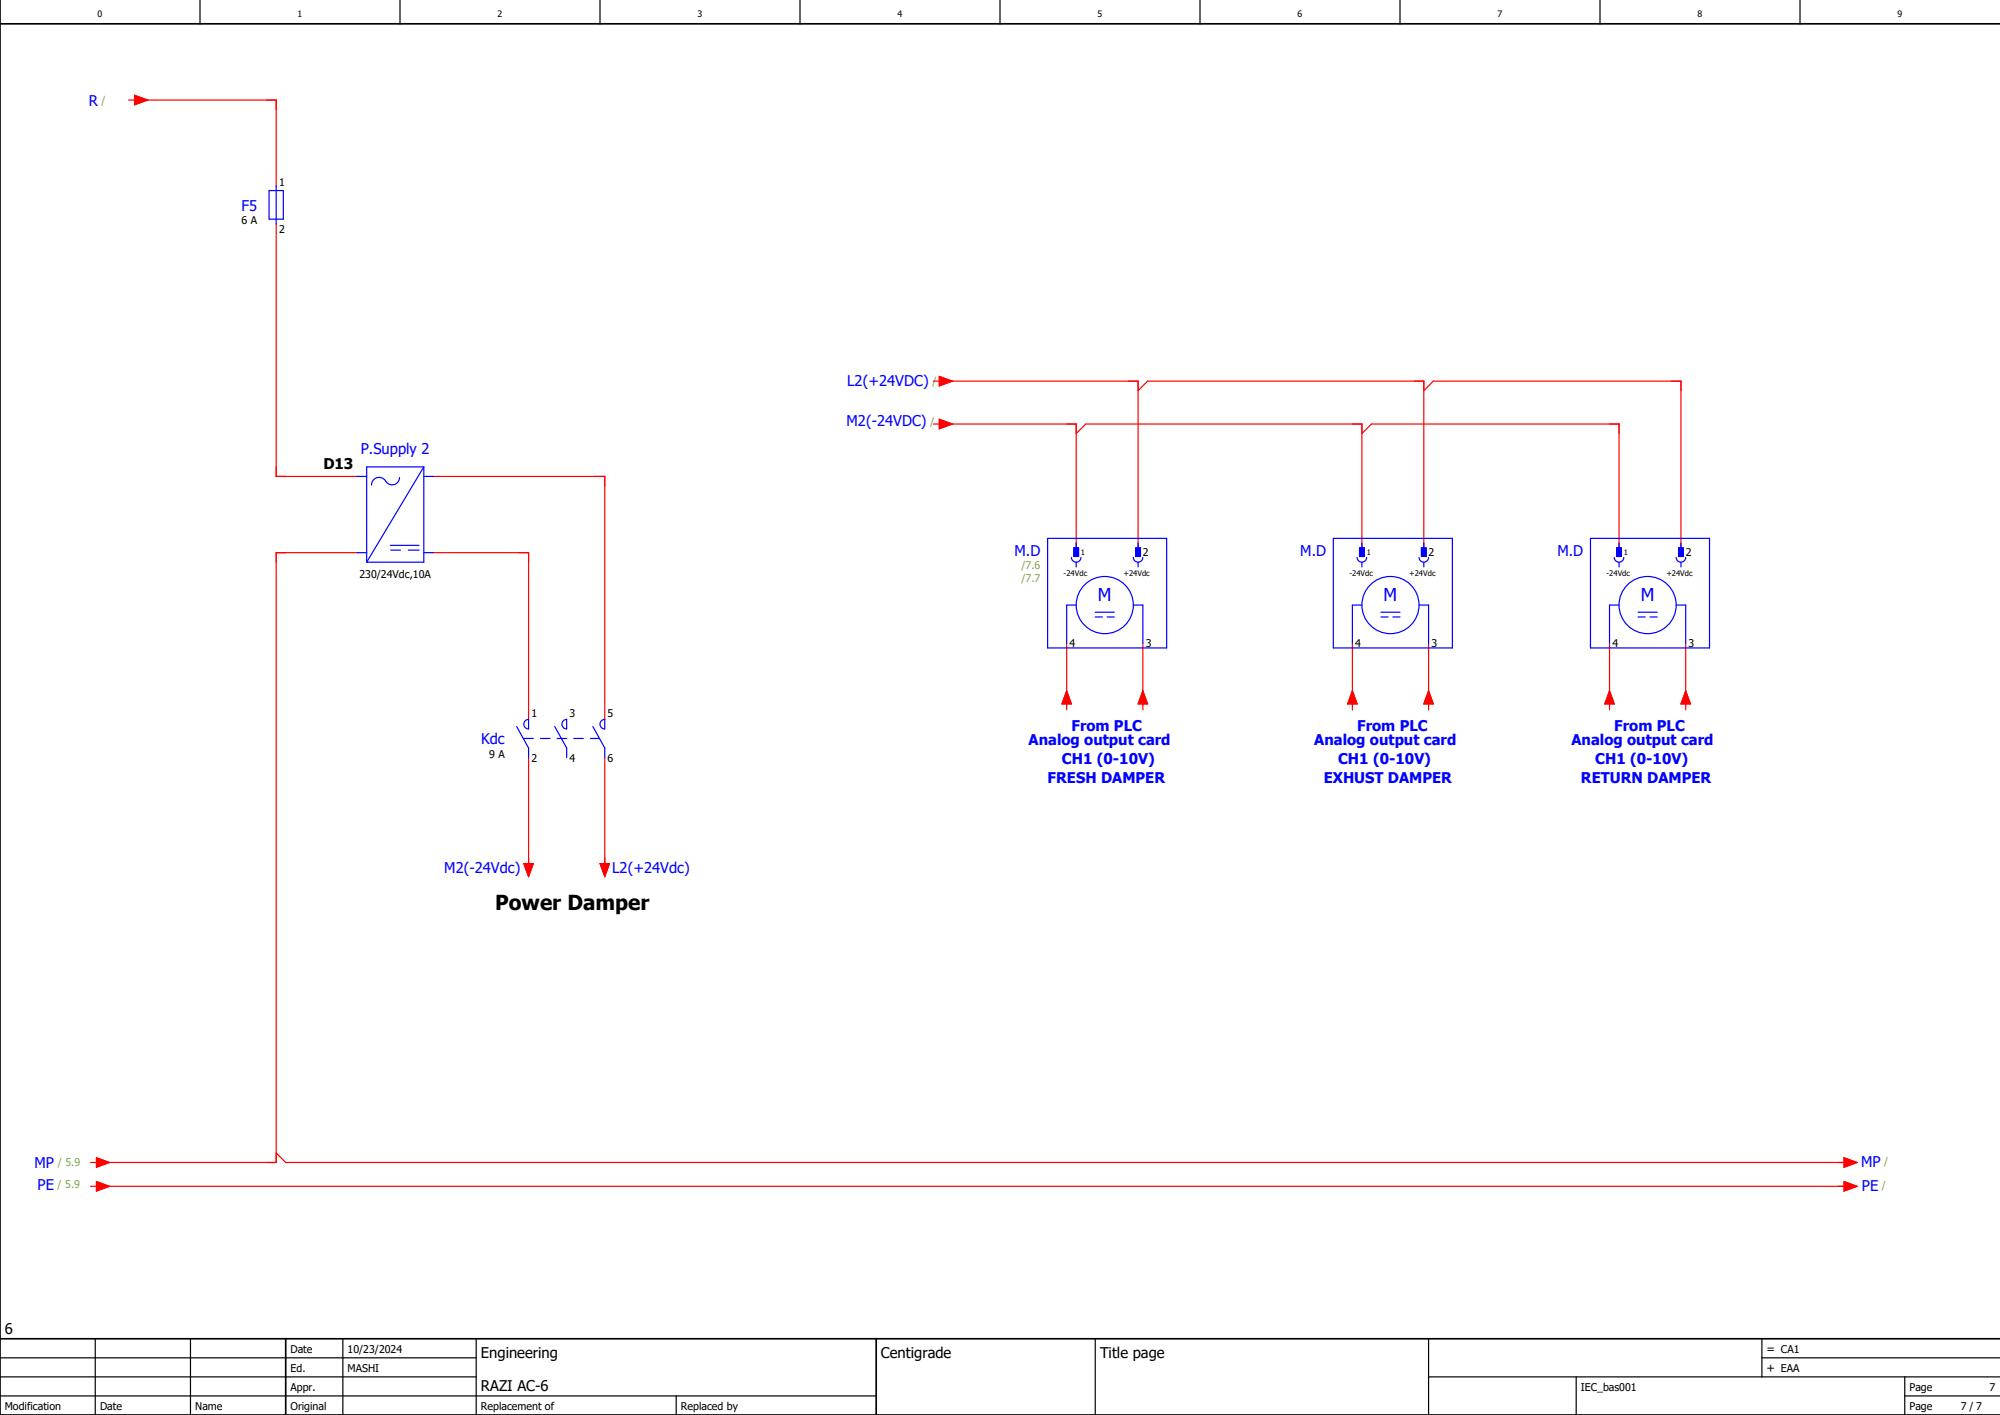
[picture p457: page 7]
Power Damper; From PLC; P.Supply 2; 230/24Vdc,10A; Kdc; -24Vdc; +24Vdc; M2(-24Vdc); L2(+24Vdc); L2(+24VDC) /; M2(-24VDC) /

Analog output card
FRESH DAMPER

EXHUST DAMPER

RETURN DAMPER
